DeadlySIn777/Controller/hardware/octopus_external_adapter/purchase_review/amazon-connectors-live-terminals-added-20261006.png

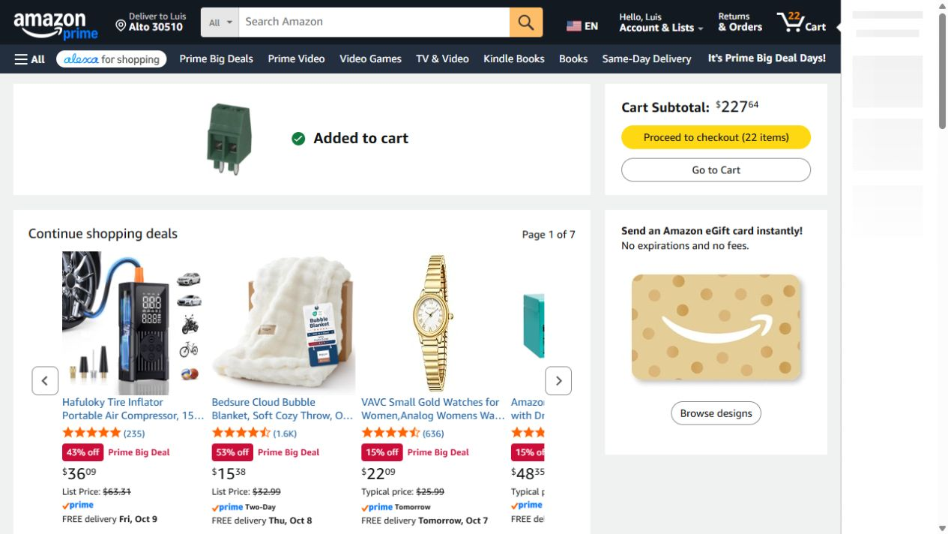
hardware/octopus_external_adapter/purchase_review/amazon-connectors-live-terminals-added-20261006.png
