DeadlySIn777/Controller/current-global-R3/README.md

# Current joint candidate and global routing input

This is the exact input of the global experiment launched on 18 October 2026, not a completed route or an adopted board. [Download the complete editable project](../archives/joint-global-R3-exact-native-project.zip), extract into a separate directory and open board.kicad_pro. The ZIP contains all 211 project files including the exact PCB, rules, schematic and local libraries. The adjacent board.dsn is the exact constrained router input.

Native PCB SHA-256: `a693477c5a71e26db86345ea2a356ad20519d301989d2f0e3506a8142f23c595`.
DSN SHA-256: `62ec8575ada2eea4df0adadbcb8852b647e395f8b239dd86e6c62eb48275c683`.

The native input contains 94,300 copper objects, including 8,015 vias. It composes coordinated power/reference and seven capacitor placement changes with 266 compatible new signal copper items. The cached native count is **1,693 required joins / 1,719 API items**. This is a different candidate from the earlier 1,181-join cached board: eight cut original zones and all new source zones lack current filled caches. The missing plane caches explain 497 extra pad groups on five affected nets. Do not compare these counts as routing gains/losses or graft older fill caches onto the changed source. A genuine full refill and its native measurements are pending.

The original router loaded the DSN and applied the public fixed-state setter after parsing: 52,130 ordinary route objects are movable across 2,155 ordinary nets, while 233 power/critical nets remain protected. New routing uses F.Cu, In3.Cu and B.Cu, strict DRC, no automatic neckdown, one routing thread and a maximum of 999 passes. The 238 power-source planning envelopes retain 19 owned windows; these are geometric routing reservations, not qualified current-carrying planes. The 611 ground-source regions are not blanket routing obstacles. Sixty-one very short exported segments have exact source-bound endpoint literals to avoid six-significant-digit export collapse; no native copper was deleted for that repair.

Original-parser source-forward/native preservation checks run concurrently with the reversible routing experiment. All acceptance checks, current filled copper, remaining critical/power routing, native DRC, electrical/thermal/signal integrity, FPGA fit/timing, assembly and physical qualification remain required. No new routing AFTER count is claimed. Retained twelve fitted motor interfaces, four ABZ encoders, 24 DI, 16 smart DO, electrical limits and isolation/fault contracts remain requirements. The board is not ready for manufacture.

[Subsequent native preservation PASS and two diagnosed runtime corrections](../review/router-runtime-corrections-20261018.md). The current routing AFTER result remains pending.

[Current native board layer views](../review/current-native-layer-views/README.md) show the saved copper with explicit source power-planning/keepout overlays; these are visualization, not a new filled AFTER.

[Derived Rust input with source-bound native drill models](rust-native-hole-model/README.md) corrects fictitious SMD holes and PTH drill fallback without changing the native board, copper, placement or electrical rules. The original adjacent DSN remains preserved.
