DeadlySIn777/Controller/hardware/motherboard_probe_limit_upgrade/README.md

# Bounded probe current-limit correction, r0.1

Derived198-footprint operator source (194 originals plus four resistors),587native pads. Original hardware/motherboard_operator and its194-part source remain read-only. This derivative preserves all pendant, frequency, encoder,24-bit FAST_SR, dedicated-probe and default/identity paths.

Only twelve original components change: U14026/U14027, eight limit/UV/enable resistors and two old DVDT capacitors. Four resistors R19401–19404 provide actual10k UV divider bottoms and exact manufacturer150k latch selections. The obsolete DVDT capacitors become actual1uF input bulk. No parts are removed. Exact properties/pins and additions are in reports/motherboard-probe-limit-20260930/bounded-delta.json.

The two MAX17612AATB+T limiters use2.49k ±0.1%25ppm resistors. The published20–250mA ±5% current accuracy plus fitted resistance/full150K temperature corners gives113.916–127.109mA programmed static bounds. This supplies100mA external plus the actualbleed and remains below the150mA maximum. The old49.9k TPS26624 interpolation gap is closed. Static current accuracy does not establish transient short peak/energy or surge qualification.

The existing field3.3 enable nodes are retained, with pullup3.32k and pulldown10k to prevent an absent open field3.3 source from allowing the MAX internal8uA ENpullup to raise the node above0.4V. The no-source screen is≤80.8mV. At actual3.3V regulator2% tolerance, the powered HIGH retains margin above1.4V under a conservative92uA inputcurrent screen. The92uA table condition is VEN5.5V, so this screen is labelled conditional; arbitrary partial-power/full dynamic sequences remain unqualified. Output current/reverse FLAG and UVOV share the existing isolated fault path, without a constanthealthy signal. The exact150k selection latches faults until input/EN power is cycled; there is no software motion rearm.

Native ERC: zero errors and two unsuppressed floating probeSUB warnings. Native all198-footprint geometry: zero regularDRC/noignoredchecks at0.15mm. Its452 displayed unconnected items describe only the intentionally unrouted geometry fixture. Native exact pin/MPN/footprint reconciliation and original-operator plus delta negative controls:61tests pass. These checks are not FPGA target execution, routed board qualification or a fabrication package.

Root integration must replace its operator source with this derived source, preserving exact fitted refs and applying the enumerated copper/footprint review. Source files retain the motherboard_operator stem and CNC_MB_Operator footprint library. No parent files were changed. Manufacturing_ready, physical_qualification and firmware_implemented are false. Actual cold startup, voltage drop/temperature, effectivecapacitance, transient short energy and full20ms behavior remain physical/engineering gates.
