DeadlySIn777/Controller/reports/board-finish-20261011/README.md

# PCB finishing attempt — 11 October 2026

Continuation 2026-10-13T01:44:25.420579+00:00

Saved Claude work continues; the live board remains unchanged and unfinished. The combined R753 full KiCad refill and original R157 DRC are still running. The AO1 joint repair is frozen: 21 new tracks/two vias replace four exact old segments, with host source/contact/reference/geometry checks passing and all other native items preserved. Two short ground/watchdog connections have a separate three-track add-only manifest. Current/thermal/ESD/timing and native AFTER validation remain open. All 850 native zone definitions plus two embedded no-fill rules have been read without refilling or saving, and the minimal CDONE/compute-ground repair uses exact current copper rather than the 49 unqualified prospective additions. R36 alarms are active and R37 renewal scheduled. No adoption or fabrication release. See continuation-r2/checkpoint-r42.json.

Continuation 2026-10-13T00:51:41.662222+00:00

Saved Claude work continues. Live r07 remains unchanged and unfinished. The exact combined R753 candidate retains the original CORE5 trunk; its one full native KiCad refill and the original R157 full DRC remain active. R763/R773 bind all-net native baseline source contacts, and R771 will audit the genuine full AFTER state automatically. AO1 now has a constructive three-segment monitor reroute and new VREF connection under audit; AO1 COM joins and a minimal CDONE relocation for compute ground are being constructed. Six short surface connections are physical nominees only; source, current, width, reference and native checks remain open. R35 resource alarms are active and R36 is scheduled with overlap. No adoption or fabrication release. See continuation-r2/checkpoint-r41.json.

Continuation 2026-10-13T00:02:59.432647+00:00

Saved Claude work continues; liveR07 unchanged. ExactR753 combinedFIELD/ROOT/Q0/DIC/DI6 diagnostic7bddce00 is staged and its one all-net native CPP fill is RUNNING onexistingmain1/PID70888. Native before-fill all94448Cu integer/lock checks0errors; all8006baseline viaUIDs retained/13newordinary masks required. Source/contact/reference/current/DRC/thermal/SI remainOPEN; explicitownednegative/rawinherited failures held. OriginalfullCORE5trunk remains; fullnativeIO3 census provesboth savedbypass endpointsalreadySOURCE, soSBCbypass/resistor relocation remainconditional andexcluded. COREreplacement searchescontinue; DI6scopedrepair/nativeBEFOREtarget bindingspass, DI15referenceextensionunderconstruction. OriginalR157fullCLI PID54240 untouched. R34alarmsactive, R35scheduled00:34:20UTC. Noadoption/fabricationrelease. Seecontinuation-r2/checkpoint-r40.json.

Continuation 2026-10-12T23:29:27.228073+00:00

Saved Claude revisions continue; live R07 unchanged. R275 and R667 selected native fills are complete. Fresh ROOT source/group/new-body/ordinary-return gates pass; actual HOST finite original-aperture return and all14 exact-circle body caps pass. Literal oldreference/sourcegain and full-versus-selected foreign-fill conflicts remainFAIL pending combined all-net refill. Field one-via/one-stub reinforcement reduces conditional overloaded-barrel current3.357→1.288A; current/thermal/complete loop qualification remainsopen. DIC83oldrelationship scopes pass and exact scope/sparse supplement is frozen; DI6 new10track/2via source audit closes next. Actual R7035 movedpose/pad/via API checks pass, R7036 unchanged, saved encoder/source gates pass so far. CORE5 actual In1 positive-shadow blockers are being checked against saved16track/14gap handoff. Native R157 remains1188unconnected/1177pad-island joins and11originalr07losses remain. Original fullnativeCLI is uninterrupted. CPU70%/GPU80C350W alarms retained withR34scheduled. No adoption/fabrication release. See continuation-r2/checkpoint-r39.json.

Continuation 2026-10-12T22:50:57.964975+00:00

Saved Claude work continues; live R07 is unchanged. The separate ground-landing native fill has completed with0 discrete-copper errors and0 prior actual ground-mask losses; its actual finite source/contact/reference audit is running. Full native R157 remains1188 unconnected/1177 pad-island joins across745 splitnets. Six of the original17 r07 lost relationships are recovered in that native candidate;11 remain and are listed exactly. The conditional full signed FB return solve identifies a3.3571A ordinary barrel obligation; its .194055V return number is not a physical bound or a complete .48V rail-policy pass. A source-preserving parallel reinforcement is next. ROOT selected native fill and original full CLI DRC continue; reviewed actual postfill audits are pinned to run after the original ROOT fill exits. The encoder pull-up now has an actual lower-layer source for one paired dive after F-only attempts failed. DIC all82 oldgroup/165geometry scopes pass so far; remaining raw scope/reference/body gates retained. R33 CPU70%/GPU80C350W alarm active, R34 scheduled with10second overlap. No board adoption or fabrication release. See continuation-r2/checkpoint-r38.json.

Continuation 2026-10-12T22:27:58.610265+00:00

Continuing saved Claude work. Live R07 is unchanged. The B3 intended corner has a scoped source-preserving correction, exact old physical copper and source arrays unchanged. The DIC route repair now restores only the abandoned trial cutter within its original source and is being checked with a locked original-signal detour. The encoder pull-up move remains a search: two real poses clear pads and courtyard, but reconnect routes still fail; no pose accepted. ROOT native selected fill is bound to the exact R157 parent plus only its sparse patch, and actual before/after connectivity, reference, source-gain foreign clearance and finite HOST return checks are prepared. The full R157 CLI and separate field and ROOT selected fills continue on their existing slots. All native/current/CORE source failures remain visible; no board adoption or manufacture release. CPU70%/GPU80C350W alarms remain armed and scheduled. See continuation-r2/checkpoint-r37.json.

Continuation 2026-10-12T21:58:25.132078+00:00

Claude saved work continues. The live R07 board remains unchanged. The joint U10003/HOST repair has scoped independent source/contact/reference checks and native API PASS for all 94396 retained copper items, 13 new tracks, four vias, locking, the resistor masks and two exact new ground planes. Selected actual LG/FG/IO3 refill runs on main1. The 22 old via mask differences in the full native board cover 23 layer flags; the exact cached parent had no stored filled polygons, so those flags do not prove prior finite physical contacts. All 22 barrels are actually source-rooted on other native layers. A separate 23-landing selected native test runs on test1. Q0 now has full actual ground support under both moved resistor pads; the final DIC ordinary return remains under route repair. The IO3 no-hole bypass and new ground support pass source, primitive preservation and native API checks, but its detached-port return transfer remains open. Original full CLI DRC continues, with all earlier failures visible. CPU 70% / GPU 80 C and 350 W alarms: R32 active, R33 scheduled. Four allocated KiCad slots and the 12-CPU cap are unchanged. No adoption or fabrication release. See continuation-r2/checkpoint-r36.json.

Continuation 2026-10-12T21:12:11.941758+00:00

Claude saved work continues; the live R07 board remains unchanged. The original IO3 outline repair passed selected native fill, source and both 605-contact checks. The four plane unions retain source contacts but still lose three strict old trace references; explicitly bounded corner additions are under review. Q0 source/contact checks pass on its exact current model, but both moved resistor pads still need the nominated no-hole FG shield and legal protected-power retreat. CORE5/CM79 is rejected because it splits the old IO3 group; an existing-port bypass is being searched. The fresh joint U10003/HOST audit is running. One new HOST bend misses the planner drill margin; a 5 um local bend passes its discrete screen and needs a fresh fill/reference check. The pinned full native refill finished with 1188 unconnected items / 1177 joins; all 22 postfill contract errors are lost original In1/In4 via flashes, requiring real plane repairs. Full CLI DRC is still measuring. CPU 70% and GPU 80 C/350 W alarms remain armed, with four KiCad slots and the 12-CPU cap unchanged. No adoption or fabrication release. See continuation-r2/checkpoint-r35.json.

Continuation 2026-10-12T20:26:21.955915+00:00

Claude saved work continued; liveR07 unchanged. Isolator HOST/resistor repair now has exact6track/1via packet, nativeBFPposePASS, independent4814oldfill-metalcontacts/sourcegroups0loss, bothnewresistorpinsrooted, ordinaryreturnbothplanes/.925PASS; originalterminalowncapauthority andjointfield/native/currentgatesopen. SharedFGreturn fieldgeometry passes andoriginalCLOCKtrackcanrestore, but directFGsourceplane seed fails; realplane bridge being diagnosed. Q0correctedFPpose restoresall21FGkeys withall81relationships0loss; finiteSENSEsame-planeconductorproposalpasses. CM79actualsource-embeddedfullwidthpathnominated; q053literalownednegativeconstructionpending. NativeIO3outlineAPI28zones92holespasses/selectedFAIO3fillruns; originalclosed-boundaryFAIL remainsdistinctfromnativeproviderwhichdoesnotflagit. Eightactualnativezoneerrors belongto13same-net/profilechunks mappedto11ownedroles/fourclusters; minimalcompositionplanonly. FIELD5fineconditionalmesh changes~5%, fullreturn/currentqualificationopen. R157fullnativecontinuesunchanged. CPU70%/GPU80C350W R30alarmactive/R31scheduled;4KiCadslots/12CPUcap. No adoption/fabricationrelease. See continuation-r2/checkpoint-r34.json.

Continuation 2026-10-12T19:43:04.941759+00:00

Claude saved work continued; live R07 unchanged. R218 selectedFA/IO3 native refill completed; R563 source594IO3/47FA and605 genuine older fill-metal contacts pass, but ORIGINAL IO3 zone touches closed TMR boundary as15.677mm LineString: strict nozoneFAIL retained. FIELD5R543 all9targets/older contacts pass; return/fullbody/native/current remain open. Q0R450 reuses savedGATEdetour and existingSENSEbarrels, preserves allPOWER/FLTCu; independent gates open. CM49 sparse replay ontoR543 preserves exactTMRrepair; ownedq4f corridor next. R10007 twelve supported poses have ground reconnects; complete HOST B-source finite route fails, ordinary B/F port search runs. R217 exact allsource rational arrangement independently closes only six oldref witness false losses; rawFAILs preserved. Correction: fieldR517cachednet dictionary has78entries, not81as stated in prior notes. FullR157 native continues unchanged. CPU70%/GPU80C350W R30alarm active/R31scheduled, four allocatedKiCadslots/12CPU cap unchanged. No adoption/fabrication release. See continuation-r2/checkpoint-r33.json.

Continuation 2026-10-12T18:44:31.779790+00:00

Claude saved work continued; live R07 unchanged. TMR two-plane repair passes81 host contacts/nine sources/48direct contacts; native27zone/38hole API passes and selectedFA/IO3 fill runs in existing test slot. Full R157 native fill continues separately. FIELD5 new139.29mm/.50 source route keeps original IO3 hard but local edge construction FAIL is retained. Q0/SENSE/FLT constructive20-track7-via packet frozen; full independent gates open. CM79 external fullwidth source spurs and isolator shared return/R10007 pose work remain under source/ref checks. Raw old/new reference/current/native/CORE/manufacturing failures preserved. R29CPU70%/GPU80C350W alarm active; R30scheduled; four allocated KiCad slots/12CPU cap unchanged. No adoption/fabrication release. See continuation-r2/checkpoint-r32.json.

Continuation 2026-10-12T18:14:28.309315+00:00

Claude saved revisions continued; live R07 unchanged. Scoped TMR FA/IO3 repair removes native converter keepout overlaps and restores all eight R14045 IO3 keys with594 retained source pads, no new holes/discrete Cu. Full delta certificate still open. CM79 reaches50/51 grounds and passes all2388 host contact graphs, but three old B references and both retained F anchors lose supported copper; rejected pending exact repair. U10003 all98 geometry/three-net contact/source checks pass, but clock/new-body references and one literal old-antipad reference failure remain. Q0 bounded component diagnosis continues ordinary dive search. R157 native fill still runs on frozen existing sharedslot. R28 CPU70%/GPU80C350W watch active, R29 scheduled; four allocated KiCad slots and12CPU cap unchanged. Full board/source/reference/current/native/physical/manufacturing gates remain incomplete. No adoption or fabrication release. See continuation-r2/checkpoint-r31.json.

Continuation 2026-10-12T17:13:29.651266+00:00

Claude saved work continued; liveR07 unchanged. FailedR9 nativeCLI completed499unconnected/0schematicparity/1ordinaryerror298warnings; in-memoryCLIrefill Cu notsaved, original187missingIn3 flash and3oldsourcegroup losses stillFAIL. CurrentR157 actualfullnativefill continues existing sharedslot. FIELD5 exact A-preserving restore diagnostic retains383IO3source-key loss/13directLGreference gaps; no area/precision waiver. Isolator coupled ground+clock+fault construction preserves all3net contacts and rootsactualU10003.9/bothgroundbarrels, but3geometry/ref failures requirepitch/newplane-antipad repair underR195/R196. Q0 coupledwalls/DIC3returnwindow repairs andCM79 permittedIn2powerbridge remainunderqualification. Fourbarepower/CORE93mm2reference/fullcurrent/native/source/physicalmanufacture gates incomplete. R27CPU70%/GPU80C350Wwatch active/R28scheduled; fourallocatedKiCadslots/12CPUcap unchanged. No adoption or fabrication release. See continuation-r2/checkpoint-r30.json.

Continuation 2026-10-12T16:35:13.398196+00:00

Claude saved work continued; liveR07 unchanged. Current R157 exact-source/allCu diagnostic full nativefill and originalR113 fullCLI still running on existing slots without stop/restart. FIELD5 In2 repaired nominal margin but IO3 loses383sourcekeys; structural original-record replay underway for13actualLGreference remnants. U10009 target-rooted diagnostic loses24LGsourcekeys/203oldreference rows and finite alternatives remain no-path. CM49/51actualgrounds rooted;2hardpads/fullbodyreference/current remain. Saved operator.90-1.0mm return window adds explicit3DIC and U10003diagnostic failures, no exemptions or rewritten historical receipts. Q0 earlier ports violate frozenBno-via rule; legal coupled ports underway. Four regulated pads bare, CORE93mm2reference/current/ROOT42/native qualification incomplete. CPU70%/GPU80C350W alarms R26active/R27scheduled, fourKiCadslots/12CPUcap unchanged. No adoption or fabrication release. See continuation-r2/checkpoint-r29.json.

Continuation 2026-10-12T15:08:24.758488+00:00

Claude saved work continued; source/live r07 unchanged. Current R155 native diagnostic3e6b matches schematic and allCu. Supplemental exact expected-zero-length-vertex correction passes all200native zones/1015holes without PCB/host edits; original failedAPIreceipt preserved. Fresh R161/R162 fullnative refill/uncappedconnectivity/alloldviamasks/newflashes/fullCLI DRC running onexisting sharedslot, original R113main1 DRC still running. All78hostsource/contactrelations preserved and native-rulehostgeometry0errors; 28oldreference failures remain, FIELD5In2 sparse repair underway. U10003 scoped source/contactPASS, ownsignalport reference stillFAIL/OPEN. CM49/51 actualsource-rooted, twohardpads and fullbodyreference/current qualification remain. Four otherregulatedsupplypads bare. CORE93mm2referencegap/current/ROOT42/nativefullqualification unfinished. R25CPU/GPU alarms active andR26scheduled, existingfourKiCadslots/12CPUcap unchanged. No adoption orfabrication release. See continuation-r2/checkpoint-r28.json.

Continuation 2026-10-12T14:25:35.696468+00:00

Continuing Claude saved work; original source/live r07 unchanged. Corrected DIC/C1022 R262/R264 passes all incremental contacts/source/strictreferences/geometry. Current R364 combines REG/U11025 and corrected T4/R7 sparse repairs; new REG margin gaps fixed. R368 final fullhostaudit runs with zero current native-rule geometry violations and explicit separate planning failures. R155 currentmodel addsONLY frozen187own-drill nativeintention; allphysicalcurrentgeometry/actualfills exact. Newcurrentemitter/stager are prepared, finalnativeAPI/measurement awaitfreshboundproof. U10003 nowhasconcreteordinarysourcevia/groundstub/faultreturnbands; isolatedR153constructed and R154 drilledoldFG/faultcontacts0loss, fullsource/ownsignalport/reference/clearance/nativequalification pending. CM51 groundsource work found17ordinaryfanout nominees;34remain. FOUR otherregulatedsupplypads remainbare. FullCORE DCbodyreference/current/sharedLG/source/ROOT42/native gates FAILED or OPEN. OriginalR9 native1212API/1200joins747nets remainsrejected with187missingIn3/3lostoldgroups; fullmain1DRC continueswithoutrestart. R24watchactive/R25scheduled, fourKiCadslots/12eligibleCPUcap unchanged. See continuation-r2/checkpoint-r27.json. Board unfinished; no adoption or fabrication release.

Continuation 2026-10-12T13:21:40.976346+00:00

Continuing Claude saved work; original source/live r07 unchanged. Current CORE R250/R252 now passes every tested retained contact, strict old-reference and incremental geometry check; new CORE full-body reference gap93.041959mm2/current/native gates remain FAILED or OPEN. DIC+C1022 exact sparse current-head construction is in independent audit. T4 ground/fullwidth trunk repair passes scoped host checks; R7 strict fill-conservation failure is preserved and a local remove-only successor is running. U11025 ground plus retained health reroute passes full host source/reference/clearance proof and has an exact minimal native delta; REG minimal packet is being combined on the current head. U10003 ground remains blocked by two actual logic walls and has no accepted repair. Original R9 native remains1212API/1200joins across747nets with missing required187In3flash and3lostoldgroups; main1 fullCLI DRC continues without restart. R23 resourcewatch active, R24 scheduled; fourKiCadslots/12eligibleCPUcap unchanged. See continuation-r2/checkpoint-r26.json. Board unfinished; no adoption or fabrication release.

Continuation 2026-10-12T12:39:45.540900+00:00

Continuing Claude saved work; source/live r07 remain unchanged. OriginalR9 native refill remains1212API/1200joins across747 nets, required187In3flash and3oldgroupsFAILED; fullnativeDRCcontinues onexistingmain1. Exactown-drill-only outlinecorrection now restores187In3 in a single-zone nativeprobe; fulloldlayermasks/refill/DRC remainopen. Broadcensus finds no otherown-hole defect and all89 checkednewvia layerplaneoverlaps arepositive. CORE R246 immutableownedfillconstructor now preserves allpreviousCu boundaries outsideactualcuts with0gainedCu; freshindependentall77/source/direct/strictreferenceproofruns. FullCOREreturn/current/decapqualification and93mm2newpowerbodyreferencegap remainopen. REG minimalcurrentdeltapacket, barefieldgrounds andtwoFPGAgrounds continue; unqualifiedorfailedcounterfactuals stayrejected. DIC-C1022 exact sparsepacket remainsreadyforpropercurrent-headintegration. ResourceR23 active/R24 scheduled, fourKiCadslots/12eligibleCPUcapunchanged. See continuation-r2/checkpoint-r25.json. Board unfinished; no adoption or fabrication release.

Continuation 2026-10-12T11:50:01.235987+00:00

Claude source/live r07 remain unchanged. R9 full native refill completed:1212 API unconnected/1200 uncapped joins, but the required additional In3 contact on LOGIC via18701851 failed. Three old native groups also split (LOGIC/R5051, IO3, CAN ground), so this candidate is rejected; the exact matching-stem CLI DRC diagnostic now runs on the existing main slot without repeating Python refill. Wider CORE R112 connects all25 previous core pads and preserves77 host contact nets/seven source banks; independent strict reference review continues. Its conditional .8A supply drop is19.7mV, with15.3mV remaining for actual return, spreading and ripple/transients, not complete power qualification. Exact DIC-C1022 currentR214 composite passes the full independent host contact/reference/geometry audit and has a frozen sparse native integration packet. REG ground-mask repairs and the two bare field-ground fanouts continue. Resource R22 is active and R23 scheduled; four KiCad slots/12 eligible CPU cap unchanged. See continuation-r2/checkpoint-r24.json for exact failures and receipts. Board unfinished; no adoption or fabrication release.

Continuation 2026-10-12T10:52:34.508479+00:00

Claude files/live r07 remain unchanged. CORE R100 now restores all25 prior core-supply pads using one1mm minimumcore In2route and two ordinaryvias, while all77 prior contactnet relationships/seven sourcebanks remain intact and1048 newprimitive checks against nativeplaneCu pass. Only the newlyowned fieldground In2bridge is notched; field-return current and independent strictreference/directlayer/native checks remain open. DIC independent proof passes54,924 zero-loss retained-reference bodies; its exact20track/5via/4delete packet and C1022 solecapacitor feed are being verified on one merged currenthead. REG alternative guard/reference repairs and other isolated supplies continue. Full native R9 still computes; latest completed full dc936 remains11ordinary errors. Resource R20 completed without breaches, R21 is active until11:36:40UTC and R22 scheduled11:36:30UTC; fourKiCadslots/12eligibleCPU cap unchanged. Exact104 power-shadow classification remains a proposal with full electrical qualification and raw failed references retained. See continuation-r2/checkpoint-r23.json. Board remains unfinished; no adoption or fabrication release.

Continuation 2026-10-12T10:00:12.845058+00:00

Claude files/live r07 remain unchanged. Latest positive host joint R214 includes the widened IO3 feed, protected-power bypass, restored LG and two actual-native resistor/monitor repairs; all77 incremental old-contact nets, source priors and strict ground references pass. The exact three-pad UV node and all retained UV copper also pass independently. New C1022 single-cap feed independently passes the same scoped checks; five more isolated IO3 source nominations still need return repair. DIC F/In2/F now has a positive20-track/5-via/4-delete constructor, undergoing stronger independent supported-aperture/source/reference/current-peer checks; no lost signal credited recovered until native. Core reference repair still disconnects21 supply pads and is withheld; several existing-port/fill/layer/ordinary-site searches have completed without accepted geometry, and blocker diagnosis continues. REG/B3/FIELD5 reference-margin and unchanged-primitive guard repairs remain under validation. Native R9 full refill/connectivity/DRC is still computing; latest completed full dc936 remains11ordinary errors. Native two-resistor metadata/export guard checks pass with nine negative cases. Resource R18/R19 completed without breaches, R20 runs until10:36:50UTC and R21 is scheduled10:36:40UTC; fourKiCadslots/12eligibleCPU cap unchanged. See continuation-r2/checkpoint-r22.json. Board remains unfinished; no adoption or fabrication release.

Continuation 2026-10-12T08:34:48.183518+00:00

Claude files and live r07 remain unchanged. The frozen R160 diagnostic still runs actual full native refill/connectivity; its failed host gates prevent adoption. Latest IO3 wider feed has passed incremental all76 geometry/contact/source/reference gates; 593 source pads retain the original group. The complete R9026 monitor rotation reconnects its ground, and a real source-connected In1 patch covers its UV route; independent gates are running. U10017 and the R11054/R11055 source repair pass host gates. Actual native R11054 rotation independently confirms the fixed alarm pad and fresh physical polygons; full new copper/native gates remain. DIC independent audit found three actual neighboring reference gaps and is being corrected, with no lost signal credited recovered yet. Exact104 DC-power versus130 signal-shadow classification is source backed and remains a separate PDN proposal; original failures and full current/return/stability obligations are preserved. R18 alarms active until08:37:10UTC/R19 scheduled08:37:00UTC, four KiCad slots unchanged. See continuation-r2/checkpoint-r21.json. No adoption or fabrication release.

Continuation 2026-10-12T08:03:14.816929+00:00

Claude source and live r07 remain unchanged. The frozen R160 trial is still running native refill/connectivity/DRC; its failed host gates remain recorded and adoption is rejected. Corrected IO3 R183/R190 has passed true geometry, all 76 incremental old-contact nets, ground source and reference checks; it recovers the previously connected group with 593 source pads. Current/native qualification, 23 older isolated IO3 pads, 3 core-supply pads and a pad-free branch remain open. U10017 widened bypass passes the same newer host checks; its full-load sheet calculation is conditional. Native R9026 rotation passed exact pad/source identity, and its complete monitor operation is now being projected. Core reference masks that disconnect 21 supply pads were withheld; power-versus-signal classification remains an explicit PDN proposal, never a silent checker change. DIC has a positive 15-track/4-via constructor undergoing independent checks; no original lost signal is credited recovered until native proof. Resource R17 completed without breaches; R18 runs until08:37:10UTC, R19 is scheduled08:37:00UTC. Four KiCad slots remain unchanged. See continuation-r2/checkpoint-r20.json. No adoption or fabrication release.

Continuation 2026-10-12T06:49:00.483383+00:00

Preserved Claude source/live r07 unchanged. New frozenR160 exploratorynative3b579aa7 passes source/ALLCu/155zone API; fullrefill/DRC/uncappedconnectivity/no-loss running from06:45:54UTC onexistingqueue. Knownhostretention failures remainpinned/adoptionrejected. ROOTR55 restores4lostLGpads/source1354 with one1mmIn4 bridge/noholes; strictgeometry0errors/fulloldcontacts-source-reference auditR57running. OriginalIO3 oldgroup split/sourceislands stillbeingbridged. FieldR169 originalIO3-preserving REGalternate andR171pairedfull audit running; U10017 actualninepad57term branch upper2.268616A/currentqualificationOPEN. ThreebareFG/11originalsignal obligations remain,DI15 coupledDI13 reroute inprogress. LatestcompletedFULLnative dc936 FAIL11ordinary/1357missing/1382API unchanged. Noadoption/manufacture release. ResourceR16complete/R17activeuntil07:37:20UTC/R18scheduled07:37:10UTC,4KiCadslots unchanged. Seecontinuation-r2/checkpoint-r19.json.

Continuation 2026-10-12T06:13:12.382553+00:00

Continuing preserved Claude boards. R42 two logic-ground In2 returns add9 source pads; R43 strict host geometry/full76 old-zone nets/3source/3outer-reference gates PASS, LG1354. Wholeboard KiCad/current stillOPEN. SAFE audit found actual IO3/protected-FB plane overlap17.4765mm2 and planning margin failures; IO3 owned replacement constructing. Field U10017 In1 bypass withdrawn45 real FBG-reference losses, alternate In2 full audit running. REG paired audit preserved real IO3 split; rerouting. Three bareFG and11 original signal obligations remain, constructive coupled returns/reroutes ongoing. Latest completed FULLnative dc936 unchanged FAIL11ordinary/1357missing/1382API. No adoption/fabrication release. ResourceR15 completed0breaches; R16 active until06:37:30UTC, R17 scheduler06:37:20UTC; unchanged4 KiCad slots. See continuation-r2/checkpoint-r18.json.

Continuation 2026-10-12T05:34:12.543670+00:00

Continues the preserved Claude revisions. Selected KiCad FPGA1V2 source PASS_R139: original f6 actual F/In3/In4 flash,25 expected source/FPGA/J7 pads retained. Wholeboard/current remains OPEN. SafeR22 LG1345/FAG229/FBG257/full76-net priorcontacts/source/references PASS_HOST, strict242checks0errors. SixREG source/contact/analytic PASS but13 tiny remote FA-reference differences remain FAIL; paired exact regional audit running, no waiver. Three bareFG pads have exact local walls; .5mm health same-F reroute nomination passes spacing/reference, coupled FG via test running. Eleven original signal relationships still split, saved XF incomplete, DI6 remote references/DI15 coupled supply reference repairs remain. NextSAFE combined native recipe freezing; forwarded unchanged-source extra-layer obligations pass positive/six negative collector checks. Latest completed FULLnative dc936 unchanged FAIL11ordinary/1357missing/1382API. No adoption/fabrication release. ResourceR15 active through05:37:40UTC, R16 scheduled05:37:30UTC. See continuation-r2/checkpoint-r17.json.

Continuation 2026-10-12T05:03:37.667959+00:00

Saved Claude work continues. SafeR22 corrects one new FAG planning margin and withdraws only two unaccepted LG reference-cutting additions. All76 zone-bearing net oldcontacts, all3ground prioractualsourcekeys and oldouterreferences PASS_HOST; LG1345/FAG229/FBG257 named source-rooted. IndependentR25 strict242geometrychecks0errors. Three ordinary FGfanouts running; twoLG spines/sevenREGbarepads remain. TwoREGreplacementfeeds source-scopePASS, fullauditnext. FPGA1V2 island25pads/8303priorCOREkeys source-scopePASS, fullprojection/nativeextraIn4 probe running; divider/C1024/IO3 remain. DI6 three remote strictreferencesOPEN; DI15 coupled reference/supplyrepairOPEN. Latest completed FULLnative dc936 stillFAIL11ordinary/1357missing/1382API. Finaljointnative/current/thermal/mechanics/qualificationOPEN; no adoption/fabrication release. R15 resourcealarmrunning through05:37:40UTC; R16scheduled05:37:30UTC. OriginalClaude/live/source bytes preserved. See continuation-r2/checkpoint-r16.json.

Continuation 2026-10-12T04:43:08.171048+00:00

Continuing saved Claude r07 plus frozen owned repairs. Corrected host CORE91 all named pads source-rooted; FAG229/FBG257 and LG1354 source-rooted, seven latest LG bridges fullprojected-equalityPASS. Independent LG7 geometry/contact/reference audit running. U19008 corrected power tree scoped independentPASS. REG116 FAILED12 oldFBG sourcekeys and retained outer reference losses; rebuilding only two new In1 feeds, retaining four others. DI6 fresh matchednative oldcontact/sourcePASS but three remote strictreference sliversOPEN. DI15 F/In2/F reference bridge and CORE1V2/IO3 source closures remain open. One FAG5.26nm planner deficit and three ordinary bare-ground escapes remain. Latest completed FULLnative dc936 FAILED11ordinary/1357missing/1382API; finaljointnative not run. Current/thermal/mechanics/qualification remain open; no adoption or fabrication release. R14 complete; R15 CPU/GPU alarm running through05:37:40UTC. OriginalClaude/source/live bytes preserved. See continuation-r2/checkpoint-r15.json.

Continuation 2026-10-12T03:22:45.278058+00:00

Every named CORE pad now reaches actualR11022.2 in hostR78, with OBS15_A contacts retained and changed-pad analytic/nativeformat checks passed. WholebankFAG restoration reaches229named pads; three no-barrel pads need dogbones, FBG still searching, one5.26nm newplane planning deficit queued for explicit trim. DI6 exact9segments/2vias preserve physical/source/oldcontact/neighbourreference gates, with two tiny ownprojection reference strips OPEN for native. Regulated13sourcegroups remain; protected-power detour fails actual reserve/reference and is being replaced. Latest completed FULL native dc936 stillFAILED11ordinary errors/1357joins/1382API. Allnewjoint/current/thermal/native gates OPEN; no adoption/fabrication release. R13 alarmactive, R14 scheduled03:37:50UTC. AlloriginalClaude/source/live bytes preserved. See continuation-r2/checkpoint-r14.json.

Continuation checkpoint 2026-10-12T02:52:21.620272+00:00

Latest completed full-board native dc936 FAILED11ordinaryerrors,1357missingjoins/1382API. Current hostR59 retains15COREbranches/final10protected bridges. Two ordinaryCOREescapes source-rootU9001.10/U11007.6; ONLYR17031.1 pending, but newIn1planemarginR68 fails10pairs and exactR69correction running. RootglobalgroundR3 intentionally stopped before accepted geometry; exactregionalR4 prepared. RegulatedR70 retains17/17nominees,14sourcegroups stillopen; adaptive successor closes paths onlatestCORE/protected/Cmask. C native localcomponent/source-unrooted result explicit:5source-reference gaps and65oldtiny contour losses open; Cpriority124/.25 unchanged because actualR70zone testfound no conflict. DI6 local14additions ordinarychecks pass, wholecontact/reference running. Exactowneddeletion/perzone native staging ready. R13 CPU/GPUalarm active through03:38UTC; R12 historicalsamples preserved, no newKiCadslots. OriginalClaude/live/source preserved. No adoption/fabrication release. See continuation-r2/checkpoint-r13.json.

Continuation checkpoint 2026-10-12T02:24:36.759639+00:00

Latest completed full-board trial dc936 remains FAILED:11ordinary errors,1357missing joins,1382uncappedAPI,258warnings,0parity. Protected R9 roots all47FA/44FB pads, but independent audit finds ground splits/four plane gaps. Ten CORE branches now source-rooted; only U9001.10/R17031.1/U11007.6 remain. Historical CORE38 census corrected to13groups21pads. LOGIC R57 host guards/contacts pass. IO3 selected native and independent actual-source annulus pass. C10036 exact coupled R24/R30 host pass; native clone9910b29 source/allCu/settings/selected FBG refill pass, independent actual reference review pending. Regulated proposal final10 screen identified3proposed via conflicts for relocation. Latest CORE/protected/field composition and all full-board current/reference/no-loss/DRC gates open. CPU/GPU alarms unchanged: R12 through02:38UTC,R13 automatic rearm scheduled. Claude/live/source originals preserved; no adoption or fabrication release. See continuation-r2/checkpoint-r12.json.

Continuation checkpoint 2026-10-12T01:39:08.857803+00:00

Latest completed full-board native trial dc936:1357missing joins/1382API,11ordinary errors,258warnings,0source parity;5unchanged r07/C9/1beb losses,17r06 losses. Previous zero-error full trial1beb is historical. AO19 native eight-COM-zone refill and independentR4 pass new reference/paired return checks;85inherited boundary slivers remain open. CORE38 now roots all five target groups/33pads,13groups20pads remain. U11015 exact replacement and two LOGIC contact-restoring planes constructed; regulated41 adds20vias20stubs18planes with10groups unjoined. Protected R9 replaces four owned bridge conflicts on exact CORE38; return repair and all-zone audit follow its completed geometry. C10036 nearby return needs exact scoped DOB supply-track reroute. R12 CPU/GPU alarm active through02:38UTC; unchanged four KiCad slots and12-thread cap. Original live/source preserved. No adoption or fabrication release. See continuation-r2/checkpoint-r11.json.

Native completion update 2026-10-12T01:10:11.236417+00:00

Full partial-field trial dc936 finished:1357 missing pad joins/1382 uncapped API connections,11 ordinary DRC errors,258warnings,zero source-parity defects. It fails the gate. Nine errors are overlapping owned same-net zones at equalpriority124; two are owned IO3 F copper crossing the retained CMclock. Final owned zones will be merged before audit, and IO3 repair preserves the clock. Unchanged old native guards lose5 r07/1beb/C9 groups and17 r06 groups; final CORE/IO3/SBC power and analog/local scopes are still absent.1beb is the previous zero-ordinary-error trial, not the latest completed trial. ProtectedR7 completed12vias12stubs10bridges; independent audit/latestCORE+B5 joint replay continue. No adoption or fabrication release. See continuation-r2/checkpoint-r10.json.

Continuation checkpoint 2026-10-12T01:07:45.290168+00:00

R25 corrected local+B5 host gate passes (25vias/108tracks); all four B5 named groups rooted, four FA and two FB ground groups remain. Protected24 R7 finished12vias/12stubs/10In1 bridges, no target negatives; independent host audit and latest CORE/B5 joint replay running. Five CORE physical feeds frozen; fresh full graph corrects earlier planner count to15 unrooted named groups/30pads, two attachments under diagnosis. AO R18 source/API and scoped eight-COM-zone refill complete, paired returns/source topology preserved; two tiny SDI gaps need the R19 node correction. Regulated field supplies and local walls still being routed. Latest completed full native board remains1beb:1354missing/1365API/0ordinary errors/186warnings,12r06 losses. dc936 full DRC pending. Resource watch R11 active through01:38UTC; original live source unchanged. No adoption/fabrication release. See continuation-r2/checkpoint-r9.json.

Continuation checkpoint 2026-10-12T00:35:52.985232+00:00

Corrected local19-via/98-track/52-zone native API geometry passes, including every86259 segment/7926 via,87 affected via profiles and source parity. Native effective electrical domains pass all2388 exact raw nets. Complete final refill/DRC/current/continuity acceptance remains open. Field trial dc936 refill partitions improve FAG by11 and FBG by1 groups, while pending final CORE/IO3/SBC scopes lose connections; CLI DRC is pending. R19 corrected return contact/aperture host gate passes, R23 adds2 ground feeds with6 local-wall groups remaining. Protected24 planning57 terms balance at exact eFuse outputs;2 FB feed proposals constructed so far. CORE has2 further feeds,16 islands remain; B5 and AO repairs continue. Latest completed full native trial still1beb:1354 missing joins/1365 API/0 ordinary errors/186 warnings,12 r06 losses. Live source board remains unchanged; no fabrication release. See continuation-r2/checkpoint-r8.json.

Continuation checkpoint 2026-10-12T00:03:33.505030+00:00

Native source/pose/all-discrete geometry gate passes on the exact field-only exploratory trial; refill/DRC NATIVE_FULL_REFILL_DRC_RUNNING. Signed field planning allocation now binds146 terms and299 physical pad/net pairs. Later ground/CORE/protected/analog construction remains gated; weak proposed apertures and one LOGIC contact split are rejected and being corrected. Latest full native trial still has1354 missing joins and12 r06 losses. Source board unchanged; no fabrication release. See [checkpoint-r7](continuation-r2/checkpoint-r7.json).

Continuation checkpoint 2026-10-11T23:27:31.178283+00:00

Native field-zone/source/API contract cd24bd09 passes all 41 outer rings and 315 holes. Exploratory native refill/DRC dc93656a is running; final SBC planes and later local field returns remain open. Latest completed full trial still has 1354 missing joins and 12 unresolved r06 pad groups. Analog geometry is rejected by its return/reference gates. Live board unchanged; no fabrication release. See [checkpoint-r6](continuation-r2/checkpoint-r6.json).

Continuation checkpoint 2026-10-11T22:57:16.499108+00:00

Full native trial1beb9a22 completed:1354 missing joins1365 uncapped API,0 ordinary DRC errors186 warnings. Unchanged original pad groups retainr07/C9 connectivity;12r06 groups remain lost and14 intentional source pad-net reassignments retain new power obligations. SBC discrete native contracteedf63f2 passed26 poses68 vias23 SMD masks/shapes/angles and all fields. Final power-zone/contact/current gates remain open; live board unchanged. See [checkpoint-r5](continuation-r2/checkpoint-r5.json).

Continuation checkpoint 2026-10-11T22:27:03.351659+00:00

Candidate 1beb9a22 passed source/native API parity, all 19 affected footprint poses and all 19 checked via assignments and annuli. It includes the exact C92/reset corrections and coupled compute-clock repair, with only derived zone caches invalidated; full refill and DRC are running. Complete source ERC now reports 0 errors and 92 unreviewed warnings. Full-load field/compute returns are restoring old IO3 and LOGIC_GND contacts before acceptance. The last completed full trial still has 1346 missing joins and 13 r06 losses; live r07/r08 remains unchanged. See [checkpoint-r4](continuation-r2/checkpoint-r4.json).

Continuation checkpoint 2026-10-11T21:24:51.688011+00:00

The completed c9a461fb native trial reports1346 missing pad joins,0 ordinary DRC errors and181 warnings, r07+9/-0 and r06+34/-13. Clean fresh source/native API parity does not override those13 r06 losses: adoption remains rejected. Combined power-source export now passes2723components/9609nodes/2388nets; source-rooted supply/return copper and coupled signal repair continue at full fitted loads. See [checkpoint-r3](continuation-r2/checkpoint-r3.json).

Continuation checkpoint 2026-10-11T21:04:03.643512+00:00

The new exact AUX-cap/ordinary-signal candidatec9a461fb has clean fresh hierarchy/native parity and all9 new-from-r07 vias flash on all6Cu layers. Full native refill/DRC and dual r07/r06 no-loss checks are running. No source/live adoption or manufacturing qualification. The prior AUX trial0fb4ae is rejected for a native raw-net alias even though ordinary DRC reports0 errors. Field and compute source/rooted supply/return work continues with all fitted loads retained. See [checkpoint-r2](continuation-r2/checkpoint-r2.json).

**Board continuation checkpoint - 11 October 2026, 20:42 UTC:** [resumable evidence](continuation-r2/checkpoint-r1.json) records continued work on measured `198bba53...`; live r07/r08 and adopted hardware remain untouched. The board still has 1,348 required pad joins and 14 original r06 losses. Fresh exact native fills/annuli passed with all inputs unchanged. A full signed field planning model retains all simultaneous loads (A input about4.584A, B about4.769A), and an isolated field source export passes its14intentional pin moves plus4new parts. Coupled AUX and compute plane changes are staged with retained-contact obligations. KiCad confirms C11068's exact underside pad pose. The first AUX candidate fails native net parity because a normalized slash spelling creates a second physical net; corrected exact-name constructors and separate receipts are retained. A new ordinary two-via signal path is under independent audit; none is adopted. The resource watch completed358samples without breach and a successor is active. Routing, electrical, physical and manufacturing completion remain open.

This work resumes the external ROOT106 routing experiment. It does not replace the adopted Source26/ROOT104/CAD30 record. The experimental board has 2,717 footprints, measures 450 × 235 mm and has six copper layers. Manufacturing readiness remains false.

**Current continuation checkpoint:** the live r07/r08 board remains unchanged (`0c807b78…`). The latest measured additive candidate (`198bba53…`) gains seven joins without losing any against that live board, but still loses fourteen relationships versus repaired r06; adoption is rejected. It has 1,348 remaining pad joins, zero ordinary DRC errors and 180 warnings. The last targeted screen emitted no further board. Continue from these exact inputs and receipts rather than restarting placement or treating c05 as an adopted replacement. The [preservation recheck](continuation-preservation-r1.json) matches all 350 frozen inputs, installed fixes, original backups and live board/ledger: 362 distinct files, zero mismatches.

## Repairs and verified intermediate results

The rip-up restore tool now refuses to save when any ripped net cannot be restored. The integration gate now rejects lost pad connections even if the total unconnected count improves. The three installed tools have recoverable backups and an [installation receipt](gate-install-receipt.json). Installation did not alter the live board or its revision ledger.

The last loss-free comparison baseline is repaired r06, SHA-256 `0e90568af6efa53e8bb15b3de60dbc5d167c1ed84b013b07fa902762582cfe53`. It has 1,367 remaining pad joins, 1,376 API unconnected items, zero ordinary DRC errors and 169 unsuppressed warnings. These two connectivity counts are different measures and are not interchangeable.

| Isolated candidate | Completed / lost joins versus r06 | Ordinary DRC errors | Status |
|---|---:|---:|---|
| Recovery of r07 | 16 / 0 | 0 | All 17 previously lost r07 connections recovered |
| In3 bridges on r06 | 4 / 0 | 0 | Native intermediate proof |
| Placement and silk corrections on r06 | 0 / 0 | 0 | 171 warnings, including two library mismatches |
| Selected 96 mA FIELD_A return on r06 | 3 / 0 | 0 | Partial return only; full power qualification open |
| Combined recovery, bridges, return and DFM (c03) | 23 / 0 | 14 | Rejected: return copper crosses recovered fault signal |
| Four indicator groups added to c03 (c04) | 27 / 0 | 471 | Rejected: all four indicator groups collide with retained copper |
| Recovery, In3 and DFM after whole-group withdrawal (c05) | 20 / 0 | 0 | Native PASS versus r06; 1,347 joins remain, 183 warnings |
| Exact live r07 plus two zero-via signal repairs | 29 / 15 | 0 | Direct live comparison passes 2 / 0; original r06 continuity fails |
| Exact live r07 plus four signals and repaired partial FIELD_A return | 33 / 14 | 0 | Direct live comparison passes 7 / 0; original r06 continuity fails; 1,348 joins remain |

The rejected combined candidates and original failed receipts are preserved. A donor that passes on r06 is not automatically safe with other routing additions. The four E1 indicator groups account for 457 errors (OBS27_K 138, OBS34_K 74, OUT5_R_MID 124 and RGB_DRIVER_19 121); the other 14 are the field-return interaction already present in c03. Those routes were planned against removed copper. The repair removes the entire 261-item return group and all 201 E1 additions, preserving every other native item. The fresh c05 measurement completed at 13:48 UTC with 20 completed/zero lost joins versus r06, zero ordinary DRC errors, 183 unsuppressed warnings, 1,347 remaining pad joins and 1,356 API unconnected items. [Native proof](measure/c05-shared/proof.json), [current machine-readable state](CURRENT_STATUS.json) and [readable state](CURRENT_STATUS.txt) retain the distinct evidence scopes.

Direct replacement of the live r07/r08 board is withheld. Although c05 restores all 17 joins lost in r07 and retains 1,935 genuine r07 copper additions, its necessary whole-net rollbacks also remove 13 joins newly completed by r07. The [direct transition comparison](measure/c05-shared/live-transition-diagnostic.json) reports 21 completed and 13 lost joins against the live revision. Passing against r06 does not bypass this separate continuity failure. Source-only additive recovery of those 13 joins is being screened; the live board and ledger have not been replaced.

A separate [pure-add two-signal candidate](recovery-composite/c06/two-zero-via/ready.json) starts from the exact live r07 board and retains every existing item byte-for-byte. It adds seven 0.2 mm B.Cu segments on DIC_NRST_N and AI_POWER_GOOD_HOST, with no new vias. Independent endpoint, copper/hole clearance, reservation, barrier and conservative source-connected reference checks passed, together with 14 host rejection/geometry controls. Its [native measurement](measure/r07-two-zero-via/proof.json) completed at 14:52 UTC using one existing shared KiCad slot: direct live comparison PASS, two completed/zero lost joins, 1,353 joins remain, 1,362 API unconnected items, zero ordinary DRC errors and 179 warnings. Separate same-hash native source/API parity passed. The combined verdict is FAIL because the original r06 comparison still reports 29 completed/15 lost joins. This is an intentional continuity rejection, not a stopped or crashed job. No live adoption occurred.

The separate [four-path candidate](recovery-composite/c06/four-path/ready.json) adds BANK_B_BUFFER_ENABLE_QUALIFIED and DI_SAFETY_SUPPLY_FAULT to those two signals: sixteen segments and two ordinary 0.5/0.2 mm vias, with every r07 item preserved exactly. The combined host geometry/reference audit and twelve controls pass. Its candidate SHA-256 is `b4f56daf9d5d7579b155e1a76a0566f7d28c4892c78bdecf7edd3dd18f56ae60`. This standalone hash has no native measurement; its additions were measured together with the repaired partial return in the distinct combined candidate below. Synthetic partition guard fixtures are not board evidence.

The original [partial FIELD_A donor screen on actual r07](power-audit/fag-r07-screen/screen.json) is blocked: 11 of its 261 prospective items conflict with retained copper or the ordinary 0.8 mm via spacing requirement. It intersects the fault route; several additional segments approach new LOGIC_GND vias too closely. That original donor is not reused unchanged. The separate [whole-group repair](power-audit/fag-r07-repair/REPORT.txt) retains the other 250 chunks exactly, replaces only the 11 donor-owned blockers, and passes source geometry/contact checks with 13 controls. It binds the retained vias' actual flashed layers; earlier projected-layer receipts remain withheld. The [combined staged board](power-audit/fag-r07-repair/staged/r07-four-path-fag-repaired.kicad_pcb), SHA-256 `198bba53ad2cf983940c68f5e732b575d28d5fb962bc1fa4d3fd959c23a427ab`, preserves every r07 item and all eighteen four-path additions, plus 269 repaired return items. [Native measurement](measure/r07-four-fag-shared/status.json) started at 15:28 UTC on one existing shared slot. Concurrent [source checks](measure/r07-four-fag-shared/source-proof.json) passed using the original 27-sheet hierarchy: all 2,717 components and 9,590 node assignments match, and the native API confirms all seven new ordinary vias actually flash all six layers. Ten runner controls pass. The completed native proof below passes the direct live-r07 gate and ordinary DRC, but fails repaired-r06 continuity. The API log contains seven explicit-layer width warnings; observed uniform via diameters match the pinned proposal, and the actual flashed-layer check is separate. Eight unique inherited same-net hole/contact pairs remain separately disclosed and bound to exact old geometry/native evidence; none qualifies new copper or a general spacing waiver. The scope remains the selected 96 mA return; full field load/current and source anchoring remain unqualified.

The [editable c05 checkpoint](final-bundle/ROOT106-c05-experimental-v2/native/motherboard.kicad_pro) includes the exact board/project, 27-sheet source and immutable evidence. Its [qualification](final-bundle/ROOT106-c05-experimental-v2/qualification.json) carries the failed direct-live transition and unfinished electrical/manufacturing scope. A subsequent [native load check](final-bundle/native-open/c05-v2/receipt.json) passed in 71.444 seconds: KiCad 10.0.4 opened the matching `motherboard` sibling project, observed settings matched the measured context, and both input directories remained unchanged. This was an API load/settings check, with no GUI, schematic-library reload, refill or save. Initial saved zone caches remain stale; a refill/save changes the hash and requires fresh checks.

The combined candidate's [full native proof](measure/r07-four-fag-shared/proof.json) completed at 15:50:57 UTC: seven completed/zero lost joins versus exact live r07, 1,348 remaining pad joins, 1,357 API unconnected items, zero ordinary DRC errors and 180 warnings. Against repaired r06 it completes 33 joins but still loses 14, so the combined verdict is **FAIL** and live adoption remains withheld. Exit code 1 is the intentional gate verdict. [The fourteen remaining split components](recovery-composite/c06/four-fag/next-closure/remaining-r06-losses.json) are pinned for targeted recovery. Comparing raw warning identities with r07 finds one added FIELD_GND dangling segment, UUID `2b903a9f-df92-4263-bf2c-3a15ea640cab`, in the new donor group; it is being diagnosed for a later candidate, with this measured source kept unchanged. A separate [strict reference replay](recovery-composite/c06/four-fag/runtime-audit/strict-reference-r1.json) passes eight segment/return checks using actual flashed annuli on unchanged baseline ground vias, all prospective antipads and physical source J11001.2. This remains host reference geometry, distinct from electrical or physical qualification. Native CLI schematic parity did not execute; the same-hash original hierarchy/API checks above retain their separate scope.

The distinct [DIC CS recovery with a new ground stitch](recovery-composite/c06/four-fag/next-closure/dic-stitch-r2/stitch-screen.json) finds no complete path in its bounded model. It retains the exact current copper, native partitions and actual flashed layers. At U13003.3, both off-grid signal landing sites have zero continuous intersection with the required 0.9–1.0 mm new-return window after full copper/hole, spacing and physical-source reference checks. The other end has a small qualified return/stub option, but no complete paired route; its 100-second window budget examined only two of seven other-end sites. Seven host controls pass. The distinct [final checkpoint](recovery-composite/c06/four-fag/next-closure/dic-stitch-r2/final-checkpoint.json) and [readable report](recovery-composite/c06/four-fag/next-closure/dic-stitch-r2/REPORT.txt) preserve prior r1 evidence and explicitly supersede its earlier scope. This is not a global no-path proof. No board, native job or tail trim was produced. For the donor warning, a copper-subset trim would keep x=353.3 and shorten to y=202.4; recentering to x=353.45 adds a small copper wedge and requires replacement-clearance checks. Both remain unapplied and need contact and native verification on a future candidate.

## Claude continuation coverage

The [coverage audit](claude-coverage-audit-r1.json) inventories 14,478 external filenames and records the active revision history, handoffs, routing tools, source/native checks, power work and rejected experiments used for continuation. This is not a claim that every archived file's contents were read. The [handoff lookup](handoff-gap/handoff-gap-receipt.json) recovered and reviewed the actual operator document at `Z:/pcb-runs/OPERATOR-DECISIONS-2026-10-03.md`, SHA-256 `392e2155400e156d180ac5a786b2d7e4a41c2dcc945bfc7a8de9b9e21b02dde5`. Its 14 completion requirements, targeted-change authority and five final audits remain requirements; its earlier ROOT104/105 sizes and counts remain historical. Eight Claude project memories and structured scans of six Controller main sessions were also reviewed. The latest relevant session summary reports the same unfinished r07 state; the live r08 is byte-identical to r07. No later finished board was found in that bounded coverage. Three malformed session lines and unread archive/tool/subagent payloads remain explicit coverage limits. Recovered documents are preserved under [handoff-gap/recovered](handoff-gap/recovered).

Native CLI schematic-parity checking was skipped because the measurement copy lacked the fully annotated schematic. Empty parity arrays are not evidence of execution. Separate same-board-hash native API/netlist checks passed for recovery, c03, c04 and c05. A fresh native schematic export from the frozen 27-sheet ROOT106 source matched all 2,717 components, 2,384 nets and 9,590 node assignments. These checks do not replace circuit ERC or electrical qualification.

## Remaining design work

- Complete supply and return distribution together. The historical full field-power donor clips its model totals to smaller rail design currents; two FIELD_B arrays have five vias where the retained 3.05 A model requires seven. The installed planner now rejects these cases. The old electrical model also needs source-backed reconciliation of fitted current settings, converter port currents and physical power-input versus shutdown terminal roles; its sums are not verified hardware load requirements.
- Re-layout the compute supply source landing and reserve an adequate power corridor. The dedicated 3.6 A compute case requires eight ordinary vias at the provisional 0.5 A/via assumption; simultaneous retained USB/HDMI loads raise the common source to 4.15 A, requiring at least nine or explicitly separate branches. Current sharing and the complete source/return voltage drop are still unproved. The sampled original layout has no continuous 3 mm source-to-load corridor for the 3.6 A case. A bounded local stage/decoupler move identifies eleven affected load-fanout items; this remains a planning proposal, not a completed layout.
- Finish the remaining required connections and review controlled pairs, isolation, return paths, analog routing and unsuppressed DRC warnings on the exact final revision.
- Complete native editable-library reload verification, refresh and verify saved zone fills, confirm the fabricator stackup/process, and complete DFM, electrical, thermal, timing and physical qualification.

The [source-backed field-load reconciliation](power-audit/field-load-trace/REPORT.txt) preserves the four historical planner sums and all simultaneous fitted loads. It finds stale branch-current assumptions and incorrect signed converter/return accounting, so those sums alone do not prove a hardware overload. The [receipt](power-audit/field-load-trace/receipt.json) passes twelve source/arithmetic checks and preserves 67 inputs; no applicable replacement current table or circuit change is emitted. It provides an explicitly symbolic full-normal ledger, with conversion loss, bleeds, quiescent currents and real external power boundaries still to resolve. Shutdown-contact grounds cannot count as parallel power inputs. Their plug MPN versus PCB-header footprint mismatch needs a source/BOM/mate correction. These are concrete model/source tasks before full-current routing can be accepted.

The [compute-stage replay on exact 198b](power-audit/sbc-198b-source-proposal/contacts-and-corridors.json) preserves all r07 items and the 287 combined additions. Local packing/site screens do not qualify the whole supply network: the sampled uniform 4.6 mm upstream corridors have no nine-site component at both ends. Tapered or split networks remain separate unresolved cases. The proposed C15001 move is rejected by the [ordinary SMD-hole assembly screen](power-audit/sbc-198b-source-proposal/C15001-assembly-blocker.json): it increases the source-derived nominal drill overlap with the copper, mask and paste apertures from about 0.02788 to 0.07069 mm². The retained ordinary via has no fill/cap qualification. Prior zero ordinary DRC does not authorize that new overlap, a mask exception or VIPPO. No stage placement, corridor or decoupler move was written to a board.

The distinct [bounded power blocker v2](power-audit/sbc-198b-source-proposal/final-bounded-blocker-v2.json) passes path geometry for two raw tapered SBC output leads: two trunks plus 36 branches, with explicit path verdict, finite/exact terminals, segment containment, recomputed length, per-array and new/existing via spacing. Ten host gate controls pass. The [final dimensions and pooled-spacing receipt v4](power-audit/sbc-198b-source-proposal/final-bounded-blocker-v4.json) binds ordinary 0.6/0.3 mm dimensions and checks all 153 center pairs in each 18-via source/load pool against pitch, copper gap, hole-to-hole and both hole-to-other-copper requirements. It rejects lead 1: its cross-array pair is only 0.4 mm apart, with copper overlap and insufficient hole gap. Lead 0 passes those pooled checks with minimum 0.8 mm pitch, 0.2 mm copper gap, 0.5 mm hole gap and 0.35 mm hole-to-other-copper gap. Only that lead remains a provisional geometry option. V4 records 23 controls: ten path, seven whole-array and six dimension controls. The overall power proposal remains withheld for the ordinary SMD-hole assembly blocker, absent paired upstream feed, unproved front-pad fanout/current sharing, complete 4.15 A return and fresh native qualification. No board was produced. The [first gate](power-audit/sbc-198b-source-proposal/final-bounded-blocker.json) is preserved: its strict connector flag incorrectly withheld legitimate direct-line helper results, and v2 supersedes that raw-path classification only. The earlier raw driver also treated a result dictionary as truthy instead of checking its verdict; v2 checks that explicitly, including direct shortcuts and a zero-length exact common hub. No raw path result, separate legal array or provisional output geometry qualifies the complete supply network.

No fabrication outputs, supplier submission, physical measurements or manufacture-ready claim are produced by this attempt. All twelve motor interfaces and the retained electrical/fault requirements remain in scope.

The [controlled geometry proposal](controlled-geometry/future-copy-proposal/proposal.json) uses the actual 35 µm outer copper and separates 204 exact historical-policy net correspondences from current routing proof. Outer widths/gaps have two provisional closed-form cross-checks. In3 routing remains held: the actual In2 zone outlines are IO_3V3, so a two-ground-plane model is not established for the isolated domains. The isolated future project preserves all 28 original classes and domain rules, adds four routing geometry classes with the verified original 0.15 mm ordinary clearance, and retains the original rule bytes as a prefix. Its [native effective-class check](controlled-geometry/native-check-r3/receipt.json) passed; this check does not execute full custom-rule parsing, DRC, routing or SI qualification. It has not been installed in the live board or c05 checkpoint. The nominal 1.60 mm board thickness versus the 1.55 mm mask-inclusive material sum, fabricator tolerances and actual return/edge/timing budgets remain unresolved.

The [isolated C11061 source correction](electrical-correction/c11061-v2/receipt.json) changes the SBC switch CT capacitor from 4.7 µF 16 V `C2012X7R1C475K125AB` to same-footprint 4.7 µF 25 V `C2012X7R1E475K125AB`. [TI TPS22990 section 9.3.2](https://www.ti.com/lit/ds/symlink/tps22990.pdf) requires at least 25 V at CT; the replacement's nominal properties are documented in the [TDK characterization sheet](https://product.tdk.com/system/files/dam/doc/product/capacitor/ceramic/mlcc/charasheet/c2012x7r1e475k125ab.pdf). All copper, pads, poses, UUIDs, rules and other components remain exact. A native schematic export passed with only the intended value/MPN change and unchanged connectivity. Its corrected board SHA-256 is `513becb4b4ccab5626db70b64012812a58f207bfccc168fcc779c3b1a4bb1b2e`; it is separate from all measured routing candidates. Separate [native API parity](electrical-correction/c11061-v2/api-parity-v2/receipt.json) and [scope checks](electrical-correction/c11061-v2/api-parity-v2/qualification-scope.json) passed; the original wrapper and pointer-assertion failures remain retained. DRC has not been rerun on this corrected hash. The historical standalone circuit uses 1 µF 50 V CTSW1 on SBC_SLEW_CT, so its effective 0.47–1.32 µF CT envelope does not qualify ROOT106 C11061 on SBC_RAMP_CT. Effective capacitance, ramp/inrush and inhibited restart behavior remain open. Motor-feed CT pins on U11010/U11011 remain intentionally unconnected.

The [editable-library repair v2](source-library-repair/v2/receipt.json) creates the four missing effective libraries from the exact embedded schematic bodies. It preserves every original native source/design file and the corrected board hash. All 380 embedded/external symbol definitions now match, with zero missing libraries or definition mismatches. A fresh native schematic export preserves all 2,717 components and 9,590 node assignments. The [independent mapping review](source-library-repair/independent-audit/receipt.json) passes with eight controls. V2 additionally binds all loaded project/helper files before and after execution; four dependency rejection controls pass. It closes v1's omitted imported-helper provenance without making a retroactive claim for v1. Both isolated copies and the earlier c05 bundle/evidence remain unchanged. Native GUI library reload is not run, and the historical `sch.net` remains labelled separately from each current corrected `fresh.net` export.

The [original r06 stitch-plan replay](stitch-margin-audit/receipt.json) reuses Claude's independent vector auditor on its pinned historical r05 planning copy, classes, mask and 188-proposal plan. It reproduces all four native-reported via-clearance failures, measuring 0.145, 0.110, 0.145 and 0.145 mm against the 0.15 mm same-domain requirement. The [installed mandatory vector guard v2](stitch-margin-audit/guard-v2/installation-receipt.json) rejects those four complete via/stub proposals before planner output is saved. All 436 targets are accounted for: 184 accepted plus 252 failed, including the four explicit vector rejections. Independent accepted-plan replay finds zero vector violations; sixteen host controls pass. The original planner has an exact backup, v1 remains unchanged, and all 350 frozen combined/native inputs and live board/ledger hashes were preserved during installation. This qualifies the future ROOT106 planner's geometric output guard; it does not establish source connectivity, power capacity, native DRC or physical behavior. No new GPU/raster run, stitch application or board modification occurred.

The [installed field-current repair](power-audit/field-current-repair/installation-receipt.json) removes eight current caps, preserves raw downstream currents and voltage drops, checks every requested source/positive-load pad selector, and withholds undersized or incomplete model routes from applicable filenames. It refuses any nonempty work directory to preserve historical files and avoid stale route reuse. Twenty-one host controls pass, including the real 3.05 A five-via versus seven-required arrays, rounding-boundary drop and partial-selector failures. The original planner is backed up; all 350 frozen/native/live inputs and historical current/specification tables remain unchanged. Existing documented sums FA 5.036 A, FAG 5.268 A, FB 6.55 A and FBG 6.61 A exceed their retained design values; full FB/FBG also exceed the model's 5.32 A source limit. The new planner rejects that inconsistency before routing. This does not reduce loads, raise source ratings, infer concurrency or qualify current sharing, electrical capacity, native DRC, thermal, fault or physical behavior.
