DeadlySIn777/Controller/reports/motherboard-comms-20260930/README.md

# Actual motherboard communications source

Frozen candidate: **95 fitted parts / 304 electrical pads**, native ERC **0 errors, 2 warnings, no ignored checks**. Independent exact full-pin/MPN/footprint/default validation and native loading of all 95 footprints pass; 43 independently specified TI copper-pad geometry checks pass. The 44 communication mutation tests and the complete 343-case focused source cohort pass with the receipt's input hashes unchanged. This is circuit/native source evidence, not a routed board or target-image result.

The circuit uses separate ISOW1432 RS-485 and ISOW1044 CAN isolated power/return domains, actual field UV/OV and converter-fault observations, optional external-link 120-ohm termination, and a real MCP2518FD controller/40 MHz oscillator. A load switch withdraws the controller supply when the actual compute rail fails; a separate module-health AND delayed rail-good gate immediately disables buffers and forces standby. MCP2518FD has no hardware reset pin. SPI reset does not erase message RAM; accepted target startup must initialize fresh FIFOs/generations explicitly. Hardware communication defaults are distinct from the independent motion watchdog and do not qualify its 20 ms path.

The boundary names are in `hardware/motherboard_comms/boundary-map.json`. The parent owns actual bus terminals, chassis bond and functional HF capacitors. No custom daughterboard, fictitious socket or DC ground bond is introduced. Root's compute carrier supplies the reviewed UART/SPI1 endpoints; GPIO14/contact55 remains ESP service UART. ACC reads actual RS485_POWER_GOOD_HOST and CAN_POWER_GOOD_HOST.

The two ERC warnings are manufacturer GND2 pins on the explicitly named isolated raw returns. Their actual field COMs connect through the manufacturer-prescribed ferrites; the returns remain electrically separate from LOGIC_GND. Derived power flags document real VISOOUT/ferrite power paths, not a constant healthy status. No warning is ignored or suppressed.

Remaining gates: qualified Linux image/device tree and driver compilation, CM4/CM5 RTS-only pinmux, separately reviewed BTT mapping, CAN XSTBY enable, startup/POR/power-cycle and stale-frame behavior, effective capacitance/converter-current/thermal envelope, routed timing and loaded CAN/RS-485 latency, cable/common-mode/EMC/ESD and bus-fault tests. The manufacturer CAN TVS type and package are verified; exact packing suffix and purchasable stock require supplier confirmation. RS485 intrinsic device contact-ESD evidence is not a board surge rating. SM712 was rejected because its +19 V clamp exceeds the transceiver's +15 V bus absolute maximum. No arbitrary 24 V bus miswire rating is claimed.

`receipt.json` records exact frozen source hashes, native/test evidence and boundaries. `primary-device-review.json` separates retained primary PDF hashes from browser-only primary reviews and rejected/failed downloads. No fabrication files or manufacturing-ready claim are created by this source block.

The r0.2 correction reuses the fourth Nexperia Ioff buffer section for the reverse interrupt path. U14805.11 faces the always-on carrier pull-up; MCP2518FD INT and its pull-up stay on CAN_CTRL_INT_RAW/CAN_CTRL_3V3. The original direct host-to-controller injection path is closed without adding parts; the first freeze is archived and revoked. irq-fix-ledger.json records exact changes.
