DeadlySIn777/Controller/reports/motherboard-is2-contract-20260930/README.md

# IS-2 motherboard topology contract record

30 September 2026. Source/document consistency evidence only. The latest user resolves the previous one-board versus thirteen-card conflict in favor of one active custom motherboard, all twelve motor paths and purchased replaceable compute/service/storage/accessory modules. [Local IS-2 contract](../../docs/MOTHERBOARD_IS2.md) and [requirements data](../../hardware/motherboard/requirements.json) preserve logical requirements and explicitly name implementation changes.

`inputs/` contains exact copies of the six frozen external IS-1 JSON files, the master document and five section documents. `receipt.json` records their SHA-256 values before copying and after generation; all originals must remain unchanged. The archived contract remains authoritative as the inherited reference except for the explicitly superseded physical rack/removable-card boundaries. No edits were made in the external worktree.

`terminal-function-map.csv` maps all 451 original field positions exactly once: 371 motherboard logical positions on 37 connectors and 80 optional encoder-accessory reference positions on eight connectors. Logical positions include supplies, returns, shields and spacing. All twelve motor terminal groups move onto the motherboard. The optional encoder references preserve functions and capacity without selecting a custom EX8/XTB card family or a new accessory socket. Production connector and FPGA-ball selections are deliberately unassigned in the requirement record; the original candidate names/parts/balls remain traceable references.

`build_contract.py` created this record once and refuses to overwrite its source archive or requirement output. Its checks cover source immutability, unique/exact terminal-function coverage, base/optional counts and 77 base plus 24 optional direct-field FPGA signal names. A future revision must use a new archived record, not replace these inputs. `receipt.json` gives the actual outcome.

This work changed no CAD, gateware, driver, firmware, public schema or machine configuration. It ran no native ERC/DRC, host test suite, target build, HDL simulation, FPGA vendor fit or physical test. Current MC r0.4/revision 14 source and copper are reusable partial engineering evidence; this document is not the complete motherboard or a manufacturing release.

`current-mc-reuse-reference.json` separately freezes six current MC/allocation/permission/buffer source files. It records all 52 shared MC net names with their exact KiCad root namespace and maps the 77 required base direct field signals against native XML at U1001: 60 matching logical net names are present and 17 are absent. A source connection does not prove that its receiver/interface exists, that the PCB is routed or that its FPGA ball is qualified. Historical probe/status aliases still require explicit semantic reconciliation. The first incorrect inspection omitted KiCad's `/`/sheet namespaces; that superseded zero-present record is preserved under `current-mc-reuse-before-root-prefix-correction.json` and must not be used. `record_current_reuse.py` checks exact archived hashes and never guesses a connection from a suffix in an unrelated sheet.
