DeadlySIn777/Controller/review/routing-progress-20261018-r5/README.md

# Routed KiCad progress — 18 October 2026

[Download the complete editable KiCad project](../../archives/kicad-routing-progress-20261018-r5.zip), extract it into a separate folder, and open `native/board.kicad_pro`. All 214 PCB/project/rules/schematic/library files are included. The PCB exceeds GitHub's individual file limit and is supplied inside the ZIP. [Exact file inventory](FILES.json).

**KiCad 10.0.7 measured 1,665 → 1,649 required joins; API items 1,695 → 1,679. Zero previous pad relationships were lost.** This is 16 additional joins and 45 total closed from the same a210 cached baseline of 1,694. These counters are not directly comparable to the historical 1,172 full-fill result.

Every copper record of the 1,665-join composition base is retained. Native connectivity, pad poses, retained via flags, actual annuli and new via-drill/SMD intersections were checked; the composition clearance check covers the new copper against the previous route delta. [Measured progress and scope](evidence/progress.json). This batch uses an exact geometry delta from the real source-fixed routing session, qualified against two actual full native imports. Original source copper remains literal. New vias use KiCad explicit net assignment to preserve their route-specified nets through loading; a real native control confirms that this option does not waive clearance errors. Whole incoming nets colliding with prior routes were omitted and their conflicts remain in the composition receipt. The full router session is a proposal, not a session for this combined PCB. See [subset provenance](evidence/subset-provenance.json).

The board is **unfinished, unadopted, and not manufacturing-ready**. This measurement uses saved copper caches. Full refill/DRC and power/current/return/thermal/assembly/physical qualification remain open. Checks running on older sources do not qualify this newer PCB. All twelve motor interfaces remain fitted; IS-3 remains a proposal. Bulk routing continues beyond this frozen checkpoint.
