DeadlySIn777/Controller/review/three-clamp-source-20261018/README.md

# Three-clamp source candidate — 18 October 2026

**Source correction:** this historical d798 board contains 17 blank LED trace net fields. Use the [separate a210 corrected project and exact evidence](../literal-net-source-correction-20261018/README.md); physical geometry is unchanged.

[Complete editable native project ZIP](../../archives/three-clamp-native-source-d798d41a.zip), PCB SHA-256 `d798d41abc239d478853eecf55447ac288098e5b5fb4aa5404d8d4936c47af1c`. Extract into a separate directory and open `native/board.kicad_pro`. The archive includes the schematics, local libraries, project/rules, exact saved board and source-extracted 2,726-row BOM. The eight empty source MPN fields are seven mounting features (H19501 and H22001–H22006) and one bare test pad (TP19001), rather than unidentified fitted devices. Chassis fasteners/bond hardware have their own mechanical qualification. This is not a purchase release. Ephemeral project UI state/lock files are excluded, with originals retained locally.

This isolated candidate combines the CORE capacitor/feed revision and all six explicit pad connections for D11007–D11009, each to its actual eFuse output and own return. It retains both CORE bias resistors, the nearby 22-ohm series resistors and every original via. The sparse changes from a693 are 11 retired/43 added tracks, two added return vias, one capacitor move, three new clamps and five declared zone operations. [Independent exact-byte review](root-independent-source-review.json) finds zero undeclared changes to the remaining 124,661,936 source bytes.

[KiCad 10.0.7 read-only cached checks](native-cached-clamp-roots.json) verify all six output/return root relationships, 94,334 copper objects, 8,017 vias and 2,726 footprints. All 8,015 original actual via masks remain exact. [Old-pad comparison](old-pad-comparison-to-CORE-parent.json), excluding the three added clamps symmetrically, has zero lost/split/merged old relationships **against the separate 7f362 CORE parent**. That parent already clears an edited plane cache; this is not full-board loss acceptance against a693.

There was no native Fill or Save in that observer and no full-board DRC. Saved plane copper remains inherited evidence. The [return-floor diagnostic](return-floor-diagnostic.json) holds new FIELD_B and smaller CORE LED projected deficits for physical review/correction; necessary endpoint apertures and actual unreferenced corridors must be distinguished. Current/ripple, pulse/I²t, thermal, assembly and the eFuse negative-output-voltage limit remain open. The candidate is not adopted or ready for manufacture.

This physical candidate is separate from the a693 global-router input. The earlier rejected router result has not been merged into it. A future routing input must bind its actual source, holes, contact model and power reservations afresh while preserving any independently verified gains.
