DeadlySIn777/Controller/reports/board-completion-20260930/one-pcb-feasibility/README.md

# One custom motherboard: consolidation feasibility

30 September 2026. **Read-only source inspection and arithmetic.** This report does not modify frozen IS-1, the circuit sources, machine profiles, public configuration schema or PCB revisions. It does not establish a finished motherboard, target FPGA fit, production cost or manufacture readiness. The accompanying `inventory.json` identifies the inspected inputs by SHA-256.

The current motion and fault architecture can be implemented as functional regions on one custom motherboard with purchased compute and ESP modules. SPI, hardware watchdogs, permission latches, isolated field interfaces and freshness-checked I/O do not intrinsically require separate custom PCBs. The current source does **not** prove the complete design fits, routes, powers or runs on one motherboard. A new physical contract must replace the frozen removable-card contract if the latest one-PCB instruction takes precedence.

## What is actually present

The current `hardware/motion_card/design.json` contains **327 physical component candidates**: 70 FPGA-core parts, 48 local-power parts, 29 watchdog-conditioning parts, 56 permission parts and 124 motor/TX-buffer parts. It is an eight-standard/twelve-total motor **logic-side** candidate. The 38 buffered outgoing paths are 12 STEP, 12 DIR, 12 individual EN_N and two TX permits. They are not 12 complete drive interfaces. Its source explicitly says `interface_agreed: false`, `manufacturing_ready: false` and `eight_twelve_runtime_qualified: false`.

The separate `hardware/controller_assembly/` contains **13 connected schematic blocks and 570 exported components**, rather than 13 fully finished IS-1 service cards. Its recorded validation reports 240 unselected/boundary parts and 126 unassigned footprints; those two numbers are recorded validator results, not a fresh production-BOM audit here. Its native export is a partial controller: old two-entry power, 12 differential STEP/DIR transmitter paths, two encoder channels, 22 historical direct isolated inputs, the old single-watchdog permission block and an ESP service circuit. It omits several frozen interfaces and contains superseded topology. The MC and this assembly must be reconciled by function; their component counts must not be added together.

## Functional map and real remaining circuit work

| Function / frozen logical owner | Existing source-backed candidates | Required work on a consolidated motherboard |
| --- | --- | --- |
| Linux compute / CMC | A 3 A host supply switch using TPS22990DMLR and TPS389001DSET exists in `sbc_power`; compute carrier is a documented study | Actual dual-100-pin carrier with exact CM4/CM5/BTT supported revisions, mating connectors, 5 V feed, reset/boot/recovery, storage, cooling, Ethernet, HDMI and USB/touch; host pinmux and target transport. The host power block is not a carrier. |
| FPGA motion / MC | T20F256I4, W25Q32JVSSIQ flash, 50 MHz ASE clock, reset logic; current MC has 96 legacy allocated user-I/O entries in the pin-allocation source | Complete frozen 175-signal allocation, dual host chip selects, independent output progress, all IOL1 ports, status registers, expansion/permission observations and remaining fast I/O. Vendor package/bank fit and actual eight/twelve-channel gateware remain open. |
| Local MC rails | Two TPS62901RPJR bucks, three LTC2962HUD#TRPBF supervisors, destination-rail reset buffer; 48-part IS-2 proposal | Integrate protected 5 V feed, start-up/inrush, whole-board power budget and regulator thermal paths. Keep raw 5 V rail-good separate from the qualified 3.3 V reset copy. |
| Watchdogs and permission / MC | Dual TPS3851G18SDRBT, physical arm/OPI/trip/final permission circuitry and independently checked supervision copper | Complete real FPGA and field-side consumers, load/partial-power review, proof-test timing and ≤20 ms fault-to-inhibit measurements. Replace the old assembly `machine_permission` block; never parallel two incompatible permission architectures. |
| Motors M0–M7 / MIA | Current MC has STEP/DIR/EN_N Ioff buffers. Historical transmitter source supplies AM26C31IPWR STEP/DIR candidates | Eight complete individual NO+NC enable paths using the frozen TLP3640A/TLP4176A pair, SN74LVC07A drivers, local LED switch, OPI_A, eight alarms, receiving-rail EN_N bias, protected AUX5/AUX24 and real terminal wiring. Current AM26C31 transmitter-only circuits are not complete MIA. |
| Motors M8–M11 / MX4 | Current MC reserves and buffers all four additional motor STEP/DIR/EN_N paths with qualified bank-B OE | Same field-side enable/alarm/protection circuits for four more motors; expansion presence/class/power-good and OPI_B. Preserve the required four-motor upgrade, but resolve its **physical** implementation under one-PCB scope before freezing the motherboard. |
| Base encoders / EIA | Two AM26LV32EIPWR receivers provide the old two ABZ channels; two TPS2553DBVR-1 supplies | Four encoder ABZ ports plus FREQ0/1 and MPG A/B consume four quad receivers (16 channels, no spare). Add every port supply limiter, two fast probe interfaces, pendant/status shift register and qualified 1-Wire identity route. |
| Encoder expansion / EX8 | Specification and resource reservations only | Eight additional ABZ ports need six quad receivers, eight port limiters, local 24→5 V power and status/class readback. Must coexist with all 12 motors; a twelve-motor board with four encoders does not satisfy the complete reserved expansion scope. |
| DI24 and safety / DIC | Historical direct-input block uses 11 ISO1212DBQR devices for 22 mixed home/alarm/auxiliary inputs | Actual DI0–23 bank with 12 ISO1212, sensor supply groups, STM32G031C8T6 IOL1 L0 controller, hardwired safety permit/feedback/reset, ARM lamp and PERMIT_OUT photorelay. Old mixed inputs do not prove DI24 plus all motor alarms. |
| DO0–15 / DOA and DOB | Frozen selected parts and protocol only; no complete output-bank circuit in these assemblies | Four TPS274C65ASRHAR total, two STM32G031K8T6 controllers, separate ISO7762F isolation and OUT_EN latches, full SPI/CRC/current/open-load/temperature/VS path and two field entries. Retain 0.5 A/channel and 2 A/four-output group; no generic relay substitutes for diagnostics. |
| Analog/process / ACC | Frozen functional and selected component descriptions only | Two independently isolated DAC80501/OPA197 AO chains and zero clamps; four AI inputs with actual ADC, protection and calibrated 0–10 V/4–20 mA ranges; isolated supplies, STM32 controller, two PWM and two hardware-gated PEN contacts. Several exact support/interface parts are still unselected. |
| Field communications / ACC + CMC | Frozen MCP2518FDT-E/SL CAN-controller choice and UART/SPI requirements | Real isolated CAN and RS-485 circuits, termination, connector/ESD design and host ownership. Retain ordinary qualified third-party USB/Modbus accessory use; display touch must not exhaust USB capacity or share the precision link. |
| Entry and distribution / PSM | Existing two TPS26630RGER entry branches, LM70660RRXR CORE5 converter, local bucks and baseline sequencing | Three nominal-24 V entries (CORE, FIELD_A, FIELD_B), coordinated real fuses/eFuses/reverse/transient protection, ≥3 A MOTION5 branch, expansion gating, AUX branches, entry-current monitors and power-fail warning. Old core 3 A / two-entry schematic does not meet the full frozen 4 A-class core plus two field-entry allocation. |
| ESP support / ESC | ESP32-S3-WROOM-1-N8 solder-down module with service USB/mux/boot-control source; diagnostic firmware exists | Review latest required WROOM-1U antenna choice or qualify a specific purchased plug-in module; UART, supervisor, electrical loading and RF keep-outs. Existing WROOM footprint is **not** a socketed user-replaceable ESP board. No autonomous motion/permission or unqualified hot failover. |
| Settings/history / SCART | Recovery software demonstration and frozen cartridge contract; no complete cartridge circuit selected | Protected removable machine configuration, two committed generations, default hardware write protection, interruption/recovery proof, separate history FRAM, isolation/bus-fault containment and offline entitlement restoration. A custom SCART PCB violates a strict one-custom-PCB rule; no qualifying off-the-shelf cartridge has been selected. |
| Field wiring / BASE, XTB | Frozen terminal inventory: 315 standard and 136 expansion positions, 451 total | Exact fitted pluggable terminals/harness, keying, labels, voltage domains, PE/shield, mechanics and service procedure. The 220×100 mm MC envelope is not a proven complete motherboard outline. Optional expansion terminal space and all high-current/isolation keep-outs need a new mechanical placement proof. |

## Functional contracts that can survive consolidation

- Keep the local real-time Linux → FPGA division. The workstation, Wi-Fi/Bluetooth, optional AI and service UI remain outside hard motion timing. The internal CNC3 ABI/dual-CS sequence can be retained; Ethernet remains a user/accessory/AI interface as assigned, not a replacement for a proven local transport merely because Ethernet is exposed.
- Keep two independently supervised progress streams, fail-closed rail/reset/permission logic, individual motor enables/alarms, explicit arm/self-test/recovery and hardware output inhibits. Preserve the ≤20 ms fault-to-inhibit requirement and absence of automatic resume.
- Keep IOL1 as four local FPGA-to-MCU links. Its class/slot/epoch/CRC/freshness checks, 1 ms accepted-frame timer, independent MCU watchdogs and output readback do not depend on card connectors. Retain electrical isolation across the actual field barriers. Any revised identity object must honestly distinguish soldered functional regions from removable modules.
- Keep loaded 1 kHz read/compute/write acceptance, the 700 µs engineering target, diagnostics validity/age, offline configuration/recovery/licensing, ordinary third-party peripherals and optional AI. Screen tiers are independent of motor/I/O count.

## Physical requirements that cannot remain literally unchanged

| Frozen requirement | Conflict with one custom motherboard + purchased modules | Decision or revised contract required |
| --- | --- | --- |
| Passive fixed wiring base with 13 custom card positions and MC/PSM/field-card replacement | A single active PCB is not a passive base; its soldered regions are not removable FRUs | State that whole-motherboard service replaces failed onboard regions, or identify a verified purchased service module for each retained removable boundary. Rework the affected service acceptance and spare economics; do not describe whole-board exchange as individual-card repair. |
| FPGA + clock + flash + supervisor are a replaceable motion card | Existing T20 and support circuits are soldered custom components | Either revise this requirement to motherboard service or qualify an actual purchased FPGA module that supplies the complete pin/power/reset/programming interface. None is selected here. |
| Eight standard motors plus MX4 plug-in expansion, factory-fitted twelve, and EX8 alongside MX4 | The specific custom MX4/EX8/XTB construction is prohibited under a strict one-PCB scope | Preserve the eight-to-twelve and simultaneous encoder-expansion capabilities while approving an actual physical route. All twelve fitted on one PCB, a purchased expansion product or a custom card are different product contracts; none is silently chosen here. |
| Wires/terminals remain physically fixed during every designated module exchange, ≤5-minute card exchange | Compute-only exchange can retain the motherboard and all wiring. A failed soldered FPGA/field section requires motherboard service | Whole-board pluggable harness exchange can avoid moving individual conductors, but it moves plugs and is not the original fixed-base service proof. Establish harness retention, unplug count, earth/shield procedure and measured service time. |
| Dual opposite-end presence contacts, card class/MIR-1, per-card PG, removal tamper and slot code | Deleted connectors cannot have honest connector-presence evidence or removable-card identity | Define real purchased-module presence separately from onboard region health. Keep hardware rail/fault detection; do not tie all old PRESENT signals true or fabricate virtual MIR-1 serials as proof of physical cards. |
| Protected keyed machine cartridge with custom memory/history electronics | Another custom SCART PCB would be a second custom design | Qualify a purchased removable media/assembly meeting the contract, or explicitly revise the physical cartridge contract while preserving interrupted-save/offline recovery requirements. A generic USB drive is not automatically hardware-write-protected or qualified. |
| CMC factory-mated CM module, carrier FRU swapped in the field | Latest instruction keeps motherboard and permits upgrading the purchased compute SoM | Expose a supported SoM replacement procedure with correct connector/mechanical/cooling/power envelope. No claim of hot plug, arbitrary “CM-compatible” insertion or unchanged timing qualification. |

The principal genuine user decision is therefore **service and expansion topology**, not whether an internal SPI trace is possible. The root task has asked which conflicting physical requirement takes precedence. This report does not decide it. Component selection, rail sizing, isolation, pin allocation, terminal placement and routing are necessary engineering work under either answer.

## Resource, voltage and geometry blockers to prove

1. **FPGA pins and implementation:** frozen IS-1 allocates 175 signals against 189 usable advertised GPIO, leaving 14 arithmetical spare. Only 137 are full-feature GPIO, so at least 38 signals must use the relevant LVDS-as-GPIO capability under verified bank/voltage/direction rules. The current source has 96 allocated user-I/O entries and no assigned LVDS entries; the rest is not a fitted 175-pin design. Of the 101 frozen direct-field signal names, 41 lack exact current FPGA pin-net names; acknowledging the two historical PROBE/TOOLSETTER aliases leaves **39** still missing, including all 24 expansion encoder inputs, FREQ/MPG, PWM/PEN and safety feedback. Those aliases are an inspection aid, not new interface agreement. The full host dual-CS, output progress, IOL1/status/fast-I/O/permission allocation must also be completed and vendor-fitted before a finished layout. This is an unproven resource gate, not evidence that one PCB is impossible. Connector removal does not automatically reduce a frozen functional budget.
2. **Compute pin compatibility:** connector shape cannot make CM4, CM5, CB1 and CB2 electrically interchangeable. The existing carrier strategy records changed CM4/CM5 USB/MIPI and reset semantics, including pin 92, and separate BTT pin/software profiles. An unsupported module must not damage hardware before software can reject it. A same-motherboard upgrade promise requires one explicit compatibility matrix, safe reset/power wiring, pinmux ownership and enough power/cooling for every advertised upgrade. Separate incompatible carrier revisions do not meet the latest “mainboard stays” promise.
3. **Power:** frozen allocation separates CORE5 (6 A) from MOTION5 (≥3 A), and EX8 has its own converter. It reserves 4.5 A CORE5, 2.346 A MOTION5 with twelve motors, and 3.011 A minimum-input CORE24 loading with twelve encoders; its 4 A-class entry replaces the old 3 A core-entry study. FIELD_A and FIELD_B continuous allocations are 4.578 A and 4.82 A. These are requirements/arithmetic, not measured ratings. Consolidation must keep their fault containment and cannot reuse the historical single-rail 6 A study as a complete expanded budget. Current local MC 0.50 A steady/0.80 A startup proposal also differs from frozen 0.45 A and needs integrated reconciliation.
4. **Actual voltage domains:** FPGA/control I/O is 3.3 V, core 1.2 V; field sources are bounded nominal-24 V domains with defined protected outputs and limited isolated contact loops. Combining boards does not combine grounds across galvanic barriers or make ports “any voltage.” Fuse/eFuse, transient, reverse-current, creepage/clearance and partial-power/default-state work must use actual selected components and cable/load limits.
5. **Geometry and manufacturability:** neither 327 placed MC parts nor 570 connected schematic symbols establishes placement of all 451 terminal positions, compute socket/cooling, isolated power/analog regions, PHY/HDMI/USB, high-current entries, BGA escapes and RF/PE keep-outs. The 220×100 mm motion-card candidate must not become an assumed whole-board limit. Select a complete motherboard envelope and prove it with exact footprints, a layer/stack-up/process proposal, full physical connectivity, uncapped unconnected count, DRC, power/return paths and thermal/EMC review. No special via/process substitution is implied.
6. **Firmware and timing:** keeping the CNC3/IOL1 contract internally is feasible; current earlier six/two simulation, host tests, ideal logic checks and source ERC do not prove the complete eight/twelve motion+I/O endpoint or simultaneous graphics/target timing. Complete controller MCU firmware, flash restore, immutable approved local images and deliberate recovery before claiming plug-and-play replacement.

## Concrete next integration proof

After the physical contract is reconciled, produce one top-level motherboard design with a typed net map from every field terminal and purchased-module pin to its actual circuit consumer, rail, protection, owner and diagnostic source. Reuse verified MC circuits and valid portions of existing peripheral circuits, replacing superseded topology rather than merging both wholesale. Close the complete signal and worst-case power/startup budgets; then place and route the complete circuit, including return paths and all machine interfaces. Save native schematic/PCB/ERC/DRC and exact round-trip pad/net/copper evidence for the same immutable revision. Only then can a complete prototype manufacturing package be reviewed. Physical timing, protection, thermals, EMC and service acceptance remain subsequent measurements.

No supplier submission, fabrication export or source-architecture change was performed by this investigation.
