DeadlySIn777/Controller/reports/board-completion-20260930/supervision-routing-independent/README.md

# Independent selected-supervision copper review

30 September 2026, `supervision-routing-independent-r01`. [review.json](review.json) independently checks the final `manual-v5` supervision-routing copy against immutable published revision 06. This receipt applies to the **203-part /867-pad board**, before the later 327-part motor-block integration.

Native KiCad 10.0.4 copper connectivity now places **all source pads on all 41 selected supervision nets into one physical cluster per net**. The check uses `GetConnectedItems(source_pad)` after native connectivity construction, so common net labels alone cannot make disconnected geometry pass. All 867 original pad geometries, layers, drill attributes and net assignments remain identical. The earlier 508 uncapped unconnected edges become **497**, closing the 11 actual joins. A fresh native DRC on the retained board copy, with its local library context present, reports **zero regular violations, 497 unconnected items and zero schematic-parity items**. Those 497 unfinished connections prevent a full-board or manufacturing-ready claim.

The final board contains **371 track/via items**. Exactly 294 existing items retain their UUIDs and complete geometry. Exactly two earlier local `WD_M_WDI_BUF` segments were removed; their geometries match the supplied authorized bundle. Four specified replacement segments are present exactly, with 73 other added items for the remaining joins, totalling 77 additions. Added traces are 0.20 mm; added vias are 0.60/0.30 mm. These dimensions and this DRC result do not establish electrical current ratings, signal integrity or physical fault timing.

An independent unsaved negative control moves the actual ARM_O_Q cut-edge copper 20 mm while preserving its net, widths and layers. Its formerly complete pad cluster splits and the uncapped unconnected count rises from 497 to **499**; the extra floating copper accounts for a different count from the routing author's copper-removal control. No negative-control board is saved. This confirms the pad-cluster checks respond to geometry rather than mere net membership.

Every source input and copied footprint remains byte-identical, with hashes retained in the receipt. No source/published PCB, schematic or prior receipt was changed. Reproduce with `C:/Program Files/KiCad/10.0/bin/python.exe reports/board-completion-20260930/supervision-routing-independent/analyze.py`. The native uncapped API and KiCad's independent 499-item DRC category reporting cap were source-reviewed in [the earlier connectivity investigation](../selected-routing-connectivity-review/README.md); the current count is below that cap. This is native geometric/DRC evidence, without physical measurement or whole-card completion.
