DeadlySIn777/Controller/reports/board-finish-20261017/project-docs-before-r5/README.md

# Motherboard finishing continuation — 17 October 2026

The goal remains active. The board is unfinished and no manufacturing release is claimed. All twelve fitted motor interfaces and the retained electrical, fault, settings and service contracts remain required.

The completed R299 check was recovered instead of repeated. Its genuine full native fill has 1,172 remaining pad-island joins / 1,183 API unconnected items, zero ordinary DRC errors, 333 warnings and zero schematic parity issues. The native pad partition comparison with R157 gains five joins and loses no old pad relationships. This does not close source-reference, power, assembly or physical qualification.

## Actual design changes

`corrected-baseline-r1/native/board.kicad_pcb`, SHA-256 `8c9fb98f44aa0d31b9d71e32f041c47139cb745c355e2364a45de40a93614eff`, is an isolated editable copy. J11002/J11004/J11006 now correctly list PCB header 1803277; removable mate 1803578 remains separately identified. One exactly duplicated via record is retired with an identical all-six-layer survivor. Its physical copper/drill union and all 850 filled zone chunks are unchanged. Native verification passes every retained copper integer/lock, all 9,971 pad poses/layers/raw nets, actual via masks and all native pad partitions. It still has 1,172 joins. Portable project-relative libraries cover all used footprints and symbols. Its fresh circuit ERC executes all 27 sheets with zero errors and 92 warnings; these remain separately reviewed. Cached native DRC/parity is running.

`combined-route-stage-r1/native/board.kicad_pcb`, SHA-256 `758f3968589948ce6550d30586818a5ffaa673d8dad7fe8c9a7e402598cff1ad`, adds the separately requalified AO1 repair and two short ESD-ground/watchdog connections. It also replaces a distinct overlapping-drill pair with its proven surviving barrel/contact arrangement, and canonicalizes six redundant 180-degree pad-angle fields on three stock resistors. Native polygon vertex comparisons prove the angle changes preserve copper, mask and paste exactly. This stage adds 25 tracks and two ordinary vias, removes four replaced tracks and one overlapping via, and preserves all other items. Its two new vias pass conservative SMD copper/mask/paste clearance checks. Its fills are stale until the running all-zone native refill finishes. No new join count or native DRC result is claimed for this revision.

`combined-route-stage-r2/native/board.kicad_pcb`, SHA-256 `9f075604a881b1e0d8cafe869e7389e246025ffbd37ec4dabb7cc5c1a7db225a`, is a separate successor with nine more tracks across MOTOR_TX_GATE_B and USB_RECOVERY_MODE, zero new vias or old copper/pad/zone edits. The packet passes the corrected actual-109-rule source/geometry check and suppresses an already-staged watchdog alternate. Its circuit source incorporates the separately verified coordinate-only power-sheet cleanup. Native input inspection passes all 94,478 discrete copper integers/net/lock fields and all 9,971 pad / 2,723 footprint poses and values, with zero fill/save calls. Its 850 cached fills remain stale; whole native refill, resulting joins, masks, source/reference, parity and current/SI qualification are unexecuted. It does not replace the running frozen stage1 input.

`combined-route-stage-r3/native/board.kicad_pcb`, SHA-256 `653077ad9ca97e6d69f5ad1c2d90bf7bf1f73cf890b6f05ada882ec83552fbca`, further retires two ordinary CM_COMMS_OE_N vias that drill into pasted SMD lands, together with their six-segment redundant B-layer loop. The jointly tested packet retains every one of the 157 remaining object keys / 177 actual layer pieces and all ten source pads in one finite-overlap component. Removing a third barrel would split required pads and is rejected. No copper, holes, footprint, pad, zone or source definitions are added or changed. This removes two unregistered in-pad drill conflicts without extending the historical VIPPO list. This is a physical copper/drill change, not a union-equivalence claim. Native input inspection passes all 94,470 discrete items and every 9,971 pad / 2,723 footprint pose/value, with zero fill/save calls. Actual refill, native connectivity/masks/reference and current/SI/assembly checks remain open.

`combined-route-stage-r4/native/board.kicad_pcb`, SHA-256 `ce8aa2cd5bb9c2128733618d5241a10acebdd637e4a0b5f726fea40801444c55`, composes seven zone replacements and seven additions on stage3, with 857 top-level zones/rule areas. Two guarded negative CORE1V2 windows target the causal DIR7/RGB return shadows; both real CORE60 fragments are retained under separate UUIDs. Five FIELD5 finite-support additions widen the existing In2 path; five FIELD_GND replacements and one separate fragment preserve its split intent. The matched branch sheet screen improves from 307.5330 to 292.0476 squares (about 5.0%), still far above old In4's 87.8889; this does not close voltage/current qualification. All other copper/pads/footprints/source/outline/rule chunks are exact. Native input inspection passes all 94,470 discrete items, all pad/footprint poses, all fourteen changed/new integer contours and hole roles, and their native net/layer/name/clearance/minimum-width/priority readback. Independent review rebinds all packets and passes nine mutation controls. Six new display names are explicit exceptions to template-name identity; unchanged custom rules do not select those names. Their electrical profiles remain exact. Full refill, native connectivity/masks/reference, both rails' signed current/IR/thermal and SI remain open; the old cached fill in CORE69 is stale and cleared/new zone caches are not physical AFTER evidence. The frozen stage1 job is untouched and no additional full fill is launched.

## Verification and repairs still underway

- `combined-native-resource-guard-r1/` supervises one genuine all-zone KiCad fill for the composed diagnostic. `combined-route-stage-r1/native-full/` contains its native output/status. Its native BEFORE check finds zero discrete-copper errors. All original actual masks are held except two specifically proven physical via retirements; both survivors must retain all six layers. No forced flashes or substituted fills are used.
- `actual-full-audit-repaired-r1/` preserves and repairs a reproduced nested-group traversal bug in the unfinished historical R763 checker. The original failed run remains in `resumed-full-native-host-audits/`. The repaired audit caches the completed actual R299 graph before later checks, preserving 2,389 physical nets and 9,971 pads. Actual graph construction alone does not pass downstream gates. Two old FIELD5/In4 direct fill contacts and genuine positive-area old-reference deficits remain under investigation; no artificial via-contained zones are added merely to satisfy a counter.
- The repaired R763 audit has now completed. It finds zero old physical-group relationship losses, zero lost source keys across its nine named roots and zero old/new mask losses, alongside two direct-fill contact losses, 472 old trace-reference witnesses, 45 positive-pour reference witnesses and 28 raw new/changed-body gaps. These are diagnostic failures with retained engineering scopes, not a release pass. The separate R767 source-gain computation completed 4,064 checks and 1,953 saved gains, then failed only while hashing an outdated prepare-receipt path. `r767-finalization-r1/` independently revalidates its counts, original source/cache hashes and every saved gain-WKB hash without rerunning or editing the failed run: zero native-versus-drilled source partition mismatches, two raw native-clearance errors, 2,981 extra-0.025-mm planning deficits and 73 nominal curved-pad uncertainty rows. The two raw native errors concern pads independently confirmed as NPTH with no copper/flash on all six layers; their actual hole/washer and manufacturing roles remain separate.
- `audit_composed_actual_after.py` is independently reviewed and queued by `run_composed_audit_guarded.py` behind the confirmed live native fill. Fourteen executed host controls detect old-pad splits, missing/extra pads, raw-net renames, missing survivor layers and unlisted copper loss. The future audit binds exact R299 caches, full native output, all 9,971 pad polygons, every old physical/source/direct contact, reference witnesses and all R299 masks. Only the four individually listed replaced tracks are exempted; each of the two retired via UUIDs is mapped to its individually attested survivor. This queued audit has not yet executed native AFTER qualification and preserves the inherited parent failures.
- `no-fill-intersection-review-r1/` classifies the parent audit's 496 raw closed-set intersections: 268 concern intended zone envelopes, while actual filled-copper intersections comprise 172 boundary-only rows and 56 positive-area rows. All raw witnesses remain. Exact native-IU point tests certify 202 component points inside both actual fill and a no-fill rule, with five selected-point cases open; the 56 rows total about 0.00003524 mm² of raw overlap. Native rounding, rule semantics and fabrication implications remain separately unresolved. An intended zone envelope is not itself etched copper; the report does not turn envelope intersections into physical violations or erase actual-fill diagnostics.
- Independent project-bound KiCad API work now confirms all 109 actual rule areas exactly; the cached model inherited 108 rules with 40 differently rounded outlines. Future route packets use the actual geometry instead. The tagged KiCad 10.0.4 disallow provider intentionally deflates keepout outlines by its project epsilon, observed as 500 native IU (0.0005 mm). All 228 raw actual-fill pairs have zero native collision against the provider-identical cloned/deflated rules. This explains the distinction from the literal closed-set diagnostic, while retaining every original witness and separate physical requirements. Both R767 NPTH objects have unchanged true-circle source-fill gaps before/after (about 0.205499 and 0.205500 mm), meeting the 0.205 mm native inner-hole requirement without using epsilon. The inherited extra planning margin is still separately reported.
- `native-zone-contour-format-review-r1.md` binds the tagged native formatter/parser semantics to independently reproduced failures: one zone's later polygon expressions are holes, not disconnected outer regions. Multiple physical fragments now use separate same-profile zones, with exact native contour/hole ownership after load/save/reload. Failed multi-outer constructions remain preserved. This is a real input-format correction, not a waiver of negative-area or physical AFTER checks.
- `routing/` records two R310 connection groups passing actual full-R299 geometry, drill, rule and literal source-reference checks. R315 pair0 remains rejected for the left endpoint's missing return/strict-reference gap. `release-review/gpu-existing-In3-ports-r1/` extends candidate searches with local CUDA, retaining endpoint/return/native qualification separately.
- `power-review/` retains exact connector corrections, the independently reviewed overlapping-drill repair, original-scope AO1 source/contact/reference checks, new-via assembly clearance and an assembly census. The census finds many current ordinary drilled vias intersecting SMD lands outside the historical intentional VIPPO list. This remains a design/process blocker; the list is not silently extended.
- `power-review/field5-current-continuation/` binds the real withdrawn In4 sheet and its In2 replacement to the same finite barrel electrodes. Fine sheet sensitivities are 87.8889 versus 307.5330 squares, a 3.4991 ratio. At the explicitly conditional 0.36 A / 25 µm copper / 125 °C stress boundary, their sheet drops are 30.823 and 107.851 mV, before fanout, barrels, return and switching terms. The actual seven-pad branch planning subtotal is about 172.945 mA before unresolved leakage/inrush/reservations. The upstream F sheet and an additional actual B tap make a complete source/terminal budget necessary; the stress currents are not asserted to be real parallel-path sharing. Restoration of a full useful In4 path is being investigated. Connectivity alone has not accepted this redesign.
- `power-review/late-power-schematic-grid-r3/` supplies a separately verified source-only cleanup of six late-added component/stub/label groups. All 22 off-grid ERC warnings are removed: fresh native ERC is zero errors / 70 retained warnings, without suppressions, and fresh before/after exports preserve all 2,723 components and 9,609 numbered pad-net nodes. This source overlay has not been substituted into either in-flight frozen native project.
- `release-review/vendor-constraints-r1/` supplies source-bound physical Efinity pin/voltage assignments for the 135 assigned user pins and seven actual bank groups. The user downloaded and installed Efinity 2026.1.132 at `C:/Efinity/2026.1`; registry and executing CLI help confirm installation. The 1,093,103,616-byte MSI has a valid Efinix, Inc. signature and SHA-256 `ca4cad5558bd072954c4a69ec71bf63b9b5481f1167bb3a8851041fed48b7891`.
- `efinity-native-pincheck-r1/` now executes the real installed Interface Designer API. All 135 literal package-pin assignments and standards match, all seven source-defined banks read back at 3.3 V, import has no issues and vendor design check passes. Constraints/reports are generated with bitstream generation disabled. This is a T20F256 physical-interface check; its first run warned about the absence of a full project XML and used default programming settings. It does not qualify the complete runtime, industrial-speed timing, drive/slew/reset defaults or a bitstream.
- `efinity-native-pincheck-review-r2/` independently cross-checks all 256 package rows, the 135 assigned balls/directions/standards, seven bank definitions and H3 GCLK against the source and native XML. The initial reviewer incorrectly expected unsuffixed CSV names and voltage values on bottom special GPIOs; its script is retained. The corrected reviewer explicitly accounts for 32 native RXP/RXN/TXP/TXN report suffixes and blank bottom-bank voltage cells, whose voltage authority remains native XML/API readback. No underlying constraints or native check are changed.
- `efinity-functional-SIM2-map-r1/` completed actual vendor mapping of the frozen full functional SIM2 top against T20F256/I4: 50,336 LUT4, 48,144 FF, 2,156 ADD, one multiplier and zero block RAM. All eight event banks were mapped into logic with native EFX-0657 asynchronous-read warnings. Vendor mapping reports PASS, which is not device fit. The supervisor's final byte-hash assertion failed because Efinity rewrote project XML serialization; `efinity-functional-SIM2-map-review-r1/` reconstructs the exact original CRLF XML hash and proves unchanged XML semantics, source and runner. Raw outputs are preserved. This known large parallel simulation boundary is distinct from the missing physical motherboard wrapper; full fit/timing remains open.
- `efinity-memory-inference-r1/` isolates one behavior-preserving registered read/bypass correction. Native mapping of one bank drops from 4,052 LUT4 / 5,922 FF / zero RAM to 164 LUT4 / 161 FF / eight RAM5K. `efinity-bram-behavior-r1/` passes 35,847 old/new differential bank checks, including all ordered address pairs, collisions and X/Z controls, plus the unchanged full SIM2 regression: 1,190 actual-SPI checks, nine queue checks, eleven storage checks, seven provider checks and 10,000 default-deny cycles. Canonical gateware is unchanged. `efinity-functional-SIM2-bram-map-r2/` completes native mapping at 25,642 LUT4, 11,048 FF, 2,155 ADD, 64 RAM5K and one multiplier; its sampled CPU peak is 66.2%. This still exceeds the T20 coarse resource screen. Event dispatch alone estimates 13,029 LUTs before its memory children, and an isolated behavior-preserving dispatch correction is being tested. No complete-board fit or timing is claimed.
- `efinity-bram-postmap-behavior-r2/` additionally executes the actual mapped bank against the installed Efinix FF/LUT/GBUF/RAM simulation models: 35,872 binary-control checks pass after explicit stimulus settling and complete entry initialization. These are functional primitive-model checks, not postroute timing or hardware measurements. The initial r1 run failed at its first clock with time-zero initialized inputs; its logs and script remain unchanged. The r2 test explicitly drives unknown inputs to known values at 1 ns before the first clock, allowing model event logic to settle; no mapped design or model is edited and no failing clock is skipped.
- `release-review/event-capture-select-r2/reviewable-two-file-overlay-packet.json` is the best current isolated gateware correction: registered RAM read/bypass plus literal sixteen-way probe capture selection. It passes 55,296 strict old/new boundary cases, 196,608 distinct-channel four-state selector checks and the unchanged full SIM2 suite. Native full-core speed mapping now uses 20,134 LUT4 + 2,107 ADD, 11,044 FF, 64 RAM5K and one multiplier. The 22,241 LUT+ADD coarse screen remains 2,513 above T20's 19,728. Dispatcher, held-disabled-bus and prefix rewrites measured worse than this minimal correction and remain unadopted. Events-only area/area2 settings do not establish global fit; a single full-core area2 measurement and an isolated transport-alignment correction are the next checks. Canonical gateware and all fitted functions/limits remain unchanged.

## Resource and preservation contract

Local tools were checked first: KiCad 10.0.4, Python 3.14 with Shapely/SciPy/PyTorch CUDA, RTX 4090, and Freerouting are available. Four agents work in parallel. Heavy jobs share logical CPUs 16–27 at below-normal priority with two numeric-library threads. Task-owned supervisors sample total CPU every second and suspend their own job trees at 70%, resuming below 62%, against the user's 80% maximum. Samples and any breaches are retained in each resource guard directory; reported peaks are observations, not guarantees about unrelated future computer activity.

One DRC supervisor sample reached 84%; its pause is retained. In response, `shared_cpu_cap.py` now applies queried Windows kernel hard caps to the task's heavy worker leaves, sharing a 25% system-CPU budget with extra weight for the native refill. Supervisors and unrelated user processes are excluded; no process is killed or given memory/time limits. `shared-cpu-cap-r1/` records actual assignments, quotas and subsequent total-CPU samples. The earlier breach is not erased or restated as a wholly compliant run.

Existing live/adopted boards, source inputs, machine configurations and the external IS-1 archive are preserved. New design work is in isolated copies and hash-bound sparse packets. Source inspection, host geometry, circuit ERC, native pad connectivity/DRC, target compilation, HDL simulation, FPGA implementation and physical measurement remain distinct evidence classes. No fabrication files, order, flashing, physical measurement or readiness promotion is produced.
