DeadlySIn777/Controller/reports/cnc3-iol1-integrated-records-20261002/timer-share-record-candidate-r01/README.md

# Report-local four-region record/config acquisition

This candidate sends real mode-0 40-byte IOL1 SYNC, DIC CONFIG, IDENT and POLL transactions into the exact staged r03 target C. All four regions retain SYNCED state and zero output authority. The explicitly selected expected hardware-major1 profile never auto-trusts a response nibble; blank/missing major0 peers remain unavailable. The original major0 diagnostic bundle, existing wire frame lengths and shared firmware stay unchanged.

DIC configuration uses a bounded disconnected fixture (three debounce values100/200/300us), then checks the actual CRC echo of the applied24-byte blob. Each lane requests64 eight-byte IDENT chunks, and metadata remains bound to the previous physical command whose cached response is clocked out. One shared bit-serial CRC engine keeps four tiny pending chunks and contexts; it does not replicate four512-byte record buffers. The engine checks integrity, record shape, selected Source26 hash and static serial/UID/generation diagnostics. Host reconstruction observes every actual received byte.

`record_integrity_observed` is a cached integrity observation, not authentication, calibrated accuracy, current factory permission or compatibility authority. FPGA signatures and UID authentication are unimplemented. `signature_authenticated`, `factory_identity_verified`, `commercial_active`, output authority and held-reset analog validity remain false. Complete producer health, production trust provisioning, actual flash/MMIO/DMA/IRQ execution and ACTIVE transition are not demonstrated. No full HAL or machine integration claim.

The r03 successor fixes an independently reproduced same-cycle collision on a pending final chunk63: current queue failure takes precedence over success, so no integrity pulse can accompany a new failure. Actual failed predecessor and restoring mutation are preserved.

The family runner maps a genuinely composed top retaining the exact twelve-axis motion/session core alongside this acquisition. The first wide-write version consumed24,473LUT4 and was retained with its lint failure. Fixed-lane writes reduce the prior r02 mapping to17,209LUT4,7,123ADD,13,265FF and oneGBUFCE: +1,055LUT4 vs the prior composed diagnostic16,154LUT4 baseline. The coarse T20 cell screen FAILS: LUT4+ADD24,332 exceeds19,728LEs. The older composed diagnostic baseline16,154+6,806=22,960 also exceeds that screen. A vendor cell uses a LUT OR full-adder; this is not an FF-packing-only uncertainty. This mapping needs further arithmetic sharing/vendor resynthesis before fit. The dormant IS2 CAP3 mux is not included in either resource top. No die/board substitution, Efinity fit, routed timing, bitstream or physical rating is claimed.

Fresh replay: `python replay_record_acquisition.py --out <new-directory> [--wsl-distro GarciaMechBuilder]`; `--inventory` runs no validation. Four stages rerun actual SPI/C, shared-engine independent cases/compiled mutations, actual wire tuple mutations and family mapping. All functional evidence is scoped separately from the failed coarse capacity screen. Historical failed fixtures/runs are preserved in sibling report directories.
