DeadlySIn777/Controller/reports/cnc3-stateful-implementation-20261001/serial-admission-handoff-r01/README.md

# Bounded CNC3 motion implementation

All eleven fresh disconnected stages pass on the exact frozen seven-module
resource-shared successor. The original CNC1, shared structural CNC3 and external
specification bytes remain unchanged. Command/feedback sizes remain96/176bytes;
the frozen cap remains195,312.5steps/s/channel assuming50MHz. Independent exact
parallel comparison, overflow/rate/timing boundaries, actualSPI/CRC/rejection,
fault priority, clean drain and compiled mutations are included. An independent
nine-scenario actualSPI→emittedSTEP12→mechanics→ABZ4 run uses the identical RTL.

The shared incoming-rate checker performs11 sequential additions per word.
It rejects invalid rates before sequence,progress or any of12rates commit. A
currentCS/CRC-valid completed frame owns its admission result; reset/abort/newCS
cannot reuse an earlier accepted result. GPIO/wire/clock/provider behavior is
simulated. The mapped family result is not vendor device fit or physical timing.

This scope does not implement full IOL1/config/output authority,factory identity,
CAP3/pages,events/MPG,physical safety qualification or the realHAL machine chain.
The four real base encoder algorithms do not imply twelve physical receivers.
The standalone exploratory2MHz sweep does not raise the frozenCNC3rate.

Use the receipt's replay_command with a fresh output directory. The replay runs
actual compilers/simulations/family mapping, not cachedPASS aggregation. Failed
earlier fixture receipts remain immutable. See receipt.json for exact input,
proof,peer,plant and resource hashes and remaining implementation boundaries.
