DeadlySIn777/Controller/reports/motherboard-bypass-owners-20260930/r03-wide-input-frozen/README.md

# Exact AI / communications capacitor ownership

96 source capacitors: 57 in AI165 and 39 in COMMS95. Each has the actual generated IC owner, physical supply/signal pin, matching local return pins and exact series path when applicable. No nearest-same-rail inference or circuit mutation.

1mm ISOW HF and 2–4mm bulk-to-HF limits are manufacturer requirements. The other 3mm distances are conservative placement targets; actual route loops, converter output exclusions, creepage, effective capacitance and clearances remain native PCB/physical gates.

| Capacitor | Owner pin | Return pins | Role |
|---|---|---|---|
| C14701 | U14701.2 | 1 | converter_input_bulk |
| C14702 | U14701.6 | 7 | converter_secondary_bulk |
| C14703 | U14701.6 | 7 | converter_secondary_HF |
| C14704 | U14702.2 | 1 | converter_input_bulk |
| C14705 | U14702.6 | 7 | converter_secondary_bulk |
| C14706 | U14702.6 | 7 | converter_secondary_HF |
| C14707 | U14703.2 | 1 | converter_input_bulk |
| C14708 | U14703.6 | 7 | converter_secondary_bulk |
| C14709 | U14703.6 | 7 | converter_secondary_HF |
| C14710 | U14704.5 | 2 | HF_supply_bypass |
| C14711 | U14705.5 | 2 | HF_supply_bypass |
| C14712 | U14706.5 | 2 | HF_supply_bypass |
| C14713 | U14707.1 | 6,8 | HF_supply_bypass |
| C14714 | U14707.16 | 9 | HF_supply_bypass |
| C14715 | U14708.5 | 3 | HF_supply_bypass |
| C14716 | U14709.5 | 3 | HF_supply_bypass |
| C14717 | U14710.1 | 4 | HF_supply_bypass |
| C14718 | U14710.8 | 5 | HF_supply_bypass |
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
| C14824 | U14816.5 | 2 | HF_supply_bypass |
| C14835 | U14819.5 | 2 | HF_supply_bypass |
| C14836 | U14820.3 | 1,7 | HF_supply_bypass |
| C14837 | U14820.14 | 9,16 | HF_supply_bypass |
| C14838 | U14821.5 | 3 | HF_supply_bypass |
| C14839 | U14822.5 | 3 | HF_supply_bypass |
