DeadlySIn777/Controller/reports/motherboard-chassis-20261001/isow-full-cells-r03/README.md

# Reviewed native ISOW converter cells

This immutable donor applies only 26 parts: U14812 ISOW1432DFMR, U14813 ISOW1044DFMR, their 20 existing capacitors and four existing BLM15EX331SN1D ferrites. Electrical source and original footprint libraries remain unchanged. It starts from the root native passing `local-placement723-r04` board and is a delta donor, not a replacement for a newer root board.

Native DRC has zero regular violations and zero ignored checks. The candidate retains 2,688 footprints and has 8,123 track/via items, with 4,728 independently uncapped missing joins. Routing is incomplete. Exactly 85 invalidated private old copper pieces are recorded and 125 actual local pieces added; all other copper and nonowned footprint poses are preserved. All 52 recorded local endpoint pairs are physically connected. Board SHA-256: `396e14373a1ef1cf3c58b28812cd7dc3e458b329fe709ecc7f39bd4aae88de72`.

The two cell origins are RS-485 (374,92) and CAN (326,60) mm. The full guarded reservations are x362.475–390.500/y85.010–102.175 and x314.475–342.500/y53.010–70.175 mm. They were screened against actual root capacitor placements, 40 complete mate envelopes, the latest 110-part power-group recipe and reserved DI cells. Parent integration must rerun native checks against any subsequent changes.

The four 10 nF 0402 parts lie at local x ±6.10/y5.080 mm on the IC side of the board. Their matching lands overlap the corresponding extended IC land toes by 0.11 mm, as in TI’s official EVM. Native pad-centre distance is 1.259573 mm; a false <1 mm centre requirement is not used. Actual shortest same-net land-edge gap is zero. The symmetric power/return positions preserve matching HF connections. Package lead-tip and selected Murata body dimensions independently bound nominal pin-tip/body clearance at 0.510–0.890 mm. An aggregate IC-to-cap relative X assembly allowance of ±0.10 mm would bound it at 0.410–0.990 mm; that process allowance is not yet proven and is not ±0.10 mm per part. The assembly process and loaded EMC behavior require qualification.

Only the project-copied courtyard has controlled local indentations at the HF sites. Every actual IC copper, paste, mask, physical pin assignment and MPN remains unchanged, all family instances match the copied library, and actual maximum body/lead envelopes fit within the controlled profile. This is a declared combined assembly cell, not a disabled courtyard check. Keep unrelated packages outside the full reservation.

All local capacitors remain on F.Cu. The eight 22 uF bulk terminal-to-HF terminal edge gaps range from 2.860245 to 3.854828 mm, inside the manufacturer’s 2–4 mm layout interval. Two 22 uF parts per rail provide 44 uF nominal; minimum effective >=10 uF at actual bias, tolerance, temperature and aging is unqualified. Bulk branches may use dedicated own-domain vias; the matching HF lands are directly joined on F.Cu.

Two actual rule areas exclude every global pour layer from the right-hand converter-output corridors, and two actual rule areas protect the functional isolation centre lines. The raw corridor polygon follows the TI layout drawing/EVM interpretation and includes only permitted raw-loop copper; it is explicitly not a circular4 mm ban that would contradict intrinsic adjacent package pads and the required local bypass routing. Filtered ferrite exits go around the corridors. An independent native polygon review finds no foreign/filtered pad, track or via and no actual filled global zone inside either output corridor. Six adversarial controls reject moved/backside/swapped HF components, altered IC land geometry, disabled pour exclusion and inserted foreign copper.

Primary sources: [TI ISOW1432 current datasheet](https://www.ti.com/lit/ds/symlink/isow1432.pdf), [TI ISOW1044 current datasheet](https://www.ti.com/lit/ds/symlink/isow1044.pdf), the retained official TI EVM drawings, and the exact selected Murata dimension document. The independent dimensional source receipt is `reports/motherboard-return-zoning-20260930/isow-bypass-review-r01/review.json`; native verification is `reports/motherboard-chassis-20261001/isow-full-cells-independent-r02/review.json`.

No manufacturer release, physical isolation/surge rating, completed motherboard routing, finished stackup, assembly-process acceptance or measured EMI guarantee follows from this donor. Parent routing/return integration, actual module/cable/enclosure EMC and powered-state/thermal tests remain required.
