DeadlySIn777/Controller/reports/rev-a-integration-20261004/rtl/README.md

# Rev A disconnected RTL and current-C qualification — 4 October 2026

The executed component and transport checks pass within the scopes below. The full Rev A integration milestone remains **blocked**. No candidate was adopted, no device was connected or flashed, and there were **zero physical measurements**. No production, routing, CAD, firmware or RTL source was changed during this qualification work.

The canonical machine-readable record is [receipt.json](receipt.json). It binds each fresh receipt, execution log, decoded response and ARM artifact by SHA-256, and rechecks source provenance. Counts below describe different suites and overlap; they must not be added into a unique proof total.

| Fresh run | Result and count | What it establishes |
| --- | --- | --- |
| [Current IOL1 C/RTL](current-iol1-r01/receipt.json) | 5,441 host-C checks, repeated under sanitizers; four ARM compile/link profiles; 78 actual-C/HDL replay checks | Current protocol C runs as VPI peers against four actual IOL1 RTL masters. The enclosing bringup retains the historical six-motion/two-encoder scope and inhibits output authority. |
| [Checked-in structural CNC3](cnc3-structural-r01/receipt.json) | 743 C-oracle vectors; 41 serial-SPI checks; two C response roundtrip classes | Current structural RTL validates frozen commands, moves real 96/176-byte serial frames and packs responses. This top has no stateful motion generators. |
| [Twelve-motion/four-encoder plant](spi-twelve-four-plant-r01/receipt.json) | 18 scenarios | Actual compiled report-local RTL receives SPI commands, generates all twelve STEP/DIR channels concurrently, drives disconnected ideal mechanics and receives four actual encoder waveforms. Actual serial feedback is independently decoded. |
| [ABZ and alarm filters](four-abz-filter-r01/receipt.json) | 80,137 checks | Four actual ABZ components, local Z capture, illegal-transition handling, filtering and twelve-lane alarm filtering. This is not a completed CNC3 index/event pipeline. |
| [Twelve generator timing](twelve-generator-timing-r01/receipt.json) | 2,400,000 comparisons over 200,000 cycles; separate 60,848 dynamic timing checks | Twelve simultaneous algorithm instances and dynamic pulse/clean-drain behavior. This is component evidence, not a physical motor performance claim. |
| [Explicit boundaries and individual faults](explicit-boundaries-r02/receipt.json) | 22 cases; 684 fixture assertions | Six unsupported I/O/PWM/probe/index requests refuse after real twelve-lane motion; each of twelve alarms and four encoder-valid losses inhibits motion. The returned 176-byte frames report the relevant faults. |

The clean plant run observed rising edges on M0–M11 of 190, 227, 267, 305, 344, 383, 421, 460, 499, 537, 575 and 613. All four encoder queues drained. These are simulator observations of emitted RTL pins, not counts from a connected machine. The 18 scenarios include watchdog, permission and power loss, provider and sensor loss, alarm, encoder disconnect, missed steps, corrupted/replayed/wrong-session/truncated or stuck SPI, and FPGA-reset simulation. Correct UPDATE commands cannot silently restart a faulted run.

The seven stateful RTL files originate in `reports/cnc3-stateful-implementation-20261001/stage-r02`; the eighth dependency is the current `gateware/v3/rtl/cnc3_command_validate.v`. Their exact unchanged bytes and original paths are in [motion-inputs/provenance.json](motion-inputs/provenance.json). They remain a report-local candidate. The newer capability-page candidate at `reports/cnc3-is2-profile-20261002/profile-candidate-r02/rtl/cnc3_motion_spi.v:37` explicitly sets `IS2_PROFILE_COMPLETE=0`. The replayed bounded motion top does not implement CAP3 READ_PAGE. Neither path establishes complete host discovery or a qualified CNC3 HAL endpoint.

The inherited plant fixture sets `qualification_complete=1`, `installed_input=0xfff` and `installed_module_class=1` at `reports/controller-plant-20261001/stage-r04/spi_edge_plant.cpp:43`. These are explicit **historical logical qualification fixtures**, not physical discovery of motherboard regions or removable IS-2 cards. The active IS-2 architecture has a soldered FPGA and integrated I/O regions. No test here supplies evidence that these ideal permission, watchdog, power or installed inputs are satisfied by a real board. The historical runner's `actual_FPGA_integration` flag means actual compiled RTL in simulation; it does not mean an FPGA device was executed.

The first boundary harness is retained unchanged in [explicit-boundaries-r01](explicit-boundaries-r01/receipt.json). It failed before completing any case because it incorrectly required `permit_out_req` LOW during armed motion. The actual state machine defines that signal as `armed_mask != 0` at `reports/cnc3-stateful-implementation-20261001/stage-r02/cnc3_motion_state.v:118`; it represents motion permission. The corrected fixture checks general `output_request` and `progress_o` instead, and uses the actual decoder names `alarm_levels` and `encoder_fault_mask`. All eight RTL hashes are identical between failed r01 and passing r02. This is a documented test correction, not a source defect fixed or a failed observation erased.

Current IOL1 target images were compiled and linked for four Cortex-M0+ profiles; target code was **not executed**. Text sizes are 4,736 / 5,724 / 5,724 / 4,468 bytes, with BSS 176 / 156 / 156 / 136 and no initialized data. Host tests and C-to-RTL replay use explicit disconnected fixtures; they do not execute target MMIO. Generic Yosys Efinix-family mapping of the historical bringup produced 7,936 LUT4, 2,840 ADD, 5,512 FF and one GBUFCE. That is distinct from selected-device Efinity place-and-route, constraints, timing closure and bitstream validation.

The remaining integration blockers are concrete:

- A single adopted IS-2 top joining motion, CAP3 identity, real qualification, current IOL1 acquisition, diagnostics and output application is absent.
- The twelve-motion replay does not implement the required 24 general DI / 16 smart DO path. DI/AI feedback stays unavailable; DO, I/O-enable/write and PWM requests refuse. A refusal pass does not qualify functional I/O.
- Actual home/limit/probe acquisition, index one-shot events and complete event transport remain absent. Local ABZ Z capture does not close these gates.
- General output authority and a complete independent physical watchdog/permission chain remain unqualified. The separate current IOL1 replay is read-only diagnostic evidence.
- Actual LinuxCNC/HAL operation, complete machine kinematics, selected-device vendor fit/timing, real target execution and physical electrical/mechanical measurement remain separate open gates.

Existing historical reports, the external IS-1 archive and Claude-owned routing were preserved. The canonical receipt lists the exact scope and missing gates so these passes cannot be promoted to manufacturing or full-machine readiness.
