DeadlySIn777/Controller/research/user-notes/2026-10-18-is3-proposal/README.md

# IS-3 supplied proposal sources

Local intake, 18 October 2026, from user-supplied pasted pages of the private [revision workspace](https://huggingface.co/datasets/Deadlysin777/controller-is3-revision). These source documents do not adopt IS-3 or authorize implementation. Read the [proposal review and boundaries](../../../docs/proposals/IS3.md) first.

Eight original attachments are preserved byte-for-byte under `raw/`. Five unique document bodies are extracted under `sources/`; browser page furniture is removed and line endings normalized. Two raw attachments are exact duplicates, and the three delta JSON bodies are semantically identical. The receipt records every original attachment path and SHA-256.

- [Motor architecture draft](sources/is3-motor-architecture-draft.md)
- [EMCO console fix spec](sources/emco-console-fix-spec.md)
- [Supplied delta summary](sources/is3-delta-summary.json)
- [Supplied hash summary](sources/hash_summary.txt)
- [Supplied final classification](sources/final_classification.json)
- [Byte-exact IS-2 requirements baseline](is2-requirements-baseline.json)
- [Provenance and checks](../../../reports/documentation-refresh-20261018/is3-proposal-intake/intake.json)

Rendered-page Markdown bodies may contain tables as tab-separated text; these are preserved source transcriptions, not verified raw remote files. The delta summary's references to a full embedded baseline do not mean that the full regenerated document was supplied. The separately preserved baseline above is the current local source. No builder, audit script, full terminal map or ephemeral per-entry audit result is included. Supplied audit results are historical third-party observations, not a fresh verification run.

An additional user-supplied conversation is preserved byte-for-byte as [follow-up routing conversation](raw/followup-routing-conversation-20261018.txt), SHA-256 `bbbbe35f567d506188e3130fb81984f9ba7218ede1b3a5f1a0466080fc10b76b`. It is a ninth raw attachment, separate from the original eight-file intake receipt. Its assertions are reviewed in the proposal's follow-up section; preserving the transcript does not validate them or authorize its publication.
