DeadlySIn777/Controller/documentation/reports/appliance-os-20261004/review/README.md

# Independent appliance review

`final-r01/receipt.json` records a scoped pass. All 71 retained runtime sources and all 24 original configuration sources/assets match the baseline captured before appliance work. The selected runtime inventory still contains exactly those 71 files. All 48 current staged application sources match both the workspace and copied image; the OS test closure and 147 bound OS artifacts also match.

The review identified and followed corrections to cached startup validation, unknown output-state wording, new preference numeric normalization, absent-workspace behavior, the kiosk starting-page route and stale preference editing. The service owner separately corrected first-use workspace binding. No unresolved source defect was found in the reviewed final scope.

`settings-stale-r01` preserves the reproduced JavaScript stale-revision loop. `settings-stale-r02` executes the corrected actual JavaScript with inert DOM/fetch responses: refresh advances the base revision while keeping only the local text-size change, retaining the other writer's starting-page change. Cancel performs no write; pending confirmation prevents cancellation and duplicate requests. This is not a browser rendering or real HTTP test.

`lifecycle-r01/receipt.json` records 27 passing assertions on actual Linux subprocesses and loopback HTTP against the exact staged image. A separate counter process retains its PID/start identity and progresses through client and shell SIGKILL/restart. Fresh preflight rejects changed source and corrupt settings; recovery remains read-only; restarted API tokens differ; original image and cloned settings bytes remain unchanged. The client is a GET-only Python process, and the sentinel is an ordinary counter. Neither is Chromium, LinuxCNC, HAL or a real-time task. No systemd units were installed or activated. The overlay has no runtime supervisor/unit, so this result does not qualify actual motion continuity after a desktop failure.

The existing 12/8 integration remains disconnected FREE-joint evidence. Coordinated Cartesian/G-code machining, sensor homing, loaded real-time deadlines, target boot/touch/graphics, signed images/updates, physical acquisition/commissioning and Efinity fit/timing remain open. Generic FPGA resource closure remains blocked; the serialized event-RAM candidate remains unadopted. No production source was edited by this reviewer; no hardware, paid provider or physical authority was used.
