DeadlySIn777/Controller/reports/board-finish-20261011/continuation-r2/coupled-recovery/README.md

# Coupled recovery continuation

This work starts from the unchanged measured `198bba53ad2cf983940c68f5e732b575d28d5fb962bc1fa4d3fd959c23a427ab` candidate. The live board and every previous candidate, native receipt, project and source file are preserved.

`conflict-graph.json` identifies the 336 withdrawn r06 items responsible for the fourteen remaining native relationships. There are 481 serialized-coordinate copper/hole conflict edges against sixteen current blocker nets, arranged into ten coupled clusters. Rounded recreated-clone provenance is recorded separately and supplies no native connectivity or final geometry credit.

`coupled-screen-r1.json` independently reproduces all thirty affected nets' exact measured198b pad partitions before attempting geometry changes. Every changed cluster must preserve all current pad relationships and recover the appropriate original r06 relationships together. The zero-new-via screen restores original missing geometry and removes only direct blocker items, then searches 5/12/25 mm local windows. No cluster completes all its obligations. This bounded result is neither a global impossibility claim nor an emitted board. Old r06 fill coverage and unexported current via masks remain explicitly provisional.

The AUX24_A cluster requires a separate local regulator-support approach. U11015 is TPS26624; R11056 and C11068 return to **AUX24_A_RTN**, not FIELD_GND. The original TI datasheet requires RTN to remain separate from GND, a local RTN island, and short support-component routes. `aux_local_move.py` therefore restores the original DVDT copper, relocates only R11056 with unchanged local pad definitions/orientation/value, replaces its own ILIM route, and reconnects its moved return pad to the actual existing native RTN component. It does not claim a FIELD_GND reference, change a plane or add a via. Every native/electrical/DFM and dual-baseline no-loss gate remains mandatory before integration or adoption.

Only root launches native jobs after reviewing the frozen candidate and plan. No work here modifies shared/live source, launches native KiCad or GPU work, or creates another heavy slot.

Historical r2 evidence below is superseded: native loading found an unintended second POWER net because its serialized name used a normalized alias. The r2 board and r3 host audit are preserved as failed native-parity evidence, with no adoption. The independently staged `aux-power-escape-r2-host-only.kicad_pcb` has SHA256 `0fb4ae9b7db986e2d11c87e947fe7e777f48f88847f22a4d05376ffb84b6e3d9`. It restores seven original DVDT items, owns eleven current ILIM items and six 1.2 mm power-chain items, and adds thirteen segments. `aux-exact-audit-r3.json` reproduces all three affected current native pad partitions using the fresh integer198b geometry and all7850 actual via flash masks, then preserves every current/r06 pad relationship and every surviving physical copper entity. It finds no ordinary geometry issue, but explicitly records the restored DVDT via's two prospective plane antipads and leaves candidate refill, electrical local-RTN/return/current/drop and full dual native gates open. Root has separately queued its native measurements; no adoption is recorded here.

`aux-audit-negative-controls-r1.json` passes six adversarial synthetic controls: foreign copper, same-net SMD registration, unrelated drill, ordinary via pitch, suppressed actual annulus, and loss of a pad-free branch while pads remain connected. These controls test host gates and are not native board or electrical evidence.

The concrete alternative `aux-cap-bside-r3.json` removes the DVDT transition by moving C11068 from F to B. Its physical centre is(318.8,51.7) mm, with expected DVDT pad1 at(318.8,50.75) and RTN pad2 at(318.8,52.65). It retains value/pad UUIDs/net assignments/local dimensions, uses18 new B segments, deletes17 owned current copper items and changes no plane or via. DVDT/RTN/ILIM lengths are2.402/2.691/3.957 mm; the replacement1.2 mm power path is13.820 mm,9.768 mm longer than the withdrawn chain. `aux-cap-recipe-audit-r1.json` independently verifies full source geometry, all four affected current/r06 pad groups, every surviving physical entity/contact, every added serialized chunk, final copper/pad/hole/hard/edge clearances and moved-pad/courtyard clearances. Its host operation audit passes with zero losses/errors. Root must perform the actual native footprint flip/pose and attest transformed pad geometry against the frozen physical targets before ordinary DRC, complete dual native no-loss and electrical review can qualify a board. No board was emitted for this recipe by this agent.

The first cap helper was deliberately stopped for copying the whole board on every finite pose, and its source/stop receipt is preserved. The separate r2 helper was stopped after identifying a status-parsing bug: a successful search's `reason="exact path"` was incorrectly treated as failure. Its source is preserved; r3 uses explicit `path_found`/`already_connected` booleans and successfully constructs the concrete recipe. Neither stopped host run supplies negative native evidence.

`xf-fresh-reference-r1.json` reconstructs XF_REQUEST/XF_POWER_EN using the new source-connected In1 fill and actual annuli. The F-only request exhausts its declared local open set; the coupled F-stub case lacks a legal enable reference landing. The actual old-request/new-enable vias are only0.412 mm apart. `xf-coupled-transition-r1.json` preserves exact ownership while testing a concrete relocation with correct LOGIC_GND returns; it detects additional FAST_PORTS, AO_I2C_SCL, IO_3V3 via and cross-domain motor-health blockers and emits no board. `xf_continuous_landings.py` therefore builds all-layer legal signal/return regions, then screens a finite set of coupled sites with full copper-body reference coverage, prospective antipads and complete current/r06 contact obligations. It does not weaken ordinary via or source-reference requirements.

The exact native net identity repair is now explicit. `net_identity_exact.py` obtains each unique raw net token from immutable 198b, rejects any raw names that normalize to one key before constructing a typed graph, and serializes new copper with the original token. `repair_aux_native_net_tokens.py` reproduces the corrected frozen geometry and verifies existing outputs without overwriting them. The r2 alias collision is retained as a passing negative control. Corrected POWER uses `/motherboard_motors{slash}AUX_24V_A`; both source and corrected candidate have 2,384 native names and zero collisions. `aux-power-escape-r4-exact-native-nets-host-only.kicad_pcb` has SHA256 `f6f305afe4d1aeafebefed42ed196d4df57063e8c1a447f5b64092eac96ff735`; `aux-exact-audit-r4.json` passes with zero current/r06 pad losses, zero surviving contact losses and zero changed-item clearance errors. Native and electrical qualification remain open.

`aux-rtn-vippo-registry-r1.json` binds both unchanged inherited RTN holes to the original exact 291-location process registry. UUID `17d0fc7a-7d94-4acd-90d8-dfdc4568d76c` is U11015.11; `e59f9271-9daa-489d-be80-097d4ddb7318` is R11056.2. Both registry copies specify .5/.2 mm geometry and IPC-4761 Type VII resin fill, planarization and copper caps for these precise UUIDs. Fresh current integer geometry confirms the same via UUIDs at their current B-pad centres. This source process coverage creates no new waiver; final fabrication outputs must reconcile the retained relayout poses and process specification.

The complete cap layout uses the native C11068 flip/pose attestation from `../cap-native-r3/native-attestation.json` and its exact native footprint chunk. `compose_cap_native_r1.py` emits `aux-cap-native-r1-host-only.kicad_pcb`, SHA256 `8ba44dbd21ea261c092182f5407b6dd9468ba579004a5a464a33a71d74c6ddba`. It replaces only that footprint, deletes the 17 owned copper items and adds the 18 exact raw-name chunks in `aux-cap-bside-r4-exact-native-nets.json`. All 97,242 untouched top-level entities and the board header/trailer remain byte-identical to 198b. No via or plane changes are introduced; no additional native or GPU job was launched here.

`aux-cap-native-independent-audit-r1.json` passes the full candidate host audit using actual native B-pad polygons. Their differences from the frozen expected shapes are 0 and 7.1e-15 mm, below the .005 mm native polygon export error. All four affected current/r06 pad groups and every surviving physical copper/contact obligation remain connected. Track, actual moved-pad, hole, hard reservation, edge and courtyard checks find zero errors. Root still owns fresh full native refill/ordinary DRC, complete dual native r06/live no-loss and the complete AUX electrical/RTN/support/thermal/current/drop review; this candidate is not adopted or manufacturing-ready.

The continuous XF r1 search places three ordinary signal vias with correct source-connected returns and routes the upper F request escape and In3 connection with full copper-body reference. Four closest joint geometries all fail the same local F escape from U14019.2; no board is emitted and this is not a global impossibility result. `xf_continuous_landings_r2.py` tests different continuous paired regions with .85/.9/.975 mm stitch distances at sixteen angles and screens both local U14019 F escapes first. It retains exact raw-name identity, ordinary clearance/hole/pitch and full copper-body reference/contact obligations, and rebuilds a full final model before any candidate can be emitted.

`native_flash_model.py` verifies every unchanged current via's exact serialized position, diameter, drill and net against the fresh integer native export before pruning only copper disks on actually suppressed layers. It preserves all drill obstacles. New or restored unattested ordinary vias retain conservative copper on all six layers until root obtains actual native flash masks. A partial planned mask supplies no all-layer qualification.

`cm-controlled-initial-r2.json` owns the thirteen current clock segments and two direct MOSI blocker segments. It widens the complete local SCLK path on F/B to the independently modelled provisional .385 mm bulk width, moves the owned branch bend by .05 mm, and uses one .2 mm J15001.25 terminal neck. It restores two exact original locked .6/.3 mm clock via chunks without unused-layer suppression flags; their original native masks have all six layers. Its changed-item clearance screen finds zero errors and retains every current/r06 clock pad relationship. MOSI reconnection and all source-rooted return obligations must complete before a board can be qualified or adopted.

`cm-terminal-profile-r1/proposal.json` stages the requested separate exact terminal-profile delta. Its pad identity is `3c3ed0a7-1f49-42ff-9227-42088ba879b6`, raw native net `/motherboard_compute/CM_CAN_SPI_SCLK`, selected track UUID, F-only named region and .2 mm width with a 1.225 mm segment limit. Only that predicate is excluded from the provisional IMP_50 bulk condition; the existing U1001 literal exemption, every other future rule and future project byte are preserved. No original project/rule or board area is modified. `neck-clearance-comparison-r1.json` shows that the shorter 1.200 mm neck leaves .16579464 mm to retained MOSI copper, below the explicit .175 mm planning clearance; 1.225 mm leaves .18330416 mm. This is the smallest checked .025 mm endpoint increment in this chosen topology. The nominal mathematical neck/bulk model gives 69.0808/50.1233 ohms and single-interface reflection magnitude .1590; actual pad/load/bus SI and native rule parsing/effective enforcement remain open.

`cm_coupled_returns_r1.py` and the tighter terminal-component constructor `cm_coupled_returns_r2.py` plan ordinary MOSI F/B transitions and precise LOGIC_GND returns after rebuilding source-connected reference components with prospective signal antipads. `incremental_exact_model.py` accelerates only the temporary append of exact serialized new copper to unchanged exact source geometry; every positive complete board is rebuilt from its full serialized inventory and independently audited. `audit_cm_complete_r1.py` checks full current/r06 pad and surviving physical contact obligations, full changed copper/hole/hard/edge clearances, all clock/MOSI copper bodies against source-connected reference after physical drill holes, and the exact isolated neck scope. No controlled In3 path or blanket connector/via exception is permitted.

The CM r3 finite constructor changes only ordinary MOSI to F/In3 and keeps SCLK on .385 mm F/B with the isolated exact J15001.25 neck. Its positive candidate must rebuild the complete serialized geometry and pass the separate independent audit. The prepared r4 targets the actual surviving native MOSI R15071/U15036 group, then intersects that group's In3 reachable region with the exact F terminal reachable region before nominating a new ordinary via/return pair. Both r4 and the prepared XF r5 reference construction subtract every actual existing/new via drill and pad drill before finding source-rooted plane components. Existing native annuli remain layer-specific; every unattested new/restored via is conservatively copper on all six layers.

The prepared XF r5 owns the four original gate blockers plus six exact pad-free In3 entry trunk chunks. It reconnects the gate through B to unchanged native EN via (326.15,100.15), supported by unchanged exact LOGIC_GND return UUID e8cbf01f-5c17-449e-b9fd-0bb890ec4833. The obsolete entry removal is conditional on complete surviving physical contact and both current/r06 native pad obligations; it is not a blanket permission to drop copper. No concrete r5 board or positive evidence is claimed before the constructor and independent full audit complete.

Every new numerical host run enters run_host_confined.py, which binds CPU affinity 16–27, below-normal process priority and OMP/MKL/OpenBLAS/NumExpr thread limits of two before numerical imports/runpy. Launcher receipts attest these process settings. Only one coupled-recovery host run is active at a time; root owns all native/GPU jobs and the four KiCad slots.

The actual-native-group CM r4 constructor emits cm-coupled-returns-r4-host-only.kicad_pcb, SHA256 0bf996aeb28b21c0f2a84fa589c25bea6151d1114223fc98df21b47b28364426. It deletes only the 15 owned CM/MOSI segments, restores both exact original locked .6/.3 clock vias, adds .385 mm F/B clock bulk with the exact .2×1.225 mm J15001.25 neck, and reconnects ordinary MOSI through one new .5/.2 via to existing native-group In3 copper at (129.75,164.45). MOSI's added F/In3 paths are .157901/3.282338 mm. Three new LOGIC_GND .5/.2 returns complete the local transition plan. The initial independent auditor stopped on a receipt wrapper parsing bug before producing an audit result; its failed launcher/source evidence is preserved. The separate corrected audit_cm_complete_r2.py rebuilt both full serialized models and produced cm-complete-independent-audit-r4-r2.json: zero pad/current/r06 losses, surviving contact losses, copper/hole/hard/edge errors, drilled source-rooted full copper reference errors, return errors or scoped terminal/bulk errors. All unowned entities and original rules are byte-identical. This is an independently audited host candidate; actual new/restored native annuli, complete native refill/DRC and both all-net guards, effective profile parsing, extracted SI and manufacturing qualification remain open under root. It is not adopted.

The separate prospective_B_ground.py constructor helper permits only ordinary B tracks to displace same-domain LOGIC_GND fill, together with necessary all-layer ordinary via GND antipads/physical return drill voids. Each affected source zone uses its exact serialized connect_pads clearance, at least the frozen .15 mm same-domain minimum, plus .025 mm planning margin. Every touched exact original fill component and actual original pad/track/layer-specific annulus contact is recorded; any removed/split component or lost contact is rejected conservatively. Cross-domain boundaries, other power fill, real no_zones/no_tracks areas, reservations and all source zone/rule chunks remain unchanged. The independent audit reconstructs the clipping and complete contact ledger separately. Root explicitly authorized this prospective model and still requires fresh native refill, ordinary DRC, both complete continuity guards and source-rooted reference acceptance before adoption. CM r5 is retained as an unused separate alternative; XF r6 uses the prospective model to seek the B gate connection after removing only the specifically owned obsolete pad-free entry trunk.

Root's stronger ordinary-hole SMD aperture requirement is separately checked in cm-smd-aperture-r3.json (SHA256 f54a8760f6e4985bd941726de0bbbd9177d13cda554619a7b72b508e270846b3). It validates the unchanged 0bf996ae board and all six exact serialized changed vias: four new .5/.2 and two restored .6/.3. Against every fresh native F/B SMD copper polygon, including same-net pads and no process exemptions, the minimum analytic drill-edge gap is .404143245 mm at the MOSI via versus J15001.27. Subtracting the complete .005 mm native polygon inside error still leaves .399143245 mm, above .25+.025 mm. The narrow audit temporarily suspends only its verified own XF host process before geometry and resumes it in finally, preserving one active coupled host slot. Two preceding diagnostic scripts are preserved: r1 rejected native SMD pads with no physical copper; r2's bounded nearest-window missed a remote nearest pad. The r3 global native polygon tree excludes only physical non-copper pads and introduces no pad/net waiver.

Root reported that the merged native CM candidate failed its exact newly present via-net gate: two expected LOGIC_GND return UUIDs appeared as IO_3V3 in memory despite correct exact serialized chunks, dimensions and annuli. The standalone CM candidate and all its receipts remain frozen; no copper or raw net spelling workaround is applied here. Root investigates pre/post native parity loading and owns correction. No refill, adoption or manufacturing acceptance is credited for that failed merged native run. XF's independent auditor additionally applies the strengthened ordinary SMD drill-aperture predicate to every new hole on every physical SMD copper layer.

Root's subsequent immediate LoadBoard investigation identified free-via net assignment from stale touching zone-fill caches before the parity helper or SetProject. The separate cache-only refreshed parent 1beb9a2296ae451daed4b905383ccc5bd3ee083b3400cf5ef2e3ab2e7b7dae6b removes only existing filled_polygon/fill_segments derived children; every actual zone definition, discrete copper item, footprint and net token remains exact. Its nineteen new/restored native vias have correct nets, dimensions, positions and all six actual annuli, and the matching-stem canonical schematic export passes. Root's full fresh refill reports1354 missing pad joins/1365 API; ordinary DRC and complete dual guards remain under root. No adoption follows from this progress evidence.

xf-parent-ownership-r1.json independently compares that exact parent against198b using pure serialized source inspection. All ten XF-owned current gate chunks remain byte-exact, all twelve proposed restored request UUIDs remain absent, and the parent's28 CM additions/15 removals match the frozen0bf996ae candidate. No changed parent copper body bounds nominate an interaction within the XF construction ROI plus1mm. Sixteen source non-copper definitions differ and are recorded explicitly; source bounding boxes provide no merged clearance/contact/reference qualification. The full merged current footprint/pad identities, prospective ground-cut ledger and source-rooted reference require matching-stem native provenance and complete candidate checks before root may adopt anything.

The next prepared isolated DI6/fault recipe is di6_fault_coupled_r1.py, with a separate audit_di6_fault_complete_r1.py. Both are syntax checked, but have not run while XF owns the confined host slot. DI6 has one direct blocker, fault F segmentdb89a07d-09fb-4801-ad1a-7d84f421f166. Restoring the original DI6 via583bf99d-e1f6-45d5-a5cc-692686cd56e9 at114.65/119.45 would put it only.7071mm from the actual unchanged DI6 via0ff4e506-7bc1-48ad-91fd-aeb598e74c7a at113.95/119.35, below.8mm ordinary pitch. The smaller constructor withholds precisely that old via, restores the other nineteen exact original chunks, splices their In3 end to the actual current via, and replaces precisely the blocker with a B path between exact existing fault vias114.25/99.55 and120.05/99.95. Four new ordinary.5/.2 LOGIC_GND returns serve three restored DI6 transitions and the fault120.05 landing; two exact source returns already exist at the other actual landing vias. All new/restored vias use conservative six-layer copper and the stronger.275mm drill-to-SMD predicate plus the complete.005mm native polygon inside-error allowance. Both full current/r06 pad groups, every surviving physical copper contact, every affected original ground fill component/contact and drilled source-rooted full copper-body reference remain mandatory. Root has authorized this constructor to take the same confined host slot after XF releases it; no positive geometry or board is claimed before it runs and passes the separate audit.

XF r6 completed in2403.225seconds and preserves xf-continuous-landings-r6.json. Eight of its ten finite coupled geometries find all four request/local F paths with zero initial changed-item clearance errors. Each then exhausts a small738–741node B open set while trying to join the actual enable via326.15/100.15. The other two cases fail the local enable F escape. No case reaches full final contact/fill auditing and no board is emitted; this is not a native failure, a timeout, a rejected ground contact ledger or a global impossibility claim. xf_component_diagnostic_r1.py is prepared to reconstruct precisely the first successful four-path geometry and identify its exact B/reference component, source blocker identities and possible ordinary F/B/F return to nearer actual downstream F copper. Exploratory same-domain power-fill omission is diagnostic nomination only and carries no power/current/width/drop/continuity/reference waiver or positive acceptance. It is not launched while DI6 owns the confined host slot. DI6 began under confined PID65212/session8996 after XF released that slot, with no extra heavy/native/GPU slot.

Root's complete1beb native receipt now passes:1354 missing joins/1365 API, zero ordinary DRC errors,186 warnings and zero schematic-parity items. The unchanged original pad groups lose none versus r07 orC9; fourteen deliberate source retags have explicitly preserved separate obligations. Twelve original r06 groups remain lost; CM clock is recovered. Selected CM/MOSI/reset guards each report completed2/lost0 on all three baselines. Separately, the exact isolated CM terminal-rule native coupon and five negative controls pass in cm-terminal-native-rule-coupons-r4/receipt.json. Its proposed profile remains uninstalled and actual extracted SI/electrical/manufacturing qualification remains open. Neither this receipt nor the scoped rule coupon makes the incomplete whole board adopted or fabrication-ready.

xf-component-diagnostic-r1.json completed without a candidate. The exact B enable-source component is 7.550411 mm2, bounded by physical FAST_PORTS_EN_BUFFER via/track, C14015/C14018 pads and MOTOR_FIELD_HEALTH_A_RAW tracks. Omitting every same-domain B fill for nomination does not enlarge that source component or produce a path; no all-layer legal second-via site overlaps the actual downstream F component. This identifies a possible later third-net coupled wall reroute, not an IO3 power-fill waiver or global impossibility. No further XF landing sweep is launched.

The smaller DI6/fault r1 completed and preserves di6-fault-coupled-r1.json: both finite return arrangements passed initial restored-via, strong SMD aperture and rooted-return checks, then exhausted the same 43-node B fault escape component. No path, board or final contact/refill qualification is credited.

Root reprioritized the positive AO1 VREF/SDI operation: exact seven restored VREF items, four removed SDI blockers and the finite .025mm-grid SDI replacement. Independent AO1 projection uses each exact source-zone local clearance (including .25mm), domain minimum plus .025mm margin, every affected fill net, physical source annulus/pad/track contact ledgers, distinct disconnected fill-piece graph keys and actual U14619.7 AO1_COM root after every drill. First audit r1 stopped on an exact-raw versus normalized-pad token assertion; separate r2 completed calculations but its report writer rejected derived Shapely polygons. Both failures are preserved without proof credit. Separate corrected r3 was deliberately stopped after root requested binding the final return manifest first. Prepared r4 requires exact root UUID/chunk serialization, exact latest eedf parent ownership and frozen ordinary SDI policy; it uses a separately implemented sequential-cut contact audit in ao1_independent_fill_r1.py. Numerical launch waits for root's return nomination manifest. No analog board, native job, source/live write or adoption occurs here.

The completed independent analog r4 reports zero ordinary clearance/SMD/hole, current/r06 pad, surviving-copper and affected-fill contact/no-split errors, but nine full-body reference gaps and no VREF return. No board is composed from that recipe. The exact lost native VREF relationship is C14643.1#0 to U14626.9#0, both at375.498/129.0 on opposite faces. U14636.7#0 remains a separate source group and is not substituted for this decoupling relationship. The first target diagnostics are preserved and corrected in fresh scripts.

AO1 reference constructors r4 through r8 preserve finite negative evidence without global impossibility claims. The unchanged-SDI minimal branch has no ordinary VREF escape. R6 enumerates424 sites on each signal but its nearest prefixes all violate the required .81mm paired pitch, so it makes zero attempts. R7 instead checks continuous source-to-via and actual retained target components before pairing: nine VREF sites and no coarse SDI site qualify. R8 adds a .025mm boundary probe and finds147 VREF and eight SDI individually referenced sites, with no mutually .81mm pair. Its four physical diagnostic nominations stop at missing source-rooted return nomination, so no candidate chunks or board are emitted.

Fresh r9 corrects the conservative ordinary-via mask that had wrongly treated same-domain AO1_5V fill as an immutable obstacle. A legal prospective antipad/track retreat must still pass exact native local zone clearance, all old fill/pad/copper contacts, no-split, rooted reference and full native gates; cross-domain fills and actual no_zones/hard boundaries remain intact. It also reuses an exact existing COM via when its actual source masks, finite annular contacts and .81–1mm distance qualify, rather than demanding another return barrel. New and restored unattested vias keep all six copper annuli. The actual return root remains U14619.7, never generic layer credit.

audit_ao1_reference_coupled_r1.py is a separate full serialized rebuild and sequential-fill/contact audit, including unchanged neighbouring AO1 track reference preservation. ao1_reference_gap_diagnostic_r1.py emits exact gap WKB hashes/bounds and separates overlap with withdrawn barrel clearance, real new neighbouring transitions/return drills and retained foreign copper/hole clearance. It assigns zero speculative stale-fill healing credit. Root has authorized a frozen exploratory recipe only if physical/contact/unchanged-neighbour obligations pass and solely the withdrawn SDI cache-reference gate remains OPEN; fresh scoped native refill/export must resolve that gate before host reference PASS or adoption. All earlier attempts and receipts remain untouched; this namespace launches no native/GPU job or live/shared-board write.

AO1 R10 identified exact monitor F segments as the physical blockers for a nearby return position. R11 stopped on the native outline-ring adapter before path construction; its failure and helper are preserved. Fresh R12 fixes the adapter and owns three exact current AO1_MON_12V F segments in addition to the four SDI items, while replacing the seven absent VREF withdrawables. Its promising geometry uses VREF 374.0/129.0 and SDI 373.4/128.3, both ordinary .5/.2 mm, and finds all four VREF/SDI paths. Its MON endpoint at 369.35/125.15 was outside the bounded window. R13 corrects that window in a fresh script and confirms a separate strict-reference component barrier. The promising geometry nominates two returns; 373.5/129.15 cannot serve VREF at 374.0/129.0 because their pitch is only .522 mm. None of these finite attempts emits candidate chunks or a board.

Prepared R14 widens the local MON window and uses only the explicitly scoped withdrawn-SDI clearance region for exploratory path nomination. That scope is clipped to exact native COM zone outlines and excludes every retained actual foreign annulus, copper, hole and real hard area. It receives no acceptance credit. A complete operation must still pass a full serialized rebuild, exact local-clearance fill/contact ledger, all current/r06 pad and surviving-copper relationships, all-layer physical clearance, source-rooted paired returns, and the separate audit in audit_ao1_reference_coupled_mon_r2.py. This audit also checks that no previously referenced neighbouring AO1 track loses reference; only an independently classified withdrawn-SDI cache gap may remain held for root's fresh native diagnostic.

The completed exact R16 diagnostic found no prospective fill/contact or ordinary clearance error, but VREF at 374.0/129.0 removed 0.019397 mm² of previously rooted reference from unchanged SCLK In3 segment ac41743c. It also showed that the existing long MON diagonal already had 0.631098 mm² of uncovered body before any proposed edit. R15's optional physical-hole-key reporting failure is preserved; R16 fixes only that report field. No positive recipe comes from either diagnostic.

Concrete R18 moves VREF to 373.9/129.0, retains SDI at 373.4/128.3, adds COM returns at 373.1/129.45 and 373.05/127.5, and replaces only the locally obstructing lower MON span. Its retained upstream MON subsegment ends at 372.85/128.649999205. The source-line rational parameter and at-most-1-nm native coordinate quantization are recorded; this subsegment retains existing copper and its original uncovered reference rather than qualifying that baseline gap. All newly routed MON body requires full rooted reference. R17's duplicate incremental-append failure is preserved; R18 fixes only that initial-item handling.

ao1-reference-coupled-r18.json (SHA256 dec4321581a1d9e3cdab41f556804e45469ff3a82850f772a5e22a98362e206f) contains seven exact current deletions and twenty exact additions: four ordinary .5/.2 vias and sixteen segments, including the source-derived MON subsegment. It replaces the seven absent original VREF withdrawables. The source/native identities remain exact and no board is emitted. The separate complete audit ao1-reference-coupled-r18-independent-mon-r4.json (SHA256 e06e6692d3c03be118a741205fe691fe929ae91c5ee4c8e467fba48660d120f9) finds zero current/r06 pad losses, surviving-copper losses, ordinary clearance errors, local-clearance fill contact/split errors, unchanged-neighbour reference losses or paired-return errors. Its separately implemented sequential fill ledger matches the constructor. Minimum guarded SMD drill aperture is .743 mm; nearest ordinary via pitch is .860233 mm. SCLK stays byte-exact and loses no previously rooted reference. The retained MON body's uncovered area does not grow.

The full audit holds six new-body reference polygons. The independent analytic classifier ao1-reference-coupled-r18-independent-analytic-transition-r5.json (SHA256 95a564b7b8b7b5541bcda3a9df746fc4859c71ee986a1530d394b1f9bf434663) binds every exact gap WKB and frozen input. One tiny polygon is wholly within the actual unchanged .525-mm own-SDI transition disk: its maximum vertex radius is .524997535 mm. The convex disk proof removes an inscribed polygon chord artifact with zero radius expansion or tolerance waiver. The five remaining polygons are wholly within the withdrawn native .6-mm SDI barrel's .575-mm exact local-clearance scope. No stale-fill healing, host reference PASS or adoption is claimed. Root has received the frozen recipe and owns source/API/all-copper/new all-six-annulus checks followed by a disposable test-only fresh native refill/export diagnostic. Whole-board continuity/DRC, actual SDI timing/edge/return and VREF analog/PDN/manufacturing qualification remain open.

Root's first exact AO scoped native refill resolves the withdrawn SDI cache void, but the independently bound actual COM reference reveals two small new SDI F-body gaps. Native audit `ao1-native-com-reference-independent-r2.json` is retained (SHA256 faf362b74dd62ad4301ab6040fff4e2585c6093cf348246d92207eba07595bb1). The separate R3 diagnostic binds all actual COM source components and proves the 85 old native contour differences are within a 2-nm boundary band; it grants no contour expansion or loss waiver. Its exact references and every old loss WKB remain under `ao1-native-rooted-reference-r3/`.

Concrete `ao1-reference-coupled-r19.json` (SHA256 203f9f36ec4979ba2715139a16058a38f40f4d9fdcb4ec9f95fad07c4c6526b7) replaces only the three new SDI F segments, moving two intermediate vertices up by .025 mm. It preserves the original seven exact deletions, twenty additions, four via positions, MON source-derived subsegment, source/raw net identities and unchanged SCLK. Its fresh full independent audit `ao1-reference-coupled-r19-independent-native-bound-r19.json` (SHA256 f664d851a31e2ce65a2f0bd979a8d851bd67c3efd3d20099c4cb3f210a7bb3bd) finds zero ordinary clearance/aperture/pitch, current/r06 pad, surviving Cu, sequential old-fill contact, unchanged-neighbour reference, paired-return or new full-body reference errors. The 85 old native boundary slivers stay explicit OPEN.

Root's second native diagnostic clone is 8ec9f37a2402ca7b9f3860904534369a2def03e8ad6a2bd290c1cd828a463368. Only its eight AO1_COM zones are freshly filled; every other stored fill remains unvalidated. Fresh geometry SHA256 9c193d4e0e3b8d552a03eca2f91fcbcf6bc1a44c9b4a7bc4ee18b240292df18c and actual via masks fab7420ade17a7c742efbba1bc5acfd3b91e6607fc222fb7aec5ddd805aac1dd bind `ao1-native-com-reference-independent-r4.json` (SHA256 13f7425f4b5e717ad46cac7096817886aac694e024a7fb35fd8b5c84429c7595). All twenty new native raw-net/nm-coordinate items match, all actual COM discrete geometry binds, corrected SDI full-body reference gaps are zero, actual COM source-contact losses are zero and both paired returns pass. Local SCLK remains exact with no reference loss. The 85 strict old contour-edge differences, whole-board DRC/no-loss, SI, analog/PDN/thermal and final mutual composition remain OPEN. No adoption follows from this scoped evidence.

The queued C10036.2 FIELD_B_0V escape uses the frozen R25 local/B5 model and actual source J11005.2. Its five exact DO12_RCB_GATE F wall segments are withdrawn and replaced by a .2-mm F detour; one .5/.2-mm ordinary source-ground via at (73.835141,98.290361) and a .2-mm F stub connect C10036.2. `c10036-coupled-wall-exact-recipe-r2.json` (SHA256 1c10f6d5e79727bfc49d19d77ee1a73fd0532c7aace5f05d271c567e3873810f) is pinned to exact eedf source copper and fresh070444 source identity. Its separate `c10036-exact-operation-independent-r3.json` (SHA256 4f71a988497afbc6c49d14855b1d7ba8645e404045917159210a13e5977567ff) finds zero current/r06/r07 gate pad, surviving physical Cu, ordinary aperture/pitch and unchanged-neighbour reference errors. It holds the first gate segment's own inherited signal-transition void, so this initial recipe is incomplete and must not be emitted alone.

The inherited signal barrel is exact actual UUID40bdf2f9-776c-4aa5-bca6-7921f7c90b54, (66.55,95.35), .6/.3 mm, with all six native annuli. Its full new-body gap of .091411 mm2 lies wholly in its unchanged .575-mm native local-clearance disk, maximum vertex radius .555250 mm, with zero radius expansion. An ordinary source-rooted paired return is required. R6's 257 sampled locations qualify none; R7 subsequently proves the conservative continuous legal-centre region empty and finds no existing grounded via within 1 mm. Neither is an impossibility claim. Withdrawing the single exact .3-mm B DOB_FIELD_3V3 track75409711-7adb-4e55-b9ea-c36978361c51 frees a continuous .101317-mm2 ordinary return region. Return (66.55,94.45) has .100135-mm2 finite rooted annular interior on In1 and In4 and .9-mm distance from the actual signal barrel.

A first physical B power detour crosses .619175 mm2 of absent In4 reference and is not a qualified operation. The exact diagnosis binds the native FIELD_B_0V zone outline and own power barrel; .436432 mm2 lies beyond the old zone outline. Actual no_zones and domain barriers are retained. The prospective R41 DOB_DO_FIELD_3V3 In4 mesh630264b1 independently removes prior rooted reference from six old B supply tracks, so it cannot be silently integrated or used as ground credit. `c10036-r41-reference-interaction-r23.json` records those exact native identities. Field-power owns a separate correction of this prospective mesh; all old R41 evidence, twenty new barrels and twenty stubs are preserved.

Concrete `c10036-r25-reference-bridge-recipe-r24.json` (SHA256 016762020a735b19c932b4f0dc7a1d36b07854844c207f65aba6965caf438f6e) contains six exact source deletions, eight discrete additions and one unfilled FIELD_B_0V In4 zone. There are no FP/source/project/live edits. The original-width .3-mm B power replacement is (64.65,95.85) to (64.113163,93.394132) to (67.35,93.15), length5.759888 mm. The concrete new ground-reference bridge has .5-mm bulk, a proved .31-mm continuous core, .25-mm local clearance, priority124 and1.058899-mm2 actual source-rooted native overlap. Its exact outline WKB is ac0c4fe08eb087e21da02ac85fc71b1212fc1ee3cad4c3864976a179c3ace65e. The R25 constructor has zero new power-body reference gap, but full independent audit/native/PDN and R41 mutual correction remain OPEN. `c10036-peer-reference-mask-r26.wkb` (SHA256 c15b7bc932faf123137a73c2a7ea3020e78da2e6aca94fba8cd72f5ef51e5b55) combines the new bridge and every affected retained old native reference body for the peer's exact .275-mm prospective mesh carve.

Failed helper/report/compile attempts and the deliberately stopped own R5 return and R22 repeated-global diagnostic processes are preserved. R6 uses an exact local window containing every tested body; R23 rejects only straight segment bodies whose exact bounds lie outside the saved reference window. Neither changes source geometry or a gate. All numerical jobs keep the same confined host budget, no additional KiCad/GPU slot, and no native load/save is performed in this namespace.

The complete independent C10036 R30 audit is `c10036-r24-independent-complete-r30.json` (SHA256 b4cd12824af78c21a2d52f2c785ca1f7b3cfef3790158e18ee49832f01456038). Its exact R25 operation has zero ordinary Cu/zone/aperture/hole/pitch/hard-area errors, zero surviving physical contact or current198b/r06/r07 selected-net losses, zero new full-body reference gaps after the exact inherited gate disk and qualified paired return, and zero unchanged-neighbour previously rooted reference losses. C10036.2 and both new return barrels root at J11005.2. Every physical drill is subtracted before graph construction, with distinct keys for every disconnected physical fill or track piece. R29's inherited F.Cu model assembly for two serialized B power segments was rejected and preserved; R30 derives each actual layer from the serialized exact chunk and checks every resulting model item. No source or net obligation is waived.

The exact native-owned operation package is `c10036-native-owned-ledger-r32/receipt.json` (SHA256 017fb0ae11976a79059349bcc0364b8ce6cb0547b01ba542fb6a2a681bd76efb). Fifteen separately hashed files hold the six exact eedf source segment deletions, six new segments, two ordinary .5/.2-mm ground vias requiring actual six-layer annuli, and one unfilled In4 FIELD_B_0V zone with explicit .25-mm local clearance and priority124. The ledger binds the exact eedf parent, fresh070444 source, R24 recipe and independent R30. It has no footprint replacement, retag, project or rule change. The operation must compose with the peer's separately corrected R62/R64 source mesh and the latest CORE/protected additions; native all-copper/source/refill/DRC/continuity, actual field power/current/return, gate waveform and SI gates remain open. This recipe is not emitted or adopted as a standalone C2 repair.

Root's selected C native clone is 9910b29e8a4c596e26e10bd88397ac39e3e1c3416398e34591ae03b6271585bf. Fresh selected FBG geometry SHA256 64028d4193fa88c3535226230726bad019b136c64fde60a35f0eaf959e8e4a2c and actual flash SHA256 3e056b707977322b5090c799e76a9c587ea971bc2d2e881bc9c282c83ac42629 bind `c10036-actual-native-reference-independent-r34.json` (SHA256 2e78a31b1a488b1b15116cf8c1d34a117481ac60b511a692839fb88af61ea3a8). All eight exact new native raw-net/IU items, both all-six annulus masks, exact source/FP entities and new native zone definitions bind. The partial eedf clone excludes R25/remaining PDN proposals: it has twenty FBG pad groups, with only twenty-seven pads rooted at J11005.2. C10036.2 and both new vias remain outside that actual functional root. Five new-body source-reference gaps therefore stay OPEN; no source/reference PASS is claimed. Prior FBG discrete contact losses are zero. Sixty-five strict old reference differences are all at most 1e-6 mm2 and remain unwaived.

`c10036-actual-local-native-diagnostic-r35.json` (SHA256 9f12ac2db21d2cb89cd6fadc706dfdb6ab83b58bca9c4b400601cc703ff8a1bd) confirms that C10036.2, both new vias and their local reference planes form one actual FBG physical component. Both new B power bodies and the gate middle/end have zero gap against this local component. The first gate's .0914110445-mm2 gap is wholly inside its exact unchanged .575-mm own disk, maximum vertex radius .5552497810 mm, with zero expansion. The paired return has .100134865-mm2 finite interior on both actual local reference planes. This is local geometry/contact evidence only: that component is unrooted, source qualification remains OPEN, and full native PDN composition and whole-board continuity/DRC are required.

DI6 now reuses the preserved R1 source and exact native partitions while avoiding its disconnected fault reroute. Exact component diagnosis R3 binds eedf plus latest COREstage10; its F/B/In3 fault escape is bounded by specific existing safety/DI/DIC copper. The direct replacement R5 keeps every current fault entity unchanged, replaces only the twenty absent DI6 withdrawables, and preserves the mandatory withheld original barrel at114.65/119.45. Physical nomination `di6-direct-source-escape-r5.json` (SHA256 cd81ebadb6b7d5a343401734a1142646f3efe50cd9d10d8ae96943f596172e65) uses a .5/.2-mm DI6 via118.738752/101.143714 and paired GND via118.409121/101.912585, twelve .2-mm F/In3 segments, and actual existing DI6 target via113.95/119.35. The constructor includes all exact root R9 positives/discrete as hard obstacles on COREstage10. Full serialized/rooted-reference/contact/native gates are pending; no candidate board or acceptance follows from physical nomination.

DI6 R6's repeated global projection was deliberately stopped when the stronger fully projected SBC R59 authority became available. R7 completed physical/source-root/contact work but its exhaustive full-plane neighbour loop consumed about22 CPUminutes without a final receipt; only that verified own process was deliberately stopped and its script/failure evidence preserved. R8 freezes the exact R59 model SHA256 a77ba8a283d9b1e856ec6e4627363f9ba413e9db5c5af4c5fa1b8e3c41c32682 and writes an immutable physical checkpoint before later gates. Its receipt `di6-direct-latest-power-full-audit-r8.json` (SHA25642e250565080e9f495b0400645eda2a849618f6e1b33d2aa7ba85091d0c2cade) has zero ordinary copper/aperture/pitch errors, zero surviving contact/current198b/r06/r07 DI6 pad losses and zero unchanged-neighbour reference losses. `physical_reference_losses_r1.py` checks every eligible retained track against the exact old-minus-new rooted reference delta; all three full-body candidates among54,898 tracks also pass direct comparison with the original full-plane formula. Five new-route reference gaps remain, and R8 is explicitly INCOMPLETE. The existing target return's zero In1 contact is retained evidence, not granted generic reference credit.

The focused R9 planner keeps the analytic own-transition disks exact and reports disconnected projected boundary strips. R10 uses only the old actually source-rooted part of the new signal's exact outward projection cut for nomination; it heals no old neighbouring void and grants no reference PASS. `di6-reference-path-correction-r10.json` (SHA2568fc83a7142bc3b1498031e7ae0b4e5254c9f1447d504bc7f3287749f90c2aca3) shortens F to5.857725mm with a finite exact native pad attachment and corrects In3 to31.409204mm. All three real terminal/neighbour openings are avoided; two approximately3.3e-6-mm2 own projection strips stay OPEN. Its diagnostic numerical circumradius field was inherited incorrectly; the actual constructor uses the frozen `Z.bounded_disk`, and the separate R11 auditor binds that exact WKB/helper/constants and records the mismatch explicitly. R11 independently checks nine exact segments and two ordinary .5/.2-mm vias, all full physical/contact/native pad/source reference obligations and the unchanged original drill exclusion. The retained In3 target segment3a0b46f2 makes this a same-layer attachment; only the one new F/In3 transition receives new qualified paired-return credit. No current copper is deleted, no board is emitted and no native acceptance follows from either nomination.

`di6-reference-corrected-full-audit-r11.json` (SHA256 d6468fbf689a15f94e157318067358eec8c323eda202355194f9cde41879a8cb) completes the corrected recipe's independent R59 host audit: zero ordinary Cu/aperture/pitch/hard errors, current198b/r06/r07 DI6 pad losses, surviving contact losses or unchanged-neighbour reference loss. Its exact native pad overlap is .053730869mm2 and same-layer retained target overlap .033050104mm2. The new .836552mm paired return roots at J11001.2 with .098897157mm2 finite contact on both required planes. Only two tiny own-cut strips remain4.317e-6/4.329e-6mm2; both were fully source-rooted before and lie wholly in the actual new signal's exact bounded projection cut. They are explicitly unwaived and host reference acceptance is INCOMPLETE. The eleven separately hashed chunks in `di6-native-owned-ledger-r14/receipt.json` (SHA2566d7dcdc50a10393138761a0067fb73325eace8307800358d72723adcbb1afd79) permit root's exact native-only diagnostic. No standalone board or source/live/project change is emitted. Final newer PDN mutual/current/refill/all-six annulus/DRC/r06/r07/SI gates remain OPEN.

The DI15 constructor R15 binds the newer SBC R78 model SHA256128a21a83ccc8e1029f4b97e27930f82de743e00ef45fb1fc2041f0967b8a821, appends only DI6's exact owned eleven items, and rebuilds actual drilled J11001.2 source-rooted reference. Root's four prospective ground spines SHA256213182e7ec8439cccb0087bf99b362e6e149a3f21843d103b7b50ddceb428239 are hard obstacles only and receive no reference credit. Source-native pad identities U13001.25/U17005.9, exact ordinary all-six copper/holes/.275 SMD margins/.81 pitch, current DI6/fault copper and every previously rooted signal body constrain continuous site nomination. Any positive route still requires a separate exact constructor/full independent/native audit.

DI6's selected native trial contains exactly the eleven R14 additions on eedf. The independent actual binder R19 (`di6-actual-native-reference-independent-r19.json`, SHA256 db2452f3192ad4d7d0054144e44e03ce44ddf04279022ddb177b0e2480f3985d) binds every native raw-net/IU new item, actual six-layer annuli, unchanged source footprint chunks and pad poses. Actual fresh LOGIC_GND fill heals both new-signal projection strips; the new source return roots at J11001.2 with finite .100134865-mm2 interior contact on both required planes. Source and retained target are physically joined and old GND contact losses are zero. Its comparison to the older pinned 198b fill cache reports 2,748 reference differences; these are explicitly preserved, unwaived diagnostic differences, not attributed to the DI6 repair.

R22 (`di6-native-existing-target-return-r22.json`, SHA256 6bb5403004b11d997e867092c4362c78e7033230485d4e9d48409a770fc38ad1) qualifies the final new In3 body's actual gap against the exact unchanged target via's 575,000-IU own disk. The maximum actual gap radius is .555249781 mm; expansion is zero. Existing return cb1390c8 remains actually source-rooted with .123695775-mm2 finite In4 interior, .970824392-mm centre distance and native all-six annuli. This is a same-layer attachment to retained In3 copper, with no new target transition and no In1 target credit. All nine new bodies and used source/target returns pass this selected actual geometry check. Matched freshly filled baseline regression, whole-board/latest-PDN composition, current, all-net r06/r07 continuity, DRC and extracted SI remain separate gates.

The deliberately stopped R16 repeated full-plane numerical oracle and its source/launcher/stopped receipt remain preserved. R19's independent `physical_reference_losses_r2.py` computes the complete exact old-minus-new rooted-plane delta, then intersects every eligible full track body with every locally meeting delta piece. Omitted pieces are provably disjoint from conservative body bounds. The 1-nm broad-phase bound margin changes no reference shape or loss threshold; no plane buffering or precision expansion is introduced. R1's direct original-formula comparisons remain historical evidence.

DI15 R18 proves physical ordinary target escapes to actual pad U17005.9 at132.115/114.375, with full current source-rooted F-body reference and three legal sites near131.25/112.35. R23 (`di15-target-reference-cut-obligations-r23.json`, SHA256 dfe210ee30cc166f7da325cdeab69a83500f26f27e4c9a4f517c3b89fabd1f2b) finds zero retained signal-body cuts at those sites; whole-signal-disk containment was an overstrong nomination predicate because nearby DI17 existing antipads overlap disk corners. R25 permits partial annular placement but retains full new-route body reference and every old signal-body obligation, without granting DI17 void credit. Its bounded B transport/paired-return nomination remains incomplete; no DI15 board or source/reference qualification is emitted. The exact R78+owned-DI6 checkpoint is 2b272430cc2d0e2368a23c3d7aad25c3142010fdbec4ef6f2f78ff3239cd82c2. Newer root/CORE/field reservations must screen subsequent candidates before composition.

The matching fresh native eedf-before versus eedf-plus-eleven-items comparison is `di6-matched-actual-native-independent-r27.json`, SHA256 c56ae1566e40cd7d385ba790873d24645bd4b36719900dc5ca3ddec320acd8b8. All old tracks, vias, actual flash masks, pad poses/nets/layers/polygons and source footprint chunks are identical; project/rules and every non-LOGIC_GND exported fill are identical. Every old physical GND/DI6 contact and every old source-rooted discrete key is retained. The complete 54,858 eligible full-body reference comparison finds three strict losses, all the same 2.4990497808e-8-mm2 remote native contour sliver beneath MOTION_5V_RAW tracks 031c81e8, 6e63226e and 2ab6aefe. Strict reference status remains OPEN; the saved actual matched model and pre-reference checkpoint retain the complete obligations.

R29 (`di6-matched-native-sliver-diagnostic-r29.json`, SHA256 f4fb436e53261f74c1056b25a0b6cd601c0203ed767958a93741b721376ce7e3) pins the remote loss WKB and proves it is present in the raw freshly exported native In1/In4 fill polygons, not just the host union. It is more than 218 mm from new DI6 track bodies. R33 (`di6-remote-native-contour-return-diagnostic-r33.json`, SHA256 b7b1cc6e21655e1dad1de82e75559119d6587e2c3ff1e64757eff3c7de851435) reads native rings directly as integer coordinates: one existing boundary vertex changes from342081896/100677525 to342081950/100677322 IU on both reference planes. R31's failed MultiPolygon accessor and launcher are preserved. The old MOTION via237f91e0 at342.56/100.827 is unchanged; no actual LOGIC_GND via lies within1.5 mm. Its possible own disk alone supplies no paired return or reference waiver, and the exact 210.0595-nm contour displacement is not blamed on old fill-cache evidence. Actual plated-pad returns or a separate lawful new ordinary return remain constructive options for root review.

DI15's next independent nomination binds root's actual corrected combined R11 model SHA25624de27f569c8f4ae56b4172e6fc1af374c4f86c12d56215a2989eb793d2a55a8, including exact CORE91/C/U19008 corrected geometry, all latest field/protected shapes and exact source-qualified FBG In2 spine d480dd23. Only the eleven owned DI6 items are appended; every fill is incrementally projected using its exact native/proposed local clearance and actual new drill/body cuts, then drilled J11001.2 source reference is rebuilt. Earlier R78 and snapshot4 models remain frozen historical search evidence rather than replacing this current head. A nomination does not qualify root's whole power/current/native design.

DI15's current R62 binder supersedes R11/R18 search authority with root's corrected safe R22 model014b37594d378cd3e1a606cb1c06a0ad0b1b3ffea5cb836132bfaeec80d3a52a. It withdraws only the two unaccepted new LG spines that cut old field references, keeps the other five, and preserves the explicit20-nm correction of one new field spine. Exact original Cu, holes, source poses and outlines stay fixed. The R62 receipt a8234fa46de66b43eeefcf2bfbdb3d8563bf862a2ce60c46212b17e77ea314be and model98471471f69adba2f9ff908c37cf6789bfc1749ae1a4c240aa835e3738451527 append only DI6's native-bound eleven additions, cut each native/proposed zone by its actual local clearance and split the physical pieces. Actual J11001.2 roots1345 pads before and after; no prior LG source key is lost. This does not resolve DI6's three matched remote reference losses or grant all-bank current/native qualification.

The exact fourteen original r06 loss relationships are accounted for in original14-current-safe-r22-DI6-census-r68.json, SHA2565f7d39f804c133a1830dfa6acce28bc423ce45e3c48118853c8436f3afb45b0a. The actual current physical model joins CM clock, AUX DVDT and DI6. Eleven groups remain split: AO1 CS, AO1 enable, AO1 VREF, DI15, DOA ready, DOA SDO, DOB host fault, DIC CS, XF request, PEN enable and OBS34. AO19's separately positive scoped-native VREF recipe is deliberately absent from this model; it has not been lost or relabelled. Every census endpoint is bound to its actual current physical pad UUID/layer and the original uncapped native r06 relationship. Historical blocker nets are diagnosis only. XF still has no accepted positive recipe.

R72 constructs an actual J1-connected In1 reference strip for DI15's ordinary In2 path, with zero full-body source-reference gap and zero prior LG source key losses. Its receipt is5cb3eb252a6059e7e45eeef6f19e0b585837a9175533f2e4a7234f12e89dcebb. It changes no original native outline or Cu. One necessary new LG piece500a842a has area3.83908539mm2 and finite old-source overlap.137858654mm2; five other wholly redundant pieces should be pruned by an exact missing-body test in any future recipe. The potential CORE84b085e3 correction removes zero copper and must not be emitted as a byte-different geometric no-op. The prospective protected FB882c6aaa mask would remove12.225763589mm2 and split it into three pieces. That carve is unaccepted: signed loads, every supply source/contact, current capacity, power references, rebuild and native gates remain open, and root requires the solved protected route to stay hard first.

R76/R78 preserve all original and proposed power planes and test both the saved two DI15 sites and their continuous saved eligible regions. Source6.971064599mm2 and target.174562600mm2 lie in different components; R78 receipt250b305551504fdf514f7225ec9decc534e53a618e8c8df2b6d4546598df6f3f is bounded negative evidence, not a global no-route claim. R80/R82 separately test the other adjacent In3 reference for ordinary In2 transport with every power plane still hard and no reference handoff. The saved continuous regions are likewise split; R82 receiptdd7bf425e57a46c8a88415513cd712b47940a26d26fd896dadcad4c6a8b039a2. Physical nomination masks are explicitly historical conservative local masks; they cannot qualify a future actual serialized/native model. The saved strict router limit remains at most three layer segments with one dive-and-return. R44's four-segment F/B/In3/F diagnostic is not an accepted bypass.

R70's F-only compact ordinary probe preserves its failed launcher/source: PEN's required target group had no F copper, which raised the empty-geometry accessor before a final receipt. The fresh R74 explicitly handles empty layers and tries F and B independently, with actual own-domain rooted In1/In4, every current Cu/power shape hard, no removals or new holes. Its receipt57331e8060a9a1205d92e34cb9d3607cd20c12d5f1eaaeb3776435a1ac558604 records zero positive nominees. DOA ready has only F endpoint Cu and zero target In1-reference attachment. PEN has only B Cu at its target; its two B-reference attachments are finite but disconnected in the bounded qualified region. These are constructor limitations, not waived reference gaps or route impossibility. R84 next tests actual existing In3 group copper before nominating at most two B/In3 signal transitions with finite actual J1-connected In1/In4 paired returns. Full physical/source/contact/current/native/SI gates remain separate.

R86 and R92 preserve PEN's actual existing In3 copper and strict three-layer-segment dive limit. Continuous source components3/4 and ordinary target B transition regions do not overlap in the saved bounded transport. Receipts ea26ecb5e73f793503f64448640cb894eeab8096ef7a56dd1a94499495f30f9a and 7aaa8df76815edfa9ab597729c9a12de22a15e83a78ecb00175e67d458dd69fa are negative nomination evidence only. R88's compact OBS34/DOB fault/DIC CS/XF/DOA SDO outer probes similarly emit no accepted operation. No blanket rip-up or global impossibility follows from these searches.

R90 finds a physical ordinary In2 DI15 path36.807274mm with every original and positive power plane held hard. Its adjacent In1/In3 union is nomination only, requiring real source-rooted finite handoff returns. R94 builds exact new-only reference pieces; just central In3 piece dfa413d0 area4.199117511mm2 supplies the missing In1 body, but is unrooted. R104's fixed return sites fail; R108 reconstructs all-six-layer ordinary return geometry with every SMD/drill .275mm margin, .815mm guarded pitch, native rules, actual plane/local clearances and finite partial annular source contact. No full-centre plane containment is imposed. R112's continuous physical shared locus finds a real exit return128.695/109.614094, but no entry. R106's bad frozen-receipt filename and R110's deliberately stopped expensive diagnostic are preserved separately, with no passing reuse. R114 uses exact local broad-phase exclusion only and produces170 DIC return sites blocked exclusively by existing tracks, receipt54a73dea921dc05c85b76425877139019157c1b53835a3ed02a313fb1988b0f1. The smallest actual DIC nomination owns F eeb56c13 plus two duplicate B response tracks e876114c/c70911dd; its return130.919793/91.036421 has finite J1-rooted In1/In4 annuli. This is an ownership nomination, not a completed reroute.

R118 supersedes R62's search head with exact checked ROOT R42, model a4baedbfbccc92930a22c946b1e4e5262287d59b60b2a1e529bfddfa75c398ba and independent ROOT R43 receipt c0688d943d936947bb21ce60b7afc57574e5c4220db00ff7349b6b4821a0f0b3. Only the eleven native-bound DI6 additions are appended and every fill receives its exact local clearance/body/drill cuts. Receipt bb171905c94a5795d7ae3e3ded2a367c4d02a4b463bf9c82b4c6c962126c69c6 binds model689ad5fe8c9a654bdb1805b1b0fce26afe6215f5ee1418a3ba6e1fb80ee968b0:1354 actual J11001.2-rooted pads, zero prior source keys lost. All-bank native/current and DI6's strict three remote native contour reference losses stay OPEN.

R120 and R122 prove exact R42-vs-R62 local original Cu/pads/drills/rules and all-six fill equality before reusing the R80/R108 physical masks. Only new reference copper may extend; no power carve occurs. R122 finds an earlier physical return129.544432/96.798839 but no .30mm new-ground bridge to the central piece in the bounded7mm window. Its incomplete receipt is a20c71e40be5416780594ae407b33a8c654d0b95ded270561c62aaf42e7baef9. The focused R124 then identifies23 ordinary near-entry return positions blocked exclusively by two exact DI13 In3 tracks3bb187ed/c9ee35c6, with actual J1-rooted annuli and every pad/hole/power/rule hard. Receipt3367d6d3c79f50b164d57ff533033fbdefa2943f386cb422ffb2d2d929dcb57e nominates return123.794965/102.674128 at.549999475mm from actual In1/In3 handoff123.675923416/103.211090311. R126 constructs that exact coupled two-track DI13 rework and new-only ground branch; complete DI15 serialization, independent original contacts/native/current/SI/reference gates remain explicit until measured.

R126/R128 stop at strict new-only island coverage; their source and launch failures remain preserved. R130 explicitly trims only the new R94 island inward10nm and rounds it to native1nm grid, removing.000252265620mm2 without touching old native or positive power copper. The new island WKB is2ee9b79c41d101513960a4981100c98d0f6dc7514e2c59f2ef56a14223d1cd18 and both.30mm ground branches fit the strict legal region. DI13's ordinary In3 track junction123.95/102.15 has no actual old barrel and no rooted In4 beneath it; R134 preserves this diagnosis and grants no invented own-transition disk. R138 instead attaches to actual surviving physical groups after exactly two deletions. Its source and target referenced In3 metal are finite but disconnected, receipt159a30ff7a4c3c90b3f1c09624f43fb3174587e42e2c357c03bb6e88ac6f6778. R140's F-only replacement similarly finds separate referenced components, receipt9b51ab9d9be75b28514988513cb24f0d1b2534125be16a0d9141a867264befb3. Neither emits a board or proves no route exists.

R132's verified own slow endpoint diagnostic was deliberately stopped and preserved, receipt8c12d40818e6cae879a7e24682cae435cac62f9d0ec2271b00c800fd7f354906. R136 uses exact disjoint broad-phase exclusions and completes both fixed DI15.5/.2 signal sites' all-six physical/SMD/every-hole/pitch gates. The source site119.835668/89.798413 has no current ordinary In1/In4 paired return within1mm. Three target return nominations near130.75/113.02 have finite actual J1-rooted annuli, but final holes/reference/native remain OPEN. Receipt094a9fb2e89cc67c45e215e823c202839f960201355be793f71ff2343b64cd3e is an incomplete paired-transition nomination, not a physical signal-site failure.

R144 separately characterizes DI15's source F/In2 SAME_PLANE case, receipt274e72a14d0768b0afa7dfe9ac1c72089f9c6e86b6c0918e53f67e559e9e2aa2. One actual J11001.2-rooted In1 physical piece covers the entire.525–.725mm annulus around119.835668/89.798413 and both tested adjoining bodies outside the exact.525mm own aperture, with zero ring/body gaps. Exact native eedf stackup and complete saved policy hashes bind. R142 stopped before geometry at a formatting-only comparison to the saved stackup; R144 preserves that failure, extracts the native balanced raw chunk, and requires all lexical tokens equal. The inherited hardware_check_return_corridors checker still unconditionally requires a return within1mm for every signal via and therefore remains FAIL for this source. TI Precision Labs “PCB Trace as a Wave Guide” slide10/page9 supplies the specific same-reference-plane engineering basis; the separately proposed predicate requires both adjacent signal layers to share the actual continuous source-rooted conductor. It does not waive reference changes, neighboring voids, edge/SI qualification, full route/contact/current/native gates or the strict saved at-most-three-leg route limit. No original checker, project, rule or board is changed.

R146's mirrored DI13 In3/B nominee finds three real ordinary source-metal sites near121.27–121.31/99.43–99.50 with.066–.068mm2 real surviving annular contact, but their complete.525–.725mm In4 rings fail. Receipt4e1ccfa2a8bd7f824a65c061a621603ddb22e6cd151ef7b6c7861011bf7ceb75 is incomplete. R148 permits finite annular landing beside the narrow old track while requiring a full existing.726mm source-plane disk; the resulting nomination region is empty, receipt2767ee078a1fc0c96a0db4ddd5cfeca41aa5c98255f98ecf8966a195d65b89c2. Those complete360-degree/full-disk predicates are conservative constructor screens, not an established universal electrical requirement. A future finite continuous SAME_PLANE conductor proof must bind actual width, used-side path, all real foreign holes, full bodies and source; native/SI remain open. The full inherited DI13 F/In3/B/F path could exceed the saved three-leg limit, so no acceptance follows by counting only newly added legs.

R150 keeps both original DI13 tracks and every power shape fixed, and roots the new central In3 strip from two near-exit ground sites. Receipt19502144d94acbfd7086732c343178e0bebb326497274feabea0eba433e6f1d4 is ONLY source/union nomination. Its sites128.74072/109.303878 and128.695/109.614094 are only.31357mm apart, and both handoffs lie at the exit: mutual ordinary pitch and the actual entry reference-change obligation fail. The constructor did not yet include these two necessary qualification checks; the omission was caught before independent acceptance/native use, and its model must not be installed. R152 separately enforces.815mm mutual pitch and explicit In1/In3/In1 assignments, and jointly moves the new entry/path/strip while retaining original DI13. It finds3.31584mm2 source-side In2/In1 overlap with the legal new-ground branch component but zero continuous ordinary return locus within1mm of that free entry overlap; receipt363e08de4f61fd0865d4481e6f2995d5a380f6d3f4e91d671cd266cd7929c141 remains incomplete.

R154's actual-barrel witness loop still used a window excluding the real native endpoints and therefore found no witnesses, receipt22b124f67b8089a9b757699b3dbbe9ba163a16f2b3d647c7c73c51fc3932e00e. Exact native source chunk inspection locates source3915d83c at121.85/90.75 and retained targets161402e1 at131.25/117.15 and5e80f2ce at129.75/118.85. R156 binds those exact poses and expands only the attachment nomination to actual surviving In3 component copper in their region. It preserves the two-owned-deletion scope, all native flash/flags/source, exact own-radius and genuine paired-return/full-contact predicates, and adds no DI13 signal barrel or four-leg policy exception. Complete current/native qualification remains separate until a positive constructor and independent gates finish.

R156 finds the genuine unchanged source return fcee7e06 at121.934319/91.587975, .842206503mm from the actual .6/.3 source signal barrel3915d83c. Both source-rooted reference annuli have .164929475mm2 finite contact, allowing only the actual unchanged .575mm source aperture. Receipt257c893551e7bd07291e077e5da1f27a46c1f3661c42d070db869160d8cf2097 still has disconnected source/target referenced In3 attachment components. R158's actual target131.25/117.15 has no legal ordinary paired return in its bounded .820–.995mm annulus, receiptb39e451772bfed0f8aadbd310776f6e9b028a3adb21f9b172fc8aba2b962ea8f. R160 separately shows disconnected physical-only and reference-only attachments after exactly the same two authorized deletions, receiptf81c19a3b4cec4cb09a959359d85ff7ef3a16c763ad3bc5f29c2580b8b0d7ec3. These are concrete bounded failures, not global impossibility or grounds for blind further rip-up.

DIC R162 binds the actual native R13013.1/U13003.3 source relationship and three exact original blockers, receipt97d8792f596a22ab3a65527b3ab19a50cc4d9496034a0a41e17c077b29baeda1. R164 positively constructs a F/B/F recovery with fifteen .2mm segments and four ordinary .5/.2 vias, replacing only F CS trackeeb56c13 and the exact duplicate B RSP tracksc70911dd/e876114c. Exact raw net tokens and the saved three-layer-leg limit are retained. Receiptcdb152ede9fbb637191668297405e07af5be24f7e984dc23687dd37d5209ca4b is nomination, not acceptance. R166's independent script stopped on missing prospective profile metadata and is preserved; R168 reads that clearance only from the exact matching frozen after-zone header, without fallback defaults.

Independent R168 receipt921ff351ae34e49195892d3e20981b39799710a204a889a76df50a9d4dd28761 reconstructs all nineteen exact added chunks and three eedf deletions. All-six Cu, every SMD/hole/pitch/native-mask check, every affected surviving layer/contact/source key, direct old fill contacts, current/r06/r07 actual pad groups, all five new full-body references and the accepted R190 IO3 physical/intended mutual screen have zero losses/errors. Both new paired returns are actual J11001.2-rooted on In1/In4, with .824996490/.829999574mm signal distance and finite interior annular contact. The strict unchanged-neighbor gate FAILS locally: original F DI_SENSOR_G0_FAULT tracks2baae30c/3eb0b0e1 lose .000788272/.000787152mm2 reference, and B DIC_IOL1_CMD_BUFFER811a28fc loses .032598407mm2. These actual local new-hole deficits are not inherited DI6 cache contours and are not waived. R170 therefore varies only the unaccepted new signal/return sites against exact old full-body reference masks and binds the successor R201 IO3 group. No candidate board/native/live adoption has occurred.

R170 freezes the exact old required source-reference mask for234 nearby eligible track bodies and retains ordinary all-six masks. Receipt94bd456d0c2849dfd3a7bf0df56f9949826c1a8b651da1d3095cc6a51301d769 finds a corrected target signal130.782294/90.235607 with finite real returns130.951774/91.046517 or131.014157/91.039422; each has .164929475mm2 interior source annulus on both required planes. All four original R164 vias are disjoint from the R201 successor IO3 In3 physical/intended roles, including actual drills and .425mm outward antipads. The nearest source1.2mm region is empty. R172 expands source sites to3mm and checks actual retained GND barrels; the source ordinary region is finite .11mm2 but has no paired return, receiptf0d7d51bce0d1ab06e99f84fc6c338222dfbee07db7994cfa058d7d5992c3b92. R176 removes that arbitrary radius and intersects the entire exact source-pad reachable F component with the ordinary signal/real-return locus: intersection0, receiptb612ab99c8dbe5bb58b4a5c33a9b2f5b88ef88382aaad1eaf768a96c5073658c. All three bounded incomplete witnesses remain preserved.

R178 consequently adds exactly one original locked B CMD track811a28fc to the prior three-owned-deletion scope, retaining its .2mm width, raw net, exact123.05/95.05 and128.549999/100.55 endpoints, and locked intent for new CMD segments. It tries the actual same-B replacement before the DIC F/B/F constructor. Receipt27c8caf71f6d6778a30a39e5119e0a547aff0b1a39bc14886b45eb8a4cab9739 is incomplete: neither target-return option has a common strict CMD component. Exact source inspection identifies the second CMD endpoint as real retained .6/.3 signal via1f815e33, not a bare track junction. R178 deliberately grants no unqualified endpoint disk. R182 separately binds the exact original .575mm aperture and checks actual source-rooted plated GND pads/vias or a legal new ordinary return within1mm on the required In1/In4 layers. No additional signal layer leg or generic reference void allowance follows from this diagnosis.

R182 receipt e4515c7eb4a22e7173502dc2e29134c9bcc19b5b381a9fdebbd09fe744922a27 finds no existing source-rooted plated GND return within1mm of actual CMD barrel1f815e33 and no new site in the conservative earlier mask. R184 recomputes the exact local ordinary return locus with only the four owned tracks withdrawn, all four DIC holes present and every other native/power/neighbor body held. Receipt14632c0e8a423fa209e47ca0eb4006d97e4f4ff49a2a38ba8e13be321876ffde freezes three legal nominees:128.003069/99.939064,127.954916/99.932246,127.906762/99.925429. Their actual distances from unchanged CMD signal barrel are .819984891/.857755082/.896572792mm, and both actual J1-rooted inner annuli have .154176987–.164929475mm2 interior. This is nomination; new barrel native annuli/contact/current/reference gates remain OPEN.

R186 adds that real ordinary return, preserving the exact old CMD barrel and granting only its .575mm own aperture after finite actual used-layer annular qualification. The first two CMD-first trials each produce a valid strict same-B CMD component and source-F DIC component, but no common DIC B component. Only that verified own host process was deliberately stopped to change the coupled route order. The explicit preserved stop receipt is DIC-R186-own-host-stopped-preserved-r1.json, SHA2564b3a53ac366f5c2b1bbb7a6286feeb1c345f6ef72a55f942c1ae2009a5d5cd5a. No positive R186 receipt, board or native job was emitted. R192 keeps the exact saved positive R164 DIC B backbone first, changing only its corrected target terminal, then constructs CMD around it. R190 separately prepares F/In3/F transport with the same five ordinary vias/actual returns, four deletions, old CMD pose and strict three-leg DIC limit. Neither prepared alternative grants a same-plane exception or reference waiver. The separate independent R188/R194 templates reconstruct serialized chunks and include all affected layer/source/direct-fill contacts, exact current/r06/r07 native pad identities and latest R73/U10017R195/R201 hard mutual checks before native review.

R192's saved B-backbone-first trial produces the DIC F/B/F route but leaves CMD B disconnected. R190's F/In3/F trials retain valid CMD B/source F components but have no common In3 component. Only their verified own confined host processes were deliberately stopped; immutable stop receipts are DIC-R192-own-host-stopped-preserved-r1.json (SHA2560a3c02b1d776e2638a247c40e68f38056b4b6df9c2b5e04a6fb4faa7d6a4e6ca) and DIC-R190-own-host-stopped-preserved-r1.json (SHA2569a5980187ded5e64659a0f2b537c618194dd6fa528f4dda1f9c1b709cb81019b). No board/native/source/project change or positive qualification is emitted by either stopped trial.

R198 changes only the DIC transport to F/In2/F with actual In1 reference on both signal layers, retaining the three-leg limit and requiring three real J11001.2-rooted ordinary paired returns. Its concrete receipt DIC-In2-actual-paired-CMD-construction-r198.json (SHA256d26522a045ba719d951966d69a41860a68ca3cd064a35b4d767aa109956bed9d) freezes twenty .2mm segments, five ordinary .5/.2 vias and exactly four eedf source track deletions; the old .6/.3 CMD barrel and all original FPs/rules/vias stay exact. Its first coupled attempt is positive with current/r06/r07 signal pad groups retained and restored DIC endpoints joined, but is a constructor nomination rather than independent/native acceptance. No SAME_PLANE policy exception is used.

R202 is preserved prepared/unrun. Its independent successor R204 (audit_DIC_In2_supported_independent_r204.py SHA256eea18628ce200e428fc5246e8c586c3efca3512272ea8962765d6b1aa6372bfd) independently parses every new/deleted raw chunk, binds the exact native source stackup and F/In2/F leg order, rebuilds all-layer clearance/aperture/contact/source/native pad/reference obligations, and screens ONE exact latest R214 joint head plus the R201 IO3 canonical group and C1022 R222 additive segment. New own-aperture credit is clipped to actual before-rooted reference; unchanged CMD own-hole credit is clipped to exact rooted native design outlines and every other real Cu/hole/keepout/foreign-fill cut. R204 is running under the existing one confined host budget, with no native job or live/shared writes. Its physical checkpoint has zero copper and accepted IO3 mutual errors; full contact/reference/latest mutual results remain pending.

R204 completed independent HOST PASS, receipt DIC-In2-supported-independent-r204.json SHA25638d2950ac741ff6937942c8b71b94ab512dd35221e389bcb0019ed09025ba93d. Geometry, every affected surviving layer-contact group, direct original fill contact, all prior J1 source layer keys, all current198b/r06/r07 rerouted native pad groups, every new full-body source-supported own scope and exact latest R214/R201/C1022 mutual checks have zero errors/losses. All three real paired returns have .089375–.097634mm2 finite annular interior on both In1/In4 after all five holes. The original CMD signal via stays exactly .6/.3 at128.549999/100.55 with all original six annuli and an unchanged .575mm own radius. Neither new own disk can claim previously absent reference copper.

The inherited physical_reference_losses_r2 reports only areas above1e-9mm2; its source/result remain preserved separately. R208 derives an otherwise identical complete-delta checker that reports EVERY nonempty intersection, without an area threshold or changed reference geometry. R210 receipt DIC-zero-unwaived-reference-r210.json SHA2563b86a7f1e276004be1a00e66449f6844533e7c635bd9c9ad1278a47c13068778 binds all four exact reference delta WKB hashes to R204's independently rebuilt actual source references. All54,924 retained eligible F/B/In2/In3 full bodies have zero nonempty loss. No tiny loss or boundary-touch waiver is used.

The exact sparse packet DIC-native-owned-ledger-r212/receipt.json SHA2569e63e595cbea54c90b4e340fbb68cfd5e920a25dee0ae4c40a94b6e555bfb543 freezes four exact original eedf remove chunks, twenty .2mm segment add chunks and five .5/.2 ordinary via add chunks. It includes R198/R204/R210 source/model/helper/reference/real-return/latest mutual bindings, the full actual before-supported/native own-hole ledgers, and explicit zero FP/zone/project/rule/retag changes. Prepared R206 remains unrun. This packet is handed to root for exact minimal composition and native source/raw/IU/all-six flash/refill/continuity/DRC/current/SI gates; those gates and adoption remain OPEN. No board/live/source/project is written by this agent.

R216 minimally composes ONE actual R214 plus exact C1022 R222 and DIC R212. Receipt ad67b39a25d83cf9b0c348e859f2990ce34d2239e41755a841fc3a4bdb0bb11c binds model de159ff0d9abb17eeb787dc7a078e74ea4a2482d6d9cece29a303d8e9f04cf8a. It adds21 tracks/five vias and removes exactly four original segments. Every prior discrete/FP/pad/design-zone/rule/property and every generated physical/intended role/settings remains exact. Only four existing filled-layer records retreat: LOGIC_GND B/In1/In4 and IO3 In2. Full-file R87 c79354f60f6fba0e38cd5f3df774876c4fc541ede3a2f27109d1a236f9c448d3 and legacy R17031 ownership rows remain frozen; no unchecked rotation rows are regenerated.

R218 reconstructed sparse bytes/fills and passed237 true circle/cap/hole geometry checks, then stopped at an auditor scope assertion: four ordinary signal nets do not belong to the77 plane-bearing set. Its script, outputs and failure.json remain preserved. R220 extends only that net list to77 plane nets plus four signals. Receipt DIC-C1022-actual-R214-independent-full77-r220/receipt.json SHA256e298a6fbf0b7f7672a106240aef7fbb388bac8cc39a428cfeaa04a262e42fb81 is HOST incremental PASS: actual drill-subtracted/split-piece layer contacts across all81 nets, all changed direct old layer-fill contacts, seven prior source-bank layer keys, three source-ground ZERO retained full-body references including In2/all PDN tracks, every new body/strong own scope, three actual paired returns, recovered DIC/C1022 targets and selected current/r06/r07 native pad groups all have zero new losses/errors. Unchanged-net reuse requires exact records and every new drill disjointness; it does not presume source connectivity.

The explicit BEFORE fill-guard ledger contains10,340 inherited extra-.025mm planner-margin deficits, but zero gaps below their exact declared native local/domain requirement. They are separate historical guard facts, not new errors or waived native qualification. Full original ROOT42 retention/raw reference/power/current/native failures stay OPEN/FAIL. Packet DIC-C1022-one-R214-joint-native-integration-delta-r222/receipt.json SHA256bbf14c6887829a93d50fbf285aad61353dbc60eb30eaad1485036d410c89be0f freezes the single exact integration interface and all copied delta chunks/strong witness ledgers. Both production host-retention/source-completion flags remain false, and adoption is unauthorized; root owns the actual native diagnostic stage.

Parent next supplied CORE R100 source-positive model db01ba8f89c614c72b19688ec6479c96e8524259f1968eaa2dd3f2caeef49635, based on exact R83 remove-only masks onto R214. R224 now independently checks it against original R214, including all104 PDN power candidates/all130 mandatory signal obligations, true all-six cap/pad/ordinary-hole/current-peer geometry, actual drilled split contact/direct-fill/source layer keys, strict ZERO three-ground-bank reference and full new CORE body coverage. R100 is not silently overlaid onto the DIC/C1022 head; a sparse rebase follows only after independent evidence. Original ROOT42/all-current/all-native qualifications remain OPEN/FAIL. R224's initial true geometry has109 checks/zero errors and CORE contact groups zero losses; final source/reference/contact gates remain running.

R224 completed STRICT FAIL, receipt636f33444f4f9595cb00a7685740f4700015993d616e36d112eb0ce8825c2798. All109 true geometry checks,77 actual drilled/split contact nets, changed direct original layer-fill contacts and nine prior source-bank layer keys pass with zero losses/errors. The strict three-bank full-body reference comparison reports31 nonempty retained-body losses. The new CORE In2 body's actual J1/In1 gap is56.518908227831mm2. Those failures remain unwaived; no DIC rebase, native job or adoption follows.

R226's initial diagnostic failed an exact loss-area equality because its local query did not reproduce R224's selected delta-piece kernel; script/failure remain preserved. R228 reproduces all three complete source-delta WKB hashes and every exact original local loss kernel. Receipt501c29a15bb2ef51228878ab51a602ddcdb8abb0fc8d00ba01c348bf1e63f5a6 classifies one literal R205104 PDN candidate, eight literal130 mandatory bodies and22 outside both frozen sets, which remain mandatory. The gaps are at least4.80796mm from new CORE copper and6.99117mm from the new ports; no actual retained own-aperture nomination passes the exact barrel/source-return nomination criteria. The new CORE gap has nine parts, and55.118248924974mm2 lies outside both exact new .525mm own disks. No transition-only disk can qualify that body. Actual source-node/sense evidence and exact gap parts are saved, with no net-wide PDN exclusion or installed waiver.

Parent R109 conservatively retains exact already projected native filled copper from R214 and subtracts only the new CORE pair/feed, without reclaimed native copper. R230's independent comparison stopped before geometry on a metadata assertion that also compared the named CORE_R100/CORE_R109 provenance key. Its script/launcher/failure.json remain unchanged. Separate R232 binds the two provenance rows' exact values and every other metadata/native/discrete/generated role byte, then independently reruns true all-six geometry,77 drilled/split contact nets, direct layer-fill contacts, nine source banks and strict ZERO references. R109's new CORE body/current/native/DC loop and original ROOT42 qualification stay explicit OPEN/FAIL; this audit does not invent a general DC reference exemption.

R232 receipt313ff6a4fad8cc0fe4c0ebfd214638a57ec97f9a776a62adfcb85b975659edb9 completes STRICT FAIL with109 true geometry checks/zero errors,77 actual drilled/split layer-contact nets/zero losses, zero direct original layer-fill losses and zero prior source keys across nine banks. The31 retained-body reference losses reduce to one exact FA_SHDN_CONTACT F body b1ba0f9c, area2.099591471688232e-8mm2. The new CORE body retains the56.518908227831mm2 raw J1/In1 gap. Wider R112's independent R234 receiptbf1431fb2cf38d66e76727b2c9093b335ab49b22f9012065d9bffe9e6703b254 similarly has137 true geometry checks/zero errors and all contact/source/direct-layer losses zero, but the identical one-body strict loss remains and its full new CORE raw gap is93.041959291718mm2. Both full-body/DC/native qualifications remain OPEN/FAIL; DIC is not rebased onto either.

R236 exact local causal receipt0cfd59436eb39c4611cfe436ce2ea1506642a6c7e7ba41a6022abbf87b677124 independently reproduces both local gap kernels and saves immutable before/current boundary WKBs. The sole source contributor is the owned FAG In1 role bde7a0cf. Both its physical and intended role differences are empty at the exact loss window, while reconstructed filled records retreat. Original native filled copper/definitions in that window remain unchanged; the gap is96–97mm from CORE and98.0179mm from its ports. This identifies generated filled-record reconstruction at an unchanged local role as the remaining provenance defect. It does not waive the strict failure. Root was asked to derive a separate successor preserving exact R214 already-projected owned fill records minus only actual withdrawals/new cuts, analogously to the native immutable treatment, while retaining actual source/contact/current/reference/native obligations.

Root R121/R124 reconstruction failures remain preserved. This agent owns the fresh exact R112 immutable owned-fill continuation. R242 caught a serialized geometry equality assertion before emitting a model; R244 exposes polygonal geometry separately from zero-width numeric residue, never crediting lines/points as Cu or contacts. R244 receipt efd811ac3fffa140a3ecc4a68000fcbe27432c71b35152fae8fc487c34c90371 rejects twelve extra-negative scope rows, with no model emission. Every existing owned filled union already has literal zero gained Cu, and the exact local b1ba boundary is retained. The rejected raw rows remain explicit.

Root explicitly authorized local remove-only reserves on actual filled Cu around literal gains, with no physical/intended q or native-coordinate changes and complete requalification. R246 receipt fd437ea4e5a9139eb4698598ba20f715bf357e841ba257f4f33dd7c1e76b7e82 freezes constructor model32b60c225aa42347e3739c41d297c0f6047ee87978b42270958678fc6b51e685. Every old owned filled union is literally a subset of its exact R214 union;151 unaffected record arrays stay exact. Seven explicit100-nm local reserve steps in six zones remove .001516584397mm2, with every raw gain, cutter and actual additional negative delta WKB bound. All g/h/b/q physical/intended/settings and actual native/new CORE fill records remain exact R112. b1ba's original local boundary is preserved.

R248 independently finishes all calculations, then its final receipt dictionary hits a variable-shadow TypeError. All outputs remain preserved, and R249 closes their frozen hashes without repeating the job in receipt-r2.json SHA4aa3bc293e58e83759838c12d9e3866950e6d5a074e44ef0b61b24ad44d32309. All77 actual drilled/split contacts, direct original layer-fill contacts, nine source-bank keys and all three STRICT ZERO retained signal/PDN references pass with zero losses. Two real actual-fill clearance errors remain: new CORE In2 b045 to old FAG In2 e2fe gaps .547257258/.563181034mm versus .625mm. The raw new CORE full-body J1 gap93.041959292mm2 stays OPEN/FAIL. No native, DIC rebase or adoption follows.

R250 therefore adds every exact new CORE body/ordinary barrel/drill cut to each affected immutable original owned FILLED polygon, in addition to actual role withdrawals and bound local negative reserves. It preserves exact R112 g/h/b/q and every actual native/new CORE filled record. The prepared/running constructor emits complete primitive/cutter authority and strict no-gain evidence; all source/direct/reference/current/native gates must independently bind its resulting model. Root's separate R122 intended-own-hole-only native correction is deliberately absent.

Queued supervisor PG scope binds peer R245/R246 poses, never rejected older pose overlays. Local R240 receipt a80abb205c8dad0e0b106a465e5538df4298c34774db126f2d9c1ba8d47cfa8c verifies the desired .5/.2 return332.507772/145.5375 with .16491903mm2 actual before J1-rooted annular interior on each In1/In4 and zero discrete all-six/SMD/drill/pitch errors. One actual IO3 In2 plane cut remains an explicit obligation. Sixteen rectangular In3 replacements of original locked PG342f have zero new J1/In4 body gaps but hit retained GND via f6408df8 at333.221866/146.580047. A diagonal corridor is nominated for the next exact screen; no route, pose, source or native acceptance has occurred.

R250 constructor receipt9de23083359b26f15e8d7b9f8e3692e940fec1ed1e8feb54015318eb45013a96 freezes model96d3f55a95b770a2a7f46e3b25274723946fe1572c6c82d81b7355b660360868. Independent R252 receipt db5c57276f9dfc385b8a195daa178d36af296a3be24b226370c936d2442df560 passes137 true geometry checks, all77 actual drilled/split old contacts, all changed direct fill contacts, nine prior source-bank keys and all three STRICT ZERO retained signal/PDN references. The new CORE whole-body J1/In1 gap93.04195929171794mm2 remains the sole overall reference failure; DC mesh, current, fault, native and ROOT42 gates remain FAIL/OPEN. No inherited production/adoption flags changed.

Parent authorizes exploratory diagnostic signal/ground improvements on that exact current head with its failures explicitly retained. R254 filled-only host packet receipt411c40f1b14a908500e06c1bb968d6e29f2a0b648fa555586b945439e47a351a binds nine actual filled-record replacements versus R112; all g/h/q physical/intended/native settings and actual native/new CORE records stay exact. R256 constructor receipt b404b213fac8c1242773c7e4ff61923bbd08d8d3ba51a608ba1d8fde50d4f8ea freezes exact R250 plus only21tracks/five ordinary vias/four original DIC track removals as model7b4c123a051f7b177c928b7a02c479776237c198989f3c1a24d722c29dd25573. Four local native fill cuts use per-original-record subtraction with literal no-gain assertions; every generated physical/intended role stays exact. No R216 whole model or R122 intended-hole correction is overlaid. R258 fresh independent all81 contact/source/strict old-reference/new-body/current-peer proof is running; first237 true geometry checks have zero errors. Exact sparse bodies/holes were shared with SBC's independent T4/R7 diagnostic owner for mutual hard screening.

The R258 final strict new-body failure remains preserved. R262 corrects only the accidental extra100-nm DIC cutter guard, restoring the original frozen cutter WKB/radii; independent R264 passes all81 drilled/split contacts, direct contacts, nine source banks, all three ZERO old-reference banks, every new body and paired return, and237 true geometry checks. Its exact sparse R260 packet preserves21 tracks/five vias/four original deletes and the inherited93.041959mm2 CORE body failure. Final field R364 minimally adds REG/U25 and corrected SBC273 operations, then two new-only REG planner-margin withdrawals. Exact mixed R366 restoration preserves ED/D8 literal physical grid0 and every other/intended role1nm. Root R155 adds only the original187 own-drill intended void; every physical q, h and actual filled record remains exactly R364.

R368 final field audit reports zero prior contact/direct/nine-source losses and zero native-effective Cu violations in1271 checks, but28 STRICT ZERO old-reference losses and one new R7 ground-body gap .03141874628400019mm2. Those failures, extra planner failures, CORE93.041959mm2 and ROOT42/current/native qualifications remain explicit FAIL/OPEN. R290 binds every original discrete inventory difference with zero unbound originals; R296 completes twelve missing native profiles through exact owner metadata only. Separate known-failure emitter R298 and manifest R304 are distinct from the untouched ordinary PASS emitter R286. Detached R306 emits only the actual R15548q as200 native chunks,276 new tracks,99 vias and41 authorized original track deletions. Independent lexical/IU/current-role serialization R310 passes, including all three required frozen DIC locked attributes. R312 integration receipt SHA32d4c1109e92e605bf84b8e1c278a1908d198afdcf3468a1c76ce9c91e684c45 and R157-compatible gate SHAe78857cfed0c6c05b4e802f519fff6f2697d9854b273ce74d0daa20a0219ff12 bind815 files and every raw old/new reference failure. This is a native diagnostic packet only; no board/source/project write, native job, adoption or production qualification was performed by this agent. Root owns native staging/measurement. U10003 R153 is deliberately absent from this first head.

The saved operator decision was directly re-read at `Z:/pcb-runs/OPERATOR-DECISIONS-2026-10-03.md:226`: outside the exact U1001/J15001/J15002 D4 courtyards, signal-return spacing is 0.90–1.0 mm. Its whole-file SHA256 is 392e2155400e156d180ac5a786b2d7e4a41c2dcc945bfc7a8de9b9e21b02dde5. The frozen DIC constructor's three designated .82 mm pairs fail this policy; older constructor/audit/native packets remain immutable diagnostic evidence. R354 tests every existing same-source LOGIC_GND via on exact R155 and finds no existing compliant .90–1.0 mm return for those three signal ports. R366 nominates two small moves to .925 mm with unchanged signal copper; R396's guarded continuous local mask for the third return is empty before reference screening. Neither result authorizes altered copper or relaxes the policy, and the exact full-window boundary still needs a bounded coupled constructor.

Q0 recovery reuses the current R155 geometry and the exact original R10016.1/U10004.1 pad identities. R10016 is a grounded 10k pulldown. The proposed -.5/-.5 mm translation removes its old pad geometry before source connectivity is tested, avoiding phantom old-pad credit. R388 nominates all three Q0 signal legs F/In3/F and a real F ground connection for the translated pulldown, while its original FLT and SENSE wall detours remain incomplete. Every original GATE chunk remains exact. R382 independently passes the four Q0/FLT ordinary via sites using every SMD/drilled aperture, full six-layer copper, .8 mm ordinary pitch and native reserve predicates.

R394 proves the two old wall detours are physically disconnected before reference constraints, so a ground-plane-only patch cannot solve them. Its receipt SHA256 is 61e8e565415317e957aa110262bdb6361ff1a3a0d652c2ebcb2067787cc2be6a. R400 nominates a real new FIELD_GND return at 228.754382/159.484519, .9499998775 mm from retained SENSE barrel 5a4b7757 at 228.96/160.412. Before-rooted In1/In4 cap gaps are zero; its receipt SHA256 is e865b8331b7b07e5b2c61d814667e54576c4722fb08d4008cc145a450945ba76. The final global source/clearance/native obligations remain OPEN.

R402 freezes exact original power-track and retained SENSE-via source chunks and every direct/interior contact. The .20 mm F power wall 7bb3c794 has exactly two original endpoint contacts and no interior branch. Its native source token is `/motherboard_do{slash}DOA_FIELD_3V3`. Retained SENSE barrel 5a4b7757 has actual original F/B annuli only; adding a natural In3 or In2 annulus has zero local foreign-copper conflicts, and no unused-layer flags or existing required masks are changed. R402 receipt SHA256 is 21c9b49899c994c085cbbc02766b4fc955fbeff0be8fde015b75c47de813cce7, supplemental receipt SHA256 is 2d2482fa255f36abea338bd92386d70ddae6917adc15cf9d1e38fa04ef233495. R404 now constructs a bounded three-original-track recipe: the two signal walls plus this one power wall, preserving all other original copper and every frozen current power proposal. It is a constructor nomination, not acceptance or board/native output.

R372 independently classifies the field record136 zero-area line witness with exact Fraction.from_float orientations, winding, boundary intersections and every open segment interval. Several after-boundary intervals are literally outside both A and R while inside the immutable parent P. The strict failure is real under that primitive membership test and remains retained; no precision change, area waiver or model mutation is used. Certificate receipt SHA256 is 631eb64ffb70a5744252236a4ee5c69056b6d51e6777bf3998a84c01465206f0. Root owns the separate record162 witness classification.

Q0's larger R426 power/FLT/SENSE recovery was rejected by the independent R442 comparison: the power bypass reached the already rooted endpoint while three native power source keys remained detached, and two genuine old FLT reference losses remained. The corrected right-endpoint R440/R444/R446/R448 bounded constructors emitted no complete legal power route. These receipts and deliberately stopped own-host evidence remain preserved. R450/R460 therefore retained all original power and FLT copper and replaced only two GATE F chunks and two SENSE B chunks. The earlier resistor pose detached twenty-one actual FG via/track layer keys. R474 moved R10016 by exactly -.4/-.5 mm, restoring its actual native ground contact without a new ground hole or assumed old-pad credit. The frozen R476 packet is twenty-two .20 mm tracks, three ordinary .5/.2 vias, four exact eedf track removals and one exact footprint translation. The Q0 F/In3/F and SENSE F/In2/F transports retain the saved three-layer-leg limit. Two Q0 returns satisfy the saved .90–1.0 mm window. The old SENSE barrels retain original F/B annuli and unused-layer flags; natural new In2 annuli require actual native attestation.

R488 replays only four owned FG In1/In2 physical/intended negative roles, with every literal gain preserved and explicit local 100-nm negative reserves. Its role boundaries remain canonical integer nm; all unrelated mixed-precision roles and every original native outline remain exact. R492's wrapper accidentally measured R478; its output and R494 finite-path result are explicitly earlier-array evidence, not final R488 qualification. The directly bound standalone R496 auditor fixes that provenance error without editing old receipts. R498/R500 then expose actual-filled strips outside the newly withdrawn roles. R502 retains two remaining literal zero-area exterior failures and emits no model. R504 removes only those exact local actual-filled exterior families, preserving all R488 g/h/b/q and requiring literal zero gained or reclaimed Cu. No original native fill is globally snapped or reconstructed.

Final R504 model SHA256 f738f9a4891664324f3e09511276036e77d94e12471713762d7998121d10593a has separate independent scopes: R506 receipt 8eeddecee7280d2e881282eca828c3e2a209a82c89601e38bfc61fd82c88f38a passes all81 original relationships, ten prior source banks, all twenty-one FG keys, the r06 Q0 pad join,148 true geometry checks and strict ZERO retained FG reference losses. R508 receipt88f7635a0b88320f73f10c8555fc41650fa266471817b650f20a55534e70d291 passes six owned-role native/planner clearances,320 literal direct old layer-fill contacts and literal current-fill exterior alignment. R510 receipt b59d89c6495620a4276ec85945c5cf20aa8b1e20bf85e0750d54d0bf8c0f7976 binds two finite .20 mm actual J3-rooted In1 paths around exact .375 mm old unflashed-reference apertures. That is a scoped SAME_PLANE geometric proposal; the inherited blanket checker FAIL and native/SI qualification remain separate. No universal .20 mm electrical limit or enlarged own disk is introduced.

R512 receipt65ee5c0b18159006984e86f61fa7edea7c3c9a47aef770a82d5c694eee969e94 freezes the exact sparse review recipe e807261a930a03002a681fcc4d3c3f522841796f8f091eb3cb9f646c53ba9ba8 and168 bound files. It explicitly restores locked=yes on only the two GATE replacement native chunks, retaining identical geometry/raw nets/UUIDs and all R476 bytes. Two exact original B-terminal body gaps remain unchanged BEFORE gaps. The moved R10016 whole-pad In1-reference gaps, .2449811552 and .4119246408 mm2, remain OPEN. Q0 is not complete, no native run is authorized by this packet, no source/live board is written and no production/adoption flag changes.

R514's no-hole reference extension identifies only new protected FA In1 role7ef3cb5e as the physical barrier beneath both moved pads. R516 freezes a concrete J3-connected FG In1 extension1.666336mm2 together with the exact required owned FA recess; its source-only trial is explicitly not a legal joint power composition. R518 minimally composes that one positive FG zone637c65c4 with only7ef physical/intended negative roles and local current-filled negative alignment. Model6a042063ca93b82533b30dcefed2366b5f80efaab6e5e06e1c862314d3193d50 and sparse packetcbe45e63e980bf95da3b3310019c79cbeb2d931262315a440c9f2a7c3dd70069 preserve all original Cu/holes/FPs/native outlines and every unrelated q/fill. The new owner profile is explicit .25 clearance/.15 minimum/FULL_SOLID/priority125/island1/thermal.15/.3. Both exact full pad bodies are covered in nomination, with no new holes. Full independent source/contact/reference/direct clearance, protected-FA signed-current/core-path, native and SI gates remain OPEN until their separate receipts complete; no current allocation is reduced.

R520 independently preserves all81 old relationships and ten source banks, with strict ZERO old-reference losses and both moved-SMD full-body gaps empty in the exact J3-connected host model. R522 keeps two additional planner-margin failures: the new FG plane to7ef physical/actual fill gap .274998176612mm versus .275mm, while the native .25mm requirement passes. R526 explicitly adds100nm outward to only the NEW FA negative cutter and repeats canonical/literal-negative role and current-filled alignment. R528 receipt0fe1fbdb213915cadf704785bccd755c13d8048745b07bc5f8e60ff4d0b69721 passes all81 contacts/ten prior source banks/148 discrete checks/Q0 join/two returns/ZERO old refs and both full SMD bodies. R530 receipte4043387357e36edaf144c7f19059e84a35cea8cfed2fecae1e18b8be7199672 passes all331 literal direct layer-fill contacts, eight owned/new-plane native and extra-margin checks and literal actual-fill alignment. R532 receipt127b6a8fe161e8c2fd8c0de8e594a3755a95f8f02d684b3adbaf58677775a081 rebinds both finite SAME_PLANE witnesses to the final actual host source-bank arrays.

Final shielding model97e6f5193c9102102ec86a50c7d142def2d9c498495c8acdbd7202f466f84e14 and sparse positive-FG/negative-FA packet1072a12227657bac90d100c243e3ae57085abed0a2123e32332ff40763a9f3f9 are bound by R536 supplement85d262e256dcd04e637b73492e5fe7ec063b6590757962f1a2d0395546857f63, receiptfe9ab203a4f6e683b0ece796a5b813d91dad5f111e4c1340f4697991d8a3ade6 and255 frozen files. This extends exact R512 without rewriting its bytes or original failures. Both new SMD reference gaps are closed only in the precise projected host scope. Protected FA full signed current/core/drop/fault/thermal, current native original masks/source/pose/all-baseline refill/DRC and SI remain OPEN. Root's independent R157 actual22 original-via mask failures are not qualified by this host result. No native job, production flag or live/adopted board change occurs; Q0 completion remains false pending those gates. Late field/monitor constituents must receive sparse exact mask/positive-object replay with fresh full joint checks, never old whole-role or filled-array overlays.

R546 proves the original native DIC_IOL1_CS_BUFFER net has no barrel and two isolated F-pad components; all current thirteen trial entities are unaccepted new items. R548 preserves a bounded wider NEW-only target search with six reachable signal sites and no compliant return. R550 then nominates a minimal two-track G0FAULT reroute while preserving three actual outside contacts; its initial target reference fails in the retired NEW55ab cache void. R552 restores only fragments of three exact pre-DIC original source records inside the frozen recipe-owned retired55ab cutter, retaining every current record array as an exact prefix and every later Q0/FA/CORE/field cutter. It does not borrow copper from neighboring ground or overlay an older model. The immutable source replay receipt is0fb06aad596ba3efad377852b8ee38ddd26f95530a629434ceb443254e440e4e.

R554/R556 construct the concrete policy-compliant sparse successor: two original locked .20F G0FAULT tracks become two locked .20F tracks, eight unaccepted DIC target/transport tracks are replaced by eight .20F/In2 tracks, and only three unaccepted ordinary .5/.2 via poses change. All three signal/return distances are .925mm within the saved .90–1.0mm window; the signal retains three layer legs. The original native CMD via, all original footprints/rules/headers, all49 generated zone objects and98 physical/intended role bytes/settings stay unchanged. Native filled copper is subtracted per original record only. Current model95d1636e90b8d11530cbc6ba461c60f7e68272e08d1e7cd4b5863bf0a43b46d5 is constructor evidence, never a whole-model integration overlay.

R562 independent receipt ae47a082e0813041706a153fcfc6fc1f2c4e2de101f55e8580be3c1a104cb776 passes all83 original relationship net scopes, direct contacts, ten prior source banks,165 true new copper/pad/hole/all-layer checks, strict complete-dimensional old-reference regressions, all ten new-track reference bodies and the original DIC pad join. It preserves six raw negative-scope Boolean failures. Separate R564 exact rational arrangement certificate561a7ecc4be07e2c45ad4461d1ba587e02ad4ea2ee434d0d859390b0ccdbc6a7 classifies every preserved witness edge endpoint/open interval and polygon adjacent face against exact individual before/after/cutter/reserve primitives; zero literal points are outside the declared scope. This changes no geometry, precision, source, area threshold or old receipt, and does not clear unrelated native/current failures.

R566 freezes exact current R157 retirement chunks for the two original locked G0FAULT tracks, eight owned NEW DIC tracks and three owned NEW via definitions, plus thirteen new chunks. Supplement1422c2032032dbd19427486795963924c7a1bdfe72d7a9c998ea3322986de04e and receipt5ba66ee3336209daf7cf430d7eda0a2db3b14be28b8b9221fd99b434b14d4464 bind154 files, the prior Q0R536 dependency and the exact R552 replay. All inherited CORE93/R36828/R7/ROOT42/planner failures and native/SI/current/minimum-feature obligations remain explicit; no source board/project/native job or adoption is made. Root must replay only sparse exact operations into the later current head and repeat all native/source/contact/reference gates.

DI6 R568 confirms all nine saved track segments are hard-clear, but the old NEW signal port conflicts with the newer owned DOB In4 mesh f4863c44. Its old .836552mm return also fails the saved .90–1.0mm window. The incomplete hard-fill-only return sweep was deliberately stopped, with its process identity and partial evidence preserved. R570's continuous NEW-port search cannot reach the first saved In3 bend with full current reference; this is a bounded route diagnosis, not global impossibility. R574 therefore replans only NEW F/In3 transport to actual unchanged native DI6 barrel0ff4 at113.95/119.35. It saves a positive route before encountering a serializer API reader error. R576 closes that saved checkpoint without rerunning search: ten NEW .20mm segments and two ordinary .5/.2mm vias, zero original Cu changes, with source port117.966083/102.840819 and real return117.065348/102.819051 at .900998mm. The original583bf drill conflict remains withheld.

R578 exact current composition has modelcfe6fcbc3e13360edb56916f18a9a88038e84a8841e2e0f8e5faf93ea3399793 and receipta4e9c25f6f63bf24077a6deb13f3021f17137da2ae733fe560174ba08f083dfd. Only three current native filled families receive per-record normal NEW antipads; every owned physical/intended role and original design definition remains unchanged. R580 independently passes89 true geometry checks, all84 old net relationships/direct contacts/ten prior source banks and complete-dimensional old-reference regression with zero losses. Its final physical-plane alias lookup stops after all those frozen outputs are saved. R582 corrects only that reader and completes the new-body/pair/pad-join checks from the frozen caches, with no graph/native rerun. Receipt1c58cecfcd0b31a0ea7c536121005197c8f012c02479ea4d6f79d27c63305a58 passes the incremental HOST scopes and original four-pad r06 DI6 join, retaining the old matched-native210nm MOTION failure and final native/SI/current limits.

R586 binds DI6's unchanged existing target/return chunks and observed masks to the full all-net R157 export421ce21e and actual all-drill R663 J1 source arrays. Native target0ff4 actually flashes In3; actual returncb139 flashes and has finite source-connected In4 annular interior. Exact integer600000-diameter/250000-local-clearance/25000-guard units preserve the575000-IU aperture. Actual BEFORE target-body gaps have no other native-copper or no_zones clearance-mask contributions. Receipt4800d7dfb440aac7f2f23f38636b284127c1aa88a09cfaee1c81a167fa5e040b closes this BEFORE identity/scope only. No selected-fill cache or generic plane-name credit is used, and the later combined native AFTER remains mandatory.

R588 freezes a single minimal Q0R536+DICR566+DI6R578 replay manifest against exact native R157. Manifest1c7fba1adc371ab8b3a4ffc78249cc63c0a2aec113ade7d4e683d21bd2b2b815 and receipt17fc47a1dbc394729375025e6a2ea65096e3aecf583e28815d9f2556ae709371 bind62 exact operations (45 adds,12 removes,5 same-UUID replacements), one exact R10016 footprint translation and all sparse zone/source/current dependencies. The complete current-host versus native R157 copper diff has zero unbound differences. Root directed one future combined all-net refill after CORE repair; selected native trials are disallowed because they can blank foreign caches. The existing full native CLI is untouched, every inherited failed/open gate remains bound, and no native launch/adoption/manufacturing claim is made.

DI15 R590 rebinds the next original residual to actual R157/R287: isolated native F pads U13001.25 at119.136/89.0495 and U17005.9 at132.115/114.375, with zero native DI15 track/barrel ports. The saved161/3915/5e80 barrels belong to DI13 wall work and are never credited as DI15. Receipt1d428a86bb9114d7515edc0c3c054346e21aa5f61b9f927c0eac7b07e0501e55 freezes actual endpoint UUIDs/current components/native references. R592 is a fresh continuous NEW-only F/In2/F two-pair constructor on actual/current J1 In1 support, with original DI13/FAULT and current positive power held hard, .90–1.0mm pairs and maximum three layer legs. Its independent/native/source/current gates remain open until a concrete recipe and full proof exist.

R592 completed bounded incomplete (receipt ae9dcbb2bc934921cf28f38729c1a4979928d957c69946489e0adf74ab357292): five source-pair options and one target-pair option have legal F entries but no common referenced In2 transport. R594 reuses these exact cached regions without another site sweep; receipt e8051acba8a27d04db59bdf1bd29263e90c4474f7f5c761ccaca82b52b97dc15 proves every source option has a physical In2 path to the target while the actual native/current J1 In1 source components remain separated. The first eight-point path has2.12838604861436mm2 missing full-body reference. R596 therefore nominates only a new source-connected In1 extension against actual discrete copper, holes, no_zones, native local clearances and all current owned positive power held hard. Any original same-domain native-fill retreat is separately enumerated, with source/contact/reference/current/native gates still open.

The read-only R753 combined native diagnostic static review found exact sparse before-chunk/source-order/raw-net/profile binding and no copied fill caches. Its final manifest pins R588 to the exact frozen1c7fba1a hash. The shared negative-role helper proves literal no-gain and declared-local entire-removal scope, but its remote-vertex check alone does not establish edge-by-edge identity (computed remotee is unused). Raw private-halo/chained-scope failures are preserved and actual source/reference/current/native qualification remains open. No native launch or adoption authority was added.
