DeadlySIn777/Controller/reports/cnc3-rtl-implementation-20261001/shared-package-native-r04/inputs/README.md

# CNC3 structural RTL

This directory implements the first real CNC3 hardware layer, preserving the frozen IS-1 wire format: 96-byte CS_CMD and 176-byte CS_FB frames, big-endian fields and CRC-16/CCITT-FALSE. The original six-axis/two-encoder CNC1 RTL remains unchanged in `gateware/rtl`.

Implemented here:

- `cnc3_spi_transport.v`: dual active-low selects, mode-0/MSB-first SPI sampled in the core-clock domain, assertion-time feedback snapshot, streamed RX/TX CRC, exact-length rejection, eight-tick chip-select guards, four-tick high/low clock guards and overlap/handoff rejection. It also calculates the embedded MAINT frame's actual CRC-32C.
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
