DeadlySIn777/Controller/hardware/core_converter/preview.png

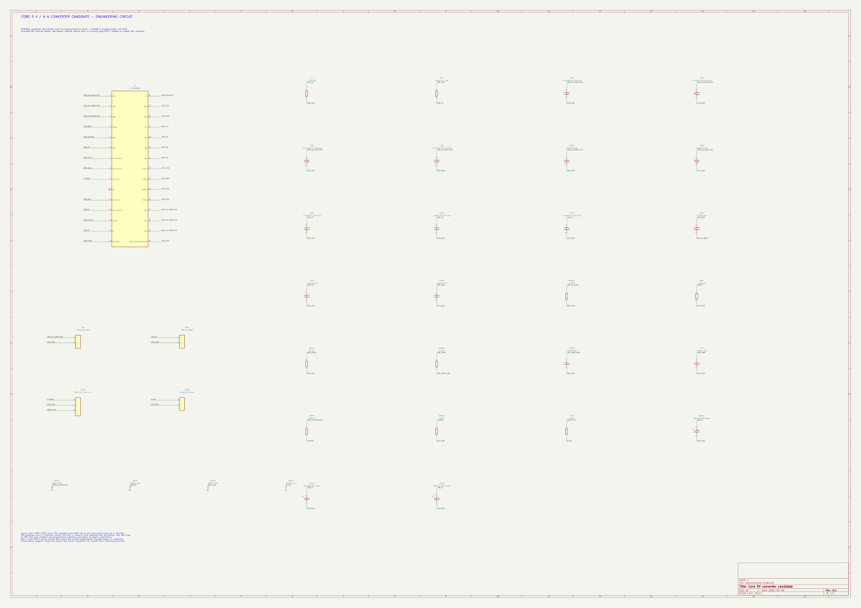
hardware/core_converter/preview.png
