DeadlySIn777/Controller/hardware/digital_inputs/pair-detail.png

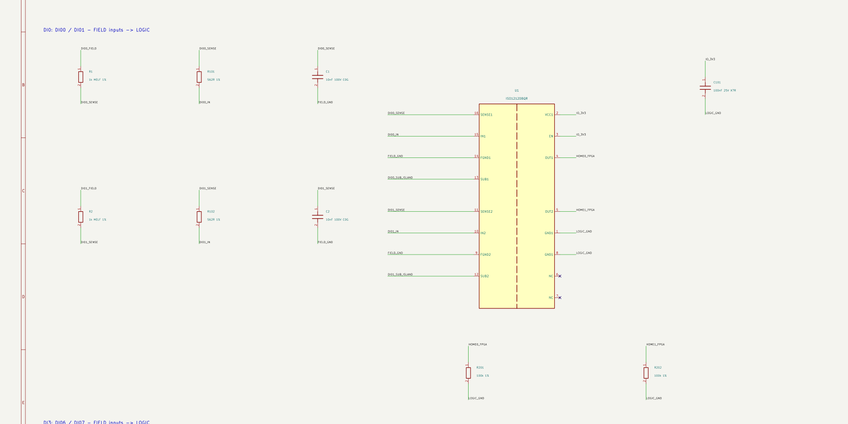
hardware/digital_inputs/pair-detail.png
