DeadlySIn777/Controller/hardware/encoder_power/preview.png

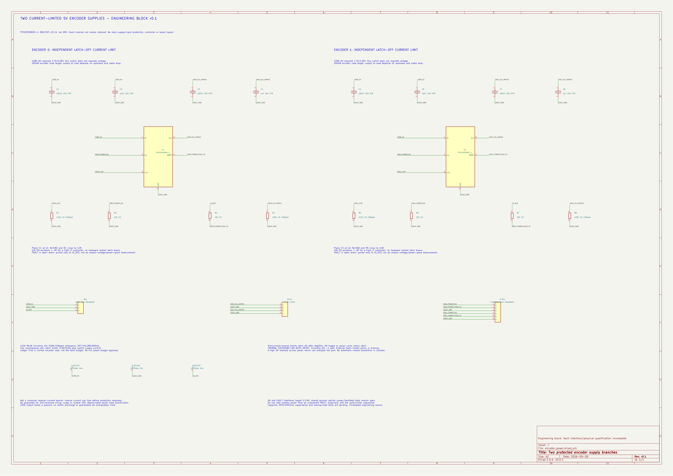
hardware/encoder_power/preview.png
