DeadlySIn777/Controller/hardware/field_power/field_power.png

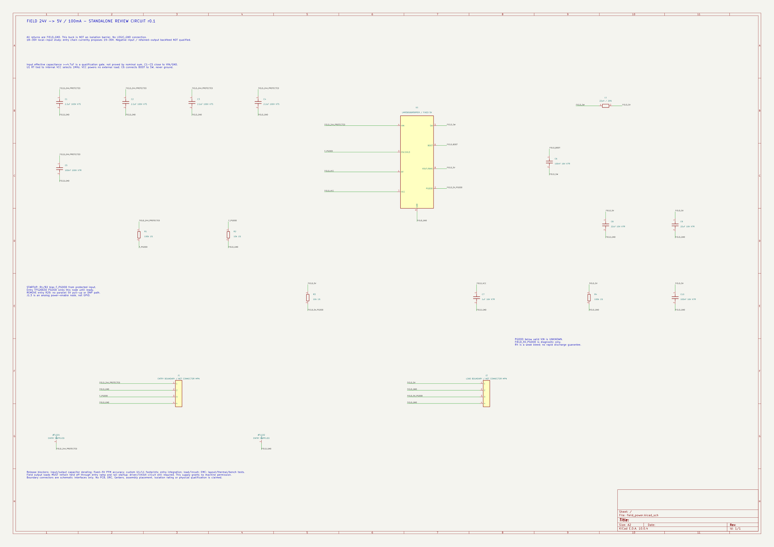
hardware/field_power/field_power.png
