DeadlySIn777/Controller/hardware/fpga_core/configuration-detail.png

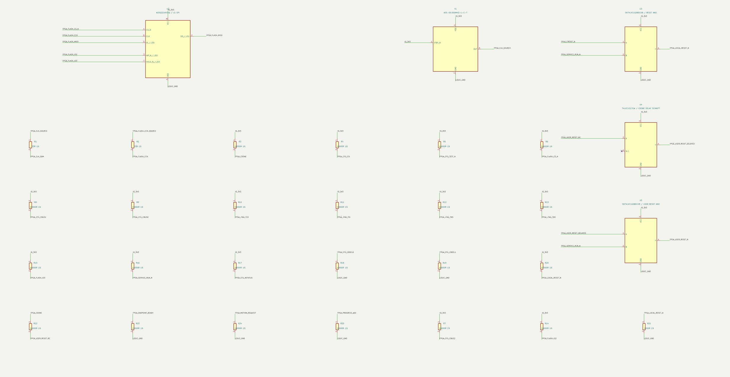
hardware/fpga_core/configuration-detail.png
