DeadlySIn777/Controller/hardware/fpga_core/supply-detail.png

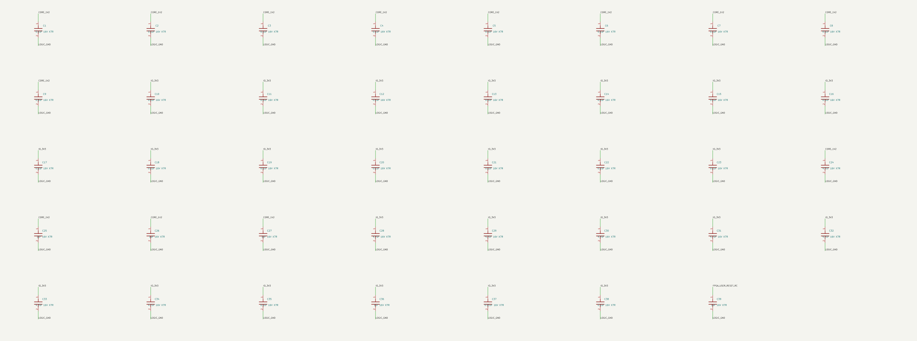
hardware/fpga_core/supply-detail.png
