DeadlySIn777/Controller/hardware/logic_power/detail.png

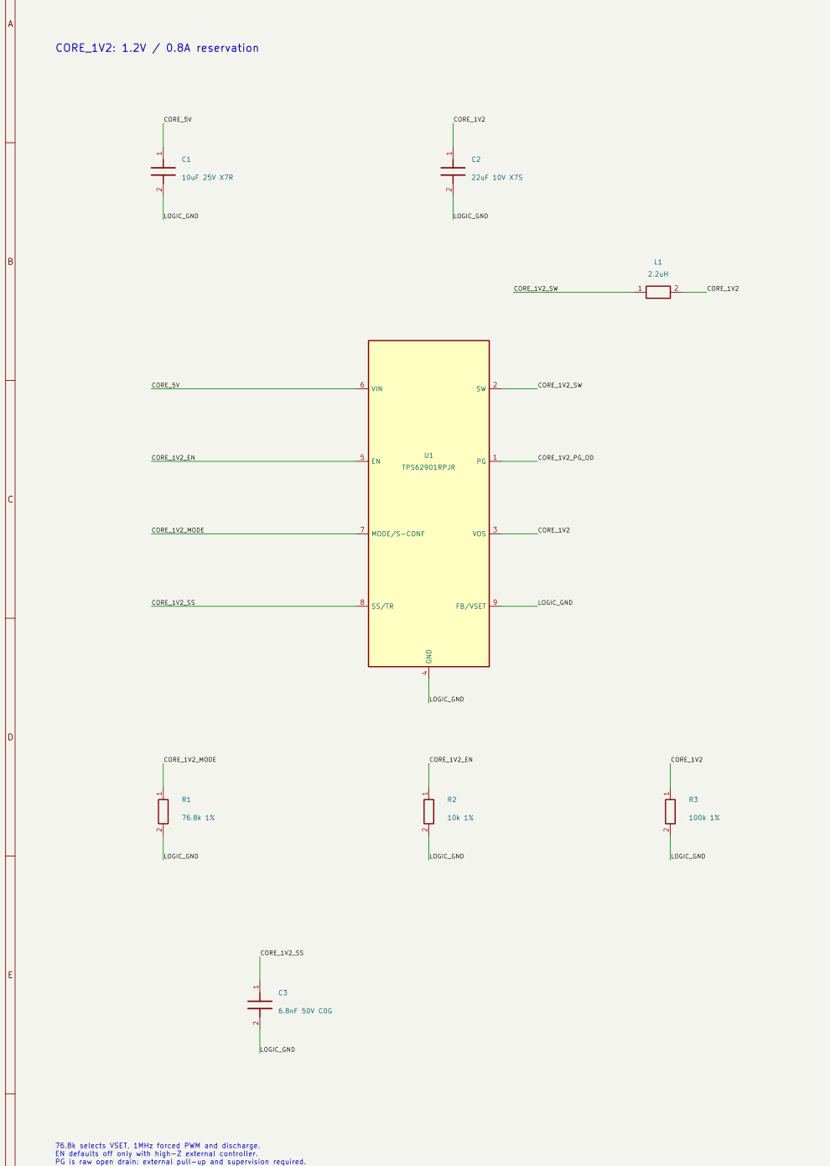
hardware/logic_power/detail.png
