DeadlySIn777/Controller/hardware/machine_permission/watchdog-detail.png

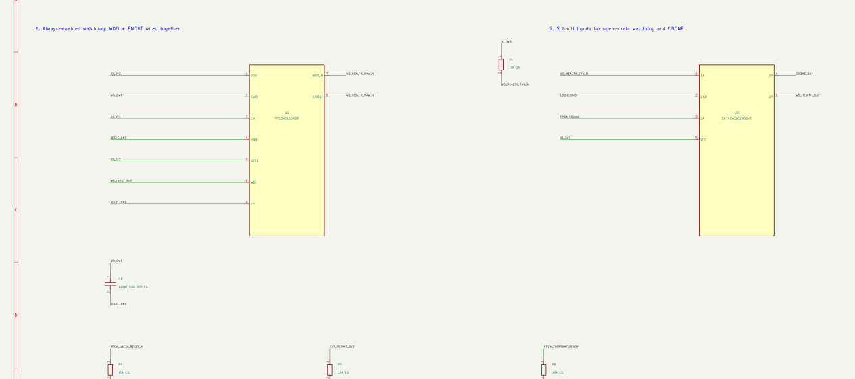
hardware/machine_permission/watchdog-detail.png
