DeadlySIn777/Controller/hardware/octopus_external_adapter/r0_1/header-drawing-preview.png

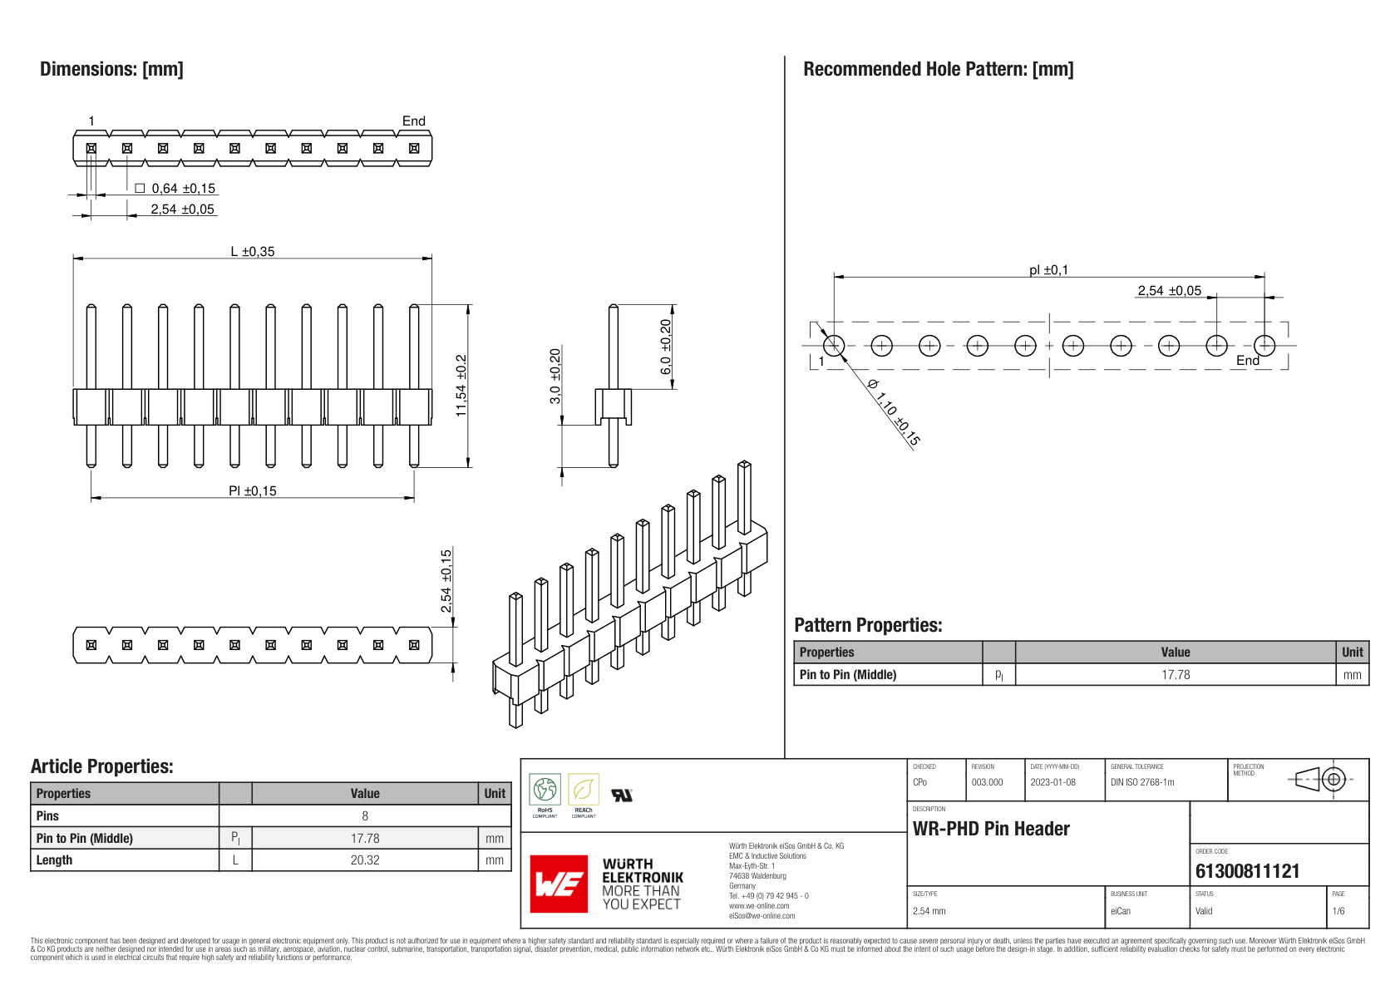
hardware/octopus_external_adapter/r0_1/header-drawing-preview.png
