DeadlySIn777/Controller/hardware/octopus_external_adapter/r0_1/schematic-preview.png

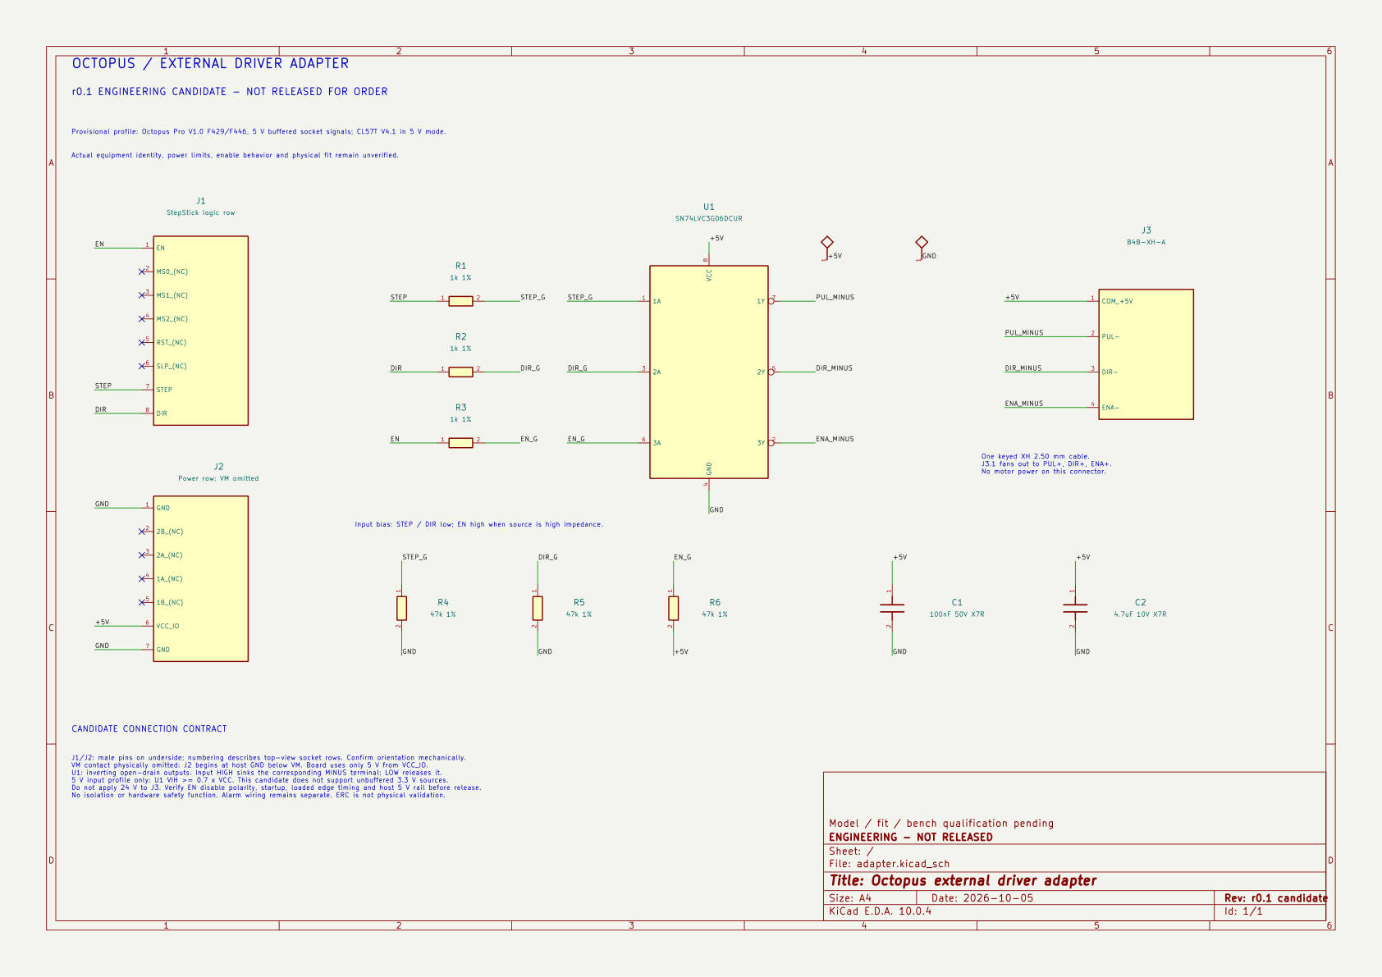
hardware/octopus_external_adapter/r0_1/schematic-preview.png
