DeadlySIn777/Controller/hardware/octopus_external_adapter/r0_2/references/EG1218-P040040.png

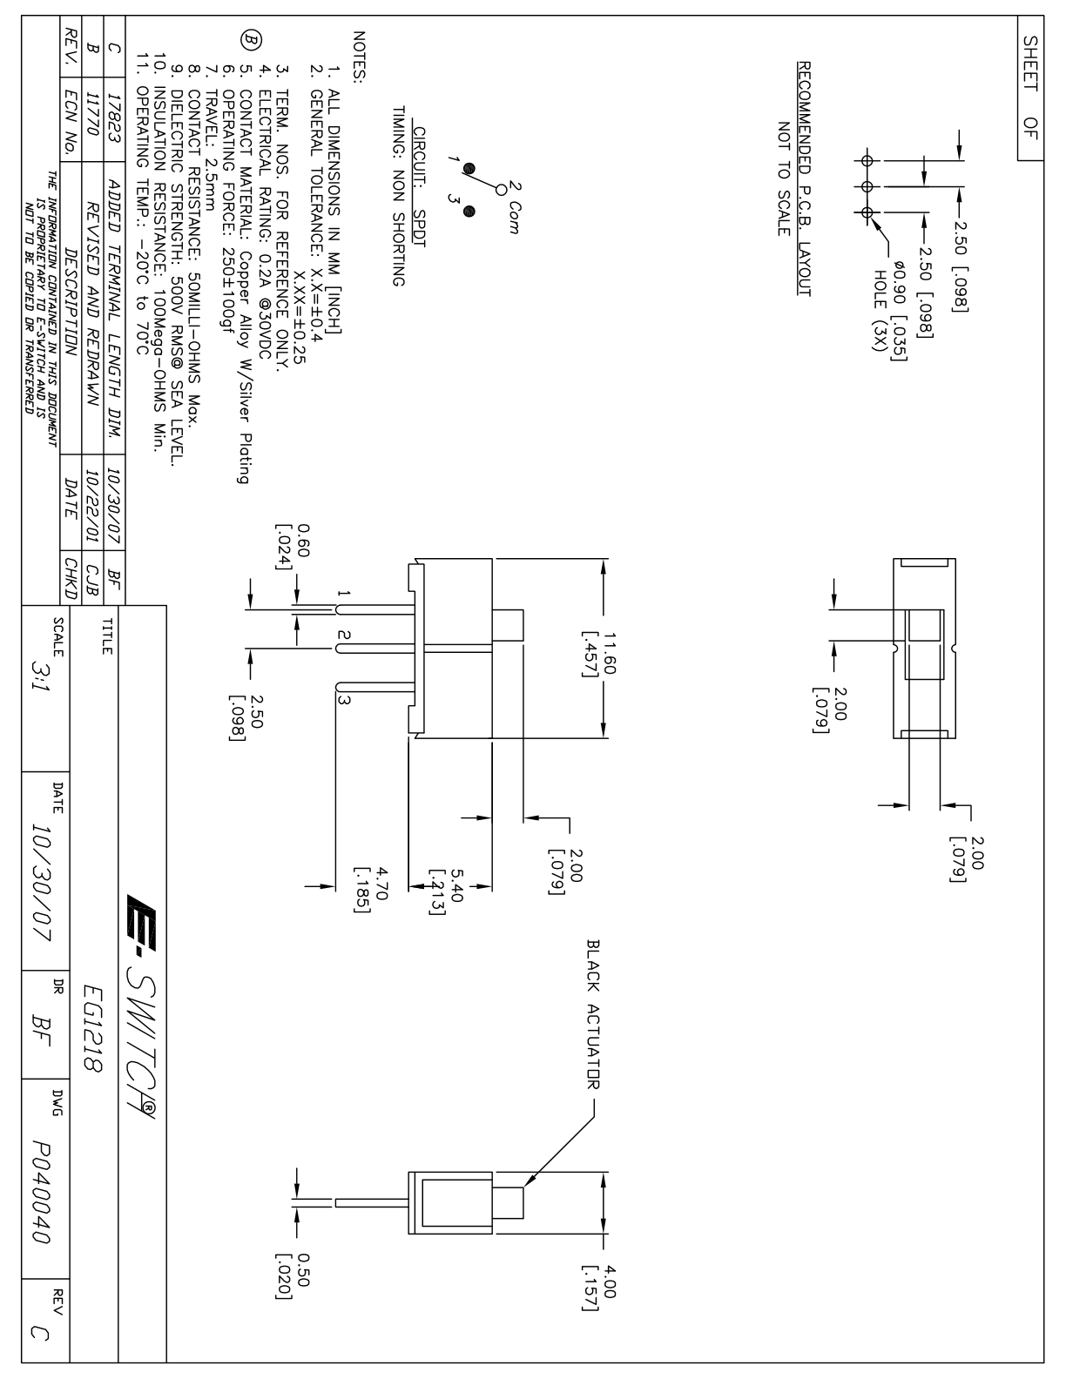
hardware/octopus_external_adapter/r0_2/references/EG1218-P040040.png
