DeadlySIn777/Controller/hardware/octopus_external_adapter/r0_3/evidence/schematic-overview.png

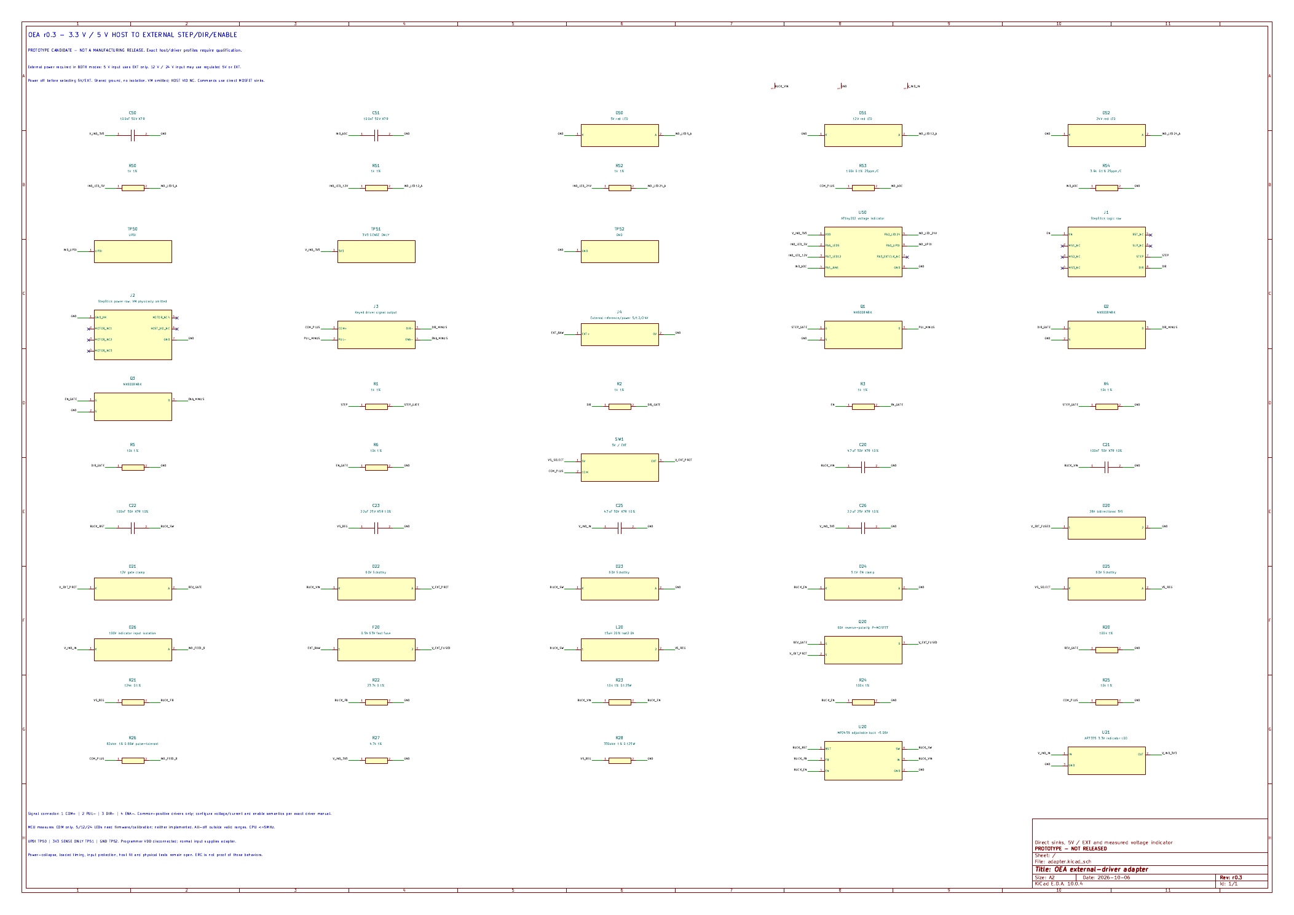
hardware/octopus_external_adapter/r0_3/evidence/schematic-overview.png
