DeadlySIn777/Controller/hardware/octopus_external_adapter/r0_3/evidence/schematic-power-detail.png

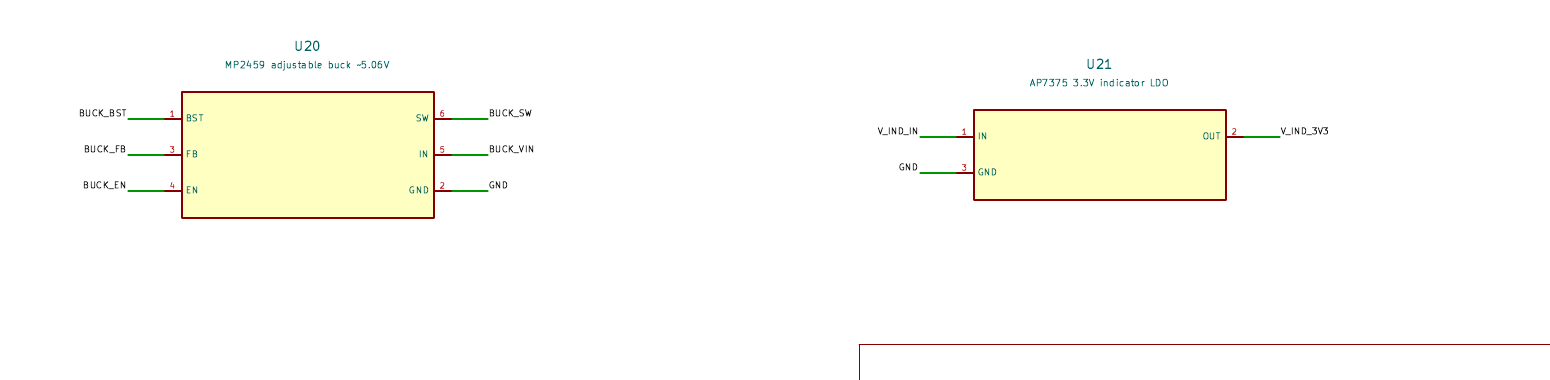
hardware/octopus_external_adapter/r0_3/evidence/schematic-power-detail.png
