DeadlySIn777/Controller/hardware/octopus_external_adapter/r0_3_planning/sources/mp2459-download-blocked.png

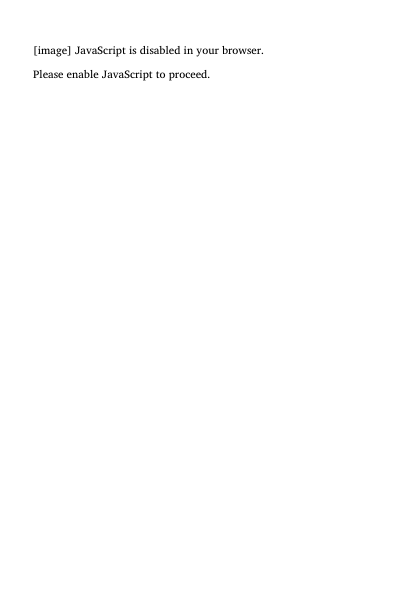
hardware/octopus_external_adapter/r0_3_planning/sources/mp2459-download-blocked.png
