DeadlySIn777/Controller/hardware/octopus_external_adapter/r0_3_planning/sources/srn5040.png

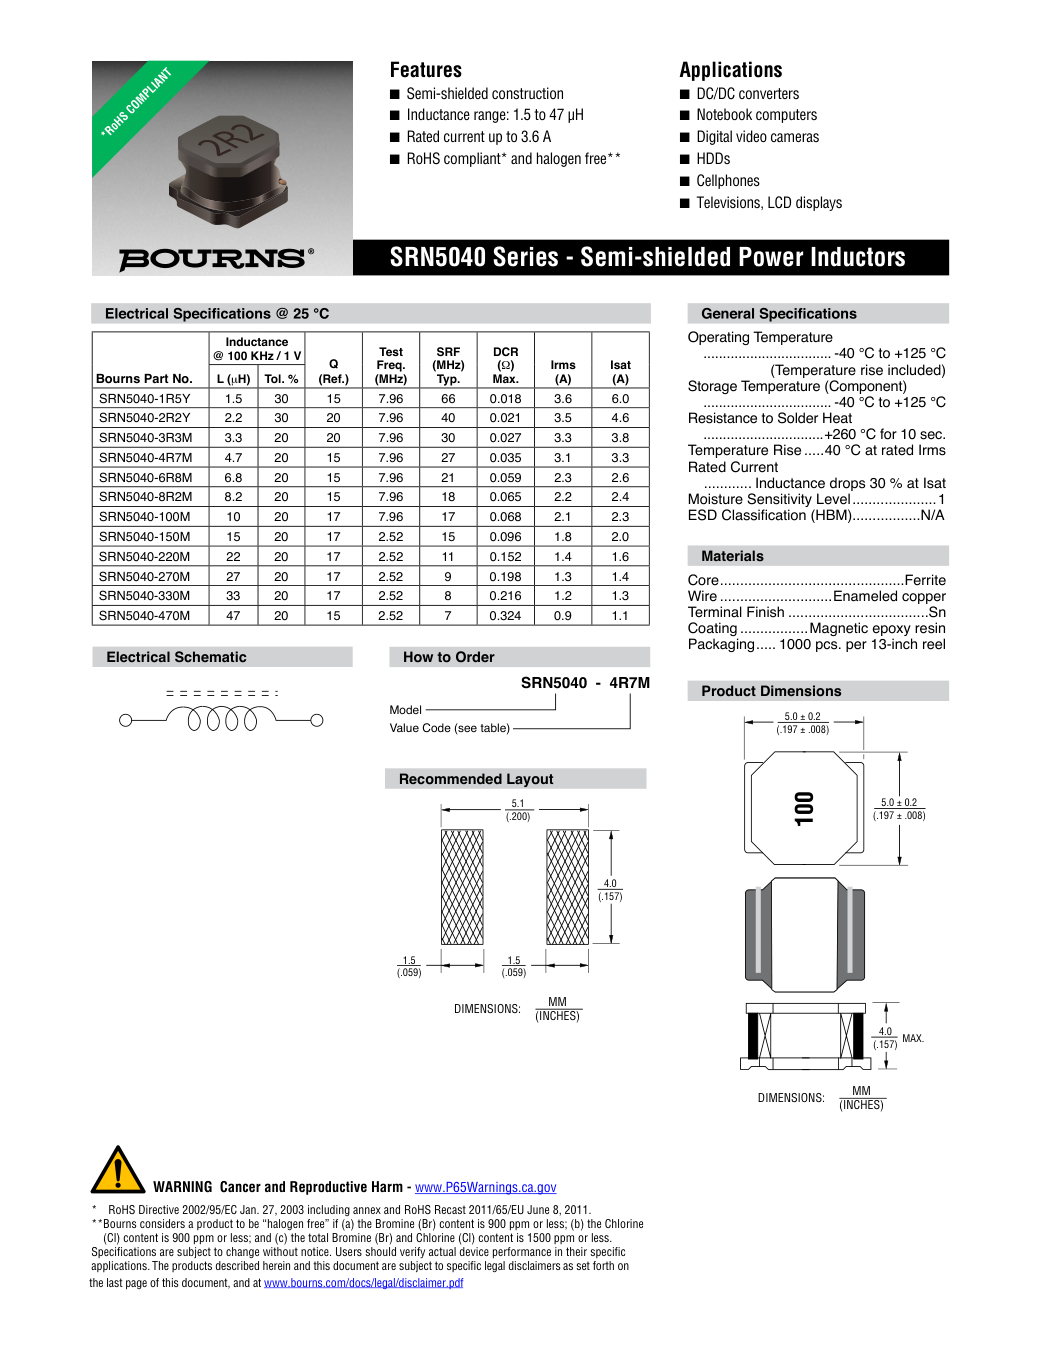
hardware/octopus_external_adapter/r0_3_planning/sources/srn5040.png
