DeadlySIn777/Controller/hardware/octopus_external_adapter/sales/20261006/pcbway-draft-confirmation-detail.jpg

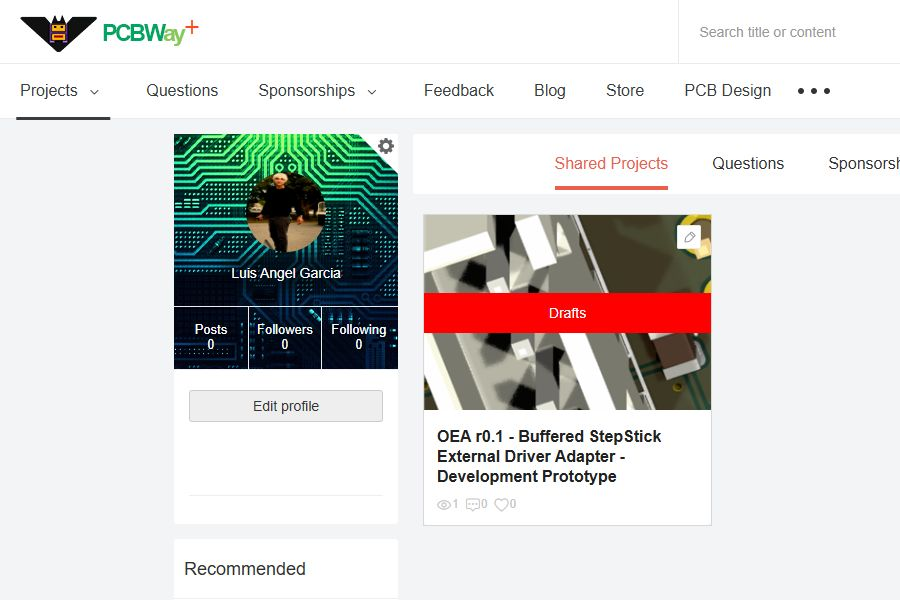
hardware/octopus_external_adapter/sales/20261006/pcbway-draft-confirmation-detail.jpg
