DeadlySIn777/Controller/hardware/power_entry/detail.png

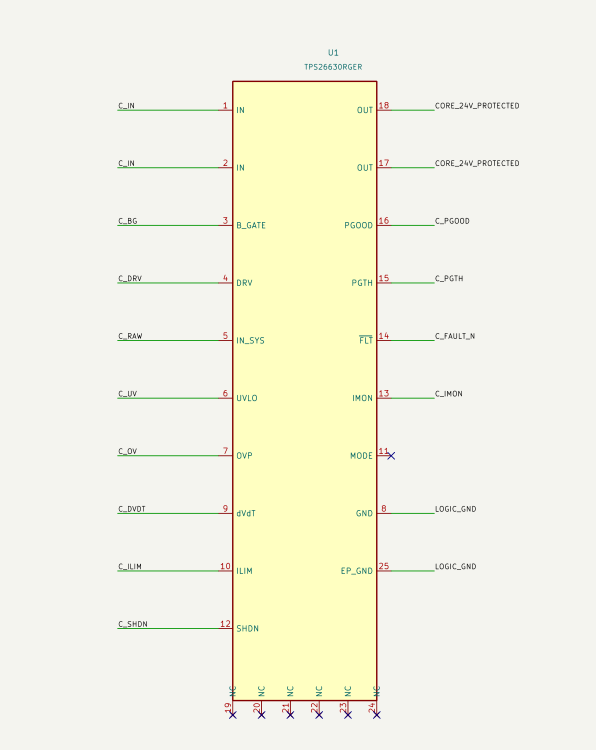
hardware/power_entry/detail.png
