DeadlySIn777/Controller/hardware/power_entry/preview.png

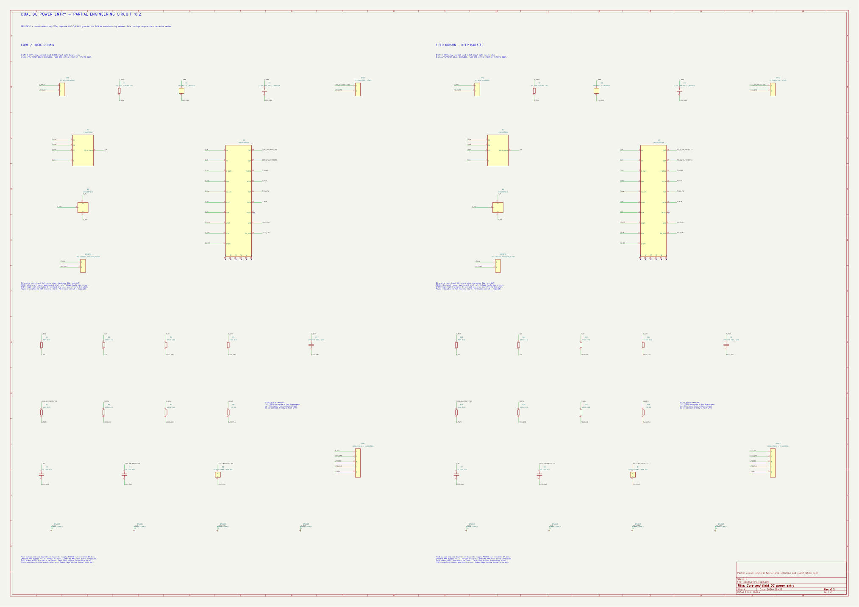
hardware/power_entry/preview.png
