DeadlySIn777/Controller/hardware/power_sequence/detail.png

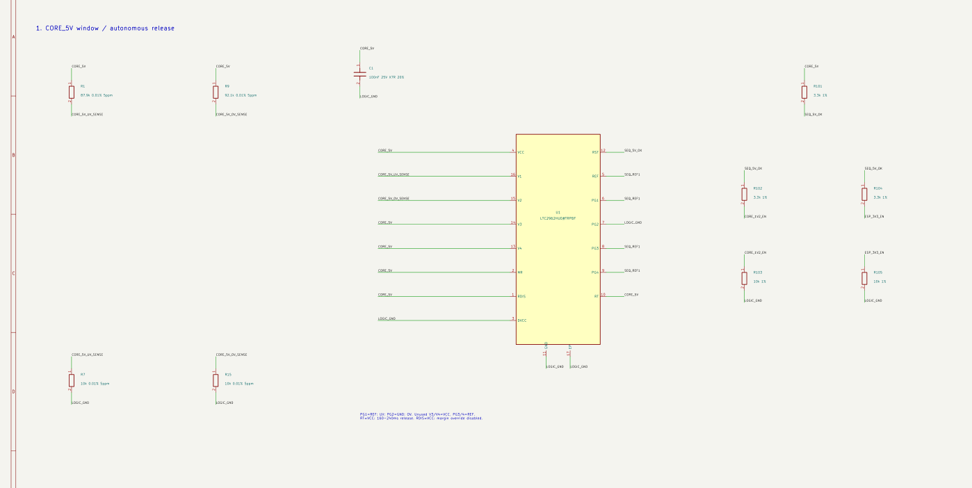
hardware/power_sequence/detail.png
