DeadlySIn777/Controller/hardware/power_sequence/overview.png

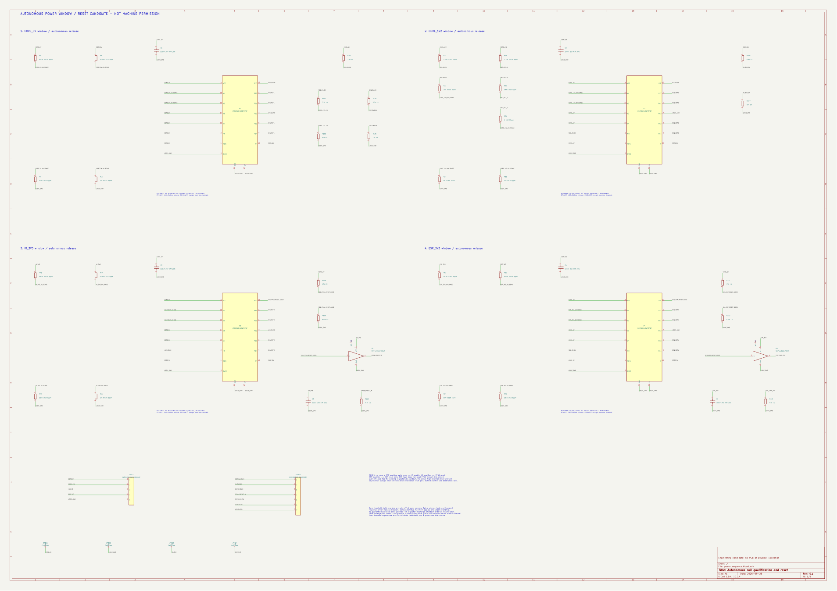
hardware/power_sequence/overview.png
