DeadlySIn777/Controller/hardware/power_sequence/reset-detail.png

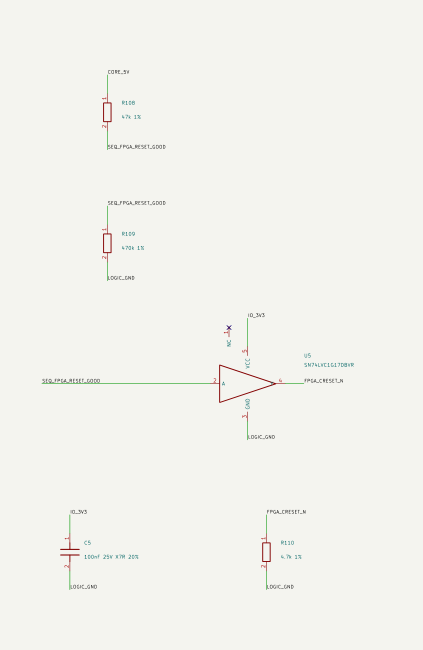
hardware/power_sequence/reset-detail.png
