DeadlySIn777/Controller/hardware/rx_abz/preview.png

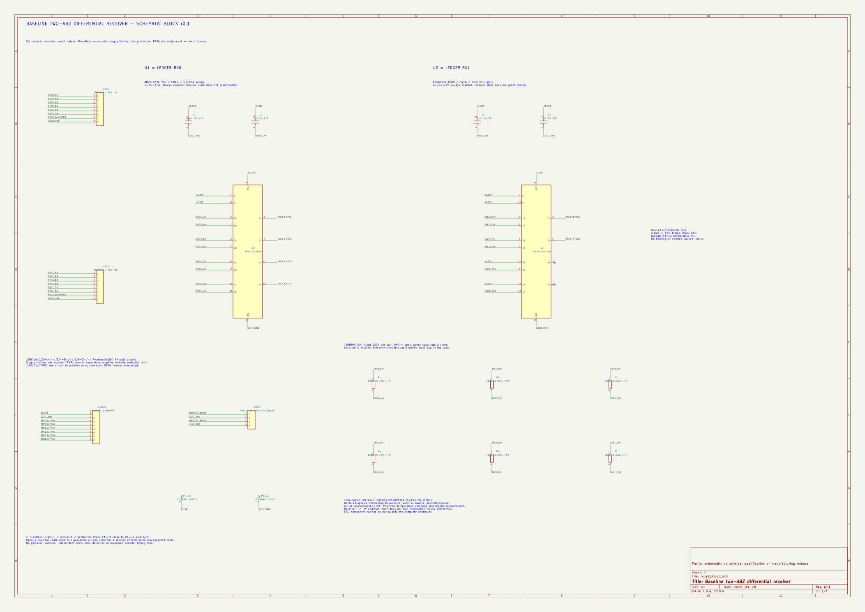
hardware/rx_abz/preview.png
