DeadlySIn777/Controller/hardware/sbc_power/detail.png

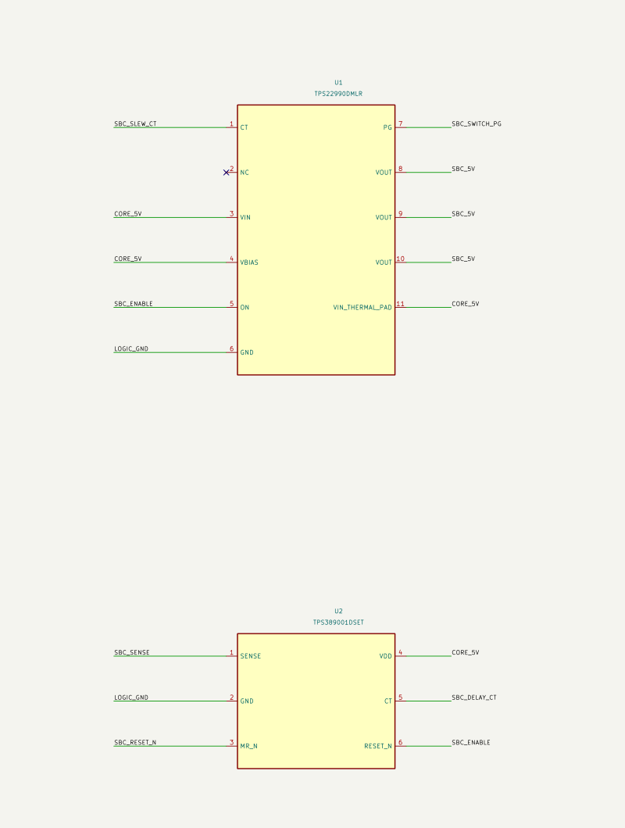
hardware/sbc_power/detail.png
