DeadlySIn777/Controller/hardware/tx_bank/tx_bank.png

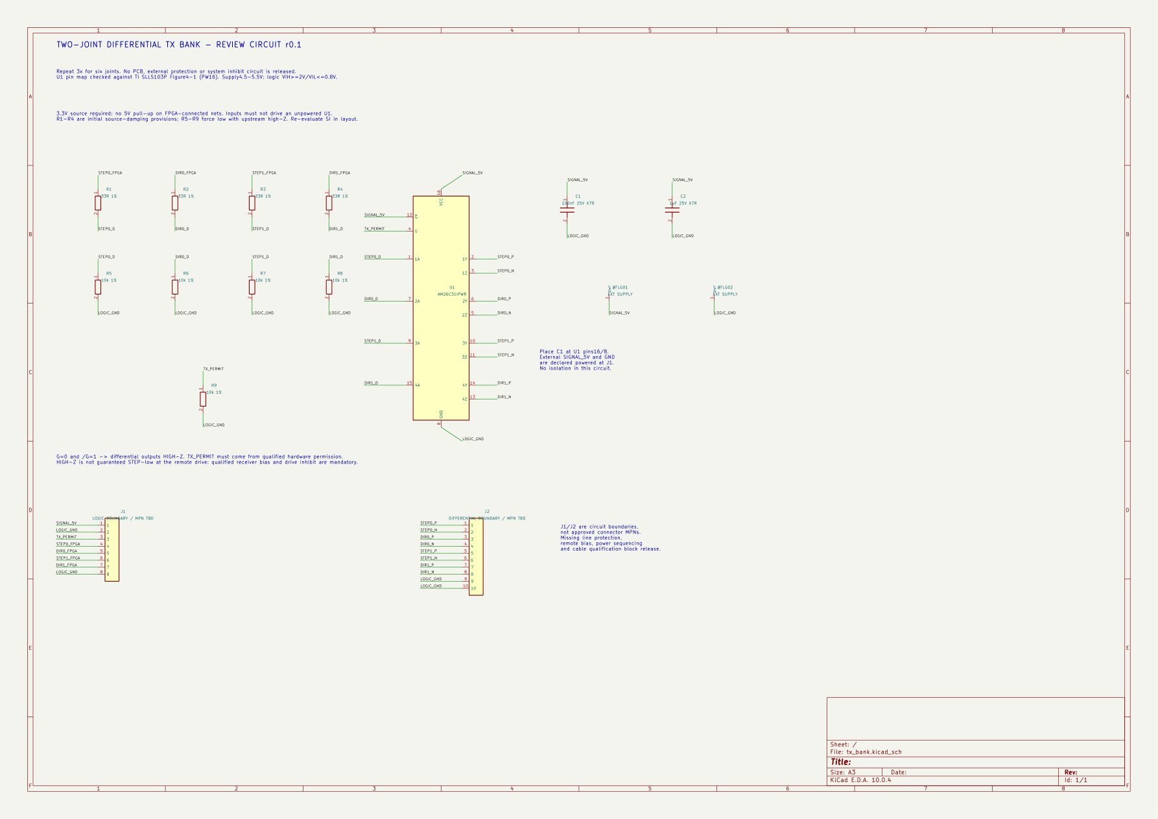
hardware/tx_bank/tx_bank.png
