DeadlySIn777/Controller/hardware/tx_twelve/preview.png

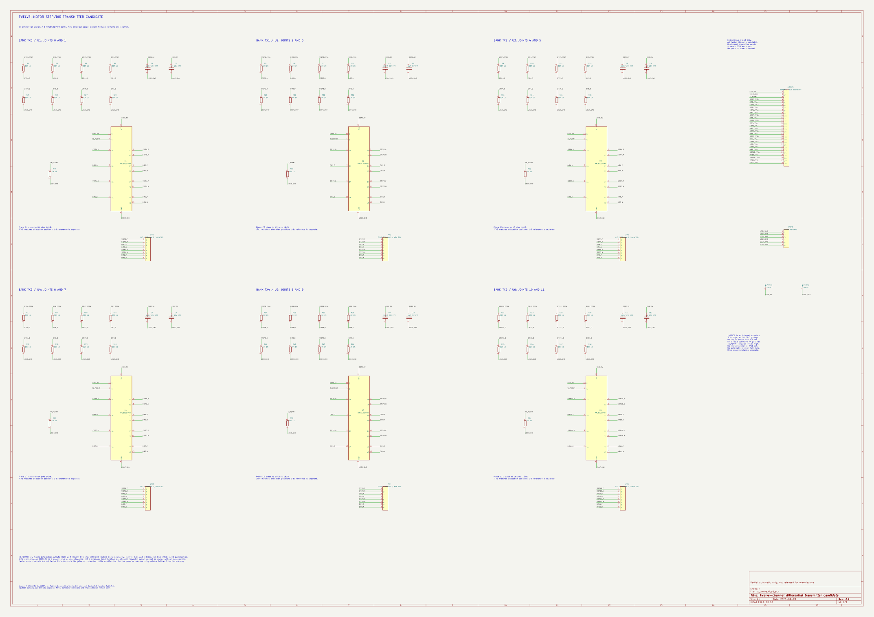
hardware/tx_twelve/preview.png
