DeadlySIn777/Controller/research/core-converter/before-sbc-sequencing/research/core-converter/package-page-54.png

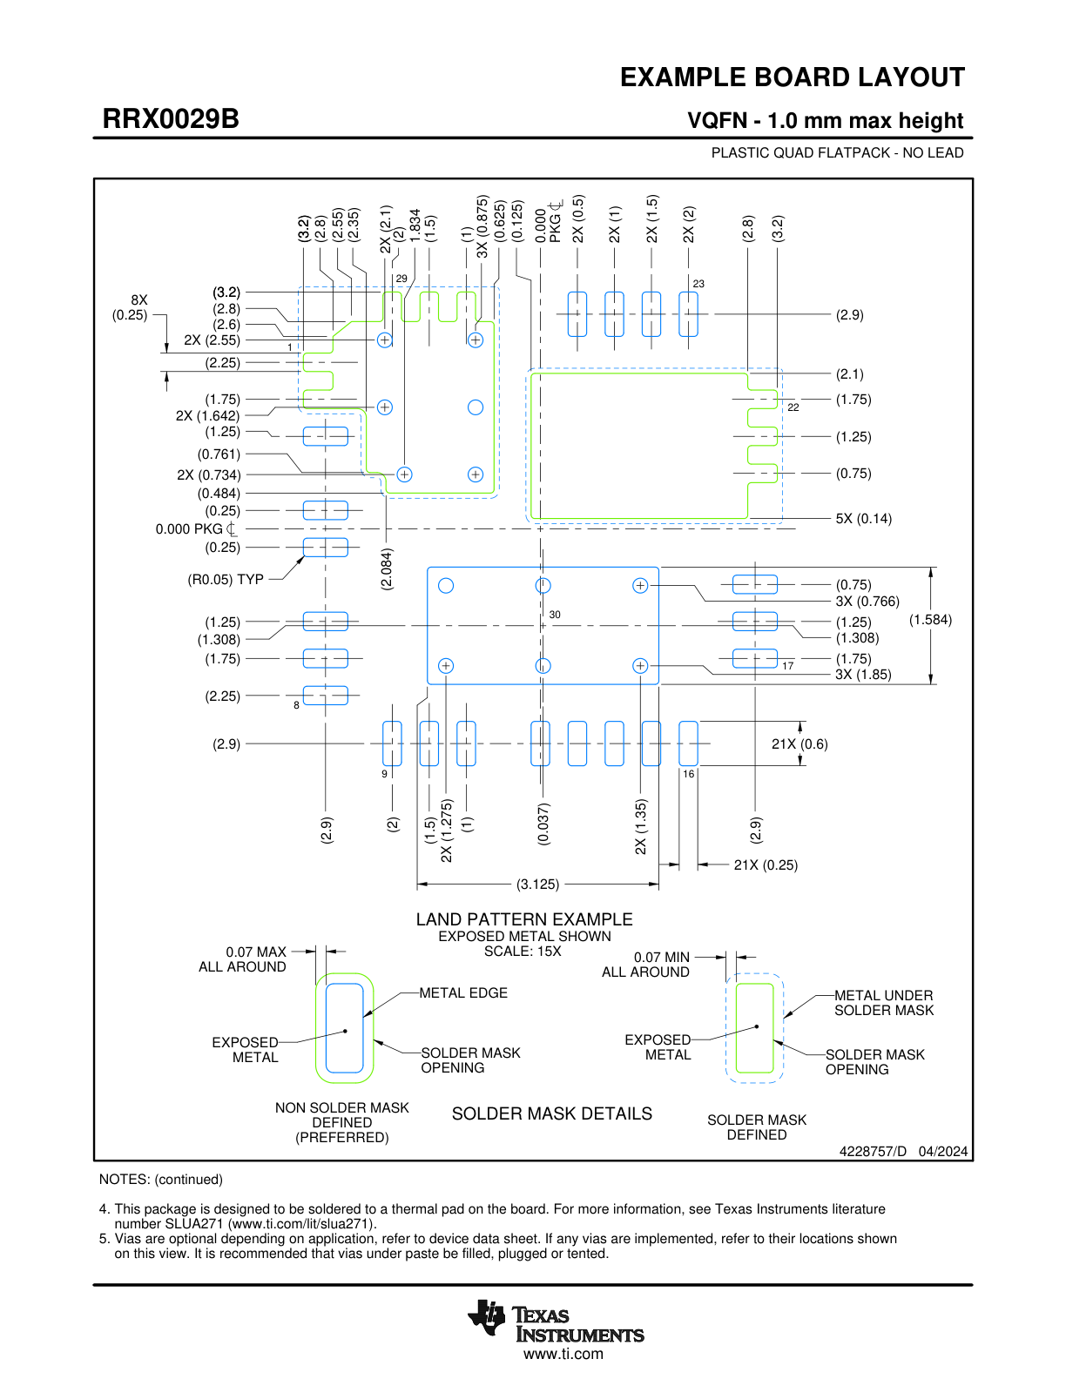
research/core-converter/before-sbc-sequencing/research/core-converter/package-page-54.png
