DeadlySIn777/Controller/research/digital-inputs/application.png

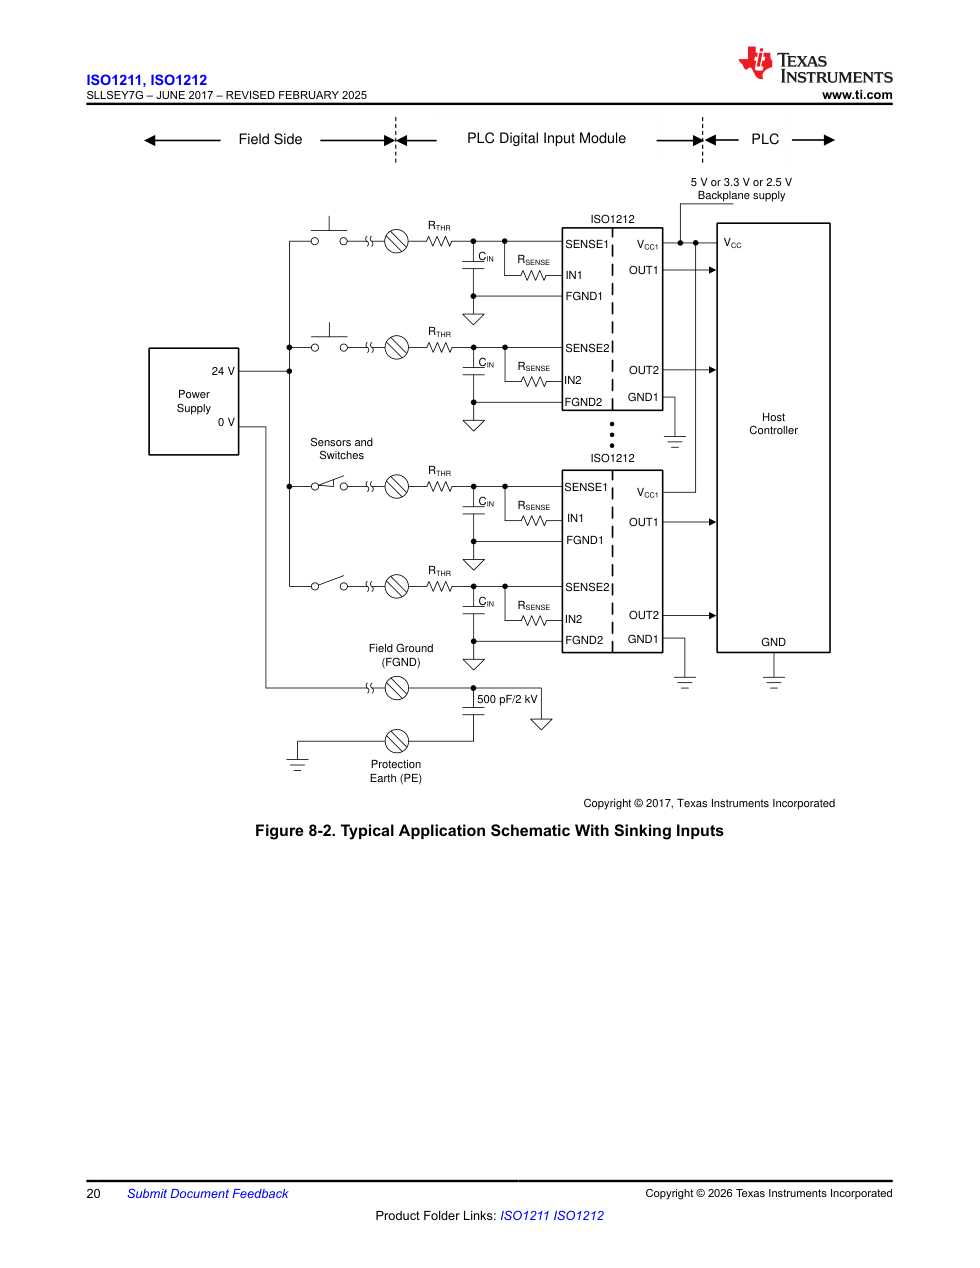
research/digital-inputs/application.png
