DeadlySIn777/Controller/research/digital-inputs/pins.png

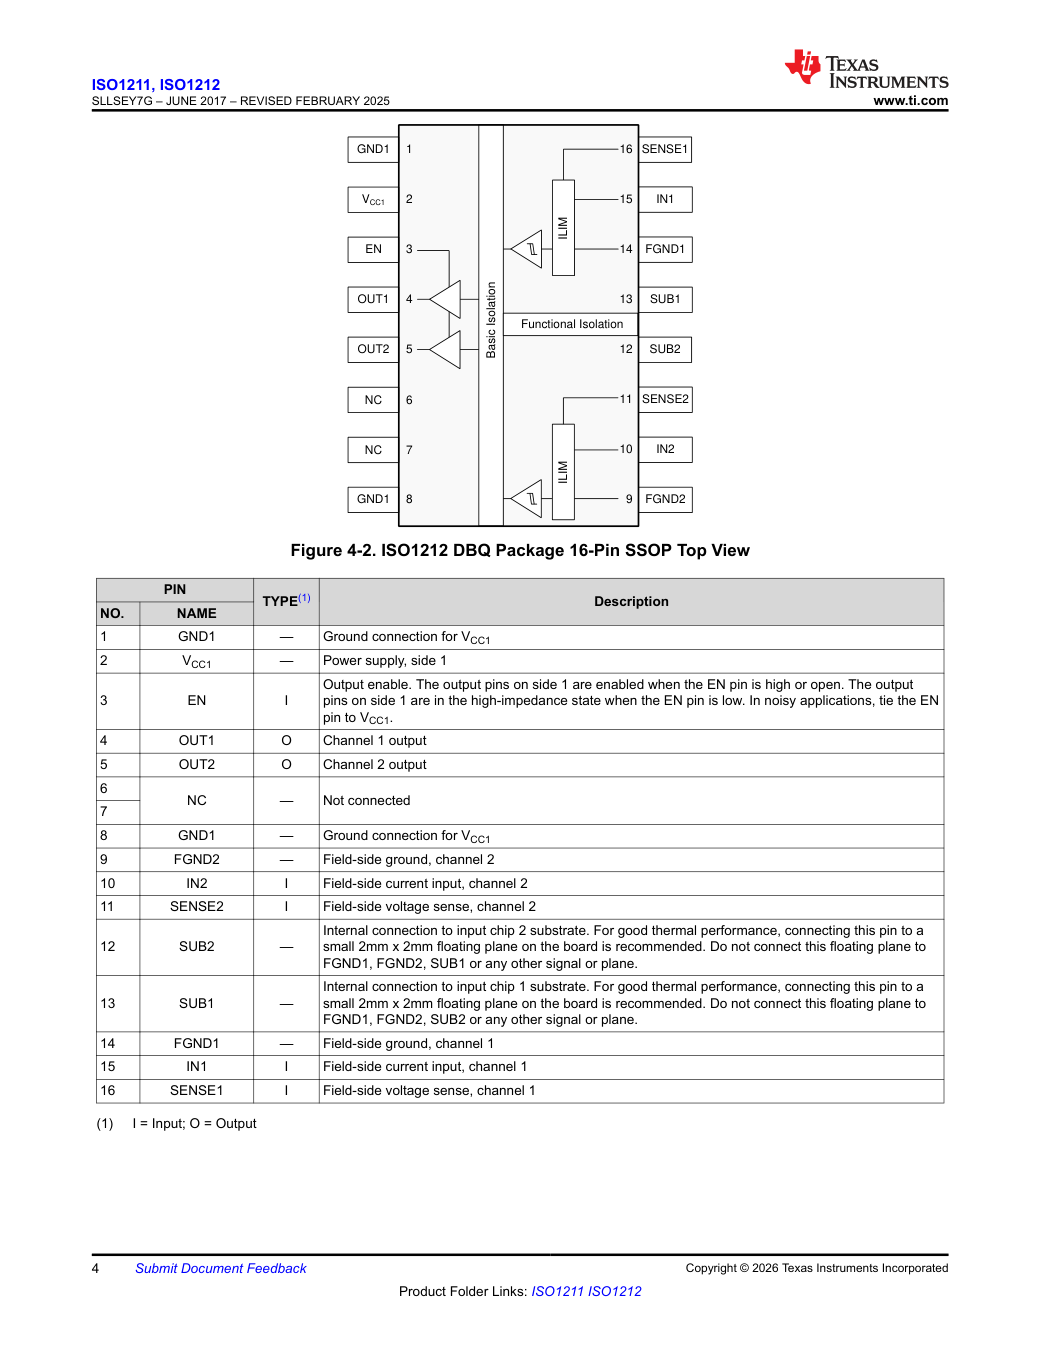
research/digital-inputs/pins.png
