DeadlySIn777/Controller/research/esp-service/esp32-s3-wroom-1-page-41.png

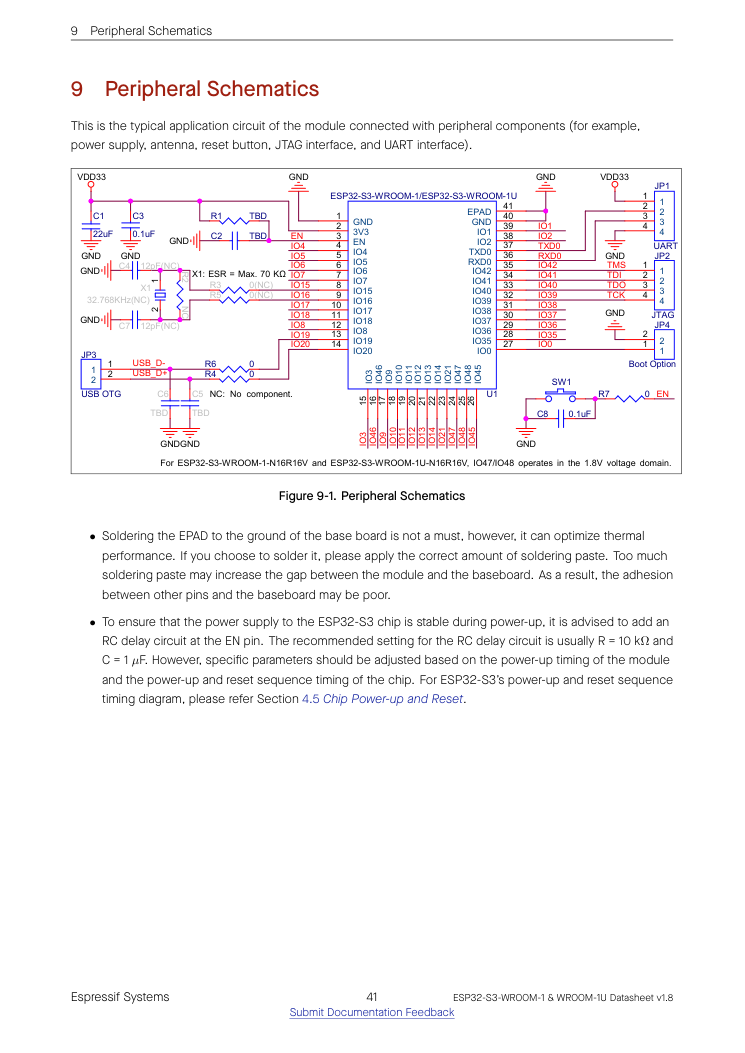
research/esp-service/esp32-s3-wroom-1-page-41.png
