DeadlySIn777/Controller/research/esp-service/ts3usb31e-page-3.png

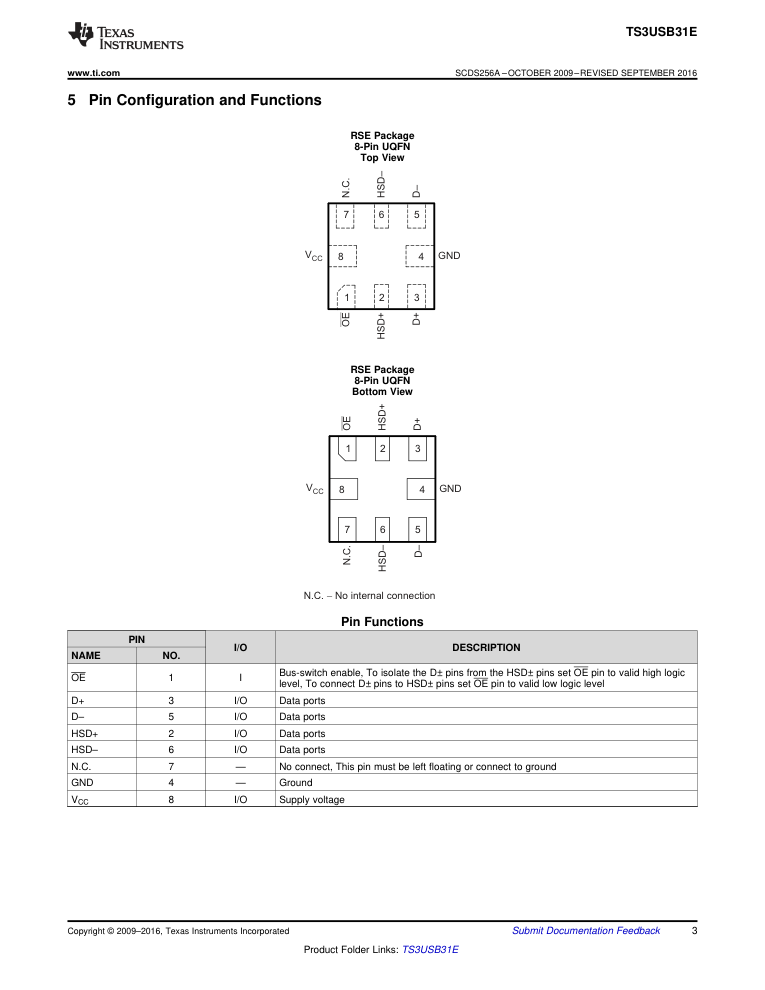
research/esp-service/ts3usb31e-page-3.png
