DeadlySIn777/Controller/research/field-power/pins.png

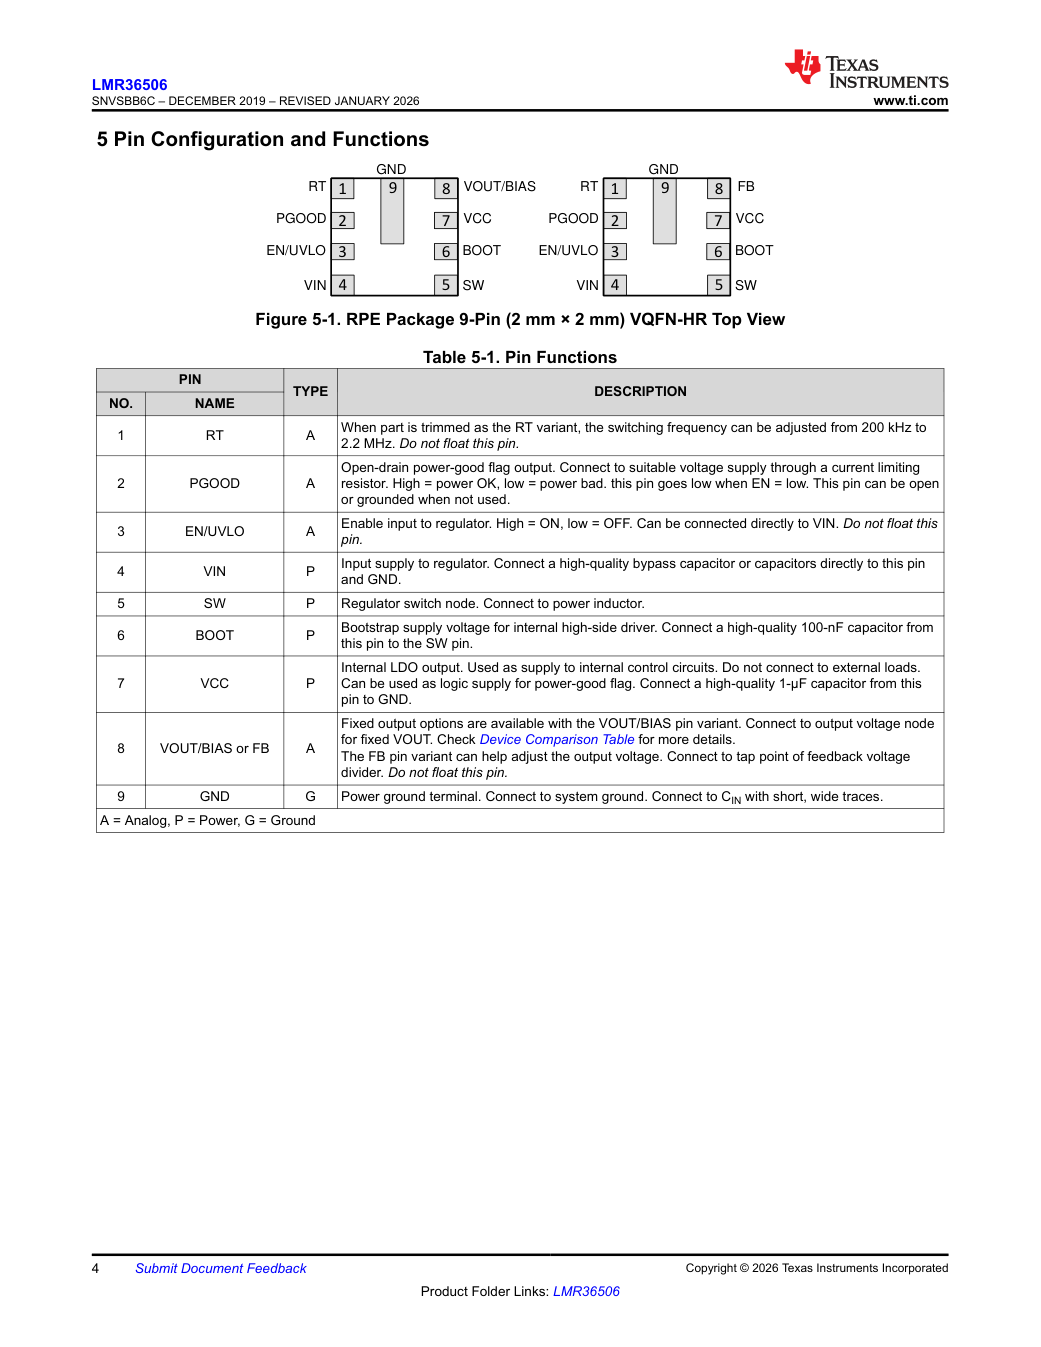
research/field-power/pins.png
