DeadlySIn777/Controller/research/fpga-core/ase-pins.png

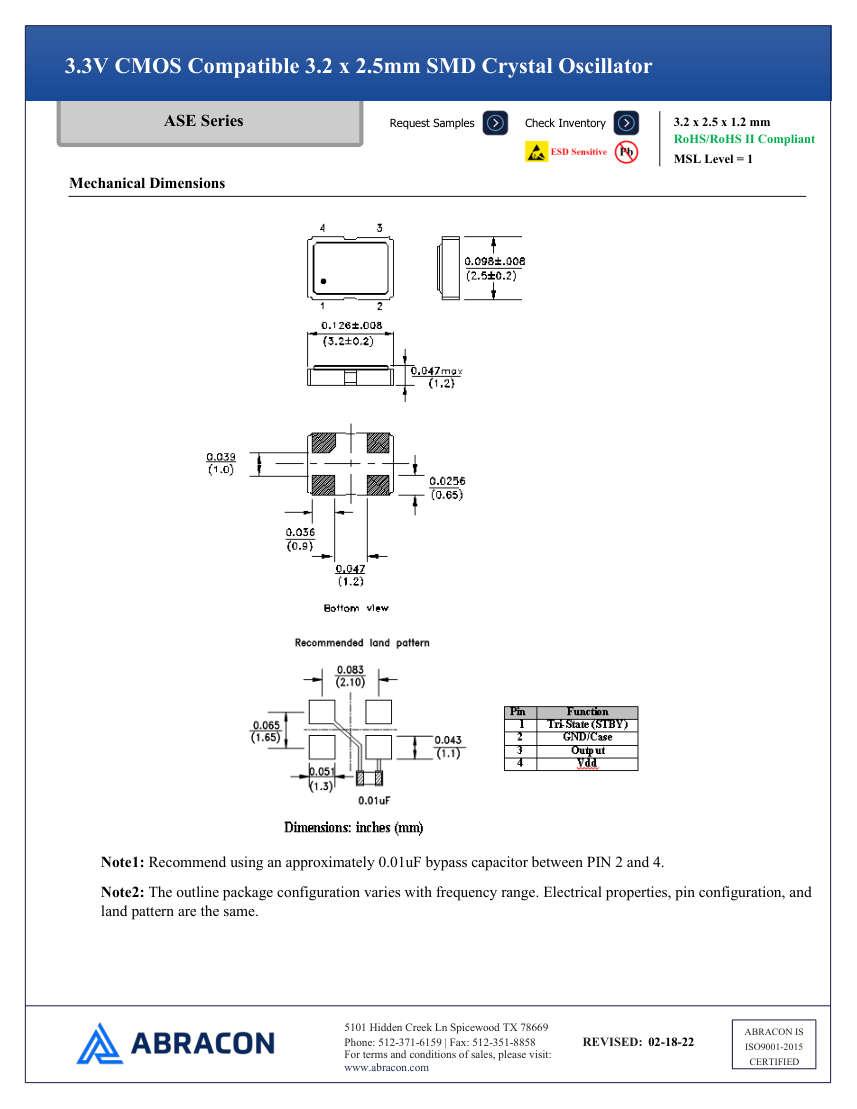
research/fpga-core/ase-pins.png
