DeadlySIn777/Controller/research/fpga-core/board-page-5.png

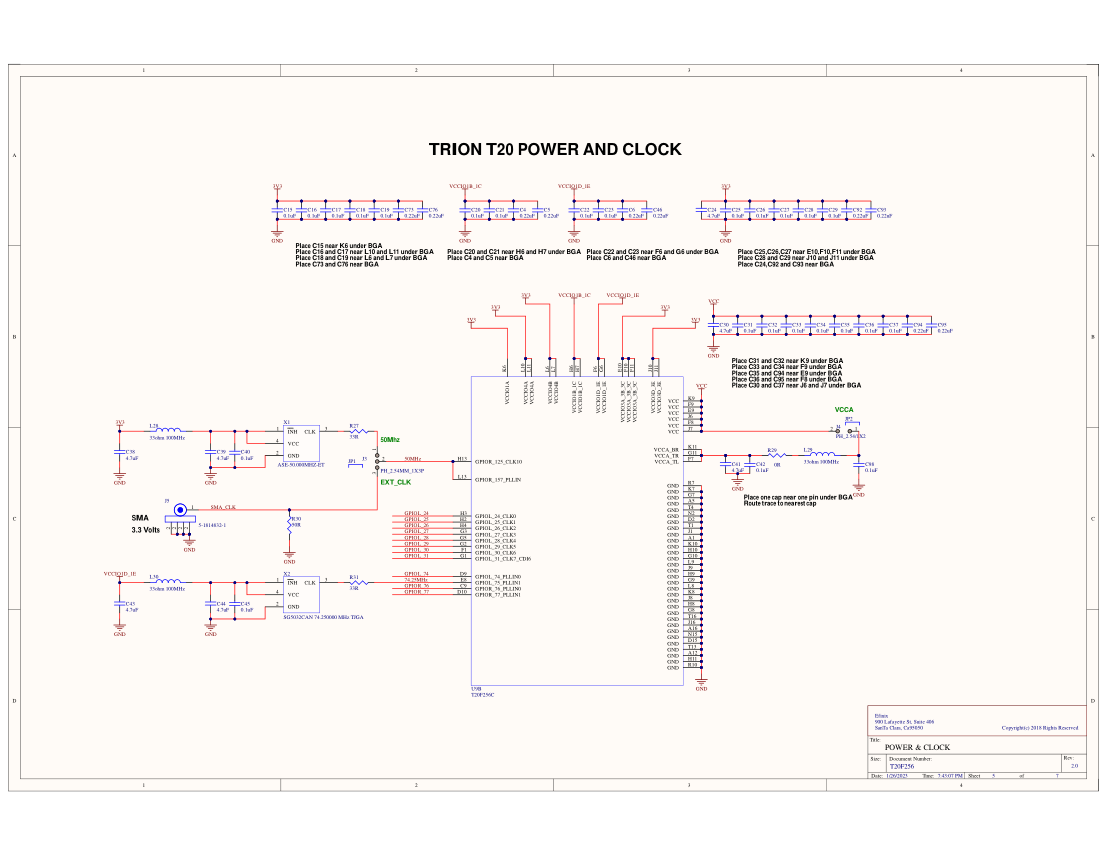
research/fpga-core/board-page-5.png
