DeadlySIn777/Controller/research/logic-power/inductor-land-pattern.png

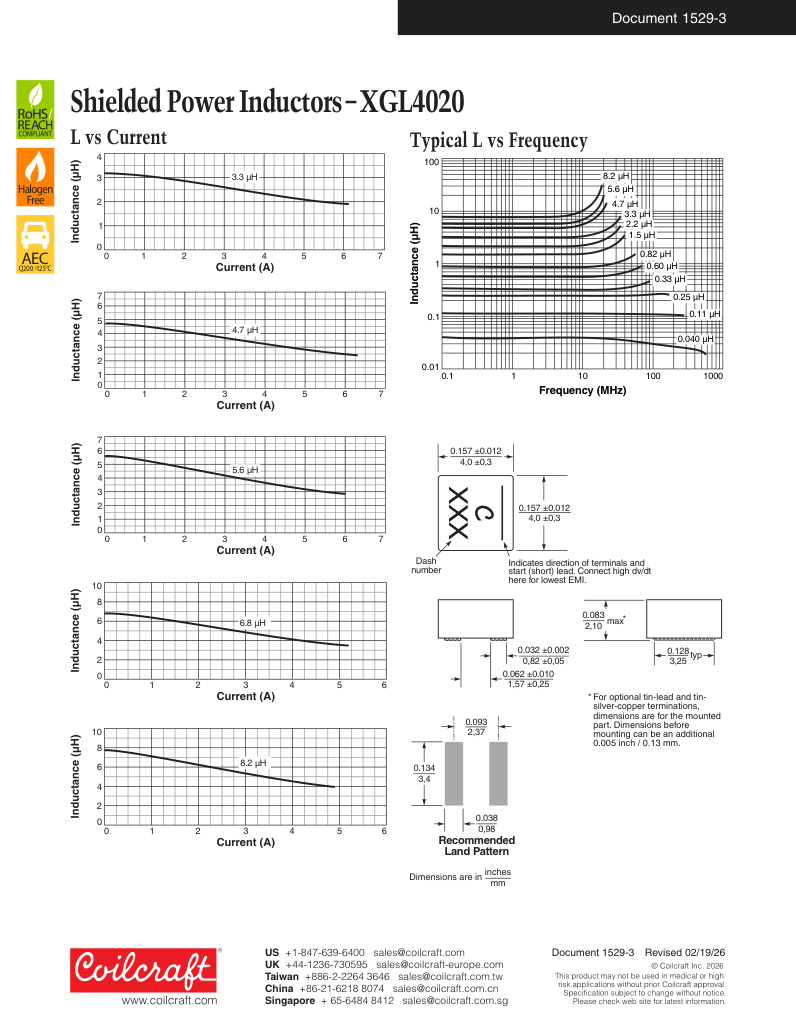
research/logic-power/inductor-land-pattern.png
