DeadlySIn777/Controller/research/logic-power/inductor-pad-detail.png

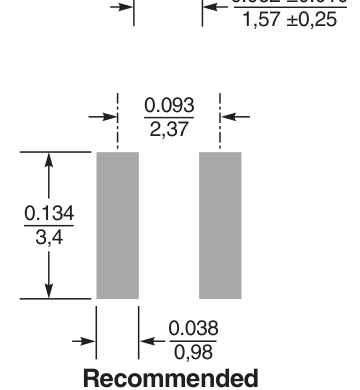
research/logic-power/inductor-pad-detail.png
