DeadlySIn777/Controller/research/logic-power/rpj9-land-pattern.png

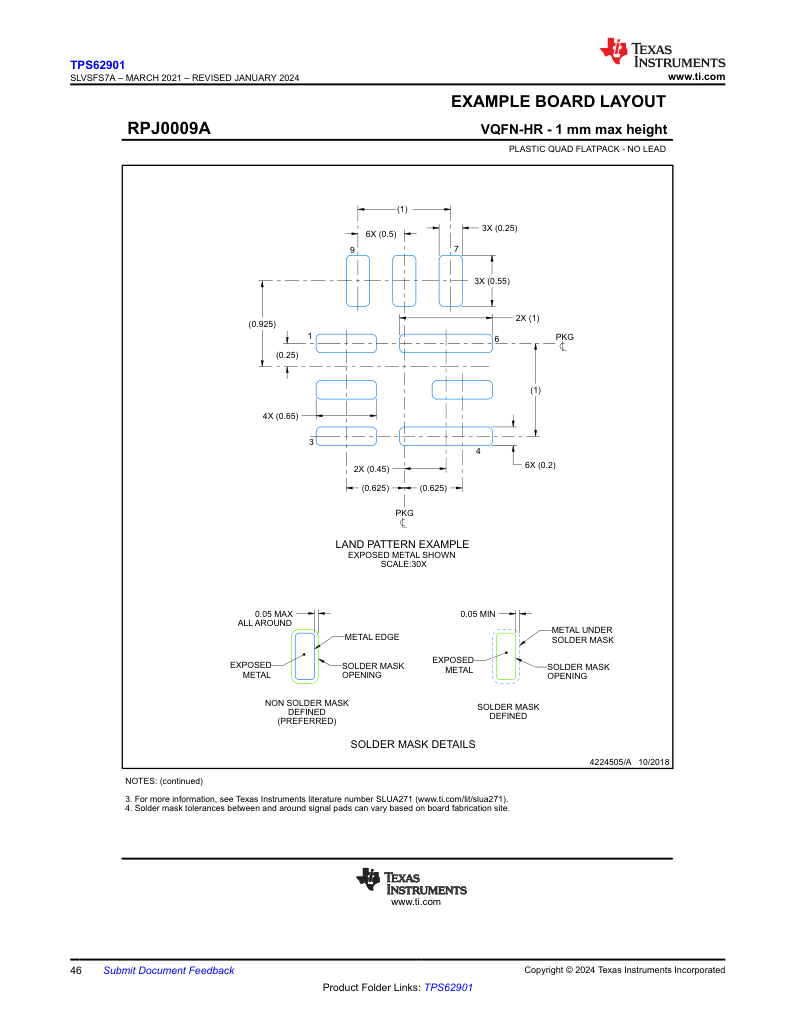
research/logic-power/rpj9-land-pattern.png
