DeadlySIn777/Controller/research/logic-power/softstart-bounds.png

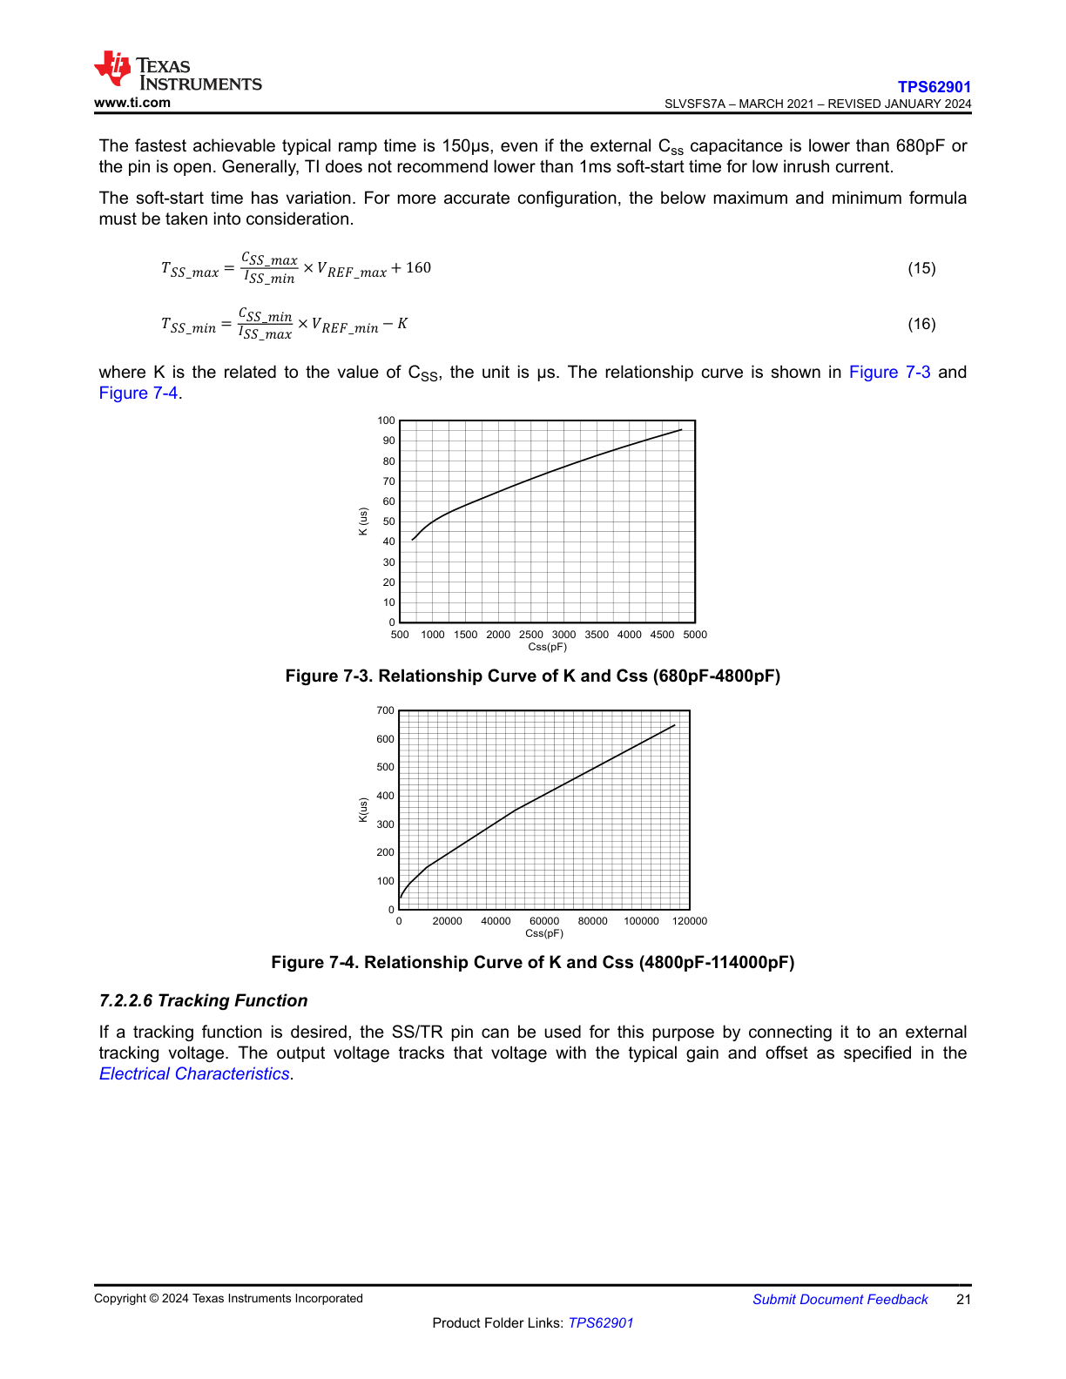
research/logic-power/softstart-bounds.png
