DeadlySIn777/Controller/research/machine-permission/watchdog-land-pattern.png

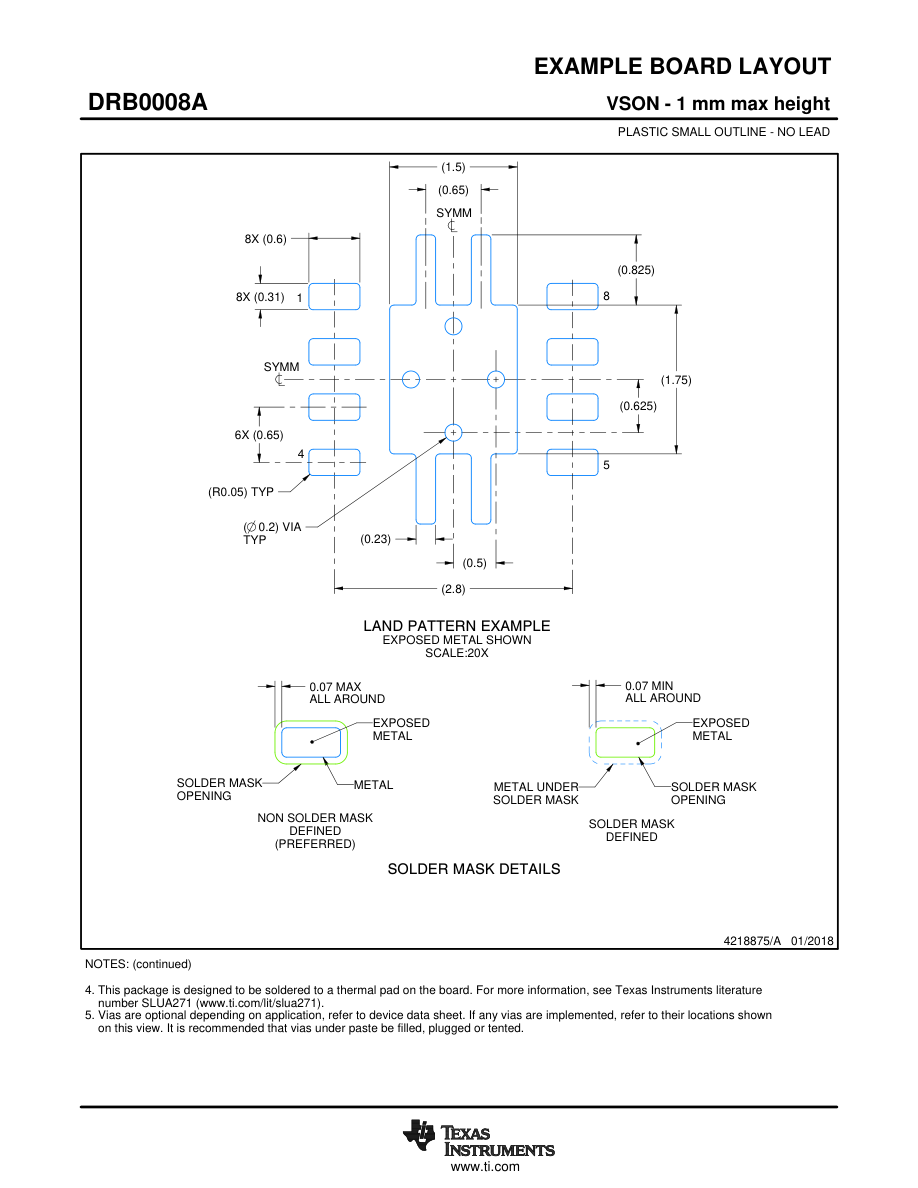
research/machine-permission/watchdog-land-pattern.png
