DeadlySIn777/Controller/research/power-entry/csd19537q3-p1.png

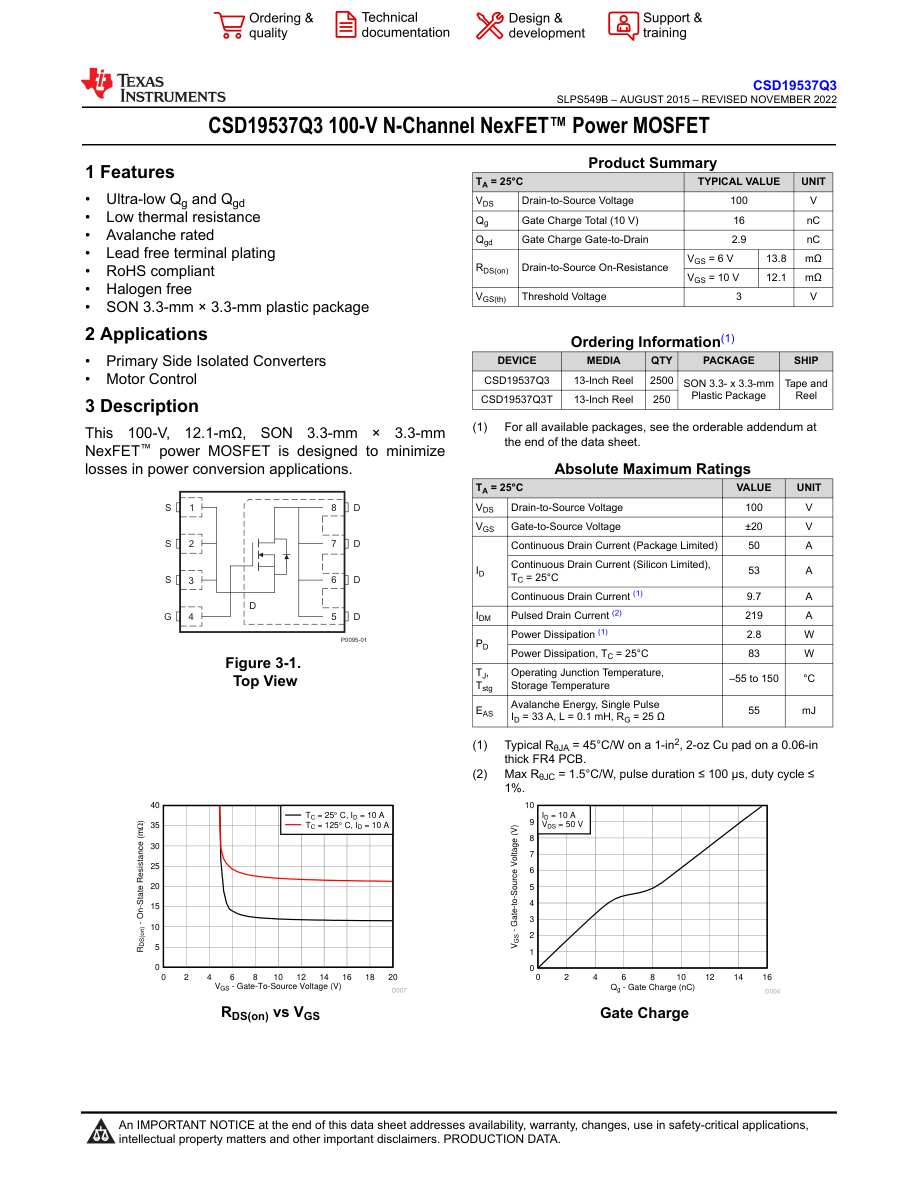
research/power-entry/csd19537q3-p1.png
