DeadlySIn777/Controller/research/power-entry/root-visual-review/tps2663-20.png

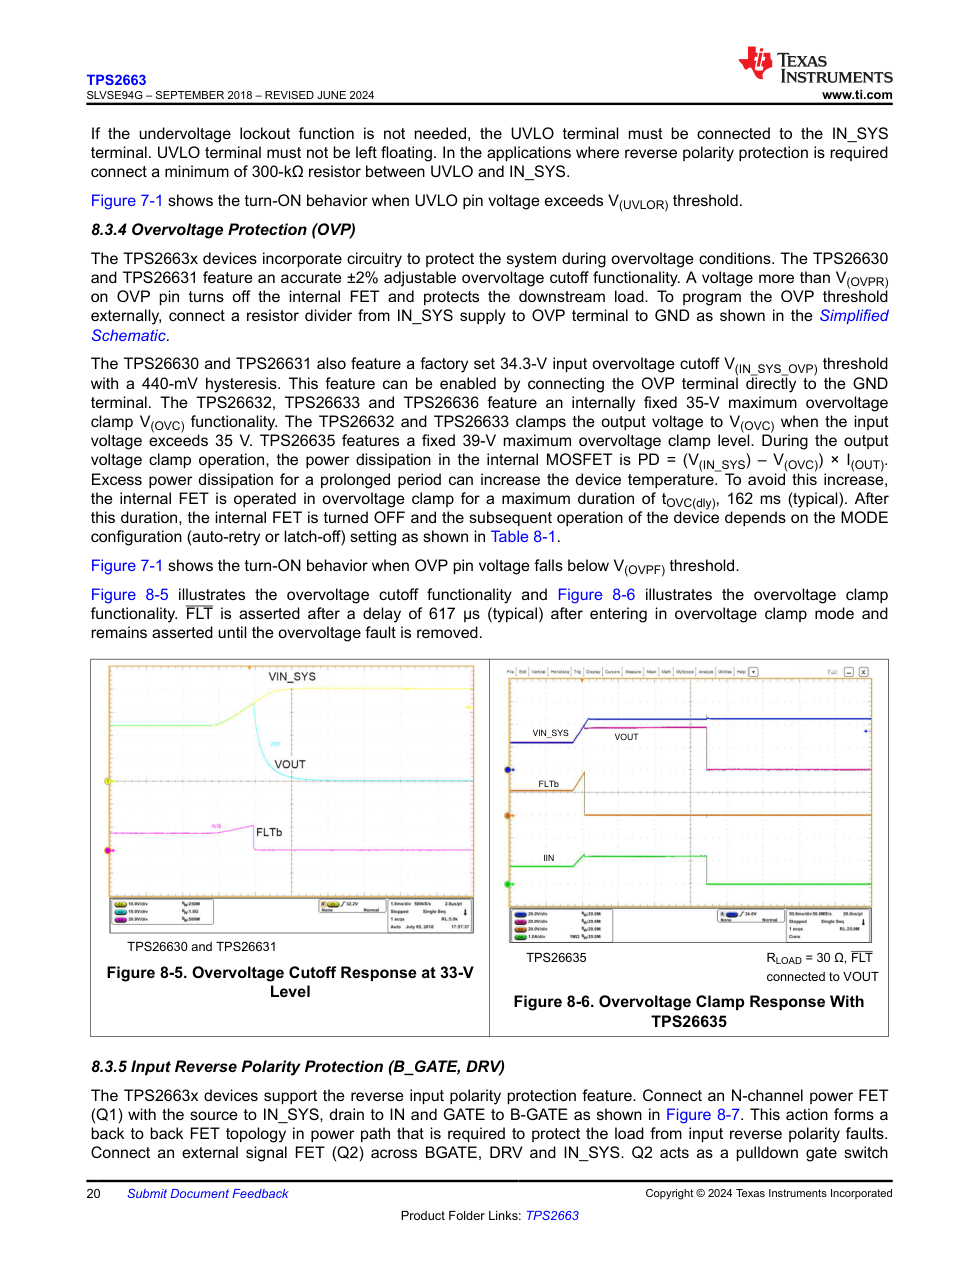
research/power-entry/root-visual-review/tps2663-20.png
