DeadlySIn777/Controller/review/current-native-layer-views/planning-B_Cu.png

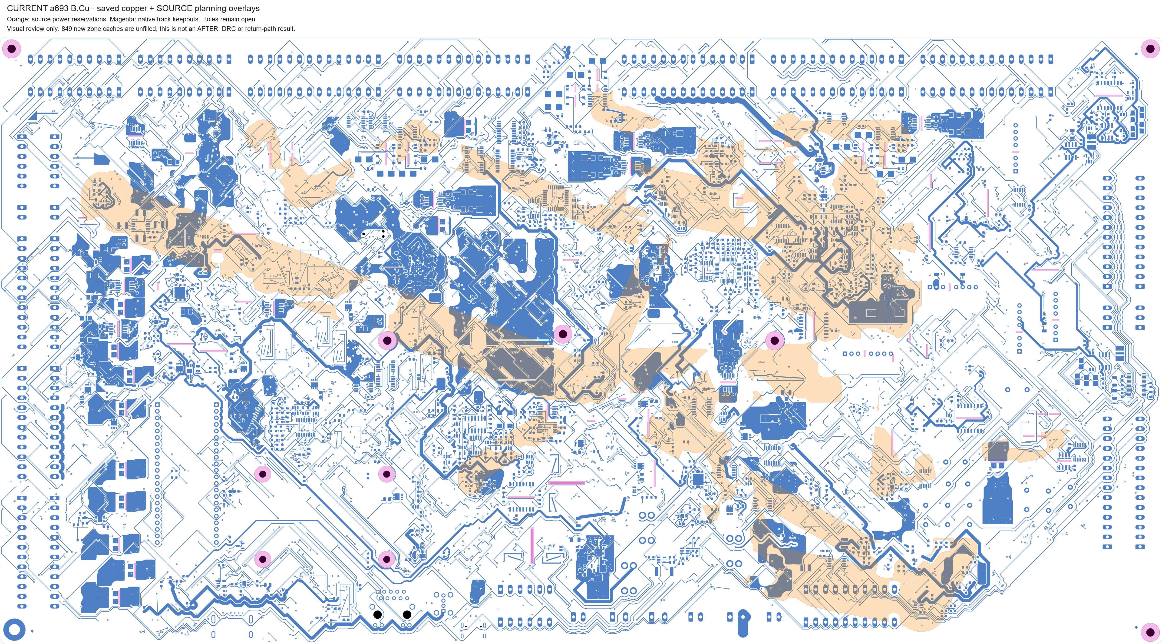
review/current-native-layer-views/planning-B_Cu.png
