DeadlySIn777/Controller/review/current-native-layer-views/planning-F_Cu.png

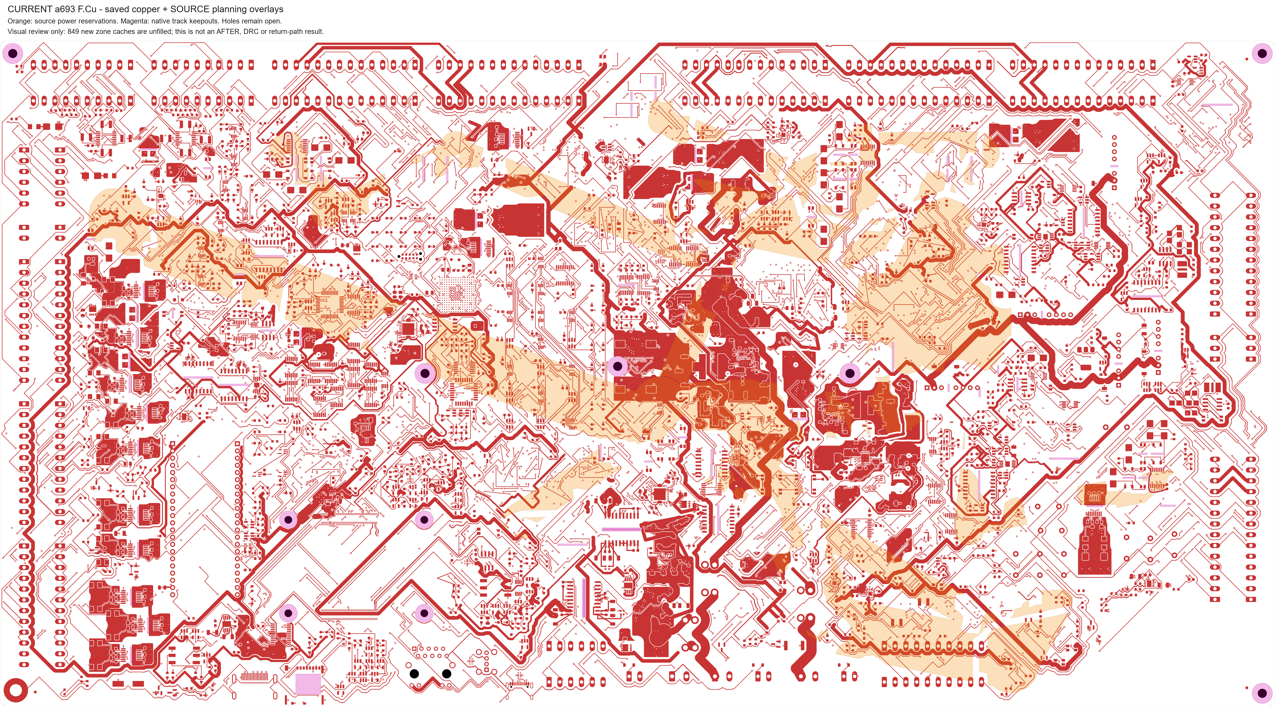
review/current-native-layer-views/planning-F_Cu.png
