DeadlySIn777/Controller/review/current-native-layer-views/planning-In3_Cu.png

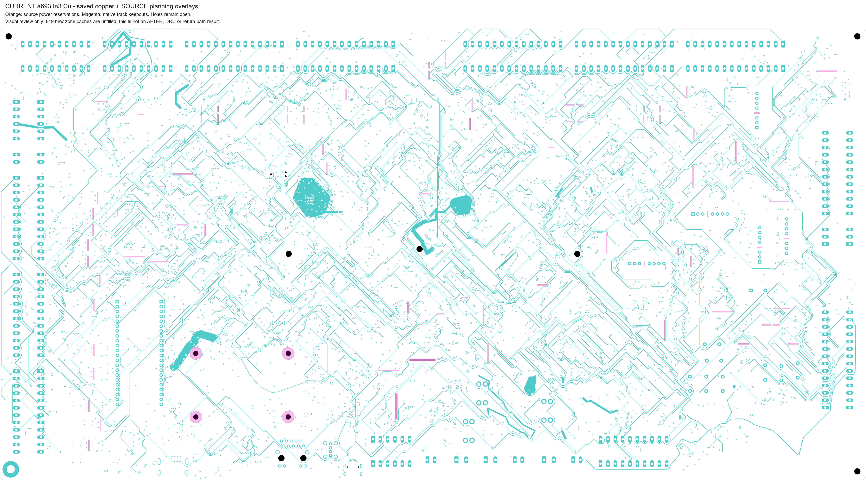
review/current-native-layer-views/planning-In3_Cu.png
