DeadlySIn777/Controller/review/global-routability.png

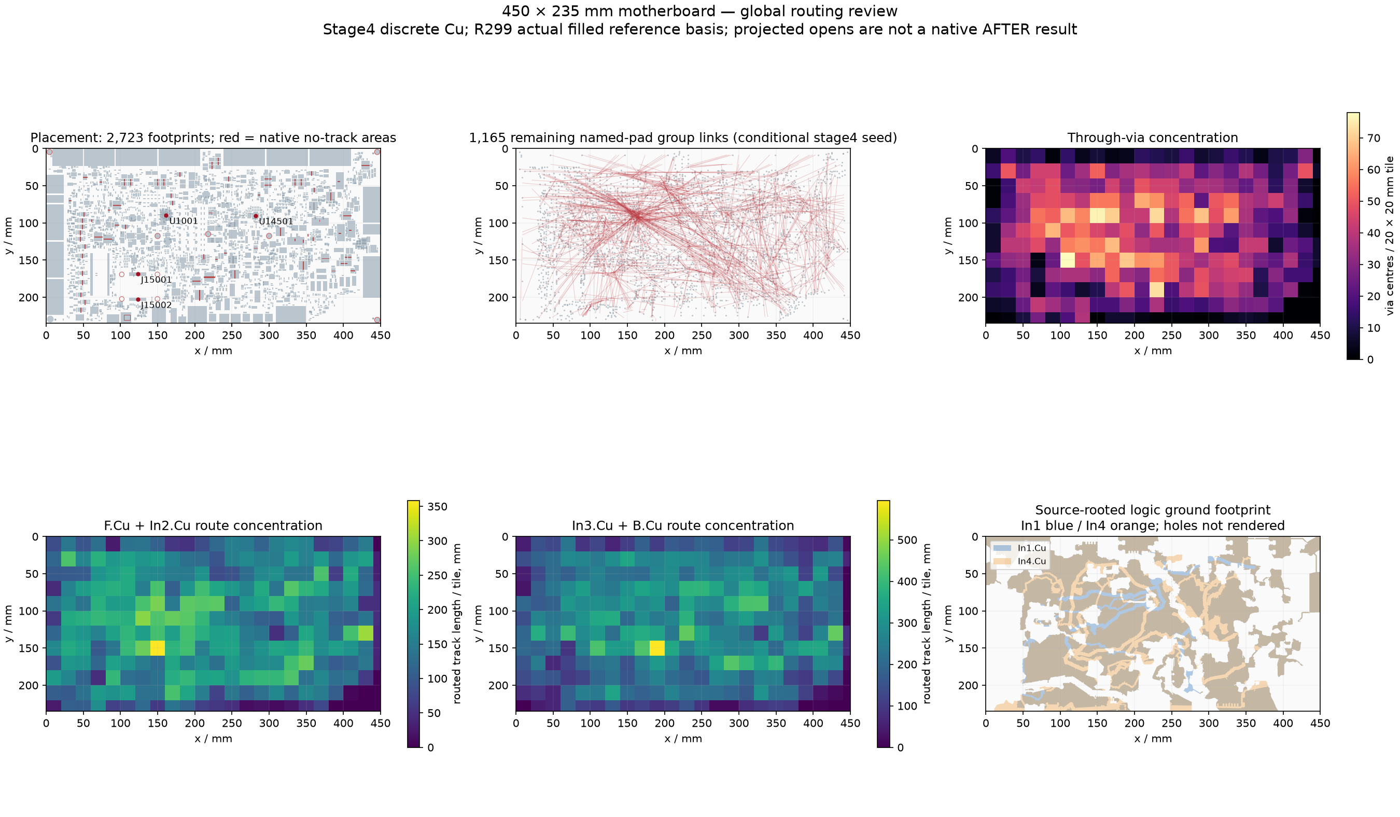
review/global-routability.png
