DeadlySIn777/Controller/hardware/octopus_external_adapter/r0_3_planning/full-bom-cost.txt

OEA r0.3 complete fitted BOM costing - 6 October 2026 - USD
Catalogue observations only. Not an order, quote acceptance or manufacturing release.

Native BOM: 52 purchased parts, 33 MPNs; 47 SMT + 5 through-hole. Three bare test pads are excluded.
Consumed components per adapter, conservative 100-board scale: $7.2310
Components for 100 adapters, without spares: $723.10
One adapter's component consumption at displayed qty-1 unit prices: $14.70
Every offer has a displayed minimum order of one piece. Prices do not prove current stock.
The qty-1 column is not an optimized pack-buying plan or the cash total of a populated cart.

Subsystem amounts per adapter at the conservative bulk tiers:
  power: $3.8067
  logic and connectors: $2.5087
  indicator: $0.9156

PCB estimate and $15 resale target:
Earlier PCBWay calculator scenario: 100 boards, 15.24 x 50 mm, 2 layers, purple mask, HASL.
It was $0.9876 per board including the quoted DHL allocation, before tax. A final routed outline
has not been released; refresh this scenario before treating it as a manufacturing quote.
Components plus that provisional PCB amount: $8.2186.
That leaves $6.7814 of a $15 selling price for ALL remaining costs and profit.
The $15 assembled-adapter-plus-finished-cable target is NOT ESTABLISHED.

Unpriced / excluded:
  - One finished, tested 500 mm mating four-wire harness per adapter
  - Component freight, tax, tariffs, spares and manufacturing losses
  - Solder paste, stencil, reflow equipment, hand soldering and inspection
  - UPDI programmer, programming/calibration fixture, firmware loading and per-unit testing
  - Physical prototype qualification, rework and rejected boards
  - Packaging, marketplace/payment fees, outbound delivery, warranty/returns and profit

Per-MPN prices (all values USD):
MPN                         Qty/board    Unit qty-1    Unit used @100 boards    Tier used    Board cost
1725656                             1        1.4400                   1.1830           10        1.1830
61300711121                         1        0.3800                   0.2016          100        0.2016
61300811121                         1        0.3800                   0.2016          100        0.2016
AP7375-33SA-7                       1        0.3700                   0.1935          100        0.1935
ATTINY202-SSNR                      1        0.5200                   0.5200            1        0.5200
B4B-XH-A(LF)(SN)                    1        0.1700                   0.1226          100        0.1226
BAT46W-7-F                          1        0.3400                   0.1310          100        0.1310
BZT52C12-7-F                        1        0.2100                   0.0790          100        0.0790
BZT52C5V1-7-F                       1        0.2100                   0.0790          100        0.0790
CL10B104KB8NNNC                     4        0.1000                   0.0185          100        0.0740
CL21B225KAFNNNE                     1        0.1500                   0.0527          100        0.0527
CL31A226KAHNNNE                     1        0.4500                   0.1820          100        0.1820
CL31B475KBHNNNE                     2        0.3700                   0.1417          100        0.2834
EG1218                              1        0.7200                   0.5128          100        0.5128
ERJ-P08F82R0V                       1        0.2300                   0.0689          100        0.0689
LTST-C190KRKT                       3        0.1400                   0.0675          100        0.2025
MP2459GJ-Z                          1        1.2300                   0.7112          100        0.7112
NX6008NBKR                          3        0.1900                   0.0713          100        0.2139
PMEG6010CEH,115                     3        0.4600                   0.1790          100        0.5370
PMV100EPAR                          1        0.6000                   0.2357          100        0.2357
RC0603FR-07100KL                    2        0.1000                   0.0122          100        0.0244
RC0603FR-0710KL                     4        0.1000                   0.0122          100        0.0488
RC0603FR-071KL                      6        0.1000                   0.0122          100        0.0732
RC0603FR-074K7L                     1        0.1000                   0.0122          100        0.0122
RC0805FR-0710KL                     1        0.1000                   0.0171          100        0.0171
RC0805FR-07330RL                    1        0.1000                   0.0171          100        0.0171
RT0603BRD07100KL                    1        0.1100                   0.0615          100        0.0615
RT0603BRD07124KL                    1        0.1100                   0.0615          100        0.0615
RT0603BRD0723K7L                    1        0.1000                   0.0580          100        0.0580
RT0603BRD073K9L                     1        0.1000                   0.0580          100        0.0580
SF-1206F050-2                       1        0.8900                   0.5204          100        0.5204
SMAJ28CA-13-F                       1        0.5900                   0.2300          100        0.2300
SRN5040-150M                        1        0.3900                   0.2634          100        0.2634

Tier interpretation:
J4 uses the observed 10-piece price because no 100-piece discount was displayed.
U50 uses the observed qty-1 cut-tape price; the 4,000-piece reel price is not applicable.
Repeated MPNs share one row. The other rows conservatively retain their observed 100-piece tier
even where a 100-board build would consume 200, 300, 400 or 600 pieces. No unobserved discount is assumed.

Known procurement limitations:
  - Several exact offers showed no stock: BZT52C12-7-F, PMEG6010CEH,115, CL10B104KB8NNNC, CL31A226KAHNNNE, BZT52C5V1-7-F, BAT46W-7-F and AP7375-33SA-7.
  - PMV100EPAR displayed only 3 pieces, insufficient for 100 adapters.
  - NX6008NBKR direct and cached results conflicted; refresh availability at checkout.
  - CL21B225KAFNNNE was flagged NRND in the catalogue; review lifecycle or qualify a replacement before production.
  - No generic diode, MOSFET, capacitor or connector substitute has been approved by this cost calculation.

Source and packaging details (observed 6 October 2026; refresh before buying):

1725656 | Phoenix Contact | J4
  Prototype offer: Bulk; observed ordering starts at1piece; required pieces for one board: 1.
  https://www.digikey.com/en/products/detail/phoenix-contact/1725656/267462
  Availability: Observed page displayed17727 in stock; stock not reserved
  Tier: Only1-piece and10-piece prices displayed. Use10-piece price for conservative100-board arithmetic; no100-piece discount is asserted.

61300711121 | Wurth Elektronik | J2
  Prototype offer: Bag; observed ordering starts at1piece; required pieces for one board: 1.
  https://www.digikey.com/en/products/detail/w%C3%BCrth-elektronik/61300711121/4846837
  Availability: Observed page displayed17445 in stock; stock not reserved

61300811121 | Wurth Elektronik | J1
  Prototype offer: Bag; observed ordering starts at1piece; required pieces for one board: 1.
  https://www.digikey.com/en/products/detail/w%C3%BCrth-elektronik/61300811121/4846839
  Availability: Observed page displayed30498 in stock; stock not reserved

AP7375-33SA-7 | Diodes Incorporated | U21
  Prototype offer: Cut tape (not Digi-Reel); no reeling fee assumed; required pieces for one board: 1.
  https://www.digikey.com/en/products/detail/diodes-incorporated/AP7375-33SA-7/16400213
  Availability: DirectUS page displayed zero stock/future delivery

ATTINY202-SSNR | Microchip Technology | U50
  Prototype offer: Cut tape; minimum displayed order 1 piece; no Digi-Reel service assumed; required pieces for one board: 1.
  https://www.digikey.com/en/products/detail/microchip-technology/ATTINY202-SSNR/9554944
  Availability: Page displayed 19,237 in stock. The 4,000-piece reel price is not used.
  Tier: Only qty-1 cut-tape pricing was displayed; no 100-piece discount is asserted.

B4B-XH-A(LF)(SN) | JST | J3
  Prototype offer: Bulk; observed ordering starts at1piece; required pieces for one board: 1.
  https://www.digikey.com/en/products/detail/jst-sales-america-inc/B4B-XH-A/1651047
  Availability: Observed page displayed97273 in stock; stock not reserved
  Name mapping: JST's own XH model search lists B4B-XH-A and states this product displays(LF)(SN)on the label. This is the RoHS label notation for the selected connector, not a different connector adopted from a photograph.
  https://www.jst-mfg.com/product/index.php?lang=2&search_product=B4B-XH-A&type=1

BAT46W-7-F | Diodes Incorporated | D26
  Prototype offer: Cut tape (not Digi-Reel); no reeling fee assumed; required pieces for one board: 1.
  https://www.digikey.com/en/products/detail/diodes-incorporated/BAT46W-7-F/1934440
  Availability: DirectUS page displayed zero stock/date unavailable

BZT52C12-7-F | Diodes Incorporated | D21
  Prototype offer: Cut tape (not Digi-Reel); no reeling fee assumed; required pieces for one board: 1.
  https://www.digikey.com/en/products/detail/diodes-incorporated/BZT52C12-7-F/717847
  Availability: Page displayed out of stock; future delivery. Exact -7-F active, distinct from EOL -7-F-79

BZT52C5V1-7-F | Diodes Incorporated | D24
  Prototype offer: Cut tape (not Digi-Reel); no reeling fee assumed; required pieces for one board: 1.
  https://www.digikey.com/en/products/detail/diodes-incorporated/BZT52C5V1-7-F/717736
  Availability: DirectUS page displayed zero stock/past-due delivery

CL10B104KB8NNNC | Samsung Electro-Mechanics | C21, C22, C50, C51
  Prototype offer: Cut tape (not Digi-Reel); no reeling fee assumed; required pieces for one board: 4.
  https://www.digikey.com/en/products/detail/samsung-electro-mechanics/CL10B104KB8NNNC/3886658
  Availability: Page displayed zero stock/future delivery
  Availability: The refreshed power-cost observation for the same MPN shows zero stock / future delivery.

CL21B225KAFNNNE | Samsung Electro-Mechanics | C26
  Prototype offer: Cut tape (not Digi-Reel); no reeling fee assumed; required pieces for one board: 1.
  https://www.digikey.com/en/products/detail/samsung-electro-mechanics/CL21B225KAFNNNE/3891040
  Availability: Page displayed stock but NRND. Keep prototype candidate; refresh manufacturer lifecycle/qualified replacement before production

CL31A226KAHNNNE | Samsung Electro-Mechanics | C23
  Prototype offer: Cut tape (not Digi-Reel); no reeling fee assumed; required pieces for one board: 1.
  https://www.digikey.com/en/products/detail/samsung-electro-mechanics/CL31A226KAHNNNE/3891133
  Availability: DirectUS page displayed zero stock/future delivery

CL31B475KBHNNNE | Samsung Electro-Mechanics | C20, C25
  Prototype offer: Cut tape (not Digi-Reel); no reeling fee assumed; required pieces for one board: 2.
  https://www.digikey.com/en/products/detail/samsung-electro-mechanics/CL31B475KBHNNNE/3888447
  Availability: DirectUS page displayed29723stock; not reserved

EG1218 | E-Switch | SW1
  Prototype offer: Bulk; observed ordering starts at1piece; required pieces for one board: 1.
  https://www.digikey.com/en/products/detail/e-switch/EG1218/101726
  Availability: Observed page displayed16348 distributor stock and90000 factory stock; neither reserved

ERJ-P08F82R0V | Panasonic | R26
  Prototype offer: Cut tape (not Digi-Reel); no reeling fee assumed; required pieces for one board: 1.
  https://www.digikey.com/en/products/detail/panasonic-industry/ERJ-P08F82R0V/21282245
  Availability: DirectUS page displayed3748stock; not reserved

LTST-C190KRKT | LITE-ON Technology | D50, D51, D52
  Prototype offer: Cut tape; minimum displayed order 1 piece; no Digi-Reel service assumed; required pieces for one board: 3.
  https://www.digikey.com/en/products/detail/liteon/LTST-C190KRKT/386817
  Availability: Page displayed 949,554 in stock; stock is not reserved.

MP2459GJ-Z | Monolithic Power Systems | U20
  Prototype offer: Cut tape (not Digi-Reel); no reeling fee assumed; required pieces for one board: 1.
  https://www.digikey.com/en/products/detail/monolithic-power-systems-inc/MP2459GJ-Z/5292061
  Availability: DirectUS page displayed23190stock

NX6008NBKR | Nexperia | Q1, Q2, Q3
  Prototype offer: Cut tape; observed ordering starts at1piece; noDigi-Reel fee assumed; required pieces for one board: 3.
  https://www.digikey.com/en/products/detail/nexperia-usa-inc/NX6008NBKR/15777929
  Availability: Direct product page returned50010 in stock, while an older cached search result showed0. Treat availability as requiring checkout refresh; do not substitute genericMOSFETs.

PMEG6010CEH,115 | Nexperia | D22, D23, D25
  Prototype offer: Cut tape (not Digi-Reel); no reeling fee assumed; required pieces for one board: 3.
  https://www.digikey.com/en/products/detail/nexperia-usa-inc/PMEG6010CEH-115/1589917
  Availability: DirectUS page displayed zero stock/future delivery

PMV100EPAR | Nexperia | Q20
  Prototype offer: Cut tape (not Digi-Reel); no reeling fee assumed; required pieces for one board: 1.
  https://www.digikey.com/en/products/detail/nexperia-usa-inc/PMV100EPAR/12325038
  Availability: DirectUS page displayed only3stock;100-piece tier is not immediately available

RC0603FR-07100KL | Yageo | R20, R24
  Prototype offer: Cut tape (not Digi-Reel); no reeling fee assumed; required pieces for one board: 2.
  https://www.digikey.com/en/products/detail/yageo/RC0603FR-07100KL/729836
  Availability: Page displayed stock

RC0603FR-0710KL | Yageo | R4, R5, R6, R25
  Prototype offer: Cut tape (not Digi-Reel); no reeling fee assumed; required pieces for one board: 4.
  https://www.digikey.com/en/products/detail/yageo/RC0603FR-0710KL/726880
  Availability: Page displayed stock
  Availability: Observed page displayed3745 in stock; stock not reserved

RC0603FR-071KL | YAGEO | R1, R2, R3, R50, R51, R52
  Prototype offer: Cut tape; observed ordering starts at1piece; noDigi-Reel fee assumed; required pieces for one board: 6.
  https://www.digikey.com/en/products/detail/yageo/RC0603FR-071KL/726843
  Availability: Observed page displayed3179272 in stock; stock not reserved
  Availability: Page displayed 3,179,272 in stock; stock is not reserved.

RC0603FR-074K7L | Yageo | R27
  Prototype offer: Cut tape (not Digi-Reel); no reeling fee assumed; required pieces for one board: 1.
  https://www.digikey.com/en/products/detail/yageo/RC0603FR-074K7L/730159
  Availability: Page displayed stock

RC0805FR-0710KL | Yageo | R23
  Prototype offer: Cut tape (not Digi-Reel); no reeling fee assumed; required pieces for one board: 1.
  https://www.digikey.com/en/products/detail/yageo/RC0805FR-0710KL/730482
  Availability: Page displayed stock

RC0805FR-07330RL | Yageo | R28
  Prototype offer: Cut tape (not Digi-Reel); no reeling fee assumed; required pieces for one board: 1.
  https://www.digikey.com/en/products/detail/yageo/RC0805FR-07330RL/727866
  Availability: Page displayed stock

RT0603BRD07100KL | YAGEO | R53
  Prototype offer: Cut tape; minimum displayed order 1 piece; no Digi-Reel service assumed; required pieces for one board: 1.
  https://www.digikey.com/en/products/detail/yageo/RT0603BRD07100KL/1072187
  Availability: Page displayed 113,496 in stock; stock is not reserved.

RT0603BRD07124KL | Yageo | R21
  Prototype offer: Cut tape (not Digi-Reel); no reeling fee assumed; required pieces for one board: 1.
  https://www.digikey.com/en/products/detail/yageo/RT0603BRD07124KL/5138963
  Availability: Page displayed stock

RT0603BRD0723K7L | Yageo | R22
  Prototype offer: Cut tape (not Digi-Reel); no reeling fee assumed; required pieces for one board: 1.
  https://www.digikey.com/en/products/detail/yageo/RT0603BRD0723K7L/6616664
  Availability: Page displayed stock

RT0603BRD073K9L | YAGEO | R54
  Prototype offer: Cut tape; minimum displayed order 1 piece; no Digi-Reel service assumed; required pieces for one board: 1.
  https://www.digikey.com/en/products/detail/yageo/RT0603BRD073K9L/5139104
  Availability: Page displayed 22,751 in stock; stock is not reserved.

SF-1206F050-2 | Bourns | F20
  Prototype offer: Cut tape (not Digi-Reel); no reeling fee assumed; required pieces for one board: 1.
  https://www.digikey.com/en/products/detail/bourns-inc/SF-1206F050-2/1948200
  Availability: Stock not reserved

SMAJ28CA-13-F | Diodes Incorporated | D20
  Prototype offer: Cut tape (not Digi-Reel); no reeling fee assumed; required pieces for one board: 1.
  https://www.digikey.com/en/products/detail/diodes-incorporated/SMAJ28CA-13-F/765424
  Availability: Page displayed stock

SRN5040-150M | Bourns | L20
  Prototype offer: Cut tape (not Digi-Reel); no reeling fee assumed; required pieces for one board: 1.
  https://www.digikey.com/en/products/detail/bourns-inc/SRN5040-150M/4867716
  Availability: DirectUS page displayed6560stock

The JSON companion records exact references, tier quantities, input hashes and source URLs.
No purchase, Amazon cart, PCBWay submission or CAD change was made by this costing calculation.
