DeadlySIn777/Controller/review/three-clamp-source-20261018/source-BOM-2726.csv

Reference | Value | MPN | Footprint | Datasheet | SheetPath
C10001 | 100nF 100V | GRM188R72A104KA35D | Capacitor_SMD:C_0603_1608Metric |  | /motherboard_do/
C10002 | 100nF 100V | GRM188R72A104KA35D | Capacitor_SMD:C_0603_1608Metric |  | /motherboard_do/
C10003 | 100nF 100V | GRM188R72A104KA35D | Capacitor_SMD:C_0603_1608Metric |  | /motherboard_do/
C10004 | 100nF 100V | GRM188R72A104KA35D | Capacitor_SMD:C_0603_1608Metric |  | /motherboard_do/
C10005 | 0.1nF 50V | GRM1885C1H101JA01D | Capacitor_SMD:C_0603_1608Metric |  | /motherboard_do/
C10006 | 2200nF 16V | GRM21BR71C225KA12L | Capacitor_SMD:C_0805_2012Metric |  | /motherboard_do/
C10007 | 100nF 100V | GRM188R72A104KA35D | Capacitor_SMD:C_0603_1608Metric |  | /motherboard_do/
C10008 | 100nF 100V | GRM188R72A104KA35D | Capacitor_SMD:C_0603_1608Metric |  | /motherboard_do/
C10009 | 1000nF 50V | GRM188R71H105KA12D | Capacitor_SMD:C_0603_1608Metric |  | /motherboard_do/
C1001 | 0.1uF 16V X7R | 885012206046 | Capacitor_SMD:C_0603_1608Metric |  | /fpga_core/
C10010 | 22nF 100V | C0805C223K1RACTU | Capacitor_SMD:C_0805_2012Metric |  | /motherboard_do/
C10011 | 22nF 100V | C0805C223K1RACTU | Capacitor_SMD:C_0805_2012Metric |  | /motherboard_do/
C10012 | 22nF 100V | C0805C223K1RACTU | Capacitor_SMD:C_0805_2012Metric |  | /motherboard_do/
C10013 | 22nF 100V | C0805C223K1RACTU | Capacitor_SMD:C_0805_2012Metric |  | /motherboard_do/
C10014 | 0.1nF 50V | GRM1885C1H101JA01D | Capacitor_SMD:C_0603_1608Metric |  | /motherboard_do/
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
C11009 | 2.2uF 100V X7S | CGA5L3X7S2A225K160AB | Capacitor_SMD:C_1206_3216Metric |  | /motherboard_power_entry/
C11010 | 100nF 5% C0G | C3216C0G2A104J160AC | Capacitor_SMD:C_1206_3216Metric |  | /motherboard_power_entry/
C11011 | 1uF 100V X7R | GRM31CR72A105KA01L | Capacitor_SMD:C_1206_3216Metric |  | /motherboard_power_entry/
C11012 | 1uF 100V X7R | GRM31CR72A105KA01L | Capacitor_SMD:C_1206_3216Metric |  | /motherboard_power_entry/
C11013 | 4.7uF100V X7S 10% 1210 | CGA6M3X7S2A475K200AE | Capacitor_SMD:C_1210_3225Metric |  | /motherboard_power_entry/
C11014 | 4.7uF100V X7S 10% 1210 | CGA6M3X7S2A475K200AE | Capacitor_SMD:C_1210_3225Metric |  | /motherboard_power_entry/
C11015 | 4.7uF100V X7S 10% 1210 | CGA6M3X7S2A475K200AE | Capacitor_SMD:C_1210_3225Metric |  | /motherboard_power_entry/
C11016 | 4.7uF100V X7S 10% 1210 | CGA6M3X7S2A475K200AE | Capacitor_SMD:C_1210_3225Metric |  | /motherboard_power_entry/
C11017 | 10nF100V X7R | GRM188R72A103KA01D | Capacitor_SMD:C_0603_1608Metric |  | /motherboard_power_entry/
C11018 | 10nF100V X7R | GRM188R72A103KA01D | Capacitor_SMD:C_0603_1608Metric |  | /motherboard_power_entry/
C11019 | 47uF10V X7S 20% 1210 | CGA6P1X7S1A476M250AC | Capacitor_SMD:C_1210_3225Metric |  | /motherboard_power_entry/
C11020 | 47uF10V X7S 20% 1210 | CGA6P1X7S1A476M250AC | Capacitor_SMD:C_1210_3225Metric |  | /motherboard_power_entry/
C11021 | 47uF10V X7S 20% 1210 | CGA6P1X7S1A476M250AC | Capacitor_SMD:C_1210_3225Metric |  | /motherboard_power_entry/
C11022 | 47nF50V X7R | C1608X7R1H473K080AA | Capacitor_SMD:C_0603_1608Metric |  | /motherboard_power_entry/
C11023 | 4.7uF16V X7R | C2012X7R1C475K125AB | Capacitor_SMD:C_0805_2012Metric |  | /motherboard_power_entry/
C11024 | 100nF100V X7R | GRM188R72A104KA35D | Capacitor_SMD:C_0603_1608Metric |  | /motherboard_power_entry/
C11025 | 22nF5% C0G | C2012C0G1H223J125AA | Capacitor_SMD:C_0805_2012Metric |  | /motherboard_power_entry/
C11026 | 330pF5% C0G | GRM1885C1H331JA01D | Capacitor_SMD:C_0603_1608Metric |  | /motherboard_power_entry/
C11027 | 330uF16V 20% polymer | 16SVPG330M | CNC_MB_Entry:OSCON_C10L_Panasonic |  | /motherboard_power_entry/
C11028 | 330uF16V 20% polymer | 16SVPG330M | CNC_MB_Entry:OSCON_C10L_Panasonic |  | /motherboard_power_entry/
C11029 | 330uF16V 20% polymer | 16SVPG330M | CNC_MB_Entry:OSCON_C10L_Panasonic |  | /motherboard_power_entry/
C11030 | 4.7uF100V X7S 10% 1210 | CGA6M3X7S2A475K200AE | Capacitor_SMD:C_1210_3225Metric |  | /motherboard_power_entry/
C11031 | 4.7uF100V X7S 10% 1210 | CGA6M3X7S2A475K200AE | Capacitor_SMD:C_1210_3225Metric |  | /motherboard_power_entry/
C11032 | 4.7uF100V X7S 10% 1210 | CGA6M3X7S2A475K200AE | Capacitor_SMD:C_1210_3225Metric |  | /motherboard_power_entry/
C11033 | 4.7uF100V X7S 10% 1210 | CGA6M3X7S2A475K200AE | Capacitor_SMD:C_1210_3225Metric |  | /motherboard_power_entry/
C11034 | 10nF100V X7R | GRM188R72A103KA01D | Capacitor_SMD:C_0603_1608Metric |  | /motherboard_power_entry/
C11035 | 10nF100V X7R | GRM188R72A103KA01D | Capacitor_SMD:C_0603_1608Metric |  | /motherboard_power_entry/
C11036 | 47uF10V X7S 20% 1210 | CGA6P1X7S1A476M250AC | Capacitor_SMD:C_1210_3225Metric |  | /motherboard_power_entry/
C11037 | 47uF10V X7S 20% 1210 | CGA6P1X7S1A476M250AC | Capacitor_SMD:C_1210_3225Metric |  | /motherboard_power_entry/
C11038 | 47uF10V X7S 20% 1210 | CGA6P1X7S1A476M250AC | Capacitor_SMD:C_1210_3225Metric |  | /motherboard_power_entry/
C11039 | 47nF50V X7R | C1608X7R1H473K080AA | Capacitor_SMD:C_0603_1608Metric |  | /motherboard_power_entry/
C11040 | 4.7uF16V X7R | C2012X7R1C475K125AB | Capacitor_SMD:C_0805_2012Metric |  | /motherboard_power_entry/
C11041 | 100nF100V X7R | GRM188R72A104KA35D | Capacitor_SMD:C_0603_1608Metric |  | /motherboard_power_entry/
C11042 | 22nF5% C0G | C2012C0G1H223J125AA | Capacitor_SMD:C_0805_2012Metric |  | /motherboard_power_entry/
C11043 | 330pF5% C0G | GRM1885C1H331JA01D | Capacitor_SMD:C_0603_1608Metric |  | /motherboard_power_entry/
C11044 | 330uF16V 20% polymer | 16SVPG330M | CNC_MB_Entry:OSCON_C10L_Panasonic |  | /motherboard_power_entry/
C11045 | 330uF16V 20% polymer | 16SVPG330M | CNC_MB_Entry:OSCON_C10L_Panasonic |  | /motherboard_power_entry/
C11046 | 330uF16V 20% polymer | 16SVPG330M | CNC_MB_Entry:OSCON_C10L_Panasonic |  | /motherboard_power_entry/
C11047 | 2.2uF 100V X7S | CGA5L3X7S2A225K160AB | Capacitor_SMD:C_1206_3216Metric |  | /motherboard_power_entry/
C11048 | 2.2uF 100V X7S | CGA5L3X7S2A225K160AB | Capacitor_SMD:C_1206_3216Metric |  | /motherboard_power_entry/
C11049 | 2.2uF 100V X7S | CGA5L3X7S2A225K160AB | Capacitor_SMD:C_1206_3216Metric |  | /motherboard_power_entry/
C11050 | 2.2uF 100V X7S | CGA5L3X7S2A225K160AB | Capacitor_SMD:C_1206_3216Metric |  | /motherboard_power_entry/
C11051 | 100nF 100V X7R | GRM188R72A104KA35D | Capacitor_SMD:C_0603_1608Metric |  | /motherboard_power_entry/
C11052 | 100nF 16V X7R | GCM155R71C104KA55D | Capacitor_SMD:C_0402_1005Metric |  | /motherboard_power_entry/
C11053 | 1uF 16V X7R | 885012206052 | Capacitor_SMD:C_0603_1608Metric |  | /motherboard_power_entry/
C11054 | 22uF 10V X7R | GCM31CR71A226KE02L | Capacitor_SMD:C_1206_3216Metric |  | /motherboard_power_entry/
C11055 | 22uF 10V X7R | GCM31CR71A226KE02L | Capacitor_SMD:C_1206_3216Metric |  | /motherboard_power_entry/
C11056 | 100nF 16V X7R | GCM155R71C104KA55D | Capacitor_SMD:C_0402_1005Metric |  | /motherboard_power_entry/
C11057 | 1uF 16V X7R | 885012206052 | Capacitor_SMD:C_0603_1608Metric |  | /motherboard_power_entry/
C11058 | 100nF 100V X7R | GRM188R72A104KA35D | Capacitor_SMD:C_0603_1608Metric |  | /motherboard_power_entry/
C11059 | 1uF 16V X7R | 885012206052 | Capacitor_SMD:C_0603_1608Metric |  | /motherboard_power_entry/
C11060 | 100nF 100V X7R | GRM188R72A104KA35D | Capacitor_SMD:C_0603_1608Metric |  | /motherboard_power_entry/
C11061 | 4.7uF 25V X7R | C2012X7R1E475K125AB | Capacitor_SMD:C_0805_2012Metric |  | /motherboard_power_entry/
C11062 | 1uF 16V X7R | 885012206052 | Capacitor_SMD:C_0603_1608Metric |  | /motherboard_power_entry/
C11063 | 100nF 100V X7R | GRM188R72A104KA35D | Capacitor_SMD:C_0603_1608Metric |  | /motherboard_power_entry/
C11064 | 100nF 100V X7R | GRM188R72A104KA35D | Capacitor_SMD:C_0603_1608Metric |  | /motherboard_power_entry/
C11065 | 1uF 16V X7R | 885012206052 | Capacitor_SMD:C_0603_1608Metric |  | /motherboard_power_entry/
C11066 | 100nF 100V X7R | GRM188R72A104KA35D | Capacitor_SMD:C_0603_1608Metric |  | /motherboard_power_entry/
C11067 | 1uF 16V X7R | 885012206052 | Capacitor_SMD:C_0603_1608Metric |  | /motherboard_power_entry/
C11068 | 10nF 100V C0G | C2012C0G2A103J125AA | Capacitor_SMD:C_0805_2012Metric |  | /motherboard_power_entry/
C11069 | 1uF 100V X7R | GRM31CR72A105KA01L | Capacitor_SMD:C_1206_3216Metric |  | /motherboard_power_entry/
C11070 | 1uF 100V X7R | GRM31CR72A105KA01L | Capacitor_SMD:C_1206_3216Metric |  | /motherboard_power_entry/
C11071 | 10nF 100V C0G | C2012C0G2A103J125AA | Capacitor_SMD:C_0805_2012Metric |  | /motherboard_power_entry/
C11072 | 1uF 100V X7R | GRM31CR72A105KA01L | Capacitor_SMD:C_1206_3216Metric |  | /motherboard_power_entry/
C11073 | 1uF 100V X7R | GRM31CR72A105KA01L | Capacitor_SMD:C_1206_3216Metric |  | /motherboard_power_entry/
C11074 | 2.2uF 100V X7S | CGA5L3X7S2A225K160AB | Capacitor_SMD:C_1206_3216Metric |  | /motherboard_power_entry/
C11075 | 22uF 10V X7R | GCM31CR71A226KE02L | Capacitor_SMD:C_1206_3216Metric |  | /motherboard_power_entry/
C11076 | 2.2uF 100V X7S | CGA5L3X7S2A225K160AB | Capacitor_SMD:C_1206_3216Metric |  | /motherboard_power_entry/
C11077 | 22uF 10V X7R | GCM31CR71A226KE02L | Capacitor_SMD:C_1206_3216Metric |  | /motherboard_power_entry/
C11078 | 100nF 100V X7R | GRM188R72A104KA35D | Capacitor_SMD:C_0603_1608Metric |  | /motherboard_power_entry/
C11079 | 100nF 100V X7R | GRM188R72A104KA35D | Capacitor_SMD:C_0603_1608Metric |  | /motherboard_power_entry/
C11080 | 100nF 100V X7R | GRM188R72A104KA35D | Capacitor_SMD:C_0603_1608Metric |  | /motherboard_power_entry/
C11081 | 100nF 100V X7R | GRM188R72A104KA35D | Capacitor_SMD:C_0603_1608Metric |  | /motherboard_power_entry/
C11082 | 1nF 5% C0G | C0603C102J5GACTU | Capacitor_SMD:C_0603_1608Metric |  | /motherboard_power_entry/
C11083 | 100nF 100V X7R | GRM188R72A104KA35D | Capacitor_SMD:C_0603_1608Metric |  | /motherboard_power_entry/
C11084 | 100nF 100V X7R | GRM188R72A104KA35D | Capacitor_SMD:C_0603_1608Metric |  | /motherboard_power_entry/
C11085 | 1nF 5% C0G | C0603C102J5GACTU | Capacitor_SMD:C_0603_1608Metric |  | /motherboard_power_entry/
C11086 | 100nF 100V X7R | GRM188R72A104KA35D | Capacitor_SMD:C_0603_1608Metric |  | /motherboard_power_entry/
C11087 | 100nF 100V X7R | GRM188R72A104KA35D | Capacitor_SMD:C_0603_1608Metric |  | /motherboard_power_entry/
C11088 | 330uF16V 20% polymer | 16SVPG330M | CNC_MB_Entry:OSCON_C10L_Panasonic |  | /motherboard_power_entry/
C11089 | 10nF100V X7R | GRM188R72A103KA01D | Capacitor_SMD:C_0603_1608Metric |  | /motherboard_power_entry/
C11090 | 10nF100V X7R | GRM188R72A103KA01D | Capacitor_SMD:C_0603_1608Metric |  | /motherboard_power_entry/
C11091 | 10nF100V X7R | GRM188R72A103KA01D | Capacitor_SMD:C_0603_1608Metric |  | /motherboard_power_entry/
C11092 | 2.2uF 100V X7S | CGA5L3X7S2A225K160AB | Capacitor_SMD:C_1206_3216Metric |  | /motherboard_power_entry/
C11093 | 22uF 10V X7R | GCM31CR71A226KE02L | Capacitor_SMD:C_1206_3216Metric |  | /motherboard_power_entry/
C11094 | 330uF16V 20% polymer | 16SVPG330M | CNC_MB_Entry:OSCON_C10L_Panasonic |  | /motherboard_power_entry/
C11095 | 1uF 50V X7R | C1608X7R1H105K080AB | Capacitor_SMD:C_0603_1608Metric |  | /motherboard_power_entry/
C13001 | 100nF100V | GRM188R72A104KA35D | Capacitor_SMD:C_0603_1608Metric |  | /motherboard_io_control/
C13002 | 100nF100V | GRM188R72A104KA35D | Capacitor_SMD:C_0603_1608Metric |  | /motherboard_io_control/
C13003 | 4700nF10V | GRM21BR71A475KE51K | Capacitor_SMD:C_0805_2012Metric |  | /motherboard_io_control/
C13004 | 100nF100V | GRM188R72A104KA35D | Capacitor_SMD:C_0603_1608Metric |  | /motherboard_io_control/
C13005 | 1000nF50V | GRM188R71H105KA12D | Capacitor_SMD:C_0603_1608Metric |  | /motherboard_io_control/
C13006 | 100nF100V | GRM188R72A104KA35D | Capacitor_SMD:C_0603_1608Metric |  | /motherboard_io_control/
C13007 | 100nF100V | GRM188R72A104KA35D | Capacitor_SMD:C_0603_1608Metric |  | /motherboard_io_control/
C13008 | 100nF100V | GRM188R72A104KA35D | Capacitor_SMD:C_0603_1608Metric |  | /motherboard_io_control/
C13009 | 100nF100V | GRM188R72A104KA35D | Capacitor_SMD:C_0603_1608Metric |  | /motherboard_io_control/
C13010 | 4700nF10V | GRM21BR71A475KE51K | Capacitor_SMD:C_0805_2012Metric |  | /motherboard_io_control/
C13011 | 100nF100V | GRM188R72A104KA35D | Capacitor_SMD:C_0603_1608Metric |  | /motherboard_io_control/
C13012 | 100nF100V | GRM188R72A104KA35D | Capacitor_SMD:C_0603_1608Metric |  | /motherboard_io_control/
C13013 | 100nF100V | GRM188R72A104KA35D | Capacitor_SMD:C_0603_1608Metric |  | /motherboard_io_control/
C13014 | 100nF100V | GRM188R72A104KA35D | Capacitor_SMD:C_0603_1608Metric |  | /motherboard_io_control/
C13015 | 100nF100V | GRM188R72A104KA35D | Capacitor_SMD:C_0603_1608Metric |  | /motherboard_io_control/
C13016 | 4700nF10V | GRM21BR71A475KE51K | Capacitor_SMD:C_0805_2012Metric |  | /motherboard_io_control/
C13017 | 100nF100V | GRM188R72A104KA35D | Capacitor_SMD:C_0603_1608Metric |  | /motherboard_io_control/
C13018 | 100nF100V | GRM188R72A104KA35D | Capacitor_SMD:C_0603_1608Metric |  | /motherboard_io_control/
C13019 | 100nF100V | GRM188R72A104KA35D | Capacitor_SMD:C_0603_1608Metric |  | /motherboard_io_control/
C14001 | 10nF100V | GRM1885C2A103JA01D | Capacitor_SMD:C_0603_1608Metric |  | /motherboard_operator/
C14002 | 10nF100V | GRM1885C2A103JA01D | Capacitor_SMD:C_0603_1608Metric |  | /motherboard_operator/
C14003 | 10nF100V | GRM1885C2A103JA01D | Capacitor_SMD:C_0603_1608Metric |  | /motherboard_operator/
C14004 | 10nF100V | GRM1885C2A103JA01D | Capacitor_SMD:C_0603_1608Metric |  | /motherboard_operator/
C14005 | 10nF100V | GRM1885C2A103JA01D | Capacitor_SMD:C_0603_1608Metric |  | /motherboard_operator/
C14006 | 10nF100V | GRM1885C2A103JA01D | Capacitor_SMD:C_0603_1608Metric |  | /motherboard_operator/
C14007 | 100nF100V | GRM188R72A104KA35D | Capacitor_SMD:C_0603_1608Metric |  | /motherboard_operator/
C14008 | 10nF100V | GRM1885C2A103JA01D | Capacitor_SMD:C_0603_1608Metric |  | /motherboard_operator/
C14009 | 10nF100V | GRM1885C2A103JA01D | Capacitor_SMD:C_0603_1608Metric |  | /motherboard_operator/
C14010 | 10nF100V | GRM1885C2A103JA01D | Capacitor_SMD:C_0603_1608Metric |  | /motherboard_operator/
C14011 | 10nF100V | GRM1885C2A103JA01D | Capacitor_SMD:C_0603_1608Metric |  | /motherboard_operator/
C14012 | 10nF100V | GRM1885C2A103JA01D | Capacitor_SMD:C_0603_1608Metric |  | /motherboard_operator/
C14013 | 10nF100V | GRM1885C2A103JA01D | Capacitor_SMD:C_0603_1608Metric |  | /motherboard_operator/
C14014 | 100nF100V | GRM188R72A104KA35D | Capacitor_SMD:C_0603_1608Metric |  | /motherboard_operator/
C14015 | 100nF100V | GRM188R72A104KA35D | Capacitor_SMD:C_0603_1608Metric |  | /motherboard_operator/
C14016 | 100nF100V | GRM188R72A104KA35D | Capacitor_SMD:C_0603_1608Metric |  | /motherboard_operator/
C14017 | 100nF100V | GRM188R72A104KA35D | Capacitor_SMD:C_0603_1608Metric |  | /motherboard_operator/
C14018 | 100nF100V | GRM188R72A104KA35D | Capacitor_SMD:C_0603_1608Metric |  | /motherboard_operator/
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
C19028 | 100nF100V | GRM188R72A104KA35D | Capacitor_SMD:C_0603_1608Metric |  | /motherboard_safety_sensor/
C19029 | 100nF100V | GRM188R72A104KA35D | Capacitor_SMD:C_0603_1608Metric |  | /motherboard_safety_sensor/
C19030 | 100nF100V | GRM188R72A104KA35D | Capacitor_SMD:C_0603_1608Metric |  | /motherboard_safety_sensor/
C19031 | 100nF100V | GRM188R72A104KA35D | Capacitor_SMD:C_0603_1608Metric |  | /motherboard_safety_sensor/
C19032 | 100nF100V | GRM188R72A104KA35D | Capacitor_SMD:C_0603_1608Metric |  | /motherboard_safety_sensor/
C19033 | 100nF100V | GRM188R72A104KA35D | Capacitor_SMD:C_0603_1608Metric |  | /motherboard_safety_sensor/
C19034 | 100nF100V | GRM188R72A104KA35D | Capacitor_SMD:C_0603_1608Metric |  | /motherboard_safety_sensor/
C19035 | 100nF100V | GRM188R72A104KA35D | Capacitor_SMD:C_0603_1608Metric |  | /motherboard_safety_sensor/
C19036 | 100nF100V | GRM188R72A104KA35D | Capacitor_SMD:C_0603_1608Metric |  | /motherboard_safety_sensor/
C19037 | 100nF100V | GRM188R72A104KA35D | Capacitor_SMD:C_0603_1608Metric |  | /motherboard_safety_sensor/
C19038 | 100nF100V | GRM188R72A104KA35D | Capacitor_SMD:C_0603_1608Metric |  | /motherboard_safety_sensor/
C19039 | 100nF100V | GRM188R72A104KA35D | Capacitor_SMD:C_0603_1608Metric |  | /motherboard_safety_sensor/
C19040 | 100nF100V | GRM188R72A104KA35D | Capacitor_SMD:C_0603_1608Metric |  | /motherboard_safety_sensor/
C19041 | 100nF100V | GRM188R72A104KA35D | Capacitor_SMD:C_0603_1608Metric |  | /motherboard_safety_sensor/
C19042 | 100nF100V | GRM188R72A104KA35D | Capacitor_SMD:C_0603_1608Metric |  | /motherboard_safety_sensor/
C19043 | 100nF100V | GRM188R72A104KA35D | Capacitor_SMD:C_0603_1608Metric |  | /motherboard_safety_sensor/
C19044 | 2.2uF 100V X7S | CGA5L3X7S2A225K160AB | Capacitor_SMD:C_1206_3216Metric |  | /motherboard_safety_sensor/
C19045 | 2.2uF 100V X7S | CGA5L3X7S2A225K160AB | Capacitor_SMD:C_1206_3216Metric |  | /motherboard_safety_sensor/
C19046 | 2.2uF 100V X7S | CGA5L3X7S2A225K160AB | Capacitor_SMD:C_1206_3216Metric |  | /motherboard_safety_sensor/
C19047 | 2.2uF 100V X7S | CGA5L3X7S2A225K160AB | Capacitor_SMD:C_1206_3216Metric |  | /motherboard_safety_sensor/
C19048 | 100nF 100V X7R | GRM188R72A104KA35D | Capacitor_SMD:C_0603_1608Metric |  | /motherboard_safety_sensor/
C19049 | 100nF 16V X7R | GCM155R71C104KA55D | Capacitor_SMD:C_0402_1005Metric |  | /motherboard_safety_sensor/
C19050 | 1uF 16V X7R | 885012206052 | Capacitor_SMD:C_0603_1608Metric |  | /motherboard_safety_sensor/
C19051 | 22uF 10V X7R | GCM31CR71A226KE02L | Capacitor_SMD:C_1206_3216Metric |  | /motherboard_safety_sensor/
C19052 | 22uF 10V X7R | GCM31CR71A226KE02L | Capacitor_SMD:C_1206_3216Metric |  | /motherboard_safety_sensor/
C19053 | 100nF 16V X7R | GCM155R71C104KA55D | Capacitor_SMD:C_0402_1005Metric |  | /motherboard_safety_sensor/
C19501 | 4.7nF 20% X1/Y2 HF coupling | VY2472M49Y5US63V7 | Capacitor_THT:C_Disc_D12.5mm_W5.0mm_P7.50mm |  | /motherboard_terminals/
C19502 | 4.7nF 20% X1/Y2 HF coupling | VY2472M49Y5US63V7 | Capacitor_THT:C_Disc_D12.5mm_W5.0mm_P7.50mm |  | /motherboard_terminals/
C19503 | 4.7nF 20% X1/Y2 HF coupling | VY2472M49Y5US63V7 | Capacitor_THT:C_Disc_D12.5mm_W5.0mm_P7.50mm |  | /motherboard_terminals/
C19504 | 4.7nF 20% X1/Y2 HF coupling | VY2472M49Y5US63V7 | Capacitor_THT:C_Disc_D12.5mm_W5.0mm_P7.50mm |  | /motherboard_terminals/
C19505 | 4.7nF 20% X1/Y2 HF coupling | VY2472M49Y5US63V7 | Capacitor_THT:C_Disc_D12.5mm_W5.0mm_P7.50mm |  | /motherboard_terminals/
C19506 | 4.7nF 20% X1/Y2 HF coupling | VY2472M49Y5US63V7 | Capacitor_THT:C_Disc_D12.5mm_W5.0mm_P7.50mm |  | /motherboard_terminals/
C19507 | 4.7nF 20% X1/Y2 HF coupling | VY2472M49Y5US63V7 | Capacitor_THT:C_Disc_D12.5mm_W5.0mm_P7.50mm |  | /motherboard_terminals/
C19508 | 4.7nF 20% X1/Y2 HF coupling | VY2472M49Y5US63V7 | Capacitor_THT:C_Disc_D12.5mm_W5.0mm_P7.50mm |  | /motherboard_terminals/
C19509 | 4.7nF 20% X1/Y2 HF coupling | VY2472M49Y5US63V7 | Capacitor_THT:C_Disc_D12.5mm_W5.0mm_P7.50mm |  | /motherboard_terminals/
C2001 | 10uF 25V X7R 10% | C3216X7R1E106K160AB | Capacitor_SMD:C_1206_3216Metric |  | /mc_local_power/
C2002 | 22uF 10V X7S 20% | C2012X7S1A226M125AC | Capacitor_SMD:C_0805_2012Metric |  | /mc_local_power/
C2003 | 6.8nF 50V C0G 5% | GRM1885C1H682JA01D | Capacitor_SMD:C_0603_1608Metric |  | /mc_local_power/
C2004 | 10uF 25V X7R 10% | C3216X7R1E106K160AB | Capacitor_SMD:C_1206_3216Metric |  | /mc_local_power/
C2005 | 22uF 10V X7S 20% | C2012X7S1A226M125AC | Capacitor_SMD:C_0805_2012Metric |  | /mc_local_power/
C2006 | 6.8nF 50V C0G 5% | GRM1885C1H682JA01D | Capacitor_SMD:C_0603_1608Metric |  | /mc_local_power/
C2007 | 100nF X7R 100V 10% | GRM188R72A104KA35D | Capacitor_SMD:C_0603_1608Metric |  | /mc_local_power/
C2008 | 100nF X7R 100V 10% | GRM188R72A104KA35D | Capacitor_SMD:C_0603_1608Metric |  | /mc_local_power/
C2009 | 100nF X7R 100V 10% | GRM188R72A104KA35D | Capacitor_SMD:C_0603_1608Metric |  | /mc_local_power/
C2010 | 100nF X7R 100V 10% | GRM188R72A104KA35D | Capacitor_SMD:C_0603_1608Metric |  | /mc_local_power/
C21001 | 100nF100V | GRM188R72A104KA35D | Capacitor_SMD:C_0603_1608Metric |  | /motherboard_identity_io/
C21002 | 100nF100V | GRM188R72A104KA35D | Capacitor_SMD:C_0603_1608Metric |  | /motherboard_identity_io/
C21003 | 100nF100V | GRM188R72A104KA35D | Capacitor_SMD:C_0603_1608Metric |  | /motherboard_identity_io/
C22001 | GRM188R72A104KA35D | GRM188R72A104KA35D | Capacitor_SMD:C_0603_1608Metric |  | /motherboard_diagnostics/
C22002 | GRM188R72A104KA35D | GRM188R72A104KA35D | Capacitor_SMD:C_0603_1608Metric |  | /motherboard_diagnostics/
C22003 | GRM188R72A104KA35D | GRM188R72A104KA35D | Capacitor_SMD:C_0603_1608Metric |  | /motherboard_diagnostics/
C22004 | GRM188R72A104KA35D | GRM188R72A104KA35D | Capacitor_SMD:C_0603_1608Metric |  | /motherboard_diagnostics/
C22005 | GRM188R72A104KA35D | GRM188R72A104KA35D | Capacitor_SMD:C_0603_1608Metric |  | /motherboard_diagnostics/
C3001 | 3.3nF C0G 50V 5% | CL10C332JB8NNNC | Capacitor_SMD:C_0603_1608Metric |  | /watchdog_conditioning/
C3002 | 3.3nF C0G 50V 5% | CL10C332JB8NNNC | Capacitor_SMD:C_0603_1608Metric |  | /watchdog_conditioning/
C3003 | 100nF X7R 100V 10% | GRM188R72A104KA35D | Capacitor_SMD:C_0603_1608Metric |  | /watchdog_conditioning/
C3004 | 100nF X7R 100V 10% | GRM188R72A104KA35D | Capacitor_SMD:C_0603_1608Metric |  | /watchdog_conditioning/
C3005 | 100nF X7R 100V 10% | GRM188R72A104KA35D | Capacitor_SMD:C_0603_1608Metric |  | /watchdog_conditioning/
C3006 | 100nF X7R 100V 10% | GRM188R72A104KA35D | Capacitor_SMD:C_0603_1608Metric |  | /watchdog_conditioning/
C3007 | 100nF X7R 100V 10% | GRM188R72A104KA35D | Capacitor_SMD:C_0603_1608Metric |  | /watchdog_conditioning/
C3008 | 100nF X7R 100V 10% | GRM188R72A104KA35D | Capacitor_SMD:C_0603_1608Metric |  | /watchdog_conditioning/
C3009 | 100nF X7R 100V 10% | GRM188R72A104KA35D | Capacitor_SMD:C_0603_1608Metric |  | /watchdog_conditioning/
C4001 | 100nF X7R 100V 10% | GRM188R72A104KA35D | Capacitor_SMD:C_0603_1608Metric |  | /mc_permission/
C4002 | 100nF X7R 100V 10% | GRM188R72A104KA35D | Capacitor_SMD:C_0603_1608Metric |  | /mc_permission/
C4003 | 100nF X7R 100V 10% | GRM188R72A104KA35D | Capacitor_SMD:C_0603_1608Metric |  | /mc_permission/
C4004 | 100nF X7R 100V 10% | GRM188R72A104KA35D | Capacitor_SMD:C_0603_1608Metric |  | /mc_permission/
C4005 | 100nF X7R 100V 10% | GRM188R72A104KA35D | Capacitor_SMD:C_0603_1608Metric |  | /mc_permission/
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
C8104 | 100nF 25V X7R | 06033C104JAT2A | Capacitor_SMD:C_0603_1608Metric |  | /motherboard_di/
C8105 | 100nF 25V X7R | 06033C104JAT2A | Capacitor_SMD:C_0603_1608Metric |  | /motherboard_di/
C8106 | 100nF 25V X7R | 06033C104JAT2A | Capacitor_SMD:C_0603_1608Metric |  | /motherboard_di/
C8107 | 100nF 25V X7R | 06033C104JAT2A | Capacitor_SMD:C_0603_1608Metric |  | /motherboard_di/
C8108 | 100nF 25V X7R | 06033C104JAT2A | Capacitor_SMD:C_0603_1608Metric |  | /motherboard_di/
C8109 | 100nF 25V X7R | 06033C104JAT2A | Capacitor_SMD:C_0603_1608Metric |  | /motherboard_di/
C8110 | 100nF 25V X7R | 06033C104JAT2A | Capacitor_SMD:C_0603_1608Metric |  | /motherboard_di/
C8111 | 100nF 25V X7R | 06033C104JAT2A | Capacitor_SMD:C_0603_1608Metric |  | /motherboard_di/
C8112 | 100nF 25V X7R | 06033C104JAT2A | Capacitor_SMD:C_0603_1608Metric |  | /motherboard_di/
C9001 | 100nF 100V X7R 10% | GRM188R72A104KA35D | Capacitor_SMD:C_0603_1608Metric |  | /motherboard_motor_power/
C9002 | 100nF 100V X7R 10% | GRM188R72A104KA35D | Capacitor_SMD:C_0603_1608Metric |  | /motherboard_motor_power/
C9003 | 100nF 100V X7R 10% | GRM188R72A104KA35D | Capacitor_SMD:C_0603_1608Metric |  | /motherboard_motor_power/
C9004 | 100nF 100V X7R 10% | GRM188R72A104KA35D | Capacitor_SMD:C_0603_1608Metric |  | /motherboard_motor_power/
C9005 | 100nF 100V X7R 10% | GRM188R72A104KA35D | Capacitor_SMD:C_0603_1608Metric |  | /motherboard_motor_power/
C9006 | 100nF 100V X7R 10% | GRM188R72A104KA35D | Capacitor_SMD:C_0603_1608Metric |  | /motherboard_motor_power/
C9007 | 100nF 100V X7R 10% | GRM188R72A104KA35D | Capacitor_SMD:C_0603_1608Metric |  | /motherboard_motor_power/
C9008 | 100nF 100V X7R 10% | GRM188R72A104KA35D | Capacitor_SMD:C_0603_1608Metric |  | /motherboard_motor_power/
C9009 | 100nF 100V X7R 10% | GRM188R72A104KA35D | Capacitor_SMD:C_0603_1608Metric |  | /motherboard_motor_power/
D11001 | SMCJ30CA | SMCJ30CA | Diode_SMD:D_SMC |  | /motherboard_power_entry/
D11002 | SMCJ30CA | SMCJ30CA | Diode_SMD:D_SMC |  | /motherboard_power_entry/
D11003 | SMCJ30CA | SMCJ30CA | Diode_SMD:D_SMC |  | /motherboard_power_entry/
D11004 | 1N4148W-7-F | 1N4148W-7-F | Diode_SMD:D_SOD-123 |  | /motherboard_power_entry/
D11005 | 1N4148W-7-F | 1N4148W-7-F | Diode_SMD:D_SOD-123 |  | /motherboard_power_entry/
D11006 | 1N4148W-7-F | 1N4148W-7-F | Diode_SMD:D_SOD-123 |  | /motherboard_power_entry/
D11007 | STPS3H100U | STPS3H100U | CNC_MB_Entry_Clamp:D_STPS3H100U_SMB_ST_DS6597 | https://www.st.com/resource/en/datasheet/stps3h100.pdf | /motherboard_power_entry/
D11008 | STPS3H100U | STPS3H100U | CNC_MB_Entry_Clamp:D_STPS3H100U_SMB_ST_DS6597 | https://www.st.com/resource/en/datasheet/stps3h100.pdf | /motherboard_power_entry/
D11009 | STPS3H100U | STPS3H100U | CNC_MB_Entry_Clamp:D_STPS3H100U_SMB_ST_DS6597 | https://www.st.com/resource/en/datasheet/stps3h100.pdf | /motherboard_power_entry/
D14001 | TPD1E10B06DPYR | TPD1E10B06DPYR | CNC_MB_Operator:TPD1E10B06_DPY2_TI |  | /motherboard_operator/
D14002 | TPD1E10B06DPYR | TPD1E10B06DPYR | CNC_MB_Operator:TPD1E10B06_DPY2_TI |  | /motherboard_operator/
D14003 | TPD1E10B06DPYR | TPD1E10B06DPYR | CNC_MB_Operator:TPD1E10B06_DPY2_TI |  | /motherboard_operator/
D14004 | TPD1E10B06DPYR | TPD1E10B06DPYR | CNC_MB_Operator:TPD1E10B06_DPY2_TI |  | /motherboard_operator/
D14005 | TPD1E10B06DPYR | TPD1E10B06DPYR | CNC_MB_Operator:TPD1E10B06_DPY2_TI |  | /motherboard_operator/
D14006 | TPD1E10B06DPYR | TPD1E10B06DPYR | CNC_MB_Operator:TPD1E10B06_DPY2_TI |  | /motherboard_operator/
D14007 | TPD1E10B06DPYR | TPD1E10B06DPYR | CNC_MB_Operator:TPD1E10B06_DPY2_TI |  | /motherboard_operator/
D14008 | TPD1E10B06DPYR | TPD1E10B06DPYR | CNC_MB_Operator:TPD1E10B06_DPY2_TI |  | /motherboard_operator/
D14009 | TPD1E10B06DPYR | TPD1E10B06DPYR | CNC_MB_Operator:TPD1E10B06_DPY2_TI |  | /motherboard_operator/
D14010 | TPD1E10B06DPYR | TPD1E10B06DPYR | CNC_MB_Operator:TPD1E10B06_DPY2_TI |  | /motherboard_operator/
D14011 | TPD1E10B06DPYR | TPD1E10B06DPYR | CNC_MB_Operator:TPD1E10B06_DPY2_TI |  | /motherboard_operator/
D14012 | TPD1E10B06DPYR | TPD1E10B06DPYR | CNC_MB_Operator:TPD1E10B06_DPY2_TI |  | /motherboard_operator/
D14013 | SMBJ33CA-E3/52 | SMBJ33CA-E3/52 | Diode_SMD:D_SMB |  | /motherboard_operator/
D14014 | SMBJ33CA-E3/52 | SMBJ33CA-E3/52 | Diode_SMD:D_SMB |  | /motherboard_operator/
D14401 | TPD1E10B06DPYR | TPD1E10B06DPYR | CNC_MB_Process:TPD1E10B06_DPY2_TI |  | /motherboard_process/
D14402 | TPD1E10B06DPYR | TPD1E10B06DPYR | CNC_MB_Process:TPD1E10B06_DPY2_TI |  | /motherboard_process/
D14403 | SMBJ33CA-E3/52 | SMBJ33CA-E3/52 | Diode_SMD:D_SMB |  | /motherboard_process/
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
FIDF1 | Fiducial | PCB_FIDUCIAL_1MM | Fiducial:Fiducial_1mm_Mask2mm |  | /motherboard_terminals/
FIDF2 | Fiducial | PCB_FIDUCIAL_1MM | Fiducial:Fiducial_1mm_Mask2mm |  | /motherboard_terminals/
FIDF3 | Fiducial | PCB_FIDUCIAL_1MM | Fiducial:Fiducial_1mm_Mask2mm |  | /motherboard_terminals/
H19501 | XPE1 / M4 chassis bond |  | MountingHole:MountingHole_4.3mm_M4_Pad |  | /motherboard_terminals/
H22001 | bare3.2mm NPTH M3 mechanical mount; no electrical pin/net |  | MountingHole:MountingHole_3.2mm_M3 |  | /motherboard_diagnostics/
H22002 | bare3.2mm NPTH M3 mechanical mount; no electrical pin/net |  | MountingHole:MountingHole_3.2mm_M3 |  | /motherboard_diagnostics/
H22003 | bare3.2mm NPTH M3 mechanical mount; no electrical pin/net |  | MountingHole:MountingHole_3.2mm_M3 |  | /motherboard_diagnostics/
H22004 | bare3.2mm NPTH M3 mechanical mount; no electrical pin/net |  | MountingHole:MountingHole_3.2mm_M3 |  | /motherboard_diagnostics/
H22005 | bare3.2mm NPTH M3 mechanical mount; no electrical pin/net |  | MountingHole:MountingHole_3.2mm_M3 |  | /motherboard_diagnostics/
H22006 | bare3.2mm NPTH M3 mechanical mount; no electrical pin/net |  | MountingHole:MountingHole_3.2mm_M3 |  | /motherboard_diagnostics/
J1002 | JTAG SERVICE / NO POWER INJECTION | TC2050-IDC-NL cable land (no fitted part) | CNC_MB_Service:JTAG_TC2050-IDC-NL_J1002 |  | /fpga_core/
J11001 | 1757242 | 1757242 | Connector_Phoenix_MSTB:PhoenixContact_MSTBA_2,5_2-G-5,08_1x02_P5.08mm_Horizontal |  | /motherboard_power_entry/
J11002 | 1803277 | 1803277 | Connector_Phoenix_MC:PhoenixContact_MC_1,5_2-G-3.81_1x02_P3.81mm_Horizontal |  | /motherboard_power_entry/
J11003 | 1757242 | 1757242 | Connector_Phoenix_MSTB:PhoenixContact_MSTBA_2,5_2-G-5,08_1x02_P5.08mm_Horizontal |  | /motherboard_power_entry/
J11004 | 1803277 | 1803277 | Connector_Phoenix_MC:PhoenixContact_MC_1,5_2-G-3.81_1x02_P3.81mm_Horizontal |  | /motherboard_power_entry/
J11005 | 1757242 | 1757242 | Connector_Phoenix_MSTB:PhoenixContact_MSTBA_2,5_2-G-5,08_1x02_P5.08mm_Horizontal |  | /motherboard_power_entry/
J11006 | 1803277 | 1803277 | Connector_Phoenix_MC:PhoenixContact_MC_1,5_2-G-3.81_1x02_P3.81mm_Horizontal |  | /motherboard_power_entry/
J15001 | 10164227-1001A1RLF | 10164227-1001A1RLF | CNC_COMPUTE:Amphenol_10164227_1001_CM_A |  | /motherboard_compute/
J15002 | 10164227-1001A1RLF | 10164227-1001A1RLF | CNC_COMPUTE:Amphenol_10164227_1001_CM_B |  | /motherboard_compute/
J15003 | 503398-1892 | 503398-1892 | CNC_COMPUTE:Molex_503398-1892_SD |  | /motherboard_compute/
J15004 | 690-019-298-412 | 690-019-298-412 | CNC_COMPUTE:EDAC_690-019-298-412_HDMI |  | /motherboard_compute/
J15005 | 614004134726 | 614004134726 | CNC_COMPUTE:Wurth_614004134726_USB_A |  | /motherboard_compute/
J15006 | USB4105-GF-A | USB4105-GF-A | CNC_COMPUTE:GCT_USB4105_GF_A_USB_C |  | /motherboard_compute/
J15007 | 7499111446 | 7499111446 | CNC_COMPUTE:Wurth_7499111446_Gigabit |  | /motherboard_compute/
J16001 | 61302211821 | 61302211821 | CNC_MB_ESP:Wurth_61302211821_1x22_P2.54 |  | /motherboard_esp_socket/
J16002 | 61302211821 | 61302211821 | CNC_MB_ESP:Wurth_61302211821_1x22_P2.54 |  | /motherboard_esp_socket/
JD01 | MCD 1,5/14-G1-3,81 (1843198) | 1843198 | CNC_DenseTerminals:PhoenixContact_MCD_1,5_14-G1-3.81_2x14_P3.81mm_Horizontal |  | /motherboard_terminals/
JD02 | MCD 1,5/14-G1-3,81 (1843198) | 1843198 | CNC_DenseTerminals:PhoenixContact_MCD_1,5_14-G1-3.81_2x14_P3.81mm_Horizontal |  | /motherboard_terminals/
JD03 | MCD 1,5/14-G1-3,81 (1843198) | 1843198 | CNC_DenseTerminals:PhoenixContact_MCD_1,5_14-G1-3.81_2x14_P3.81mm_Horizontal |  | /motherboard_terminals/
JD04 | MCD 1,5/14-G1-3,81 (1843198) | 1843198 | CNC_DenseTerminals:PhoenixContact_MCD_1,5_14-G1-3.81_2x14_P3.81mm_Horizontal |  | /motherboard_terminals/
JD05 | MCD 1,5/14-G1-3,81 (1843198) | 1843198 | CNC_DenseTerminals:PhoenixContact_MCD_1,5_14-G1-3.81_2x14_P3.81mm_Horizontal |  | /motherboard_terminals/
JD06 | MCD 1,5/14-G1-3,81 (1843198) | 1843198 | CNC_DenseTerminals:PhoenixContact_MCD_1,5_14-G1-3.81_2x14_P3.81mm_Horizontal |  | /motherboard_terminals/
JD07 | MCD 1,5/12-G1-3,81 (1843172) | 1843172 | CNC_DenseTerminals:PhoenixContact_MCD_1,5_12-G1-3.81_2x12_P3.81mm_Horizontal |  | /motherboard_terminals/
JD08 | MCD 1,5/12-G1-3,81 (1843172) | 1843172 | CNC_DenseTerminals:PhoenixContact_MCD_1,5_12-G1-3.81_2x12_P3.81mm_Horizontal |  | /motherboard_terminals/
JD09 | MCD 1,5/12-G1-3,81 (1843172) | 1843172 | CNC_DenseTerminals:PhoenixContact_MCD_1,5_12-G1-3.81_2x12_P3.81mm_Horizontal |  | /motherboard_terminals/
JD10 | MCD 1,5/12-G1-3,81 (1843172) | 1843172 | CNC_DenseTerminals:PhoenixContact_MCD_1,5_12-G1-3.81_2x12_P3.81mm_Horizontal |  | /motherboard_terminals/
JD11 | MCD 1,5/10-G1-3,81 (1843156) | 1843156 | CNC_DenseTerminals:PhoenixContact_MCD_1,5_10-G1-3.81_2x10_P3.81mm_Horizontal |  | /motherboard_terminals/
JD12 | MCD 1,5/10-G1-3,81 (1843156) | 1843156 | CNC_DenseTerminals:PhoenixContact_MCD_1,5_10-G1-3.81_2x10_P3.81mm_Horizontal |  | /motherboard_terminals/
JD13 | MCD 1,5/10-G1-3,81 (1843156) | 1843156 | CNC_DenseTerminals:PhoenixContact_MCD_1,5_10-G1-3.81_2x10_P3.81mm_Horizontal |  | /motherboard_terminals/
JD14 | MCD 1,5/6-G1-3,81 (1843114) | 1843114 | CNC_DenseTerminals:PhoenixContact_MCD_1,5_6-G1-3.81_2x06_P3.81mm_Horizontal |  | /motherboard_terminals/
JD15 | MCD 1,5/6-G1-3,81 (1843114) | 1843114 | CNC_DenseTerminals:PhoenixContact_MCD_1,5_6-G1-3.81_2x06_P3.81mm_Horizontal |  | /motherboard_terminals/
JD16 | MCD 1,5/3-G1-3,81 (1843088) | 1843088 | CNC_DenseTerminals:PhoenixContact_MCD_1,5_3-G1-3.81_2x03_P3.81mm_Horizontal |  | /motherboard_terminals/
JD17 | MCD 1,5/2-G1-3,81 (1843075) | 1843075 | CNC_DenseTerminals:PhoenixContact_MCD_1,5_2-G1-3.81_2x02_P3.81mm_Horizontal |  | /motherboard_terminals/
L11001 | 6.8uH 20% | XAL1010-682MED | CNC_MB_Entry:XAL1010_Coilcraft |  | /motherboard_power_entry/
L11002 | 4.7uH 20% | XAL7070-472MEC | Inductor_SMD:L_Coilcraft_XAL7070-XXX |  | /motherboard_power_entry/
L11003 | 22uH / 20% | LPS6235-223MRC | CNC_MB_Entry:LPS6235_Coilcraft |  | /motherboard_power_entry/
L19001 | 22uH / 20% | LPS6235-223MRC | CNC_MB_Safety:LPS6235_Coilcraft |  | /motherboard_safety_sensor/
L2001 | 2.2uH | XGL4020-222MEC | CNC_MC_Power:XGL4020 |  | /mc_local_power/
L2002 | 1uH | XGL4020-102MEC | CNC_MC_Power:XGL4020 |  | /mc_local_power/
Q11001 | BSS138P,215 | BSS138P,215 | Package_TO_SOT_SMD:SOT-23 |  | /motherboard_power_entry/
Q11002 | BSS138P,215 | BSS138P,215 | Package_TO_SOT_SMD:SOT-23 |  | /motherboard_power_entry/
Q11003 | BSS138P,215 | BSS138P,215 | Package_TO_SOT_SMD:SOT-23 |  | /motherboard_power_entry/
R10001 | 10000R 1% | CRCW060310K0FKEA | Resistor_SMD:R_0603_1608Metric |  | /motherboard_do/
R10002 | 10000R 1% | CRCW060310K0FKEA | Resistor_SMD:R_0603_1608Metric |  | /motherboard_do/
R10003 | 10000R 1% | CRCW060310K0FKEA | Resistor_SMD:R_0603_1608Metric |  | /motherboard_do/
R10004 | 10000R 1% | CRCW060310K0FKEA | Resistor_SMD:R_0603_1608Metric |  | /motherboard_do/
R10005 | 10000R 1% | CRCW060310K0FKEA | Resistor_SMD:R_0603_1608Metric |  | /motherboard_do/
R10006 | 10000R 1% | CRCW060310K0FKEA | Resistor_SMD:R_0603_1608Metric |  | /motherboard_do/
R10007 | 10000R 1% | CRCW060310K0FKEA | Resistor_SMD:R_0603_1608Metric |  | /motherboard_do/
R10008 | 10000R 1% | CRCW060310K0FKEA | Resistor_SMD:R_0603_1608Metric |  | /motherboard_do/
R10009 | 10000R 1% | CRCW060310K0FKEA | Resistor_SMD:R_0603_1608Metric |  | /motherboard_do/
R1001 | 33R 1% | CRCW060333R0FKEA | Resistor_SMD:R_0603_1608Metric |  | /fpga_core/
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
R1017 | 10000R 1% | CRCW060310K0FKEA | Resistor_SMD:R_0603_1608Metric |  | /fpga_core/
R1018 | 10000R 1% | CRCW060310K0FKEA | Resistor_SMD:R_0603_1608Metric |  | /fpga_core/
R1019 | 10000R 1% | CRCW060310K0FKEA | Resistor_SMD:R_0603_1608Metric |  | /fpga_core/
R1020 | 47000R 1% | CRCW060347K0FKEA | Resistor_SMD:R_0603_1608Metric |  | /fpga_core/
R1021 | 1000R 1% | CRCW06031K00FKEA | Resistor_SMD:R_0603_1608Metric |  | /fpga_core/
R1022 | 10000R 1% | CRCW060310K0FKEA | Resistor_SMD:R_0603_1608Metric |  | /fpga_core/
R1023 | 10000R 1% | CRCW060310K0FKEA | Resistor_SMD:R_0603_1608Metric |  | /fpga_core/
R1024 | 10000R 1% | CRCW060310K0FKEA | Resistor_SMD:R_0603_1608Metric |  | /fpga_core/
R1025 | 10000R 1% | CRCW060310K0FKEA | Resistor_SMD:R_0603_1608Metric |  | /fpga_core/
R11001 | 887000R 0.1% | TNPW0805887KBEEA | Resistor_SMD:R_0805_2012Metric |  | /motherboard_power_entry/
R11002 | 29400R 0.1% | TNPW060329K4BEEA | Resistor_SMD:R_0603_1608Metric |  | /motherboard_power_entry/
R11003 | 34000R 0.1% | TNPW060334K0BEEA | Resistor_SMD:R_0603_1608Metric |  | /motherboard_power_entry/
R11004 | 4020R 0.1% | TNPW06034K02BEEA | Resistor_SMD:R_0603_1608Metric |  | /motherboard_power_entry/
R11005 | 140000R 0.1% | TNPW0603140KBEEA | Resistor_SMD:R_0603_1608Metric |  | /motherboard_power_entry/
R11006 | 10000R 0.1% | TNPW060310K0BEEA | Resistor_SMD:R_0603_1608Metric |  | /motherboard_power_entry/
R11007 | 10000R 0.1% | TNPW060310K0BEEA | Resistor_SMD:R_0603_1608Metric |  | /motherboard_power_entry/
R11008 | 887000R 0.1% | TNPW0805887KBEEA | Resistor_SMD:R_0805_2012Metric |  | /motherboard_power_entry/
R11009 | 29400R 0.1% | TNPW060329K4BEEA | Resistor_SMD:R_0603_1608Metric |  | /motherboard_power_entry/
R11010 | 34000R 0.1% | TNPW060334K0BEEA | Resistor_SMD:R_0603_1608Metric |  | /motherboard_power_entry/
R11011 | 3000R 0.1% | TNPW06033K00BEEA | Resistor_SMD:R_0603_1608Metric |  | /motherboard_power_entry/
R11012 | 140000R 0.1% | TNPW0603140KBEEA | Resistor_SMD:R_0603_1608Metric |  | /motherboard_power_entry/
R11013 | 10000R 0.1% | TNPW060310K0BEEA | Resistor_SMD:R_0603_1608Metric |  | /motherboard_power_entry/
R11014 | 10000R 0.1% | TNPW060310K0BEEA | Resistor_SMD:R_0603_1608Metric |  | /motherboard_power_entry/
R11015 | 887000R 0.1% | TNPW0805887KBEEA | Resistor_SMD:R_0805_2012Metric |  | /motherboard_power_entry/
R11016 | 29400R 0.1% | TNPW060329K4BEEA | Resistor_SMD:R_0603_1608Metric |  | /motherboard_power_entry/
R11017 | 34000R 0.1% | TNPW060334K0BEEA | Resistor_SMD:R_0603_1608Metric |  | /motherboard_power_entry/
R11018 | 3000R 0.1% | TNPW06033K00BEEA | Resistor_SMD:R_0603_1608Metric |  | /motherboard_power_entry/
R11019 | 140000R 0.1% | TNPW0603140KBEEA | Resistor_SMD:R_0603_1608Metric |  | /motherboard_power_entry/
R11020 | 10000R 0.1% | TNPW060310K0BEEA | Resistor_SMD:R_0603_1608Metric |  | /motherboard_power_entry/
R11021 | 10000R 0.1% | TNPW060310K0BEEA | Resistor_SMD:R_0603_1608Metric |  | /motherboard_power_entry/
R11022 | 5mOhm 1% 1.5W | KRL3216D-C-R005-F-T1 | CNC_MB_Entry:KRL3216_LongSide_Susumu |  | /motherboard_power_entry/
R11023 | 24.9k1% | CRCW060324K9FKEA | Resistor_SMD:R_0603_1608Metric |  | /motherboard_power_entry/
R11024 | 49.9k0.1% | TNPW060349K9BEEA | Resistor_SMD:R_0603_1608Metric |  | /motherboard_power_entry/
R11025 | 29.4k1% | CRCW060329K4FKEA | Resistor_SMD:R_0603_1608Metric |  | /motherboard_power_entry/
R11026 | 9.53k1% | CRCW06039K53FKEA | Resistor_SMD:R_0603_1608Metric |  | /motherboard_power_entry/
R11027 | 100k0.1% | TNPW0603100KBEEA | Resistor_SMD:R_0603_1608Metric |  | /motherboard_power_entry/
R11028 | 10k0.1% | TNPW060310K0BEEA | Resistor_SMD:R_0603_1608Metric |  | /motherboard_power_entry/
R11029 | 100k1% | CRCW0603100KFKEA | Resistor_SMD:R_0603_1608Metric |  | /motherboard_power_entry/
R11030 | 6mOhm 1% 1.5W | KRL3216D-C-R006-F-T1 | CNC_MB_Entry:KRL3216_LongSide_Susumu |  | /motherboard_power_entry/
R11031 | 24.9k1% | CRCW060324K9FKEA | Resistor_SMD:R_0603_1608Metric |  | /motherboard_power_entry/
R11032 | 49.9k0.1% | TNPW060349K9BEEA | Resistor_SMD:R_0603_1608Metric |  | /motherboard_power_entry/
R11033 | 29.4k1% | CRCW060329K4FKEA | Resistor_SMD:R_0603_1608Metric |  | /motherboard_power_entry/
R11034 | 9.53k1% | CRCW06039K53FKEA | Resistor_SMD:R_0603_1608Metric |  | /motherboard_power_entry/
R11035 | 100k0.1% | TNPW0603100KBEEA | Resistor_SMD:R_0603_1608Metric |  | /motherboard_power_entry/
R11036 | 10k0.1% | TNPW060310K0BEEA | Resistor_SMD:R_0603_1608Metric |  | /motherboard_power_entry/
R11037 | 100k1% | CRCW0603100KFKEA | Resistor_SMD:R_0603_1608Metric |  | /motherboard_power_entry/
R11038 | 100k 1% | CRCW0603100KFKEA | Resistor_SMD:R_0603_1608Metric |  | /motherboard_power_entry/
R11039 | 10k 1% | CRCW060310K0FKEA | Resistor_SMD:R_0603_1608Metric |  | /motherboard_power_entry/
R11040 | 10k 1% | CRCW060310K0FKEA | Resistor_SMD:R_0603_1608Metric |  | /motherboard_power_entry/
R11041 | 100k 1% | CRCW0603100KFKEA | Resistor_SMD:R_0603_1608Metric |  | /motherboard_power_entry/
R11042 | 10000R 1% | CRCW060310K0FKEA | Resistor_SMD:R_0603_1608Metric |  | /motherboard_power_entry/
R11043 | 10000R 1% | CRCW060310K0FKEA | Resistor_SMD:R_0603_1608Metric |  | /motherboard_power_entry/
R11044 | 330R 1% | CRCW0603330RFKEA | Resistor_SMD:R_0603_1608Metric |  | /motherboard_power_entry/
R11045 | 10000R 1% | CRCW060310K0FKEA | Resistor_SMD:R_0603_1608Metric |  | /motherboard_power_entry/
R11046 | 10000R 1% | CRCW060310K0FKEA | Resistor_SMD:R_0603_1608Metric |  | /motherboard_power_entry/
R11047 | 330R 1% | CRCW0603330RFKEA | Resistor_SMD:R_0603_1608Metric |  | /motherboard_power_entry/
R11049 | 10000R 1% | CRCW060310K0FKEA | Resistor_SMD:R_0603_1608Metric |  | /motherboard_power_entry/
R11050 | 110000R 1% | CRCW0603110KFKEA | Resistor_SMD:R_0603_1608Metric |  | /motherboard_power_entry/
R11051 | 10000R 1% | CRCW060310K0FKEA | Resistor_SMD:R_0603_1608Metric |  | /motherboard_power_entry/
R11052 | 100000R 1% | CRCW0603100KFKEA | Resistor_SMD:R_0603_1608Metric |  | /motherboard_power_entry/
R11053 | 110000R 1% | CRCW0603110KFKEA | Resistor_SMD:R_0603_1608Metric |  | /motherboard_power_entry/
R11054 | 10000R 1% | CRCW060310K0FKEA | Resistor_SMD:R_0603_1608Metric |  | /motherboard_power_entry/
R11055 | 100000R 1% | CRCW0603100KFKEA | Resistor_SMD:R_0603_1608Metric |  | /motherboard_power_entry/
R11056 | 26700R 0.1% | TNPW060326K7BEEA | Resistor_SMD:R_0603_1608Metric |  | /motherboard_power_entry/
R11057 | 1e+06R 1% | CRCW06031M00FKEA | Resistor_SMD:R_0603_1608Metric |  | /motherboard_power_entry/
R11058 | 10000R 1% | CRCW060310K0FKEA | Resistor_SMD:R_0603_1608Metric |  | /motherboard_power_entry/
R11059 | 100000R 1% | CRCW0603100KFKEA | Resistor_SMD:R_0603_1608Metric |  | /motherboard_power_entry/
R11060 | 44200R 0.1% | TNPW060344K2BEEA | Resistor_SMD:R_0603_1608Metric |  | /motherboard_power_entry/
R11061 | 1e+06R 1% | CRCW06031M00FKEA | Resistor_SMD:R_0603_1608Metric |  | /motherboard_power_entry/
R11062 | 10000R 1% | CRCW060310K0FKEA | Resistor_SMD:R_0603_1608Metric |  | /motherboard_power_entry/
R11063 | 100000R 1% | CRCW0603100KFKEA | Resistor_SMD:R_0603_1608Metric |  | /motherboard_power_entry/
R11064 | 10000R 1% | CRCW060310K0FKEA | Resistor_SMD:R_0603_1608Metric |  | /motherboard_power_entry/
R11065 | 10000R 1% | CRCW060310K0FKEA | Resistor_SMD:R_0603_1608Metric |  | /motherboard_power_entry/
R11067 | 120R 1% | CRCW0603120RFKEA | Resistor_SMD:R_0603_1608Metric |  | /motherboard_power_entry/
R11069 | 120R 1% | CRCW0603120RFKEA | Resistor_SMD:R_0603_1608Metric |  | /motherboard_power_entry/
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
R14014 | 10000R1% | CRCW060310K0FKEA | Resistor_SMD:R_0603_1608Metric |  | /motherboard_operator/
R14015 | 1000R1% | CRCW06031K00FKEA | Resistor_SMD:R_0603_1608Metric |  | /motherboard_operator/
R14016 | 10000R1% | CRCW060310K0FKEA | Resistor_SMD:R_0603_1608Metric |  | /motherboard_operator/
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
