DeadlySIn777/Controller/hardware/esp_service/bom.csv

reference | value | mpn | footprint | status
U1 | ESP32-S3-WROOM-1-N8 | ESP32-S3-WROOM-1-N8 |  | candidate; exact land and assembly qualification open
U2 | SN74LVC1G97DBVR | SN74LVC1G97DBVR |  | candidate; exact land and assembly qualification open
U3 | SN74LVC2G17DBVR | SN74LVC2G17DBVR |  | candidate; exact land and assembly qualification open
U4 | SN74LVC1G17DBVR | SN74LVC1G17DBVR |  | candidate; exact land and assembly qualification open
U5 | TS3USB221ARSER | TS3USB221ARSER |  | candidate; exact land and assembly qualification open
U6 | SN74LVC1G97DBVR | SN74LVC1G97DBVR |  | candidate; exact land and assembly qualification open
D1 | TPD2EUSB30DRTR | TPD2EUSB30DRTR |  | candidate; exact land and assembly qualification open
D2 | TPD1E10B06DPYR | TPD1E10B06DPYR |  | candidate; exact land and assembly qualification open
D3 | TPD1E10B06DPYR | TPD1E10B06DPYR |  | candidate; exact land and assembly qualification open
D4 | TPD1E10B06DPYR | TPD1E10B06DPYR |  | candidate; exact land and assembly qualification open
R1 | 10k1% |  |  | candidate; exact land and assembly qualification open
R2 | 10k1% |  |  | candidate; exact land and assembly qualification open
R3 | 10k1% |  |  | candidate; exact land and assembly qualification open
R4 | 10k1% |  |  | candidate; exact land and assembly qualification open
R5 | 10k1% |  |  | candidate; exact land and assembly qualification open
R6 | 47k1% |  |  | candidate; exact land and assembly qualification open
R7 | 1k1% |  |  | candidate; exact land and assembly qualification open
R8 | 100k1% |  |  | candidate; exact land and assembly qualification open
R9 | 1k1% |  |  | candidate; exact land and assembly qualification open
R10 | 100k1% |  |  | candidate; exact land and assembly qualification open
R11 | 100R1% |  |  | candidate; exact land and assembly qualification open
R12 | 22R1% |  |  | candidate; exact land and assembly qualification open
R13 | 22R1% |  |  | candidate; exact land and assembly qualification open
R14 | 10k1% |  |  | candidate; exact land and assembly qualification open
R15 | 10k1% |  |  | candidate; exact land and assembly qualification open
R16 | 100k1% |  |  | candidate; exact land and assembly qualification open
R17 | 5.1k1% |  |  | candidate; exact land and assembly qualification open
R18 | 5.1k1% |  |  | candidate; exact land and assembly qualification open
R19 | 0R |  |  | candidate; exact land and assembly qualification open
C1 | 22uF16V X7R10% |  |  | candidate; exact land and assembly qualification open
C2 | 100nF16V X7R20% |  |  | candidate; exact land and assembly qualification open
C3 | 100nF16V X7R20% |  |  | candidate; exact land and assembly qualification open
C4 | 100nF16V X7R20% |  |  | candidate; exact land and assembly qualification open
C5 | 100nF16V X7R20% |  |  | candidate; exact land and assembly qualification open
C6 | 100nF16V X7R20% |  |  | candidate; exact land and assembly qualification open
C7 | 100nF16V X7R20% |  |  | candidate; exact land and assembly qualification open
C8 | 100nF16V X7R20% |  |  | candidate; exact land and assembly qualification open
JUSB1 | USB-C ELECTRICAL BOUNDARY |  |  | candidate; exact land and assembly qualification open
JRAIL1 | RAIL BOUNDARY |  |  | candidate; exact land and assembly qualification open
JHOST1 | HOST BOUNDARY |  |  | candidate; exact land and assembly qualification open
JSERIAL1 | SERIAL BOUNDARY |  |  | candidate; exact land and assembly qualification open
JRESET1 | RESET BOUNDARY |  |  | candidate; exact land and assembly qualification open
JBOOT1 | BOOT BOUNDARY |  |  | candidate; exact land and assembly qualification open
JRES1 | RES BOUNDARY |  |  | candidate; exact land and assembly qualification open
