DeadlySIn777/Controller/hardware/field_power/bom.csv

reference | quantity | value | mpn | footprint | status
C1 | 1 | 2.2uF 100V X7S | CGA5L3X7S2A225K160AB | Capacitor_SMD:C_1206_3216Metric | proposed; not qualified
C2 | 1 | 2.2uF 100V X7S | CGA5L3X7S2A225K160AB | Capacitor_SMD:C_1206_3216Metric | proposed; not qualified
C3 | 1 | 2.2uF 100V X7S | CGA5L3X7S2A225K160AB | Capacitor_SMD:C_1206_3216Metric | proposed; not qualified
C4 | 1 | 2.2uF 100V X7S | CGA5L3X7S2A225K160AB | Capacitor_SMD:C_1206_3216Metric | proposed; not qualified
C5 | 1 | 100nF 100V X7R | GRM188R72A104KA35D | Capacitor_SMD:C_0603_1608Metric | proposed; not qualified
C6 | 1 | 100nF 16V X7R | GCM155R71C104KA55D | Capacitor_SMD:C_0402_1005Metric | proposed; not qualified
C7 | 1 | 1uF 16V X7R | 885012206052 | Capacitor_SMD:C_0603_1608Metric | proposed; not qualified
C8 | 1 | 22uF 10V X7R | GCM31CR71A226KE02L | Capacitor_SMD:C_1206_3216Metric | proposed; not qualified
C9 | 1 | 22uF 10V X7R | GCM31CR71A226KE02L | Capacitor_SMD:C_1206_3216Metric | proposed; not qualified
C10 | 1 | 100nF 16V X7R | GCM155R71C104KA55D | Capacitor_SMD:C_0402_1005Metric | proposed; not qualified
J1 | 1 | ENTRY BOUNDARY / NOT CONNECTOR MPN |  |  | boundary only
J2 | 1 | LOAD BOUNDARY / NOT CONNECTOR MPN |  |  | boundary only
L1 | 1 | 22uH / 20% | LPS6235-223MRC |  | proposed; not qualified
R1 | 1 | 100k 1% | CRCW0603100KFKEA | Resistor_SMD:R_0603_1608Metric | proposed; not qualified
R2 | 1 | 10k 1% | CRCW060310K0FKEA | Resistor_SMD:R_0603_1608Metric | proposed; not qualified
R3 | 1 | 10k 1% | CRCW060310K0FKEA | Resistor_SMD:R_0603_1608Metric | proposed; not qualified
R4 | 1 | 100k 1% | CRCW0603100KFKEA | Resistor_SMD:R_0603_1608Metric | proposed; not qualified
U1 | 1 | LMR36506R5RPER / FIXED 5V | LMR36506R5RPER |  | proposed; not qualified
