DeadlySIn777/Controller/hardware/motherboard_acc_control/bom.csv

Reference | Value | MPN | Footprint | Status
R14501 | 10000R1% | CRCW060310K0FKEA | Resistor_SMD:R_0603_1608Metric | source_candidate_not_qualified
R14502 | 10000R1% | CRCW060310K0FKEA | Resistor_SMD:R_0603_1608Metric | source_candidate_not_qualified
R14503 | 10000R1% | CRCW060310K0FKEA | Resistor_SMD:R_0603_1608Metric | source_candidate_not_qualified
R14504 | 10000R1% | CRCW060310K0FKEA | Resistor_SMD:R_0603_1608Metric | source_candidate_not_qualified
R14505 | 10000R1% | CRCW060310K0FKEA | Resistor_SMD:R_0603_1608Metric | source_candidate_not_qualified
R14506 | 10000R1% | CRCW060310K0FKEA | Resistor_SMD:R_0603_1608Metric | source_candidate_not_qualified
R14507 | 10000R1% | CRCW060310K0FKEA | Resistor_SMD:R_0603_1608Metric | source_candidate_not_qualified
R14508 | 10000R1% | CRCW060310K0FKEA | Resistor_SMD:R_0603_1608Metric | source_candidate_not_qualified
R14509 | 10000R1% | CRCW060310K0FKEA | Resistor_SMD:R_0603_1608Metric | source_candidate_not_qualified
R14510 | 10000R1% | CRCW060310K0FKEA | Resistor_SMD:R_0603_1608Metric | source_candidate_not_qualified
R14511 | 10000R1% | CRCW060310K0FKEA | Resistor_SMD:R_0603_1608Metric | source_candidate_not_qualified
R14512 | 10000R1% | CRCW060310K0FKEA | Resistor_SMD:R_0603_1608Metric | source_candidate_not_qualified
R14513 | 10000R1% | CRCW060310K0FKEA | Resistor_SMD:R_0603_1608Metric | source_candidate_not_qualified
R14514 | 10000R1% | CRCW060310K0FKEA | Resistor_SMD:R_0603_1608Metric | source_candidate_not_qualified
R14515 | 10000R1% | CRCW060310K0FKEA | Resistor_SMD:R_0603_1608Metric | source_candidate_not_qualified
R14516 | 10000R1% | CRCW060310K0FKEA | Resistor_SMD:R_0603_1608Metric | source_candidate_not_qualified
R14517 | 10000R1% | CRCW060310K0FKEA | Resistor_SMD:R_0603_1608Metric | source_candidate_not_qualified
R14518 | 10000R1% | CRCW060310K0FKEA | Resistor_SMD:R_0603_1608Metric | source_candidate_not_qualified
R14519 | 10000R1% | CRCW060310K0FKEA | Resistor_SMD:R_0603_1608Metric | source_candidate_not_qualified
R14520 | 3300R1% | CRCW06033K30FKEA | Resistor_SMD:R_0603_1608Metric | source_candidate_not_qualified
R14521 | 3300R1% | CRCW06033K30FKEA | Resistor_SMD:R_0603_1608Metric | source_candidate_not_qualified
U14501 | STM32G031C8T6 | STM32G031C8T6 | Package_QFP:LQFP-48_7x7mm_P0.5mm | source_candidate_not_qualified
U14502 | TPS3808G33DBVR | TPS3808G33DBVR | Package_TO_SOT_SMD:SOT-23-6 | source_candidate_not_qualified
R14522 | 10000R1% | CRCW060310K0FKEA | Resistor_SMD:R_0603_1608Metric | source_candidate_not_qualified
R14523 | 10000R1% | CRCW060310K0FKEA | Resistor_SMD:R_0603_1608Metric | source_candidate_not_qualified
R14524 | 10000R1% | CRCW060310K0FKEA | Resistor_SMD:R_0603_1608Metric | source_candidate_not_qualified
C14501 | 100nF100V | GRM188R72A104KA35D | Capacitor_SMD:C_0603_1608Metric | source_candidate_not_qualified
C14502 | 100nF100V | GRM188R72A104KA35D | Capacitor_SMD:C_0603_1608Metric | source_candidate_not_qualified
C14503 | 4700nF10V | GRM21BR71A475KE51K | Capacitor_SMD:C_0805_2012Metric | source_candidate_not_qualified
C14504 | 100nF100V | GRM188R72A104KA35D | Capacitor_SMD:C_0603_1608Metric | source_candidate_not_qualified
C14505 | 1000nF50V | GRM188R71H105KA12D | Capacitor_SMD:C_0603_1608Metric | source_candidate_not_qualified
C14506 | 100nF100V | GRM188R72A104KA35D | Capacitor_SMD:C_0603_1608Metric | source_candidate_not_qualified
U14503 | 74LVC125APW,118 | 74LVC125APW,118 | Package_SO:TSSOP-14_4.4x5mm_P0.65mm | source_candidate_not_qualified
C14507 | 100nF100V | GRM188R72A104KA35D | Capacitor_SMD:C_0603_1608Metric | source_candidate_not_qualified
R14525 | 22R1% | CRCW060322R0FKEA | Resistor_SMD:R_0603_1608Metric | source_candidate_not_qualified
R14526 | 22R1% | CRCW060322R0FKEA | Resistor_SMD:R_0603_1608Metric | source_candidate_not_qualified
R14527 | 22R1% | CRCW060322R0FKEA | Resistor_SMD:R_0603_1608Metric | source_candidate_not_qualified
R14528 | 22R1% | CRCW060322R0FKEA | Resistor_SMD:R_0603_1608Metric | source_candidate_not_qualified
R14529 | 10000R1% | CRCW060310K0FKEA | Resistor_SMD:R_0603_1608Metric | source_candidate_not_qualified
R14530 | 10000R1% | CRCW060310K0FKEA | Resistor_SMD:R_0603_1608Metric | source_candidate_not_qualified
R14531 | 10000R1% | CRCW060310K0FKEA | Resistor_SMD:R_0603_1608Metric | source_candidate_not_qualified
R14532 | 10000R1% | CRCW060310K0FKEA | Resistor_SMD:R_0603_1608Metric | source_candidate_not_qualified
U14504 | SN74LVC1G17DBVR | SN74LVC1G17DBVR | Package_TO_SOT_SMD:SOT-23-5 | source_candidate_not_qualified
C14508 | 100nF100V | GRM188R72A104KA35D | Capacitor_SMD:C_0603_1608Metric | source_candidate_not_qualified
TP14501 | IO_3V3 | PCB_COPPER_TEST_PAD_D1.0 | TestPoint:TestPoint_Pad_D1.0mm | PCB_copper_test_pad
TP14502 | LOGIC_GND | PCB_COPPER_TEST_PAD_D1.0 | TestPoint:TestPoint_Pad_D1.0mm | PCB_copper_test_pad
TP14503 | ACC_SWDIO | PCB_COPPER_TEST_PAD_D1.0 | TestPoint:TestPoint_Pad_D1.0mm | PCB_copper_test_pad
TP14504 | ACC_SWCLK_BOOT0 | PCB_COPPER_TEST_PAD_D1.0 | TestPoint:TestPoint_Pad_D1.0mm | PCB_copper_test_pad
TP14505 | ACC_NRST_N | PCB_COPPER_TEST_PAD_D1.0 | TestPoint:TestPoint_Pad_D1.0mm | PCB_copper_test_pad
TP14506 | ACC_MR_N | PCB_COPPER_TEST_PAD_D1.0 | TestPoint:TestPoint_Pad_D1.0mm | PCB_copper_test_pad
R14533 | 0R | CRCW06030000Z0EA | Resistor_SMD:R_0603_1608Metric | source_candidate_not_qualified
