DeadlySIn777/Controller/hardware/motherboard_analog_output/bom.csv

Reference | Value | MPN | Footprint | Status
U14601 | TMR 4-2412WI | TMR 4-2412WI | CNC_MB_AO:TMR4WI_SIP8_Traco | source_candidate_not_qualified
C14601 | 2200nF100V | CGA5L3X7S2A225K160AB | Capacitor_SMD:C_1206_3216Metric | source_candidate_not_qualified
C14602 | 2200nF100V | CGA5L3X7S2A225K160AB | Capacitor_SMD:C_1206_3216Metric | source_candidate_not_qualified
C14603 | 100nF100V | GRM188R72A104KA35D | Capacitor_SMD:C_0603_1608Metric | source_candidate_not_qualified
U14602 | TPS7A1650DGNR | TPS7A1650DGNR | CNC_MB_AO:TPS7A16_DGN8_TI | source_candidate_not_qualified
C14604 | 100nF100V | GRM188R72A104KA35D | Capacitor_SMD:C_0603_1608Metric | source_candidate_not_qualified
C14605 | 22000nF10V | GCM31CR71A226KE02L | Capacitor_SMD:C_1206_3216Metric | source_candidate_not_qualified
C14606 | 100nF100V | GRM188R72A104KA35D | Capacitor_SMD:C_0603_1608Metric | source_candidate_not_qualified
C14607 | 10nF100V | GRM1885C2A103JA01D | Capacitor_SMD:C_0603_1608Metric | source_candidate_not_qualified
R14601 | 100000R1% | CRCW0603100KFKEA | Resistor_SMD:R_0603_1608Metric | source_candidate_not_qualified
U14603 | TPS3700DDCR | TPS3700DDCR | Package_TO_SOT_SMD:SOT-23-6 | source_candidate_not_qualified
R14602 | 267000R0.1% | TNPW0603267KBEEA | Resistor_SMD:R_0603_1608Metric | source_candidate_not_qualified
R14603 | 10000R0.1% | TNPW060310K0BEEA | Resistor_SMD:R_0603_1608Metric | source_candidate_not_qualified
R14604 | 316000R0.1% | TNPW0603316KBEEA | Resistor_SMD:R_0603_1608Metric | source_candidate_not_qualified
R14605 | 10000R0.1% | TNPW060310K0BEEA | Resistor_SMD:R_0603_1608Metric | source_candidate_not_qualified
R14606 | 10000R1% | CRCW060310K0FKEA | Resistor_SMD:R_0603_1608Metric | source_candidate_not_qualified
C14608 | 100nF100V | GRM188R72A104KA35D | Capacitor_SMD:C_0603_1608Metric | source_candidate_not_qualified
U14604 | SN74LVC1G08DBVR | SN74LVC1G08DBVR | Package_TO_SOT_SMD:SOT-23-5 | source_candidate_not_qualified
C14609 | 100nF100V | GRM188R72A104KA35D | Capacitor_SMD:C_0603_1608Metric | source_candidate_not_qualified
U14605 | ISO7761FDWR | ISO7761FDWR | CNC_MB_AO:ISO7761_DW16_TI_HV | source_candidate_not_qualified
C14610 | 100nF100V | GRM188R72A104KA35D | Capacitor_SMD:C_0603_1608Metric | source_candidate_not_qualified
C14611 | 100nF100V | GRM188R72A104KA35D | Capacitor_SMD:C_0603_1608Metric | source_candidate_not_qualified
U14606 | SN74LVC1G08DBVR | SN74LVC1G08DBVR | Package_TO_SOT_SMD:SOT-23-5 | source_candidate_not_qualified
U14607 | SN74LVC1G08DBVR | SN74LVC1G08DBVR | Package_TO_SOT_SMD:SOT-23-5 | source_candidate_not_qualified
C14612 | 100nF100V | GRM188R72A104KA35D | Capacitor_SMD:C_0603_1608Metric | source_candidate_not_qualified
C14613 | 100nF100V | GRM188R72A104KA35D | Capacitor_SMD:C_0603_1608Metric | source_candidate_not_qualified
R14607 | 10000R1% | CRCW060310K0FKEA | Resistor_SMD:R_0603_1608Metric | source_candidate_not_qualified
R14608 | 10000R1% | CRCW060310K0FKEA | Resistor_SMD:R_0603_1608Metric | source_candidate_not_qualified
R14609 | 10000R1% | CRCW060310K0FKEA | Resistor_SMD:R_0603_1608Metric | source_candidate_not_qualified
U14608 | AD5683RBRMZ-3 | AD5683RBRMZ-3 | Package_SO:MSOP-10_3x3mm_P0.5mm | source_candidate_not_qualified
C14614 | 100nF100V | GRM188R72A104KA35D | Capacitor_SMD:C_0603_1608Metric | source_candidate_not_qualified
C14615 | 10nF100V | GRM1885C2A103JA01D | Capacitor_SMD:C_0603_1608Metric | source_candidate_not_qualified
U14609 | SN74LVC1G125DBVR | SN74LVC1G125DBVR | Package_TO_SOT_SMD:SOT-23-5 | source_candidate_not_qualified
C14616 | 100nF100V | GRM188R72A104KA35D | Capacitor_SMD:C_0603_1608Metric | source_candidate_not_qualified
U14610 | SN74LVC1G06DBVR | SN74LVC1G06DBVR | Package_TO_SOT_SMD:SOT-23-5 | source_candidate_not_qualified
C14617 | 100nF100V | GRM188R72A104KA35D | Capacitor_SMD:C_0603_1608Metric | source_candidate_not_qualified
U14611 | TLP4176A(TP,F | TLP4176A(TP,F | CNC_MB_AO:TLP4176A_2.54SOP4_11-5H1S | source_candidate_not_qualified
U14612 | TLP3640A(TPL,E | TLP3640A(TPL,E | CNC_MB_AO:TLP3640A_SO4_11-3C1 | source_candidate_not_qualified
R14610 | 390R1% | CRCW0603390RFKEA | Resistor_SMD:R_0603_1608Metric | source_candidate_not_qualified
R14611 | 390R1% | CRCW0603390RFKEA | Resistor_SMD:R_0603_1608Metric | source_candidate_not_qualified
U14613 | OPA197IDBVR | OPA197IDBVR | Package_TO_SOT_SMD:SOT-23-5 | source_candidate_not_qualified
C14618 | 100nF100V | GRM188R72A104KA35D | Capacitor_SMD:C_0603_1608Metric | source_candidate_not_qualified
R14612 | 1000R1% | CRCW06031K00FKEA | Resistor_SMD:R_0603_1608Metric | source_candidate_not_qualified
R14613 | 30000R0.1% | TNPW060330K0BEEA | Resistor_SMD:R_0603_1608Metric | source_candidate_not_qualified
R14614 | 10000R0.1% | TNPW060310K0BEEA | Resistor_SMD:R_0603_1608Metric | source_candidate_not_qualified
R14615 | 4.7R1% | CRCW06034R70FKEA | Resistor_SMD:R_0603_1608Metric | source_candidate_not_qualified
R14616 | 10000R1% | CRCW060310K0FKEA | Resistor_SMD:R_0603_1608Metric | source_candidate_not_qualified
D14601 | SMBJ12CA-E3/52 | SMBJ12CA-E3/52 | Diode_SMD:D_SMB | source_candidate_not_qualified
U14614 | SN74LVC1G14DBVR | SN74LVC1G14DBVR | Package_TO_SOT_SMD:SOT-23-5 | source_candidate_not_qualified
C14619 | 100nF100V | GRM188R72A104KA35D | Capacitor_SMD:C_0603_1608Metric | source_candidate_not_qualified
U14615 | ISO7720FDWR | ISO7720FDWR | CNC_MB_AO:ISO7720_DW16_TI_HV | source_candidate_not_qualified
C14620 | 100nF100V | GRM188R72A104KA35D | Capacitor_SMD:C_0603_1608Metric | source_candidate_not_qualified
C14621 | 100nF100V | GRM188R72A104KA35D | Capacitor_SMD:C_0603_1608Metric | source_candidate_not_qualified
U14616 | SN74LVC1G14DBVR | SN74LVC1G14DBVR | Package_TO_SOT_SMD:SOT-23-5 | source_candidate_not_qualified
C14622 | 100nF100V | GRM188R72A104KA35D | Capacitor_SMD:C_0603_1608Metric | source_candidate_not_qualified
U14617 | ISO1540DR | ISO1540DR | Package_SO:SOIC-8_3.9x4.9mm_P1.27mm | source_candidate_not_qualified
C14623 | 100nF100V | GRM188R72A104KA35D | Capacitor_SMD:C_0603_1608Metric | source_candidate_not_qualified
C14624 | 100nF100V | GRM188R72A104KA35D | Capacitor_SMD:C_0603_1608Metric | source_candidate_not_qualified
R14617 | 3300R1% | CRCW06033K30FKEA | Resistor_SMD:R_0603_1608Metric | source_candidate_not_qualified
R14618 | 3300R1% | CRCW06033K30FKEA | Resistor_SMD:R_0603_1608Metric | source_candidate_not_qualified
R14619 | 100000R0.1% | TNPW0603100KBEEA | Resistor_SMD:R_0603_1608Metric | source_candidate_not_qualified
R14620 | 33200R0.1% | TNPW060333K2BEEA | Resistor_SMD:R_0603_1608Metric | source_candidate_not_qualified
C14625 | 10nF100V | GRM1885C2A103JA01D | Capacitor_SMD:C_0603_1608Metric | source_candidate_not_qualified
R14621 | 100000R0.1% | TNPW0603100KBEEA | Resistor_SMD:R_0603_1608Metric | source_candidate_not_qualified
R14622 | 33200R0.1% | TNPW060333K2BEEA | Resistor_SMD:R_0603_1608Metric | source_candidate_not_qualified
C14626 | 10nF100V | GRM1885C2A103JA01D | Capacitor_SMD:C_0603_1608Metric | source_candidate_not_qualified
R14623 | 100000R0.1% | TNPW0603100KBEEA | Resistor_SMD:R_0603_1608Metric | source_candidate_not_qualified
R14624 | 33200R0.1% | TNPW060333K2BEEA | Resistor_SMD:R_0603_1608Metric | source_candidate_not_qualified
C14627 | 10nF100V | GRM1885C2A103JA01D | Capacitor_SMD:C_0603_1608Metric | source_candidate_not_qualified
U14618 | ADS1115IDGSR | ADS1115IDGSR | CNC_MB_AO:ADS1115_DGS10_TI | source_candidate_not_qualified
C14628 | 100nF100V | GRM188R72A104KA35D | Capacitor_SMD:C_0603_1608Metric | source_candidate_not_qualified
U14619 | TMR 4-2412WI | TMR 4-2412WI | CNC_MB_AO:TMR4WI_SIP8_Traco | source_candidate_not_qualified
C14629 | 2200nF100V | CGA5L3X7S2A225K160AB | Capacitor_SMD:C_1206_3216Metric | source_candidate_not_qualified
C14630 | 2200nF100V | CGA5L3X7S2A225K160AB | Capacitor_SMD:C_1206_3216Metric | source_candidate_not_qualified
C14631 | 100nF100V | GRM188R72A104KA35D | Capacitor_SMD:C_0603_1608Metric | source_candidate_not_qualified
U14620 | TPS7A1650DGNR | TPS7A1650DGNR | CNC_MB_AO:TPS7A16_DGN8_TI | source_candidate_not_qualified
C14632 | 100nF100V | GRM188R72A104KA35D | Capacitor_SMD:C_0603_1608Metric | source_candidate_not_qualified
C14633 | 22000nF10V | GCM31CR71A226KE02L | Capacitor_SMD:C_1206_3216Metric | source_candidate_not_qualified
C14634 | 100nF100V | GRM188R72A104KA35D | Capacitor_SMD:C_0603_1608Metric | source_candidate_not_qualified
C14635 | 10nF100V | GRM1885C2A103JA01D | Capacitor_SMD:C_0603_1608Metric | source_candidate_not_qualified
R14625 | 100000R1% | CRCW0603100KFKEA | Resistor_SMD:R_0603_1608Metric | source_candidate_not_qualified
U14621 | TPS3700DDCR | TPS3700DDCR | Package_TO_SOT_SMD:SOT-23-6 | source_candidate_not_qualified
R14626 | 267000R0.1% | TNPW0603267KBEEA | Resistor_SMD:R_0603_1608Metric | source_candidate_not_qualified
R14627 | 10000R0.1% | TNPW060310K0BEEA | Resistor_SMD:R_0603_1608Metric | source_candidate_not_qualified
R14628 | 316000R0.1% | TNPW0603316KBEEA | Resistor_SMD:R_0603_1608Metric | source_candidate_not_qualified
R14629 | 10000R0.1% | TNPW060310K0BEEA | Resistor_SMD:R_0603_1608Metric | source_candidate_not_qualified
R14630 | 10000R1% | CRCW060310K0FKEA | Resistor_SMD:R_0603_1608Metric | source_candidate_not_qualified
C14636 | 100nF100V | GRM188R72A104KA35D | Capacitor_SMD:C_0603_1608Metric | source_candidate_not_qualified
U14622 | SN74LVC1G08DBVR | SN74LVC1G08DBVR | Package_TO_SOT_SMD:SOT-23-5 | source_candidate_not_qualified
C14637 | 100nF100V | GRM188R72A104KA35D | Capacitor_SMD:C_0603_1608Metric | source_candidate_not_qualified
U14623 | ISO7761FDWR | ISO7761FDWR | CNC_MB_AO:ISO7761_DW16_TI_HV | source_candidate_not_qualified
C14638 | 100nF100V | GRM188R72A104KA35D | Capacitor_SMD:C_0603_1608Metric | source_candidate_not_qualified
C14639 | 100nF100V | GRM188R72A104KA35D | Capacitor_SMD:C_0603_1608Metric | source_candidate_not_qualified
U14624 | SN74LVC1G08DBVR | SN74LVC1G08DBVR | Package_TO_SOT_SMD:SOT-23-5 | source_candidate_not_qualified
U14625 | SN74LVC1G08DBVR | SN74LVC1G08DBVR | Package_TO_SOT_SMD:SOT-23-5 | source_candidate_not_qualified
C14640 | 100nF100V | GRM188R72A104KA35D | Capacitor_SMD:C_0603_1608Metric | source_candidate_not_qualified
C14641 | 100nF100V | GRM188R72A104KA35D | Capacitor_SMD:C_0603_1608Metric | source_candidate_not_qualified
R14631 | 10000R1% | CRCW060310K0FKEA | Resistor_SMD:R_0603_1608Metric | source_candidate_not_qualified
R14632 | 10000R1% | CRCW060310K0FKEA | Resistor_SMD:R_0603_1608Metric | source_candidate_not_qualified
R14633 | 10000R1% | CRCW060310K0FKEA | Resistor_SMD:R_0603_1608Metric | source_candidate_not_qualified
U14626 | AD5683RBRMZ-3 | AD5683RBRMZ-3 | Package_SO:MSOP-10_3x3mm_P0.5mm | source_candidate_not_qualified
C14642 | 100nF100V | GRM188R72A104KA35D | Capacitor_SMD:C_0603_1608Metric | source_candidate_not_qualified
C14643 | 10nF100V | GRM1885C2A103JA01D | Capacitor_SMD:C_0603_1608Metric | source_candidate_not_qualified
U14627 | SN74LVC1G125DBVR | SN74LVC1G125DBVR | Package_TO_SOT_SMD:SOT-23-5 | source_candidate_not_qualified
C14644 | 100nF100V | GRM188R72A104KA35D | Capacitor_SMD:C_0603_1608Metric | source_candidate_not_qualified
U14628 | SN74LVC1G06DBVR | SN74LVC1G06DBVR | Package_TO_SOT_SMD:SOT-23-5 | source_candidate_not_qualified
C14645 | 100nF100V | GRM188R72A104KA35D | Capacitor_SMD:C_0603_1608Metric | source_candidate_not_qualified
U14629 | TLP4176A(TP,F | TLP4176A(TP,F | CNC_MB_AO:TLP4176A_2.54SOP4_11-5H1S | source_candidate_not_qualified
U14630 | TLP3640A(TPL,E | TLP3640A(TPL,E | CNC_MB_AO:TLP3640A_SO4_11-3C1 | source_candidate_not_qualified
R14634 | 390R1% | CRCW0603390RFKEA | Resistor_SMD:R_0603_1608Metric | source_candidate_not_qualified
R14635 | 390R1% | CRCW0603390RFKEA | Resistor_SMD:R_0603_1608Metric | source_candidate_not_qualified
U14631 | OPA197IDBVR | OPA197IDBVR | Package_TO_SOT_SMD:SOT-23-5 | source_candidate_not_qualified
C14646 | 100nF100V | GRM188R72A104KA35D | Capacitor_SMD:C_0603_1608Metric | source_candidate_not_qualified
R14636 | 1000R1% | CRCW06031K00FKEA | Resistor_SMD:R_0603_1608Metric | source_candidate_not_qualified
R14637 | 30000R0.1% | TNPW060330K0BEEA | Resistor_SMD:R_0603_1608Metric | source_candidate_not_qualified
R14638 | 10000R0.1% | TNPW060310K0BEEA | Resistor_SMD:R_0603_1608Metric | source_candidate_not_qualified
R14639 | 4.7R1% | CRCW06034R70FKEA | Resistor_SMD:R_0603_1608Metric | source_candidate_not_qualified
R14640 | 10000R1% | CRCW060310K0FKEA | Resistor_SMD:R_0603_1608Metric | source_candidate_not_qualified
D14602 | SMBJ12CA-E3/52 | SMBJ12CA-E3/52 | Diode_SMD:D_SMB | source_candidate_not_qualified
U14632 | SN74LVC1G14DBVR | SN74LVC1G14DBVR | Package_TO_SOT_SMD:SOT-23-5 | source_candidate_not_qualified
C14647 | 100nF100V | GRM188R72A104KA35D | Capacitor_SMD:C_0603_1608Metric | source_candidate_not_qualified
U14633 | ISO7720FDWR | ISO7720FDWR | CNC_MB_AO:ISO7720_DW16_TI_HV | source_candidate_not_qualified
C14648 | 100nF100V | GRM188R72A104KA35D | Capacitor_SMD:C_0603_1608Metric | source_candidate_not_qualified
C14649 | 100nF100V | GRM188R72A104KA35D | Capacitor_SMD:C_0603_1608Metric | source_candidate_not_qualified
U14634 | SN74LVC1G14DBVR | SN74LVC1G14DBVR | Package_TO_SOT_SMD:SOT-23-5 | source_candidate_not_qualified
C14650 | 100nF100V | GRM188R72A104KA35D | Capacitor_SMD:C_0603_1608Metric | source_candidate_not_qualified
U14635 | ISO1540DR | ISO1540DR | Package_SO:SOIC-8_3.9x4.9mm_P1.27mm | source_candidate_not_qualified
C14651 | 100nF100V | GRM188R72A104KA35D | Capacitor_SMD:C_0603_1608Metric | source_candidate_not_qualified
C14652 | 100nF100V | GRM188R72A104KA35D | Capacitor_SMD:C_0603_1608Metric | source_candidate_not_qualified
R14641 | 3300R1% | CRCW06033K30FKEA | Resistor_SMD:R_0603_1608Metric | source_candidate_not_qualified
R14642 | 3300R1% | CRCW06033K30FKEA | Resistor_SMD:R_0603_1608Metric | source_candidate_not_qualified
R14643 | 100000R0.1% | TNPW0603100KBEEA | Resistor_SMD:R_0603_1608Metric | source_candidate_not_qualified
R14644 | 33200R0.1% | TNPW060333K2BEEA | Resistor_SMD:R_0603_1608Metric | source_candidate_not_qualified
C14653 | 10nF100V | GRM1885C2A103JA01D | Capacitor_SMD:C_0603_1608Metric | source_candidate_not_qualified
R14645 | 100000R0.1% | TNPW0603100KBEEA | Resistor_SMD:R_0603_1608Metric | source_candidate_not_qualified
R14646 | 33200R0.1% | TNPW060333K2BEEA | Resistor_SMD:R_0603_1608Metric | source_candidate_not_qualified
C14654 | 10nF100V | GRM1885C2A103JA01D | Capacitor_SMD:C_0603_1608Metric | source_candidate_not_qualified
R14647 | 100000R0.1% | TNPW0603100KBEEA | Resistor_SMD:R_0603_1608Metric | source_candidate_not_qualified
R14648 | 33200R0.1% | TNPW060333K2BEEA | Resistor_SMD:R_0603_1608Metric | source_candidate_not_qualified
C14655 | 10nF100V | GRM1885C2A103JA01D | Capacitor_SMD:C_0603_1608Metric | source_candidate_not_qualified
U14636 | ADS1115IDGSR | ADS1115IDGSR | CNC_MB_AO:ADS1115_DGS10_TI | source_candidate_not_qualified
C14656 | 100nF100V | GRM188R72A104KA35D | Capacitor_SMD:C_0603_1608Metric | source_candidate_not_qualified
R14649 | 100000R1% | CRCW0603100KFKEA | Resistor_SMD:R_0603_1608Metric | source_candidate_not_qualified
