DeadlySIn777/Controller/hardware/motherboard_control_bridges/bom.csv

Reference | Value | MPN | Footprint | Status
R12001 | 33R 1% | CRCW060333R0FKEA | Resistor_SMD:R_0603_1608Metric | source candidate / not qualified
R12002 | 33R 1% | CRCW060333R0FKEA | Resistor_SMD:R_0603_1608Metric | source candidate / not qualified
R12003 | 33R 1% | CRCW060333R0FKEA | Resistor_SMD:R_0603_1608Metric | source candidate / not qualified
R12004 | 33R 1% | CRCW060333R0FKEA | Resistor_SMD:R_0603_1608Metric | source candidate / not qualified
R12005 | 100000R 1% | CRCW0603100KFKEA | Resistor_SMD:R_0603_1608Metric | source candidate / not qualified
R12006 | 100000R 1% | CRCW0603100KFKEA | Resistor_SMD:R_0603_1608Metric | source candidate / not qualified
