DeadlySIn777/Controller/hardware/motherboard_esp_socket/bom.csv

Reference | Value | MPN | Footprint | Status
J16001 | 61302211821 | 61302211821 | CNC_MB_ESP:Wurth_61302211821_1x22_P2.54 | candidate_not_qualified
J16002 | 61302211821 | 61302211821 | CNC_MB_ESP:Wurth_61302211821_1x22_P2.54 | candidate_not_qualified
U16001 | TPS2553DBVR-1 | TPS2553DBVR-1 | Package_TO_SOT_SMD:SOT-23-6 | candidate_not_qualified
R16001 | 10000R | CRCW060310K0FKEA | Resistor_SMD:R_0603_1608Metric | candidate_not_qualified
R16002 | 100000R | CRCW0603100KFKEA | Resistor_SMD:R_0603_1608Metric | candidate_not_qualified
R16003 | 20000R | TNPW060320K0BEEA | Resistor_SMD:R_0603_1608Metric | candidate_not_qualified
C16001 | 100nF | GRM188R72A104KA35D | Capacitor_SMD:C_0603_1608Metric | candidate_not_qualified
C16002 | 1000nF | GRM188R71H105KA12D | Capacitor_SMD:C_0603_1608Metric | candidate_not_qualified
C16003 | 100nF | GRM188R72A104KA35D | Capacitor_SMD:C_0603_1608Metric | candidate_not_qualified
C16004 | 1000nF | GRM188R71H105KA12D | Capacitor_SMD:C_0603_1608Metric | candidate_not_qualified
R16004 | 10000R | CRCW060310K0FKEA | Resistor_SMD:R_0603_1608Metric | candidate_not_qualified
U16002 | LM66100DCKR | LM66100DCKR | Package_TO_SOT_SMD:SOT-363_SC-70-6 | candidate_not_qualified
C16005 | 100nF | GRM188R72A104KA35D | Capacitor_SMD:C_0603_1608Metric | candidate_not_qualified
C16006 | 10000nF | GRM21BR71A106MA73L | Capacitor_SMD:C_0805_2012Metric | candidate_not_qualified
R16005 | 10000R | CRCW060310K0FKEA | Resistor_SMD:R_0603_1608Metric | candidate_not_qualified
R16006 | 10000R | CRCW060310K0FKEA | Resistor_SMD:R_0603_1608Metric | candidate_not_qualified
R16007 | 10000R | CRCW060310K0FKEA | Resistor_SMD:R_0603_1608Metric | candidate_not_qualified
R16008 | 10000R | CRCW060310K0FKEA | Resistor_SMD:R_0603_1608Metric | candidate_not_qualified
U16003 | SN74LVC1G17DBVR | SN74LVC1G17DBVR | Package_TO_SOT_SMD:SOT-23-5 | candidate_not_qualified
R16009 | 33R | CRCW060333R0FKEA | Resistor_SMD:R_0603_1608Metric | candidate_not_qualified
R16010 | 100000R | CRCW0603100KFKEA | Resistor_SMD:R_0603_1608Metric | candidate_not_qualified
R16011 | 33R | CRCW060333R0FKEA | Resistor_SMD:R_0603_1608Metric | candidate_not_qualified
C16007 | 100nF | GRM188R72A104KA35D | Capacitor_SMD:C_0603_1608Metric | candidate_not_qualified
