DeadlySIn777/Controller/hardware/motherboard_fast_inputs/bom.csv

Reference | Value | MPN | Footprint | Status | Scope
U1 | AM26LV32EIPWR | AM26LV32EIPWR | Package_SO:TSSOP-16_4.4x5mm_P0.65mm | candidate_not_qualified | physical_component_candidate
C1 | 100nF 100V X7R | GRM188R72A104KA35D | Capacitor_SMD:C_0603_1608Metric | candidate_not_qualified | physical_component_candidate
C2 | 1uF 16V X7R | 885012206052 | Capacitor_SMD:C_0603_1608Metric | candidate_not_qualified | physical_component_candidate
U2 | AM26LV32EIPWR | AM26LV32EIPWR | Package_SO:TSSOP-16_4.4x5mm_P0.65mm | candidate_not_qualified | physical_component_candidate
C3 | 100nF 100V X7R | GRM188R72A104KA35D | Capacitor_SMD:C_0603_1608Metric | candidate_not_qualified | physical_component_candidate
C4 | 1uF 16V X7R | 885012206052 | Capacitor_SMD:C_0603_1608Metric | candidate_not_qualified | physical_component_candidate
U3 | AM26LV32EIPWR | AM26LV32EIPWR | Package_SO:TSSOP-16_4.4x5mm_P0.65mm | candidate_not_qualified | physical_component_candidate
C5 | 100nF 100V X7R | GRM188R72A104KA35D | Capacitor_SMD:C_0603_1608Metric | candidate_not_qualified | physical_component_candidate
C6 | 1uF 16V X7R | 885012206052 | Capacitor_SMD:C_0603_1608Metric | candidate_not_qualified | physical_component_candidate
U4 | AM26LV32EIPWR | AM26LV32EIPWR | Package_SO:TSSOP-16_4.4x5mm_P0.65mm | candidate_not_qualified | physical_component_candidate
C7 | 100nF 100V X7R | GRM188R72A104KA35D | Capacitor_SMD:C_0603_1608Metric | candidate_not_qualified | physical_component_candidate
C8 | 1uF 16V X7R | 885012206052 | Capacitor_SMD:C_0603_1608Metric | candidate_not_qualified | physical_component_candidate
R1 | 120R 1% 0.5W / FIT | CRCW1210120RFKEA | Resistor_SMD:R_1210_3225Metric | candidate_not_qualified | physical_component_candidate
R2 | 120R 1% 0.5W / FIT | CRCW1210120RFKEA | Resistor_SMD:R_1210_3225Metric | candidate_not_qualified | physical_component_candidate
R3 | 120R 1% 0.5W / FIT | CRCW1210120RFKEA | Resistor_SMD:R_1210_3225Metric | candidate_not_qualified | physical_component_candidate
R4 | 120R 1% 0.5W / FIT | CRCW1210120RFKEA | Resistor_SMD:R_1210_3225Metric | candidate_not_qualified | physical_component_candidate
R5 | 120R 1% 0.5W / FIT | CRCW1210120RFKEA | Resistor_SMD:R_1210_3225Metric | candidate_not_qualified | physical_component_candidate
R6 | 120R 1% 0.5W / FIT | CRCW1210120RFKEA | Resistor_SMD:R_1210_3225Metric | candidate_not_qualified | physical_component_candidate
R7 | 120R 1% 0.5W / FIT | CRCW1210120RFKEA | Resistor_SMD:R_1210_3225Metric | candidate_not_qualified | physical_component_candidate
R8 | 120R 1% 0.5W / FIT | CRCW1210120RFKEA | Resistor_SMD:R_1210_3225Metric | candidate_not_qualified | physical_component_candidate
R9 | 120R 1% 0.5W / FIT | CRCW1210120RFKEA | Resistor_SMD:R_1210_3225Metric | candidate_not_qualified | physical_component_candidate
R10 | 120R 1% 0.5W / FIT | CRCW1210120RFKEA | Resistor_SMD:R_1210_3225Metric | candidate_not_qualified | physical_component_candidate
R11 | 120R 1% 0.5W / FIT | CRCW1210120RFKEA | Resistor_SMD:R_1210_3225Metric | candidate_not_qualified | physical_component_candidate
R12 | 120R 1% 0.5W / FIT | CRCW1210120RFKEA | Resistor_SMD:R_1210_3225Metric | candidate_not_qualified | physical_component_candidate
R13 | 120R 1% 0.5W / FIT | CRCW1210120RFKEA | Resistor_SMD:R_1210_3225Metric | candidate_not_qualified | physical_component_candidate
R14 | 120R 1% 0.5W / FIT | CRCW1210120RFKEA | Resistor_SMD:R_1210_3225Metric | candidate_not_qualified | physical_component_candidate
R15 | 120R 1% 0.5W / DNP | CRCW1210120RFKEA | Resistor_SMD:R_1210_3225Metric | DNP_optional_qualification_required | physical_component_candidate
R16 | 120R 1% 0.5W / DNP | CRCW1210120RFKEA | Resistor_SMD:R_1210_3225Metric | DNP_optional_qualification_required | physical_component_candidate
