DeadlySIn777/Controller/hardware/motherboard_terminals/bom.csv

Reference | Value | MPN | Footprint | Status
J19501 | XM0 / 1844333 | 1844333 | Connector_Phoenix_MC:PhoenixContact_MC_1,5_14-G-3.5_1x14_P3.50mm_Horizontal | source_candidate_not_qualified
J19502 | XM1 / 1844333 | 1844333 | Connector_Phoenix_MC:PhoenixContact_MC_1,5_14-G-3.5_1x14_P3.50mm_Horizontal | source_candidate_not_qualified
J19503 | XM2 / 1844333 | 1844333 | Connector_Phoenix_MC:PhoenixContact_MC_1,5_14-G-3.5_1x14_P3.50mm_Horizontal | source_candidate_not_qualified
J19504 | XM3 / 1844333 | 1844333 | Connector_Phoenix_MC:PhoenixContact_MC_1,5_14-G-3.5_1x14_P3.50mm_Horizontal | source_candidate_not_qualified
J19505 | XM4 / 1844333 | 1844333 | Connector_Phoenix_MC:PhoenixContact_MC_1,5_14-G-3.5_1x14_P3.50mm_Horizontal | source_candidate_not_qualified
J19506 | XM5 / 1844333 | 1844333 | Connector_Phoenix_MC:PhoenixContact_MC_1,5_14-G-3.5_1x14_P3.50mm_Horizontal | source_candidate_not_qualified
J19507 | XM6 / 1844333 | 1844333 | Connector_Phoenix_MC:PhoenixContact_MC_1,5_14-G-3.5_1x14_P3.50mm_Horizontal | source_candidate_not_qualified
J19508 | XM7 / 1844333 | 1844333 | Connector_Phoenix_MC:PhoenixContact_MC_1,5_14-G-3.5_1x14_P3.50mm_Horizontal | source_candidate_not_qualified
J19509 | XM8 / 1844333 | 1844333 | Connector_Phoenix_MC:PhoenixContact_MC_1,5_14-G-3.5_1x14_P3.50mm_Horizontal | source_candidate_not_qualified
J19510 | XM9 / 1844333 | 1844333 | Connector_Phoenix_MC:PhoenixContact_MC_1,5_14-G-3.5_1x14_P3.50mm_Horizontal | source_candidate_not_qualified
J19511 | XM10 / 1844333 | 1844333 | Connector_Phoenix_MC:PhoenixContact_MC_1,5_14-G-3.5_1x14_P3.50mm_Horizontal | source_candidate_not_qualified
J19512 | XM11 / 1844333 | 1844333 | Connector_Phoenix_MC:PhoenixContact_MC_1,5_14-G-3.5_1x14_P3.50mm_Horizontal | source_candidate_not_qualified
J19513 | XE0 / 1844294 | 1844294 | Connector_Phoenix_MC:PhoenixContact_MC_1,5_10-G-3.5_1x10_P3.50mm_Horizontal | source_candidate_not_qualified
J19514 | XE1 / 1844294 | 1844294 | Connector_Phoenix_MC:PhoenixContact_MC_1,5_10-G-3.5_1x10_P3.50mm_Horizontal | source_candidate_not_qualified
J19515 | XE2 / 1844294 | 1844294 | Connector_Phoenix_MC:PhoenixContact_MC_1,5_10-G-3.5_1x10_P3.50mm_Horizontal | source_candidate_not_qualified
J19516 | XE3 / 1844294 | 1844294 | Connector_Phoenix_MC:PhoenixContact_MC_1,5_10-G-3.5_1x10_P3.50mm_Horizontal | source_candidate_not_qualified
J19517 | XH1 / 1844294 | 1844294 | Connector_Phoenix_MC:PhoenixContact_MC_1,5_10-G-3.5_1x10_P3.50mm_Horizontal | source_candidate_not_qualified
J19518 | XH2 / 1844317 | 1844317 | Connector_Phoenix_MC:PhoenixContact_MC_1,5_12-G-3.5_1x12_P3.50mm_Horizontal | source_candidate_not_qualified
J19519 | XDI0 / 1844317 | 1844317 | Connector_Phoenix_MC:PhoenixContact_MC_1,5_12-G-3.5_1x12_P3.50mm_Horizontal | source_candidate_not_qualified
J19520 | XDI1 / 1844317 | 1844317 | Connector_Phoenix_MC:PhoenixContact_MC_1,5_12-G-3.5_1x12_P3.50mm_Horizontal | source_candidate_not_qualified
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
