DeadlySIn777/Controller/hardware/octopus_external_adapter/purchase_review/amazon-cart-20261006.png

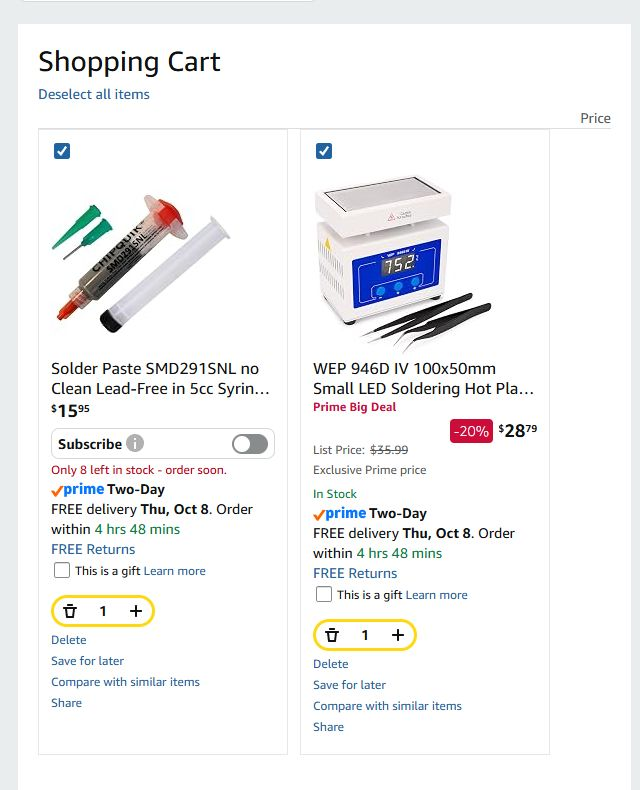
hardware/octopus_external_adapter/purchase_review/amazon-cart-20261006.png
