DeadlySIn777/Controller/hardware/octopus_external_adapter/purchase_review/amazon-cart-final-20261006.png

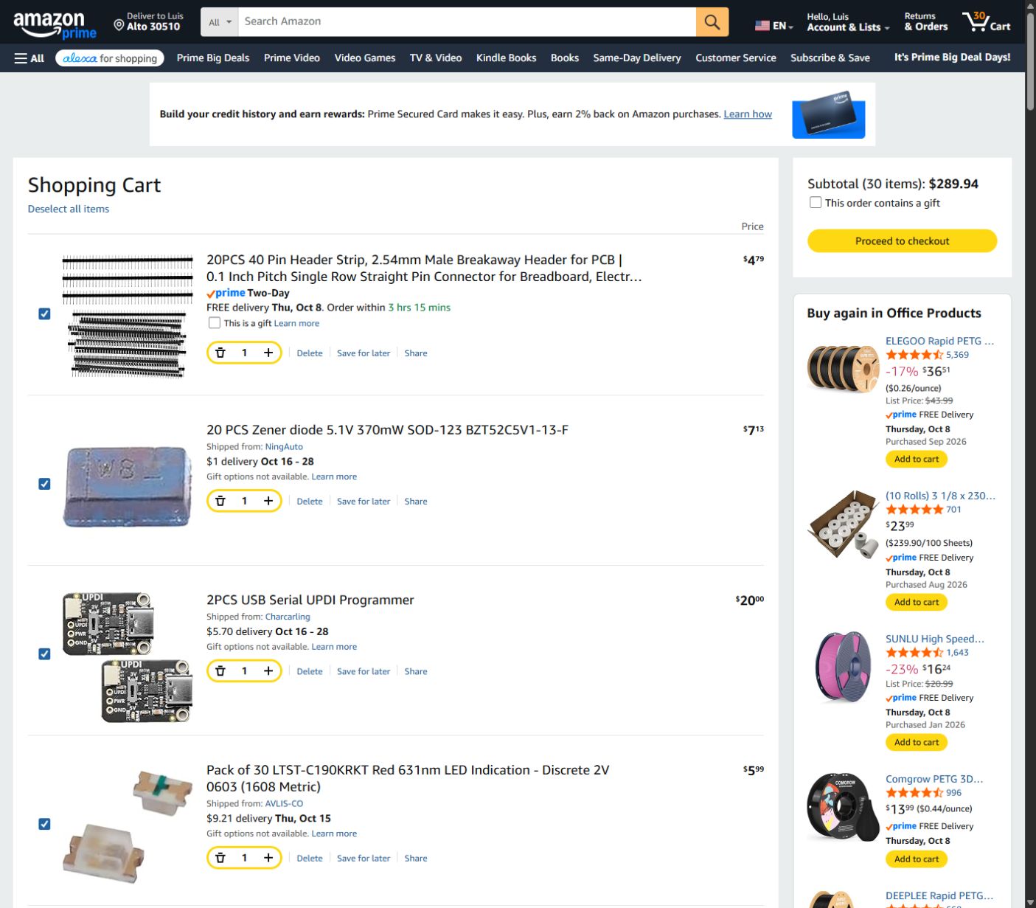
hardware/octopus_external_adapter/purchase_review/amazon-cart-final-20261006.png
