DeadlySIn777/Controller/hardware/octopus_external_adapter/purchase_review/amazon-connectors-live-programmer-added-20261006.png

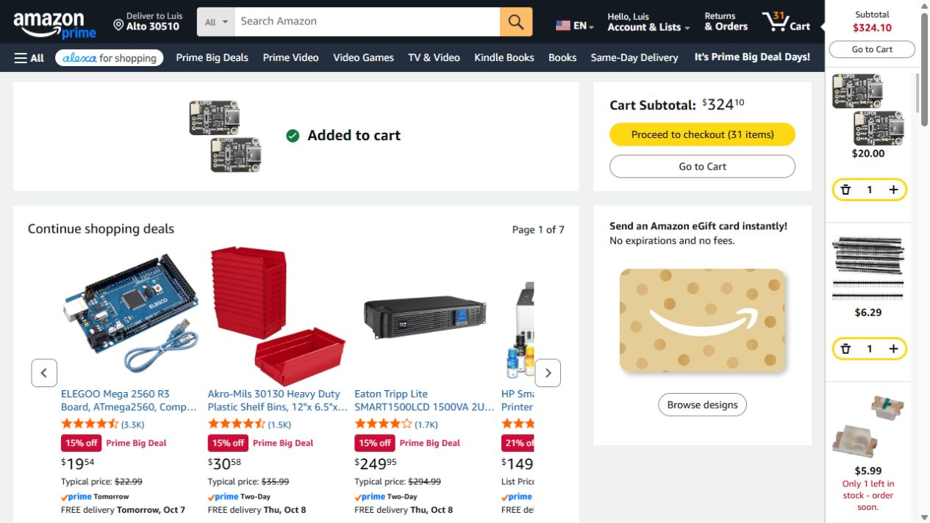
hardware/octopus_external_adapter/purchase_review/amazon-connectors-live-programmer-added-20261006.png
