DeadlySIn777/Controller/hardware/octopus_external_adapter/purchase_review/pcbway-budget-5-purple-enig.png

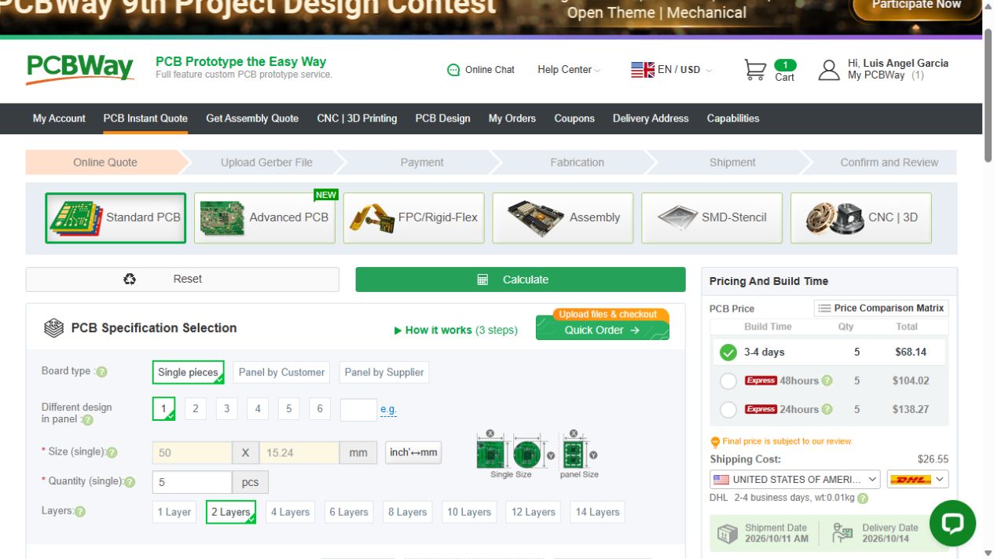
hardware/octopus_external_adapter/purchase_review/pcbway-budget-5-purple-enig.png
