DeadlySIn777/Controller/hardware/octopus_external_adapter/purchase_review/pcbway-budget-5-purple-hasl.png

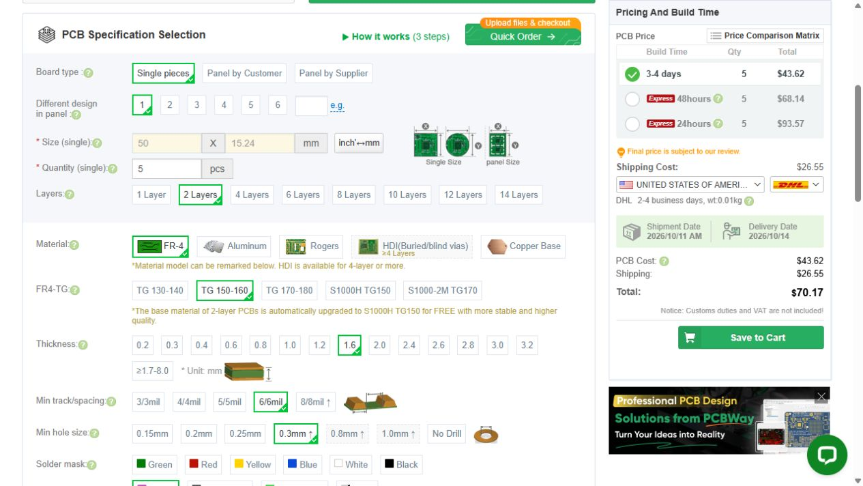
hardware/octopus_external_adapter/purchase_review/pcbway-budget-5-purple-hasl.png
