DeadlySIn777/Controller/hardware/octopus_external_adapter/r0_1/adapter-assembly-review.step

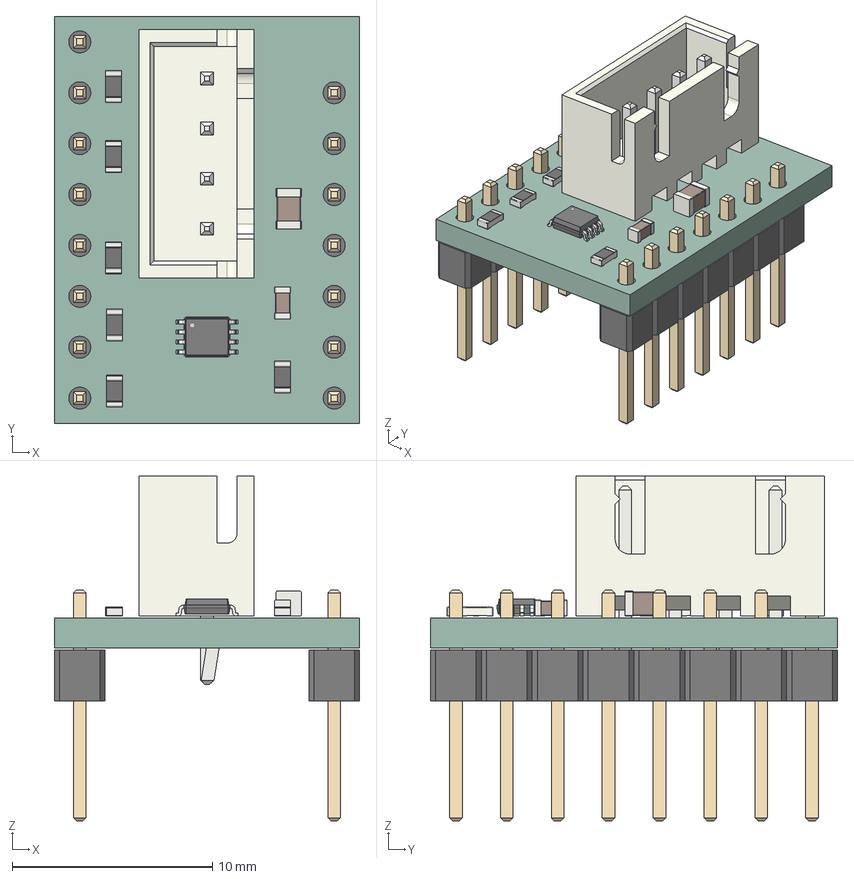
[picture p54: CAD file, 2026-10-18]
hardware/octopus_external_adapter/r0_1/adapter-assembly-review.step
15.2 x 20.3 x 17.2 mm
R_0603_1608Metric x 6
C_0805_2012Metric
JST_B4B_XH_A
VSSOP-8_2.3x2mm_P0.5mm
C_0603_1608Metric
PinHeader_1x08_P254mm_Vertical
PinHeader_1x07_P254mm_Vertical
adapter_PCB
