DeadlySIn777/Controller/docs/BUILD_PLAN.md

# Build plan: working quality, then cost

**Current execution checkpoint — 18 October review of 17 October evidence:** finish the one active motherboard with all twelve motor interfaces, individual enable/alarm, four ABZ encoders, 24 general DI and 16 smart DO plus the retained process, analog, communications and protective interfaces. The isolated R299 finishing branch still has **1,172 required pad-island joins / 1,183 API unconnected items**. Its corrected baseline has **zero ordinary cached native DRC errors, 332 retained warnings and zero schematic parity issues**; this is distinct from adopted Source26/ROOT104/CAD30 below. Stage1's composed full native refill/AFTER audit is open in the cited report. Stages2–4 have exact native input checks; their full fills, resulting joins, return/current/SI and assembly qualification remain open. Ordinary drilled vias intersecting SMD lands, complete power paths and physical/manufacturing release remain blockers. No incomplete package is ready for PCBWay.

**Current disconnected runtime and FPGA evidence:** real LinuxCNC FREE-joint planners/HAL → C driver → serial SPI → selected current SIM2 RTL → independent virtual feedback passes twelve-active and eight-active profiles, with all twelve interfaces fitted. The tested event-memory/capture/transport implementation is applied to canonical disconnected SIM2 with byte backups and guarded rollback; production adoption remains false. Actual Efinity 2026.1 mapping reports **15,805 LUT4 + 2,107 ADD = 17,912**, 10,441 FF, 63 RAM5K and one multiplier, 1,816 below the coarse 19,728 T20 screen. Real vendor pin/voltage checks cover 135 assigned pins and seven source-defined 3.3 V banks. A complete physical motherboard wrapper, I/O insertion, place/route and timing remain open. Source inspection, host tests, target builds, HDL/primitive simulation, native mapping, ERC/DRC and physical measurement retain separate evidence scopes.

The dated entries below retain earlier source, adoption, software and cost baselines; their figures do not replace the current finishing or SIM2 evidence above.

**Documentation review: 18 October 2026.** Reconciled with [engineering status](../reports/ENGINEERING_STATUS.md) and the [17 October finishing evidence](../reports/board-finish-20261017/README.md). Use the [documentation index](README.md) for current contracts and historical records.

**4 October implementation — Motion X12 appliance pass:** [current results](../reports/appliance-os-20261004/README.md) implement persistent Machine, Setup, Diagnostics, Files and Settings destinations, reviewed shared-service interface preferences and reversible interface reset/undo. Deliberate service details are presentation only; full machine reset is blocked. Files is limited to read-only validation/download of approved-folder configuration/support packages, with no extraction or apply. Current-source browser QA covers the interface; physical display performance remains a qualification task.

The deterministic disconnected OS overlay has 48 application files/62 payload files and passes 25 tests, 17 actual nonroot Linux checks, five system-unit and two user-recovery-unit syntax checks. Fresh read-only preflight runs on every application launch. Application and optional kiosk have bounded three-start budgets and separate recovery. Next qualify the exact base/compute/kernel, actual kiosk and boot, independent runtime supervisor, graphics/frame pacing, loaded RT behavior, signed updates and protected recovery storage. No runtime unit or bootable image is supplied; compressed packages are unavailable in the tested Linux Python 3.13 base. $0 API expenditure, unchanged routing, 71 frozen runtime inputs and 24 original configuration sources preserve the previous baseline.

**4 October scope — OS appliance and deeper integration:** the user explicitly requests a polished dark/red operating-system experience with software prepared beforehand, simple setup and smooth operation. Implemented [OS shell/image contract](CONTROLLER_OS.md) reuses the existing service/CLI and keeps target boot/performance qualification open. [Current SIM2 integration](../reports/deeper-runtime-20261004/README.md) now passes actual LinuxCNC FREE-joint task/planner execution for twelve and eight active joints, all twelve fitted, through C/SPI/current RTL/independent virtual feedback. Physical I/O acquisition, coordinated machining/homing, loaded RT behavior, signed target image and actual-device Efinity resource/timing closure remain separate gates. This is the user-authorized OS extension to the preceding feature freeze; Claude retains routing.

**Earlier 4 October direction — Rev A qualification:** freeze the current user-facing feature baseline and follow [REV_A_QUALIFICATION](REV_A_QUALIFICATION.md). Prioritize one continuous twelve-channel LinuxCNC/HAL/CNC3/serial-RTL/virtual-machine execution with four encoders and real protocol I/O/fault feedback, current-source diagnostic C/HDL replay, then actual-device Efinity fit/static timing. Record incomplete provider/authority boundaries rather than bypassing host refusal. Keep physical validation and manufacture open. Claude's ROOT105/routing remains untouched. [Single gap report](../reports/rev-a-integration-20261004/README.md).

**4 October deep upgrade:** continue from the [applied common-service upgrade](../reports/deep-upgrade-20261004/README.md): source-grounded local intake, readiness, bound saves, configuration/backup self-check and browser recovery are implemented and tested. Read-only diagnostic firmware freshness/watchdog fixes have fresh host C and four ARM compile records; historical HDL results do not cover the modified source automatically. Physical commissioning, loaded timing, current-source integration replay and product gates remain open. Claude retains routing.

**4 October machine-intelligence follow-up:** build from the common setup definition and [implemented state/diagnostic/package foundation](DIAGNOSTICS_AND_PACKAGES.md). Close [one supported flagship workflow](FLAGSHIP_WORKFLOW.md) through measured commissioning, verified fixture/job preview, injected fault evidence and qualified replacement recovery before increasing the feature list. Simulation observations and archive checks do not close physical capability, discovery, safety or update gates. Claude's routing remains untouched.

**4 October implementation update:** [the setup workbench](SETUP_WORKBENCH.md) implements the local simulation UI/service/CLI, retained drafts, validated transactions, offline guidance and reserved optional AI requests. [Verification and remaining work](../reports/readiness-fixes-20261004/README.md) keep physical equipment profiles, runtime integration, paid-model evaluation and commissioning open. Continue from this code rather than rebuilding these foundations. Claude retains routing ownership.

**3 October readiness priority:** while Claude owns routing, advance the common service, exact equipment profiles and [AI-assisted setup acceptance contract](AI_SETUP_CONTRACT.md). Prove one complete supported setup with saved facts, deterministic validation, bounded API spending and guided verification before broadening advertised capability. The [fresh readiness audit](../reports/readiness-reaudit-20261003/README.md) distinguishes current implementation from plans; no routing or target firmware is changed by this update.

**Current adopted board — Source26/ROOT104, published CAD30:** [Exact adoption](../reports/motherboard-return-zoning-20261002/ROOT103-bypass-PROC-composed-r01/adoption.json) and the published board share SHA-256 `70b71c36778e49600b77f382cf84df81ef3ac6dce442cc0e576b494d307979cc`. There are **2,688 footprints, 11,807 track/via items, 1,544 zones/rule areas and 3,508 required joins remaining**. Native and independent uncapped connectivity agree: 633 fully joined and 1,101 incomplete multi-pad nets, zero orphan copper. Native regular DRC is **0 errors/0 warnings/no ignored checks**; Source26 ERC is **0 errors/70 unsuppressed warnings**, with [exact warning dispositions](../reports/motherboard-erc-20261002/source26-exact-warning-disposition-r01/receipt.json). The 48 controlled additions preserve all prior copper, lands, poses and zone definitions. Actual saved/refilled removal of all 48 restores the baseline 3521 joins. Scoped proofs cover 120 bypass loops, 245 receiving returns and 188 Source-anchored filled resources. Source27 corrections remain staged; no Freerouting copper has been adopted.

[Fresh full r08](../reports/pre-hardware-validation-20261002/full-bypass-PROC-seeded-IS2-r08/report.json) has **25 PASS, 9 BLOCKED, 1 physical NOT_RUN and 0 FAIL**, with **1,895 host and 238 native KiCad cases passing**, five Windows symlink skips and all 4,041 scoped source hashes unchanged. Fresh evidence includes 2,048 actual SPI seeded trials in eight fault classes, 18 reset/fault mechanical-model scenarios, the four-stage diagnostic IOL1 replay, the five-stage read-only IS2 CAP3 profile and eleven-stage stateful replay. These are compiled C/RTL and ideal-mechanics proofs, not complete HAL, target timing, electrical safety or measured hardware ratings.

[Characterization r06](../reports/pre-hardware-characterization-20261002/characterization-register-r06/requirements-and-coverage.json) preserves all 15 subsystem, 22 fault and nine complete-machine requirements. No complete machine profile is yet validated. The original transport CAP3 gap and the bounded IS2 read-only implementation are distinct; the new profile deliberately remains unqualified and cannot authorize motion. Frozen CNC3 rate limits remain unchanged; the requested 2 MHz/channel target is not implemented/qualified. Complete IOL1 authority, record trust/provisioning, analog-chain convergence, vendor FPGA fit/timing and full-load operation remain open. The r08 record-acquisition mapping exceeded the coarse T20 resource screen. The historical report-local arithmetic-sharing candidate screened at 19,477 LUT4+ADD against 19,728, leaving only 251; the [3 October reaudit](../reports/readiness-reaudit-20261003/software-audit.md) retains that unadopted source scope. Current canonical disconnected SIM2 has the later native 17,912 LUT4+ADD result above. Neither result establishes complete physical-wrapper capacity, place/route or timing.

[Adopted Source26/ROOT104 drill/land audit](../reports/motherboard-pcb-integration-20261002/ROOT103-bypass-PROC-full-drill-SMD-r01/receipt.json) finds **274 drilled vias intersecting 277 same-net paste SMD lands**, zero foreign-net intersections and no added overlap in ROOT104. This lower bound excludes tangency and registration margins. Layout correction or exact qualified filled/capped fabrication and assembly is still required; tenting and clean ordinary DRC do not close it. The **460×340 mm, six-layer, 1.6 mm** stackup remains provisional. Final routing, power distribution, complete 20 ms inhibit, mechanics, manufacturing outputs and physical validation are unfinished. **Manufacturing readiness remains false.**

[Unchanged Source26 partial BOM v11](../reports/motherboard-cost-20260930/source-r26-2688-complete-cost-v11/README.md) has known-priced consumed parts at 1/10/100 units of **US$1,091.51/$877.37/$796.51**; 105 exact MPNs are priced and 185 MPNs/720 fitted pieces remain unpriced. Plug-in modules, screens, fabrication, assembly, programming/test, enclosure and packaging remain separate unknowns. This is not a complete product cost or PCBWay quote.

**Added pre-fabrication acceptance work, 1 October 2026:** integrate the [characterization register](../reports/pre-hardware-characterization-20261001/characterization-register-r02/requirements-and-coverage.json) alongside routing, source correction and manufacturing checks. Preserve actual source/RTL and test their limits with named corners, every emitted pulse counted, retained failing seeds/traces and explicit missing-model failures. Complete real CNC3/HAL-to-Verilated RTL, mechanical plant and fault/UX profiles before claiming a complete virtual machine. Run source-bound circuit simulations and Efinity device fit/static timing; qualify final routed trace/return/cable/power geometry. Generate conservative provisional ratings only where all relevant limits are supported, then confirm/derate with Rev A. The first component sweep and mutation controls are implemented; the full virtual controller and electrical qualification are not.

**Additional motion qualification target, 1 October 2026:** qualify all twelve fitted STEP/DIR channels simultaneously at up to 2 MHz/channel with enforced per-drive timing/polarity/rate profiles and atomic commands in a deterministic 1 kHz servo cycle. Qualify four base ABZ inputs and expansion toward twelve alongside all twelve motors. First reconcile actual spare FPGA resources, expansion-connector contacts and current 96-byte command/176-byte feedback capability for eight more ABZ channels without consuming mandatory motor/I/O resources. Any necessary future protocol version is unimplemented; do not silently rewrite the frozen frames. Higher pulse rate, CPU affinity and prior LinuxCNC joint-module loading do not establish loaded real-time/electrical qualification. [Detailed target](MOTION_EXPANSION_8_TO_12.md); [G23/G24](CURRENT_ACCEPTANCE_GATES.md).

**Execution priority, 30 September 2026:** the user now prioritises a working, excellent controller, followed by cost reductions against its verified capabilities. Proceed from the existing audit and reusable IS-1 logical/electrical contracts, close confirmed electrical defects, and complete all twelve motion interfaces and the required I/O on the one active motherboard under the versioned IS-2 physical transition. Compare whole fitted implementations and service costs; retain the required diagnostics, protection, offline operation and repairability. The sequence and concrete handoffs are recorded in [the implementation work package](../reports/next-implementation-20260930/README.md). Cost remains a design constraint, but an unverified cheaper component is not an accepted implementation.

**Physical source and adoption boundaries:** adopted Source26/ROOT104 and published CAD30 retain their exact 2,688-footprint, 9,498-pad, 11,807-track/via, 1,544-zone/rule-area, 3,508-join snapshot above. The later isolated ROOT106/R299 finishing branch has 2,723 footprints, 9,971 pads and 1,172 required joins; it is not a replacement for the adopted board. Source representation covers twelve motor interfaces, four ABZ, 24 general DI, 16 smart DO and the retained protected interfaces. Current native input, connectivity, cached DRC and vendor pin/resource evidence is linked at the top. Complete routing, power/returns, SMD-via assembly, physical-wrapper fit/timing, physical measurements and manufacturing acceptance remain open. The current board/source and earlier MC r0.4 subsets are engineering evidence, not a completed controller.

**Historical post-r0.4 host evidence:** [post-r0.4 disconnected validation](../reports/board-completion-20260930/post-r04-host-validation/README.md) records eight envelope and 16 integration passes, with **869 full-suite cases: 864 passed, five Windows symlink skips**. All 1,272 scoped source/research hashes remained unchanged. Both focused sets are included in the full suite. The older [858-case r0.3 snapshot](../reports/board-completion-20260930/final-host-validation/README.md) is historical. Host checks do not qualify physical hardware or establish target firmware/HDL/vendor-fit results; the fresh native ERC/DRC evidence is separately recorded above.

**Dated procurement evidence — adopted Source26 cost scope:** The immutable **source26 2,688-footprint cost audit v11** separates 2,642 purchased fitted board parts from 44 bare PCB features, two DNPs and purchased modules/accessories. It prices **105 exact MPNs and leaves 185 unpriced: 720 purchased fitted pieces per board remain unpriced**. Known-priced consumed inventory per board at **1/10/100 controllers is US$1,091.51/$877.37/$796.51**. Catalogue purchase cash for those whole build quantities is **US$61,020.80/$67,419.50/$131,032.35**, including unused MOQ inventory; price, cash and stock coverage remain distinct. These are partial dated exact-MPN catalogue baskets, not complete manufactured-board/controller/kit prices or PCBWay quotations. Complete totals remain null. Compute/storage/AI/screen SKUs, other accessories, fabrication, assembly, programming/test and packaging remain separate unknowns. Independent verification checks 169 frozen files, 876 quantity rows and 13 adversarial controls. Earlier cost snapshots remain immutable history. [Frozen current cost receipt](../reports/motherboard-cost-20260930/source-r26-2688-complete-cost-v11/README.md).

**Architecture decision resolved, 30 September 2026:** the user chooses one active custom motherboard with soldered FPGA and all twelve motor interfaces, plus purchased compute, ESP and storage/settings modules. The passive base, thirteen custom cards, removable FPGA/field cards and custom MX4/XTB motors-9–12 path are superseded. Preserve the proven circuit work and all required logical/electrical/fault/software functions while collapsing their physical boundaries; this is not permission to relabel the partial MC as the finished controller. The versioned transition is in [MOTHERBOARD_IS2.md](MOTHERBOARD_IS2.md); the external IS-1 archive remains untouched. A real integrated-board identity and region capability map must replace fictitious card presence/serials.

28 September 2026 UTC, requirements reconciled 30 September 2026. The current offer is a controller assembly plus separately costed screen, power-supply, enclosure, harness and setup packages. **US$400 is a preliminary controller-assembly reference price**, superseding the earlier Mesa-priced included-screen objective and the later US$400 all-inclusive proposal. Final selling prices and margins need complete costs. Product options cover the **7-, 10-, 12-, 14-, 18- and 21-inch classes and further qualified sizes**; the $190 / 21.5-inch reference is one historical large-screen scenario. The [display-tier plan](DISPLAY_TIERS.md) defines shared UI, integration and costing of every complete offered package. Historical USD comparisons below remain dated studies, not current price commitments.

**Confirmed requirements, not open capacity choices:** all twelve differential STEP/DIR motor interfaces fitted on one custom motherboard, with at least eight usable motors and individual enable and alarm on every motor, four standard ABZ encoders, 24 general DI, 16 smart general DO with qualified current/fault diagnostics, probes/frequency/PWM/process control, analog I/O, RS-485/CAN, power protection and watchdog/permission hardware; **20 ms fault-to-inhibit** retained. No custom motor expansion card or paid unlock of fitted motors 9–12 is part of the adopted base target. Serial I/O communication still requires identity, sequence/freshness and CRC validated before outputs change. Purchased compute/service/storage exchanges and grouped pluggable-terminal whole-board service must preserve settings, offline entitlement and deliberate restart, with their own physical verification. Current six/two results remain historical evidence; twelve Ioff paths do not implement complete twelve-motor runtime or field interfaces. See [project memory](../PROJECT_MEMORY.md), [the transition](MOTHERBOARD_IS2.md) and [the historical 8-to-12 record](MOTION_EXPANSION_8_TO_12.md).

## Working production direction

**Immediate integration priority:** continue from the passed current eight-/twelve-active FREE-joint CNC3/HAL/C-driver/serial-SPI/SIM2/virtual-plant integrations, with all twelve interfaces fitted. Preserve self-test, permission, enable-settle, freshness, fault and deliberate recovery behavior. Close coordinated Cartesian/G-code/homing, actual physical I/O acquisition/authority and loaded target behavior in explicit disconnected and then qualified hardware profiles. Finish the active motherboard routing/source/power/assembly gates, complete the physical FPGA wrapper and vendor place/route/timing, and reconcile exact compute/carrier/display package costs through the common service/CLI. The [six/two milestone](INTEGRATION_MILESTONE.md) remains historical evidence.

**Persistent product requirements:** [project memory](../PROJECT_MEMORY.md) and [CLI/customization plan](CONFIGURATION_AND_CLI.md). The user explicitly wants modifiable hardware/firmware, complete machine-readable CLI coverage for chat-assisted configuration, and simple guided wiring/commissioning. These are product acceptance requirements across the following stages, not a claim that the current engineering scripts already deliver them.

**Shared interface integration:** the separate `C:/Users/Gluis/claude-worktrees/controller-interface-spec` checkout retains frozen IS-1 (`docs/CONTROLLER_INTERFACE_SPEC.md`, `spec/*.json`) and CNC3 host codec/core work. Preserve that archive. Review and integrate its logical channel ownership, enable/alarm polarity, framing/integrity/freshness, watchdog/defaults, telemetry, recovery and transport work against [IS-2](MOTHERBOARD_IS2.md). Its passive-base/card-allocation, MX4/XTB service and fictitious removable-card identities no longer govern the motherboard. Physical identity/presence/calibration changes need an explicit versioned hardware/protocol/software transition; no ABI compatibility is established by this planning update. Host models do not replace RTL/LinuxCNC or physical evidence.

**Commercial release requirements:** the controller, paid offline software licence, expansion modules and complete tested kits are separate costed offers. Kits provide integration and support; ordinary supported peripherals remain customer-sourceable under the [commercial model and licensing policy](COMMERCIAL_MODEL_AND_LICENSING.md) and published compatibility records. A legitimate supported module replacement preserves the existing software entitlement without repurchase, while a new capability expansion may have its own stated entitlement. Third-party licence notices and source/offer obligations must be reviewed for the actual distribution before release.

**Latest scope revision:** the [platform roadmap](PLATFORM_ROADMAP.md) preserves all 200 feature proposals. The one motherboard target now carries all twelve motor interfaces, four ABZ encoders, 24 general DI, 16 smart general DO and the remaining process/analog/comms/protection/status functions. Optional accessories add capability where modularity is useful; they do not supply missing mandatory base channels. Preserve the older [expanded target](EXPANDED_HARDWARE_TARGET.md) and [8-to-12 study](MOTION_EXPANSION_8_TO_12.md) as history where their physical scope differs. Pin/bank/circuit/runtime/power/thermal/cost qualification remains engineering work.

**Compute bay adopted by the user, 30 September 2026:** The user-adopted CM4/CM5 dual-100-pin bay and actual three-bit DIP readout are now present in the native compute source. The selector does not route power or bypass permission. CM4/CM5 contact mappings have primary source checks; exact Linux images/pinmux, compatibility and thermal/loading still need target qualification. Automatic pre-power hardware ID and software profiles are not implemented. AUTO remains service-only until exact identity is verified; CB1/CB2 variants remain separately unqualified and machine use disabled. Connector shape alone does not establish electrical compatibility; no routine FPGA/ESP reflash is intended for a previously qualified exchange. See [carrier contract](COMPUTE_CARRIER_STRATEGY.md).

**Local Linux compute + our own FPGA motion/I/O circuit + ESP32-S3 helper on a custom carrier.** LinuxCNC remains the proposed CNC engine under PREEMPT_RT. CM5 is a measured-cost feasibility candidate; compute selection remains open against current workload and complete controller/package costs. The older CM5 subtotal did not support its assumed profitable Mesa-priced screen bundle; that result does not establish the current assembly price or every implementation's feasibility. The controller owns machining, and a screen package requires a local interface-rendering computer unless a separately costed display computer is supplied. An external customer browser remains an additional interface.

Start the memory study at **2 GB RAM with eMMC**, then justify any increase with measurements. Include the local kiosk browser, GPU driver, representative 3D scenes and CAD conversion in memory, thermal and loaded real-time latency measurements. Qualify each offered display/host combination at native resolution and intended scaling; screen diagonal alone does not determine graphics load or compute tier. Browser workers still consume local CPU and memory; moving a task into a worker does not establish isolation from motion. Bound supported model complexity and schedule conversion work explicitly. Offline use means no cloud dependency. Essential machine execution remains local even when the browser closes.

Purchased x86/Mesa hardware remains an engineering reference, preferably using equipment already available. It is not assumed to be inside each sale unit. The custom FPGA endpoint is now a central product workstream with gateware, driver, feedback and manufacturing work of its own.

**Internal-link study:** investigate dedicated SPI before internal Ethernet, keeping the customer network on the Linux host. The pinned LinuxCNC source explicitly recognizes CM5, but its SPI board lookup needs proper support for our custom board identity and matching gateware. This is a specific development task, not plug-and-play compatibility with a T20. [SPI source audit and proof gates](../research/SPI_FEASIBILITY.md)

The Linux/FPGA/ESP architecture replaces the earlier H7/grblHAL main-controller proposal. It does not add an H7 to this processor stack. ESP-IDF firmware and FPGA gateware remain separate from LinuxCNC. The latest [ESP accessory-automation requirements](ESP_ACCESSORY_AUTOMATION.md) add qualified support-equipment sequences and direct condition monitoring; the current firmware remains read-only diagnostics. Each output has one owner. If machining relies on ESP-confirmed service readiness, lost ESP/link/sensor freshness must trigger the machine's defined response. The ESP has no seamless motion takeover role; independent protection and reviewed defaults must still work when it freezes.

## Current sourcing and historical price evidence

The [historical 980-part source cost](../reports/motherboard-cost-20260930/source-980-reviewed/README.md) is a preserved subset, superseded for current costing by the Source26 v11 audit above. The frozen **980-part source cost snapshot** prices 60 MPNs and leaves 34 unpriced (185 fitted pieces per board). Known-priced consumed component value per board at **1/10/100 units is US$379.67/$314.26/$280.60**, excluding unpriced parts, missing circuits, PCB/assembly/test and purchased compute/ESP/storage/screens. Catalogue cash includes MOQ excess and is not a stock-covered purchasing basket. Every complete manufacture/controller/package total remains null. Bare copper test pads have no purchased part or assembly placement. Earlier 327-part MC r0.4 and r0.3 cost files remain historical subsets.

The older compute, display and silicon prices below remain historical studies with their original scope. They are not the active motherboard fitted BOM, current supplier availability or a PCBWay quotation.

**Repair and recovery requirement:** [the revised service/memory contract](MODULAR_REPAIR_AND_MEMORY.md) covers qualified purchased-module exchange and whole-motherboard replacement through keyed pluggable terminal/harness groups, with protected commodity settings media, committed mirror and offline export. No separate custom motion/I/O/power board or fixed passive base is required. Whole-board replacement moves retained terminal groups and can change every circuit/calibration identity, so test its broader verification and actual service time separately from compute/ESP/media replacement. Preserve configuration and legitimate offline licences without restoring motion permissions or live position. Count terminal hardware, storage/protection, programming/test and real spare-board/module costs explicitly; existing software recovery models do not qualify the physical procedure.

**Dated multi-size sourcing study:** [CM4/CM5/CB2, reference carrier and screen matrix](../research/COMPUTE_DISPLAY_MATRIX.md), covering six exact display candidates, both I/O scopes and quantities 1/10/100/1,000. It preserves unavailable or unqualified offers explicitly, uses published display volume tiers only where observed, and leaves every complete manufacturing total incomplete. This extends sourcing to all requested screen classes without claiming a finished fitted BOM or PCBWay quote.

**Existing comparison:** [three procurement approaches and complete cost-category coverage](../research/HARDWARE_COST_COMPARISON.md). It compares lower-cost CM3 SODIMM and ROCK 3C routes in the historical 21.5-inch/six-joint scenario. Its quantity-one priced baskets are $335.27 / $339.20 / $350.26, with substantial unpriced requirements. It does not price the new screen tiers or expanded I/O. Full manufactured costs remain incomplete. The older CM5 arithmetic below is retained as historical context, not the current selected BOM.

Public quantity-one distributor snapshots, excluding tax, freight and duties. These are component references, not a board quote or guaranteed future availability.

| Candidate/reference | Function | Observed USD | Status |
|---|---|---:|---|
| CM5102016 / SC1588 | CM5, 2 GB RAM, 16 GB eMMC, wireless | $97.50 | At the dated sourcing check the distributor listed zero stock and estimated replenishment 29 March 2027; current availability is unverified |
| Efinix T20F256C4 | FPGA family/package cost reference | $12.75 | Historical C4 price reference. Current vendor checks target T20F256/I4; native pin checks and functional SIM2 mapping now exist, while complete physical-wrapper fit and timing remain open |
| ESP32-S3-WROOM-1-N8 | Service processor module | $5.66 | Reference module; external-antenna/PSRAM variant may change cost |
| **Three-part subtotal** | **Only the items above** | **$115.91** | **Not the complete electronics cost** |

Sources: [CM5 distributor listing](https://www.digikey.com/en/products/detail/raspberry-pi/SC1588/25805592), [T20 distributor listing](https://www.digikey.com/en/products/detail/efinix-inc/T20F256C4/10654496), [ESP32-S3 distributor listing](https://www.digikey.com/en/products/detail/espressif-systems/ESP32-S3-WROOM-1-N8/15200089).

At the original sourcing check, the indexed Raspberry Pi CM5 brief listed $92.50 for CM5102016 and the distributor snapshot listed $97.50; this historical study uses $97.50. The official brief then redirected to revision DS-11 and was inaccessible. These observations have not been refreshed and do not establish current procurement prices. [Indexed official pricing](https://pip-assets.raspberrypi.com/categories/944-raspberry-pi-compute-module-5/documents/RP-008181-DS/cm5-product-brief)

Still uncosted: compute-module connectors, FPGA configuration flash/clocks/rails, motion-link PHY/interface, service Ethernet/USB implementation, differential drivers/receivers, protected industrial inputs/outputs, analog spindle interface, expansion connectors, watchdog/reset/inhibit circuits, field connectors, PCB fabrication, assembly, programming, test time, scrap/rework, thermal hardware, enclosure and packaging. Antenna and final radio placement also need costing.

An FPGA's chip price does not include a working CNC endpoint. The active Efinity checks target T20F256/I4. Its pin/bank checks and disconnected functional-core mapping are measured vendor-tool evidence; the full physical wrapper, device fit, routed timing and target host-driver behavior still require qualification. Efinix offers T20 in both BGA and LQFP packages; compare total board/assembly cost and usable pins rather than choosing by silicon price alone. [Efinix Trion family](https://www.efinixinc.com/products-trion.html)

## Cost gate

The historical Mesa manufacturer snapshot records **$149 for 7I96S, $219 for 7I76EU and $249 for 7I95T**, excluding the Linux computer and touchscreen. See the [price snapshot](../research/MESA_PRICE_SNAPSHOT.json). These benchmarks explain the earlier affordability study; they are not current verified offers or the adopted selling-price ceiling. Current costing uses the preliminary US$400 controller-assembly reference and separately itemized complete packages without removing required I/O, diagnostics, protection or repairability.

In the historical CM5 comparison, the three-part subtotal plus the user's $190 screen reference is **$305.91**, before all remaining electronics, PCB assembly, power supply, enclosure, test or margin. A supplier-advertised $100 21.5-inch sample would reduce that incomplete subtotal to **$215.91**; a $129 15.6-inch retail touchscreen gives **$244.91**. Neither establishes a viable $249 complete product. These are quantity-one scenarios, not production quotes or costs for the full new display range. [Display sourcing study](../research/DISPLAY_COST_STUDY.md)

Historical illustration only: $249 net selling revenue with a 40% manufacturing gross-margin target permits **$149.40** of manufacturing cost. A $100 display would leave **$49.40 for the entire rest of the unit**, before separately accounted business costs. The margin is not a user-selected requirement. This replaced an even earlier $499 board-only illustration at the time; both bundle assumptions are superseded by current assembly-plus-package pricing.

Use `allowed manufacturing cost = net selling revenue Ã— (1 âˆ’ chosen gross margin)` with clearly defined costs. Retail sales tax is not revenue. Distributor discounts, payment fees, shipping subsidies, warranty/support, development recovery and certification/tooling allocations must be accounted for separately and consistently. Gross margin is not net profit.

Cost each complete screen tier at the actual pilot and production quantities separately: one-off prototypes, 10 units, 100 units and 1,000 units. Keep screen size separate from compute and I/O capacity; hold the exact screen package constant within a compute/I/O comparison. Include panel/touch, interfaces, cables, power, mounting/enclosure and final assembly/test. Obtain prices for actual parts and manufacturer assembly/test quotations before claiming a production cost. Do not extrapolate a volume discount that has not been quoted or assume one retail price for all sizes.

Keep all twelve required motor interfaces on the one motherboard, adding separately rated optional accessories for unusual/high-cost functions. The [terminal and cost worksheet](CORE_INTERFACE_COSTING.md) retains the historical six-joint scope: six differential STEP/DIR channels, six enables and six alarms, two A/B/index inputs, sixteen additional protected inputs, eight additional protected outputs, one 0–10 V spindle interface and defined expansion. Spindle run/direction occupy two of the eight outputs. This is 54 directly mapped digital signals before analog control, host communication and housekeeping; it neither prices the adopted product nor provides six-axis external encoder feedback. Counts, ratings and rates must be frozen against machine profiles. A cheap base that needs expensive mandatory modules for normal supported operation is not a successful cost reduction.

## Execution plan and gates

**Manufacturing decision:** send the designed boards to PCBWay for turnkey manufacture. Release fabrication files, exact BOM/alternates, placement data, assembly instructions and an agreed programming/test package together. Use PCBWay's actual quotation for parts, fabrication and assembly; other vendors' setup/stencil tariffs are not the estimate. Final display/enclosure integration and functional-test scope require explicit quotation. The PCBWay submission is a user-performed step after the release package exists. The quote must cover fabrication, parts, assembly and programming/test at the study quantities 1/10/100/1,000; the release manifest's `final_cost` stays `incomplete-quotes` until PCBWay's actual figures are recorded. The [PCBWay submission checklist](../manufacturing/PCBWAY_SUBMISSION_CHECKLIST.md) lists the required files and decisions; the design is not ready for PCBWay manufacture. Nothing is authorized for ordering at this stage.

**Optional expansion:** [AI compute plan](../research/AI_ADDON_PLAN.md). Start with an Ethernet-connected companion using its own compute/memory/power; keep ordinary machining independent of AI availability. An internal accelerator socket is conditional on the selected host, electrical/thermal budget and supported software. AI hardware is excluded from the base price comparison.

**Power protection:** [physical fuse plus electronic branch protection](POWER_PROTECTION.md). Coordinate power-entry backup protection, branch limiting and existing protected outputs with the actual supply and load ratings. Fault telemetry belongs in the common CLI/UI; clearing a trip must not automatically resume machining.

**Reliability target:** use the [industrial qualification plan](INDUSTRIAL_QUALIFICATION.md) for whole-unit power, I/O, EMC, environment, software, factory test and service requirements. Cost protected ESP power, required sensors/output drivers, independent watchdogs and qualification explicitly. The proposed HDPE enclosure needs a designed shielding/bonding, mechanical and thermal arrangement. Define per-machine stop/cooling/workholding behavior; component ratings do not become finished-product or safety claims.

**Modular equipment:** implement the [plasma module/harness/profile contract](PLASMA_MODULE_SYSTEM.md) so a qualified cutter upgrade preserves the controller and unaffected table configuration. First prove discovery, selective invalidation and fault behavior with disconnected virtual devices, then qualify a divided-voltage interface and two named harness/source combinations. Keep specialized source-voltage hardware out of the base controller's general inputs.

**Third-party accessories:** support [ordinary USB/RS-485 adapters and Modbus RTU/TCP devices](THIRD_PARTY_MODBUS.md) through tested profiles and the same UI/CLI service. A supported serial VFD does not require our own proprietary adapter. Keep motion pulses, angle/index capture and fast process feedback on their dedicated timing paths.

| Stage | What we build | What must be demonstrated before advancing |
|---|---|---|
| 1 — Product cost envelope | One active motherboard with all twelve motor interfaces, four ABZ encoders and full required I/O; commodity compute/ESP/settings modules and optional capability accessories separately costed; screen packages in 7/10/12/14/18/21-inch classes and further qualified sizes; CM-family/BTT alternatives; complete cost matrix at pilot/production quantities | Controller and every proposed complete launch package have complete estimated costs and stated uncertainty, compared with the preliminary US$400 assembly reference; no required compute, protection, diagnostics, repairability, display, power or mounting hidden in an unpriced block |
| 2 — Pre-order hardware feasibility | Qualified CM4/CM5/BTT variants; terminal/pin/rail/clock map; SPI-first transport audit; host board support and the integrated FPGA circuit; ESP power/reset/service roles | Supported software route; gateware simulation and FPGA synthesis/resource/timing evidence; full cost blocks; defined later link measurements |
| 3 — Actual LinuxCNC software prototype | Pinned simulation environment, local backend adapter, command/status/error service, preserved UI in disconnected mode | Real LinuxCNC simulated machine completes the UI workflow; no mock planner substituted; disconnect/reconnect cannot replay motion |
| 4 — Visual setup system | Shared responsive UI across screen tiers; machine profiles, STEP/STL/GLB import candidates, units/roles/placement, registration, setup persistence and dependency invalidation | Compact, medium and large layouts complete the same touch-only setup and operation workflows; representative setups import/reopen without code editing; moving fixtures invalidates affected checks; physical panel qualification follows |
| 5 — Bounded motion-link prototype | After the relevant pre-order work, use a minimal development setup with actual LinuxCNC, encoder counting, step generation and deliberate link failures | Full read/compute/write cycle and external fault behavior measured under representative load before committing final production layout (release item `link_prototype_measurement`). Acquiring the engineering host and FPGA evaluation board for this measurement is a user purchase decision |
| 6 — Complete custom design | Schematics and PCB, power/reset/output states, rated interfaces, FPGA gateware, ESP-IDF helper, build/program/test procedures | Link evidence incorporated; reviewed package/pin/bank map and updated complete BOM; reproducible builds and exact I/O ratings |
| 7 — Custom engineering prototypes | Staged bring-up of custom hardware | Loaded timing, signal integrity, actual I/O, power/reset/watchdog behavior and thermal performance meet requirements |
| 8 — Product qualification | Named machine profiles, advanced operations, recovery/update image, factory test and first-use documentation | Physical machine tests plus novice usability, offline, recovery, bad-input and production-yield evidence; finished economics still fit |

Stages 2–4 feed each other: model workloads determine memory, and advanced machining cases determine encoder/timing resources. Complete substantial source, simulation, synthesis, costing and schematic preparation before parts are ordered. The link prototype then precedes final production layout; completion of the CAD importer is not a dependency for that bounded test. Complete real-time/electrical qualification still requires later hardware.

## First integrated software demonstration

Continue from the implemented [setup workbench](SETUP_WORKBENCH.md), [appliance shell](CONTROLLER_OS.md) and current disconnected twelve-/eight-active CNC3/SIM2 integration. The common UI/CLI already supports simulation profile selection, validation, preview/diff, bound saves, wiring guidance and reviewed backup recovery. Extend one supported workflow with qualified geometry/import, registration, coordinated Cartesian job execution and fault/recovery evidence; do not present FREE-joint simulation as a completed machining workflow. Preserve the existing machine configurations and use explicit disconnected profiles. Complete costs and hardware feasibility remain gates for procurement and final manufacture.

LinuxCNC exposes local command, status and error interfaces that a service can adapt for our UI. That is an integration task; retaining the same interface does not mean its existing Grbl transport works unchanged. [LinuxCNC Python interface](https://linuxcnc.org/docs/html/config/python-interface.html), [build documentation](https://linuxcnc.org/docs/html/code/building-linuxcnc.html)

The current frontend is the dark/red Motion X12/GarciaMech appliance and setup workbench. Retain its common service contract, five destinations and deliberate service details while correcting demonstrated usability defects. The earlier FluidCNC automatic-connection study is historical; development must continue to use explicit simulation/disconnected profiles without changing or flashing the existing machine.

## Recorded baseline evidence — 28 September 2026

The following counts are retained from the earlier baseline report. They are not a fresh full-suite or expanded-controller result on 30 September. Use [engineering status](../reports/ENGINEERING_STATUS.md) and the dated audit for current checks, source defects and evidence limits; source/hash consistency or zero ERC errors do not establish correct physical pin semantics, 20 ms fault timing or manufacturing readiness.

The [CNC1 end-to-end simulation](../reports/CNC1_INTEGRATION.md) now connects actual LinuxCNC through compiled HAL read/write and the common protocol driver to actual simulated RTL. Twenty-seven volatile runtime checks include returned-count motion/reversal, ABZ/index, link-loss recovery, guarded runtime scale changes with deliberate rehome and pulse verification, and refusal of a scale above the margin-adjusted pulse-rate ceiling. The laboratory Linux SPI backend now compiles with mocked syscall tests, but the HAL runtime still uses actual RTL simulation. Target transport deadlines, Pi/Rockchip integration and physical machine behavior remain unqualified.

The then-latest baseline Python run reported **579 tests (5 Windows symlink skips)**, including persistent runtime policy, configuration/recovery CLI, research-data and circuit checks ([raw output](../reports/audit-2026-09-28/python-tests.txt); a working-tree observation, earlier 283- and 290-test runs are historical). Actual LinuxCNC passes **27 volatile regression checks plus 68 persistent checks across nine separate launches**, and the current compiled driver passes **220 assertions** ([CNC1 manifest](../cnc1/evidence/manifest.json), 2026-09-28T20:56:18Z; 26/59 and 192 are historical). [Durable runtime recovery](../reports/PERSISTENT_RUNTIME.md) now restores saved XYZ scales without restoring homing or enabling motion. [Actual FPGA synthesis](../reports/FPGA_SYNTHESIS.md) maps the existing ABI2 logic to 9,426 Efinix primitive cells, and 179 frozen-driver harness assertions pass with the mapped circuit (`inhibit_n` held deasserted; fault/ready/progress pins not observed). The RTL regression passes 252 counted v1 checks plus 27 ABI v2 checks (the 180-check figure is historical). The [six-joint transmitter](../reports/SIX_JOINT_TRANSMITTER.md) and [two-ABZ receiver](../reports/ENCODER_RECEIVERS.md) blocks pass KiCad ERC. ESP builds retain their own evidence in `firmware/esp32_service/evidence/`. Remaining work includes physical target transport/timing, complete field I/O and power/protection, vendor device implementation, full schematics/layout, CAD/UI integration, physical qualification and complete production costing. [Engineering status](../reports/ENGINEERING_STATUS.md), [validation record](../reports/VALIDATION.md).
