DeadlySIn777/Controller/manufacturing/PCBWAY_SUBMISSION_CHECKLIST.md

# PCBWay turnkey submission checklist

**Documentation review: 18 October 2026.** Reconciled with [engineering status](../reports/ENGINEERING_STATUS.md) and the [17 October finishing evidence](../reports/board-finish-20261017/README.md). Use the [documentation index](../docs/README.md) for current contracts and historical records.

**Not ready for manufacture or supplier submission.** No purchase or supplier submission has occurred.

**Current finishing and adoption boundary — 18 October review:** [17 October evidence](../reports/board-finish-20261017/README.md) recovers R299 with **1,172 required pad-island joins / 1,183 API unconnected items**. The isolated corrected baseline preserves those counts and completes cached native DRC at **zero ordinary errors, 332 warnings and zero schematic parity issues**, with all 220 launch inputs unchanged. It has 2,723 footprints and 9,971 pads; its fresh ERC is zero errors/92 warnings. A distinct coordinate-only source overlay has zero ERC errors/70 retained warnings and unchanged net semantics. Do not combine those source scopes. Stage1 composed full native refill/AFTER qualification remains open in the report; stages2–4 are native input-only evidence, with full fills, new joins and electrical/assembly qualification unexecuted. None replaces adopted Source26/ROOT104/CAD30, whose exact older baseline follows.

The adopted Source26 source and CAD30 published board contain **2,688 footprints**: 2,642 purchased fitted parts, 44 bare PCB features and two DNPs. Required motor/I/O and remaining interfaces are represented in source. Recorded native Source26 ERC is **0 errors/70 unsuppressed warnings**, with [exact warning dispositions](../reports/motherboard-erc-20261002/source26-exact-warning-disposition-r01/receipt.json). Source representation does not establish target execution or physical qualification.

The adopted and published native boards share SHA-256 `70b71c36778e49600b77f382cf84df81ef3ac6dce442cc0e576b494d307979cc`: **11,807 track/via items, 1,544 zones/rule areas, 633 fully joined and 1,101 incomplete multi-pad nets, 3,508 required joins**. Recorded regular DRC is **0 errors/0 warnings/no ignored checks**, with zero orphan copper; connectivity completion fails. The **460 × 340 mm, six-layer, 1.6 mm** stackup remains provisional. These native results were not rerun in this readiness audit.

**Source27 reset/health corrections remain staged and unadopted.** Reconcile them with the routing owner's returned successor before electrical/physical release; do not overwrite ongoing routing or silently merge old candidates. The [drill/land audit](../reports/motherboard-pcb-integration-20261002/ROOT103-bypass-PROC-full-drill-SMD-r01/receipt.json) retains **274 vias intersecting 277 same-net paste SMD lands**, a lower bound excluding tangency/registration margins. Correct geometry or qualify the exact filled/capped fabrication and assembly process; tenting and ordinary DRC do not close this issue.

Full power/return, source/reference retention, SMD-via assembly, complete 20 ms inhibit/defaults, physical CNC3/HAL/local-I/O authority, record trust/provisioning, analog chain, mechanics, target load and physical/EMC/thermal qualification remain unfinished. Current actual eight-/twelve-active FREE-joint LinuxCNC/C-driver/SPI/SIM2/virtual-plant results are disconnected software/HDL evidence. Real Efinity checks pass 135 assigned pins and seven source-defined 3.3 V banks; the corrected canonical disconnected functional core maps at 15,805 LUT4 + 2,107 ADD = 17,912 with 63 RAM5K. This is below a coarse T20 screen, with no complete physical motherboard wrapper, I/O insertion, place/route, timing or bitstream qualification. Gerbers, drills, production CPL/drawings, programming/test bundle and final stackup have not been released. **Manufacturing readiness remains false.** Historical six-joint/two-encoder runtime remains separate from current eight-/twelve-active simulation and physical coordinated motion.

The dated immutable [Source26 partial cost audit v11](../reports/motherboard-cost-20260930/source-r26-2688-complete-cost-v11/README.md) prices 105 exact MPNs; **185 MPNs/720 purchased fitted pieces remain unpriced**. Known-priced consumed parts per board at **1/10/100 are US$1,091.51/$877.37/$796.51**. Purchased modules, displays, fabrication, assembly, programming/test, enclosure and packaging remain separate unknowns. This basket does not price the later ROOT106/R299 branch. Complete manufactured controller/package totals remain unknown; this is not a PCBWay quotation. Earlier 980-part and CAD21 figures are preserved in [the pre-audit checklist](../reports/readiness-reaudit-20261003/before-docs/manufacturing/PCBWAY_SUBMISSION_CHECKLIST.md).

## Files and evidence required before turnkey submission

- Reconciled complete-controller schematic, exact pin/bank/terminal maps, power/fault/default-state review and actual electrical limits.
- Fully routed native PCB, zero required unconnected joins, native ERC/DRC with justified documented exceptions only, independent connectivity and mechanical/mating review.
- Final approved stackup, copper weights, material/thickness/finish, impedance/clearance/via/process rules and board outline.
- Real Gerbers, drill data and fabrication ZIP from that exact released board.
- Exact fitted-parts PCBWay BOM, origin/orientation-verified CPL and assembly drawings; distinguish purchased compute/ESP/storage/display modules and incomplete costs.
- Exact programmed BOM lines, versioned images, complete physical FPGA wrapper/package fit/routed timing, compatible compute images and verified safe startup/defaults.
- Approved commodity compute/ESP/storage replacements and distinct whole-motherboard service through retained keyed terminal/harness groups; protected settings/mirror/export, offline entitlement, replacement calibration, every moved group, affected verification and deliberate inhibited restart. Measure actual service time and spare cost; no inherited five-minute card-swap promise.
- All twelve fitted motor interfaces/individual enables and alarms, four ABZ, 24 general DI/16 smart DO and retained interfaces on one motherboard; no fictitious card-presence/serial records or screen/licence reduction of fitted channels.
- Complete cost and exact display/compute/power/enclosure/harness/test scope for each offered 7/10/12/14/18/21-inch-class or other qualified package; US$400 remains only a preliminary assembly reference.
- Bounded motion-link measurements before final layout, bring-up/proof-test limits, fixture/programming/functional-test scope, and subsequent physical qualification.
- PCBWay quote tied to those exact files and quantities 1/10/100/1,000; purchasing terms and any order remain separate actions.

Current design has none of the released Gerber/drill/CPL/assembly/stackup package. Review PDFs and 3D renders are engineering evidence; they must not be renamed as factory-ready files. The [original 28 September checklist](../reports/board-completion-20260930/release-state-r04/historical-inputs/PCBWAY_SUBMISSION_CHECKLIST.md) retains the earlier repository inventory, supplier requirements and open tasks as historical evidence. Its claims that no PCB or hierarchical assembly existed are superseded, and its older user-choice list does not reopen decisions already recorded in project memory.

Supplier reference requirements remain linked in that retained checklist. Current manufacturer capability, source availability and final pricing must be verified for the actual completed package before submission. No supplier communication, upload, purchase or fabrication output is performed by this reconciliation.
