DeadlySIn777/Controller/review/TMR-setup-correction.md

The global routing setup now corrects five malformed converter keepout areas. The original generator specified rectangles covering each TMR4WI courtyard plus 0.6 mm. A later `build_a.py` regular expression consumed the closing parenthesis of the final coordinate, leaving three vertices. Review of all 109 current rule areas isolated this lost-corner defect to those five TMR areas. The recorded engineering envelope is now restored; Traco's instruction to avoid PCB traces under the converter supports the underbody restriction, but does not prescribe the project's 0.6 mm margin.

The coupled native candidate also subtracts the full rectangles from eight foreign source-zone outlines, applying each converter's exact existing own-net exemptions. Native integer geometry and save/reload checks preserve single-outer ownership, holes, zone profiles, priorities and minimum widths. The cuts remove 83.2022803 mm² of source intent. The affected cached fills are cleared; new physical fill and connectivity remain unverified.

Native analytic shape checks found 345 retained tracks and 14 vias on 20 foreign nets inside the restored halves; 266 of those items also intersect the actual fabrication-body footprint. The global reroute starting board removes exactly these 359 records, preserves 5,634 other route records on those nets, and keeps every other parent record unchanged. The original board and removed records remain preserved. Complete affected nets must be rerouted coherently and their original source-pad relationships restored.

The matching R6 router input is `TMR-clean-plane-free-F-In3-B-domain600-r6.dsn`, SHA256 `78f2e471219a1ddacd169d6bc307fd5cd5273bdab5d3c90f9efa8ebec6c3cf33`. Its native import base has SHA256 `f86fc7b89afee417b1f98dfeb67d8773f0f65612bed31bc64dfc12c079cfa2eb`. This bounded diagnostic input retains the 0.6 mm cross-domain matrix and full TMR constraints, and permits new signal routing on F.Cu, In3.Cu and B.Cu. Native source planes remain in the import base; omitting plane polygons from this router case does not remove their electrical obligations. Plain DSN TMR keepouts conservatively restrict own-net routing as well as foreign nets.

The earlier 1,172 open-join figure belongs to the actual R299 baseline. It is not a new count for this deliberately ripped-up input. Global routing, native refill/DRC, actual reference and return paths, current/thermal limits, assembly and manufacturing acceptance remain open. These files are setup corrections and routing evidence, with no adoption or fabrication-ready claim.
