DeadlySIn777/Controller/documentation/reports/ESP_SERVICE_BUILD.md

# ESP service implementation evidence

28 September 2026 (audit-fix rebuild). Both actual ESP32-S3 configurations compiled and linked successfully with the existing ESP-IDF 5.5.4 installation, pinned at `735507283d5b2f9fb363a1901172dbd9e847945d`, Xtensa GCC 14.2.0, run through `build-local.ps1` by `firmware/esp32_service/record_evidence.py --build --clean --host-tests` as clean builds (both variant build directories and the generated UART-variant `sdkconfig` deleted first; 1,026 "Building C object" steps per variant; manifest recorded 2026-09-28T19:17:08Z). No device was connected or flashed. Exact image sizes, hashes and source hashes are recorded in [ESP_SERVICE_BUILD.json](../WORKSPACE_REFERENCES.md#artifact-31e08398b8aabfa4) and in [`firmware/esp32_service/evidence/manifest.json`](../WORKSPACE_REFERENCES.md#artifact-97f9c1a38d18fcb2).

**Evidence retention and reproducibility.** `.build/` and `*.log` are git-ignored, so the hashed images, both build logs, the host-test log and the generated UART-variant configuration (`uart-compile-check.sdkconfig`) are retained in `firmware/esp32_service/evidence/` with `manifest.json` and `SHA256SUMS`; the default variant's effective configuration is the tracked `firmware/esp32_service/sdkconfig`, hashed in `source_sha256`. Without `--build` the recorder refuses to record if any firmware source, CMake/Kconfig file, defaults file or effective `sdkconfig` is newer than the image in `.build/`; without `--host-tests` it removes any earlier host-test log rather than carrying it forward, and `evidence_record` in the JSON states which steps ran. The build is **not reproducible**: `CONFIG_APP_COMPILE_TIME_DATE=y` embeds the time the ESP-IDF app descriptor was compiled, `CONFIG_BOOTLOADER_COMPILE_TIME_DATE=y`, and `CONFIG_APP_REPRODUCIBLE_BUILD` is unset. A clean rebuild of identical source is therefore expected to produce different image hashes; the retained images' embedded compile times (15:15:59 default, 15:16:45 UART check) are recorded as `app_description` in `manifest.json`. (Unretained workstation observation, not evidence: earlier builds in this fix pass of the same firmware source produced different hashes; none of those images or logs were kept, so their hashes are not cited.) The recorded hashes identify the retained copies and must be compared against them, not regenerated. The retained images are build evidence, not release or flash images.

| Variant | Host RX GPIO | Size | SHA-256 (retained copy) |
|---|---|---|---|
| Default `esp32s3` | −1 (UART link disabled) | 177,376 bytes | `f88c7d4ecbc1e5d5be7bf7985c1de9d3b9bfaf5892f416f9874e96a1a1971113` |
| `uart-compile-check` | 4 (test-only, not an approved pin) | 202,352 bytes | `f7b0a69dde6bff4354abaf33de8ca7399de83b0d132367adcdf8384ccc85e04f` |

Historical: the previous retained images (`a43b3f4e…` default, `42b53c37…` UART check, same sizes) and their logs came from a build whose recorded `service_main.c` and `Kconfig.projbuild` hashes no longer matched the source; those two images, their `SHA256SUMS` (there was no manifest), both logs and the prior report are archived in `firmware/esp32_service/evidence/before-audit-fixes-2026-09-28/`, where `sha256sum -c SHA256SUMS` verifies all four listed files.

| Check | Evidence class | Result | Limit |
|---|---|---|---|
| Default ESP32-S3 application | Target compilation | Compiled and linked; host RX disabled | No approved board pin map or physical run |
| UART-enabled compile-check variant | Target compilation | Compiled and linked with test-only GPIO4 | Exercises conditional compilation; GPIO4 is not assigned for the product |
| RX GPIO compile-time guard | Source inspection plus host preprocessor check | 19, 20 and 22–32 raise `#error`; −1, 4, 18, 21, 33 and 48 pass | Negative values were not target-compiled; 33–37 remain a module-datasheet check for octal-PSRAM modules |
| Portable C core, GCC strict warnings (`-Wall -Wextra -Werror -pedantic`) | Host test (WSL Alpine Linux v3.24, GCC 15.2.0) | Passed | Host execution, not ESP timing |
| Address and undefined-behavior sanitizers | Host test | Passed | Covers the executed cases, not every possible program behavior |
| CRC/replay/clocks/freshness/reboot/parser checks | Host test | Passed | Health observations remain advisory and unauthenticated |
| Documented deadlines and host cadence | Host test | 1000/500 ms constants asserted; exact 1 Hz sender stale at 1000 ms; 4 Hz sender with a counter advance per frame fresh at every millisecond; advance every other frame expires progress at 500 ms while the link stays fresh; replay after expiry does not renew | Local processing time only; not measured on hardware |
| Corruption/noise input | Host test | All 40 single-byte positions rejected with every accepted-health field and counter compared before and after; 100,000 pseudo-random bytes processed with bounded buffer assertions | Not exhaustive fuzzing or an electrical UART test |
| Python frame encoder tests | Host test | 5 passed | Same wire format; opens no hardware port |

**Freshness deadlines.** `link_fresh` requires an accepted frame parsed less than `SH_LINK_TIMEOUT_MS` = 1000 ms ago; `backend_progress_fresh` additionally requires an accepted same-boot frame with a forward counter change less than `SH_PROGRESS_TIMEOUT_MS` = 500 ms ago. Both are strict comparisons in local processing time. A host must send accepted frames well under 1000 ms apart (4–10 Hz recommended; exact 1 Hz flaps) and must show a counter advance in accepted frames less than 500 ms apart. Status is sampled once per second from a 10 ms loop. These are advisory deadlines chosen for this diagnostic helper, not measured or approved machine limits and not motion-watchdog timing. The firmware [README](../firmware/esp32_service/README.md) has the full contract.

The implemented helper reports host-link freshness separately from backend progress. A fresh heartbeat cannot hide an unchanged progress counter. Independent review caught and corrected a first-sample overclaim: every new boot now needs a subsequent counter advance before progress becomes fresh. UART-buffer age and cross-boot authentication remain limitations, so observations are advisory. It exposes no motion, reset, spindle, relay or enable command. Default firmware emits read-only USB diagnostic status; wireless provisioning, PGOOD/DISARMED inputs and recovery sequencing remain unfinished.

Reproduce with [firmware instructions](../firmware/esp32_service/README.md). SDK-generated build output includes example flashing commands; none were executed. Image existence is build evidence, not authorization to flash an unknown board.
