DeadlySIn777/Controller/reports/motherboard-process-20260930/generic-build-tail.txt

def build(out=OUT):
 out=Path(out);out.mkdir(parents=True,exist_ok=True);d=description();parts={**d['components'],**d['boundaries']};functions=dict(KINDS);uid=lambda n:str(uuid.uuid5(NS,n));root=uid('root');libs=[];layouts={}
 for p in d['boundaries'].values():functions[p['kind']]={int(k):(k,'passive') for k in p['pins']}
 for kind,table in functions.items():
  if kind in ['R','C','TVS']:layout=[(1,'',0,5.08,270,'passive'),(2,'',0,-5.08,90,'passive')];body='(rectangle(start -1.016 2.54)(end 1.016 -2.54)(stroke(width .254)(type default))(fill(type none)))'
  elif kind=='PWR_FLAG':layout=[(1,'pwr',0,0,90,'power_out')];body=''
  else:
   keys=sorted(table);half=(len(keys)+1)//2;layout=[(n,table[n][0],sign*12.7,20.32-i*5.08,0 if sign<0 else 180,table[n][1]) for sign,nums in [(-1,keys[:half]),(1,keys[half:])] for i,n in enumerate(nums)];low=min(p[3] for p in layout)-5.08;body=f'(rectangle(start -10.16 25.4)(end 10.16 {low})(stroke(width .254)(type default))(fill(type background)))'
  layouts[kind]=layout;libs.append(symbol(kind,layout,body,'R' if kind=='R' else 'C' if kind=='C' else 'D' if kind=='TVS' else 'J' if kind.startswith('Boundary') else '#FLG' if kind=='PWR_FLAG' else 'U'))
 items=[];netmap={};ic=pas=bnd=0
 for ref,p in parts.items():
  if ref.startswith('U'):x=63.5+(ic%7)*165.1;y=83.82+(ic//7)*139.7;ic+=1
  elif p['physical']:x=40.64+(pas%17)*68.58;y=800.1+(pas//17)*30.48;pas+=1
  else:x=63.5+(bnd%7)*165.1;y=1371.6+(bnd//7)*190.5;bnd+=1
  layout=layouts[p['kind']];small=p['kind'] in ['R','C','TVS'];rx=x+3.81 if small else x;ry=y-2.54 if small else y-max(z[3] for z in layout)-10.16
  props=''.join(f'(property {quote(k)} {quote(v)}(at {rx} {ry+dy} 0){effects(.8,"hide") if hide else effects(.8,"(justify left)" if small else "")})' for k,v,dy,hide in [('Reference',ref,0,False),('Value',p['value'],2.54,False),('MPN',p['mpn'],0,True),('Footprint',p['footprint'],0,True)])
  yes='yes' if p['physical'] else 'no';items.append(f'(symbol(lib_id "CNC:{p["kind"]}")(at {x} {y} 0)(unit 1)(in_bom {yes})(on_board {yes})(dnp no)(uuid "{uid(ref)}"){props}(instances(project "motherboard_process"(path "/{root}"(reference {quote(ref)})(unit 1)))))')
  for n,_,px,py,_,_ in layout:
   sx,sy=round(x+px,4),round(y-py,4);net=p['pins'][str(n)]
   if net is None:items.append(f'(no_connect(at {sx} {sy})(uuid "{uid(ref+str(n)+"nc")}"))');continue
   dx=-5.08 if px<0 else 5.08 if px>0 else 0;dy=0 if px else 5.08;ex,ey=round(sx+dx,4),round(sy+dy,4)
   items.append(f'(wire(pts(xy {sx} {sy})(xy {ex} {ey}))(stroke(width 0)(type default))(uuid "{uid(ref+str(n)+"wire")}"))');items.append(f'(label {quote(net)}(at {ex} {ey} 0){effects(.65,"(justify right bottom)" if px<0 else "(justify left bottom)")}(uuid "{uid(ref+str(n)+"label")}"))');netmap.setdefault(net,[]).append([ref,str(n)])
 for i,net in enumerate(['IO_3V3','LOGIC_GND','MOTION_5V_RAW']):
  ref=f'#FLG144{i}';x=30.48+i*139.7;y=1600.2;items.append(f'(symbol(lib_id "CNC:PWR_FLAG")(at {x} {y} 0)(unit 1)(in_bom no)(on_board no)(dnp no)(uuid "{uid(ref)}")(property "Reference" "{ref}"(at {x} {y} 0){effects(1,"hide")})(property "Value" "PARENT SUPPLY"(at {x} {y} 0){effects(1,"hide")})(instances(project "motherboard_process"(path "/{root}"(reference "{ref}")(unit 1)))))(label "{net}"(at {x} {y} 0){effects(.8)}(uuid "{uid(ref+"label")}"))')
 note='ACTUAL PWM/PROCESS FRONTEND / hardware rearm latch, permission gates, dual5Vpushpull PWM, independent fail-low clamps,2floatingprocess contacts.\nSource candidate only:4thACCnode,parentpermission,loadedtiming/ESD andphysicalconnectorsremain. No customcards,noautomatic rearm.'
 items.append(f'(text {quote(note)}(at 20.32 17.78 0){effects(1.4,"(justify left top)")}(uuid "{uid(note)}"))')
 raw=f'(kicad_sch(version 20250114)(generator "controller_hardware")(uuid "{root}")(paper "User" 1270 1650)(title_block(title "Motherboard PWM and floating process control")(date "2026-09-30")(rev "r0.1"))(lib_symbols'+''.join(libs)+')'+''.join(items)+')'
 (out/'motherboard_process.kicad_sch').write_text(dump(parse(raw))+'\n',encoding='utf-8');(out/'CNC.kicad_sym').write_text(dump(parse('(kicad_symbol_lib(version 20241209)(generator "controller_hardware")'+''.join(s.replace('(symbol "CNC:','(symbol "',1) for s in libs)+')'))+'\n',encoding='utf-8');(out/'sym-lib-table').write_text(dump(parse('(sym_lib_table(version 7)(lib(name "CNC")(type "KiCad")(uri "${KIPRJMOD}/CNC.kicad_sym")(options "")(descr "Process source")))'))+'\n',encoding='utf-8');(out/'motherboard_process.kicad_pro').write_text(json.dumps({'meta':{'filename':'motherboard_process.kicad_pro','version':1},'erc':{'rule_severities':{k:'warning' for k in ['single_global_label','four_way_junction','simulation_model_issue','footprint_filter']}}},indent=2)+'\n');footprints(out)
 for name,obj in [('design',d),('pin-map',netmap),('boundary-map',d['boundaries'])]:(out/(name+'.json')).write_text(json.dumps(obj,indent=2)+'\n')
 with (out/'bom.csv').open('w',encoding='utf-8',newline='') as f:
  w=csv.DictWriter(f,fieldnames=['Reference','Value','MPN','Footprint','Status']);w.writeheader();w.writerows({'Reference':ref,'Value':p['value'],'MPN':p['mpn'],'Footprint':p['footprint'],'Status':'source_candidate_not_qualified'} for ref,p in d['components'].items())
 print(json.dumps({'components':len(d['components']),'pads':d['fitted_pad_count'],'manufacturing_ready':False}));return d

if __name__=='__main__':build()
