DeadlySIn777/Controller/reports/reset-pin-fix-20260930/builder.stdout.txt

C:\Users\Gluis\OneDrive\Documents\ChatGPT\Controller\hardware\fpga_core\fpga_core.kicad_sch
