DeadlySIn777/Controller/reports/motherboard-cad-publication-20261002/ROOT103-current-paragraph-reconciliation-r01/BUILD_PLAN.md

# Build plan: working quality, then cost

**Current adopted board — Source26/ROOT103, published CAD29:** [Exact adoption](../reports/motherboard-return-zoning-20261001/ROOT102-health-current110-composed-r31/adoption.json) and the published native board share SHA-256 `639e1b7803bfaa24480d824d97d0d487e545b658a0e3e343435e8297083ef053`. There are **2,688 footprints, 11,759 track/via items, 1,544 zones/rule areas and 3,521 required joins remaining**. Native and independent uncapped connectivity agree: 633 fully joined and 1,101 incomplete multi-pad nets, zero orphan copper. Native regular DRC is **0 errors/0 warnings/no ignored checks**; Source26 ERC is **0 errors/70 unsuppressed warnings**. Six health-region component poses and exact reviewed copper/zone changes preserve all 5,899 prior Source-pad clusters and both ROOT102 capacitor corrections. The scoped proofs now cover 110 owned bypass loops, 225 receiving returns and 188 Source-anchored filled resources. The remote health producer and staged Source27 circuit corrections remain unfinished.

[Fresh full r07](../reports/pre-hardware-validation-20261001/full-health-stateful-plant-r07/report.json) has **22 PASS, 9 BLOCKED, 1 physical NOT_RUN and 0 FAIL**, with **1,887 host and 235 native KiCad cases passing**, five Windows symlink skips and all 3,765 scoped source hashes unchanged. It includes the eleven-stage stateful replay and nine original serial/mechanics scenarios. A later separately hashed [18-scenario fault/reset replay](../reports/controller-plant-20261001/actual-spi-reset-fault-plant-r06/receipt.json) passes, preserving physical-model position across FPGA counter reset and refusing restart after a fresh valid UPDATE. The [four-stage diagnostic IOL1 replay](../reports/cnc3-iol1-acquisition-20261001/diagnostic-replay-full-r01/report.json) also passes. These are disconnected compiled C/RTL/ideal-mechanics proofs, not complete HAL, target timing, actual electrical safety or hardware ratings.

[Characterization r04](../reports/pre-hardware-characterization-20261001/characterization-register-r04/requirements-and-coverage.json) preserves all 15 subsystem, 22 fault and nine full-machine requirements. The [actual original C-driver probe](../reports/controller-plant-20261001/actual-C-driver-SPI-probe-r02/receipt.json) exposes missing CAP3 READ_PAGE support in the actual RTL and correctly remains inhibited. All nine complete machine profiles remain unrun. Frozen CNC3 MAX_RATE still permits 195,312.5 steps/s at assumed 50 MHz; the requested 2 MHz target remains unimplemented/unqualified. Full analog convergence and the encrypted ADC model remain open, with all failed analyses retained. Ordinary I/O, factory identity and full output authority are separate from read-only diagnostic acquisition.

[Exact native drill/land audit](../reports/motherboard-pcb-integration-20261001/health-r31-full-drill-SMD-audit-r01/receipt.json) finds **274 drilled vias intersecting 277 same-net paste SMD lands**, with zero foreign-net intersections. This is a lower bound excluding tangency and registration margins. Layout correction or a qualified filled/capped assembly process is required; tenting and clean ordinary DRC do not close it. The **460 × 340 mm, six-layer, 1.6 mm** stackup remains provisional. Final routing, power distribution, complete 20 ms inhibit, vendor fit/timing, mechanics, manufacturing outputs and physical validation are unfinished. **Manufacturing readiness remains false.**

[Unchanged Source26 partial BOM v11](../reports/motherboard-cost-20260930/source-r26-2688-complete-cost-v11/README.md) has known-priced consumed parts at 1/10/100 units of **US$1,091.51 / $877.37 / $796.51**; 105 exact MPNs are priced and 185 MPNs / 720 fitted pieces remain unpriced. Plug-in modules, screens, fabrication, assembly, programming/test, enclosure and packaging are separate unknowns. This is not a complete product cost or PCBWay quote.

**Added pre-fabrication acceptance work, 1 October 2026:** integrate the [characterization register](../reports/pre-hardware-characterization-20261001/characterization-register-r02/requirements-and-coverage.json) alongside routing, source correction and manufacturing checks. Preserve actual source/RTL and test their limits with named corners, every emitted pulse counted, retained failing seeds/traces and explicit missing-model failures. Complete real CNC3/HAL-to-Verilated RTL, mechanical plant and fault/UX profiles before claiming a complete virtual machine. Run source-bound circuit simulations and Efinity device fit/static timing; qualify final routed trace/return/cable/power geometry. Generate conservative provisional ratings only where all relevant limits are supported, then confirm/derate with Rev A. The first component sweep and mutation controls are implemented; the full virtual controller and electrical qualification are not.

**Additional motion qualification target, 1 October 2026:** qualify all twelve fitted STEP/DIR channels simultaneously at up to 2 MHz/channel with enforced per-drive timing/polarity/rate profiles and atomic commands in a deterministic 1 kHz servo cycle. Qualify four base ABZ inputs and expansion toward twelve alongside all twelve motors. First reconcile actual spare FPGA resources, expansion-connector contacts and current 96-byte command/176-byte feedback capability for eight more ABZ channels without consuming mandatory motor/I/O resources. Any necessary future protocol version is unimplemented; do not silently rewrite the frozen frames. Higher pulse rate, CPU affinity and prior LinuxCNC joint-module loading do not establish loaded real-time/electrical qualification. [Detailed target](MOTION_EXPANSION_8_TO_12.md); [G23/G24](CURRENT_ACCEPTANCE_GATES.md).

**Execution priority, 30 September 2026:** the user now prioritises a working, excellent controller, followed by cost reductions against its verified capabilities. Proceed from the existing audit and reusable IS-1 logical/electrical contracts, close confirmed electrical defects, and complete all twelve motion interfaces and the required I/O on the one active motherboard under the versioned IS-2 physical transition. Compare whole fitted implementations and service costs; retain the required diagnostics, protection, offline operation and repairability. The sequence and concrete handoffs are recorded in [the implementation work package](../reports/next-implementation-20260930/README.md). Cost remains a design constraint, but an unverified cheaper component is not an accepted implementation.

**Current physical implementation:** The adopted **source26 electrical design retains 2,688 physical footprints: 2,642 purchased fitted parts, 37 bare PCB test pads, one bare chassis bond pad, six bare M3 mounting holes and two DNP footprints**. All twelve motor interfaces, four ABZ receiving paths, 24 general DI, 16 smart DO at 0.5 A/channel and 2 A/four-channel-group, acquisition/control MCUs, power supervision, protected probe/pendant supplies, process and isolated analog I/O, RS-485/CAN, compute/ESP/storage sockets, display/USB/Ethernet interfaces, indicators and field terminals are represented in the actual source. Native ERC has **zero errors, 70 unsuppressed warnings and no ignored checks**; **301 focused source/native checks pass**. Source26 makes exactly two manufacturer-confirmed reference-capacitor identity corrections and three manufacturer-land fuse-footprint corrections without changing any electrical pin nets or population. The retained original 327-part/1,229-pin-net baseline remains checked. The actual FPGA package has **256 checked native pads, 135 assigned user functions, 48 free user resources and 14 correctly mapped IO3 bank-power pins**; vendor package fit/timing remains unproved. All 723 capacitor owners have exact source-pin/function provenance. Twelve fitted interfaces remain distinct from the historical six-active-axis/two-encoder runtime. The current **adopted working PCB r102**, separate from the published viewer, has **2,688 footprints, 9,498 fitted pads, 11,641 track/via items and 1,521 native zones/rule areas**. Its exact source and independent physical connectivity checks pass, with **632 fully joined and 1,102 incomplete multi-pad nets out of 1,734**, **3,524 uncapped missing joins**, agreement between native and independent SOURCE-connected cluster counts, and zero orphan copper. Native DRC reports **zero errors, zero warnings and no ignored checks**. Combined proof preserves **108 actual owned-bypass loops, 221 receiving-return endpoint checks and 54 physically SOURCE-anchored reference-bridge groups**. Nine literal ordinary SOURCE-pair routes are now complete and independently rechecked on the combined board. The bounded FPGA neck rule applies only to 38 reviewed signal nets inside the F-side BGA area: 0.15 mm short necks with a separate aggregate 1 mm/net limit; all other tracks retain the 0.20 mm minimum and power rules remain unchanged. Native healthy/negative rule controls pass. Contradictory PCBWay process tables leave exact 2 oz fine-line process confirmation outstanding; this rule is not production process qualification. Two additional literal local critical SOURCE-pair paths are independently complete on the combined board; this does not establish complete multi-endpoint clocks or loaded timing. The fresh regression passed 1,847 host cases and all 235 actual KiCad-native cases; only five Windows symlink cases remain skipped. All 2,813 scoped source hashes stayed unchanged. [Fresh regression](../reports/board-completion-20261001/source26-root101-combined-validation.json). Fresh native ERC retains the same 70 unsuppressed warning semantics and zero errors; transient KiCad pin-object UUIDs were reconciled by exact source-pin identity. The complete AO1 DAC SDO path is now physically routed and independently checked with its exact four segments and 0.40 mm own-reference corridor. The reviewed retirement of one redundant AO1 same-domain zone retains its entire native outline in the keeper; exact disjoint LOGIC polygon composition preserves the prior ADC/reference cuts. All 188 actual filled reference resources are now physically SOURCE-anchored, with no synthetic exemptions. This resource-anchoring result does not establish every SMD local return loop, signal waveform or rail capacity. Separate C14804 adjacent-reference and C19042 circuit proofs also pass. The complete FPGA FLASH_MISO path now connects the actual U1001.N1 and U1002.2 endpoints through twelve F-side conductors, with no signal vias, a measured native path of 66.954 mm, the unchanged 0.40 mm own-reference corridor and twelve actual conductor-cut negatives. Loaded flash/configuration timing and the final manufacturing stackup remain unqualified. Seven additional literal ordinary SOURCE-pair routes now pass actual endpoint and individual conductor-cut checks through 65 added conductors. Their common In1 reference, source-owned transition stitches and unchanged IO3 preservation guard pass on the actual combined board after a separately reviewed local unused-tip cleanup. The composed power chain retains the original MISO power proof and all actual receiver contacts; it does not establish loaded rail capacity or whole-board timing. Four further ordinary Source-pair routes (DI6, DI7, DI9 and DI_SENSOR_G2_FAULT), 82 motor control segments, 20 health-supply continuity endpoints and the actual RAW supply transfers are checked on the combined board. The U11019 and U11025 receiving loops now pass; U11020/U11026 and the staged Source27 reset/slow-input circuit corrections remain unfinished. All 5,969 prior connected Source-pad groups are retained. These are scoped local proofs; global power and reference qualification remain incomplete. The 44 distinct floating substrate/thermal islands pass their independent physical checks. Routing is incomplete; these results do not establish complete power distribution, signal integrity or manufacturing readiness. Published native CAD **20261001-28** now matches the adopted Source26/r102 board: **2,688 footprints, 11,641 track/via items, 1,521 native zones/rule areas and 3,524 independently counted missing joins**. Its board SHA-256 is `769541d11876ea0050240ec065f6b0b85bff19c7c8324f1c26b9b637212a8af5`; fresh publication DRC has zero regular errors/warnings and no ignored checks. The actual footprint libraries are packaged locally with 92 used-library land patterns checked; the true outline, rounded ESP antenna notch and actual compute-socket model are retained. The side-panel opening was queued by the app; visible navigation is not independently confirmed. The **460 × 340 mm, six-layer, 1.6 mm** outline/stackup remains provisional. Continue concrete routing and exact power/return-path reconciliation. The 20 ms physical fault-to-inhibit requirement, partial-power/reset/missing-module states, loaded target software, complete twelve-channel operation, FPGA fit/timing, thermal/EMC behavior and production assembly still need qualification. Native ERC, native DRC, host tests, target compilation, HDL simulation, synthesis and physical measurements remain separate evidence. Gerbers, drill files, final assembly CPL/drawings and the final manufacturer stackup are not released; `manufacturing_ready` remains false. [source](../reports/motherboard-integration-20261001/source26-reference-fuse-adopted-r04/adoption.json); [board](../reports/motherboard-return-zoning-20261001/ROOT101-two-same-side-bypass-restored-r06/adoption.json); [connectivity](../reports/motherboard-return-zoning-20261001/ROOT101-two-same-side-bypass-restored-r06/independent-connectivity/review.json); [cost](../reports/motherboard-cost-20260930/source-r26-2688-complete-cost-v11/README.md); [owners](../reports/motherboard-bypass-owners-20261001/complete723-source26-r11/capacitor-owners.json); [routing](../reports/motherboard-ordinary-routing-20261001/tooling-r03-annulus-freeze-r02/review.json).

**Historical post-r0.4 host evidence:** [post-r0.4 disconnected validation](../reports/board-completion-20260930/post-r04-host-validation/README.md) records eight envelope and 16 integration passes, with **869 full-suite cases: 864 passed, five Windows symlink skips**. All 1,272 scoped source/research hashes remained unchanged. Both focused sets are included in the full suite. The older [858-case r0.3 snapshot](../reports/board-completion-20260930/final-host-validation/README.md) is historical. Host checks do not qualify physical hardware or establish target firmware/HDL/vendor-fit results; the fresh native ERC/DRC evidence is separately recorded above.

**Current procurement evidence:** The immutable **source26 2,688-footprint cost audit v11** separates 2,642 purchased fitted board parts from 44 bare PCB features, two DNPs and purchased modules/accessories. It prices **105 exact MPNs and leaves 185 unpriced: 720 purchased fitted pieces per board remain unpriced**. Known-priced consumed inventory per board at **1/10/100 controllers is US$1,091.51/$877.37/$796.51**. Catalogue purchase cash for those whole build quantities is **US$61,020.80/$67,419.50/$131,032.35**, including unused MOQ inventory; price, cash and stock coverage remain distinct. These are partial dated exact-MPN catalogue baskets, not complete manufactured-board/controller/kit prices or PCBWay quotations. Complete totals remain null. Compute/storage/AI/screen SKUs, other accessories, fabrication, assembly, programming/test and packaging remain separate unknowns. Independent verification checks 169 frozen files, 876 quantity rows and 13 adversarial controls. Earlier cost snapshots remain immutable history. [Frozen current cost receipt](../reports/motherboard-cost-20260930/source-r26-2688-complete-cost-v11/README.md).

**Architecture decision resolved, 30 September 2026:** the user chooses one active custom motherboard with soldered FPGA and all twelve motor interfaces, plus purchased compute, ESP and storage/settings modules. The passive base, thirteen custom cards, removable FPGA/field cards and custom MX4/XTB motors-9â€“12 path are superseded. Preserve the proven circuit work and all required logical/electrical/fault/software functions while collapsing their physical boundaries; this is not permission to relabel the partial MC as the finished controller. The versioned transition is in [MOTHERBOARD_IS2.md](MOTHERBOARD_IS2.md); the external IS-1 archive remains untouched. A real integrated-board identity and region capability map must replace fictitious card presence/serials.

28 September 2026 UTC, requirements reconciled 30 September 2026. The current offer is a controller assembly plus separately costed screen, power-supply, enclosure, harness and setup packages. **US$400 is a preliminary controller-assembly reference price**, superseding the earlier Mesa-priced included-screen objective and the later US$400 all-inclusive proposal. Final selling prices and margins need complete costs. Product options cover the **7-, 10-, 12-, 14-, 18- and 21-inch classes and further qualified sizes**; the $190 / 21.5-inch reference is one historical large-screen scenario. The [display-tier plan](DISPLAY_TIERS.md) defines shared UI, integration and costing of every complete offered package. Historical USD comparisons below remain dated studies, not current price commitments.

**Confirmed requirements, not open capacity choices:** all twelve differential STEP/DIR motor interfaces fitted on one custom motherboard, with at least eight usable motors and individual enable and alarm on every motor, four standard ABZ encoders, 24 general DI, 16 smart general DO with qualified current/fault diagnostics, probes/frequency/PWM/process control, analog I/O, RS-485/CAN, power protection and watchdog/permission hardware; **20 ms fault-to-inhibit** retained. No custom motor expansion card or paid unlock of fitted motors 9â€“12 is part of the adopted base target. Serial I/O communication still requires identity, sequence/freshness and CRC validated before outputs change. Purchased compute/service/storage exchanges and grouped pluggable-terminal whole-board service must preserve settings, offline entitlement and deliberate restart, with their own physical verification. Current six/two results remain historical evidence; twelve Ioff paths do not implement complete twelve-motor runtime or field interfaces. See [project memory](../PROJECT_MEMORY.md), [the transition](MOTHERBOARD_IS2.md) and [the historical 8-to-12 record](MOTION_EXPANSION_8_TO_12.md).

## Working production direction

**Immediate integration priority:** carry the [historical six/two connection](INTEGRATION_MILESTONE.md) into the agreed CNC3 twelve-channel driver reconciled to IS-2, RTL/dual-CS transport and disconnected actual-LinuxCNC integration. Complete self-test, enable-settle, feedback, fault and deliberate recovery evidence before physical link qualification. In parallel, finish the remaining MC source/interface/routing work and exact compute/carrier/display cost comparisons through the common configuration-service/CLI contract. These workstreams do not wait for all 200 features or a finished dashboard.

**Persistent product requirements:** [project memory](../PROJECT_MEMORY.md) and [CLI/customization plan](CONFIGURATION_AND_CLI.md). The user explicitly wants modifiable hardware/firmware, complete machine-readable CLI coverage for chat-assisted configuration, and simple guided wiring/commissioning. These are product acceptance requirements across the following stages, not a claim that the current engineering scripts already deliver them.

**Shared interface integration:** the separate `C:/Users/Gluis/claude-worktrees/controller-interface-spec` checkout retains frozen IS-1 (`docs/CONTROLLER_INTERFACE_SPEC.md`, `spec/*.json`) and CNC3 host codec/core work. Preserve that archive. Review and integrate its logical channel ownership, enable/alarm polarity, framing/integrity/freshness, watchdog/defaults, telemetry, recovery and transport work against [IS-2](MOTHERBOARD_IS2.md). Its passive-base/card-allocation, MX4/XTB service and fictitious removable-card identities no longer govern the motherboard. Physical identity/presence/calibration changes need an explicit versioned hardware/protocol/software transition; no ABI compatibility is established by this planning update. Host models do not replace RTL/LinuxCNC or physical evidence.

**Commercial release requirements:** the controller, paid offline software licence, expansion modules and complete tested kits are separate costed offers. Kits provide integration and support; ordinary supported peripherals remain customer-sourceable under the [commercial model and licensing policy](COMMERCIAL_MODEL_AND_LICENSING.md) and published compatibility records. A legitimate supported module replacement preserves the existing software entitlement without repurchase, while a new capability expansion may have its own stated entitlement. Third-party licence notices and source/offer obligations must be reviewed for the actual distribution before release.

**Latest scope revision:** the [platform roadmap](PLATFORM_ROADMAP.md) preserves all 200 feature proposals. The one motherboard target now carries all twelve motor interfaces, four ABZ encoders, 24 general DI, 16 smart general DO and the remaining process/analog/comms/protection/status functions. Optional accessories add capability where modularity is useful; they do not supply missing mandatory base channels. Preserve the older [expanded target](EXPANDED_HARDWARE_TARGET.md) and [8-to-12 study](MOTION_EXPANSION_8_TO_12.md) as history where their physical scope differs. Pin/bank/circuit/runtime/power/thermal/cost qualification remains engineering work.

**Compute bay adopted by the user, 30 September 2026:** The user-adopted CM4/CM5 dual-100-pin bay and actual three-bit DIP readout are now present in the native compute source. The selector does not route power or bypass permission. CM4/CM5 contact mappings have primary source checks; exact Linux images/pinmux, compatibility and thermal/loading still need target qualification. Automatic pre-power hardware ID and software profiles are not implemented. AUTO remains service-only until exact identity is verified; CB1/CB2 variants remain separately unqualified and machine use disabled. Connector shape alone does not establish electrical compatibility; no routine FPGA/ESP reflash is intended for a previously qualified exchange. See [carrier contract](COMPUTE_CARRIER_STRATEGY.md).

**Local Linux compute + our own FPGA motion/I/O circuit + ESP32-S3 helper on a custom carrier.** LinuxCNC remains the proposed CNC engine under PREEMPT_RT. CM5 is a measured-cost feasibility candidate; compute selection remains open against current workload and complete controller/package costs. The older CM5 subtotal did not support its assumed profitable Mesa-priced screen bundle; that result does not establish the current assembly price or every implementation's feasibility. The controller owns machining, and a screen package requires a local interface-rendering computer unless a separately costed display computer is supplied. An external customer browser remains an additional interface.

Start the memory study at **2 GB RAM with eMMC**, then justify any increase with measurements. Include the local kiosk browser, GPU driver, representative 3D scenes and CAD conversion in memory, thermal and loaded real-time latency measurements. Qualify each offered display/host combination at native resolution and intended scaling; screen diagonal alone does not determine graphics load or compute tier. Browser workers still consume local CPU and memory; moving a task into a worker does not establish isolation from motion. Bound supported model complexity and schedule conversion work explicitly. Offline use means no cloud dependency. Essential machine execution remains local even when the browser closes.

Purchased x86/Mesa hardware remains an engineering reference, preferably using equipment already available. It is not assumed to be inside each sale unit. The custom FPGA endpoint is now a central product workstream with gateware, driver, feedback and manufacturing work of its own.

**Internal-link study:** investigate dedicated SPI before internal Ethernet, keeping the customer network on the Linux host. The pinned LinuxCNC source explicitly recognizes CM5, but its SPI board lookup needs proper support for our custom board identity and matching gateware. This is a specific development task, not plug-and-play compatibility with a T20. [SPI source audit and proof gates](../research/SPI_FEASIBILITY.md)

The Linux/FPGA/ESP architecture replaces the earlier H7/grblHAL main-controller proposal. It does not add an H7 to this processor stack. ESP-IDF firmware and FPGA gateware remain separate from LinuxCNC. The latest [ESP accessory-automation requirements](ESP_ACCESSORY_AUTOMATION.md) add qualified support-equipment sequences and direct condition monitoring; the current firmware remains read-only diagnostics. Each output has one owner. If machining relies on ESP-confirmed service readiness, lost ESP/link/sensor freshness must trigger the machine's defined response. The ESP has no seamless motion takeover role; independent protection and reviewed defaults must still work when it freezes.

## Current sourcing and historical price evidence

The [current motherboard source cost](../reports/motherboard-cost-20260930/source-980-reviewed/README.md) is partial. The frozen **980-part source cost snapshot** prices 60 MPNs and leaves 34 unpriced (185 fitted pieces per board). Known-priced consumed component value per board at **1/10/100 units is US$379.67/$314.26/$280.60**, excluding unpriced parts, missing circuits, PCB/assembly/test and purchased compute/ESP/storage/screens. Catalogue cash includes MOQ excess and is not a stock-covered purchasing basket. Every complete manufacture/controller/package total remains null. Bare copper test pads have no purchased part or assembly placement. Earlier 327-part MC r0.4 and r0.3 cost files remain historical subsets.

The older compute, display and silicon prices below remain historical studies with their original scope. They are not the current MC r0.4 fitted BOM or a PCBWay quotation.

**Repair and recovery requirement:** [the revised service/memory contract](MODULAR_REPAIR_AND_MEMORY.md) covers qualified purchased-module exchange and whole-motherboard replacement through keyed pluggable terminal/harness groups, with protected commodity settings media, committed mirror and offline export. No separate custom motion/I/O/power board or fixed passive base is required. Whole-board replacement moves retained terminal groups and can change every circuit/calibration identity, so test its broader verification and actual service time separately from compute/ESP/media replacement. Preserve configuration and legitimate offline licences without restoring motion permissions or live position. Count terminal hardware, storage/protection, programming/test and real spare-board/module costs explicitly; existing software recovery models do not qualify the physical procedure.

**Current multi-size study:** [CM4/CM5/CB2, reference carrier and screen matrix](../research/COMPUTE_DISPLAY_MATRIX.md), covering six exact display candidates, both I/O scopes and quantities 1/10/100/1,000. It preserves unavailable or unqualified offers explicitly, uses published display volume tiers only where observed, and leaves every complete manufacturing total incomplete. This extends sourcing to all requested screen classes without claiming a finished fitted BOM or PCBWay quote.

**Existing comparison:** [three procurement approaches and complete cost-category coverage](../research/HARDWARE_COST_COMPARISON.md). It compares lower-cost CM3 SODIMM and ROCK 3C routes in the historical 21.5-inch/six-joint scenario. Its quantity-one priced baskets are $335.27 / $339.20 / $350.26, with substantial unpriced requirements. It does not price the new screen tiers or expanded I/O. Full manufactured costs remain incomplete. The older CM5 arithmetic below is retained as historical context, not the current selected BOM.

Public quantity-one distributor snapshots, excluding tax, freight and duties. These are component references, not a board quote or guaranteed future availability.

| Candidate/reference | Function | Observed USD | Status |
|---|---|---:|---|
| CM5102016 / SC1588 | CM5, 2 GB RAM, 16 GB eMMC, wireless | $97.50 | Distributor lists zero stock and estimated replenishment 29 March 2027; do not freeze this supply route |
| Efinix T20F256C4 | FPGA family/package cost reference | $12.75 | Not selected; [Yosys Efinix-family mapping only](../reports/FPGA_SYNTHESIS.md), no T20 vendor synthesis, fit or timing; exact speed/temperature grade and package require review |
| ESP32-S3-WROOM-1-N8 | Service processor module | $5.66 | Reference module; external-antenna/PSRAM variant may change cost |
| **Three-part subtotal** | **Only the items above** | **$115.91** | **Not the complete electronics cost** |

Sources: [CM5 distributor listing](https://www.digikey.com/en/products/detail/raspberry-pi/SC1588/25805592), [T20 distributor listing](https://www.digikey.com/en/products/detail/efinix-inc/T20F256C4/10654496), [ESP32-S3 distributor listing](https://www.digikey.com/en/products/detail/espressif-systems/ESP32-S3-WROOM-1-N8/15200089).

The indexed Raspberry Pi CM5 brief lists $92.50 for CM5102016, but the directly checked distributor page now lists $97.50. Use the latter in this study. The newest official brief redirects to revision DS-11 and was inaccessible during this check; do not mix old launch prices with current procurement claims. [Indexed official pricing](https://pip-assets.raspberrypi.com/categories/944-raspberry-pi-compute-module-5/documents/RP-008181-DS/cm5-product-brief)

Still uncosted: compute-module connectors, FPGA configuration flash/clocks/rails, motion-link PHY/interface, service Ethernet/USB implementation, differential drivers/receivers, protected industrial inputs/outputs, analog spindle interface, expansion connectors, watchdog/reset/inhibit circuits, field connectors, PCB fabrication, assembly, programming, test time, scrap/rework, thermal hardware, enclosure and packaging. Antenna and final radio placement also need costing.

An FPGA's chip price does not include a working CNC endpoint. T20 is a cost-study candidate; its I/O, gateware fit, timing closure, toolchain and host-driver behavior must be demonstrated. Efinix offers T20 in both BGA and LQFP packages; compare total board/assembly cost and usable pins rather than choosing by silicon price alone. [Efinix Trion family](https://www.efinixinc.com/products-trion.html)

## Cost gate

The historical Mesa manufacturer snapshot records **$149 for 7I96S, $219 for 7I76EU and $249 for 7I95T**, excluding the Linux computer and touchscreen. See the [price snapshot](../research/MESA_PRICE_SNAPSHOT.json). These benchmarks explain the earlier affordability study; they are not current verified offers or the adopted selling-price ceiling. Current costing uses the preliminary US$400 controller-assembly reference and separately itemized complete packages without removing required I/O, diagnostics, protection or repairability.

In the historical CM5 comparison, the three-part subtotal plus the user's $190 screen reference is **$305.91**, before all remaining electronics, PCB assembly, power supply, enclosure, test or margin. A supplier-advertised $100 21.5-inch sample would reduce that incomplete subtotal to **$215.91**; a $129 15.6-inch retail touchscreen gives **$244.91**. Neither establishes a viable $249 complete product. These are quantity-one scenarios, not production quotes or costs for the full new display range. [Display sourcing study](../research/DISPLAY_COST_STUDY.md)

Historical illustration only: $249 net selling revenue with a 40% manufacturing gross-margin target permits **$149.40** of manufacturing cost. A $100 display would leave **$49.40 for the entire rest of the unit**, before separately accounted business costs. The margin is not a user-selected requirement. This replaced an even earlier $499 board-only illustration at the time; both bundle assumptions are superseded by current assembly-plus-package pricing.

Use `allowed manufacturing cost = net selling revenue Ã— (1 âˆ’ chosen gross margin)` with clearly defined costs. Retail sales tax is not revenue. Distributor discounts, payment fees, shipping subsidies, warranty/support, development recovery and certification/tooling allocations must be accounted for separately and consistently. Gross margin is not net profit.

Cost each complete screen tier at the actual pilot and production quantities separately: one-off prototypes, 10 units, 100 units and 1,000 units. Keep screen size separate from compute and I/O capacity; hold the exact screen package constant within a compute/I/O comparison. Include panel/touch, interfaces, cables, power, mounting/enclosure and final assembly/test. Obtain prices for actual parts and manufacturer assembly/test quotations before claiming a production cost. Do not extrapolate a volume discount that has not been quoted or assume one retail price for all sizes.

Keep all twelve required motor interfaces on the one motherboard, adding separately rated optional accessories for unusual/high-cost functions. The [terminal and cost worksheet](CORE_INTERFACE_COSTING.md) retains the historical six-joint scope: six differential STEP/DIR channels, six enables and six alarms, two A/B/index inputs, sixteen additional protected inputs, eight additional protected outputs, one 0â€“10 V spindle interface and defined expansion. Spindle run/direction occupy two of the eight outputs. This is 54 directly mapped digital signals before analog control, host communication and housekeeping; it neither prices the adopted product nor provides six-axis external encoder feedback. Counts, ratings and rates must be frozen against machine profiles. A cheap base that needs expensive mandatory modules for normal supported operation is not a successful cost reduction.

## Execution plan and gates

**Manufacturing decision:** send the designed boards to PCBWay for turnkey manufacture. Release fabrication files, exact BOM/alternates, placement data, assembly instructions and an agreed programming/test package together. Use PCBWay's actual quotation for parts, fabrication and assembly; other vendors' setup/stencil tariffs are not the estimate. Final display/enclosure integration and functional-test scope require explicit quotation. The PCBWay submission is a user-performed step after the release package exists. The quote must cover fabrication, parts, assembly and programming/test at the study quantities 1/10/100/1,000; the release manifest's `final_cost` stays `incomplete-quotes` until PCBWay's actual figures are recorded. The [PCBWay submission checklist](../manufacturing/PCBWAY_SUBMISSION_CHECKLIST.md) lists the required files and decisions; the design is not ready for PCBWay manufacture. Nothing is authorized for ordering at this stage.

**Optional expansion:** [AI compute plan](../research/AI_ADDON_PLAN.md). Start with an Ethernet-connected companion using its own compute/memory/power; keep ordinary machining independent of AI availability. An internal accelerator socket is conditional on the selected host, electrical/thermal budget and supported software. AI hardware is excluded from the base price comparison.

**Power protection:** [physical fuse plus electronic branch protection](POWER_PROTECTION.md). Coordinate power-entry backup protection, branch limiting and existing protected outputs with the actual supply and load ratings. Fault telemetry belongs in the common CLI/UI; clearing a trip must not automatically resume machining.

**Reliability target:** use the [industrial qualification plan](INDUSTRIAL_QUALIFICATION.md) for whole-unit power, I/O, EMC, environment, software, factory test and service requirements. Cost protected ESP power, required sensors/output drivers, independent watchdogs and qualification explicitly. The proposed HDPE enclosure needs a designed shielding/bonding, mechanical and thermal arrangement. Define per-machine stop/cooling/workholding behavior; component ratings do not become finished-product or safety claims.

**Modular equipment:** implement the [plasma module/harness/profile contract](PLASMA_MODULE_SYSTEM.md) so a qualified cutter upgrade preserves the controller and unaffected table configuration. First prove discovery, selective invalidation and fault behavior with disconnected virtual devices, then qualify a divided-voltage interface and two named harness/source combinations. Keep specialized source-voltage hardware out of the base controller's general inputs.

**Third-party accessories:** support [ordinary USB/RS-485 adapters and Modbus RTU/TCP devices](THIRD_PARTY_MODBUS.md) through tested profiles and the same UI/CLI service. A supported serial VFD does not require our own proprietary adapter. Keep motion pulses, angle/index capture and fast process feedback on their dedicated timing paths.

| Stage | What we build | What must be demonstrated before advancing |
|---|---|---|
| 1 â€” Product cost envelope | One active motherboard with all twelve motor interfaces, four ABZ encoders and full required I/O; commodity compute/ESP/settings modules and optional capability accessories separately costed; screen packages in 7/10/12/14/18/21-inch classes and further qualified sizes; CM-family/BTT alternatives; complete cost matrix at pilot/production quantities | Controller and every proposed complete launch package have complete estimated costs and stated uncertainty, compared with the preliminary US$400 assembly reference; no required compute, protection, diagnostics, repairability, display, power or mounting hidden in an unpriced block |
| 2 â€” Pre-order hardware feasibility | Qualified CM4/CM5/BTT variants; terminal/pin/rail/clock map; SPI-first transport audit; host board support and the integrated FPGA circuit; ESP power/reset/service roles | Supported software route; gateware simulation and FPGA synthesis/resource/timing evidence; full cost blocks; defined later link measurements |
| 3 â€” Actual LinuxCNC software prototype | Pinned simulation environment, local backend adapter, command/status/error service, preserved UI in disconnected mode | Real LinuxCNC simulated machine completes the UI workflow; no mock planner substituted; disconnect/reconnect cannot replay motion |
| 4 â€” Visual setup system | Shared responsive UI across screen tiers; machine profiles, STEP/STL/GLB import candidates, units/roles/placement, registration, setup persistence and dependency invalidation | Compact, medium and large layouts complete the same touch-only setup and operation workflows; representative setups import/reopen without code editing; moving fixtures invalidates affected checks; physical panel qualification follows |
| 5 â€” Bounded motion-link prototype | After the relevant pre-order work, use a minimal development setup with actual LinuxCNC, encoder counting, step generation and deliberate link failures | Full read/compute/write cycle and external fault behavior measured under representative load before committing final production layout (release item `link_prototype_measurement`). Acquiring the engineering host and FPGA evaluation board for this measurement is a user purchase decision |
| 6 â€” Complete custom design | Schematics and PCB, power/reset/output states, rated interfaces, FPGA gateware, ESP-IDF helper, build/program/test procedures | Link evidence incorporated; reviewed package/pin/bank map and updated complete BOM; reproducible builds and exact I/O ratings |
| 7 â€” Custom engineering prototypes | Staged bring-up of custom hardware | Loaded timing, signal integrity, actual I/O, power/reset/watchdog behavior and thermal performance meet requirements |
| 8 â€” Product qualification | Named machine profiles, advanced operations, recovery/update image, factory test and first-use documentation | Physical machine tests plus novice usability, offline, recovery, bad-input and production-yield evidence; finished economics still fit |

Stages 2â€“4 feed each other: model workloads determine memory, and advanced machining cases determine encoder/timing resources. Complete substantial source, simulation, synthesis, costing and schematic preparation before parts are ordered. The link prototype then precedes final production layout; completion of the CAD importer is not a dependency for that bounded test. Complete real-time/electrical qualification still requires later hardware.

## First integrated software demonstration

First connect actual LinuxCNC motion and the existing FPGA RTL through CNC1 and exercise feedback/fault behavior. In parallel, demonstrate disconnected profile selection, conflicts, generated wiring, configuration validation, stopped/disarmed apply and backup/restore. Neither requires waiting for a complete cost quote or CAD dashboard. Once the exact UI source is confirmed, extend the shared service into the visual workflow: select one known machine profile; import a representative plate/vise/stock setup; confirm ambiguous units and placement; establish explicitly simulated registration; save/reopen; preview and execute a small job in actual LinuxCNC simulation; disconnect/reconnect and observe actual simulated state without automatic restart. Hardware procurement and final design still require the cost and feasibility gates.

LinuxCNC exposes local command, status and error interfaces that a service can adapt for our UI. That is an integration task; retaining the same interface does not mean its existing Grbl transport works unchanged. [LinuxCNC Python interface](https://linuxcnc.org/docs/html/config/python-interface.html), [build documentation](https://linuxcnc.org/docs/html/code/building-linuxcnc.html)

The exact user-preferred UI reference still needs confirmation. The current FluidCNC candidate has an automatic connection path, so isolate transport before launching a development copy. Do not change or flash the existing machine as part of this prototype.

## Recorded baseline evidence â€” 28 September 2026

The following counts are retained from the earlier baseline report. They are not a fresh full-suite or expanded-controller result on 30 September. Use [engineering status](../reports/ENGINEERING_STATUS.md) and the dated audit for current checks, source defects and evidence limits; source/hash consistency or zero ERC errors do not establish correct physical pin semantics, 20 ms fault timing or manufacturing readiness.

The [CNC1 end-to-end simulation](../reports/CNC1_INTEGRATION.md) now connects actual LinuxCNC through compiled HAL read/write and the common protocol driver to actual simulated RTL. Twenty-seven volatile runtime checks include returned-count motion/reversal, ABZ/index, link-loss recovery, guarded runtime scale changes with deliberate rehome and pulse verification, and refusal of a scale above the margin-adjusted pulse-rate ceiling. The laboratory Linux SPI backend now compiles with mocked syscall tests, but the HAL runtime still uses actual RTL simulation. Target transport deadlines, Pi/Rockchip integration and physical machine behavior remain unqualified.

The then-latest baseline Python run reported **579 tests (5 Windows symlink skips)**, including persistent runtime policy, configuration/recovery CLI, research-data and circuit checks ([raw output](../reports/audit-2026-09-28/python-tests.txt); a working-tree observation, earlier 283- and 290-test runs are historical). Actual LinuxCNC passes **27 volatile regression checks plus 68 persistent checks across nine separate launches**, and the current compiled driver passes **220 assertions** ([CNC1 manifest](../cnc1/evidence/manifest.json), 2026-09-28T20:56:18Z; 26/59 and 192 are historical). [Durable runtime recovery](../reports/PERSISTENT_RUNTIME.md) now restores saved XYZ scales without restoring homing or enabling motion. [Actual FPGA synthesis](../reports/FPGA_SYNTHESIS.md) maps the existing ABI2 logic to 9,426 Efinix primitive cells, and 179 frozen-driver harness assertions pass with the mapped circuit (`inhibit_n` held deasserted; fault/ready/progress pins not observed). The RTL regression passes 252 counted v1 checks plus 27 ABI v2 checks (the 180-check figure is historical). The [six-joint transmitter](../reports/SIX_JOINT_TRANSMITTER.md) and [two-ABZ receiver](../reports/ENCODER_RECEIVERS.md) blocks pass KiCad ERC. ESP builds retain their own evidence in `firmware/esp32_service/evidence/`. Remaining work includes physical target transport/timing, complete field I/O and power/protection, vendor device implementation, full schematics/layout, CAD/UI integration, physical qualification and complete production costing. [Engineering status](../reports/ENGINEERING_STATUS.md), [validation record](../reports/VALIDATION.md).
