DeadlySIn777/Controller/reports/motherboard-docs-20261001/source26-r50-zonecount-r02/BUILD_PLAN.md

# Build plan: working quality, then cost

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

**Current physical implementation:** The adopted **source26 electrical design retains 2,688 physical footprints: 2,642 purchased fitted parts, 37 bare PCB test pads, one bare chassis bond pad, six bare M3 mounting holes and two DNP footprints**. All twelve motor interfaces, four ABZ receiving paths, 24 general DI, 16 smart DO at 0.5 A/channel and 2 A/four-channel-group, acquisition/control MCUs, power supervision, protected probe/pendant supplies, process and isolated analog I/O, RS-485/CAN, compute/ESP/storage sockets, display/USB/Ethernet interfaces, indicators and field terminals are represented in the actual source. Native ERC has **zero errors, 70 unsuppressed warnings and no ignored checks**; **301 focused source/native checks pass**. Source26 makes exactly two manufacturer-confirmed reference-capacitor identity corrections and three manufacturer-land fuse-footprint corrections without changing any electrical pin nets or population. The retained original 327-part/1,229-pin-net baseline remains checked. The actual FPGA package has **256 checked native pads, 135 assigned user functions, 48 free user resources and 14 correctly mapped IO3 bank-power pins**; vendor package fit/timing remains unproved. All 723 capacitor owners have exact source-pin/function provenance. Twelve fitted interfaces remain distinct from the historical six-active-axis/two-encoder runtime. The current **working native PCB candidate r50**, separate from the published viewer, has **2,688 footprints, 9,498 fitted pads, 8,927 track/via items and 191 zones**. Its exact source and independent physical connectivity checks pass, with **609 fully joined and 1,125 incomplete multi-pad nets out of 1,734**, **4,435 uncapped missing joins** and zero orphan copper. Native DRC reports **zero errors, 22 IO3 feed-via warnings and two FIELD_B return-track warnings, all unsuppressed with no ignored checks**. The 44 distinct floating substrate/thermal islands pass their independent physical checks. Routing is incomplete; these results do not establish complete power distribution, signal integrity or manufacturing readiness. Published native CAD **20260930-24** remains the earlier complete 2,688-footprint population snapshot with **8,051 track/via items, five filled zones and 4,753 independently counted missing joins**. Its board SHA-256 is `c5f109b95261d5e57a3e3eae76eb7fa368e08afee8d0a91dacc906c23640e306`; it has zero regular geometry violations and no ignored checks. The viewer uses the true outline and rounded ESP antenna notch. This published snapshot is not the current source26/r50 candidate. The **460 × 340 mm, six-layer, 1.6 mm** outline/stackup remains provisional. Continue concrete routing and exact power/return-path reconciliation. The 20 ms physical fault-to-inhibit requirement, partial-power/reset/missing-module states, loaded target software, complete twelve-channel operation, FPGA fit/timing, thermal/EMC behavior and production assembly still need qualification. Native ERC, native DRC, host tests, target compilation, HDL simulation, synthesis and physical measurements remain separate evidence. Gerbers, drill files, final assembly CPL/drawings and the final manufacturer stackup are not released; `manufacturing_ready` remains false. [source](../reports/motherboard-integration-20261001/source26-reference-fuse-adopted-r04/adoption.json); [board](../reports/motherboard-pcb-integration-20261001/source26-ao-display-r50/receipt.json); [connectivity](../reports/motherboard-pcb-integration-20261001/source26-ao-display-r50/independent-connectivity/review.json); [cost](../reports/motherboard-cost-20260930/source-r26-2688-complete-cost-v11/README.md); [owners](../reports/motherboard-bypass-owners-20261001/complete723-source26-r11/capacitor-owners.json); [routing](../reports/motherboard-ordinary-routing-20261001/tooling-r03-annulus-freeze-r02/review.json).

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

## Working production direction

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

## Current sourcing and historical price evidence

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

## Cost gate

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

## Execution plan and gates

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

## First integrated software demonstration

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

## Recorded baseline evidence â€” 28 September 2026

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
