DeadlySIn777/Controller/reports/readiness-fixes-20261004/before-software-status-update/docs__BUILD_PLAN.md

# Build plan: working quality, then cost

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

[Characterization r06](../reports/pre-hardware-characterization-20261002/characterization-register-r06/requirements-and-coverage.json) preserves all 15 subsystem, 22 fault and nine complete-machine requirements. No complete machine profile is yet validated. The original transport CAP3 gap and the bounded IS2 read-only implementation are distinct; the new profile deliberately remains unqualified and cannot authorize motion. Frozen CNC3 rate limits remain unchanged; the requested 2 MHz/channel target is not implemented/qualified. Complete IOL1 authority, record trust/provisioning, analog-chain convergence, vendor FPGA fit/timing and full-load operation remain open. The r08 record-acquisition mapping exceeded the coarse T20 resource screen. A later report-local arithmetic-sharing candidate screens at 19,477 LUT4+ADD against 19,728, leaving only 251; the [reaudit](../reports/readiness-reaudit-20261003/software-audit.md) records its exact scope and remaining integration omissions. It is unadopted and does not establish complete design capacity, vendor fit or timing.

[Current native drill/land audit](../reports/motherboard-pcb-integration-20261002/ROOT103-bypass-PROC-full-drill-SMD-r01/receipt.json) finds **274 drilled vias intersecting 277 same-net paste SMD lands**, zero foreign-net intersections and no added overlap in ROOT104. This lower bound excludes tangency and registration margins. Layout correction or exact qualified filled/capped fabrication and assembly is still required; tenting and clean ordinary DRC do not close it. The **460×340 mm, six-layer, 1.6 mm** stackup remains provisional. Final routing, power distribution, complete 20 ms inhibit, mechanics, manufacturing outputs and physical validation are unfinished. **Manufacturing readiness remains false.**

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

**Current physical implementation:** Source26/ROOT104 and published CAD30 are the exact current source/board shown above. The integrated source has all twelve motor interfaces, four ABZ receiving paths, 24 general DI, 16 general DO and the protected analog, communications, compute, ESP, storage and diagnostic circuitry. All 723 capacitor owners have source-pin provenance; FPGA allocation is 135 assigned plus 48 free of 183 user resources on the actual 256-land package. The current board has 2,688 footprints, 9,498 fitted pads, 11,807 track/via items, 1,544 zones/rule areas, 3,508 required joins, 633 fully joined and 1,101 incomplete multi-pad nets. Native and independent connectivity agree, with no orphan copper. The scoped current proofs cover 120 owned bypass loops, 245 receiving returns and 188 Source-anchored filled reference resources. The Source27 reset/slow-input corrections are staged and unadopted. Current evidence, drill/land assembly limitations, tests and partial cost are linked above; historical r102/CAD28 data remains in the immutable earlier adoption/publication records. Manufacturing readiness is false. Source representation, local routing proofs, host tests, target compilation, HDL simulation and physical qualification remain distinct.

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

## Working production direction

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

## Current sourcing and historical price evidence

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

## Cost gate

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

## Execution plan and gates

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

## First integrated software demonstration

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

## Recorded baseline evidence â€” 28 September 2026

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
