DeadlySIn777/Controller/reports/motherboard-cad-publication-20261001/ROOT103-current-docs-r01/docs/BUILD_PLAN.md

# Build plan: working quality, then cost

**Latest verified increment — Source26/ROOT102:** two existing capacitor poses and six conductors complete two additional owned bypass loops; no electrical source, parts, pin nets or rating changed. Actual native and independent connectivity agree on **3,524 required joins remaining**, with zero orphan copper. Native regular DRC is **0 errors/0 warnings/no ignored checks**; ERC remains **0 errors/70 unsuppressed warnings**. [Full disconnected r05](../reports/pre-hardware-validation-20261001/full-two-cap-r05/report.json) passed **17 stages**, left **9 blocked** and **1 physical stage unrun**, with **0 failed stages**; **1,876 host cases and 235 native KiCad cases pass**, five Windows symlink cases remain skipped, and all **3,327 scoped source hashes** stayed unchanged. This supersedes the earlier r101 regression as the current exact-board run. [Current adoption](../reports/motherboard-return-zoning-20261001/ROOT101-two-same-side-bypass-restored-r06/adoption.json).

[Updated characterization](../reports/pre-hardware-characterization-20261001/characterization-register-r02/requirements-and-coverage.json) retains all 15 subsystem, 22 fault and nine machine requirements. Twelve changing-speed/reversal pulse generators pass 43,200,324 edge/count checks; four ideal-input encoder components and actual CNC3 structural SPI/codec RTL pass their scoped sweeps. The real manufacturer OPA buffer model passes 12 simultaneous four-channel cases, alongside 96 passive filter cases and two numerical-sensitivity studies. **Complete stateful CNC3/HAL/machine integration and whole-circuit analog qualification remain open.** Failed full-chain amplifier convergence and the encrypted ADC model are recorded; ideal boundaries are not physical substitutes.

[Native drill/land screening](../reports/motherboard-pcb-integration-20261001/two-cap-full-drill-SMD-audit-r01/receipt.json) identifies **275 existing drilled vias overlapping 279 same-net paste SMD lands**. This is a lower bound: exact tangency and assembly registration margins need further checking. Each location needs layout correction or an explicitly qualified filled/capped fabrication/assembly disposition; ordinary DRC and tenting do not close this work. No fabrication package or manufacturing readiness is claimed.

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

## Working production direction

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

## Current sourcing and historical price evidence

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

## Cost gate

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

## Execution plan and gates

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

## First integrated software demonstration

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

## Recorded baseline evidence â€” 28 September 2026

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
