DeadlySIn777/Controller/reports/motherboard-return-zoning-20261001/source26-r74-C19042-coupled-source-cell-r05/physical-controls-r02/ground-make-command.txt

swig/python detected a memory leak of type 'PCB_TRACK *', no destructor found.
swig/python detected a memory leak of type 'PCB_TRACK *', no destructor found.
swig/python detected a memory leak of type 'PCB_VIA *', no destructor found.
swig/python detected a memory leak of type 'PCB_TRACK *', no destructor found.
