DeadlySIn777/Controller/reports/audit-2026-09-30/build_feature_catalog.txt

read-only check passed: 200 feature IDs, 6 archived-note hashes, note references verified
