DeadlySIn777/Controller/reports/motherboard-return-zoning-20261001/source26-r74-C19042-coupled-source-cell-r05/physical-controls-r02/reference-make-command.txt

swig/python detected a memory leak of type 'ZONE_FILLER *', no destructor found.
