DeadlySIn777/Controller/hardware/board_review/revisions/20260930-06-build-incomplete/motion-card-3d.png

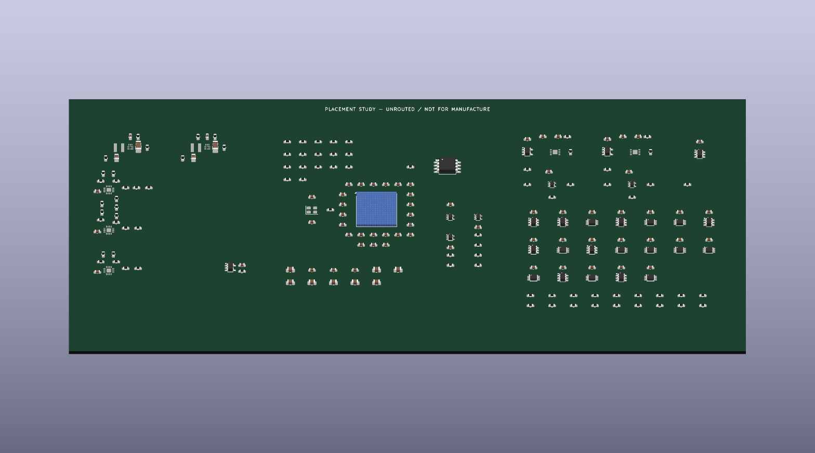
hardware/board_review/revisions/20260930-06-build-incomplete/motion-card-3d.png
