DeadlySIn777/Controller/hardware/controller_assembly/page-01.png

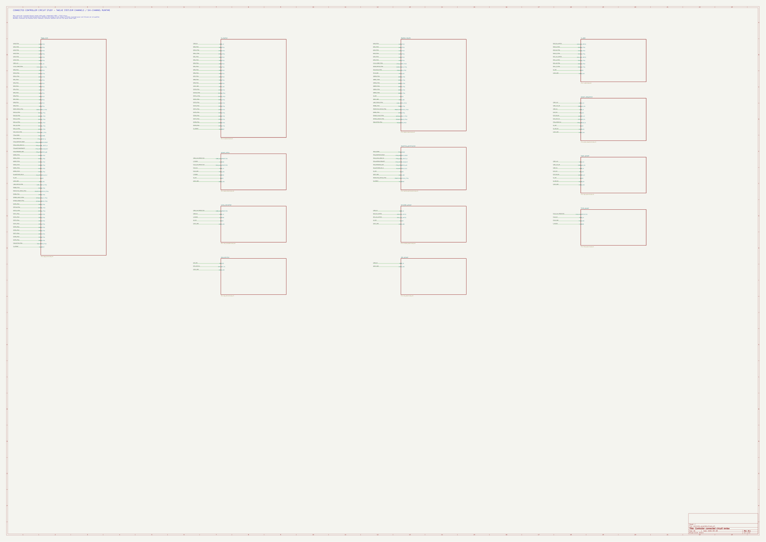
hardware/controller_assembly/page-01.png
