DeadlySIn777/Controller/hardware/controller_assembly/page-12.png

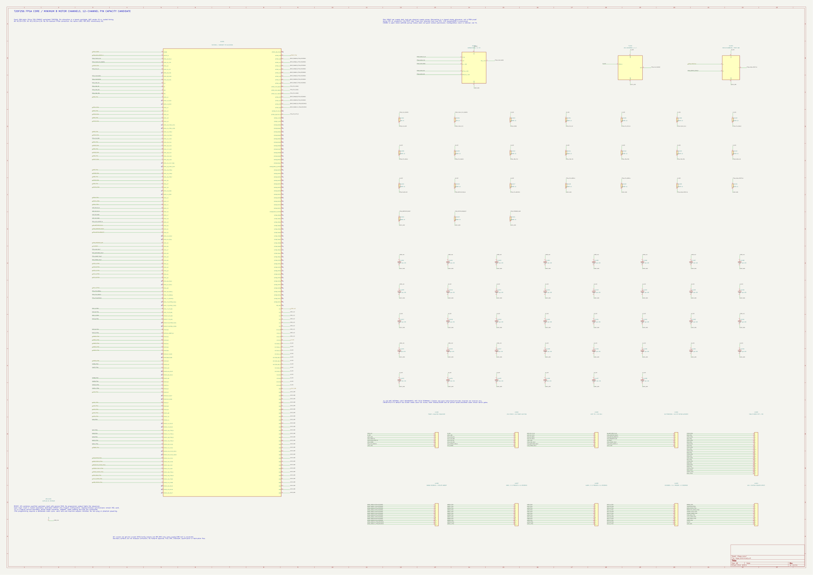
hardware/controller_assembly/page-12.png
