DeadlySIn777/Controller/hardware/controller_assembly/page-14.png

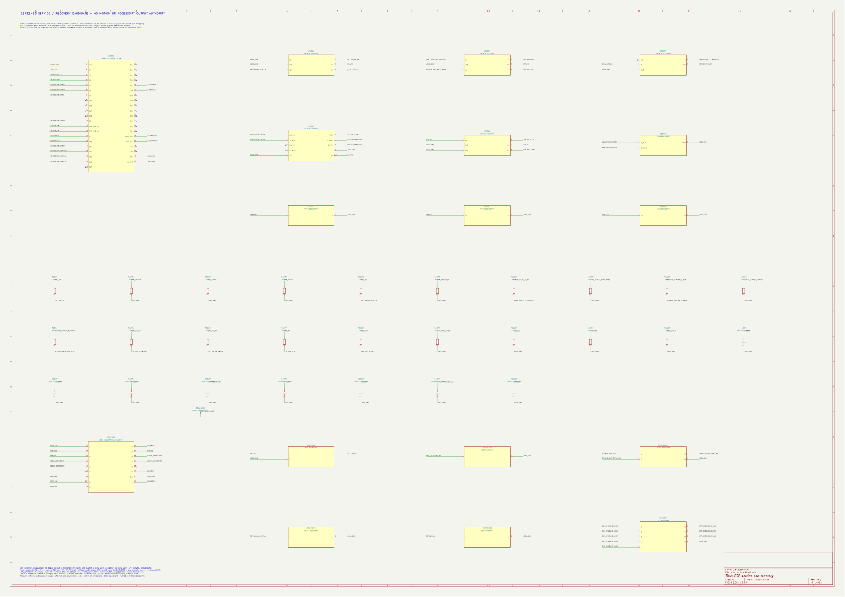
hardware/controller_assembly/page-14.png
