DeadlySIn777/Controller/hardware/octopus_external_adapter/r0_2/assembly-review.png

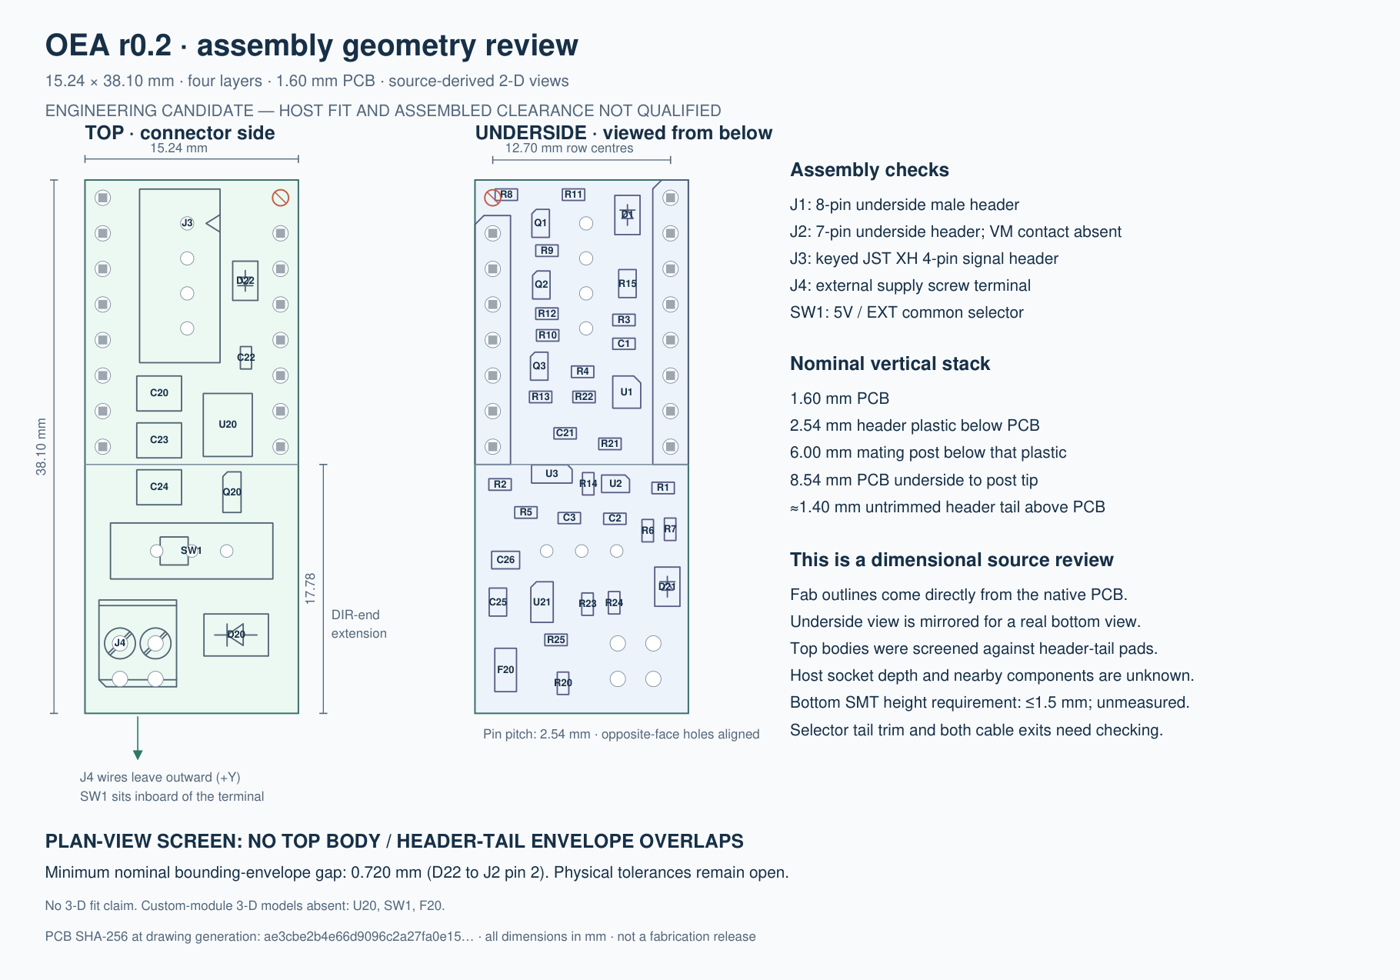
hardware/octopus_external_adapter/r0_2/assembly-review.png
