DeadlySIn777/Controller/reports/argus-routing-handoff-20261002/ROOT104-CAD30/evidence/reports/freerouting-evaluation-20261002/ROOT103-local-topology-handoff-r01/README.md

# Bounded routing topology handoff

This is a read-only diagnostic of the exact ROOT103 copy used for the completed local Freerouting evaluation. No copper was accepted or adopted. The current adopted board remains Source26 ROOT104 / CAD30.

For both OBS8_INVERTED and OBS9_INVERTED, the actual Source and receiving F-pad centers are clear. Exported polygon/reference masks alone leave both endpoints in one connected configuration-space component. Retained foreign native pads, traces and vias separate them when the 0.20 mm trace and 0.15 mm clearance are represented conservatively.

This supports a native-copper obstruction explanation. It is not a physical impossibility proof: transformed native shapes use 1 um outward approximation, and through-via layer spans can conservatively overblock unflashed annuli. No complete route or precise router failure cause is established. The actual Freerouting machine result reports two incomplete connections and no new networks; strict native import rejects the empty session improvement. Those results are retained separately.

The frozen receipt records exact board/DSN hashes, literal diagnostic operands, component membership, closest component boundaries, and the failed first diagnostic's SWIG parent-proxy lookup. The successor resolves Source pad ownership through the actual footprint inventory. No board, schematic, Source, frozen tool or accepted route was changed.

Further router trials and copper integration are held while the user uses Argus on the current native handoff. A returned candidate must be reconciled against that exact handoff and recheck protected Cu, Source clusters, uncapped connectivity, native DRC, literal references/annuli, registration, power geometry and retained circuits before any adoption.
