DeadlySIn777/Controller/documentation/reports/VALIDATION.md

# Validation record

**Current audit, 30 September 2026:** the main checkout ran **670 host tests in 23.276 seconds, zero failures/errors, five Windows symlink skips**. [Raw log](../WORKSPACE_REFERENCES.md#artifact-9682d81bb1133751), [result](../WORKSPACE_REFERENCES.md#artifact-a0db4dee62f851d2) and [source/change receipt](../WORKSPACE_REFERENCES.md#artifact-0ba31fa38aa113aa) record 9,181 inventoried inputs with no changes during checks. Three catalogue/cost freshness checks and 28 fresh native KiCad exports passed. The initial native-export command was rejected for an in-source output destination; its retained log and successful external-output retry are both recorded. The following 28 September observations are historical. These passing checks do not resolve the reset-buffer pin defect, 20 ms watchdog mismatch or expanded power/complete-product gaps; see [current audit](audit-2026-09-30/AUDIT_REPORT.md).

Latest full Python run, 28 September 2026 20:58Z (Windows Python 3.14.6): `python -m unittest discover -s tests -v` ran **579 tests in 20.792 seconds, OK, 5 skipped**. The five skips are LinuxCNC-backend symlink cases that cannot create symlinks on this Windows host. Per module: 34 configuration recovery, 40 configuration service, 16 core converter, 15 core-converter analysis, 26 digital inputs, 12 encoder power, 20 field power, 15 hardware assembly, 27 hardware ledger, 49 LinuxCNC backend, 16 logic power, 33 persistent runtime, 19 power entry, 16 power-entry analysis, 20 power sequence, 10 recovery CLI, 36 release, 23 requirements analysis, 24 research generators, 41 runtime configuration (adapter double, not actual runtime), 10 ABZ receiver, 15 SBC power, 20 scene manifest, 5 service health, 29 supervisor and 8 six-joint transmitter. [Raw output](../WORKSPACE_REFERENCES.md#artifact-500f4c1b6a27715c). No workspace file changed during the run by modification time, but no source inventory was hashed, so this is a working-tree observation, not a frozen snapshot. These are host tests only.

Current component evidence at the final audit sync (see [current and superseded review records](ENGINEERING_STATUS.md#current-and-superseded-review-records)):

- **CNC1** ([manifest](../WORKSPACE_REFERENCES.md#artifact-8474095096839423), recorded 2026-09-28T20:56:18Z; `record_evidence.py --check` reports 0 problems): 220 compiled C/RTL assertions; actual LinuxCNC 2.9.4 uspace volatile regression of 27 checks (run `551cc0bd-9363-42b6-8a66-fa6adc27d7ab`, 1,124 trace rows, 14.8190 s wall / 3.1621 s simulated); 68 persistent checks across nine launches (run `5cd2bcb5-d4e4-4592-9f53-6c6ab62b9f85`); 41 runtime and 33 persistent host tests. The gateware default-v1 regression (252 counted checks) and ABI v2 testbench (27 checks) logs were carried forward because the C, RTL and module bytes did not change. This is WSL simulation with Verilator RTL, not target timing, synthesis or physical evidence.
- **Linux SPI backend** ([manifest](../WORKSPACE_REFERENCES.md#artifact-f44e95666eaa3676), recorded 2026-09-28T20:30:34Z; `--check` 0 problems): 892 assertions in each normal and ASan/UBSan run plus C++ linkage against header 0e244ab0..., which matches the current cnc1.h. Device calls are mocked.
- **RTL regression** ([manifest](../WORKSPACE_REFERENCES.md#artifact-29439d17e3a4d980)): 252 counted v1 checks plus 27 ABI v2 checks with strict lint, rerun and recorded at 2026-09-28T21:47:55Z; `python gateware/tools/record_evidence.py --check` verifies it without writing. HDL simulation only.
- **FPGA synthesis** (19:22:22Z): 9,426 mapped Efinix-family cells (4,072 LUT4, 2,132 ADD, 3,221 FF, 1 GBUFCE), zero latches and a passing structural inhibit CDC check. **Post-map** (19:24:08Z): 179 frozen-driver assertions. Both `--check` commands pass. No device fit, routed timing or bitstream.
- **ESP32-S3** ([evidence folder](../WORKSPACE_REFERENCES.md#artifact-e4626a297acb4f93), re-recorded 21:48:07Z): two ESP-IDF 5.5.4 images (unchanged from the 19:17:08Z clean builds) compile and link and the host core test passes; builds are not reproducible and no device was flashed. All 14 source hashes match.
- **LinuxCNC adapter runtime** ([evidence](../WORKSPACE_REFERENCES.md#artifact-37d689dbf5bc97c0)): 12 checks and 3,118 status samples, run `bac564b6-1f50-4593-86bc-b3d496f33e75` at 2026-09-28T19:03:22Z, in WSL POSIX simulation.
- **Release gate**: `tests/test_release.py` has 36 tests, covering distinct evidence per id, the structured PCBWay quote record and live-manifest/report consistency. The manufacturing owner's regenerated [prototype](../WORKSPACE_REFERENCES.md#artifact-fb45cd246190c1cd) and [production](../WORKSPACE_REFERENCES.md#artifact-8532eff18ac91417) reports record 17 and 23 blockers; earlier outputs are archived in `manufacturing/before-audit-fixes-2026-09-28/`. The design is not ready for PCBWay manufacture.
- **Research data**: `python tools/build_compute_display_matrix.py --check` (144 cases, no complete manufactured cost), `python tools/build_feature_catalog.py --check` (200 feature IDs) and `python tools/build_hardware_cost_data.py --check` are read-only source-inspection/arithmetic checks, reported passing by the audit's hygiene owner; they are not hardware evidence.

Latest connected-circuit evidence, 28 September 2026: **208 tests pass, no failures/skips; 342 source/evidence files preserved without drift; 22/22 fresh native exports match.** [review and exact counts](../WORKSPACE_REFERENCES.md#artifact-269420286c390913), [scoped test output](../WORKSPACE_REFERENCES.md#artifact-31c6a80e4a3452db), [source identities](../WORKSPACE_REFERENCES.md#artifact-06af112b9adca4de) and [fresh native KiCad export receipt](../WORKSPACE_REFERENCES.md#artifact-f38f4c608be4c0e7). Ten circuit blocks are connected in one hierarchy. The export has 0 ERC errors and 22 specific, retained ISO1212 substrate warnings. Native exports are independently reproduced from captured drawing inputs, and Python tests execute in the copied source snapshot. This establishes circuit/export consistency and bounded arithmetic, not board fabrication, regulator stability or physical qualification. See [connected controller scope](CONNECTED_CONTROLLER.md).

Previous power/protection milestone, 28 September 2026: **46 scoped Python tests pass** in 0.377 seconds, with no skipped cases and no source/input changes during the run. The suite contains 12 encoder-power, 18 power-entry connectivity and 16 entry-calculator cases. Both actual KiCad 10.0.4 circuit exports have zero ERC violations and inspected renders. [Raw scoped output](../WORKSPACE_REFERENCES.md#artifact-a3254b78b9e3eca0), [before/after input identities](../WORKSPACE_REFERENCES.md#artifact-95b7fa946e73cc6a), [root evidence review](../WORKSPACE_REFERENCES.md#artifact-ed8f09d5350da5cb). This establishes connectivity and bounded numerical checks, not physical protection or manufacturing readiness.

The broader current-workspace command ran **386 tests in 24.683 seconds, with three skips and no failures**. However, `tests/test_configuration_service.py` changed during that run. The retained [raw output](../WORKSPACE_REFERENCES.md#artifact-acbdeedd333745c7) and [before/after inventory](../WORKSPACE_REFERENCES.md#artifact-25669bc799442a43) document the conflict; do not present the run as a verified stable snapshot. The prior [frozen implementation review](../WORKSPACE_REFERENCES.md#artifact-17de6ecb81ab7d6d) preserves an exact 290-test run and separate runtime/SPI/synthesis evidence. Those older sources were not replaced by the new power blocks.

Historical combined implementation run, 28 September 2026: **283 Python tests pass** in 15.618 seconds. The suite covers 32 recovery, 32 configuration service, 16 hardware ledger, 30 LinuxCNC backend, 27 persistent runtime, 10 recovery CLI, 15 release, 23 requirements analysis, 26 runtime configuration, 10 ABZ receiver, 20 scene manifest, 5 service health, 29 supervisor and 8 six-joint transmitter tests. Root review added nonfinite receiver thermal-arithmetic cases and later persistent-runtime, runtime-configuration and release cases before this run. [Raw Python output](../WORKSPACE_REFERENCES.md#artifact-a444077b2f77939b); no combined source/evidence review JSON was produced for that run.

The [persistent runtime suite](PERSISTENT_RUNTIME.md) at the time of that run passed **59 checks across nine independent LinuxCNC launches** (historical; the current record above is 68 checks, run `5cd2bcb5`). Saved 250 steps/mm is explicitly reconciled after restart; deliberate homing and a 1 mm move produce 250 returned pulses. Killing the saving client after activating 300 leaves the inhibit held; a fresh launch explicitly recovers generation 2 and proves a deliberate 300-pulse move. Missing/corrupt/foreign/older authority and an expired queued HAL request are refused. At that time the 26-case volatile regression passed again and the compiled C/RTL harness passed 192 assertions; both figures are historical (current: 27 checks and 220 assertions).

[Actual Efinix-family synthesis](FPGA_SYNTHESIS.md) passes hierarchy, latch and mapped-cell checks. A separate run passes **179 frozen-driver assertions against the synthesized netlist**, using the exact primitive simulation models. This is functional mapping evidence, not device fit, routed timing or a bitstream. [Six-joint transmitters](SIX_JOINT_TRANSMITTER.md) and [two-ABZ receivers](ENCODER_RECEIVERS.md) both have actual KiCad netlist/ERC exports with zero violations, visual review and 18 host tests.

The durable scale schema remains separate from the complete machine-profile cartridge. The SPI backend remains a synchronous laboratory implementation with mocked device operations, unqualified for servo deadlines. No physical machine, memory cartridge or SPI device was connected. Both prototype and production release checks still report missing manufacturing evidence.

## Previous milestones

The preceding [234-test implementation review](../WORKSPACE_REFERENCES.md#artifact-9640e84665f333ea) records the public recovery CLI walkthrough, 26 actual-runtime calibration checks and 179 compiled C/RTL assertions. Its runtime sources, evidence and compiled module are preserved under `cnc1/evidence/before-persistent-runtime`. The earlier [Linux SPI laboratory backend](SPI_TRANSPORT_IMPLEMENTATION.md) passed 892 assertions in each normal and ASan/UBSan run plus C++ linkage against its archived header; current-header regression is recorded separately in that component report.

Previous Python engineering run, 28 September 2026: **200 tests passed**, including the existing 32 [configuration service/CLI tests](CONFIGURATION_DEMO.md) and 32 new [cartridge/replacement recovery tests](MODULE_REPLACEMENT_DEMO.md). The replacement demo also passed: retained assignments, replacement-specific factory metadata, affected verification, incompatible-module refusal, torn/corrupt record fallback and explicit new-compute import. It issued no physical commands. The [root review](../WORKSPACE_REFERENCES.md#artifact-45b3991c789f3224) records this run and source identities. The earlier configuration API demo passed profile selection, validation/wiring, apply/edit/restore and conflict/stale/armed refusals. Earlier separate evidence records 12 actual LinuxCNC simulation checks; 180 FPGA checks and strict Verilator lint; two ESP32-S3 compiled variants and portable C sanitizer tests; partial transmitter ERC with zero violations; and hardware ledger consistency with 54 unresolved release items. These earlier hardware/firmware checks were not rerun by the latest Python command. See [engineering status](ENGINEERING_STATUS.md) for the remaining physical and production limits.

The earlier [CNC1 integration milestone](../cnc1/evidence/before-runtime-configuration/reports/CNC1_INTEGRATION.md) passed **11 runtime checks in actual LinuxCNC** through compiled HAL and actual simulated FPGA RTL, plus **157 compiled driver/RTL assertions**. The default-v1 180-check regression was also rerun after the opt-in v2 extension. Returned pulse counts close the simulated joint-feedback path; varying ABZ/index, injected link-loss amplifier faults and deliberate recovery are exercised. The runtime uses WSL POSIX non-real-time operation and a Verilator transport; wall-clock performance does not qualify a physical servo deadline. Its source manifest, compiled driver tests and protocol-version evidence are recorded separately from the older ideal-feedback simulation.

## Earlier study history

Run date: 27 September 2026 Halifax / 28 September UTC. No machine connected.

Intermediate offline snapshot, 28 September 2026 01:05 local: `python -m unittest discover -s tests -v` completed with **136 passing tests** (16 hardware ledger, 30 LinuxCNC backend, 13 release, 23 requirements analysis, 20 scene manifest, 5 service health, 29 supervisor); raw output in [offline-tests-2026-09-28-0105.log](../WORKSPACE_REFERENCES.md#artifact-7a8388052904286b). It predates the 234- and 283-test runs above and is kept only as a dated snapshot.

Review recheck, 28 September 2026 UTC: `python -m unittest discover -s tests -v` again completed with **72 passing tests**. This confirms the local offline test result mentioned in the pasted architecture review. Other rows below retain their earlier run evidence; no hardware or actual LinuxCNC integration was tested in this recheck.

| Check | Result | Scope |
|---|---|---|
| `python -m unittest discover -s tests -v` | 72 passed | 29 supervisory contract tests, 23 analytical calculator tests, 20 scene metadata tests |
| `python -m controller_lab.run_scenarios` | 7 scenarios passed | Injected abstract backend events; generated `supervisor-scenarios.json` |
| Draft scene CLI | Structurally valid; all three assets visual-only; motion unauthorized | Synthetic metadata; missing profile/geometry/commissioning correctly reported |
| Timing report | Generated; illustrative mill exceeds configured assumed limits | Expected engineering finding, not a passing hardware budget |
| Upstream grblHAL full simulator | 9 checks passed | Includes one actual coordinated line/arc simulation; exact source and options in firmware report |
| Upstream standalone validator | 8 cases timed out | Unresolved; aggregate upstream audit retains failure |

The supervisor review found boot/reboot incorrectly treating initialization as a fresh backend cycle. This was corrected: arming now requires a real injected `motion_progress()` event, with separate boot/reboot regression cases. A network heartbeat cannot substitute for that event.

The scene tests include wrong/ambiguous units, nonfinite transforms, malformed quaternions, unknown/cyclic frames, duplicate identities, changed asset bytes, changed parent placement and stale profile/commissioning records. A manifest's own `registered` declaration cannot establish registration without the external matching evidence supplied by a trusted caller. Authentication of that caller and production storage are outside this study.

These results do not establish CAD import, collision checking, production authentication, hardware real-time behavior, motor control accuracy, electrical ratings or a shippable product. The source-pinned build details, host warning, larger initial simulation timeout and validator limitations are retained in [firmware feasibility](../research/FIRMWARE_FEASIBILITY.md).
