DeadlySIn777/Controller/reports/motherboard-critical-routing-20261001/reference-cap-primary-r08/GRM188R71E105KA12-characteristics.txt

Chip Multilayer Ceramic Capacitor
Electrical Characteristics Data
Murata Global Part No.
Chip Size Code
(mm/inch)
Temp.
Chara.
Cap.Value
Cap.Tol
Rated Volt.
Durability 
(%Rated Volt.)
GRM188R71E105KA12
1608M/0603
X7R
1μF
±10%
25Vdc
150%
This PDF has only typical specifications.
Therefore, please approve our product specification 
before ordering. Product specifications in this PDF are as of Oct. 2026.
They are subject to change or our products in it may be discontinued without advance notice.
Click here to visit
Murata WEB site.
1. Dimension
L
W
T
1.6±0.1
0.8±0.1
0.8±0.1
2. Capacitance, D.F. and I.R.
Specifications
Measuring condition
Capacitance
0.9μF to 1.1μF
1kHz / 1Vrms
D.F.
0.1(max.)
1kHz / 1Vrms
I.R.
50 Mohm(min.)
25.0V, 60s
3. Impedance/ESR­Frequency
Equipment:Impedance/Network Analyzer
Impedance/ESR[ohm]
Frequency[Hz]
|Z|
ESR
4. Capacitance­DC Bias Characteristics
1kHz / 1Vrms    Equipment:LCR Meter
Cap Change[%]
DC Bias[V]
5. Capacitance­AC Voltage Characteristics
1kHz     Equipment:LCR Meter
Cap Change[%]
AC Voltage[Vrms]
6. Capacitance­Temp. Characteristics
1kHz / 1Vrms    Equipment:LCR Meter
Cap Change[%]
Temperature[degC]
7. Temperature Rise­Ripple Current
Equipment:Temperature Rise ­ Ripple Current Measurement system
Temperature[degC]
Current[Arms]
500kHz 0.5 Rated Voltage
1MHz 0.5 Rated Voltage
