DeadlySIn777/Controller/reports/motherboard-return-zoning-20261001/motor-exact-antipad-union-native-controls-r04/wrong_actual_endpoint_position-evaluation-command.txt

{"rejected": true, "reason": "Actual signal corridor crosses a foreign hole or unqualified own-reference boundary"}
