DeadlySIn777/Controller/reports/power-protection-evidence-20260928/reports/power-protection-scoped-tests.txt

test_actual_export_matches_frozen_ledger_and_two_independent_branches (test_encoder_power.EncoderPowerTests.test_actual_export_matches_frozen_ledger_and_two_independent_branches) ... ok
test_dbv_input_output_swap_is_rejected (test_encoder_power.EncoderPowerTests.test_dbv_input_output_swap_is_rejected) ... ok
test_enable_cannot_float_or_default_on (test_encoder_power.EncoderPowerTests.test_enable_cannot_float_or_default_on) ... ok
test_fault_cannot_be_pulled_to_five_volts_or_swapped_between_ports (test_encoder_power.EncoderPowerTests.test_fault_cannot_be_pulled_to_five_volts_or_swapped_between_ports) ... ok
test_finite_current_and_unqualified_partial_power_thermal_envelopes (test_encoder_power.EncoderPowerTests.test_finite_current_and_unqualified_partial_power_thermal_envelopes) ... ok
test_limiter_bypass_or_port_merge_is_rejected (test_encoder_power.EncoderPowerTests.test_limiter_bypass_or_port_merge_is_rejected) ... ok
test_missing_bypass_ground_or_dnp_is_rejected (test_encoder_power.EncoderPowerTests.test_missing_bypass_ground_or_dnp_is_rejected) ... ok
test_missing_or_wrong_ilim_resistor_is_rejected (test_encoder_power.EncoderPowerTests.test_missing_or_wrong_ilim_resistor_is_rejected) ... ok
test_normal_budget_cannot_disguise_simultaneous_fault_current (test_encoder_power.EncoderPowerTests.test_normal_budget_cannot_disguise_simultaneous_fault_current) ... ok
test_open_drain_fault_pin_definition_is_required (test_encoder_power.EncoderPowerTests.test_open_drain_fault_pin_definition_is_required) ... ok
test_plain_auto_recover_or_different_package_is_rejected (test_encoder_power.EncoderPowerTests.test_plain_auto_recover_or_different_package_is_rejected) ... ok
test_thermal_retry_reverse_flow_and_missing_inhibit_cannot_be_hidden (test_encoder_power.EncoderPowerTests.test_thermal_retry_reverse_flow_and_missing_inhibit_cannot_be_hidden) ... ok
test_actual_export_matches_independent_contract (test_power_entry.PowerEntryTests.test_actual_export_matches_independent_contract) ... ok
test_current_limit_value_change_requires_review (test_power_entry.PowerEntryTests.test_current_limit_value_change_requires_review) ... ok
test_duplicate_component_identity_is_rejected (test_power_entry.PowerEntryTests.test_duplicate_component_identity_is_rejected) ... ok
test_duplicate_pin_cannot_be_hidden_by_set_comparison (test_power_entry.PowerEntryTests.test_duplicate_pin_cannot_be_hidden_by_set_comparison) ... ok
test_exposed_ground_pad_cannot_float (test_power_entry.PowerEntryTests.test_exposed_ground_pad_cannot_float) ... ok
test_fast_gate_pulldown_source_is_raw_not_ground (test_power_entry.PowerEntryTests.test_fast_gate_pulldown_source_is_raw_not_ground) ... ok
test_fault_pin_cannot_lose_open_drain_erc_type (test_power_entry.PowerEntryTests.test_fault_pin_cannot_lose_open_drain_erc_type) ... ok
test_field_and_logic_returns_cannot_join (test_power_entry.PowerEntryTests.test_field_and_logic_returns_cannot_join) ... ok
test_field_fault_pullup_cannot_reach_logic_rail (test_power_entry.PowerEntryTests.test_field_fault_pullup_cannot_reach_logic_rail) ... ok
test_fuse_cannot_be_bypassed_by_input_terminal (test_power_entry.PowerEntryTests.test_fuse_cannot_be_bypassed_by_input_terminal) ... ok
test_fuse_cannot_be_omitted_from_assembly (test_power_entry.PowerEntryTests.test_fuse_cannot_be_omitted_from_assembly) ... ok
test_mode_cannot_silently_enable_auto_retry (test_power_entry.PowerEntryTests.test_mode_cannot_silently_enable_auto_retry) ... ok
test_output_negative_clamp_cannot_be_reversed (test_power_entry.PowerEntryTests.test_output_negative_clamp_cannot_be_reversed) ... ok
test_pulse_current_variant_cannot_replace_26630 (test_power_entry.PowerEntryTests.test_pulse_current_variant_cannot_replace_26630) ... ok
test_reset_contact_cannot_short_raw_supply (test_power_entry.PowerEntryTests.test_reset_contact_cannot_short_raw_supply) ... ok
test_reverse_blocking_fet_source_cannot_face_output (test_power_entry.PowerEntryTests.test_reverse_blocking_fet_source_cannot_face_output) ... ok
test_unexpected_imon_capacitor_node_is_rejected (test_power_entry.PowerEntryTests.test_unexpected_imon_capacitor_node_is_rejected) ... ok
test_uvlo_ladder_cannot_be_rewired_as_ovp (test_power_entry.PowerEntryTests.test_uvlo_ladder_cannot_be_rewired_as_ovp) ... ok
test_all_nonfinite_and_boolean_current_inputs_rejected (test_power_entry_analysis.PowerEntryAnalysisTests.test_all_nonfinite_and_boolean_current_inputs_rejected) ... ok
test_cli_overflow_literal_and_wrong_root_fail_structurally (test_power_entry_analysis.PowerEntryAnalysisTests.test_cli_overflow_literal_and_wrong_root_fail_structurally) ... ok
test_current_design_is_calculable_but_not_qualified (test_power_entry_analysis.PowerEntryAnalysisTests.test_current_design_is_calculable_but_not_qualified) ... ok
test_double_capacitance_doubles_charge_but_not_ramp (test_power_entry_analysis.PowerEntryAnalysisTests.test_double_capacitance_doubles_charge_but_not_ramp) ... ok
test_embedded_previous_results_are_not_an_authority (test_power_entry_analysis.PowerEntryAnalysisTests.test_embedded_previous_results_are_not_an_authority) ... ok
test_ground_join_or_branch_duplication_rejected (test_power_entry_analysis.PowerEntryAnalysisTests.test_ground_join_or_branch_duplication_rejected) ... ok
test_ideal_network_reduces_to_analytic_divider (test_power_entry_analysis.PowerEntryAnalysisTests.test_ideal_network_reduces_to_analytic_divider) ... ok
test_ledger_load_change_invalidates_frozen_budget (test_power_entry_analysis.PowerEntryAnalysisTests.test_ledger_load_change_invalidates_frozen_budget) ... ok
test_nan_hidden_in_unrelated_json_is_rejected (test_power_entry_analysis.PowerEntryAnalysisTests.test_nan_hidden_in_unrelated_json_is_rejected) ... ok
test_old2a_source_cannot_pass_upper_current_screen (test_power_entry_analysis.PowerEntryAnalysisTests.test_old2a_source_cannot_pass_upper_current_screen) ... ok
test_restoring_old18v_envelope_reports_converter_undervoltage (test_power_entry_analysis.PowerEntryAnalysisTests.test_restoring_old18v_envelope_reports_converter_undervoltage) ... ok
test_singular_or_negative_resistors_are_rejected (test_power_entry_analysis.PowerEntryAnalysisTests.test_singular_or_negative_resistors_are_rejected) ... ok
test_two_times_pulse_variant_cannot_reuse_analysis (test_power_entry_analysis.PowerEntryAnalysisTests.test_two_times_pulse_variant_cannot_reuse_analysis) ... ok
test_unwarranted_accuracy_or_certainty_rejected (test_power_entry_analysis.PowerEntryAnalysisTests.test_unwarranted_accuracy_or_certainty_rejected) ... ok
test_wider_tolerance_never_shrinks_corners (test_power_entry_analysis.PowerEntryAnalysisTests.test_wider_tolerance_never_shrinks_corners) ... ok
test_wrong_fet_polarity_and_gate_map_are_rejected (test_power_entry_analysis.PowerEntryAnalysisTests.test_wrong_fet_polarity_and_gate_map_are_rejected) ... ok

----------------------------------------------------------------------
Ran 46 tests in 0.377s

OK
