DeadlySIn777/Controller/reports/pre-hardware-characterization-20261001/status-line-ending-correction-r01/ENGINEERING_STATUS.md

# Controller engineering status — 1 October 2026

**Current CNC3 rate boundary:** the frozen twelve-channel protocol requires **195,312.5 steps/s per channel** at assumed 50 MHz (`MAX_RATE=0x01000000`, timing range 100–1023 ticks), independently of the historical CNC1 evidence. The report-local stateful candidate now passes all eleven replay stages, including incoming global/timing admission, 365 endpoint cases, 570 equivalence frames and actual SPI fault/mutation checks. Nine actual SPI/STEP/DIR/ABZ/ideal-mechanics scenarios also pass; real CNC3 HAL and complete I/O providers remain unfinished. The requested 2 MHz target needs subsequent protocol/runtime and electrical qualification; isolated component sweeps do not close it. [Exact inspection and arithmetic](pre-hardware-characterization-20261001/CNC3-frozen-rate-contract-r01/receipt.json).

**Bounded simulation evidence:** [reproducible stateful FPGA bundle](../reports/cnc3-stateful-implementation-20261001/serial-admission-handoff-r01/receipt.json) and [nine actual serial-to-mechanics cases](../reports/controller-plant-20261001/actual-spi-edge-plant-r03/receipt.json) use the same frozen RTL bytes. Twelve emitted STEP/DIR outputs and four actual quadrature algorithms are exercised with explicit ideal external power/permission fixtures. The 1,114-check isolated mechanics fixture also has twelve compiled negative controls. The one-command bench now includes separate fresh stateful and serial/mechanics stages; this is not a physical controller or a complete LinuxCNC/CNC3 machine.

**Latest verified increment — Source26/ROOT102:** two existing capacitor poses and six conductors complete two additional owned bypass loops; no electrical source, parts, pin nets or rating changed. Actual native and independent connectivity agree on **3,524 required joins remaining**, with zero orphan copper. Native regular DRC is **0 errors/0 warnings/no ignored checks**; ERC remains **0 errors/70 unsuppressed warnings**. [Full disconnected r06](../reports/pre-hardware-validation-20261001/full-analog-plant-r06/report.json) passed **20 stages**, left **9 blocked** and **1 physical stage unrun**, with **0 failed stages**; **1,880 host cases and 235 native KiCad cases pass**, five Windows symlink cases remain skipped, and all **3,765 scoped source hashes** stayed unchanged. This supersedes r05 as the current exact-board run and freshly includes 96 passive filter cases, 12 manufacturer-buffer cases, and the isolated mechanics fixture with 1,114 checks and 12 compiled negative controls. The ROOT102 PCB and Source26 electrical design are unchanged. [Current adoption](../reports/motherboard-return-zoning-20261001/ROOT101-two-same-side-bypass-restored-r06/adoption.json).

[Updated characterization](../reports/pre-hardware-characterization-20261001/characterization-register-r03/requirements-and-coverage.json) retains all 15 subsystem, 22 fault and nine machine requirements. Twelve changing-speed/reversal pulse generators pass 43,200,324 edge/count checks; four ideal-input encoder components and actual CNC3 structural SPI/codec RTL pass their scoped sweeps. The real manufacturer OPA buffer model passes 12 simultaneous four-channel cases, alongside 96 passive filter cases and two numerical-sensitivity studies. **Complete stateful CNC3/HAL/machine integration and whole-circuit analog qualification remain open.** Failed full-chain amplifier convergence and the encrypted ADC model are recorded; ideal boundaries are not physical substitutes.

[Native drill/land screening](../reports/motherboard-pcb-integration-20261001/two-cap-full-drill-SMD-audit-r01/receipt.json) identifies **275 existing drilled vias overlapping 279 same-net paste SMD lands**. This is a lower bound: exact tangency and assembly registration margins need further checking. Each location needs layout correction or an explicitly qualified filled/capped fabrication/assembly disposition; ordinary DRC and tenting do not close this work. No fabrication package or manufacturing readiness is claimed.

**Pre-hardware bench work, 1 October 2026:** [actual twelve-generator HDL sweep](pre-hardware-characterization-20261001/stepgen12-sweep-r02/receipt.json) passes 144 scenarios and 7,077,888 edge/count comparisons. Three explicit timing profiles sweep from 100 kHz through 4 MHz and test the integer DDS safe/failure boundary in both directions and reset-reachable worst phases. At assumed 50 MHz, default 100/100 ticks permits 248,756.213 pulses/s at the isolated generator; experimental 12/12 permits 1,999,999.990 and 9/9 permits 2,631,578.944. These are component simulation limits, not product ratings. The historical CNC1 endpoint remains capped at 195,312.5 pulses/s. [Four actual compiled-copy fault controls](pre-hardware-characterization-20261001/stepgen12-mutation-controls-r02/receipt.json) pass; original production RTL is unchanged. [Coverage and missing work](pre-hardware-characterization-20261001/characterization-register-r03/requirements-and-coverage.json) accounts for 15 subsystems, 22 injected-fault cases, plant faults and nine machine profiles. Full CNC3/HAL-to-RTL, SPICE and vendor fit/timing are unfinished. [Provisional datasheet](pre-hardware-characterization-20261001/characterization-register-r03/provisional-datasheet.json) has no hardware-qualified rating.

The adopted **source26 electrical design retains 2,688 physical footprints: 2,642 purchased fitted parts, 37 bare PCB test pads, one bare chassis bond pad, six bare M3 mounting holes and two DNP footprints**. All twelve motor interfaces, four ABZ receiving paths, 24 general DI, 16 smart DO at 0.5 A/channel and 2 A/four-channel-group, acquisition/control MCUs, power supervision, protected probe/pendant supplies, process and isolated analog I/O, RS-485/CAN, compute/ESP/storage sockets, display/USB/Ethernet interfaces, indicators and field terminals are represented in the actual source. Native ERC has **zero errors, 70 unsuppressed warnings and no ignored checks**; **301 focused source/native checks pass**. Source26 makes exactly two manufacturer-confirmed reference-capacitor identity corrections and three manufacturer-land fuse-footprint corrections without changing any electrical pin nets or population. The retained original 327-part/1,229-pin-net baseline remains checked. The actual FPGA package has **256 checked native pads, 135 assigned user functions, 48 free user resources and 14 correctly mapped IO3 bank-power pins**; vendor package fit/timing remains unproved. All 723 capacitor owners have exact source-pin/function provenance. Twelve fitted interfaces remain distinct from the historical six-active-axis/two-encoder runtime.

The current **adopted working PCB r102**, separate from the published viewer, has **2,688 footprints, 9,498 fitted pads, 11,641 track/via items and 1,521 native zones/rule areas**. Its exact source and independent physical connectivity checks pass, with **632 fully joined and 1,102 incomplete multi-pad nets out of 1,734**, **3,524 uncapped missing joins**, agreement between native and independent SOURCE-connected cluster counts, and zero orphan copper. Native DRC reports **zero errors, zero warnings and no ignored checks**. Combined proof preserves **108 actual owned-bypass loops, 221 receiving-return endpoint checks and 54 physically SOURCE-anchored reference-bridge groups**. Nine literal ordinary SOURCE-pair routes are now complete and independently rechecked on the combined board. The bounded FPGA neck rule applies only to 38 reviewed signal nets inside the F-side BGA area: 0.15 mm short necks with a separate aggregate 1 mm/net limit; all other tracks retain the 0.20 mm minimum and power rules remain unchanged. Native healthy/negative rule controls pass. Contradictory PCBWay process tables leave exact 2 oz fine-line process confirmation outstanding; this rule is not production process qualification. Two additional literal local critical SOURCE-pair paths are independently complete on the combined board; this does not establish complete multi-endpoint clocks or loaded timing. The fresh regression passed 1,847 host cases and all 235 actual KiCad-native cases; only five Windows symlink cases remain skipped. All 2,813 scoped source hashes stayed unchanged. [Fresh regression](board-completion-20261001/source26-root101-combined-validation.json). Fresh native ERC retains the same 70 unsuppressed warning semantics and zero errors; transient KiCad pin-object UUIDs were reconciled by exact source-pin identity. The complete AO1 DAC SDO path is now physically routed and independently checked with its exact four segments and 0.40 mm own-reference corridor. The reviewed retirement of one redundant AO1 same-domain zone retains its entire native outline in the keeper; exact disjoint LOGIC polygon composition preserves the prior ADC/reference cuts. All 188 actual filled reference resources are now physically SOURCE-anchored, with no synthetic exemptions. This resource-anchoring result does not establish every SMD local return loop, signal waveform or rail capacity. Separate C14804 adjacent-reference and C19042 circuit proofs also pass. The complete FPGA FLASH_MISO path now connects the actual U1001.N1 and U1002.2 endpoints through twelve F-side conductors, with no signal vias, a measured native path of 66.954 mm, the unchanged 0.40 mm own-reference corridor and twelve actual conductor-cut negatives. Loaded flash/configuration timing and the final manufacturing stackup remain unqualified. Seven additional literal ordinary SOURCE-pair routes now pass actual endpoint and individual conductor-cut checks through 65 added conductors. Their common In1 reference, source-owned transition stitches and unchanged IO3 preservation guard pass on the actual combined board after a separately reviewed local unused-tip cleanup. The composed power chain retains the original MISO power proof and all actual receiver contacts; it does not establish loaded rail capacity or whole-board timing. Four further ordinary Source-pair routes (DI6, DI7, DI9 and DI_SENSOR_G2_FAULT), 82 motor control segments, 20 health-supply continuity endpoints and the actual RAW supply transfers are checked on the combined board. The U11019 and U11025 receiving loops now pass; U11020/U11026 and the staged Source27 reset/slow-input circuit corrections remain unfinished. All 5,969 prior connected Source-pad groups are retained. These are scoped local proofs; global power and reference qualification remain incomplete. The 44 distinct floating substrate/thermal islands pass their independent physical checks. Routing is incomplete; these results do not establish complete power distribution, signal integrity or manufacturing readiness.

Published native CAD **20261001-28** now matches the adopted Source26/r102 board: **2,688 footprints, 11,641 track/via items, 1,521 native zones/rule areas and 3,524 independently counted missing joins**. Its board SHA-256 is `769541d11876ea0050240ec065f6b0b85bff19c7c8324f1c26b9b637212a8af5`; fresh publication DRC has zero regular errors/warnings and no ignored checks. The actual footprint libraries are packaged locally with 92 used-library land patterns checked; the true outline, rounded ESP antenna notch and actual compute-socket model are retained. The side-panel opening was queued by the app; visible navigation is not independently confirmed. The **460 × 340 mm, six-layer, 1.6 mm** outline/stackup remains provisional.

Continue concrete routing and exact power/return-path reconciliation. The 20 ms physical fault-to-inhibit requirement, partial-power/reset/missing-module states, loaded target software, complete twelve-channel operation, FPGA fit/timing, thermal/EMC behavior and production assembly still need qualification. Native ERC, native DRC, host tests, target compilation, HDL simulation, synthesis and physical measurements remain separate evidence. Gerbers, drill files, final assembly CPL/drawings and the final manufacturer stackup are not released; `manufacturing_ready` remains false.

The immutable **source26 2,688-footprint cost audit v11** separates 2,642 purchased fitted board parts from 44 bare PCB features, two DNPs and purchased modules/accessories. It prices **105 exact MPNs and leaves 185 unpriced: 720 purchased fitted pieces per board remain unpriced**. Known-priced consumed inventory per board at **1/10/100 controllers is US$1,091.51/$877.37/$796.51**. Catalogue purchase cash for those whole build quantities is **US$61,020.80/$67,419.50/$131,032.35**, including unused MOQ inventory; price, cash and stock coverage remain distinct. These are partial dated exact-MPN catalogue baskets, not complete manufactured-board/controller/kit prices or PCBWay quotations. Complete totals remain null. Compute/storage/AI/screen SKUs, other accessories, fabrication, assembly, programming/test and packaging remain separate unknowns. Independent verification checks 169 frozen files, 876 quantity rows and 13 adversarial controls. Earlier cost snapshots remain immutable history.

[source](motherboard-integration-20261001/source26-reference-fuse-adopted-r04/adoption.json); [board](motherboard-pcb-integration-20261001/source26-seven-path-larger-IO3-cleanup-trial-r87/adoption.json); [connectivity](motherboard-pcb-integration-20261001/source26-seven-path-larger-IO3-cleanup-trial-r87/independent-connectivity/review.json); [cost](motherboard-cost-20260930/source-r26-2688-complete-cost-v11/README.md); [owners](motherboard-bypass-owners-20261001/complete723-source26-r11/capacitor-owners.json); [routing](motherboard-ordinary-routing-20261001/tooling-r03-annulus-freeze-r02/review.json).

**Routing-tool evidence:** The reviewed ordinary r03 and owned-bypass r02 wrappers require actual flashed, native-connected reference annuli. Fifteen native regression tests and 15 persisted healthy/adversarial cases pass; the actual toy DSN/Freerouting/SES additive fixture has zero DRC violations and zero missing joins with old copper/source/lands preserved. The 112-net source26 ordinary allowlist and complete 723-owner manifest are frozen. Those fixture results do not establish actual motherboard routing. Actual ordinary routing is limited to literal physically SOURCE-anchored filled reference pieces, preserving the full failed-piece ledger; the entire board and whole LOGIC return net are not qualified. Native routing candidates remain unadopted until their complete endpoint, source, old-copper, warning and return-corridor checks pass.

**Fresh disconnected regression:** 1,847 host cases pass; all 210 cases requiring actual KiCad are separately executed and pass in KiCad Python. Five Windows symlink cases remain explicitly skipped. All 2,798 scoped source hashes remain unchanged. The native cases correspond exactly to the host KiCad skips and are counted once. This closes the earlier stale cost-fixture/published-BOM binding and CPython native-import failures; those failed receipts and the older 980-source run remain immutable history. [Combined validation](board-completion-20261001/source26-ground-routing-combined-validation.json). These checks do not prove target real-time timing, FPGA vendor fit or physical hardware.

## Historical runtime and circuit records

The retained table below preserves prior software/runtime and MC evidence with its original dates/scopes. Its old card/connector allocation and unfinished-module descriptions are superseded where the current integrated source above actually implements them. Six-joint/two-encoder runtime remains historical baseline evidence; twelve physical motor interfaces are not twelve proven coordinated machine axes.

## Implemented and checked

| Workstream | Concrete result | Evidence boundary |

|---|---|---|

| LinuxCNC service adapter | Explicit-connect command/status/error integration; expiring one-use requests; program identity and reconnect rules | 49 contract tests (44 pass and 5 symlink cases skip on Windows in the latest full run); physical profiles rejected |

| Actual LinuxCNC runtime | Homing, MDI, line/arc, hold/resume, abort and reconnect cases | 12 real checks; 3,118 status samples (run `bac564b6`, 2026-09-28T19:03:22Z; the earlier 3,166-sample run is historical); WSL POSIX simulation, not a real-time board test |

| CNC1 end-to-end runtime | Compiled common codec/session/scaling and HAL read/write; actual RTL feedback/fault handling and guarded scale changes | 27 volatile regression checks (run `551cc0bd`, 1,124 trace rows, 14.8190 s wall / 3.1621 s simulated) plus 68 persistence checks across nine separate LinuxCNC launches (run `5cd2bcb5`), [CNC1 manifest](../cnc1/evidence/manifest.json) recorded 2026-09-28T20:56:18Z; earlier 26/59-check runs are historical and archived under `cnc1/evidence/before-*`. No physical encoder plant or real-time qualification |

| Compiled CNC1/RTL checks | Six-channel commands, corruption/loss, wrap, atomic stopped scale commit and persistent configuration inhibit | 220 assertions including repeated setup and labeled synthetic fixtures (192 and 219 are historical); gateware default-v1 regression 252 counted checks plus 27 ABI v2 checks (the 180-check v1 figure is historical). Compiled-log and RTL-regression evidence were carried forward into the final record because the C, RTL and module bytes did not change |

| Runtime configuration service/CLI | Actual LinuxCNC status and discovered RTL capabilities; stopped preview/apply, unhome and compiled guards | 41 host policy tests against an adapter double, plus the actual-runtime checks above; the service refuses a servo period above half the discovered RTL watchdog and keeps a 2-count pulse-rate margin, both checked against the live snapshot. Only XYZ step scales are configurable |

| Durable runtime configuration | Checksummed machine/profile/capability-bound authority and generation witness; explicit startup reconciliation and interrupted-save recovery | 33 host tests and 68 actual-runtime checks; compiled deadline guard and startup inhibit; a persistent acknowledgement requires a stopped scale commit after staging. Separate bounded scale schema, not the complete machine-profile cartridge |

| Linux SPI backend | Fixed 64-byte Linux spidev transport; checked setup, cleanup, readback, failure latch and no automatic replay | 892 assertions in each normal and ASan/UBSan run, plus C++ linkage; device calls mocked. Rerun against the current common header: the [spidev manifest](../cnc1/evidence/spidev/manifest.json) (recorded 2026-09-28T20:30:34Z) records compiled build-cnc1.h SHA-256 0e244ab0..., which matches the current cnc1/src/cnc1.h. Earlier runs against headers 601b8a46... and e88c22... are historical and archived under `cnc1/evidence/spidev/before-*`. Blocking laboratory backend, not activated in HAL or deadline-qualified |

| FPGA reference and synthesis | Six STEP/DIR generators, two ABZ counters, CRC-protected SPI, watchdog and inhibit; actual ABI2 Efinix-family mapping | [RTL regression](GATEWARE_VALIDATION.md): 252 counted default-v1 checks plus 27 ABI v2 checks with strict lint (180 v1 and 26 v2 are historical). [Synthesis](FPGA_SYNTHESIS.md) recorded 2026-09-28T19:22:22Z: 9,426 mapped cells (4,072 LUT4, 2,132 ADD, 3,221 FF, 1 GBUFCE; 9,420 cells / 3,215 FF are historical), zero latches, and a structural inhibit CDC check passes. The RTL now has a `progress_wdi` useful-progress output; the core/8 SPI bound includes a nominal MISO turnaround that is unmeasured. Package fit, routed timing, CDC metastability and bitstream remain unproved |

| ESP32-S3 helper | Read-only health framing, replay/freshness checks and diagnostic reporting | Default and UART compile-check images build under ESP-IDF 5.5.4; host core passes strict warnings and sanitizers. Images, logs and manifest are retained in `firmware/esp32_service/evidence/` (recorded 2026-09-28T19:17:08Z; the build is not reproducible, so the hashes identify retained copies). One of its 14 source hashes, the host-side `controller_lab/service_health.py`, has changed since; that record is pending re-recording. Freshness deadlines of 1000/500 ms are advisory and documented with the required 4-10 Hz host cadence. No device flashed |

| Electrical design | Channel/device/net/power/terminal ledger and source generators | Historical ledger retained; current candidate has 12 STEP/DIR pairs and 96 sourced FPGA user/reserve allocations, but enable/alarm/full-I/O and power fit remain open |

| KiCad transmitter source | Twelve differential STEP/DIR signals across six AM26C31 banks | ERC zero violations and focused source/netlist checks pass; all twelve pairs are connected in the assembly, but driver loading, partial power, enable/alarm stages and physical timing remain open |

| KiCad encoder receivers | Two ABZ ports with six used differential receivers, explicit unused-channel defaults, termination and supply/reference boundaries | ERC zero violations and ten host checks pass; encoder supply limiters, line protection, package pin assignment and physical qualification remain open |

| Release checks | Required evidence, revision/hash/path validation, one distinct evidence file per id (by path and SHA-256), and a structured PCBWay quote record that cannot be complete before its prerequisites. The quote record needs non-blank identity text fields, an ISO 8601 `quoted_at` and per-quantity figures (currency, unit price, setup cost, lead time) covering exactly the quoted quantities | 36 release tests. The [release manifest](../manufacturing/release-manifest.json) has 23 artifact ids, none complete, including the new `link_prototype_measurement`; the manufacturing owner's regenerated reports record 17 prototype and 23 production blockers (exit 2, blocked). Missing or changed evidence keeps release blocked; this does not certify hardware |

| Configuration service/CLI | Shared typed virtual profiles, illustrative wiring, validation/diff, revision-bound disarmed apply and backup/restore | 40 tests and executable service demo pass; disconnected file-only prototype, not bound to CNC1 or real machine state |

| Module replacement and cartridge recovery | Two bounded file-backed settings records, compatible virtual input-bank replacement, explicit new-compute bootstrap through the shared service | 34 scoped tests and executable demo pass; module replacement records a same-revision `replace_module` audit entry through an internal recovery-only helper; no physical memory driver, automatic discovery, output control or production mirror authority |

| Recovery public CLI | Cartridge inspect/save, authored fixture inventory, bootstrap/replacement previews and revalidated apply through existing services | 10 subprocess tests and a 14-command walkthrough pass; disconnected file operations with no physical discovery |

| Connected power and interface circuits | Thirteen electrically connected sheets with independent netlist contracts, power calculations and preserved source inputs | Current details in CONNECTED_CONTROLLER.md; 0 ERC errors/22 expected substrate warnings; power, full controller and physical qualification absent |

| Combined Python regression | Current [post-r0.4 run](board-completion-20260930/post-r04-host-validation/README.md): 869 reported, 864 passed/five Windows symlink skips, with 1,272 unchanged source/research hashes | Disconnected host evidence only. Earlier [579-case observation](audit-2026-09-28/python-tests.txt) lacked a source inventory; the frozen 290-case implementation and thirteen-block records remain historical. Focused current cases are included in the full count. |

Detailed reports: [CNC1 end-to-end connection](CNC1_INTEGRATION.md), [earlier LinuxCNC adapter/runtime](LINUXCNC_INTEGRATION.md), [FPGA baseline](GATEWARE_VALIDATION.md), [ESP firmware](ESP_SERVICE_BUILD.md), [electrical design](../docs/ELECTRICAL_DESIGN.md), [hardware ledger result](../hardware/validation-report.json), [configuration demo](CONFIGURATION_DEMO.md).

New hardware evidence: [actual FPGA synthesis and mapped-circuit verification](FPGA_SYNTHESIS.md), [six-joint transmitters](SIX_JOINT_TRANSMITTER.md) and [two-ABZ receivers](ENCODER_RECEIVERS.md). 179 frozen-driver harness assertions (about 30 of them host-only) pass with the mapped circuit, using frozen pre-persistence driver sources ([post-map manifest](../gateware/synthesis/postmap/manifest.json), recorded 2026-09-28T19:24:08Z); `inhibit_n` is held deasserted and the fault/ready/progress pins are not observed. Both new KiCad blocks have actual netlist/ERC exports and were visually inspected. Those earlier exports were isolated blocks. They are now included in the connected partial-controller project; a full-board schematic and layout remain unfinished.

The [persistent runtime report](PERSISTENT_RUNTIME.md) records separate-launch calibration recovery, process-death injection, corrupt/foreign/older-authority refusals and compiled deadline checks. Production memory, target Linux real-time operation and full-profile recovery remain outside that proof.

## Corrections found during engineering

- LinuxCNC run completion cannot be treated as a quick synchronous command acknowledgment. The adapter dispatches appropriate motion commands asynchronously and observes their actual completion.

- Request deadlines are checked again after status reads and before each individual command write; a slow mode change cannot make a stale motion request execute later.

- A first ESP counter sample does not prove progress. The helper now requires a later forward change within the same observed boot. Diagnostics remain advisory because UART queue age and sender authentication are not established.

- The previous field-side small-LDO allowance could dissipate 1.25 W at the proposed maximum input. That branch needs a switching regulator. The ESP also gets a separate regulated branch. The older cost comparison is explicitly annotated with these corrections and remaining unknowns.

- The electrical study's 250 ksteps/s goal is not achieved by the current reference RTL. Its tested configured cap is 195,312.5 steps/s at an assumed 50 MHz clock. Raising that cap alone cannot reach the goal: with the 100/100-tick STEP high/low defaults the minimum fault-free STEP period is 201 core ticks, a ceiling of 248,756 steps/s, and the RTL testbench shows that a 250 ksteps/s rate increment latches a timing fault ([gateware validation](GATEWARE_VALIDATION.md)). Physical rate capability remains unqualified.

- Power budgets currently warn about less than 20% headroom on two proposed rails. Numerical reservations and regulator capacity still need optimization and measurements.

- Integration review added host-age and implausible-counter checks, coherent encoder/index wrap handling and configuration freezing. The new controlled exception permits step-scale changes through a stopped acquire/commit/release transaction, with active HAL scale pins read-only and actual joints unhomed. Encoder scale and channel mask retain mutation-fault behavior. The compiled reference still uses a simple digital pulse-count correction loop, not a qualified physical servo design.

## Recorded product decisions

The [persistent project memory](../PROJECT_MEMORY.md) records the user's included-screen price objective, PCBWay turnkey route, optional AI companion, highly modifiable hardware/firmware, CLI-first configuration and simple guided wiring/setup. The first [configuration service/CLI demo](CONFIGURATION_DEMO.md) now runs as `python -m controller_config`; `cncctl` remains the proposed product command name. The broader [CLI requirements](../docs/CONFIGURATION_AND_CLI.md) include operations this disconnected prototype does not implement.

The latest [display requirements](../docs/DISPLAY_TIERS.md) cover 7-, 10-, 12-, 14-, 18- and 21-inch classes and further qualified sizes. The plan now calls for a shared responsive UI, screen size independent of compute/I/O capacity, and complete per-package costing and acceptance. This is a requirements update: the UI has not been adapted or tested across those panels, and the older cost workbook still describes its 21.5-inch/six-joint scenario.

The [power-protection proposal](../docs/POWER_PROTECTION.md) uses coordinated physical entry fuses and electronic branch protection. Existing protected outputs may supply channel-level protection without duplicate eFuses. Exact ratings, external reverse-polarity parts, fault recovery and BOM costs are unresolved. AI does not receive a path to bypass machine or electrical limits.

The latest [ESP accessory plan](../docs/ESP_ACCESSORY_AUTOMATION.md) adds supporting-equipment requests, direct sensor confirmation and one output owner. Essential-service loss changes the required machine response; current ESP firmware remains diagnostic-only. The [industrial qualification plan](../docs/INDUSTRIAL_QUALIFICATION.md) covers the complete assembly, HDPE enclosure candidate, fault-specific cooling/workholding behavior, manufacturing records and a later proposed pilot. No new accessory firmware, industrial rating or safety certification is claimed.

## What prevents board release

The [repair and memory specification](../docs/MODULAR_REPAIR_AND_MEMORY.md) requires retained wiring, grouped replaceable sections and a complete machine-configuration cartridge, separate from firmware and module factory calibration. The earlier terminal-first comparison is historical: a fixed wiring base and removable FPGA card were subsequently confirmed, while the newer one-PCB direction remains a pending architecture clarification rather than a silent waiver. The [disconnected recovery demo](MODULE_REPLACEMENT_DEMO.md) preserves settings across a virtual input-bank exchange, uses its own fixture calibration metadata, recovers valid records after simulated torn/corrupt writes and imports into a new store without weakening ordinary backup identity checks. All paths remain inhibited/unhomed with no run permission. Its two example records occupy 13,812 bytes. Physical memory, connectors, bus/power protection, preprogrammed replacement logistics and their added manufactured costs remain unresolved. The [original note](../research/user-notes/2026-09-28-repairability-memory.txt) is preserved unchanged. Existing backup files alone do not satisfy physical interrupted-write qualification.

The original ledger validator records **54 open design/release items** and zero consistency errors; that historical count is not a fresh count of all findings in the connected circuit review. The remaining categories are:

1. Complete power/protection, permission and I/O schematics; exact fitted support parts; package/bank/pin assignments and machine-interface compatibility.

2. Vendor device implementation, package/resource fit, timing closure, board wrapper and the board coupling of the useful-progress watchdog signal. The RTL now has a `progress_wdi` output that toggles once per accepted sequence-valid UPDATE; its connection to an external watchdog on a board remains open. Actual Yosys Efinix-family synthesis now passes; it does not prove T20 placement, timing or a working bitstream. The current endpoint omits the full field-I/O/analog/probe feature set.

3. A qualified physical Pi/Rockchip CNC1 SPI backend and target Linux/graphics configuration. The ROCK 3C host named in the six-joint ledger is an earlier engineering baseline; the compute choice remains open within the [CM4/CM5-style carrier study](../docs/COMPUTE_CARRIER_STRATEGY.md). The new Linux spidev implementation is a compiled laboratory backend with mocked syscall checks; its synchronous ioctl has no enforced deadline. The actual-runtime HAL still uses RTL simulation. Neither result establishes physical timing or machine-ready motion behavior. Python stays outside the cyclic path; unmodified Mesa drivers do not implement CNC1. The release manifest's `link_prototype_measurement` item requires the bounded pre-layout physical link measurement on an engineering host and FPGA evaluation board; acquiring them is a user purchase decision.

4. PCB layout, fabrication outputs, placement file, full ERC/DRC, mechanical/display integration and reviewed assembly/test instructions. The [PCBWay submission checklist](../manufacturing/PCBWAY_SUBMISSION_CHECKLIST.md) lists every file and decision a turnkey order needs and their current state; the design is **not ready for PCBWay manufacture**.

5. A complete fitted-BOM/PCBWay quotation and viable total bundle economics. Public reference prices cannot stand in for turnkey procurement and finished-product cost.

6. Physical power/reset/fault/timing/thermal/EMC and machine tests after appropriate engineering prototypes exist. The current software results cannot replace these measurements.

The UI/CAD import experience, production network authentication, wireless recovery, ESP accessory automation and AI application remain unfinished. Durable XYZ-scale activation and restart reconciliation now work in actual LinuxCNC/RTL simulation. The complete machine-profile store/cartridge, production runtime authority and physical commissioning remain unfinished.

## Latest requirements integration

The [platform roadmap](../docs/PLATFORM_ROADMAP.md) records all 200 supplied features with stable IDs, original-note provenance and staged acceptance work. Eight standard motors plus a four-motor plug-in/factory-fitted path, individual enable/alarm and 24 general DI/16 general DO are confirmed requirements; the [expanded target](../docs/EXPANDED_HARDWARE_TARGET.md) preserves the wider design study. MC source motor/TX buffers are now integrated, but the complete interfaces, expanded runtime and qualified modular product remain unfinished. The existing six/two ledger/runtime totals remain historical baseline evidence. No gateware performance or runtime channel count was increased by editing the plan.

New contracts cover [power-off plasma module upgrades](../docs/PLASMA_MODULE_SYSTEM.md), [third-party Modbus adapters and devices](../docs/THIRD_PARTY_MODBUS.md), and the proposed [CM4/CM5-style compute carrier](../docs/COMPUTE_CARRIER_STRATEGY.md). [BTT compute research](../research/BTT_COMPUTE_REVIEW.md) identifies remaining real-time/carrier work. The new [compute/carrier/display matrix](../research/COMPUTE_DISPLAY_MATRIX.md) has 144 source/arithmetic cases across three modules, six screens, two I/O scopes and four quantities; every complete manufactured total remains incomplete. The older workbook is preserved. Source inspection and the disconnected configuration demo do not establish live module detection, accessory control or physical qualification.

[Planning-package checks](platform-plan-review.json) confirm all 200 feature IDs, three archives identical to the supplied originals, valid JSON and 116 existing local links across 16 documents. Independent review corrected Modbus in-flight-command uncertainty, ESP authority, the pre-layout physical-link prerequisite and initial plasma qualification permissions. These are document/data consistency checks, not additional machine tests.

The earlier [root integration review](integration-review.json) records the 168-test run, configuration API demo, 144-case matrix check and source identities. Its initial 11-case CNC1 run is preserved in the [archived manifest](../cnc1/evidence/before-runtime-configuration/manifest.json). The preceding 26-case sources/evidence are preserved under `cnc1/evidence/before-persistent-runtime`. The current volatile-mode regression (run `551cc0bd-9363-42b6-8a66-fa6adc27d7ab`) records 27 checks and 1,124 trace rows, with 14.8190 seconds wall time versus 3.1621 seconds simulated RTL time; the new check refuses a scale above the margin-adjusted pulse-rate ceiling taken from the live RTL snapshot. The separate [persistent restart summary](../cnc1/evidence/persistent/summary.json) (run `5cd2bcb5-d4e4-4592-9f53-6c6ab62b9f85`) records nine launches and 68 checks. The earlier 26-check/1,233-sample and 59-check figures are historical; the previous final-sync inputs are archived in `cnc1/evidence/before-final-sync-2026-09-28`. Neither result qualifies physical deadlines.

The final review reran affected runtime and SPI checks after detecting later CLI/launcher edits, preserving both snapshots. The older [hardware review manifest](../hardware/review-manifest.json) (recorded 2026-09-28T08:46:22Z) now has 8 of 55 stale artifact hashes by a fresh recomputation: the ledger, its validation report, both block validation records, docs/ELECTRICAL_DESIGN.md, the ledger generator, the validator and its tests. It is retained as recorded, not re-recorded here. A fresh independent ledger check passes with zero consistency errors and 54 open design items. The new transmitter/receiver manifests and their exact-source checks pass.

## Current and superseded review records

Historical review JSON files are not edited. The current partial-MC and host rows below are updated to 30 September; other recorded runtime/RTL/target evidence retains its exact earlier date and scope. A newer host run does not imply those target or physical checks were rerun.

| Area | Current record | Superseded or historical records |

|---|---|---|

| Connected hardware circuits | Current partial [MC r0.4 native/source review](board-completion-20260930/mc-integrated-r04/review.json): 327 parts, 105 unchanged inputs, fresh ERC zero/regular DRC zero with ignored checks enabled; 499 capped unconnected reports/711 physical joins remain | Historical thirteen-block [processor-hardware-20260929/review.json](processor-hardware-20260929/review.json): 291 scoped tests, 521 inputs, 28 exports, 49 ideal-digital checks, later reset-pin defect; [connected-hardware-20260928/review.json](connected-hardware-20260928/review.json), 208 scoped tests; [power-protection-review.json](power-protection-review.json), 46-test r0.1; [hardware/review-manifest.json](../hardware/review-manifest.json), older ledger |

| Hardware ledger | Historical [hardware/validation-report.json](../hardware/validation-report.json) consistency snapshot (zero consistency errors, 54 release blockers, `manufacturing_ready: false`); not newly rerun for MC r0.4 | Earlier ledger counts quoted in older reports; current partial-MC native review and manufacturing metadata have their own scope |

| CNC1 runtime and compiled driver | [cnc1/evidence/manifest.json](../cnc1/evidence/manifest.json), recorded 2026-09-28T20:56:18Z: 220 compiled assertions, 27 volatile checks (run `551cc0bd`), 68 persistent checks in nine launches (run `5cd2bcb5`), 41 runtime and 33 persistent host tests | Runs `c4357707`/`f25540e6` (26/68, archived in `cnc1/evidence/before-final-sync-2026-09-28`), `3ed8e8db`/`bc27e94a` (219 compiled), `89f626bb`/`04c7b257` and the frozen `48ea1de2`/`f2795893` (192/26/59) in [durable-hardware-review.json](durable-hardware-review.json) |

| Linux SPI backend | [cnc1/evidence/spidev/manifest.json](../cnc1/evidence/spidev/manifest.json), recorded 2026-09-28T20:30:34Z: 892 + 892 assertions and C++ link against current header 0e244ab0... | Runs against headers 601b8a46... and e88c22..., archived under `cnc1/evidence/spidev/before-*` and `root-verification-20260928/proven-spi` |

| RTL regression | [gateware/validation/manifest.json](../gateware/validation/manifest.json): 252 v1 + 27 v2 checks, regression rerun and recorded at 2026-09-28T21:47:55Z after the recorder gained a read-only `--check` mode (`python gateware/tools/record_evidence.py --check`); status-encoder output is byte-identical to the 19:42:45Z run | 180-check v1 record (06:30:23Z), archived in `gateware/validation/before-audit-fixes-2026-09-28`; the intermediate 26-check v2 count; the 19:42:45Z record as re-stamped at 20:59:48Z, archived in `gateware/validation/before-final-sync-2026-09-28` |

| FPGA synthesis and post-map | [synthesis manifest](../gateware/synthesis/manifest.json) (19:22:22Z, 9,426 mapped cells) and [post-map manifest](../gateware/synthesis/postmap/manifest.json) (19:24:08Z, 179 frozen-driver assertions) | 9,420-cell mapping; synthesis hashes pinned in the frozen durable review |

| ESP32-S3 helper | [firmware/esp32_service/evidence/manifest.json](../firmware/esp32_service/evidence/manifest.json) (re-recorded 21:48:07Z with the host core test rerun; images unchanged from the 19:17:08Z clean builds) | Archives in `firmware/esp32_service/evidence/before-audit-fixes-2026-09-28` and `before-final-sync-2026-09-28` |

| LinuxCNC adapter runtime | [controller_backend/evidence/linuxcnc-simulation.json](../controller_backend/evidence/linuxcnc-simulation.json): run `bac564b6-1f50-4593-86bc-b3d496f33e75`, 2026-09-28T19:03:22Z, 12 checks, 3,118 samples | Run `0544b28f` (3,167 samples), archived in `controller_backend/evidence/before-audit-fixes-2026-09-28`; run `da9f1f4c` (3,166 samples), whose files were overwritten earlier |

| Release gate | [manufacturing/release-manifest.json](../manufacturing/release-manifest.json), [prototype](prototype-release-check.json) and [production](production-release-check.json) reports, [PCBWay submission checklist](../manufacturing/PCBWAY_SUBMISSION_CHECKLIST.md) | Pre-fix reports archived in `manufacturing/before-audit-fixes-2026-09-28` |

| Full Python suite | [Post-r0.4 host receipt](board-completion-20260930/post-r04-host-validation/receipt.json): 869 reported/864 passed/five skipped, 1,272 unchanged hashes | [r0.3 858-case snapshot](board-completion-20260930/final-host-validation/receipt.json); [579-case working-tree observation](audit-2026-09-28/python-tests.txt); 290-test frozen snapshot ([durable-hardware-review.json](durable-hardware-review.json)); 386-test observation with mid-run change ([power-protection-python-tests.txt](power-protection-python-tests.txt)); 283-test run ([durable-hardware-python-tests.txt](durable-hardware-python-tests.txt)); 234-, 200- and 168-test reviews ([implementation-review.json](implementation-review.json), [replacement-review.json](replacement-review.json), [integration-review.json](integration-review.json)) |

## Reproduce local checks

Earlier implementation evidence includes actual-runtime calibration and persistent restart recovery, mapped-FPGA functional checks and the then-new KiCad blocks. Current partial-MC/native and host results are recorded above. The [raw Python output](durable-hardware-python-tests.txt) records the historical 283-test run. The newer hashed [frozen implementation review](durable-hardware-review.json) and its [root-verification package](root-verification-20260928/README.md) record the 290-test snapshot, and the historical 579-case run is saved in [audit-2026-09-28/python-tests.txt](audit-2026-09-28/python-tests.txt). Earlier [public recovery CLI](RECOVERY_CLI.md), [Linux SPI backend](SPI_TRANSPORT_IMPLEMENTATION.md) and [234-test review](implementation-review.json) remain separate historical evidence. The corrected persistent run restores 250 steps/mm after a separate launch and produces 250 pulses on a deliberate 1 mm command; after killing a saving process at the runtime-activation boundary, another launch explicitly recovers generation 2 at 300 steps/mm. No saved record restores homing or automatically enables motion.

The preceding [replacement review](replacement-review.json) retains its 200-test regression, successful recovery demo, source hashes and preserved user note. Ordinary configuration edits still operate on host files; full-profile production cartridge/mirror authority remains unimplemented; the separate XYZ-scale authority now has explicit reconciliation. Earlier evidence is not relabeled as a new run.

```powershell

python -m unittest discover -s tests -v

python tools/hardware_validate.py

python tools/check_release.py --output reports/prototype-release-check.json

python tools/check_release.py --stage production --output reports/production-release-check.json

python cnc1/tools/record_evidence.py --check

python cnc1/tools/record_spidev_evidence.py --check

python gateware/synthesis/record_results.py --check

python gateware/synthesis/postmap/record_results.py --check

```

The release commands are expected to return a nonzero status while required evidence is missing. The `--check` commands are read-only manifest comparisons. `gateware/tools/record_evidence.py` has no read-only mode: running it rewrites `gateware/validation/manifest.json`, so run it only after a fresh `gateware/tools/run_tests.sh`. The CNC1 recorder likewise hashes the current sources without rerunning tests: whoever changes a hashed CNC1 source must first rerun `cnc1/tools/build.sh` (when C or RTL changed), `run_host_tests.py`, `run_linuxcnc.sh` and `run_persistent.sh` as listed in [cnc1/README.md](../cnc1/README.md), archive the previous manifest and logs in a dated `before-*` folder, and only then run `record_evidence.py`. Use the component reports for the actual LinuxCNC, FPGA and ESP build commands. No ordinary check opens a physical machine connection.
