DeadlySIn777/Controller/reports/pre-hardware-characterization-20261001/status-line-ending-correction-r01/PROJECT_MEMORY.md

# Persistent project memory

**Current CNC3 rate contract, 1 October 2026:** frozen IS-1 still specifies `MAX_RATE=0x01000000` at an assumed 50 MHz, or **195,312.5 steps/s per channel**, with configured timing 100–1023 ticks. This applies to the new twelve-channel path as well as the separately historical CNC1 value. The user's 2 MHz target remains accepted but unimplemented/unqualified; experimental 9/12-tick component simulations cannot authorize that runtime rate. The report-local stateful candidate now enforces incoming MAX_RATE and per-channel timing, with 365 endpoint boundary cases, 570 serial/parallel equivalence frames and actual SPI rejection/reset/mutation tests. Its complete eleven-stage replay passes; real CNC3 HAL and all I/O providers remain unfinished. No cap/specification change has been made. [Source-bound inspection](reports/pre-hardware-characterization-20261001/CNC3-frozen-rate-contract-r01/receipt.json).

**Bounded simulation evidence:** [reproducible stateful FPGA bundle](reports/cnc3-stateful-implementation-20261001/serial-admission-handoff-r01/receipt.json) and [nine actual serial-to-mechanics cases](reports/controller-plant-20261001/actual-spi-edge-plant-r03/receipt.json) use the same frozen RTL bytes. Twelve emitted STEP/DIR outputs and four actual quadrature algorithms are exercised with explicit ideal external power/permission fixtures. The 1,114-check isolated mechanics fixture also has twelve compiled negative controls. The one-command bench now includes separate fresh stateful and serial/mechanics stages; this is not a physical controller or a complete LinuxCNC/CNC3 machine.

**Latest verified increment — Source26/ROOT102:** two existing capacitor poses and six conductors complete two additional owned bypass loops; no electrical source, parts, pin nets or rating changed. Actual native and independent connectivity agree on **3,524 required joins remaining**, with zero orphan copper. Native regular DRC is **0 errors/0 warnings/no ignored checks**; ERC remains **0 errors/70 unsuppressed warnings**. [Full disconnected r06](reports/pre-hardware-validation-20261001/full-analog-plant-r06/report.json) passed **20 stages**, left **9 blocked** and **1 physical stage unrun**, with **0 failed stages**; **1,880 host cases and 235 native KiCad cases pass**, five Windows symlink cases remain skipped, and all **3,765 scoped source hashes** stayed unchanged. This supersedes r05 as the current exact-board run and freshly includes 96 passive filter cases, 12 manufacturer-buffer cases, and the isolated mechanics fixture with 1,114 checks and 12 compiled negative controls. The ROOT102 PCB and Source26 electrical design are unchanged. [Current adoption](reports/motherboard-return-zoning-20261001/ROOT101-two-same-side-bypass-restored-r06/adoption.json).

[Updated characterization](reports/pre-hardware-characterization-20261001/characterization-register-r03/requirements-and-coverage.json) retains all 15 subsystem, 22 fault and nine machine requirements. Twelve changing-speed/reversal pulse generators pass 43,200,324 edge/count checks; four ideal-input encoder components and actual CNC3 structural SPI/codec RTL pass their scoped sweeps. The real manufacturer OPA buffer model passes 12 simultaneous four-channel cases, alongside 96 passive filter cases and two numerical-sensitivity studies. **Complete stateful CNC3/HAL/machine integration and whole-circuit analog qualification remain open.** Failed full-chain amplifier convergence and the encrypted ADC model are recorded; ideal boundaries are not physical substitutes.

[Native drill/land screening](reports/motherboard-pcb-integration-20261001/two-cap-full-drill-SMD-audit-r01/receipt.json) identifies **275 existing drilled vias overlapping 279 same-net paste SMD lands**. This is a lower bound: exact tangency and assembly registration margins need further checking. Each location needs layout correction or an explicitly qualified filled/capped fabrication/assembly disposition; ordinary DRC and tenting do not close this work. No fabrication package or manufacturing readiness is claimed.

**Pre-hardware characterization and virtual bench (user, 1 October 2026):** before fabrication, characterize failure boundaries and component hard limits for STEP/encoder/SPI/servo/input/output/power/analog/watchdog/startup/thermal behavior, with voltage/temperature/tolerance corners and simultaneous full load. Build one disconnected command around actual CNC3/HAL and actual Verilated RTL, mechanical/ABZ/home/probe/fault models, nine machine profiles, electrical simulation and vendor fit/timing. Record DESIGN LIMIT, SIMULATED LIMIT, DATASHEET LIMIT and PHYSICAL VALIDATION REQUIRED separately; no simulation-only hardware ratings. This adds verification to the existing single-board work. [Exact 15-subsystem/22-fault coverage](reports/pre-hardware-characterization-20261001/characterization-register-r03/requirements-and-coverage.json); [provisional engineering datasheet](reports/pre-hardware-characterization-20261001/characterization-register-r03/provisional-datasheet.json). First actual twelve-generator sweep passes 144 cases and 7,077,888 edge/count comparisons, including exact DDS boundary checks; four copied-RTL mutation controls detect real faults. This is isolated pulse-generator evidence; complete CNC3/HAL/twelve-joint runtime, SPICE and Efinity remain unfinished. Exploratory 12/12-tick timing has effectively no margin at 2 MHz; production defaults/rate limits are unchanged.

**User motion target, 1 October 2026:** twelve simultaneously active STEP/DIR channels at up to 2 MHz/channel, per-channel STEP-high/low and DIR-setup/hold timing, polarity and drive-limited maximum rate, atomic twelve-channel updates in a deterministic 1 kHz LinuxCNC servo cycle, four ABZ inputs standard and qualified expansion toward twelve ABZ inputs while retaining all twelve motors. This is an unqualified target, not an implemented twelve-channel runtime or higher electrical rating. Existing CNC3 command/feedback lengths remain 96/176 bytes. Future eight additional ABZ channels require an explicit joint audit of actual spare FPGA resources, expansion-connector contacts, acquisition bandwidth/counters and feedback/validity capacity; any necessary future protocol revision remains unimplemented. Preserve current fixed frames and all existing motor/I/O allocations until that review. Details and acceptance gates: [motion target](docs/MOTION_EXPANSION_8_TO_12.md), [G23/G24](docs/CURRENT_ACCEPTANCE_GATES.md).

User decisions and preferences, reconciled 30 September 2026. Read with the build plan; a newer explicit user instruction takes precedence. This is workspace memory, not an account-wide memory service. The dated audit and current acceptance gates distinguish recorded decisions from implementation evidence.

- **Latest execution priority (user, 30 September 2026):** get the controller working and make it excellent, then reduce its complete cost against a validated implementation. Continue concrete engineering from the existing architecture and audit; do not restart the design or substitute more conversation for implementation. Keep mandatory motion/I/O, diagnostics, protection, offline setup and replaceable-module service intact. "Perfect" is a quality objective to verify with declared acceptance tests, not permission to claim unmeasured reliability or manufacturing readiness.

- **Live physical CAD view (published snapshot, 30 September 2026):** Published native CAD **20261001-28** now matches the adopted Source26/r102 board: **2,688 footprints, 11,641 track/via items, 1,521 native zones/rule areas and 3,524 independently counted missing joins**. Its board SHA-256 is `769541d11876ea0050240ec065f6b0b85bff19c7c8324f1c26b9b637212a8af5`; fresh publication DRC has zero regular errors/warnings and no ignored checks. The actual footprint libraries are packaged locally with 92 used-library land patterns checked; the true outline, rounded ESP antenna notch and actual compute-socket model are retained. The side-panel opening was queued by the app; visible navigation is not independently confirmed. The **460 × 340 mm, six-layer, 1.6 mm** outline/stackup remains provisional. [Current board review](hardware/board_review/README.md).

- **Current engineering execution following that priority (1 October 2026):** The adopted **source26 electrical design retains 2,688 physical footprints: 2,642 purchased fitted parts, 37 bare PCB test pads, one bare chassis bond pad, six bare M3 mounting holes and two DNP footprints**. All twelve motor interfaces, four ABZ receiving paths, 24 general DI, 16 smart DO at 0.5 A/channel and 2 A/four-channel-group, acquisition/control MCUs, power supervision, protected probe/pendant supplies, process and isolated analog I/O, RS-485/CAN, compute/ESP/storage sockets, display/USB/Ethernet interfaces, indicators and field terminals are represented in the actual source. Native ERC has **zero errors, 70 unsuppressed warnings and no ignored checks**; **301 focused source/native checks pass**. Source26 makes exactly two manufacturer-confirmed reference-capacitor identity corrections and three manufacturer-land fuse-footprint corrections without changing any electrical pin nets or population. The retained original 327-part/1,229-pin-net baseline remains checked. The actual FPGA package has **256 checked native pads, 135 assigned user functions, 48 free user resources and 14 correctly mapped IO3 bank-power pins**; vendor package fit/timing remains unproved. All 723 capacitor owners have exact source-pin/function provenance. Twelve fitted interfaces remain distinct from the historical six-active-axis/two-encoder runtime. The current **adopted working PCB r102**, separate from the published viewer, has **2,688 footprints, 9,498 fitted pads, 11,641 track/via items and 1,521 native zones/rule areas**. Its exact source and independent physical connectivity checks pass, with **632 fully joined and 1,102 incomplete multi-pad nets out of 1,734**, **3,524 uncapped missing joins**, agreement between native and independent SOURCE-connected cluster counts, and zero orphan copper. Native DRC reports **zero errors, zero warnings and no ignored checks**. Combined proof preserves **108 actual owned-bypass loops, 221 receiving-return endpoint checks and 54 physically SOURCE-anchored reference-bridge groups**. Nine literal ordinary SOURCE-pair routes are now complete and independently rechecked on the combined board. The bounded FPGA neck rule applies only to 38 reviewed signal nets inside the F-side BGA area: 0.15 mm short necks with a separate aggregate 1 mm/net limit; all other tracks retain the 0.20 mm minimum and power rules remain unchanged. Native healthy/negative rule controls pass. Contradictory PCBWay process tables leave exact 2 oz fine-line process confirmation outstanding; this rule is not production process qualification. Two additional literal local critical SOURCE-pair paths are independently complete on the combined board; this does not establish complete multi-endpoint clocks or loaded timing. The fresh regression passed 1,847 host cases and all 235 actual KiCad-native cases; only five Windows symlink cases remain skipped. All 2,813 scoped source hashes stayed unchanged. [Fresh regression](reports/board-completion-20261001/source26-root101-combined-validation.json). Fresh native ERC retains the same 70 unsuppressed warning semantics and zero errors; transient KiCad pin-object UUIDs were reconciled by exact source-pin identity. The complete AO1 DAC SDO path is now physically routed and independently checked with its exact four segments and 0.40 mm own-reference corridor. The reviewed retirement of one redundant AO1 same-domain zone retains its entire native outline in the keeper; exact disjoint LOGIC polygon composition preserves the prior ADC/reference cuts. All 188 actual filled reference resources are now physically SOURCE-anchored, with no synthetic exemptions. This resource-anchoring result does not establish every SMD local return loop, signal waveform or rail capacity. Separate C14804 adjacent-reference and C19042 circuit proofs also pass. The complete FPGA FLASH_MISO path now connects the actual U1001.N1 and U1002.2 endpoints through twelve F-side conductors, with no signal vias, a measured native path of 66.954 mm, the unchanged 0.40 mm own-reference corridor and twelve actual conductor-cut negatives. Loaded flash/configuration timing and the final manufacturing stackup remain unqualified. Seven additional literal ordinary SOURCE-pair routes now pass actual endpoint and individual conductor-cut checks through 65 added conductors. Their common In1 reference, source-owned transition stitches and unchanged IO3 preservation guard pass on the actual combined board after a separately reviewed local unused-tip cleanup. The composed power chain retains the original MISO power proof and all actual receiver contacts; it does not establish loaded rail capacity or whole-board timing. Four further ordinary Source-pair routes (DI6, DI7, DI9 and DI_SENSOR_G2_FAULT), 82 motor control segments, 20 health-supply continuity endpoints and the actual RAW supply transfers are checked on the combined board. The U11019 and U11025 receiving loops now pass; U11020/U11026 and the staged Source27 reset/slow-input circuit corrections remain unfinished. All 5,969 prior connected Source-pad groups are retained. These are scoped local proofs; global power and reference qualification remain incomplete. The 44 distinct floating substrate/thermal islands pass their independent physical checks. Routing is incomplete; these results do not establish complete power distribution, signal integrity or manufacturing readiness. Continue concrete routing and exact power/return-path reconciliation. The 20 ms physical fault-to-inhibit requirement, partial-power/reset/missing-module states, loaded target software, complete twelve-channel operation, FPGA fit/timing, thermal/EMC behavior and production assembly still need qualification. Native ERC, native DRC, host tests, target compilation, HDL simulation, synthesis and physical measurements remain separate evidence. Gerbers, drill files, final assembly CPL/drawings and the final manufacturer stackup are not released; `manufacturing_ready` remains false. [source](reports/motherboard-integration-20261001/source26-reference-fuse-adopted-r04/adoption.json); [board](reports/motherboard-return-zoning-20261001/ROOT101-two-same-side-bypass-restored-r06/adoption.json); [connectivity](reports/motherboard-return-zoning-20261001/ROOT101-two-same-side-bypass-restored-r06/independent-connectivity/review.json); [cost](reports/motherboard-cost-20260930/source-r26-2688-complete-cost-v11/README.md); [owners](reports/motherboard-bypass-owners-20261001/complete723-source26-r11/capacitor-owners.json); [routing](reports/motherboard-ordinary-routing-20261001/tooling-r03-annulus-freeze-r02/review.json).

- **Latest compute-bay decision (user, 30 September 2026):** The user-adopted CM4/CM5 dual-100-pin bay and actual three-bit DIP readout are now present in the native compute source. The selector does not route power or bypass permission. CM4/CM5 contact mappings have primary source checks; exact Linux images/pinmux, compatibility and thermal/loading still need target qualification. Automatic pre-power hardware ID and software profiles are not implemented. AUTO remains service-only until exact identity is verified; CB1/CB2 variants remain separately unqualified and machine use disabled. Connector shape alone does not establish electrical compatibility; no routine FPGA/ESP reflash is intended for a previously qualified exchange. See `docs/COMPUTE_CARRIER_STRATEGY.md` and actual `hardware/motherboard_compute/design.json`.

- **Latest compute selection and storage detail (user, 30 September 2026):** require automatic compute identification with a manual override among qualified compatible profiles; the cold-start selector proposal is in `docs/COMPUTE_MODULE_SELECTOR.md`. No universal safe pre-power ID path is established, so unsupported/ambiguous automatic selection must remain inhibited/service-only rather than guess. Prepare the matching Linux image/device tree/transport for each exact compute module; a selector must not require reflashing FPGA/ESP for an already supported exchange. Offer removable SD boot/recovery on qualified Lite variants, onboard eMMC on equipped modules and optional ordinary NVMe where the exact module exposes and boots its PCIe interface; keep the base usable without an SSD. RAM capacity is upgraded by selecting/replacing the compute SoM, not a DIMM or an Optane/NVMe drive. The protected microSD socket and power/signal-isolation circuitry are implemented in the current source; exact cards, boot images, provisioning and optional NVMe remain unqualified in `docs/BOOT_STORAGE_AND_PROVISIONING.md`; the supplied Optane listing and approximate drive-price leads are not selected exact procurement parts.

- **Latest status-indicator requirement (user, 30 September 2026):** ordinary RGB indicators labeled SYSTEM, COMPUTE, FPGA, ESP, MOTION, EXPANSION and NETWORK; single-color IN1â€“IN24, OUT1â€“OUT16 and M1â€“M12 ALM indicators; plus independent WDT fault indication. Hardware rail/reset/watchdog/permission faults should drive the relevant powered critical indicators red and suppress misleading healthy patterns independently of Linux/ESP application activity. Field indications report actual qualified input/alarm/output observations, with missing or stale paths identified as unavailable. `docs/STATUS_INDICATORS.md` defines the behavior; actual ordinary RGB/single-color indicators, drivers, isolated observations and independent hardware fault overrides are now in the electrical source. Firmware freshness/visual behavior, panel mechanics, full supply loading and physical qualification remain unproved. The shared CLI/UI diagnostics keep stable fault codes, validity and age.

- **Configurable field-I/O proposal (user, 30 September 2026):** investigate 12 V/24 V profiles, high-side/low-side output choices and 0.5/1/2 A channel options with exact power/protection/diagnostic qualification. This is a versioned extension proposal being developed, not permission to raise a circuit rating in software. Frozen IS-1 retains 0.5 A per channel and 2 A per group until a coordinated qualified revision replaces that contract. Preserve all 24 general DI, 16 general DO and individual motor enables/alarms while comparing complete implementations.

- **Latest physical architecture decision (user, 30 September 2026; resolves the pending conflict):** one active custom motherboard. Fit the FPGA, clock/configuration/supervision and all twelve motor-interface channels directly on that PCB, with individual enable and alarm on every motor, four standard ABZ encoders, 24 general DI, 16 smart general DO with qualified current/fault diagnostics, probes/frequency/PWM/process control, analog I/O, RS-485/CAN, power protection and watchdog/permission hardware. Use actual sockets for qualified CM4/CM5 compute modules and separately verified BTT CB2/CB1 alternatives, a replaceable purchased ESP32 board/module and qualified storage/settings media; optional standardized communication/accessory connections and future verified adapters do not justify recreating the thirteen-card custom rack. The passive fixed wiring base, separate removable FPGA/custom field cards, motor-9â€“12 MX4/XTB system and their rack/cage/interconnect costs are explicitly superseded physical requirements. This is an authorised physical consolidation of the current implementation, not a restart of LinuxCNC/FPGA/ESP engineering or a claim that the 327-part MC is complete. See `docs/MOTHERBOARD_IS2.md` and ADR-024. All twelve interfaces are part of the base motherboard target; there is no adopted eight-channel depopulation or paid unlock of fitted motors 9â€“12.

- **Current exact-MPN sourcing boundary:** The immutable **source26 2,688-footprint cost audit v11** separates 2,642 purchased fitted board parts from 44 bare PCB features, two DNPs and purchased modules/accessories. It prices **105 exact MPNs and leaves 185 unpriced: 720 purchased fitted pieces per board remain unpriced**. Known-priced consumed inventory per board at **1/10/100 controllers is US$1,091.51/$877.37/$796.51**. Catalogue purchase cash for those whole build quantities is **US$61,020.80/$67,419.50/$131,032.35**, including unused MOQ inventory; price, cash and stock coverage remain distinct. These are partial dated exact-MPN catalogue baskets, not complete manufactured-board/controller/kit prices or PCBWay quotations. Complete totals remain null. Compute/storage/AI/screen SKUs, other accessories, fabrication, assembly, programming/test and packaging remain separate unknowns. Independent verification checks 169 frozen files, 876 quantity rows and 13 adversarial controls. Earlier cost snapshots remain immutable history. [Current exact source cost](reports/motherboard-cost-20260930/source-r26-2688-complete-cost-v11/README.md).

- **Historical post-r0.4 host evidence (30 September 2026, 15:13:05â€“15:13:41 UTC):** `reports/board-completion-20260930/post-r04-host-validation/` records eight footprint-envelope tests and 16 MC integration tests passed, plus 869 full-suite cases (864 passed, five Windows symlink cases skipped). Both focused sets are included in that full suite, not additional cases. All 1,272 scoped source/research hashes remained unchanged during the disconnected run. This is host/source evidence only; it did not rerun native ERC/DRC, target firmware compilation, HDL simulation, vendor FPGA fit or physical measurements. The immutable r0.3 `final-host-validation/` snapshot remains 858 reported/853 passed/five skipped with 1,000 unchanged hashes; earlier 714-test and six/two results also remain historical snapshots.

- Historical affordability goal: a complete CNC controller with an included touchscreen at roughly a Mesa-board price. The later commercial clarification below supersedes a fixed bundled-price ceiling: US$400 is a preliminary controller-assembly reference, with complete packages separately priced. **Latest explicit screen requirement:** offer 7-, 10-, 12-, 14-, 18- and 21-inch classes, with room for more sizes. The 21.5-inch reference is one large-screen option, not the platform's fixed baseline. Smaller sizes are intentional product tiers. US$249 is an illustrative comparison, not an agreed final retail price/currency or one price for every tier.

- Use a shared responsive UI and controller platform across screen sizes, adapting layouts and physical touch usability. Keep screen size separate from compute/I/O capacity; cost and qualify each complete screen package, power/mounting and host combination. Preserve older 21.5-inch cost records as historical scenarios. See docs/DISPLAY_TIERS.md.

- Working architecture: local real-time Linux/LinuxCNC, FPGA motion timing/I/O and ESP32 supporting-equipment automation, monitoring, diagnostics and service/recovery. Keep the ordinary workstation outside the hard real-time loop. ESP is not an automatic hot motion replacement. CM5 is not mandatory. Current ESP firmware remains diagnostic-only; the broader role needs new circuits, protocol, firmware and qualification.

- Preserve the interface experience from the user's Octopus/MR-1 work. The exact source reference still needs confirmation before adapting that UI. Supported machine/plate/vise/stock imports should be guided and require little coding or CAD knowledge.

- Do extensive design, source, simulation, build, costing and review work before ordering. PCBWay turnkey is the intended board manufacturer once the design is ready. No purchase or supplier submission has been made.

- AI is an optional upgrade. An Ethernet-connected companion with separate compute/RAM/power is the first expansion proposal; keep its cost outside the base controller. Ordinary operation must remain usable without AI.

- **Explicit new user requirement:** hardware and firmware must be highly modifiable and optimizable, with documented editable design files and complete CLI support. Chat/AI should be able to discover capabilities and set up a supported machine through the same configuration interfaces as the UI. Do not rely on undocumented GUI clicks or hand-editing internal code.

- **Explicit new user experience requirement:** make wiring and first-use setup extremely simple: clear terminal labels, machine/drive profiles, generated wiring guidance, guided checks, actionable diagnostics and reversible configuration. Advanced controls remain available without overwhelming beginners.

- CLI/AI customization operates within actual electrical ratings, firmware capabilities and commissioning rules; a configuration change cannot increase a component's physical rating or authorize an unvalidated machine state.

- Current engineering recommendation in response to the fuse question: physical input fuse(s) plus coordinated electronic branch protection and fault telemetry. Exact components/ratings remain a design task, not a claimed completed protection circuit. Avoid charging each channel for redundant eFuses when its protected output driver already supplies the required protection.

- The user supplied a 200-feature platform roadmap, an expanded eight-motor/four-encoder proposal and a plasma-upgrade concept. Preserve all F001â€“F200 ideas in docs/FEATURE_CATALOG.md and research/feature-roadmap.json; these are proposals, not shipping capabilities. Delivery order and evidence gates are in docs/PLATFORM_ROADMAP.md.

- Historical expanded eight-motor/four-encoder and eight-plus-four-card studies: retain their resource, electrical and cost results as dated studies. The latest one-motherboard/all-twelve decision supersedes their physical topology. Keep six-joint/two-encoder baseline results separately identified; neither older study qualifies current twelve-motor power/pin/BOM/timing or complete runtime.

- **Historical 28 September motor requirement, physically superseded 30 September:** eight motors standard and a four-motor plug-in/factory-fitted path was the earlier target. The latest user decision fits all twelve interfaces on the one motherboard, retaining eight as a minimum usable capacity. Each motor still has differential STEP/DIR plus its own enable and alarm. Motor channels are not axes (a dual-motor gantry uses two). The historical 64-byte CNC1 frame and six/two endpoint cannot inherit expanded capacity; coordinated CNC3 gateware, driver, FPGA allocation, power and physical qualification remain unfinished.

- **Historical user decisions confirmed 28 September 2026 (physical rack/card boundaries superseded by the 30 September one-motherboard decision; retained electrical, fault, software, ownership and recovery requirements still apply)** (an advisor's recommendation that the user re-sent as their answer and then explicitly authorised): eight motors standard; motors 9-12 on a plug-in expansion module, with a twelve-motor version sold with that module factory-fitted; the FPGA on a replaceable motion card with its clock, configuration flash and supervisory circuitry, behind a fixed wiring base whose field terminals never move (pluggable terminal blocks may also be used where they help replace the base itself); individual enable and alarm preserved on every motor channel, with any unsupported drive behaviour listed as an explicit exception, and a global power interlock never counted as per-channel enable; all 24 general inputs and 16 general outputs preserved (serial transport to I/O cards allowed only with identity, sequence/freshness and CRC validation before outputs change); the 20 ms fault-to-inhibit watchdog requirement retained, not relaxed to about 72 ms to keep a drawn part; a US$400 cost target for the defined eight-motor package including the selected touchscreen and a $15 AI setup allowance, with the expansion costed separately and overruns reported rather than interfaces removed; Codex owns schematics, power/protection, connectors, PCB and hardware BOM, and Claude owns FPGA logic, the CNC1 protocol/driver and configuration-service integration, both working from one agreed interface specification; commit a baseline and then work on separate branches/worktrees with controlled merges. Acceptance test: replace every designated service module with power off, without soldering, disturbing individual machine wires, manually flashing firmware or losing machine configuration; recovery works offline, rejects incompatible hardware and never resumes motion automatically.

- **Product direction adopted 28 September 2026:** make this the controller that removes the three biggest headaches: setting up the machine, figuring out what failed, and getting it running again. Priority: (1) hardware-backed diagnostics (per-output overcurrent/short/thermal and, where the output stage supports it, load current and open-load; field-supply, module power-good and temperature monitoring; a local power-loss-tolerant fault-history ring; measured facts kept separate from AI diagnoses); (2) the complete validated motion/I/O path (reliable 1 kHz with the full exchange, completion target 700 us under defined worst-case load, all subsystems loaded together, no silent step-output interruption, 72-hour combined-load test plus fault injection, capacity reserved for the motor expansion and an encoder expansion at the same time); (3) setup and repair (a CAD-import route and a no-CAD parametric route, verified drive/sensor/spindle profiles generating wiring and configuration, AI proposes and a deterministic validator decides, AI never mandatory; target 8 of 10 first-time users to a verified low-speed jog within 15 minutes on a reference machine; the historical card-replacement target under 5 minutes (superseded for the motherboard; current commodity-module and grouped-harness board service need separately measured procedures and spare prices); 3D preview marks commanded versus measured position and warns only for modeled, registered components; full operation, diagnostics, recovery and module replacement without internet or AI credit). These are targets to design and test against, not claims about the current prototype.

- **Commercial model clarified 28 September 2026 (supersedes the US$400 all-inclusive target above):** US$400 is a preliminary reference price for the controller assembly itself, not a fixed ceiling for a complete touchscreen package. The controller is sold on its own, and packages are built around it with screens, power supplies, enclosures, harnesses and setup assistance. Keep the full I/O, hardware diagnostics, protection, offline operation and solder-free module replacement; compare complete implemented costs and recommend selling prices instead of removing required hardware to fit an assumed bundle. Show for each engineering choice the cost difference, the capability gained and the replacement-card cost, so the user can decide whether an improvement belongs in the standard controller or an optional module. Pricing flexibility buys better engineering where it matters, not unlimited spending. Diagnostics rule: every displayed measurement (for example an output's current) carries its validity and data age; a disconnected path or stale reading shows unavailable or stale, never a plausible zero; accuracy is tested across the declared load range. Output-driver selection compares the complete measurement path (acquisition, channel selection, isolation, firmware, testing), not the driver IC price, and ends in one exact orderable part number with reasons.

- **Commercial direction (user, 29 September 2026):** sell the controller, paid software licences, expansion modules and complete tested kits. Use proven off-the-shelf peripheral components that customers can also source elsewhere; publish tested compatibility information and never require customers to buy ordinary components from us. Kits sell convenience, integration and support; expansion modules sell additional capability. Do not describe our original software as freeware and do not promise an open-source release; documented, editable configuration and published interface specifications remain required. Preserve all applicable third-party licence obligations (for example LinuxCNC under GPL-2.0) and review the boundary between GPL components and our commercial application. Software licensing must work offline and must survive legitimate module replacement without repurchase; licensing must never block safety functions, stopping, diagnostics or configuration recovery.

- Modular plasma upgrades should keep the controller, screen, motor wiring and unaffected axis calibration. Bind separate module, harness and cutter/torch/process identities. First develop a divided-voltage interface with two future qualified source/harness configurations. Power-off replacement, setup/calibration invalidation and deliberate restart are required; saved calibration does not preserve verified position after power loss. See docs/PLASMA_MODULE_SYSTEM.md.

- Support third-party, replaceable USB/RS-485 adapters, Modbus RTU accessories and Modbus TCP equipment from the customer's chosen retailer. Do not require a proprietary VFD adapter for a supported native serial-control drive. Exact device profiles and qualification make setup simple; Modbus stays outside precision motion/feedback timing. See docs/THIRD_PARTY_MODBUS.md.

- The user highlighted inexpensive BTT modules and supplied estimated prices. CB2 is now an active compute candidate; CB1 remains a lower-memory comparison. User estimates and observed official retail listings differ and must stay distinct. Do not treat the broad supplied module table as a verified price or pin-compatibility list.

- Historical compute-carrier recommendation: prefer the dual-100-pin family for evaluation. The latest explicit physical-bay decision above now supersedes its provisional status; exact CM4/CM5/CB2/CB1 compatibility, selected SKUs and complete cost remain to verify. See docs/COMPUTE_CARRIER_STRATEGY.md and research/BTT_COMPUTE_REVIEW.md.

- Historical six/two integration priority: connect actual LinuxCNC through a compiled common CNC1 driver and replaceable transport to the existing six-step/two-encoder FPGA implementation; verify returned feedback, capabilities and fault/reconnect behavior before expansion. This baseline has separate evidence and does not supersede the current all-twelve motherboard/CNC3 milestone and versioned IS-2 integration above. Preserve the common disconnected configuration service/CLI for profiles, conflicts, wiring, validation, disarmed apply and backup/restore, and avoid making all 200 features prerequisites. See docs/INTEGRATION_MILESTONE.md and the archived integration-priority note (SHA-256 recorded in reports/platform-plan-review.json).

- Latest ESP direction: give it a real accessory role for qualified fans, coolant/air, lubrication, lights/extraction and direct condition monitoring. One owner per output; main controller requests, ESP executes a bounded approved sequence and reports measured readiness. Essential-service dependencies make ESP/sensor/link failure relevant to machining; define hold/inhibit/after-run and deliberate recovery per machine. No autonomous motion, torch, drawbar or toolchanger authority. See docs/ESP_ACCESSORY_AUTOMATION.md.

- Target industrial reliability through specified and tested whole-unit power, I/O, EMC, environment, software, manufacturing and service behavior; no current industrial/safety certification claim. Carry machined HDPE enclosure as a candidate with engineered shielding/bonding and material/mechanical review. Preserve independent machine safety functions and explicit gravity/workholding/cooling fault responses. A later five-to-ten-unit pilot is a proposal after qualification, not a purchase instruction. See docs/INDUSTRIAL_QUALIFICATION.md.

- **Current repairability scope:** power-off replacement of approved purchased compute, ESP and storage/settings modules; a failure of soldered motion/I/O/power circuitry is a whole-motherboard service exchange through keyed pluggable terminal/harness groups. Preserve individual conductor terminations, labels, saved machine configuration and offline entitlement, while explicitly accounting for the work to move terminal groups and verify a replacement board. This is different from fixed-base/custom-card service; no five-minute whole-board guarantee or unchanged machine-verification claim is adopted. The PCB's board identity, revision and region capabilities/factory calibration must replace fictitious removable-card presence/serial identities through a versioned contract. Actual module and accessory identities, data sequence/freshness/CRC, safe defaults and 20 ms watchdog/inhibit remain required. See docs/MODULAR_REPAIR_AND_MEMORY.md.

- Retain protected removable commodity storage/settings media carrying the machine-memory recovery payload containing the actual versioned configuration, mirrored to main storage and exportable offline. Keep machine settings separate from each module's own identity/factory calibration and from firmware/Linux images. Measure capacity before selecting EEPROM/flash; FRAM is a workload-dependent option. Two validated committed records must survive an interrupted save; conflicting identities or equally current different records must not be silently selected.

- Supported replacement modules should arrive programmed (or need no firmware), restore compatible assignments and guide only affected verification. First release replacement is power-off service; outputs remain inhibited, live position/homing and job authority are not restored, and stale requests cannot restart machining. Replacement measurement electronics bring their own factory calibration. Existing same-store backups remain distinct from a deliberate new-compute import bound to the correct machine. Offline recovery and affordable available spares are product requirements, not present procurement guarantees.

Implementation/evidence status belongs in reports/ENGINEERING_STATUS.md and reports/VALIDATION.md. Current quantitative acceptance is registered in docs/CURRENT_ACCEPTANCE_GATES.md. The 30 September audit is reports/audit-2026-09-30/AUDIT_REPORT.md; it found a physical reset-buffer pin-map error despite passing mirrored checks, a retained 20 ms watchdog violation and expanded power/integration gaps. This is audit evidence, not a new user design decision. Do not describe a proposed feature, passed model test, partial schematic or software simulation as a production-qualified controller.
