DeadlySIn777/Controller/reports/durable-hardware-python-tests.txt

test_all_corrupt_records_are_never_overwritten (test_configuration_recovery.ConfigurationRecoveryTests.test_all_corrupt_records_are_never_overwritten) ... ok
test_bool_generation_and_overflow_refused (test_configuration_recovery.ConfigurationRecoveryTests.test_bool_generation_and_overflow_refused) ... ok
test_bootstrap_uses_shared_apply_binds_machine_and_keeps_checks_pending (test_configuration_recovery.ConfigurationRecoveryTests.test_bootstrap_uses_shared_apply_binds_machine_and_keeps_checks_pending) ... ok
test_cartridge_or_inventory_change_invalidates_preview (test_configuration_recovery.ConfigurationRecoveryTests.test_cartridge_or_inventory_change_invalidates_preview) ... ok
test_corrupt_newest_falls_back (test_configuration_recovery.ConfigurationRecoveryTests.test_corrupt_newest_falls_back) ... ok
test_corrupt_or_foreign_binding_refused (test_configuration_recovery.ConfigurationRecoveryTests.test_corrupt_or_foreign_binding_refused) ... ok
test_duplicate_keys_and_oversize_records_are_not_accepted (test_configuration_recovery.ConfigurationRecoveryTests.test_duplicate_keys_and_oversize_records_are_not_accepted) ... ok
test_existing_config_without_reservation_is_never_overwritten (test_configuration_recovery.ConfigurationRecoveryTests.test_existing_config_without_reservation_is_never_overwritten) ... ok
test_failed_receipt_after_config_commit_can_finish_without_duplicate_revision (test_configuration_recovery.ConfigurationRecoveryTests.test_failed_receipt_after_config_commit_can_finish_without_duplicate_revision) ... ok
test_final_newline_is_required_so_final_byte_interruption_is_incomplete (test_configuration_recovery.ConfigurationRecoveryTests.test_final_newline_is_required_so_final_byte_interruption_is_incomplete) ... ok
test_fixture_metadata_cannot_mutate_authoritative_registry (test_configuration_recovery.ConfigurationRecoveryTests.test_fixture_metadata_cannot_mutate_authoritative_registry) ... ok
test_future_embedded_schema_is_not_downgraded (test_configuration_recovery.ConfigurationRecoveryTests.test_future_embedded_schema_is_not_downgraded) ... ok
test_imported_capabilities_and_permission_claims_rejected_even_when_sealed (test_configuration_recovery.ConfigurationRecoveryTests.test_imported_capabilities_and_permission_claims_rejected_even_when_sealed) ... ok
test_incompatible_voltage_abi_capacity_and_unknown_module_refused (test_configuration_recovery.ConfigurationRecoveryTests.test_incompatible_voltage_abi_capacity_and_unknown_module_refused) ... ok
test_interrupted_newest_save_keeps_previous_valid_configuration (test_configuration_recovery.ConfigurationRecoveryTests.test_interrupted_newest_save_keeps_previous_valid_configuration) ... ok
test_intervening_shared_service_edit_prevents_binding_finalization (test_configuration_recovery.ConfigurationRecoveryTests.test_intervening_shared_service_edit_prevents_binding_finalization) ... ok
test_inventory_rechecked_immediately_before_apply (test_configuration_recovery.ConfigurationRecoveryTests.test_inventory_rechecked_immediately_before_apply) ... ok
test_mixed_machine_records_and_wrong_expected_identity_refused (test_configuration_recovery.ConfigurationRecoveryTests.test_mixed_machine_records_and_wrong_expected_identity_refused) ... ok
test_module_replacement_cannot_silently_restore_older_machine_configuration (test_configuration_recovery.ConfigurationRecoveryTests.test_module_replacement_cannot_silently_restore_older_machine_configuration) ... ok
test_new_compute_has_new_store_identity_and_ordinary_foreign_backup_is_refused (test_configuration_recovery.ConfigurationRecoveryTests.test_new_compute_has_new_store_identity_and_ordinary_foreign_backup_is_refused) ... ok
test_outside_fixture_topology_refused (test_configuration_recovery.ConfigurationRecoveryTests.test_outside_fixture_topology_refused) ... ok
test_plan_mutation_and_invalid_api_inputs_are_refused (test_configuration_recovery.ConfigurationRecoveryTests.test_plan_mutation_and_invalid_api_inputs_are_refused) ... ok
test_preview_does_not_bind_or_write_store (test_configuration_recovery.ConfigurationRecoveryTests.test_preview_does_not_bind_or_write_store) ... ok
test_replacement_preserves_assignments_and_machine_scale_uses_new_module_calibration (test_configuration_recovery.ConfigurationRecoveryTests.test_replacement_preserves_assignments_and_machine_scale_uses_new_module_calibration) ... ok
test_replacement_refuses_older_newer_or_equal_generation_changed_cartridge (test_configuration_recovery.ConfigurationRecoveryTests.test_replacement_refuses_older_newer_or_equal_generation_changed_cartridge) ... ok
test_reservation_before_failed_config_write_can_retry (test_configuration_recovery.ConfigurationRecoveryTests.test_reservation_before_failed_config_write_can_retry) ... ok
test_reserved_retry_refuses_different_record_inventory_or_later_store_revision (test_configuration_recovery.ConfigurationRecoveryTests.test_reserved_retry_refuses_different_record_inventory_or_later_store_revision) ... ok
test_runtime_epoch_and_unsafe_state_refuse_recovery (test_configuration_recovery.ConfigurationRecoveryTests.test_runtime_epoch_and_unsafe_state_refuse_recovery) ... ok
test_size_cap_checked_before_write_and_stale_save_refused (test_configuration_recovery.ConfigurationRecoveryTests.test_size_cap_checked_before_write_and_stale_save_refused) ... ok
test_two_equal_generation_different_valid_records_refused (test_configuration_recovery.ConfigurationRecoveryTests.test_two_equal_generation_different_valid_records_refused) ... ok
test_two_records_are_self_contained_bounded_and_have_no_module_calibration (test_configuration_recovery.ConfigurationRecoveryTests.test_two_records_are_self_contained_bounded_and_have_no_module_calibration) ... ok
test_valid_future_schema_is_not_treated_as_torn_record (test_configuration_recovery.ConfigurationRecoveryTests.test_valid_future_schema_is_not_treated_as_torn_record) ... ok
test_armed_running_connected_and_physical_mutation_refused (test_configuration_service.ConfigurationServiceTests.test_armed_running_connected_and_physical_mutation_refused) ... ok
test_backups_restore_as_new_revision_and_keep_audit (test_configuration_service.ConfigurationServiceTests.test_backups_restore_as_new_revision_and_keep_audit) ... ok
test_bool_and_nonfinite_quantities_rejected (test_configuration_service.ConfigurationServiceTests.test_bool_and_nonfinite_quantities_rejected) ... ok
test_catalog_copies_do_not_change_authority (test_configuration_service.ConfigurationServiceTests.test_catalog_copies_do_not_change_authority) ... ok
test_changed_candidate_or_diff_refused (test_configuration_service.ConfigurationServiceTests.test_changed_candidate_or_diff_refused) ... ok
test_cli_full_flow_and_structured_error (test_configuration_service.ConfigurationServiceTests.test_cli_full_flow_and_structured_error) ... ok
test_commands_and_commissioning_cannot_be_imported (test_configuration_service.ConfigurationServiceTests.test_commands_and_commissioning_cannot_be_imported) ... ok
test_corrupt_backup_and_foreign_backup_rejected (test_configuration_service.ConfigurationServiceTests.test_corrupt_backup_and_foreign_backup_rejected) ... ok
test_duplicate_device_and_connection_rejected (test_configuration_service.ConfigurationServiceTests.test_duplicate_device_and_connection_rejected) ... ok
test_duplicate_json_keys_and_nonfinite_json_rejected (test_configuration_service.ConfigurationServiceTests.test_duplicate_json_keys_and_nonfinite_json_rejected) ... ok
test_failed_atomic_replace_leaves_old_state_and_no_temp (test_configuration_service.ConfigurationServiceTests.test_failed_atomic_replace_leaves_old_state_and_no_temp) ... ok
test_import_cannot_raise_capabilities (test_configuration_service.ConfigurationServiceTests.test_import_cannot_raise_capabilities) ... ok
test_init_and_export_preserve_existing_files (test_configuration_service.ConfigurationServiceTests.test_init_and_export_preserve_existing_files) ... ok
test_latched_pending_checks_and_readiness (test_configuration_service.ConfigurationServiceTests.test_latched_pending_checks_and_readiness) ... ok
test_malformed_direct_api_inputs_have_structured_errors (test_configuration_service.ConfigurationServiceTests.test_malformed_direct_api_inputs_have_structured_errors) ... ok
test_malformed_runtime_boolean_refused (test_configuration_service.ConfigurationServiceTests.test_malformed_runtime_boolean_refused) ... ok
test_negative_and_wrong_unit_rejected (test_configuration_service.ConfigurationServiceTests.test_negative_and_wrong_unit_rejected) ... ok
test_noop_preview_does_not_create_revision (test_configuration_service.ConfigurationServiceTests.test_noop_preview_does_not_create_revision) ... ok
test_physical_identity_and_firmware_mismatch_rejected (test_configuration_service.ConfigurationServiceTests.test_physical_identity_and_firmware_mismatch_rejected) ... ok
test_profile_device_consistency (test_configuration_service.ConfigurationServiceTests.test_profile_device_consistency) ... ok
test_rating_voltage_rate_and_current_rejected (test_configuration_service.ConfigurationServiceTests.test_rating_voltage_rate_and_current_rejected) ... ok
test_rechecks_schema_even_with_recomputed_backup_hash (test_configuration_service.ConfigurationServiceTests.test_rechecks_schema_even_with_recomputed_backup_hash) ... ok
test_resource_collision_rejected (test_configuration_service.ConfigurationServiceTests.test_resource_collision_rejected) ... ok
test_restore_while_armed_and_stale_restore_refused (test_configuration_service.ConfigurationServiceTests.test_restore_while_armed_and_stale_restore_refused) ... ok
test_shared_api_select_validate_wire_preview_apply_reopen (test_configuration_service.ConfigurationServiceTests.test_shared_api_select_validate_wire_preview_apply_reopen) ... ok
test_signal_type_rejected (test_configuration_service.ConfigurationServiceTests.test_signal_type_rejected) ... ok
test_stale_apply_and_replay_refused (test_configuration_service.ConfigurationServiceTests.test_stale_apply_and_replay_refused) ... ok
test_state_epoch_invalidates_plan (test_configuration_service.ConfigurationServiceTests.test_state_epoch_invalidates_plan) ... ok
test_state_rechecked_immediately_before_persist (test_configuration_service.ConfigurationServiceTests.test_state_rechecked_immediately_before_persist) ... ok
test_store_corruption_and_busy_fail_closed (test_configuration_service.ConfigurationServiceTests.test_store_corruption_and_busy_fail_closed) ... ok
test_unknown_key_and_version_rejected (test_configuration_service.ConfigurationServiceTests.test_unknown_key_and_version_rejected) ... ok
test_unknown_resource_rejected (test_configuration_service.ConfigurationServiceTests.test_unknown_resource_rejected) ... ok
test_accidental24v_on_logic_supply_rejected (test_hardware_validation.ElectricalLedgerTests.test_accidental24v_on_logic_supply_rejected) ... ok
test_actual_kicad_export_matches_pin_contract (test_hardware_validation.ElectricalLedgerTests.test_actual_kicad_export_matches_pin_contract) ... ok
test_consistent_proposal_is_never_release_ready (test_hardware_validation.ElectricalLedgerTests.test_consistent_proposal_is_never_release_ready) ... ok
test_direct_wire_across_isolation_domain_rejected (test_hardware_validation.ElectricalLedgerTests.test_direct_wire_across_isolation_domain_rejected) ... ok
test_duplicate_bga_ball_is_rejected_even_when_rest_unassigned (test_hardware_validation.ElectricalLedgerTests.test_duplicate_bga_ball_is_rejected_even_when_rest_unassigned) ... ok
test_enable_cannot_default_on (test_hardware_validation.ElectricalLedgerTests.test_enable_cannot_default_on) ... ok
test_esp_cannot_be_added_to_permission_path (test_hardware_validation.ElectricalLedgerTests.test_esp_cannot_be_added_to_permission_path) ... ok
test_excess_load_detected_by_channel_bank_and_rail (test_hardware_validation.ElectricalLedgerTests.test_excess_load_detected_by_channel_bank_and_rail) ... ok
test_input_conversion_power_reservation_checked (test_hardware_validation.ElectricalLedgerTests.test_input_conversion_power_reservation_checked) ... ok
test_isolation_ground_alias_rejected (test_hardware_validation.ElectricalLedgerTests.test_isolation_ground_alias_rejected) ... ok
test_logic_high_voltage_and_noise_margin_checked (test_hardware_validation.ElectricalLedgerTests.test_logic_high_voltage_and_noise_margin_checked) ... ok
test_missing_decoupling_cannot_pass_as_complete_parts_ledger (test_hardware_validation.ElectricalLedgerTests.test_missing_decoupling_cannot_pass_as_complete_parts_ledger) ... ok
test_missing_driver_detected_without_crashing_validator (test_hardware_validation.ElectricalLedgerTests.test_missing_driver_detected_without_crashing_validator) ... ok
test_physical_connector_contact_collision_rejected (test_hardware_validation.ElectricalLedgerTests.test_physical_connector_contact_collision_rejected) ... ok
test_secondary_isolator_power_must_also_be_checked (test_hardware_validation.ElectricalLedgerTests.test_secondary_isolator_power_must_also_be_checked) ... ok
test_two_logical_signals_cannot_share_one_driver (test_hardware_validation.ElectricalLedgerTests.test_two_logical_signals_cannot_share_one_driver) ... ok
test_abort_can_be_requested_when_status_age_is_stale (test_linuxcnc_backend.LinuxCNCBackendTests.test_abort_can_be_requested_when_status_age_is_stale) ... ok
test_configuration_rejects_invalid_freshness (test_linuxcnc_backend.LinuxCNCBackendTests.test_configuration_rejects_invalid_freshness) ... ok
test_connect_is_read_only (test_linuxcnc_backend.LinuxCNCBackendTests.test_connect_is_read_only) ... ok
test_constructor_does_not_connect_or_import (test_linuxcnc_backend.LinuxCNCBackendTests.test_constructor_does_not_connect_or_import) ... ok
test_error_arriving_at_command_precheck_blocks_motion (test_linuxcnc_backend.LinuxCNCBackendTests.test_error_arriving_at_command_precheck_blocks_motion) ... ok
test_error_channel_is_read_and_exposed (test_linuxcnc_backend.LinuxCNCBackendTests.test_error_channel_is_read_and_exposed) ... ok
test_expired_request_is_consumed_without_api_command (test_linuxcnc_backend.LinuxCNCBackendTests.test_expired_request_is_consumed_without_api_command) ... ok
test_expiry_during_mode_change_cannot_send_mdi (test_linuxcnc_backend.LinuxCNCBackendTests.test_expiry_during_mode_change_cannot_send_mdi) ... ok
test_expiry_during_status_refresh_sends_nothing (test_linuxcnc_backend.LinuxCNCBackendTests.test_expiry_during_status_refresh_sends_nothing) ... ok
test_foreign_profile_rejected_before_command_channel (test_linuxcnc_backend.LinuxCNCBackendTests.test_foreign_profile_rejected_before_command_channel) ... ok
test_live_hardware_mode_is_not_implemented (test_linuxcnc_backend.LinuxCNCBackendTests.test_live_hardware_mode_is_not_implemented) ... ok
test_mdi_calls_real_api_shape (test_linuxcnc_backend.LinuxCNCBackendTests.test_mdi_calls_real_api_shape) ... ok
test_mdi_rejects_multiline (test_linuxcnc_backend.LinuxCNCBackendTests.test_mdi_rejects_multiline) ... ok
test_mdi_requires_homing (test_linuxcnc_backend.LinuxCNCBackendTests.test_mdi_requires_homing) ... ok
test_modified_request_cannot_execute (test_linuxcnc_backend.LinuxCNCBackendTests.test_modified_request_cannot_execute) ... ok
test_nonfinite_velocity_discards_authority (test_linuxcnc_backend.LinuxCNCBackendTests.test_nonfinite_velocity_discards_authority) ... ok
test_preexisting_error_blocks_motion_even_after_error_channel_consumed (test_linuxcnc_backend.LinuxCNCBackendTests.test_preexisting_error_blocks_motion_even_after_error_channel_consumed) ... ok
test_program_cannot_escape_profile (test_linuxcnc_backend.LinuxCNCBackendTests.test_program_cannot_escape_profile) ... ok
test_program_digest_must_match (test_linuxcnc_backend.LinuxCNCBackendTests.test_program_digest_must_match) ... ok
test_reconnect_does_not_resume_program (test_linuxcnc_backend.LinuxCNCBackendTests.test_reconnect_does_not_resume_program) ... ok
test_reconnect_invalidates_requests (test_linuxcnc_backend.LinuxCNCBackendTests.test_reconnect_invalidates_requests) ... ok
test_reordered_request_cannot_execute (test_linuxcnc_backend.LinuxCNCBackendTests.test_reordered_request_cannot_execute) ... ok
test_resume_requires_reported_pause (test_linuxcnc_backend.LinuxCNCBackendTests.test_resume_requires_reported_pause) ... ok
test_run_is_asynchronous_to_keep_hold_and_abort_available (test_linuxcnc_backend.LinuxCNCBackendTests.test_run_is_asynchronous_to_keep_hold_and_abort_available) ... ok
test_run_pause_resume_are_explicit (test_linuxcnc_backend.LinuxCNCBackendTests.test_run_pause_resume_are_explicit) ... ok
test_stale_status_rejects_fresh_request (test_linuxcnc_backend.LinuxCNCBackendTests.test_stale_status_rejects_fresh_request) ... ok
test_state_rejection_cannot_be_replayed_when_ready (test_linuxcnc_backend.LinuxCNCBackendTests.test_state_rejection_cannot_be_replayed_when_ready) ... ok
test_status_failure_drops_authority (test_linuxcnc_backend.LinuxCNCBackendTests.test_status_failure_drops_authority) ... ok
test_timeout_drops_authority_and_never_retries (test_linuxcnc_backend.LinuxCNCBackendTests.test_timeout_drops_authority_and_never_retries) ... ok
test_uninitialized_status_rejected (test_linuxcnc_backend.LinuxCNCBackendTests.test_uninitialized_status_rejected) ... ok
test_activation_and_release_receive_original_deadline (test_persistent_runtime.PersistentRuntimeTests.test_activation_and_release_receive_original_deadline) ... ok
test_apply_interruption_each_phase_reconciles (test_persistent_runtime.PersistentRuntimeTests.test_apply_interruption_each_phase_reconciles) ... ok
test_changed_durable_readback_cannot_release (test_persistent_runtime.PersistentRuntimeTests.test_changed_durable_readback_cannot_release) ... ok
test_cli_versioned_success_and_structured_failures (test_persistent_runtime.PersistentRuntimeTests.test_cli_versioned_success_and_structured_failures) ... ok
test_corrupt_journal_remains_inhibited (test_persistent_runtime.PersistentRuntimeTests.test_corrupt_journal_remains_inhibited) ... ok
test_directory_fsync_failure_keeps_pending_inhibit (test_persistent_runtime.PersistentRuntimeTests.test_directory_fsync_failure_keeps_pending_inhibit) ... ok
test_durable_change_and_reversal_advance_generation (test_persistent_runtime.PersistentRuntimeTests.test_durable_change_and_reversal_advance_generation) ... ok
test_epoch_change_during_final_disk_read_keeps_inhibit (test_persistent_runtime.PersistentRuntimeTests.test_epoch_change_during_final_disk_read_keeps_inhibit) ... ok
test_epoch_change_during_fsync_refused (test_persistent_runtime.PersistentRuntimeTests.test_epoch_change_during_fsync_refused) ... ok
test_expiry_during_final_disk_read_keeps_inhibit (test_persistent_runtime.PersistentRuntimeTests.test_expiry_during_final_disk_read_keeps_inhibit) ... ok
test_expiry_during_journal_write_retains_pending_inhibit (test_persistent_runtime.PersistentRuntimeTests.test_expiry_during_journal_write_retains_pending_inhibit) ... ok
test_exponent_overflow_corrupt_record_returns_structured_error (test_persistent_runtime.PersistentRuntimeTests.test_exponent_overflow_corrupt_record_returns_structured_error) ... ok
test_foreign_machine_profile_caps_refused (test_persistent_runtime.PersistentRuntimeTests.test_foreign_machine_profile_caps_refused) ... ok
test_init_cannot_overwrite (test_persistent_runtime.PersistentRuntimeTests.test_init_cannot_overwrite) ... ok
test_init_interruption_each_phase_reconciles (test_persistent_runtime.PersistentRuntimeTests.test_init_interruption_each_phase_reconciles) ... ok
test_interrupted_same_instance_recovers_after_gate_ack (test_persistent_runtime.PersistentRuntimeTests.test_interrupted_same_instance_recovers_after_gate_ack) ... ok
test_live_generation_prevents_rollback_even_both_files_old (test_persistent_runtime.PersistentRuntimeTests.test_live_generation_prevents_rollback_even_both_files_old) ... ok
test_machine_enable_during_fsync_refused (test_persistent_runtime.PersistentRuntimeTests.test_machine_enable_during_fsync_refused) ... ok
test_missing_witness_for_committed_authority_refused (test_persistent_runtime.PersistentRuntimeTests.test_missing_witness_for_committed_authority_refused) ... ok
test_modified_caller_plan_cannot_change_commit (test_persistent_runtime.PersistentRuntimeTests.test_modified_caller_plan_cannot_change_commit) ... ok
test_new_directory_chain_syncs_parent_names_before_file_commit (test_persistent_runtime.PersistentRuntimeTests.test_new_directory_chain_syncs_parent_names_before_file_commit) ... ok
test_new_machine_init_is_explicit_and_unhomed (test_persistent_runtime.PersistentRuntimeTests.test_new_machine_init_is_explicit_and_unhomed) ... ok
test_public_volatile_apply_and_recovery_cannot_bypass (test_persistent_runtime.PersistentRuntimeTests.test_public_volatile_apply_and_recovery_cannot_bypass) ... ok
test_same_generation_different_record_hash_conflicts (test_persistent_runtime.PersistentRuntimeTests.test_same_generation_different_record_hash_conflicts) ... ok
test_separate_instance_reconciles_saved_scale (test_persistent_runtime.PersistentRuntimeTests.test_separate_instance_reconciles_saved_scale) ... ok
test_stale_preview_cannot_replace_new_generation (test_persistent_runtime.PersistentRuntimeTests.test_stale_preview_cannot_replace_new_generation) ... ok
test_valid_older_authority_conflicts_with_witness (test_persistent_runtime.PersistentRuntimeTests.test_valid_older_authority_conflicts_with_witness) ... ok
test_bootstrap_and_replace_preserve_assignments_and_own_module_metadata (test_recovery_cli.RecoveryCliTests.test_bootstrap_and_replace_preserve_assignments_and_own_module_metadata) ... ok
test_changed_cartridge_or_store_invalidates_preview (test_recovery_cli.RecoveryCliTests.test_changed_cartridge_or_store_invalidates_preview) ... ok
test_changed_inventory_and_mutated_plan_are_rejected_at_apply (test_recovery_cli.RecoveryCliTests.test_changed_inventory_and_mutated_plan_are_rejected_at_apply) ... ok
test_existing_export_files_are_preserved (test_recovery_cli.RecoveryCliTests.test_existing_export_files_are_preserved) ... ok
test_inspect_has_no_import_or_creation_side_effects (test_recovery_cli.RecoveryCliTests.test_inspect_has_no_import_or_creation_side_effects) ... ok
test_invalid_arguments_and_documents_produce_structured_errors (test_recovery_cli.RecoveryCliTests.test_invalid_arguments_and_documents_produce_structured_errors) ... ok
test_inventory_is_authored_not_imported_electrical_authority (test_recovery_cli.RecoveryCliTests.test_inventory_is_authored_not_imported_electrical_authority) ... ok
test_ordinary_backups_remain_store_bound (test_recovery_cli.RecoveryCliTests.test_ordinary_backups_remain_store_bound) ... ok
test_save_uses_generation_and_machine_identity_without_overwriting_sources (test_recovery_cli.RecoveryCliTests.test_save_uses_generation_and_machine_identity_without_overwriting_sources) ... ok
test_wrong_machine_and_other_compute_store_cannot_apply_plan (test_recovery_cli.RecoveryCliTests.test_wrong_machine_and_other_compute_store_cannot_apply_plan) ... ok
test_bad_hash_rejected (test_release.ReleaseTests.test_bad_hash_rejected) ... ok
test_complete_manifest_is_consistent (test_release.ReleaseTests.test_complete_manifest_is_consistent) ... ok
test_deleted_required_entry_cannot_bypass (test_release.ReleaseTests.test_deleted_required_entry_cannot_bypass) ... ok
test_duplicate_rejected (test_release.ReleaseTests.test_duplicate_rejected) ... ok
test_empty_file_even_with_matching_hash_rejected (test_release.ReleaseTests.test_empty_file_even_with_matching_hash_rejected) ... ok
test_malformed_manifest (test_release.ReleaseTests.test_malformed_manifest) ... ok
test_missing_or_escaping_path_rejected (test_release.ReleaseTests.test_missing_or_escaping_path_rejected) ... ok
test_modified_evidence_rejected (test_release.ReleaseTests.test_modified_evidence_rejected) ... ok
test_production_requires_additional_evidence (test_release.ReleaseTests.test_production_requires_additional_evidence) ... ok
test_prototype_does_not_require_prior_production_test (test_release.ReleaseTests.test_prototype_does_not_require_prior_production_test) ... ok
test_prototype_requires_programming_and_fabrication_package (test_release.ReleaseTests.test_prototype_requires_programming_and_fabrication_package) ... ok
test_shared_evidence_file_rejected (test_release.ReleaseTests.test_shared_evidence_file_rejected) ... ok
test_status_draft_rejected (test_release.ReleaseTests.test_status_draft_rejected) ... ok
test_unreviewed_rejected (test_release.ReleaseTests.test_unreviewed_rejected) ... ok
test_wrong_revision_rejected (test_release.ReleaseTests.test_wrong_revision_rejected) ... ok
test_already_decoded_counts_are_not_quadrupled (test_requirements_analysis.EncoderTests.test_already_decoded_counts_are_not_quadrupled) ... ok
test_quadrature_lines_counts_and_index_are_distinct (test_requirements_analysis.EncoderTests.test_quadrature_lines_counts_and_index_are_distinct) ... ok
test_single_channel_pulses_are_not_quadrupled (test_requirements_analysis.EncoderTests.test_single_channel_pulses_are_not_quadrupled) ... ok
test_encoder_shaft_changes_rate_with_gearing (test_requirements_analysis.JointDemandTests.test_encoder_shaft_changes_rate_with_gearing) ... ok
test_linear_gearing_known_example (test_requirements_analysis.JointDemandTests.test_linear_gearing_known_example) ... ok
test_rotary_ratio_is_motor_revolutions_per_output_revolution (test_requirements_analysis.JointDemandTests.test_rotary_ratio_is_motor_revolutions_per_output_revolution) ... ok
test_width_boundary_is_inclusive_and_excess_is_detected (test_requirements_analysis.JointDemandTests.test_width_boundary_is_inclusive_and_excess_is_detected) ... ok
test_zero_speed_has_no_finite_pulse_period (test_requirements_analysis.JointDemandTests.test_zero_speed_has_no_finite_pulse_period) ... ok
test_full_duplex_is_not_erroneously_added_for_utilization (test_requirements_analysis.NetworkTests.test_full_duplex_is_not_erroneously_added_for_utilization) ... ok
test_known_packet_slot_and_bandwidth (test_requirements_analysis.NetworkTests.test_known_packet_slot_and_bandwidth) ... ok
test_minimum_frame_padding (test_requirements_analysis.NetworkTests.test_minimum_frame_padding) ... ok
test_packet_mtu_exact_boundary_and_one_byte_over (test_requirements_analysis.NetworkTests.test_packet_mtu_exact_boundary_and_one_byte_over) ... ok
test_idealized_known_example (test_requirements_analysis.StoppingTests.test_idealized_known_example) ... ok
test_zero_speed_and_zero_reaction_are_valid (test_requirements_analysis.StoppingTests.test_zero_speed_and_zero_reaction_are_valid) ... ok
test_aggregate_rate_differs_from_single_joint_rate (test_requirements_analysis.StudyAndValidationTests.test_aggregate_rate_differs_from_single_joint_rate) ... ok
test_cli_invalid_json_and_duplicate_keys_return_input_error (test_requirements_analysis.StudyAndValidationTests.test_cli_invalid_json_and_duplicate_keys_return_input_error) ... ok
test_cli_report_and_nonzero_limit_mode (test_requirements_analysis.StudyAndValidationTests.test_cli_report_and_nonzero_limit_mode) ... ok
test_duplicate_joint_names_are_errors (test_requirements_analysis.StudyAndValidationTests.test_duplicate_joint_names_are_errors) ... ok
test_encoder_ambiguity_and_fractional_resolution_are_rejected (test_requirements_analysis.StudyAndValidationTests.test_encoder_ambiguity_and_fractional_resolution_are_rejected) ... ok
test_positive_inputs_reject_zero_negative_nonfinite_boolean_and_string (test_requirements_analysis.StudyAndValidationTests.test_positive_inputs_reject_zero_negative_nonfinite_boolean_and_string) ... ok
test_units_cannot_silently_change (test_requirements_analysis.StudyAndValidationTests.test_units_cannot_silently_change) ... ok
test_unknown_fields_are_errors (test_requirements_analysis.StudyAndValidationTests.test_unknown_fields_are_errors) ... ok
test_zero_network_period_and_stopping_deceleration_are_rejected (test_requirements_analysis.StudyAndValidationTests.test_zero_network_period_and_stopping_deceleration_are_rejected) ... ok
test_actual_dds_rate_checked (test_runtime_configuration.RuntimeConfigurationTests.test_actual_dds_rate_checked) ... ok
test_adapter_slow_staging_does_not_publish_expired_request (test_runtime_configuration.RuntimeConfigurationTests.test_adapter_slow_staging_does_not_publish_expired_request) ... ok
test_apply_acquires_unhomes_commits_releases (test_runtime_configuration.RuntimeConfigurationTests.test_apply_acquires_unhomes_commits_releases) ... ok
test_callers_plan_mutation_cannot_change_inflight_commit_or_diff (test_runtime_configuration.RuntimeConfigurationTests.test_callers_plan_mutation_cannot_change_inflight_commit_or_diff) ... ok
test_changed_capability_invalidates_preview (test_runtime_configuration.RuntimeConfigurationTests.test_changed_capability_invalidates_preview) ... ok
test_cli_versioned_success_and_structured_failures (test_runtime_configuration.RuntimeConfigurationTests.test_cli_versioned_success_and_structured_failures) ... ok
test_compiled_guard_rejection_propagates (test_runtime_configuration.RuntimeConfigurationTests.test_compiled_guard_rejection_propagates) ... ok
test_enable_after_preview_rejected_without_write (test_runtime_configuration.RuntimeConfigurationTests.test_enable_after_preview_rejected_without_write) ... ok
test_enabled_running_or_untrusted_snapshot_rejected (test_runtime_configuration.RuntimeConfigurationTests.test_enabled_running_or_untrusted_snapshot_rejected) ... ok
test_expired_plan_rejected (test_runtime_configuration.RuntimeConfigurationTests.test_expired_plan_rejected) ... ok
test_explicit_inhibit_recovery_never_enables (test_runtime_configuration.RuntimeConfigurationTests.test_explicit_inhibit_recovery_never_enables) ... ok
test_future_deadline_rejected (test_runtime_configuration.RuntimeConfigurationTests.test_future_deadline_rejected) ... ok
test_modified_diff_rejected (test_runtime_configuration.RuntimeConfigurationTests.test_modified_diff_rejected) ... ok
test_new_driver_instance_invalidates_preview (test_runtime_configuration.RuntimeConfigurationTests.test_new_driver_instance_invalidates_preview) ... ok
test_noop_rejected (test_runtime_configuration.RuntimeConfigurationTests.test_noop_rejected) ... ok
test_numerical_limits_rejected (test_runtime_configuration.RuntimeConfigurationTests.test_numerical_limits_rejected) ... ok
test_preview_is_diff_without_mutation (test_runtime_configuration.RuntimeConfigurationTests.test_preview_is_diff_without_mutation) ... ok
test_recovery_requires_acquired_stopped_runtime (test_runtime_configuration.RuntimeConfigurationTests.test_recovery_requires_acquired_stopped_runtime) ... ok
test_replay_rejected (test_runtime_configuration.RuntimeConfigurationTests.test_replay_rejected) ... ok
test_reverse_change_uses_new_preview (test_runtime_configuration.RuntimeConfigurationTests.test_reverse_change_uses_new_preview) ... ok
test_runtime_transition_between_acquire_commit_leaves_inhibit (test_runtime_configuration.RuntimeConfigurationTests.test_runtime_transition_between_acquire_commit_leaves_inhibit) ... ok
test_stale_binding_rejected (test_runtime_configuration.RuntimeConfigurationTests.test_stale_binding_rejected) ... ok
test_unhome_failure_leaves_compiled_inhibit (test_runtime_configuration.RuntimeConfigurationTests.test_unhome_failure_leaves_compiled_inhibit) ... ok
test_unmapped_hardware_channel_not_fake_joint (test_runtime_configuration.RuntimeConfigurationTests.test_unmapped_hardware_channel_not_fake_joint) ... ok
test_unsupported_plan_key_rejected (test_runtime_configuration.RuntimeConfigurationTests.test_unsupported_plan_key_rejected) ... ok
test_wrong_channel_count_rejected (test_runtime_configuration.RuntimeConfigurationTests.test_wrong_channel_count_rejected) ... ok
test_actual_export_matches_both_encoder_ports_and_ledger (test_rx_abz.EncoderReceiverTests.test_actual_export_matches_both_encoder_ports_and_ledger) ... ok
test_common_mode_cannot_become_a_fourteen_volt_differential_rating (test_rx_abz.EncoderReceiverTests.test_common_mode_cannot_become_a_fourteen_volt_differential_rating) ... ok
test_cross_chip_encoder_output_swap_is_rejected (test_rx_abz.EncoderReceiverTests.test_cross_chip_encoder_output_swap_is_rejected) ... ok
test_differential_polarity_swap_is_rejected (test_rx_abz.EncoderReceiverTests.test_differential_polarity_swap_is_rejected) ... ok
test_enable_and_unused_inputs_cannot_float (test_rx_abz.EncoderReceiverTests.test_enable_and_unused_inputs_cannot_float) ... ok
test_missing_supply_bypass_is_rejected (test_rx_abz.EncoderReceiverTests.test_missing_supply_bypass_is_rejected) ... ok
test_protected_encoder_supplies_and_references_stay_separate (test_rx_abz.EncoderReceiverTests.test_protected_encoder_supplies_and_references_stay_separate) ... ok
test_termination_cannot_be_shorted_underpowered_or_silently_dnp (test_rx_abz.EncoderReceiverTests.test_termination_cannot_be_shorted_underpowered_or_silently_dnp) ... ok
test_thermal_claim_or_arithmetic_change_is_rejected (test_rx_abz.EncoderReceiverTests.test_thermal_claim_or_arithmetic_change_is_rejected) ... ok
test_unused_outputs_require_explicit_no_connect (test_rx_abz.EncoderReceiverTests.test_unused_outputs_require_explicit_no_connect) ... ok
test_changed_geometry_bytes_invalidate_registration (test_scene_manifest.RegistrationTests.test_changed_geometry_bytes_invalidate_registration) ... ok
test_digest_declaration_alone_is_not_geometry_verification (test_scene_manifest.RegistrationTests.test_digest_declaration_alone_is_not_geometry_verification) ... ok
test_explicit_visual_only_is_never_implicitly_promoted (test_scene_manifest.RegistrationTests.test_explicit_visual_only_is_never_implicitly_promoted) ... ok
test_matching_external_record_registers_metadata_without_authorizing_motion (test_scene_manifest.RegistrationTests.test_matching_external_record_registers_metadata_without_authorizing_motion) ... ok
test_parent_placement_role_and_units_changes_invalidate_binding (test_scene_manifest.RegistrationTests.test_parent_placement_role_and_units_changes_invalidate_binding) ... ok
test_profile_id_version_and_digest_must_match_external_active_profile (test_scene_manifest.RegistrationTests.test_profile_id_version_and_digest_must_match_external_active_profile) ... ok
test_raw_cad_with_digest_and_profile_stays_visual_without_commissioning (test_scene_manifest.RegistrationTests.test_raw_cad_with_digest_and_profile_stays_visual_without_commissioning) ... ok
test_cli_reports_valid_uncommissioned_draft (test_scene_manifest.SceneCliTests.test_cli_reports_valid_uncommissioned_draft) ... ok
test_loader_rejects_duplicate_json_fields_and_nonfinite_constants (test_scene_manifest.SceneCliTests.test_loader_rejects_duplicate_json_fields_and_nonfinite_constants) ... ok
test_schema_is_parseable_and_documents_runtime_checks (test_scene_manifest.SceneCliTests.test_schema_is_parseable_and_documents_runtime_checks) ... ok
test_ambiguous_and_malformed_units_are_rejected (test_scene_manifest.SceneStructureTests.test_ambiguous_and_malformed_units_are_rejected) ... ok
test_duplicate_asset_ids_and_cross_namespace_ids_are_rejected (test_scene_manifest.SceneStructureTests.test_duplicate_asset_ids_and_cross_namespace_ids_are_rejected) ... ok
test_missing_parent_and_multiple_roots_are_rejected (test_scene_manifest.SceneStructureTests.test_missing_parent_and_multiple_roots_are_rejected) ... ok
test_missing_role_units_and_profile_are_named_blockers (test_scene_manifest.SceneStructureTests.test_missing_role_units_and_profile_are_named_blockers) ... ok
test_nonfinite_boolean_and_wrong_size_transforms_are_rejected (test_scene_manifest.SceneStructureTests.test_nonfinite_boolean_and_wrong_size_transforms_are_rejected) ... ok
test_parent_cycle_is_rejected_even_with_a_separate_valid_root (test_scene_manifest.SceneStructureTests.test_parent_cycle_is_rejected_even_with_a_separate_valid_root) ... ok
test_quaternion_requires_unit_length_and_accepts_negative_identity (test_scene_manifest.SceneStructureTests.test_quaternion_requires_unit_length_and_accepts_negative_identity) ... ok
test_source_inches_do_not_change_translation_mm_or_mutate_input (test_scene_manifest.SceneStructureTests.test_source_inches_do_not_change_translation_mm_or_mutate_input) ... ok
test_synthetic_example_is_a_valid_draft_with_no_motion_authority (test_scene_manifest.SceneStructureTests.test_synthetic_example_is_a_valid_draft_with_no_motion_authority) ... ok
test_unsupported_motion_authority_field_is_rejected (test_scene_manifest.SceneStructureTests.test_unsupported_motion_authority_field_is_rejected) ... ok
test_all_advisory_flag_combinations (test_service_health.ServiceFrameTests.test_all_advisory_flag_combinations) ... ok
test_flags_require_boolean (test_service_health.ServiceFrameTests.test_flags_require_boolean) ... ok
test_integer_ranges_and_boolean_confusion (test_service_health.ServiceFrameTests.test_integer_ranges_and_boolean_confusion) ... ok
test_wire_format_and_independent_crc (test_service_health.ServiceFrameTests.test_wire_format_and_independent_crc) ... ok
test_zero_progress_is_permitted_without_claiming_progress (test_service_health.ServiceFrameTests.test_zero_progress_is_permitted_without_claiming_progress) ... ok
test_backend_watchdog_expires_at_exact_deadline (test_supervisor.SupervisorTests.test_backend_watchdog_expires_at_exact_deadline) ... ok
test_boot_never_requests_enable_or_motion (test_supervisor.SupervisorTests.test_boot_never_requests_enable_or_motion) ... ok
test_boot_requires_a_real_backend_cycle_before_arm (test_supervisor.SupervisorTests.test_boot_requires_a_real_backend_cycle_before_arm) ... ok
test_commands_from_previous_session_rejected (test_supervisor.SupervisorTests.test_commands_from_previous_session_rejected) ... ok
test_continue_local_policy_never_bypasses_motion_watchdog (test_supervisor.SupervisorTests.test_continue_local_policy_never_bypasses_motion_watchdog) ... ok
test_corrupt_upload_preserves_existing_job (test_supervisor.SupervisorTests.test_corrupt_upload_preserves_existing_job) ... ok
test_deterministic_fault_injection_traces (test_supervisor.SupervisorTests.test_deterministic_fault_injection_traces) ... ok
test_disarm_during_run_waits_for_stopped_ack (test_supervisor.SupervisorTests.test_disarm_during_run_waits_for_stopped_ack) ... ok
test_expired_or_ungranted_deadline_rejected (test_supervisor.SupervisorTests.test_expired_or_ungranted_deadline_rejected) ... ok
test_fault_cannot_clear_by_network_command_or_heartbeat (test_supervisor.SupervisorTests.test_fault_cannot_clear_by_network_command_or_heartbeat) ... ok
test_hmi_lease_expiry_requests_hold_with_healthy_backend (test_supervisor.SupervisorTests.test_hmi_lease_expiry_requests_hold_with_healthy_backend) ... ok
test_invalid_configuration (test_supervisor.SupervisorTests.test_invalid_configuration) ... ok
test_job_cannot_change_during_run_or_hold (test_supervisor.SupervisorTests.test_job_cannot_change_during_run_or_hold) ... ok
test_job_digest_is_not_backend_validation (test_supervisor.SupervisorTests.test_job_digest_is_not_backend_validation) ... ok
test_large_time_jump_processes_first_deadline_not_only_end (test_supervisor.SupervisorTests.test_large_time_jump_processes_first_deadline_not_only_end) ... ok
test_malformed_fields_rejected_without_changing_state (test_supervisor.SupervisorTests.test_malformed_fields_rejected_without_changing_state) ... ok
test_network_activity_does_not_feed_motion_watchdog (test_supervisor.SupervisorTests.test_network_activity_does_not_feed_motion_watchdog) ... ok
test_physical_faults_in_every_operational_state (test_supervisor.SupervisorTests.test_physical_faults_in_every_operational_state) ... ok
test_reboot_discards_previous_backend_cycle (test_supervisor.SupervisorTests.test_reboot_discards_previous_backend_cycle) ... ok
test_reboot_invalidates_queued_commands_and_position (test_supervisor.SupervisorTests.test_reboot_invalidates_queued_commands_and_position) ... ok
test_reboot_keeps_active_physical_fault_inhibiting (test_supervisor.SupervisorTests.test_reboot_keeps_active_physical_fault_inhibiting) ... ok
test_reconnect_does_not_resume (test_supervisor.SupervisorTests.test_reconnect_does_not_resume) ... ok
test_rejected_start_cannot_be_replayed_after_arm (test_supervisor.SupervisorTests.test_rejected_start_cannot_be_replayed_after_arm) ... ok
test_remote_start_does_not_arm (test_supervisor.SupervisorTests.test_remote_start_does_not_arm) ... ok
test_reordered_and_duplicate_commands_have_no_motion_effect (test_supervisor.SupervisorTests.test_reordered_and_duplicate_commands_have_no_motion_effect) ... ok
test_second_session_cannot_steal_active_authority (test_supervisor.SupervisorTests.test_second_session_cannot_steal_active_authority) ... ok
test_sequence_wrap_requires_a_new_session (test_supervisor.SupervisorTests.test_sequence_wrap_requires_a_new_session) ... ok
test_session_identity_cannot_be_reused (test_supervisor.SupervisorTests.test_session_identity_cannot_be_reused) ... ok
test_stopped_ack_is_required_and_timeout_latches_fault (test_supervisor.SupervisorTests.test_stopped_ack_is_required_and_timeout_latches_fault) ... ok
test_driver_package_or_default_value_change_is_detected (test_tx_six.SixJointTransmitterTests.test_driver_package_or_default_value_change_is_detected) ... ok
test_duplicated_pin_or_added_short_is_detected (test_tx_six.SixJointTransmitterTests.test_duplicated_pin_or_added_short_is_detected) ... ok
test_each_bank_data_default_and_bypass_cannot_disappear (test_tx_six.SixJointTransmitterTests.test_each_bank_data_default_and_bypass_cannot_disappear) ... ok
test_expanded_or_changed_ledger_does_not_inherit_baseline_evidence (test_tx_six.SixJointTransmitterTests.test_expanded_or_changed_ledger_does_not_inherit_baseline_evidence) ... ok
test_exported_six_joint_block_matches_actual_ledger (test_tx_six.SixJointTransmitterTests.test_exported_six_joint_block_matches_actual_ledger) ... ok
test_final_bank_enable_bypass_is_detected (test_tx_six.SixJointTransmitterTests.test_final_bank_enable_bypass_is_detected) ... ok
test_output_polarity_swap_is_detected (test_tx_six.SixJointTransmitterTests.test_output_polarity_swap_is_detected) ... ok
test_reference_return_cannot_be_omitted (test_tx_six.SixJointTransmitterTests.test_reference_return_cannot_be_omitted) ... ok

----------------------------------------------------------------------
Ran 283 tests in 15.618s

OK
