DeadlySIn777/Controller/controller_backend/evidence/backend-contract-tests.txt

# Windows host: python -m unittest discover -s tests -p test_linuxcnc_backend.py -v (Python 3.14.6, 2026-09-28; symlink cases skip on this host)
test_abort_can_be_requested_when_status_age_is_stale (test_linuxcnc_backend.LinuxCNCBackendTests.test_abort_can_be_requested_when_status_age_is_stale) ... ok
test_configuration_rejects_invalid_freshness (test_linuxcnc_backend.LinuxCNCBackendTests.test_configuration_rejects_invalid_freshness) ... ok
test_connect_is_read_only (test_linuxcnc_backend.LinuxCNCBackendTests.test_connect_is_read_only) ... ok
test_constructor_does_not_connect_or_import (test_linuxcnc_backend.LinuxCNCBackendTests.test_constructor_does_not_connect_or_import) ... ok
test_error_arriving_at_command_precheck_blocks_motion (test_linuxcnc_backend.LinuxCNCBackendTests.test_error_arriving_at_command_precheck_blocks_motion) ... ok
test_error_channel_is_read_and_exposed (test_linuxcnc_backend.LinuxCNCBackendTests.test_error_channel_is_read_and_exposed) ... ok
test_expired_request_is_consumed_without_api_command (test_linuxcnc_backend.LinuxCNCBackendTests.test_expired_request_is_consumed_without_api_command) ... ok
test_expiry_during_mode_change_cannot_send_mdi (test_linuxcnc_backend.LinuxCNCBackendTests.test_expiry_during_mode_change_cannot_send_mdi) ... ok
test_expiry_during_status_refresh_sends_nothing (test_linuxcnc_backend.LinuxCNCBackendTests.test_expiry_during_status_refresh_sends_nothing) ... ok
test_foreign_profile_rejected_before_command_channel (test_linuxcnc_backend.LinuxCNCBackendTests.test_foreign_profile_rejected_before_command_channel) ... ok
test_launchers_start_from_clean_work_copy_and_shared_rootfs_variable (test_linuxcnc_backend.LinuxCNCBackendTests.test_launchers_start_from_clean_work_copy_and_shared_rootfs_variable)
Source inspection of the WSL launchers (not an execution test). ... ok
test_live_hardware_mode_is_not_implemented (test_linuxcnc_backend.LinuxCNCBackendTests.test_live_hardware_mode_is_not_implemented) ... ok
test_mdi_calls_real_api_shape (test_linuxcnc_backend.LinuxCNCBackendTests.test_mdi_calls_real_api_shape) ... ok
test_mdi_rejects_multiline (test_linuxcnc_backend.LinuxCNCBackendTests.test_mdi_rejects_multiline) ... ok
test_mdi_requires_homing (test_linuxcnc_backend.LinuxCNCBackendTests.test_mdi_requires_homing) ... ok
test_modified_request_cannot_execute (test_linuxcnc_backend.LinuxCNCBackendTests.test_modified_request_cannot_execute) ... ok
test_nonfinite_velocity_discards_authority (test_linuxcnc_backend.LinuxCNCBackendTests.test_nonfinite_velocity_discards_authority) ... ok
test_preexisting_error_blocks_motion_even_after_error_channel_consumed (test_linuxcnc_backend.LinuxCNCBackendTests.test_preexisting_error_blocks_motion_even_after_error_channel_consumed) ... ok
test_profile_copy_positive_control_connects (test_linuxcnc_backend.LinuxCNCBackendTests.test_profile_copy_positive_control_connects) ... ok
test_profile_file_problems_raise_backend_error_before_any_channel (test_linuxcnc_backend.LinuxCNCBackendTests.test_profile_file_problems_raise_backend_error_before_any_channel) ... ok
test_program_cannot_escape_profile (test_linuxcnc_backend.LinuxCNCBackendTests.test_program_cannot_escape_profile) ... ok
test_program_digest_must_match (test_linuxcnc_backend.LinuxCNCBackendTests.test_program_digest_must_match) ... ok
test_reconnect_does_not_resume_program (test_linuxcnc_backend.LinuxCNCBackendTests.test_reconnect_does_not_resume_program) ... ok
test_reconnect_invalidates_requests (test_linuxcnc_backend.LinuxCNCBackendTests.test_reconnect_invalidates_requests) ... ok
test_reordered_request_cannot_execute (test_linuxcnc_backend.LinuxCNCBackendTests.test_reordered_request_cannot_execute) ... ok
test_resume_requires_reported_pause (test_linuxcnc_backend.LinuxCNCBackendTests.test_resume_requires_reported_pause) ... ok
test_run_is_asynchronous_to_keep_hold_and_abort_available (test_linuxcnc_backend.LinuxCNCBackendTests.test_run_is_asynchronous_to_keep_hold_and_abort_available) ... ok
test_run_pause_resume_are_explicit (test_linuxcnc_backend.LinuxCNCBackendTests.test_run_pause_resume_are_explicit) ... ok
test_sample_records_controller_reported_ini_filename (test_linuxcnc_backend.LinuxCNCBackendTests.test_sample_records_controller_reported_ini_filename) ... ok
test_stale_status_rejects_fresh_request (test_linuxcnc_backend.LinuxCNCBackendTests.test_stale_status_rejects_fresh_request) ... ok
test_state_rejection_cannot_be_replayed_when_ready (test_linuxcnc_backend.LinuxCNCBackendTests.test_state_rejection_cannot_be_replayed_when_ready) ... ok
test_status_failure_drops_authority (test_linuxcnc_backend.LinuxCNCBackendTests.test_status_failure_drops_authority) ... ok
test_timeout_drops_authority_and_never_retries (test_linuxcnc_backend.LinuxCNCBackendTests.test_timeout_drops_authority_and_never_retries) ... ok
test_uninitialized_status_rejected (test_linuxcnc_backend.LinuxCNCBackendTests.test_uninitialized_status_rejected) ... ok
test_report_cites_current_simulation_evidence (test_linuxcnc_backend.RecordedEvidenceConsistencyTests.test_report_cites_current_simulation_evidence) ... ok
test_absolute_and_contained_relative_symlinks_are_kept (test_linuxcnc_backend.RootfsLayerFilterTests.test_absolute_and_contained_relative_symlinks_are_kept) ... skipped 'symlink creation unavailable on this host'
test_contained_hardlink_is_extracted (test_linuxcnc_backend.RootfsLayerFilterTests.test_contained_hardlink_is_extracted) ... ok
test_device_nodes_and_fifos_are_refused (test_linuxcnc_backend.RootfsLayerFilterTests.test_device_nodes_and_fifos_are_refused) ... ok
test_dotdot_symlink_through_self_link_cannot_touch_directory_above_root (test_linuxcnc_backend.RootfsLayerFilterTests.test_dotdot_symlink_through_self_link_cannot_touch_directory_above_root) ... skipped 'symlink creation unavailable on this host'
test_escaping_hardlinks_are_refused (test_linuxcnc_backend.RootfsLayerFilterTests.test_escaping_hardlinks_are_refused) ... ok
test_escaping_or_absolute_member_names_are_refused (test_linuxcnc_backend.RootfsLayerFilterTests.test_escaping_or_absolute_member_names_are_refused) ... ok
test_existing_contained_symlink_can_still_be_replaced (test_linuxcnc_backend.RootfsLayerFilterTests.test_existing_contained_symlink_can_still_be_replaced) ... skipped 'symlink creation unavailable on this host'
test_extraction_refused_without_link_fallback_refilter (test_linuxcnc_backend.RootfsLayerFilterTests.test_extraction_refused_without_link_fallback_refilter) ... ok
test_filter_callable_matches_tarfile_signature (test_linuxcnc_backend.RootfsLayerFilterTests.test_filter_callable_matches_tarfile_signature) ... ok
test_lexically_escaping_relative_symlink_is_refused (test_linuxcnc_backend.RootfsLayerFilterTests.test_lexically_escaping_relative_symlink_is_refused) ... ok
test_members_under_existing_escaping_symlink_are_refused (test_linuxcnc_backend.RootfsLayerFilterTests.test_members_under_existing_escaping_symlink_are_refused) ... skipped 'symlink creation unavailable on this host'
test_regular_file_mode_and_ownership_are_preserved (test_linuxcnc_backend.RootfsLayerFilterTests.test_regular_file_mode_and_ownership_are_preserved) ... ok
test_symlink_member_whose_last_component_is_dot_or_dotdot_is_refused_by_filter (test_linuxcnc_backend.RootfsLayerFilterTests.test_symlink_member_whose_last_component_is_dot_or_dotdot_is_refused_by_filter) ... ok
test_write_through_symlink_extracted_earlier_in_layer_is_refused (test_linuxcnc_backend.RootfsLayerFilterTests.test_write_through_symlink_extracted_earlier_in_layer_is_refused) ... skipped 'symlink creation unavailable on this host'

----------------------------------------------------------------------
Ran 49 tests in 0.202s

OK (skipped=5)
