DeadlySIn777/Controller/reports/board-completion-20261001/root94-validation-reconcile-command.txt

{'passed': True, 'host': 2087, 'host_passed': 1847, 'actual_native_passed': 235, 'remaining_environment_skips': 5, 'source_files': 2813, 'ERC_errors': 0, 'ERC_warnings': 70}
