DeadlySIn777/Controller/reports/freerouting-evaluation-20261002/convex-conversion-r01-command.txt

{"processed": 1000, "emitted": 90718, "seconds": 40.28099999995902}
{"processed": 2000, "emitted": 113686, "seconds": 49.81299999996554}
{"processed": 3000, "emitted": 138712, "seconds": 58.625}
{"processed": 4000, "emitted": 150075, "seconds": 62.65599999995902}
{"processed": 5000, "emitted": 177152, "seconds": 71.70299999997951}
{"processed": 6000, "emitted": 189075, "seconds": 76.21900000004098}
{"processed": 7000, "emitted": 209828, "seconds": 83.39099999994505}
{"passed": true, "polygons": 7053, "emitted": 210696, "sha256": "dd6fce893b7bd94207872bd97f4a904f5744f0c944cced16df3d35542d194e49", "seconds": 92.60999999998603}
