DeadlySIn777/Controller/reports/is1-watchdog-independent-review-final-20260930/validator.stdout.txt

{
  "ok": true,
  "errors": [],
  "manufacturing_ready": false,
  "erc_violations": 0
}
