DeadlySIn777/Controller/reports/motherboard-acc-control-20260930/tests-acc_control.txt

test_DAC_buffer_readback_not_measured_analogvoltage (test_motherboard_acc_control.ACCControlTests.test_DAC_buffer_readback_not_measured_analogvoltage) ... ok
test_I2C_pin_AF6_not_SPI_AF (test_motherboard_acc_control.ACCControlTests.test_I2C_pin_AF6_not_SPI_AF) ... ok
test_K32_lacks_actual_selected_AI_SPI_GPIO (test_motherboard_acc_control.ACCControlTests.test_K32_lacks_actual_selected_AI_SPI_GPIO) ... ok
test_NRST_input_only_hides_internal_watchdog (test_motherboard_acc_control.ACCControlTests.test_NRST_input_only_hides_internal_watchdog) ... ok
test_QFN_EP_map_cannot_replace_LQFP (test_motherboard_acc_control.ACCControlTests.test_QFN_EP_map_cannot_replace_LQFP) ... ok
test_SPI2_actual_output_pin (test_motherboard_acc_control.ACCControlTests.test_SPI2_actual_output_pin) ... ok
test_TI125_noIoff_not_returned (test_motherboard_acc_control.ACCControlTests.test_TI125_noIoff_not_returned) ... ok
test_current_PWM_fault_is_observed (test_motherboard_acc_control.ACCControlTests.test_current_PWM_fault_is_observed) ... ok
test_existing_offbias_not_removed (test_motherboard_acc_control.ACCControlTests.test_existing_offbias_not_removed) ... ok
test_factory_pad_not_charged_as_part (test_motherboard_acc_control.ACCControlTests.test_factory_pad_not_charged_as_part) ... ok
test_fault_monitor_not_claimed_implemented (test_motherboard_acc_control.ACCControlTests.test_fault_monitor_not_claimed_implemented) ... ok
test_fixedCT_not_grounded (test_motherboard_acc_control.ACCControlTests.test_fixedCT_not_grounded) ... ok
test_frontend_OFFbias_not_fitted_twice (test_motherboard_acc_control.ACCControlTests.test_frontend_OFFbias_not_fitted_twice) ... ok
test_host_response_cannot_swap_AI_MISO (test_motherboard_acc_control.ACCControlTests.test_host_response_cannot_swap_AI_MISO) ... ok
test_ignoredERC_rejected (test_motherboard_acc_control.ACCControlTests.test_ignoredERC_rejected) ... ok
test_invalid_frame_cannot_refresh_watchdog (test_motherboard_acc_control.ACCControlTests.test_invalid_frame_cannot_refresh_watchdog) ... ok
test_logical_region_not_removable_customcard (test_motherboard_acc_control.ACCControlTests.test_logical_region_not_removable_customcard) ... ok
test_missing_iso_monitor_not_healthy (test_motherboard_acc_control.ACCControlTests.test_missing_iso_monitor_not_healthy) ... ok
test_nativeERC_not_target_firmware (test_motherboard_acc_control.ACCControlTests.test_nativeERC_not_target_firmware) ... ok
test_nativeXML_drift_caught (test_motherboard_acc_control.ACCControlTests.test_nativeXML_drift_caught) ... ok
test_native_exact_source_and_process (test_motherboard_acc_control.ACCControlTests.test_native_exact_source_and_process) ... ok
test_no_automatic_rearm_after_returned_permission (test_motherboard_acc_control.ACCControlTests.test_no_automatic_rearm_after_returned_permission) ... ok
test_no_fitted_boundary_connector (test_motherboard_acc_control.ACCControlTests.test_no_fitted_boundary_connector) ... ok
test_no_invented_DAC_SPI_readback (test_motherboard_acc_control.ACCControlTests.test_no_invented_DAC_SPI_readback) ... ok
test_output_class_not_DI (test_motherboard_acc_control.ACCControlTests.test_output_class_not_DI) ... ok
test_process_latch_observation_not_constant (test_motherboard_acc_control.ACCControlTests.test_process_latch_observation_not_constant) ... ok
test_real_analog_enable_request_defaults_OFF (test_motherboard_acc_control.ACCControlTests.test_real_analog_enable_request_defaults_OFF) ... ok
test_real_slot3_not_slot1 (test_motherboard_acc_control.ACCControlTests.test_real_slot3_not_slot1) ... ok
test_reset_buffer_drives_separate_frontend (test_motherboard_acc_control.ACCControlTests.test_reset_buffer_drives_separate_frontend) ... ok
test_software_start_not_hardware_watchdog (test_motherboard_acc_control.ACCControlTests.test_software_start_not_hardware_watchdog) ... ok
test_synchronous_DAC_buffer_not_applied_readback (test_motherboard_acc_control.ACCControlTests.test_synchronous_DAC_buffer_not_applied_readback) ... ok
test_watchdog_512ms_reset_reload_not_finalsetting (test_motherboard_acc_control.ACCControlTests.test_watchdog_512ms_reset_reload_not_finalsetting) ... ok
test_watchdog_uses_min_LSI_not_nominal (test_motherboard_acc_control.ACCControlTests.test_watchdog_uses_min_LSI_not_nominal) ... ok

----------------------------------------------------------------------
Ran 33 tests in 0.041s

OK
