DeadlySIn777/Controller/reports/motherboard-acc-control-20260930/tests-do.txt

test_actual2a_output_tier_not_qualified (test_motherboard_do.MotherboardOutputTests.test_actual2a_output_tier_not_qualified) ... ok
test_adc_only_valid_while_on_and_unimplemented_readout (test_motherboard_do.MotherboardOutputTests.test_adc_only_valid_while_on_and_unimplemented_readout) ... ok
test_address_resistors_need_strictly_less_than_one_percent (test_motherboard_do.MotherboardOutputTests.test_address_resistors_need_strictly_less_than_one_percent) ... ok
test_bs_without_adc_cannot_replace_as (test_motherboard_do.MotherboardOutputTests.test_bs_without_adc_cannot_replace_as) ... ok
test_channels_do_not_alias (test_motherboard_do.MotherboardOutputTests.test_channels_do_not_alias) ... ok
test_chip_addresses_are_unique_within_bank (test_motherboard_do.MotherboardOutputTests.test_chip_addresses_are_unique_within_bank) ... ok
test_controller_and_field_rail_are_explicit_gaps (test_motherboard_do.MotherboardOutputTests.test_controller_and_field_rail_are_explicit_gaps) ... ok
test_current_limit_nominal1a_exceeds_guaranteed1a_max (test_motherboard_do.MotherboardOutputTests.test_current_limit_nominal1a_exceeds_guaranteed1a_max) ... ok
test_default_high_isolator_rejected (test_motherboard_do.MotherboardOutputTests.test_default_high_isolator_rejected) ... ok
test_dnc_is_not_ground_or_led (test_motherboard_do.MotherboardOutputTests.test_dnc_is_not_ground_or_led) ... ok
test_dnh_offset_ep_and_source_pin_geometry_not_generic8pin (test_motherboard_do.MotherboardOutputTests.test_dnh_offset_ep_and_source_pin_geometry_not_generic8pin) ... ok
test_driver_thermal_pad_is_field_ground (test_motherboard_do.MotherboardOutputTests.test_driver_thermal_pad_is_field_ground) ... ok
test_driver_vs_pin_cannot_float (test_motherboard_do.MotherboardOutputTests.test_driver_vs_pin_cannot_float) ... ok
test_erc_suppression_or_different_ground_warning_rejected (test_motherboard_do.MotherboardOutputTests.test_erc_suppression_or_different_ground_warning_rejected) ... ok
test_field_do_enable_has_real_pulldown (test_motherboard_do.MotherboardOutputTests.test_field_do_enable_has_real_pulldown) ... ok
test_field_ground_does_not_cross_isolation (test_motherboard_do.MotherboardOutputTests.test_field_ground_does_not_cross_isolation) ... ok
test_ilim_zero_readback_and_crc_not_optional (test_motherboard_do.MotherboardOutputTests.test_ilim_zero_readback_and_crc_not_optional) ... ok
test_independent_pair_limits_not_fake_per_channel_setting (test_motherboard_do.MotherboardOutputTests.test_independent_pair_limits_not_fake_per_channel_setting) ... ok
test_invented_fitted_connector_rejected (test_motherboard_do.MotherboardOutputTests.test_invented_fitted_connector_rejected) ... ok
test_isolator_control_output_cannot_be_fault_pin (test_motherboard_do.MotherboardOutputTests.test_isolator_control_output_cannot_be_fault_pin) ... ok
test_latch_cannot_auto_set_after_reset (test_motherboard_do.MotherboardOutputTests.test_latch_cannot_auto_set_after_reset) ... ok
test_latch_cannot_skip_permission_drop_clear (test_motherboard_do.MotherboardOutputTests.test_latch_cannot_skip_permission_drop_clear) ... ok
test_local_enable_cannot_bypass_hardwired_permission (test_motherboard_do.MotherboardOutputTests.test_local_enable_cannot_bypass_hardwired_permission) ... ok
test_missing_controller_stays_off (test_motherboard_do.MotherboardOutputTests.test_missing_controller_stays_off) ... ok
test_native_model_erc_and_exact_footprints_match (test_motherboard_do.MotherboardOutputTests.test_native_model_erc_and_exact_footprints_match) ... ok
test_native_pin_drift_is_caught_independently (test_motherboard_do.MotherboardOutputTests.test_native_pin_drift_is_caught_independently) ... ok
test_por_125a_is_not_advertised_as_072a (test_motherboard_do.MotherboardOutputTests.test_por_125a_is_not_advertised_as_072a) ... ok
test_rcb_drain_ep_cannot_be_source (test_motherboard_do.MotherboardOutputTests.test_rcb_drain_ep_cannot_be_source) ... ok
test_rcb_mosfet_gate_is_pin4_after_rendered_topview_review (test_motherboard_do.MotherboardOutputTests.test_rcb_mosfet_gate_is_pin4_after_rendered_topview_review) ... ok
test_rcb_mosfet_source_drain_cannot_reverse (test_motherboard_do.MotherboardOutputTests.test_rcb_mosfet_source_drain_cannot_reverse) ... ok
test_required_software_register_settings_cannot_be_marked_done (test_motherboard_do.MotherboardOutputTests.test_required_software_register_settings_cannot_be_marked_done) ... ok
test_rha_pin1_orientation_not_generic_numbering (test_motherboard_do.MotherboardOutputTests.test_rha_pin1_orientation_not_generic_numbering) ... ok
test_sense_filter_does_not_end_at_testpoint_only (test_motherboard_do.MotherboardOutputTests.test_sense_filter_does_not_end_at_testpoint_only) ... ok
test_sixteenth_channel_is_real (test_motherboard_do.MotherboardOutputTests.test_sixteenth_channel_is_real) ... ok
test_tps_internal_regulators_cannot_parallel (test_motherboard_do.MotherboardOutputTests.test_tps_internal_regulators_cannot_parallel) ... ok
test_unqualified_inrush_and_parallel_tiers_rejected (test_motherboard_do.MotherboardOutputTests.test_unqualified_inrush_and_parallel_tiers_rejected) ... ok

----------------------------------------------------------------------
Ran 36 tests in 0.083s

OK
