DeadlySIn777/Controller/reports/motherboard-acc-control-20260930/tests-io_control.txt

test_512ms_reset_reload_not_active_configuration (test_motherboard_io_control.IOL1SourceTests.test_512ms_reset_reload_not_active_configuration) ... ok
test_DI_cannot_be_aliased_to_motor_alarm (test_motherboard_io_control.IOL1SourceTests.test_DI_cannot_be_aliased_to_motor_alarm) ... ok
test_ERC_ignored_checks_rejected (test_motherboard_io_control.IOL1SourceTests.test_ERC_ignored_checks_rejected) ... ok
test_GPIO_name_doesnot_replace_exact_package_pin (test_motherboard_io_control.IOL1SourceTests.test_GPIO_name_doesnot_replace_exact_package_pin) ... ok
test_IOFF_not_typical_leakage (test_motherboard_io_control.IOL1SourceTests.test_IOFF_not_typical_leakage) ... ok
test_NRST_input_only_hides_internal_watchdog_reset (test_motherboard_io_control.IOL1SourceTests.test_NRST_input_only_hides_internal_watchdog_reset) ... ok
test_TI_buffer_without_IOFF_cannot_return (test_motherboard_io_control.IOL1SourceTests.test_TI_buffer_without_IOFF_cannot_return) ... ok
test_debug_freeze_not_shipping_watchdog (test_motherboard_io_control.IOL1SourceTests.test_debug_freeze_not_shipping_watchdog) ... ok
test_different_package_pin_pitch_rejected (test_motherboard_io_control.IOL1SourceTests.test_different_package_pin_pitch_rejected) ... ok
test_driverSPI_return_direction_is_real (test_motherboard_io_control.IOL1SourceTests.test_driverSPI_return_direction_is_real) ... ok
test_exact_native_source_and_frontends (test_motherboard_io_control.IOL1SourceTests.test_exact_native_source_and_frontends) ... ok
test_external_VREF_cannot_enable_internal_buffer (test_motherboard_io_control.IOL1SourceTests.test_external_VREF_cannot_enable_internal_buffer) ... ok
test_factory_pad_not_purchased_connector (test_motherboard_io_control.IOL1SourceTests.test_factory_pad_not_purchased_connector) ... ok
test_frontend_owned_pulldown_cannot_disappear (test_motherboard_io_control.IOL1SourceTests.test_frontend_owned_pulldown_cannot_disappear) ... ok
test_hostSPI_cannot_use_wrong_AF_gpio (test_motherboard_io_control.IOL1SourceTests.test_hostSPI_cannot_use_wrong_AF_gpio) ... ok
test_independent_watchdog_not_application_timer (test_motherboard_io_control.IOL1SourceTests.test_independent_watchdog_not_application_timer) ... ok
test_iwdg_software_start_not_guaranteed_hardware_start (test_motherboard_io_control.IOL1SourceTests.test_iwdg_software_start_not_guaranteed_hardware_start) ... ok
test_missing_field_good_bias_cannot_be_pulledUP (test_motherboard_io_control.IOL1SourceTests.test_missing_field_good_bias_cannot_be_pulledUP) ... ok
test_missing_field_monitor_cannot_be_marked_implemented (test_motherboard_io_control.IOL1SourceTests.test_missing_field_monitor_cannot_be_marked_implemented) ... ok
test_missing_sensor_monitor_is_not_healthy (test_motherboard_io_control.IOL1SourceTests.test_missing_sensor_monitor_is_not_healthy) ... ok
test_nativeERC_not_target_firmware (test_motherboard_io_control.IOL1SourceTests.test_nativeERC_not_target_firmware) ... ok
test_nativeXML_pin_drift_independently_detected (test_motherboard_io_control.IOL1SourceTests.test_nativeXML_pin_drift_independently_detected) ... ok
test_obsolete_bulk_MPN_not_reintroduced (test_motherboard_io_control.IOL1SourceTests.test_obsolete_bulk_MPN_not_reintroduced) ... ok
test_partial_power_spec_not_brownout_measurement (test_motherboard_io_control.IOL1SourceTests.test_partial_power_spec_not_brownout_measurement) ... ok
test_per_node_reset_cannot_be_shortened_into_one (test_motherboard_io_control.IOL1SourceTests.test_per_node_reset_cannot_be_shortened_into_one) ... ok
test_port0_class_doesnot_become_output_class (test_motherboard_io_control.IOL1SourceTests.test_port0_class_doesnot_become_output_class) ... ok
test_real_latch_observation_not_constanthealthy (test_motherboard_io_control.IOL1SourceTests.test_real_latch_observation_not_constanthealthy) ... ok
test_reset_buffer_can_never_swap_input_output (test_motherboard_io_control.IOL1SourceTests.test_reset_buffer_can_never_swap_input_output) ... ok
test_reset_pushpull_not_direct_NRST_divider (test_motherboard_io_control.IOL1SourceTests.test_reset_pushpull_not_direct_NRST_divider) ... ok
test_resolved_duplicate_biases_not_reintroduced (test_motherboard_io_control.IOL1SourceTests.test_resolved_duplicate_biases_not_reintroduced) ... ok
test_slot_strap_wrong_bank_cannot_be_accepted (test_motherboard_io_control.IOL1SourceTests.test_slot_strap_wrong_bank_cannot_be_accepted) ... ok
test_supervisor_CT_ground_not_open20ms (test_motherboard_io_control.IOL1SourceTests.test_supervisor_CT_ground_not_open20ms) ... ok
test_supervisor_RESET_and_SENSE_cannot_swap (test_motherboard_io_control.IOL1SourceTests.test_supervisor_RESET_and_SENSE_cannot_swap) ... ok
test_twenty_fourth_DI_is_acquired (test_motherboard_io_control.IOL1SourceTests.test_twenty_fourth_DI_is_acquired) ... ok
test_unprovisioned_option_bytes_not_claimed_verified (test_motherboard_io_control.IOL1SourceTests.test_unprovisioned_option_bytes_not_claimed_verified) ... ok
test_unselected_boundary_cannot_be_physical_card (test_motherboard_io_control.IOL1SourceTests.test_unselected_boundary_cannot_be_physical_card) ... ok
test_unsupported_nominal_LSI_watchdog_screen_rejected (test_motherboard_io_control.IOL1SourceTests.test_unsupported_nominal_LSI_watchdog_screen_rejected) ... ok
test_wrong_bulk_voltage_not_accepted (test_motherboard_io_control.IOL1SourceTests.test_wrong_bulk_voltage_not_accepted) ... ok

----------------------------------------------------------------------
Ran 38 tests in 0.079s

OK
