DeadlySIn777/Controller/reports/motherboard-analog-20260930/tests-analog_output.txt

test_DCDC_inputreturn_not_field (test_motherboard_analog_output.AnalogOutputSourceTests.test_DCDC_inputreturn_not_field) ... ok
test_DCDC_pin5_not_fakecommon (test_motherboard_analog_output.AnalogOutputSourceTests.test_DCDC_pin5_not_fakecommon) ... ok
test_F_defaultLOW_required (test_motherboard_analog_output.AnalogOutputSourceTests.test_F_defaultLOW_required) ... ok
test_I2C_isolation_keeps_correct_returns (test_motherboard_analog_output.AnalogOutputSourceTests.test_I2C_isolation_keeps_correct_returns) ... ok
test_IO3_enable_cannot_bypass_rearm (test_motherboard_analog_output.AnalogOutputSourceTests.test_IO3_enable_cannot_bypass_rearm) ... ok
test_LDO_DNC2_must_not_ground (test_motherboard_analog_output.AnalogOutputSourceTests.test_LDO_DNC2_must_not_ground) ... ok
test_LDO_EP_is_local_return (test_motherboard_analog_output.AnalogOutputSourceTests.test_LDO_EP_is_local_return) ... ok
test_LDO_other_DGN_EP_not_same (test_motherboard_analog_output.AnalogOutputSourceTests.test_LDO_other_DGN_EP_not_same) ... ok
test_NC_clamp_not_NO_part (test_motherboard_analog_output.AnalogOutputSourceTests.test_NC_clamp_not_NO_part) ... ok
test_NC_package_different_from_NO (test_motherboard_analog_output.AnalogOutputSourceTests.test_NC_package_different_from_NO) ... ok
test_NO_disconnect_not_NC_part (test_motherboard_analog_output.AnalogOutputSourceTests.test_NO_disconnect_not_NC_part) ... ok
test_SDO_and_RESET_not_interchanged (test_motherboard_analog_output.AnalogOutputSourceTests.test_SDO_and_RESET_not_interchanged) ... ok
test_SPI_isolator_fifth_forward_reset_pin (test_motherboard_analog_output.AnalogOutputSourceTests.test_SPI_isolator_fifth_forward_reset_pin) ... ok
test_actual_DAC_LDAC_cannot_float (test_motherboard_analog_output.AnalogOutputSourceTests.test_actual_DAC_LDAC_cannot_float) ... ok
test_adc_addresses_not_both48 (test_motherboard_analog_output.AnalogOutputSourceTests.test_adc_addresses_not_both48) ... ok
test_analog12V_not5V_headroom (test_motherboard_analog_output.AnalogOutputSourceTests.test_analog12V_not5V_headroom) ... ok
test_clampobserved_voltage_not_commandbit (test_motherboard_analog_output.AnalogOutputSourceTests.test_clampobserved_voltage_not_commandbit) ... ok
test_gain4_actual_amp_pinmap (test_motherboard_analog_output.AnalogOutputSourceTests.test_gain4_actual_amp_pinmap) ... ok
test_host_permissionloss_resets_DAC (test_motherboard_analog_output.AnalogOutputSourceTests.test_host_permissionloss_resets_DAC) ... ok
test_ignoredERC_not_accepted (test_motherboard_analog_output.AnalogOutputSourceTests.test_ignoredERC_not_accepted) ... ok
test_input_register_not_independent_DAC_latch (test_motherboard_analog_output.AnalogOutputSourceTests.test_input_register_not_independent_DAC_latch) ... ok
test_islands_not_return_joined (test_motherboard_analog_output.AnalogOutputSourceTests.test_islands_not_return_joined) ... ok
test_local_enable_requires_real_powergood (test_motherboard_analog_output.AnalogOutputSourceTests.test_local_enable_requires_real_powergood) ... ok
test_missing_domain_not_healthy (test_motherboard_analog_output.AnalogOutputSourceTests.test_missing_domain_not_healthy) ... ok
test_nativeXML_drift_rejected (test_motherboard_analog_output.AnalogOutputSourceTests.test_nativeXML_drift_rejected) ... ok
test_native_exact_source (test_motherboard_analog_output.AnalogOutputSourceTests.test_native_exact_source) ... ok
test_no_false_8MHz_readback_latencyproof (test_motherboard_analog_output.AnalogOutputSourceTests.test_no_false_8MHz_readback_latencyproof) ... ok
test_no_native_source_manufacturingclaim (test_motherboard_analog_output.AnalogOutputSourceTests.test_no_native_source_manufacturingclaim) ... ok
test_old_DAC80501_no_SPI_SDO (test_motherboard_analog_output.AnalogOutputSourceTests.test_old_DAC80501_no_SPI_SDO) ... ok
test_other_ERC_error_not_accepted (test_motherboard_analog_output.AnalogOutputSourceTests.test_other_ERC_error_not_accepted) ... ok
test_plain_AD5683R_part_lacks_SDO (test_motherboard_analog_output.AnalogOutputSourceTests.test_plain_AD5683R_part_lacks_SDO) ... ok
test_pushpull_returns_not_permanently_merged (test_motherboard_analog_output.AnalogOutputSourceTests.test_pushpull_returns_not_permanently_merged) ... ok
test_readback_contact_voltage_not_contactproof (test_motherboard_analog_output.AnalogOutputSourceTests.test_readback_contact_voltage_not_contactproof) ... ok
test_readback_observes_terminal_not_commandDAC (test_motherboard_analog_output.AnalogOutputSourceTests.test_readback_observes_terminal_not_commandDAC) ... ok
test_ref_cannot_be_supply_strap (test_motherboard_analog_output.AnalogOutputSourceTests.test_ref_cannot_be_supply_strap) ... ok
test_reference_actual_adcchannel (test_motherboard_analog_output.AnalogOutputSourceTests.test_reference_actual_adcchannel) ... ok
test_two_kohm_receiver_not_silent10k_reduction (test_motherboard_analog_output.AnalogOutputSourceTests.test_two_kohm_receiver_not_silent10k_reduction) ... ok
test_zero_uses_inputclamp_not_short_DAC (test_motherboard_analog_output.AnalogOutputSourceTests.test_zero_uses_inputclamp_not_short_DAC) ... ok

----------------------------------------------------------------------
Ran 38 tests in 0.103s

OK
