DeadlySIn777/Controller/reports/motherboard-analog-20260930/tests-operator.txt

test_24V_field_fault_cannot_cross_directly (test_motherboard_operator.OperatorSourceTests.test_24V_field_fault_cannot_cross_directly) ... ok
test_24V_limit_guarantee_not_fabricated (test_motherboard_operator.OperatorSourceTests.test_24V_limit_guarantee_not_fabricated) ... ok
test_ENCODER_enable_NOT_currentlimit_pin (test_motherboard_operator.OperatorSourceTests.test_ENCODER_enable_NOT_currentlimit_pin) ... ok
test_ERC_cannot_suppress (test_motherboard_operator.OperatorSourceTests.test_ERC_cannot_suppress) ... ok
test_FAR_SER_not_left_floating (test_motherboard_operator.OperatorSourceTests.test_FAR_SER_not_left_floating) ... ok
test_FAULT_is_not_a_voltage_measurement (test_motherboard_operator.OperatorSourceTests.test_FAULT_is_not_a_voltage_measurement) ... ok
test_ISO7720_DWR_not_eightpin_D (test_motherboard_operator.OperatorSourceTests.test_ISO7720_DWR_not_eightpin_D) ... ok
test_ISO7720_F_defaultLOW_required (test_motherboard_operator.OperatorSourceTests.test_ISO7720_F_defaultLOW_required) ... ok
test_LM4040_DBZ_not_DCK (test_motherboard_operator.OperatorSourceTests.test_LM4040_DBZ_not_DCK) ... ok
test_MPG_ilim_cannot_be_lower_to_200mA (test_motherboard_operator.OperatorSourceTests.test_MPG_ilim_cannot_be_lower_to_200mA) ... ok
test_SW24_same_MPN_wrong_footprint (test_motherboard_operator.OperatorSourceTests.test_SW24_same_MPN_wrong_footprint) ... ok
test_Schmitt_default_has_worst_unused_pull_margin (test_motherboard_operator.OperatorSourceTests.test_Schmitt_default_has_worst_unused_pull_margin) ... ok
test_XF_absent_must_remove_power (test_motherboard_operator.OperatorSourceTests.test_XF_absent_must_remove_power) ... ok
test_XF_must_not_share_unqualified_encoder_enable (test_motherboard_operator.OperatorSourceTests.test_XF_must_not_share_unqualified_encoder_enable) ... ok
test_boundary_is_not_a_selected_connector (test_motherboard_operator.OperatorSourceTests.test_boundary_is_not_a_selected_connector) ... ok
test_clamp_commonpin_cannot_be_rail (test_motherboard_operator.OperatorSourceTests.test_clamp_commonpin_cannot_be_rail) ... ok
test_config_done_cannot_be_constant_healthy (test_motherboard_operator.OperatorSourceTests.test_config_done_cannot_be_constant_healthy) ... ok
test_configuration_and_presence_truth_table (test_motherboard_operator.OperatorSourceTests.test_configuration_and_presence_truth_table) ... ok
test_contact_not_24V_input (test_motherboard_operator.OperatorSourceTests.test_contact_not_24V_input) ... ok
test_currentlimiter_same_package_wrongvariant (test_motherboard_operator.OperatorSourceTests.test_currentlimiter_same_package_wrongvariant) ... ok
test_field_domain_cannot_join_logic (test_motherboard_operator.OperatorSourceTests.test_field_domain_cannot_join_logic) ... ok
test_global_10k_default_not_adequate_for_allocation (test_motherboard_operator.OperatorSourceTests.test_global_10k_default_not_adequate_for_allocation) ... ok
test_hardshort_bound_not_fabricated (test_motherboard_operator.OperatorSourceTests.test_hardshort_bound_not_fabricated) ... ok
test_marker_failures_do_latch (test_motherboard_operator.OperatorSourceTests.test_marker_failures_do_latch) ... ok
test_marker_must_be_far_end (test_motherboard_operator.OperatorSourceTests.test_marker_must_be_far_end) ... ok
test_marker_numeric_0xA_not_reversed (test_motherboard_operator.OperatorSourceTests.test_marker_numeric_0xA_not_reversed) ... ok
test_nativeXML_unintended_join_detected (test_motherboard_operator.OperatorSourceTests.test_nativeXML_unintended_join_detected) ... ok
test_native_schematic_matches_complete_independent_contract (test_motherboard_operator.OperatorSourceTests.test_native_schematic_matches_complete_independent_contract) ... ok
test_no_nominal_only_currentlimit (test_motherboard_operator.OperatorSourceTests.test_no_nominal_only_currentlimit) ... ok
test_no_two_read_agreement_disabled (test_motherboard_operator.OperatorSourceTests.test_no_two_read_agreement_disabled) ... ok
test_not_claimed_manufacturable (test_motherboard_operator.OperatorSourceTests.test_not_claimed_manufacturable) ... ok
test_probe_NC6_cannot_be_ground (test_motherboard_operator.OperatorSourceTests.test_probe_NC6_cannot_be_ground) ... ok
test_probe_SUB_not_field_ground (test_motherboard_operator.OperatorSourceTests.test_probe_SUB_not_field_ground) ... ok
test_probe_cannot_be_motor_alarm (test_motherboard_operator.OperatorSourceTests.test_probe_cannot_be_motor_alarm) ... ok
test_probe_cannot_inherit_ordinaryDI_RC (test_motherboard_operator.OperatorSourceTests.test_probe_cannot_inherit_ordinaryDI_RC) ... ok
test_probe_current_sensor_pin_swap (test_motherboard_operator.OperatorSourceTests.test_probe_current_sensor_pin_swap) ... ok
test_probe_not_general_DI (test_motherboard_operator.OperatorSourceTests.test_probe_not_general_DI) ... ok
test_reference_pinmap_not_reversed (test_motherboard_operator.OperatorSourceTests.test_reference_pinmap_not_reversed) ... ok
test_selector_active_polarity_not_inverted_silently (test_motherboard_operator.OperatorSourceTests.test_selector_active_polarity_not_inverted_silently) ... ok
test_selector_no_contactfilter (test_motherboard_operator.OperatorSourceTests.test_selector_no_contactfilter) ... ok
test_serial_return_not_invertedQH (test_motherboard_operator.OperatorSourceTests.test_serial_return_not_invertedQH) ... ok
test_slow_XF_request_cannot_bypass_Schmitt (test_motherboard_operator.OperatorSourceTests.test_slow_XF_request_cannot_bypass_Schmitt) ... ok
test_unpowered_faultflag_must_be_invalid (test_motherboard_operator.OperatorSourceTests.test_unpowered_faultflag_must_be_invalid) ... ok

----------------------------------------------------------------------
Ran 43 tests in 0.229s

OK
