DeadlySIn777/Controller/reports/motherboard-analog-20260930/tests-process.txt

test_500mA_USB_switch_not_50mA_aux (test_motherboard_process.ProcessSourceTests.test_500mA_USB_switch_not_50mA_aux) ... ok
test_LED_IFT_screen_not_typical (test_motherboard_process.ProcessSourceTests.test_LED_IFT_screen_not_typical) ... ok
test_LVC2T45_B1_B2_not_mirrored (test_motherboard_process.ProcessSourceTests.test_LVC2T45_B1_B2_not_mirrored) ... ok
test_LVC2T45_direction_cannot_swap (test_motherboard_process.ProcessSourceTests.test_LVC2T45_direction_cannot_swap) ... ok
test_NO_process_not_250VAC_rating (test_motherboard_process.ProcessSourceTests.test_NO_process_not_250VAC_rating) ... ok
test_PROCESS_permission_loss_clears_latch (test_motherboard_process.ProcessSourceTests.test_PROCESS_permission_loss_clears_latch) ... ok
test_bidirectionalcontact_TVS_preserved (test_motherboard_process.ProcessSourceTests.test_bidirectionalcontact_TVS_preserved) ... ok
test_clamp_MOS_actual_G_S_D (test_motherboard_process.ProcessSourceTests.test_clamp_MOS_actual_G_S_D) ... ok
test_conditional50mA_limit_not_exact_max (test_motherboard_process.ProcessSourceTests.test_conditional50mA_limit_not_exact_max) ... ok
test_currentlimit_short_cannot_groundCL (test_motherboard_process.ProcessSourceTests.test_currentlimit_short_cannot_groundCL) ... ok
test_exact_native_source (test_motherboard_process.ProcessSourceTests.test_exact_native_source) ... ok
test_external_driver_output_not_FPGA3V3 (test_motherboard_process.ProcessSourceTests.test_external_driver_output_not_FPGA3V3) ... ok
test_gate_bias_cannot_pull_off_in_missingIO3 (test_motherboard_process.ProcessSourceTests.test_gate_bias_cannot_pull_off_in_missingIO3) ... ok
test_gate_sink_pushpull_not_open_drain (test_motherboard_process.ProcessSourceTests.test_gate_sink_pushpull_not_open_drain) ... ok
test_high_threshold100VMOS_not_low_voltage_clamp (test_motherboard_process.ProcessSourceTests.test_high_threshold100VMOS_not_low_voltage_clamp) ... ok
test_ideal5V_at20mA_claim_rejected (test_motherboard_process.ProcessSourceTests.test_ideal5V_at20mA_claim_rejected) ... ok
test_idealdiode_CE_cannot_ground_disable_RCB (test_motherboard_process.ProcessSourceTests.test_idealdiode_CE_cannot_ground_disable_RCB) ... ok
test_idealdiode_input_output_not_reversed (test_motherboard_process.ProcessSourceTests.test_idealdiode_input_output_not_reversed) ... ok
test_ignoredERC_not_accepted (test_motherboard_process.ProcessSourceTests.test_ignoredERC_not_accepted) ... ok
test_latchoff_aux_cannot_autoretry (test_motherboard_process.ProcessSourceTests.test_latchoff_aux_cannot_autoretry) ... ok
test_live_receiver_backfeed_not_motion_rail (test_motherboard_process.ProcessSourceTests.test_live_receiver_backfeed_not_motion_rail) ... ok
test_missing_controller_reset_inhibits_even_strobe (test_motherboard_process.ProcessSourceTests.test_missing_controller_reset_inhibits_even_strobe) ... ok
test_nativeXML_pin_drift_rejected (test_motherboard_process.ProcessSourceTests.test_nativeXML_pin_drift_rejected) ... ok
test_no_fitted_boundary_connector (test_motherboard_process.ProcessSourceTests.test_no_fitted_boundary_connector) ... ok
test_no_physical_measurement_from_ERC (test_motherboard_process.ProcessSourceTests.test_no_physical_measurement_from_ERC) ... ok
test_output_permission_return_needs_new_edge (test_motherboard_process.ProcessSourceTests.test_output_permission_return_needs_new_edge) ... ok
test_permissions_alone_do_not_arm (test_motherboard_process.ProcessSourceTests.test_permissions_alone_do_not_arm) ... ok
test_poweroff_clamp_not_only_software (test_motherboard_process.ProcessSourceTests.test_poweroff_clamp_not_only_software) ... ok
test_process_permission_return_needs_new_edge (test_motherboard_process.ProcessSourceTests.test_process_permission_return_needs_new_edge) ... ok
test_relay_LED_gate_independent_OFF (test_motherboard_process.ProcessSourceTests.test_relay_LED_gate_independent_OFF) ... ok
test_relay_contacts_never_grounded (test_motherboard_process.ProcessSourceTests.test_relay_contacts_never_grounded) ... ok
test_relay_supply_ON_not_tiedHIGH (test_motherboard_process.ProcessSourceTests.test_relay_supply_ON_not_tiedHIGH) ... ok
test_separate_process_latch_observation_real (test_motherboard_process.ProcessSourceTests.test_separate_process_latch_observation_real) ... ok
test_sourcing20mA_not_claimed80 (test_motherboard_process.ProcessSourceTests.test_sourcing20mA_not_claimed80) ... ok
test_unbounded1pct_aux_resistor_rejected (test_motherboard_process.ProcessSourceTests.test_unbounded1pct_aux_resistor_rejected) ... ok

----------------------------------------------------------------------
Ran 35 tests in 0.058s

OK
