DeadlySIn777/Controller/reports/motherboard-analog-input-20260930/tests-test_motherboard_di.py.txt

test_both_logic_ground_pins_required (test_motherboard_di.MotherboardInputTests.test_both_logic_ground_pins_required) ... ok
test_boundary_does_not_claim_fitted_sensor_limiter (test_motherboard_di.MotherboardInputTests.test_boundary_does_not_claim_fitted_sensor_limiter) ... ok
test_duplicate_general_channel_id_is_rejected (test_motherboard_di.MotherboardInputTests.test_duplicate_general_channel_id_is_rejected) ... ok
test_enable_must_be_tied_to_logic_supply (test_motherboard_di.MotherboardInputTests.test_enable_must_be_tied_to_logic_supply) ... ok
test_erc_only_retains_exact_twenty_four_substrate_warnings (test_motherboard_di.MotherboardInputTests.test_erc_only_retains_exact_twenty_four_substrate_warnings) ... ok
test_field_return_never_joins_logic_ground (test_motherboard_di.MotherboardInputTests.test_field_return_never_joins_logic_ground) ... ok
test_filter_cannot_move_before_threshold_resistor (test_motherboard_di.MotherboardInputTests.test_filter_cannot_move_before_threshold_resistor) ... ok
test_fixed_sinking_frontend_does_not_claim_auto_npn (test_motherboard_di.MotherboardInputTests.test_fixed_sinking_frontend_does_not_claim_auto_npn) ... ok
test_general_inputs_cannot_be_replaced_by_alarm_or_probe_channels (test_motherboard_di.MotherboardInputTests.test_general_inputs_cannot_be_replaced_by_alarm_or_probe_channels) ... ok
test_larger_filter_needs_new_timing_review (test_motherboard_di.MotherboardInputTests.test_larger_filter_needs_new_timing_review) ... ok
test_last_device_sense_current_pins_cannot_swap (test_motherboard_di.MotherboardInputTests.test_last_device_sense_current_pins_cannot_swap) ... ok
test_last_pair_and_channel_count_are_real (test_motherboard_di.MotherboardInputTests.test_last_pair_and_channel_count_are_real) ... ok
test_logic_outputs_cannot_consume_motor_alarm_name (test_motherboard_di.MotherboardInputTests.test_logic_outputs_cannot_consume_motor_alarm_name) ... ok
test_marketing_typical_current_does_not_replace_maximum (test_motherboard_di.MotherboardInputTests.test_marketing_typical_current_does_not_replace_maximum) ... ok
test_native_netlist_pin_mutation_not_hidden_by_unchanged_model (test_motherboard_di.MotherboardInputTests.test_native_netlist_pin_mutation_not_hidden_by_unchanged_model) ... ok
test_native_source_model_and_exact_footprint_match (test_motherboard_di.MotherboardInputTests.test_native_source_model_and_exact_footprint_match) ... ok
test_nc_pins_cannot_be_grounded (test_motherboard_di.MotherboardInputTests.test_nc_pins_cannot_be_grounded) ... ok
test_output_feed_is_not_a_direct_fpga_pin_allocation (test_motherboard_di.MotherboardInputTests.test_output_feed_is_not_a_direct_fpga_pin_allocation) ... ok
test_return_contacts_do_not_become_positive_supply (test_motherboard_di.MotherboardInputTests.test_return_contacts_do_not_become_positive_supply) ... ok
test_screens_are_not_certification_or_complete_latency (test_motherboard_di.MotherboardInputTests.test_screens_are_not_certification_or_complete_latency) ... ok
test_sensor_supply_limit_is_point_two_shared_group_not_point_five (test_motherboard_di.MotherboardInputTests.test_sensor_supply_limit_is_point_two_shared_group_not_point_five) ... ok
test_source_footprint_rejects_generic_nxp_land_geometry (test_motherboard_di.MotherboardInputTests.test_source_footprint_rejects_generic_nxp_land_geometry) ... ok
test_substrate_islands_cannot_be_grounded_or_joined (test_motherboard_di.MotherboardInputTests.test_substrate_islands_cannot_be_grounded_or_joined) ... ok
test_supply_contacts_nine_ten_share_one_group (test_motherboard_di.MotherboardInputTests.test_supply_contacts_nine_ten_share_one_group) ... ok
test_terminal_channel_mapping_cannot_shift (test_motherboard_di.MotherboardInputTests.test_terminal_channel_mapping_cannot_shift) ... ok
test_threshold_melf_cannot_be_replaced_by_plain_0603 (test_motherboard_di.MotherboardInputTests.test_threshold_melf_cannot_be_replaced_by_plain_0603) ... ok
test_unselected_boundary_cannot_enter_pcb_or_bom (test_motherboard_di.MotherboardInputTests.test_unselected_boundary_cannot_enter_pcb_or_bom) ... ok
test_weak_bias_does_not_guarantee_unpowered_low (test_motherboard_di.MotherboardInputTests.test_weak_bias_does_not_guarantee_unpowered_low) ... ok

----------------------------------------------------------------------
Ran 28 tests in 0.129s

OK
