DeadlySIn777/Controller/reports/motherboard-analog-wide-input-20260930/r02-tests-comms.txt

test_CAN_IRQ_always_on_host_injection (test_motherboard_comms.CommsTests.test_CAN_IRQ_always_on_host_injection) ... ok
test_CAN_IRQ_buffer_not_qualified (test_motherboard_comms.CommsTests.test_CAN_IRQ_buffer_not_qualified) ... ok
test_CAN_IRQ_buffer_wrong_direction (test_motherboard_comms.CommsTests.test_CAN_IRQ_buffer_wrong_direction) ... ok
test_CAN_STB_floating_start (test_motherboard_comms.CommsTests.test_CAN_STB_floating_start) ... ok
test_CAN_VSIN_wrong_filtered_node (test_motherboard_comms.CommsTests.test_CAN_VSIN_wrong_filtered_node) ... ok
test_CAN_bus_wrong_polarity (test_motherboard_comms.CommsTests.test_CAN_bus_wrong_polarity) ... ok
test_CAN_clock_missing (test_motherboard_comms.CommsTests.test_CAN_clock_missing) ... ok
test_CAN_clock_not_gated (test_motherboard_comms.CommsTests.test_CAN_clock_not_gated) ... ok
test_CAN_clock_wrong_rail (test_motherboard_comms.CommsTests.test_CAN_clock_wrong_rail) ... ok
test_CAN_controller_no_module_powercycle (test_motherboard_comms.CommsTests.test_CAN_controller_no_module_powercycle) ... ok
test_CAN_controller_reset_cannot_be_invented (test_motherboard_comms.CommsTests.test_CAN_controller_reset_cannot_be_invented) ... ok
test_CAN_controller_supervisor_wrong_pin (test_motherboard_comms.CommsTests.test_CAN_controller_supervisor_wrong_pin) ... ok
test_CAN_controller_voltage_abs_not_reset (test_motherboard_comms.CommsTests.test_CAN_controller_voltage_abs_not_reset) ... ok
test_CAN_controller_wrong_SPI_input (test_motherboard_comms.CommsTests.test_CAN_controller_wrong_SPI_input) ... ok
test_CAN_dominant_missing_module (test_motherboard_comms.CommsTests.test_CAN_dominant_missing_module) ... ok
test_CAN_fake_field_health (test_motherboard_comms.CommsTests.test_CAN_fake_field_health) ... ok
test_CAN_fault_pin_used_as_driven_enable (test_motherboard_comms.CommsTests.test_CAN_fault_pin_used_as_driven_enable) ... ok
test_CAN_module_good_inhibit_faked (test_motherboard_comms.CommsTests.test_CAN_module_good_inhibit_faked) ... ok
test_CAN_one_ground_not_joined (test_motherboard_comms.CommsTests.test_CAN_one_ground_not_joined) ... ok
test_CAN_rx_backpowers_controller (test_motherboard_comms.CommsTests.test_CAN_rx_backpowers_controller) ... ok
test_CAN_spi_health_strapped (test_motherboard_comms.CommsTests.test_CAN_spi_health_strapped) ... ok
test_CAN_spi_supply_unpowered_backfeed (test_motherboard_comms.CommsTests.test_CAN_spi_supply_unpowered_backfeed) ... ok
test_CAN_standby_unqualified (test_motherboard_comms.CommsTests.test_CAN_standby_unqualified) ... ok
test_CAN_switch_QOD_short_wrong (test_motherboard_comms.CommsTests.test_CAN_switch_QOD_short_wrong) ... ok
test_RS_fake_field_health (test_motherboard_comms.CommsTests.test_RS_fake_field_health) ... ok
test_RS_mismatched_TVS_claim (test_motherboard_comms.CommsTests.test_RS_mismatched_TVS_claim) ... ok
test_RS_unqualified_any_voltage (test_motherboard_comms.CommsTests.test_RS_unqualified_any_voltage) ... ok
test_TVS_wrong_common_ground (test_motherboard_comms.CommsTests.test_TVS_wrong_common_ground) ... ok
test_actual_cap_budget_stale (test_motherboard_comms.CommsTests.test_actual_cap_budget_stale) ... ok
test_boolean_default_gates (test_motherboard_comms.CommsTests.test_boolean_default_gates) ... ok
test_external_pins_gpio14_not_stolen (test_motherboard_comms.CommsTests.test_external_pins_gpio14_not_stolen) ... ok
test_ferrite_erases_field_isolation (test_motherboard_comms.CommsTests.test_ferrite_erases_field_isolation) ... ok
test_halfmegabit_part_cannot_claim_1M (test_motherboard_comms.CommsTests.test_halfmegabit_part_cannot_claim_1M) ... ok
test_health_default_high_variant (test_motherboard_comms.CommsTests.test_health_default_high_variant) ... ok
test_native_not_target (test_motherboard_comms.CommsTests.test_native_not_target) ... ok
test_native_source (test_motherboard_comms.CommsTests.test_native_source) ... ok
test_quad_TI125_unverified_IOFF (test_motherboard_comms.CommsTests.test_quad_TI125_unverified_IOFF) ... ok
test_rs_A_B_polarity (test_motherboard_comms.CommsTests.test_rs_A_B_polarity) ... ok
test_rs_compute_good_faked (test_motherboard_comms.CommsTests.test_rs_compute_good_faked) ... ok
test_rs_de_default_missing (test_motherboard_comms.CommsTests.test_rs_de_default_missing) ... ok
test_rs_de_unqualified (test_motherboard_comms.CommsTests.test_rs_de_unqualified) ... ok
test_rs_mode_5V_changed (test_motherboard_comms.CommsTests.test_rs_mode_5V_changed) ... ok
test_rs_receiver_disabled (test_motherboard_comms.CommsTests.test_rs_receiver_disabled) ... ok
test_term_always_enabled (test_motherboard_comms.CommsTests.test_term_always_enabled) ... ok

----------------------------------------------------------------------
Ran 44 tests in 0.033s

OK
