DeadlySIn777/Controller/reports/motherboard-compute-20260930/tests-r02.txt

test_CTS_primary_switch_land_dimensions_are_not_generic_guess (test_motherboard_compute.ComputeCarrierTests.test_CTS_primary_switch_land_dimensions_are_not_generic_guess) ... ok
test_SD_actual_bleed_and_unused_port_termination_mandatory (test_motherboard_compute.ComputeCarrierTests.test_SD_actual_bleed_and_unused_port_termination_mandatory) ... ok
test_SD_card_boot_hotswap_and_diagnostic_allocation_unproved (test_motherboard_compute.ComputeCarrierTests.test_SD_card_boot_hotswap_and_diagnostic_allocation_unproved) ... ok
test_SD_card_supply_or_pullups_cannot_use_alwaysonIO (test_motherboard_compute.ComputeCarrierTests.test_SD_card_supply_or_pullups_cannot_use_alwaysonIO) ... ok
test_SD_exact_currentcap_tolerance_cannot_raise_or_hide (test_motherboard_compute.ComputeCarrierTests.test_SD_exact_currentcap_tolerance_cannot_raise_or_hide) ... ok
test_SD_ground_pads_and_unused_ESD_channels_checked (test_motherboard_compute.ComputeCarrierTests.test_SD_ground_pads_and_unused_ESD_channels_checked) ... ok
test_SD_independent_manufacturer_package_pins_reject_input_output_swap (test_motherboard_compute.ComputeCarrierTests.test_SD_independent_manufacturer_package_pins_reject_input_output_swap) ... ok
test_SD_original52_complete_fitted_pins_unchanged (test_motherboard_compute.ComputeCarrierTests.test_SD_original52_complete_fitted_pins_unchanged) ... ok
test_SD_raw_host_cannot_bypass_disabled_mux (test_motherboard_compute.ComputeCarrierTests.test_SD_raw_host_cannot_bypass_disabled_mux) ... ok
test_SD_signal_enable_cannot_tie_actual_power_good_high (test_motherboard_compute.ComputeCarrierTests.test_SD_signal_enable_cannot_tie_actual_power_good_high) ... ok
test_actual_qualification_gate_cannot_tie_good_high (test_motherboard_compute.ComputeCarrierTests.test_actual_qualification_gate_cannot_tie_good_high) ... ok
test_blanket_socket_rating_does_not_become_2p5A_without_evidence (test_motherboard_compute.ComputeCarrierTests.test_blanket_socket_rating_does_not_become_2p5A_without_evidence) ... ok
test_buffer_output_cannot_drive_native_reset_or_readonly_service (test_motherboard_compute.ComputeCarrierTests.test_buffer_output_cannot_drive_native_reset_or_readonly_service) ... ok
test_complete_ground_set_cannot_lose_a_contact (test_motherboard_compute.ComputeCarrierTests.test_complete_ground_set_cannot_lose_a_contact) ... ok
test_exact_main_power_and_module_gpio_reference_reject_external_rail_substitution (test_motherboard_compute.ComputeCarrierTests.test_exact_main_power_and_module_gpio_reference_reject_external_rail_substitution) ... ok
test_low_default_or_auxiliary_bleed_cannot_disappear (test_motherboard_compute.ComputeCarrierTests.test_low_default_or_auxiliary_bleed_cannot_disappear) ... ok
test_mirrored_100pin_or_renumbered_socket_land_is_rejected (test_motherboard_compute.ComputeCarrierTests.test_mirrored_100pin_or_renumbered_socket_land_is_rejected) ... ok
test_module_reset_pin92_conflict_cannot_be_quietly_connected (test_motherboard_compute.ComputeCarrierTests.test_module_reset_pin92_conflict_cannot_be_quietly_connected) ... ok
test_native_source_and_exact_lands_pass (test_motherboard_compute.ComputeCarrierTests.test_native_source_and_exact_lands_pass) ... ok
test_one_custom_carrier_has_two_purchased_sockets_not_a_duplicate_soc (test_motherboard_compute.ComputeCarrierTests.test_one_custom_carrier_has_two_purchased_sockets_not_a_duplicate_soc) ... ok
test_qualified_BTT_or_manufacturing_claim_is_rejected (test_motherboard_compute.ComputeCarrierTests.test_qualified_BTT_or_manufacturing_claim_is_rejected) ... ok
test_selector_cannot_grant_power_motion_or_unimplemented_identity (test_motherboard_compute.ComputeCarrierTests.test_selector_cannot_grant_power_motion_or_unimplemented_identity) ... ok
test_spi_dual_cs_and_return_supply_are_checked_independently (test_motherboard_compute.ComputeCarrierTests.test_spi_dual_cs_and_return_supply_are_checked_independently) ... ok

----------------------------------------------------------------------
Ran 23 tests in 2.920s

OK
