DeadlySIn777/Controller/reports/motherboard-compute-20260930/tests-r04-live.txt

test_CTS_primary_switch_land_dimensions_are_not_generic_guess (test_motherboard_compute.ComputeCarrierTests.test_CTS_primary_switch_land_dimensions_are_not_generic_guess) ... ok
test_HDMI_55mA_normal_cannot_hide_200mA_short_or_claimmode (test_motherboard_compute.ComputeCarrierTests.test_HDMI_55mA_normal_cannot_hide_200mA_short_or_claimmode) ... ok
test_HDMI_PW_graphic_polarity_cannot_follow_grouped_table_guess (test_motherboard_compute.ComputeCarrierTests.test_HDMI_PW_graphic_polarity_cannot_follow_grouped_table_guess) ... ok
test_HDMI_control_cannot_tiehigh_or_use_externalIO_rail (test_motherboard_compute.ComputeCarrierTests.test_HDMI_control_cannot_tiehigh_or_use_externalIO_rail) ... ok
test_HDMI_exact89_previous_fitted_pins_and_footprints_preserved (test_motherboard_compute.ComputeCarrierTests.test_HDMI_exact89_previous_fitted_pins_and_footprints_preserved) ... ok
test_HDMI_issue5_shell_holes_reject_old_officialCAD_rear_1p7mm (test_motherboard_compute.ComputeCarrierTests.test_HDMI_issue5_shell_holes_reject_old_officialCAD_rear_1p7mm) ... ok
test_HDMI_pin1_signal_width_y_and_orientation_are_source_backed (test_motherboard_compute.ComputeCarrierTests.test_HDMI_pin1_signal_width_y_and_orientation_are_source_backed) ... ok
test_HDMI_shells_and_compound_reference_are_actual_separate_nets (test_motherboard_compute.ComputeCarrierTests.test_HDMI_shells_and_compound_reference_are_actual_separate_nets) ... ok
test_SD_actual_bleed_and_unused_port_termination_mandatory (test_motherboard_compute.ComputeCarrierTests.test_SD_actual_bleed_and_unused_port_termination_mandatory) ... ok
test_SD_card_boot_hotswap_and_diagnostic_allocation_unproved (test_motherboard_compute.ComputeCarrierTests.test_SD_card_boot_hotswap_and_diagnostic_allocation_unproved) ... ok
test_SD_card_supply_or_pullups_cannot_use_alwaysonIO (test_motherboard_compute.ComputeCarrierTests.test_SD_card_supply_or_pullups_cannot_use_alwaysonIO) ... ok
test_SD_exact_currentcap_tolerance_cannot_raise_or_hide (test_motherboard_compute.ComputeCarrierTests.test_SD_exact_currentcap_tolerance_cannot_raise_or_hide) ... ok
test_SD_ground_pads_and_unused_ESD_channels_checked (test_motherboard_compute.ComputeCarrierTests.test_SD_ground_pads_and_unused_ESD_channels_checked) ... ok
test_SD_independent_manufacturer_package_pins_reject_input_output_swap (test_motherboard_compute.ComputeCarrierTests.test_SD_independent_manufacturer_package_pins_reject_input_output_swap) ... ok
test_SD_original52_complete_fitted_pins_unchanged (test_motherboard_compute.ComputeCarrierTests.test_SD_original52_complete_fitted_pins_unchanged) ... ok
test_SD_raw_host_cannot_bypass_disabled_mux (test_motherboard_compute.ComputeCarrierTests.test_SD_raw_host_cannot_bypass_disabled_mux) ... ok
test_SD_signal_enable_cannot_tie_actual_power_good_high (test_motherboard_compute.ComputeCarrierTests.test_SD_signal_enable_cannot_tie_actual_power_good_high) ... ok
test_USB_MSOP_mux_cannot_use_UQFN_map_or_exchange_data_polarity (test_motherboard_compute.ComputeCarrierTests.test_USB_MSOP_mux_cannot_use_UQFN_map_or_exchange_data_polarity) ... ok
test_USB_OTG_role_buffer_has_module_own_supply (test_motherboard_compute.ComputeCarrierTests.test_USB_OTG_role_buffer_has_module_own_supply) ... ok
test_USB_S0IC_monitor_cannot_use_SOT23_pin_order_or_reverse_shunt (test_motherboard_compute.ComputeCarrierTests.test_USB_S0IC_monitor_cannot_use_SOT23_pin_order_or_reverse_shunt) ... ok
test_USB_actual_one_host_recovery_and_independent_pins_pass (test_motherboard_compute.ComputeCarrierTests.test_USB_actual_one_host_recovery_and_independent_pins_pass) ... ok
test_USB_driver_monitor_live_role_or_power_capacity_not_unproved (test_motherboard_compute.ComputeCarrierTests.test_USB_driver_monitor_live_role_or_power_capacity_not_unproved) ... ok
test_USB_manufacturer_shell_pitch_and_typeC_orientation_reject_guess (test_motherboard_compute.ComputeCarrierTests.test_USB_manufacturer_shell_pitch_and_typeC_orientation_reject_guess) ... ok
test_USB_only_three_reviewed_genuine_socketNC_promotions (test_motherboard_compute.ComputeCarrierTests.test_USB_only_three_reviewed_genuine_socketNC_promotions) ... ok
test_USB_polarized_cap_exact_F_case_cannot_use_E_case_land (test_motherboard_compute.ComputeCarrierTests.test_USB_polarized_cap_exact_F_case_cannot_use_E_case_land) ... ok
test_USB_previous97_fitted_pin_and_land_contract_preserved_except34_56_58 (test_motherboard_compute.ComputeCarrierTests.test_USB_previous97_fitted_pin_and_land_contract_preserved_except34_56_58) ... ok
test_USB_real_CC_Rd_default_off_and_ILIM_cannot_be_removed (test_motherboard_compute.ComputeCarrierTests.test_USB_real_CC_Rd_default_off_and_ILIM_cannot_be_removed) ... ok
test_USB_recovery_VBUS_never_joins_an_internal_supply (test_motherboard_compute.ComputeCarrierTests.test_USB_recovery_VBUS_never_joins_an_internal_supply) ... ok
test_USB_role_permission_cannot_bypass_real_good_or_connect (test_motherboard_compute.ComputeCarrierTests.test_USB_role_permission_cannot_bypass_real_good_or_connect) ... ok
test_USB_shunt_and_current_limit_are_hardware_not_a_metadata_claim (test_motherboard_compute.ComputeCarrierTests.test_USB_shunt_and_current_limit_are_hardware_not_a_metadata_claim) ... ok
test_actual_qualification_gate_cannot_tie_good_high (test_motherboard_compute.ComputeCarrierTests.test_actual_qualification_gate_cannot_tie_good_high) ... ok
test_blanket_socket_rating_does_not_become_2p5A_without_evidence (test_motherboard_compute.ComputeCarrierTests.test_blanket_socket_rating_does_not_become_2p5A_without_evidence) ... ok
test_buffer_output_cannot_drive_native_reset_or_readonly_service (test_motherboard_compute.ComputeCarrierTests.test_buffer_output_cannot_drive_native_reset_or_readonly_service) ... ok
test_complete_ground_set_cannot_lose_a_contact (test_motherboard_compute.ComputeCarrierTests.test_complete_ground_set_cannot_lose_a_contact) ... ok
test_exact_main_power_and_module_gpio_reference_reject_external_rail_substitution (test_motherboard_compute.ComputeCarrierTests.test_exact_main_power_and_module_gpio_reference_reject_external_rail_substitution) ... ok
test_low_default_or_auxiliary_bleed_cannot_disappear (test_motherboard_compute.ComputeCarrierTests.test_low_default_or_auxiliary_bleed_cannot_disappear) ... ok
test_mirrored_100pin_or_renumbered_socket_land_is_rejected (test_motherboard_compute.ComputeCarrierTests.test_mirrored_100pin_or_renumbered_socket_land_is_rejected) ... ok
test_module_reset_pin92_conflict_cannot_be_quietly_connected (test_motherboard_compute.ComputeCarrierTests.test_module_reset_pin92_conflict_cannot_be_quietly_connected) ... ok
test_native_board_silkscreen_rule_rejects_prior_compute_annotation_defect (test_motherboard_compute.ComputeCarrierTests.test_native_board_silkscreen_rule_rejects_prior_compute_annotation_defect) ... ok
test_native_source_and_exact_lands_pass (test_motherboard_compute.ComputeCarrierTests.test_native_source_and_exact_lands_pass) ... ok
test_one_custom_carrier_has_two_purchased_sockets_not_a_duplicate_soc (test_motherboard_compute.ComputeCarrierTests.test_one_custom_carrier_has_two_purchased_sockets_not_a_duplicate_soc) ... ok
test_qualified_BTT_or_manufacturing_claim_is_rejected (test_motherboard_compute.ComputeCarrierTests.test_qualified_BTT_or_manufacturing_claim_is_rejected) ... ok
test_selector_cannot_grant_power_motion_or_unimplemented_identity (test_motherboard_compute.ComputeCarrierTests.test_selector_cannot_grant_power_motion_or_unimplemented_identity) ... ok
test_spi_dual_cs_and_return_supply_are_checked_independently (test_motherboard_compute.ComputeCarrierTests.test_spi_dual_cs_and_return_supply_are_checked_independently) ... ok

----------------------------------------------------------------------
Ran 44 tests in 9.100s

OK
