DeadlySIn777/Controller/reports/motherboard-compute-20260930/tests-r05-live.txt

......................................................
----------------------------------------------------------------------
Ran 54 tests in 21.564s

OK
