DeadlySIn777/Controller/reports/motherboard-di-20260930/historical-baseline-tests.txt

test_actual_netlist_mutation_not_hidden_by_model (test_digital_inputs.DigitalInputTests.test_actual_netlist_mutation_not_hidden_by_model) ... ok
test_bias_does_not_establish_unpowered_default (test_digital_inputs.DigitalInputTests.test_bias_does_not_establish_unpowered_default) ... ok
test_both_logic_ground_pins_required (test_digital_inputs.DigitalInputTests.test_both_logic_ground_pins_required) ... ok
test_bounded_screens_are_not_timing_or_certification (test_digital_inputs.DigitalInputTests.test_bounded_screens_are_not_timing_or_certification) ... ok
test_common_return_does_not_provide_channel_isolation (test_digital_inputs.DigitalInputTests.test_common_return_does_not_provide_channel_isolation) ... ok
test_cross_domain_return_is_rejected (test_digital_inputs.DigitalInputTests.test_cross_domain_return_is_rejected) ... ok
test_current_bound_cannot_use_marketing_typical_value (test_digital_inputs.DigitalInputTests.test_current_bound_cannot_use_marketing_typical_value) ... ok
test_duplicate_input_id (test_digital_inputs.DigitalInputTests.test_duplicate_input_id) ... ok
test_enable_cannot_float_or_take_field_voltage (test_digital_inputs.DigitalInputTests.test_enable_cannot_float_or_take_field_voltage) ... ok
test_erc_only_allows_exact_22_floating_island_warnings (test_digital_inputs.DigitalInputTests.test_erc_only_allows_exact_22_floating_island_warnings) ... ok
test_filter_before_resistor_is_detected (test_digital_inputs.DigitalInputTests.test_filter_before_resistor_is_detected) ... ok
test_filter_latency_change_requires_review (test_digital_inputs.DigitalInputTests.test_filter_latency_change_requires_review) ... ok
test_frozen_circuit_and_real_exports_match (test_digital_inputs.DigitalInputTests.test_frozen_circuit_and_real_exports_match) ... ok
test_frozen_ledger_tamper_is_rejected (test_digital_inputs.DigitalInputTests.test_frozen_ledger_tamper_is_rejected) ... ok
test_home_and_probe_assignments_cannot_swap (test_digital_inputs.DigitalInputTests.test_home_and_probe_assignments_cannot_swap) ... ok
test_ledger_common_terminal_must_remain_ground (test_digital_inputs.DigitalInputTests.test_ledger_common_terminal_must_remain_ground) ... ok
test_malformed_resistor_values_rejected (test_digital_inputs.DigitalInputTests.test_malformed_resistor_values_rejected) ... ok
test_nc_pin_cannot_be_connected (test_digital_inputs.DigitalInputTests.test_nc_pin_cannot_be_connected) ... ok
test_no_invented_connector_number (test_digital_inputs.DigitalInputTests.test_no_invented_connector_number) ... ok
test_no_silent_expansion (test_digital_inputs.DigitalInputTests.test_no_silent_expansion) ... ok
test_port_voltage_cannot_be_silently_expanded (test_digital_inputs.DigitalInputTests.test_port_voltage_cannot_be_silently_expanded) ... ok
test_sense_and_current_input_pins_cannot_swap (test_digital_inputs.DigitalInputTests.test_sense_and_current_input_pins_cannot_swap) ... ok
test_substrate_islands_cannot_be_grounded_or_joined (test_digital_inputs.DigitalInputTests.test_substrate_islands_cannot_be_grounded_or_joined) ... ok
test_support_ratings_and_values_checked (test_digital_inputs.DigitalInputTests.test_support_ratings_and_values_checked) ... ok
test_threshold_pulse_resistor_cannot_be_plain_0603 (test_digital_inputs.DigitalInputTests.test_threshold_pulse_resistor_cannot_be_plain_0603) ... ok
test_threshold_resistor_bypass_is_detected (test_digital_inputs.DigitalInputTests.test_threshold_resistor_bypass_is_detected) ... ok

----------------------------------------------------------------------
Ran 26 tests in 0.105s

OK
