DeadlySIn777/Controller/reports/motherboard-fpga-allocation-20260930/historical-fpga-core-tests.txt

test_actual_netlist_and_erc_match_reviewed_candidate (test_fpga_core.FpgaCoreTests.test_actual_netlist_and_erc_match_reviewed_candidate) ... ok
test_bad_capacitor_voltage (test_fpga_core.FpgaCoreTests.test_bad_capacitor_voltage) ... ok
test_bank_supply_cannot_be_left_unconnected (test_fpga_core.FpgaCoreTests.test_bank_supply_cannot_be_left_unconnected) ... ok
test_bypass_must_be_at_its_named_supply_ball (test_fpga_core.FpgaCoreTests.test_bypass_must_be_at_its_named_supply_ball) ... ok
test_cdones_pullup_may_not_be_5v (test_fpga_core.FpgaCoreTests.test_cdones_pullup_may_not_be_5v) ... ok
test_clock_ordinary_pin_swap_is_detected (test_fpga_core.FpgaCoreTests.test_clock_ordinary_pin_swap_is_detected) ... ok
test_configuration_pin_reuse_is_detected (test_fpga_core.FpgaCoreTests.test_configuration_pin_reuse_is_detected) ... ok
test_core_pin_cannot_receive_3v3 (test_fpga_core.FpgaCoreTests.test_core_pin_cannot_receive_3v3) ... ok
test_dual_assignment_collision_is_detected (test_fpga_core.FpgaCoreTests.test_dual_assignment_collision_is_detected) ... ok
test_erasing_pin_source_hash_is_detected (test_fpga_core.FpgaCoreTests.test_erasing_pin_source_hash_is_detected) ... ok
test_exported_package_pin_name_mutation_detected (test_fpga_core.FpgaCoreTests.test_exported_package_pin_name_mutation_detected) ... ok
test_flash_mosi_miso_swap (test_fpga_core.FpgaCoreTests.test_flash_mosi_miso_swap) ... ok
test_independent_xlsx_extract_has_all_balls (test_fpga_core.FpgaCoreTests.test_independent_xlsx_extract_has_all_balls) ... ok
test_insufficient_support_budget (test_fpga_core.FpgaCoreTests.test_insufficient_support_budget) ... ok
test_logic_net_collision_is_detected (test_fpga_core.FpgaCoreTests.test_logic_net_collision_is_detected) ... ok
test_manufacturing_claim_refused (test_fpga_core.FpgaCoreTests.test_manufacturing_claim_refused) ... ok
test_missing_configuration_strap (test_fpga_core.FpgaCoreTests.test_missing_configuration_strap) ... ok
test_missing_ground_ball (test_fpga_core.FpgaCoreTests.test_missing_ground_ball) ... ok
test_native_lvds_reference_not_arbitrarily_grounded (test_fpga_core.FpgaCoreTests.test_native_lvds_reference_not_arbitrarily_grounded) ... ok
test_native_reset_buffer_symbol_pin_swap_rejected (test_fpga_core.FpgaCoreTests.test_native_reset_buffer_symbol_pin_swap_rejected) ... ok
test_nexperia_gw_physical_pin_fixture_matches_primary_datasheet (test_fpga_core.FpgaCoreTests.test_nexperia_gw_physical_pin_fixture_matches_primary_datasheet) ... ok
test_nonfinite_capacitance (test_fpga_core.FpgaCoreTests.test_nonfinite_capacitance) ... ok
test_previous_bad_pin_map_rejected_even_with_mirrored_support_expectation (test_fpga_core.FpgaCoreTests.test_previous_bad_pin_map_rejected_even_with_mirrored_support_expectation) ... ok
test_pushpull_service_reset_cannot_short_sequencer (test_fpga_core.FpgaCoreTests.test_pushpull_service_reset_cannot_short_sequencer) ... ok
test_reset_buffer_native_conductors_follow_physical_package (test_fpga_core.FpgaCoreTests.test_reset_buffer_native_conductors_follow_physical_package) ... ok
test_stale_or_modified_native_netlist_is_detected (test_fpga_core.FpgaCoreTests.test_stale_or_modified_native_netlist_is_detected) ... ok
test_support_current_and_capacitance_screen (test_fpga_core.FpgaCoreTests.test_support_current_and_capacitance_screen) ... ok
test_suppressed_erc_check_is_detected (test_fpga_core.FpgaCoreTests.test_suppressed_erc_check_is_detected) ... ok
test_twelve_motor_and_four_encoder_unique_pin_capacity (test_fpga_core.FpgaCoreTests.test_twelve_motor_and_four_encoder_unique_pin_capacity) ... ok
test_user_reset_must_follow_local_service_reset (test_fpga_core.FpgaCoreTests.test_user_reset_must_follow_local_service_reset) ... ok

----------------------------------------------------------------------
Ran 30 tests in 0.495s

OK
