DeadlySIn777/Controller/reports/motherboard-fpga-source-20260930/tests-test_motherboard_fast_inputs.py.txt

test_5V_port_rails_cannot_be_unprotected_or_cross_connected (test_motherboard_fast_inputs.MotherboardFastInputTests.test_5V_port_rails_cannot_be_unprotected_or_cross_connected) ... ok
test_TTL_MPG_cannot_silently_gain_120ohm_reference_loading (test_motherboard_fast_inputs.MotherboardFastInputTests.test_TTL_MPG_cannot_silently_gain_120ohm_reference_loading) ... ok
test_all_four_ABZ_and_frequency_MPG_paths_match_native_mapping (test_motherboard_fast_inputs.MotherboardFastInputTests.test_all_four_ABZ_and_frequency_MPG_paths_match_native_mapping) ... ok
test_chassis_cannot_be_shortened_to_logic_ground_by_annotation (test_motherboard_fast_inputs.MotherboardFastInputTests.test_chassis_cannot_be_shortened_to_logic_ground_by_annotation) ... ok
test_differential_pair_polarity_swap_is_rejected (test_motherboard_fast_inputs.MotherboardFastInputTests.test_differential_pair_polarity_swap_is_rejected) ... ok
test_enables_must_be_always_on_without_floating_logic (test_motherboard_fast_inputs.MotherboardFastInputTests.test_enables_must_be_always_on_without_floating_logic) ... ok
test_frequency_and_MPG_feedback_swap_is_rejected (test_motherboard_fast_inputs.MotherboardFastInputTests.test_frequency_and_MPG_feedback_swap_is_rejected) ... ok
test_missing_local_bypass_is_rejected (test_motherboard_fast_inputs.MotherboardFastInputTests.test_missing_local_bypass_is_rejected) ... ok
test_package_and_pin_count_cannot_be_silently_substituted (test_motherboard_fast_inputs.MotherboardFastInputTests.test_package_and_pin_count_cannot_be_silently_substituted) ... ok
test_physical_qualification_and_arithmetic_must_not_be_invented (test_motherboard_fast_inputs.MotherboardFastInputTests.test_physical_qualification_and_arithmetic_must_not_be_invented) ... ok
test_source_model_pin_and_physical_flag_must_match_native_XML (test_motherboard_fast_inputs.MotherboardFastInputTests.test_source_model_pin_and_physical_flag_must_match_native_XML) ... ok
test_termination_cannot_be_shortened_or_underpowered (test_motherboard_fast_inputs.MotherboardFastInputTests.test_termination_cannot_be_shortened_or_underpowered) ... ok
test_unknown_connector_cannot_become_fitted_by_clearing_boundary_flags (test_motherboard_fast_inputs.MotherboardFastInputTests.test_unknown_connector_cannot_become_fitted_by_clearing_boundary_flags) ... ok

----------------------------------------------------------------------
Ran 13 tests in 0.035s

OK
