DeadlySIn777/Controller/reports/motherboard-integration-20260930/r17c-focused-tests-r02.txt

.......................................
----------------------------------------------------------------------
Ran 39 tests in 12.036s

OK
