DeadlySIn777/Controller/reports/motherboard-integration-20260930/r17c-focused-tests.txt

.........................F.............
======================================================================
FAIL: test_overvoltage_series_resistor_is_an_electrical_endpoint (test_motherboard_integration.MotherboardIntegrationTests.test_overvoltage_series_resistor_is_an_electrical_endpoint)
----------------------------------------------------------------------
Traceback (most recent call last):
  File "C:\Users\Gluis\OneDrive\Documents\ChatGPT\Controller\tests\test_motherboard_integration.py", line 173, in test_overvoltage_series_resistor_is_an_electrical_endpoint
    self.assertTrue(any('New source pin/net mismatch R9007.1' in e for e in self.run_check()))
    ~~~~~~~~~~~~~~~^^^^^^^^^^^^^^^^^^^^^^^^^^^^^^^^^^^^^^^^^^^^^^^^^^^^^^^^^^^^^^^^^^^^^^^^^^^
AssertionError: False is not true

----------------------------------------------------------------------
Ran 39 tests in 12.929s

FAILED (failures=1)
