DeadlySIn777/Controller/reports/motherboard-integration-20260930/r18-focused-tests.txt

..........................................
----------------------------------------------------------------------
Ran 42 tests in 16.253s

OK
