DeadlySIn777/Controller/reports/motherboard-integration-20260930/r19-focused-tests-r02.txt

test_a_removed_retained_fitted_pin_is_rejected (test_motherboard_integration.MotherboardIntegrationTests.test_a_removed_retained_fitted_pin_is_rejected) ... ok
test_actual_motor_receiving_pin_change_is_rejected (test_motherboard_integration.MotherboardIntegrationTests.test_actual_motor_receiving_pin_change_is_rejected) ... ok
test_actual_output_latch_is_observed (test_motherboard_integration.MotherboardIntegrationTests.test_actual_output_latch_is_observed) ... ok
test_actual_reset_buffer_reaches_output_permission (test_motherboard_integration.MotherboardIntegrationTests.test_actual_reset_buffer_reaches_output_permission) ... ok
test_ai_alias_cannot_hide_missing_actual_acquisition (test_motherboard_integration.MotherboardIntegrationTests.test_ai_alias_cannot_hide_missing_actual_acquisition) ... ok
test_analog_cs_alias_cannot_hide_disconnected_dac_control (test_motherboard_integration.MotherboardIntegrationTests.test_analog_cs_alias_cannot_hide_disconnected_dac_control) ... ok
test_analog_readback_cannot_be_connected_to_output_command (test_motherboard_integration.MotherboardIntegrationTests.test_analog_readback_cannot_be_connected_to_output_command) ... ok
test_can_clock_alias_cannot_hide_a_disconnected_controller (test_motherboard_integration.MotherboardIntegrationTests.test_can_clock_alias_cannot_hide_a_disconnected_controller) ... ok
test_clear_fanout_cannot_drive_retained_push_pull_output (test_motherboard_integration.MotherboardIntegrationTests.test_clear_fanout_cannot_drive_retained_push_pull_output) ... ok
test_clear_request_default_high_is_rejected (test_motherboard_integration.MotherboardIntegrationTests.test_clear_request_default_high_is_rejected) ... ok
test_communications_good_cannot_be_replaced_by_constant_healthy (test_motherboard_integration.MotherboardIntegrationTests.test_communications_good_cannot_be_replaced_by_constant_healthy) ... ok
test_custom_unquoted_precision_value_cannot_replace_stock_window_part (test_motherboard_integration.MotherboardIntegrationTests.test_custom_unquoted_precision_value_cannot_replace_stock_window_part) ... ok
test_digital_input_alias_cannot_hide_isolated_acquisition_stub (test_motherboard_integration.MotherboardIntegrationTests.test_digital_input_alias_cannot_hide_isolated_acquisition_stub) ... ok
test_distributed_logic_plane_cannot_bypass_real_damping (test_motherboard_integration.MotherboardIntegrationTests.test_distributed_logic_plane_cannot_bypass_real_damping) ... ok
test_exact64_former_fpga_nc_promotions_are_bounded (test_motherboard_integration.MotherboardIntegrationTests.test_exact64_former_fpga_nc_promotions_are_bounded) ... ok
test_exact_manufacturer_pin_footprint_binding_is_required (test_motherboard_integration.MotherboardIntegrationTests.test_exact_manufacturer_pin_footprint_binding_is_required) ... ok
test_final_motor_contact_cannot_be_bypassed (test_motherboard_integration.MotherboardIntegrationTests.test_final_motor_contact_cannot_be_bypassed) ... ok
test_former_nc_cannot_be_promoted_to_a_wrong_field (test_motherboard_integration.MotherboardIntegrationTests.test_former_nc_cannot_be_promoted_to_a_wrong_field) ... ok
test_home_cannot_be_reconnected_as_unrouted_required_signal (test_motherboard_integration.MotherboardIntegrationTests.test_home_cannot_be_reconnected_as_unrouted_required_signal) ... ok
test_identity_mux_cannot_hide_missing_acc_gpio (test_motherboard_integration.MotherboardIntegrationTests.test_identity_mux_cannot_hide_missing_acc_gpio) ... ok
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
