DeadlySIn777/Controller/hardware/octopus_external_adapter/r0_2/silk-validation/candidate.png

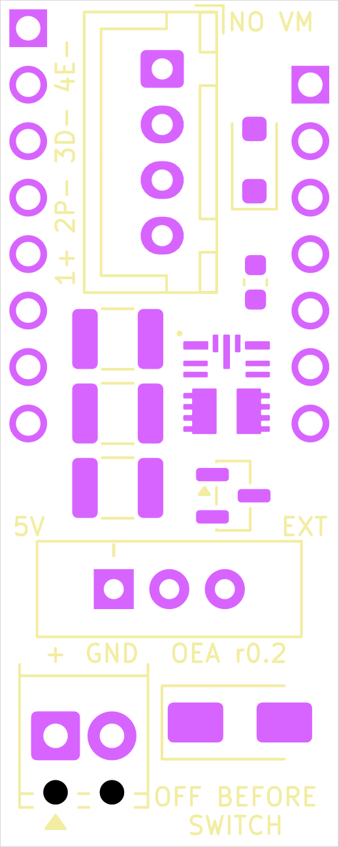
hardware/octopus_external_adapter/r0_2/silk-validation/candidate.png
