DeadlySIn777/Controller/hardware/board_review/revisions/20260930-21/publication-connectivity.txt

{"board_sha256": "5186e1b6578869505f19b17fee5e531ac132d14dec05eef8df1e09d5b785f5bb", "source_net_checks_pass": true, "errors": [], "footprints": 880, "fitted_pads": 3317, "track_via_items": 2088, "declared_native_NC_pads": 120, "stencil_only_non_electrical_pads": 228, "nets_requiring_multiple_fitted_pads": 637, "fully_joined_multiple_pad_nets": 90, "incomplete_multiple_pad_nets": 547, "uncapped_unconnected_ratsnest_edges": 1600, "independent_physical_cluster_missing_joins": 1600, "orphan_copper_items": [], "manufacturing_ready": false, "complete_source_population_checked": true, "source_physical_footprints": 880, "source_footprints_missing_on_board_count": 0, "complete_source_population_pass": true, "scope": "Fitted source pins only; missing circuits/connectors cannot be treated as NC or as completed interfaces."}
