DeadlySIn777/Controller/hardware/board_review/revisions/20260930-24/connectivity-command.txt

{"board_sha256": "c5f109b95261d5e57a3e3eae76eb7fa368e08afee8d0a91dacc906c23640e306", "source_net_checks_pass": true, "errors": [], "footprints": 2688, "fitted_pads": 9498, "track_via_items": 8051, "declared_native_NC_pads": 597, "stencil_only_non_electrical_pads": 332, "nets_requiring_multiple_fitted_pads": 1734, "fully_joined_multiple_pad_nets": 556, "incomplete_multiple_pad_nets": 1178, "uncapped_unconnected_ratsnest_edges": 4753, "independent_physical_cluster_missing_joins": 4753, "orphan_copper_items": [], "manufacturing_ready": false, "complete_source_population_checked": true, "source_physical_footprints": 2688, "source_footprints_missing_on_board_count": 0, "complete_source_population_pass": true, "scope": "Fitted source pins only; missing circuits/connectors cannot be treated as NC or as completed interfaces."}
