DeadlySIn777/Controller/hardware/board_review/revisions/20261001-28/connectivity-command.txt

{"board_sha256": "769541d11876ea0050240ec065f6b0b85bff19c7c8324f1c26b9b637212a8af5", "source_net_checks_pass": true, "errors": [], "footprints": 2688, "fitted_pads": 9498, "track_via_items": 11641, "declared_native_NC_pads": 597, "stencil_only_non_electrical_pads": 332, "nets_requiring_multiple_fitted_pads": 1734, "fully_joined_multiple_pad_nets": 632, "incomplete_multiple_pad_nets": 1102, "uncapped_unconnected_ratsnest_edges": 3524, "independent_physical_cluster_missing_joins": 3524, "orphan_copper_items": [], "manufacturing_ready": false, "complete_source_population_checked": true, "source_physical_footprints": 2688, "source_footprints_missing_on_board_count": 0, "complete_source_population_pass": true, "scope": "Fitted source pins only; missing circuits/connectors cannot be treated as NC or as completed interfaces."}
