DeadlySIn777/Controller/reports/motherboard-architecture-transition-20260930/planning-docs-before/docs/MODULAR_REPAIR_AND_MEMORY.md

# Replaceable electronics and machine memory

28 September 2026, requirements reconciled 30 September 2026. **Product requirement:** a supported failed section should be replaceable without disconnecting individual field wires, losing the machine setup, or manually programming its replacement. The adopted architecture is a fixed wiring base with field terminals that remain in place and a replaceable FPGA motion card containing its clock, configuration flash and supervisory circuitry. Keyed pluggable terminal groups may also help replace the base itself; they no longer substitute for the adopted removable-card architecture. A legitimate replacement of a compute, motion, I/O or service module must preserve the customer's existing paid software entitlement; the same software is not purchased again solely because the designated module was exchanged. A new capability expansion can have its own clearly stated entitlement. This document specifies the architecture and acceptance work; it does not establish a completed cartridge, backplane, update system, licence system or qualified replaceable board. The unchanged [user source](../research/user-notes/2026-09-28-repairability-memory.txt) is preserved separately. See [project memory](../PROJECT_MEMORY.md) for later superseding decisions and the [commercial model and licensing policy](COMMERCIAL_MODEL_AND_LICENSING.md).

Keep the historical six-step/two-encoder implementation and electrical study distinct from the required eight-standard/four-plug-in motor scope and retained four-encoder design study. Individual enable/alarm on all motors, 24 general DI/16 general DO and the 20 ms fault-to-inhibit bound are preserved. Modularity does not expand current runtime channels or make the design ready for manufacture. All [screen sizes](DISPLAY_TIERS.md) use the same service principles; a small display does not remove repairability. US$400 is a preliminary controller-assembly reference, with complete screen and other kits separately costed.

## 1. Wiring remains with the machine

Use **the adopted fixed wiring base with keyed, retained service cards**. Individual field terminals and wires remain with the machine while the approved card is exchanged. The earlier budget-first whole-board/pluggable-terminal comparison is superseded as a product choice; retain its economics as historical reference only. Select connector families, grouped module boundaries and support circuits from complete connector, PCB, assembly, enclosure and test costs within the adopted architecture.

| Boundary | Initial design direction | Feasibility and cost gate |
|---|---|---|
| Linux compute | Qualified replaceable compute module with supplied boot image | Exact CM4, CM5 or alternative variant, carrier pin mapping, cooling, boot media, OS/driver and workload qualification; connector shape is insufficient |
| Motion core | Adopted replaceable FPGA motion card, including clock, configuration flash and supervisory circuitry, behind the fixed wiring base | Dedicated timing link, reset/inhibit paths, connector integrity, timing and boot-default proof; exact card/connector/circuit implementation remains unfinished |
| Field I/O | Grouped protected input/output banks, where failures and cost justify separate boards | Common connector contract, electrical domains, output ownership, branch containment and detection; one tiny board per signal is not the target |
| Process interfaces | Separate qualified plasma/THC, VFD or other specialty interfaces where their electrical requirements justify it | Existing [plasma](PLASMA_MODULE_SYSTEM.md) and [third-party Modbus](THIRD_PARTY_MODBUS.md) contracts; ordinary compatible serial equipment remains usable |
| Power and service | Serviceable power/protection and ESP section; compare combined versus separate assembly | Protective boundaries and watchdog independence are electrical requirements even if components share one PCB; added interconnects must not defeat those boundaries |
| Machine memory | Protected removable cartridge that stays with the machine | Capacity, endurance, fault isolation, keyed connector, record protocol and recovery qualification below |

Key the groups by electrical function and voltage domain, not merely color. Prevent a power plug fitting a signal group or an electrically incompatible module accepting a seemingly identical plug. Include legible slot/terminal identifiers, orientation, retention, wire-gauge/torque and service-access requirements. Require a defined interconnect for differential motion/encoder signals; a generic I/O backplane is not automatically suitable for them.

The adopted fixed base adds a backplane/terminal PCB or equivalent assembly, board-to-board connectors, mechanical retention, identification, grounding and its own failure modes. It also must be replaceable without trapping the customer's installation behind an unavailable part. Do not hide those costs inside a connector allowance. Review failure rates, replacement labor and spare-part price alongside initial manufacture.

For serialized general I/O cards, preserve all 24 general inputs and 16 general outputs. A receiver validates card identity, expected sequence/freshness and CRC before applying a changed output state. Missing, stale, corrupt or wrong-card traffic cannot replay an old state; direct protective permission still acts independently. Marker-only shift-register framing and a watchdog do not satisfy that integrity contract. Exact implementation and physical timing remain qualification work.

## 2. Separate settings, calibration and executable software

| Information | Primary home | Replacement rule |
|---|---|---|
| Complete supported machine configuration | Machine cartridge, committed local mirror and exportable backup | Preserve machine identity, axis/channel assignments, scales, travel/velocity/acceleration limits, homing, polarity/timing, resource ownership, device/process profiles, approved sequences, automation dependencies and schema/software requirements |
| Module identity and factory calibration | Replacement module's own factory record | Read its class, serial/revision, rated capabilities and its own calibration/provenance; never copy the failed module's calibration onto different electronics |
| Complete-chain verification | Machine configuration/evidence, bound to all relevant module/harness/source identities | A changed module can invalidate the measurement chain even when its factory calibration is valid |
| Firmware, gateware and Linux image | Relevant module's programmed storage plus compatible local recovery packages | Replacement ships programmed; version negotiation and a verified offline package address a needed update |
| CAD models, toolpaths, large job files and optional recovery-image archives | Main storage and external backup; larger cartridge storage only if explicitly included | State what the package protects. A settings-only cartridge must not be sold as recovering an entire failed computer's files |
| Live permissions and position confidence | Runtime only | Never restore arm/run commands, active jog, torque permission, homed state or live workpiece registration merely because saved data is valid |

The cartridge must carry the data needed to reconstruct its advertised machine setup, not just a pathname, cloud link, checksum or ID pointing to a failed computer. A dependency manifest names required compatible software and profiles; the supported replacement image supplies those packages offline. For user-authored recipes/macros or custom profiles required by the setup, include their actual bounded contents or declare a larger storage variant. A pointer to missing user content does not meet the recovery promise.

The machine-bound licence record is separate from module identity and factory calibration. Store enough signed/offline-verifiable entitlement information in the protected machine recovery package or an equivalent local authority that a supported replacement can restore the already purchased software after compatibility checks. Do not bind the entitlement only to the failed compute or motion-card serial. A new expansion capability may require an additional licence, but a same-capability approved spare does not.

Imported macros are data awaiting validation and deliberate execution. Configuration restore does not run them. Electrical maxima come from qualified installed hardware and supported profiles; imported limits can reduce these maxima but cannot increase them. The common [configuration service](CONFIGURATION_AND_CLI.md) supplies validation, structured preview/diff, apply and export to both CLI and future UI.

Factory records need provenance, calibration method/range/units and dependency identity. CRC or a content hash detects accidental corruption; it does not authenticate a supplier, establish measurement accuracy, or prove correct wiring. Define a signed manufacturer descriptor/calibration policy, key provisioning and separately labeled developer/third-party qualification route before production. Openness of the design does not make an arbitrary self-declared capability a measured electrical rating.

## 3. Select storage from the actual recovery payload

No storage IC or capacity is selected. Current compact canonical UTF-8 serialization using `controller_config.service.canonical(controller_config.model.profile(...))` measures **6,680 bytes for `sim-mill-3axis` and 4,562 bytes for `sim-lathe-2axis`**. These are existing virtual profiles, not full future machine recovery packages. Two copies of the larger profile alone occupy 13,360 bytes before any transaction/header/descriptor overhead.

The Microchip **24LC256 is 32,768 bytes**, not 256 kilobytes. It has 64-byte write pages, whole-array hardware write protection and a maximum 5 ms byte/page write cycle. Writes crossing a page boundary wrap within that page, so the driver must split them. Endurance is per page; its table specifies 1,000,000 cycles at +25°C, 5.5 V in page mode. WP is sampled at the write Stop condition, and a protected write can still acknowledge. Readback is therefore essential. These device facts do not prove our power-loss behavior. [Microchip DS20001203Y, pages 1, 5 and 11](https://ww1.microchip.com/downloads/aemDocuments/documents/MPD/ProductDocuments/DataSheets/24AA256-24LC256-24FC256-256K-I2C-Serial-EEPROM-DS20001203.pdf)

For scale, the Infineon FM24V02A is also 32 KiB. Its specified endurance is 10^14 read/write cycles with writes performed at bus speed. Retention is temperature-dependent: 10 years at 85°C, 38 at 75°C, or 151 at 65°C. FRAM can suit frequent counters, but it does not make a multi-byte application record atomic or eliminate a second valid copy. [FM24V02A datasheet, pages 1 and 12](https://www.infineon.com/assets/row/public/documents/10/49/infineon-fm24v02a-256-kbit-32k-8-serial-i2c-f-ram-datasheet-en.pdf)

Use the following capacity gate before selecting EEPROM, FRAM or flash:

```text
usable bytes >= 2 × aligned(maximum supported recovery payload + record envelope)
                + independently reserved identity/format metadata
                + required migration/recovery workspace
```

The envelope includes machine/cartridge lineage, format/schema, generation, previous-record hash, exact lengths, compatibility manifest, content integrity and commit metadata. Account for alignment, erase/program units, signatures if required and bounded retained evidence. Measure the **complete** serialized envelope from the implementation, with the largest supported profiles, recipes and custom definitions, then reserve explicit growth space. Test a document just below and just above the bound. Reject an oversized update before invalidating a slot; never silently drop limits, macros or other fields to fit.

The current service accepts documents up to 2,000,000 bytes and keeps bounded history/audit records on host storage. That host-file limit is not a cartridge capacity promise. A 32 KiB device cannot inherit it. Either define a complete, smaller supported recovery schema or provide larger protected flash storage. Compression, if used, needs bounded decompression and a worst-case capacity check; it is not a guaranteed saving. Large history/job/image archives require separately sized storage and backup policy.

The [file-backed replacement demo](../reports/MODULE_REPLACEMENT_DEMO.md) now measures 6,906 bytes per default mill record, or 13,812 bytes for two copies in its modeled 32 KiB budget. That smaller envelope does not yet implement the complete production metadata, predecessor-chain/commit-page protocol or future macro/profile package above. It demonstrates one bounded virtual payload fitting; it does not select a memory part.

Save settings on deliberate successful transactions; do not rewrite an EEPROM page for every motion cycle, telemetry update or boot. Calculate worst-case writes to the hottest metadata/commit page, including retries, migrations and service use, across temperature and product life. Put high-rate counters/logging in RAM, bounded main-storage logging or a justified FRAM area. Larger serial flash needs an explicit erase/wear/brownout design. None of these parts substitutes for an external backup.

## 4. Two committed generations and one authority

This is the required transaction behavior; the disconnected demo is evidence only for the portion its report exercises. Hardware byte/page behavior remains unimplemented and unmeasured.

1. There is one configuration writer through the common service. Acquire its lock, validate the complete candidate against observed capabilities, and bind the preview to the current configuration generation/hash and stopped/disarmed runtime epoch. Recheck these just before commitment.
2. Keep two independently checkable cartridge record slots. Select the inactive/older slot without touching the newest valid committed record. Invalidate and verify that target slot's old commit metadata before replacing its contents. Respect actual write/erase units; the two slots must not share an erase unit or a page affected by either record's commit update.
3. Write the complete payload and envelope, with bounded lengths and checksums. Poll completion as required, then read and validate the whole prepared record. Only after this succeeds, write its separate commit metadata and read it back. A commit marker alone is insufficient: it must bind the exact record length, generation and content hash. Detect torn commit writes; do not assume a byte or page write is atomic under brownout.
4. The newly verified cartridge commit is the persistent authority. Update and verify the main-storage mirror with that same machine/cartridge lineage, generation and hash. Report distinct states such as committed-with-mirror-pending if the mirror fails; do not acknowledge that all copies are synchronized. On uncertainty after a write, reread before retrying and never manufacture a second branch of history.
5. On restart, inspect both slots without writing either. Reject malformed lengths, bad integrity, uncommitted records, unsupported schemas and foreign machine lineage. Select the newest coherent valid committed generation; never use filesystem modification time as authority. Keep the older valid generation as fallback and display when corruption caused recovery from it.
6. If the main mirror trails a coherent cartridge, repair the mirror only from that validated authority under the recovery workflow. If the cartridge is absent/corrupt, or the mirror is ahead, has a different lineage, or conflicts at the same generation, stay disarmed and present an explicit recovery diff. Do not silently choose the highest number or overwrite either copy. Equal generation with unequal hashes and divergent predecessor chains are conflicts, not normal replication delay.

Normal edits require the cartridge, preventing independent host-only histories. Replacing a cartridge from a mirror/export is an explicit recovery transaction with source identity, preview, affected-check invalidation and audit; it is not an automatic new-machine clone. A blank replacement compute image has no configuration authority over the machine cartridge. A cartridge copied from another machine must not silently become the active setup. Define generation exhaustion/migration rather than permitting wrap to zero.

Two records in one chip provide interrupted-update recovery, not protection from chip destruction, electrical overstress or a common bus fault. Preserve a host mirror and user-exportable backup. File replacement/fsync tests cannot establish EEPROM behavior; later fault injection must interrupt every relevant write/commit/mirror stage and prove at least one previously committed valid generation survives under the defined storage fault model.

## 5. Protected power, buses and outputs

Place the cartridge on the protected logic side, away from field voltages and exposed external cable domains. Use a keyed, retained cartridge enclosure/connector with identification and clear power-off service instructions. Do not socket a bare memory IC as the ordinary customer procedure. Select ESD protection, current limiting, reverse/misconnection protection, decoupling, reset/brownout behavior and power-off leakage/back-power prevention for the actual connection.

Keep its memory bus outside the cyclic motion path. A shorted cartridge or I/O module must not indefinitely hold the compute module's only essential bus or collapse every logic rail. Specify a dedicated bus or isolatable branch, bounded host timeouts, branch power control and fault reporting; test stuck SDA/SCL, rail shorts and partially powered modules. Electrical isolation here means defined fault containment; galvanic isolation is selected only where the electrical-domain analysis requires it.

WP must default to the protected state in hardware during reset, boot, update and fault, with a deliberately bounded write window. Prove partial-power behavior and WP voltage/timing against the selected memory. Default pulls alone do not protect against a faulty writer; the transaction and permission design remain necessary. Do not promise recovery from every conceivable overvoltage.

Outputs remain governed by the reviewed hardware inhibit, reset/default circuit and independent machine protection while compute, memory or service software is absent. A memory fault detected during operation follows the machine's defined stop/hold/after-run policy; it must not indiscriminately remove gravity support, clamping or necessary cooling. It blocks new configuration and subsequent normal-run permission until resolved. The [ESP accessory contract](ESP_ACCESSORY_AUTOMATION.md) retains one owner per output, measured readiness and essential-service dependencies. Repairability does not grant the ESP torch, toolchanger or motion takeover authority.

## 6. Supported replacement workflow

**Stop → save if the controller remains operable → power down the relevant equipment → replace the approved module behind the fixed wired base → power up disarmed → identify and compare → restore compatible assignments → verify the affected functions → deliberately authorize normal operation.** When the failed section prevents saving, recover and display the last valid committed revision; unsaved changes may be lost. Power-off service is the first supported mode. Presence detection does not qualify hot swap.

Compatibility must be predefined using class, exact hardware revision, connector/key and electrical domain, channel capabilities, firmware/gateware protocol versions, host driver and profile requirements, factory calibration provenance and power budget. An unknown or weaker module stays in a diagnostic workflow. Firmware migration must not reinterpret physical units or increase a limit silently.

| Changed section | Preserve when dependencies match | Verify or invalidate |
|---|---|---|
| Grouped I/O bank | Logical assignments, labels and unaffected machine calibration | New serial/capabilities, changed bank polarity, wiring continuity, input/output behavior and dependent service checks |
| Motion core | Stored scales, travel bounds and machine geometry | Step/dir timing, encoder direction/capture, enable/watchdog/inhibit, capability/transport version and affected motion commissioning; power loss still invalidates live position |
| Measurement/process module | Unchanged mechanics and compatible source recipe library | Replacement's own factory calibration, full measurement chain, range/polarity/freshness and affected process qualification |
| Compute or main storage | Cartridge's compatible complete machine setup | Supported boot image, software/schema and all required packages, runtime transport, touchscreen/control behavior; no saved run state |
| Power/service section | Compatible saved automation requests and thresholds | Rails/fault containment, reset/default outputs, independent watchdogs, sensor readiness, dependent stop/after-run behavior |

Each result must distinguish observed identity, selected profile, preserved settings and verified behavior. An I/O-bank replacement should not force unrelated scale recalibration, but a full power cycle still requires the machine's position/homing recovery. Restored assignments remain inhibited until their affected checks pass. Guided tests that intentionally energize an output or move an axis require a separate scoped commissioning action; restore, discovery and clicking a test list do not issue such commands.

The [disconnected replacement demonstration](../reports/MODULE_REPLACEMENT_DEMO.md) uses virtual identities and the common service. Its grouped home-input-bank example must not be described as an implemented physical output module or measured factory calibration. Hardware discovery, automatic import into a replacement computer, factory programming and live affected-function tests remain separate work.

In the current file-only prototype (`controller_config/recovery.py`), an accepted input-bank replacement leaves the configuration unchanged. It is recorded as one same-revision `replace_module` entry in the shared configuration store's audit. The entry's actor names the machine, the cartridge generation, the slot and the old->new module serial; before and after configuration hashes are equal. The entry is written under the store lock after the store, runtime epoch and inventory are rechecked, and before the binding sidecar is rewritten as `applied`. These are two separate atomic file replacements, not one atomic two-file transaction: an interruption between them can leave the audit entry without the updated binding. This is source-inspected and host-tested file behaviour, not cartridge or EEPROM evidence.

## 7. Preprogrammed spares and offline recovery

Ship programmable replacement modules with their supported firmware/gateware and serial/calibration descriptor already programmed and tested. Some passive/protected I/O boards need only an identity record and no application firmware. Supply a compatible boot image on a replacement compute module's specified storage. The ordinary replacement experience should need no IDE, external programmer, account, subscription or firmware search.

Provide a versioned local package when an update is necessary, including image integrity/authenticity, hardware compatibility, migration rules and a known recovery route. Updates happen stopped/disarmed with output permissions withheld and sufficient validated power/storage. Preserve the previous supported image and configuration until the new combination passes its defined checks. Schema rollback and firmware rollback must be compatible; a successfully booted old image cannot safely consume an irreversible new-format configuration by assumption.

For the project's pinned ESP-IDF 5.5.4, application OTA requires at least two OTA slots and `otadata`. Enable `CONFIG_BOOTLOADER_APP_ROLLBACK_ENABLE` in the deployed build and confirm a new application only after its first-boot checks, using `esp_ota_mark_app_valid_cancel_rollback()`. Preserve a bootable permitted previous image; security-version restrictions can prevent rollback. Application rollback does not automatically protect configuration migrations, bootloader or partition-table updates. These mechanisms require configuration and fault testing; current diagnostic firmware is not evidence of the complete workflow. [Espressif v5.5.4 OTA documentation](https://docs.espressif.com/projects/esp-idf/en/v5.5.4/esp32s3/api-reference/system/ota.html)

## 8. Economics, manufacture and proof before offering it

Add explicit cost rows at quantities 1, 10, 100 and 1,000 for terminal plugs/headers/keys, extra PCB and board connectors, identification/calibration storage, cartridge memory/PCB/housing, protected bus/power/WP circuitry, mechanical retention, factory programming/serialization/calibration, fixtures and test time, packaging, spare inventory, warranty repair and long-term software support. Cost the adopted fixed-base/card architecture at the same required I/O and exact screen package; the superseded whole-board/pluggable-terminal variant may remain a labelled historical cost reference. Show each improvement's cost difference, capability gained and spare-card price. The existing [144-case compute/display comparison](../research/COMPUTE_DISPLAY_MATRIX.md) does not price this new modular/cartridge design; unknown blocks remain unknown.

Before the PCBWay package, define exact compatible substitutes, device lifecycle/availability checks, programming files and tool versions, unique-identity allocation, empty-machine/default cartridge state, image hashes, factory calibration method and acceptance limits, whole-unit test sequence, traceability and locked-versus-serviceable storage regions. Require proof of WP and recovery behavior on the programmed assembly. Factory programming and PCBWay test labor are quotation items, not included by inference. Do not order or submit an incomplete fabrication package.

Publish service drawings, compatibility/version tables, offline recovery tools, revisioned replacements and spare-part pricing. Set a support and stocking policy backed by actual supplier information and economics; no lifetime supply guarantee is made here. The proposed product advantage depends on affordable obtainable spares, not merely sockets.

Acceptance proceeds from the disconnected service demonstration to serialized capacity/endurance analysis; schematic/connector review; storage driver and interrupted-transaction models; then actual bus/power interruption, wrong-module, calibration, output-default and guided-service measurements on bounded engineering prototypes. Finally demonstrate the complete supported repair offline with no individual field-wire retermination or customer programming. Record source inspection, host tests, target compilation, HDL simulation, FPGA synthesis, ERC/DRC and physical measurements separately in [engineering status](../reports/ENGINEERING_STATUS.md).
