DeadlySIn777/Controller/reports/motherboard-audit-20260930/880-after-clear-fix/footprints-by-function.csv

Function | Footprints | Fitted | Resistors | Capacitors | TVS | U_ref_active | Inductors | Clock
12 motor interfaces and source buffers | 350 | 350 | 198 | 53 | 36 | 63 | 0 | 0
24 digital inputs | 120 | 120 | 72 | 36 | 0 | 12 | 0 | 0
16 smart outputs | 110 | 110 | 40 | 44 | 0 | 26 | 0 | 0
Four encoders / frequency / MPG receivers | 28 | 26 | 16 | 8 | 0 | 4 | 0 | 0
FPGA rails and motor receiving-rail monitors | 111 | 111 | 76 | 19 | 0 | 14 | 2 | 0
FPGA / configuration flash / clock / support | 70 | 70 | 25 | 39 | 0 | 5 | 0 | 1
Watchdogs / permission / deliberate-control bridges | 91 | 91 | 37 | 28 | 0 | 26 | 0 | 0
Analog / communications | 0 | 0 | 0 | 0 | 0 | 0 | 0 | 0
LED indicators | 0 | 0 | 0 | 0 | 0 | 0 | 0 | 0
Compute / ESP / storage sockets | 0 | 0 | 0 | 0 | 0 | 0 | 0 | 0
