DeadlySIn777/Controller/reports/readiness-fixes-20261004/hardware-release-fixes.md

# Assistant authority and production acceptance fixes

4 October 2026. Source and host-test changes only. No hardware, CAD, routing, firmware, FPGA RTL/testbench, external IS-1 archive or existing evidence file was modified. The gateware evidence verifier was corrected separately below. Claude retains routing ownership. The external FluidCNC project remains an unadopted candidate for this controller.

## External assistant: free text no longer actuates

Updated `Z:/Programming Projects/Genmitsu1030Cnc/fluidcnc/ai-assistant.js` after checking its ancestor directories for AGENTS instructions (none found), preserving its exact original bytes and checking its SHA immediately before replacement. Before: `90a6624e36cba2bd0ab28e77eda844e605edfd17b20a25323f186eb03f32e948`; after: `8132250e38a61bb88c430fbfd8ec8bcfd9fea3a19453ee70db8bb642217e5da8`.

`executeAction` is now advisory even when called directly. Parsed machine actions produce a non-executable proposal with `executed:false`, `gcode:null` and `proposal.executable:false`. The assistant contains no transport-send or command-callback invocation. Motion, homing, zeroing, spindle/coolant, probing, tool change, job start/resume/stop, and analysis-workflow callbacks all use the same non-actuating boundary. Status, explanations, local calculations and direct inert G-code analysis remain available. Help and voice text explain the dedicated-control boundary.

This removes the authority error rather than trying to infer whether arbitrary language is negated, quoted, pasted, hypothetical or imperative. Those inputs may still identify a topic or return a suggestion; none can send a command. The normal UI controls are unchanged: `app.js` retained SHA `42046d390d6610b691dffea9bac669d6599f8e4a176441f94d5e2e5943253bdb`. Its response callback only renders sanitized chat text; its command callback is no longer called by the assistant. `grblhal.js:getState()` returns a copy of cached state.

The isolated Node VM verified the actual edited external file with **139 text cases, 25 direct-action cases, four voice cases, one disabled-limits case and one direct-analysis case**. It recorded **zero transport calls and zero command callbacks**. The preserved original is a negative control and reproduced eight unsafe actuation calls. Neither the app nor any browser, serial port or network transport was launched. No running browser instance was reloaded; this is verification of the changed source, not a claim about already-loaded application instances or physical operation.

Evidence: [exact original](before/external-ai-assistant.js), [adoption receipt](assistant-fix-adoption.json), [actual-file regression](assistant-nonactuation-adopted.json), [inert regression source](test_assistant_nonactuation.cjs). Both the staging and adoption helpers refuse an unexpected original hash, preserving concurrent edits rather than overwriting them.

## Production release consumes G01–G26

Added `manufacturing/product-acceptance.json`, hash-bound from the release manifest to the declared `is2-base-controller-candidate` / `unqualified-r0` package. All **26 gates are open** with no invented accepted evidence. The record distinguishes an engineering package from a qualified offered product; each eventual screen/module/accessory package needs its own exact acceptance scope.

`tools/check_release.py` now requires this record for **production only**. It verifies:

- The record's relative project-local path, bytes and SHA; schema; exact product, board and package revisions; and declared package scope/configuration.
- Exactly G01–G26, with no duplicate, missing, unknown or N/A gate bypass. Production requires every gate to be accepted for the declared package.
- Every accepted gate's scope and nonempty evidence list. Each evidence item needs project-local bytes, a matching SHA, exact product/board/package bindings, input revision, method, scope, evidence class, reviewer, ISO review date and a passing result.
- Required evidence classes appropriate to the gate. Host/source/simulation or compilation cannot substitute for physical measurements, and family mapping cannot substitute for vendor fit/timing. G26 requires host, UI integration and cost-review evidence. These are necessary consistency checks, not automatic certification of a report's truth or adequacy.

Prototype manufacturing checks are unchanged. Existing artifact statuses, quotation semantics and `manufacturing_ready:false` are preserved. The release manifest's only semantic change is the added `product_acceptance` binding. Its exact diff and before/after hashes are recorded in [release-fix-diff-receipt.json](release-fix-diff-receipt.json) and [manifest diff](manufacturing__release-manifest.json.diff).

**50 focused release tests pass.** They include accepted temporary fixtures, missing G26, malformed/unknown/duplicate statuses, stale or missing evidence, wrong package/revision, missing reviewer/class/result, and attempted simulation substitution. Eight monitored source/evidence/CAD inputs remained unchanged during the verification. The original prototype and production reports were preserved rather than rewritten.

Fresh checks remain blocked: **17 prototype blockers and 49 production blockers** (the existing 23 plus 26 explicit open product gates). [Verification receipt](product-acceptance-verification.json), [test log](product-acceptance-tests.log), [fresh prototype report](prototype-release-check.json), [fresh production report](production-release-check.json). All fixture evidence is clearly test-only and confined to temporary directories; no fabrication files or real accepted product evidence were fabricated.

## Historical RTL recorder scope correction

The initial read-only legacy recorder failed because its broad current inventory included `tests/tb_stepgen12_characterization.sv`, which was not in the old manifest. All 12 historically recorded source hashes and both retained simulation/status-output hashes matched at inspection. The historical six-channel ABI1/ABI2 runner explicitly names its two old benches and does not run the new twelve-generator characterization bench. [Original inspection](historical-rtl-recorder-review.json), [original failure](historical-rtl-recorder-check.log).

The corrected verifier explicitly pins the exact supported runner and its complete 12-file execution/metadata scope. It excludes only that independently recorded bench with its exact hash and independently retained successful receipt; arbitrary new RTL/test/tool inventory is rejected. Because the historical manifest also pins the recorder's own old bytes, an explicit [verifier transition](rtl-verifier-transition.json) verifies those old bytes from the archive while separately binding the new verifier hash. It does not pretend the changed verifier is the old recorded source.

**12 temporary-copy tests pass**, covering unknown new inventory/dependencies, changed/missing pinned files, missing or changed independent receipts, changes to either verifier/archive, and removed source/evidence manifest entries. The live read-only `--check` now passes with an explicit report of the separately scoped bench and verifier transition. No manifest/log was re-stamped; no HDL simulation or compilation was rerun. [Check output](rtl-scope-check.log), [tests](rtl-scope-tests.log), [input/hash verification](rtl-web-verification.json).

## Loopback setup HTTP review and fixes

`controller_config/setup_web.py` now returns JSON 404 for every unknown API GET instead of closing without a response. It rejects duplicate Host/Origin/token and ambiguous body-framing headers, compares non-ASCII tokens without an exception, requires exactly one bounded decimal Content-Length, rejects incomplete bodies and sets a five-second socket timeout. Context/export reads use the same local lock as mutations. Only exact static resources are served; arbitrary filesystem paths remain inaccessible. Original source is retained in `before/controller_config/setup_web.py`.

The server accepts an optional trusted `provider_config` argument; it exposes no API for changing provider configuration. Default paid AI remains disabled. Configured `/api/paid_advice` accepts exactly `facts`, `expected_revision` and `allow_paid`, requires literal `true`, retains same-origin/token checks, and delegates to the bounded advisory adapter without saving or committing its result. Context exposes the enabled flag and capability description. Root owns the UI and trusted CLI configuration loading; this adapter does not select a model, price or key.

An allowance read failure is isolated from offline setup. Context returns `budget:null`, a structured `budget_error` and `paid_ai_enabled:false` while retaining the existing valid draft. Existing setup initialization, local save/preview/commit and export remain available without rewriting the broken ledger. The paid action checks ledger integrity before reaching even an injected advisor; held allowances also disable paid requests. This fixes the observed old-schema allowance preventing the browser from loading a valid local setup. No ledger migration, reset or replenishment is performed.

**15 loopback HTTP tests passed at the allowance-isolation revision**, using temporary simulation stores and a mocked paid advisor. They cover security headers, Host/Origin/token rejection, non-ASCII and duplicate headers, request limits, malformed/duplicate/nonfinite JSON, unknown routes, unmodified corrupt source, twelve-motor draft/preview/commit/replay/restore/export, non-actuating guidance and explicit paid opt-in. Tests reproduce the previous allowance schema and an I/O failure, prove the offline workflow remains available, and prove paid advice never reaches its adapter. Fake paid proposals leave the setup file byte-identical. No hardware transport or paid request was opened. Nine monitored source/evidence inputs remained unchanged during that run. [Allowance-isolation test log](setup-web-tests-r02.log), [verification](setup-web-verification-r02.json), [HTTP diff](controller_config__setup_web.py.diff), [verifier diff](gateware__tools__record_evidence.py.diff). The earlier 13-test and 15-test receipts remain prior snapshots.

## Exact preview transport through browser JSON

Live browser testing exposed `SETUP_PLAN_CHANGED` on an unchanged review: JavaScript parses Python's `640.0` as a Number and serializes it as `640`, changing the existing canonical plan digest. The HTTP preview/restore response now includes a top-level `commit_payload` string containing the exact canonical plan representation, alongside the unchanged `result` plan object. Browser code can return that string unchanged. HTTP commit parses it with strict duplicate-key and nonfinite-number rejection, then uses the existing service validation. Legacy object plans remain accepted. No service or historical digest algorithm changed, and the string grants no authority to bypass hash, revision, recomputation or idempotency checks.

**17 HTTP tests now pass**, including an actual inert Node `JSON.parse`/`JSON.stringify` round trip that reproduces the old object failure and then passes opaque-string apply, replay and restore. The fixture includes `640.0` and exponent notation. Separate checks reject malformed, duplicate-key, nonfinite/overflow, tampered and stale plan strings without changing stored bytes. Ten monitored source/evidence inputs remained unchanged during the run. [Final test log](setup-web-tests-r03.log), [final verification](setup-web-verification-r03.json), [transport diff](controller_config__setup_web.py.opaque-plan.diff), [regression diff](tests__test_setup_web.py.opaque-plan.diff). These are HTTP/JavaScript host results in temporary disconnected stores, not physical commissioning evidence.
