DeadlySIn777/Controller/reports/board-finish-20261011/continuation-r2/sbc-power/core-source-walls-and-protected-second-r53/failure.txt

Read-only diagnostic failed after source graph and scoped pair checks: h pad does not expose at; group row carries at. No geometry was written or accepted. Historical failed script retained.
