DeadlySIn777/Controller/hardware/board_review/revisions/20260930-20/motherboard-3d.png

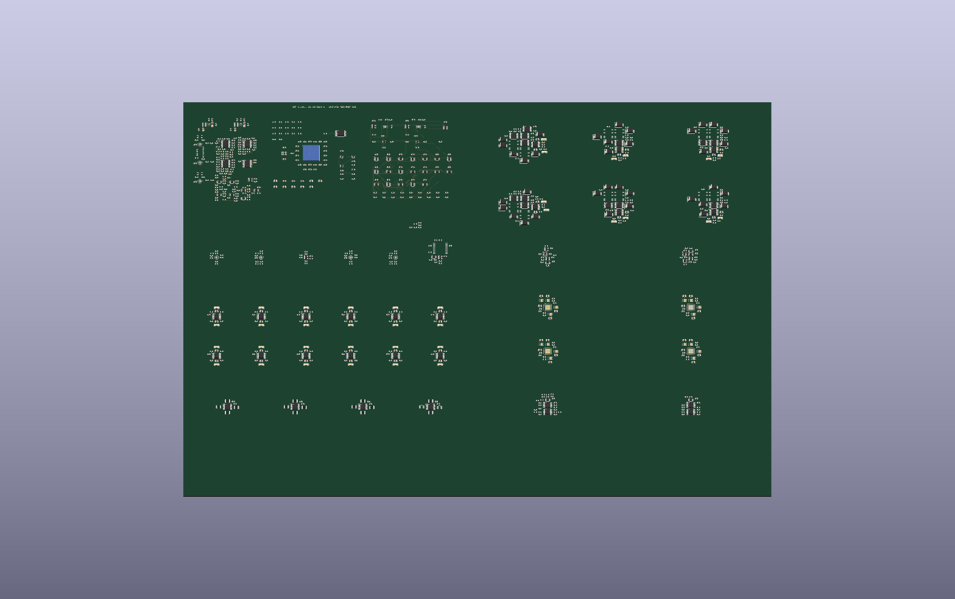
hardware/board_review/revisions/20260930-20/motherboard-3d.png
