DeadlySIn777/Controller/hardware/board_review/revisions/20260930-21/board-review.png

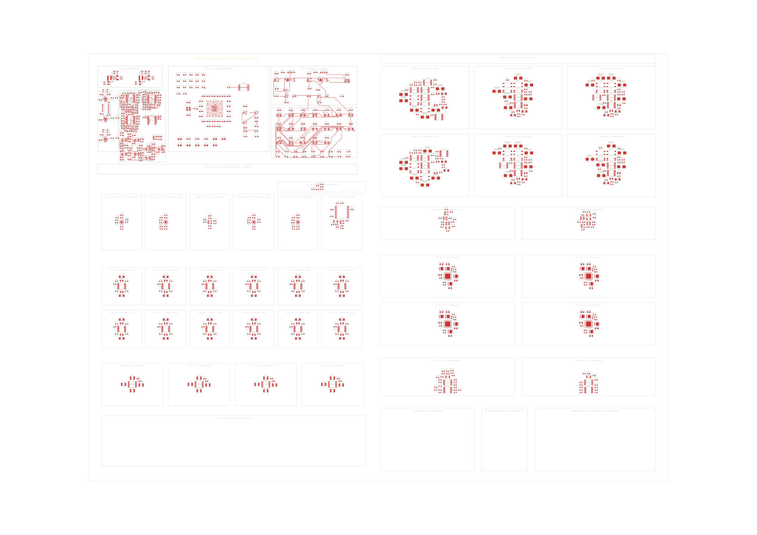
hardware/board_review/revisions/20260930-21/board-review.png
