DeadlySIn777/Controller/hardware/board_review/revisions/20261001-26/motherboard-3d.png

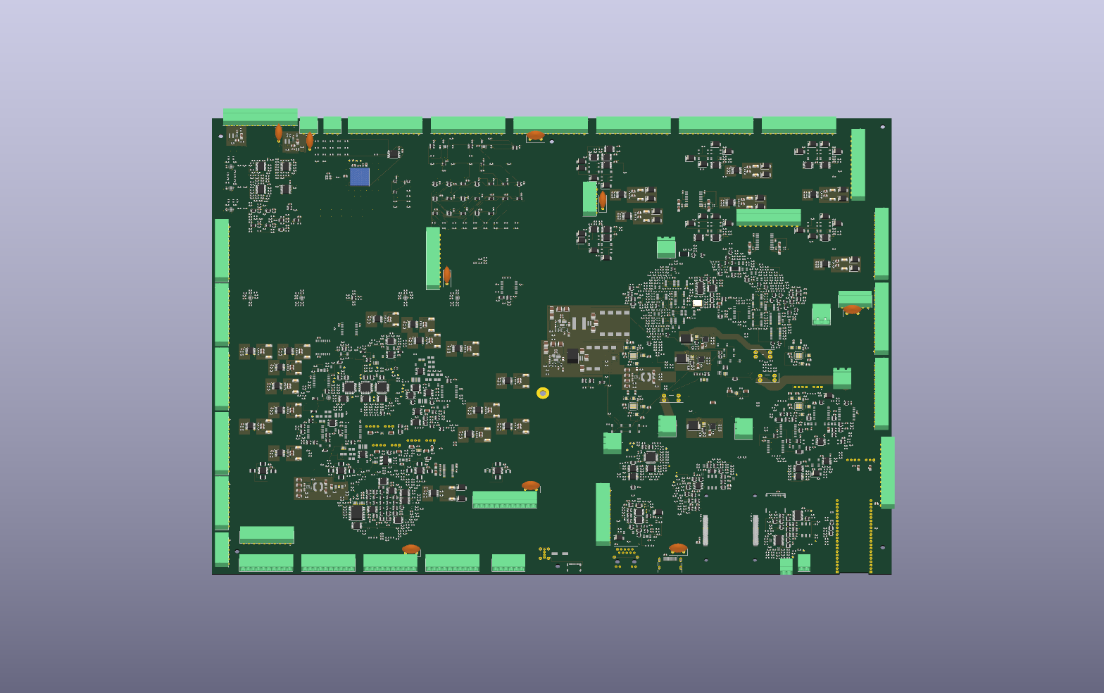
hardware/board_review/revisions/20261001-26/motherboard-3d.png
