DeadlySIn777/Controller/hardware/fpga_core/fpga_core.pdf

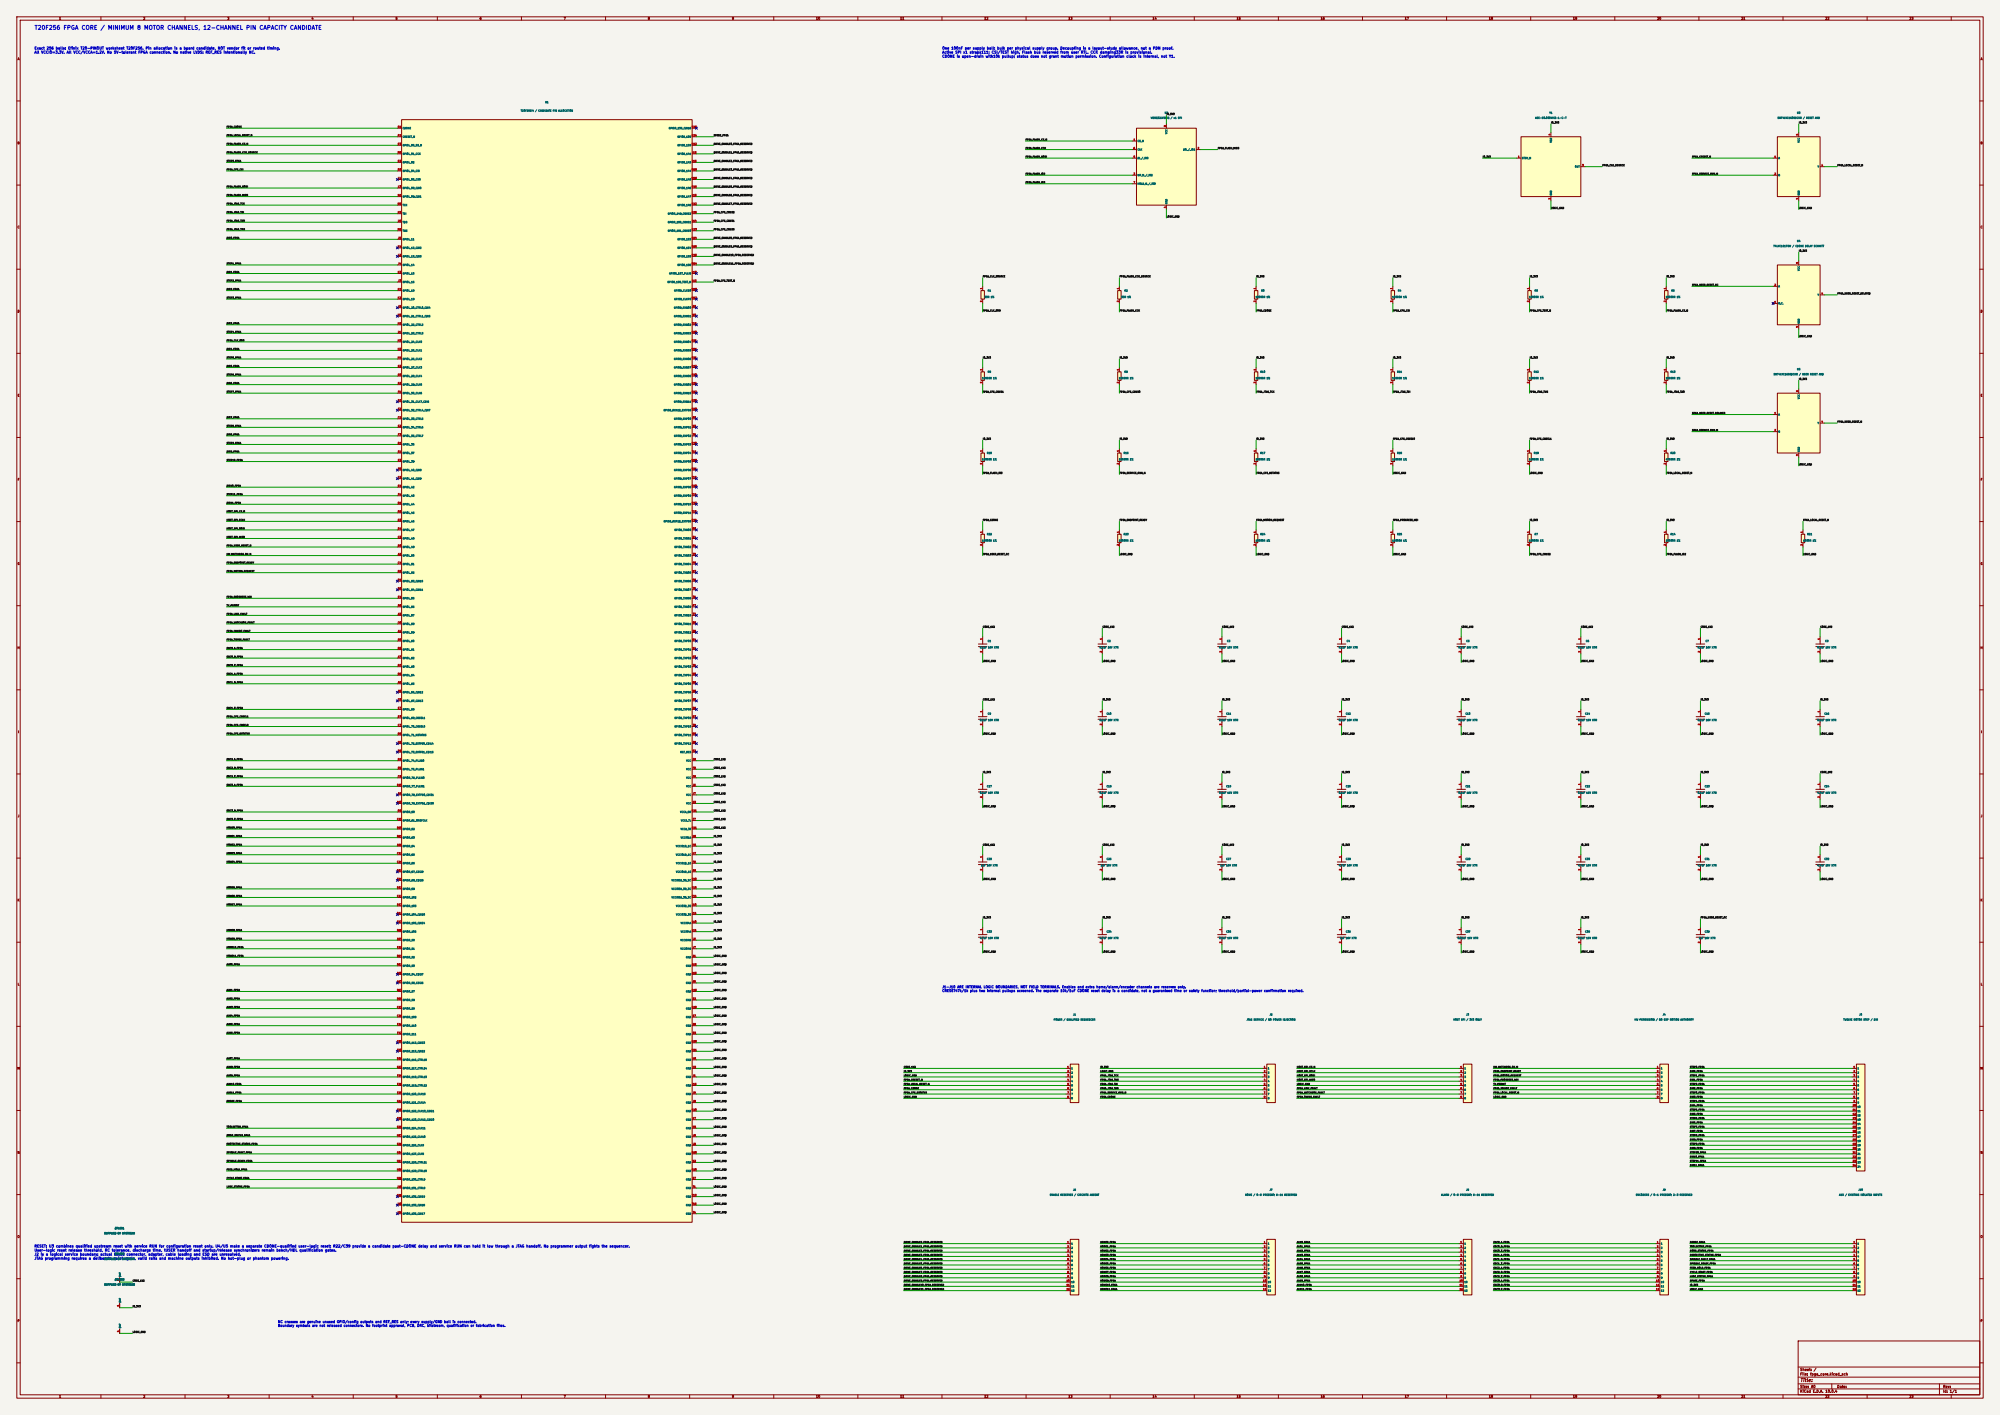
[picture p67: page 1]

All VCCIO=3.3V. All VCC/VCCA=1.2V. No 5V-tolerant FPGA connection. No native LVDS: REF_RES intentionally NC.

Active SPI x1 straps111; CSI/TEST high. Flash bus reserved from user RTL. CCK damping33R is provisional.

J4 HW PERMISSION / NO ESP MOTION AUTHORITY

JTAG SERVICE / NO POWER INJECTION

TWELVE MOTOR STEP / DIR

ENABLE RESERVES / CIRCUITS ABSENT pwr 1 #FLG01

AUX / EXISTING ISOLATED INPUTS

SUPPLIED BY UPSTREAM pwr 1 #FLG02

RESET: U3 combines qualified upstream reset with service RUN for configuration reset only. U4/U5 make a separate CDONE-qualified user-logic reset; R22/C39 provide a candidate post-CDONE delay and service RUN can hold it low through a JTAG handoff. No programmer output fights the sequencer.

SUPPLIED BY UPSTREAM pwr 1 #FLG03

SUPPLIED BY UPSTREAM pwr 1

Size: A0 | Rev:
KiCad E.D.A. 10.0.4 | Id: 1/1
