DeadlySIn777/Controller/hardware/mc_motor_buffers/mc_motor_buffers.pdf

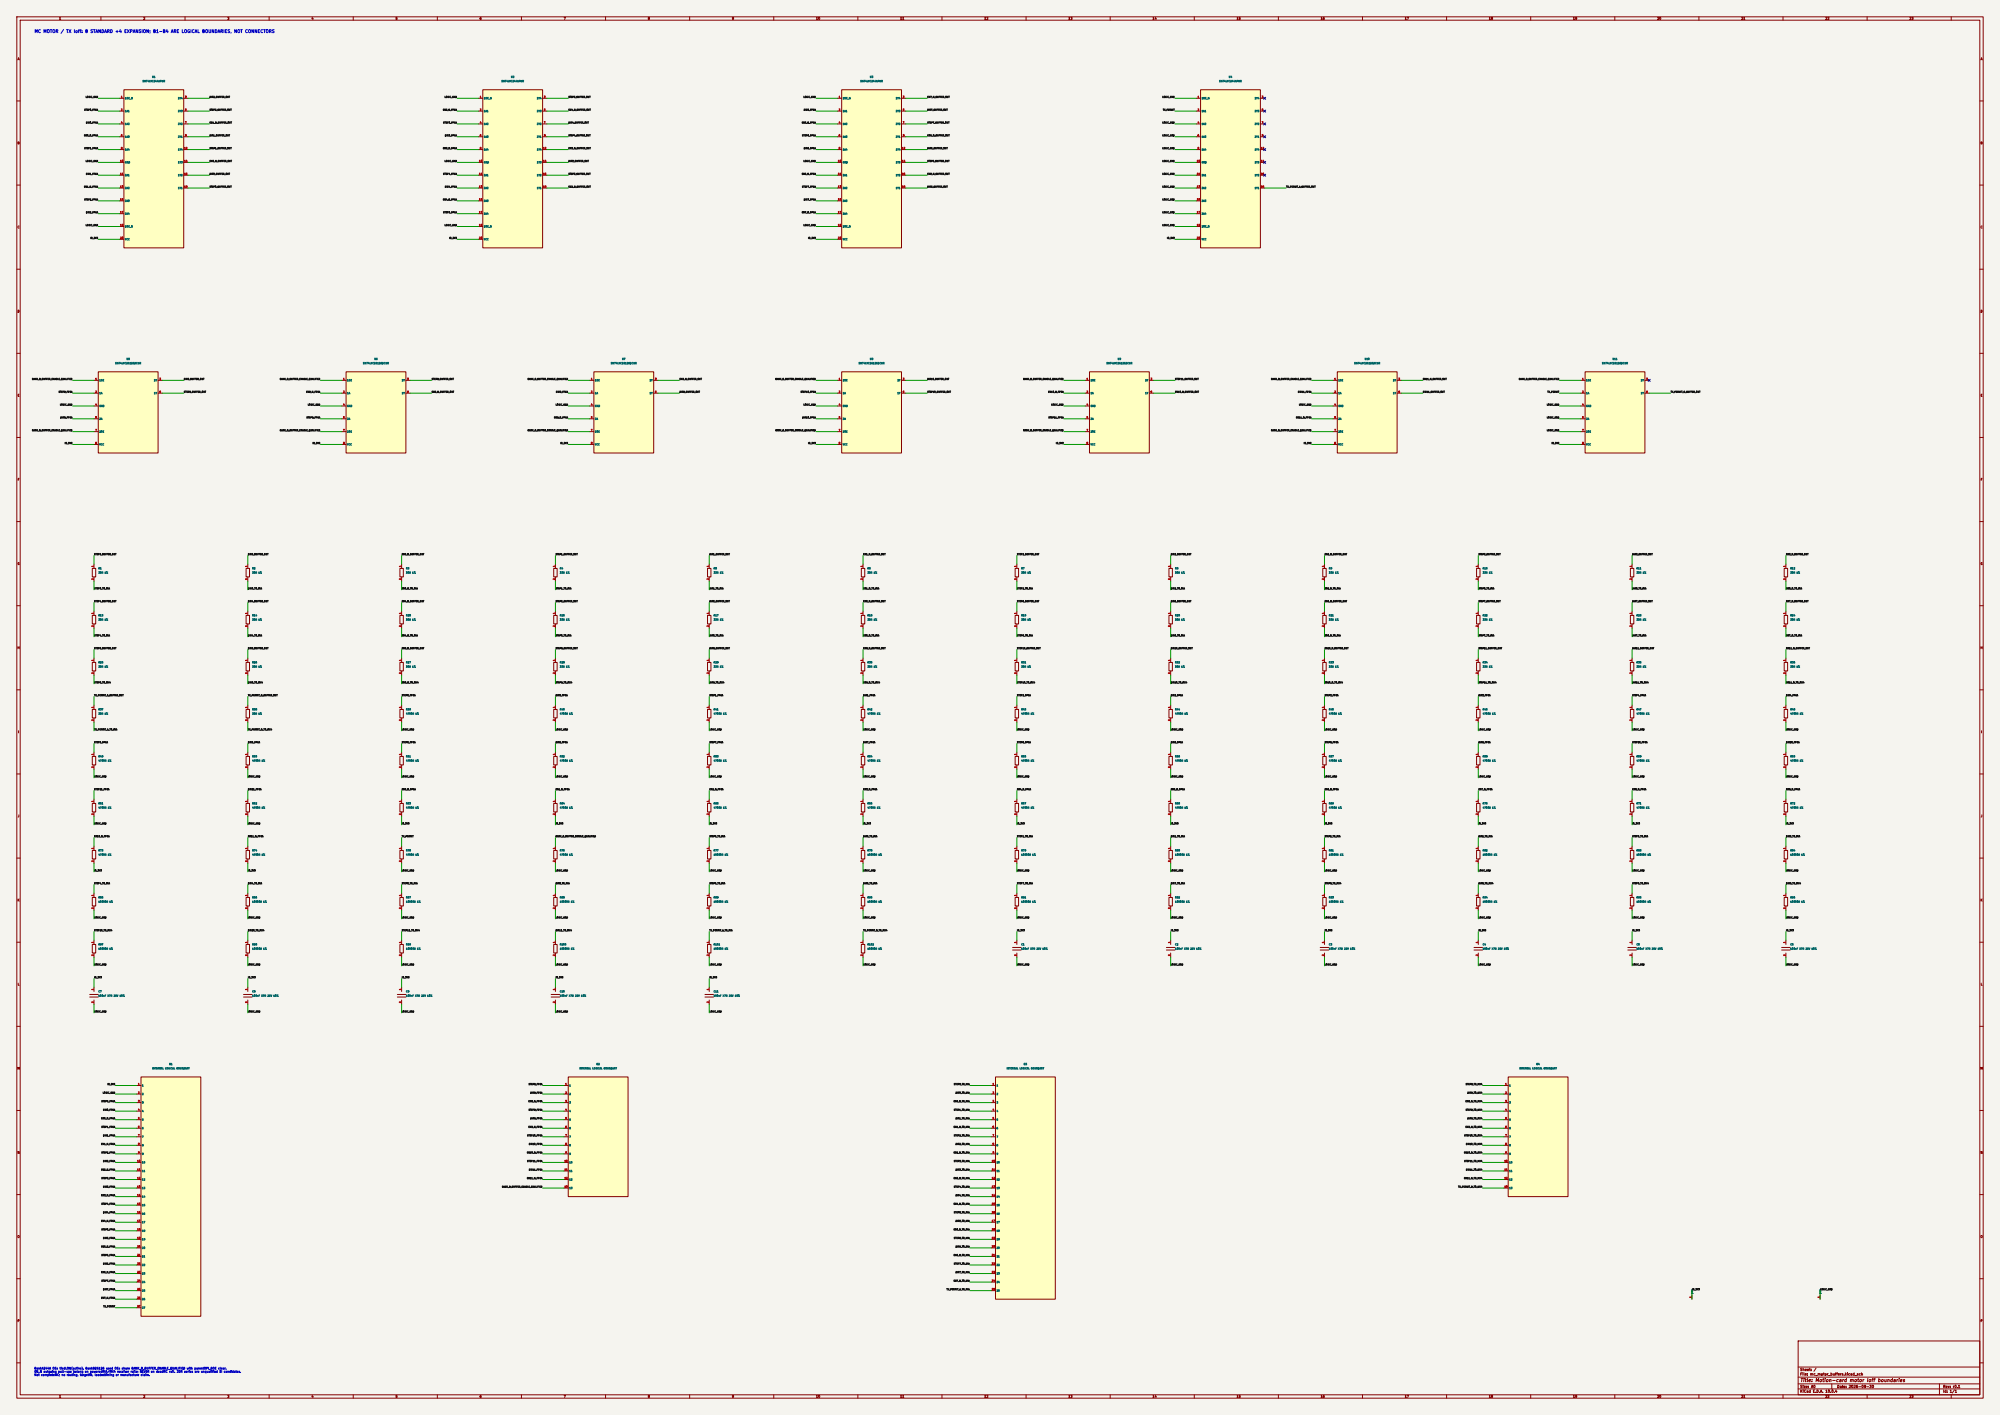
[picture p68: page 1]

MC MOTOR / TX Ioff: 8 STANDARD +4 EXPANSION; B1-B4 ARE LOGICAL BOUNDARIES, NOT CONNECTORS

BankA244A OEs tiedLOW(active). BankB2G126 used OEs share BANK_B_BUFFER_ENABLE_QUALIFIED with parentOPI_BOE clear. EN_N outgoing pull-ups belong on poweredMIA/MX4 receiver rails; NEVER on deadMC rail. 33R series are unqualified SI candidates. Not completeMC; no routing, targetfit, loadedtiming or manufacture claim.

Sheet: /
File: mc_motor_buffers.kicad_sch
Title: Motion-card motor Ioff boundaries

Size: A0 | Rev: r0.1
KiCad E.D.A. 10.0.4 | Id: 1/1
