DeadlySIn777/Controller/hardware/motherboard_power_entry/motherboard_power_entry.pdf

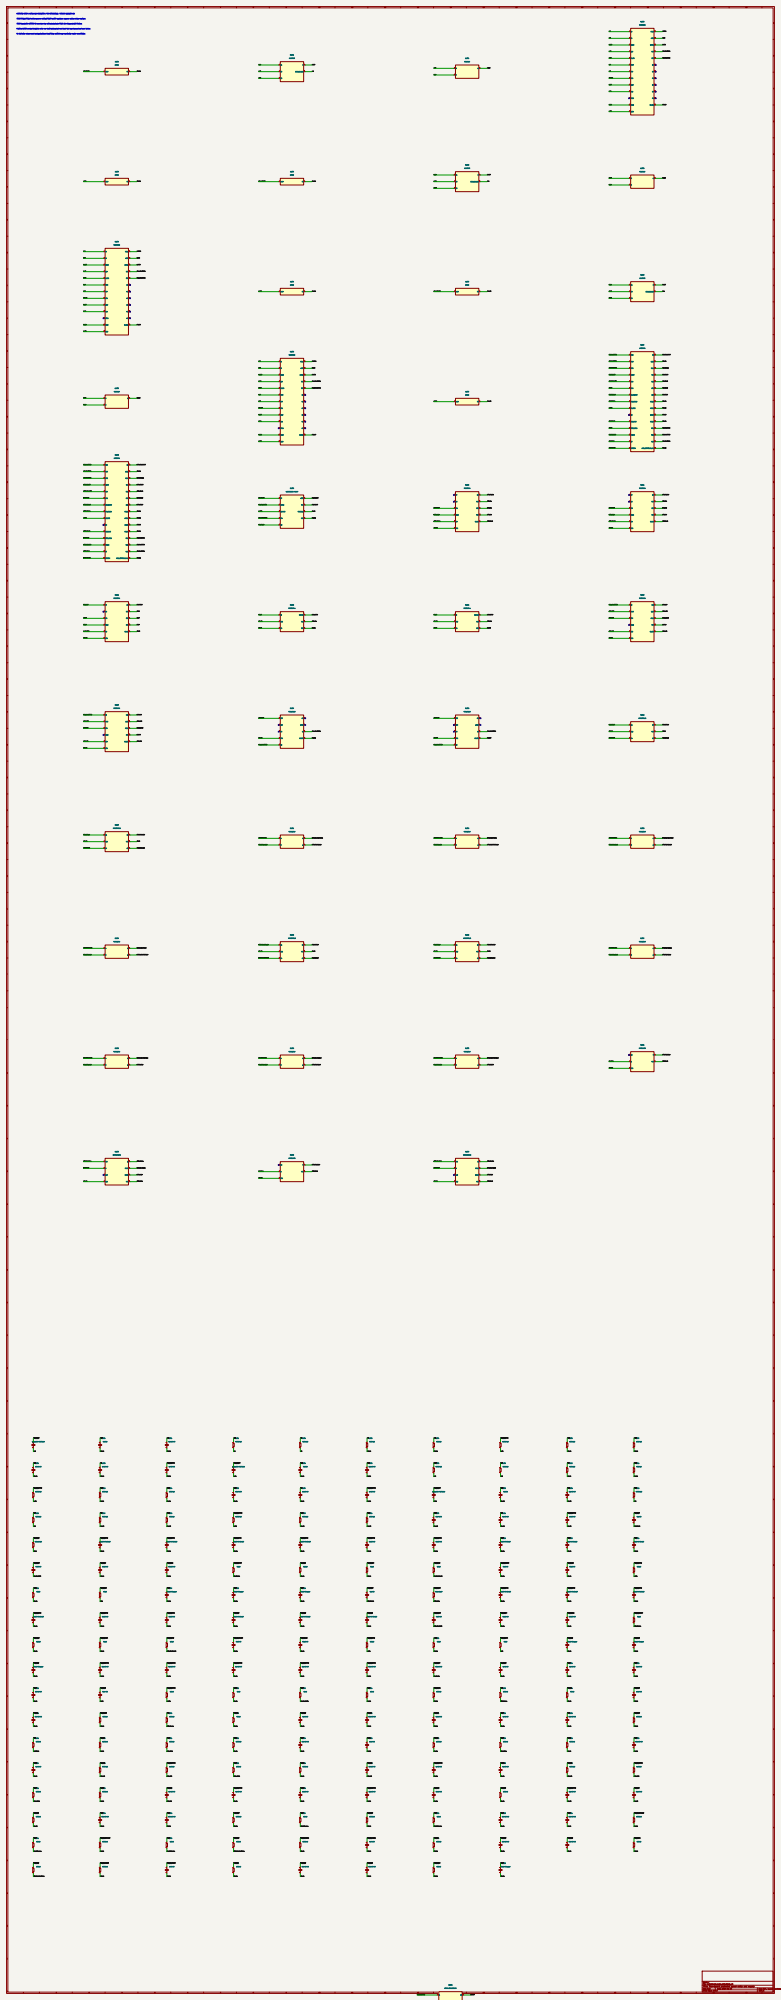
[picture p69: page 1]

CORE5 bounded7A +MOTION5 6A converters; two switchedmotorfeeds; FIELD5 .6A +independentAUX limiters. Published AUX24 overload testpoints; series raw-health photocontacts and bank-feed asynchronousclear/rearm latches. CORE/FIELD_A/FIELD_B entries; preserve existingFPGA1V2 andIO3 regulators, sequence and9xxx window monitors. No fabrication release; exact package/peripheral load/IRdrop andfield surge coordination require reconciliation. PROTECTED ENTRY / ACTUAL RAIL GENERATION / ONE MOTHERBOARD / SOURCE CANDIDATE r0.4

Sheet: /
File: motherboard_power_entry.kicad_sch
Title: One-board protected power entry and supply

Date: 2026-09-30

KiCad E.D.A. 10.0.4 | | Id: 1/1
