DeadlySIn777/Controller/(list of files, drawings)

Other design files:
current-global-R3/board.dsn
current-global-R3/rust-native-hole-model/board.dsn
hardware/octopus_external_adapter/r0_1/evidence/pcb-check2.json
hardware/octopus_external_adapter/r0_1/evidence/pcb-final-drc.json
hardware/octopus_external_adapter/r0_1/evidence/schematic-final-erc.json
hardware/octopus_external_adapter/r0_1/schematic-connectivity.json
hardware/octopus_external_adapter/r0_2/schematic-connectivity.json
hardware/octopus_external_adapter/r0_2/schematic-visual-review.json
hardware/octopus_external_adapter/r0_3/evidence/schematic-erc.json
hardware/octopus_external_adapter/r0_3/evidence/schematic-review.json
reports/motherboard-power-entry-20261001/feed-latch-reset-source-r01/candidate-r02/motherboard/pcb-open-items.json
review/current-routing-setup-20261018/physical-source.dsn
review/current-routing-setup-20261018/signal-route-first.dsn
routing/corrected-R299-baseline-native-raw.dsn
routing/stage4-native-raw.dsn
routing/TMR-clean-plane-free-F-In3-B-domain600-r6.dsn
routing/TMR-clean-retrace-safe-r8.dsn
