DeadlySIn777/Controller/hardware/board_review/revisions/20260930-02/watchdogs-placement.kicad_pcb

## KiCad design hardware/board_review/revisions/20260930-02/watchdogs-placement.kicad_pcb (2026-10-18)

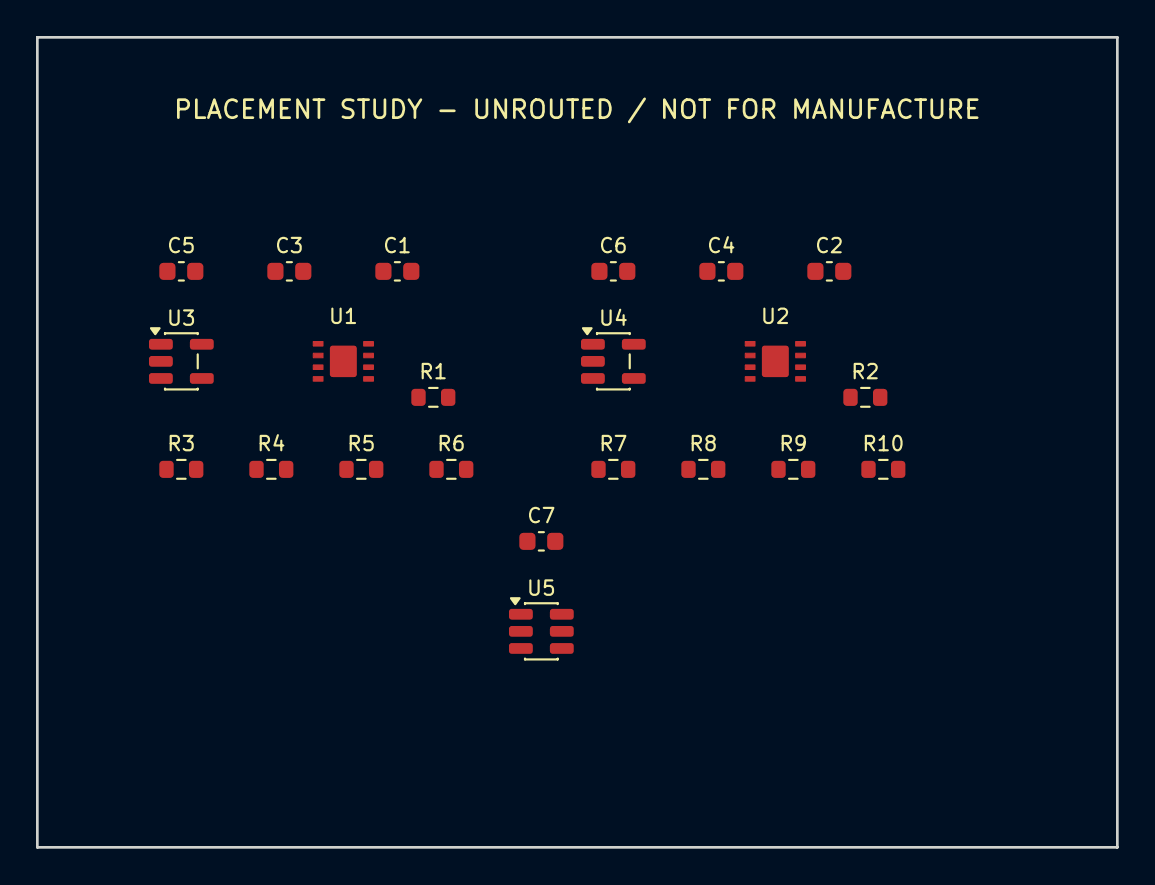
[picture p70: board watchdogs-placement.kicad_pcb from above]

Board: 2 copper layers, 60.0 x 45.0 mm, 22 parts (0 on the bottom side), 14 nets, no tracks yet.

Parts:
C1, C2: CL10C332JB8NNNC; C_0603_1608Metric
C3, C4, C5, C6, C7: GRM188R71E104KA01D; C_0603_1608Metric
R1, R2: CRCW060310K0FKEA; R_0603_1608Metric
R3, R4, R5, R6, R7, R8, R9, R10: CRCW0603100KFKEA; R_0603_1608Metric
U1, U2: TPS3851G18SDRBT; TPS3851_DRB8
U3, U4: SN74LVC1G34DBVR; SOT-23-5
U5: SN74LVC2G17DBVR; SOT-23-6

Connections:
/FPGA_MOTION_REQUEST: R3.1, U1.5
/FPGA_OUTPUT_REQUEST: R4.1, U2.5
/FPGA_PROGRESS_M: R5.1, U3.2
/FPGA_PROGRESS_O: R7.1, U4.2
/IO_3V3: C3.1, C4.1, C5.1, C6.1, C7.1, R1.1, R2.1, U1.1, U2.1, U3.5, U4.5, U5.5
/LOGIC_GND: C1.2, C2.2, C3.2, C4.2, C5.2, C6.2, C7.2, R3.2, R4.2, R5.2, R6.2, R7.2, R8.2, R9.2, R10.2, U1.4, U1.9, U2.4, U2.9, U3.3, U4.3, U5.2
/WD_M_CWD: C1.1, U1.2
/WD_M_HEALTH_RAW: R1.2, U1.7, U1.8, U5.1
/WD_M_OK: R9.1, U5.6
/WD_M_WDI_BUF: R6.1, U1.6, U3.4
/WD_O_CWD: C2.1, U2.2
/WD_O_HEALTH_RAW: R2.2, U2.7, U2.8, U5.3
/WD_O_OK: R10.1, U5.4
/WD_O_WDI_BUF: R8.1, U2.6, U4.4
