DeadlySIn777/Controller/hardware/board_review/revisions/20260930-01/motion-card-placement.kicad_pcb

## KiCad design hardware/board_review/revisions/20260930-01/motion-card-placement.kicad_pcb (2026-10-18)

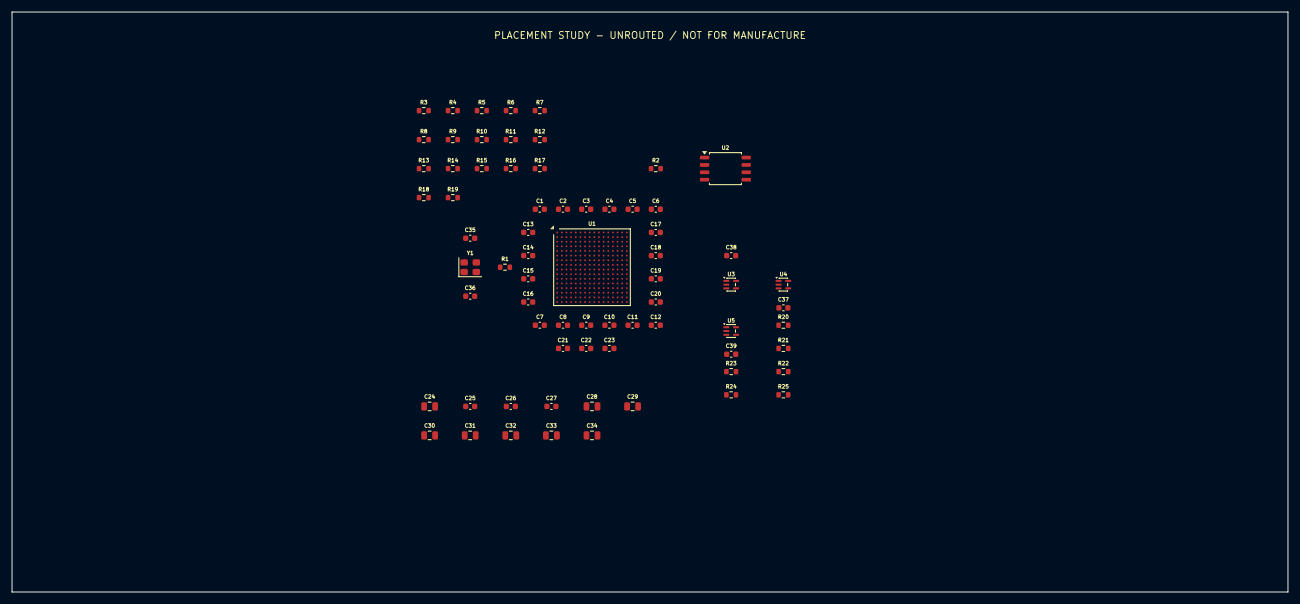
[picture p71: board hardware/board_review/revisions/20260930-01/motion-card-placement.kic… from above]

Board: 2 copper layers, 220.0 x 100.0 mm, 70 parts (0 on the bottom side), 33 nets, no tracks yet.

Parts:
C1, C2, C3, C4, C5, C6, C7, C8, C9, C10, C11, C12, C13, C14, C15, C16, C17, C18, C19, C20, C21, C22, C23, C35, C38: 885012206046; C_0603_1608Metric
C24, C28, C29, C30, C31, C32, C33, C34: 885012207053; C_0805_2012Metric
C25, C26, C27, C36, C39: 885012206052; C_0603_1608Metric
C37: 885012206040; C_0603_1608Metric
R1, R2: CRCW060333R0FKEA; R_0603_1608Metric
R3, R4, R5, R6, R7, R8, R9, R10, R11, R12, R13, R14, R15, R16, R17, R18, R19, R22, R23, R24, R25: CRCW060310K0FKEA; R_0603_1608Metric
R20: CRCW060347K0FKEA; R_0603_1608Metric
R21: CRCW06031K00FKEA; R_0603_1608Metric
U1: T20F256I4; TFBGA-256_13x13mm_Layout16x16_P0.8mm
U2: W25Q32JVSSIQ; SOIC-8_5.3x5.3mm_P1.27mm
U3, U5: SN74LVC1G08DCKR; SOT-353_SC-70-5
U4: 74LVC1G17GW; SOT-353_SC-70-5
Y1: ASE-50.000MHZ-L-C-T; Oscillator_SMD_Abracon_ASE-4Pin_3.2x2.5mm

Connections:
/CORE_1V2: C1.1, C2.1, C3.1, C4.1, C5.1, C6.1, C7.1, C8.1, C9.1, C24.1, C25.1, C26.1, C27.1, U1.E9, U1.F7, U1.F8, U1.F9, U1.G11, U1.J6, U1.J7, U1.K9, U1.K11
/FPGA_CDONE: R3.2, R22.1, U1.R1
/FPGA_CFG_CBSEL0: R18.1, U1.C7
/FPGA_CFG_CBSEL1: R19.1, U1.D7
/FPGA_CFG_CBUS0: R9.2, U1.K13
/FPGA_CFG_CBUS1: R8.2, U1.L14
/FPGA_CFG_CBUS2: R7.2, U1.R16
/FPGA_CFG_CSI: R4.2, U1.N3
/FPGA_CFG_NSTATUS: R17.2, U1.B8
/FPGA_CFG_TEST_N: R5.2, U1.L12
/FPGA_CLK_50M: R1.2, U1.H3
/FPGA_CLK_SOURCE: R1.1, Y1.3
/FPGA_ENDPOINT_READY: R23.1, U1.C4
/FPGA_FLASH_CCK: R2.2, U2.6
/FPGA_FLASH_CCK_SOURCE: R2.1, U1.M3
/FPGA_FLASH_CS_N: R6.2, U1.P3, U2.1
/FPGA_FLASH_IO2: R14.2, U2.3
/FPGA_FLASH_IO3: R15.2, U2.7
/FPGA_FLASH_MISO: U1.N1, U2.2
/FPGA_FLASH_MOSI: U1.L3, U2.5
/FPGA_JTAG_TCK: R10.2, U1.M2
/FPGA_JTAG_TDI: R11.2, U1.K5
/FPGA_JTAG_TDO: R13.2, U1.L5
/FPGA_JTAG_TMS: R12.2, U1.M1
/FPGA_LOCAL_RESET_N: R20.2, R21.1, U1.P1, U3.4
/FPGA_MOTION_REQUEST: R24.1, U1.B3
/FPGA_PROGRESS_WDI: R25.1, U1.E4
/FPGA_SERVICE_RUN_N: R16.2, U3.2, U5.2
/FPGA_USER_RESET_DELAYED: U4.4, U5.1
/FPGA_USER_RESET_N: U1.D5, U5.4
/FPGA_USER_RESET_RC: C39.1, R22.2, U4.2
/IO_3V3: C10.1, C11.1, C12.1, C13.1, C14.1, C15.1, C16.1, C17.1, C18.1, C19.1, C20.1, C21.1, C22.1, C23.1, C28.1, C29.1, C30.1, C31.1, C32.1, C33.1, C34.1, C35.1, C36.1, C37.1, C38.1, R3.1, R4.1, R5.1, R6.1, R7.1, R8.1, R9.1, R10.1, R11.1, R12.1, R13.1, R14.1, R15.1, R16.1, R17.1, R20.1, U1.E10, U1.F6, U1.F10, U1.F11, U1.G6, U1.H6, U1.H7, U1.J10, U1.J11, U1.K6, U1.L6, U1.L7, U1.L10, U1.L11, U2.8, U3.5, U4.5, U5.5, Y1.1, Y1.4
/LOGIC_GND: C1.2, C2.2, C3.2, C4.2, C5.2, C6.2, C7.2, C8.2, C9.2, C10.2, C11.2, C12.2, C13.2, C14.2, C15.2, C16.2, C17.2, C18.2, C19.2, C20.2, C21.2, C22.2, C23.2, C24.2, C25.2, C26.2, C27.2, C28.2, C29.2, C30.2, C31.2, C32.2, C33.2, C34.2, C35.2, C36.2, C37.2, C38.2, C39.2, R18.2, R19.2, R21.2, R23.2, R24.2, R25.2, U1.A1, U1.A5, U1.A12, U1.A16, U1.D2, U1.D15, U1.G7, U1.G8, U1.G9, U1.G10, U1.H8, U1.H9, U1.H10, U1.H11, U1.J1, U1.J8, U1.J9, U1.J16, U1.K7, U1.K8, U1.K10, U1.L8, U1.L9, U1.N2, U1.N15, U1.R7, U1.R10, U1.T1, U1.T4, U1.T13, U1.T16, U2.4, U3.3, U4.3, U5.3, Y1.2
