DeadlySIn777/Controller/hardware/board_review/revisions/20260930-06-build-incomplete/motion-card-placement.kicad_pcb

## KiCad design hardware/board_review/revisions/20260930-06-build-incomplete/motion-card-placement.kicad_pcb (2026-10-18)

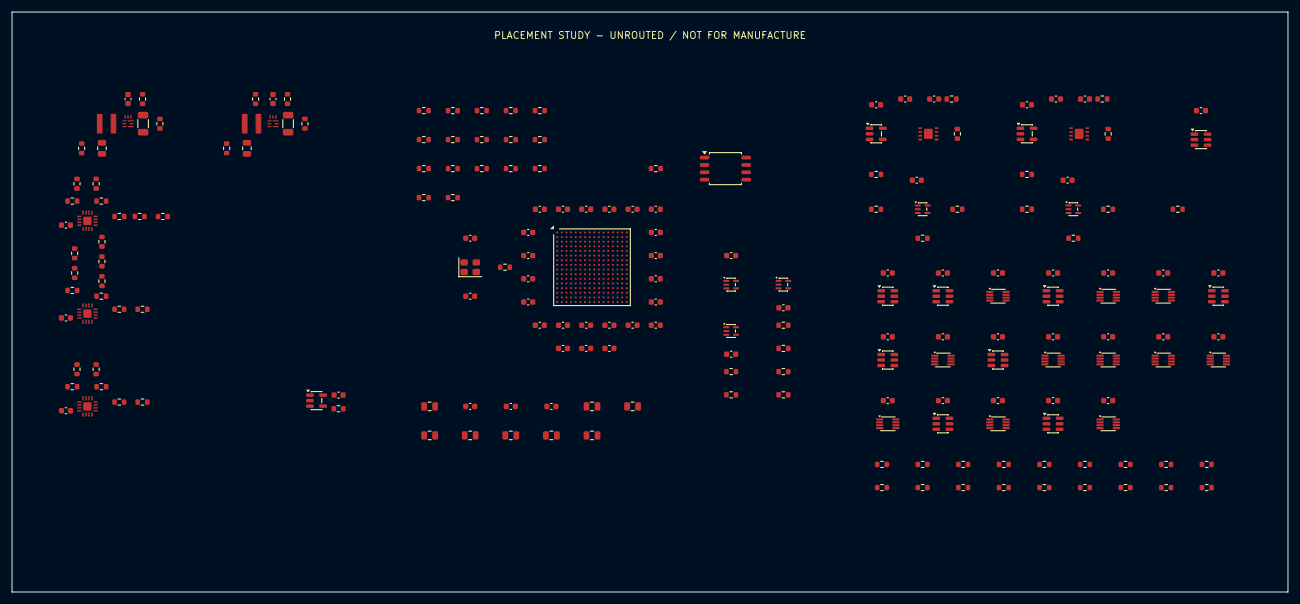
[picture p72: board hardware/board_review/revisions/20260930-06-build-incomplete/motion-c… from above]

Board: 6 copper layers, 220.0 x 100.0 mm, 203 parts (0 on the bottom side), 103 nets, no tracks yet.

Parts:
C1001, C1002, C1003, C1004, C1005, C1006, C1007, C1008, C1009, C1010, C1011, C1012, C1013, C1014, C1015, C1016, C1017, C1018, C1019, C1020, C1021, C1022, C1023, C1035, C1038: 885012206046; C_0603_1608Metric
C1024, C1028, C1029, C1030, C1031, C1032, C1033, C1034: 885012207053; C_0805_2012Metric
C1025, C1026, C1027, C1036, C1039: 885012206052; C_0603_1608Metric
C1037: 885012206040; C_0603_1608Metric
C2001, C2004: C3216X7R1E106K160AB; C_1206_3216Metric
C2002, C2005: C2012X7S1A226M125AC; C_0805_2012Metric
C2003, C2006: GRM1885C1H682JA01D; C_0603_1608Metric
C2007, C2008, C2009, C2010, C3003, C3004, C3005, C3006, C3007, C3008, C3009, C4001, C4002, C4003, C4004, C4005, C4006, C4007, C4008, C4009, C4010, C4011, C4012, C4013, C4014, C4015, C4016, C4017, C4018, C4019: GRM188R71E104KA01D; C_0603_1608Metric
C3001, C3002: CL10C332JB8NNNC; C_0603_1608Metric
L2001: XGL4020-222MEC; XGL4020
L2002: XGL4020-102MEC; XGL4020
R1001, R1002: CRCW060333R0FKEA; R_0603_1608Metric
R1003, R1004, R1005, R1006, R1007, R1008, R1009, R1010, R1011, R1012, R1013, R1014, R1015, R1016, R1017, R1018, R1019, R1022, R1023, R1024, R1025, R2002, R2006, R2103, R2105, R3001, R3002, R4008, R4009, R4010, R4011, R4012, R4013, R4014, R4015, R4016, R4017, R4018: CRCW060310K0FKEA; R_0603_1608Metric
R1020, R2106: CRCW060347K0FKEA; R_0603_1608Metric
R1021: CRCW06031K00FKEA; R_0603_1608Metric
R2001: CRCW060376K8FKEA; R_0603_1608Metric
R2003, R2007, R3006, R3008, R3009, R3010, R3011, R3012: CRCW0603100KFKEA; R_0603_1608Metric
R2005: CRCW060332K4FKEA; R_0603_1608Metric
R2008: CRCW0603301KFKEA; R_0603_1608Metric
R2021: PLT0603Z8792LST1; R_0603_1608Metric
R2027, R2035, R2067, R2075: PLT0603Z1002LST1; R_0603_1608Metric
R2029: PLT0603Z9212LST1; R_0603_1608Metric
R2041: PLT0603Z1071LST1; R_0603_1608Metric
R2042: PLT0603Z2610LST1; R_0603_1608Metric
R2047, R2055: PLT0603Z1001LST1; R_0603_1608Metric
R2049: PLT0603Z1151LST1; R_0603_1608Metric
R2050: PLT0603Z3160LST1; R_0603_1608Metric
R2051: CRCW06034R02FKEA; R_0603_1608Metric
R2061: PLT0603Z5452LST1; R_0603_1608Metric
R2069: PLT0603Z5752LST1; R_0603_1608Metric
R2101, R2102: CRCW06033K30FKEA; R_0603_1608Metric
R2104: CRCW06036K80FKEA; R_0603_1608Metric
R2107: CRCW0603470KFKEA; R_0603_1608Metric
R2108, R3003, R3004, R3005, R3007, R3013, R4001, R4002, R4003, R4004, R4005, R4006, R4007: CRCW06034K70FKEA; R_0603_1608Metric
U1001: T20F256I4; T20F256_Efinix_NSMD
U1002: W25Q32JVSSIQ; SOIC-8_5.3x5.3mm_P1.27mm
U1003, U1005, U3006, U3007: SN74LVC1G08DCKR; SOT-353_SC-70-5
U1004: 74LVC1G17GW; SOT-353_SC-70-5
U2001, U2002: TPS62901RPJR; TPS62901_RPJ9
U2003, U2004, U2005: LTC2962HUD#TRPBF; LTC2962_UD16
U2006: SN74LVC1G17DBVR; SOT-23-5
U3001, U3002: TPS3851G18SDRBT; TPS3851_DRB8
U3003, U3004: SN74LVC1G34DBVR; SOT-23-5
U3005: SN74LVC2G17DBVR; SOT-23-6
U4001, U4002, U4004, U4007, U4008, U4010: SN74LVC1G11DBVR; SOT-23-6
U4003, U4009, U4019: SN74LVC2G08DCUR; VSSOP-8_2.3x2mm_P0.5mm
U4005, U4006, U4011, U4012, U4013, U4014, U4015: SN74LVC2G74DCUR; VSSOP-8_2.3x2mm_P0.5mm
U4016, U4018: SN74LVC2G04DBVR; SOT-23-6
U4017: SN74LVC2G32DCUR; VSSOP-8_2.3x2mm_P0.5mm
Y1001: ASE-50.000MHZ-L-C-T; Oscillator_SMD_Abracon_ASE-4Pin_3.2x2.5mm

Connections:
/CORE_1V2: C1001.1, C1002.1, C1003.1, C1004.1, C1005.1, C1006.1, C1007.1, C1008.1, C1009.1, C1024.1, C1025.1, C1026.1, C1027.1, C2002.1, L2001.2, R2003.1, R2041.1, R2049.1, U1001.E9, U1001.F7, U1001.F8, U1001.F9, U1001.G11, U1001.J6, U1001.J7, U1001.K9, U1001.K11, U2001.3
/FPGA_CRESET_N: R2108.1, R4008.1, U1003.1, U2006.4, U4001.1, U4019.1, U4019.5
/FPGA_ENDPOINT_READY: R1023.1, R4001.1, U1001.C4, U4003.6, U4004.6
/FPGA_MOTION_REQUEST: R1024.1, R3003.1, U1001.B3, U3006.1, U4005.1, U4007.3
/FPGA_OUTPUT_REQUEST: R3004.1, U3007.1, U4006.1, U4008.3
/FPGA_PROGRESS_M: R1025.1, R3005.1, U1001.E4, U3003.2
/FPGA_USER_RESET_N: R3013.1, R4009.1, U1001.D5, U1005.4, U3006.2, U3007.2, U4001.3
/IO_3V3: C1010.1, C1011.1, C1012.1, C1013.1, C1014.1, C1015.1, C1016.1, C1017.1, C1018.1, C1019.1, C1020.1, C1021.1, C1022.1, C1023.1, C1028.1, C1029.1, C1030.1, C1031.1, C1032.1, C1033.1, C1034.1, C1035.1, C1036.1, C1037.1, C1038.1, C2005.1, C2010.1, C3003.1, C3004.1, C3005.1, C3006.1, C3007.1, C3008.1, C3009.1, C4001.1, C4002.1, C4003.1, C4004.1, C4005.1, C4006.1, C4007.1, C4008.1, C4009.1, C4010.1, C4011.1, C4012.1, C4013.1, C4014.1, C4015.1, C4016.1, C4017.1, C4018.1, C4019.1, L2002.2, R1003.1, R1004.1, R1005.1, R1006.1, R1007.1, R1008.1, R1009.1, R1010.1, R1011.1, R1012.1, R1013.1, R1014.1, R1015.1, R1016.1, R1017.1, R1020.1, R2007.1, R2061.1, R2069.1, R3001.1, R3002.1, U1001.E10, U1001.F6, U1001.F10, U1001.F11, U1001.G6, U1001.H6, U1001.H7, U1001.J10, U1001.J11, U1001.K6, U1001.L6, U1001.L7, U1001.L10, U1001.L11, U1002.8, U1003.5, U1004.5, U1005.5, U2002.3, U2006.5, U3001.1, U3002.1, U3003.5, U3004.5, U3005.5, U3006.5, U3007.5, U4001.5, U4002.5, U4003.8, U4004.5, U4005.2, U4005.7, U4005.8, U4006.2, U4006.7, U4006.8, U4007.5, U4008.5, U4009.8, U4010.5, U4011.2, U4011.7, U4011.8, U4012.2, U4012.7, U4012.8, U4013.2, U4013.7, U4013.8, U4014.7, U4014.8, U4015.7, U4015.8, U4016.5, U4017.8, U4018.5, U4019.8, Y1001.1, Y1001.4
/LOGIC_GND: C1001.2, C1002.2, C1003.2, C1004.2, C1005.2, C1006.2, C1007.2, C1008.2, C1009.2, C1010.2, C1011.2, C1012.2, C1013.2, C1014.2, C1015.2, C1016.2, C1017.2, C1018.2, C1019.2, C1020.2, C1021.2, C1022.2, C1023.2, C1024.2, C1025.2, C1026.2, C1027.2, C1028.2, C1029.2, C1030.2, C1031.2, C1032.2, C1033.2, C1034.2, C1035.2, C1036.2, C1037.2, C1038.2, C1039.2, C2001.2, C2002.2, C2003.2, C2004.2, C2005.2, C2006.2, C2007.2, C2008.2, C2009.2, C2010.2, C3001.2, C3002.2, C3003.2, C3004.2, C3005.2, C3006.2, C3007.2, C3008.2, C3009.2, C4001.2, C4002.2, C4003.2, C4004.2, C4005.2, C4006.2, C4007.2, C4008.2, C4009.2, C4010.2, C4011.2, C4012.2, C4013.2, C4014.2, C4015.2, C4016.2, C4017.2, C4018.2, C4019.2, R1018.2, R1019.2, R1021.2, R1023.2, R1024.2, R1025.2, R2001.2, R2002.2, R2003.2, R2005.2, R2006.2, R2007.2, R2008.2, R2027.2, R2035.2, R2047.2, R2055.2, R2067.2, R2075.2, R2103.2, R2105.2, R2107.2, R2108.2, R3003.2, R3004.2, R3005.2, R3006.2, R3007.2, R3008.2, R3009.2, R3010.2, R3011.2, R3012.2, R3013.2, R4001.2, R4002.2, R4003.2, R4004.2, R4005.2, R4006.2, R4007.2, R4008.2, R4009.2, R4010.2, R4011.2, R4012.2, R4013.2, R4014.2, R4015.2, R4016.2, R4017.2, R4018.2, U1001.A1, U1001.A5, U1001.A12, U1001.A16, U1001.D2, U1001.D15, U1001.G7, U1001.G8, U1001.G9, U1001.G10, U1001.H8, U1001.H9, U1001.H10, U1001.H11, U1001.J1, U1001.J8, U1001.J9, U1001.J16, U1001.K7, U1001.K8, U1001.K10, U1001.L8, U1001.L9, U1001.N2, U1001.N15, U1001.R7, U1001.R10, U1001.T1, U1001.T4, U1001.T13, U1001.T16, U1002.4, U1003.3, U1004.3, U1005.3, U2001.4, U2001.9, U2002.4, U2003.3, U2003.7, U2003.11, U2003.17, U2004.3, U2004.7, U2004.11, U2004.17, U2005.3, U2005.7, U2005.11, U2005.17, U2006.3, U3001.4, U3001.9, U3002.4, U3002.9, U3003.3, U3004.3, U3005.2, U3006.3, U3007.3, U4001.2, U4002.2, U4003.4, U4004.2, U4005.4, U4006.4, U4007.2, U4008.2, U4009.4, U4010.2, U4011.4, U4012.4, U4013.4, U4014.4, U4015.4, U4016.2, U4017.4, U4018.2, U4019.4, Y1001.2
/RAW_INHIBIT_N: U1001.A2, U4003.5, U4003.7, U4007.6
/TX_PERMIT: R4015.1, U1001.E6, U4007.4, U4009.5, U4010.1, U4011.6
/WD_M_OK: R3009.1, U3005.6, U4003.2, U4016.1
/WD_M_SET1_BUF: R3011.1, U3001.5, U3006.4, U4017.2
/WD_O_OK: R3010.1, U3005.4, U4004.3, U4009.2, U4016.3
/WD_O_SET1_BUF: R3012.1, U3002.5, U3007.4, U4017.6
/fpga_core/FPGA_CDONE: R1003.2, R1022.1, U1001.R1
/fpga_core/FPGA_CFG_CBSEL0: R1018.1, U1001.C7
/fpga_core/FPGA_CFG_CBSEL1: R1019.1, U1001.D7
/fpga_core/FPGA_CFG_CBUS0: R1009.2, U1001.K13
/fpga_core/FPGA_CFG_CBUS1: R1008.2, U1001.L14
/fpga_core/FPGA_CFG_CBUS2: R1007.2, U1001.R16
/fpga_core/FPGA_CFG_CSI: R1004.2, U1001.N3
/fpga_core/FPGA_CFG_NSTATUS: R1017.2, U1001.B8
/fpga_core/FPGA_CFG_TEST_N: R1005.2, U1001.L12
/fpga_core/FPGA_CLK_50M: R1001.2, U1001.H3
/fpga_core/FPGA_CLK_SOURCE: R1001.1, Y1001.3
/fpga_core/FPGA_FLASH_CCK: R1002.2, U1002.6
/fpga_core/FPGA_FLASH_CCK_SOURCE: R1002.1, U1001.M3
/fpga_core/FPGA_FLASH_CS_N: R1006.2, U1001.P3, U1002.1
/fpga_core/FPGA_FLASH_IO2: R1014.2, U1002.3
/fpga_core/FPGA_FLASH_IO3: R1015.2, U1002.7
/fpga_core/FPGA_FLASH_MISO: U1001.N1, U1002.2
/fpga_core/FPGA_FLASH_MOSI: U1001.L3, U1002.5
/fpga_core/FPGA_JTAG_TCK: R1010.2, U1001.M2
/fpga_core/FPGA_JTAG_TDI: R1011.2, U1001.K5
/fpga_core/FPGA_JTAG_TDO: R1013.2, U1001.L5
/fpga_core/FPGA_JTAG_TMS: R1012.2, U1001.M1
/fpga_core/FPGA_LOCAL_RESET_N: R1020.2, R1021.1, U1001.P1, U1003.4
/fpga_core/FPGA_SERVICE_RUN_N: R1016.2, U1003.2, U1005.2
/fpga_core/FPGA_USER_RESET_DELAYED: U1004.4, U1005.1
/fpga_core/FPGA_USER_RESET_RC: C1039.1, R1022.2, U1004.2
/mc_local_power/CORE_1V2_EN: R2002.1, R2102.2, R2103.1, U2001.5
/mc_local_power/CORE_1V2_MODE: R2001.1, U2001.7
/mc_local_power/CORE_1V2_OV_SENSE: R2051.2, R2055.1, U2004.15
/mc_local_power/CORE_1V2_SS: C2003.1, U2001.8
/mc_local_power/CORE_1V2_SW: L2001.1, U2001.2
/mc_local_power/CORE_1V2_UV_SENSE: R2042.2, R2047.1, U2004.16
/mc_local_power/CORE_5V: C2001.1, C2004.1, C2007.1, C2008.1, C2009.1, R2021.1, R2029.1, R2101.1, R2104.1, R2106.1, U2001.6, U2002.6, U2003.1, U2003.2, U2003.4, U2003.10, U2003.13, U2003.14, U2004.1, U2004.4, U2004.10, U2004.13, U2004.14, U2005.1, U2005.4, U2005.10, U2005.13, U2005.14
/mc_local_power/CORE_5V_OV_SENSE: R2029.2, R2035.1, U2003.15
/mc_local_power/CORE_5V_UV_SENSE: R2021.2, R2027.1, U2003.16
/mc_local_power/IO_3V3_EN: R2006.1, R2104.2, R2105.1, U2002.5, U2004.12, U2005.2
/mc_local_power/IO_3V3_MODE: R2005.1, U2002.7
/mc_local_power/IO_3V3_OV_SENSE: R2069.2, R2075.1, U2005.15
/mc_local_power/IO_3V3_SS: C2006.1, U2002.8
/mc_local_power/IO_3V3_SW: L2002.1, U2002.2
/mc_local_power/IO_3V3_UV_SENSE: R2061.2, R2067.1, U2005.16
/mc_local_power/IO_3V3_VSET: R2008.1, U2002.9
/mc_local_power/MC_RAILS_OK_5V: R2106.2, R2107.1, U2005.12, U2006.2
/mc_local_power/MC_SEQ_5V_OK: R2101.2, R2102.1, U2003.12, U2004.2
/mc_local_power/MC_SEQ_OV2_1: R2049.2, R2050.1
/mc_local_power/MC_SEQ_OV2_2: R2050.2, R2051.1
/mc_local_power/MC_SEQ_REF1: U2003.5, U2003.6, U2003.8, U2003.9
/mc_local_power/MC_SEQ_REF2: U2004.5, U2004.6, U2004.8, U2004.9
/mc_local_power/MC_SEQ_REF3: U2005.5, U2005.6, U2005.8, U2005.9
/mc_local_power/MC_SEQ_UV2_1: R2041.2, R2042.1
/mc_permission/ARM_M_Q: U4005.5, U4007.1
/mc_permission/ARM_O_Q: U4006.5, U4008.1
/mc_permission/BANK_B_BUFFER_ENABLE_QUALIFIED: R4014.1, U4013.6
/mc_permission/BASE_FIRST: U4001.4, U4002.1
/mc_permission/BASE_OK: U4002.4, U4003.1, U4004.1, U4009.1
/mc_permission/DIC_OK_QUALIFIED: R4010.1, U4001.6
/mc_permission/EXT_PERMIT_3V3: R4011.1, U4002.3
/mc_permission/LATCH_CLEAR_M_N: U4003.3, U4005.6
/mc_permission/LATCH_CLEAR_O_N: U4004.4, U4006.6
/mc_permission/OPI_REARM_BOE: R4004.1, U4013.1
/mc_permission/OPI_REARM_OUT: R4003.1, U4012.1
/mc_permission/OPI_REARM_TX: R4002.1, U4011.1
/mc_permission/OUTPUT_RAW_OK: U4008.6, U4009.7
/mc_permission/OUT_PERMIT: R4016.1, U4008.4, U4010.3, U4012.6
/mc_permission/PERMIT_OUT_DRIVE: R4018.1, U4009.3
/mc_permission/PERMIT_OUT_REQ: R4007.1, U4009.6
/mc_permission/PROCESS_PERMIT_EXT_3V3: R4013.1, U4010.6
/mc_permission/PROC_PERMIT: R4017.1, U4010.4
/mc_permission/TAMPER_CLEAR_N: R4012.1, U4002.6
/mc_permission/WD_M_FALL_CLK: U4014.1, U4016.6
/mc_permission/WD_M_RECORD_CLEAR_N: U4018.6, U4019.2
/mc_permission/WD_M_TRIP_CLEAR_N: U4014.6, U4019.7
/mc_permission/WD_M_TRIP_D: U4014.2, U4017.7
/mc_permission/WD_M_TRIP_Q: U4014.5, U4017.1
/mc_permission/WD_O_FALL_CLK: U4015.1, U4016.4
/mc_permission/WD_O_RECORD_CLEAR_N: U4018.4, U4019.6
/mc_permission/WD_O_TRIP_CLEAR_N: U4015.6, U4019.3
/mc_permission/WD_O_TRIP_D: U4015.2, U4017.3
/mc_permission/WD_O_TRIP_Q: U4015.5, U4017.5
/mc_permission/WD_REARM_M: R4005.1, U4018.1
/mc_permission/WD_REARM_O: R4006.1, U4018.3
/watchdog_conditioning/FPGA_PROGRESS_O: R3007.1, U3004.2
/watchdog_conditioning/WD_M_CWD: C3001.1, U3001.2
/watchdog_conditioning/WD_M_HEALTH_RAW: R3001.2, U3001.7, U3001.8, U3005.1
/watchdog_conditioning/WD_M_WDI_BUF: R3006.1, U3001.6, U3003.4
/watchdog_conditioning/WD_O_CWD: C3002.1, U3002.2
/watchdog_conditioning/WD_O_HEALTH_RAW: R3002.2, U3002.7, U3002.8, U3005.3
/watchdog_conditioning/WD_O_WDI_BUF: R3008.1, U3002.6, U3004.4
