DeadlySIn777/Controller/hardware/board_review/revisions/20260930-21/motherboard-populated-candidate.kicad_pcb

## KiCad design hardware/board_review/revisions/20260930-21/motherboard-populated-candidate.kicad_pcb (2026-10-18)

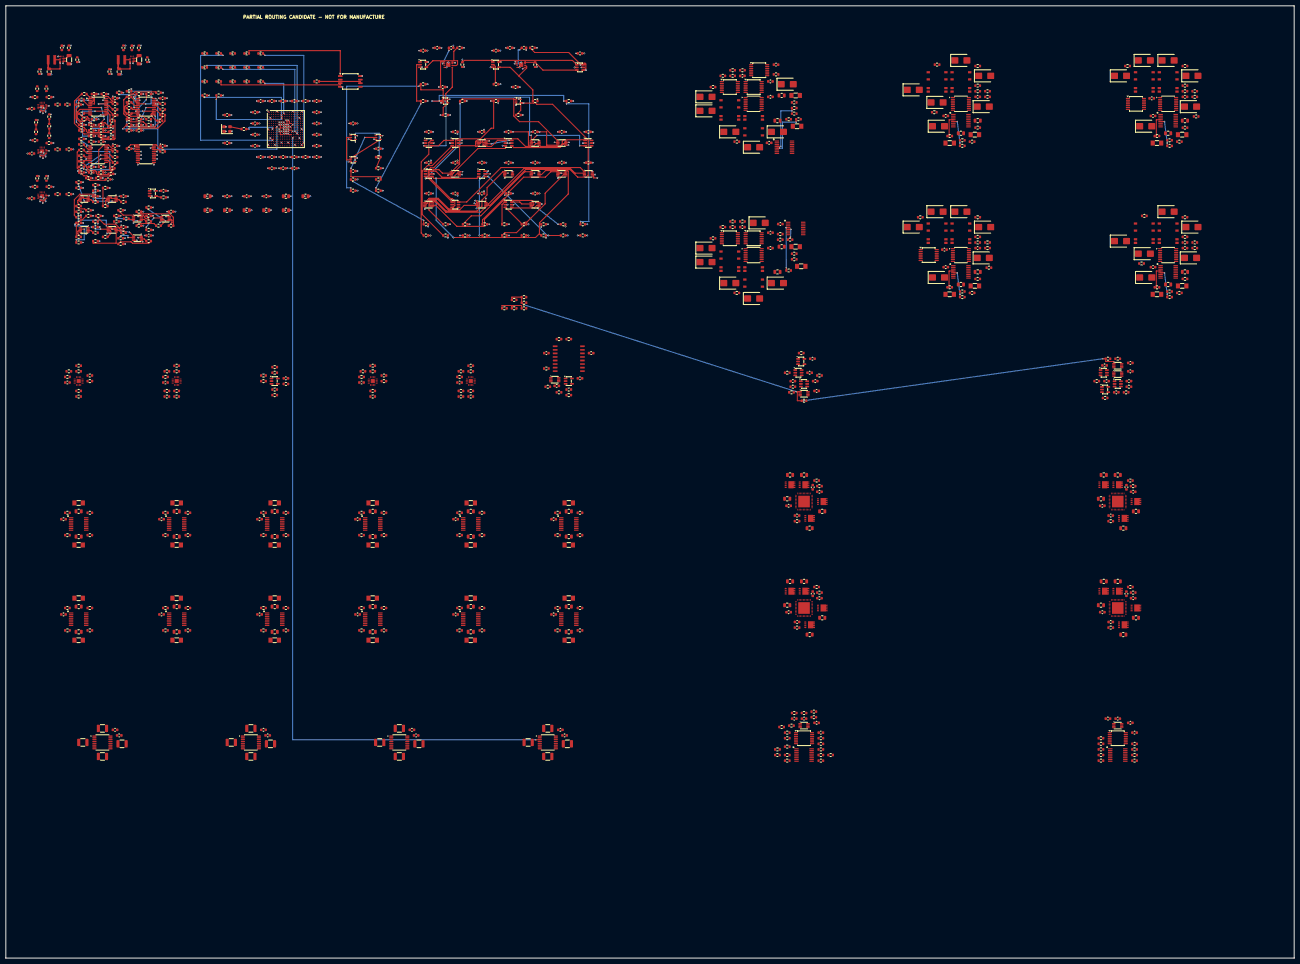
[picture p73: board motherboard-populated-candidate.kicad_pcb from above]

Board: 6 copper layers, 460.0 x 340.0 mm, 880 parts (0 on the bottom side), 637 nets.

Parts:
C1001, C1002, C1003, C1004, C1005, C1006, C1007, C1008, C1009, C1010, C1011, C1012, C1013, C1014, C1015, C1016, C1017, C1018, C1019, C1020, C1021, C1022, C1023, C1035, C1038: 885012206046; C_0603_1608Metric
C1024, C1028, C1029, C1030, C1031, C1032, C1033, C1034: 885012207053; C_0805_2012Metric
C1025, C1026, C1027, C1036, C1039: 885012206052; C_0603_1608Metric
C1037: 885012206040; C_0603_1608Metric
C2001, C2004: C3216X7R1E106K160AB; C_1206_3216Metric
C2002, C2005: C2012X7S1A226M125AC; C_0805_2012Metric
C2003, C2006: GRM1885C1H682JA01D; C_0603_1608Metric
C2007, C2008, C2009, C2010, C3003, C3004, C3005, C3006, C3007, C3008, C3009, C4001, C4002, C4003, C4004, C4005, C4006, C4007, C4008, C4009, C4010, C4011, C4012, C4013, C4014, C4015, C4016, C4017, C4018, C4019, C5001, C5002, C5003, C5004, C5005, C5006, C5007, C5008, C5009, C5010, C5011: GRM188R72A104KA35D; C_0603_1608Metric
C3001, C3002: CL10C332JB8NNNC; C_0603_1608Metric
C6001, C6002, C6003, C6004, C6005, C6006, C6007, C6008, C6010, C6012, C6015, C6018, C6021, C6024, C6027, C6030, C6031, C6032, C6033, C6034, C6035, C6036, C6037, C6038, C6039, C6040, C6041, C6042: 100nF; C_0603_1608Metric
C6009, C6011: 1000nF; C_0603_1608Metric
C6013, C6014, C6016, C6017, C6019, C6020, C6022, C6023, C6025, C6026, C6028, C6029: 10nF; C_0805_2012Metric
C7001, C7003, C7005, C7007: 100nF 100V X7R; C_0603_1608Metric
C7002, C7004, C7006, C7008: 1uF 16V X7R; C_0603_1608Metric
C8001, C8002, C8003, C8004, C8005, C8006, C8007, C8008, C8009, C8010, C8011, C8012, C8013, C8014, C8015, C8016, C8017, C8018, C8019, C8020, C8021, C8022, C8023, C8024: 10nF 100V C0G; C_0805_2012Metric
C8101, C8102, C8103, C8104, C8105, C8106, C8107, C8108, C8109, C8110, C8111, C8112: 100nF 25V X7R; C_0603_1608Metric
C9001, C9002, C9003, C9004, C9005, C9006, C9007, C9008, C9009: 100nF 100V X7R 10%; C_0603_1608Metric
C10001, C10002, C10003, C10004, C10007, C10008, C10016, C10017, C10023, C10024, C10025, C10026, C10029, C10030, C10038, C10039: 100nF 100V; C_0603_1608Metric
C10005, C10014, C10027, C10036: 0.1nF 50V; C_0603_1608Metric
C10006, C10015, C10028, C10037: 2200nF 16V; C_0805_2012Metric
C10009, C10018, C10031, C10040: 1000nF 50V; C_0603_1608Metric
C10010, C10011, C10012, C10013, C10019, C10020, C10021, C10022, C10032, C10033, C10034, C10035, C10041, C10042, C10043, C10044: 22nF 100V; C_0805_2012Metric
D6001, D6002, D6003, D6004, D6005, D6006, D6007, D6008, D6009, D6010, D6011, D6012, D6013, D6014, D6015, D6016, D6017, D6018, D6019, D6020, D6021, D6022, D6023, D6024, D6025, D6026, D6027, D6028, D6029, D6030, D6031, D6032, D6033, D6034, D6035, D6036: SMBJ33CA 33V bidirectional; D_SMB
L2001: XGL4020-222MEC; XGL4020
L2002: XGL4020-102MEC; XGL4020
R1001, R1002, R5001, R5002, R5003, R5004, R5005, R5006, R5007, R5008, R5009, R5010, R5011, R5012, R5013, R5014, R5015, R5016, R5017, R5018, R5019, R5020, R5021, R5022, R5023, R5024, R5025, R5026, R5027, R5028, R5029, R5030, R5031, R5032, R5033, R5034, R5035, R5036, R5037, R5038: CRCW060333R0FKEA; R_0603_1608Metric
R1003, R1004, R1005, R1006, R1007, R1008, R1009, R1010, R1011, R1012, R1013, R1014, R1015, R1016, R1017, R1018, R1019, R1022, R1023, R1024, R1025, R2002, R2006, R2103, R2105, R3001, R3002, R4008, R4009, R4010, R4011, R4012, R4013, R4014, R4015, R4016, R4017, R4018, R5077, R5078, R5079, R5080, R5081, R5082, R5083, R5084, R5085, R5086, R5087, R5088, R5089, R5090, R5091, R5092, R5093, R5094, R5095, R5096, R5097, R5098, R5099, R5100, R5101, R5102: CRCW060310K0FKEA; R_0603_1608Metric
R1020, R2106: CRCW060347K0FKEA; R_0603_1608Metric
R1021: CRCW06031K00FKEA; R_0603_1608Metric
R2001: CRCW060376K8FKEA; R_0603_1608Metric
R2003, R2007, R3006, R3008, R3009, R3010, R3011, R3012: CRCW0603100KFKEA; R_0603_1608Metric
R2005: CRCW060332K4FKEA; R_0603_1608Metric
R2008: CRCW0603301KFKEA; R_0603_1608Metric
R2021: PLT0603Z8792LST1; R_0603_1608Metric
R2027, R2035, R2067, R2075: PLT0603Z1002LST1; R_0603_1608Metric
R2029: PLT0603Z9212LST1; R_0603_1608Metric
R2041: PLT0603Z1071LST1; R_0603_1608Metric
R2042: PLT0603Z2610LST1; R_0603_1608Metric
R2047, R2055: PLT0603Z1001LST1; R_0603_1608Metric
R2049: PLT0603Z1151LST1; R_0603_1608Metric
R2050: PLT0603Z3160LST1; R_0603_1608Metric
R2051: CRCW06034R02FKEA; R_0603_1608Metric
R2061: PLT0603Z5452LST1; R_0603_1608Metric
R2069: PLT0603Z5752LST1; R_0603_1608Metric
R2101, R2102: CRCW06033K30FKEA; R_0603_1608Metric
R2104: CRCW06036K80FKEA; R_0603_1608Metric
R2107: CRCW0603470KFKEA; R_0603_1608Metric
R2108, R3003, R3004, R3005, R3007, R3013, R4001, R4002, R4003, R4004, R4005, R4006, R4007, R5039, R5040, R5041, R5042, R5043, R5044, R5045, R5046, R5047, R5048, R5049, R5050, R5051, R5052, R5053, R5054, R5055, R5056, R5057, R5058, R5059, R5060, R5061, R5062, R5063, R5064, R5065, R5066, R5067, R5068, R5069, R5070, R5071, R5072, R5073, R5074, R5075, R5076: CRCW06034K70FKEA; R_0603_1608Metric
R6001, R6002, R6003, R6004, R6005, R6006, R6007, R6008, R6009, R6010, R6011, R6012, R6013, R6014, R6015, R6016, R6017, R6018, R6019, R6020, R6021, R6022, R6023, R6024, R6026, R6028, R6030, R6032, R6034, R6036, R6038, R6040, R6042, R6044, R6046, R6048, R6087, R6089, R6091, R6093, R10001, R10002, R10003, R10004, R10005, R10006, R10007, R10008, R10009, R10010, R10011, R10012, R10013, R10014, R10016, R10019, R10021, R10022, R10023, R10024, R10025, R10026, R10027, R10028, R10029, R10030, R10031, R10032, R10033, R10034, R10036, R10039: 10000R 1%; R_0603_1608Metric
R6025, R6027, R6029, R6031, R6033, R6035, R6037, R6039, R6041, R6043, R6045, R6047: 220R 1%; R_0603_1608Metric
R6049, R6050: 330R 1%; R_0603_1608Metric
R6051, R6054, R6057, R6060, R6063, R6066, R6069, R6072, R6075, R6078, R6081, R6084: 1000R 1%; R_MiniMELF_MMA-0204
R6052, R6055, R6058, R6061, R6064, R6067, R6070, R6073, R6076, R6079, R6082, R6085, R8101, R8102, R8103, R8104, R8105, R8106, R8107, R8108, R8109, R8110, R8111, R8112, R8113, R8114, R8115, R8116, R8117, R8118, R8119, R8120, R8121, R8122, R8123, R8124: 562R 1%; R_0603_1608Metric
R6053, R6056, R6059, R6062, R6065, R6068, R6071, R6074, R6077, R6080, R6083, R6086, R12005, R12006: 100000R 1%; R_0603_1608Metric
R6088, R6092: 60400R 1%; R_0603_1608Metric
R6090, R6094: 4700R 1%; R_0603_1608Metric
R6095, R6096, R10017, R10020, R10037, R10040: 1000R 1%; R_0603_1608Metric
R7001, R7002, R7003, R7004, R7005, R7006, R7007, R7008, R7009, R7010, R7011, R7012, R7013, R7014: 120R 1% 0.5W / FIT; R_1210_3225Metric
R7015, R7016: 120R 1% 0.5W / DNP; R_1210_3225Metric
R8001, R8002, R8003, R8004, R8005, R8006, R8007, R8008, R8009, R8010, R8011, R8012, R8013, R8014, R8015, R8016, R8017, R8018, R8019, R8020, R8021, R8022, R8023, R8024: 1k MELF 1%; R_MiniMELF_MMA-0204
R8201, R8202, R8203, R8204, R8205, R8206, R8207, R8208, R8209, R8210, R8211, R8212, R8213, R8214, R8215, R8216, R8217, R8218, R8219, R8220, R8221, R8222, R8223, R8224: 100k 1%; R_0603_1608Metric
R9001, R9011: 87900R 0.01% 5ppm; R_0603_1608Metric
R9002, R9004, R9006, R9008, R9012, R9014, R9016, R9018, R9022, R9024, R9026, R9028, R9032, R9034, R9036, R9038: 10000R 0.01% 5ppm; R_0603_1608Metric
R9003, R9013: 92100R 0.01% 5ppm; R_0603_1608Metric
R9005, R9015: 54500R 0.01% 5ppm; R_0603_1608Metric
R9007, R9017: 57500R 0.01% 5ppm; R_0603_1608Metric
R9009, R9019, R9029, R9039, R9041, R9042, R9043, R9044: 10000R 1% 100ppm; R_0603_1608Metric
R9010, R9020, R9030, R9040: 100000R 1% 100ppm; R_0603_1608Metric
R9021, R9031: 86700R 0.01% 5ppm; R_0603_1608Metric
R9023, R9033: 93100R 0.01% 5ppm; R_0603_1608Metric
R9025, R9035: 355000R 0.01% 5ppm; R_0603_1608Metric
R9027, R9037: 580000R 0.01% 5ppm; R_0603_1608Metric
R9045, R9046: 1000R 1% 100ppm; R_0603_1608Metric
R10015, R10035: 13300R 0.1%; R_0603_1608Metric
R10018, R10038: 17800R 0.1%; R_0603_1608Metric
R12001, R12002, R12003, R12004: 33R 1%; R_0603_1608Metric
U1001: T20F256I4; T20F256_Efinix_NSMD
U1002: W25Q32JVSSIQ; SOIC-8_5.3x5.3mm_P1.27mm
U1003, U1005, U3006, U3007: SN74LVC1G08DCKR; SOT-353_SC-70-5
U1004: 74LVC1G17GW; SOT-353_SC-70-5
U2001, U2002: TPS62901RPJR; TPS62901_RPJ9
U2003, U2004, U2005, U9001, U9002, U9003, U9004: LTC2962HUD#PBF; LTC2962_UD16
U2006, U9005, U9006: SN74LVC1G17DBVR; SOT-23-5
U3001, U3002: TPS3851G18SDRBT; TPS3851_DRB8
U3003, U3004: SN74LVC1G34DBVR; SOT-23-5
U3005: SN74LVC2G17DBVR; SOT-23-6
U4001, U4002, U4004, U4007, U4008, U4010: SN74LVC1G11DBVR; SOT-23-6
U4003, U4009, U4019, U6042, U9008: SN74LVC2G08DCUR; VSSOP-8_2.3x2mm_P0.5mm
U4005, U4006, U4011, U4012, U4013, U4014, U4015: SN74LVC2G74DCUR; VSSOP-8_2.3x2mm_P0.5mm
U4016, U4018: SN74LVC2G04DBVR; SOT-23-6
U4017: SN74LVC2G32DCUR; VSSOP-8_2.3x2mm_P0.5mm
U5001, U5002, U5003, U5004: SN74LVC244APWR; TSSOP-20_4.4x6.5mm_P0.65mm
U5005, U5006, U5007, U5008, U5009, U5010, U5011: SN74LVC2G126DCUR; VSSOP-8_2.3x2mm_P0.5mm
U6001, U6002, U6003, U6004, U6005, U6006: AM26C31IPWR; TSSOP-16_4.4x5mm_P0.65mm
U6007, U6008: 74LVC07APW,118; TSSOP-14_4.4x5mm_P0.65mm
U6009, U6011, U6013, U6015, U6017, U6019, U6021, U6023, U6025, U6027, U6029, U6031: TLP3640A(TPL,E; TLP3640A_SO4_11-3C1
U6010, U6012, U6014, U6016, U6018, U6020, U6022, U6024, U6026, U6028, U6030, U6032: TLP4176A(TP,F; TLP4176A_2.54SOP4_11-5H1S
U6033, U6034: TPS22918DBVR; SOT-23-6
U6035, U6036, U6037, U6038, U6039, U6040, U8001, U8002, U8003, U8004, U8005, U8006, U8007, U8008, U8009, U8010, U8011, U8012: ISO1212DBQR; ISO1212_DBQ16_TI
U6041, U6045: LTC6994IS6-2#TRPBF; TSOT-23-6
U6043, U6044, U10001, U10014: SN74LVC1G74DCUR; VSSOP-8_2.3x2mm_P0.5mm
U6046, U6047: 74LVC14APW,118; TSSOP-14_4.4x5mm_P0.65mm
U6048, U6049, U6050: SN74LVC00APWR; TSSOP-14_4.4x5mm_P0.65mm
U6051, U6052: 74AHCT1G17GVH; SOT-23-5
U7001, U7002, U7003, U7004: AM26LV32EIPWR; TSSOP-16_4.4x5mm_P0.65mm
U9007: ISO7720FDWR; ISO7720_DW16_TI_HV
U10002, U10015: SN74LVC08APWR; TSSOP-14_4.4x5mm_P0.65mm
U10003, U10016: ISO7762FDBQR; ISO7762_DBQ16_TI
U10004, U10009, U10017, U10022: TPS274C65ASRHAR; TPS274C65_RHA40_TI
U10005, U10006, U10007, U10008, U10010, U10011, U10012, U10013, U10018, U10019, U10020, U10021, U10023, U10024, U10025, U10026: CSD19538Q3AT; CSD19538_DNH8_TI
Y1001: ASE-50.000MHZ-L-C-T; Oscillator_SMD_Abracon_ASE-4Pin_3.2x2.5mm

Connections:
/BANK_B_BUFFER_ENABLE_QUALIFIED: R4014.1, R5076.1, U4013.6, U5005.1, U5005.7, U5006.1, U5006.7, U5007.1, U5007.7, U5008.1, U5008.7, U5009.1, U5009.7, U5010.1, U5010.7, U5011.1
/CORE_1V2: C1001.1, C1002.1, C1003.1, C1004.1, C1005.1, C1006.1, C1007.1, C1008.1, C1009.1, C1024.1, C1025.1, C1026.1, C1027.1, C2002.1, L2001.2, R2003.1, R2041.1, R2049.1, U1001.E9, U1001.F7, U1001.F8, U1001.F9, U1001.G11, U1001.J6, U1001.J7, U1001.K9, U1001.K11, U2001.3
/DIR0_FPGA: R5040.1, U1001.J5, U5001.4
/DIR1_FPGA: R5042.1, U1001.K3, U5001.11
/DIR2_FPGA: R5044.1, U1001.K1, U5001.17
/DIR3_FPGA: R5046.1, U1001.H1, U5002.6
/DIR4_FPGA: R5048.1, U1001.H2, U5002.13
/DIR5_FPGA: R5050.1, U1001.G3, U5003.2
/DIR6_FPGA: R5052.1, U1001.G2, U5003.8
/DIR7_FPGA: R5054.1, U1001.C1, U5003.15
/DIR8_FPGA: R5056.1, U1001.F3, U5005.5
/DIR9_FPGA: R5058.1, U1001.E1, U5007.2
/DIR10_FPGA: R5060.1, U1001.G4, U5008.5
/DIR11_FPGA: R5062.1, U1001.B1, U5010.2
/EN0_N_FPGA: R5063.1, U1001.H12, U5001.6
/EN1_N_FPGA: R5064.1, U1001.J12, U5001.13
/EN2_N_FPGA: R5065.1, U1001.L16, U5002.2
/EN3_N_FPGA: R5066.1, U1001.M15, U5002.8
/EN4_N_FPGA: R5067.1, U1001.M16, U5002.15
/EN5_N_FPGA: R5068.1, U1001.P16, U5003.4
/EN6_N_FPGA: R5069.1, U1001.L15, U5003.11
/EN7_N_FPGA: R5070.1, U1001.K12, U5003.17
/EN8_N_FPGA: R5071.1, U1001.N14, U5006.2
/EN9_N_FPGA: R5072.1, U1001.N16, U5007.5
/EN10_N_FPGA: R5073.1, U1001.P15, U5009.2
/EN11_N_FPGA: R5074.1, U1001.M14, U5010.5
/FPGA_CRESET_N: R2108.1, R4008.1, U1003.1, U2006.4, U4001.1, U4019.1, U4019.5
/FPGA_ENDPOINT_READY: R1023.1, R4001.1, U1001.C4, U4003.6, U4004.6
/FPGA_MOTION_REQUEST: R1024.1, R3003.1, U1001.B3, U3006.1, U4005.1, U4007.3
/FPGA_OUTPUT_REQUEST: R3004.1, U1001.K4, U3007.1, U4006.1, U4008.3
/FPGA_PROGRESS_M: R1025.1, R3005.1, U1001.E4, U3003.2
/FPGA_USER_RESET_N: R3013.1, R4009.1, U1001.D5, U1005.4, U3006.2, U3007.2, U4001.3
/IO_3V3: C1010.1, C1011.1, C1012.1, C1013.1, C1014.1, C1015.1, C1016.1, C1017.1, C1018.1, C1019.1, C1020.1, C1021.1, C1022.1, C1023.1, C1028.1, C1029.1, C1030.1, C1031.1, C1032.1, C1033.1, C1034.1, C1035.1, C1036.1, C1037.1, C1038.1, C2005.1, C2010.1, C3003.1, C3004.1, C3005.1, C3006.1, C3007.1, C3008.1, C3009.1, C4001.1, C4002.1, C4003.1, C4004.1, C4005.1, C4006.1, C4007.1, C4008.1, C4009.1, C4010.1, C4011.1, C4012.1, C4013.1, C4014.1, C4015.1, C4016.1, C4017.1, C4018.1, C4019.1, C5001.1, C5002.1, C5003.1, C5004.1, C5005.1, C5006.1, C5007.1, C5008.1, C5009.1, C5010.1, C5011.1, C6007.1, C6008.1, C6015.1, C6018.1, C6021.1, C6024.1, C6027.1, C6030.1, C6034.1, C6035.1, C6036.1, C6038.1, C6039.1, C6040.1, C6041.1, C6042.1, C7001.1, C7002.1, C7003.1, C7004.1, C7005.1, C7006.1, C7007.1, C7008.1, C8101.1, C8102.1, C8103.1, C8104.1, C8105.1, C8106.1, C8107.1, C8108.1, C8109.1, C8110.1, C8111.1, C8112.1, C9005.1, C9006.1, C9008.1, C9009.1, C10001.1, C10002.1, C10003.1, C10023.1, C10024.1, C10025.1, L2002.2, R1003.1, R1004.1, R1005.1, R1006.1, R1007.1, R1008.1, R1009.1, R1010.1, R1011.1, R1012.1, R1013.1, R1014.1, R1015.1, R1016.1, R1017.1, R1020.1, R2007.1, R2061.1, R2069.1, R3001.1, R3002.1, R5063.2, R5064.2, R5065.2, R5066.2, R5067.2, R5068.2, R5069.2, R5070.2, R5071.2, R5072.2, R5073.2, R5074.2, R6026.2, R6028.2, R6030.2, R6032.2, R6034.2, R6036.2, R6038.2, R6040.2, R6042.2, R6044.2, R6046.2, R6048.2, R9005.1, R9007.1, R9015.1, R9017.1, R10008.2, R10028.2, U1001.E10, U1001.F6, U1001.F10, U1001.F11, U1001.G6, U1001.H6, U1001.H7, U1001.J10, U1001.J11, U1001.K6, U1001.L6, U1001.L7, U1001.L10, U1001.L11, U1002.8, U1003.5, U1004.5, U1005.5, U2002.3, U2006.5, U3001.1, U3002.1, U3003.5, U3004.5, U3005.5, U3006.5, U3007.5, U4001.5, U4002.5, U4003.8, U4004.5, U4005.2, U4005.7, U4005.8, U4006.2, U4006.7, U4006.8, U4007.5, U4008.5, U4009.8, U4010.5, U4011.2, U4011.7, U4011.8, U4012.2, U4012.7, U4012.8, U4013.2, U4013.7, U4013.8, U4014.7, U4014.8, U4015.7, U4015.8, U4016.5, U4017.8, U4018.5, U4019.8, U5001.20, U5002.20, U5003.20, U5004.20, U5005.8, U5006.8, U5007.8, U5008.8, U5009.8, U5010.8, U5011.8, U6007.14, U6008.14, U6035.2, U6035.3, U6036.2, U6036.3, U6037.2, U6037.3, U6038.2, U6038.3, U6039.2, U6039.3, U6040.2, U6040.3, U6042.8, U6043.2, U6043.7, U6043.8, U6044.2, U6044.7, U6044.8, U6046.14, U6047.14, U6048.14, U6049.14, U6050.14, U7001.4, U7001.12, U7001.16, U7002.4, U7002.12, U7002.16, U7003.4, U7003.12, U7003.16, U7004.4, U7004.12, U7004.16, U8001.2, U8001.3, U8002.2, U8002.3, U8003.2, U8003.3, U8004.2, U8004.3, U8005.2, U8005.3, U8006.2, U8006.3, U8007.2, U8007.3, U8008.2, U8008.3, U8009.2, U8009.3, U8010.2, U8010.3, U8011.2, U8011.3, U8012.2, U8012.3, U9005.5, U9006.5, U9007.14, U9008.8, U10001.2, U10001.7, U10001.8, U10002.14, U10003.1, U10014.2, U10014.7, U10014.8, U10015.14, U10016.1, Y1001.1, Y1001.4
/LOGIC_GND: C1001.2, C1002.2, C1003.2, C1004.2, C1005.2, C1006.2, C1007.2, C1008.2, C1009.2, C1010.2, C1011.2, C1012.2, C1013.2, C1014.2, C1015.2, C1016.2, C1017.2, C1018.2, C1019.2, C1020.2, C1021.2, C1022.2, C1023.2, C1024.2, C1025.2, C1026.2, C1027.2, C1028.2, C1029.2, C1030.2, C1031.2, C1032.2, C1033.2, C1034.2, C1035.2, C1036.2, C1037.2, C1038.2, C1039.2, C2001.2, C2002.2, C2003.2, C2004.2, C2005.2, C2006.2, C2007.2, C2008.2, C2009.2, C2010.2, C3001.2, C3002.2, C3003.2, C3004.2, C3005.2, C3006.2, C3007.2, C3008.2, C3009.2, C4001.2, C4002.2, C4003.2, C4004.2, C4005.2, C4006.2, C4007.2, C4008.2, C4009.2, C4010.2, C4011.2, C4012.2, C4013.2, C4014.2, C4015.2, C4016.2, C4017.2, C4018.2, C4019.2, C5001.2, C5002.2, C5003.2, C5004.2, C5005.2, C5006.2, C5007.2, C5008.2, C5009.2, C5010.2, C5011.2, C6001.2, C6002.2, C6003.2, C6004.2, C6005.2, C6006.2, C6007.2, C6008.2, C6009.2, C6010.2, C6011.2, C6012.2, C6015.2, C6018.2, C6021.2, C6024.2, C6027.2, C6030.2, C6031.2, C6032.2, C6033.2, C6034.2, C6035.2, C6036.2, C6037.2, C6038.2, C6039.2, C6040.2, C6041.2, C6042.2, C7001.2, C7002.2, C7003.2, C7004.2, C7005.2, C7006.2, C7007.2, C7008.2, C8101.2, C8102.2, C8103.2, C8104.2, C8105.2, C8106.2, C8107.2, C8108.2, C8109.2, C8110.2, C8111.2, C8112.2, C9001.2, C9002.2, C9005.2, C9006.2, C9008.2, C9009.2, C10001.2, C10002.2, C10003.2, C10023.2, C10024.2, C10025.2, R1018.2, R1019.2, R1021.2, R1023.2, R1024.2, R1025.2, R2001.2, R2002.2, R2003.2, R2005.2, R2006.2, R2007.2, R2008.2, R2027.2, R2035.2, R2047.2, R2055.2, R2067.2, R2075.2, R2103.2, R2105.2, R2107.2, R2108.2, R3003.2, R3004.2, R3005.2, R3006.2, R3007.2, R3008.2, R3009.2, R3010.2, R3011.2, R3012.2, R3013.2, R4001.2, R4002.2, R4003.2, R4004.2, R4005.2, R4006.2, R4007.2, R4008.2, R4009.2, R4010.2, R4011.2, R4012.2, R4013.2, R4014.2, R4015.2, R4016.2, R4017.2, R4018.2, R5039.2, R5040.2, R5041.2, R5042.2, R5043.2, R5044.2, R5045.2, R5046.2, R5047.2, R5048.2, R5049.2, R5050.2, R5051.2, R5052.2, R5053.2, R5054.2, R5055.2, R5056.2, R5057.2, R5058.2, R5059.2, R5060.2, R5061.2, R5062.2, R5075.2, R5076.2, R5077.2, R5078.2, R5079.2, R5080.2, R5081.2, R5082.2, R5083.2, R5084.2, R5085.2, R5086.2, R5087.2, R5088.2, R5089.2, R5090.2, R5091.2, R5092.2, R5093.2, R5094.2, R5095.2, R5096.2, R5097.2, R5098.2, R5099.2, R5100.2, R5101.2, R5102.2, R6001.2, R6002.2, R6003.2, R6004.2, R6005.2, R6006.2, R6007.2, R6008.2, R6009.2, R6010.2, R6011.2, R6012.2, R6013.2, R6014.2, R6015.2, R6016.2, R6017.2, R6018.2, R6019.2, R6020.2, R6021.2, R6022.2, R6023.2, R6024.2, R6049.2, R6050.2, R6053.2, R6056.2, R6059.2, R6062.2, R6065.2, R6068.2, R6071.2, R6074.2, R6077.2, R6080.2, R6083.2, R6086.2, R6087.2, R6088.2, R6089.2, R6090.2, R6091.2, R6092.2, R6093.2, R6094.2, R6095.2, R6096.2, R8201.2, R8202.2, R8203.2, R8204.2, R8205.2, R8206.2, R8207.2, R8208.2, R8209.2, R8210.2, R8211.2, R8212.2, R8213.2, R8214.2, R8215.2, R8216.2, R8217.2, R8218.2, R8219.2, R8220.2, R8221.2, R8222.2, R8223.2, R8224.2, R9002.2, R9004.2, R9006.2, R9008.2, R9010.2, R9012.2, R9014.2, R9016.2, R9018.2, R9020.2, R9041.2, R9042.2, R9043.2, R9044.2, R9045.2, R9046.2, R10001.2, R10002.2, R10003.2, R10004.2, R10005.2, R10006.2, R10007.2, R10021.2, R10022.2, R10023.2, R10024.2, R10025.2, R10026.2, R10027.2, R12005.2, R12006.2, U1001.A1, U1001.A5, U1001.A12, U1001.A16, U1001.D2, U1001.D15, U1001.G7, U1001.G8, U1001.G9, U1001.G10, U1001.H8, U1001.H9, U1001.H10, U1001.H11, U1001.J1, U1001.J8, U1001.J9, U1001.J16, U1001.K7, U1001.K8, U1001.K10, U1001.L8, U1001.L9, U1001.N2, U1001.N15, U1001.R7, U1001.R10, U1001.T1, U1001.T4, U1001.T13, U1001.T16, U1002.4, U1003.3, U1004.3, U1005.3, U2001.4, U2001.9, U2002.4, U2003.3, U2003.7, U2003.11, U2003.17, U2004.3, U2004.7, U2004.11, U2004.17, U2005.3, U2005.7, U2005.11, U2005.17, U2006.3, U3001.4, U3001.9, U3002.4, U3002.9, U3003.3, U3004.3, U3005.2, U3006.3, U3007.3, U4001.2, U4002.2, U4003.4, U4004.2, U4005.4, U4006.4, U4007.2, U4008.2, U4009.4, U4010.2, U4011.4, U4012.4, U4013.4, U4014.4, U4015.4, U4016.2, U4017.4, U4018.2, U4019.4, U5001.1, U5001.10, U5001.19, U5002.1, U5002.10, U5002.19, U5003.1, U5003.10, U5003.19, U5004.1, U5004.4, U5004.6, U5004.8, U5004.10, U5004.11, U5004.13, U5004.15, U5004.17, U5004.19, U5005.4, U5006.4, U5007.4, U5008.4, U5009.4, U5010.4, U5011.4, U5011.5, U5011.7, U6001.8, U6002.8, U6003.8, U6004.8, U6005.8, U6006.8, U6007.7, U6008.7, U6033.2, U6034.2, U6035.1, U6035.8, U6036.1, U6036.8, U6037.1, U6037.8, U6038.1, U6038.8, U6039.1, U6039.8, U6040.1, U6040.8, U6041.2, U6041.4, U6042.4, U6043.4, U6044.4, U6045.2, U6045.4, U6046.7, U6047.7, U6048.7, U6049.7, U6050.7, U6051.3, U6052.3, U7001.8, U7002.8, U7003.8, U7004.8, U8001.1, U8001.8, U8002.1, U8002.8, U8003.1, U8003.8, U8004.1, U8004.8, U8005.1, U8005.8, U8006.1, U8006.8, U8007.1, U8007.8, U8008.1, U8008.8, U8009.1, U8009.8, U8010.1, U8010.8, U8011.1, U8011.8, U8012.1, U8012.8, U9001.3, U9001.7, U9001.9, U9001.11, U9001.17, U9002.3, U9002.7, U9002.9, U9002.11, U9002.17, U9005.3, U9006.3, U9007.9, U9007.16, U9008.4, U10001.4, U10002.7, U10002.12, U10002.13, U10003.8, U10014.4, U10015.7, U10015.12, U10015.13, U10016.8, Y1001.2
/RAW_INHIBIT_N: U1001.A2, U4003.5, U4003.7, U4007.6
/STEP0_FPGA: R5039.1, U1001.P2, U5001.2
/STEP1_FPGA: R5041.1, U1001.J4, U5001.8
/STEP2_FPGA: R5043.1, U1001.J3, U5001.15
/STEP3_FPGA: R5045.1, U1001.K2, U5002.4
/STEP4_FPGA: R5047.1, U1001.L1, U5002.11
/STEP5_FPGA: R5049.1, U1001.H4, U5002.17
/STEP6_FPGA: R5051.1, U1001.G5, U5003.6
/STEP7_FPGA: R5053.1, U1001.F1, U5003.13
/STEP8_FPGA: R5055.1, U1001.E2, U5005.2
/STEP9_FPGA: R5057.1, U1001.D1, U5006.5
/STEP10_FPGA: R5059.1, U1001.E3, U5008.2
/STEP11_FPGA: R5061.1, U1001.F4, U5009.5
/TX_PERMIT: R4015.1, R5075.1, U1001.E6, U4007.4, U4009.5, U4010.1, U4011.6, U5004.2, U5011.2
/WD_M_OK: R3009.1, U1001.T11, U3005.6, U4003.2, U4016.1
/WD_M_SET1_BUF: R3011.1, U3001.5, U3006.4, U4017.2
/WD_O_OK: R3010.1, U1001.M10, U3005.4, U4004.3, U4009.2, U4016.3
/WD_O_SET1_BUF: R3012.1, U3002.5, U3007.4, U4017.6
/fpga_core/ALM0_FPGA: R6053.1, U1001.B12, U6035.4
/fpga_core/ALM1_FPGA: R6056.1, U1001.B13, U6035.5
/fpga_core/ALM2_FPGA: R6059.1, U1001.B15, U6036.4
/fpga_core/ALM3_FPGA: R6062.1, U1001.C13, U6036.5
/fpga_core/ALM4_FPGA: R6065.1, U1001.C16, U6037.4
/fpga_core/ALM5_FPGA: R6068.1, U1001.E14, U6037.5
/fpga_core/ALM6_FPGA: R6071.1, U1001.F12, U6038.4
/fpga_core/ALM7_FPGA: R6074.1, U1001.D16, U6038.5
/fpga_core/ALM8_FPGA: R6077.1, U1001.G13, U6039.4
/fpga_core/ALM9_FPGA: R6080.1, U1001.F14, U6039.5
/fpga_core/ALM10_FPGA: R6083.1, U1001.E16, U6040.4
/fpga_core/ALM11_FPGA: R6086.1, U1001.E15, U6040.5
/fpga_core/ENC0_A_FPGA: U1001.B5, U7001.3
/fpga_core/ENC0_B_FPGA: U1001.A7, U7001.5
/fpga_core/ENC0_Z_FPGA: U1001.B7, U7001.11
/fpga_core/ENC1_A_FPGA: U1001.B6, U7001.13
/fpga_core/ENC1_B_FPGA: U1001.A6, U7002.3
/fpga_core/ENC1_Z_FPGA: U1001.E7, U7002.5
/fpga_core/ENC2_A_FPGA: U1001.D9, U7002.11
/fpga_core/ENC2_B_FPGA: U1001.E8, U7002.13
/fpga_core/ENC2_Z_FPGA: U1001.C9, U7003.3
/fpga_core/ENC3_A_FPGA: U1001.D10, U7003.5
/fpga_core/ENC3_B_FPGA: U1001.B9, U7003.11
/fpga_core/ENC3_Z_FPGA: U1001.C10, U7003.13
/fpga_core/FPGA_CDONE: R1003.2, R1022.1, U1001.R1
/fpga_core/FPGA_CFG_CBSEL0: R1018.1, U1001.C7
/fpga_core/FPGA_CFG_CBSEL1: R1019.1, U1001.D7
/fpga_core/FPGA_CFG_CBUS0: R1009.2, U1001.K13
/fpga_core/FPGA_CFG_CBUS1: R1008.2, U1001.L14
/fpga_core/FPGA_CFG_CBUS2: R1007.2, U1001.R16
/fpga_core/FPGA_CFG_CSI: R1004.2, U1001.N3
/fpga_core/FPGA_CFG_NSTATUS: R1017.2, U1001.B8
/fpga_core/FPGA_CFG_TEST_N: R1005.2, U1001.L12
/fpga_core/FPGA_CLK_50M: R1001.2, U1001.H3
/fpga_core/FPGA_CLK_SOURCE: R1001.1, Y1001.3
/fpga_core/FPGA_FLASH_CCK: R1002.2, U1002.6
/fpga_core/FPGA_FLASH_CCK_SOURCE: R1002.1, U1001.M3
/fpga_core/FPGA_FLASH_CS_N: R1006.2, U1001.P3, U1002.1
/fpga_core/FPGA_FLASH_IO2: R1014.2, U1002.3
/fpga_core/FPGA_FLASH_IO3: R1015.2, U1002.7
/fpga_core/FPGA_FLASH_MISO: U1001.N1, U1002.2
/fpga_core/FPGA_FLASH_MOSI: U1001.L3, U1002.5
/fpga_core/FPGA_JTAG_TCK: R1010.2, U1001.M2
/fpga_core/FPGA_JTAG_TDI: R1011.2, U1001.K5
/fpga_core/FPGA_JTAG_TDO: R1013.2, U1001.L5
/fpga_core/FPGA_JTAG_TMS: R1012.2, U1001.M1
/fpga_core/FPGA_LOCAL_RESET_N: R1020.2, R1021.1, U1001.P1, U1003.4
/fpga_core/FPGA_SERVICE_RUN_N: R1016.2, U1003.2, U1005.2
/fpga_core/FPGA_USER_RESET_DELAYED: U1004.4, U1005.1
/fpga_core/FPGA_USER_RESET_RC: C1039.1, R1022.2, U1004.2
/fpga_core/FREQ0_FPGA: U1001.M12, U7004.3
/fpga_core/FREQ1_FPGA: U1001.R9, U7004.5
/fpga_core/MPG_A_FPGA: U1001.T10, U7004.11
/fpga_core/MPG_B_FPGA: U1001.N10, U7004.13
/fpga_core/OPI_REARM_M: R6090.1, R6094.1, R12001.1, R12002.1, R12005.1, U1001.J2, U6043.1, U6044.1
/fpga_core/WATCHDOG_TRIP_CLEAR: R12003.1, R12004.1, R12006.1, U1001.D6
/mc_local_power/CORE_1V2_EN: R2002.1, R2102.2, R2103.1, U2001.5
/mc_local_power/CORE_1V2_MODE: R2001.1, U2001.7
/mc_local_power/CORE_1V2_OV_SENSE: R2051.2, R2055.1, U2004.15
/mc_local_power/CORE_1V2_SS: C2003.1, U2001.8
/mc_local_power/CORE_1V2_SW: L2001.1, U2001.2
/mc_local_power/CORE_1V2_UV_SENSE: R2042.2, R2047.1, U2004.16
/mc_local_power/CORE_5V: C2001.1, C2004.1, C2007.1, C2008.1, C2009.1, R2021.1, R2029.1, R2101.1, R2104.1, R2106.1, U2001.6, U2002.6, U2003.1, U2003.2, U2003.4, U2003.10, U2003.13, U2003.14, U2004.1, U2004.4, U2004.10, U2004.13, U2004.14, U2005.1, U2005.4, U2005.10, U2005.13, U2005.14
/mc_local_power/CORE_5V_OV_SENSE: R2029.2, R2035.1, U2003.15
/mc_local_power/CORE_5V_UV_SENSE: R2021.2, R2027.1, U2003.16
/mc_local_power/IO_3V3_EN: R2006.1, R2104.2, R2105.1, U2002.5, U2004.12, U2005.2
/mc_local_power/IO_3V3_MODE: R2005.1, U2002.7
/mc_local_power/IO_3V3_OV_SENSE: R2069.2, R2075.1, U2005.15
/mc_local_power/IO_3V3_SS: C2006.1, U2002.8
/mc_local_power/IO_3V3_SW: L2002.1, U2002.2
/mc_local_power/IO_3V3_UV_SENSE: R2061.2, R2067.1, U2005.16
/mc_local_power/IO_3V3_VSET: R2008.1, U2002.9
/mc_local_power/MC_RAILS_OK_5V: R2106.2, R2107.1, U2005.12, U2006.2
/mc_local_power/MC_SEQ_5V_OK: R2101.2, R2102.1, U2003.12, U2004.2
/mc_local_power/MC_SEQ_OV2_1: R2049.2, R2050.1
/mc_local_power/MC_SEQ_OV2_2: R2050.2, R2051.1
/mc_local_power/MC_SEQ_REF1: U2003.5, U2003.6, U2003.8, U2003.9
/mc_local_power/MC_SEQ_REF2: U2004.5, U2004.6, U2004.8, U2004.9
/mc_local_power/MC_SEQ_REF3: U2005.5, U2005.6, U2005.8, U2005.9
/mc_local_power/MC_SEQ_UV2_1: R2041.2, R2042.1
/mc_motor_buffers/DIR0_BUFFER_OUT: R5002.1, U5001.16
/mc_motor_buffers/DIR0_TO_MIA: R5002.2, R5078.1, R6002.1, U6001.7
/mc_motor_buffers/DIR1_BUFFER_OUT: R5005.1, U5001.9
/mc_motor_buffers/DIR1_TO_MIA: R5005.2, R5080.1, R6004.1, U6001.15
/mc_motor_buffers/DIR2_BUFFER_OUT: R5008.1, U5001.3
/mc_motor_buffers/DIR2_TO_MIA: R5008.2, R5082.1, R6006.1, U6002.7
/mc_motor_buffers/DIR3_BUFFER_OUT: R5011.1, U5002.14
/mc_motor_buffers/DIR3_TO_MIA: R5011.2, R5084.1, R6008.1, U6002.15
/mc_motor_buffers/DIR4_BUFFER_OUT: R5014.1, U5002.7
/mc_motor_buffers/DIR4_TO_MIA: R5014.2, R5086.1, R6010.1, U6003.7
/mc_motor_buffers/DIR5_BUFFER_OUT: R5017.1, U5003.18
/mc_motor_buffers/DIR5_TO_MIA: R5017.2, R5088.1, R6012.1, U6003.15
/mc_motor_buffers/DIR6_BUFFER_OUT: R5020.1, U5003.12
/mc_motor_buffers/DIR6_TO_MIA: R5020.2, R5090.1, R6014.1, U6004.7
/mc_motor_buffers/DIR7_BUFFER_OUT: R5023.1, U5003.5
/mc_motor_buffers/DIR7_TO_MIA: R5023.2, R5092.1, R6016.1, U6004.15
/mc_motor_buffers/DIR8_BUFFER_OUT: R5026.1, U5005.3
/mc_motor_buffers/DIR8_TO_MX4: R5026.2, R5094.1, R6018.1, U6005.7
/mc_motor_buffers/DIR9_BUFFER_OUT: R5029.1, U5007.6
/mc_motor_buffers/DIR9_TO_MX4: R5029.2, R5096.1, R6020.1, U6005.15
/mc_motor_buffers/DIR10_BUFFER_OUT: R5032.1, U5008.3
/mc_motor_buffers/DIR10_TO_MX4: R5032.2, R5098.1, R6022.1, U6006.7
/mc_motor_buffers/DIR11_BUFFER_OUT: R5035.1, U5010.6
/mc_motor_buffers/DIR11_TO_MX4: R5035.2, R5100.1, R6024.1, U6006.15
/mc_motor_buffers/EN0_N_BUFFER_OUT: R5003.1, U5001.14
/mc_motor_buffers/EN0_N_TO_MIA: R5003.2, R6026.1, U6046.1
/mc_motor_buffers/EN1_N_BUFFER_OUT: R5006.1, U5001.7
/mc_motor_buffers/EN1_N_TO_MIA: R5006.2, R6028.1, U6046.3
/mc_motor_buffers/EN2_N_BUFFER_OUT: R5009.1, U5002.18
/mc_motor_buffers/EN2_N_TO_MIA: R5009.2, R6030.1, U6046.5
/mc_motor_buffers/EN3_N_BUFFER_OUT: R5012.1, U5002.12
/mc_motor_buffers/EN3_N_TO_MIA: R5012.2, R6032.1, U6046.9
/mc_motor_buffers/EN4_N_BUFFER_OUT: R5015.1, U5002.5
/mc_motor_buffers/EN4_N_TO_MIA: R5015.2, R6034.1, U6046.11
/mc_motor_buffers/EN5_N_BUFFER_OUT: R5018.1, U5003.16
/mc_motor_buffers/EN5_N_TO_MIA: R5018.2, R6036.1, U6046.13
/mc_motor_buffers/EN6_N_BUFFER_OUT: R5021.1, U5003.9
/mc_motor_buffers/EN6_N_TO_MIA: R5021.2, R6038.1, U6047.1
/mc_motor_buffers/EN7_N_BUFFER_OUT: R5024.1, U5003.3
/mc_motor_buffers/EN7_N_TO_MIA: R5024.2, R6040.1, U6047.3
/mc_motor_buffers/EN8_N_BUFFER_OUT: R5027.1, U5006.6
/mc_motor_buffers/EN8_N_TO_MX4: R5027.2, R6042.1, U6047.5
/mc_motor_buffers/EN9_N_BUFFER_OUT: R5030.1, U5007.3
/mc_motor_buffers/EN9_N_TO_MX4: R5030.2, R6044.1, U6047.9
/mc_motor_buffers/EN10_N_BUFFER_OUT: R5033.1, U5009.6
/mc_motor_buffers/EN10_N_TO_MX4: R5033.2, R6046.1, U6047.11
/mc_motor_buffers/EN11_N_BUFFER_OUT: R5036.1, U5010.3
/mc_motor_buffers/EN11_N_TO_MX4: R5036.2, R6048.1, U6047.13
/mc_motor_buffers/STEP0_BUFFER_OUT: R5001.1, U5001.18
/mc_motor_buffers/STEP0_TO_MIA: R5001.2, R5077.1, R6001.1, U6001.1
/mc_motor_buffers/STEP1_BUFFER_OUT: R5004.1, U5001.12
/mc_motor_buffers/STEP1_TO_MIA: R5004.2, R5079.1, R6003.1, U6001.9
/mc_motor_buffers/STEP2_BUFFER_OUT: R5007.1, U5001.5
/mc_motor_buffers/STEP2_TO_MIA: R5007.2, R5081.1, R6005.1, U6002.1
/mc_motor_buffers/STEP3_BUFFER_OUT: R5010.1, U5002.16
/mc_motor_buffers/STEP3_TO_MIA: R5010.2, R5083.1, R6007.1, U6002.9
/mc_motor_buffers/STEP4_BUFFER_OUT: R5013.1, U5002.9
/mc_motor_buffers/STEP4_TO_MIA: R5013.2, R5085.1, R6009.1, U6003.1
/mc_motor_buffers/STEP5_BUFFER_OUT: R5016.1, U5002.3
/mc_motor_buffers/STEP5_TO_MIA: R5016.2, R5087.1, R6011.1, U6003.9
/mc_motor_buffers/STEP6_BUFFER_OUT: R5019.1, U5003.14
/mc_motor_buffers/STEP6_TO_MIA: R5019.2, R5089.1, R6013.1, U6004.1
/mc_motor_buffers/STEP7_BUFFER_OUT: R5022.1, U5003.7
/mc_motor_buffers/STEP7_TO_MIA: R5022.2, R5091.1, R6015.1, U6004.9
/mc_motor_buffers/STEP8_BUFFER_OUT: R5025.1, U5005.6
/mc_motor_buffers/STEP8_TO_MX4: R5025.2, R5093.1, R6017.1, U6005.1
/mc_motor_buffers/STEP9_BUFFER_OUT: R5028.1, U5006.3
/mc_motor_buffers/STEP9_TO_MX4: R5028.2, R5095.1, R6019.1, U6005.9
/mc_motor_buffers/STEP10_BUFFER_OUT: R5031.1, U5008.6
/mc_motor_buffers/STEP10_TO_MX4: R5031.2, R5097.1, R6021.1, U6006.1
/mc_motor_buffers/STEP11_BUFFER_OUT: R5034.1, U5009.3
/mc_motor_buffers/STEP11_TO_MX4: R5034.2, R5099.1, R6023.1, U6006.9
/mc_motor_buffers/TX_PERMIT_A_BUFFER_OUT: R5037.1, U5004.18
/mc_motor_buffers/TX_PERMIT_A_TO_MIA: R5037.2, R5101.1, R6087.1, U6051.2
/mc_motor_buffers/TX_PERMIT_B_BUFFER_OUT: R5038.1, U5011.6
/mc_motor_buffers/TX_PERMIT_B_TO_MX4: R5038.2, R5102.1, R6091.1, U6052.2
/mc_permission/ARM_M_Q: U4005.5, U4007.1
/mc_permission/ARM_O_Q: U4006.5, U4008.1
/mc_permission/BASE_FIRST: U4001.4, U4002.1
/mc_permission/BASE_OK: U4002.4, U4003.1, U4004.1, U4009.1
/mc_permission/DIC_OK_QUALIFIED: R4010.1, U4001.6
/mc_permission/EXT_PERMIT_3V3: R4011.1, U4002.3
/mc_permission/LATCH_CLEAR_M_N: U4003.3, U4005.6
/mc_permission/LATCH_CLEAR_O_N: U4004.4, U4006.6
/mc_permission/OPI_OK_BOE: U1001.P11, U4013.5
/mc_permission/OPI_OK_OUT: U1001.R12, U4012.5
/mc_permission/OPI_OK_TX: U1001.P13, U4011.5
/mc_permission/OPI_REARM_BOE: R4004.1, R12002.2, U4013.1
/mc_permission/OPI_REARM_OUT: R4003.1, U1001.H5, U4012.1
/mc_permission/OPI_REARM_TX: R4002.1, R12001.2, U4011.1
/mc_permission/OUTPUT_RAW_OK: U4008.6, U4009.7
/mc_permission/OUT_PERMIT: R4016.1, R10001.1, R10021.1, U1001.R14, U4008.4, U4010.3, U4012.6, U10002.1, U10002.4, U10015.1, U10015.4
/mc_permission/PERMIT_OUT_DRIVE: R4018.1, U4009.3
/mc_permission/PERMIT_OUT_REQ: R4007.1, U1001.F5, U4009.6
/mc_permission/PROCESS_PERMIT_EXT_3V3: R4013.1, U4010.6
/mc_permission/PROC_PERMIT: R4017.1, U1001.R15, U4010.4
/mc_permission/TAMPER_CLEAR_N: R4012.1, U1001.R4, U4002.6
/mc_permission/WD_M_FALL_CLK: U4014.1, U4016.6
/mc_permission/WD_M_RECORD_CLEAR_N: U4018.6, U4019.2
/mc_permission/WD_M_TRIP_CLEAR_N: U4014.6, U4019.7
/mc_permission/WD_M_TRIP_D: U4014.2, U4017.7
/mc_permission/WD_M_TRIP_N: U1001.T9, U4014.3
/mc_permission/WD_M_TRIP_Q: U4014.5, U4017.1
/mc_permission/WD_O_FALL_CLK: U4015.1, U4016.4
/mc_permission/WD_O_RECORD_CLEAR_N: U4018.4, U4019.6
/mc_permission/WD_O_TRIP_CLEAR_N: U4015.6, U4019.3
/mc_permission/WD_O_TRIP_D: U4015.2, U4017.3
/mc_permission/WD_O_TRIP_N: U1001.P10, U4015.3
/mc_permission/WD_O_TRIP_Q: U4015.5, U4017.5
/mc_permission/WD_REARM_M: R4005.1, R12003.2, U4018.1
/mc_permission/WD_REARM_O: R4006.1, R12004.2, U4018.3
/motherboard_di/DI0_IN: R8101.2, U8001.15
/motherboard_di/DI0_LOGIC: R8201.1, U8001.4
/motherboard_di/DI0_SENSE: C8001.1, R8001.2, R8101.1, U8001.16
/motherboard_di/DI1_IN: R8102.2, U8001.10
/motherboard_di/DI1_LOGIC: R8202.1, U8001.5
/motherboard_di/DI1_SENSE: C8002.1, R8002.2, R8102.1, U8001.11
/motherboard_di/DI2_IN: R8103.2, U8002.15
/motherboard_di/DI2_LOGIC: R8203.1, U8002.4
/motherboard_di/DI2_SENSE: C8003.1, R8003.2, R8103.1, U8002.16
/motherboard_di/DI3_IN: R8104.2, U8002.10
/motherboard_di/DI3_LOGIC: R8204.1, U8002.5
/motherboard_di/DI3_SENSE: C8004.1, R8004.2, R8104.1, U8002.11
/motherboard_di/DI4_IN: R8105.2, U8003.15
/motherboard_di/DI4_LOGIC: R8205.1, U8003.4
/motherboard_di/DI4_SENSE: C8005.1, R8005.2, R8105.1, U8003.16
/motherboard_di/DI5_IN: R8106.2, U8003.10
/motherboard_di/DI5_LOGIC: R8206.1, U8003.5
/motherboard_di/DI5_SENSE: C8006.1, R8006.2, R8106.1, U8003.11
/motherboard_di/DI6_IN: R8107.2, U8004.15
/motherboard_di/DI6_LOGIC: R8207.1, U8004.4
/motherboard_di/DI6_SENSE: C8007.1, R8007.2, R8107.1, U8004.16
/motherboard_di/DI7_IN: R8108.2, U8004.10
/motherboard_di/DI7_LOGIC: R8208.1, U8004.5
/motherboard_di/DI7_SENSE: C8008.1, R8008.2, R8108.1, U8004.11
/motherboard_di/DI8_IN: R8109.2, U8005.15
/motherboard_di/DI8_LOGIC: R8209.1, U8005.4
/motherboard_di/DI8_SENSE: C8009.1, R8009.2, R8109.1, U8005.16
/motherboard_di/DI9_IN: R8110.2, U8005.10
/motherboard_di/DI9_LOGIC: R8210.1, U8005.5
/motherboard_di/DI9_SENSE: C8010.1, R8010.2, R8110.1, U8005.11
/motherboard_di/DI10_IN: R8111.2, U8006.15
/motherboard_di/DI10_LOGIC: R8211.1, U8006.4
/motherboard_di/DI10_SENSE: C8011.1, R8011.2, R8111.1, U8006.16
/motherboard_di/DI11_IN: R8112.2, U8006.10
/motherboard_di/DI11_LOGIC: R8212.1, U8006.5
/motherboard_di/DI11_SENSE: C8012.1, R8012.2, R8112.1, U8006.11
/motherboard_di/DI12_IN: R8113.2, U8007.15
/motherboard_di/DI12_LOGIC: R8213.1, U8007.4
/motherboard_di/DI12_SENSE: C8013.1, R8013.2, R8113.1, U8007.16
/motherboard_di/DI13_IN: R8114.2, U8007.10
/motherboard_di/DI13_LOGIC: R8214.1, U8007.5
/motherboard_di/DI13_SENSE: C8014.1, R8014.2, R8114.1, U8007.11
/motherboard_di/DI14_IN: R8115.2, U8008.15
/motherboard_di/DI14_LOGIC: R8215.1, U8008.4
/motherboard_di/DI14_SENSE: C8015.1, R8015.2, R8115.1, U8008.16
/motherboard_di/DI15_IN: R8116.2, U8008.10
/motherboard_di/DI15_LOGIC: R8216.1, U8008.5
/motherboard_di/DI15_SENSE: C8016.1, R8016.2, R8116.1, U8008.11
/motherboard_di/DI16_IN: R8117.2, U8009.15
/motherboard_di/DI16_LOGIC: R8217.1, U8009.4
/motherboard_di/DI16_SENSE: C8017.1, R8017.2, R8117.1, U8009.16
/motherboard_di/DI17_IN: R8118.2, U8009.10
/motherboard_di/DI17_LOGIC: R8218.1, U8009.5
/motherboard_di/DI17_SENSE: C8018.1, R8018.2, R8118.1, U8009.11
/motherboard_di/DI18_IN: R8119.2, U8010.15
/motherboard_di/DI18_LOGIC: R8219.1, U8010.4
/motherboard_di/DI18_SENSE: C8019.1, R8019.2, R8119.1, U8010.16
/motherboard_di/DI19_IN: R8120.2, U8010.10
/motherboard_di/DI19_LOGIC: R8220.1, U8010.5
/motherboard_di/DI19_SENSE: C8020.1, R8020.2, R8120.1, U8010.11
/motherboard_di/DI20_IN: R8121.2, U8011.15
/motherboard_di/DI20_LOGIC: R8221.1, U8011.4
/motherboard_di/DI20_SENSE: C8021.1, R8021.2, R8121.1, U8011.16
/motherboard_di/DI21_IN: R8122.2, U8011.10
/motherboard_di/DI21_LOGIC: R8222.1, U8011.5
/motherboard_di/DI21_SENSE: C8022.1, R8022.2, R8122.1, U8011.11
/motherboard_di/DI22_IN: R8123.2, U8012.15
/motherboard_di/DI22_LOGIC: R8223.1, U8012.4
/motherboard_di/DI22_SENSE: C8023.1, R8023.2, R8123.1, U8012.16
/motherboard_di/DI23_IN: R8124.2, U8012.10
/motherboard_di/DI23_LOGIC: R8224.1, U8012.5
/motherboard_di/DI23_SENSE: C8024.1, R8024.2, R8124.1, U8012.11
/motherboard_di/FIELD_B_0V: C8001.2, C8002.2, C8003.2, C8004.2, C8005.2, C8006.2, C8007.2, C8008.2, C8009.2, C8010.2, C8011.2, C8012.2, C8013.2, C8014.2, C8015.2, C8016.2, C8017.2, C8018.2, C8019.2, C8020.2, C8021.2, C8022.2, C8023.2, C8024.2, U8001.9, U8001.14, U8002.9, U8002.14, U8003.9, U8003.14, U8004.9, U8004.14, U8005.9, U8005.14, U8006.9, U8006.14, U8007.9, U8007.14, U8008.9, U8008.14, U8009.9, U8009.14, U8010.9, U8010.14, U8011.9, U8011.14, U8012.9, U8012.14
/motherboard_do/DO00: C10010.1, U10005.5, U10005.6, U10005.7, U10005.8, U10005.9
/motherboard_do/DO00_RCB_GATE: U10004.40, U10005.4
/motherboard_do/DO00_SW: U10004.38, U10004.39, U10005.1, U10005.2, U10005.3
/motherboard_do/DO01: C10011.1, U10006.5, U10006.6, U10006.7, U10006.8, U10006.9
/motherboard_do/DO01_RCB_GATE: U10004.31, U10006.4
/motherboard_do/DO01_SW: U10004.32, U10004.33, U10006.1, U10006.2, U10006.3
/motherboard_do/DO02: C10012.1, U10007.5, U10007.6, U10007.7, U10007.8, U10007.9
/motherboard_do/DO02_RCB_GATE: U10004.11, U10007.4
/motherboard_do/DO02_SW: U10004.12, U10004.13, U10007.1, U10007.2, U10007.3
/motherboard_do/DO03: C10013.1, U10008.5, U10008.6, U10008.7, U10008.8, U10008.9
/motherboard_do/DO03_RCB_GATE: U10004.20, U10008.4
/motherboard_do/DO03_SW: U10004.18, U10004.19, U10008.1, U10008.2, U10008.3
/motherboard_do/DO04: C10019.1, U10010.5, U10010.6, U10010.7, U10010.8, U10010.9
/motherboard_do/DO04_RCB_GATE: U10009.40, U10010.4
/motherboard_do/DO04_SW: U10009.38, U10009.39, U10010.1, U10010.2, U10010.3
/motherboard_do/DO05: C10020.1, U10011.5, U10011.6, U10011.7, U10011.8, U10011.9
/motherboard_do/DO05_RCB_GATE: U10009.31, U10011.4
/motherboard_do/DO05_SW: U10009.32, U10009.33, U10011.1, U10011.2, U10011.3
/motherboard_do/DO06: C10021.1, U10012.5, U10012.6, U10012.7, U10012.8, U10012.9
/motherboard_do/DO06_RCB_GATE: U10009.11, U10012.4
/motherboard_do/DO06_SW: U10009.12, U10009.13, U10012.1, U10012.2, U10012.3
/motherboard_do/DO07: C10022.1, U10013.5, U10013.6, U10013.7, U10013.8, U10013.9
/motherboard_do/DO07_RCB_GATE: U10009.20, U10013.4
/motherboard_do/DO07_SW: U10009.18, U10009.19, U10013.1, U10013.2, U10013.3
/motherboard_do/DO08: C10032.1, U10018.5, U10018.6, U10018.7, U10018.8, U10018.9
/motherboard_do/DO08_RCB_GATE: U10017.40, U10018.4
/motherboard_do/DO08_SW: U10017.38, U10017.39, U10018.1, U10018.2, U10018.3
/motherboard_do/DO09: C10033.1, U10019.5, U10019.6, U10019.7, U10019.8, U10019.9
/motherboard_do/DO09_RCB_GATE: U10017.31, U10019.4
/motherboard_do/DO09_SW: U10017.32, U10017.33, U10019.1, U10019.2, U10019.3
/motherboard_do/DO10: C10034.1, U10020.5, U10020.6, U10020.7, U10020.8, U10020.9
/motherboard_do/DO10_RCB_GATE: U10017.11, U10020.4
/motherboard_do/DO10_SW: U10017.12, U10017.13, U10020.1, U10020.2, U10020.3
/motherboard_do/DO11: C10035.1, U10021.5, U10021.6, U10021.7, U10021.8, U10021.9
/motherboard_do/DO11_RCB_GATE: U10017.20, U10021.4
/motherboard_do/DO11_SW: U10017.18, U10017.19, U10021.1, U10021.2, U10021.3
/motherboard_do/DO12: C10041.1, U10023.5, U10023.6, U10023.7, U10023.8, U10023.9
/motherboard_do/DO12_RCB_GATE: U10022.40, U10023.4
/motherboard_do/DO12_SW: U10022.38, U10022.39, U10023.1, U10023.2, U10023.3
/motherboard_do/DO13: C10042.1, U10024.5, U10024.6, U10024.7, U10024.8, U10024.9
/motherboard_do/DO13_RCB_GATE: U10022.31, U10024.4
/motherboard_do/DO13_SW: U10022.32, U10022.33, U10024.1, U10024.2, U10024.3
/motherboard_do/DO14: C10043.1, U10025.5, U10025.6, U10025.7, U10025.8, U10025.9
/motherboard_do/DO14_RCB_GATE: U10022.11, U10025.4
/motherboard_do/DO14_SW: U10022.12, U10022.13, U10025.1, U10025.2, U10025.3
/motherboard_do/DO15: C10044.1, U10026.5, U10026.6, U10026.7, U10026.8, U10026.9
/motherboard_do/DO15_RCB_GATE: U10022.20, U10026.4
/motherboard_do/DO15_SW: U10022.18, U10022.19, U10026.1, U10026.2, U10026.3
/motherboard_do/DOA_CARD_EN: R10004.1, U10002.10
/motherboard_do/DOA_CLR_N: U10001.6, U10002.3
/motherboard_do/DOA_CONTROLLER_RESET_N: R10002.1, U10002.2
/motherboard_do/DOA_CS_N_FIELD: R10012.1, U10003.13, U10004.10, U10009.10
/motherboard_do/DOA_CS_N_HOST: R10008.1, U10003.4
/motherboard_do/DOA_DO_EN_FIELD: R10009.1, U10003.12, U10004.3, U10009.3
/motherboard_do/DOA_DO_EN_LOGIC: R10005.1, U10002.8, U10003.5
/motherboard_do/DOA_FIELD_3V3: C10004.1, C10006.1, C10007.1, C10015.1, C10016.1, R10012.2, R10014.2, U10003.16, U10004.4, U10009.4
/motherboard_do/DOA_FLT_N_FIELD: R10014.1, U10003.10, U10004.2, U10009.2
/motherboard_do/DOA_IO_ENABLE_STROBE: R10003.1, U10001.1
/motherboard_do/DOA_OUT_EN_LATCH: U10001.5, U10002.5
/motherboard_do/DOA_PERMIT_LATCHED: U10002.6, U10002.9
/motherboard_do/DOA_Q0_ADDRESS: R10015.1, U10004.30
/motherboard_do/DOA_Q0_ISNS: C10005.1, R10017.1, U10004.6
/motherboard_do/DOA_Q0_READY_N: R10016.1, U10004.1
/motherboard_do/DOA_Q1_ADDRESS: R10018.1, U10009.30
/motherboard_do/DOA_Q1_ISNS: C10014.1, R10020.1, U10009.6
/motherboard_do/DOA_Q1_READY_N: R10019.1, U10009.1
/motherboard_do/DOA_SCLK_FIELD: R10010.1, U10003.15, U10004.9, U10009.9
/motherboard_do/DOA_SCLK_HOST: R10006.1, U10003.2
/motherboard_do/DOA_SDI_FIELD: R10011.1, U10003.14, U10004.8, U10009.8
/motherboard_do/DOA_SDI_HOST: R10007.1, U10003.3
/motherboard_do/DOA_SDO_FIELD: R10013.1, U10003.11, U10004.7, U10009.7
/motherboard_do/DOB_CARD_EN: R10024.1, U10015.10
/motherboard_do/DOB_CLR_N: U10014.6, U10015.3
/motherboard_do/DOB_CONTROLLER_RESET_N: R10022.1, U10015.2
/motherboard_do/DOB_CS_N_FIELD: R10032.1, U10016.13, U10017.10, U10022.10
/motherboard_do/DOB_CS_N_HOST: R10028.1, U10016.4
/motherboard_do/DOB_DO_EN_FIELD: R10029.1, U10016.12, U10017.3, U10022.3
/motherboard_do/DOB_DO_EN_LOGIC: R10025.1, U10015.8, U10016.5
/motherboard_do/DOB_FIELD_3V3: C10026.1, C10028.1, C10029.1, C10037.1, C10038.1, R10032.2, R10034.2, U10016.16, U10017.4, U10022.4
/motherboard_do/DOB_FLT_N_FIELD: R10034.1, U10016.10, U10017.2, U10022.2
/motherboard_do/DOB_IO_ENABLE_STROBE: R10023.1, U10014.1
/motherboard_do/DOB_OUT_EN_LATCH: U10014.5, U10015.5
/motherboard_do/DOB_PERMIT_LATCHED: U10015.6, U10015.9
/motherboard_do/DOB_Q0_ADDRESS: R10035.1, U10017.30
/motherboard_do/DOB_Q0_ISNS: C10027.1, R10037.1, U10017.6
/motherboard_do/DOB_Q0_READY_N: R10036.1, U10017.1
/motherboard_do/DOB_Q1_ADDRESS: R10038.1, U10022.30
/motherboard_do/DOB_Q1_ISNS: C10036.1, R10040.1, U10022.6
/motherboard_do/DOB_Q1_READY_N: R10039.1, U10022.1
/motherboard_do/DOB_SCLK_FIELD: R10030.1, U10016.15, U10017.9, U10022.9
/motherboard_do/DOB_SCLK_HOST: R10026.1, U10016.2
/motherboard_do/DOB_SDI_FIELD: R10031.1, U10016.14, U10017.8, U10022.8
/motherboard_do/DOB_SDI_HOST: R10027.1, U10016.3
/motherboard_do/DOB_SDO_FIELD: R10033.1, U10016.11, U10017.7, U10022.7
/motherboard_do/FIELD_A_0V: C10004.2, C10005.2, C10006.2, C10007.2, C10008.2, C10009.2, C10010.2, C10011.2, C10012.2, C10013.2, C10014.2, C10015.2, C10016.2, C10017.2, C10018.2, C10019.2, C10020.2, C10021.2, C10022.2, R10009.2, R10010.2, R10011.2, R10013.2, R10015.2, R10016.2, R10017.2, R10018.2, R10019.2, R10020.2, U10003.9, U10004.5, U10004.21, U10004.28, U10004.29, U10004.41, U10009.5, U10009.21, U10009.28, U10009.29, U10009.41
/motherboard_do/FIELD_A_24V: C10008.1, C10009.1, C10017.1, C10018.1, U10004.14, U10004.15, U10004.16, U10004.17, U10004.34, U10004.35, U10004.36, U10004.37, U10009.14, U10009.15, U10009.16, U10009.17, U10009.34, U10009.35, U10009.36, U10009.37
/motherboard_do/FIELD_B_0V: C10026.2, C10027.2, C10028.2, C10029.2, C10030.2, C10031.2, C10032.2, C10033.2, C10034.2, C10035.2, C10036.2, C10037.2, C10038.2, C10039.2, C10040.2, C10041.2, C10042.2, C10043.2, C10044.2, R10029.2, R10030.2, R10031.2, R10033.2, R10035.2, R10036.2, R10037.2, R10038.2, R10039.2, R10040.2, U10016.9, U10017.5, U10017.21, U10017.28, U10017.29, U10017.41, U10022.5, U10022.21, U10022.28, U10022.29, U10022.41
/motherboard_do/FIELD_B_24V: C10030.1, C10031.1, C10039.1, C10040.1, U10017.14, U10017.15, U10017.16, U10017.17, U10017.34, U10017.35, U10017.36, U10017.37, U10022.14, U10022.15, U10022.16, U10022.17, U10022.34, U10022.35, U10022.36, U10022.37
/motherboard_fast_inputs/ENC0_A_N: R7001.2, U7001.1
/motherboard_fast_inputs/ENC0_A_P: R7001.1, U7001.2
/motherboard_fast_inputs/ENC0_B_N: R7002.2, U7001.7
/motherboard_fast_inputs/ENC0_B_P: R7002.1, U7001.6
/motherboard_fast_inputs/ENC0_Z_N: R7003.2, U7001.9
/motherboard_fast_inputs/ENC0_Z_P: R7003.1, U7001.10
/motherboard_fast_inputs/ENC1_A_N: R7004.2, U7001.15
/motherboard_fast_inputs/ENC1_A_P: R7004.1, U7001.14
/motherboard_fast_inputs/ENC1_B_N: R7005.2, U7002.1
/motherboard_fast_inputs/ENC1_B_P: R7005.1, U7002.2
/motherboard_fast_inputs/ENC1_Z_N: R7006.2, U7002.7
/motherboard_fast_inputs/ENC1_Z_P: R7006.1, U7002.6
/motherboard_fast_inputs/ENC2_A_N: R7007.2, U7002.9
/motherboard_fast_inputs/ENC2_A_P: R7007.1, U7002.10
/motherboard_fast_inputs/ENC2_B_N: R7008.2, U7002.15
/motherboard_fast_inputs/ENC2_B_P: R7008.1, U7002.14
/motherboard_fast_inputs/ENC2_Z_N: R7009.2, U7003.1
/motherboard_fast_inputs/ENC2_Z_P: R7009.1, U7003.2
/motherboard_fast_inputs/ENC3_A_N: R7010.2, U7003.7
/motherboard_fast_inputs/ENC3_A_P: R7010.1, U7003.6
/motherboard_fast_inputs/ENC3_B_N: R7011.2, U7003.9
/motherboard_fast_inputs/ENC3_B_P: R7011.1, U7003.10
/motherboard_fast_inputs/ENC3_Z_N: R7012.2, U7003.15
/motherboard_fast_inputs/ENC3_Z_P: R7012.1, U7003.14
/motherboard_fast_inputs/FREQ0_N: R7013.2, U7004.1
/motherboard_fast_inputs/FREQ0_P: R7013.1, U7004.2
/motherboard_fast_inputs/FREQ1_N: R7014.2, U7004.7
/motherboard_fast_inputs/FREQ1_P: R7014.1, U7004.6
/motherboard_fast_inputs/MPG_A_N: R7015.2, U7004.9
/motherboard_fast_inputs/MPG_A_P: R7015.1, U7004.10
/motherboard_fast_inputs/MPG_B_N: R7016.2, U7004.15
/motherboard_fast_inputs/MPG_B_P: R7016.1, U7004.14
/motherboard_motor_power/CORE_5V: C9001.1, C9002.1, R9009.1, R9019.1, U9001.1, U9001.2, U9001.4, U9001.10, U9002.1, U9002.2, U9002.4, U9002.10
/motherboard_motor_power/FIELD_5V: C9003.1, C9004.1, C9007.1, R9029.1, R9039.1, U9003.1, U9003.2, U9003.4, U9003.10, U9004.1, U9004.2, U9004.4, U9004.10, U9007.3
/motherboard_motor_power/FIELD_GND: C9003.2, C9004.2, C9007.2, R9022.2, R9024.2, R9026.2, R9028.2, R9030.2, R9032.2, R9034.2, R9036.2, R9038.2, R9040.2, U9003.3, U9003.7, U9003.9, U9003.11, U9003.17, U9004.3, U9004.7, U9004.9, U9004.11, U9004.17, U9007.1, U9007.7
/motherboard_motor_power/MOTOR_FIELD_HEALTH_A_ISOLATED: R9043.1, U9007.13, U9008.2
/motherboard_motor_power/MOTOR_FIELD_HEALTH_A_RAW: R9029.2, R9030.1, U9003.12, U9007.4
/motherboard_motor_power/MOTOR_FIELD_HEALTH_B_ISOLATED: R9044.1, U9007.12, U9008.6
/motherboard_motor_power/MOTOR_FIELD_HEALTH_B_RAW: R9039.2, R9040.1, U9004.12, U9007.5
/motherboard_motor_power/MOTOR_LOGIC_HEALTH_A: R9041.1, U9005.4, U9008.1
/motherboard_motor_power/MOTOR_LOGIC_HEALTH_A_RAW: R9009.2, R9010.1, U9001.12, U9005.2
/motherboard_motor_power/MOTOR_LOGIC_HEALTH_B: R9042.1, U9006.4, U9008.5
/motherboard_motor_power/MOTOR_LOGIC_HEALTH_B_RAW: R9019.2, R9020.1, U9002.12, U9006.2
/motherboard_motor_power/MOTOR_PWR_FIELD_A_0_OV: R9023.2, R9024.1, U9003.15
/motherboard_motor_power/MOTOR_PWR_FIELD_A_0_UV: R9021.2, R9022.1, U9003.16
/motherboard_motor_power/MOTOR_PWR_FIELD_A_1_OV: R9027.2, R9028.1, U9003.13
/motherboard_motor_power/MOTOR_PWR_FIELD_A_1_UV: R9025.2, R9026.1, U9003.14
/motherboard_motor_power/MOTOR_PWR_FIELD_B_0_OV: R9033.2, R9034.1, U9004.15
/motherboard_motor_power/MOTOR_PWR_FIELD_B_0_UV: R9031.2, R9032.1, U9004.16
/motherboard_motor_power/MOTOR_PWR_FIELD_B_1_OV: R9037.2, R9038.1, U9004.13
/motherboard_motor_power/MOTOR_PWR_FIELD_B_1_UV: R9035.2, R9036.1, U9004.14
/motherboard_motor_power/MOTOR_PWR_LOGIC_A_0_OV: R9003.2, R9004.1, U9001.15
/motherboard_motor_power/MOTOR_PWR_LOGIC_A_0_UV: R9001.2, R9002.1, U9001.16
/motherboard_motor_power/MOTOR_PWR_LOGIC_A_1_OV: R9007.2, R9008.1, U9001.13
/motherboard_motor_power/MOTOR_PWR_LOGIC_A_1_UV: R9005.2, R9006.1, U9001.14
/motherboard_motor_power/MOTOR_PWR_LOGIC_B_0_OV: R9013.2, R9014.1, U9002.15
/motherboard_motor_power/MOTOR_PWR_LOGIC_B_0_UV: R9011.2, R9012.1, U9002.16
/motherboard_motor_power/MOTOR_PWR_LOGIC_B_1_OV: R9017.2, R9018.1, U9002.13
/motherboard_motor_power/MOTOR_PWR_LOGIC_B_1_UV: R9015.2, R9016.1, U9002.14
/motherboard_motor_power/MOTOR_PWR_REF_FIELD_A: U9003.5, U9003.6, U9003.8
/motherboard_motor_power/MOTOR_PWR_REF_FIELD_B: U9004.5, U9004.6, U9004.8
/motherboard_motor_power/MOTOR_PWR_REF_LOGIC_A: U9001.5, U9001.6, U9001.8
/motherboard_motor_power/MOTOR_PWR_REF_LOGIC_B: U9002.5, U9002.6, U9002.8
/motherboard_motors/ALM0_FIELD: D6025.1, R6051.1
/motherboard_motors/ALM0_IN: R6052.2, U6035.15
/motherboard_motors/ALM0_SENSE: C6013.1, R6051.2, R6052.1, U6035.16
/motherboard_motors/ALM1_FIELD: D6026.1, R6054.1
/motherboard_motors/ALM1_IN: R6055.2, U6035.10
/motherboard_motors/ALM1_SENSE: C6014.1, R6054.2, R6055.1, U6035.11
/motherboard_motors/ALM2_FIELD: D6027.1, R6057.1
/motherboard_motors/ALM2_IN: R6058.2, U6036.15
/motherboard_motors/ALM2_SENSE: C6016.1, R6057.2, R6058.1, U6036.16
/motherboard_motors/ALM3_FIELD: D6028.1, R6060.1
/motherboard_motors/ALM3_IN: R6061.2, U6036.10
/motherboard_motors/ALM3_SENSE: C6017.1, R6060.2, R6061.1, U6036.11
/motherboard_motors/ALM4_FIELD: D6029.1, R6063.1
/motherboard_motors/ALM4_IN: R6064.2, U6037.15
/motherboard_motors/ALM4_SENSE: C6019.1, R6063.2, R6064.1, U6037.16
/motherboard_motors/ALM5_FIELD: D6030.1, R6066.1
/motherboard_motors/ALM5_IN: R6067.2, U6037.10
/motherboard_motors/ALM5_SENSE: C6020.1, R6066.2, R6067.1, U6037.11
/motherboard_motors/ALM6_FIELD: D6031.1, R6069.1
/motherboard_motors/ALM6_IN: R6070.2, U6038.15
/motherboard_motors/ALM6_SENSE: C6022.1, R6069.2, R6070.1, U6038.16
/motherboard_motors/ALM7_FIELD: D6032.1, R6072.1
/motherboard_motors/ALM7_IN: R6073.2, U6038.10
/motherboard_motors/ALM7_SENSE: C6023.1, R6072.2, R6073.1, U6038.11
/motherboard_motors/ALM8_FIELD: D6033.1, R6075.1
/motherboard_motors/ALM8_IN: R6076.2, U6039.15
/motherboard_motors/ALM8_SENSE: C6025.1, R6075.2, R6076.1, U6039.16
/motherboard_motors/ALM9_FIELD: D6034.1, R6078.1
/motherboard_motors/ALM9_IN: R6079.2, U6039.10
/motherboard_motors/ALM9_SENSE: C6026.1, R6078.2, R6079.1, U6039.11
/motherboard_motors/ALM10_FIELD: D6035.1, R6081.1
/motherboard_motors/ALM10_IN: R6082.2, U6040.15
/motherboard_motors/ALM10_SENSE: C6028.1, R6081.2, R6082.1, U6040.16
/motherboard_motors/ALM11_FIELD: D6036.1, R6084.1
/motherboard_motors/ALM11_IN: R6085.2, U6040.10
/motherboard_motors/ALM11_SENSE: C6029.1, R6084.2, R6085.1, U6040.11
/motherboard_motors/AUX_5V_A: R9021.1, R9023.1
/motherboard_motors/AUX_5V_B: R9031.1, R9033.1
/motherboard_motors/AUX_24V_A: R9025.1, R9027.1
/motherboard_motors/AUX_24V_B: R9035.1, R9037.1
/motherboard_motors/EN0_COM: D6001.2, D6002.2, U6009.4, U6010.4
/motherboard_motors/EN0_NC: D6002.1, U6010.3
/motherboard_motors/EN0_NO: D6001.1, U6009.3
/motherboard_motors/EN1_COM: D6003.2, D6004.2, U6011.4, U6012.4
/motherboard_motors/EN1_NC: D6004.1, U6012.3
/motherboard_motors/EN1_NO: D6003.1, U6011.3
/motherboard_motors/EN2_COM: D6005.2, D6006.2, U6013.4, U6014.4
/motherboard_motors/EN2_NC: D6006.1, U6014.3
/motherboard_motors/EN2_NO: D6005.1, U6013.3
/motherboard_motors/EN3_COM: D6007.2, D6008.2, U6015.4, U6016.4
/motherboard_motors/EN3_NC: D6008.1, U6016.3
/motherboard_motors/EN3_NO: D6007.1, U6015.3
/motherboard_motors/EN4_COM: D6009.2, D6010.2, U6017.4, U6018.4
/motherboard_motors/EN4_NC: D6010.1, U6018.3
/motherboard_motors/EN4_NO: D6009.1, U6017.3
/motherboard_motors/EN5_COM: D6011.2, D6012.2, U6019.4, U6020.4
/motherboard_motors/EN5_NC: D6012.1, U6020.3
/motherboard_motors/EN5_NO: D6011.1, U6019.3
/motherboard_motors/EN6_COM: D6013.2, D6014.2, U6021.4, U6022.4
/motherboard_motors/EN6_NC: D6014.1, U6022.3
/motherboard_motors/EN6_NO: D6013.1, U6021.3
/motherboard_motors/EN7_COM: D6015.2, D6016.2, U6023.4, U6024.4
/motherboard_motors/EN7_NC: D6016.1, U6024.3
/motherboard_motors/EN7_NO: D6015.1, U6023.3
/motherboard_motors/EN8_COM: D6017.2, D6018.2, U6025.4, U6026.4
/motherboard_motors/EN8_NC: D6018.1, U6026.3
/motherboard_motors/EN8_NO: D6017.1, U6025.3
/motherboard_motors/EN9_COM: D6019.2, D6020.2, U6027.4, U6028.4
/motherboard_motors/EN9_NC: D6020.1, U6028.3
/motherboard_motors/EN9_NO: D6019.1, U6027.3
/motherboard_motors/EN10_COM: D6021.2, D6022.2, U6029.4, U6030.4
/motherboard_motors/EN10_NC: D6022.1, U6030.3
/motherboard_motors/EN10_NO: D6021.1, U6029.3
/motherboard_motors/EN11_COM: D6023.2, D6024.2, U6031.4, U6032.4
/motherboard_motors/EN11_NC: D6024.1, U6032.3
/motherboard_motors/EN11_NO: D6023.1, U6031.3
/motherboard_motors/FIELD_GND: C6013.2, C6014.2, C6016.2, C6017.2, C6019.2, C6020.2, C6022.2, C6023.2, C6025.2, C6026.2, C6028.2, C6029.2, D6025.2, D6026.2, D6027.2, D6028.2, D6029.2, D6030.2, D6031.2, D6032.2, D6033.2, D6034.2, D6035.2, D6036.2, U6035.9, U6035.14, U6036.9, U6036.14, U6037.9, U6037.14, U6038.9, U6038.14, U6039.9, U6039.14, U6040.9, U6040.14
/motherboard_motors/MOTOR0_EN_ACTIVE: U6046.2, U6048.1
/motherboard_motors/MOTOR0_LED_K: R6025.1, U6010.2
/motherboard_motors/MOTOR0_LED_MID: U6009.2, U6010.1
/motherboard_motors/MOTOR0_LED_SINK: R6025.2, U6007.2
/motherboard_motors/MOTOR0_SINK_OFF: U6007.1, U6048.3
/motherboard_motors/MOTOR1_EN_ACTIVE: U6046.4, U6048.4
/motherboard_motors/MOTOR1_LED_K: R6027.1, U6012.2
/motherboard_motors/MOTOR1_LED_MID: U6011.2, U6012.1
/motherboard_motors/MOTOR1_LED_SINK: R6027.2, U6007.4
/motherboard_motors/MOTOR1_SINK_OFF: U6007.3, U6048.6
/motherboard_motors/MOTOR2_EN_ACTIVE: U6046.6, U6048.9
/motherboard_motors/MOTOR2_LED_K: R6029.1, U6014.2
/motherboard_motors/MOTOR2_LED_MID: U6013.2, U6014.1
/motherboard_motors/MOTOR2_LED_SINK: R6029.2, U6007.6
/motherboard_motors/MOTOR2_SINK_OFF: U6007.5, U6048.8
/motherboard_motors/MOTOR3_EN_ACTIVE: U6046.8, U6048.12
/motherboard_motors/MOTOR3_LED_K: R6031.1, U6016.2
/motherboard_motors/MOTOR3_LED_MID: U6015.2, U6016.1
/motherboard_motors/MOTOR3_LED_SINK: R6031.2, U6007.8
/motherboard_motors/MOTOR3_SINK_OFF: U6007.9, U6048.11
/motherboard_motors/MOTOR4_EN_ACTIVE: U6046.10, U6049.1
/motherboard_motors/MOTOR4_LED_K: R6033.1, U6018.2
/motherboard_motors/MOTOR4_LED_MID: U6017.2, U6018.1
/motherboard_motors/MOTOR4_LED_SINK: R6033.2, U6007.10
/motherboard_motors/MOTOR4_SINK_OFF: U6007.11, U6049.3
/motherboard_motors/MOTOR5_EN_ACTIVE: U6046.12, U6049.4
/motherboard_motors/MOTOR5_LED_K: R6035.1, U6020.2
/motherboard_motors/MOTOR5_LED_MID: U6019.2, U6020.1
/motherboard_motors/MOTOR5_LED_SINK: R6035.2, U6007.12
/motherboard_motors/MOTOR5_SINK_OFF: U6007.13, U6049.6
/motherboard_motors/MOTOR6_EN_ACTIVE: U6047.2, U6049.9
/motherboard_motors/MOTOR6_LED_K: R6037.1, U6022.2
/motherboard_motors/MOTOR6_LED_MID: U6021.2, U6022.1
/motherboard_motors/MOTOR6_LED_SINK: R6037.2, U6008.2
/motherboard_motors/MOTOR6_SINK_OFF: U6008.1, U6049.8
/motherboard_motors/MOTOR7_EN_ACTIVE: U6047.4, U6049.12
/motherboard_motors/MOTOR7_LED_K: R6039.1, U6024.2
/motherboard_motors/MOTOR7_LED_MID: U6023.2, U6024.1
/motherboard_motors/MOTOR7_LED_SINK: R6039.2, U6008.4
/motherboard_motors/MOTOR7_SINK_OFF: U6008.3, U6049.11
/motherboard_motors/MOTOR8_EN_ACTIVE: U6047.6, U6050.1
/motherboard_motors/MOTOR8_LED_K: R6041.1, U6026.2
/motherboard_motors/MOTOR8_LED_MID: U6025.2, U6026.1
/motherboard_motors/MOTOR8_LED_SINK: R6041.2, U6008.6
/motherboard_motors/MOTOR8_SINK_OFF: U6008.5, U6050.3
/motherboard_motors/MOTOR9_EN_ACTIVE: U6047.8, U6050.4
/motherboard_motors/MOTOR9_LED_K: R6043.1, U6028.2
/motherboard_motors/MOTOR9_LED_MID: U6027.2, U6028.1
/motherboard_motors/MOTOR9_LED_SINK: R6043.2, U6008.8
/motherboard_motors/MOTOR9_SINK_OFF: U6008.9, U6050.6
/motherboard_motors/MOTOR10_EN_ACTIVE: U6047.10, U6050.9
/motherboard_motors/MOTOR10_LED_K: R6045.1, U6030.2
/motherboard_motors/MOTOR10_LED_MID: U6029.2, U6030.1
/motherboard_motors/MOTOR10_LED_SINK: R6045.2, U6008.10
/motherboard_motors/MOTOR10_SINK_OFF: U6008.11, U6050.8
/motherboard_motors/MOTOR11_EN_ACTIVE: U6047.12, U6050.12
/motherboard_motors/MOTOR11_LED_K: R6047.1, U6032.2
/motherboard_motors/MOTOR11_LED_MID: U6031.2, U6032.1
/motherboard_motors/MOTOR11_LED_SINK: R6047.2, U6008.12
/motherboard_motors/MOTOR11_SINK_OFF: U6008.13, U6050.11
/motherboard_motors/MOTOR_5V_A: C6001.1, C6002.1, C6003.1, C6004.1, C6009.1, C6031.1, C6033.1, R9001.1, R9003.1, U6001.12, U6001.16, U6002.12, U6002.16, U6003.12, U6003.16, U6004.12, U6004.16, U6033.1, U6041.5, U6051.5
/motherboard_motors/MOTOR_5V_B: C6005.1, C6006.1, C6011.1, C6032.1, C6037.1, R9011.1, R9013.1, U6005.12, U6005.16, U6006.12, U6006.16, U6034.1, U6045.5, U6052.5
/motherboard_motors/MOTOR_LED_5V_A: C6010.1, R6049.1, U6009.1, U6011.1, U6013.1, U6015.1, U6017.1, U6019.1, U6021.1, U6023.1, U6033.5, U6033.6
/motherboard_motors/MOTOR_LED_5V_B: C6012.1, R6050.1, U6025.1, U6027.1, U6029.1, U6031.1, U6034.5, U6034.6
/motherboard_motors/MOTOR_PERMIT_A_FILTERED: U6041.6, U6042.1
/motherboard_motors/MOTOR_PERMIT_A_SET: R6088.1, U6041.3
/motherboard_motors/MOTOR_PERMIT_A_TTL_RESTORED: U6041.1, U6051.4
/motherboard_motors/MOTOR_PERMIT_B_FILTERED: U6042.5, U6045.6
/motherboard_motors/MOTOR_PERMIT_B_SET: R6092.1, U6045.3
/motherboard_motors/MOTOR_PERMIT_B_TTL_RESTORED: U6045.1, U6052.4
/motherboard_motors/MOTOR_POWER_OK_A_QUALIFIED: R6089.1, R9045.1, U1001.P14, U6042.2, U9008.7
/motherboard_motors/MOTOR_POWER_OK_B_QUALIFIED: R6093.1, R9046.1, U1001.M5, U6042.6, U9008.3
/motherboard_motors/MOTOR_TX_GATE_A: R6095.1, U6001.4, U6002.4, U6003.4, U6004.4, U6033.3, U6042.7, U6043.6, U6048.2, U6048.5, U6048.10, U6048.13, U6049.2, U6049.5, U6049.10, U6049.13
/motherboard_motors/MOTOR_TX_GATE_B: R6096.1, U6005.4, U6006.4, U6034.3, U6042.3, U6044.6, U6050.2, U6050.5, U6050.10, U6050.13
/motherboard_motors/OPI_OK_A: U1001.R11, U6043.5
/motherboard_motors/OPI_OK_B: U1001.M11, U6044.5
/watchdog_conditioning/FPGA_PROGRESS_O: R3007.1, U1001.L2, U3004.2
/watchdog_conditioning/WD_M_CWD: C3001.1, U3001.2
/watchdog_conditioning/WD_M_HEALTH_RAW: R3001.2, U3001.7, U3001.8, U3005.1
/watchdog_conditioning/WD_M_WDI_BUF: R3006.1, U3001.6, U3003.4
/watchdog_conditioning/WD_O_CWD: C3002.1, U3002.2
/watchdog_conditioning/WD_O_HEALTH_RAW: R3002.2, U3002.7, U3002.8, U3005.3
/watchdog_conditioning/WD_O_WDI_BUF: R3008.1, U3002.6, U3004.4
