DeadlySIn777/Controller/hardware/octopus_external_adapter/r0_3_planning/packing60-validation/adapter.kicad_pcb

## KiCad design hardware/octopus_external_adapter/r0_3_planning/packing60-validation/adapter.kicad_pcb (2026-10-18)

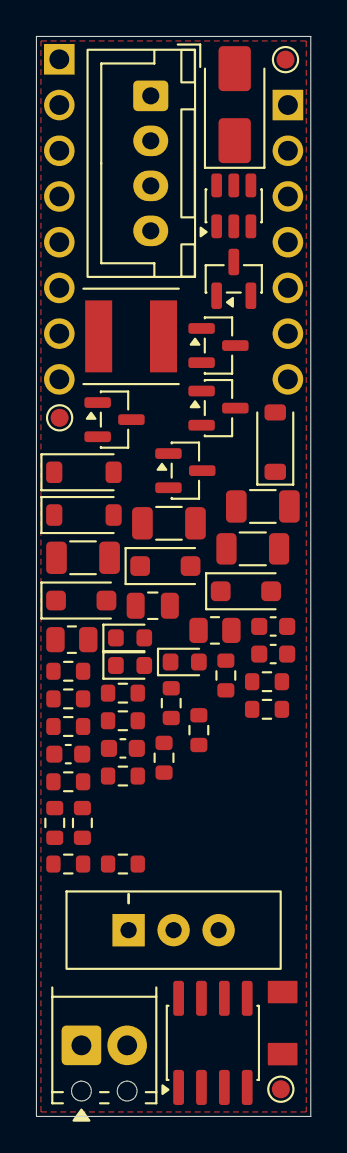
[picture p74: board adapter.kicad_pcb from above]

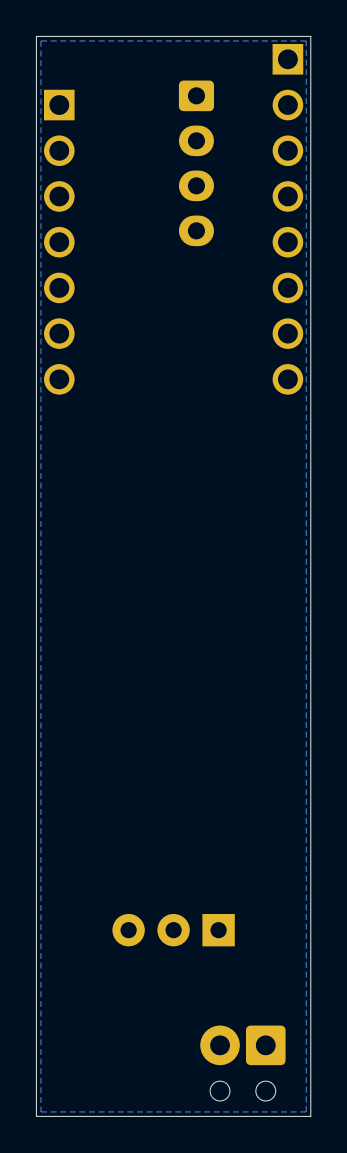
[picture p75: board adapter.kicad_pcb from below]

Board: 2 copper layers, 15.2 x 60.0 mm, 55 parts (2 on the bottom side), 33 nets, no tracks yet.

Parts:
C20, C25: 4.7uF 50V X7R 10%; C_1206_3216Metric
C21, C22: 100nF 50V X7R 10%; C_0603_1608Metric
C23: 22uF 25V X5R 10%; C_1206_3216Metric
C26: 2.2uF 25V X7R 10%; C_0805_2012Metric
C50, C51: 100nF 50V X7R; C_0603_1608Metric
D20: 28V bidirectional TVS; D_SMA
D21: 12V gate clamp; D_SOD-123
D22, D23, D25: 60V Schottky; D_SOD-123F
D24: 5.1V EN clamp; D_SOD-123
D26: 100V indicator input isolation; D_SOD-123
D50: 5V red LED; LED_0603_1608Metric
D51: 12V red LED; LED_0603_1608Metric
D52: 24V red LED; LED_0603_1608Metric
F20: 0.5A 63V fast fuse; Bourns_SF-1206F_3.1x1.55mm
J1: StepStick logic row; Wurth_61300811121_1x08_P2.54mm
J2: StepStick power row; VM physically omitted; Wurth_61300711121_1x07_P2.54mm
J3: Keyed driver signal output; JST_XH_B4B-XH-A_1x04_P2.50mm_Vertical
J4: External reference/power 5/12/24V; Phoenix_1725656_MPT_0p5_2_2p54_SilkClearance
L20: 15uH 20% Isat2.0A; L_Bourns_SRN5040
Q1, Q2, Q3: NX6008NBK; SOT-23
Q20: 60V reverse-polarity P-MOSFET; SOT-23
R1, R2, R3, R50, R51, R52: 1k 1%; R_0603_1608Metric
R4, R5, R6, R25: 10k 1%; R_0603_1608Metric
R20, R24: 100k 1%; R_0603_1608Metric
R21: 124k 0.1%; R_0603_1608Metric
R22: 23.7k 0.1%; R_0603_1608Metric
R23: 10k 1% 0.125W; R_0805_2012Metric
R26: 82ohm 1% 0.66W pulse-tolerant; R_1206_3216Metric
R27: 4.7k 1%; R_0603_1608Metric
R28: 330ohm 1% 0.125W; R_0805_2012Metric
R53: 100k 0.1% 25ppm/C; R_0603_1608Metric
R54: 3.9k 0.1% 25ppm/C; R_0603_1608Metric
SW1: 5V / EXT; E-Switch_EG1218_P040040
TP50: UPDI; TestPoint_Pad_D1.0mm
TP51: 3V3 SENSE ONLY; TestPoint_Pad_D1.0mm
TP52: GND; TestPoint_Pad_D1.0mm
U20: MP2459 adjustable buck ~5.06V; TSOT-23-6
U21: AP7375 3.3V indicator LDO; SOT-23
U50: ATtiny202 voltage indicator; SOIC-8_3.9x4.9mm_P1.27mm

Connections:
/BUCK_BST: C22.1, U20.1
/BUCK_EN: D24.1, R23.2, R24.1, U20.4
/BUCK_FB: R21.2, R22.1, U20.3
/BUCK_SW: C22.2, D23.1, L20.1, U20.6
/BUCK_VIN: C20.1, C21.1, D22.1, R23.1, U20.5
/COM_PLUS: J3.1, R25.1, R26.1, R53.1, SW1.2
/DIR: J1.8, R2.1
/DIR_GATE: Q2.1, R2.2, R5.1
/DIR_MINUS: J3.3, Q2.3
/EN: J1.1, R3.1
/ENA_MINUS: J3.4, Q3.3
/EN_GATE: Q3.1, R3.2, R6.1
/EXT_RAW: F20.1, J4.1
/GND: C20.2, C21.2, C23.2, C25.2, C26.2, C50.2, C51.2, D20.2, D23.2, D24.2, D50.1, D51.1, D52.1, J2.1, J2.7, J4.2, Q1.2, Q2.2, Q3.2, R4.2, R5.2, R6.2, R20.2, R22.2, R24.2, R25.2, R27.2, R28.2, R54.2, TP52.1, U20.2, U21.3, U50.8
/IND_ADC: C51.1, R53.2, R54.1, U50.4
/IND_FEED_R: D26.2, R26.2
/IND_LED5_A: D50.2, R50.2
/IND_LED12_A: D51.2, R51.2
/IND_LED24_A: D52.2, R52.2
/IND_LED_5V: R50.1, U50.2
/IND_LED_12V: R51.1, U50.3
/IND_LED_24V: R52.1, U50.5
/IND_UPDI: TP50.1, U50.6
/PUL_MINUS: J3.2, Q1.3
/REV_GATE: D21.2, Q20.1, R20.1
/STEP: J1.7, R1.1
/STEP_GATE: Q1.1, R1.2, R4.1
/V5_REG: C23.1, D25.2, L20.2, R21.1, R28.1
/V5_SELECT: D25.1, SW1.1
/V_EXT_FUSED: D20.1, F20.2, Q20.3
/V_EXT_PROT: D21.1, D22.2, Q20.2, SW1.3
/V_IND_3V3: C26.1, C50.1, R27.1, TP51.1, U21.2, U50.1
/V_IND_IN: C25.1, D26.1, U21.1
