DeadlySIn777/Controller/hardware/octopus_external_adapter/r0_2/buck-en-join/source-moved-r21.kicad_pcb

## KiCad design hardware/octopus_external_adapter/r0_2/buck-en-join/source-moved-r21.kicad_pcb (2026-10-18)

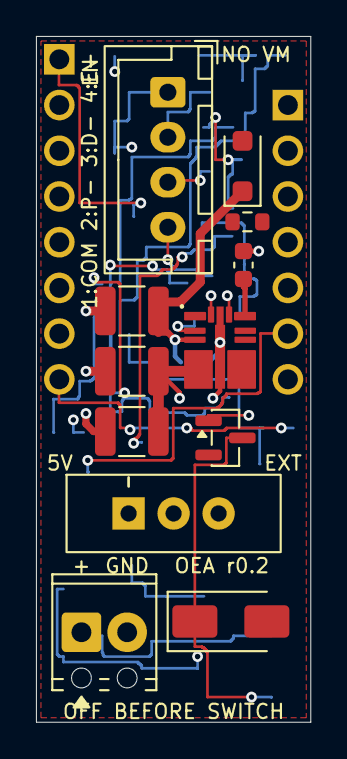
[picture p76: board source-moved-r21.kicad_pcb from above]

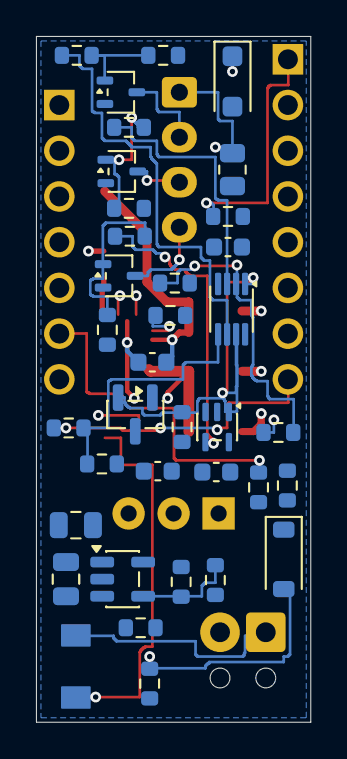
[picture p77: board source-moved-r21.kicad_pcb from below]

Board: 4 copper layers, 15.2 x 38.1 mm, 50 parts (38 on the bottom side), 30 nets.

Parts:
C1, C2, C3: 100nF 50V X7R; C_0603_1608Metric
C20: 2.2uF 100V X7R 10%; C_1210_3225Metric
C21: 100nF 100V X7R 10%; C_0603_1608Metric
C22: 1uF 16V X7R 10%; C_0603_1608Metric
C23, C24: 22uF 25V X7R 20%; C_1210_3225Metric
C25: 220nF 100V X7S 10%; C_0805_2012Metric
C26: 4.7uF 25V X7R 10%; C_0805_2012Metric
D1: PMEG6010CEH; D_SOD-123F
D20: 28V bidirectional TVS; D_SMA
D21: 12V gate clamp; D_SOD-123
D22: 60V buck input reverse-current block; D_SOD-123F
F20: 0.5A 63V fast fuse; Bourns_SF-1206F_3.1x1.55mm
J1: StepStick logic row; Wurth_61300811121_1x08_P2.54mm
J2: StepStick power row; VM physically omitted; Wurth_61300711121_1x07_P2.54mm
J3: Keyed driver signal output; JST_XH_B4B-XH-A_1x04_P2.50mm_Vertical
J4: External reference/power 5/12/24V; TerminalBlock_Phoenix_MPT-0,5-2-2.54_1x02_P2.54mm_Horizontal
Q1, Q2, Q3: NX6008NBKW; SOT-323_SC-70
Q20: 60V reverse-polarity P-MOSFET; SOT-23
R1, R2, R3, R8, R9, R10: 220R 1%; R_0603_1608Metric
R4, R5, R7, R14, R20: 100k 1%; R_0603_1608Metric
R6, R11, R12, R13: 10k 1%; R_0603_1608Metric
R15: 10k 1% 0.125W; R_0805_2012Metric
R21: 127k 1%; R_0603_1608Metric
R22: 20k 1%; R_0603_1608Metric
R23: 174k 0.1%; R_0603_1608Metric
R24: 100k 0.1%; R_0603_1608Metric
R25: 22k 1%; R_0603_1608Metric
SW1: 5V / EXT; E-Switch_EG1218_P040040
U1: SN74LVC2G126DCUR; VSSOP-8_2.3x2mm_P0.5mm
U2: SN74LVC1G126DCKR; SOT-353_SC-70-5
U3: TPS3839G33DBZR; SOT-23
U20: TPSM365R6V5RDNR fixed 5V buck; TI_RDN0011A_TPSM365R6
U21: LT3014BES5#TRMPBF ~3.34V LDO; TSOT-23-5

Connections:
/BUCK_EN: R21.2, R22.1, U20.2
/BUCK_VCC: C22.1, U20.8
/BUCK_VIN: C20.1, C21.1, D22.1, R21.1, U20.3
/COM_PLUS: J3.1, R15.1, SW1.2
/DIR: J1.8, R2.1
/DIR_BUF: R9.1, U1.3
/DIR_GATE: Q2.1, R9.2, R12.1
/DIR_IN: R2.2, R5.1, U1.5
/DIR_MINUS: J3.3, Q2.3
/EN: J1.1, R3.1
/ENA_MINUS: J3.4, Q3.3
/EN_BUF: R10.1, U2.4
/EN_GATE: Q3.1, R10.2, R13.1
/EN_IN: R3.2, R6.2, R7.1, U2.2
/EXT_RAW: F20.1, J4.1
/GND: C1.2, C2.2, C3.2, C20.2, C21.2, C22.2, C23.2, C24.2, C25.2, C26.2, D20.2, J2.1, J2.7, J4.2, Q1.2, Q2.2, Q3.2, R4.2, R5.2, R7.2, R11.2, R12.2, R13.2, R14.2, R15.2, R20.2, R22.2, R24.2, R25.2, U1.4, U2.3, U3.1, U20.10, U20.11, U21.2
/HOST_VIO: J2.6, R6.1
/LDO_ADJ: R23.2, R24.1, U21.4
/LOGIC_READY: R14.1, U1.1, U1.7, U2.1, U3.2
/PUL_MINUS: J3.2, Q1.3
/REV_GATE: D21.2, Q20.1, R20.1
/STEP: J1.7, R1.1
/STEP_BUF: R8.1, U1.6
/STEP_GATE: Q1.1, R8.2, R11.1
/STEP_IN: R1.2, R4.1, U1.2
/V5_REG: C23.1, C24.1, D1.2, U20.4, U20.9
/V5_SELECT: D1.1, SW1.1
/V_EXT_FUSED: D20.1, F20.2, Q20.3
/V_EXT_PROT: C25.1, D21.1, D22.2, Q20.2, SW1.3, U21.1
/V_LOGIC: C1.1, C2.1, C3.1, C26.1, R23.1, R25.1, U1.8, U2.5, U3.3, U21.5
