DeadlySIn777/Controller/hardware/controller_assembly/fpga_core.kicad_sch

## KiCad design hardware/controller_assembly/fpga_core.kicad_sch (2026-10-18)

Schematic: fpga_core.kicad_sch

Parts:
C11001, C11002, C11003, C11004, C11005, C11006, C11007, C11008, C11009, C11010, C11011, C11012, C11013, C11014, C11015, C11016, C11017, C11018, C11019, C11020, C11021, C11022, C11023, C11035, C11038: 0.1uF 16V X7R; C_0603_1608Metric; MPN 885012206046
C11024, C11028, C11029, C11030, C11031, C11032, C11033, C11034: 4.7uF 16V X7R; C_0805_2012Metric; MPN 885012207053
C11025, C11026, C11027, C11036, C11039: 1uF 16V X7R; C_0603_1608Metric; MPN 885012206052
C11037: 0.01uF 16V X7R; C_0603_1608Metric; MPN 885012206040
J11001: POWER / QUALIFIED SEQUENCER
J11002: JTAG SERVICE / NO POWER INJECTION
J11003: HOST SPI / 3V3 ONLY
J11004: HW PERMISSION / NO ESP MOTION AUTHORITY
J11005: TWELVE MOTOR STEP / DIR
J11006: ENABLE RESERVES / CIRCUITS ABSENT
J11007: HOME / 0-5 PRESENT; 6-11 RESERVED
J11008: ALARM / 0-5 PRESENT; 6-11 RESERVED
J11009: ENCODERS / 0-1 PRESENT; 2-3 RESERVED
J11010: AUX / EXISTING ISOLATED INPUTS
R11001, R11002: 33R 1%; R_0603_1608Metric; MPN CRCW060333R0FKEA
R11003, R11004, R11005, R11006, R11007, R11008, R11009, R11010, R11011, R11012, R11013, R11014, R11015, R11016, R11017, R11018, R11019, R11022, R11023, R11024, R11025: 10000R 1%; R_0603_1608Metric; MPN CRCW060310K0FKEA
R11020: 47000R 1%; R_0603_1608Metric; MPN CRCW060347K0FKEA
R11021: 1000R 1%; R_0603_1608Metric; MPN CRCW06031K00FKEA
U11001: T20F256I4 / CANDIDATE PIN ALLOCATION; MPN T20F256I4
U11002: W25Q32JVSSIQ / x1 SPI; SOIC-8_5.3x5.3mm_P1.27mm; MPN W25Q32JVSSIQ
U11003: SN74LVC1G08DCKR / RESET AND; SOT-353_SC-70-5; MPN SN74LVC1G08DCKR
U11004: 74LVC1G17GW / CDONE DELAY SCHMITT; SOT-353_SC-70-5; MPN 74LVC1G17GW
U11005: SN74LVC1G08DCKR / USER RESET AND; SOT-353_SC-70-5; MPN SN74LVC1G08DCKR
Y11001: ASE-50.000MHZ-L-C-T; MPN ASE-50.000MHZ-L-C-T

Connections:
ALM0_FPGA: J11008.1, U11001.B12 (GPIOR_93)
ALM1_FPGA: J11008.2, U11001.B13 (GPIOR_97)
ALM2_FPGA: J11008.3, U11001.B15 (GPIOR_98)
ALM3_FPGA: J11008.4, U11001.C13 (GPIOR_99)
ALM4_FPGA: J11008.5, U11001.C16 (GPIOR_108)
ALM5_FPGA: J11008.6, U11001.E14 (GPIOR_110)
ALM6_FPGA: J11008.7, U11001.F12 (GPIOR_111)
ALM7_FPGA: J11008.8, U11001.D16 (GPIOR_116_CTRL15)
ALM8_FPGA: J11008.9, U11001.G13 (GPIOR_117_CTRL14)
ALM9_FPGA: J11008.10, U11001.F14 (GPIOR_118_CTRL13)
ALM10_FPGA: J11008.11, U11001.E16 (GPIOR_119_CTRL12)
ALM11_FPGA: J11008.12, U11001.E15 (GPIOR_120_CLK15)
CORE_1V2: C11001.1, C11002.1, C11003.1, C11004.1, C11005.1, C11006.1, C11007.1, C11008.1, C11009.1, C11024.1, C11025.1, C11026.1, C11027.1, J11001.1, U11001.E9 (VCC), U11001.F7 (VCCA_TL), U11001.F8 (VCC), U11001.F9 (VCC), U11001.G11 (VCCA_TR), U11001.J6 (VCC), U11001.J7 (VCC), U11001.K9 (VCC), U11001.K11 (VCCA_BR)
CYCLE_START_FPGA: J11010.8, U11001.H16 (GPIOR_130_CTRL9)
DIR0_FPGA: J11005.2, U11001.J5 (GPIOL_11)
DIR1_FPGA: J11005.4, U11001.K3 (GPIOL_15)
DIR2_FPGA: J11005.6, U11001.K1 (GPIOL_18)
DIR3_FPGA: J11005.8, U11001.H1 (GPIOL_22_CTRL2)
DIR4_FPGA: J11005.10, U11001.H2 (GPIOL_25_CLK1)
DIR5_FPGA: J11005.12, U11001.G3 (GPIOL_27_CLK3)
DIR6_FPGA: J11005.14, U11001.G2 (GPIOL_29_CLK5)
DIR7_FPGA: J11005.16, U11001.C1 (GPIOL_33_CTRL5)
DIR8_FPGA: J11005.18, U11001.F3 (GPIOL_35_CTRL7)
DIR9_FPGA: J11005.20, U11001.E1 (GPIOL_37)
DIR10_FPGA: J11005.22, U11001.G4 (GPIOL_42)
DIR11_FPGA: J11005.24, U11001.B1 (GPIOL_44)
DOOR_STATUS_FPGA: J11010.3, U11001.H13 (GPIOR_125_CLK10)
DRIVE_ENABLE0_FPGA_RESERVED: J11006.1, U11001.H12 (GPIOR_139)
DRIVE_ENABLE1_FPGA_RESERVED: J11006.2, U11001.J12 (GPIOR_141)
DRIVE_ENABLE2_FPGA_RESERVED: J11006.3, U11001.L16 (GPIOR_143)
DRIVE_ENABLE3_FPGA_RESERVED: J11006.4, U11001.M15 (GPIOR_144)
DRIVE_ENABLE4_FPGA_RESERVED: J11006.5, U11001.M16 (GPIOR_145)
DRIVE_ENABLE5_FPGA_RESERVED: J11006.6, U11001.P16 (GPIOR_146)
DRIVE_ENABLE6_FPGA_RESERVED: J11006.7, U11001.L15 (GPIOR_147)
DRIVE_ENABLE7_FPGA_RESERVED: J11006.8, U11001.K12 (GPIOR_148)
DRIVE_ENABLE8_FPGA_RESERVED: J11006.9, U11001.N14 (GPIOR_153)
DRIVE_ENABLE9_FPGA_RESERVED: J11006.10, U11001.N16 (GPIOR_154)
DRIVE_ENABLE10_FPGA_RESERVED: J11006.11, U11001.P15 (GPIOR_155)
DRIVE_ENABLE11_FPGA_RESERVED: J11006.12, U11001.M14 (GPIOR_156)
ENC0_A_FPGA: J11009.1, U11001.B5 (GPIOL_61)
ENC0_B_FPGA: J11009.2, U11001.A7 (GPIOL_62)
ENC0_Z_FPGA: J11009.3, U11001.B7 (GPIOL_63)
ENC1_A_FPGA: J11009.4, U11001.B6 (GPIOL_64)
ENC1_B_FPGA: J11009.5, U11001.A6 (GPIOL_65)
ENC1_Z_FPGA: J11009.6, U11001.E7 (GPIOL_68)
ENC2_A_FPGA: J11009.7, U11001.D9 (GPIOL_74_PLLIN0)
ENC2_B_FPGA: J11009.8, U11001.E8 (GPIOL_75_PLLIN1)
ENC2_Z_FPGA: J11009.9, U11001.C9 (GPIOR_76_PLLIN0)
ENC3_A_FPGA: J11009.10, U11001.D10 (GPIOR_77_PLLIN1)
ENC3_B_FPGA: J11009.11, U11001.B9 (GPIOR_80)
ENC3_Z_FPGA: J11009.12, U11001.C10 (GPIOR_81_MREFCLK)
FEED_HOLD_FPGA: J11010.7, U11001.H15 (GPIOR_129_CTRL10)
FPGA_CDONE: J11001.6, J11002.8, R11003.2, R11022.1, U11001.R1 (CDONE)
FPGA_CFG_CBSEL0: R11018.1, U11001.C7 (GPIOL_70_CBSEL0)
FPGA_CFG_CBSEL1: R11019.1, U11001.D7 (GPIOL_69_CBSEL1)
FPGA_CFG_CBUS0: R11009.2, U11001.K13 (GPIOR_151_CBUS0)
FPGA_CFG_CBUS1: R11008.2, U11001.L14 (GPIOR_150_CBUS1)
FPGA_CFG_CBUS2: R11007.2, U11001.R16 (GPIOR_149_CBUS2)
FPGA_CFG_CSI: R11004.2, U11001.N3 (GPIOL_04_CSI)
FPGA_CFG_NSTATUS: J11001.7, R11017.2, U11001.B8 (GPIOL_71_NSTATUS)
FPGA_CFG_TEST_N: R11005.2, U11001.L12 (GPIOR_158_TEST_N)
FPGA_CLK_50M: R11001.2, U11001.H3 (GPIOL_24_CLK0)
FPGA_CLK_SOURCE: R11001.1, Y11001.3 (OUT)
FPGA_CRESET_N: J11001.4, U11003.1 (A)
FPGA_ENDPOINT_READY: J11004.2, R11023.1, U11001.C4 (GPIOL_51)
FPGA_FLASH_CCK: R11002.2, U11002.6 (CLK)
FPGA_FLASH_CCK_SOURCE: R11002.1, U11001.M3 (GPIOL_01_CCK)
FPGA_FLASH_CS_N: R11006.2, U11001.P3 (GPIOL_00_SS_N), U11002.1 (CS_N)
FPGA_FLASH_IO2: R11014.2, U11002.3 (WP_N / IO2)
FPGA_FLASH_IO3: R11015.2, U11002.7 (HOLD_N / IO3)
FPGA_FLASH_MISO: U11001.N1 (GPIOL_09_CDI1), U11002.2 (DO / IO1)
FPGA_FLASH_MOSI: U11001.L3 (GPIOL_08_CDI0), U11002.5 (DI / IO0)
FPGA_INHIBIT_FAULT: J11004.6, U11001.A4 (GPIOL_59)
FPGA_JTAG_TCK: J11002.3, R11010.2, U11001.M2 (TCK)
FPGA_JTAG_TDI: J11002.5, R11011.2, U11001.K5 (TDI)
FPGA_JTAG_TDO: J11002.6, R11013.2, U11001.L5 (TDO)
FPGA_JTAG_TMS: J11002.4, R11012.2, U11001.M1 (TMS)
FPGA_LINK_FAULT: J11003.6, U11001.A3 (GPIOL_57)
FPGA_LOCAL_RESET_N: J11001.5, J11004.7, R11020.2, R11021.1, U11001.P1 (CRESET_N), U11003.4 (Y)
FPGA_MOTION_REQUEST: J11004.3, R11024.1, U11001.B3 (GPIOL_52)
FPGA_PROGRESS_WDI: J11004.4, R11025.1, U11001.E4 (GPIOL_55)
FPGA_SERVICE_RUN_N: J11002.7, R11016.2, U11003.2 (B), U11005.2 (B)
FPGA_TIMING_FAULT: J11003.8, U11001.E5 (GPIOL_60)
FPGA_USER_RESET_DELAYED: U11004.4 (Y), U11005.1 (A)
FPGA_USER_RESET_N: U11001.D5 (GPIOL_49), U11005.4 (Y)
FPGA_USER_RESET_RC: C11039.1, R11022.2, U11004.2 (A)
FPGA_WATCHDOG_FAULT: J11003.7, U11001.C6 (GPIOL_58)
HOME0_FPGA: J11007.1, U11001.B10 (GPIOR_82)
HOME1_FPGA: J11007.2, U11001.B11 (GPIOR_83)
HOME2_FPGA: J11007.3, U11001.A11 (GPIOR_84)
HOME3_FPGA: J11007.4, U11001.C12 (GPIOR_85)
HOME4_FPGA: J11007.5, U11001.C11 (GPIOR_86)
HOME5_FPGA: J11007.6, U11001.D12 (GPIOR_89)
HOME6_FPGA: J11007.7, U11001.C14 (GPIOR_102)
HOME7_FPGA: J11007.8, U11001.D13 (GPIOR_103)
HOME8_FPGA: J11007.9, U11001.B16 (GPIOR_106)
HOME9_FPGA: J11007.10, U11001.A14 (GPIOR_90)
HOME10_FPGA: J11007.11, U11001.E12 (GPIOR_91)
HOME11_FPGA: J11007.12, U11001.B14 (GPIOR_92)
HOST_SPI_CS_N: J11003.1, U11001.B2 (GPIOL_45)
HOST_SPI_MISO: J11003.4, U11001.C3 (GPIOL_48)
HOST_SPI_MOSI: J11003.3, U11001.D4 (GPIOL_47)
HOST_SPI_SCLK: J11003.2, U11001.D3 (GPIOL_46)
HW_WATCHDOG_OK_N: J11004.1, U11001.A2 (GPIOL_50)
IO_3V3: C11010.1, C11011.1, C11012.1, C11013.1, C11014.1, C11015.1, C11016.1, C11017.1, C11018.1, C11019.1, C11020.1, C11021.1, C11022.1, C11023.1, C11028.1, C11029.1, C11030.1, C11031.1, C11032.1, C11033.1, C11034.1, C11035.1, C11036.1, C11037.1, C11038.1, J11001.2, J11002.1, J11010.11, R11003.1, R11004.1, R11005.1, R11006.1, R11007.1, R11008.1, R11009.1, R11010.1, R11011.1, R11012.1, R11013.1, R11014.1, R11015.1, R11016.1, R11017.1, R11020.1, U11001.E10 (VCCIO3A_3B_3C), U11001.F6 (VCCIO1D_1E), U11001.F10 (VCCIO3A_3B_3C), U11001.F11 (VCCIO3A_3B_3C), U11001.G6 (VCCIO1D_1E), U11001.H6 (VCCIO1B_1C), U11001.H7 (VCCIO1B_1C), U11001.J10 (VCCIO3D_3E), U11001.J11 (VCCIO3D_3E), U11001.K6 (VCCIO1A), U11001.L6 (VCCIO4B), U11001.L7 (VCCIO4B), U11001.L10 (VCCIO4A), U11001.L11 (VCCIO4A), U11002.8 (VCC), U11003.5 (VCC), U11004.5 (VCC), U11005.5 (VCC), Y11001.1 (STBY_N), Y11001.4 (VDD)
LOGIC_GND: C11001.2, C11002.2, C11003.2, C11004.2, C11005.2, C11006.2, C11007.2, C11008.2, C11009.2, C11010.2, C11011.2, C11012.2, C11013.2, C11014.2, C11015.2, C11016.2, C11017.2, C11018.2, C11019.2, C11020.2, C11021.2, C11022.2, C11023.2, C11024.2, C11025.2, C11026.2, C11027.2, C11028.2, C11029.2, C11030.2, C11031.2, C11032.2, C11033.2, C11034.2, C11035.2, C11036.2, C11037.2, C11038.2, C11039.2, J11001.3, J11001.8, J11002.2, J11003.5, J11004.8, J11010.12, R11018.2, R11019.2, R11021.2, R11023.2, R11024.2, R11025.2, U11001.A1 (GND), U11001.A5 (GND), U11001.A12 (GND), U11001.A16 (GND), U11001.D2 (GND), U11001.D15 (GND), U11001.G7 (GND), U11001.G8 (GND), U11001.G9 (GND), U11001.G10 (GND), U11001.H8 (GND), U11001.H9 (GND), U11001.H10 (GND), U11001.H11 (GND), U11001.J1 (GND), U11001.J8 (GND), U11001.J9 (GND), U11001.J16 (GND), U11001.K7 (GND), U11001.K8 (GND), U11001.K10 (GND), U11001.L8 (GND), U11001.L9 (GND), U11001.N2 (GND), U11001.N15 (GND), U11001.R7 (GND), U11001.R10 (GND), U11001.T1 (GND), U11001.T4 (GND), U11001.T13 (GND), U11001.T16 (GND), U11002.4 (GND), U11003.3 (GND), U11004.3 (GND), U11005.3 (GND), Y11001.2 (GND)
LUBE_STATUS_FPGA: J11010.9, U11001.J15 (GPIOR_131_CTRL8)
PROBE_FPGA: J11010.1, U11001.G12 (GPIOR_121_CLK14)
PROTECTIVE_STATUS_FPGA: J11010.4, U11001.G16 (GPIOR_126_CLK9)
SPARE_FPGA: J11010.10, U11001.K14 (GPIOR_138)
SPINDLE_FAULT_FPGA: J11010.5, U11001.G14 (GPIOR_127_CLK8)
SPINDLE_READY_FPGA: J11010.6, U11001.H14 (GPIOR_128_CTRL11)
STEP0_FPGA: J11005.1, U11001.P2 (GPIOL_02)
STEP1_FPGA: J11005.3, U11001.J4 (GPIOL_14)
STEP2_FPGA: J11005.5, U11001.J3 (GPIOL_16)
STEP3_FPGA: J11005.7, U11001.K2 (GPIOL_19)
STEP4_FPGA: J11005.9, U11001.L1 (GPIOL_23_CTRL3)
STEP5_FPGA: J11005.11, U11001.H4 (GPIOL_26_CLK2)
STEP6_FPGA: J11005.13, U11001.G5 (GPIOL_28_CLK4)
STEP7_FPGA: J11005.15, U11001.F1 (GPIOL_30_CLK6)
STEP8_FPGA: J11005.17, U11001.E2 (GPIOL_34_CTRL6)
STEP9_FPGA: J11005.19, U11001.D1 (GPIOL_36)
STEP10_FPGA: J11005.21, U11001.E3 (GPIOL_39)
STEP11_FPGA: J11005.23, U11001.F4 (GPIOL_43)
TOOLSETTER_FPGA: J11010.2, U11001.G15 (GPIOR_124_CLK11)
TX_PERMIT: J11004.5, U11001.E6 (GPIOL_56)

Notes on the sheet:
T20F256 FPGA CORE / MINIMUM 8 MOTOR CHANNELS, 12-CHANNEL PIN CAPACITY CANDIDATE
Exact 256 balls: Efinix T20-PINOUT worksheet T20F256. Pin allocation is a board candidate, NOT vendor fit or routed timing. All VCCIO=3.3V. All VCC/VCCA=1.2V. No 5V-tolerant FPGA connection. No native LVDS: REF_RES intentionally NC.
One 100nF per supply ball; bulk per physical supply group. Decoupling is a layout-study allowance, not a PDN proof. Active SPI x1 straps111; CSI/TEST high. Flash bus reserved from user RTL. CCK damping33R is provisional. CDONE is open-drain with10k pullup; status does not grant motion permission. C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
RESET: U3 combines qualified upstream reset with service RUN for configuration reset only. U4/U5 make a separate CDONE-qualified user-logic reset; R22/C39 provide a candidate post-CDONE delay and service RUN can hold it low through a JTAG handoff. No programmer output fights the sequencer. User-log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
NC crosses are genuine unused GPIO/config outputs and REF_RES only; every supply/GND ball is connected. Boundary symbols are not released connectors. No footprint approval, PCB, DRC, bitstream, qualification or fabrication files.
J1-J10 ARE INTERNAL LOGIC BOUNDARIES, NOT FIELD TERMINALS. Enables and extra home/alarm/encoder channels are reserves only. CRESET47k/1k plus two internal pullups screened. The separate 10k/1uF CDONE reset delay is a candidate, not a guaranteed time or safety function; threshold/partial-power confi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
