DeadlySIn777/Controller/hardware/controller_assembly/logic_power.kicad_sch

## KiCad design hardware/controller_assembly/logic_power.kicad_sch (2026-10-18)

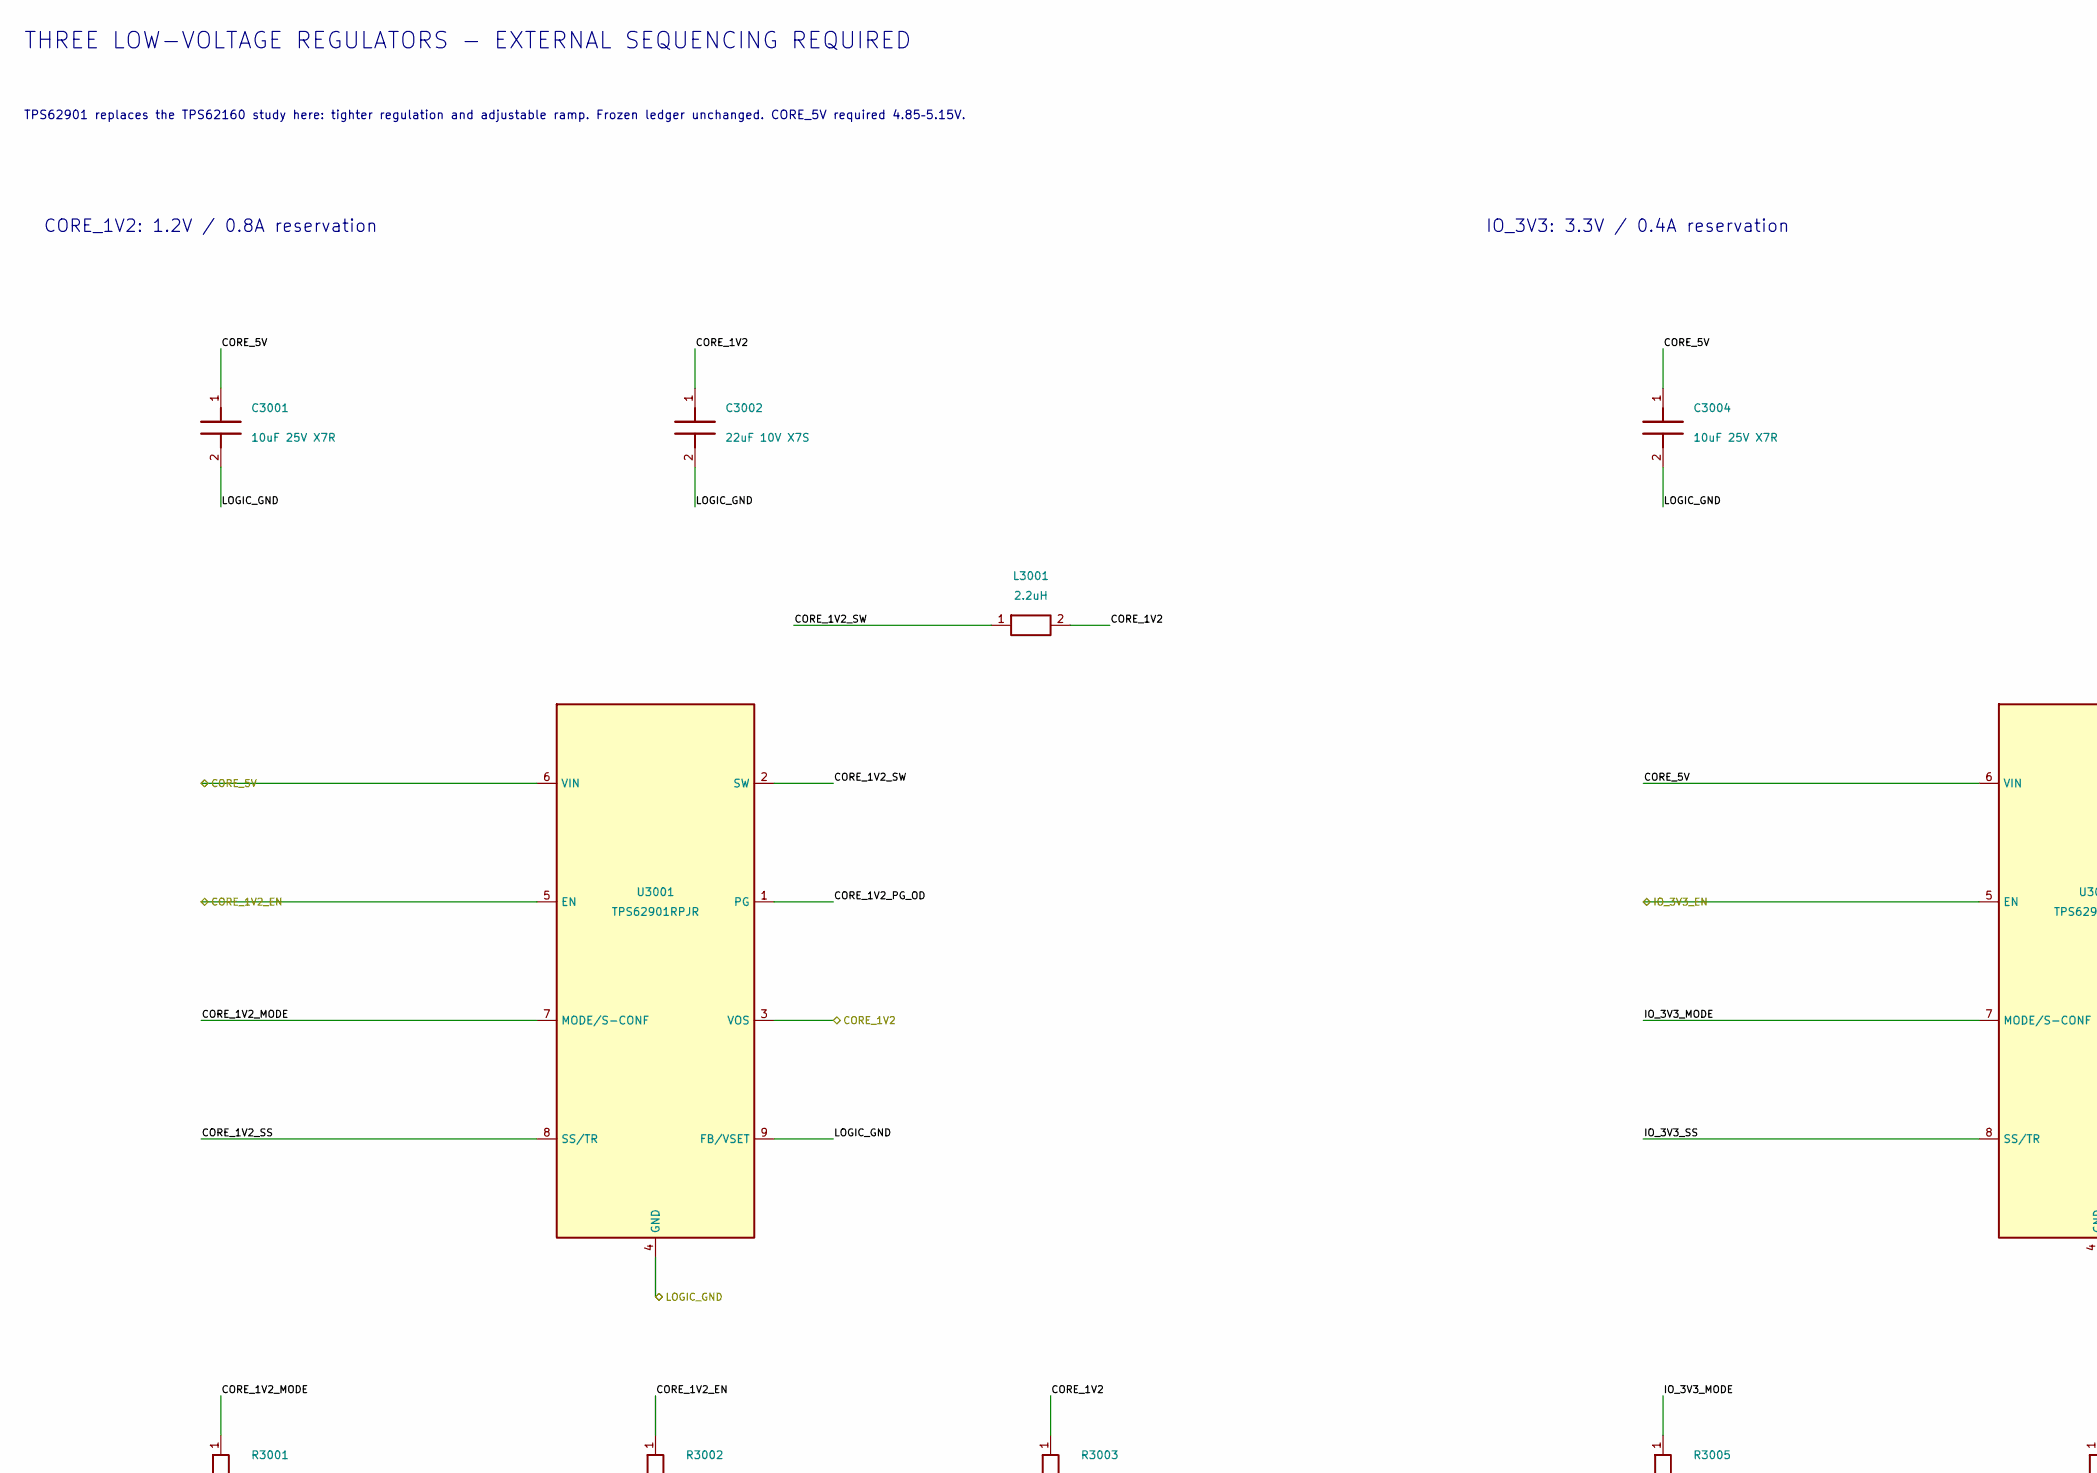
[picture p78: schematic logic_power.kicad_sch, part in row 1, column 1]

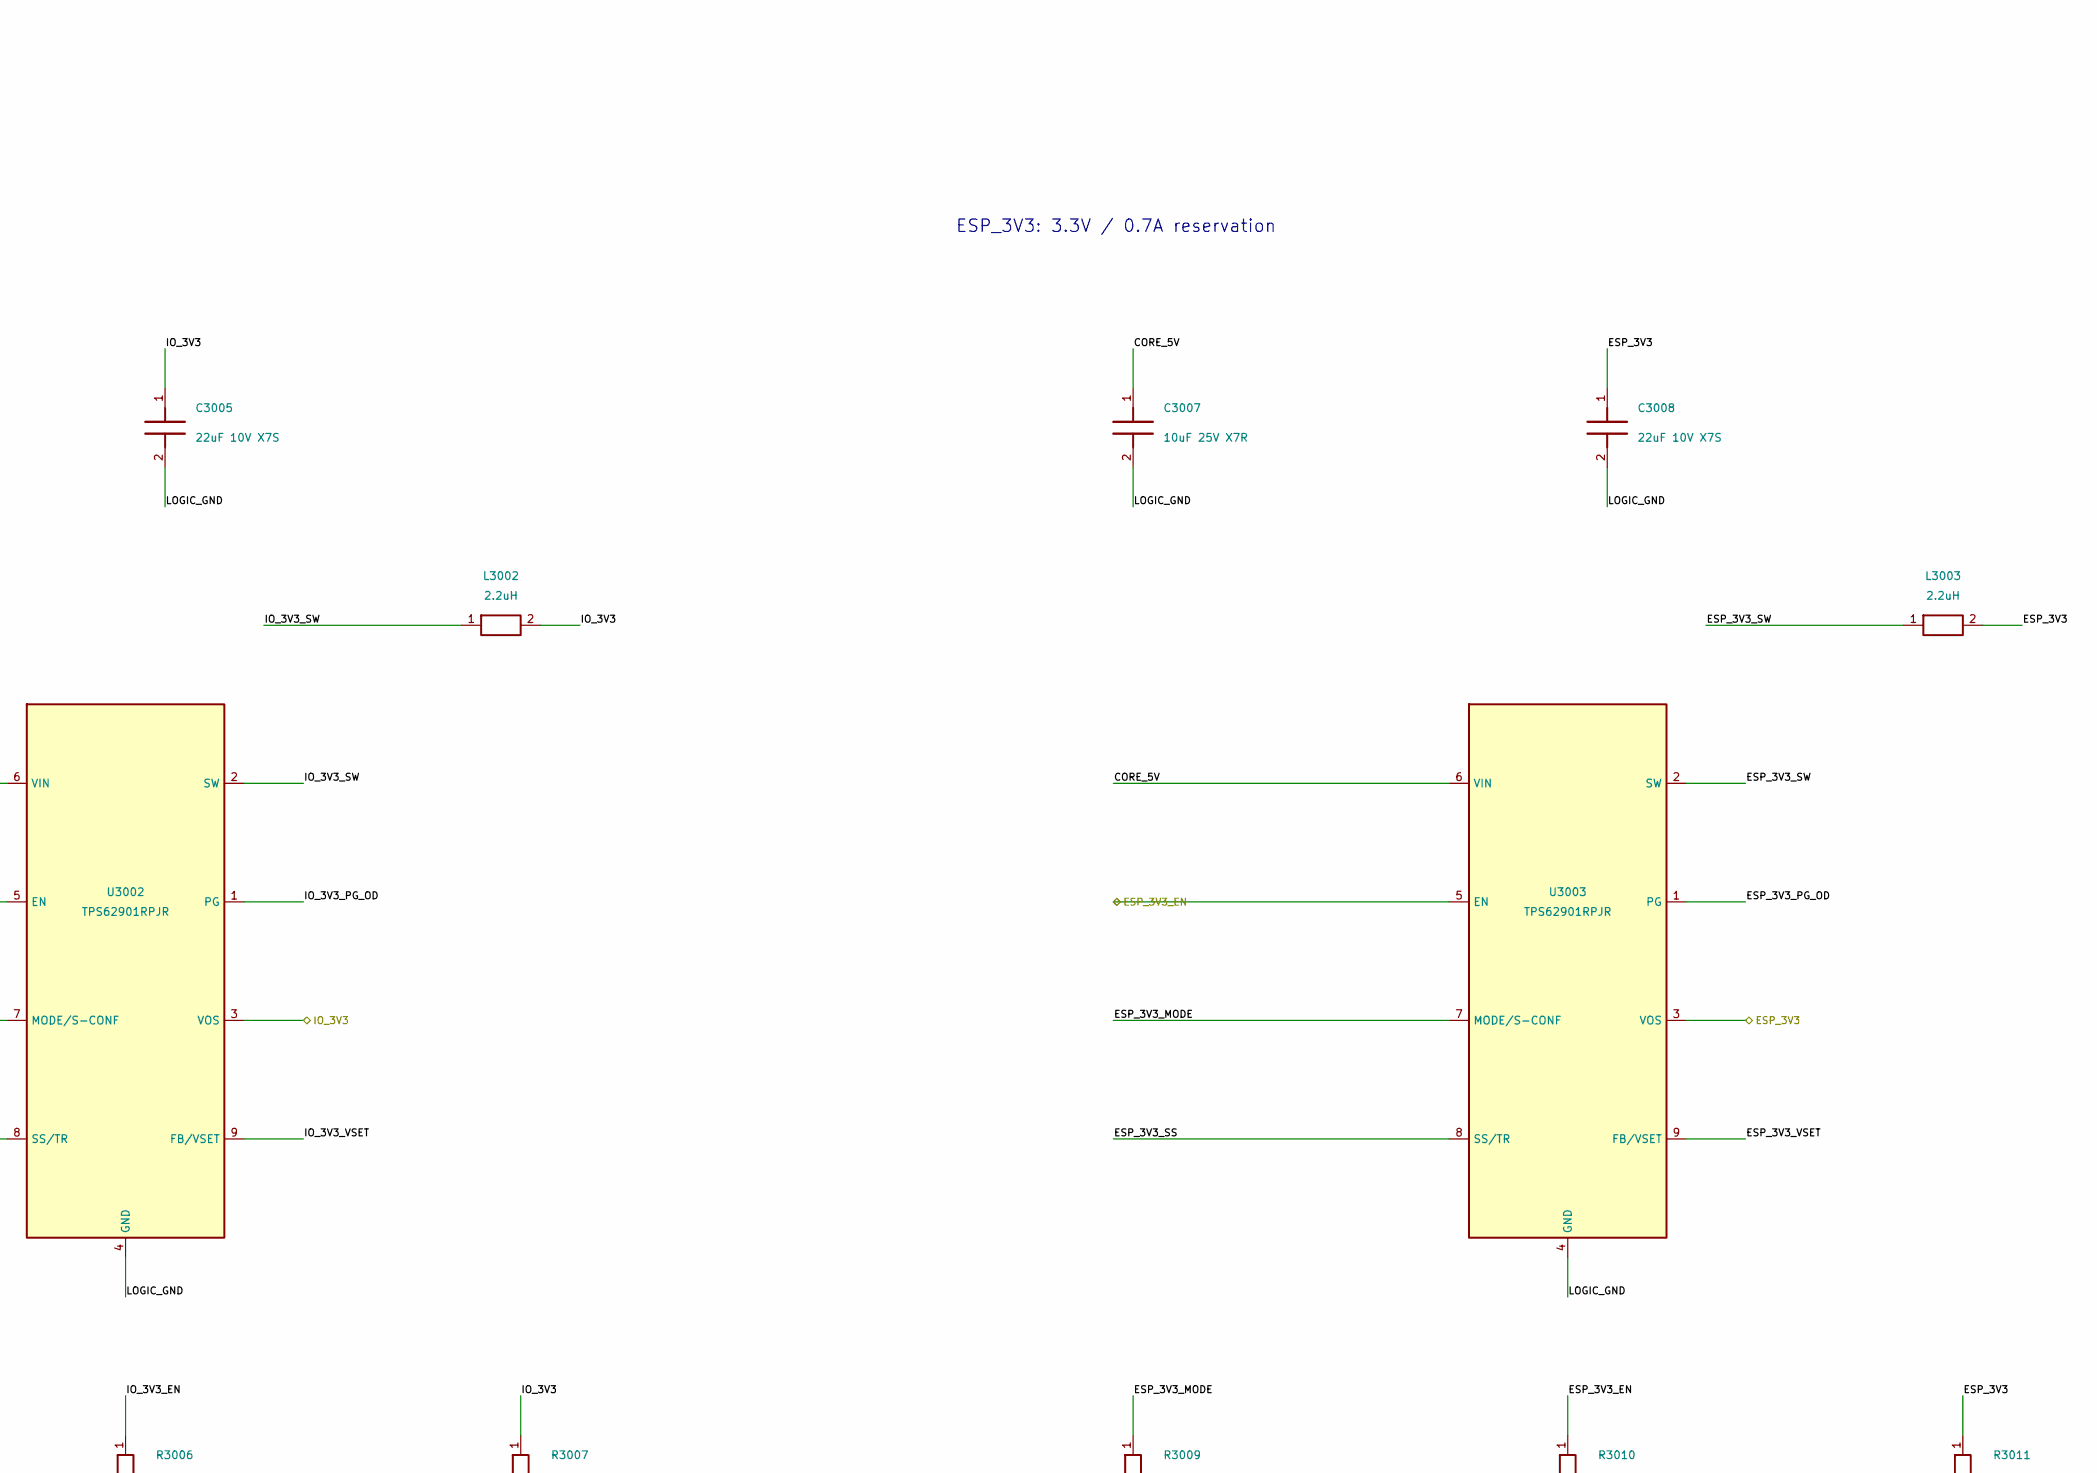
[picture p79: schematic logic_power.kicad_sch, part in row 1, column 2]

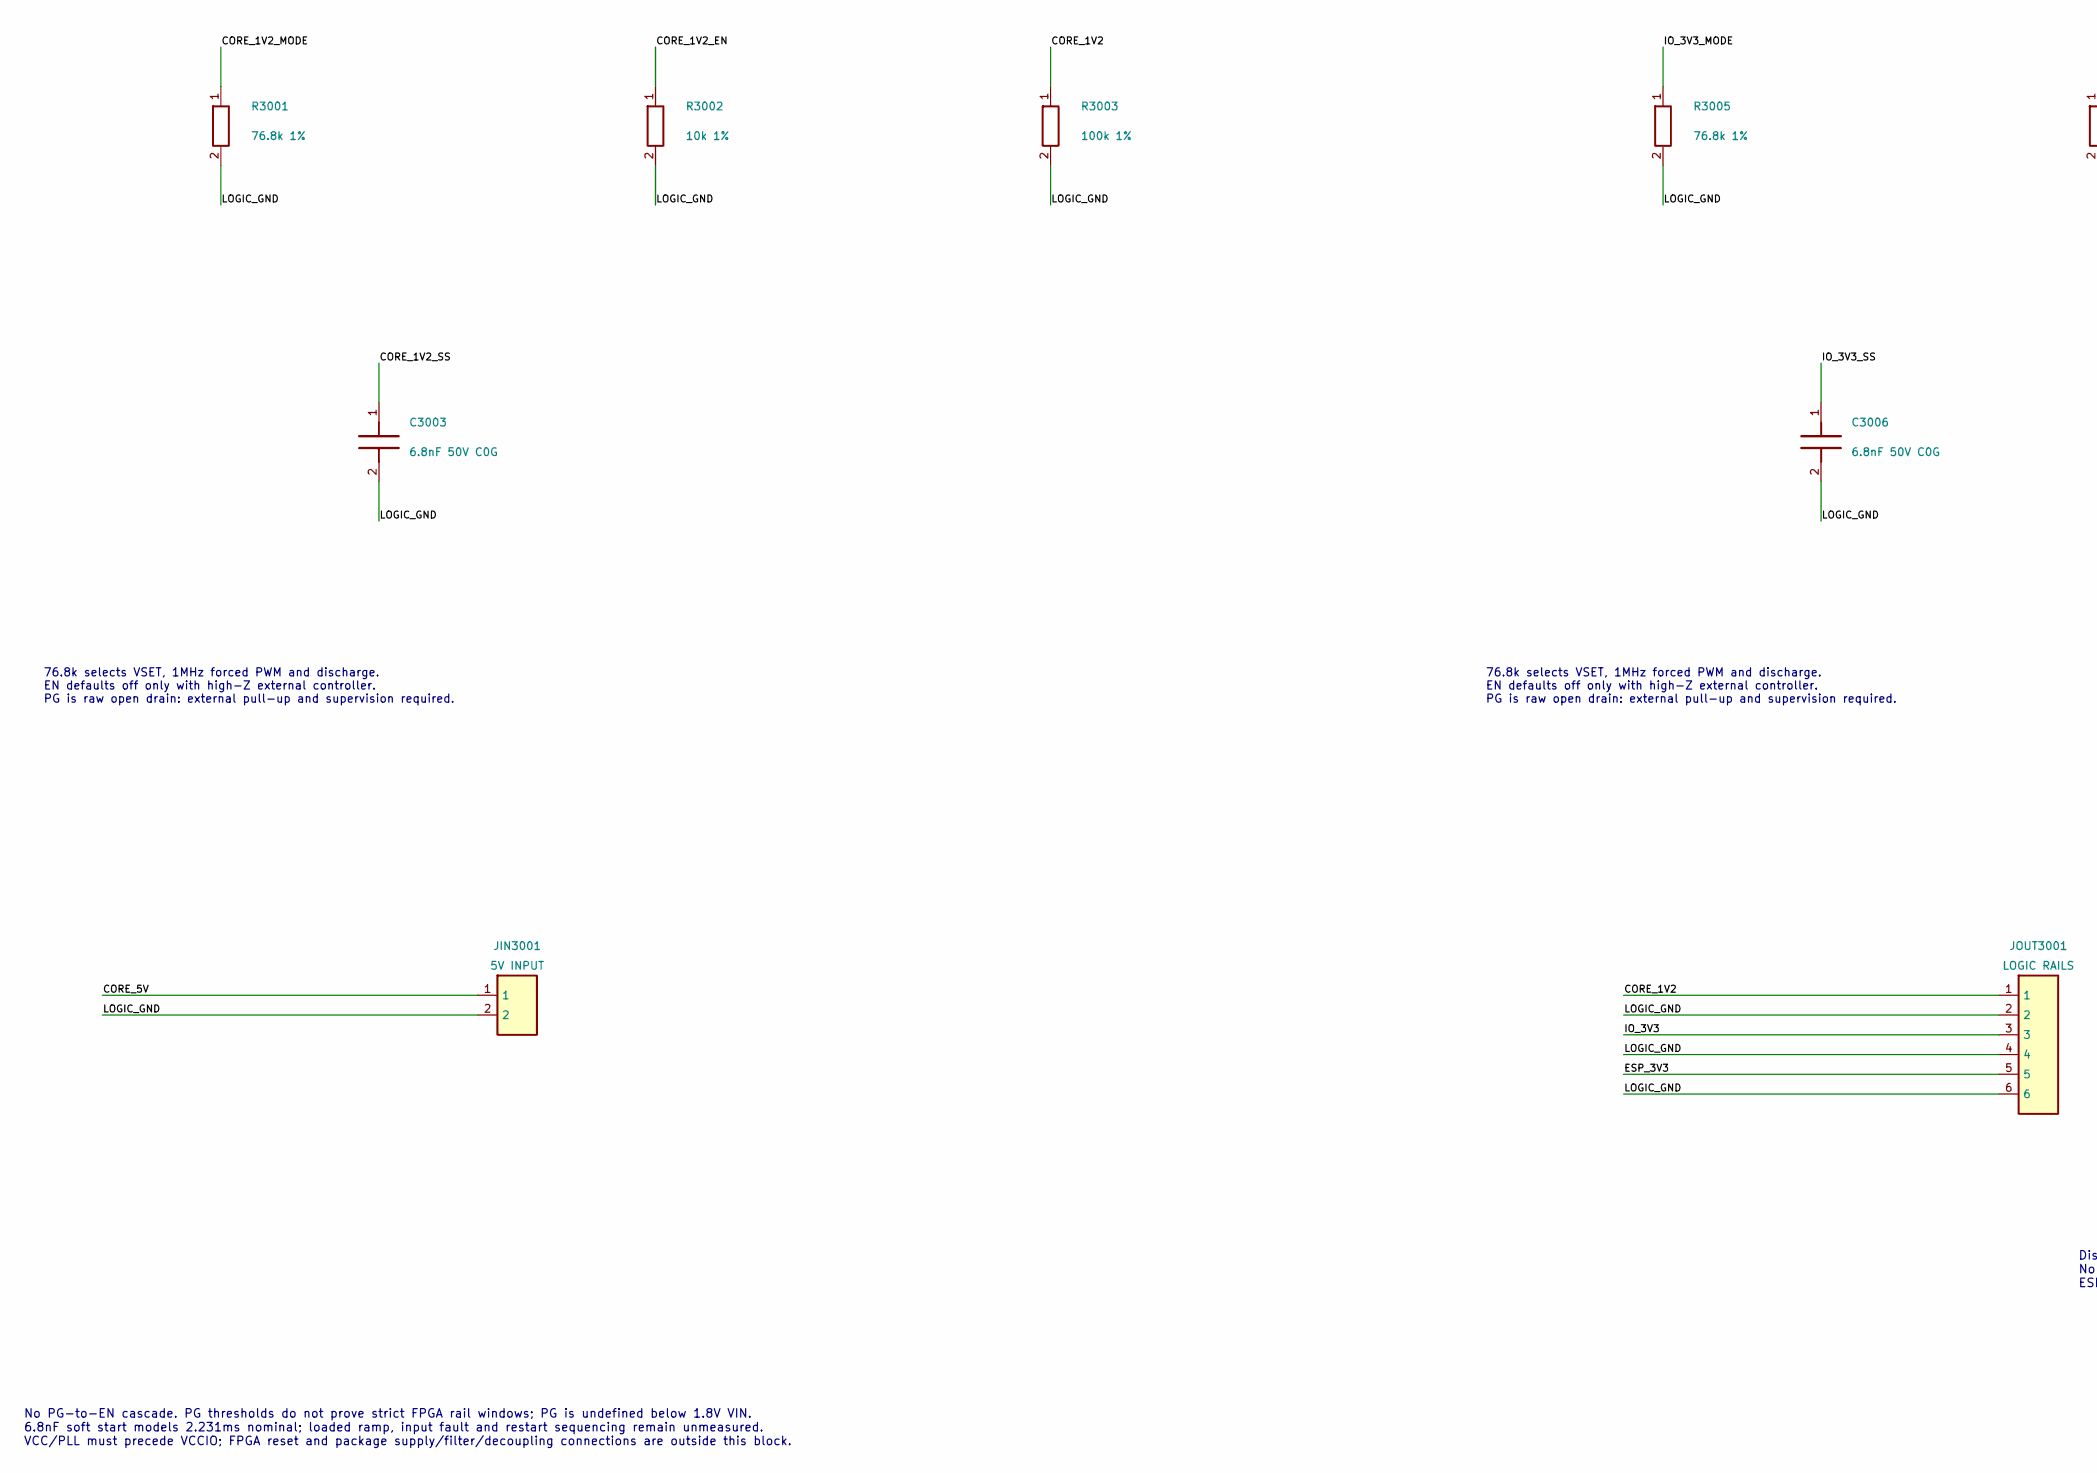
[picture p80: schematic logic_power.kicad_sch, part in row 2, column 1]

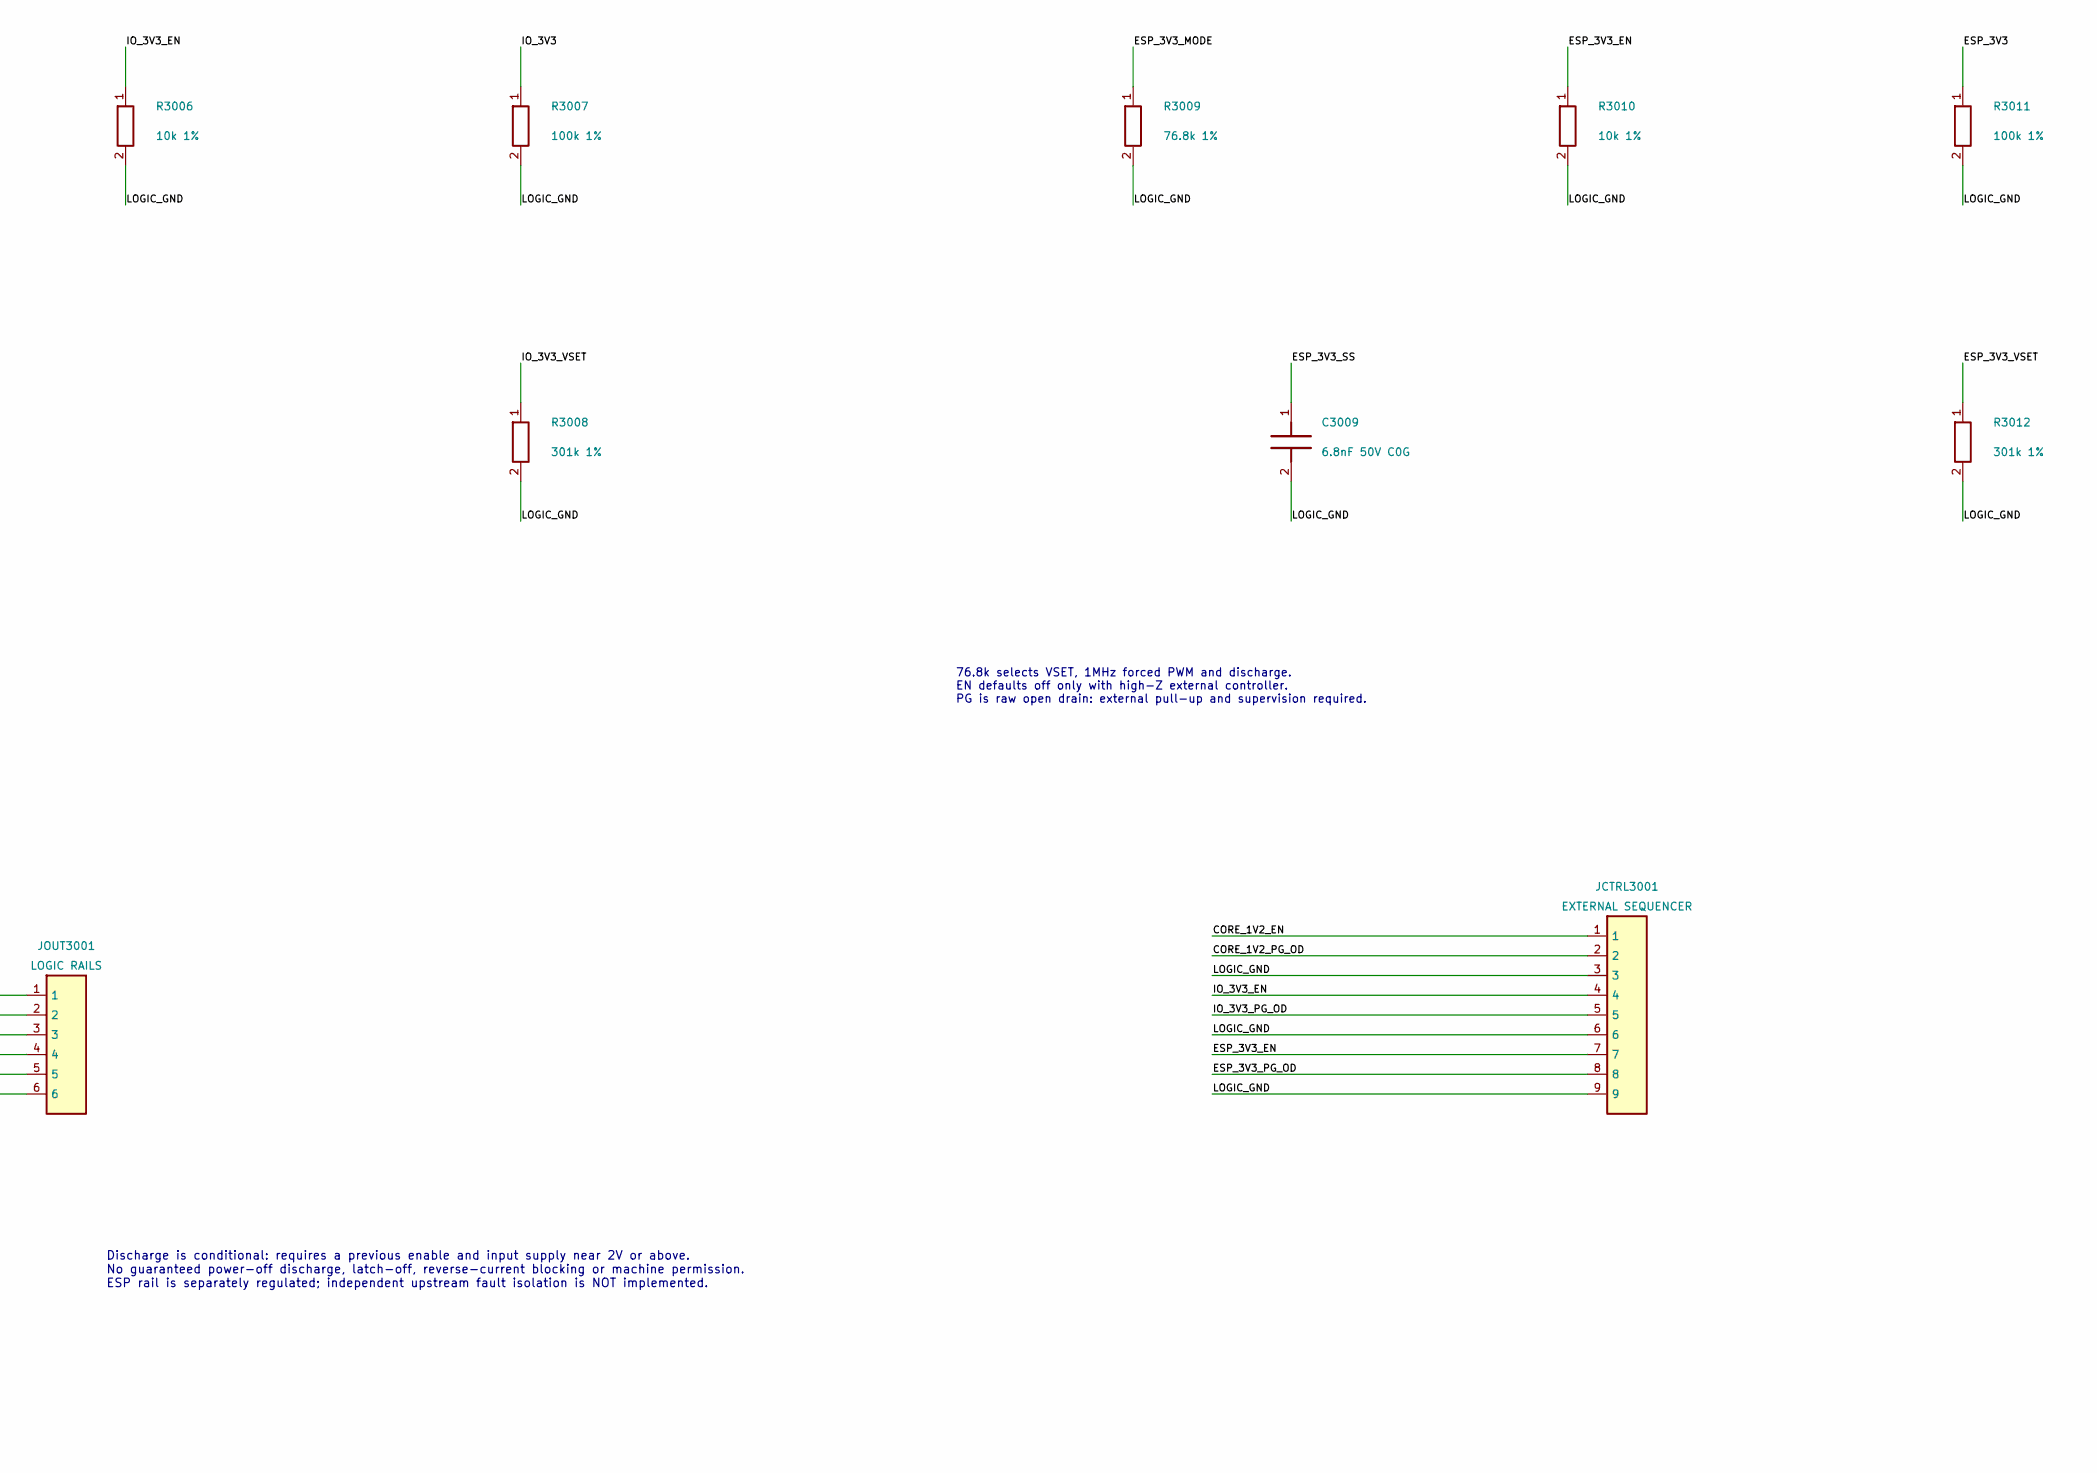
[picture p81: schematic logic_power.kicad_sch, part in row 2, column 2]

Parts:
C3001, C3004, C3007: 10uF 25V X7R; C_1206_3216Metric; MPN C3216X7R1E106K160AB
C3002, C3005, C3008: 22uF 10V X7S; C_0805_2012Metric; MPN C2012X7S1A226M125AC
C3003, C3006, C3009: 6.8nF 50V C0G; C_0603_1608Metric; MPN GRM1885C1H682JA01D
JCTRL3001: EXTERNAL SEQUENCER
JIN3001: 5V INPUT
JOUT3001: LOGIC RAILS
L3001, L3002, L3003: 2.2uH; XGL4020; MPN XGL4020-222MEC
R3001, R3005, R3009: 76.8k 1%; R_0603_1608Metric; MPN CRCW060376K8FKEA
R3002, R3006, R3010: 10k 1%; R_0603_1608Metric; MPN CRCW060310K0FKEA
R3003, R3007, R3011: 100k 1%; R_0603_1608Metric; MPN CRCW0603100KFKEA
R3008, R3012: 301k 1%; R_0603_1608Metric; MPN CRCW0603301KFKEA
U3001, U3002, U3003: TPS62901RPJR; TPS62901_RPJ9; MPN TPS62901RPJR

Connections:
CORE_1V2: C3002.1, JOUT3001.1, L3001.2, R3003.1, U3001.3 (VOS)
CORE_1V2_EN: JCTRL3001.1, R3002.1, U3001.5 (EN)
CORE_1V2_MODE: R3001.1, U3001.7 (MODE/S-CONF)
CORE_1V2_PG_OD: JCTRL3001.2, U3001.1 (PG)
CORE_1V2_SS: C3003.1, U3001.8 (SS/TR)
CORE_1V2_SW: L3001.1, U3001.2 (SW)
CORE_5V: C3001.1, C3004.1, C3007.1, JIN3001.1, U3001.6 (VIN), U3002.6 (VIN), U3003.6 (VIN)
ESP_3V3: C3008.1, JOUT3001.5, L3003.2, R3011.1, U3003.3 (VOS)
ESP_3V3_EN: JCTRL3001.7, R3010.1, U3003.5 (EN)
ESP_3V3_MODE: R3009.1, U3003.7 (MODE/S-CONF)
ESP_3V3_PG_OD: JCTRL3001.8, U3003.1 (PG)
ESP_3V3_SS: C3009.1, U3003.8 (SS/TR)
ESP_3V3_SW: L3003.1, U3003.2 (SW)
ESP_3V3_VSET: R3012.1, U3003.9 (FB/VSET)
IO_3V3: C3005.1, JOUT3001.3, L3002.2, R3007.1, U3002.3 (VOS)
IO_3V3_EN: JCTRL3001.4, R3006.1, U3002.5 (EN)
IO_3V3_MODE: R3005.1, U3002.7 (MODE/S-CONF)
IO_3V3_PG_OD: JCTRL3001.5, U3002.1 (PG)
IO_3V3_SS: C3006.1, U3002.8 (SS/TR)
IO_3V3_SW: L3002.1, U3002.2 (SW)
IO_3V3_VSET: R3008.1, U3002.9 (FB/VSET)
LOGIC_GND: C3001.2, C3002.2, C3003.2, C3004.2, C3005.2, C3006.2, C3007.2, C3008.2, C3009.2, JCTRL3001.3, JCTRL3001.6, JCTRL3001.9, JIN3001.2, JOUT3001.2, JOUT3001.4, JOUT3001.6, R3001.2, R3002.2, R3003.2, R3005.2, R3006.2, R3007.2, R3008.2, R3009.2, R3010.2, R3011.2, R3012.2, U3001.4 (GND), U3001.9 (FB/VSET), U3002.4 (GND), U3003.4 (GND)

Notes on the sheet:
CORE_1V2: 1.2V / 0.8A reservation
76.8k selects VSET, 1MHz forced PWM and discharge. EN defaults off only with high-Z external controller. PG is raw open drain: external pull-up and supervision required.
IO_3V3: 3.3V / 0.4A reservation
ESP_3V3: 3.3V / 0.7A reservation
THREE LOW-VOLTAGE REGULATORS - EXTERNAL SEQUENCING REQUIRED
TPS62901 replaces the TPS62160 study here: tighter regulation and adjustable ramp. Frozen ledger unchanged. CORE_5V required 4.85–5.15V.
No PG-to-EN cascade. PG thresholds do not prove strict FPGA rail windows; PG is undefined below 1.8V VIN. 6.8nF soft start models 2.231ms nominal; loaded ramp, input fault and restart sequencing remain unmeasured. VCC/PLL must precede VCCIO; FPGA reset and package supply/filter/decoupling connectio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
Discharge is conditional: requires a previous enable and input supply near 2V or above. No guaranteed power-off discharge, latch-off, reverse-current blocking or machine permission. ESP rail is separately regulated; independent upstream fault isolation is NOT implemented.
