DeadlySIn777/Controller/hardware/controller_assembly/sbc_power.kicad_sch

## KiCad design hardware/controller_assembly/sbc_power.kicad_sch (2026-10-18)

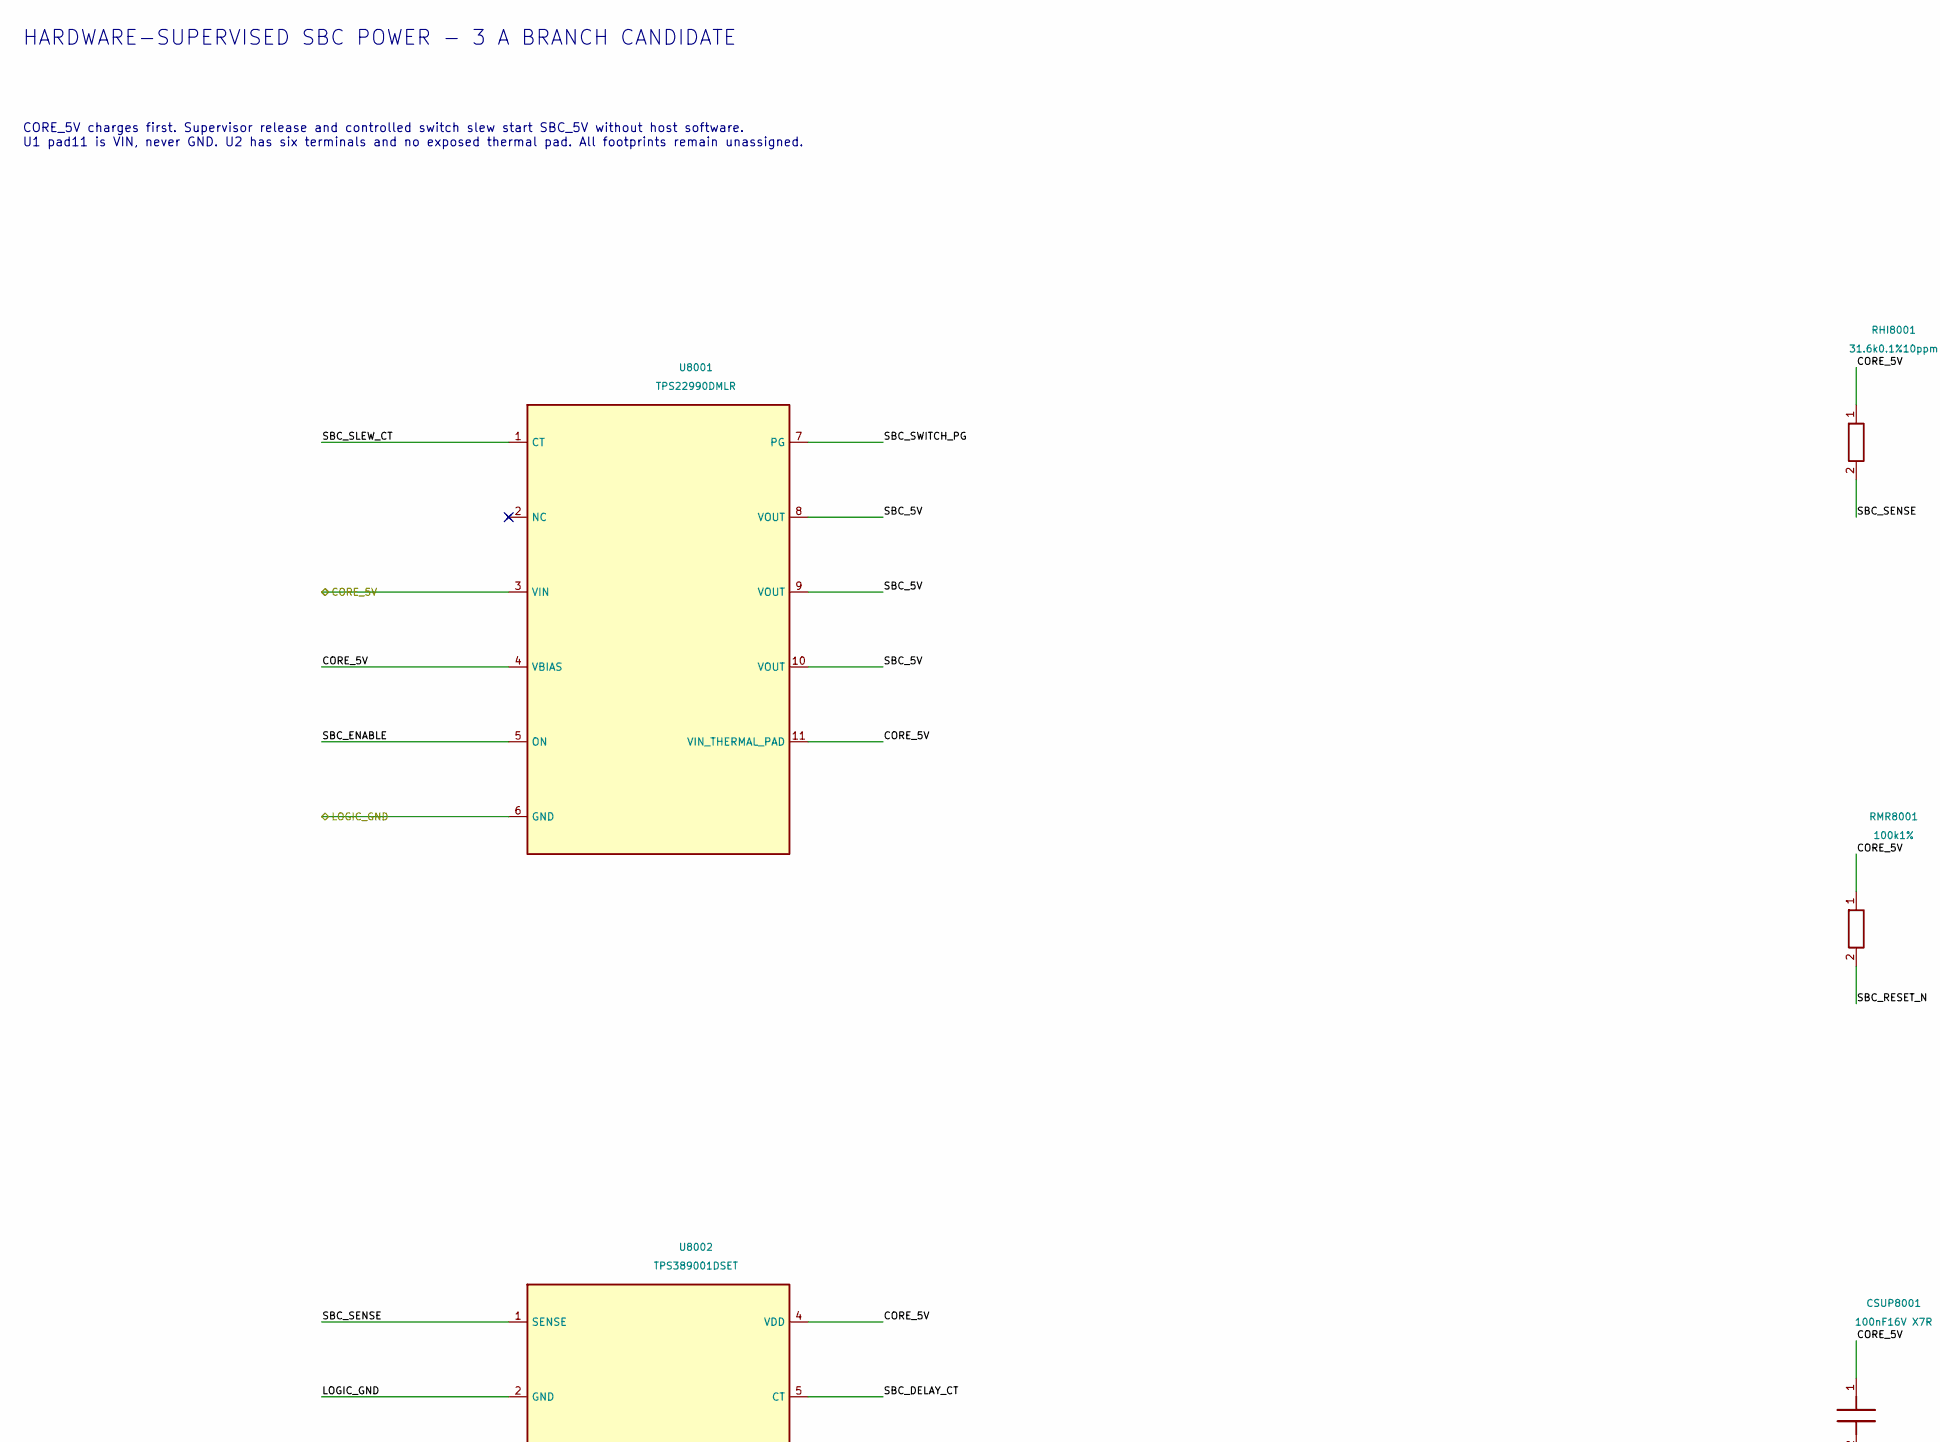
[picture p82: schematic sbc_power.kicad_sch, part in row 1, column 1]

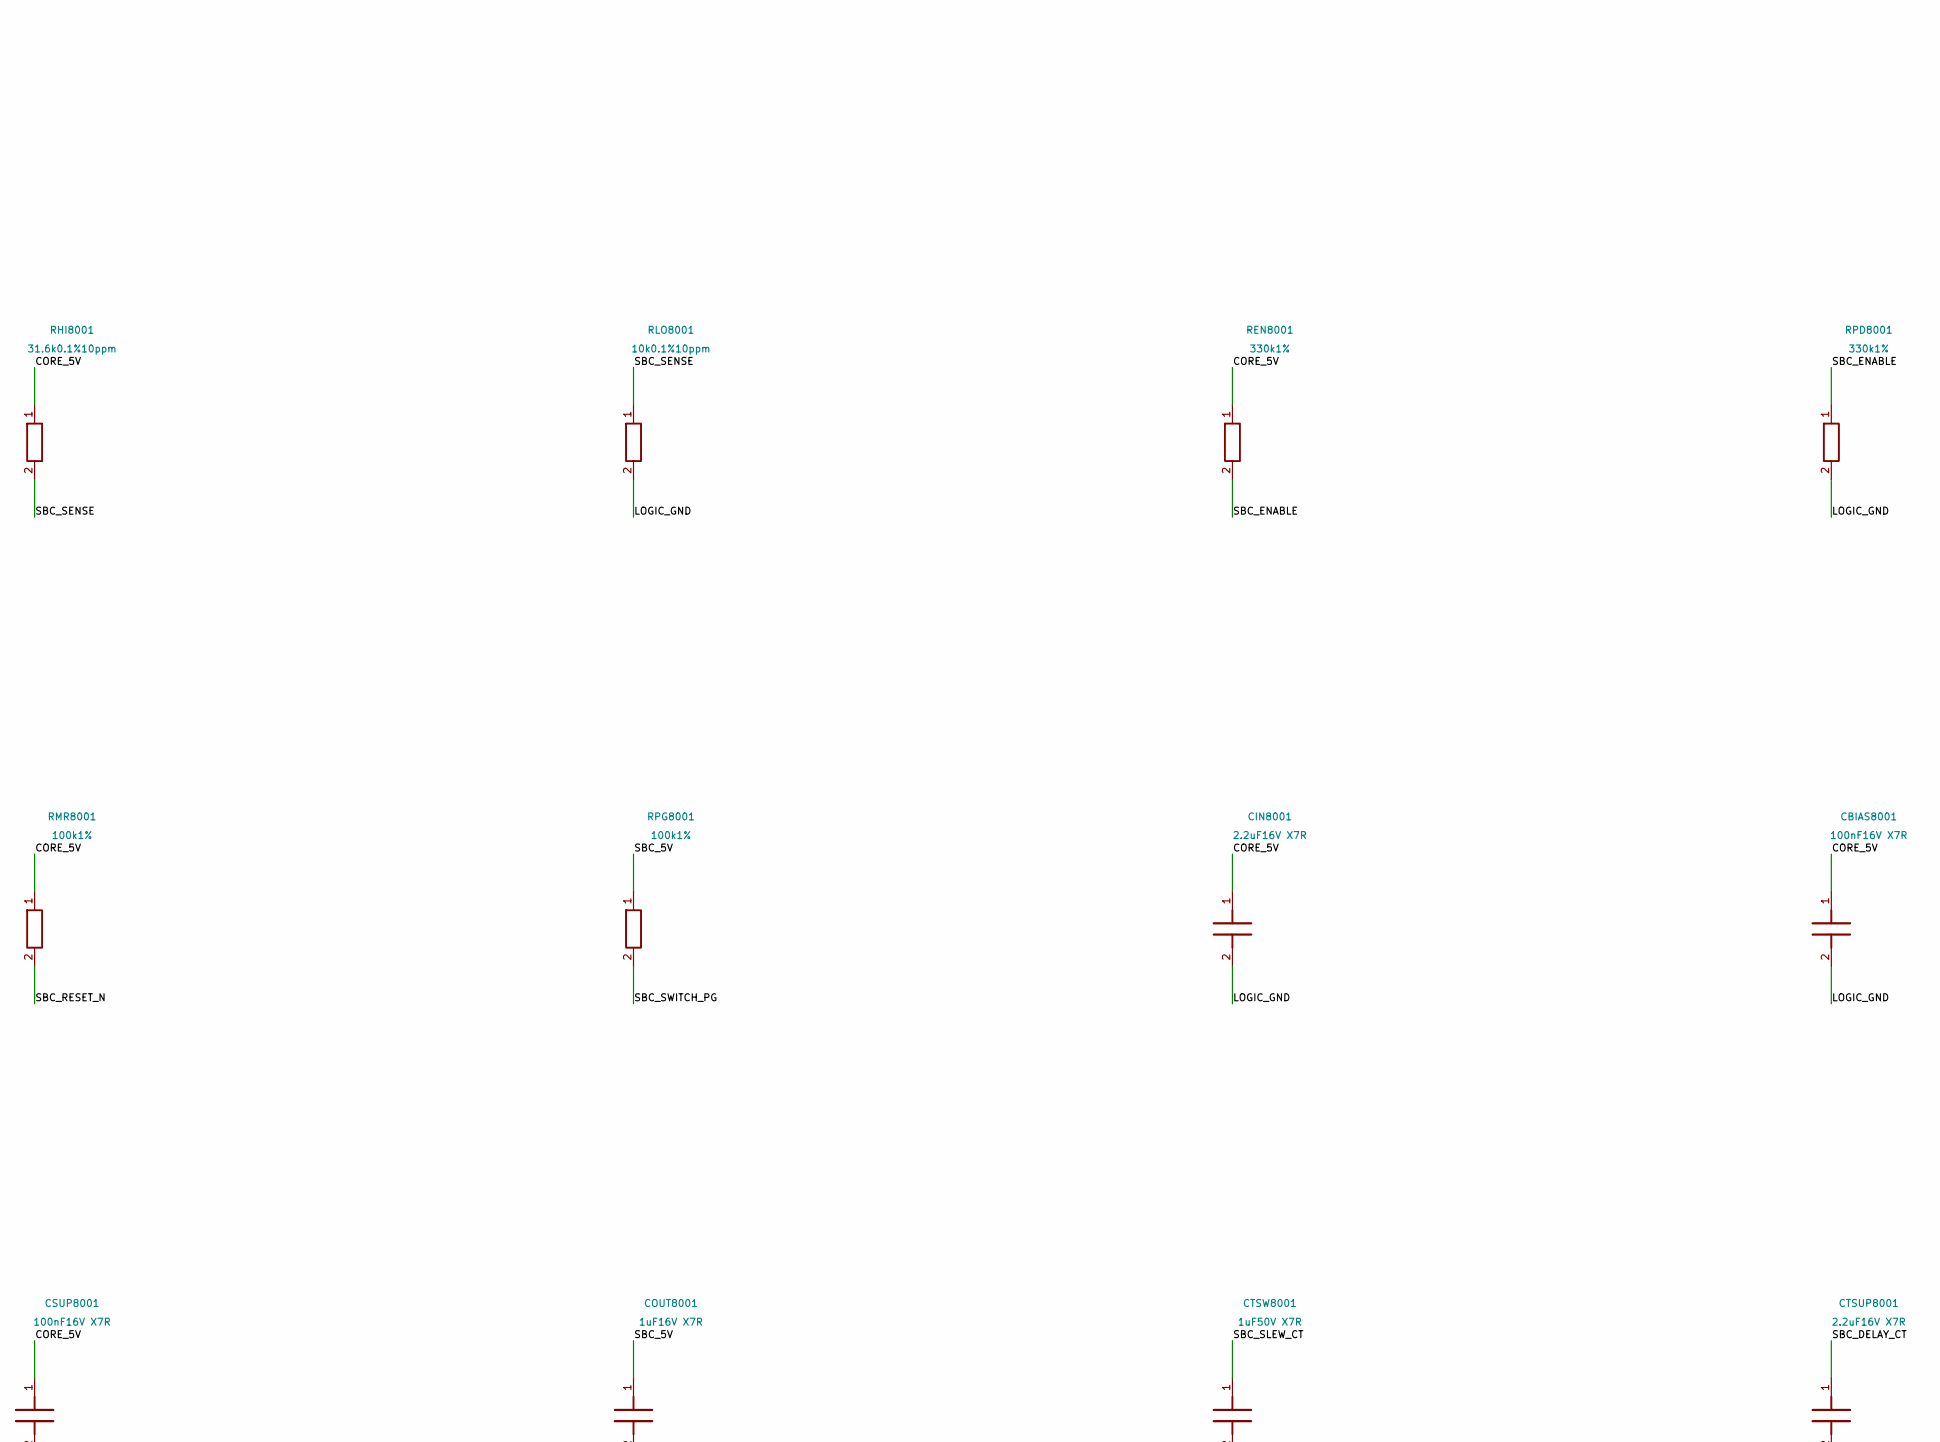
[picture p83: schematic sbc_power.kicad_sch, part in row 1, column 2]

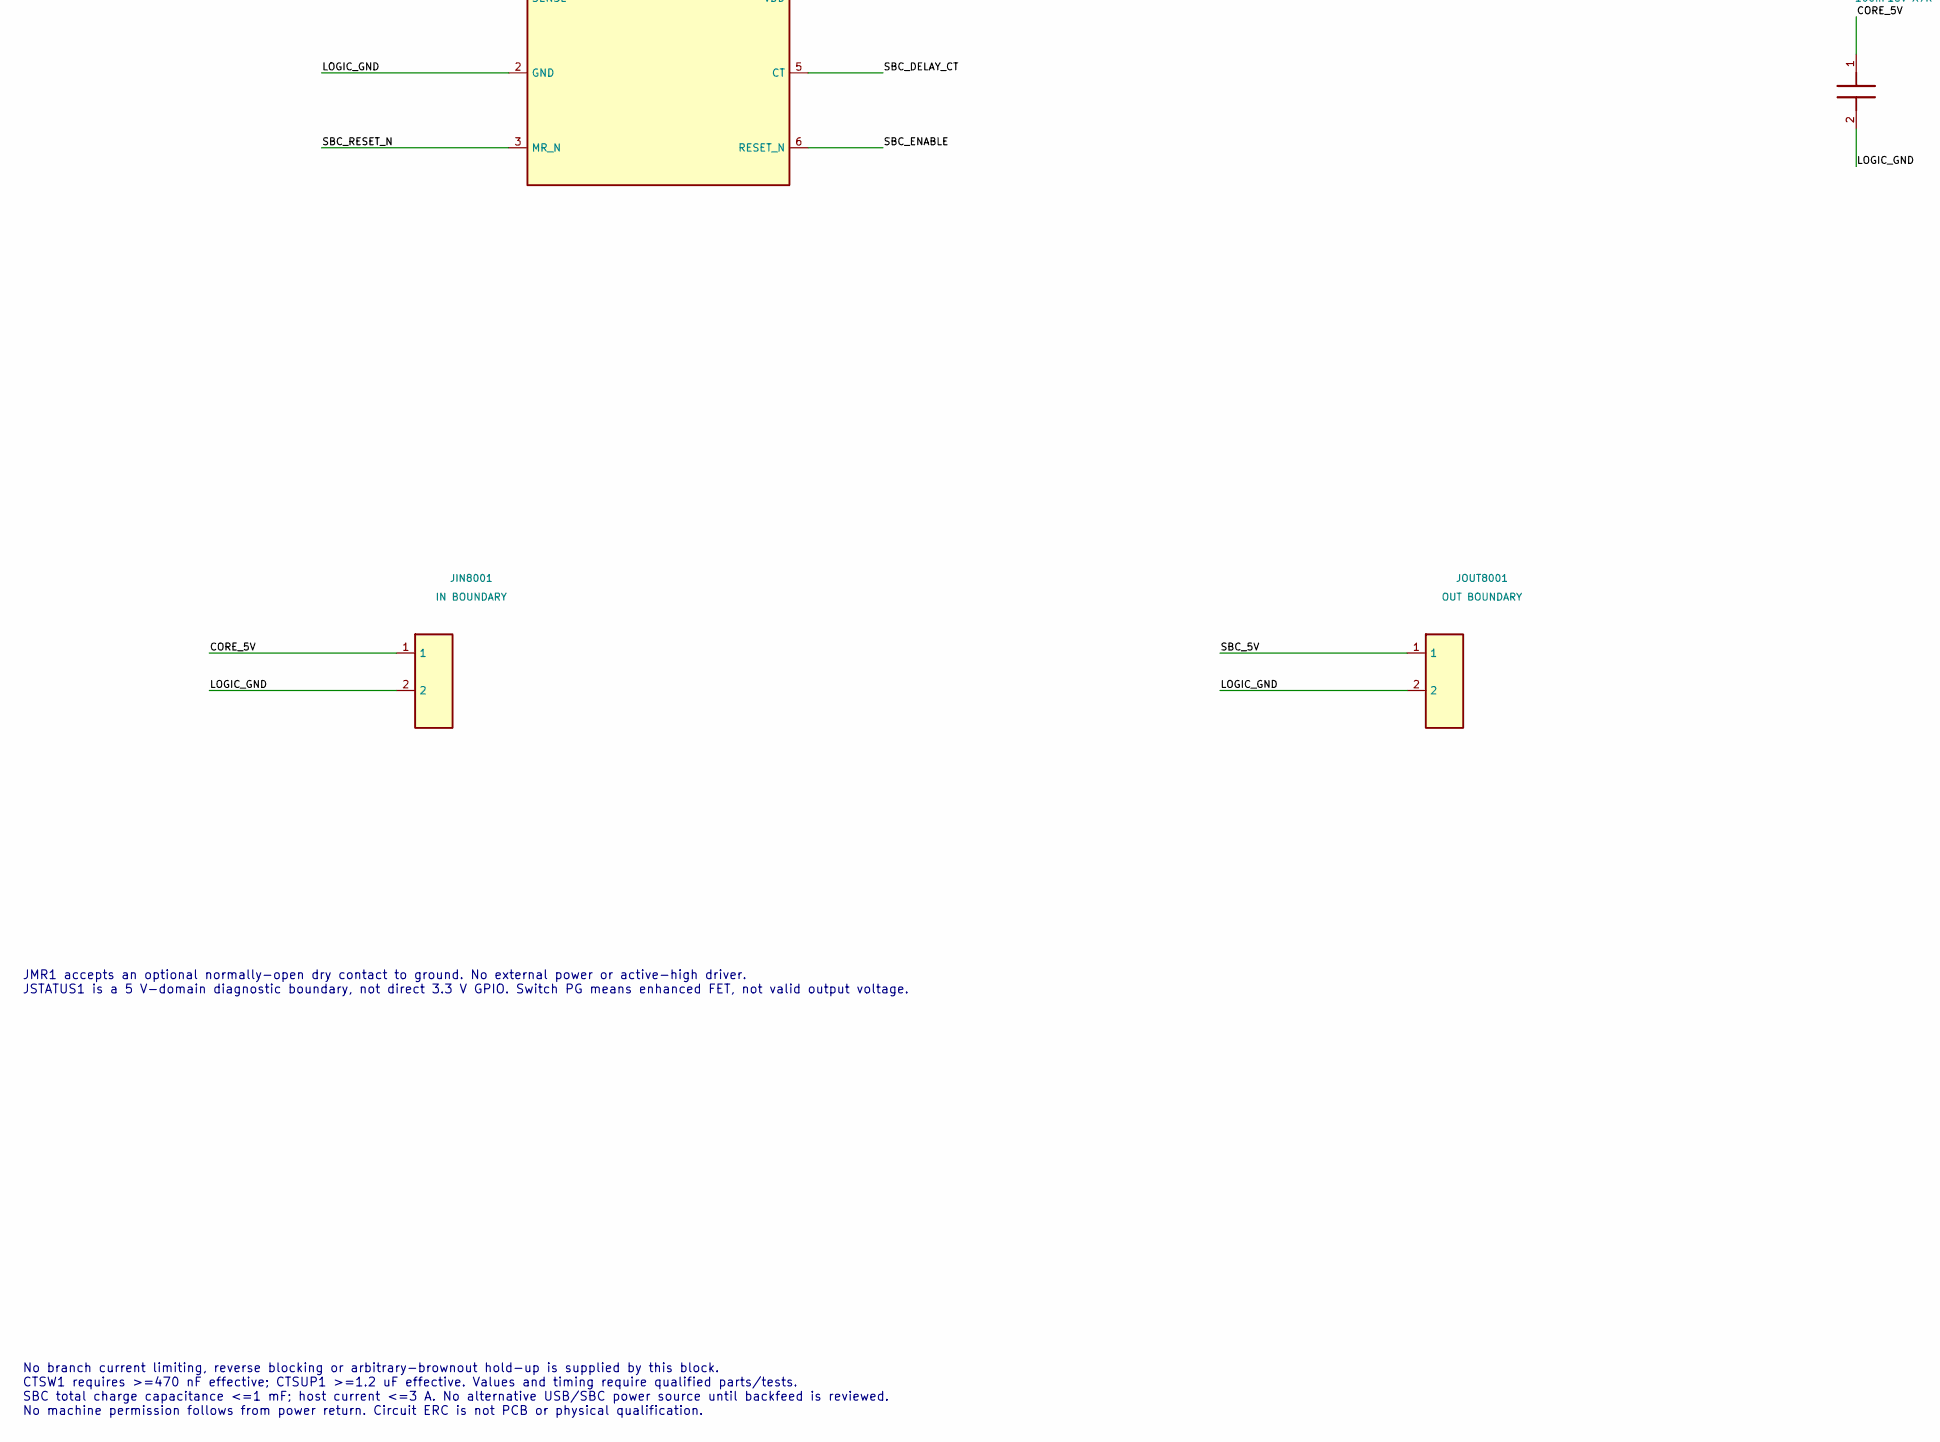
[picture p84: schematic sbc_power.kicad_sch, part in row 2, column 1]

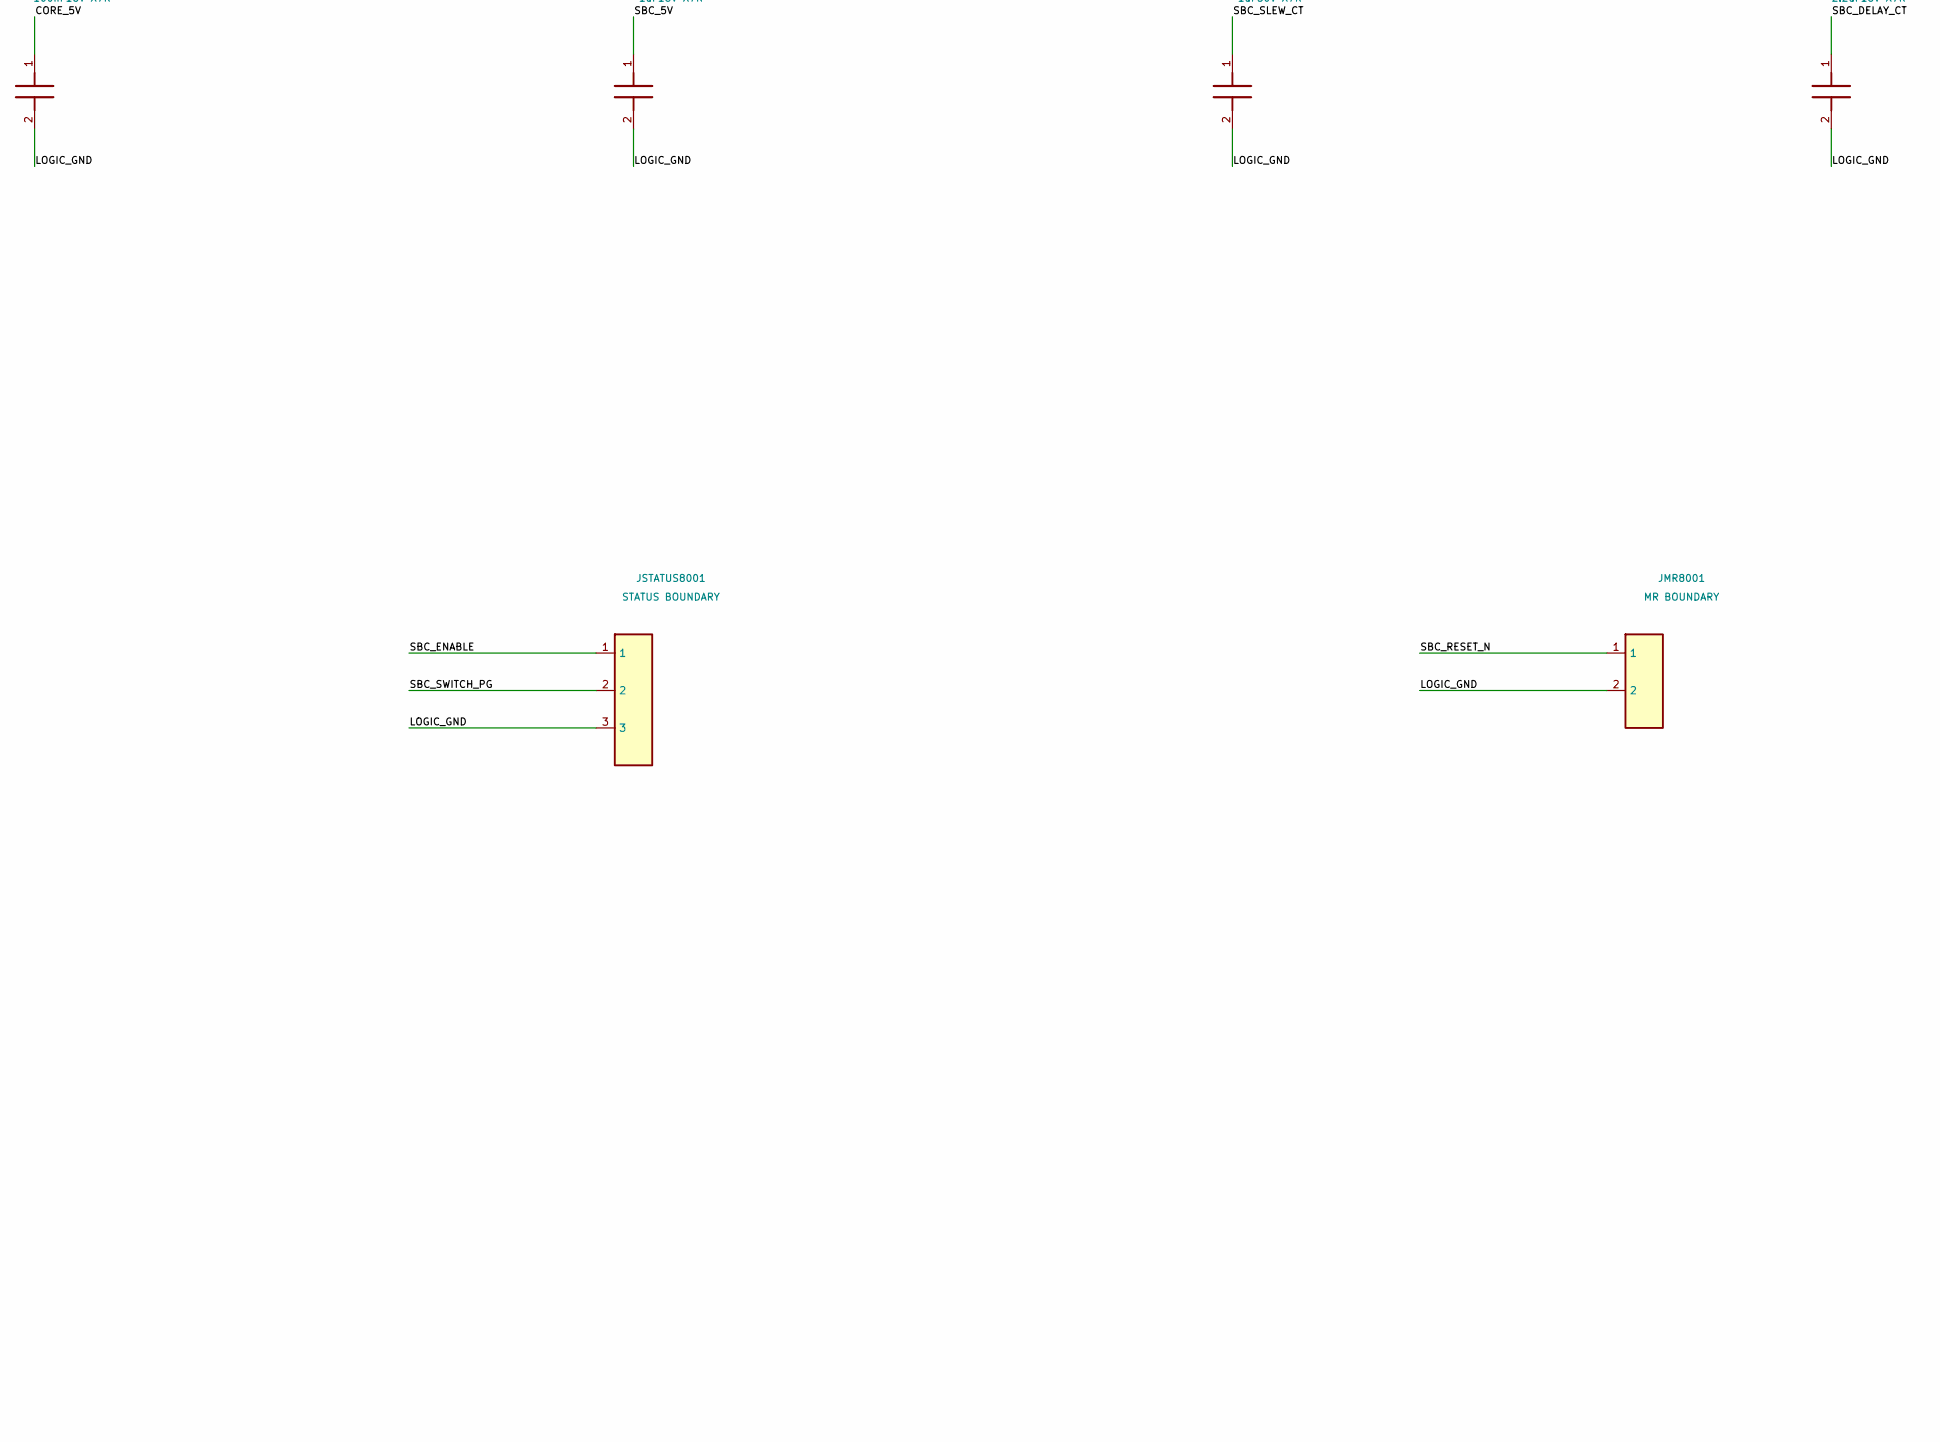
[picture p85: schematic sbc_power.kicad_sch, part in row 2, column 2]

Parts:
CBIAS8001: 100nF16V X7R
CIN8001: 2.2uF16V X7R
COUT8001: 1uF16V X7R
CSUP8001: 100nF16V X7R
CTSUP8001: 2.2uF16V X7R
CTSW8001: 1uF50V X7R
JIN8001: IN BOUNDARY
JMR8001: MR BOUNDARY
JOUT8001: OUT BOUNDARY
JSTATUS8001: STATUS BOUNDARY
REN8001: 330k1%
RHI8001: 31.6k0.1%10ppm
RLO8001: 10k0.1%10ppm
RMR8001: 100k1%
RPD8001: 330k1%
RPG8001: 100k1%
U8001: TPS22990DMLR; MPN TPS22990DMLR
U8002: TPS389001DSET; MPN TPS389001DSET

Connections:
CORE_5V: CBIAS8001.1, CIN8001.1, CSUP8001.1, JIN8001.1, REN8001.1, RHI8001.1, RMR8001.1, U8001.3 (VIN), U8001.4 (VBIAS), U8001.11 (VIN_THERMAL_PAD), U8002.4 (VDD)
LOGIC_GND: CBIAS8001.2, CIN8001.2, COUT8001.2, CSUP8001.2, CTSUP8001.2, CTSW8001.2, JIN8001.2, JMR8001.2, JOUT8001.2, JSTATUS8001.3, RLO8001.2, RPD8001.2, U8001.6 (GND), U8002.2 (GND)
SBC_5V: COUT8001.1, JOUT8001.1, RPG8001.1, U8001.8 (VOUT), U8001.9 (VOUT), U8001.10 (VOUT)
SBC_DELAY_CT: CTSUP8001.1, U8002.5 (CT)
SBC_ENABLE: JSTATUS8001.1, REN8001.2, RPD8001.1, U8001.5 (ON), U8002.6 (RESET_N)
SBC_RESET_N: JMR8001.1, RMR8001.2, U8002.3 (MR_N)
SBC_SENSE: RHI8001.2, RLO8001.1, U8002.1 (SENSE)
SBC_SLEW_CT: CTSW8001.1, U8001.1 (CT)
SBC_SWITCH_PG: JSTATUS8001.2, RPG8001.2, U8001.7 (PG)

Notes on the sheet:
HARDWARE-SUPERVISED SBC POWER - 3 A BRANCH CANDIDATE
CORE_5V charges first. Supervisor release and controlled switch slew start SBC_5V without host software. U1 pad11 is VIN, never GND. U2 has six terminals and no exposed thermal pad. All footprints remain unassigned.
JMR1 accepts an optional normally-open dry contact to ground. No external power or active-high driver. JSTATUS1 is a 5 V-domain diagnostic boundary, not direct 3.3 V GPIO. Switch PG means enhanced FET, not valid output voltage.
No branch current limiting, reverse blocking or arbitrary-brownout hold-up is supplied by this block. CTSW1 requires >=470 nF effective; CTSUP1 >=1.2 uF effective. Values and timing require qualified parts/tests. SBC total charge capacitance <=1 mF; host current <=3 A. No alternative USB/SBC power 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
