DeadlySIn777/Controller/hardware/controller_assembly/tx_twelve.kicad_sch

## KiCad design hardware/controller_assembly/tx_twelve.kicad_sch (2026-10-18)

Schematic: tx_twelve.kicad_sch

Parts:
C6001, C6003, C6005, C6007, C6009, C6011: 100nF 25V X7R; C_0603_1608Metric
C6002, C6004, C6006, C6008, C6010, C6012: 1uF 25V X7R; C_0603_1608Metric
JLOGIC6001: INTERNAL LOGIC BOUNDARY
JREF6001: SIGNAL RETURNS
JTX6000, JTX6001, JTX6002, JTX6003, JTX6004, JTX6005: FIELD TERMINALS / MPN TBD
R6001, R6002, R6003, R6004, R6005, R6006, R6007, R6008, R6009, R6010, R6011, R6012, R6013, R6014, R6015, R6016, R6017, R6018, R6019, R6020, R6021, R6022, R6023, R6024: 33R 1%; R_0603_1608Metric
R6025, R6026, R6027, R6028, R6029, R6030, R6031, R6032, R6033, R6034, R6035, R6036, R6037, R6038, R6039, R6040, R6041, R6042, R6043, R6044, R6045, R6046, R6047, R6048, R6049, R6050, R6051, R6052, R6053, R6054: 10k 1%; R_0603_1608Metric
U6001, U6002, U6003, U6004, U6005, U6006: AM26C31IPWR; TSSOP-16_4.4x5mm_P0.65mm; MPN AM26C31IPWR

Connections:
CORE_5V: C6001.1, C6002.1, C6003.1, C6004.1, C6005.1, C6006.1, C6007.1, C6008.1, C6009.1, C6010.1, C6011.1, C6012.1, JLOGIC6001.1, U6001.12 (~G), U6001.16 (VCC), U6002.12 (~G), U6002.16 (VCC), U6003.12 (~G), U6003.16 (VCC), U6004.12 (~G), U6004.16 (VCC), U6005.12 (~G), U6005.16 (VCC), U6006.12 (~G), U6006.16 (VCC)
DIR0_D: R6002.2, R6026.1, U6001.7 (2A)
DIR0_FPGA: JLOGIC6001.5, R6002.1
DIR0_N: JTX6000.4, U6001.5 (2Z)
DIR0_P: JTX6000.3, U6001.6 (2Y)
DIR1_D: R6004.2, R6028.1, U6001.15 (4A)
DIR1_FPGA: JLOGIC6001.7, R6004.1
DIR1_N: JTX6000.8, U6001.13 (4Z)
DIR1_P: JTX6000.7, U6001.14 (4Y)
DIR2_D: R6006.2, R6030.1, U6002.7 (2A)
DIR2_FPGA: JLOGIC6001.9, R6006.1
DIR2_N: JTX6001.4, U6002.5 (2Z)
DIR2_P: JTX6001.3, U6002.6 (2Y)
DIR3_D: R6008.2, R6032.1, U6002.15 (4A)
DIR3_FPGA: JLOGIC6001.11, R6008.1
DIR3_N: JTX6001.8, U6002.13 (4Z)
DIR3_P: JTX6001.7, U6002.14 (4Y)
DIR4_D: R6010.2, R6034.1, U6003.7 (2A)
DIR4_FPGA: JLOGIC6001.13, R6010.1
DIR4_N: JTX6002.4, U6003.5 (2Z)
DIR4_P: JTX6002.3, U6003.6 (2Y)
DIR5_D: R6012.2, R6036.1, U6003.15 (4A)
DIR5_FPGA: JLOGIC6001.15, R6012.1
DIR5_N: JTX6002.8, U6003.13 (4Z)
DIR5_P: JTX6002.7, U6003.14 (4Y)
DIR6_D: R6014.2, R6038.1, U6004.7 (2A)
DIR6_FPGA: JLOGIC6001.17, R6014.1
DIR6_N: JTX6003.4, U6004.5 (2Z)
DIR6_P: JTX6003.3, U6004.6 (2Y)
DIR7_D: R6016.2, R6040.1, U6004.15 (4A)
DIR7_FPGA: JLOGIC6001.19, R6016.1
DIR7_N: JTX6003.8, U6004.13 (4Z)
DIR7_P: JTX6003.7, U6004.14 (4Y)
DIR8_D: R6018.2, R6042.1, U6005.7 (2A)
DIR8_FPGA: JLOGIC6001.21, R6018.1
DIR8_N: JTX6004.4, U6005.5 (2Z)
DIR8_P: JTX6004.3, U6005.6 (2Y)
DIR9_D: R6020.2, R6044.1, U6005.15 (4A)
DIR9_FPGA: JLOGIC6001.23, R6020.1
DIR9_N: JTX6004.8, U6005.13 (4Z)
DIR9_P: JTX6004.7, U6005.14 (4Y)
DIR10_D: R6022.2, R6046.1, U6006.7 (2A)
DIR10_FPGA: JLOGIC6001.25, R6022.1
DIR10_N: JTX6005.4, U6006.5 (2Z)
DIR10_P: JTX6005.3, U6006.6 (2Y)
DIR11_D: R6024.2, R6048.1, U6006.15 (4A)
DIR11_FPGA: JLOGIC6001.27, R6024.1
DIR11_N: JTX6005.8, U6006.13 (4Z)
DIR11_P: JTX6005.7, U6006.14 (4Y)
LOGIC_GND: C6001.2, C6002.2, C6003.2, C6004.2, C6005.2, C6006.2, C6007.2, C6008.2, C6009.2, C6010.2, C6011.2, C6012.2, JLOGIC6001.2, JLOGIC6001.28, JREF6001.1, JREF6001.2, JREF6001.3, JREF6001.4, JREF6001.5, JREF6001.6, R6025.2, R6026.2, R6027.2, R6028.2, R6029.2, R6030.2, R6031.2, R6032.2, R6033.2, R6034.2, R6035.2, R6036.2, R6037.2, R6038.2, R6039.2, R6040.2, R6041.2, R6042.2, R6043.2, R6044.2, R6045.2, R6046.2, R6047.2, R6048.2, R6049.2, R6050.2, R6051.2, R6052.2, R6053.2, R6054.2, U6001.8 (GND), U6002.8 (GND), U6003.8 (GND), U6004.8 (GND), U6005.8 (GND), U6006.8 (GND)
STEP0_D: R6001.2, R6025.1, U6001.1 (1A)
STEP0_FPGA: JLOGIC6001.4, R6001.1
STEP0_N: JTX6000.2, U6001.3 (1Z)
STEP0_P: JTX6000.1, U6001.2 (1Y)
STEP1_D: R6003.2, R6027.1, U6001.9 (3A)
STEP1_FPGA: JLOGIC6001.6, R6003.1
STEP1_N: JTX6000.6, U6001.11 (3Z)
STEP1_P: JTX6000.5, U6001.10 (3Y)
STEP2_D: R6005.2, R6029.1, U6002.1 (1A)
STEP2_FPGA: JLOGIC6001.8, R6005.1
STEP2_N: JTX6001.2, U6002.3 (1Z)
STEP2_P: JTX6001.1, U6002.2 (1Y)
STEP3_D: R6007.2, R6031.1, U6002.9 (3A)
STEP3_FPGA: JLOGIC6001.10, R6007.1
STEP3_N: JTX6001.6, U6002.11 (3Z)
STEP3_P: JTX6001.5, U6002.10 (3Y)
STEP4_D: R6009.2, R6033.1, U6003.1 (1A)
STEP4_FPGA: JLOGIC6001.12, R6009.1
STEP4_N: JTX6002.2, U6003.3 (1Z)
STEP4_P: JTX6002.1, U6003.2 (1Y)
STEP5_D: R6011.2, R6035.1, U6003.9 (3A)
STEP5_FPGA: JLOGIC6001.14, R6011.1
STEP5_N: JTX6002.6, U6003.11 (3Z)
STEP5_P: JTX6002.5, U6003.10 (3Y)
STEP6_D: R6013.2, R6037.1, U6004.1 (1A)
STEP6_FPGA: JLOGIC6001.16, R6013.1
STEP6_N: JTX6003.2, U6004.3 (1Z)
STEP6_P: JTX6003.1, U6004.2 (1Y)
STEP7_D: R6015.2, R6039.1, U6004.9 (3A)
STEP7_FPGA: JLOGIC6001.18, R6015.1
STEP7_N: JTX6003.6, U6004.11 (3Z)
STEP7_P: JTX6003.5, U6004.10 (3Y)
STEP8_D: R6017.2, R6041.1, U6005.1 (1A)
STEP8_FPGA: JLOGIC6001.20, R6017.1
STEP8_N: JTX6004.2, U6005.3 (1Z)
STEP8_P: JTX6004.1, U6005.2 (1Y)
STEP9_D: R6019.2, R6043.1, U6005.9 (3A)
STEP9_FPGA: JLOGIC6001.22, R6019.1
STEP9_N: JTX6004.6, U6005.11 (3Z)
STEP9_P: JTX6004.5, U6005.10 (3Y)
STEP10_D: R6021.2, R6045.1, U6006.1 (1A)
STEP10_FPGA: JLOGIC6001.24, R6021.1
STEP10_N: JTX6005.2, U6006.3 (1Z)
STEP10_P: JTX6005.1, U6006.2 (1Y)
STEP11_D: R6023.2, R6047.1, U6006.9 (3A)
STEP11_FPGA: JLOGIC6001.26, R6023.1
STEP11_N: JTX6005.6, U6006.11 (3Z)
STEP11_P: JTX6005.5, U6006.10 (3Y)
TX_PERMIT: JLOGIC6001.3, R6049.1, R6050.1, R6051.1, R6052.1, R6053.1, R6054.1, U6001.4 (G), U6002.4 (G), U6003.4 (G), U6004.4 (G), U6005.4 (G), U6006.4 (G)

Notes on the sheet:
BANK TX0 / U1: JOINTS 0 AND 1
Place C1 close to U1 pins 16/8. JTX0 matches allocation positions 1–8; reference is separate.
BANK TX1 / U2: JOINTS 2 AND 3
Place C3 close to U2 pins 16/8. JTX1 matches allocation positions 1–8; reference is separate.
BANK TX2 / U3: JOINTS 4 AND 5
Place C5 close to U3 pins 16/8. JTX2 matches allocation positions 1–8; reference is separate.
BANK TX3 / U4: JOINTS 6 AND 7
Place C7 close to U4 pins 16/8. JTX3 matches allocation positions 1–8; reference is separate.
BANK TX4 / U5: JOINTS 8 AND 9
Place C9 close to U5 pins 16/8. JTX4 matches allocation positions 1–8; reference is separate.
BANK TX5 / U6: JOINTS 10 AND 11
Place C11 close to U6 pins 16/8. JTX5 matches allocation positions 1–8; reference is separate.
TWELVE-MOTOR STEP/DIR TRANSMITTER CANDIDATE
24 differential signals / 6 AM26C31IPWR banks. New electrical scope; current firmware remains six-channel.
Engineering circuit only. All twelve channels populated. 8-channel population needs separate BOM and export. No price or speed approval.
JLOGIC1 is an internal boundary. 3.3V logic; no 5V GPIO pullups. No inputs driven with VCC off. Six enable pulldowns in parallel. TX_PERMIT requires >=2V high. No line protection or PCB yet. No automatic receiver fail state. Drive enables/alarms separate.
TX_PERMIT low makes differential outputs HIGH-Z. A remote drive may interpret floating lines incorrectly; receiver bias and independent drive inhibit need qualification. 1.2A reservation on CORE_5V is a conservative design allowance, not a measured load. Existing six-channel converter budget cannot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
Source: TI AM26C31 SLLS103P, pin Table4-1, operating Section5.3, electrical Section5.5, function Table7-1. Input33R damping,10k defaults, capacitor MPNs, connector selections and final protection remain open.
