DeadlySIn777/Controller/hardware/core_converter/core_converter.kicad_sch

## KiCad design hardware/core_converter/core_converter.kicad_sch (2026-10-18)

Schematic: core_converter.kicad_sch

Parts:
CBST1: 47nF25V X7R; C_0603_1608Metric
CBULK1, CBULK2, CBULK3: 330uF16V 20% polymer; MPN 16SVPG330M
CCOMP1: 22nF5% C0G; C_0603_1608Metric
CHF1: 330pF5% C0G; C_0603_1608Metric
CIN1, CIN2, CIN3, CIN4: 4.7uF100V X7S 10% 1210; C_1210_3225Metric; MPN CGA6M3X7S2A475K200AE
CINHF1, CINHF2: 10nF100V X7R; C_0603_1608Metric
COUT1, COUT2, COUT3: 47uF10V X7S 20% 1210; C_1210_3225Metric; MPN CGA6P1X7S1A476M250AC
CVCC1: 4.7uF16V X7R; C_0805_2012Metric
CVDDA1: 100nF16V X7R; C_0603_1608Metric
JCTRL1: ENTRY EN / GND / PG
JDIAG1: DIAGNOSTIC PULLUP
JIN1: PROTECTED INPUT
JOUT1: CORE 5V OUTPUT
L1: 4.7uH 20%; L_Coilcraft_XAL7070-XXX; MPN XAL7070-472MEC
RCFG1: 29.4k1%; R_0603_1608Metric
RCOMP1: 9.53k1%; R_0603_1608Metric
RENHI1: 100k0.1%; R_0603_1608Metric
RENLO1: 10k0.1%; R_0603_1608Metric
RFBSEL1: 24.9k1%; R_0603_1608Metric
RPG1: 100k1%; R_0603_1608Metric
RRT1: 49.9k0.1%; R_0603_1608Metric
RS1: 6mOhm 1% 1.5W; MPN KRL3216D-C-R006-F-T1
U1: LM70660RRXR; MPN LM70660RRXR

Connections:
CORE_5V: CBULK1.1, CBULK2.1, CBULK3.1, COUT1.1, COUT2.1, COUT3.1, JOUT1.1, RS1.2, U1.6 (BIAS), U1.12 (VOUT_SENSE)
CORE_5V_PG: JCTRL1.3, RPG1.1, U1.7 (PG_SYNCOUT)
CORE_24V_PROTECTED: CIN1.1, CIN2.1, CIN3.1, CIN4.1, CINHF1.1, CINHF2.1, JIN1.1, RENHI1.1, U1.1 (VIN4), U1.2 (VIN5), U1.3 (VIN6), U1.27 (VIN1), U1.28 (VIN2), U1.29 (VIN3)
CORE_BOOT: CBST1.1, U1.4 (CBOOT)
CORE_COMP: CHF1.1, RCOMP1.1, U1.15 (EXTCOMP)
CORE_COMP_ZERO: CCOMP1.1, RCOMP1.2
CORE_CONFIG: RCFG1.1, U1.13 (CONFIG)
CORE_FB_SELECT: RFBSEL1.1, U1.16 (FB)
CORE_ISNS: L1.2, RS1.1, U1.11 (ISNS_PLUS)
CORE_RT: RRT1.1, U1.14 (RT)
CORE_SW: L1.1, U1.20 (SW1), U1.21 (SW2), U1.22 (SW3)
CORE_SW_BOOT: CBST1.2, U1.5 (SW4)
CORE_VCC: CVCC1.1, U1.19 (VCC)
CORE_VDDA: CVDDA1.1, RFBSEL1.2, U1.8 (PFM_SYNCIN), U1.18 (VDDA)
C_PGOOD: JCTRL1.1, RENHI1.2, RENLO1.1, U1.9 (EN_UVLO)
IO_3V3: JDIAG1.1, RPG1.2
LOGIC_GND: CBULK1.2, CBULK2.2, CBULK3.2, CCOMP1.2, CHF1.2, CIN1.2, CIN2.2, CIN3.2, CIN4.2, CINHF1.2, CINHF2.2, COUT1.2, COUT2.2, COUT3.2, CVCC1.2, CVDDA1.2, JCTRL1.2, JDIAG1.2, JIN1.2, JOUT1.2, RCFG1.2, RENLO1.2, RRT1.2, U1.17 (AGND), U1.23 (PGND1), U1.24 (PGND2), U1.25 (PGND3), U1.26 (PGND4), U1.30 (PGND_CONTROLLER_PAD)

Notes on the sheet:
CORE 5 V / 6 A CONVERTER CANDIDATE - ENGINEERING CIRCUIT
LM70660: protected nominal24V input; no display/AI/drive power. C_PGOOD is analog enable, not GPIO. Upstream R9 must be absent. VIN powers internal startup bias; no running host/ESP is needed to enable this converter.
Layout: Kelvin ISNS+/VOUT across RS1; separate quiet AGND returns join local power ground as TI specifies. SW4 bootstrap return is internally common with SW1-3; preserve local bootstrap loop. No external long SW4 strap. U1 RRX, RS1 long-side0612 and polarized bulk footprints unassigned; no generic 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
