DeadlySIn777/Controller/hardware/mc_motor_buffers/mc_motor_buffers.kicad_sch

## KiCad design hardware/mc_motor_buffers/mc_motor_buffers.kicad_sch (2026-10-18)

Schematic: mc_motor_buffers.kicad_sch

Parts:
B1, B2, B3, B4: INTERNAL LOGICAL BOUNDARY
C1, C2, C3, C4, C5, C6, C7, C8, C9, C10, C11: 100nF X7R 25V 10%; C_0603_1608Metric; MPN GRM188R71E104KA01D
R1, R2, R3, R4, R5, R6, R7, R8, R9, R10, R11, R12, R13, R14, R15, R16, R17, R18, R19, R20, R21, R22, R23, R24, R25, R26, R27, R28, R29, R30, R31, R32, R33, R34, R35, R36, R37, R38: 33R 1%; R_0603_1608Metric; MPN CRCW060333R0FKEA
R39, R40, R41, R42, R43, R44, R45, R46, R47, R48, R49, R50, R51, R52, R53, R54, R55, R56, R57, R58, R59, R60, R61, R62, R63, R64, R65, R66, R67, R68, R69, R70, R71, R72, R73, R74, R75, R76: 4700R 1%; R_0603_1608Metric; MPN CRCW06034K70FKEA
R77, R78, R79, R80, R81, R82, R83, R84, R85, R86, R87, R88, R89, R90, R91, R92, R93, R94, R95, R96, R97, R98, R99, R100, R101, R102: 10000R 1%; R_0603_1608Metric; MPN CRCW060310K0FKEA
U1, U2, U3, U4: SN74LVC244APWR; TSSOP-20_4.4x6.5mm_P0.65mm; MPN SN74LVC244APWR
U5, U6, U7, U8, U9, U10, U11: SN74LVC2G126DCUR; VSSOP-8_2.3x2mm_P0.5mm; MPN SN74LVC2G126DCUR

Connections:
BANK_B_BUFFER_ENABLE_QUALIFIED: B2.13, R76.1, U5.1 (1OE), U5.7 (2OE), U6.1 (1OE), U6.7 (2OE), U7.1 (1OE), U7.7 (2OE), U8.1 (1OE), U8.7 (2OE), U9.1 (1OE), U9.7 (2OE), U10.1 (1OE), U10.7 (2OE), U11.1 (1OE)
DIR0_BUFFER_OUT: R2.1, U1.16 (1Y2)
DIR0_FPGA: B1.4, R40.1, U1.4 (1A2)
DIR0_TO_MIA: B3.2, R2.2, R78.1
DIR1_BUFFER_OUT: R5.1, U1.9 (2Y1)
DIR1_FPGA: B1.7, R42.1, U1.11 (2A1)
DIR1_TO_MIA: B3.5, R5.2, R80.1
DIR2_BUFFER_OUT: R8.1, U1.3 (2Y4)
DIR2_FPGA: B1.10, R44.1, U1.17 (2A4)
DIR2_TO_MIA: B3.8, R8.2, R82.1
DIR3_BUFFER_OUT: R11.1, U2.14 (1Y3)
DIR3_FPGA: B1.13, R46.1, U2.6 (1A3)
DIR3_TO_MIA: B3.11, R11.2, R84.1
DIR4_BUFFER_OUT: R14.1, U2.7 (2Y2)
DIR4_FPGA: B1.16, R48.1, U2.13 (2A2)
DIR4_TO_MIA: B3.14, R14.2, R86.1
DIR5_BUFFER_OUT: R17.1, U3.18 (1Y1)
DIR5_FPGA: B1.19, R50.1, U3.2 (1A1)
DIR5_TO_MIA: B3.17, R17.2, R88.1
DIR6_BUFFER_OUT: R20.1, U3.12 (1Y4)
DIR6_FPGA: B1.22, R52.1, U3.8 (1A4)
DIR6_TO_MIA: B3.20, R20.2, R90.1
DIR7_BUFFER_OUT: R23.1, U3.5 (2Y3)
DIR7_FPGA: B1.25, R54.1, U3.15 (2A3)
DIR7_TO_MIA: B3.23, R23.2, R92.1
DIR8_BUFFER_OUT: R26.1, U5.3 (2Y)
DIR8_FPGA: B2.2, R56.1, U5.5 (2A)
DIR8_TO_MX4: B4.2, R26.2, R94.1
DIR9_BUFFER_OUT: R29.1, U7.6 (1Y)
DIR9_FPGA: B2.5, R58.1, U7.2 (1A)
DIR9_TO_MX4: B4.5, R29.2, R96.1
DIR10_BUFFER_OUT: R32.1, U8.3 (2Y)
DIR10_FPGA: B2.8, R60.1, U8.5 (2A)
DIR10_TO_MX4: B4.8, R32.2, R98.1
DIR11_BUFFER_OUT: R35.1, U10.6 (1Y)
DIR11_FPGA: B2.11, R62.1, U10.2 (1A)
DIR11_TO_MX4: B4.11, R35.2, R100.1
EN0_N_BUFFER_OUT: R3.1, U1.14 (1Y3)
EN0_N_FPGA: B1.5, R63.1, U1.6 (1A3)
EN0_N_TO_MIA: B3.3, R3.2
EN1_N_BUFFER_OUT: R6.1, U1.7 (2Y2)
EN1_N_FPGA: B1.8, R64.1, U1.13 (2A2)
EN1_N_TO_MIA: B3.6, R6.2
EN2_N_BUFFER_OUT: R9.1, U2.18 (1Y1)
EN2_N_FPGA: B1.11, R65.1, U2.2 (1A1)
EN2_N_TO_MIA: B3.9, R9.2
EN3_N_BUFFER_OUT: R12.1, U2.12 (1Y4)
EN3_N_FPGA: B1.14, R66.1, U2.8 (1A4)
EN3_N_TO_MIA: B3.12, R12.2
EN4_N_BUFFER_OUT: R15.1, U2.5 (2Y3)
EN4_N_FPGA: B1.17, R67.1, U2.15 (2A3)
EN4_N_TO_MIA: B3.15, R15.2
EN5_N_BUFFER_OUT: R18.1, U3.16 (1Y2)
EN5_N_FPGA: B1.20, R68.1, U3.4 (1A2)
EN5_N_TO_MIA: B3.18, R18.2
EN6_N_BUFFER_OUT: R21.1, U3.9 (2Y1)
EN6_N_FPGA: B1.23, R69.1, U3.11 (2A1)
EN6_N_TO_MIA: B3.21, R21.2
EN7_N_BUFFER_OUT: R24.1, U3.3 (2Y4)
EN7_N_FPGA: B1.26, R70.1, U3.17 (2A4)
EN7_N_TO_MIA: B3.24, R24.2
EN8_N_BUFFER_OUT: R27.1, U6.6 (1Y)
EN8_N_FPGA: B2.3, R71.1, U6.2 (1A)
EN8_N_TO_MX4: B4.3, R27.2
EN9_N_BUFFER_OUT: R30.1, U7.3 (2Y)
EN9_N_FPGA: B2.6, R72.1, U7.5 (2A)
EN9_N_TO_MX4: B4.6, R30.2
EN10_N_BUFFER_OUT: R33.1, U9.6 (1Y)
EN10_N_FPGA: B2.9, R73.1, U9.2 (1A)
EN10_N_TO_MX4: B4.9, R33.2
EN11_N_BUFFER_OUT: R36.1, U10.3 (2Y)
EN11_N_FPGA: B2.12, R74.1, U10.5 (2A)
EN11_N_TO_MX4: B4.12, R36.2
IO_3V3: B1.1, C1.1, C2.1, C3.1, C4.1, C5.1, C6.1, C7.1, C8.1, C9.1, C10.1, C11.1, R63.2, R64.2, R65.2, R66.2, R67.2, R68.2, R69.2, R70.2, R71.2, R72.2, R73.2, R74.2, U1.20 (VCC), U2.20 (VCC), U3.20 (VCC), U4.20 (VCC), U5.8 (VCC), U6.8 (VCC), U7.8 (VCC), U8.8 (VCC), U9.8 (VCC), U10.8 (VCC), U11.8 (VCC)
LOGIC_GND: B1.2, C1.2, C2.2, C3.2, C4.2, C5.2, C6.2, C7.2, C8.2, C9.2, C10.2, C11.2, R39.2, R40.2, R41.2, R42.2, R43.2, R44.2, R45.2, R46.2, R47.2, R48.2, R49.2, R50.2, R51.2, R52.2, R53.2, R54.2, R55.2, R56.2, R57.2, R58.2, R59.2, R60.2, R61.2, R62.2, R75.2, R76.2, R77.2, R78.2, R79.2, R80.2, R81.2, R82.2, R83.2, R84.2, R85.2, R86.2, R87.2, R88.2, R89.2, R90.2, R91.2, R92.2, R93.2, R94.2, R95.2, R96.2, R97.2, R98.2, R99.2, R100.2, R101.2, R102.2, U1.1 (1OE_N), U1.10 (GND), U1.19 (2OE_N), U2.1 (1OE_N), U2.10 (GND), U2.19 (2OE_N), U3.1 (1OE_N), U3.10 (GND), U3.19 (2OE_N), U4.1 (1OE_N), U4.4 (1A2), U4.6 (1A3), U4.8 (1A4), U4.10 (GND), U4.11 (2A1), U4.13 (2A2), U4.15 (2A3), U4.17 (2A4), U4.19 (2OE_N), U5.4 (GND), U6.4 (GND), U7.4 (GND), U8.4 (GND), U9.4 (GND), U10.4 (GND), U11.4 (GND), U11.5 (2A), U11.7 (2OE)
STEP0_BUFFER_OUT: R1.1, U1.18 (1Y1)
STEP0_FPGA: B1.3, R39.1, U1.2 (1A1)
STEP0_TO_MIA: B3.1, R1.2, R77.1
STEP1_BUFFER_OUT: R4.1, U1.12 (1Y4)
STEP1_FPGA: B1.6, R41.1, U1.8 (1A4)
STEP1_TO_MIA: B3.4, R4.2, R79.1
STEP2_BUFFER_OUT: R7.1, U1.5 (2Y3)
STEP2_FPGA: B1.9, R43.1, U1.15 (2A3)
STEP2_TO_MIA: B3.7, R7.2, R81.1
STEP3_BUFFER_OUT: R10.1, U2.16 (1Y2)
STEP3_FPGA: B1.12, R45.1, U2.4 (1A2)
STEP3_TO_MIA: B3.10, R10.2, R83.1
STEP4_BUFFER_OUT: R13.1, U2.9 (2Y1)
STEP4_FPGA: B1.15, R47.1, U2.11 (2A1)
STEP4_TO_MIA: B3.13, R13.2, R85.1
STEP5_BUFFER_OUT: R16.1, U2.3 (2Y4)
STEP5_FPGA: B1.18, R49.1, U2.17 (2A4)
STEP5_TO_MIA: B3.16, R16.2, R87.1
STEP6_BUFFER_OUT: R19.1, U3.14 (1Y3)
STEP6_FPGA: B1.21, R51.1, U3.6 (1A3)
STEP6_TO_MIA: B3.19, R19.2, R89.1
STEP7_BUFFER_OUT: R22.1, U3.7 (2Y2)
STEP7_FPGA: B1.24, R53.1, U3.13 (2A2)
STEP7_TO_MIA: B3.22, R22.2, R91.1
STEP8_BUFFER_OUT: R25.1, U5.6 (1Y)
STEP8_FPGA: B2.1, R55.1, U5.2 (1A)
STEP8_TO_MX4: B4.1, R25.2, R93.1
STEP9_BUFFER_OUT: R28.1, U6.3 (2Y)
STEP9_FPGA: B2.4, R57.1, U6.5 (2A)
STEP9_TO_MX4: B4.4, R28.2, R95.1
STEP10_BUFFER_OUT: R31.1, U8.6 (1Y)
STEP10_FPGA: B2.7, R59.1, U8.2 (1A)
STEP10_TO_MX4: B4.7, R31.2, R97.1
STEP11_BUFFER_OUT: R34.1, U9.3 (2Y)
STEP11_FPGA: B2.10, R61.1, U9.5 (2A)
STEP11_TO_MX4: B4.10, R34.2, R99.1
TX_PERMIT: B1.27, R75.1, U4.2 (1A1), U11.2 (1A)
TX_PERMIT_A_BUFFER_OUT: R37.1, U4.18 (1Y1)
TX_PERMIT_A_TO_MIA: B3.25, R37.2, R101.1
TX_PERMIT_B_BUFFER_OUT: R38.1, U11.6 (1Y)
TX_PERMIT_B_TO_MX4: B4.13, R38.2, R102.1

Notes on the sheet:
MC MOTOR / TX Ioff: 8 STANDARD +4 EXPANSION; B1-B4 ARE LOGICAL BOUNDARIES, NOT CONNECTORS
BankA244A OEs tiedLOW(active). BankB2G126 used OEs share BANK_B_BUFFER_ENABLE_QUALIFIED with parentOPI_BOE clear. EN_N outgoing pull-ups belong on poweredMIA/MX4 receiver rails; NEVER on deadMC rail. 33R series are unqualified SI candidates. Not completeMC; no routing, targetfit, loadedtiming or ma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
