DeadlySIn777/Controller/hardware/motherboard/motherboard_motors.kicad_sch

## KiCad design hardware/motherboard/motherboard_motors.kicad_sch (2026-10-18)

Schematic: motherboard_motors.kicad_sch

Parts:
B6001, B6002, B6003, B6004: INTERNAL LOGICAL BOUNDARY
BM6000: M0 FIELD SIGNAL SET / CONNECTOR NOT SELECTED
BM6001: M1 FIELD SIGNAL SET / CONNECTOR NOT SELECTED
BM6002: M2 FIELD SIGNAL SET / CONNECTOR NOT SELECTED
BM6003: M3 FIELD SIGNAL SET / CONNECTOR NOT SELECTED
BM6004: M4 FIELD SIGNAL SET / CONNECTOR NOT SELECTED
BM6005: M5 FIELD SIGNAL SET / CONNECTOR NOT SELECTED
BM6006: M6 FIELD SIGNAL SET / CONNECTOR NOT SELECTED
BM6007: M7 FIELD SIGNAL SET / CONNECTOR NOT SELECTED
BM6008: M8 FIELD SIGNAL SET / CONNECTOR NOT SELECTED
BM6009: M9 FIELD SIGNAL SET / CONNECTOR NOT SELECTED
BM6010: M10 FIELD SIGNAL SET / CONNECTOR NOT SELECTED
BM6011: M11 FIELD SIGNAL SET / CONNECTOR NOT SELECTED
C6001, C6002, C6003, C6004, C6005, C6006, C6007, C6008, C6010, C6012, C6015, C6018, C6021, C6024, C6027, C6030, C6031, C6032, C6033, C6034, C6035, C6036, C6037, C6038, C6039, C6040, C6041, C6042: 100nF; C_0603_1608Metric; MPN GRM188R72A104KA35D
C6009, C6011: 1000nF; C_0603_1608Metric; MPN GRM188R71H105KA12D
C6013, C6014, C6016, C6017, C6019, C6020, C6022, C6023, C6025, C6026, C6028, C6029: 10nF; C_0805_2012Metric; MPN C2012C0G2A103J125AA
D6001, D6002, D6003, D6004, D6005, D6006, D6007, D6008, D6009, D6010, D6011, D6012, D6013, D6014, D6015, D6016, D6017, D6018, D6019, D6020, D6021, D6022, D6023, D6024, D6025, D6026, D6027, D6028, D6029, D6030, D6031, D6032, D6033, D6034, D6035, D6036: SMBJ33CA 33V bidirectional; D_SMB; MPN SMBJ33CA-E3/52
R6001, R6002, R6003, R6004, R6005, R6006, R6007, R6008, R6009, R6010, R6011, R6012, R6013, R6014, R6015, R6016, R6017, R6018, R6019, R6020, R6021, R6022, R6023, R6024, R6026, R6028, R6030, R6032, R6034, R6036, R6038, R6040, R6042, R6044, R6046, R6048, R6087, R6089, R6091, R6093: 10000R 1%; R_0603_1608Metric; MPN CRCW060310K0FKEA
R6025, R6027, R6029, R6031, R6033, R6035, R6037, R6039, R6041, R6043, R6045, R6047: 220R 1%; R_0603_1608Metric; MPN CRCW0603220RFKEA
R6049, R6050: 330R 1%; R_0603_1608Metric; MPN CRCW0603330RFKEA
R6051, R6054, R6057, R6060, R6063, R6066, R6069, R6072, R6075, R6078, R6081, R6084: 1000R 1%; R_MiniMELF_MMA-0204; MPN SMM02040C1001FB300
R6052, R6055, R6058, R6061, R6064, R6067, R6070, R6073, R6076, R6079, R6082, R6085: 562R 1%; R_0603_1608Metric; MPN CRCW0603562RFKEA
R6053, R6056, R6059, R6062, R6065, R6068, R6071, R6074, R6077, R6080, R6083, R6086: 100000R 1%; R_0603_1608Metric; MPN CRCW0603100KFKEA
R6088, R6092: 60400R 1%; R_0603_1608Metric; MPN CRCW060360K4FKEA
R6090, R6094: 4700R 1%; R_0603_1608Metric; MPN CRCW06034K70FKEA
R6095, R6096: 1000R 1%; R_0603_1608Metric; MPN CRCW06031K00FKEA
U6001, U6002, U6003, U6004, U6005, U6006: AM26C31IPWR; TSSOP-16_4.4x5mm_P0.65mm; MPN AM26C31IPWR
U6007, U6008: 74LVC07APW,118; TSSOP-14_4.4x5mm_P0.65mm; MPN 74LVC07APW,118
U6009, U6011, U6013, U6015, U6017, U6019, U6021, U6023, U6025, U6027, U6029, U6031: TLP3640A(TPL,E; TLP3640A_SO4_11-3C1; MPN TLP3640A(TPL,E
U6010, U6012, U6014, U6016, U6018, U6020, U6022, U6024, U6026, U6028, U6030, U6032: TLP4176A(TP,F; TLP4176A_2.54SOP4_11-5H1S; MPN TLP4176A(TP,F
U6033, U6034: TPS22918DBVR; SOT-23-6; MPN TPS22918DBVR
U6035, U6036, U6037, U6038, U6039, U6040: ISO1212DBQR; ISO1212_DBQ16_TI; MPN ISO1212DBQR
U6041, U6045: LTC6994IS6-2#TRPBF; TSOT-23-6; MPN LTC6994IS6-2#TRPBF
U6042: SN74LVC2G08DCUR; VSSOP-8_2.3x2mm_P0.5mm; MPN SN74LVC2G08DCUR
U6043, U6044: SN74LVC1G74DCUR; VSSOP-8_2.3x2mm_P0.5mm; MPN SN74LVC1G74DCUR
U6046, U6047: 74LVC14APW,118; TSSOP-14_4.4x5mm_P0.65mm; MPN 74LVC14APW,118
U6048, U6049, U6050: SN74LVC00APWR; TSSOP-14_4.4x5mm_P0.65mm; MPN SN74LVC00APWR
U6051, U6052: 74AHCT1G17GVH; SOT-23-5; MPN 74AHCT1G17GVH

Connections:
ALM0_FIELD: BM6000.14, D6025.1, R6051.1
ALM0_FPGA: B6004.1, R6053.1, U6035.4 (OUT1)
ALM0_IN: R6052.2, U6035.15 (IN1)
ALM0_SENSE: C6013.1, R6051.2, R6052.1, U6035.16 (SENSE1)
ALM0_SUB_FLOAT: U6035.13 (SUB1)
ALM1_FIELD: BM6001.14, D6026.1, R6054.1
ALM1_FPGA: B6004.2, R6056.1, U6035.5 (OUT2)
ALM1_IN: R6055.2, U6035.10 (IN2)
ALM1_SENSE: C6014.1, R6054.2, R6055.1, U6035.11 (SENSE2)
ALM1_SUB_FLOAT: U6035.12 (SUB2)
ALM2_FIELD: BM6002.14, D6027.1, R6057.1
ALM2_FPGA: B6004.3, R6059.1, U6036.4 (OUT1)
ALM2_IN: R6058.2, U6036.15 (IN1)
ALM2_SENSE: C6016.1, R6057.2, R6058.1, U6036.16 (SENSE1)
ALM2_SUB_FLOAT: U6036.13 (SUB1)
ALM3_FIELD: BM6003.14, D6028.1, R6060.1
ALM3_FPGA: B6004.4, R6062.1, U6036.5 (OUT2)
ALM3_IN: R6061.2, U6036.10 (IN2)
ALM3_SENSE: C6017.1, R6060.2, R6061.1, U6036.11 (SENSE2)
ALM3_SUB_FLOAT: U6036.12 (SUB2)
ALM4_FIELD: BM6004.14, D6029.1, R6063.1
ALM4_FPGA: B6004.5, R6065.1, U6037.4 (OUT1)
ALM4_IN: R6064.2, U6037.15 (IN1)
ALM4_SENSE: C6019.1, R6063.2, R6064.1, U6037.16 (SENSE1)
ALM4_SUB_FLOAT: U6037.13 (SUB1)
ALM5_FIELD: BM6005.14, D6030.1, R6066.1
ALM5_FPGA: B6004.6, R6068.1, U6037.5 (OUT2)
ALM5_IN: R6067.2, U6037.10 (IN2)
ALM5_SENSE: C6020.1, R6066.2, R6067.1, U6037.11 (SENSE2)
ALM5_SUB_FLOAT: U6037.12 (SUB2)
ALM6_FIELD: BM6006.14, D6031.1, R6069.1
ALM6_FPGA: B6004.7, R6071.1, U6038.4 (OUT1)
ALM6_IN: R6070.2, U6038.15 (IN1)
ALM6_SENSE: C6022.1, R6069.2, R6070.1, U6038.16 (SENSE1)
ALM6_SUB_FLOAT: U6038.13 (SUB1)
ALM7_FIELD: BM6007.14, D6032.1, R6072.1
ALM7_FPGA: B6004.8, R6074.1, U6038.5 (OUT2)
ALM7_IN: R6073.2, U6038.10 (IN2)
ALM7_SENSE: C6023.1, R6072.2, R6073.1, U6038.11 (SENSE2)
ALM7_SUB_FLOAT: U6038.12 (SUB2)
ALM8_FIELD: BM6008.14, D6033.1, R6075.1
ALM8_FPGA: B6004.9, R6077.1, U6039.4 (OUT1)
ALM8_IN: R6076.2, U6039.15 (IN1)
ALM8_SENSE: C6025.1, R6075.2, R6076.1, U6039.16 (SENSE1)
ALM8_SUB_FLOAT: U6039.13 (SUB1)
ALM9_FIELD: BM6009.14, D6034.1, R6078.1
ALM9_FPGA: B6004.10, R6080.1, U6039.5 (OUT2)
ALM9_IN: R6079.2, U6039.10 (IN2)
ALM9_SENSE: C6026.1, R6078.2, R6079.1, U6039.11 (SENSE2)
ALM9_SUB_FLOAT: U6039.12 (SUB2)
ALM10_FIELD: BM6010.14, D6035.1, R6081.1
ALM10_FPGA: B6004.11, R6083.1, U6040.4 (OUT1)
ALM10_IN: R6082.2, U6040.15 (IN1)
ALM10_SENSE: C6028.1, R6081.2, R6082.1, U6040.16 (SENSE1)
ALM10_SUB_FLOAT: U6040.13 (SUB1)
ALM11_FIELD: BM6011.14, D6036.1, R6084.1
ALM11_FPGA: B6004.12, R6086.1, U6040.5 (OUT2)
ALM11_IN: R6085.2, U6040.10 (IN2)
ALM11_SENSE: C6029.1, R6084.2, R6085.1, U6040.11 (SENSE2)
ALM11_SUB_FLOAT: U6040.12 (SUB2)
AUX_5V_A: B6001.7, BM6000.11, BM6001.11, BM6002.11, BM6003.11, BM6004.11, BM6005.11, BM6006.11, BM6007.11
AUX_5V_B: B6001.8, BM6008.11, BM6009.11, BM6010.11, BM6011.11
AUX_24V_A: B6001.9, BM6000.12, BM6001.12, BM6002.12, BM6003.12, BM6004.12, BM6005.12, BM6006.12, BM6007.12
AUX_24V_B: B6001.10, BM6008.12, BM6009.12, BM6010.12, BM6011.12
CHASSIS: B6001.4, BM6000.6, BM6001.6, BM6002.6, BM6003.6, BM6004.6, BM6005.6, BM6006.6, BM6007.6, BM6008.6, BM6009.6, BM6010.6, BM6011.6
DIR0_N: BM6000.4, U6001.5 (2Z)
DIR0_P: BM6000.3, U6001.6 (2Y)
DIR0_TO_MIA: B6002.2, R6002.1, U6001.7 (2A)
DIR1_N: BM6001.4, U6001.13 (4Z)
DIR1_P: BM6001.3, U6001.14 (4Y)
DIR1_TO_MIA: B6002.5, R6004.1, U6001.15 (4A)
DIR2_N: BM6002.4, U6002.5 (2Z)
DIR2_P: BM6002.3, U6002.6 (2Y)
DIR2_TO_MIA: B6002.8, R6006.1, U6002.7 (2A)
DIR3_N: BM6003.4, U6002.13 (4Z)
DIR3_P: BM6003.3, U6002.14 (4Y)
DIR3_TO_MIA: B6002.11, R6008.1, U6002.15 (4A)
DIR4_N: BM6004.4, U6003.5 (2Z)
DIR4_P: BM6004.3, U6003.6 (2Y)
DIR4_TO_MIA: B6002.14, R6010.1, U6003.7 (2A)
DIR5_N: BM6005.4, U6003.13 (4Z)
DIR5_P: BM6005.3, U6003.14 (4Y)
DIR5_TO_MIA: B6002.17, R6012.1, U6003.15 (4A)
DIR6_N: BM6006.4, U6004.5 (2Z)
DIR6_P: BM6006.3, U6004.6 (2Y)
DIR6_TO_MIA: B6002.20, R6014.1, U6004.7 (2A)
DIR7_N: BM6007.4, U6004.13 (4Z)
DIR7_P: BM6007.3, U6004.14 (4Y)
DIR7_TO_MIA: B6003.2, R6016.1, U6004.15 (4A)
DIR8_N: BM6008.4, U6005.5 (2Z)
DIR8_P: BM6008.3, U6005.6 (2Y)
DIR8_TO_MX4: B6003.5, R6018.1, U6005.7 (2A)
DIR9_N: BM6009.4, U6005.13 (4Z)
DIR9_P: BM6009.3, U6005.14 (4Y)
DIR9_TO_MX4: B6003.8, R6020.1, U6005.15 (4A)
DIR10_N: BM6010.4, U6006.5 (2Z)
DIR10_P: BM6010.3, U6006.6 (2Y)
DIR10_TO_MX4: B6003.11, R6022.1, U6006.7 (2A)
DIR11_N: BM6011.4, U6006.13 (4Z)
DIR11_P: BM6011.3, U6006.14 (4Y)
DIR11_TO_MX4: B6003.14, R6024.1, U6006.15 (4A)
EN0_COM: BM6000.9, D6001.2, D6002.2, U6009.4 (D), U6010.4 (D)
EN0_NC: BM6000.10, D6002.1, U6010.3 (D)
EN0_NO: BM6000.8, D6001.1, U6009.3 (D)
EN0_N_TO_MIA: B6002.3, R6026.1, U6046.1 (1A)
EN1_COM: BM6001.9, D6003.2, D6004.2, U6011.4 (D), U6012.4 (D)
EN1_NC: BM6001.10, D6004.1, U6012.3 (D)
EN1_NO: BM6001.8, D6003.1, U6011.3 (D)
EN1_N_TO_MIA: B6002.6, R6028.1, U6046.3 (2A)
EN2_COM: BM6002.9, D6005.2, D6006.2, U6013.4 (D), U6014.4 (D)
EN2_NC: BM6002.10, D6006.1, U6014.3 (D)
EN2_NO: BM6002.8, D6005.1, U6013.3 (D)
EN2_N_TO_MIA: B6002.9, R6030.1, U6046.5 (3A)
EN3_COM: BM6003.9, D6007.2, D6008.2, U6015.4 (D), U6016.4 (D)
EN3_NC: BM6003.10, D6008.1, U6016.3 (D)
EN3_NO: BM6003.8, D6007.1, U6015.3 (D)
EN3_N_TO_MIA: B6002.12, R6032.1, U6046.9 (4A)
EN4_COM: BM6004.9, D6009.2, D6010.2, U6017.4 (D), U6018.4 (D)
EN4_NC: BM6004.10, D6010.1, U6018.3 (D)
EN4_NO: BM6004.8, D6009.1, U6017.3 (D)
EN4_N_TO_MIA: B6002.15, R6034.1, U6046.11 (5A)
EN5_COM: BM6005.9, D6011.2, D6012.2, U6019.4 (D), U6020.4 (D)
EN5_NC: BM6005.10, D6012.1, U6020.3 (D)
EN5_NO: BM6005.8, D6011.1, U6019.3 (D)
EN5_N_TO_MIA: B6002.18, R6036.1, U6046.13 (6A)
EN6_COM: BM6006.9, D6013.2, D6014.2, U6021.4 (D), U6022.4 (D)
EN6_NC: BM6006.10, D6014.1, U6022.3 (D)
EN6_NO: BM6006.8, D6013.1, U6021.3 (D)
EN6_N_TO_MIA: B6002.21, R6038.1, U6047.1 (1A)
EN7_COM: BM6007.9, D6015.2, D6016.2, U6023.4 (D), U6024.4 (D)
EN7_NC: BM6007.10, D6016.1, U6024.3 (D)
EN7_NO: BM6007.8, D6015.1, U6023.3 (D)
EN7_N_TO_MIA: B6003.3, R6040.1, U6047.3 (2A)
EN8_COM: BM6008.9, D6017.2, D6018.2, U6025.4 (D), U6026.4 (D)
EN8_NC: BM6008.10, D6018.1, U6026.3 (D)
EN8_NO: BM6008.8, D6017.1, U6025.3 (D)
EN8_N_TO_MX4: B6003.6, R6042.1, U6047.5 (3A)
EN9_COM: BM6009.9, D6019.2, D6020.2, U6027.4 (D), U6028.4 (D)
EN9_NC: BM6009.10, D6020.1, U6028.3 (D)
EN9_NO: BM6009.8, D6019.1, U6027.3 (D)
EN9_N_TO_MX4: B6003.9, R6044.1, U6047.9 (4A)
EN10_COM: BM6010.9, D6021.2, D6022.2, U6029.4 (D), U6030.4 (D)
EN10_NC: BM6010.10, D6022.1, U6030.3 (D)
EN10_NO: BM6010.8, D6021.1, U6029.3 (D)
EN10_N_TO_MX4: B6003.12, R6046.1, U6047.11 (5A)
EN11_COM: BM6011.9, D6023.2, D6024.2, U6031.4 (D), U6032.4 (D)
EN11_NC: BM6011.10, D6024.1, U6032.3 (D)
EN11_NO: BM6011.8, D6023.1, U6031.3 (D)
EN11_N_TO_MX4: B6003.15, R6048.1, U6047.13 (6A)
FIELD_GND: B6001.3, BM6000.13, BM6001.13, BM6002.13, BM6003.13, BM6004.13, BM6005.13, BM6006.13, BM6007.13, BM6008.13, BM6009.13, BM6010.13, BM6011.13, C6013.2, C6014.2, C6016.2, C6017.2, C6019.2, C6020.2, C6022.2, C6023.2, C6025.2, C6026.2, C6028.2, C6029.2, D6025.2, D6026.2, D6027.2, D6028.2, D6029.2, D6030.2, D6031.2, D6032.2, D6033.2, D6034.2, D6035.2, D6036.2, U6035.9 (FGND2), U6035.14 (FGND1), U6036.9 (FGND2), U6036.14 (FGND1), U6037.9 (FGND2), U6037.14 (FGND1), U6038.9 (FGND2), U6038.14 (FGND1), U6039.9 (FGND2), U6039.14 (FGND1), U6040.9 (FGND2), U6040.14 (FGND1)
LOGIC_GND: B6001.2, BM6000.5, BM6001.5, BM6002.5, BM6003.5, BM6004.5, BM6005.5, BM6006.5, BM6007.5, BM6008.5, BM6009.5, BM6010.5, BM6011.5, C6001.2, C6002.2, C6003.2, C6004.2, C6005.2, C6006.2, C6007.2, C6008.2, C6009.2, C6010.2, C6011.2, C6012.2, C6015.2, C6018.2, C6021.2, C6024.2, C6027.2, C6030.2, C6031.2, C6032.2, C6033.2, C6034.2, C6035.2, C6036.2, C6037.2, C6038.2, C6039.2, C6040.2, C6041.2, C6042.2, R6001.2, R6002.2, R6003.2, R6004.2, R6005.2, R6006.2, R6007.2, R6008.2, R6009.2, R6010.2, R6011.2, R6012.2, R6013.2, R6014.2, R6015.2, R6016.2, R6017.2, R6018.2, R6019.2, R6020.2, R6021.2, R6022.2, R6023.2, R6024.2, R6049.2, R6050.2, R6053.2, R6056.2, R6059.2, R6062.2, R6065.2, R6068.2, R6071.2, R6074.2, R6077.2, R6080.2, R6083.2, R6086.2, R6087.2, R6088.2, R6089.2, R6090.2, R6091.2, R6092.2, R6093.2, R6094.2, R6095.2, R6096.2, U6001.8 (GND), U6002.8 (GND), U6003.8 (GND), U6004.8 (GND), U6005.8 (GND), U6006.8 (GND), U6007.7 (GND), U6008.7 (GND), U6033.2 (GND), U6034.2 (GND), U6035.1 (GND1), U6035.8 (GND1), U6036.1 (GND1), U6036.8 (GND1), U6037.1 (GND1), U6037.8 (GND1), U6038.1 (GND1), U6038.8 (GND1), U6039.1 (GND1), U6039.8 (GND1), U6040.1 (GND1), U6040.8 (GND1), U6041.2 (GND), U6041.4 (DIV), U6042.4 (GND), U6043.4 (GND), U6044.4 (GND), U6045.2 (GND), U6045.4 (DIV), U6046.7 (GND), U6047.7 (GND), U6048.7 (GND), U6049.7 (GND), U6050.7 (GND), U6051.3 (GND), U6052.3 (GND)
MOTOR0_EN_ACTIVE: U6046.2 (1Y), U6048.1 (1A)
MOTOR0_LED_K: R6025.1, U6010.2 (K)
MOTOR0_LED_MID: U6009.2 (K), U6010.1 (A)
MOTOR0_LED_SINK: R6025.2, U6007.2 (1Y)
MOTOR0_SINK_OFF: U6007.1 (1A), U6048.3 (1Y)
MOTOR1_EN_ACTIVE: U6046.4 (2Y), U6048.4 (2A)
MOTOR1_LED_K: R6027.1, U6012.2 (K)
MOTOR1_LED_MID: U6011.2 (K), U6012.1 (A)
MOTOR1_LED_SINK: R6027.2, U6007.4 (2Y)
MOTOR1_SINK_OFF: U6007.3 (2A), U6048.6 (2Y)
MOTOR2_EN_ACTIVE: U6046.6 (3Y), U6048.9 (3A)
MOTOR2_LED_K: R6029.1, U6014.2 (K)
MOTOR2_LED_MID: U6013.2 (K), U6014.1 (A)
MOTOR2_LED_SINK: R6029.2, U6007.6 (3Y)
MOTOR2_SINK_OFF: U6007.5 (3A), U6048.8 (3Y)
MOTOR3_EN_ACTIVE: U6046.8 (4Y), U6048.12 (4A)
MOTOR3_LED_K: R6031.1, U6016.2 (K)
MOTOR3_LED_MID: U6015.2 (K), U6016.1 (A)
MOTOR3_LED_SINK: R6031.2, U6007.8 (4Y)
MOTOR3_SINK_OFF: U6007.9 (4A), U6048.11 (4Y)
MOTOR4_EN_ACTIVE: U6046.10 (5Y), U6049.1 (1A)
MOTOR4_LED_K: R6033.1, U6018.2 (K)
MOTOR4_LED_MID: U6017.2 (K), U6018.1 (A)
MOTOR4_LED_SINK: R6033.2, U6007.10 (5Y)
MOTOR4_SINK_OFF: U6007.11 (5A), U6049.3 (1Y)
MOTOR5_EN_ACTIVE: U6046.12 (6Y), U6049.4 (2A)
MOTOR5_LED_K: R6035.1, U6020.2 (K)
MOTOR5_LED_MID: U6019.2 (K), U6020.1 (A)
MOTOR5_LED_SINK: R6035.2, U6007.12 (6Y)
MOTOR5_SINK_OFF: U6007.13 (6A), U6049.6 (2Y)
MOTOR6_EN_ACTIVE: U6047.2 (1Y), U6049.9 (3A)
MOTOR6_LED_K: R6037.1, U6022.2 (K)
MOTOR6_LED_MID: U6021.2 (K), U6022.1 (A)
MOTOR6_LED_SINK: R6037.2, U6008.2 (1Y)
MOTOR6_SINK_OFF: U6008.1 (1A), U6049.8 (3Y)
MOTOR7_EN_ACTIVE: U6047.4 (2Y), U6049.12 (4A)
MOTOR7_LED_K: R6039.1, U6024.2 (K)
MOTOR7_LED_MID: U6023.2 (K), U6024.1 (A)
MOTOR7_LED_SINK: R6039.2, U6008.4 (2Y)
MOTOR7_SINK_OFF: U6008.3 (2A), U6049.11 (4Y)
MOTOR8_EN_ACTIVE: U6047.6 (3Y), U6050.1 (1A)
MOTOR8_LED_K: R6041.1, U6026.2 (K)
MOTOR8_LED_MID: U6025.2 (K), U6026.1 (A)
MOTOR8_LED_SINK: R6041.2, U6008.6 (3Y)
MOTOR8_SINK_OFF: U6008.5 (3A), U6050.3 (1Y)
MOTOR9_EN_ACTIVE: U6047.8 (4Y), U6050.4 (2A)
MOTOR9_LED_K: R6043.1, U6028.2 (K)
MOTOR9_LED_MID: U6027.2 (K), U6028.1 (A)
MOTOR9_LED_SINK: R6043.2, U6008.8 (4Y)
MOTOR9_SINK_OFF: U6008.9 (4A), U6050.6 (2Y)
MOTOR10_EN_ACTIVE: U6047.10 (5Y), U6050.9 (3A)
MOTOR10_LED_K: R6045.1, U6030.2 (K)
MOTOR10_LED_MID: U6029.2 (K), U6030.1 (A)
MOTOR10_LED_SINK: R6045.2, U6008.10 (5Y)
MOTOR10_SINK_OFF: U6008.11 (5A), U6050.8 (3Y)
MOTOR11_EN_ACTIVE: U6047.12 (6Y), U6050.12 (4A)
MOTOR11_LED_K: R6047.1, U6032.2 (K)
MOTOR11_LED_MID: U6031.2 (K), U6032.1 (A)
MOTOR11_LED_SINK: R6047.2, U6008.12 (6Y)
MOTOR11_SINK_OFF: U6008.13 (6A), U6050.11 (4Y)
MOTOR_5V_A: B6001.5, C6001.1, C6002.1, C6003.1, C6004.1, C6009.1, C6031.1, C6033.1, U6001.12 (G_N), U6001.16 (VCC), U6002.12 (G_N), U6002.16 (VCC), U6003.12 (G_N), U6003.16 (VCC), U6004.12 (G_N), U6004.16 (VCC), U6033.1 (VIN), U6041.5 (V+), U6051.5 (VCC)
MOTOR_5V_B: B6001.6, C6005.1, C6006.1, C6011.1, C6032.1, C6037.1, U6005.12 (G_N), U6005.16 (VCC), U6006.12 (G_N), U6006.16 (VCC), U6034.1 (VIN), U6045.5 (V+), U6052.5 (VCC)
MOTOR_IO_3V3: B6001.1, C6007.1, C6008.1, C6015.1, C6018.1, C6021.1, C6024.1, C6027.1, C6030.1, C6034.1, C6035.1, C6036.1, C6038.1, C6039.1, C6040.1, C6041.1, C6042.1, R6026.2, R6028.2, R6030.2, R6032.2, R6034.2, R6036.2, R6038.2, R6040.2, R6042.2, R6044.2, R6046.2, R6048.2, U6007.14 (VCC), U6008.14 (VCC), U6035.2 (VCC1), U6035.3 (EN), U6036.2 (VCC1), U6036.3 (EN), U6037.2 (VCC1), U6037.3 (EN), U6038.2 (VCC1), U6038.3 (EN), U6039.2 (VCC1), U6039.3 (EN), U6040.2 (VCC1), U6040.3 (EN), U6042.8 (VCC), U6043.2 (D), U6043.7 (PRE_N), U6043.8 (VCC), U6044.2 (D), U6044.7 (PRE_N), U6044.8 (VCC), U6046.14 (VCC), U6047.14 (VCC), U6048.14 (VCC), U6049.14 (VCC), U6050.14 (VCC)
MOTOR_LED_5V_A: C6010.1, R6049.1, U6009.1 (A), U6011.1 (A), U6013.1 (A), U6015.1 (A), U6017.1 (A), U6019.1 (A), U6021.1 (A), U6023.1 (A), U6033.5 (QOD), U6033.6 (VOUT)
MOTOR_LED_5V_B: C6012.1, R6050.1, U6025.1 (A), U6027.1 (A), U6029.1 (A), U6031.1 (A), U6034.5 (QOD), U6034.6 (VOUT)
MOTOR_PERMIT_A_FILTERED: U6041.6 (OUT), U6042.1 (1A)
MOTOR_PERMIT_A_SET: R6088.1, U6041.3 (SET)
MOTOR_PERMIT_A_TTL_RESTORED: U6041.1 (IN), U6051.4 (Y)
MOTOR_PERMIT_B_FILTERED: U6042.5 (2A), U6045.6 (OUT)
MOTOR_PERMIT_B_SET: R6092.1, U6045.3 (SET)
MOTOR_PERMIT_B_TTL_RESTORED: U6045.1 (IN), U6052.4 (Y)
MOTOR_POWER_OK_A_QUALIFIED: B6003.18, R6089.1, U6042.2 (1B)
MOTOR_POWER_OK_B_QUALIFIED: B6003.19, R6093.1, U6042.6 (2B)
MOTOR_TX_GATE_A: B6004.15, R6095.1, U6001.4 (G), U6002.4 (G), U6003.4 (G), U6004.4 (G), U6033.3 (ON), U6043.6 (CLR_N), U6048.2 (1B), U6048.5 (2B), U6048.10 (3B), U6048.13 (4B), U6049.2 (1B), U6049.5 (2B), U6049.10 (3B), U6049.13 (4B)
MOTOR_TX_GATE_B: B6004.16, R6096.1, U6005.4 (G), U6006.4 (G), U6034.3 (ON), U6044.6 (CLR_N), U6050.2 (1B), U6050.5 (2B), U6050.10 (3B), U6050.13 (4B)
MOTOR_TX_GATE_SOURCE_A: U6042.7 (1Y)
MOTOR_TX_GATE_SOURCE_B: U6042.3 (2Y)
OPI_OK_A: B6004.13, U6043.5 (Q)
OPI_OK_B: B6004.14, U6044.5 (Q)
OPI_REARM_A: B6003.20, R6090.1, U6043.1 (CLK)
OPI_REARM_B: B6003.21, R6094.1, U6044.1 (CLK)
STEP0_N: BM6000.2, U6001.3 (1Z)
STEP0_P: BM6000.1, U6001.2 (1Y)
STEP0_TO_MIA: B6002.1, R6001.1, U6001.1 (1A)
STEP1_N: BM6001.2, U6001.11 (3Z)
STEP1_P: BM6001.1, U6001.10 (3Y)
STEP1_TO_MIA: B6002.4, R6003.1, U6001.9 (3A)
STEP2_N: BM6002.2, U6002.3 (1Z)
STEP2_P: BM6002.1, U6002.2 (1Y)
STEP2_TO_MIA: B6002.7, R6005.1, U6002.1 (1A)
STEP3_N: BM6003.2, U6002.11 (3Z)
STEP3_P: BM6003.1, U6002.10 (3Y)
STEP3_TO_MIA: B6002.10, R6007.1, U6002.9 (3A)
STEP4_N: BM6004.2, U6003.3 (1Z)
STEP4_P: BM6004.1, U6003.2 (1Y)
STEP4_TO_MIA: B6002.13, R6009.1, U6003.1 (1A)
STEP5_N: BM6005.2, U6003.11 (3Z)
STEP5_P: BM6005.1, U6003.10 (3Y)
STEP5_TO_MIA: B6002.16, R6011.1, U6003.9 (3A)
STEP6_N: BM6006.2, U6004.3 (1Z)
STEP6_P: BM6006.1, U6004.2 (1Y)
STEP6_TO_MIA: B6002.19, R6013.1, U6004.1 (1A)
STEP7_N: BM6007.2, U6004.11 (3Z)
STEP7_P: BM6007.1, U6004.10 (3Y)
STEP7_TO_MIA: B6003.1, R6015.1, U6004.9 (3A)
STEP8_N: BM6008.2, U6005.3 (1Z)
STEP8_P: BM6008.1, U6005.2 (1Y)
STEP8_TO_MX4: B6003.4, R6017.1, U6005.1 (1A)
STEP9_N: BM6009.2, U6005.11 (3Z)
STEP9_P: BM6009.1, U6005.10 (3Y)
STEP9_TO_MX4: B6003.7, R6019.1, U6005.9 (3A)
STEP10_N: BM6010.2, U6006.3 (1Z)
STEP10_P: BM6010.1, U6006.2 (1Y)
STEP10_TO_MX4: B6003.10, R6021.1, U6006.1 (1A)
STEP11_N: BM6011.2, U6006.11 (3Z)
STEP11_P: BM6011.1, U6006.10 (3Y)
STEP11_TO_MX4: B6003.13, R6023.1, U6006.9 (3A)
TX_PERMIT_A_TO_MIA: B6003.16, R6087.1, U6051.2 (A)
TX_PERMIT_B_TO_MX4: B6003.17, R6091.1, U6052.2 (A)

Notes on the sheet:
TWELVE FITTED ON-MOTHERBOARD MOTOR INTERFACES: 24 DIFFERENTIAL SIGNALS / 12 NO+NC ENABLES / 12 SEPARATE ALARMS Source circuit candidate. Power/interface boundaries and qualified timing remain explicit parent obligations. Not fabrication data.
