DeadlySIn777/Controller/hardware/motherboard_do/motherboard_do.kicad_sch

## KiCad design hardware/motherboard_do/motherboard_do.kicad_sch (2026-10-18)

Schematic: motherboard_do.kicad_sch

Parts:
C10001, C10002, C10003, C10004, C10007, C10008, C10016, C10017, C10023, C10024, C10025, C10026, C10029, C10030, C10038, C10039: 100nF 100V; C_0603_1608Metric; MPN GRM188R72A104KA35D
C10005, C10014, C10027, C10036: 0.1nF 50V; C_0603_1608Metric; MPN GRM1885C1H101JA01D
C10006, C10015, C10028, C10037: 2200nF 16V; C_0805_2012Metric; MPN GRM21BR71C225KA12L
C10009, C10018, C10031, C10040: 1000nF 50V; C_0603_1608Metric; MPN GRM188R71H105KA12D
C10010, C10011, C10012, C10013, C10019, C10020, C10021, C10022, C10032, C10033, C10034, C10035, C10041, C10042, C10043, C10044: 22nF 100V; C_0805_2012Metric; MPN C0805C223K1RACTU
J10001: UNIMPLEMENTED PARENT: XDO0 field connector not se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
J10002: UNIMPLEMENTED PARENT: XDO1 field connector not se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
J10003, J10004: UNIMPLEMENTED PARENT: protected field entry and s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
J10005, J10006: UNIMPLEMENTED PARENT: local IOL1 controller/watch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
R10001, R10002, R10003, R10004, R10005, R10006, R10007, R10008, R10009, R10010, R10011, R10012, R10013, R10014, R10016, R10019, R10021, R10022, R10023, R10024, R10025, R10026, R10027, R10028, R10029, R10030, R10031, R10032, R10033, R10034, R10036, R10039: 10000R 1%; R_0603_1608Metric; MPN CRCW060310K0FKEA
R10015, R10035: 13300R 0.1%; R_0603_1608Metric; MPN TNPW060313K3BEEA
R10017, R10020, R10037, R10040: 1000R 1%; R_0603_1608Metric; MPN CRCW06031K00FKEA
R10018, R10038: 17800R 0.1%; R_0603_1608Metric; MPN TNPW060317K8BEEA
U10001, U10014: SN74LVC1G74DCUR; VSSOP-8_2.3x2mm_P0.5mm; MPN SN74LVC1G74DCUR
U10002, U10015: SN74LVC08APWR; TSSOP-14_4.4x5mm_P0.65mm; MPN SN74LVC08APWR
U10003, U10016: ISO7762FDBQR; ISO7762_DBQ16_TI; MPN ISO7762FDBQR
U10004, U10009, U10017, U10022: TPS274C65ASRHAR; TPS274C65_RHA40_TI; MPN TPS274C65ASRHAR
U10005, U10006, U10007, U10008, U10010, U10011, U10012, U10013, U10018, U10019, U10020, U10021, U10023, U10024, U10025, U10026: CSD19538Q3AT; CSD19538_DNH8_TI; MPN CSD19538Q3AT

Connections:
DO00: C10010.1, J10001.1, U10005.5 (D), U10005.6 (D), U10005.7 (D), U10005.8 (D), U10005.9 (EP_D)
DO00_RCB_GATE: U10004.40 (RCB1), U10005.4 (G)
DO00_SW: U10004.38 (OUT1), U10004.39 (OUT1), U10005.1 (S), U10005.2 (S), U10005.3 (S)
DO01: C10011.1, J10001.2, U10006.5 (D), U10006.6 (D), U10006.7 (D), U10006.8 (D), U10006.9 (EP_D)
DO01_RCB_GATE: U10004.31 (RCB2), U10006.4 (G)
DO01_SW: U10004.32 (OUT2), U10004.33 (OUT2), U10006.1 (S), U10006.2 (S), U10006.3 (S)
DO02: C10012.1, J10001.3, U10007.5 (D), U10007.6 (D), U10007.7 (D), U10007.8 (D), U10007.9 (EP_D)
DO02_RCB_GATE: U10004.11 (RCB3), U10007.4 (G)
DO02_SW: U10004.12 (OUT3), U10004.13 (OUT3), U10007.1 (S), U10007.2 (S), U10007.3 (S)
DO03: C10013.1, J10001.4, U10008.5 (D), U10008.6 (D), U10008.7 (D), U10008.8 (D), U10008.9 (EP_D)
DO03_RCB_GATE: U10004.20 (RCB4), U10008.4 (G)
DO03_SW: U10004.18 (OUT4), U10004.19 (OUT4), U10008.1 (S), U10008.2 (S), U10008.3 (S)
DO04: C10019.1, J10001.5, U10010.5 (D), U10010.6 (D), U10010.7 (D), U10010.8 (D), U10010.9 (EP_D)
DO04_RCB_GATE: U10009.40 (RCB1), U10010.4 (G)
DO04_SW: U10009.38 (OUT1), U10009.39 (OUT1), U10010.1 (S), U10010.2 (S), U10010.3 (S)
DO05: C10020.1, J10001.6, U10011.5 (D), U10011.6 (D), U10011.7 (D), U10011.8 (D), U10011.9 (EP_D)
DO05_RCB_GATE: U10009.31 (RCB2), U10011.4 (G)
DO05_SW: U10009.32 (OUT2), U10009.33 (OUT2), U10011.1 (S), U10011.2 (S), U10011.3 (S)
DO06: C10021.1, J10001.7, U10012.5 (D), U10012.6 (D), U10012.7 (D), U10012.8 (D), U10012.9 (EP_D)
DO06_RCB_GATE: U10009.11 (RCB3), U10012.4 (G)
DO06_SW: U10009.12 (OUT3), U10009.13 (OUT3), U10012.1 (S), U10012.2 (S), U10012.3 (S)
DO07: C10022.1, J10001.8, U10013.5 (D), U10013.6 (D), U10013.7 (D), U10013.8 (D), U10013.9 (EP_D)
DO07_RCB_GATE: U10009.20 (RCB4), U10013.4 (G)
DO07_SW: U10009.18 (OUT4), U10009.19 (OUT4), U10013.1 (S), U10013.2 (S), U10013.3 (S)
DO08: C10032.1, J10002.1, U10018.5 (D), U10018.6 (D), U10018.7 (D), U10018.8 (D), U10018.9 (EP_D)
DO08_RCB_GATE: U10017.40 (RCB1), U10018.4 (G)
DO08_SW: U10017.38 (OUT1), U10017.39 (OUT1), U10018.1 (S), U10018.2 (S), U10018.3 (S)
DO09: C10033.1, J10002.2, U10019.5 (D), U10019.6 (D), U10019.7 (D), U10019.8 (D), U10019.9 (EP_D)
DO09_RCB_GATE: U10017.31 (RCB2), U10019.4 (G)
DO09_SW: U10017.32 (OUT2), U10017.33 (OUT2), U10019.1 (S), U10019.2 (S), U10019.3 (S)
DO10: C10034.1, J10002.3, U10020.5 (D), U10020.6 (D), U10020.7 (D), U10020.8 (D), U10020.9 (EP_D)
DO10_RCB_GATE: U10017.11 (RCB3), U10020.4 (G)
DO10_SW: U10017.12 (OUT3), U10017.13 (OUT3), U10020.1 (S), U10020.2 (S), U10020.3 (S)
DO11: C10035.1, J10002.4, U10021.5 (D), U10021.6 (D), U10021.7 (D), U10021.8 (D), U10021.9 (EP_D)
DO11_RCB_GATE: U10017.20 (RCB4), U10021.4 (G)
DO11_SW: U10017.18 (OUT4), U10017.19 (OUT4), U10021.1 (S), U10021.2 (S), U10021.3 (S)
DO12: C10041.1, J10002.5, U10023.5 (D), U10023.6 (D), U10023.7 (D), U10023.8 (D), U10023.9 (EP_D)
DO12_RCB_GATE: U10022.40 (RCB1), U10023.4 (G)
DO12_SW: U10022.38 (OUT1), U10022.39 (OUT1), U10023.1 (S), U10023.2 (S), U10023.3 (S)
DO13: C10042.1, J10002.6, U10024.5 (D), U10024.6 (D), U10024.7 (D), U10024.8 (D), U10024.9 (EP_D)
DO13_RCB_GATE: U10022.31 (RCB2), U10024.4 (G)
DO13_SW: U10022.32 (OUT2), U10022.33 (OUT2), U10024.1 (S), U10024.2 (S), U10024.3 (S)
DO14: C10043.1, J10002.7, U10025.5 (D), U10025.6 (D), U10025.7 (D), U10025.8 (D), U10025.9 (EP_D)
DO14_RCB_GATE: U10022.11 (RCB3), U10025.4 (G)
DO14_SW: U10022.12 (OUT3), U10022.13 (OUT3), U10025.1 (S), U10025.2 (S), U10025.3 (S)
DO15: C10044.1, J10002.8, U10026.5 (D), U10026.6 (D), U10026.7 (D), U10026.8 (D), U10026.9 (EP_D)
DO15_RCB_GATE: U10022.20 (RCB4), U10026.4 (G)
DO15_SW: U10022.18 (OUT4), U10022.19 (OUT4), U10026.1 (S), U10026.2 (S), U10026.3 (S)
DOA_CARD_EN: J10005.6, R10004.1, U10002.10 (3B)
DOA_CLR_N: U10001.6 (CLR_N), U10002.3 (1Y)
DOA_CONTROLLER_RESET_N: J10005.4, R10002.1, U10002.2 (1B)
DOA_CS_N_FIELD: R10012.1, U10003.13 (OUTC), U10004.10 (CS_N), U10009.10 (CS_N)
DOA_CS_N_HOST: J10005.9, R10008.1, U10003.4 (INC)
DOA_DO_EN_FIELD: R10009.1, U10003.12 (OUTD), U10004.3 (DO_EN), U10009.3 (DO_EN)
DOA_DO_EN_LOGIC: R10005.1, U10002.8 (3Y), U10003.5 (IND)
DOA_FIELD_3V3: C10004.1, C10006.1, C10007.1, C10015.1, C10016.1, J10003.3, R10012.2, R10014.2, U10003.16 (VCC2), U10004.4 (VDD), U10009.4 (VDD)
DOA_FLT_N_FIELD: R10014.1, U10003.10 (INF), U10004.2 (FLT_N), U10009.2 (FLT_N)
DOA_FLT_N_HOST: J10005.11, U10003.7 (OUTF)
DOA_IO_ENABLE_STROBE: J10005.5, R10003.1, U10001.1 (CLK)
DOA_OUT_EN_LATCH: U10001.5 (Q), U10002.5 (2B)
DOA_PERMIT_LATCHED: U10002.6 (2Y), U10002.9 (3A)
DOA_Q0_ADDRESS: R10015.1, U10004.30 (ADDCFG)
DOA_Q0_ISNS: C10005.1, R10017.1, U10004.6 (ISNS)
DOA_Q0_READY_N: R10016.1, U10004.1 (READY)
DOA_Q1_ADDRESS: R10018.1, U10009.30 (ADDCFG)
DOA_Q1_ISNS: C10014.1, R10020.1, U10009.6 (ISNS)
DOA_Q1_READY_N: R10019.1, U10009.1 (READY)
DOA_SCLK_FIELD: R10010.1, U10003.15 (OUTA), U10004.9 (SCLK), U10009.9 (SCLK)
DOA_SCLK_HOST: J10005.7, R10006.1, U10003.2 (INA)
DOA_SDI_FIELD: R10011.1, U10003.14 (OUTB), U10004.8 (SDI), U10009.8 (SDI)
DOA_SDI_HOST: J10005.8, R10007.1, U10003.3 (INB)
DOA_SDO_FIELD: R10013.1, U10003.11 (INE), U10004.7 (SDO), U10009.7 (SDO)
DOA_SDO_HOST: J10005.10, U10003.6 (OUTE)
DOB_CARD_EN: J10006.6, R10024.1, U10015.10 (3B)
DOB_CLR_N: U10014.6 (CLR_N), U10015.3 (1Y)
DOB_CONTROLLER_RESET_N: J10006.4, R10022.1, U10015.2 (1B)
DOB_CS_N_FIELD: R10032.1, U10016.13 (OUTC), U10017.10 (CS_N), U10022.10 (CS_N)
DOB_CS_N_HOST: J10006.9, R10028.1, U10016.4 (INC)
DOB_DO_EN_FIELD: R10029.1, U10016.12 (OUTD), U10017.3 (DO_EN), U10022.3 (DO_EN)
DOB_DO_EN_LOGIC: R10025.1, U10015.8 (3Y), U10016.5 (IND)
DOB_FIELD_3V3: C10026.1, C10028.1, C10029.1, C10037.1, C10038.1, J10004.3, R10032.2, R10034.2, U10016.16 (VCC2), U10017.4 (VDD), U10022.4 (VDD)
DOB_FLT_N_FIELD: R10034.1, U10016.10 (INF), U10017.2 (FLT_N), U10022.2 (FLT_N)
DOB_FLT_N_HOST: J10006.11, U10016.7 (OUTF)
DOB_IO_ENABLE_STROBE: J10006.5, R10023.1, U10014.1 (CLK)
DOB_OUT_EN_LATCH: U10014.5 (Q), U10015.5 (2B)
DOB_PERMIT_LATCHED: U10015.6 (2Y), U10015.9 (3A)
DOB_Q0_ADDRESS: R10035.1, U10017.30 (ADDCFG)
DOB_Q0_ISNS: C10027.1, R10037.1, U10017.6 (ISNS)
DOB_Q0_READY_N: R10036.1, U10017.1 (READY)
DOB_Q1_ADDRESS: R10038.1, U10022.30 (ADDCFG)
DOB_Q1_ISNS: C10036.1, R10040.1, U10022.6 (ISNS)
DOB_Q1_READY_N: R10039.1, U10022.1 (READY)
DOB_SCLK_FIELD: R10030.1, U10016.15 (OUTA), U10017.9 (SCLK), U10022.9 (SCLK)
DOB_SCLK_HOST: J10006.7, R10026.1, U10016.2 (INA)
DOB_SDI_FIELD: R10031.1, U10016.14 (OUTB), U10017.8 (SDI), U10022.8 (SDI)
DOB_SDI_HOST: J10006.8, R10027.1, U10016.3 (INB)
DOB_SDO_FIELD: R10033.1, U10016.11 (INE), U10017.7 (SDO), U10022.7 (SDO)
DOB_SDO_HOST: J10006.10, U10016.6 (OUTE)
FIELD_A_0V: C10004.2, C10005.2, C10006.2, C10007.2, C10008.2, C10009.2, C10010.2, C10011.2, C10012.2, C10013.2, C10014.2, C10015.2, C10016.2, C10017.2, C10018.2, C10019.2, C10020.2, C10021.2, C10022.2, J10001.9, J10001.10, J10001.11, J10001.12, J10003.2, R10009.2, R10010.2, R10011.2, R10013.2, R10015.2, R10016.2, R10017.2, R10018.2, R10019.2, R10020.2, U10003.9 (GND2), U10004.5 (GND), U10004.21 (GND), U10004.28 (DSPI), U10004.29 (REG_EN), U10004.41 (EP_GND), U10009.5 (GND), U10009.21 (GND), U10009.28 (DSPI), U10009.29 (REG_EN), U10009.41 (EP_GND)
FIELD_A_24V: C10008.1, C10009.1, C10017.1, C10018.1, J10003.1, U10004.14 (VS), U10004.15 (VS), U10004.16 (VS), U10004.17 (VS), U10004.34 (VS), U10004.35 (VS), U10004.36 (VS), U10004.37 (VS), U10009.14 (VS), U10009.15 (VS), U10009.16 (VS), U10009.17 (VS), U10009.34 (VS), U10009.35 (VS), U10009.36 (VS), U10009.37 (VS)
FIELD_B_0V: C10026.2, C10027.2, C10028.2, C10029.2, C10030.2, C10031.2, C10032.2, C10033.2, C10034.2, C10035.2, C10036.2, C10037.2, C10038.2, C10039.2, C10040.2, C10041.2, C10042.2, C10043.2, C10044.2, J10002.9, J10002.10, J10002.11, J10002.12, J10004.2, R10029.2, R10030.2, R10031.2, R10033.2, R10035.2, R10036.2, R10037.2, R10038.2, R10039.2, R10040.2, U10016.9 (GND2), U10017.5 (GND), U10017.21 (GND), U10017.28 (DSPI), U10017.29 (REG_EN), U10017.41 (EP_GND), U10022.5 (GND), U10022.21 (GND), U10022.28 (DSPI), U10022.29 (REG_EN), U10022.41 (EP_GND)
FIELD_B_24V: C10030.1, C10031.1, C10039.1, C10040.1, J10004.1, U10017.14 (VS), U10017.15 (VS), U10017.16 (VS), U10017.17 (VS), U10017.34 (VS), U10017.35 (VS), U10017.36 (VS), U10017.37 (VS), U10022.14 (VS), U10022.15 (VS), U10022.16 (VS), U10022.17 (VS), U10022.34 (VS), U10022.35 (VS), U10022.36 (VS), U10022.37 (VS)
IO_3V3: C10001.1, C10002.1, C10003.1, C10023.1, C10024.1, C10025.1, J10005.1, J10006.1, R10008.2, R10028.2, U10001.2 (D), U10001.7 (PRE_N), U10001.8 (VCC), U10002.14 (VCC), U10003.1 (VCC1), U10014.2 (D), U10014.7 (PRE_N), U10014.8 (VCC), U10015.14 (VCC), U10016.1 (VCC1)
LOGIC_GND: C10001.2, C10002.2, C10003.2, C10023.2, C10024.2, C10025.2, J10005.2, J10006.2, R10001.2, R10002.2, R10003.2, R10004.2, R10005.2, R10006.2, R10007.2, R10021.2, R10022.2, R10023.2, R10024.2, R10025.2, R10026.2, R10027.2, U10001.4 (GND), U10002.7 (GND), U10002.12 (4A), U10002.13 (4B), U10003.8 (GND1), U10014.4 (GND), U10015.7 (GND), U10015.12 (4A), U10015.13 (4B), U10016.8 (GND1)
OUT_PERMIT_A: J10005.3, R10001.1, U10002.1 (1A), U10002.4 (2A)
OUT_PERMIT_B: J10006.3, R10021.1, U10015.1 (1A), U10015.4 (2A)

Notes on the sheet:
16 SOURCING DO / FOUR TPS274C65AS / TWO ISOLATED SPI DOMAINS / HARDWIRED DROP + REARM LATCH 0.5A/channel,2A/quad. POR ILIM=1.25A is NOT the 0.72A commissioning setting: verified configuration is required before CARD_EN. Field VDD must derive from same VS; parent supplies/controllers/terminals and s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
