DeadlySIn777/Controller/hardware/motherboard_esp_socket/motherboard_esp_socket.kicad_sch

## KiCad design hardware/motherboard_esp_socket/motherboard_esp_socket.kicad_sch (2026-10-18)

Schematic: motherboard_esp_socket.kicad_sch

Parts:
B16001: PARENT CORE5/GND/READONLY TX
C16001, C16003, C16005, C16007: 100nF; C_0603_1608Metric; MPN GRM188R72A104KA35D
C16002, C16004: 1000nF; C_0603_1608Metric; MPN GRM188R71H105KA12D
C16006: 10000nF; C_0805_2012Metric; MPN GRM21BR71A106MA73L
J16001, J16002: 61302211821; Wurth_61302211821_1x22_P2.54; MPN 61302211821
R16001, R16004, R16005, R16006, R16007, R16008: 10000R; R_0603_1608Metric; MPN CRCW060310K0FKEA
R16002, R16010: 100000R; R_0603_1608Metric; MPN CRCW0603100KFKEA
R16003: 20000R; R_0603_1608Metric; MPN TNPW060320K0BEEA
R16009, R16011: 33R; R_0603_1608Metric; MPN CRCW060333R0FKEA
U16001: TPS2553DBVR-1; SOT-23-6; MPN TPS2553DBVR-1
U16002: LM66100DCKR; SOT-363_SC-70-6; MPN LM66100DCKR
U16003: SN74LVC1G17DBVR; SOT-23-5; MPN SN74LVC1G17DBVR

Connections:
COMPUTE_SERVICE_TX: B16001.3, R16009.1
CORE_5V: B16001.1, C16001.1, C16002.1, R16001.1, U16001.1 (IN)
ESP_HEADER_5V: C16005.1, C16006.1, J16001.21, R16005.1, U16002.3 (CE), U16002.6 (VOUT)
ESP_ILIM: R16003.1, U16001.5 (ILIM)
ESP_LIMITED_5V: C16003.1, C16004.1, R16004.1, U16001.6 (OUT), U16002.1 (VIN)
ESP_LIMIT_FAULT_N: J16001.4, R16006.1, U16001.4 (FAULT_N)
ESP_MODULE_3V3: C16007.1, J16001.1, J16001.2, R16006.2, R16007.2, R16008.1, U16003.5 (VCC)
ESP_REVERSE_GATE_STATUS: J16001.5, R16007.1, U16002.5 (ST)
ESP_SERVICE_RX: J16001.11, R16011.2
ESP_SERVICE_RX_SOURCE: R16011.1, U16003.4 (Y)
ESP_SERVICE_TX_BUFFER: R16009.2, R16010.1, U16003.2 (A)
ESP_SUPPLY_EN: R16001.2, R16002.1, U16001.3 (EN)
LOGIC_GND: B16001.2, C16001.2, C16002.2, C16003.2, C16004.2, C16005.2, C16006.2, C16007.2, J16001.22, J16002.1, J16002.21, J16002.22, R16002.2, R16003.2, R16004.2, R16005.2, R16008.2, R16010.2, U16001.2 (GND), U16002.2 (GND), U16003.3 (GND)

Notes on the sheet:
PURCHASED ESP32-S3 DEVKITC-1 N8R8 V1.1; TWO ACTUAL SOCKETS; READONLY UART1 GPIO18. No machine-output, reset or motion authority. CE=VOUT reverse blocking; ESP3V3 comes only from purchased board. Manufacturer USB/header/3V3 power modes mutually exclusive. Power/RF/mechanical/target validation remain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
