DeadlySIn777/Controller/hardware/motherboard_io3_upgrade/motherboard_io3_upgrade.kicad_sch

## KiCad design hardware/motherboard_io3_upgrade/motherboard_io3_upgrade.kicad_sch (2026-10-18)

Schematic: motherboard_io3_upgrade.kicad_sch

Parts:
B2001: MC POWER REVIEW BOUNDARY
C2001, C2004: 10uF 25V X7R 10%; C_1206_3216Metric; MPN C3216X7R1E106K160AB
C2002, C2005: 22uF 10V X7S 20%; C_0805_2012Metric; MPN C2012X7S1A226M125AC
C2003, C2006: 6.8nF 50V C0G 5%; C_0603_1608Metric; MPN GRM1885C1H682JA01D
C2007, C2008, C2009, C2010: 100nF X7R 100V 10%; C_0603_1608Metric; MPN GRM188R72A104KA35D
L2001: 2.2uH; XGL4020; MPN XGL4020-222MEC
L2002: 1uH; XGL4020; MPN XGL4020-102MEC
R2001: 76.8k 1%; R_0603_1608Metric; MPN CRCW060376K8FKEA
R2002, R2006, R2103, R2105: 10k 1%; R_0603_1608Metric; MPN CRCW060310K0FKEA
R2003, R2007: 100k 1%; R_0603_1608Metric; MPN CRCW0603100KFKEA
R2005: 0ohm MODE tied VIN; R_0603_1608Metric; MPN CRCW06030000Z0EA
R2008: 2.55k 0.1% 10ppm; R_0603_1608Metric; MPN TNPW06032K55BYEA
R2021: 87.9k 0.01% 5ppm; R_0603_1608Metric; MPN PLT0603Z8792LST1
R2027, R2035, R2067, R2075: 10k 0.01% 5ppm; R_0603_1608Metric; MPN PLT0603Z1002LST1
R2029: 92.1k 0.01% 5ppm; R_0603_1608Metric; MPN PLT0603Z9212LST1
R2041: 1.07k 0.01% 5ppm; R_0603_1608Metric; MPN PLT0603Z1071LST1
R2042: 261 0.01% 5ppm; R_0603_1608Metric; MPN PLT0603Z2610LST1
R2047, R2055: 1k 0.01% 5ppm; R_0603_1608Metric; MPN PLT0603Z1001LST1
R2049: 1.15k 0.01% 5ppm; R_0603_1608Metric; MPN PLT0603Z1151LST1
R2050: 316 0.01% 5ppm; R_0603_1608Metric; MPN PLT0603Z3160LST1
R2051: 4.02 1% 100ppm; R_0603_1608Metric; MPN CRCW06034R02FKEA
R2061: 54.5k 0.01% 5ppm; R_0603_1608Metric; MPN PLT0603Z5452LST1
R2069: 57.5k 0.01% 5ppm; R_0603_1608Metric; MPN PLT0603Z5752LST1
R2101, R2102: 3.3k 1%; R_0603_1608Metric; MPN CRCW06033K30FKEA
R2104: 6.8k 1%; R_0603_1608Metric; MPN CRCW06036K80FKEA
R2106: 47k 1%; R_0603_1608Metric; MPN CRCW060347K0FKEA
R2107: 470k 1%; R_0603_1608Metric; MPN CRCW0603470KFKEA
R2108: 4.7k 1%; R_0603_1608Metric; MPN CRCW06034K70FKEA
R18001: 15mohm 1% 50ppm 1W; KRL2012_Susumu; MPN KRL2012E-C-R015-F-T5
R18002: 11.5k 0.1% 10ppm; R_0603_1608Metric; MPN TNPW060311K5BYEA
U2001: TPS62901RPJR; TPS62901_RPJ9; MPN TPS62901RPJR
U2002: TPS62902RPJR; TPS62901_RPJ9; MPN TPS62902RPJR
U2003, U2004, U2005: LTC2962HUD#TRPBF; LTC2962_UD16; MPN LTC2962HUD#PBF
U2006: SN74LVC1G17DBVR; SOT-23-5; MPN SN74LVC1G17DBVR

Connections:
CORE_1V2: B2001.3, C2002.1, L2001.2, R2003.1, R2041.1, R2049.1, U2001.3 (VOS)
CORE_1V2_EN: R2002.1, R2102.2, R2103.1, U2001.5 (EN)
CORE_1V2_MODE: R2001.1, U2001.7 (MODE/S-CONF)
CORE_1V2_OV_SENSE: R2051.2, R2055.1, U2004.15 (V2)
CORE_1V2_PG_OD: B2001.7, U2001.1 (PG)
CORE_1V2_SS: C2003.1, U2001.8 (SS/TR)
CORE_1V2_SW: L2001.1, U2001.2 (SW)
CORE_1V2_UV_SENSE: R2042.2, R2047.1, U2004.16 (V1)
CORE_5V: B2001.1, C2001.1, C2004.1, C2007.1, C2008.1, C2009.1, R2005.2, R2021.1, R2029.1, R2101.1, R2104.1, R2106.1, U2001.6 (VIN), U2002.6 (VIN), U2003.1 (RDIS), U2003.2 (MR), U2003.4 (VCC), U2003.10 (RT), U2003.13 (V4), U2003.14 (V3), U2004.1 (RDIS), U2004.4 (VCC), U2004.10 (RT), U2004.13 (V4), U2004.14 (V3), U2005.1 (RDIS), U2005.4 (VCC), U2005.10 (RT), U2005.13 (V4), U2005.14 (V3)
CORE_5V_OV_SENSE: R2029.2, R2035.1, U2003.15 (V2)
CORE_5V_UV_SENSE: R2021.2, R2027.1, U2003.16 (V1)
FPGA_CRESET_N: B2001.5, R2108.1, U2006.4 (Y)
IO_3V3: B2001.4, R2007.1, R2061.1, R2069.1, R18001.2, U2006.5 (VCC)
IO_3V3_EN: R2006.1, R2104.2, R2105.1, U2002.5 (EN), U2004.12 (RST), U2005.2 (MR)
IO_3V3_MODE: R2005.1, U2002.7 (MODE/S-CONF)
IO_3V3_OV_SENSE: R2069.2, R2075.1, U2005.15 (V2)
IO_3V3_PG_OD: B2001.8, U2002.1 (PG)
IO_3V3_REG_LOCAL: C2005.1, C2010.1, L2002.2, R18001.1, R18002.1, U2002.3 (VOS)
IO_3V3_SS: C2006.1, U2002.8 (SS/TR)
IO_3V3_SW: L2002.1, U2002.2 (SW)
IO_3V3_UV_SENSE: R2061.2, R2067.1, U2005.16 (V1)
IO_3V3_VSET: R2008.1, R18002.2, U2002.9 (FB/VSET)
LOGIC_GND: B2001.2, B2001.9, C2001.2, C2002.2, C2003.2, C2004.2, C2005.2, C2006.2, C2007.2, C2008.2, C2009.2, C2010.2, R2001.2, R2002.2, R2003.2, R2006.2, R2007.2, R2008.2, R2027.2, R2035.2, R2047.2, R2055.2, R2067.2, R2075.2, R2103.2, R2105.2, R2107.2, R2108.2, U2001.4 (GND), U2001.9 (FB/VSET), U2002.4 (GND), U2003.3 (DVCC), U2003.7 (PG2), U2003.11 (GND), U2003.17 (EP), U2004.3 (DVCC), U2004.7 (PG2), U2004.11 (GND), U2004.17 (EP), U2005.3 (DVCC), U2005.7 (PG2), U2005.11 (GND), U2005.17 (EP), U2006.3 (GND)
MC_RAILS_OK_5V: B2001.6, R2106.2, R2107.1, U2005.12 (RST), U2006.2 (A)
MC_SEQ_5V_OK: R2101.2, R2102.1, U2003.12 (RST), U2004.2 (MR)
MC_SEQ_OV2_1: R2049.2, R2050.1
MC_SEQ_OV2_2: R2050.2, R2051.1
MC_SEQ_REF1: U2003.5 (REF), U2003.6 (PG1), U2003.8 (PG3), U2003.9 (PG4)
MC_SEQ_REF2: U2004.5 (REF), U2004.6 (PG1), U2004.8 (PG3), U2004.9 (PG4)
MC_SEQ_REF3: U2005.5 (REF), U2005.6 (PG1), U2005.8 (PG3), U2005.9 (PG4)
MC_SEQ_UV2_1: R2041.2, R2042.1

Notes on the sheet:
CORE_1V2: 1.2 V / 0.8 A reservation; 1 MHz forced PWM
IO_3V3: 3.3 V / 0.15 A reservation; 2.5 MHz forced PWM
MC LOCAL POWER - IS-2 HARDWARE PROPOSAL / NOT MANUFACTURING READY
5 V window releases core; core window releases IO; IO window releases FPGA reset. Each supervisor release: 160-240 ms. Raw MC_RAILS_OK_5V is not a 3.3 V signal. FPGA_CRESET_N is the buffered rails-good term; combine other reset requests upstream. Regulator PG pins are diagnostic only; no PG-to-EN c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
Actual rail limits retained: 5 V 4.85-5.15; T20 core 1.15-1.25; IO 3.20-3.40 V. Core thresholds include initial/temp plus 400ppm drift; historical tight ledger is distinct. IO uses 2.5 MHz because existing FPGA decoupling exceeds the 1 MHz capacitance limit. Proposed MC slot: 0.50 A steady / 0.80 A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
