DeadlySIn777/Controller/hardware/motherboard_motor_power/motherboard_motor_power.kicad_sch

## KiCad design hardware/motherboard_motor_power/motherboard_motor_power.kicad_sch (2026-10-18)

Schematic: motherboard_motor_power.kicad_sch

Parts:
B9001, B9002: INTERNAL REVIEW BOUNDARY
C9001, C9002, C9003, C9004, C9005, C9006, C9007, C9008, C9009: 100nF 100V X7R 10%; C_0603_1608Metric; MPN GRM188R72A104KA35D
R9001, R9011: 87900R 0.01% 5ppm; R_0603_1608Metric; MPN PLT0603Z8792LST1
R9002, R9004, R9006, R9008, R9012, R9014, R9016, R9018, R9022, R9024, R9026, R9028, R9032, R9034, R9036, R9038: 10000R 0.01% 5ppm; R_0603_1608Metric; MPN PLT0603Z1002LST1
R9003, R9013: 92100R 0.01% 5ppm; R_0603_1608Metric; MPN PLT0603Z9212LST1
R9005, R9015: 54500R 0.01% 5ppm; R_0603_1608Metric; MPN PLT0603Z5452LST1
R9007, R9017: 57500R 0.01% 5ppm; R_0603_1608Metric; MPN PLT0603Z5752LST1
R9009, R9019, R9029, R9039, R9041, R9042, R9043, R9044: 10000R 1% 100ppm; R_0603_1608Metric; MPN CRCW060310K0FKEA
R9010, R9020, R9030, R9040: 100000R 1% 100ppm; R_0603_1608Metric; MPN CRCW0603100KFKEA
R9021, R9031: 86700R 0.01% 5ppm; R_0603_1608Metric; MPN PLT0603Z8672LST1
R9023, R9033: 93100R 0.01% 5ppm; R_0603_1608Metric; MPN PLT0603Z9312LST1
R9025, R9035: 355000R 0.01% 5ppm; R_0603_1608Metric; MPN PLT0603Z3553LST1
R9027, R9037: 580000R 0.01% 5ppm; R_0603_1608Metric; MPN PLT0603Z5803LST1
R9045, R9046: 1000R 1% 100ppm; R_0603_1608Metric; MPN CRCW06031K00FKEA
U9001, U9002, U9003, U9004: LTC2962HUD#PBF; LTC2962_UD16; MPN LTC2962HUD#PBF
U9005, U9006: SN74LVC1G17DBVR; SOT-23-5; MPN SN74LVC1G17DBVR
U9007: ISO7720FDWR; ISO7720_DW16_TI_HV; MPN ISO7720FDWR
U9008: SN74LVC2G08DCUR; VSSOP-8_2.3x2mm_P0.5mm; MPN SN74LVC2G08DCUR

Connections:
AUX_5V_A: B9001.8, R9021.1, R9023.1
AUX_5V_B: B9001.9, R9031.1, R9033.1
AUX_24V_A: B9001.10, R9025.1, R9027.1
AUX_24V_B: B9001.11, R9035.1, R9037.1
CORE_5V: B9001.1, C9001.1, C9002.1, R9009.1, R9019.1, U9001.1 (RDIS), U9001.2 (MR), U9001.4 (VCC), U9001.10 (RT), U9002.1 (RDIS), U9002.2 (MR), U9002.4 (VCC), U9002.10 (RT)
FIELD_5V: B9001.6, C9003.1, C9004.1, C9007.1, R9029.1, R9039.1, U9003.1 (RDIS), U9003.2 (MR), U9003.4 (VCC), U9003.10 (RT), U9004.1 (RDIS), U9004.2 (MR), U9004.4 (VCC), U9004.10 (RT), U9007.3 (VCC1)
FIELD_GND: B9001.7, C9003.2, C9004.2, C9007.2, R9022.2, R9024.2, R9026.2, R9028.2, R9030.2, R9032.2, R9034.2, R9036.2, R9038.2, R9040.2, U9003.3 (DVCC), U9003.7 (PG2), U9003.9 (PG4), U9003.11 (GND), U9003.17 (EP), U9004.3 (DVCC), U9004.7 (PG2), U9004.9 (PG4), U9004.11 (GND), U9004.17 (EP), U9007.1 (GND1), U9007.7 (GND1)
IO_3V3: B9001.2, C9005.1, C9006.1, C9008.1, C9009.1, R9005.1, R9007.1, R9015.1, R9017.1, U9005.5 (VCC), U9006.5 (VCC), U9007.14 (VCC2), U9008.8 (VCC)
LOGIC_GND: B9001.3, C9001.2, C9002.2, C9005.2, C9006.2, C9008.2, C9009.2, R9002.2, R9004.2, R9006.2, R9008.2, R9010.2, R9012.2, R9014.2, R9016.2, R9018.2, R9020.2, R9041.2, R9042.2, R9043.2, R9044.2, R9045.2, R9046.2, U9001.3 (DVCC), U9001.7 (PG2), U9001.9 (PG4), U9001.11 (GND), U9001.17 (EP), U9002.3 (DVCC), U9002.7 (PG2), U9002.9 (PG4), U9002.11 (GND), U9002.17 (EP), U9005.3 (GND), U9006.3 (GND), U9007.9 (GND2), U9007.16 (GND2), U9008.4 (GND)
MOTOR_5V_A: B9001.4, R9001.1, R9003.1
MOTOR_5V_B: B9001.5, R9011.1, R9013.1
MOTOR_FIELD_HEALTH_A_ISOLATED: B9002.5, R9043.1, U9007.13 (OUTA), U9008.2 (1B)
MOTOR_FIELD_HEALTH_A_RAW: R9029.2, R9030.1, U9003.12 (RST), U9007.4 (INA)
MOTOR_FIELD_HEALTH_B_ISOLATED: B9002.6, R9044.1, U9007.12 (OUTB), U9008.6 (2B)
MOTOR_FIELD_HEALTH_B_RAW: R9039.2, R9040.1, U9004.12 (RST), U9007.5 (INB)
MOTOR_LOGIC_HEALTH_A: B9002.3, R9041.1, U9005.4 (Y), U9008.1 (1A)
MOTOR_LOGIC_HEALTH_A_RAW: R9009.2, R9010.1, U9001.12 (RST), U9005.2 (A)
MOTOR_LOGIC_HEALTH_B: B9002.4, R9042.1, U9006.4 (Y), U9008.5 (2A)
MOTOR_LOGIC_HEALTH_B_RAW: R9019.2, R9020.1, U9002.12 (RST), U9006.2 (A)
MOTOR_POWER_OK_A_QUALIFIED: B9002.1, R9045.1, U9008.7 (1Y)
MOTOR_POWER_OK_B_QUALIFIED: B9002.2, R9046.1, U9008.3 (2Y)
MOTOR_PWR_FIELD_A_0_OV: R9023.2, R9024.1, U9003.15 (V2)
MOTOR_PWR_FIELD_A_0_UV: R9021.2, R9022.1, U9003.16 (V1)
MOTOR_PWR_FIELD_A_1_OV: R9027.2, R9028.1, U9003.13 (V4)
MOTOR_PWR_FIELD_A_1_UV: R9025.2, R9026.1, U9003.14 (V3)
MOTOR_PWR_FIELD_B_0_OV: R9033.2, R9034.1, U9004.15 (V2)
MOTOR_PWR_FIELD_B_0_UV: R9031.2, R9032.1, U9004.16 (V1)
MOTOR_PWR_FIELD_B_1_OV: R9037.2, R9038.1, U9004.13 (V4)
MOTOR_PWR_FIELD_B_1_UV: R9035.2, R9036.1, U9004.14 (V3)
MOTOR_PWR_LOGIC_A_0_OV: R9003.2, R9004.1, U9001.15 (V2)
MOTOR_PWR_LOGIC_A_0_UV: R9001.2, R9002.1, U9001.16 (V1)
MOTOR_PWR_LOGIC_A_1_OV: R9007.2, R9008.1, U9001.13 (V4)
MOTOR_PWR_LOGIC_A_1_UV: R9005.2, R9006.1, U9001.14 (V3)
MOTOR_PWR_LOGIC_B_0_OV: R9013.2, R9014.1, U9002.15 (V2)
MOTOR_PWR_LOGIC_B_0_UV: R9011.2, R9012.1, U9002.16 (V1)
MOTOR_PWR_LOGIC_B_1_OV: R9017.2, R9018.1, U9002.13 (V4)
MOTOR_PWR_LOGIC_B_1_UV: R9015.2, R9016.1, U9002.14 (V3)
MOTOR_PWR_REF_FIELD_A: U9003.5 (REF), U9003.6 (PG1), U9003.8 (PG3)
MOTOR_PWR_REF_FIELD_B: U9004.5 (REF), U9004.6 (PG1), U9004.8 (PG3)
MOTOR_PWR_REF_LOGIC_A: U9001.5 (REF), U9001.6 (PG1), U9001.8 (PG3)
MOTOR_PWR_REF_LOGIC_B: U9002.5 (REF), U9002.6 (PG1), U9002.8 (PG3)

Notes on the sheet:
MOTOR POWER HEALTH / ONE MOTHERBOARD / SOURCE CANDIDATE r0.1
Four actual voltage-window monitors; FIELD/LOGIC remain isolated; no supply or limiter created here.
Health = receiving 5V and 3.3V valid AND isolated AUX5/AUX24 valid; no FPGA/software bypass.
LTC fault40us bound requires10% overdrive. ISO power1.7–2.25V undetermined. Physical brownout qualification remains open.
AUX24 inherited18–30V requirement retained; current guaranteed static arming screen only19–29V.
