DeadlySIn777/Controller/hardware/motherboard_power_entry/motherboard_power_entry.kicad_sch

## KiCad design hardware/motherboard_power_entry/motherboard_power_entry.kicad_sch (2026-10-18)

Schematic: motherboard_power_entry.kicad_sch

Parts:
B11001, B11002: INTERNAL SOURCE BOUNDARY
C11001, C11005, C11009, C11047, C11048, C11049, C11050, C11074, C11076: 2.2uF 100V X7S; C_1206_3216Metric; MPN CGA5L3X7S2A225K160AB
C11002, C11006, C11010: 100nF 5% C0G; C_1206_3216Metric; MPN C3216C0G2A104J160AC
C11003, C11004, C11007, C11008, C11011, C11012, C11069, C11070, C11072, C11073: 1uF 100V X7R; C_1206_3216Metric; MPN GRM31CR72A105KA01L
C11013, C11014, C11015, C11016, C11030, C11031, C11032, C11033: 4.7uF100V X7S 10% 1210; C_1210_3225Metric; MPN CGA6M3X7S2A475K200AE
C11017, C11018, C11034, C11035: 10nF100V X7R; C_0603_1608Metric; MPN GRM188R72A103KA01D
C11019, C11020, C11021, C11036, C11037, C11038: 47uF10V X7S 20% 1210; C_1210_3225Metric; MPN CGA6P1X7S1A476M250AC
C11022, C11039: 47nF50V X7R; C_0603_1608Metric; MPN C1608X7R1H473K080AA
C11023, C11040: 4.7uF16V X7R; C_0805_2012Metric; MPN C2012X7R1C475K125AB
C11024, C11041: 100nF100V X7R; C_0603_1608Metric; MPN GRM188R72A104KA35D
C11025, C11042: 22nF5% C0G; C_0805_2012Metric; MPN C2012C0G1H223J125AA
C11026, C11043: 330pF5% C0G; C_0603_1608Metric; MPN GRM1885C1H331JA01D
C11027, C11028, C11029, C11044, C11045, C11046, C11088: 330uF16V 20% polymer; OSCON_C10L_Panasonic; MPN 16SVPG330M
C11051, C11058, C11060, C11063, C11064, C11066, C11078, C11079, C11080, C11081, C11083, C11084, C11086, C11087: 100nF 100V X7R; C_0603_1608Metric; MPN GRM188R72A104KA35D
C11052, C11056: 100nF 16V X7R; C_0402_1005Metric; MPN GCM155R71C104KA55D
C11053, C11057, C11059, C11062, C11065, C11067: 1uF 16V X7R; C_0603_1608Metric; MPN 885012206052
C11054, C11055, C11075, C11077: 22uF 10V X7R; C_1206_3216Metric; MPN GCM31CR71A226KE02L
C11061: 4.7uF 16V X7R; C_0805_2012Metric; MPN C2012X7R1C475K125AB
C11068, C11071: 10nF 100V C0G; C_0805_2012Metric; MPN C2012C0G2A103J125AA
C11082, C11085: 1nF 5% C0G; C_0603_1608Metric; MPN C0603C102J5GACTU
D11001, D11002, D11003: SMCJ30CA; D_SMC; MPN SMCJ30CA
F11001: Keystone3568 / 0997005.WXN; Keystone_3568_M55; MPN 3568
F11002, F11003: Keystone3568 / 099707.5WXN; Keystone_3568_M55; MPN 3568
J11001, J11002, J11003, J11004, J11005, J11006: 1757242; PhoenixContact_MSTBA_2,5_2-G-5,08_1x02_P5.08mm_Horizontal; MPN 1757242
L11001: 4.7uH 20%; XAL1010_Coilcraft; MPN XAL1010-472MED
L11002: 4.7uH 20%; L_Coilcraft_XAL7070-XXX; MPN XAL7070-472MEC
L11003: 22uH / 20%; LPS6235_Coilcraft; MPN LPS6235-223MRC
Q11001, Q11002, Q11003: BSS138P,215; SOT-23; MPN BSS138P,215
R11001, R11008, R11015: 887000R 0.1%; R_0805_2012Metric; MPN TNPW0805887KBEEA
R11002, R11009, R11016: 29400R 0.1%; R_0603_1608Metric; MPN TNPW060329K4BEEA
R11003, R11010, R11017: 34000R 0.1%; R_0603_1608Metric; MPN TNPW060334K0BEEA
R11004: 4020R 0.1%; R_0603_1608Metric; MPN TNPW06034K02BEEA
R11005, R11012, R11019: 140000R 0.1%; R_0603_1608Metric; MPN TNPW0603140KBEEA
R11006, R11007, R11013, R11014, R11020, R11021: 10000R 0.1%; R_0603_1608Metric; MPN TNPW060310K0BEEA
R11011, R11018: 3000R 0.1%; R_0603_1608Metric; MPN TNPW06033K00BEEA
R11022: 5mOhm 1% 1.5W; KRL3216_LongSide_Susumu; MPN KRL3216D-C-R005-F-T1
R11023, R11031: 24.9k1%; R_0603_1608Metric; MPN CRCW060324K9FKEA
R11024, R11032: 49.9k0.1%; R_0603_1608Metric; MPN TNPW060349K9BEEA
R11025, R11033: 29.4k1%; R_0603_1608Metric; MPN CRCW060329K4FKEA
R11026, R11034: 9.53k1%; R_0603_1608Metric; MPN CRCW06039K53FKEA
R11027, R11035: 100k0.1%; R_0603_1608Metric; MPN TNPW0603100KBEEA
R11028, R11036: 10k0.1%; R_0603_1608Metric; MPN TNPW060310K0BEEA
R11029, R11037: 100k1%; R_0603_1608Metric; MPN CRCW0603100KFKEA
R11030: 6mOhm 1% 1.5W; KRL3216_LongSide_Susumu; MPN KRL3216D-C-R006-F-T1
R11038, R11041: 100k 1%; R_0603_1608Metric; MPN CRCW0603100KFKEA
R11039, R11040: 10k 1%; R_0603_1608Metric; MPN CRCW060310K0FKEA
R11042, R11043, R11045, R11046, R11049, R11051, R11054, R11058, R11062, R11064, R11065, R11076, R11080: 10000R 1%; R_0603_1608Metric; MPN CRCW060310K0FKEA
R11044, R11047: 330R 1%; R_0603_1608Metric; MPN CRCW0603330RFKEA
R11048, R11052, R11055, R11059, R11063, R11066, R11068, R11070, R11072, R11075, R11079: 100000R 1%; R_0603_1608Metric; MPN CRCW0603100KFKEA
R11050, R11053: 110000R 1%; R_0603_1608Metric; MPN CRCW0603110KFKEA
R11056: 26700R 0.1%; R_0603_1608Metric; MPN TNPW060326K7BEEA
R11057, R11061: 1e+06R 1%; R_0603_1608Metric; MPN CRCW06031M00FKEA
R11060: 44200R 0.1%; R_0603_1608Metric; MPN TNPW060344K2BEEA
R11067, R11069, R11071, R11073: 120R 1%; R_0603_1608Metric; MPN CRCW0603120RFKEA
R11074, R11077, R11078, R11081: 1000R 1%; R_0603_1608Metric; MPN CRCW06031K00FKEA
U11001, U11003, U11005: CSD19537Q3T; CSD19537Q3_TI; MPN CSD19537Q3T
U11002, U11004, U11006: TPS26630RGER; Texas_RGE0024H_VQFN-24-1EP_4x4mm_P0.5mm_EP2.7x2.7mm; MPN TPS26630RGER
U11007: LM706A0RRXR; LM70660_RRX29_TI; MPN LM706A0RRXR
U11008: LM70660RRXR; LM70660_RRX29_TI; MPN LM70660RRXR
U11009: LMR36506R5RPER / FIXED 5V; LMR36506_RPE9_TI; MPN LMR36506R5RPER
U11010, U11011, U11012: TPS22990DMLR; TPS22990_DML10_TI; MPN TPS22990DMLR
U11013, U11014: TPS2553DBVR-1; SOT-23-6; MPN TPS2553DBVR-1
U11015, U11016: TPS26624DRCR; TPS2662_DRC10_TI; MPN TPS26624DRCR
U11017, U11018: TPS7A1633DGNR; TPS7A16_DGN8_TI; MPN TPS7A1633DGNR
U11019, U11025: 74LVC2G04GW,125; SOT-363_SC-70-6; MPN 74LVC2G04GW,125
U11020, U11026: 74LVC2G07GW,125; SOT-363_SC-70-6; MPN 74LVC2G07GW,125
U11021, U11022, U11023, U11024, U11027, U11028, U11029, U11030: TLP3640A(TPL,E; TLP3640A_SO4_11-3C1; MPN TLP3640A(TPL,E
U11031, U11033: 74AHCT1G17GVH; SOT-23-5; MPN 74AHCT1G17GVH
U11032, U11034: SN74LVC1G74DCUR; VSSOP-8_2.3x2mm_P0.5mm; MPN SN74LVC1G74DCUR

Connections:
AUX5_A_FAULT_N: R11051.2, U11013.4 (FAULT_N)
AUX5_A_ILIM: R11050.1, U11013.5 (ILIM)
AUX5_B_FAULT_N: R11054.2, U11014.4 (FAULT_N)
AUX5_B_ILIM: R11053.1, U11014.5 (ILIM)
AUX24_A_DVDT: C11068.1, U11015.8 (DVDT)
AUX24_A_FAULT_N: R11058.2, U11015.9 (FLT_N)
AUX24_A_ILIM: R11056.1, U11015.7 (ILIM)
AUX24_A_RTN: C11068.2, R11056.2, U11015.3 (OVP), U11015.5 (RTN), U11015.11 (EP_RTN)
AUX24_A_UVLO: R11057.2, U11015.2 (UVLO)
AUX24_B_DVDT: C11071.1, U11016.8 (DVDT)
AUX24_B_FAULT_N: R11062.2, U11016.9 (FLT_N)
AUX24_B_ILIM: R11060.1, U11016.7 (ILIM)
AUX24_B_RTN: C11071.2, R11060.2, U11016.3 (OVP), U11016.5 (RTN), U11016.11 (EP_RTN)
AUX24_B_UVLO: R11061.2, U11016.2 (UVLO)
AUX_5V_A: B11002.10, C11065.1, R11052.1, U11013.6 (OUT)
AUX_5V_B: B11002.11, C11067.1, R11055.1, U11014.6 (OUT)
AUX_24V_A: B11002.12, C11070.1, R11059.1, U11015.10 (OUT)
AUX_24V_B: B11002.13, C11073.1, R11063.1, U11016.10 (OUT)
CORE_5V: B11002.4, C11019.1, C11020.1, C11021.1, C11027.1, C11028.1, C11029.1, C11062.1, C11078.1, C11079.1, C11088.1, R11022.2, R11067.1, R11069.1, U11007.6 (BIAS), U11007.12 (VOUT_SENSE), U11012.3 (VIN), U11012.4 (VBIAS), U11012.11 (EP_VIN), U11019.5 (VCC), U11020.5 (VCC)
CORE_24V_INPUT: B11001.1, F11001.1, J11001.1 (+24V)
CORE_24V_PROTECTED: B11002.1, C11004.1, C11013.1, C11014.1, C11015.1, C11016.1, C11017.1, C11018.1, C11030.1, C11031.1, C11032.1, C11033.1, C11034.1, C11035.1, R11005.1, R11027.1, R11035.1, U11002.17 (OUT), U11002.18 (OUT), U11007.1 (VIN4), U11007.2 (VIN5), U11007.3 (VIN6), U11007.27 (VIN1), U11007.28 (VIN2), U11007.29 (VIN3), U11008.1 (VIN4), U11008.2 (VIN5), U11008.3 (VIN6), U11008.27 (VIN1), U11008.28 (VIN2), U11008.29 (VIN3)
CORE_CORE_5V_PG: R11029.1, U11007.7 (PG_SYNCOUT)
CORE_CORE_BOOT: C11022.1, U11007.4 (CBOOT)
CORE_CORE_COMP: C11026.1, R11026.1, U11007.15 (EXTCOMP)
CORE_CORE_COMP_ZERO: C11025.1, R11026.2
CORE_CORE_CONFIG: R11025.1, U11007.13 (CONFIG)
CORE_CORE_FB_SELECT: R11023.1, U11007.16 (FB)
CORE_CORE_ISNS: L11001.2, R11022.1, U11007.11 (ISNS_PLUS)
CORE_CORE_RT: R11024.1, U11007.14 (RT)
CORE_CORE_SW: L11001.1, U11007.20 (SW1), U11007.21 (SW2), U11007.22 (SW3)
CORE_CORE_SW_BOOT: C11022.2, U11007.5 (SW4)
CORE_CORE_VCC: C11023.1, U11007.19 (VCC)
CORE_CORE_VDDA: C11024.1, R11023.2, U11007.8 (PFM_SYNCIN), U11007.18 (VDDA)
CORE_HEALTH_A_LED_A: R11067.2, U11021.1 (A)
CORE_HEALTH_A_LED_K: U11020.6 (1Y), U11022.2 (K)
CORE_HEALTH_A_LED_MID: U11021.2 (K), U11022.1 (A)
CORE_HEALTH_A_N: U11019.6 (1Y), U11020.1 (1A)
CORE_HEALTH_B_LED_A: R11069.2, U11023.1 (A)
CORE_HEALTH_B_LED_K: U11020.4 (2Y), U11024.2 (K)
CORE_HEALTH_B_LED_MID: U11023.2 (K), U11024.1 (A)
CORE_HEALTH_B_N: U11019.4 (2Y), U11020.3 (2A)
C_BGATE: Q11001.3 (D), U11001.4 (G), U11002.3 (BGATE)
C_DRV: Q11001.1 (G), U11002.4 (DRV)
C_DVDT: C11002.1, U11002.9 (DVDT)
C_FAULT_N: B11002.18, U11002.14 (FLT_N)
C_ILIM: R11004.1, U11002.10 (ILIM)
C_IMON: R11007.1, U11002.13 (IMON)
C_IN: C11003.1, U11001.5 (D5_8_AND_LAND), U11002.1 (IN), U11002.2 (IN)
C_OV: R11002.2, R11003.1, U11002.7 (OVP)
C_PGOOD: R11027.2, R11028.1, R11035.2, R11036.1, U11002.16 (PGOOD), U11007.9 (EN_UVLO), U11008.9 (EN_UVLO)
C_PGTH: R11005.2, R11006.1, U11002.15 (PGTH)
C_RAW: C11001.1, D11001.1, F11001.2, Q11001.2 (S), R11001.1, U11001.1 (S1), U11001.2 (S2), U11001.3 (S3), U11002.5 (IN_SYS)
C_SHDN: J11002.1 (+24V), U11002.12 (SHDN)
C_UV: R11001.2, R11002.1, U11002.6 (UVLO)
DOA_FIELD_3V3: B11002.14, C11075.1, R11064.1, U11017.1 (OUT)
DOB_FIELD_3V3: B11002.15, C11077.1, R11065.1, U11018.1 (OUT)
FA_BGATE: Q11002.3 (D), U11003.4 (G), U11004.3 (BGATE)
FA_DRV: Q11002.1 (G), U11004.4 (DRV)
FA_DVDT: C11006.1, U11004.9 (DVDT)
FA_FAULT_N: B11002.19, U11004.14 (FLT_N)
FA_ILIM: R11011.1, U11004.10 (ILIM)
FA_IMON: R11014.1, U11004.13 (IMON)
FA_IN: C11007.1, U11003.5 (D5_8_AND_LAND), U11004.1 (IN), U11004.2 (IN)
FA_OV: R11009.2, R11010.1, U11004.7 (OVP)
FA_PGOOD: R11038.2, R11039.1, U11004.16 (PGOOD), U11009.3 (EN/UVLO)
FA_PGTH: R11012.2, R11013.1, U11004.15 (PGTH)
FA_RAW: C11005.1, D11002.1, F11002.2, Q11002.2 (S), R11008.1, U11003.1 (S1), U11003.2 (S2), U11003.3 (S3), U11004.5 (IN_SYS)
FA_SHDN: J11004.1 (+24V), U11004.12 (SHDN)
FA_UV: R11008.2, R11009.1, U11004.6 (UVLO)
FB_BGATE: Q11003.3 (D), U11005.4 (G), U11006.3 (BGATE)
FB_DRV: Q11003.1 (G), U11006.4 (DRV)
FB_DVDT: C11010.1, U11006.9 (DVDT)
FB_FAULT_N: B11002.20, U11006.14 (FLT_N)
FB_ILIM: R11018.1, U11006.10 (ILIM)
FB_IMON: R11021.1, U11006.13 (IMON)
FB_IN: C11011.1, U11005.5 (D5_8_AND_LAND), U11006.1 (IN), U11006.2 (IN)
FB_OV: R11016.2, R11017.1, U11006.7 (OVP)
FB_PGOOD: B11002.21, U11006.16 (PGOOD)
FB_PGTH: R11019.2, R11020.1, U11006.15 (PGTH)
FB_RAW: C11009.1, D11003.1, F11003.2, Q11003.2 (S), R11015.1, U11005.1 (S1), U11005.2 (S2), U11005.3 (S3), U11006.5 (IN_SYS)
FB_SHDN: J11006.1 (+24V), U11006.12 (SHDN)
FB_UV: R11015.2, R11016.1, U11006.6 (UVLO)
FIELD_5V: B11002.9, C11054.1, C11055.1, C11056.1, C11064.1, C11066.1, C11080.1, C11081.1, L11003.2, R11040.1, R11041.1, R11051.1, R11054.1, R11058.1, R11062.1, R11071.1, R11073.1, U11009.8 (VOUT/BIAS), U11013.1 (IN), U11013.3 (EN), U11014.1 (IN), U11014.3 (EN), U11025.5 (VCC), U11026.5 (VCC)
FIELD_A_24V_INPUT: B11001.2, F11002.1, J11003.1 (+24V)
FIELD_A_24V_PROTECTED: B11002.2, C11008.1, C11047.1, C11048.1, C11049.1, C11050.1, C11051.1, C11069.1, C11072.1, C11074.1, R11012.1, R11038.1, R11057.1, R11061.1, U11004.17 (OUT), U11004.18 (OUT), U11009.4 (VIN), U11015.1 (IN), U11016.1 (IN), U11017.5 (EN), U11017.8 (IN)
FIELD_B_0V: B11001.6, C11009.2, C11010.2, C11011.2, C11012.2, C11076.2, C11077.2, D11003.2, J11005.2 (0V), J11006.2 (0V), R11017.2, R11018.2, R11020.2, R11021.2, R11065.2, U11006.8 (GND), U11006.25 (EP_GND), U11018.4 (GND), U11018.9 (EP_GND)
FIELD_B_24V_INPUT: B11001.3, F11003.1, J11005.1 (+24V)
FIELD_B_24V_PROTECTED: B11002.3, C11012.1, C11076.1, R11019.1, U11006.17 (OUT), U11006.18 (OUT), U11018.5 (EN), U11018.8 (IN)
FIELD_FIELD_5V_PGOOD: R11040.2, U11009.2 (PGOOD)
FIELD_FIELD_BOOT: C11052.1, U11009.6 (BOOT)
FIELD_FIELD_SW: C11052.2, L11003.1, U11009.5 (SW)
FIELD_FIELD_VCC: C11053.1, U11009.1 (RT), U11009.7 (VCC)
FIELD_GND: B11001.5, C11005.2, C11006.2, C11007.2, C11008.2, C11047.2, C11048.2, C11049.2, C11050.2, C11051.2, C11053.2, C11054.2, C11055.2, C11056.2, C11064.2, C11065.2, C11066.2, C11067.2, C11069.2, C11070.2, C11072.2, C11073.2, C11074.2, C11075.2, C11080.2, C11081.2, D11002.2, J11003.2 (0V), J11004.2 (0V), R11010.2, R11011.2, R11013.2, R11014.2, R11039.2, R11041.2, R11050.2, R11052.2, R11053.2, R11055.2, R11059.2, R11063.2, R11064.2, R11070.2, R11072.2, U11004.8 (GND), U11004.25 (EP_GND), U11009.9 (GND), U11013.2 (GND), U11014.2 (GND), U11015.6 (GND), U11016.6 (GND), U11017.4 (GND), U11017.9 (EP_GND), U11025.2 (GND), U11026.2 (GND)
FIELD_HEALTH_A_LED_A: R11071.2, U11027.1 (A)
FIELD_HEALTH_A_LED_K: U11026.6 (1Y), U11028.2 (K)
FIELD_HEALTH_A_LED_MID: U11027.2 (K), U11028.1 (A)
FIELD_HEALTH_A_N: U11025.6 (1Y), U11026.1 (1A)
FIELD_HEALTH_B_LED_A: R11073.2, U11029.1 (A)
FIELD_HEALTH_B_LED_K: U11026.4 (2Y), U11030.2 (K)
FIELD_HEALTH_B_LED_MID: U11029.2 (K), U11030.1 (A)
FIELD_HEALTH_B_N: U11025.4 (2Y), U11026.3 (2A)
IO_3V3: B11001.7, R11029.2, R11037.2, R11043.1, R11046.1, R11049.1
LOGIC_GND: B11001.4, C11001.2, C11002.2, C11003.2, C11004.2, C11013.2, C11014.2, C11015.2, C11016.2, C11017.2, C11018.2, C11019.2, C11020.2, C11021.2, C11023.2, C11024.2, C11025.2, C11026.2, C11027.2, C11028.2, C11029.2, C11030.2, C11031.2, C11032.2, C11033.2, C11034.2, C11035.2, C11036.2, C11037.2, C11038.2, C11040.2, C11041.2, C11042.2, C11043.2, C11044.2, C11045.2, C11046.2, C11057.2, C11058.2, C11059.2, C11060.2, C11061.2, C11062.2, C11063.2, C11078.2, C11079.2, C11082.2, C11083.2, C11084.2, C11085.2, C11086.2, C11087.2, C11088.2, D11001.2, J11001.2 (0V), J11002.2 (0V), R11003.2, R11004.2, R11006.2, R11007.2, R11024.2, R11025.2, R11028.2, R11032.2, R11033.2, R11036.2, R11042.2, R11044.2, R11045.2, R11047.2, R11048.2, R11066.2, R11068.2, R11075.2, R11076.2, R11077.2, R11079.2, R11080.2, R11081.2, U11002.8 (GND), U11002.25 (EP_GND), U11007.17 (AGND), U11007.23 (PGND1), U11007.24 (PGND2), U11007.25 (PGND3), U11007.26 (PGND4), U11007.30 (PGND_CONTROLLER_PAD), U11008.17 (AGND), U11008.23 (PGND1), U11008.24 (PGND2), U11008.25 (PGND3), U11008.26 (PGND4), U11008.30 (PGND_CONTROLLER_PAD), U11010.6 (GND), U11011.6 (GND), U11012.6 (GND), U11019.2 (GND), U11020.2 (GND), U11031.3 (GND), U11032.4 (GND), U11033.3 (GND), U11034.4 (GND)
MC_RAILS_OK_5V: B11001.8, R11048.1, R11066.1, R11068.1, U11012.5 (ON), U11019.1 (1A), U11019.3 (2A)
MOTION_5V_RAW: B11002.5, C11036.1, C11037.1, C11038.1, C11044.1, C11045.1, C11046.1, C11057.1, C11059.1, C11083.1, C11084.1, C11086.1, C11087.1, R11030.2, R11074.1, R11078.1, U11008.6 (BIAS), U11008.12 (VOUT_SENSE), U11010.3 (VIN), U11010.4 (VBIAS), U11010.11 (EP_VIN), U11011.3 (VIN), U11011.4 (VBIAS), U11011.11 (EP_VIN), U11031.5 (VCC), U11032.2 (D), U11032.7 (PRE_N), U11032.8 (VCC), U11033.5 (VCC), U11034.2 (D), U11034.7 (PRE_N), U11034.8 (VCC)
MOTION_CORE_5V_PG: R11037.1, U11008.7 (PG_SYNCOUT)
MOTION_CORE_BOOT: C11039.1, U11008.4 (CBOOT)
MOTION_CORE_COMP: C11043.1, R11034.1, U11008.15 (EXTCOMP)
MOTION_CORE_COMP_ZERO: C11042.1, R11034.2
MOTION_CORE_CONFIG: R11033.1, U11008.13 (CONFIG)
MOTION_CORE_FB_SELECT: R11031.1, U11008.16 (FB)
MOTION_CORE_ISNS: L11002.2, R11030.1, U11008.11 (ISNS_PLUS)
MOTION_CORE_RT: R11032.1, U11008.14 (RT)
MOTION_CORE_SW: L11002.1, U11008.20 (SW1), U11008.21 (SW2), U11008.22 (SW3)
MOTION_CORE_SW_BOOT: C11039.2, U11008.5 (SW4)
MOTION_CORE_VCC: C11040.1, U11008.19 (VCC)
MOTION_CORE_VDDA: C11041.1, R11031.2, U11008.8 (PFM_SYNCIN), U11008.18 (VDDA)
MOTOR_5V_A: B11002.6, C11058.1, R11044.1, U11010.8 (OUT), U11010.9 (OUT), U11010.10 (OUT)
MOTOR_5V_B: B11002.7, C11060.1, R11047.1, U11011.8 (OUT), U11011.9 (OUT), U11011.10 (OUT)
MOTOR_FEED_CLEAR_MID_A: U11021.4 (D), U11027.3 (D)
MOTOR_FEED_CLEAR_MID_B: U11023.4 (D), U11029.3 (D)
MOTOR_FEED_CLEAR_N_A: C11082.1, R11075.1, U11027.4 (D), U11032.6 (CLR_N)
MOTOR_FEED_CLEAR_N_B: C11085.1, R11079.1, U11029.4 (D), U11034.6 (CLR_N)
MOTOR_FEED_CLEAR_SOURCE_A: R11074.2, U11021.3 (D)
MOTOR_FEED_CLEAR_SOURCE_B: R11078.2, U11023.3 (D)
MOTOR_FEED_ON_A: R11042.1, U11010.5 (ON), U11032.5 (Q)
MOTOR_FEED_ON_B: R11045.1, U11011.5 (ON), U11034.5 (Q)
MOTOR_FEED_PG_A: B11002.16, R11043.2, U11010.7 (PG)
MOTOR_FEED_PG_B: B11002.17, R11046.2, U11011.7 (PG)
MOTOR_FEED_REARM_A: U11031.4 (Y), U11032.1 (CLK)
MOTOR_FEED_REARM_B: U11033.4 (Y), U11034.1 (CLK)
MOTOR_FIELD_HEALTH_A_RAW: B11001.9, R11070.1, U11025.1 (1A)
MOTOR_FIELD_HEALTH_B_RAW: B11001.10, R11072.1, U11025.3 (2A)
MOTOR_TX_GATE_A: B11002.22, R11077.1, U11028.4 (D)
MOTOR_TX_GATE_B: B11002.23, R11081.1, U11030.4 (D)
MOTOR_TX_GATE_CONTACT_MID_A: U11022.4 (D), U11028.3 (D)
MOTOR_TX_GATE_CONTACT_MID_B: U11024.4 (D), U11030.3 (D)
MOTOR_TX_GATE_SOURCE_A: B11001.13, U11022.3 (D)
MOTOR_TX_GATE_SOURCE_B: B11001.14, U11024.3 (D)
OPI_REARM_A: B11001.11, R11076.1, U11031.2 (A)
OPI_REARM_B: B11001.12, R11080.1, U11033.2 (A)
SBC_5V: B11002.8, C11063.1, U11012.8 (OUT), U11012.9 (OUT), U11012.10 (OUT)
SBC_RAMP_CT: C11061.1, U11012.1 (CT)
SBC_SWITCH_PG: R11049.2, U11012.7 (PG)

Notes on the sheet:
PROTECTED ENTRY / ACTUAL RAIL GENERATION / ONE MOTHERBOARD / SOURCE CANDIDATE r0.4
CORE/FIELD_A/FIELD_B entries; preserve existingFPGA1V2 andIO3 regulators, sequence and9xxx window monitors.
CORE5 bounded7A +MOTION5 6A converters; two switchedmotorfeeds; FIELD5 .6A +independentAUX limiters.
Published AUX24 overload testpoints; series raw-health photocontacts and bank-feed asynchronousclear/rearm latches.
No fabrication release; exact package/peripheral load/IRdrop andfield surge coordination require reconciliation.
