DeadlySIn777/Controller/hardware/motherboard_probe_limit_upgrade/motherboard_operator.kicad_sch

## KiCad design hardware/motherboard_probe_limit_upgrade/motherboard_operator.kicad_sch (2026-10-18)

Schematic: motherboard_operator.kicad_sch

Parts:
C14001, C14002, C14003, C14004, C14005, C14006, C14008, C14009, C14010, C14011, C14012, C14013: 10nF100V; C_0603_1608Metric; MPN GRM1885C2A103JA01D
C14007, C14014, C14015, C14016, C14017, C14018, C14019, C14020, C14022, C14024, C14026, C14028, C14030, C14032, C14034, C14036, C14038, C14040, C14042, C14045, C14047, C14050, C14052, C14054, C14055, C14056, C14057, C14058, C14060, C14061, C14062, C14063: 100nF100V; C_0603_1608Metric; MPN GRM188R72A104KA35D
C14021, C14023, C14025, C14027, C14029, C14031, C14033, C14035, C14037, C14039, C14041, C14043, C14044, C14046, C14048, C14049, C14051, C14053, C14059: 1000nF50V; C_0603_1608Metric; MPN GRM188R71H105KA12D
D14001, D14002, D14003, D14004, D14005, D14006, D14007, D14008, D14009, D14010, D14011, D14012: TPD1E10B06DPYR; TPD1E10B06_DPY2_TI; MPN TPD1E10B06DPYR
D14013, D14014: SMBJ33CA-E3/52; D_SMB; MPN SMBJ33CA-E3/52
J14001: PARENT: realparent powerdomains
J14002: PARENT: FPGA status/probe,actualconfigurationdone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
J14003: PARENT: operator terminals;exactphysicalplugs own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
J14004: PARENT: two fastprobeports
J14005: PARENT: sixlogicportpowerfeeds
R14001, R14003, R14005, R14007, R14009, R14011, R14013, R14015, R14017, R14019, R14021, R14023: 1000R1%; R_0603_1608Metric; MPN CRCW06031K00FKEA
R14002, R14004, R14006, R14008, R14010, R14012, R14014, R14016, R14018, R14020, R14022, R14024, R14028, R14030, R14033, R14035, R14038, R14040, R14043, R14045, R14048, R14050, R14053, R14055, R14060, R14061, R14066, R14067, R14077, R14078, R19401, R19402: 10000R1%; R_0603_1608Metric; MPN CRCW060310K0FKEA
R14025, R14026: 4700R1%; R_0603_1608Metric; MPN CRCW06034K70FKEA
R14027, R14032, R14037, R14042: 110000R1%; R_0603_1608Metric; MPN CRCW0603110KFKEA
R14029, R14034, R14039, R14044, R14049, R14054, R14075, R14076, R14079: 33R1%; R_0603_1608Metric; MPN CRCW060333R0FKEA
R14031, R14036, R14041, R14046, R14051, R14056, R14058, R14062, R14064, R14068, R14071, R14074, R14080: 100000R1%; R_0603_1608Metric; MPN CRCW0603100KFKEA
R14047: 221000R1%; R_0603_1608Metric; MPN CRCW0603221KFKEA
R14052, R19403, R19404: 150000R1%; R_0603_1608Metric; MPN CRCW0603150KFKEA
R14057, R14063: 2490R0.1%; R_0603_1608Metric; MPN TNPW06032K49BEEA
R14059, R14065: 3320R1%; R_0603_1608Metric; MPN CRCW06033K32FKEA
R14069, R14072: 1000R1%; R_MiniMELF_MMA-0204; MPN SMM02040C1001FB300
R14070, R14073: 562R1%; R_0603_1608Metric; MPN CRCW0603562RFKEA
R14081: 1800R1%; R_0603_1608Metric; MPN CRCW06031K80FKEA
R14082: 22R1%; R_0603_1608Metric; MPN CRCW060322R0FKEA
U14001, U14002, U14003, U14004, U14005, U14006, U14008, U14009, U14010, U14011, U14012, U14013: BAT54S,215; SOT-23; MPN BAT54S,215
U14007, U14014, U14029, U14030: SN74LVC14APWR; TSSOP-14_4.4x5mm_P0.65mm; MPN SN74LVC14APWR
U14015, U14016, U14017: SN74LVC1G17DBVR; SOT-23-5; MPN SN74LVC1G17DBVR
U14018: SN74LVC1G08DBVR; SOT-23-5; MPN SN74LVC1G08DBVR
U14019: SN74LVC2G08DCUR; VSSOP-8_2.3x2mm_P0.5mm; MPN SN74LVC2G08DCUR
U14020, U14021, U14022, U14023, U14024, U14025: TPS2553DBVR-1; SOT-23-6; MPN TPS2553DBVR-1
U14026, U14027: MAX17612AATB+T; MAX17612_T1033_ADI; MPN MAX17612AATB+T
U14028: ISO7720FDWR; SOIC-16W_7.5x10.3mm_P1.27mm; MPN ISO7720FDWR
U14031: ISO1212DBQR; ISO1212_DBQ16_TI; MPN ISO1212DBQR
U14032, U14033, U14034: SN74LV165APWR; TSSOP-16_4.4x5mm_P0.65mm; MPN SN74LV165APWR
U14035: LM4040A25IDBZR; SOT-23; MPN LM4040A25IDBZR

Connections:
DOA_FIELD_3V3: C14054.1, J14001.4, R14059.1, R14061.2, R14065.1, R14067.2, U14028.3 (VCC1)
ENC0_5V: C14022.1, C14023.1, J14005.1, R14031.1, U14020.6 (OUT)
ENC0_ILIM: R14027.1, U14020.5 (ILIM)
ENC0_POWER_EN: R14028.1, R14029.2, U14020.3 (EN)
ENC0_POWER_FAULT_N: R14030.1, U14020.4 (FAULT_N), U14029.1 (1A)
ENC0_SUPPLY_FAULT: U14029.2 (1Y), U14034.6 (H)
ENC1_5V: C14026.1, C14027.1, J14005.2, R14036.1, U14021.6 (OUT)
ENC1_ILIM: R14032.1, U14021.5 (ILIM)
ENC1_POWER_EN: R14033.1, R14034.2, U14021.3 (EN)
ENC1_POWER_FAULT_N: R14035.1, U14021.4 (FAULT_N), U14029.3 (2A)
ENC1_SUPPLY_FAULT: U14029.4 (2Y), U14034.5 (G)
ENC2_5V: C14030.1, C14031.1, J14005.3, R14041.1, U14022.6 (OUT)
ENC2_ILIM: R14037.1, U14022.5 (ILIM)
ENC2_POWER_EN: R14038.1, R14039.2, U14022.3 (EN)
ENC2_POWER_FAULT_N: R14040.1, U14022.4 (FAULT_N), U14029.5 (3A)
ENC2_SUPPLY_FAULT: U14029.6 (3Y), U14034.4 (F)
ENC3_5V: C14034.1, C14035.1, J14005.4, R14046.1, U14023.6 (OUT)
ENC3_ILIM: R14042.1, U14023.5 (ILIM)
ENC3_POWER_EN: R14043.1, R14044.2, U14023.3 (EN)
ENC3_POWER_FAULT_N: R14045.1, U14023.4 (FAULT_N), U14029.9 (4A)
ENC3_SUPPLY_FAULT: U14029.8 (4Y), U14034.3 (E)
FAST_PORTS_ENABLE: J14002.6, R14025.1, U14015.2 (A)
FAST_PORTS_EN_BUFFER: U14015.4 (Y), U14018.1 (A)
FAST_PORTS_EN_CONFIGURED: R14029.1, R14034.1, R14039.1, R14044.1, R14049.1, U14018.4 (Y), U14019.1 (1A)
FAST_SR_CHAIN1: U14032.10 (SER), U14033.9 (QH)
FAST_SR_CHAIN2: U14033.10 (SER), U14034.9 (QH)
FAST_SR_CLK: J14002.1, R14075.1, R14077.1
FAST_SR_CLK_BUFFER: R14075.2, U14032.2 (CLK), U14033.2 (CLK), U14034.2 (CLK)
FAST_SR_DATA: J14002.3, R14079.2, R14080.1
FAST_SR_DATA_SOURCE: R14079.1, U14032.9 (QH)
FAST_SR_LOAD_BUFFER: R14076.2, U14032.1 (SH_LD_N), U14033.1 (SH_LD_N), U14034.1 (SH_LD_N)
FAST_SR_LOAD_N: J14002.2, R14076.1, R14078.1
FIELD_A_24V_PROTECTED: C14044.1, C14045.1, C14046.1, C14049.1, C14050.1, C14051.1, J14001.5, R14058.1, R14064.1, U14026.1 (IN), U14027.1 (IN)
FIELD_GND: C14044.2, C14045.2, C14046.2, C14047.2, C14048.2, C14049.2, C14050.2, C14051.2, C14052.2, C14053.2, C14054.2, D14013.2, D14014.2, J14001.6, J14004.3, J14004.6, R14057.2, R14060.2, R14062.2, R14063.2, R14066.2, R14068.2, R19401.2, R19402.2, R19403.2, R19404.2, U14026.3 (OVLO), U14026.9 (GND), U14026.11 (EP_GND), U14027.3 (OVLO), U14027.9 (GND), U14027.11 (EP_GND), U14028.1 (GND1), U14028.8 (GND1), U14031.9 (FGND2), U14031.14 (FGND1)
FPGA_CDONE: J14002.8, U14017.2 (A)
FPGA_CDONE_BUFFER: U14017.4 (Y), U14018.2 (B)
FREQ_5V: C14042.1, C14043.1, J14005.6, R14056.1, U14025.6 (OUT)
FREQ_ILIM: R14052.1, U14025.5 (ILIM)
FREQ_POWER_EN: R14053.1, R14054.2, U14025.3 (EN)
FREQ_POWER_FAULT_N: R14055.1, U14025.4 (FAULT_N), U14029.13 (6A)
IO_3V3: C14007.1, C14014.1, C14015.1, C14016.1, C14017.1, C14018.1, C14019.1, C14055.1, C14056.1, C14057.1, C14058.1, C14059.1, C14060.1, C14061.1, C14062.1, J14001.1, R14030.2, R14035.2, R14040.2, R14045.2, R14050.2, R14055.2, R14078.2, U14007.14 (VCC), U14014.14 (VCC), U14015.5 (VCC), U14016.5 (VCC), U14017.5 (VCC), U14018.5 (VCC), U14019.8 (VCC), U14028.14 (VCC2), U14029.14 (VCC), U14030.14 (VCC), U14031.2 (VCC1), U14031.3 (EN), U14032.16 (VCC), U14033.16 (VCC), U14034.11 (A), U14034.13 (C), U14034.16 (VCC)
LOGIC_GND: C14001.2, C14002.2, C14003.2, C14004.2, C14005.2, C14006.2, C14007.2, C14008.2, C14009.2, C14010.2, C14011.2, C14012.2, C14013.2, C14014.2, C14015.2, C14016.2, C14017.2, C14018.2, C14019.2, C14020.2, C14021.2, C14022.2, C14023.2, C14024.2, C14025.2, C14026.2, C14027.2, C14028.2, C14029.2, C14030.2, C14031.2, C14032.2, C14033.2, C14034.2, C14035.2, C14036.2, C14037.2, C14038.2, C14039.2, C14040.2, C14041.2, C14042.2, C14043.2, C14055.2, C14056.2, C14057.2, C14058.2, C14059.2, C14060.2, C14061.2, C14062.2, C14063.2, D14001.2, D14002.2, D14003.2, D14004.2, D14005.2, D14006.2, D14007.2, D14008.2, D14009.2, D14010.2, D14011.2, D14012.2, J14001.2, J14005.7, R14025.2, R14026.2, R14027.2, R14028.2, R14031.2, R14032.2, R14033.2, R14036.2, R14037.2, R14038.2, R14041.2, R14042.2, R14043.2, R14046.2, R14047.2, R14048.2, R14051.2, R14052.2, R14053.2, R14056.2, R14071.2, R14074.2, R14077.2, R14080.2, U14001.1 (A1), U14002.1 (A1), U14003.1 (A1), U14004.1 (A1), U14005.1 (A1), U14006.1 (A1), U14007.7 (GND), U14008.1 (A1), U14009.1 (A1), U14010.1 (A1), U14011.1 (A1), U14012.1 (A1), U14013.1 (A1), U14014.7 (GND), U14015.3 (GND), U14016.3 (GND), U14017.3 (GND), U14018.3 (GND), U14019.4 (GND), U14020.2 (GND), U14021.2 (GND), U14022.2 (GND), U14023.2 (GND), U14024.2 (GND), U14025.2 (GND), U14028.9 (GND2), U14028.16 (GND2), U14029.7 (GND), U14030.5 (3A), U14030.7 (GND), U14030.9 (4A), U14030.11 (5A), U14030.13 (6A), U14031.1 (GND1), U14031.8 (GND1), U14032.8 (GND), U14032.15 (CLK_INH), U14033.8 (GND), U14033.15 (CLK_INH), U14034.8 (GND), U14034.10 (SER), U14034.12 (B), U14034.14 (D), U14034.15 (CLK_INH), U14035.2 (ANODE), U14035.3 (NC_ANODE)
MOD_PRESENT: D14012.1, J14003.12, R14023.1, R14024.1
MOD_PRESENT_ACTIVE: U14014.12 (6Y), U14019.6 (2B), U14033.3 (E)
MOD_PRESENT_CONDITIONED: C14013.1, R14023.2, U14013.3 (K1_A2), U14014.13 (6A)
MOTION_5V_RAW: C14020.1, C14021.1, C14024.1, C14025.1, C14028.1, C14029.1, C14032.1, C14033.1, C14036.1, C14037.1, C14040.1, C14041.1, J14001.3, R14002.2, R14004.2, R14006.2, R14008.2, R14010.2, R14012.2, R14014.2, R14016.2, R14018.2, R14020.2, R14022.2, R14024.2, R14081.1, U14001.2 (K2), U14002.2 (K2), U14003.2 (K2), U14004.2 (K2), U14005.2 (K2), U14006.2 (K2), U14008.2 (K2), U14009.2 (K2), U14010.2 (K2), U14011.2 (K2), U14012.2 (K2), U14013.2 (K2), U14020.1 (IN), U14021.1 (IN), U14022.1 (IN), U14023.1 (IN), U14024.1 (IN), U14025.1 (IN)
MPG_5V: C14038.1, C14039.1, J14005.5, R14051.1, U14024.6 (OUT)
MPG_ENABLE: D14011.1, J14003.11, R14021.1, R14022.1
MPG_ENABLE_ACTIVE: U14014.10 (5Y), U14033.4 (F)
MPG_ENABLE_CONDITIONED: C14012.1, R14021.2, U14012.3 (K1_A2), U14014.11 (5A)
MPG_ILIM: R14047.1, U14024.5 (ILIM)
MPG_MUL_X1: D14007.1, J14003.7, R14013.1, R14014.1
MPG_MUL_X1_ACTIVE: U14014.2 (1Y), U14032.12 (B)
MPG_MUL_X1_CONDITIONED: C14008.1, R14013.2, U14008.3 (K1_A2), U14014.1 (1A)
MPG_MUL_X10: D14008.1, J14003.8, R14015.1, R14016.1
MPG_MUL_X10_ACTIVE: U14014.4 (2Y), U14032.11 (A)
MPG_MUL_X10_CONDITIONED: C14009.1, R14015.2, U14009.3 (K1_A2), U14014.3 (2A)
MPG_MUL_X100: D14009.1, J14003.9, R14017.1, R14018.1
MPG_MUL_X100_ACTIVE: U14014.6 (3Y), U14033.6 (H)
MPG_MUL_X100_CONDITIONED: C14010.1, R14017.2, U14010.3 (K1_A2), U14014.5 (3A)
MPG_PEND_AUX: D14010.1, J14003.10, R14019.1, R14020.1
MPG_PEND_AUX_ACTIVE: U14014.8 (4Y), U14033.5 (G)
MPG_PEND_AUX_CONDITIONED: C14011.1, R14019.2, U14011.3 (K1_A2), U14014.9 (4A)
MPG_POWER_EN: R14048.1, R14049.2, U14024.3 (EN)
MPG_POWER_FAULT_N: R14050.1, U14024.4 (FAULT_N), U14029.11 (5A)
MPG_SEL_A: D14004.1, J14003.4, R14007.1, R14008.1
MPG_SEL_A_ACTIVE: U14007.8 (4Y), U14032.3 (E)
MPG_SEL_A_CONDITIONED: C14004.1, R14007.2, U14004.3 (K1_A2), U14007.9 (4A)
MPG_SEL_B: D14005.1, J14003.5, R14009.1, R14010.1
MPG_SEL_B_ACTIVE: U14007.10 (5Y), U14032.14 (D)
MPG_SEL_B_CONDITIONED: C14005.1, R14009.2, U14005.3 (K1_A2), U14007.11 (5A)
MPG_SEL_C: D14006.1, J14003.6, R14011.1, R14012.1
MPG_SEL_C_ACTIVE: U14007.12 (6Y), U14032.13 (C)
MPG_SEL_C_CONDITIONED: C14006.1, R14011.2, U14006.3 (K1_A2), U14007.13 (6A)
MPG_SEL_X: D14001.1, J14003.1, R14001.1, R14002.1
MPG_SEL_X_ACTIVE: U14007.2 (1Y), U14032.6 (H)
MPG_SEL_X_CONDITIONED: C14001.1, R14001.2, U14001.3 (K1_A2), U14007.1 (1A)
MPG_SEL_Y: D14002.1, J14003.2, R14003.1, R14004.1
MPG_SEL_Y_ACTIVE: U14007.4 (2Y), U14032.5 (G)
MPG_SEL_Y_CONDITIONED: C14002.1, R14003.2, U14002.3 (K1_A2), U14007.3 (2A)
MPG_SEL_Z: D14003.1, J14003.3, R14005.1, R14006.1
MPG_SEL_Z_ACTIVE: U14007.6 (3Y), U14032.4 (F)
MPG_SEL_Z_CONDITIONED: C14003.1, R14005.2, U14003.3 (K1_A2), U14007.5 (3A)
MPG_SUPPLY_FAULT: U14029.10 (5Y), U14033.13 (C)
MPG_VREF: J14003.13, R14082.2
MPG_VREF_CORE: C14063.1, R14081.2, R14082.1, U14035.1 (CATHODE)
PRB0_24V: C14047.1, C14048.1, J14004.2, R14062.1, U14026.10 (OUT)
PRB0_CLMODE: R19403.1, U14026.4 (CLMODE)
PRB0_FAULT_GOOD_ISO: U14028.13 (OUTA), U14030.1 (1A)
PRB0_FIELD_FAULT_N: R14061.1, U14026.6 (FLAG), U14026.7 (UVOV), U14028.4 (INA)
PRB0_ILIM: R14057.1, U14026.8 (SETI)
PRB0_IN: D14013.1, J14004.1, R14069.1
PRB0_IN_SENSE: R14070.1, U14031.15 (IN1)
PRB0_SENSE: R14069.2, R14070.2, U14031.16 (SENSE1)
PRB0_SHDN_N: R14059.2, R14060.1, U14026.5 (EN)
PRB0_SUB_ISLAND: U14031.13 (SUB1)
PRB0_SUPPLY_FAULT: U14030.2 (1Y), U14033.12 (B)
PRB0_UVLO: R14058.2, R19401.1, U14026.2 (UVLO)
PRB1_24V: C14052.1, C14053.1, J14004.5, R14068.1, U14027.10 (OUT)
PRB1_CLMODE: R19404.1, U14027.4 (CLMODE)
PRB1_FAULT_GOOD_ISO: U14028.12 (OUTB), U14030.3 (2A)
PRB1_FIELD_FAULT_N: R14067.1, U14027.6 (FLAG), U14027.7 (UVOV), U14028.5 (INB)
PRB1_ILIM: R14063.1, U14027.8 (SETI)
PRB1_IN: D14014.1, J14004.4, R14072.1
PRB1_IN_SENSE: R14073.1, U14031.10 (IN2)
PRB1_SENSE: R14072.2, R14073.2, U14031.11 (SENSE2)
PRB1_SHDN_N: R14065.2, R14066.1, U14027.5 (EN)
PRB1_SUB_ISLAND: U14031.12 (SUB2)
PRB1_SUPPLY_FAULT: U14030.4 (2Y), U14033.11 (A)
PRB1_UVLO: R14064.2, R19402.1, U14027.2 (UVLO)
PROBE_FPGA: J14002.4, R14071.1, U14031.4 (OUT1)
TOOLSETTER_FPGA: J14002.5, R14074.1, U14031.5 (OUT2)
XF_POWER_ENABLE: J14002.7, R14026.1, U14016.2 (A)
XF_POWER_EN_GATED: R14054.1, U14019.3 (2Y)
XF_POWER_QUALIFIED: U14019.5 (2A), U14019.7 (1Y)
XF_REQUEST_BUFFER: U14016.4 (Y), U14019.2 (1B)
XF_SUPPLY_FAULT: U14029.12 (6Y), U14033.14 (D)

Notes on the sheet:
ACTUAL OPERATOR/FAST-PROBE/PORT SOURCE / 12contactinputs,2dedicatedprobes,8independentportlimiters,24bitreadonlystatus. Sourcecandidate only: 49.9k probe guaranteedcurrent/shortbound notestablished;loadedRTL,EMC,thermal,capbias andphysicalconnectorsremain. No generalDI consumed,nofakehealthy,noextr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
