DeadlySIn777/Controller/hardware/motherboard_status/motherboard_status.kicad_sch

## KiCad design hardware/motherboard_status/motherboard_status.kicad_sch (2026-10-18)

Schematic: motherboard_status.kicad_sch

Parts:
C17001, C17002, C17003, C17004, C17005, C17006, C17007, C17008, C17009, C17010, C17011, C17012, C17013, C17014, C17015, C17016, C17017, C17018, C17019, C17020: 100nF100V; C_0603_1608Metric; MPN GRM188R72A104KA35D
D17001, D17002, D17003, D17004, D17005, D17006, D17007, D17008, D17009, D17010, D17011, D17012, D17013, D17014, D17015, D17016, D17017, D17018, D17019, D17020, D17021, D17022, D17023, D17024, D17037, D17039, D17041, D17043, D17045, D17047, D17049, D17051, D17053, D17055, D17057, D17059, D17061, D17063, D17065, D17067: APT1608SGC; APT1608_Kingbright; MPN APT1608SGC
D17025, D17026, D17027, D17028, D17029, D17030, D17031, D17032, D17033, D17034, D17035, D17036, D17069: APT1608SURCK; APT1608_Kingbright; MPN APT1608SURCK
D17038, D17040, D17042, D17044, D17046, D17048, D17050, D17052, D17054, D17056, D17058, D17060, D17062, D17064, D17066, D17068, D17071, D17073, D17075, D17077, D17079, D17081, D17083: BAS16,215; SOT-23; MPN BAS16,215
D17070, D17072, D17074, D17076, D17078, D17080, D17082: AAA3528RGBS/K11/C8CC; AAA3528RGBS_Kingbright; MPN AAA3528RGBS/K11/C8CC
J17001: PARENT INTERFACE existing protected rails/return;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
J17002, J17003, J17004: PARENT INTERFACE actual receive observation
J17005: PARENT INTERFACE bankA actual terminals; isolatio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
J17006: PARENT INTERFACE bankB actual terminals; isolatio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
J17007: PARENT INTERFACE actual hardware qualification no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
J17008: PARENT INTERFACE ACC existing shared I2C; no new 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
R17001, R17003, R17005, R17007, R17009, R17011, R17013, R17015, R17017, R17019, R17021, R17023, R17025, R17027, R17029, R17031, R17033, R17035, R17037, R17039, R17041, R17043, R17045, R17047, R17049, R17051, R17053, R17055, R17057, R17059, R17061, R17063, R17065, R17067, R17069, R17071, R17114: 1000R1%; R_0603_1608Metric; MPN CRCW06031K00FKEA
R17002, R17004, R17006, R17008, R17010, R17012, R17014, R17016, R17018, R17020, R17022, R17024, R17026, R17028, R17030, R17032, R17034, R17036, R17038, R17040, R17042, R17044, R17046, R17048, R17050, R17052, R17054, R17056, R17058, R17060, R17062, R17064, R17066, R17068, R17070, R17072, R17112, R17113, R17115, R17116, R17117, R17118, R17119, R17121, R17123, R17125, R17128, R17130, R17132, R17135, R17137, R17139, R17142, R17144, R17146, R17149, R17151, R17153, R17156, R17158, R17160, R17163, R17165, R17167: 10000R1%; R_0603_1608Metric; MPN CRCW060310K0FKEA
R17073, R17074, R17075, R17076, R17077, R17078, R17079, R17080, R17081, R17082, R17083, R17084, R17085, R17086, R17087, R17088, R17089, R17090, R17091, R17092, R17093, R17094, R17095, R17096, R17097, R17098, R17099, R17100, R17101, R17102, R17103, R17104: 6800R1%; R_0603_1608Metric; MPN CRCW06036K80FKEA
R17105, R17106, R17107, R17108, R17109, R17110, R17111: 100000R1%; R_0603_1608Metric; MPN CRCW0603100KFKEA
R17120, R17122, R17124, R17126, R17127, R17129, R17131, R17133, R17134, R17136, R17138, R17140, R17141, R17143, R17145, R17147, R17148, R17150, R17152, R17154, R17155, R17157, R17159, R17161, R17162, R17164, R17166, R17168: 680R1%; R_0603_1608Metric; MPN CRCW0603680RFKEA
U17001, U17003, U17005, U17007, U17009, U17011: SN74AHCT04PWR; PW14_TI; MPN SN74AHCT04PWR
U17002, U17004, U17006, U17008, U17010, U17012, U17015: 74LVC07APW,118; SOT402_Nexperia; MPN 74LVC07APW,118
U17013, U17014: SN74AHCT08PWR; PW14_TI; MPN SN74AHCT08PWR
U17016: TCA9517DGKR; DGK8_TI; MPN TCA9517DGKR
U17017, U17018: TLC59116FIPWR; PW28_TI; MPN TLC59116FIPWR
U17019: TMUX1121DGKR; DGK8_TI; MPN TMUX1121DGKR

Connections:
ALM0_FPGA: J17004.1, U17009.1 (1A)
ALM1_FPGA: J17004.2, U17009.3 (2A)
ALM2_FPGA: J17004.3, U17009.5 (3A)
ALM3_FPGA: J17004.4, U17009.9 (4A)
ALM4_FPGA: J17004.5, U17009.11 (5A)
ALM5_FPGA: J17004.6, U17009.13 (6A)
ALM6_FPGA: J17004.7, U17011.1 (1A)
ALM7_FPGA: J17004.8, U17011.3 (2A)
ALM8_FPGA: J17004.9, U17011.5 (3A)
ALM9_FPGA: J17004.10, U17011.9 (4A)
ALM10_FPGA: J17004.11, U17011.11 (5A)
ALM11_FPGA: J17004.12, U17011.13 (6A)
AO_I2C_SCL: J17008.1, R17116.2, U17016.2 (SCLA)
AO_I2C_SDA: J17008.2, R17117.2, U17016.3 (SDAA)
CORE_5V: C17001.1, C17002.1, C17003.1, C17004.1, C17005.1, C17006.1, C17007.1, C17008.1, C17009.1, C17010.1, C17011.1, C17012.1, C17013.1, C17014.1, C17015.1, C17017.1, C17018.1, C17019.1, C17020.1, D17070.4 (A_COMMON), D17072.4 (A_COMMON), D17074.4 (A_COMMON), D17076.4 (A_COMMON), D17078.4 (A_COMMON), D17080.4 (A_COMMON), D17082.4 (A_COMMON), J17001.1, R17001.1, R17003.1, R17005.1, R17007.1, R17009.1, R17011.1, R17013.1, R17015.1, R17017.1, R17019.1, R17021.1, R17023.1, R17025.1, R17027.1, R17029.1, R17031.1, R17033.1, R17035.1, R17037.1, R17039.1, R17041.1, R17043.1, R17045.1, R17047.1, R17049.1, R17051.1, R17053.1, R17055.1, R17057.1, R17059.1, R17061.1, R17063.1, R17065.1, R17067.1, R17069.1, R17071.1, R17114.1, R17118.1, R17119.1, R17121.1, R17123.1, R17125.1, R17128.1, R17130.1, R17132.1, R17135.1, R17137.1, R17139.1, R17142.1, R17144.1, R17146.1, R17149.1, R17151.1, R17153.1, R17156.1, R17158.1, R17160.1, R17163.1, R17165.1, R17167.1, U17001.14 (VCC), U17002.14 (VCC), U17003.14 (VCC), U17004.14 (VCC), U17005.14 (VCC), U17006.14 (VCC), U17007.14 (VCC), U17008.14 (VCC), U17009.14 (VCC), U17010.14 (VCC), U17011.14 (VCC), U17012.14 (VCC), U17013.14 (VCC), U17014.14 (VCC), U17015.9 (4A), U17015.11 (5A), U17015.13 (6A), U17015.14 (VCC), U17016.5 (EN), U17016.8 (VCCB), U17017.28 (VCC), U17018.2 (A0), U17018.28 (VCC), U17019.8 (VDD)
DI0_LOGIC: J17002.1, U17001.1 (1A)
DI1_LOGIC: J17002.2, U17001.3 (2A)
DI2_LOGIC: J17002.3, U17001.5 (3A)
DI3_LOGIC: J17002.4, U17001.9 (4A)
DI4_LOGIC: J17002.5, U17001.11 (5A)
DI5_LOGIC: J17002.6, U17001.13 (6A)
DI6_LOGIC: J17002.7, U17003.1 (1A)
DI7_LOGIC: J17002.8, U17003.3 (2A)
DI8_LOGIC: J17002.9, U17003.5 (3A)
DI9_LOGIC: J17002.10, U17003.9 (4A)
DI10_LOGIC: J17002.11, U17003.11 (5A)
DI11_LOGIC: J17002.12, U17003.13 (6A)
DI12_LOGIC: J17003.1, U17005.1 (1A)
DI13_LOGIC: J17003.2, U17005.3 (2A)
DI14_LOGIC: J17003.3, U17005.5 (3A)
DI15_LOGIC: J17003.4, U17005.9 (4A)
DI16_LOGIC: J17003.5, U17005.11 (5A)
DI17_LOGIC: J17003.6, U17005.13 (6A)
DI18_LOGIC: J17003.7, U17007.1 (1A)
DI19_LOGIC: J17003.8, U17007.3 (2A)
DI20_LOGIC: J17003.9, U17007.5 (3A)
DI21_LOGIC: J17003.10, U17007.9 (4A)
DI22_LOGIC: J17003.11, U17007.11 (5A)
DI23_LOGIC: J17003.12, U17007.13 (6A)
DO00: J17005.1, R17073.1
DO01: J17005.2, R17075.1
DO02: J17005.3, R17077.1
DO03: J17005.4, R17079.1
DO04: J17005.5, R17081.1
DO05: J17005.6, R17083.1
DO06: J17005.7, R17085.1
DO07: J17005.8, R17087.1
DO08: J17006.1, R17089.1
DO09: J17006.2, R17091.1
DO10: J17006.3, R17093.1
DO11: J17006.4, R17095.1
DO12: J17006.5, R17097.1
DO13: J17006.6, R17099.1
DO14: J17006.7, R17101.1
DO15: J17006.8, R17103.1
FIELD_A_0V: D17037.1 (K), D17038.1 (A), D17039.1 (K), D17040.1 (A), D17041.1 (K), D17042.1 (A), D17043.1 (K), D17044.1 (A), D17045.1 (K), D17046.1 (A), D17047.1 (K), D17048.1 (A), D17049.1 (K), D17050.1 (A), D17051.1 (K), D17052.1 (A), J17005.9
FIELD_B_0V: D17053.1 (K), D17054.1 (A), D17055.1 (K), D17056.1 (A), D17057.1 (K), D17058.1 (A), D17059.1 (K), D17060.1 (A), D17061.1 (K), D17062.1 (A), D17063.1 (K), D17064.1 (A), D17065.1 (K), D17066.1 (A), D17067.1 (K), D17068.1 (A), J17006.9
FPGA_USER_RESET_N: J17007.5, R17109.1, U17013.10 (3B)
IO_3V3: C17016.1, J17001.3, R17116.1, R17117.1, U17016.1 (VCCA)
LOGIC_GND: C17001.2, C17002.2, C17003.2, C17004.2, C17005.2, C17006.2, C17007.2, C17008.2, C17009.2, C17010.2, C17011.2, C17012.2, C17013.2, C17014.2, C17015.2, C17016.2, C17017.2, C17018.2, C17019.2, C17020.2, J17001.2, R17105.2, R17106.2, R17107.2, R17108.2, R17109.2, R17110.2, R17111.2, R17112.2, R17113.2, U17001.7 (GND), U17002.7 (GND), U17003.7 (GND), U17004.7 (GND), U17005.7 (GND), U17006.7 (GND), U17007.7 (GND), U17008.7 (GND), U17009.7 (GND), U17010.7 (GND), U17011.7 (GND), U17012.7 (GND), U17013.7 (GND), U17014.4 (2A), U17014.5 (2B), U17014.7 (GND), U17014.9 (3A), U17014.10 (3B), U17014.12 (4A), U17014.13 (4B), U17015.7 (GND), U17016.4 (GND), U17017.2 (A0), U17017.3 (A1), U17017.4 (A2), U17017.5 (A3), U17017.10 (GND), U17017.19 (GND), U17017.24 (GND), U17018.3 (A1), U17018.4 (A2), U17018.5 (A3), U17018.10 (GND), U17018.19 (GND), U17018.24 (GND), U17019.4 (GND)
MC_RAILS_OK_5V: J17007.1, R17105.1, U17013.4 (2A)
MOTOR_TX_GATE_A: J17007.6, R17110.1, U17013.12 (4A)
MOTOR_TX_GATE_B: J17007.7, R17111.1, U17013.13 (4B)
OBS0_A: D17001.2 (A), R17001.2, R17002.1
OBS0_INVERTED: U17001.2 (1Y), U17002.1 (1A)
OBS0_K: D17001.1 (K), R17002.2, U17002.2 (1Y)
OBS1_A: D17002.2 (A), R17003.2, R17004.1
OBS1_INVERTED: U17001.4 (2Y), U17002.3 (2A)
OBS1_K: D17002.1 (K), R17004.2, U17002.4 (2Y)
OBS2_A: D17003.2 (A), R17005.2, R17006.1
OBS2_INVERTED: U17001.6 (3Y), U17002.5 (3A)
OBS2_K: D17003.1 (K), R17006.2, U17002.6 (3Y)
OBS3_A: D17004.2 (A), R17007.2, R17008.1
OBS3_INVERTED: U17001.8 (4Y), U17002.9 (4A)
OBS3_K: D17004.1 (K), R17008.2, U17002.8 (4Y)
OBS4_A: D17005.2 (A), R17009.2, R17010.1
OBS4_INVERTED: U17001.10 (5Y), U17002.11 (5A)
OBS4_K: D17005.1 (K), R17010.2, U17002.10 (5Y)
OBS5_A: D17006.2 (A), R17011.2, R17012.1
OBS5_INVERTED: U17001.12 (6Y), U17002.13 (6A)
OBS5_K: D17006.1 (K), R17012.2, U17002.12 (6Y)
OBS6_A: D17007.2 (A), R17013.2, R17014.1
OBS6_INVERTED: U17003.2 (1Y), U17004.1 (1A)
OBS6_K: D17007.1 (K), R17014.2, U17004.2 (1Y)
OBS7_A: D17008.2 (A), R17015.2, R17016.1
OBS7_INVERTED: U17003.4 (2Y), U17004.3 (2A)
OBS7_K: D17008.1 (K), R17016.2, U17004.4 (2Y)
OBS8_A: D17009.2 (A), R17017.2, R17018.1
OBS8_INVERTED: U17003.6 (3Y), U17004.5 (3A)
OBS8_K: D17009.1 (K), R17018.2, U17004.6 (3Y)
OBS9_A: D17010.2 (A), R17019.2, R17020.1
OBS9_INVERTED: U17003.8 (4Y), U17004.9 (4A)
OBS9_K: D17010.1 (K), R17020.2, U17004.8 (4Y)
OBS10_A: D17011.2 (A), R17021.2, R17022.1
OBS10_INVERTED: U17003.10 (5Y), U17004.11 (5A)
OBS10_K: D17011.1 (K), R17022.2, U17004.10 (5Y)
OBS11_A: D17012.2 (A), R17023.2, R17024.1
OBS11_INVERTED: U17003.12 (6Y), U17004.13 (6A)
OBS11_K: D17012.1 (K), R17024.2, U17004.12 (6Y)
OBS12_A: D17013.2 (A), R17025.2, R17026.1
OBS12_INVERTED: U17005.2 (1Y), U17006.1 (1A)
OBS12_K: D17013.1 (K), R17026.2, U17006.2 (1Y)
OBS13_A: D17014.2 (A), R17027.2, R17028.1
OBS13_INVERTED: U17005.4 (2Y), U17006.3 (2A)
OBS13_K: D17014.1 (K), R17028.2, U17006.4 (2Y)
OBS14_A: D17015.2 (A), R17029.2, R17030.1
OBS14_INVERTED: U17005.6 (3Y), U17006.5 (3A)
OBS14_K: D17015.1 (K), R17030.2, U17006.6 (3Y)
OBS15_A: D17016.2 (A), R17031.2, R17032.1
OBS15_INVERTED: U17005.8 (4Y), U17006.9 (4A)
OBS15_K: D17016.1 (K), R17032.2, U17006.8 (4Y)
OBS16_A: D17017.2 (A), R17033.2, R17034.1
OBS16_INVERTED: U17005.10 (5Y), U17006.11 (5A)
OBS16_K: D17017.1 (K), R17034.2, U17006.10 (5Y)
OBS17_A: D17018.2 (A), R17035.2, R17036.1
OBS17_INVERTED: U17005.12 (6Y), U17006.13 (6A)
OBS17_K: D17018.1 (K), R17036.2, U17006.12 (6Y)
OBS18_A: D17019.2 (A), R17037.2, R17038.1
OBS18_INVERTED: U17007.2 (1Y), U17008.1 (1A)
OBS18_K: D17019.1 (K), R17038.2, U17008.2 (1Y)
OBS19_A: D17020.2 (A), R17039.2, R17040.1
OBS19_INVERTED: U17007.4 (2Y), U17008.3 (2A)
OBS19_K: D17020.1 (K), R17040.2, U17008.4 (2Y)
OBS20_A: D17021.2 (A), R17041.2, R17042.1
OBS20_INVERTED: U17007.6 (3Y), U17008.5 (3A)
OBS20_K: D17021.1 (K), R17042.2, U17008.6 (3Y)
OBS21_A: D17022.2 (A), R17043.2, R17044.1
OBS21_INVERTED: U17007.8 (4Y), U17008.9 (4A)
OBS21_K: D17022.1 (K), R17044.2, U17008.8 (4Y)
OBS22_A: D17023.2 (A), R17045.2, R17046.1
OBS22_INVERTED: U17007.10 (5Y), U17008.11 (5A)
OBS22_K: D17023.1 (K), R17046.2, U17008.10 (5Y)
OBS23_A: D17024.2 (A), R17047.2, R17048.1
OBS23_INVERTED: U17007.12 (6Y), U17008.13 (6A)
OBS23_K: D17024.1 (K), R17048.2, U17008.12 (6Y)
OBS24_A: D17025.2 (A), R17049.2, R17050.1
OBS24_INVERTED: U17009.2 (1Y), U17010.1 (1A)
OBS24_K: D17025.1 (K), R17050.2, U17010.2 (1Y)
OBS25_A: D17026.2 (A), R17051.2, R17052.1
OBS25_INVERTED: U17009.4 (2Y), U17010.3 (2A)
OBS25_K: D17026.1 (K), R17052.2, U17010.4 (2Y)
OBS26_A: D17027.2 (A), R17053.2, R17054.1
OBS26_INVERTED: U17009.6 (3Y), U17010.5 (3A)
OBS26_K: D17027.1 (K), R17054.2, U17010.6 (3Y)
OBS27_A: D17028.2 (A), R17055.2, R17056.1
OBS27_INVERTED: U17009.8 (4Y), U17010.9 (4A)
OBS27_K: D17028.1 (K), R17056.2, U17010.8 (4Y)
OBS28_A: D17029.2 (A), R17057.2, R17058.1
OBS28_INVERTED: U17009.10 (5Y), U17010.11 (5A)
OBS28_K: D17029.1 (K), R17058.2, U17010.10 (5Y)
OBS29_A: D17030.2 (A), R17059.2, R17060.1
OBS29_INVERTED: U17009.12 (6Y), U17010.13 (6A)
OBS29_K: D17030.1 (K), R17060.2, U17010.12 (6Y)
OBS30_A: D17031.2 (A), R17061.2, R17062.1
OBS30_INVERTED: U17011.2 (1Y), U17012.1 (1A)
OBS30_K: D17031.1 (K), R17062.2, U17012.2 (1Y)
OBS31_A: D17032.2 (A), R17063.2, R17064.1
OBS31_INVERTED: U17011.4 (2Y), U17012.3 (2A)
OBS31_K: D17032.1 (K), R17064.2, U17012.4 (2Y)
OBS32_A: D17033.2 (A), R17065.2, R17066.1
OBS32_INVERTED: U17011.6 (3Y), U17012.5 (3A)
OBS32_K: D17033.1 (K), R17066.2, U17012.6 (3Y)
OBS33_A: D17034.2 (A), R17067.2, R17068.1
OBS33_INVERTED: U17011.8 (4Y), U17012.9 (4A)
OBS33_K: D17034.1 (K), R17068.2, U17012.8 (4Y)
OBS34_A: D17035.2 (A), R17069.2, R17070.1
OBS34_INVERTED: U17011.10 (5Y), U17012.11 (5A)
OBS34_K: D17035.1 (K), R17070.2, U17012.10 (5Y)
OBS35_A: D17036.2 (A), R17071.2, R17072.1
OBS35_INVERTED: U17011.12 (6Y), U17012.13 (6A)
OBS35_K: D17036.1 (K), R17072.2, U17012.12 (6Y)
OUT0_A: D17037.2 (A), D17038.3 (K), R17074.2
OUT0_R_MID: R17073.2, R17074.1
OUT1_A: D17039.2 (A), D17040.3 (K), R17076.2
OUT1_R_MID: R17075.2, R17076.1
OUT2_A: D17041.2 (A), D17042.3 (K), R17078.2
OUT2_R_MID: R17077.2, R17078.1
OUT3_A: D17043.2 (A), D17044.3 (K), R17080.2
OUT3_R_MID: R17079.2, R17080.1
OUT4_A: D17045.2 (A), D17046.3 (K), R17082.2
OUT4_R_MID: R17081.2, R17082.1
OUT5_A: D17047.2 (A), D17048.3 (K), R17084.2
OUT5_R_MID: R17083.2, R17084.1
OUT6_A: D17049.2 (A), D17050.3 (K), R17086.2
OUT6_R_MID: R17085.2, R17086.1
OUT7_A: D17051.2 (A), D17052.3 (K), R17088.2
OUT7_R_MID: R17087.2, R17088.1
OUT8_A: D17053.2 (A), D17054.3 (K), R17090.2
OUT8_R_MID: R17089.2, R17090.1
OUT9_A: D17055.2 (A), D17056.3 (K), R17092.2
OUT9_R_MID: R17091.2, R17092.1
OUT10_A: D17057.2 (A), D17058.3 (K), R17094.2
OUT10_R_MID: R17093.2, R17094.1
OUT11_A: D17059.2 (A), D17060.3 (K), R17096.2
OUT11_R_MID: R17095.2, R17096.1
OUT12_A: D17061.2 (A), D17062.3 (K), R17098.2
OUT12_R_MID: R17097.2, R17098.1
OUT13_A: D17063.2 (A), D17064.3 (K), R17100.2
OUT13_R_MID: R17099.2, R17100.1
OUT14_A: D17065.2 (A), D17066.3 (K), R17102.2
OUT14_R_MID: R17101.2, R17102.1
OUT15_A: D17067.2 (A), D17068.3 (K), R17104.2
OUT15_R_MID: R17103.2, R17104.1
RGB_COMPUTE_B_K: D17072.3 (B_K), R17131.1, R17132.2
RGB_COMPUTE_G_K: D17072.2 (G_K), R17129.1, R17130.2
RGB_COMPUTE_HW_RED: D17073.1 (A), R17133.2
RGB_COMPUTE_R_K: D17072.1 (R_K), R17127.1, R17128.2, R17133.1
RGB_DRIVER_0: R17120.2, U17017.6 (OUT0)
RGB_DRIVER_1: R17122.2, U17017.7 (OUT1)
RGB_DRIVER_2: R17124.2, U17017.8 (OUT2)
RGB_DRIVER_3: R17127.2, U17017.9 (OUT3)
RGB_DRIVER_4: R17129.2, U17017.11 (OUT4)
RGB_DRIVER_5: R17131.2, U17017.12 (OUT5)
RGB_DRIVER_6: R17134.2, U17017.13 (OUT6)
RGB_DRIVER_7: R17136.2, U17017.14 (OUT7)
RGB_DRIVER_8: R17138.2, U17017.15 (OUT8)
RGB_DRIVER_9: R17141.2, U17017.16 (OUT9)
RGB_DRIVER_10: R17143.2, U17017.17 (OUT10)
RGB_DRIVER_11: R17145.2, U17017.18 (OUT11)
RGB_DRIVER_12: R17148.2, U17017.20 (OUT12)
RGB_DRIVER_13: U17017.21 (OUT13), U17019.2 (D1)
RGB_DRIVER_14: U17017.22 (OUT14), U17019.6 (D2)
RGB_DRIVER_15: R17155.2, U17017.23 (OUT15)
RGB_DRIVER_16: R17157.2, U17018.6 (OUT0)
RGB_DRIVER_17: R17159.2, U17018.7 (OUT1)
RGB_DRIVER_18: R17162.2, U17018.8 (OUT2)
RGB_DRIVER_19: R17164.2, U17018.9 (OUT3)
RGB_DRIVER_20: R17166.2, U17018.11 (OUT4)
RGB_ESP_B_K: D17076.3 (B_K), R17145.1, R17146.2
RGB_ESP_G_K: D17076.2 (G_K), R17143.1, R17144.2
RGB_ESP_HW_RED: D17077.1 (A), R17147.2
RGB_ESP_R_K: D17076.1 (R_K), R17141.1, R17142.2, R17147.1
RGB_EXPANSION_B_K: D17080.3 (B_K), R17159.1, R17160.2
RGB_EXPANSION_G_K: D17080.2 (G_K), R17157.1, R17158.2
RGB_EXPANSION_HW_RED: D17081.1 (A), R17161.2
RGB_EXPANSION_R_K: D17080.1 (R_K), R17155.1, R17156.2, R17161.1
RGB_FPGA_B_K: D17074.3 (B_K), R17138.1, R17139.2
RGB_FPGA_G_K: D17074.2 (G_K), R17136.1, R17137.2
RGB_FPGA_HW_RED: D17075.1 (A), R17140.2
RGB_FPGA_R_K: D17074.1 (R_K), R17134.1, R17135.2, R17140.1
RGB_MOTION_B_K: D17078.3 (B_K), R17152.1, R17153.2
RGB_MOTION_B_SWITCH_IN: R17152.2, U17019.5 (S2)
RGB_MOTION_G_K: D17078.2 (G_K), R17150.1, R17151.2
RGB_MOTION_G_SWITCH_IN: R17150.2, U17019.1 (S1)
RGB_MOTION_HW_RED: D17079.1 (A), R17154.2
RGB_MOTION_R_K: D17078.1 (R_K), R17148.1, R17149.2, R17154.1
RGB_NETWORK_B_K: D17082.3 (B_K), R17166.1, R17167.2
RGB_NETWORK_G_K: D17082.2 (G_K), R17164.1, R17165.2
RGB_NETWORK_HW_RED: D17083.1 (A), R17168.2
RGB_NETWORK_R_K: D17082.1 (R_K), R17162.1, R17163.2, R17168.1
RGB_SYSTEM_B_K: D17070.3 (B_K), R17124.1, R17125.2
RGB_SYSTEM_G_K: D17070.2 (G_K), R17122.1, R17123.2
RGB_SYSTEM_HW_RED: D17071.1 (A), R17126.2
RGB_SYSTEM_R_K: D17070.1 (R_K), R17120.1, R17121.2, R17126.1
STATUS_HW_GOOD: R17112.1, U17013.6 (2Y), U17015.1 (1A), U17015.3 (2A), U17017.25 (RESET_N), U17018.25 (RESET_N)
STATUS_I2C_SCL5: R17118.2, U17016.7 (SCLB), U17017.26 (SCL), U17018.26 (SCL)
STATUS_I2C_SDA5: R17119.2, U17016.6 (SDAB), U17017.27 (SDA), U17018.27 (SDA)
STATUS_MOTION_FEEDS_GOOD: U17013.11 (4Y), U17014.2 (1B)
STATUS_MOTION_REQUEST_GOOD: U17013.8 (3Y), U17014.1 (1A)
STATUS_MOTION_RGB_ENABLE: R17113.1, U17014.3 (1Y), U17019.3 (SEL2), U17019.7 (SEL1)
STATUS_NO_WDT_TRIP: U17013.3 (1Y), U17013.5 (2B), U17015.5 (3A)
STATUS_RED_BUS0: D17071.3 (K), D17073.3 (K), D17075.3 (K), D17077.3 (K), U17015.2 (1Y)
STATUS_RED_BUS1: D17079.3 (K), D17081.3 (K), D17083.3 (K), U17015.4 (2Y)
STATUS_WDT_A: D17069.2 (A), R17114.2, R17115.1
STATUS_WDT_K: D17069.1 (K), R17115.2, U17015.6 (3Y)
TX_PERMIT: J17007.4, R17108.1, U17013.9 (3A)
WD_M_TRIP_N: J17007.2, R17106.1, U17013.1 (1A)
WD_O_TRIP_N: J17007.3, R17107.1, U17013.2 (1B)

Notes on the sheet:
ACTUAL STATUS LED SOURCE / 7ordinary RGB,24DI,12motoralarms,16terminal-voltage indicators and independent WDT. Hardware reset/red priority uses actual rail/sticky-watchdog faults; motionpermissionLOW opens onlyMOTIONgreenblue. Source candidate: partial rails, loaded I2C/current/optical/thermal and 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
