DeadlySIn777/Controller/hardware/motherboard_terminals/motherboard_terminals.kicad_sch

## KiCad design hardware/motherboard_terminals/motherboard_terminals.kicad_sch (2026-10-18)

Schematic: motherboard_terminals.kicad_sch

Parts:
BT1950: PARENT: AI0_N
BT1951: PARENT: AI0_P
BT1952: PARENT: AI1_N
BT1953: PARENT: AI1_P
BT1954: PARENT: AI2_N
BT1955: PARENT: AI2_P
BT1956: PARENT: AI3_N
BT1957: PARENT: AI3_P
BT1958: PARENT: AI_AGND
BT1959: PARENT: AI_REF_10V
BT19510: PARENT: AI_SENS_24V
BT19511: PARENT: ALM0_FIELD
BT19512: PARENT: ALM10_FIELD
BT19513: PARENT: ALM11_FIELD
BT19514: PARENT: ALM1_FIELD
BT19515: PARENT: ALM2_FIELD
BT19516: PARENT: ALM3_FIELD
BT19517: PARENT: ALM4_FIELD
BT19518: PARENT: ALM5_FIELD
BT19519: PARENT: ALM6_FIELD
BT19520: PARENT: ALM7_FIELD
BT19521: PARENT: ALM8_FIELD
BT19522: PARENT: ALM9_FIELD
BT19523: PARENT: AO0_COM
BT19524: PARENT: AO0_OUT
BT19525: PARENT: AO1_COM
BT19526: PARENT: AO1_OUT
BT19527: PARENT: ARM_LAMP
BT19528: PARENT: AUX_24V_A
BT19529: PARENT: AUX_24V_B
BT19530: PARENT: AUX_5V_A
BT19531: PARENT: AUX_5V_B
BT19532: PARENT: CAN_GND
BT19533: PARENT: CAN_H
BT19534: PARENT: CAN_L
BT19535: PARENT: CAN_TERM
BT19536: PARENT: CHASSIS
BT19537: PARENT: CONTACTOR_FB_IN
BT19538: PARENT: DI0_FIELD
BT19539: PARENT: DI10_FIELD
BT19540: PARENT: DI11_FIELD
BT19541: PARENT: DI12_FIELD
BT19542: PARENT: DI13_FIELD
BT19543: PARENT: DI14_FIELD
BT19544: PARENT: DI15_FIELD
BT19545: PARENT: DI16_FIELD
BT19546: PARENT: DI17_FIELD
BT19547: PARENT: DI18_FIELD
BT19548: PARENT: DI19_FIELD
BT19549: PARENT: DI1_FIELD
BT19550: PARENT: DI20_FIELD
BT19551: PARENT: DI21_FIELD
BT19552: PARENT: DI22_FIELD
BT19553: PARENT: DI23_FIELD
BT19554: PARENT: DI2_FIELD
BT19555: PARENT: DI3_FIELD
BT19556: PARENT: DI4_FIELD
BT19557: PARENT: DI5_FIELD
BT19558: PARENT: DI6_FIELD
BT19559: PARENT: DI7_FIELD
BT19560: PARENT: DI8_FIELD
BT19561: PARENT: DI9_FIELD
BT19562: PARENT: DIR0_N
BT19563: PARENT: DIR0_P
BT19564: PARENT: DIR10_N
BT19565: PARENT: DIR10_P
BT19566: PARENT: DIR11_N
BT19567: PARENT: DIR11_P
BT19568: PARENT: DIR1_N
BT19569: PARENT: DIR1_P
BT19570: PARENT: DIR2_N
BT19571: PARENT: DIR2_P
BT19572: PARENT: DIR3_N
BT19573: PARENT: DIR3_P
BT19574: PARENT: DIR4_N
BT19575: PARENT: DIR4_P
BT19576: PARENT: DIR5_N
BT19577: PARENT: DIR5_P
BT19578: PARENT: DIR6_N
BT19579: PARENT: DIR6_P
BT19580: PARENT: DIR7_N
BT19581: PARENT: DIR7_P
BT19582: PARENT: DIR8_N
BT19583: PARENT: DIR8_P
BT19584: PARENT: DIR9_N
BT19585: PARENT: DIR9_P
BT19586: PARENT: DO00
BT19587: PARENT: DO01
BT19588: PARENT: DO02
BT19589: PARENT: DO03
BT19590: PARENT: DO04
BT19591: PARENT: DO05
BT19592: PARENT: DO06
BT19593: PARENT: DO07
BT19594: PARENT: DO08
BT19595: PARENT: DO09
BT19596: PARENT: DO10
BT19597: PARENT: DO11
BT19598: PARENT: DO12
BT19599: PARENT: DO13
BT195100: PARENT: DO14
BT195101: PARENT: DO15
BT195102: PARENT: EN0_COM
BT195103: PARENT: EN0_NC
BT195104: PARENT: EN0_NO
BT195105: PARENT: EN10_COM
BT195106: PARENT: EN10_NC
BT195107: PARENT: EN10_NO
BT195108: PARENT: EN11_COM
BT195109: PARENT: EN11_NC
BT195110: PARENT: EN11_NO
BT195111: PARENT: EN1_COM
BT195112: PARENT: EN1_NC
BT195113: PARENT: EN1_NO
BT195114: PARENT: EN2_COM
BT195115: PARENT: EN2_NC
BT195116: PARENT: EN2_NO
BT195117: PARENT: EN3_COM
BT195118: PARENT: EN3_NC
BT195119: PARENT: EN3_NO
BT195120: PARENT: EN4_COM
BT195121: PARENT: EN4_NC
BT195122: PARENT: EN4_NO
BT195123: PARENT: EN5_COM
BT195124: PARENT: EN5_NC
BT195125: PARENT: EN5_NO
BT195126: PARENT: EN6_COM
BT195127: PARENT: EN6_NC
BT195128: PARENT: EN6_NO
BT195129: PARENT: EN7_COM
BT195130: PARENT: EN7_NC
BT195131: PARENT: EN7_NO
BT195132: PARENT: EN8_COM
BT195133: PARENT: EN8_NC
BT195134: PARENT: EN8_NO
BT195135: PARENT: EN9_COM
BT195136: PARENT: EN9_NC
BT195137: PARENT: EN9_NO
BT195138: PARENT: ENC0_5V_LIMITED
BT195139: PARENT: ENC0_A_N
BT195140: PARENT: ENC0_A_P
BT195141: PARENT: ENC0_B_N
BT195142: PARENT: ENC0_B_P
BT195143: PARENT: ENC0_Z_N
BT195144: PARENT: ENC0_Z_P
BT195145: PARENT: ENC1_5V_LIMITED
BT195146: PARENT: ENC1_A_N
BT195147: PARENT: ENC1_A_P
BT195148: PARENT: ENC1_B_N
BT195149: PARENT: ENC1_B_P
BT195150: PARENT: ENC1_Z_N
BT195151: PARENT: ENC1_Z_P
BT195152: PARENT: ENC2_5V_LIMITED
BT195153: PARENT: ENC2_A_N
BT195154: PARENT: ENC2_A_P
BT195155: PARENT: ENC2_B_N
BT195156: PARENT: ENC2_B_P
BT195157: PARENT: ENC2_Z_N
BT195158: PARENT: ENC2_Z_P
BT195159: PARENT: ENC3_5V_LIMITED
BT195160: PARENT: ENC3_A_N
BT195161: PARENT: ENC3_A_P
BT195162: PARENT: ENC3_B_N
BT195163: PARENT: ENC3_B_P
BT195164: PARENT: ENC3_Z_N
BT195165: PARENT: ENC3_Z_P
BT195166: PARENT: EXT_PERMIT_IN
BT195167: PARENT: FIELD_A_0V
BT195168: PARENT: FIELD_B_0V
BT195169: PARENT: FIELD_GND
BT195170: PARENT: FREQ0_N
BT195171: PARENT: FREQ0_P
BT195172: PARENT: FREQ1_N
BT195173: PARENT: FREQ1_P
BT195174: PARENT: FREQ_5V_LIMITED
BT195175: PARENT: FREQ_MOD_ID_TO_FRONTEND
BT195176: PARENT: FREQ_MOD_PRESENT_TO_FRONTEND
BT195177: PARENT: LOGIC_GND
BT195178: PARENT: MPG_5V_LIMITED
BT195179: PARENT: MPG_A_N
BT195180: PARENT: MPG_A_P
BT195181: PARENT: MPG_B_N
BT195182: PARENT: MPG_B_P
BT195183: PARENT: MPG_ENABLE
BT195184: PARENT: MPG_MUL_X1
BT195185: PARENT: MPG_MUL_X10
BT195186: PARENT: MPG_MUL_X100
BT195187: PARENT: MPG_PEND_AUX
BT195188: PARENT: MPG_SEL_A
BT195189: PARENT: MPG_SEL_B
BT195190: PARENT: MPG_SEL_C
BT195191: PARENT: MPG_SEL_X
BT195192: PARENT: MPG_SEL_Y
BT195193: PARENT: MPG_SEL_Z
BT195194: PARENT: MPG_VREF_2V5
BT195195: PARENT: PEN0_1
BT195196: PARENT: PEN0_2
BT195197: PARENT: PEN1_1
BT195198: PARENT: PEN1_2
BT195199: PARENT: PERMIT_OUT_1
BT195200: PARENT: PERMIT_OUT_2
BT195201: PARENT: PRB0_24V
BT195202: PARENT: PRB0_IN
BT195203: PARENT: PRB1_24V
BT195204: PARENT: PRB1_IN
BT195205: PARENT: PROCESS_PERMIT_IN
BT195206: PARENT: PWM0
BT195207: PARENT: PWM1
BT195208: PARENT: PWM_5V_AUX
BT195209: PARENT: RESET_ARM_IN
BT195210: PARENT: RS485_A
BT195211: PARENT: RS485_B
BT195212: PARENT: RS485_COM
BT195213: PARENT: RS485_TERM
BT195214: PARENT: SAFETY_STATUS_IN
BT195215: PARENT: SAFE_24V
BT195216: PARENT: SENS24_G0
BT195217: PARENT: SENS24_G1
BT195218: PARENT: SENS24_G2
BT195219: PARENT: STEP0_N
BT195220: PARENT: STEP0_P
BT195221: PARENT: STEP10_N
BT195222: PARENT: STEP10_P
BT195223: PARENT: STEP11_N
BT195224: PARENT: STEP11_P
BT195225: PARENT: STEP1_N
BT195226: PARENT: STEP1_P
BT195227: PARENT: STEP2_N
BT195228: PARENT: STEP2_P
BT195229: PARENT: STEP3_N
BT195230: PARENT: STEP3_P
BT195231: PARENT: STEP4_N
BT195232: PARENT: STEP4_P
BT195233: PARENT: STEP5_N
BT195234: PARENT: STEP5_P
BT195235: PARENT: STEP6_N
BT195236: PARENT: STEP6_P
BT195237: PARENT: STEP7_N
BT195238: PARENT: STEP7_P
BT195239: PARENT: STEP8_N
BT195240: PARENT: STEP8_P
BT195241: PARENT: STEP9_N
BT195242: PARENT: STEP9_P
BT195243: PARENT: STO_FB_IN
C19501, C19502, C19503, C19504, C19505, C19506, C19507, C19508, C19509: 4.7nF 20% X1/Y2 HF coupling; C_Disc_D12.5mm_W5.0mm_P7.50mm; MPN VY2472M49Y5US63V7
H19501: XPE1 / M4 chassis bond; MountingHole_4.3mm_M4_Pad
J19501: XM0 / 1844333; PhoenixContact_MC_1,5_14-G-3.5_1x14_P3.50mm_Horizontal; MPN 1844333
J19502: XM1 / 1844333; PhoenixContact_MC_1,5_14-G-3.5_1x14_P3.50mm_Horizontal; MPN 1844333
J19503: XM2 / 1844333; PhoenixContact_MC_1,5_14-G-3.5_1x14_P3.50mm_Horizontal; MPN 1844333
J19504: XM3 / 1844333; PhoenixContact_MC_1,5_14-G-3.5_1x14_P3.50mm_Horizontal; MPN 1844333
J19505: XM4 / 1844333; PhoenixContact_MC_1,5_14-G-3.5_1x14_P3.50mm_Horizontal; MPN 1844333
J19506: XM5 / 1844333; PhoenixContact_MC_1,5_14-G-3.5_1x14_P3.50mm_Horizontal; MPN 1844333
J19507: XM6 / 1844333; PhoenixContact_MC_1,5_14-G-3.5_1x14_P3.50mm_Horizontal; MPN 1844333
J19508: XM7 / 1844333; PhoenixContact_MC_1,5_14-G-3.5_1x14_P3.50mm_Horizontal; MPN 1844333
J19509: XM8 / 1844333; PhoenixContact_MC_1,5_14-G-3.5_1x14_P3.50mm_Horizontal; MPN 1844333
J19510: XM9 / 1844333; PhoenixContact_MC_1,5_14-G-3.5_1x14_P3.50mm_Horizontal; MPN 1844333
J19511: XM10 / 1844333; PhoenixContact_MC_1,5_14-G-3.5_1x14_P3.50mm_Horizontal; MPN 1844333
J19512: XM11 / 1844333; PhoenixContact_MC_1,5_14-G-3.5_1x14_P3.50mm_Horizontal; MPN 1844333
J19513: XE0 / 1844294; PhoenixContact_MC_1,5_10-G-3.5_1x10_P3.50mm_Horizontal; MPN 1844294
J19514: XE1 / 1844294; PhoenixContact_MC_1,5_10-G-3.5_1x10_P3.50mm_Horizontal; MPN 1844294
J19515: XE2 / 1844294; PhoenixContact_MC_1,5_10-G-3.5_1x10_P3.50mm_Horizontal; MPN 1844294
J19516: XE3 / 1844294; PhoenixContact_MC_1,5_10-G-3.5_1x10_P3.50mm_Horizontal; MPN 1844294
J19517: XH1 / 1844294; PhoenixContact_MC_1,5_10-G-3.5_1x10_P3.50mm_Horizontal; MPN 1844294
J19518: XH2 / 1844317; PhoenixContact_MC_1,5_12-G-3.5_1x12_P3.50mm_Horizontal; MPN 1844317
J19519: XDI0 / 1844317; PhoenixContact_MC_1,5_12-G-3.5_1x12_P3.50mm_Horizontal; MPN 1844317
J19520: XDI1 / 1844317; PhoenixContact_MC_1,5_12-G-3.5_1x12_P3.50mm_Horizontal; MPN 1844317
J19521: XDI2 / 1844317; PhoenixContact_MC_1,5_12-G-3.5_1x12_P3.50mm_Horizontal; MPN 1844317
J19522: XDO0 / 1844317; PhoenixContact_MC_1,5_12-G-3.5_1x12_P3.50mm_Horizontal; MPN 1844317
J19523: XDO1 / 1844317; PhoenixContact_MC_1,5_12-G-3.5_1x12_P3.50mm_Horizontal; MPN 1844317
J19524: XPR / 1844252; PhoenixContact_MC_1,5_6-G-3.5_1x06_P3.50mm_Horizontal; MPN 1844252
J19525: XF / 1844294; PhoenixContact_MC_1,5_10-G-3.5_1x10_P3.50mm_Horizontal; MPN 1844294
J19526: XPW / 1844252; PhoenixContact_MC_1,5_6-G-3.5_1x06_P3.50mm_Horizontal; MPN 1844252
J19527: XPC0 / 1844210; PhoenixContact_MC_1,5_2-G-3.5_1x02_P3.50mm_Horizontal; MPN 1844210
J19528: XPC1 / 1844210; PhoenixContact_MC_1,5_2-G-3.5_1x02_P3.50mm_Horizontal; MPN 1844210
J19529, J19530: XAO / 1844223; PhoenixContact_MC_1,5_3-G-3.5_1x03_P3.50mm_Horizontal; MPN 1844223
J19531: XAI / 1844317; PhoenixContact_MC_1,5_12-G-3.5_1x12_P3.50mm_Horizontal; MPN 1844317
J19532: XB1 / 1844252; PhoenixContact_MC_1,5_6-G-3.5_1x06_P3.50mm_Horizontal; MPN 1844252
J19533: XB2 / 1844252; PhoenixContact_MC_1,5_6-G-3.5_1x06_P3.50mm_Horizontal; MPN 1844252
J19534: XS1 / 1844317; PhoenixContact_MC_1,5_12-G-3.5_1x12_P3.50mm_Horizontal; MPN 1844317

Connections:
AI0_N: BT1950.1, J19531.2
AI0_P: BT1951.1, J19531.1
AI1_N: BT1952.1, J19531.4
AI1_P: BT1953.1, J19531.3
AI2_N: BT1954.1, J19531.6
AI2_P: BT1955.1, J19531.5
AI3_N: BT1956.1, J19531.8
AI3_P: BT1957.1, J19531.7
AI_AGND: BT1958.1, C19507.1, J19531.11
AI_REF_10V: BT1959.1, J19531.9
AI_SENS_24V: BT19510.1, J19531.10
ALM0_FIELD: BT19511.1, J19501.14
ALM1_FIELD: BT19514.1, J19502.14
ALM2_FIELD: BT19515.1, J19503.14
ALM3_FIELD: BT19516.1, J19504.14
ALM4_FIELD: BT19517.1, J19505.14
ALM5_FIELD: BT19518.1, J19506.14
ALM6_FIELD: BT19519.1, J19507.14
ALM7_FIELD: BT19520.1, J19508.14
ALM8_FIELD: BT19521.1, J19509.14
ALM9_FIELD: BT19522.1, J19510.14
ALM10_FIELD: BT19512.1, J19511.14
ALM11_FIELD: BT19513.1, J19512.14
AO0_COM: BT19523.1, C19505.1, J19529.2
AO0_OUT: BT19524.1, J19529.1
AO1_COM: BT19525.1, C19506.1, J19530.2
AO1_OUT: BT19526.1, J19530.1
ARM_LAMP: BT19527.1, J19534.6
AUX_5V_A: BT19530.1, J19501.11, J19502.11, J19503.11, J19504.11, J19505.11, J19506.11, J19507.11, J19508.11
AUX_5V_B: BT19531.1, J19509.11, J19510.11, J19511.11, J19512.11
AUX_24V_A: BT19528.1, J19501.12, J19502.12, J19503.12, J19504.12, J19505.12, J19506.12, J19507.12, J19508.12
AUX_24V_B: BT19529.1, J19509.12, J19510.12, J19511.12, J19512.12
CAN_GND: BT19532.1, C19509.1, J19533.3, J19533.6
CAN_H: BT19533.1, J19533.1
CAN_L: BT19534.1, J19533.2
CAN_TERM: BT19535.1, J19533.4
CHASSIS: BT19536.1, C19501.2, C19502.2, C19503.2, C19504.2, C19505.2, C19506.2, C19507.2, C19508.2, C19509.2, H19501.1, J19501.6, J19502.6, J19503.6, J19504.6, J19505.6, J19506.6, J19507.6, J19508.6, J19509.6, J19510.6, J19511.6, J19512.6, J19513.10, J19514.10, J19515.10, J19516.10, J19517.10, J19518.12, J19525.10, J19526.6, J19529.3, J19530.3, J19531.12, J19532.5, J19533.5, J19534.12
CONTACTOR_FB_IN: BT19537.1, J19534.7
DI0_FIELD: BT19538.1, J19519.1
DI1_FIELD: BT19549.1, J19519.2
DI2_FIELD: BT19554.1, J19519.3
DI3_FIELD: BT19555.1, J19519.4
DI4_FIELD: BT19556.1, J19519.5
DI5_FIELD: BT19557.1, J19519.6
DI6_FIELD: BT19558.1, J19519.7
DI7_FIELD: BT19559.1, J19519.8
DI8_FIELD: BT19560.1, J19520.1
DI9_FIELD: BT19561.1, J19520.2
DI10_FIELD: BT19539.1, J19520.3
DI11_FIELD: BT19540.1, J19520.4
DI12_FIELD: BT19541.1, J19520.5
DI13_FIELD: BT19542.1, J19520.6
DI14_FIELD: BT19543.1, J19520.7
DI15_FIELD: BT19544.1, J19520.8
DI16_FIELD: BT19545.1, J19521.1
DI17_FIELD: BT19546.1, J19521.2
DI18_FIELD: BT19547.1, J19521.3
DI19_FIELD: BT19548.1, J19521.4
DI20_FIELD: BT19550.1, J19521.5
DI21_FIELD: BT19551.1, J19521.6
DI22_FIELD: BT19552.1, J19521.7
DI23_FIELD: BT19553.1, J19521.8
DIR0_N: BT19562.1, J19501.4
DIR0_P: BT19563.1, J19501.3
DIR1_N: BT19568.1, J19502.4
DIR1_P: BT19569.1, J19502.3
DIR2_N: BT19570.1, J19503.4
DIR2_P: BT19571.1, J19503.3
DIR3_N: BT19572.1, J19504.4
DIR3_P: BT19573.1, J19504.3
DIR4_N: BT19574.1, J19505.4
DIR4_P: BT19575.1, J19505.3
DIR5_N: BT19576.1, J19506.4
DIR5_P: BT19577.1, J19506.3
DIR6_N: BT19578.1, J19507.4
DIR6_P: BT19579.1, J19507.3
DIR7_N: BT19580.1, J19508.4
DIR7_P: BT19581.1, J19508.3
DIR8_N: BT19582.1, J19509.4
DIR8_P: BT19583.1, J19509.3
DIR9_N: BT19584.1, J19510.4
DIR9_P: BT19585.1, J19510.3
DIR10_N: BT19564.1, J19511.4
DIR10_P: BT19565.1, J19511.3
DIR11_N: BT19566.1, J19512.4
DIR11_P: BT19567.1, J19512.3
DO00: BT19586.1, J19522.1
DO01: BT19587.1, J19522.2
DO02: BT19588.1, J19522.3
DO03: BT19589.1, J19522.4
DO04: BT19590.1, J19522.5
DO05: BT19591.1, J19522.6
DO06: BT19592.1, J19522.7
DO07: BT19593.1, J19522.8
DO08: BT19594.1, J19523.1
DO09: BT19595.1, J19523.2
DO10: BT19596.1, J19523.3
DO11: BT19597.1, J19523.4
DO12: BT19598.1, J19523.5
DO13: BT19599.1, J19523.6
DO14: BT195100.1, J19523.7
DO15: BT195101.1, J19523.8
EN0_COM: BT195102.1, J19501.9
EN0_NC: BT195103.1, J19501.10
EN0_NO: BT195104.1, J19501.8
EN1_COM: BT195111.1, J19502.9
EN1_NC: BT195112.1, J19502.10
EN1_NO: BT195113.1, J19502.8
EN2_COM: BT195114.1, J19503.9
EN2_NC: BT195115.1, J19503.10
EN2_NO: BT195116.1, J19503.8
EN3_COM: BT195117.1, J19504.9
EN3_NC: BT195118.1, J19504.10
EN3_NO: BT195119.1, J19504.8
EN4_COM: BT195120.1, J19505.9
EN4_NC: BT195121.1, J19505.10
EN4_NO: BT195122.1, J19505.8
EN5_COM: BT195123.1, J19506.9
EN5_NC: BT195124.1, J19506.10
EN5_NO: BT195125.1, J19506.8
EN6_COM: BT195126.1, J19507.9
EN6_NC: BT195127.1, J19507.10
EN6_NO: BT195128.1, J19507.8
EN7_COM: BT195129.1, J19508.9
EN7_NC: BT195130.1, J19508.10
EN7_NO: BT195131.1, J19508.8
EN8_COM: BT195132.1, J19509.9
EN8_NC: BT195133.1, J19509.10
EN8_NO: BT195134.1, J19509.8
EN9_COM: BT195135.1, J19510.9
EN9_NC: BT195136.1, J19510.10
EN9_NO: BT195137.1, J19510.8
EN10_COM: BT195105.1, J19511.9
EN10_NC: BT195106.1, J19511.10
EN10_NO: BT195107.1, J19511.8
EN11_COM: BT195108.1, J19512.9
EN11_NC: BT195109.1, J19512.10
EN11_NO: BT195110.1, J19512.8
ENC0_5V_LIMITED: BT195138.1, J19513.1
ENC0_A_N: BT195139.1, J19513.4
ENC0_A_P: BT195140.1, J19513.3
ENC0_B_N: BT195141.1, J19513.6
ENC0_B_P: BT195142.1, J19513.5
ENC0_Z_N: BT195143.1, J19513.8
ENC0_Z_P: BT195144.1, J19513.7
ENC1_5V_LIMITED: BT195145.1, J19514.1
ENC1_A_N: BT195146.1, J19514.4
ENC1_A_P: BT195147.1, J19514.3
ENC1_B_N: BT195148.1, J19514.6
ENC1_B_P: BT195149.1, J19514.5
ENC1_Z_N: BT195150.1, J19514.8
ENC1_Z_P: BT195151.1, J19514.7
ENC2_5V_LIMITED: BT195152.1, J19515.1
ENC2_A_N: BT195153.1, J19515.4
ENC2_A_P: BT195154.1, J19515.3
ENC2_B_N: BT195155.1, J19515.6
ENC2_B_P: BT195156.1, J19515.5
ENC2_Z_N: BT195157.1, J19515.8
ENC2_Z_P: BT195158.1, J19515.7
ENC3_5V_LIMITED: BT195159.1, J19516.1
ENC3_A_N: BT195160.1, J19516.4
ENC3_A_P: BT195161.1, J19516.3
ENC3_B_N: BT195162.1, J19516.6
ENC3_B_P: BT195163.1, J19516.5
ENC3_Z_N: BT195164.1, J19516.8
ENC3_Z_P: BT195165.1, J19516.7
EXT_PERMIT_IN: BT195166.1, J19534.2
FIELD_A_0V: BT195167.1, J19522.9, J19522.10, J19522.11, J19522.12
FIELD_B_0V: BT195168.1, C19504.1, J19519.11, J19519.12, J19520.11, J19520.12, J19521.11, J19521.12, J19523.9, J19523.10, J19523.11, J19523.12, J19534.9
FIELD_GND: BT195169.1, C19503.1, J19501.13, J19502.13, J19503.13, J19504.13, J19505.13, J19506.13, J19507.13, J19508.13, J19509.13, J19510.13, J19511.13, J19512.13, J19524.3, J19524.6
FREQ0_N: BT195170.1, J19525.4
FREQ0_P: BT195171.1, J19525.3
FREQ1_N: BT195172.1, J19525.6
FREQ1_P: BT195173.1, J19525.5
FREQ_5V_LIMITED: BT195174.1, J19525.1
FREQ_MOD_ID_TO_FRONTEND: BT195175.1, J19525.7
FREQ_MOD_PRESENT_TO_FRONTEND: BT195176.1, J19525.8
LOGIC_GND: BT195177.1, C19501.1, C19502.1, J19501.5, J19502.5, J19503.5, J19504.5, J19505.5, J19506.5, J19507.5, J19508.5, J19509.5, J19510.5, J19511.5, J19512.5, J19513.2, J19513.9, J19514.2, J19514.9, J19515.2, J19515.9, J19516.2, J19516.9, J19517.2, J19517.9, J19518.11, J19525.2, J19525.9, J19526.2, J19526.4
MPG_5V_LIMITED: BT195178.1, J19517.1
MPG_A_N: BT195179.1, J19517.4
MPG_A_P: BT195180.1, J19517.3
MPG_B_N: BT195181.1, J19517.6
MPG_B_P: BT195182.1, J19517.5
MPG_ENABLE: BT195183.1, J19517.8
MPG_MUL_X1: BT195184.1, J19518.7
MPG_MUL_X10: BT195185.1, J19518.8
MPG_MUL_X100: BT195186.1, J19518.9
MPG_PEND_AUX: BT195187.1, J19518.10
MPG_SEL_A: BT195188.1, J19518.4
MPG_SEL_B: BT195189.1, J19518.5
MPG_SEL_C: BT195190.1, J19518.6
MPG_SEL_X: BT195191.1, J19518.1
MPG_SEL_Y: BT195192.1, J19518.2
MPG_SEL_Z: BT195193.1, J19518.3
MPG_VREF_2V5: BT195194.1, J19517.7
PEN0_1: BT195195.1, J19527.1
PEN0_2: BT195196.1, J19527.2
PEN1_1: BT195197.1, J19528.1
PEN1_2: BT195198.1, J19528.2
PERMIT_OUT_1: BT195199.1, J19534.10
PERMIT_OUT_2: BT195200.1, J19534.11
PRB0_24V: BT195201.1, J19524.2
PRB0_IN: BT195202.1, J19524.1
PRB1_24V: BT195203.1, J19524.5
PRB1_IN: BT195204.1, J19524.4
PROCESS_PERMIT_IN: BT195205.1, J19534.3
PWM0: BT195206.1, J19526.1
PWM1: BT195207.1, J19526.3
PWM_5V_AUX: BT195208.1, J19526.5
RESET_ARM_IN: BT195209.1, J19534.5
RS485_A: BT195210.1, J19532.2
RS485_B: BT195211.1, J19532.1
RS485_COM: BT195212.1, C19508.1, J19532.3, J19532.6
RS485_TERM: BT195213.1, J19532.4
SAFETY_STATUS_IN: BT195214.1, J19534.4
SAFE_24V: BT195215.1, J19534.1
SENS24_G0: BT195216.1, J19519.9, J19519.10
SENS24_G1: BT195217.1, J19520.9, J19520.10
SENS24_G2: BT195218.1, J19521.9, J19521.10
STEP0_N: BT195219.1, J19501.2
STEP0_P: BT195220.1, J19501.1
STEP1_N: BT195225.1, J19502.2
STEP1_P: BT195226.1, J19502.1
STEP2_N: BT195227.1, J19503.2
STEP2_P: BT195228.1, J19503.1
STEP3_N: BT195229.1, J19504.2
STEP3_P: BT195230.1, J19504.1
STEP4_N: BT195231.1, J19505.2
STEP4_P: BT195232.1, J19505.1
STEP5_N: BT195233.1, J19506.2
STEP5_P: BT195234.1, J19506.1
STEP6_N: BT195235.1, J19507.2
STEP6_P: BT195236.1, J19507.1
STEP7_N: BT195237.1, J19508.2
STEP7_P: BT195238.1, J19508.1
STEP8_N: BT195239.1, J19509.2
STEP8_P: BT195240.1, J19509.1
STEP9_N: BT195241.1, J19510.2
STEP9_P: BT195242.1, J19510.1
STEP10_N: BT195221.1, J19511.2
STEP10_P: BT195222.1, J19511.1
STEP11_N: BT195223.1, J19512.2
STEP11_P: BT195224.1, J19512.1
STO_FB_IN: BT195243.1, J19534.8
