DeadlySIn777/Controller/hardware/motion_card/fpga_core.kicad_sch

## KiCad design hardware/motion_card/fpga_core.kicad_sch (2026-10-18)

Schematic: fpga_core.kicad_sch

Parts:
C1001, C1002, C1003, C1004, C1005, C1006, C1007, C1008, C1009, C1010, C1011, C1012, C1013, C1014, C1015, C1016, C1017, C1018, C1019, C1020, C1021, C1022, C1023, C1035, C1038: 0.1uF 16V X7R; C_0603_1608Metric; MPN 885012206046
C1024, C1028, C1029, C1030, C1031, C1032, C1033, C1034: 4.7uF 16V X7R; C_0805_2012Metric; MPN 885012207053
C1025, C1026, C1027, C1036, C1039: 1uF 16V X7R; C_0603_1608Metric; MPN 885012206052
C1037: 0.01uF 16V X7R; C_0603_1608Metric; MPN 885012206040
J1001: POWER / QUALIFIED SEQUENCER
J1002: JTAG SERVICE / NO POWER INJECTION
J1003: HOST SPI / 3V3 ONLY
J1004: HW PERMISSION / NO ESP MOTION AUTHORITY
J1005: TWELVE MOTOR STEP / DIR
J1006: ENABLE RESERVES / CIRCUITS ABSENT
J1007: HOME / 0-5 PRESENT; 6-11 RESERVED
J1008: ALARM / 0-5 PRESENT; 6-11 RESERVED
J1009: ENCODERS / 0-1 PRESENT; 2-3 RESERVED
J1010: AUX / EXISTING ISOLATED INPUTS
R1001, R1002: 33R 1%; R_0603_1608Metric; MPN CRCW060333R0FKEA
R1003, R1004, R1005, R1006, R1007, R1008, R1009, R1010, R1011, R1012, R1013, R1014, R1015, R1016, R1017, R1018, R1019, R1022, R1023, R1024, R1025: 10000R 1%; R_0603_1608Metric; MPN CRCW060310K0FKEA
R1020: 47000R 1%; R_0603_1608Metric; MPN CRCW060347K0FKEA
R1021: 1000R 1%; R_0603_1608Metric; MPN CRCW06031K00FKEA
U1001: T20F256I4 / CANDIDATE PIN ALLOCATION; T20F256_Efinix_NSMD; MPN T20F256I4
U1002: W25Q32JVSSIQ / x1 SPI; SOIC-8_5.3x5.3mm_P1.27mm; MPN W25Q32JVSSIQ
U1003: SN74LVC1G08DCKR / RESET AND; SOT-353_SC-70-5; MPN SN74LVC1G08DCKR
U1004: 74LVC1G17GW / CDONE DELAY SCHMITT; SOT-353_SC-70-5; MPN 74LVC1G17GW
U1005: SN74LVC1G08DCKR / USER RESET AND; SOT-353_SC-70-5; MPN SN74LVC1G08DCKR
Y1001: ASE-50.000MHZ-L-C-T; Oscillator_SMD_Abracon_ASE-4Pin_3.2x2.5mm; MPN ASE-50.000MHZ-L-C-T

Connections:
ALM0_FPGA: J1008.1, U1001.B12 (GPIOR_93)
ALM1_FPGA: J1008.2, U1001.B13 (GPIOR_97)
ALM2_FPGA: J1008.3, U1001.B15 (GPIOR_98)
ALM3_FPGA: J1008.4, U1001.C13 (GPIOR_99)
ALM4_FPGA: J1008.5, U1001.C16 (GPIOR_108)
ALM5_FPGA: J1008.6, U1001.E14 (GPIOR_110)
ALM6_FPGA: J1008.7, U1001.F12 (GPIOR_111)
ALM7_FPGA: J1008.8, U1001.D16 (GPIOR_116_CTRL15)
ALM8_FPGA: J1008.9, U1001.G13 (GPIOR_117_CTRL14)
ALM9_FPGA: J1008.10, U1001.F14 (GPIOR_118_CTRL13)
ALM10_FPGA: J1008.11, U1001.E16 (GPIOR_119_CTRL12)
ALM11_FPGA: J1008.12, U1001.E15 (GPIOR_120_CLK15)
CORE_1V2: C1001.1, C1002.1, C1003.1, C1004.1, C1005.1, C1006.1, C1007.1, C1008.1, C1009.1, C1024.1, C1025.1, C1026.1, C1027.1, J1001.1, U1001.E9 (VCC), U1001.F7 (VCCA_TL), U1001.F8 (VCC), U1001.F9 (VCC), U1001.G11 (VCCA_TR), U1001.J6 (VCC), U1001.J7 (VCC), U1001.K9 (VCC), U1001.K11 (VCCA_BR)
CYCLE_START_FPGA: J1010.8, U1001.H16 (GPIOR_130_CTRL9)
DIR0_FPGA: J1005.2, U1001.J5 (GPIOL_11)
DIR1_FPGA: J1005.4, U1001.K3 (GPIOL_15)
DIR2_FPGA: J1005.6, U1001.K1 (GPIOL_18)
DIR3_FPGA: J1005.8, U1001.H1 (GPIOL_22_CTRL2)
DIR4_FPGA: J1005.10, U1001.H2 (GPIOL_25_CLK1)
DIR5_FPGA: J1005.12, U1001.G3 (GPIOL_27_CLK3)
DIR6_FPGA: J1005.14, U1001.G2 (GPIOL_29_CLK5)
DIR7_FPGA: J1005.16, U1001.C1 (GPIOL_33_CTRL5)
DIR8_FPGA: J1005.18, U1001.F3 (GPIOL_35_CTRL7)
DIR9_FPGA: J1005.20, U1001.E1 (GPIOL_37)
DIR10_FPGA: J1005.22, U1001.G4 (GPIOL_42)
DIR11_FPGA: J1005.24, U1001.B1 (GPIOL_44)
DOOR_STATUS_FPGA: J1010.3, U1001.H13 (GPIOR_125_CLK10)
EN0_N_FPGA: J1006.1, U1001.H12 (GPIOR_139)
EN1_N_FPGA: J1006.2, U1001.J12 (GPIOR_141)
EN2_N_FPGA: J1006.3, U1001.L16 (GPIOR_143)
EN3_N_FPGA: J1006.4, U1001.M15 (GPIOR_144)
EN4_N_FPGA: J1006.5, U1001.M16 (GPIOR_145)
EN5_N_FPGA: J1006.6, U1001.P16 (GPIOR_146)
EN6_N_FPGA: J1006.7, U1001.L15 (GPIOR_147)
EN7_N_FPGA: J1006.8, U1001.K12 (GPIOR_148)
EN8_N_FPGA: J1006.9, U1001.N14 (GPIOR_153)
EN9_N_FPGA: J1006.10, U1001.N16 (GPIOR_154)
EN10_N_FPGA: J1006.11, U1001.P15 (GPIOR_155)
EN11_N_FPGA: J1006.12, U1001.M14 (GPIOR_156)
ENC0_A_FPGA: J1009.1, U1001.B5 (GPIOL_61)
ENC0_B_FPGA: J1009.2, U1001.A7 (GPIOL_62)
ENC0_Z_FPGA: J1009.3, U1001.B7 (GPIOL_63)
ENC1_A_FPGA: J1009.4, U1001.B6 (GPIOL_64)
ENC1_B_FPGA: J1009.5, U1001.A6 (GPIOL_65)
ENC1_Z_FPGA: J1009.6, U1001.E7 (GPIOL_68)
ENC2_A_FPGA: J1009.7, U1001.D9 (GPIOL_74_PLLIN0)
ENC2_B_FPGA: J1009.8, U1001.E8 (GPIOL_75_PLLIN1)
ENC2_Z_FPGA: J1009.9, U1001.C9 (GPIOR_76_PLLIN0)
ENC3_A_FPGA: J1009.10, U1001.D10 (GPIOR_77_PLLIN1)
ENC3_B_FPGA: J1009.11, U1001.B9 (GPIOR_80)
ENC3_Z_FPGA: J1009.12, U1001.C10 (GPIOR_81_MREFCLK)
FEED_HOLD_FPGA: J1010.7, U1001.H15 (GPIOR_129_CTRL10)
FPGA_CDONE: J1001.6, J1002.8, R1003.2, R1022.1, U1001.R1 (CDONE)
FPGA_CFG_CBSEL0: R1018.1, U1001.C7 (GPIOL_70_CBSEL0)
FPGA_CFG_CBSEL1: R1019.1, U1001.D7 (GPIOL_69_CBSEL1)
FPGA_CFG_CBUS0: R1009.2, U1001.K13 (GPIOR_151_CBUS0)
FPGA_CFG_CBUS1: R1008.2, U1001.L14 (GPIOR_150_CBUS1)
FPGA_CFG_CBUS2: R1007.2, U1001.R16 (GPIOR_149_CBUS2)
FPGA_CFG_CSI: R1004.2, U1001.N3 (GPIOL_04_CSI)
FPGA_CFG_NSTATUS: J1001.7, R1017.2, U1001.B8 (GPIOL_71_NSTATUS)
FPGA_CFG_TEST_N: R1005.2, U1001.L12 (GPIOR_158_TEST_N)
FPGA_CLK_50M: R1001.2, U1001.H3 (GPIOL_24_CLK0)
FPGA_CLK_SOURCE: R1001.1, Y1001.3 (OUT)
FPGA_CRESET_N: J1001.4, U1003.1 (A)
FPGA_ENDPOINT_READY: J1004.2, R1023.1, U1001.C4 (GPIOL_51)
FPGA_FLASH_CCK: R1002.2, U1002.6 (CLK)
FPGA_FLASH_CCK_SOURCE: R1002.1, U1001.M3 (GPIOL_01_CCK)
FPGA_FLASH_CS_N: R1006.2, U1001.P3 (GPIOL_00_SS_N), U1002.1 (CS_N)
FPGA_FLASH_IO2: R1014.2, U1002.3 (WP_N / IO2)
FPGA_FLASH_IO3: R1015.2, U1002.7 (HOLD_N / IO3)
FPGA_FLASH_MISO: U1001.N1 (GPIOL_09_CDI1), U1002.2 (DO / IO1)
FPGA_FLASH_MOSI: U1001.L3 (GPIOL_08_CDI0), U1002.5 (DI / IO0)
FPGA_INHIBIT_FAULT: J1004.6, U1001.A4 (GPIOL_59)
FPGA_JTAG_TCK: J1002.3, R1010.2, U1001.M2 (TCK)
FPGA_JTAG_TDI: J1002.5, R1011.2, U1001.K5 (TDI)
FPGA_JTAG_TDO: J1002.6, R1013.2, U1001.L5 (TDO)
FPGA_JTAG_TMS: J1002.4, R1012.2, U1001.M1 (TMS)
FPGA_LINK_FAULT: J1003.6, U1001.A3 (GPIOL_57)
FPGA_LOCAL_RESET_N: J1001.5, J1004.7, R1020.2, R1021.1, U1001.P1 (CRESET_N), U1003.4 (Y)
FPGA_MOTION_REQUEST: J1004.3, R1024.1, U1001.B3 (GPIOL_52)
FPGA_PROGRESS_M: J1004.4, R1025.1, U1001.E4 (GPIOL_55)
FPGA_SERVICE_RUN_N: J1002.7, R1016.2, U1003.2 (B), U1005.2 (B)
FPGA_TIMING_FAULT: J1003.8, U1001.E5 (GPIOL_60)
FPGA_USER_RESET_DELAYED: U1004.4 (Y), U1005.1 (A)
FPGA_USER_RESET_N: U1001.D5 (GPIOL_49), U1005.4 (Y)
FPGA_USER_RESET_RC: C1039.1, R1022.2, U1004.2 (A)
FPGA_WATCHDOG_FAULT: J1003.7, U1001.C6 (GPIOL_58)
HOME0_FPGA: J1007.1, U1001.B10 (GPIOR_82)
HOME1_FPGA: J1007.2, U1001.B11 (GPIOR_83)
HOME2_FPGA: J1007.3, U1001.A11 (GPIOR_84)
HOME3_FPGA: J1007.4, U1001.C12 (GPIOR_85)
HOME4_FPGA: J1007.5, U1001.C11 (GPIOR_86)
HOME5_FPGA: J1007.6, U1001.D12 (GPIOR_89)
HOME6_FPGA: J1007.7, U1001.C14 (GPIOR_102)
HOME7_FPGA: J1007.8, U1001.D13 (GPIOR_103)
HOME8_FPGA: J1007.9, U1001.B16 (GPIOR_106)
HOME9_FPGA: J1007.10, U1001.A14 (GPIOR_90)
HOME10_FPGA: J1007.11, U1001.E12 (GPIOR_91)
HOME11_FPGA: J1007.12, U1001.B14 (GPIOR_92)
HOST_SPI_CS_N: J1003.1, U1001.B2 (GPIOL_45)
HOST_SPI_MISO: J1003.4, U1001.C3 (GPIOL_48)
HOST_SPI_MOSI: J1003.3, U1001.D4 (GPIOL_47)
HOST_SPI_SCLK: J1003.2, U1001.D3 (GPIOL_46)
IO_3V3: C1010.1, C1011.1, C1012.1, C1013.1, C1014.1, C1015.1, C1016.1, C1017.1, C1018.1, C1019.1, C1020.1, C1021.1, C1022.1, C1023.1, C1028.1, C1029.1, C1030.1, C1031.1, C1032.1, C1033.1, C1034.1, C1035.1, C1036.1, C1037.1, C1038.1, J1001.2, J1002.1, J1010.11, R1003.1, R1004.1, R1005.1, R1006.1, R1007.1, R1008.1, R1009.1, R1010.1, R1011.1, R1012.1, R1013.1, R1014.1, R1015.1, R1016.1, R1017.1, R1020.1, U1001.E10 (VCCIO3A_3B_3C), U1001.F6 (VCCIO1D_1E), U1001.F10 (VCCIO3A_3B_3C), U1001.F11 (VCCIO3A_3B_3C), U1001.G6 (VCCIO1D_1E), U1001.H6 (VCCIO1B_1C), U1001.H7 (VCCIO1B_1C), U1001.J10 (VCCIO3D_3E), U1001.J11 (VCCIO3D_3E), U1001.K6 (VCCIO1A), U1001.L6 (VCCIO4B), U1001.L7 (VCCIO4B), U1001.L10 (VCCIO4A), U1001.L11 (VCCIO4A), U1002.8 (VCC), U1003.5 (VCC), U1004.5 (VCC), U1005.5 (VCC), Y1001.1 (STBY_N), Y1001.4 (VDD)
LOGIC_GND: C1001.2, C1002.2, C1003.2, C1004.2, C1005.2, C1006.2, C1007.2, C1008.2, C1009.2, C1010.2, C1011.2, C1012.2, C1013.2, C1014.2, C1015.2, C1016.2, C1017.2, C1018.2, C1019.2, C1020.2, C1021.2, C1022.2, C1023.2, C1024.2, C1025.2, C1026.2, C1027.2, C1028.2, C1029.2, C1030.2, C1031.2, C1032.2, C1033.2, C1034.2, C1035.2, C1036.2, C1037.2, C1038.2, C1039.2, J1001.3, J1001.8, J1002.2, J1003.5, J1004.8, J1010.12, R1018.2, R1019.2, R1021.2, R1023.2, R1024.2, R1025.2, U1001.A1 (GND), U1001.A5 (GND), U1001.A12 (GND), U1001.A16 (GND), U1001.D2 (GND), U1001.D15 (GND), U1001.G7 (GND), U1001.G8 (GND), U1001.G9 (GND), U1001.G10 (GND), U1001.H8 (GND), U1001.H9 (GND), U1001.H10 (GND), U1001.H11 (GND), U1001.J1 (GND), U1001.J8 (GND), U1001.J9 (GND), U1001.J16 (GND), U1001.K7 (GND), U1001.K8 (GND), U1001.K10 (GND), U1001.L8 (GND), U1001.L9 (GND), U1001.N2 (GND), U1001.N15 (GND), U1001.R7 (GND), U1001.R10 (GND), U1001.T1 (GND), U1001.T4 (GND), U1001.T13 (GND), U1001.T16 (GND), U1002.4 (GND), U1003.3 (GND), U1004.3 (GND), U1005.3 (GND), Y1001.2 (GND)
LUBE_STATUS_FPGA: J1010.9, U1001.J15 (GPIOR_131_CTRL8)
PROBE_FPGA: J1010.1, U1001.G12 (GPIOR_121_CLK14)
PROTECTIVE_STATUS_FPGA: J1010.4, U1001.G16 (GPIOR_126_CLK9)
RAW_INHIBIT_N: J1004.1, U1001.A2 (GPIOL_50)
SPARE_FPGA: J1010.10, U1001.K14 (GPIOR_138)
SPINDLE_FAULT_FPGA: J1010.5, U1001.G14 (GPIOR_127_CLK8)
SPINDLE_READY_FPGA: J1010.6, U1001.H14 (GPIOR_128_CTRL11)
STEP0_FPGA: J1005.1, U1001.P2 (GPIOL_02)
STEP1_FPGA: J1005.3, U1001.J4 (GPIOL_14)
STEP2_FPGA: J1005.5, U1001.J3 (GPIOL_16)
STEP3_FPGA: J1005.7, U1001.K2 (GPIOL_19)
STEP4_FPGA: J1005.9, U1001.L1 (GPIOL_23_CTRL3)
STEP5_FPGA: J1005.11, U1001.H4 (GPIOL_26_CLK2)
STEP6_FPGA: J1005.13, U1001.G5 (GPIOL_28_CLK4)
STEP7_FPGA: J1005.15, U1001.F1 (GPIOL_30_CLK6)
STEP8_FPGA: J1005.17, U1001.E2 (GPIOL_34_CTRL6)
STEP9_FPGA: J1005.19, U1001.D1 (GPIOL_36)
STEP10_FPGA: J1005.21, U1001.E3 (GPIOL_39)
STEP11_FPGA: J1005.23, U1001.F4 (GPIOL_43)
TOOLSETTER_FPGA: J1010.2, U1001.G15 (GPIOR_124_CLK11)
TX_PERMIT: J1004.5, U1001.E6 (GPIOL_56)

Notes on the sheet:
T20F256 FPGA CORE / MINIMUM 8 MOTOR CHANNELS, 12-CHANNEL PIN CAPACITY CANDIDATE
Exact 256 balls: Efinix T20-PINOUT worksheet T20F256. Pin allocation is a board candidate, NOT vendor fit or routed timing. All VCCIO=3.3V. All VCC/VCCA=1.2V. No 5V-tolerant FPGA connection. No native LVDS: REF_RES intentionally NC.
One 100nF per supply ball; bulk per physical supply group. Decoupling is a layout-study allowance, not a PDN proof. Active SPI x1 straps111; CSI/TEST high. Flash bus reserved from user RTL. CCK damping33R is provisional. CDONE is open-drain with10k pullup; status does not grant motion permission. C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
RESET: U3 combines qualified upstream reset with service RUN for configuration reset only. U4/U5 make a separate CDONE-qualified user-logic reset; R22/C39 provide a candidate post-CDONE delay and service RUN can hold it low through a JTAG handoff. No programmer output fights the sequencer. User-log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
NC crosses are genuine unused GPIO/config outputs and REF_RES only; every supply/GND ball is connected. Boundary symbols are not released connectors. No footprint approval, PCB, DRC, bitstream, qualification or fabrication files.
J1-J10 ARE INTERNAL LOGIC BOUNDARIES, NOT FIELD TERMINALS. Enables and extra home/alarm/encoder channels are reserves only. CRESET47k/1k plus two internal pullups screened. The separate 10k/1uF CDONE reset delay is a candidate, not a guaranteed time or safety function; threshold/partial-power confi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
