DeadlySIn777/Controller/hardware/motion_card/watchdog_conditioning.kicad_sch

## KiCad design hardware/motion_card/watchdog_conditioning.kicad_sch (2026-10-18)

Schematic: watchdog_conditioning.kicad_sch

Parts:
B3001: INTERNAL REVIEW BOUNDARY
C3001, C3002: 3.3nF C0G 50V 5%; C_0603_1608Metric; MPN CL10C332JB8NNNC
C3003, C3004, C3005, C3006, C3007, C3008, C3009: 100nF X7R 100V 10%; C_0603_1608Metric; MPN GRM188R72A104KA35D
R3001, R3002: 10k 1%; R_0603_1608Metric; MPN CRCW060310K0FKEA
R3003, R3004, R3005, R3007, R3013: 4.7k 1%; R_0603_1608Metric; MPN CRCW06034K70FKEA
R3006, R3008, R3009, R3010, R3011, R3012: 100k 1%; R_0603_1608Metric; MPN CRCW0603100KFKEA
U3001, U3002: TPS3851G18SDRBT; TPS3851_DRB8; MPN TPS3851G18SDRBT
U3003, U3004: SN74LVC1G34DBVR; SOT-23-5; MPN SN74LVC1G34DBVR
U3005: SN74LVC2G17DBVR; SOT-23-6; MPN SN74LVC2G17DBVR
U3006, U3007: SN74LVC1G08DCKR; SOT-353_SC-70-5; MPN SN74LVC1G08DCKR

Connections:
FPGA_MOTION_REQUEST: B3001.3, R3003.1, U3006.1 (A)
FPGA_OUTPUT_REQUEST: B3001.4, R3004.1, U3007.1 (A)
FPGA_PROGRESS_M: B3001.5, R3005.1, U3003.2 (A)
FPGA_PROGRESS_O: B3001.6, R3007.1, U3004.2 (A)
FPGA_USER_RESET_N: B3001.9, R3013.1, U3006.2 (B), U3007.2 (B)
IO_3V3: B3001.1, C3003.1, C3004.1, C3005.1, C3006.1, C3007.1, C3008.1, C3009.1, R3001.1, R3002.1, U3001.1 (VDD), U3002.1 (VDD), U3003.5 (VCC), U3004.5 (VCC), U3005.5 (VCC), U3006.5 (VCC), U3007.5 (VCC)
LOGIC_GND: B3001.2, C3001.2, C3002.2, C3003.2, C3004.2, C3005.2, C3006.2, C3007.2, C3008.2, C3009.2, R3003.2, R3004.2, R3005.2, R3006.2, R3007.2, R3008.2, R3009.2, R3010.2, R3011.2, R3012.2, R3013.2, U3001.4 (GND), U3001.9 (EP), U3002.4 (GND), U3002.9 (EP), U3003.3 (GND), U3004.3 (GND), U3005.2 (GND), U3006.3 (GND), U3007.3 (GND)
WD_M_CWD: C3001.1, U3001.2 (CWD)
WD_M_HEALTH_RAW: R3001.2, U3001.7 (WDO_N), U3001.8 (RESET_N), U3005.1 (1A)
WD_M_OK: B3001.7, R3009.1, U3005.6 (1Y)
WD_M_SET1_BUF: R3011.1, U3001.5 (SET1), U3006.4 (Y)
WD_M_WDI_BUF: R3006.1, U3001.6 (WDI), U3003.4 (Y)
WD_O_CWD: C3002.1, U3002.2 (CWD)
WD_O_HEALTH_RAW: R3002.2, U3002.7 (WDO_N), U3002.8 (RESET_N), U3005.3 (2A)
WD_O_OK: B3001.8, R3010.1, U3005.4 (2Y)
WD_O_SET1_BUF: R3012.1, U3002.5 (SET1), U3007.4 (Y)
WD_O_WDI_BUF: R3008.1, U3002.6 (WDI), U3004.4 (Y)

Notes on the sheet:
IS-2 PROPOSAL: DUAL WATCHDOG STARTUP CONDITIONING - SEPARATE REVIEW CANDIDATE
NOT CONNECTED TO THE ASSEMBLY. No complete permission chain, latches, field outputs, PCB or physical qualification.
Separate timers / shared IO_3V3 and LOGIC_GND / G18 threshold is not a 3.3V power-good qualification / all inputs INTERNAL logic.
4.7k FPGA-facing pulls; SET1 = request AND FPGA_USER_RESET_N. Active-HIGH polarity / 1us pulse contract unchanged. MR open.
WDI: one 1us high pulse, idle LOW. FALLING edges feed timer. Old toggle-per-UPDATE gateware is INCOMPATIBLE. 3.3nF C0G: calculated timing, never a measured20ms proof.
Each RESET + WDO wired-AND with 10k pull-up. WD_M_OK / WD_O_OK have100k pulls; partial power UNQUALIFIED. No sticky permission latch in this block.
4.7k replaces four FPGA-facing100k pulls. Two SET1 AND gates add reset guard / LOW drive. Same request polarity; separate proposals only. SET1 pin leakage has NO published maximum. Loaded LOW, reset slew and partial power UNQUALIFIED.
DRB copper-pad candidate only: paste/stencil, thermal vias, CWD guarding/cleanliness/leakage, routing, partial power and brownout remain unqualified.
