DeadlySIn777/Controller/hardware/power_sequence/power_sequence.kicad_sch

## KiCad design hardware/power_sequence/power_sequence.kicad_sch (2026-10-18)

Schematic: power_sequence.kicad_sch

Parts:
C1, C2, C3, C4, C5, C6: 100nF 25V X7R 20%; C_0603_1608Metric
JCTRL1: INTEGRATION BOUNDARY
JRAIL1: INTEGRATION BOUNDARY
R1: 87.9k 0.01% 5ppm; R_0603_1608Metric; MPN PLT0603Z8792LST1
R7, R15, R47, R55, R67, R75: 10k 0.01% 5ppm; R_0603_1608Metric; MPN PLT0603Z1002LST1
R9: 92.1k 0.01% 5ppm; R_0603_1608Metric; MPN PLT0603Z9212LST1
R21: 1.10k 0.01% 5ppm; R_0603_1608Metric; MPN PLT0603Z1101LST1
R22: 255 0.01% 5ppm; R_0603_1608Metric; MPN PLT0603Z2550LST1
R27, R35: 1k 0.01% 5ppm; R_0603_1608Metric; MPN PLT0603Z1001LST1
R29: 1.15k 0.01% 5ppm; R_0603_1608Metric; MPN PLT0603Z1151LST1
R30: 294 0.01% 5ppm; R_0603_1608Metric; MPN PLT0603Z2940LST1
R31: 1 1% 100ppm; R_0603_1608Metric; MPN CRCW06031R00FKEA
R41, R61: 54.5k 0.01% 5ppm; R_0603_1608Metric; MPN PLT0603Z5452LST1
R49, R69: 57.5k 0.01% 5ppm; R_0603_1608Metric; MPN PLT0603Z5752LST1
R101, R102, R104: 3.3k 1%; R_0603_1608Metric; MPN CRCW06033K30FKEA
R103, R105, R107: 10k 1%; R_0603_1608Metric; MPN CRCW060310K0FKEA
R106: 6.8k 1%; R_0603_1608Metric; MPN CRCW06036K80FKEA
R108, R111, R113: 47k 1%; R_0603_1608Metric; MPN CRCW060347K0FKEA
R109, R112: 470k 1%; R_0603_1608Metric; MPN CRCW0603470KFKEA
R110: 4.7k 1%; R_0603_1608Metric; MPN CRCW06034K70FKEA
U1, U2, U3, U4: LTC2962HUD#TRPBF; LTC2962_UD16; MPN LTC2962HUD#TRPBF
U5, U6: SN74LVC1G17DBVR; SOT-23-5; MPN SN74LVC1G17DBVR

Connections:
CORE_1V2: JRAIL1.2, R21.1, R29.1
CORE_1V2_EN: JCTRL1.1, R102.2, R103.1
CORE_1V2_OV_SENSE: R31.2, R35.1, U2.15 (V2)
CORE_1V2_UV_SENSE: R22.2, R27.1, U2.16 (V1)
CORE_5V: C1.1, C2.1, C3.1, C4.1, JRAIL1.1, R1.1, R9.1, R101.1, R106.1, R108.1, R111.1, U1.1 (RDIS), U1.2 (MR), U1.4 (VCC), U1.10 (RT), U1.13 (V4), U1.14 (V3), U2.1 (RDIS), U2.4 (VCC), U2.10 (RT), U2.13 (V4), U2.14 (V3), U3.1 (RDIS), U3.4 (VCC), U3.10 (RT), U3.13 (V4), U3.14 (V3), U4.1 (RDIS), U4.4 (VCC), U4.10 (RT), U4.13 (V4), U4.14 (V3)
CORE_5V_OV_SENSE: R9.2, R15.1, U1.15 (V2)
CORE_5V_UV_SENSE: R1.2, R7.1, U1.16 (V1)
ESP_3V3: C6.1, JRAIL1.4, R61.1, R69.1, U6.5 (VCC)
ESP_3V3_EN: JCTRL1.3, R104.2, R105.1
ESP_3V3_OV_SENSE: R69.2, R75.1, U4.15 (V2)
ESP_3V3_UV_SENSE: R61.2, R67.1, U4.16 (V1)
ESP_CHIP_PU: JCTRL1.5, R113.1, U6.4 (Y)
FPGA_CRESET_N: JCTRL1.4, R110.1, U5.4 (Y)
IO_3V3: C5.1, JRAIL1.3, R41.1, R49.1, U5.5 (VCC)
IO_3V3_EN: JCTRL1.2, R106.2, R107.1, U2.12 (RST), U3.2 (MR)
IO_3V3_OV_SENSE: R49.2, R55.1, U3.15 (V2)
IO_3V3_UV_SENSE: R41.2, R47.1, U3.16 (V1)
LOGIC_GND: C1.2, C2.2, C3.2, C4.2, C5.2, C6.2, JCTRL1.7, JRAIL1.5, R7.2, R15.2, R27.2, R35.2, R47.2, R55.2, R67.2, R75.2, R103.2, R105.2, R107.2, R109.2, R110.2, R112.2, R113.2, U1.3 (DVCC), U1.7 (PG2), U1.11 (GND), U1.17 (EP), U2.3 (DVCC), U2.7 (PG2), U2.11 (GND), U2.17 (EP), U3.3 (DVCC), U3.7 (PG2), U3.11 (GND), U3.17 (EP), U4.3 (DVCC), U4.7 (PG2), U4.11 (GND), U4.17 (EP), U5.3 (GND), U6.3 (GND)
SEQ_5V_OK: JCTRL1.6, R101.2, R102.1, R104.1, U1.12 (RST), U2.2 (MR), U4.2 (MR)
SEQ_ESP_RESET_GOOD: R111.2, R112.1, U4.12 (RST), U6.2 (A)
SEQ_FPGA_RESET_GOOD: R108.2, R109.1, U3.12 (RST), U5.2 (A)
SEQ_OV2_1: R29.2, R30.1
SEQ_OV2_2: R30.2, R31.1
SEQ_REF1: U1.5 (REF), U1.6 (PG1), U1.8 (PG3), U1.9 (PG4)
SEQ_REF2: U2.5 (REF), U2.6 (PG1), U2.8 (PG3), U2.9 (PG4)
SEQ_REF3: U3.5 (REF), U3.6 (PG1), U3.8 (PG3), U3.9 (PG4)
SEQ_REF4: U4.5 (REF), U4.6 (PG1), U4.8 (PG3), U4.9 (PG4)
SEQ_UV2_1: R21.2, R22.1

Notes on the sheet:
1. CORE_5V window / autonomous release
PG1=REF: UV; PG2=GND: OV. Unused V3/V4=VCC, PG3/4=REF. RT=VCC: 160-240ms release. RDIS=VCC: margin override disabled.
2. CORE_1V2 window / autonomous release
3. IO_3V3 window / autonomous release
4. ESP_3V3 window / autonomous release
AUTONOMOUS POWER WINDOW / RESET CANDIDATE - NOT MACHINE PERMISSION
CORE5 -> core + ESP enables; valid core -> IO enable. IO qualifier -> FPGA reset. ESP qualifier -> ESP reset only: ESP fault does not reset FPGA through this circuit. Every EN also has the existing regulator10k pulldown. No active-high external driver allowed. 5V/internal pullups never directly dri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
Core threshold static margins are sub-mV at some corners. Aging, stress, ripple and transient response remain release blockers. Comparator40us maximum applies only at10% overdrive. No guaranteed brownout slew, powered-off regulator discharge, shutdown order or restart latch. FPGA package/PLL filter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
