DeadlySIn777/Controller/reports/motherboard-fpga-source-20260930/candidate/motherboard_fast_inputs.kicad_sch

## KiCad design reports/motherboard-fpga-source-20260930/candidate/motherboard_fast_inputs.kicad_sch (2026-10-18)

Schematic: motherboard_fast_inputs.kicad_sch

Parts:
B7001: XE0 FUNCTION / NONPHYSICAL
B7002: XE1 FUNCTION / NONPHYSICAL
B7003: XE2 FUNCTION / NONPHYSICAL
B7004: XE3 FUNCTION / NONPHYSICAL
B7005: XF FUNCTION / NONPHYSICAL
B7006: XH1 FUNCTION / NONPHYSICAL
B7007: EXTERNALLY PROTECTED FEEDS / NONPHYSICAL
B7008: FPGA LOGIC BOUNDARY / NONPHYSICAL
B7009: MISSING FRONTEND HANDOFF / NONPHYSICAL
C7001, C7003, C7005, C7007: 100nF 100V X7R; C_0603_1608Metric; MPN GRM188R72A104KA35D
C7002, C7004, C7006, C7008: 1uF 16V X7R; C_0603_1608Metric; MPN 885012206052
R7001, R7002, R7003, R7004, R7005, R7006, R7007, R7008, R7009, R7010, R7011, R7012, R7013, R7014: 120R 1% 0.5W / FIT; R_1210_3225Metric; MPN CRCW1210120RFKEA
R7015, R7016: 120R 1% 0.5W / DNP; R_1210_3225Metric; MPN CRCW1210120RFKEA; not fitted
U7001, U7002, U7003, U7004: AM26LV32EIPWR; TSSOP-16_4.4x5mm_P0.65mm; MPN AM26LV32EIPWR

Connections:
CHASSIS: B7001.10, B7002.10, B7003.10, B7004.10, B7005.10, B7006.10, B7007.9
ENC0_5V_LIMITED: B7001.1, B7007.1
ENC0_A_FPGA: B7008.3, U7001.3 (1Y)
ENC0_A_N: B7001.4, R7001.2, U7001.1 (1B)
ENC0_A_P: B7001.3, R7001.1, U7001.2 (1A)
ENC0_B_FPGA: B7008.4, U7001.5 (2Y)
ENC0_B_N: B7001.6, R7002.2, U7001.7 (2B)
ENC0_B_P: B7001.5, R7002.1, U7001.6 (2A)
ENC0_Z_FPGA: B7008.5, U7001.11 (3Y)
ENC0_Z_N: B7001.8, R7003.2, U7001.9 (3B)
ENC0_Z_P: B7001.7, R7003.1, U7001.10 (3A)
ENC1_5V_LIMITED: B7002.1, B7007.2
ENC1_A_FPGA: B7008.6, U7001.13 (4Y)
ENC1_A_N: B7002.4, R7004.2, U7001.15 (4B)
ENC1_A_P: B7002.3, R7004.1, U7001.14 (4A)
ENC1_B_FPGA: B7008.7, U7002.3 (1Y)
ENC1_B_N: B7002.6, R7005.2, U7002.1 (1B)
ENC1_B_P: B7002.5, R7005.1, U7002.2 (1A)
ENC1_Z_FPGA: B7008.8, U7002.5 (2Y)
ENC1_Z_N: B7002.8, R7006.2, U7002.7 (2B)
ENC1_Z_P: B7002.7, R7006.1, U7002.6 (2A)
ENC2_5V_LIMITED: B7003.1, B7007.3
ENC2_A_FPGA: B7008.9, U7002.11 (3Y)
ENC2_A_N: B7003.4, R7007.2, U7002.9 (3B)
ENC2_A_P: B7003.3, R7007.1, U7002.10 (3A)
ENC2_B_FPGA: B7008.10, U7002.13 (4Y)
ENC2_B_N: B7003.6, R7008.2, U7002.15 (4B)
ENC2_B_P: B7003.5, R7008.1, U7002.14 (4A)
ENC2_Z_FPGA: B7008.11, U7003.3 (1Y)
ENC2_Z_N: B7003.8, R7009.2, U7003.1 (1B)
ENC2_Z_P: B7003.7, R7009.1, U7003.2 (1A)
ENC3_5V_LIMITED: B7004.1, B7007.4
ENC3_A_FPGA: B7008.12, U7003.5 (2Y)
ENC3_A_N: B7004.4, R7010.2, U7003.7 (2B)
ENC3_A_P: B7004.3, R7010.1, U7003.6 (2A)
ENC3_B_FPGA: B7008.13, U7003.11 (3Y)
ENC3_B_N: B7004.6, R7011.2, U7003.9 (3B)
ENC3_B_P: B7004.5, R7011.1, U7003.10 (3A)
ENC3_Z_FPGA: B7008.14, U7003.13 (4Y)
ENC3_Z_N: B7004.8, R7012.2, U7003.15 (4B)
ENC3_Z_P: B7004.7, R7012.1, U7003.14 (4A)
FREQ0_FPGA: B7008.15, U7004.3 (1Y)
FREQ0_N: B7005.4, R7013.2, U7004.1 (1B)
FREQ0_P: B7005.3, R7013.1, U7004.2 (1A)
FREQ1_FPGA: B7008.16, U7004.5 (2Y)
FREQ1_N: B7005.6, R7014.2, U7004.7 (2B)
FREQ1_P: B7005.5, R7014.1, U7004.6 (2A)
FREQ_5V_LIMITED: B7005.1, B7007.5
FREQ_MOD_ID_TO_FRONTEND: B7005.7, B7009.1
FREQ_MOD_PRESENT_TO_FRONTEND: B7005.8, B7009.2
IO_3V3: B7008.1, C7001.1, C7002.1, C7003.1, C7004.1, C7005.1, C7006.1, C7007.1, C7008.1, U7001.4 (G), U7001.12 (~G), U7001.16 (VCC), U7002.4 (G), U7002.12 (~G), U7002.16 (VCC), U7003.4 (G), U7003.12 (~G), U7003.16 (VCC), U7004.4 (G), U7004.12 (~G), U7004.16 (VCC)
LOGIC_GND: B7001.2, B7001.9, B7002.2, B7002.9, B7003.2, B7003.9, B7004.2, B7004.9, B7005.2, B7005.9, B7006.2, B7006.9, B7007.8, B7008.2, C7001.2, C7002.2, C7003.2, C7004.2, C7005.2, C7006.2, C7007.2, C7008.2, U7001.8 (GND), U7002.8 (GND), U7003.8 (GND), U7004.8 (GND)
MPG_5V_LIMITED: B7006.1, B7007.6
MPG_A_FPGA: B7008.17, U7004.11 (3Y)
MPG_A_N: B7006.4, R7015.2, U7004.9 (3B)
MPG_A_P: B7006.3, R7015.1, U7004.10 (3A)
MPG_B_FPGA: B7008.18, U7004.13 (4Y)
MPG_B_N: B7006.6, R7016.2, U7004.15 (4B)
MPG_B_P: B7006.5, R7016.1, U7004.14 (4A)
MPG_ENABLE_TO_STATUS: B7006.8, B7009.3
MPG_VREF_2V5: B7006.7, B7007.7

Notes on the sheet:
U1: four used receiver paths, G and /G tied IO_3V3 3.0–3.6V supply; no motion-permission authority. 0.1uF bypass close to VCC/GND; 1uF local bulk.
U2: four used receiver paths, G and /G tied IO_3V3 3.0–3.6V supply; no motion-permission authority. 0.1uF bypass close to VCC/GND; 1uF local bulk.
U3: four used receiver paths, G and /G tied IO_3V3 3.0–3.6V supply; no motion-permission authority. 0.1uF bypass close to VCC/GND; 1uF local bulk.
U4: four used receiver paths, G and /G tied IO_3V3 3.0–3.6V supply; no motion-permission authority. 0.1uF bypass close to VCC/GND; 1uF local bulk.
IS-2 MOTHERBOARD: FOUR ABZ + TWO FREQUENCY + MPG A/B RECEIVER REGION r0.1
All 16 receiver channels used; no receiver output NC. No galvanic isolation or cable-line-fault detector here. 14 fitted 120R terminations; MPG R15/R16 DNP to avoid loading a 1mA TTL reference. Differential MPG needs a qualified termination variant. Terminated/disconnected or shorted pairs do not h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
BOUNDARIES ARE NONPHYSICAL: no unverified connector MPN/footprint. Preserve XE0–3 / XF / XH1 logical field ordering. 5V protected feeds and MPG_VREF enter from future parent regions; this block does not generate or protect them. Input bound: RS422 5.5V maximum differential for termination arithmeti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
