DeadlySIn777/Controller/reports/motherboard-integration-20260930/r18-2359-comms-staged-source/motherboard_comms.kicad_sch

## KiCad design reports/motherboard-integration-20260930/r18-2359-comms-staged-source/motherboard_comms.kicad_sch (2026-10-18)

Schematic: motherboard_comms.kicad_sch

Parts:
C14801, C14815, C14819, C14826, C14830: 1000nF50V; C_0603_1608Metric; MPN GRM188R71H105KA12D
C14802: 1nF50V; C_0603_1608Metric; MPN GRM1885C1H102JA01D
C14803, C14816, C14817, C14820, C14821, C14827, C14828, C14831, C14832: 22000nF10V; C_1206_3216Metric; MPN GCM31CR71A226KE02L
C14804, C14805, C14806, C14807, C14808, C14809, C14810, C14811, C14812, C14813, C14822, C14823, C14824, C14833, C14834, C14835, C14836, C14837, C14838, C14839: 100nF100V; C_0603_1608Metric; MPN GRM188R72A104KA35D
C14814, C14818, C14825, C14829: 10nF50V; C_0402_1005Metric; MPN GRM155R71H103KA88D
J14801: PARENT: actual parent powers and module-own super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
J14802: PARENT: exact qualified compute UART/SPI1; GPIO14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
J14803: PARENT: actual ACC PD0/PD1 observations, no ACC d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
J14804: PARENT: actual parent field terminals; parent own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
R14801, R14816, R14818: 4700R1%; R_0603_1608Metric; MPN CRCW06034K70FKEA
R14802: 100R1%; R_0603_1608Metric; MPN CRCW0603100RFKEA
R14803, R14807, R14808, R14809, R14810, R14811, R14813, R14814, R14815, R14817, R14819, R14820, R14825, R14826, R14831: 10000R1%; R_0603_1608Metric; MPN CRCW060310K0FKEA
R14804, R14805, R14806, R14812: 22R1%; R_0603_1608Metric; MPN CRCW060322R0FKEA
R14821: 68100R0.1%; R_0603_1608Metric; MPN TNPW060368K1BEEA
R14822, R14824, R14828, R14830: 10000R0.1%; R_0603_1608Metric; MPN TNPW060310K0BEEA
R14823: 78700R0.1%; R_0603_1608Metric; MPN TNPW060378K7BEEA
R14827: 107000R0.1%; R_0603_1608Metric; MPN TNPW0603107KBEEA
R14829: 123000R0.1%; R_0603_1608Metric; MPN TNPW0603123KBEEA
R14832, R14833: 120R1%; R_2512_6332Metric; MPN CRCW2512120RFKEG
U14801: TPS22918DBVR; SOT-23-6; MPN TPS22918DBVR
U14802: TPS3839K33DBZR; TPS3839_DBZ3_TI; MPN TPS3839K33DBZR
U14803, U14811, U14821, U14822: SN74LVC1G08DBVR; SOT-23-5; MPN SN74LVC1G08DBVR
U14804: SN74LVC1G14DBVR; SOT-23-5; MPN SN74LVC1G14DBVR
U14805: 74LVC125APW,118; TSSOP-14_4.4x5mm_P0.65mm; MPN 74LVC125APW,118
U14806: MCP2518FDT-E/SL; SOIC-14_3.9x8.7mm_P1.27mm; MPN MCP2518FDT-E/SL
U14807: ASV-40.000MHZ-LC-T; Oscillator_SMD_Abracon_ASV-4Pin_7.0x5.1mm; MPN ASV-40.000MHZ-LC-T
U14808, U14809: SN74LVC1G125DBVR; SOT-23-5; MPN SN74LVC1G125DBVR
U14810: SN74LVC1G32DBVR; SOT-23-5; MPN SN74LVC1G32DBVR
U14812: ISOW1432DFMR; ISOW_DFM20_TI; MPN ISOW1432DFMR
U14813: ISOW1044DFMR; ISOW_DFM20_TI; MPN ISOW1044DFMR
U14814, U14815, U14817, U14818: BLM15EX331SN1D; L_0402_1005Metric; MPN BLM15EX331SN1D
U14816, U14819: TPS3700DDCR; SOT-23-6; MPN TPS3700DDCR
U14820: ISO7720FDWR; ISO7720_DW16_TI_HV; MPN ISO7720FDWR
U14823: PESD2CANFD24V-T; SOT-23; MPN PESD2CANFD24V-T

Connections:
CAN_CONVERTER_GOOD_N: R14826.1, U14813.8 (EN_FLT_N_FAULT_MODE), U14822.2 (B)
CAN_CTRL_3V3: C14803.1, C14804.1, C14807.1, C14808.1, C14809.1, C14811.1, R14802.1, R14809.2, R14810.2, R14811.2, R14814.2, R14815.2, U14801.6 (VOUT), U14802.3 (VDD), U14805.13 (OE4_N), U14805.14 (VCC), U14806.14 (VDD), U14807.1 (OE), U14807.4 (VDD), U14809.5 (VCC)
CAN_CTRL_CLOCK_RAW: R14812.1, U14807.3 (OUT)
CAN_CTRL_CS_N: R14806.2, R14809.1, U14806.13 (CS_N)
CAN_CTRL_CS_RAW: R14806.1, U14805.8 (Y3)
CAN_CTRL_CT: C14802.1, U14801.4 (CT)
CAN_CTRL_LINK_READY: U14803.4 (Y), U14804.2 (A)
CAN_CTRL_MOSI: R14805.2, R14808.1, U14806.11 (SDI)
CAN_CTRL_MOSI_RAW: R14805.1, U14805.6 (Y2)
CAN_CTRL_OE_N: U14804.4 (Y), U14805.1 (OE1_N), U14805.4 (OE2_N), U14805.10 (OE3_N), U14808.1 (OE_N), U14809.1 (OE_N), U14810.2 (B)
CAN_CTRL_OSC: R14812.2, U14806.6 (OSC1)
CAN_CTRL_QOD: R14802.2, U14801.5 (QOD)
CAN_CTRL_READY: R14803.1, U14802.2 (RESET_N_PUSH_PULL), U14803.1 (A)
CAN_CTRL_RX: R14815.1, U14806.2 (RXCAN), U14809.4 (Y)
CAN_CTRL_SCLK: R14804.2, R14807.1, U14806.10 (SCK)
CAN_CTRL_SCLK_RAW: R14804.1, U14805.3 (Y1)
CAN_CTRL_TX: R14814.1, U14806.1 (TXCAN), U14808.2 (A)
CAN_CTRL_XSTBY: R14811.1, U14806.9 (GPIO0_XSTBY), U14810.1 (A)
CAN_FIELD_5V: C14834.1, C14835.1, C14836.1, R14827.1, R14829.1, R14831.2, U14813.20 (VISOIN), U14817.2, U14819.5 (VDD), U14820.3 (VCC1)
CAN_FIELD_GOOD_HOST: U14820.13 (OUTA), U14822.1 (A)
CAN_FIELD_OV: R14829.2, R14830.1, U14819.4 (INB-)
CAN_FIELD_UV: R14827.2, R14828.1, U14819.3 (INA+)
CAN_GND: C14834.2, C14835.2, C14836.2, J14804.7, R14828.2, R14830.2, U14813.15 (GISOIN), U14813.16 (GISOIN), U14813.17 (GISOIN), U14818.2, U14819.2 (GND), U14820.1 (GND1), U14820.5 (INB), U14820.7 (GND1), U14823.3 (CC)
CAN_H: J14804.5, U14813.19 (CANH), U14823.1 (K1)
CAN_INT_N_HOST: J14802.8, R14810.1, U14806.4 (INT_N_CONFIGURABLE_PUSH_PULL)
CAN_ISO_5V_RAW: C14829.1, C14830.1, C14831.1, C14832.1, U14813.12 (VISOOUT), U14813.13 (VSIN), U14817.1
CAN_ISO_RETURN_RAW: C14829.2, C14830.2, C14831.2, C14832.2, U14813.11 (GND2), U14818.1
CAN_L: J14804.6, R14833.1, U14813.18 (CANL), U14823.2 (K2)
CAN_POWER_GOOD_FIELD: R14831.1, U14819.1 (OUTA), U14819.6 (OUTB), U14820.4 (INA)
CAN_POWER_GOOD_HOST: J14803.2, U14822.4 (Y)
CAN_RXD: U14809.2 (A), U14813.5 (RXD)
CAN_SPI_CS_N_HOST: J14802.7, U14805.9 (A3)
CAN_SPI_MISO_HOST: J14802.6, U14806.12 (SDO)
CAN_SPI_MOSI_HOST: J14802.5, U14805.5 (A2)
CAN_SPI_SCLK_HOST: J14802.4, U14805.2 (A1)
CAN_STANDBY: R14816.1, U14810.4 (Y), U14813.4 (STB)
CAN_TERM: J14804.8, R14833.2
CAN_TXD: R14813.1, U14808.4 (Y), U14813.3 (TXD)
COMPUTE_3V3_GOOD: J14801.4, R14801.1, U14801.3 (ON), U14803.2 (B), U14811.2 (B)
CORE_5V: C14814.1, C14815.1, C14816.1, C14817.1, C14825.1, C14826.1, C14827.1, C14828.1, J14801.2, U14812.9 (VDD), U14813.9 (VDD)
IO_3V3: C14801.1, C14805.1, C14806.1, C14810.1, C14812.1, C14813.1, C14822.1, C14833.1, C14837.1, C14838.1, C14839.1, J14801.1, R14813.2, R14816.2, R14819.2, R14820.2, R14826.2, U14801.1 (VIN), U14803.5 (VCC), U14804.5 (VCC), U14808.5 (VCC), U14810.5 (VCC), U14811.5 (VCC), U14812.1 (VIO), U14813.1 (VIO), U14820.14 (VCC2), U14821.5 (VCC), U14822.5 (VCC)
LOGIC_GND: C14801.2, C14802.2, C14803.2, C14804.2, C14805.2, C14806.2, C14807.2, C14808.2, C14809.2, C14810.2, C14811.2, C14812.2, C14813.2, C14814.2, C14815.2, C14816.2, C14817.2, C14822.2, C14825.2, C14826.2, C14827.2, C14828.2, C14833.2, C14837.2, C14838.2, C14839.2, J14801.3, R14801.2, R14803.2, R14807.2, R14808.2, R14817.2, R14818.2, U14801.2 (GND), U14802.1 (GND), U14803.3 (GND), U14804.3 (GND), U14805.7 (GND), U14805.12 (A4), U14806.7 (VSS), U14807.2 (GND), U14808.3 (GND), U14809.3 (GND), U14810.3 (GND), U14811.3 (GND), U14812.5 (RE_N), U14812.6 (GNDIO), U14812.10 (GND1), U14813.2 (IN_GPIO), U14813.6 (GNDIO), U14813.10 (GND1), U14820.9 (GND2), U14820.16 (GND2), U14821.3 (GND), U14822.3 (GND)
RS485_A: J14804.2, R14832.1, U14812.18 (Z_INVERTING), U14812.19 (B_INVERTING)
RS485_B: J14804.1, U14812.17 (Y_NONINVERTING), U14812.20 (A_NONINVERTING)
RS485_COM: C14823.2, C14824.2, J14804.3, R14822.2, R14824.2, U14812.15 (GISOIN), U14815.2, U14816.2 (GND)
RS485_CONVERTER_GOOD_N: R14820.1, U14812.8 (EN_FLT_N_FAULT_MODE), U14821.2 (B)
RS485_DE_HOST: J14802.3, R14817.1, U14811.1 (A)
RS485_DE_QUALIFIED: R14818.1, U14811.4 (Y), U14812.3 (DE)
RS485_FIELD_3V3: C14823.1, C14824.1, R14821.1, R14823.1, R14825.2, U14812.16 (VISOIN), U14814.2, U14816.5 (VDD)
RS485_FIELD_GOOD_HOST: U14812.7 (OUT_FIELD_GPIO), U14821.1 (A)
RS485_FIELD_OV: R14823.2, R14824.1, U14816.4 (INB-)
RS485_FIELD_UV: R14821.2, R14822.1, U14816.3 (INA+)
RS485_ISO_3V3_RAW: C14818.1, C14819.1, C14820.1, C14821.1, U14812.12 (VISOOUT), U14814.1
RS485_ISO_RETURN_RAW: C14818.2, C14819.2, C14820.2, C14821.2, U14812.11 (GND2), U14812.13 (MODE), U14815.1
RS485_POWER_GOOD_FIELD: R14825.1, U14812.14 (IN_FIELD_GPIO), U14816.1 (OUTA), U14816.6 (OUTB)
RS485_POWER_GOOD_HOST: J14803.1, U14821.4 (Y)
RS485_TERM: J14804.4, R14832.2
RS485_UART_RX_HOST: J14802.2, U14812.4 (R)
RS485_UART_TX_HOST: J14802.1, R14819.1, U14812.2 (D)

Notes on the sheet:
ACTUAL ISOLATED RS485 AND CAN FD / actual UART, SPI controller, clock, power-cycle and hardware rail/fault observations. Native source only; target image/pinmux/failure/startup/EMC and loaded timing remain qualification.
