DeadlySIn777/Controller/reports/motherboard-integration-20260930/r19-2663-status-identity-staged-source/motherboard_identity_io.kicad_sch

## KiCad design reports/motherboard-integration-20260930/r19-2663-status-identity-staged-source/motherboard_identity_io.kicad_sch (2026-10-18)

Schematic: motherboard_identity_io.kicad_sch

Parts:
C21001, C21002, C21003: 100nF100V; C_0603_1608Metric; MPN GRM188R72A104KA35D
D21002: TPD1E10B06DPYR; TPD1E10B06_DPY2_TI; MPN TPD1E10B06DPYR
J21001: PARENT: actual parent protectedfrequency supply, 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
J21002: PARENT: ACC PD3 singleGPIO to existing XF.7 ident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
R21001, R21004: 10000R1%; R_0603_1608Metric; MPN CRCW060310K0FKEA
R21002: 4700R1%; R_0603_1608Metric; MPN CRCW06034K70FKEA
R21003: 330R1%; R_0603_1608Metric; MPN CRCW0603330RFKEA
R21005: 107000R0.1%; R_0603_1608Metric; MPN TNPW0603107KBEEA
R21006, R21008: 10000R0.1%; R_0603_1608Metric; MPN TNPW060310K0BEEA
R21007: 123000R0.1%; R_0603_1608Metric; MPN TNPW0603123KBEEA
U21001: TCA9517ADGKR; TCA9517A_DGK8_TI; MPN TCA9517ADGKR
U21003: TPS3700DDCR; SOT-23-6; MPN TPS3700DDCR

Connections:
FREQ_1WIRE_DATA_HOST: J21002.1, R21001.1, U21001.6 (SDAB)
FREQ_5V_LIMITED: C21001.1, J21001.3, R21002.2, R21005.1, R21007.1, U21001.1 (VCCA)
FREQ_ID_A_PROTECTED: R21003.2, U21001.3 (SDAA)
FREQ_ID_FIELD_OV: R21007.2, R21008.1, U21003.4 (INB-)
FREQ_ID_FIELD_UV: R21005.2, R21006.1, U21003.3 (INA+)
FREQ_ID_POWER_GOOD_LOCAL: R21004.1, U21001.5 (EN), U21003.1 (OUTA), U21003.6 (OUTB)
FREQ_MOD_ID_TO_FRONTEND: D21002.1, J21002.2, R21002.1, R21003.1
IO_3V3: C21002.1, C21003.1, J21001.1, R21001.2, R21004.2, U21001.8 (VCCB), U21003.5 (VDD)
LOGIC_GND: C21001.2, C21002.2, C21003.2, D21002.2, J21001.2, R21006.2, R21008.2, U21001.2 (SCLA_UNUSED), U21001.4 (GND), U21001.7 (SCLB_UNUSED), U21003.2 (GND)

Notes on the sheet:
ACTUAL PROTECTED ORDINARY 5V IDENTITY / actual one-GPIO 3.3V to5V open-drain path and rail-window enable. Native source only; target readonlyidentity, partialpower, noise, cable and loaded timing remain qualification.
