DeadlySIn777/Controller/reports/motherboard-integration-20260930/r21-2667-clock-taps-staged/motherboard_io_control.kicad_sch

## KiCad design reports/motherboard-integration-20260930/r21-2667-clock-taps-staged/motherboard_io_control.kicad_sch (2026-10-18)

Schematic: motherboard_io_control.kicad_sch

Parts:
C13001, C13002, C13004, C13006, C13007, C13008, C13009, C13011, C13012, C13013, C13014, C13015, C13017, C13018, C13019: 100nF100V; C_0603_1608Metric; MPN GRM188R72A104KA35D
C13003, C13010, C13016: 4700nF10V; C_0805_2012Metric; MPN GRM21BR71A475KE51K
C13005: 1000nF50V; C_0603_1608Metric; MPN GRM188R71H105KA12D
J13001, J13002, J13003: PARENT: FPGA host port with final packageball/loa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
J13004: PARENT: native24DI frontend acquisition nets
J13005: PARENT: actual protected supply monitors remain p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
J13006, J13007: PARENT: existing smart DO frontend control/reset 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
R13001, R13002, R13003, R13004, R13005, R13006, R13007, R13008, R13009, R13010, R13011, R13012, R13017, R13018, R13019, R13020, R13021, R13022, R13023, R13024, R13027, R13028, R13029, R13030, R13035, R13036, R13037, R13038, R13039, R13040, R13041, R13042, R13045, R13046, R13047, R13048, R13053, R13054, R13055, R13056: 10000R1%; R_0603_1608Metric; MPN CRCW060310K0FKEA
R13013, R13014, R13015, R13016, R13031, R13032, R13033, R13034, R13049, R13050, R13051, R13052: 22R1%; R_0603_1608Metric; MPN CRCW060322R0FKEA
R13057, R13058, R13059: 0R; R_0603_1608Metric; MPN CRCW06030000Z0EA
TP13001, TP13007, TP13013: IO_3V3; TestPoint_Pad_D1.0mm; MPN PCB_COPPER_TEST_PAD_D1.0
TP13002, TP13008, TP13014: LOGIC_GND; TestPoint_Pad_D1.0mm; MPN PCB_COPPER_TEST_PAD_D1.0
TP13003: DIC_SWDIO; TestPoint_Pad_D1.0mm; MPN PCB_COPPER_TEST_PAD_D1.0
TP13004: DIC_SWCLK_BOOT0; TestPoint_Pad_D1.0mm; MPN PCB_COPPER_TEST_PAD_D1.0
TP13005: DIC_NRST_N; TestPoint_Pad_D1.0mm; MPN PCB_COPPER_TEST_PAD_D1.0
TP13006: DIC_MR_N; TestPoint_Pad_D1.0mm; MPN PCB_COPPER_TEST_PAD_D1.0
TP13009: DOA_SWDIO; TestPoint_Pad_D1.0mm; MPN PCB_COPPER_TEST_PAD_D1.0
TP13010: DOA_SWCLK_BOOT0; TestPoint_Pad_D1.0mm; MPN PCB_COPPER_TEST_PAD_D1.0
TP13011: DOA_NRST_N; TestPoint_Pad_D1.0mm; MPN PCB_COPPER_TEST_PAD_D1.0
TP13012: DOA_MR_N; TestPoint_Pad_D1.0mm; MPN PCB_COPPER_TEST_PAD_D1.0
TP13015: DOB_SWDIO; TestPoint_Pad_D1.0mm; MPN PCB_COPPER_TEST_PAD_D1.0
TP13016: DOB_SWCLK_BOOT0; TestPoint_Pad_D1.0mm; MPN PCB_COPPER_TEST_PAD_D1.0
TP13017: DOB_NRST_N; TestPoint_Pad_D1.0mm; MPN PCB_COPPER_TEST_PAD_D1.0
TP13018: DOB_MR_N; TestPoint_Pad_D1.0mm; MPN PCB_COPPER_TEST_PAD_D1.0
U13001: STM32G031C8T6; LQFP-48_7x7mm_P0.5mm; MPN STM32G031C8T6
U13002, U13005, U13009: TPS3808G33DBVR; SOT-23-6; MPN TPS3808G33DBVR
U13003, U13006, U13010: 74LVC125APW,118; TSSOP-14_4.4x5mm_P0.65mm; MPN 74LVC125APW,118
U13004, U13008: STM32G031K8T6; LQFP-32_7x7mm_P0.8mm; MPN STM32G031K8T6
U13007, U13011: SN74LVC1G17DBVR; SOT-23-5; MPN SN74LVC1G17DBVR

Connections:
DI0_LOGIC: J13004.1, U13001.1 (PC13)
DI1_LOGIC: J13004.2, U13001.2 (PC14)
DI2_LOGIC: J13004.3, U13001.3 (PC15)
DI3_LOGIC: J13004.4, U13001.8 (PF0)
DI4_LOGIC: J13004.5, U13001.9 (PF1)
DI5_LOGIC: J13004.6, U13001.11 (PA0)
DI6_LOGIC: J13004.7, U13001.12 (PA1)
DI7_LOGIC: J13004.8, U13001.13 (PA2)
DI8_LOGIC: J13004.9, U13001.14 (PA3)
DI9_LOGIC: J13004.10, U13001.19 (PB0)
DI10_LOGIC: J13004.11, U13001.20 (PB1)
DI11_LOGIC: J13004.12, U13001.21 (PB2)
DI12_LOGIC: J13004.13, U13001.22 (PB10)
DI13_LOGIC: J13004.14, U13001.23 (PB11)
DI14_LOGIC: J13004.15, U13001.24 (PB12)
DI15_LOGIC: J13004.16, U13001.25 (PB13)
DI16_LOGIC: J13004.17, U13001.26 (PB14)
DI17_LOGIC: J13004.18, U13001.27 (PB15)
DI18_LOGIC: J13004.19, U13001.28 (PA8)
DI19_LOGIC: J13004.20, U13001.29 (PA9)
DI20_LOGIC: J13004.21, U13001.30 (PC6)
DI21_LOGIC: J13004.22, U13001.31 (PC7)
DI22_LOGIC: J13004.23, U13001.32 (PA10)
DI23_LOGIC: J13004.24, U13001.33 (PA11)
DIC_IOL1_CLK_BUFFER: R13014.1, U13003.6 (2Y)
DIC_IOL1_CLK_MCU: R13014.2, R13057.1, U13001.16 (PA5)
DIC_IOL1_CMD_BUFFER: R13015.1, U13003.8 (3Y)
DIC_IOL1_CMD_MCU: R13015.2, U13001.18 (PA7)
DIC_IOL1_CS_BUFFER: R13013.1, U13003.3 (1Y)
DIC_IOL1_CS_MCU: R13013.2, U13001.15 (PA4)
DIC_IOL1_RSP_BUFFER: R13016.1, U13003.11 (4Y)
DIC_IOL1_RSP_MCU: R13020.1, U13001.17 (PA6), U13003.12 (4A)
DIC_MR_N: R13011.1, TP13006.1, U13002.3 (MR_N)
DIC_NRST_N: C13001.1, R13010.1, TP13005.1, U13001.10 (PF2-NRST), U13002.1 (RESET_N)
DIC_SENSOR_SCL: U13001.42 (PB3)
DIC_SENSOR_SDA: U13001.43 (PB4)
DIC_SLOT0: R13001.1, U13001.45 (PB6)
DIC_SLOT1: R13002.1, U13001.46 (PB7)
DIC_SLOT2: R13003.1, U13001.47 (PB8)
DIC_SLOT3: R13004.1, U13001.48 (PB9)
DIC_SWCLK_BOOT0: R13012.1, TP13004.1, U13001.36 (PA14-BOOT0)
DIC_SWDIO: TP13003.1, U13001.35 (PA13)
DI_SAFETY_SECONDARY_FAULT: J13005.5, R13009.1, U13001.40 (PD2)
DI_SAFETY_SUPPLY_FAULT: J13005.4, R13008.1, U13001.39 (PD1)
DI_SENSOR_G0_FAULT: J13005.1, R13005.1, U13001.34 (PA12)
DI_SENSOR_G1_FAULT: J13005.2, R13006.1, U13001.37 (PA15)
DI_SENSOR_G2_FAULT: J13005.3, R13007.1, U13001.38 (PD0)
DOA_CARD_EN: J13006.6, U13004.8 (PA1)
DOA_CONTROLLER_RESET_N: J13006.11, U13007.4 (Y)
DOA_CS_N_HOST: J13006.4, U13004.1 (PB9)
DOA_DO_EN_LOGIC: J13006.10, U13004.20 (PC6)
DOA_FIELD_POWER_GOOD: J13005.6, R13027.1, U13004.16 (PB1)
DOA_FLT_N_HOST: J13006.9, U13004.15 (PB0)
DOA_IOL1_CLK_BUFFER: R13032.1, U13006.6 (2Y)
DOA_IOL1_CLK_MCU: R13032.2, R13058.1, U13004.12 (PA5)
DOA_IOL1_CMD_BUFFER: R13033.1, U13006.8 (3Y)
DOA_IOL1_CMD_MCU: R13033.2, U13004.14 (PA7)
DOA_IOL1_CS_BUFFER: R13031.1, U13006.3 (1Y)
DOA_IOL1_CS_MCU: R13031.2, U13004.11 (PA4)
DOA_IOL1_RSP_BUFFER: R13034.1, U13006.11 (4Y)
DOA_IOL1_RSP_MCU: R13038.1, U13004.13 (PA6), U13006.12 (4A)
DOA_IO_ENABLE_STROBE: J13006.5, U13004.7 (PA0)
DOA_MR_N: R13029.1, TP13012.1, U13005.3 (MR_N)
DOA_NRST_N: C13008.1, R13028.1, TP13011.1, U13004.6 (PF2-NRST), U13005.1 (RESET_N), U13007.2 (A)
DOA_OUT_EN_LATCH: J13006.7, U13004.9 (PA2)
DOA_SCLK_HOST: J13006.1, U13004.32 (PB8)
DOA_SDI_HOST: J13006.2, U13004.31 (PB7)
DOA_SDO_HOST: J13006.3, U13004.30 (PB6)
DOA_SLOT0: R13021.1, U13004.19 (PA9)
DOA_SLOT1: R13022.1, U13004.21 (PA10)
DOA_SLOT2: R13023.1, U13004.22 (PA11)
DOA_SLOT3: R13024.1, U13004.23 (PA12)
DOA_SWCLK_BOOT0: R13030.1, TP13010.1, U13004.25 (PA14-BOOT0)
DOA_SWDIO: TP13009.1, U13004.24 (PA13)
DOB_CARD_EN: J13007.6, U13008.8 (PA1)
DOB_CONTROLLER_RESET_N: J13007.11, U13011.4 (Y)
DOB_CS_N_HOST: J13007.4, U13008.1 (PB9)
DOB_DO_EN_LOGIC: J13007.10, U13008.20 (PC6)
DOB_FIELD_POWER_GOOD: J13005.7, R13045.1, U13008.16 (PB1)
DOB_FLT_N_HOST: J13007.9, U13008.15 (PB0)
DOB_IOL1_CLK_BUFFER: R13050.1, U13010.6 (2Y)
DOB_IOL1_CLK_MCU: R13050.2, R13059.1, U13008.12 (PA5)
DOB_IOL1_CMD_BUFFER: R13051.1, U13010.8 (3Y)
DOB_IOL1_CMD_MCU: R13051.2, U13008.14 (PA7)
DOB_IOL1_CS_BUFFER: R13049.1, U13010.3 (1Y)
DOB_IOL1_CS_MCU: R13049.2, U13008.11 (PA4)
DOB_IOL1_RSP_BUFFER: R13052.1, U13010.11 (4Y)
DOB_IOL1_RSP_MCU: R13056.1, U13008.13 (PA6), U13010.12 (4A)
DOB_IO_ENABLE_STROBE: J13007.5, U13008.7 (PA0)
DOB_MR_N: R13047.1, TP13018.1, U13009.3 (MR_N)
DOB_NRST_N: C13014.1, R13046.1, TP13017.1, U13008.6 (PF2-NRST), U13009.1 (RESET_N), U13011.2 (A)
DOB_OUT_EN_LATCH: J13007.7, U13008.9 (PA2)
DOB_SCLK_HOST: J13007.1, U13008.32 (PB8)
DOB_SDI_HOST: J13007.2, U13008.31 (PB7)
DOB_SDO_HOST: J13007.3, U13008.30 (PB6)
DOB_SLOT0: R13039.1, U13008.19 (PA9)
DOB_SLOT1: R13040.1, U13008.21 (PA10)
DOB_SLOT2: R13041.1, U13008.22 (PA11)
DOB_SLOT3: R13042.1, U13008.23 (PA12)
DOB_SWCLK_BOOT0: R13048.1, TP13016.1, U13008.25 (PA14-BOOT0)
DOB_SWDIO: TP13015.1, U13008.24 (PA13)
IOL1_L0_CS_N: J13001.3, R13017.1, U13003.2 (1A)
IOL1_L0_MISO: J13001.6, R13016.2
IOL1_L0_MOSI: J13001.5, R13019.1, U13003.9 (3A)
IOL1_L0_SCLK: J13001.4, R13018.1, U13003.5 (2A)
IOL1_L0_SCLK_COUNT: R13057.2, U13001.44 (PB5)
IOL1_L1_CS_N: J13002.3, R13035.1, U13006.2 (1A)
IOL1_L1_MISO: J13002.6, R13034.2
IOL1_L1_MOSI: J13002.5, R13037.1, U13006.9 (3A)
IOL1_L1_SCLK: J13002.4, R13036.1, U13006.5 (2A)
IOL1_L1_SCLK_COUNT: R13058.2, U13004.29 (PB5)
IOL1_L2_CS_N: J13003.3, R13053.1, U13010.2 (1A)
IOL1_L2_MISO: J13003.6, R13052.2
IOL1_L2_MOSI: J13003.5, R13055.1, U13010.9 (3A)
IOL1_L2_SCLK: J13003.4, R13054.1, U13010.5 (2A)
IOL1_L2_SCLK_COUNT: R13059.2, U13008.29 (PB5)
IO_3V3: C13002.1, C13003.1, C13004.1, C13005.1, C13006.1, C13007.1, C13009.1, C13010.1, C13011.1, C13012.1, C13013.1, C13015.1, C13016.1, C13017.1, C13018.1, C13019.1, J13001.1, J13002.1, J13003.1, R13005.2, R13006.2, R13007.2, R13008.2, R13009.2, R13010.2, R13011.2, R13017.2, R13021.2, R13028.2, R13029.2, R13035.2, R13040.2, R13046.2, R13047.2, R13053.2, TP13001.1, TP13007.1, TP13013.1, U13001.4 (VBAT), U13001.5 (VREF+), U13001.6 (VDD/VDDA), U13002.5 (SENSE), U13002.6 (VDD), U13003.14 (VCC), U13004.4 (VDD/VDDA), U13005.5 (SENSE), U13005.6 (VDD), U13006.14 (VCC), U13007.5 (VCC), U13008.4 (VDD/VDDA), U13009.5 (SENSE), U13009.6 (VDD), U13010.14 (VCC), U13011.5 (VCC)
LOGIC_GND: C13001.2, C13002.2, C13003.2, C13004.2, C13005.2, C13006.2, C13007.2, C13008.2, C13009.2, C13010.2, C13011.2, C13012.2, C13013.2, C13014.2, C13015.2, C13016.2, C13017.2, C13018.2, C13019.2, J13001.2, J13002.2, J13003.2, R13001.2, R13002.2, R13003.2, R13004.2, R13012.2, R13018.2, R13019.2, R13020.2, R13022.2, R13023.2, R13024.2, R13027.2, R13030.2, R13036.2, R13037.2, R13038.2, R13039.2, R13041.2, R13042.2, R13045.2, R13048.2, R13054.2, R13055.2, R13056.2, TP13002.1, TP13008.1, TP13014.1, U13001.7 (VSS/VSSA), U13002.2 (GND), U13003.1 (1OE_N), U13003.4 (2OE_N), U13003.7 (GND), U13003.10 (3OE_N), U13003.13 (4OE_N), U13004.5 (VSS/VSSA), U13005.2 (GND), U13006.1 (1OE_N), U13006.4 (2OE_N), U13006.7 (GND), U13006.10 (3OE_N), U13006.13 (4OE_N), U13007.3 (GND), U13008.5 (VSS/VSSA), U13009.2 (GND), U13010.1 (1OE_N), U13010.4 (2OE_N), U13010.7 (GND), U13010.10 (3OE_N), U13010.13 (4OE_N), U13011.3 (GND)
OUT_PERMIT_A: J13006.8, U13004.10 (PA3)
OUT_PERMIT_B: J13007.8, U13008.10 (PA3)

Notes on the sheet:
IOL1 ON-MOTHERBOARD CONTROL / L0:24DI / L1:DOA / L2:DOB Three real STM32G031 MCUs, SPI buffers, rail/reset supervisors and factory SWD pads. No custom cards. Target firmware/options/identity/calibration/field monitors and loaded timing remain unimplemented. Outputs default OFF.
