DeadlySIn777/Controller/reports/board-completion-20260930/mc-integrated-r01/source/mc_permission.kicad_sch

## KiCad design reports/board-completion-20260930/mc-integrated-r01/source/mc_permission.kicad_sch (2026-10-18)

Schematic: mc_permission.kicad_sch

Parts:
B4001, B4002: INTERNAL REVIEW BOUNDARY
C4001, C4002, C4003, C4004, C4005, C4006, C4007, C4008, C4009, C4010, C4011, C4012, C4013, C4014, C4015, C4016, C4017, C4018, C4019: 100nF X7R 25V 10%; C_0603_1608Metric; MPN GRM188R71E104KA01D
R4001, R4002, R4003, R4004, R4005, R4006, R4007: 4700R 1%; R_0603_1608Metric; MPN CRCW06034K70FKEA
R4008, R4009, R4010, R4011, R4012, R4013, R4014, R4015, R4016, R4017, R4018: 10000R 1%; R_0603_1608Metric; MPN CRCW060310K0FKEA
U4001, U4002, U4004, U4007, U4008, U4010: SN74LVC1G11DBVR; SOT-23-6; MPN SN74LVC1G11DBVR
U4003, U4009, U4019: SN74LVC2G08DCUR; VSSOP-8_2.3x2mm_P0.5mm; MPN SN74LVC2G08DCUR
U4005, U4006, U4011, U4012, U4013, U4014, U4015: SN74LVC2G74DCUR; VSSOP-8_2.3x2mm_P0.5mm; MPN SN74LVC2G74DCUR
U4016, U4018: SN74LVC2G04DBVR; SOT-23-6; MPN SN74LVC2G04DBVR
U4017: SN74LVC2G32DCUR; VSSOP-8_2.3x2mm_P0.5mm; MPN SN74LVC2G32DCUR

Connections:
ARM_M_Q: U4005.5 (Q), U4007.1 (A)
ARM_O_Q: U4006.5 (Q), U4008.1 (A)
BANK_B_BUFFER_ENABLE_QUALIFIED: B4001.15, R4014.1, U4013.6 (CLR_N)
BASE_FIRST: U4001.4 (Y), U4002.1 (A)
BASE_OK: U4002.4 (Y), U4003.1 (1A), U4004.1 (A), U4009.1 (1A)
DIC_OK_QUALIFIED: B4001.5, R4010.1, U4001.6 (C)
EXT_PERMIT_3V3: B4001.6, R4011.1, U4002.3 (B)
FPGA_CRESET_N: B4001.3, R4008.1, U4001.1 (A), U4019.1 (1A), U4019.5 (2A)
FPGA_ENDPOINT_READY: B4001.10, R4001.1, U4003.6 (2B), U4004.6 (C)
FPGA_MOTION_REQUEST: B4001.11, U4005.1 (CLK), U4007.3 (B)
FPGA_OUTPUT_REQUEST: B4001.12, U4006.1 (CLK), U4008.3 (B)
FPGA_USER_RESET_N: B4001.4, R4009.1, U4001.3 (B)
IO_3V3: B4001.1, C4001.1, C4002.1, C4003.1, C4004.1, C4005.1, C4006.1, C4007.1, C4008.1, C4009.1, C4010.1, C4011.1, C4012.1, C4013.1, C4014.1, C4015.1, C4016.1, C4017.1, C4018.1, C4019.1, U4001.5 (VCC), U4002.5 (VCC), U4003.8 (VCC), U4004.5 (VCC), U4005.2 (D), U4005.7 (PRE_N), U4005.8 (VCC), U4006.2 (D), U4006.7 (PRE_N), U4006.8 (VCC), U4007.5 (VCC), U4008.5 (VCC), U4009.8 (VCC), U4010.5 (VCC), U4011.2 (D), U4011.7 (PRE_N), U4011.8 (VCC), U4012.2 (D), U4012.7 (PRE_N), U4012.8 (VCC), U4013.2 (D), U4013.7 (PRE_N), U4013.8 (VCC), U4014.7 (PRE_N), U4014.8 (VCC), U4015.7 (PRE_N), U4015.8 (VCC), U4016.5 (VCC), U4017.8 (VCC), U4018.5 (VCC), U4019.8 (VCC)
LATCH_CLEAR_M_N: U4003.3 (2Y), U4005.6 (CLR_N)
LATCH_CLEAR_O_N: U4004.4 (Y), U4006.6 (CLR_N)
LOGIC_GND: B4001.2, C4001.2, C4002.2, C4003.2, C4004.2, C4005.2, C4006.2, C4007.2, C4008.2, C4009.2, C4010.2, C4011.2, C4012.2, C4013.2, C4014.2, C4015.2, C4016.2, C4017.2, C4018.2, C4019.2, R4001.2, R4002.2, R4003.2, R4004.2, R4005.2, R4006.2, R4007.2, R4008.2, R4009.2, R4010.2, R4011.2, R4012.2, R4013.2, R4014.2, R4015.2, R4016.2, R4017.2, R4018.2, U4001.2 (GND), U4002.2 (GND), U4003.4 (GND), U4004.2 (GND), U4005.4 (GND), U4006.4 (GND), U4007.2 (GND), U4008.2 (GND), U4009.4 (GND), U4010.2 (GND), U4011.4 (GND), U4012.4 (GND), U4013.4 (GND), U4014.4 (GND), U4015.4 (GND), U4016.2 (GND), U4017.4 (GND), U4018.2 (GND), U4019.4 (GND)
OPI_OK_BOE: B4002.8, U4013.5 (Q)
OPI_OK_OUT: B4002.7, U4012.5 (Q)
OPI_OK_TX: B4002.6, U4011.5 (Q)
OPI_REARM_BOE: B4001.18, R4004.1, U4013.1 (CLK)
OPI_REARM_OUT: B4001.17, R4003.1, U4012.1 (CLK)
OPI_REARM_TX: B4001.16, R4002.1, U4011.1 (CLK)
OUTPUT_RAW_OK: U4008.6 (C), U4009.7 (1Y)
OUT_PERMIT: B4002.3, R4016.1, U4008.4 (Y), U4010.3 (B), U4012.6 (CLR_N)
PERMIT_OUT_DRIVE: B4002.5, R4018.1, U4009.3 (2Y)
PERMIT_OUT_REQ: B4001.14, R4007.1, U4009.6 (2B)
PROCESS_PERMIT_EXT_3V3: B4001.13, R4013.1, U4010.6 (C)
PROC_PERMIT: B4002.4, R4017.1, U4010.4 (Y)
RAW_INHIBIT_N: B4002.1, U4003.5 (2A), U4003.7 (1Y), U4007.6 (C)
TAMPER_CLEAR_N: B4001.7, R4012.1, U4002.6 (C)
TX_PERMIT: B4002.2, R4015.1, U4007.4 (Y), U4009.5 (2A), U4010.1 (A), U4011.6 (CLR_N)
WD_M_FALL_CLK: U4014.1 (CLK), U4016.6 (1Y)
WD_M_OK: B4001.8, U4003.2 (1B), U4016.1 (1A)
WD_M_RECORD_CLEAR_N: U4018.6 (1Y), U4019.2 (1B)
WD_M_SET1_BUF: B4001.21, U4017.2 (1B)
WD_M_TRIP_CLEAR_N: U4014.6 (CLR_N), U4019.7 (1Y)
WD_M_TRIP_D: U4014.2 (D), U4017.7 (1Y)
WD_M_TRIP_N: B4002.9, U4014.3 (Q_N)
WD_M_TRIP_Q: U4014.5 (Q), U4017.1 (1A)
WD_O_FALL_CLK: U4015.1 (CLK), U4016.4 (2Y)
WD_O_OK: B4001.9, U4004.3 (B), U4009.2 (1B), U4016.3 (2A)
WD_O_RECORD_CLEAR_N: U4018.4 (2Y), U4019.6 (2B)
WD_O_SET1_BUF: B4001.22, U4017.6 (2B)
WD_O_TRIP_CLEAR_N: U4015.6 (CLR_N), U4019.3 (2Y)
WD_O_TRIP_D: U4015.2 (D), U4017.3 (2Y)
WD_O_TRIP_N: B4002.10, U4015.3 (Q_N)
WD_O_TRIP_Q: U4015.5 (Q), U4017.5 (2A)
WD_REARM_M: B4001.19, R4005.1, U4018.1 (1A)
WD_REARM_O: B4001.20, R4006.1, U4018.3 (2A)

Notes on the sheet:
MC PERMISSION / STICKY INTERRUPTION CORE - UPSTREAM QUALIFICATION AND FIELD DRIVERS REMAIN SEPARATE
No manufacture/physical timing claim. IS-1 arm/OPI equations; 4.7k GPIO startup pulls need proposed IS-2 reconciliation. WD_TRIP_N: a WD_OK FALL captures actual timer SET1; sticky Q feedback, power reset or explicit WD_REARM pulse clears the record. B1/B2 are logical boundaries, not connectors. Tri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
