DeadlySIn777/Controller/reports/motherboard-fpga-source-20260930/home-deallocation-r01/inputs/motherboard_di.kicad_sch

## KiCad design reports/motherboard-fpga-source-20260930/home-deallocation-r01/inputs/motherboard_di.kicad_sch (2026-10-18)

Schematic: motherboard_di.kicad_sch

Parts:
C8001, C8002, C8003, C8004, C8005, C8006, C8007, C8008, C8009, C8010, C8011, C8012, C8013, C8014, C8015, C8016, C8017, C8018, C8019, C8020, C8021, C8022, C8023, C8024: 10nF 100V C0G; C_0805_2012Metric; MPN C2012C0G2A103J125AA
C8101, C8102, C8103, C8104, C8105, C8106, C8107, C8108, C8109, C8110, C8111, C8112: 100nF 25V X7R; C_0603_1608Metric; MPN 06033C104JAT2A
J8001: XDI0 FIELD / SENSOR BOUNDARY
J8002: XDI1 FIELD / SENSOR BOUNDARY
J8003: XDI2 FIELD / SENSOR BOUNDARY
J8004: UNIMPLEMENTED ACQUISITION / LOGIC BOUNDARY
R8001, R8002, R8003, R8004, R8005, R8006, R8007, R8008, R8009, R8010, R8011, R8012, R8013, R8014, R8015, R8016, R8017, R8018, R8019, R8020, R8021, R8022, R8023, R8024: 1k MELF 1%; R_MiniMELF_MMA-0204; MPN SMM02040C1001FB300
R8101, R8102, R8103, R8104, R8105, R8106, R8107, R8108, R8109, R8110, R8111, R8112, R8113, R8114, R8115, R8116, R8117, R8118, R8119, R8120, R8121, R8122, R8123, R8124: 562R 1%; R_0603_1608Metric; MPN CRCW0603562RFKEA
R8201, R8202, R8203, R8204, R8205, R8206, R8207, R8208, R8209, R8210, R8211, R8212, R8213, R8214, R8215, R8216, R8217, R8218, R8219, R8220, R8221, R8222, R8223, R8224: 100k 1%; R_0603_1608Metric; MPN CRCW0603100KFKEA
U8001, U8002, U8003, U8004, U8005, U8006, U8007, U8008, U8009, U8010, U8011, U8012: ISO1212DBQR; ISO1212_DBQ16_TI; MPN ISO1212DBQR

Connections:
DI0_FIELD: J8001.1, R8001.1
DI0_IN: R8101.2, U8001.15 (IN1)
DI0_LOGIC: J8004.3, R8201.1, U8001.4 (OUT1)
DI0_SENSE: C8001.1, R8001.2, R8101.1, U8001.16 (SENSE1)
DI0_SUB_ISLAND: U8001.13 (SUB1)
DI1_FIELD: J8001.2, R8002.1
DI1_IN: R8102.2, U8001.10 (IN2)
DI1_LOGIC: J8004.4, R8202.1, U8001.5 (OUT2)
DI1_SENSE: C8002.1, R8002.2, R8102.1, U8001.11 (SENSE2)
DI1_SUB_ISLAND: U8001.12 (SUB2)
DI2_FIELD: J8001.3, R8003.1
DI2_IN: R8103.2, U8002.15 (IN1)
DI2_LOGIC: J8004.5, R8203.1, U8002.4 (OUT1)
DI2_SENSE: C8003.1, R8003.2, R8103.1, U8002.16 (SENSE1)
DI2_SUB_ISLAND: U8002.13 (SUB1)
DI3_FIELD: J8001.4, R8004.1
DI3_IN: R8104.2, U8002.10 (IN2)
DI3_LOGIC: J8004.6, R8204.1, U8002.5 (OUT2)
DI3_SENSE: C8004.1, R8004.2, R8104.1, U8002.11 (SENSE2)
DI3_SUB_ISLAND: U8002.12 (SUB2)
DI4_FIELD: J8001.5, R8005.1
DI4_IN: R8105.2, U8003.15 (IN1)
DI4_LOGIC: J8004.7, R8205.1, U8003.4 (OUT1)
DI4_SENSE: C8005.1, R8005.2, R8105.1, U8003.16 (SENSE1)
DI4_SUB_ISLAND: U8003.13 (SUB1)
DI5_FIELD: J8001.6, R8006.1
DI5_IN: R8106.2, U8003.10 (IN2)
DI5_LOGIC: J8004.8, R8206.1, U8003.5 (OUT2)
DI5_SENSE: C8006.1, R8006.2, R8106.1, U8003.11 (SENSE2)
DI5_SUB_ISLAND: U8003.12 (SUB2)
DI6_FIELD: J8001.7, R8007.1
DI6_IN: R8107.2, U8004.15 (IN1)
DI6_LOGIC: J8004.9, R8207.1, U8004.4 (OUT1)
DI6_SENSE: C8007.1, R8007.2, R8107.1, U8004.16 (SENSE1)
DI6_SUB_ISLAND: U8004.13 (SUB1)
DI7_FIELD: J8001.8, R8008.1
DI7_IN: R8108.2, U8004.10 (IN2)
DI7_LOGIC: J8004.10, R8208.1, U8004.5 (OUT2)
DI7_SENSE: C8008.1, R8008.2, R8108.1, U8004.11 (SENSE2)
DI7_SUB_ISLAND: U8004.12 (SUB2)
DI8_FIELD: J8002.1, R8009.1
DI8_IN: R8109.2, U8005.15 (IN1)
DI8_LOGIC: J8004.11, R8209.1, U8005.4 (OUT1)
DI8_SENSE: C8009.1, R8009.2, R8109.1, U8005.16 (SENSE1)
DI8_SUB_ISLAND: U8005.13 (SUB1)
DI9_FIELD: J8002.2, R8010.1
DI9_IN: R8110.2, U8005.10 (IN2)
DI9_LOGIC: J8004.12, R8210.1, U8005.5 (OUT2)
DI9_SENSE: C8010.1, R8010.2, R8110.1, U8005.11 (SENSE2)
DI9_SUB_ISLAND: U8005.12 (SUB2)
DI10_FIELD: J8002.3, R8011.1
DI10_IN: R8111.2, U8006.15 (IN1)
DI10_LOGIC: J8004.13, R8211.1, U8006.4 (OUT1)
DI10_SENSE: C8011.1, R8011.2, R8111.1, U8006.16 (SENSE1)
DI10_SUB_ISLAND: U8006.13 (SUB1)
DI11_FIELD: J8002.4, R8012.1
DI11_IN: R8112.2, U8006.10 (IN2)
DI11_LOGIC: J8004.14, R8212.1, U8006.5 (OUT2)
DI11_SENSE: C8012.1, R8012.2, R8112.1, U8006.11 (SENSE2)
DI11_SUB_ISLAND: U8006.12 (SUB2)
DI12_FIELD: J8002.5, R8013.1
DI12_IN: R8113.2, U8007.15 (IN1)
DI12_LOGIC: J8004.15, R8213.1, U8007.4 (OUT1)
DI12_SENSE: C8013.1, R8013.2, R8113.1, U8007.16 (SENSE1)
DI12_SUB_ISLAND: U8007.13 (SUB1)
DI13_FIELD: J8002.6, R8014.1
DI13_IN: R8114.2, U8007.10 (IN2)
DI13_LOGIC: J8004.16, R8214.1, U8007.5 (OUT2)
DI13_SENSE: C8014.1, R8014.2, R8114.1, U8007.11 (SENSE2)
DI13_SUB_ISLAND: U8007.12 (SUB2)
DI14_FIELD: J8002.7, R8015.1
DI14_IN: R8115.2, U8008.15 (IN1)
DI14_LOGIC: J8004.17, R8215.1, U8008.4 (OUT1)
DI14_SENSE: C8015.1, R8015.2, R8115.1, U8008.16 (SENSE1)
DI14_SUB_ISLAND: U8008.13 (SUB1)
DI15_FIELD: J8002.8, R8016.1
DI15_IN: R8116.2, U8008.10 (IN2)
DI15_LOGIC: J8004.18, R8216.1, U8008.5 (OUT2)
DI15_SENSE: C8016.1, R8016.2, R8116.1, U8008.11 (SENSE2)
DI15_SUB_ISLAND: U8008.12 (SUB2)
DI16_FIELD: J8003.1, R8017.1
DI16_IN: R8117.2, U8009.15 (IN1)
DI16_LOGIC: J8004.19, R8217.1, U8009.4 (OUT1)
DI16_SENSE: C8017.1, R8017.2, R8117.1, U8009.16 (SENSE1)
DI16_SUB_ISLAND: U8009.13 (SUB1)
DI17_FIELD: J8003.2, R8018.1
DI17_IN: R8118.2, U8009.10 (IN2)
DI17_LOGIC: J8004.20, R8218.1, U8009.5 (OUT2)
DI17_SENSE: C8018.1, R8018.2, R8118.1, U8009.11 (SENSE2)
DI17_SUB_ISLAND: U8009.12 (SUB2)
DI18_FIELD: J8003.3, R8019.1
DI18_IN: R8119.2, U8010.15 (IN1)
DI18_LOGIC: J8004.21, R8219.1, U8010.4 (OUT1)
DI18_SENSE: C8019.1, R8019.2, R8119.1, U8010.16 (SENSE1)
DI18_SUB_ISLAND: U8010.13 (SUB1)
DI19_FIELD: J8003.4, R8020.1
DI19_IN: R8120.2, U8010.10 (IN2)
DI19_LOGIC: J8004.22, R8220.1, U8010.5 (OUT2)
DI19_SENSE: C8020.1, R8020.2, R8120.1, U8010.11 (SENSE2)
DI19_SUB_ISLAND: U8010.12 (SUB2)
DI20_FIELD: J8003.5, R8021.1
DI20_IN: R8121.2, U8011.15 (IN1)
DI20_LOGIC: J8004.23, R8221.1, U8011.4 (OUT1)
DI20_SENSE: C8021.1, R8021.2, R8121.1, U8011.16 (SENSE1)
DI20_SUB_ISLAND: U8011.13 (SUB1)
DI21_FIELD: J8003.6, R8022.1
DI21_IN: R8122.2, U8011.10 (IN2)
DI21_LOGIC: J8004.24, R8222.1, U8011.5 (OUT2)
DI21_SENSE: C8022.1, R8022.2, R8122.1, U8011.11 (SENSE2)
DI21_SUB_ISLAND: U8011.12 (SUB2)
DI22_FIELD: J8003.7, R8023.1
DI22_IN: R8123.2, U8012.15 (IN1)
DI22_LOGIC: J8004.25, R8223.1, U8012.4 (OUT1)
DI22_SENSE: C8023.1, R8023.2, R8123.1, U8012.16 (SENSE1)
DI22_SUB_ISLAND: U8012.13 (SUB1)
DI23_FIELD: J8003.8, R8024.1
DI23_IN: R8124.2, U8012.10 (IN2)
DI23_LOGIC: J8004.26, R8224.1, U8012.5 (OUT2)
DI23_SENSE: C8024.1, R8024.2, R8124.1, U8012.11 (SENSE2)
DI23_SUB_ISLAND: U8012.12 (SUB2)
FIELD_B_0V: C8001.2, C8002.2, C8003.2, C8004.2, C8005.2, C8006.2, C8007.2, C8008.2, C8009.2, C8010.2, C8011.2, C8012.2, C8013.2, C8014.2, C8015.2, C8016.2, C8017.2, C8018.2, C8019.2, C8020.2, C8021.2, C8022.2, C8023.2, C8024.2, J8001.11, J8001.12, J8002.11, J8002.12, J8003.11, J8003.12, U8001.9 (FGND2), U8001.14 (FGND1), U8002.9 (FGND2), U8002.14 (FGND1), U8003.9 (FGND2), U8003.14 (FGND1), U8004.9 (FGND2), U8004.14 (FGND1), U8005.9 (FGND2), U8005.14 (FGND1), U8006.9 (FGND2), U8006.14 (FGND1), U8007.9 (FGND2), U8007.14 (FGND1), U8008.9 (FGND2), U8008.14 (FGND1), U8009.9 (FGND2), U8009.14 (FGND1), U8010.9 (FGND2), U8010.14 (FGND1), U8011.9 (FGND2), U8011.14 (FGND1), U8012.9 (FGND2), U8012.14 (FGND1)
IO_3V3: C8101.1, C8102.1, C8103.1, C8104.1, C8105.1, C8106.1, C8107.1, C8108.1, C8109.1, C8110.1, C8111.1, C8112.1, J8004.1, U8001.2 (VCC1), U8001.3 (EN), U8002.2 (VCC1), U8002.3 (EN), U8003.2 (VCC1), U8003.3 (EN), U8004.2 (VCC1), U8004.3 (EN), U8005.2 (VCC1), U8005.3 (EN), U8006.2 (VCC1), U8006.3 (EN), U8007.2 (VCC1), U8007.3 (EN), U8008.2 (VCC1), U8008.3 (EN), U8009.2 (VCC1), U8009.3 (EN), U8010.2 (VCC1), U8010.3 (EN), U8011.2 (VCC1), U8011.3 (EN), U8012.2 (VCC1), U8012.3 (EN)
LOGIC_GND: C8101.2, C8102.2, C8103.2, C8104.2, C8105.2, C8106.2, C8107.2, C8108.2, C8109.2, C8110.2, C8111.2, C8112.2, J8004.2, R8201.2, R8202.2, R8203.2, R8204.2, R8205.2, R8206.2, R8207.2, R8208.2, R8209.2, R8210.2, R8211.2, R8212.2, R8213.2, R8214.2, R8215.2, R8216.2, R8217.2, R8218.2, R8219.2, R8220.2, R8221.2, R8222.2, R8223.2, R8224.2, U8001.1 (GND1), U8001.8 (GND1), U8002.1 (GND1), U8002.8 (GND1), U8003.1 (GND1), U8003.8 (GND1), U8004.1 (GND1), U8004.8 (GND1), U8005.1 (GND1), U8005.8 (GND1), U8006.1 (GND1), U8006.8 (GND1), U8007.1 (GND1), U8007.8 (GND1), U8008.1 (GND1), U8008.8 (GND1), U8009.1 (GND1), U8009.8 (GND1), U8010.1 (GND1), U8010.8 (GND1), U8011.1 (GND1), U8011.8 (GND1), U8012.1 (GND1), U8012.8 (GND1)
SENS24_G0: J8001.9, J8001.10
SENS24_G1: J8002.9, J8002.10
SENS24_G2: J8003.9, J8003.10

Notes on the sheet:
GENERAL DI0 / DI1 - FIELD_B to LOGIC
GENERAL DI2 / DI3 - FIELD_B to LOGIC
GENERAL DI4 / DI5 - FIELD_B to LOGIC
GENERAL DI6 / DI7 - FIELD_B to LOGIC
GENERAL DI8 / DI9 - FIELD_B to LOGIC
GENERAL DI10 / DI11 - FIELD_B to LOGIC
GENERAL DI12 / DI13 - FIELD_B to LOGIC
GENERAL DI14 / DI15 - FIELD_B to LOGIC
GENERAL DI16 / DI17 - FIELD_B to LOGIC
GENERAL DI18 / DI19 - FIELD_B to LOGIC
GENERAL DI20 / DI21 - FIELD_B to LOGIC
GENERAL DI22 / DI23 - FIELD_B to LOGIC
MOTHERBOARD: 24 GENERAL DI - 12 ISO1212 - NEW SOURCE r0.1 / NOT A PCB RELEASE
Fixed sinking inputs: PNP or contact to qualified sensor positive. 0-30V, LOW<=5V / HIGH>=15V targets. NPN/12V/AUTO mode not implemented. FIELD_B_0V never joins LOGIC_GND here. Each SUB pin needs a separate floating 2x2mm copper island; no ground or inter-island connection.
All 24 DI are general channels, independent of 12 motor alarms and 2 fast probes. No PROBE/HOME/ALM assignment is consumed here. EN tied to IO_3V3. Powered open reads LOW. Unpowered/brownout is UNDETERMINED; bias is not guaranteed fail-safe. Acquisition, rail/freshness/CRC validity, sensor-power li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
XDI9/10 supply contacts are one shared 0.20A group, not 0.20A each. Three groups reserve 0.60A total under frozen IS-1. Sensor supply is an UNIMPLEMENTED boundary: no source/current limiter/telemetry is fitted by this sheet. All boundary symbols excluded from PCB/BOM. RTHR*C is a screen, not comple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
