DeadlySIn777/Controller/reports/connected-hardware-20260928/source/hardware/controller_assembly/digital_inputs.kicad_sch

## KiCad design reports/connected-hardware-20260928/source/hardware/controller_assembly/digital_inputs.kicad_sch (2026-10-18)

Schematic: digital_inputs.kicad_sch

Parts:
C10001, C10002, C10003, C10004, C10005, C10006, C10007, C10008, C10009, C10010, C10011, C10012, C10013, C10014, C10015, C10016, C10017, C10018, C10019, C10020, C10021, C10022: 10nF 100V C0G; C_0805_2012Metric; MPN C2012C0G2A103J125AA
C10101, C10102, C10103, C10104, C10105, C10106, C10107, C10108, C10109, C10110, C10111: 100nF 25V X7R; C_0603_1608Metric; MPN 06033C104JAT2A
JDI10000: JDI0 / LEDGER
JDI10001: JDI1 / LEDGER
JDI10002: JDI2 / LEDGER
JLOG10001, JLOG10002: INTERNAL LOGIC BOUNDARY
R10001, R10002, R10003, R10004, R10005, R10006, R10007, R10008, R10009, R10010, R10011, R10012, R10013, R10014, R10015, R10016, R10017, R10018, R10019, R10020, R10021, R10022: 1k MELF 1%; R_MiniMELF_MMA-0204; MPN SMM02040C1001FB300
R10101, R10102, R10103, R10104, R10105, R10106, R10107, R10108, R10109, R10110, R10111, R10112, R10113, R10114, R10115, R10116, R10117, R10118, R10119, R10120, R10121, R10122: 562R 1%; R_0603_1608Metric; MPN CRCW0603562RFKEA
R10201, R10202, R10203, R10204, R10205, R10206, R10207, R10208, R10209, R10210, R10211, R10212, R10213, R10214, R10215, R10216, R10217, R10218, R10219, R10220, R10221, R10222: 100k 1%; R_0603_1608Metric; MPN CRCW0603100KFKEA
U10001, U10002, U10003, U10004, U10005, U10006, U10007, U10008, U10009, U10010, U10011: ISO1212DBQR; SSOP-16_3.9x4.9mm_P0.635mm; MPN ISO1212DBQR

Connections:
ALM0_FPGA: JLOG10002.7, R10217.1, U10009.4 (OUT1)
ALM1_FPGA: JLOG10002.8, R10218.1, U10009.5 (OUT2)
ALM2_FPGA: JLOG10002.9, R10219.1, U10010.4 (OUT1)
ALM3_FPGA: JLOG10002.10, R10220.1, U10010.5 (OUT2)
ALM4_FPGA: JLOG10002.11, R10221.1, U10011.4 (OUT1)
ALM5_FPGA: JLOG10002.12, R10222.1, U10011.5 (OUT2)
CYCLE_START_FPGA: JLOG10002.4, R10214.1, U10007.5 (OUT2)
DI00_FIELD: JDI10000.1, R10001.1
DI00_IN: R10101.2, U10001.15 (IN1)
DI00_SENSE: C10001.1, R10001.2, R10101.1, U10001.16 (SENSE1)
DI00_SUB_ISLAND: U10001.13 (SUB1)
DI01_FIELD: JDI10000.2, R10002.1
DI01_IN: R10102.2, U10001.10 (IN2)
DI01_SENSE: C10002.1, R10002.2, R10102.1, U10001.11 (SENSE2)
DI01_SUB_ISLAND: U10001.12 (SUB2)
DI02_FIELD: JDI10000.3, R10003.1
DI02_IN: R10103.2, U10002.15 (IN1)
DI02_SENSE: C10003.1, R10003.2, R10103.1, U10002.16 (SENSE1)
DI02_SUB_ISLAND: U10002.13 (SUB1)
DI03_FIELD: JDI10000.4, R10004.1
DI03_IN: R10104.2, U10002.10 (IN2)
DI03_SENSE: C10004.1, R10004.2, R10104.1, U10002.11 (SENSE2)
DI03_SUB_ISLAND: U10002.12 (SUB2)
DI04_FIELD: JDI10000.5, R10005.1
DI04_IN: R10105.2, U10003.15 (IN1)
DI04_SENSE: C10005.1, R10005.2, R10105.1, U10003.16 (SENSE1)
DI04_SUB_ISLAND: U10003.13 (SUB1)
DI05_FIELD: JDI10000.6, R10006.1
DI05_IN: R10106.2, U10003.10 (IN2)
DI05_SENSE: C10006.1, R10006.2, R10106.1, U10003.11 (SENSE2)
DI05_SUB_ISLAND: U10003.12 (SUB2)
DI06_FIELD: JDI10000.7, R10007.1
DI06_IN: R10107.2, U10004.15 (IN1)
DI06_SENSE: C10007.1, R10007.2, R10107.1, U10004.16 (SENSE1)
DI06_SUB_ISLAND: U10004.13 (SUB1)
DI07_FIELD: JDI10000.8, R10008.1
DI07_IN: R10108.2, U10004.10 (IN2)
DI07_SENSE: C10008.1, R10008.2, R10108.1, U10004.11 (SENSE2)
DI07_SUB_ISLAND: U10004.12 (SUB2)
DI08_FIELD: JDI10001.1, R10009.1
DI08_IN: R10109.2, U10005.15 (IN1)
DI08_SENSE: C10009.1, R10009.2, R10109.1, U10005.16 (SENSE1)
DI08_SUB_ISLAND: U10005.13 (SUB1)
DI09_FIELD: JDI10001.2, R10010.1
DI09_IN: R10110.2, U10005.10 (IN2)
DI09_SENSE: C10010.1, R10010.2, R10110.1, U10005.11 (SENSE2)
DI09_SUB_ISLAND: U10005.12 (SUB2)
DI10_FIELD: JDI10001.3, R10011.1
DI10_IN: R10111.2, U10006.15 (IN1)
DI10_SENSE: C10011.1, R10011.2, R10111.1, U10006.16 (SENSE1)
DI10_SUB_ISLAND: U10006.13 (SUB1)
DI11_FIELD: JDI10001.4, R10012.1
DI11_IN: R10112.2, U10006.10 (IN2)
DI11_SENSE: C10012.1, R10012.2, R10112.1, U10006.11 (SENSE2)
DI11_SUB_ISLAND: U10006.12 (SUB2)
DI12_FIELD: JDI10001.5, R10013.1
DI12_IN: R10113.2, U10007.15 (IN1)
DI12_SENSE: C10013.1, R10013.2, R10113.1, U10007.16 (SENSE1)
DI12_SUB_ISLAND: U10007.13 (SUB1)
DI13_FIELD: JDI10001.6, R10014.1
DI13_IN: R10114.2, U10007.10 (IN2)
DI13_SENSE: C10014.1, R10014.2, R10114.1, U10007.11 (SENSE2)
DI13_SUB_ISLAND: U10007.12 (SUB2)
DI14_FIELD: JDI10001.7, R10015.1
DI14_IN: R10115.2, U10008.15 (IN1)
DI14_SENSE: C10015.1, R10015.2, R10115.1, U10008.16 (SENSE1)
DI14_SUB_ISLAND: U10008.13 (SUB1)
DI15_FIELD: JDI10001.8, R10016.1
DI15_IN: R10116.2, U10008.10 (IN2)
DI15_SENSE: C10016.1, R10016.2, R10116.1, U10008.11 (SENSE2)
DI15_SUB_ISLAND: U10008.12 (SUB2)
DI16_FIELD: JDI10002.1, R10017.1
DI16_IN: R10117.2, U10009.15 (IN1)
DI16_SENSE: C10017.1, R10017.2, R10117.1, U10009.16 (SENSE1)
DI16_SUB_ISLAND: U10009.13 (SUB1)
DI17_FIELD: JDI10002.2, R10018.1
DI17_IN: R10118.2, U10009.10 (IN2)
DI17_SENSE: C10018.1, R10018.2, R10118.1, U10009.11 (SENSE2)
DI17_SUB_ISLAND: U10009.12 (SUB2)
DI18_FIELD: JDI10002.3, R10019.1
DI18_IN: R10119.2, U10010.15 (IN1)
DI18_SENSE: C10019.1, R10019.2, R10119.1, U10010.16 (SENSE1)
DI18_SUB_ISLAND: U10010.13 (SUB1)
DI19_FIELD: JDI10002.4, R10020.1
DI19_IN: R10120.2, U10010.10 (IN2)
DI19_SENSE: C10020.1, R10020.2, R10120.1, U10010.11 (SENSE2)
DI19_SUB_ISLAND: U10010.12 (SUB2)
DI20_FIELD: JDI10002.5, R10021.1
DI20_IN: R10121.2, U10011.15 (IN1)
DI20_SENSE: C10021.1, R10021.2, R10121.1, U10011.16 (SENSE1)
DI20_SUB_ISLAND: U10011.13 (SUB1)
DI21_FIELD: JDI10002.6, R10022.1
DI21_IN: R10122.2, U10011.10 (IN2)
DI21_SENSE: C10022.1, R10022.2, R10122.1, U10011.11 (SENSE2)
DI21_SUB_ISLAND: U10011.12 (SUB2)
DOOR_STATUS_FPGA: JLOG10001.11, R10209.1, U10005.4 (OUT1)
FEED_HOLD_FPGA: JLOG10002.3, R10213.1, U10007.4 (OUT1)
FIELD_GND: C10001.2, C10002.2, C10003.2, C10004.2, C10005.2, C10006.2, C10007.2, C10008.2, C10009.2, C10010.2, C10011.2, C10012.2, C10013.2, C10014.2, C10015.2, C10016.2, C10017.2, C10018.2, C10019.2, C10020.2, C10021.2, C10022.2, JDI10002.7, JDI10002.8, U10001.9 (FGND2), U10001.14 (FGND1), U10002.9 (FGND2), U10002.14 (FGND1), U10003.9 (FGND2), U10003.14 (FGND1), U10004.9 (FGND2), U10004.14 (FGND1), U10005.9 (FGND2), U10005.14 (FGND1), U10006.9 (FGND2), U10006.14 (FGND1), U10007.9 (FGND2), U10007.14 (FGND1), U10008.9 (FGND2), U10008.14 (FGND1), U10009.9 (FGND2), U10009.14 (FGND1), U10010.9 (FGND2), U10010.14 (FGND1), U10011.9 (FGND2), U10011.14 (FGND1)
HOME0_FPGA: JLOG10001.3, R10201.1, U10001.4 (OUT1)
HOME1_FPGA: JLOG10001.4, R10202.1, U10001.5 (OUT2)
HOME2_FPGA: JLOG10001.5, R10203.1, U10002.4 (OUT1)
HOME3_FPGA: JLOG10001.6, R10204.1, U10002.5 (OUT2)
HOME4_FPGA: JLOG10001.7, R10205.1, U10003.4 (OUT1)
HOME5_FPGA: JLOG10001.8, R10206.1, U10003.5 (OUT2)
IO_3V3: C10101.1, C10102.1, C10103.1, C10104.1, C10105.1, C10106.1, C10107.1, C10108.1, C10109.1, C10110.1, C10111.1, JLOG10001.1, JLOG10002.1, U10001.2 (VCC1), U10001.3 (EN), U10002.2 (VCC1), U10002.3 (EN), U10003.2 (VCC1), U10003.3 (EN), U10004.2 (VCC1), U10004.3 (EN), U10005.2 (VCC1), U10005.3 (EN), U10006.2 (VCC1), U10006.3 (EN), U10007.2 (VCC1), U10007.3 (EN), U10008.2 (VCC1), U10008.3 (EN), U10009.2 (VCC1), U10009.3 (EN), U10010.2 (VCC1), U10010.3 (EN), U10011.2 (VCC1), U10011.3 (EN)
LOGIC_GND: C10101.2, C10102.2, C10103.2, C10104.2, C10105.2, C10106.2, C10107.2, C10108.2, C10109.2, C10110.2, C10111.2, JLOG10001.2, JLOG10002.2, R10201.2, R10202.2, R10203.2, R10204.2, R10205.2, R10206.2, R10207.2, R10208.2, R10209.2, R10210.2, R10211.2, R10212.2, R10213.2, R10214.2, R10215.2, R10216.2, R10217.2, R10218.2, R10219.2, R10220.2, R10221.2, R10222.2, U10001.1 (GND1), U10001.8 (GND1), U10002.1 (GND1), U10002.8 (GND1), U10003.1 (GND1), U10003.8 (GND1), U10004.1 (GND1), U10004.8 (GND1), U10005.1 (GND1), U10005.8 (GND1), U10006.1 (GND1), U10006.8 (GND1), U10007.1 (GND1), U10007.8 (GND1), U10008.1 (GND1), U10008.8 (GND1), U10009.1 (GND1), U10009.8 (GND1), U10010.1 (GND1), U10010.8 (GND1), U10011.1 (GND1), U10011.8 (GND1)
LUBE_STATUS_FPGA: JLOG10002.5, R10215.1, U10008.4 (OUT1)
PROBE_FPGA: JLOG10001.9, R10207.1, U10004.4 (OUT1)
PROTECTIVE_STATUS_FPGA: JLOG10001.12, R10210.1, U10005.5 (OUT2)
SPARE_FPGA: JLOG10002.6, R10216.1, U10008.5 (OUT2)
SPINDLE_FAULT_FPGA: JLOG10001.13, R10211.1, U10006.4 (OUT1)
SPINDLE_READY_FPGA: JLOG10001.14, R10212.1, U10006.5 (OUT2)
TOOLSETTER_FPGA: JLOG10001.10, R10208.1, U10004.5 (OUT2)

Notes on the sheet:
DI0: DI00 / DI01 - FIELD inputs -> LOGIC
DI1: DI02 / DI03 - FIELD inputs -> LOGIC
DI2: DI04 / DI05 - FIELD inputs -> LOGIC
DI3: DI06 / DI07 - FIELD inputs -> LOGIC
DI4: DI08 / DI09 - FIELD inputs -> LOGIC
DI5: DI10 / DI11 - FIELD inputs -> LOGIC
DI6: DI12 / DI13 - FIELD inputs -> LOGIC
DI7: DI14 / DI15 - FIELD inputs -> LOGIC
DI8: DI16 / DI17 - FIELD inputs -> LOGIC
DI9: DI18 / DI19 - FIELD inputs -> LOGIC
DI10: DI20 / DI21 - FIELD inputs -> LOGIC
BASELINE 22 ISOLATED SINKING DIGITAL INPUTS - 6 HOME + 16 AUXILIARY - REVIEW r0.1
0-30V input study; low<=5V / high>=15V targets. PNP source or dry contact to field positive. Common FIELD_GND; no per-channel isolation. 11 ISO1212 devices require IO_3V3 only. Do not join FIELD_GND to LOGIC_GND. SUB pins get separate floating copper islands; never ground or join them.
All JDI names/positions match frozen ledger. JDI0/1 have no local common terminal: use JDI2.7/.8. No sensor positive supply is provided by this sheet. Boundary symbols are not approved connector MPNs. No PE capacitor fitted: whole-system coupling/EMC is open.
EN is tied to IO_3V3. Powered open input reads LOW. Unpowered/brownout output is UNDETERMINED; pull-down is bias, not a fail-safe guarantee. Mask all inputs until qualified rail/FPGA readiness. PROBE/TOOLSETTER filters need latency qualification. No safety input certification, physical EMC result o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
