DeadlySIn777/Controller/reports/connected-hardware-20260928/source/hardware/controller_assembly/rx_abz.kicad_sch

## KiCad design reports/connected-hardware-20260928/source/hardware/controller_assembly/rx_abz.kicad_sch (2026-10-18)

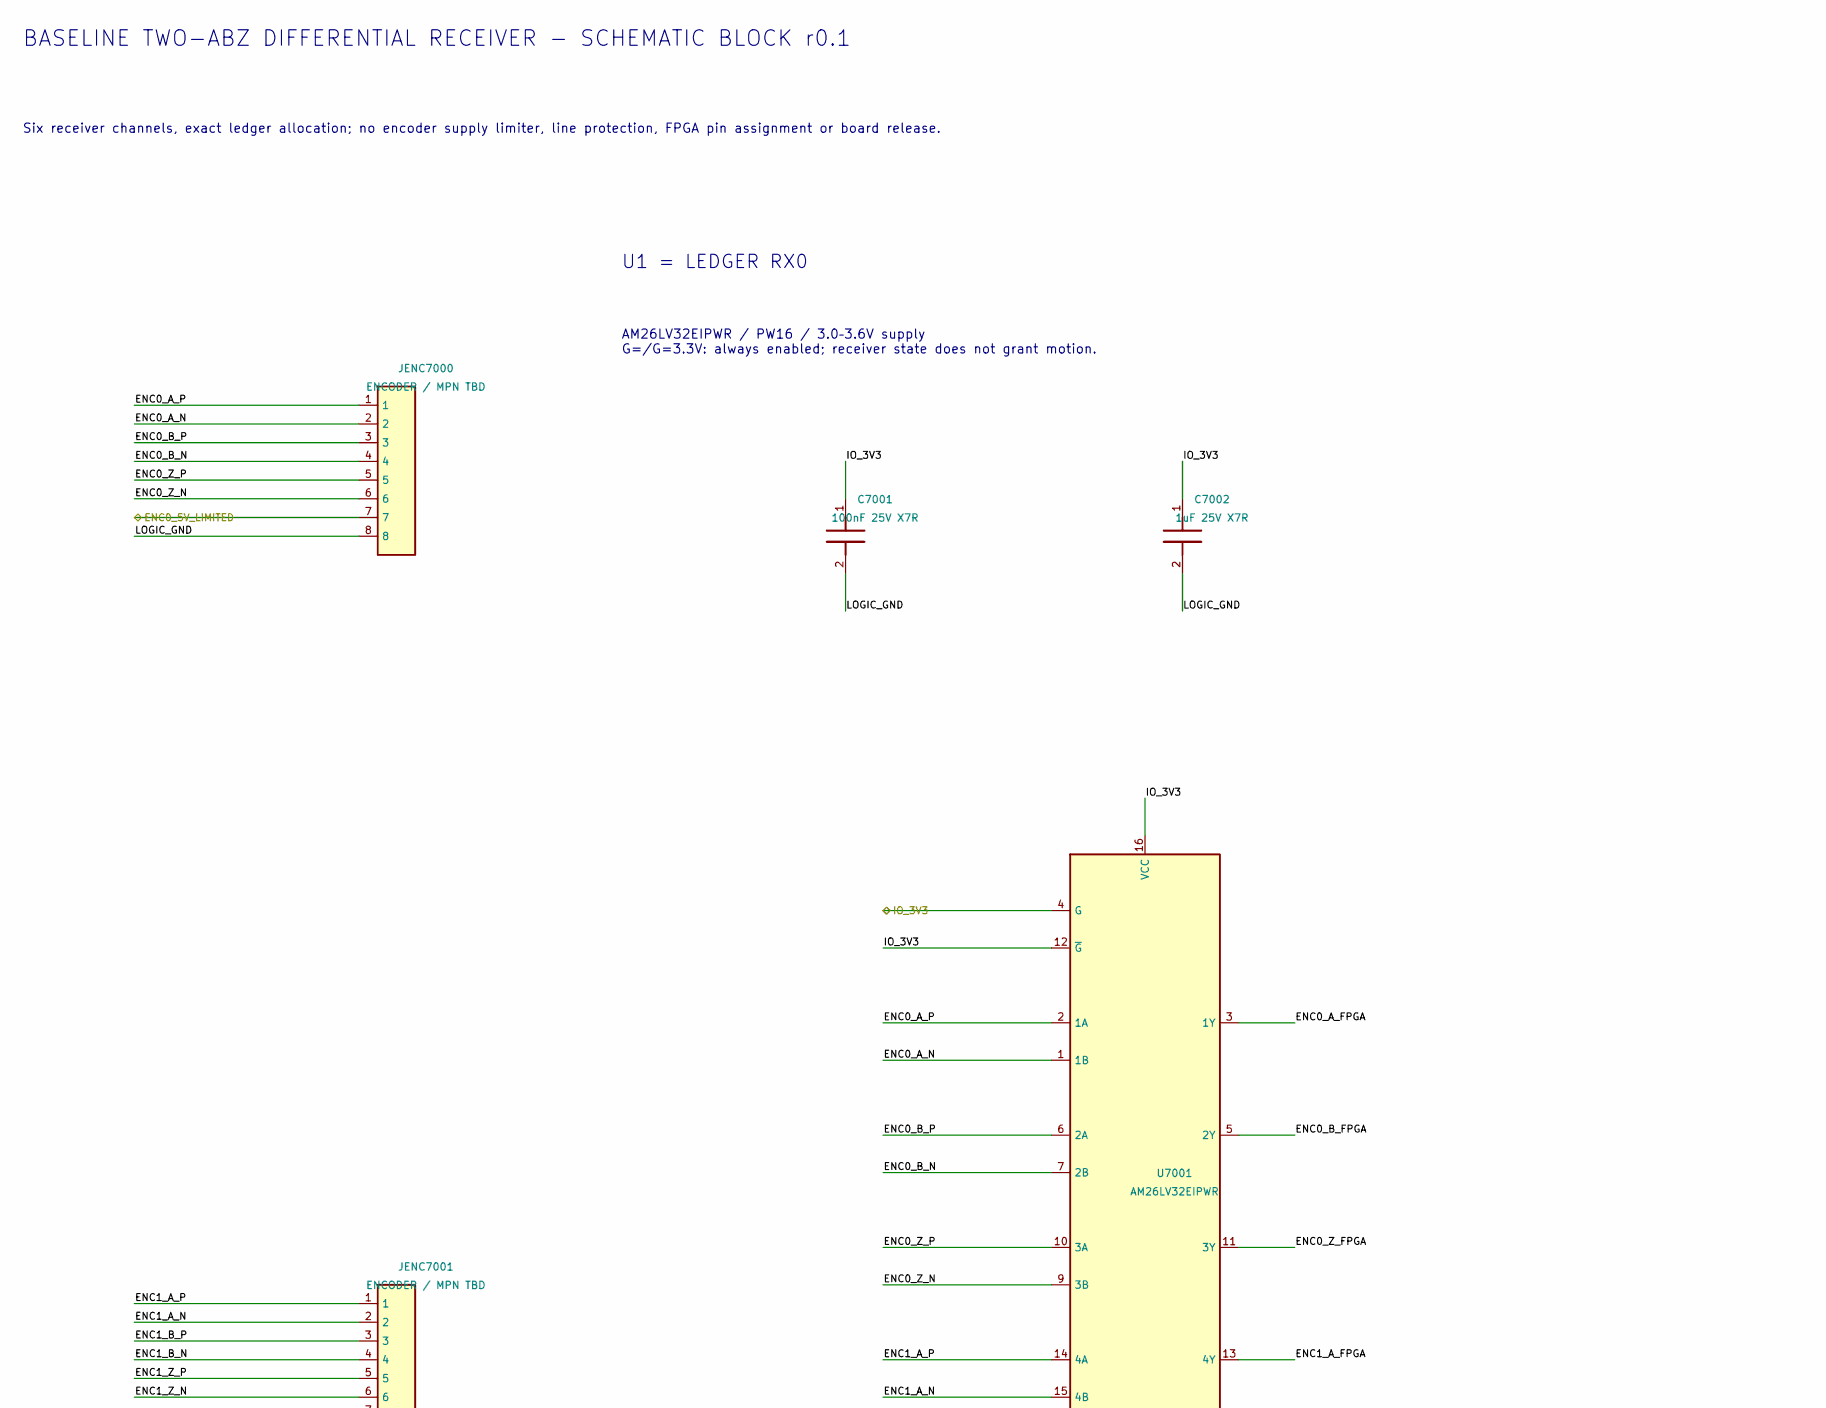
[picture p86: schematic rx_abz.kicad_sch, part in row 1, column 1]

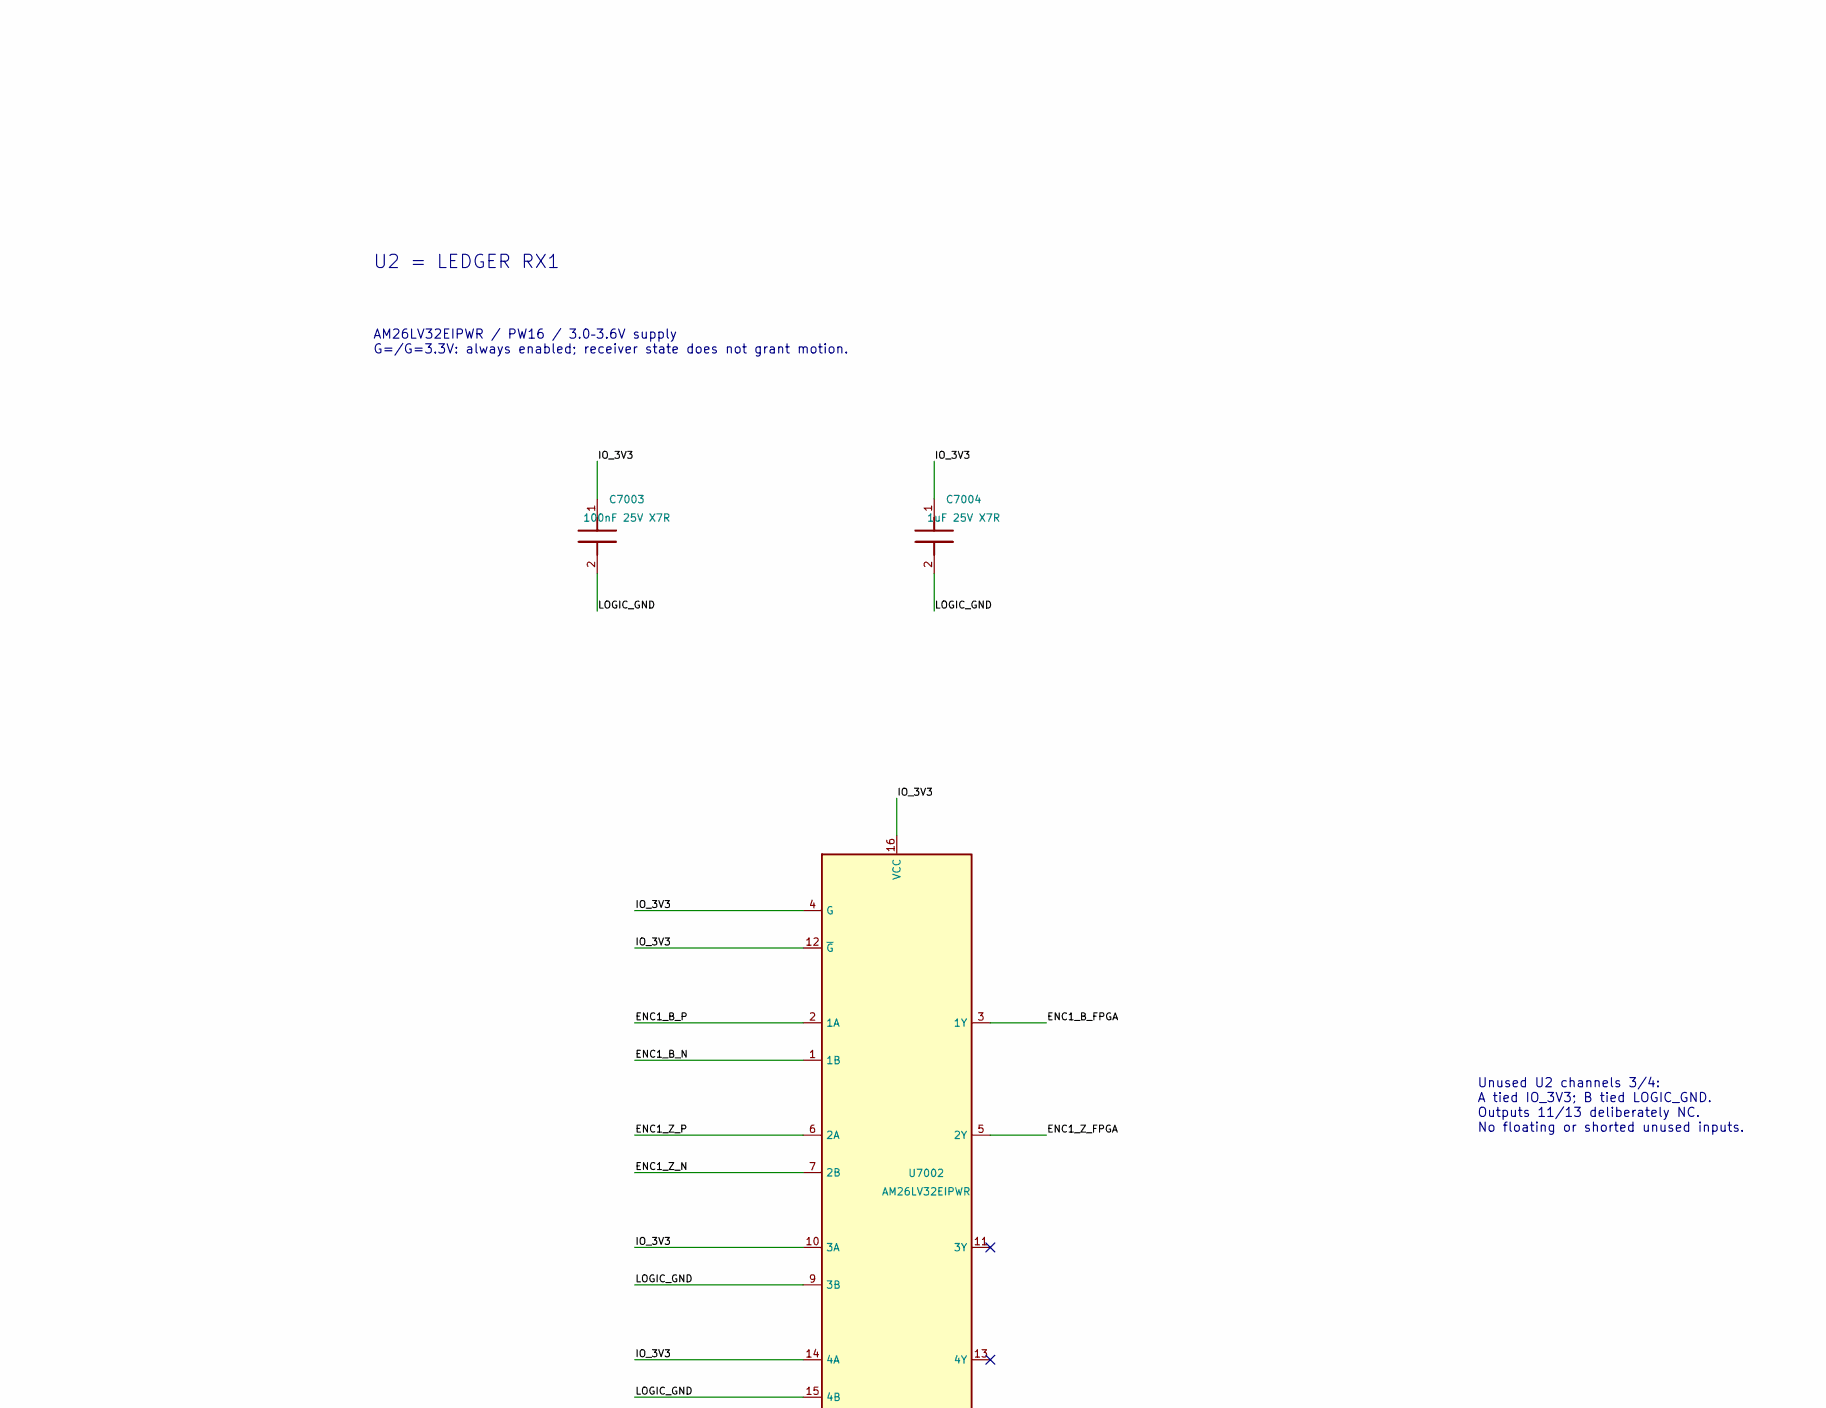
[picture p87: schematic rx_abz.kicad_sch, part in row 1, column 2]

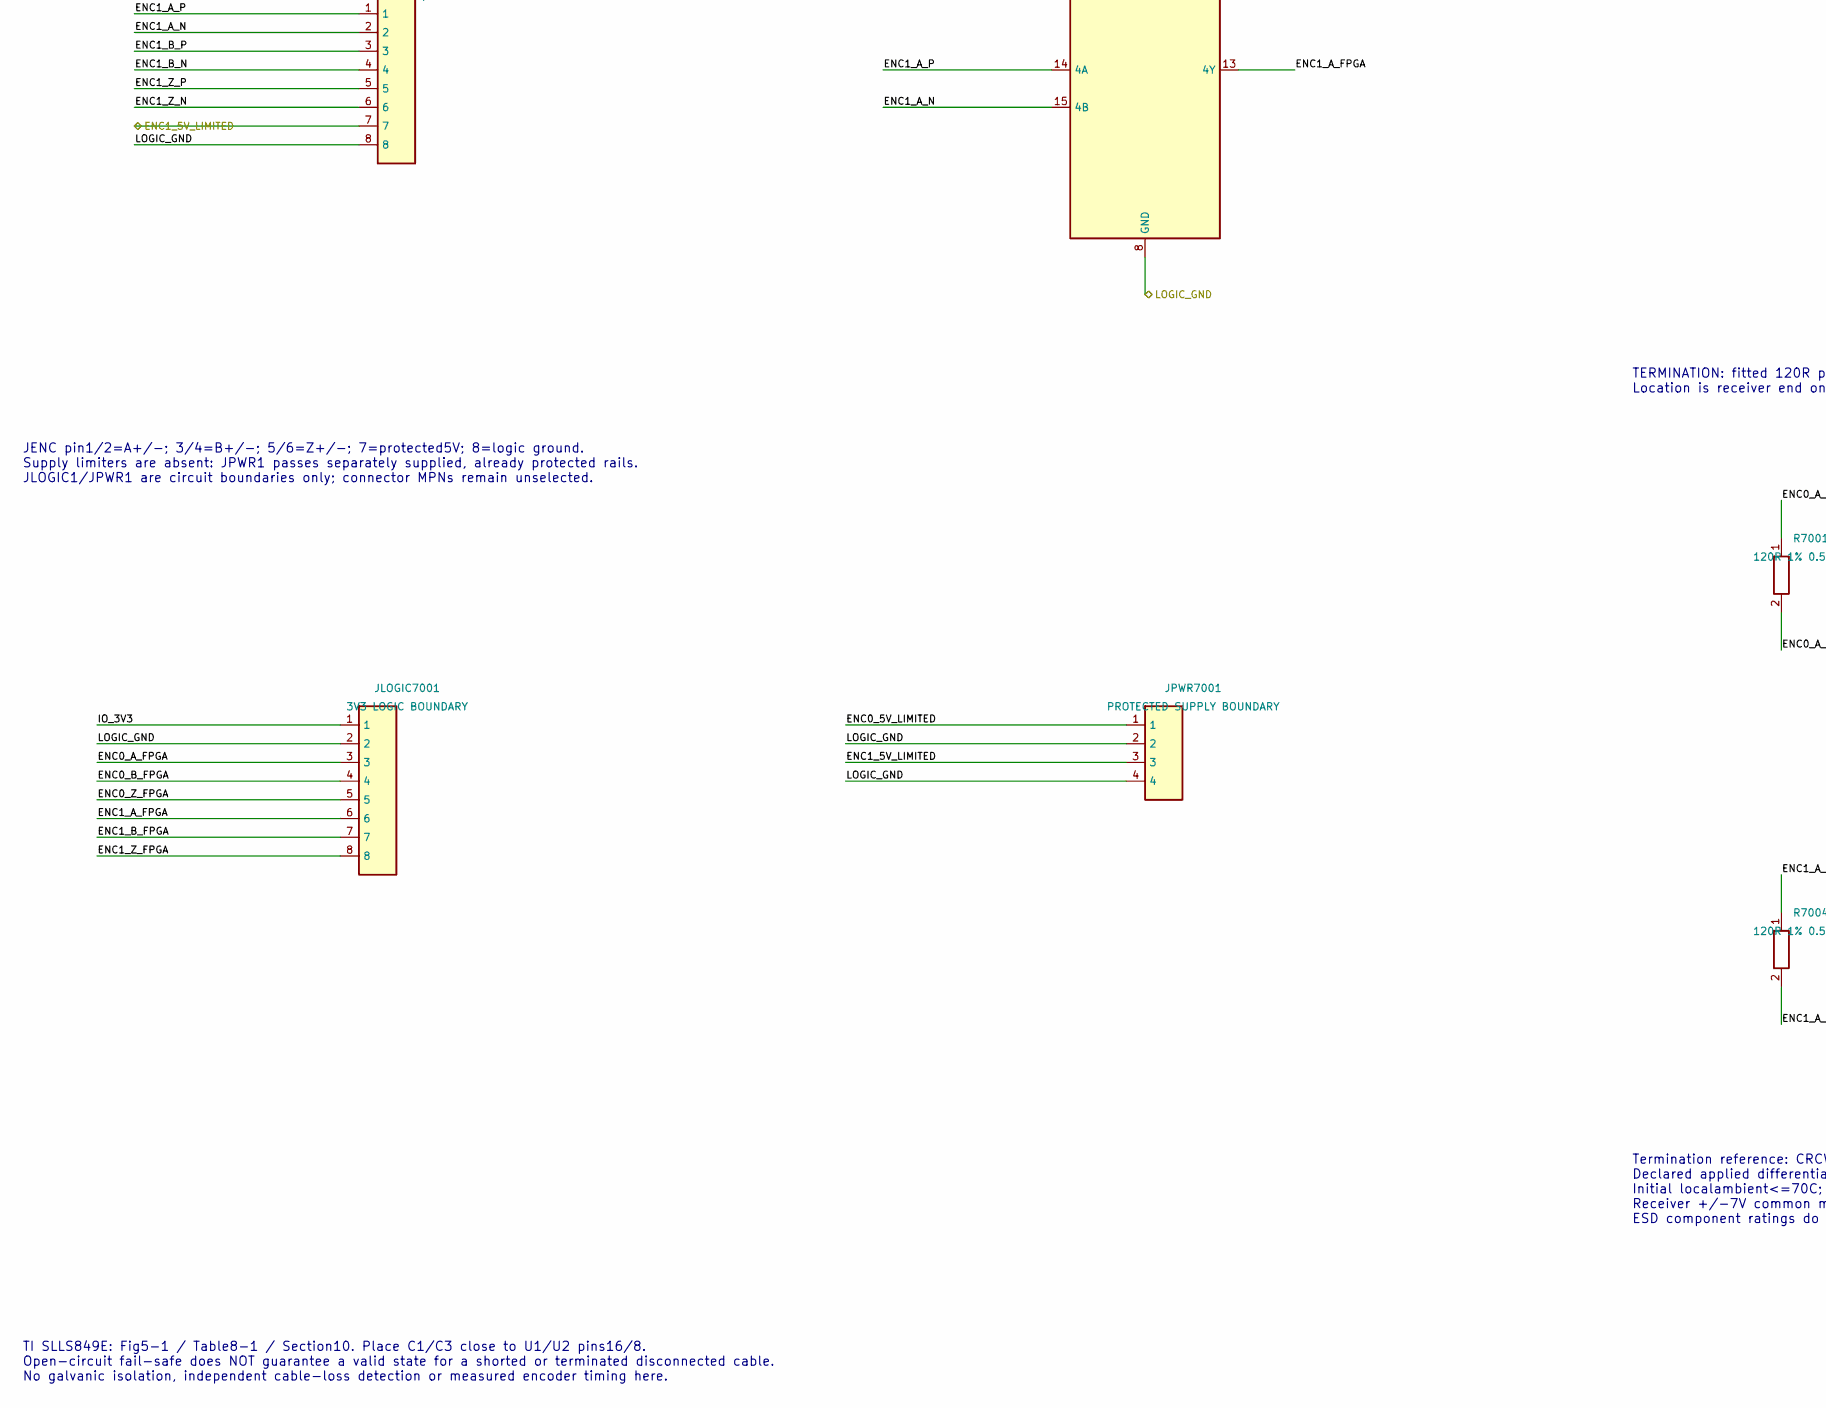
[picture p88: schematic rx_abz.kicad_sch, part in row 2, column 1]

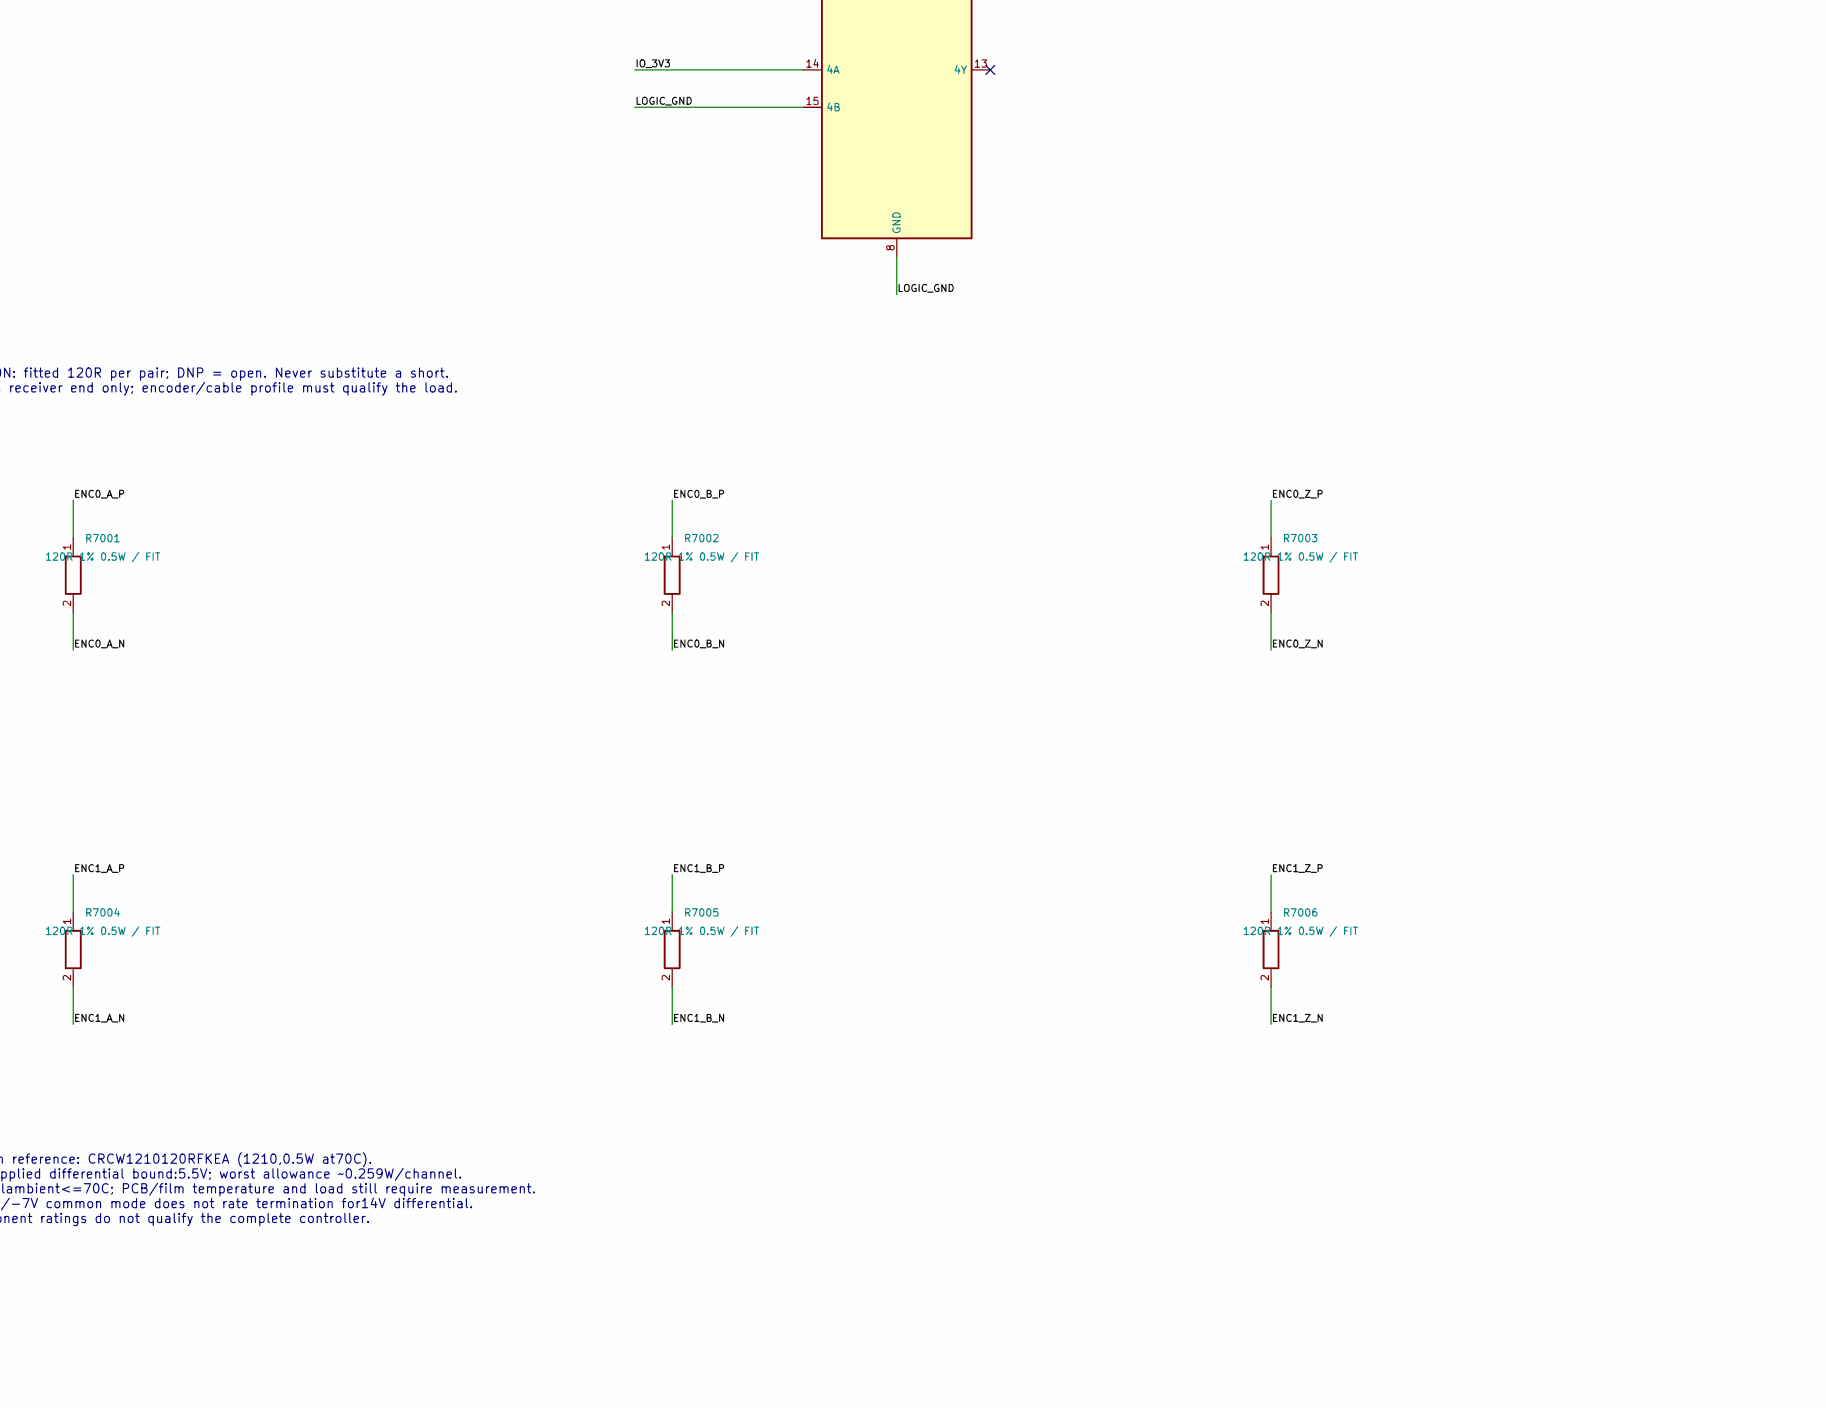
[picture p89: schematic rx_abz.kicad_sch, part in row 2, column 2]

Parts:
C7001, C7003: 100nF 25V X7R; C_0603_1608Metric
C7002, C7004: 1uF 25V X7R; C_0603_1608Metric
JENC7000, JENC7001: ENCODER / MPN TBD
JLOGIC7001: 3V3 LOGIC BOUNDARY
JPWR7001: PROTECTED SUPPLY BOUNDARY
R7001, R7002, R7003, R7004, R7005, R7006: 120R 1% 0.5W / FIT; R_1210_3225Metric; MPN CRCW1210120RFKEA
U7001, U7002: AM26LV32EIPWR; TSSOP-16_4.4x5mm_P0.65mm; MPN AM26LV32EIPWR

Connections:
ENC0_5V_LIMITED: JENC7000.7, JPWR7001.1
ENC0_A_FPGA: JLOGIC7001.3, U7001.3 (1Y)
ENC0_A_N: JENC7000.2, R7001.2, U7001.1 (1B)
ENC0_A_P: JENC7000.1, R7001.1, U7001.2 (1A)
ENC0_B_FPGA: JLOGIC7001.4, U7001.5 (2Y)
ENC0_B_N: JENC7000.4, R7002.2, U7001.7 (2B)
ENC0_B_P: JENC7000.3, R7002.1, U7001.6 (2A)
ENC0_Z_FPGA: JLOGIC7001.5, U7001.11 (3Y)
ENC0_Z_N: JENC7000.6, R7003.2, U7001.9 (3B)
ENC0_Z_P: JENC7000.5, R7003.1, U7001.10 (3A)
ENC1_5V_LIMITED: JENC7001.7, JPWR7001.3
ENC1_A_FPGA: JLOGIC7001.6, U7001.13 (4Y)
ENC1_A_N: JENC7001.2, R7004.2, U7001.15 (4B)
ENC1_A_P: JENC7001.1, R7004.1, U7001.14 (4A)
ENC1_B_FPGA: JLOGIC7001.7, U7002.3 (1Y)
ENC1_B_N: JENC7001.4, R7005.2, U7002.1 (1B)
ENC1_B_P: JENC7001.3, R7005.1, U7002.2 (1A)
ENC1_Z_FPGA: JLOGIC7001.8, U7002.5 (2Y)
ENC1_Z_N: JENC7001.6, R7006.2, U7002.7 (2B)
ENC1_Z_P: JENC7001.5, R7006.1, U7002.6 (2A)
IO_3V3: C7001.1, C7002.1, C7003.1, C7004.1, JLOGIC7001.1, U7001.4 (G), U7001.12 (~G), U7001.16 (VCC), U7002.4 (G), U7002.10 (3A), U7002.12 (~G), U7002.14 (4A), U7002.16 (VCC)
LOGIC_GND: C7001.2, C7002.2, C7003.2, C7004.2, JENC7000.8, JENC7001.8, JLOGIC7001.2, JPWR7001.2, JPWR7001.4, U7001.8 (GND), U7002.8 (GND), U7002.9 (3B), U7002.15 (4B)

Notes on the sheet:
U1 = LEDGER RX0
AM26LV32EIPWR / PW16 / 3.0–3.6V supply G=/G=3.3V: always enabled; receiver state does not grant motion.
U2 = LEDGER RX1
BASELINE TWO-ABZ DIFFERENTIAL RECEIVER - SCHEMATIC BLOCK r0.1
Six receiver channels, exact ledger allocation; no encoder supply limiter, line protection, FPGA pin assignment or board release.
Unused U2 channels 3/4: A tied IO_3V3; B tied LOGIC_GND. Outputs 11/13 deliberately NC. No floating or shorted unused inputs.
JENC pin1/2=A+/−; 3/4=B+/−; 5/6=Z+/−; 7=protected5V; 8=logic ground. Supply limiters are absent: JPWR1 passes separately supplied, already protected rails. JLOGIC1/JPWR1 are circuit boundaries only; connector MPNs remain unselected.
TERMINATION: fitted 120R per pair; DNP = open. Never substitute a short. Location is receiver end only; encoder/cable profile must qualify the load.
TI SLLS849E: Fig5-1 / Table8-1 / Section10. Place C1/C3 close to U1/U2 pins16/8. Open-circuit fail-safe does NOT guarantee a valid state for a shorted or terminated disconnected cable. No galvanic isolation, independent cable-loss detection or measured encoder timing here.
Termination reference: CRCW1210120RFKEA (1210,0.5W at70C). Declared applied differential bound:5.5V; worst allowance ~0.259W/channel. Initial localambient<=70C; PCB/film temperature and load still require measurement. Receiver +/-7V common mode does not rate termination for14V differential. ESD com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
