DeadlySIn777/Controller/reports/connected-reset-repair-20260930/source/hardware/esp_service/esp_service.kicad_sch

## KiCad design reports/connected-reset-repair-20260930/source/hardware/esp_service/esp_service.kicad_sch (2026-10-18)

Schematic: esp_service.kicad_sch

Parts:
C1: 22uF16V X7R10%
C2, C3, C4, C5, C6, C7, C8: 100nF16V X7R20%
D1: TPD2EUSB30DRTR; MPN TPD2EUSB30DRTR
D2, D3, D4: TPD1E10B06DPYR; MPN TPD1E10B06DPYR
JBOOT1: BOOT BOUNDARY
JHOST1: HOST BOUNDARY
JRAIL1: RAIL BOUNDARY
JRES1: RES BOUNDARY
JRESET1: RESET BOUNDARY
JSERIAL1: SERIAL BOUNDARY
JUSB1: USB-C ELECTRICAL BOUNDARY
R1, R2, R3, R4, R5, R14, R15: 10k1%
R6: 47k1%
R7, R9: 1k1%
R8, R10, R16: 100k1%
R11: 100R1%
R12, R13: 22R1%
R17, R18: 5.1k1%
R19: 0R
U1: ESP32-S3-WROOM-1-N8; MPN ESP32-S3-WROOM-1-N8
U2, U6: SN74LVC1G97DBVR; MPN SN74LVC1G97DBVR
U3: SN74LVC2G17DBVR; MPN SN74LVC2G17DBVR
U4: SN74LVC1G17DBVR; MPN SN74LVC1G17DBVR
U5: TS3USB221ARSER; MPN TS3USB221ARSER

Connections:
ESP_3V3: C1.1, C2.1, C3.1, C5.1, C6.1, C8.1, JRAIL1.1, R1.1, R5.1, R14.1, U1.2 (3V3), U2.5 (VCC), U3.5 (VCC), U5.10 (VCC), U6.1 (IN1), U6.5 (VCC)
ESP_BOOT_N: JBOOT1.1, R1.2, U1.27 (IO0)
ESP_CHIP_PU: JRAIL1.3, U2.6 (IN2)
ESP_HOST_RX: U1.4 (IO4), U3.6 (1Y)
ESP_MANUAL_RESET_N: C7.1, JRESET1.1, R5.2, U2.3 (IN0)
ESP_MODULE_EN: R6.1, U1.3 (EN), U2.4 (Y)
ESP_RESERVED_GPIO5: JRES1.1, U1.5 (IO5)
ESP_RESERVED_GPIO6: JRES1.2, U1.6 (IO6)
ESP_RESERVED_GPIO7: JRES1.3, U1.7 (IO7)
ESP_RESERVED_GPIO8: JRES1.4, U1.12 (IO8)
ESP_RESERVED_GPIO9: JRES1.5, U1.17 (IO9)
ESP_RESERVED_GPIO10: JRES1.6, U1.18 (IO10)
ESP_RESERVED_GPIO11: JRES1.7, U1.19 (IO11)
ESP_RESERVED_GPIO12: JRES1.8, U1.20 (IO12)
ESP_STRAP3: R4.1, U1.15 (IO3)
ESP_STRAP45: R2.1, U1.26 (IO45)
ESP_STRAP46: R3.1, U1.16 (IO46)
ESP_UART0_RX: U1.36 (RXD0_IO44), U3.4 (2Y)
ESP_UART0_TX: U1.37 (TXD0_IO43), U4.2 (A)
ESP_USB_DM: R13.1, U1.13 (IO19_USB_DM)
ESP_USB_DM_SWITCH: R13.2, U5.2 (1D_MINUS)
ESP_USB_DP: R12.1, U1.14 (IO20_USB_DP)
ESP_USB_DP_SWITCH: R12.2, U5.1 (1D_PLUS)
ESP_USB_OE_N: R14.2, U5.6 (OE_N), U6.4 (Y)
HOST_HEALTH_RX_FILTERED: R7.2, R8.1, U3.1 (1A)
HOST_HEALTH_TX_3V3: JHOST1.1, R7.1
LOGIC_GND: C1.2, C2.2, C3.2, C4.2, C5.2, C6.2, C7.2, C8.2, D1.3 (GND), D2.2, D3.2, D4.2, JBOOT1.2, JHOST1.2, JRAIL1.2, JRES1.9, JRESET1.2, JSERIAL1.4, JUSB1.A1, JUSB1.A12, JUSB1.B1, JUSB1.B12, R2.2, R3.2, R4.2, R6.2, R8.2, R10.2, R16.2, R17.2, R18.2, R19.2, U1.1 (GND), U1.40 (GND), U1.41 (GND_PAD), U2.1 (IN1), U2.2 (GND), U3.2 (GND), U4.3 (GND), U5.5 (GND), U5.9 (S), U6.2 (GND), U6.3 (IN0)
SERVICE_ADAPTER_RX_3V3: JSERIAL1.3, R11.2
SERVICE_ADAPTER_TX_3V3: JSERIAL1.2, R9.1
SERVICE_UART_RX_FILTERED: R9.2, R10.1, U3.3 (2A)
SERVICE_UART_TX_BUFFERED: R11.1, U4.4 (Y)
SERVICE_VREF_3V3: C4.1, JSERIAL1.1, U4.5 (VCC)
USB_CC1: D3.1, JUSB1.A5, R17.1
USB_CC2: D4.1, JUSB1.B5, R18.1
USB_DM_CONNECTOR: D1.2 (D_MINUS), JUSB1.A7, JUSB1.B7, U5.7 (D_MINUS)
USB_DP_CONNECTOR: D1.1 (D_PLUS), JUSB1.A6, JUSB1.B6, U5.8 (D_PLUS)
USB_SHIELD: JUSB1.S1, R19.1
USB_VBUS: D2.1, JUSB1.A4, JUSB1.A9, JUSB1.B4, JUSB1.B9, R15.1
USB_VBUS_SENSE: R15.2, R16.1, U6.6 (IN2)

Notes on the sheet:
ESP32-S3 SERVICE / RECOVERY CANDIDATE - NO MOTION OR ACCESSORY OUTPUT AUTHORITY
Self-powered USB2 device; USB VBUS never powers controller. USB connector is an electrical boundary pending exact pad mapping. U2 is Schmitt AND: module EN = sequencer ESP_CHIP_PU AND manual-reset release. Never ground sequencer output. Host RX is GPIO4 via powered-off buffer; default firmware leav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
All footprints unassigned: no board layout or manufacture claim. USB switch D pins face connector; 1D pins face ESP; port2NC andSground. Two independent5.1k CC resistors. SBU pins NC. NoPD/high-voltage mode. Local USB shield bond toLOGIC_GND is provisional; assess enclosure/EMC. JRESET/JBOOT: norma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
