DeadlySIn777/Controller/reports/connected-reset-repair-20260930/source/hardware/machine_permission/machine_permission.kicad_sch

## KiCad design reports/connected-reset-repair-20260930/source/hardware/machine_permission/machine_permission.kicad_sch (2026-10-18)

Schematic: machine_permission.kicad_sch

Parts:
C1: 120pF C0G 50V 5%; C_0603_1608Metric; MPN GRM1885C1H121JA01D
C2, C3, C4, C5, C6, C7, C8: 100nF X7R 25V 20%; C_0603_1608Metric
JCTRL1: INTERNAL BOUNDARY
JOUT1: INTERNAL BOUNDARY
R1, R3, R4, R5, R6, R7, R8, R9, R10, R11: 10k 1%; R_0603_1608Metric; MPN CRCW060310K0FKEA
R2: 100k 1%; R_0603_1608Metric; MPN CRCW0603100KFKEA
U1: TPS3431SDRBR; TPS3431_DRB8; MPN TPS3431SDRBR
U2: SN74LVC2G17DBVR; SOT-23-6; MPN SN74LVC2G17DBVR
U3: SN74LVC1G34DBVR; SOT-23-5; MPN SN74LVC1G34DBVR
U4, U7: SN74LVC1G11DBVR; SOT-23-6; MPN SN74LVC1G11DBVR
U5: SN74LVC2G08DCUR; VSSOP-8_2.3x2mm_P0.5mm; MPN SN74LVC2G08DCUR
U6: SN74LVC2G74DCUR; VSSOP-8_2.3x2mm_P0.5mm; MPN SN74LVC2G74DCUR

Connections:
BASE_INTERLOCK_OK: U4.4 (Y), U5.1 (1A)
CDONE_BUF: U2.4 (2Y), U4.3 (B)
EXT_PERMIT_3V3: JCTRL1.5, R5.1, U4.6 (C)
FPGA_CDONE: JCTRL1.4, U2.3 (2A)
FPGA_ENDPOINT_READY: JCTRL1.6, R6.1, U5.6 (2B)
FPGA_LOCAL_RESET_N: JCTRL1.3, R4.1, U4.1 (A)
FPGA_MOTION_REQUEST: JCTRL1.7, R7.1, U6.1 (CLK), U7.3 (B)
FPGA_PROGRESS_WDI: JCTRL1.8, R3.1, U3.2 (A)
HW_PERMISSION_LATCHED: JOUT1.3, R9.1, U6.5 (Q), U7.1 (A)
HW_WATCHDOG_OK_N: JOUT1.2, R11.1, U5.5 (2A), U5.7 (1Y), U7.6 (C)
IO_3V3: C2.1, C3.1, C4.1, C5.1, C6.1, C7.1, C8.1, JCTRL1.1, R1.1, U1.1 (VDD), U1.3 (EN), U1.5 (SET1), U2.5 (VCC), U3.5 (VCC), U4.5 (VCC), U5.8 (VCC), U6.2 (D), U6.7 (PRE_N), U6.8 (VCC), U7.5 (VCC)
LATCH_CLEAR_N: R8.1, U5.3 (2Y), U6.6 (CLR_N)
LOGIC_GND: C1.2, C2.2, C3.2, C4.2, C5.2, C6.2, C7.2, C8.2, JCTRL1.2, JOUT1.5, R2.2, R3.2, R4.2, R5.2, R6.2, R7.2, R8.2, R9.2, R10.2, R11.2, U1.4 (GND), U1.9 (EP), U2.2 (GND), U3.3 (GND), U4.2 (GND), U5.4 (GND), U6.4 (GND), U7.2 (GND)
TX_PERMIT: JOUT1.1, R10.1, U7.4 (Y)
WD_CWD: C1.1, U1.2 (CWD)
WD_HEALTH_BUF: U2.6 (1Y), U5.2 (1B)
WD_HEALTH_RAW_N: JOUT1.4, R1.2, U1.7 (WDO_N), U1.8 (ENOUT), U2.1 (1A)
WD_INPUT_BUF: R2.1, U1.6 (WDI), U3.4 (Y)

Notes on the sheet:
INDEPENDENT WATCHDOG AND EDGE-ARMED GLOBAL PERMISSION - ENGINEERING CANDIDATE
Seven ICs; no firmware timer owns the external watchdog. IO_3V3=3.2-3.4V, common LOGIC_GND. Eight motors minimum / twelve expansion requirement.
1. Always-enabled watchdog; WDO + ENOUT wired together
2. Schmitt inputs for open-drain watchdog and CDONE
3. Rail-to-rail WDI buffer; FALLING edges feed timer
4. Raw interlock
5. Raw return and latch clear
6. Accepted ARM edge; async clear
7. Final physical permit
120pF:64.288ms nominal watchdog. NOT20ms. 100pF nominal would violate tested minimum at -tolerance. Falling progress edge occurs every TWO accepted UPDATEs. WDO auto-releases after170-230ms; heartbeat alone cannot set the arm latch. SYNC + deliberate ARM required. CDONE pullup belongs to FPGA block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
HW_WATCHDOG_OK_N -> RTL inhibit_n. Never return TX_PERMIT there. Raw interlock has no endpoint_ready / motion_request / latch dependency. D is permanently HIGH; clock is FPGA_MOTION_REQUEST rising edge. Asynchronous clear is raw interlock AND endpoint_ready. TX_PERMIT = latched_arm AND motion_reque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
TX_PERMIT drives six AM26C31 G inputs + six10k pulldowns; /G fixedHIGH. DefaultLOW disables transmitters. Per-drive active-low enables are separate. EXT_PERMIT_3V3 is protected internal logic, never raw24V or certified E-stop. Single-channel candidate: no safety certification, fault tolerance or co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
