DeadlySIn777/Controller/reports/is1-watchdog-independent-review-final-20260930/source/hardware/is1_watchdogs/is1_watchdogs.kicad_sch

## KiCad design reports/is1-watchdog-independent-review-final-20260930/source/hardware/is1_watchdogs/is1_watchdogs.kicad_sch (2026-10-18)

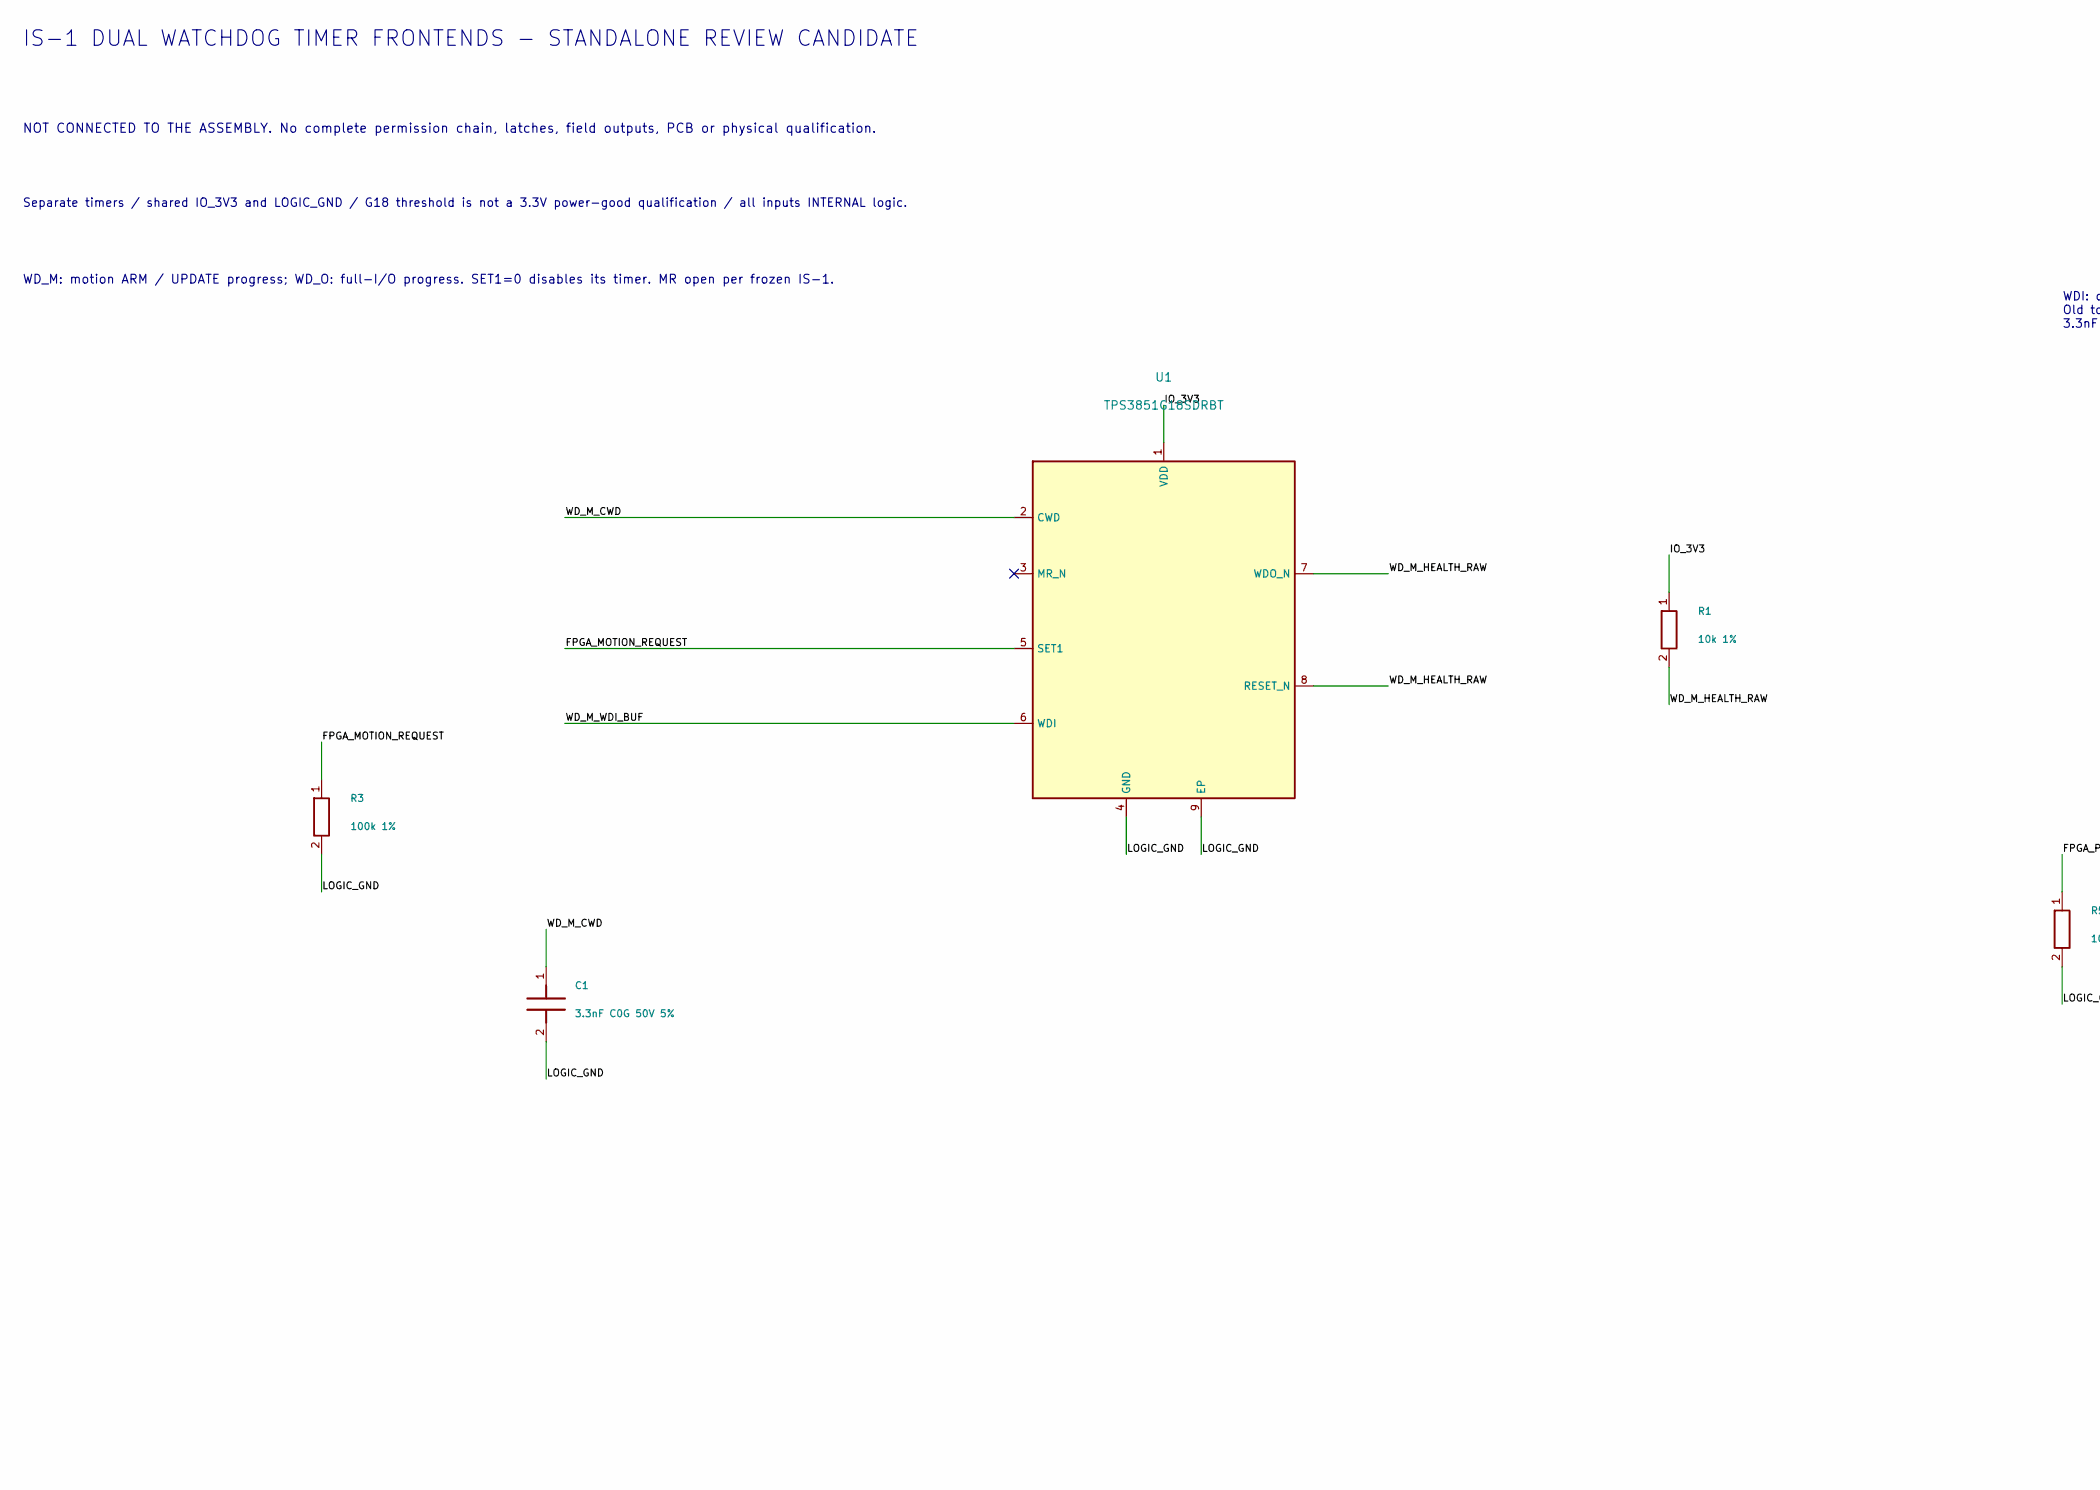
[picture p90: schematic is1_watchdogs.kicad_sch, part in row 1, column 1]

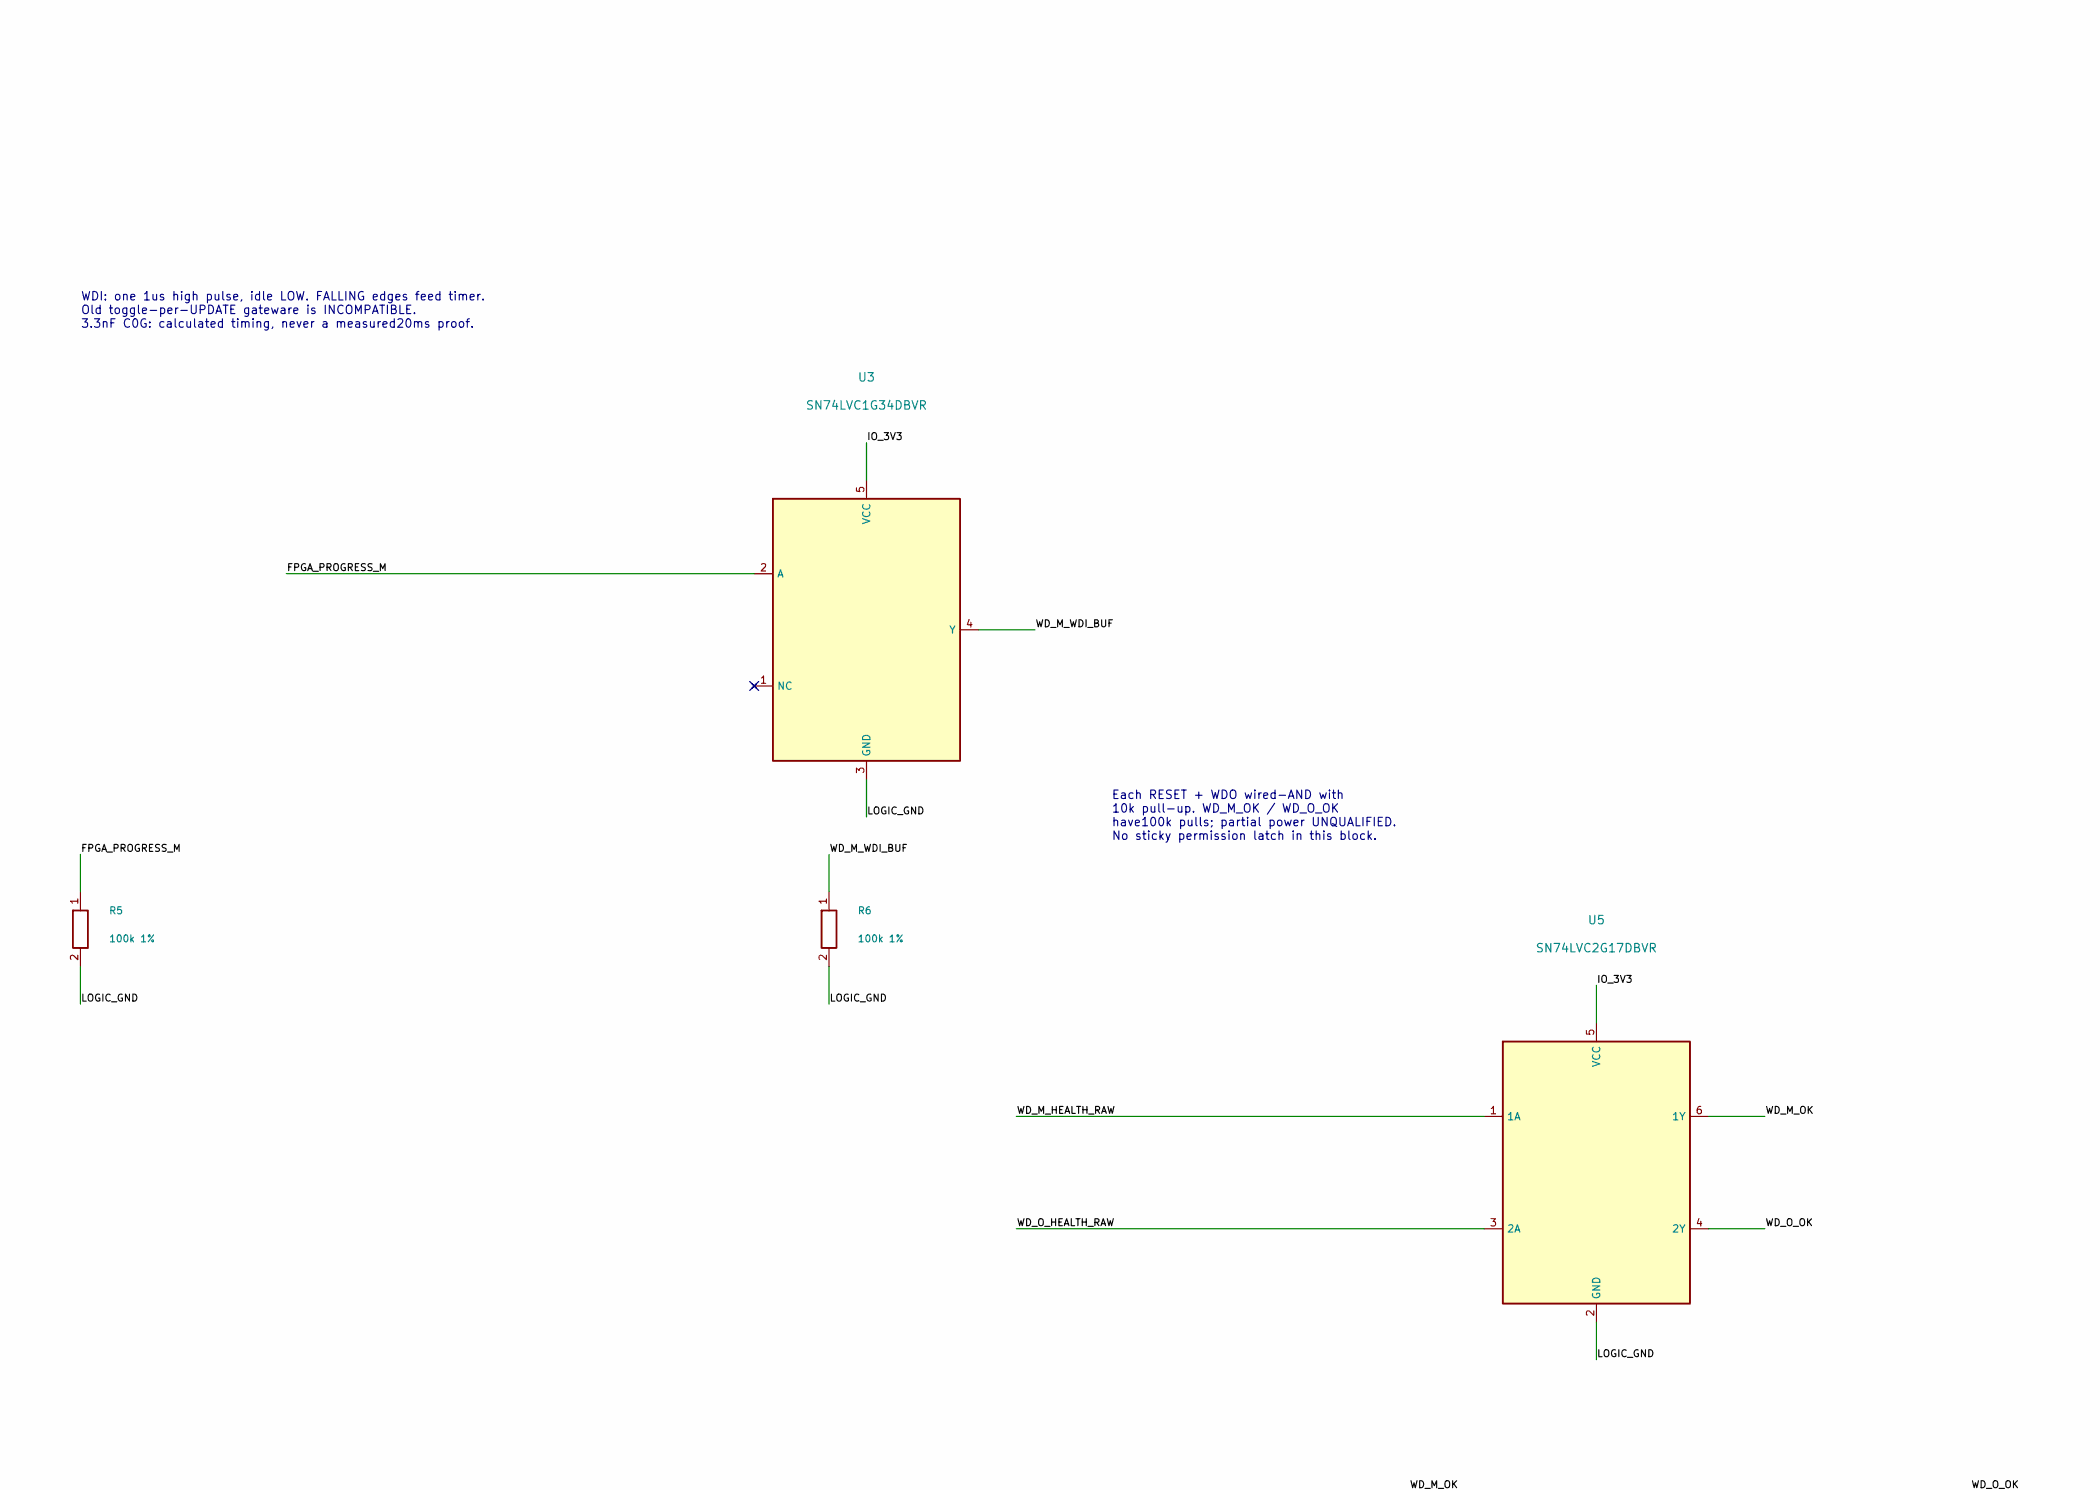
[picture p91: schematic is1_watchdogs.kicad_sch, part in row 1, column 2]

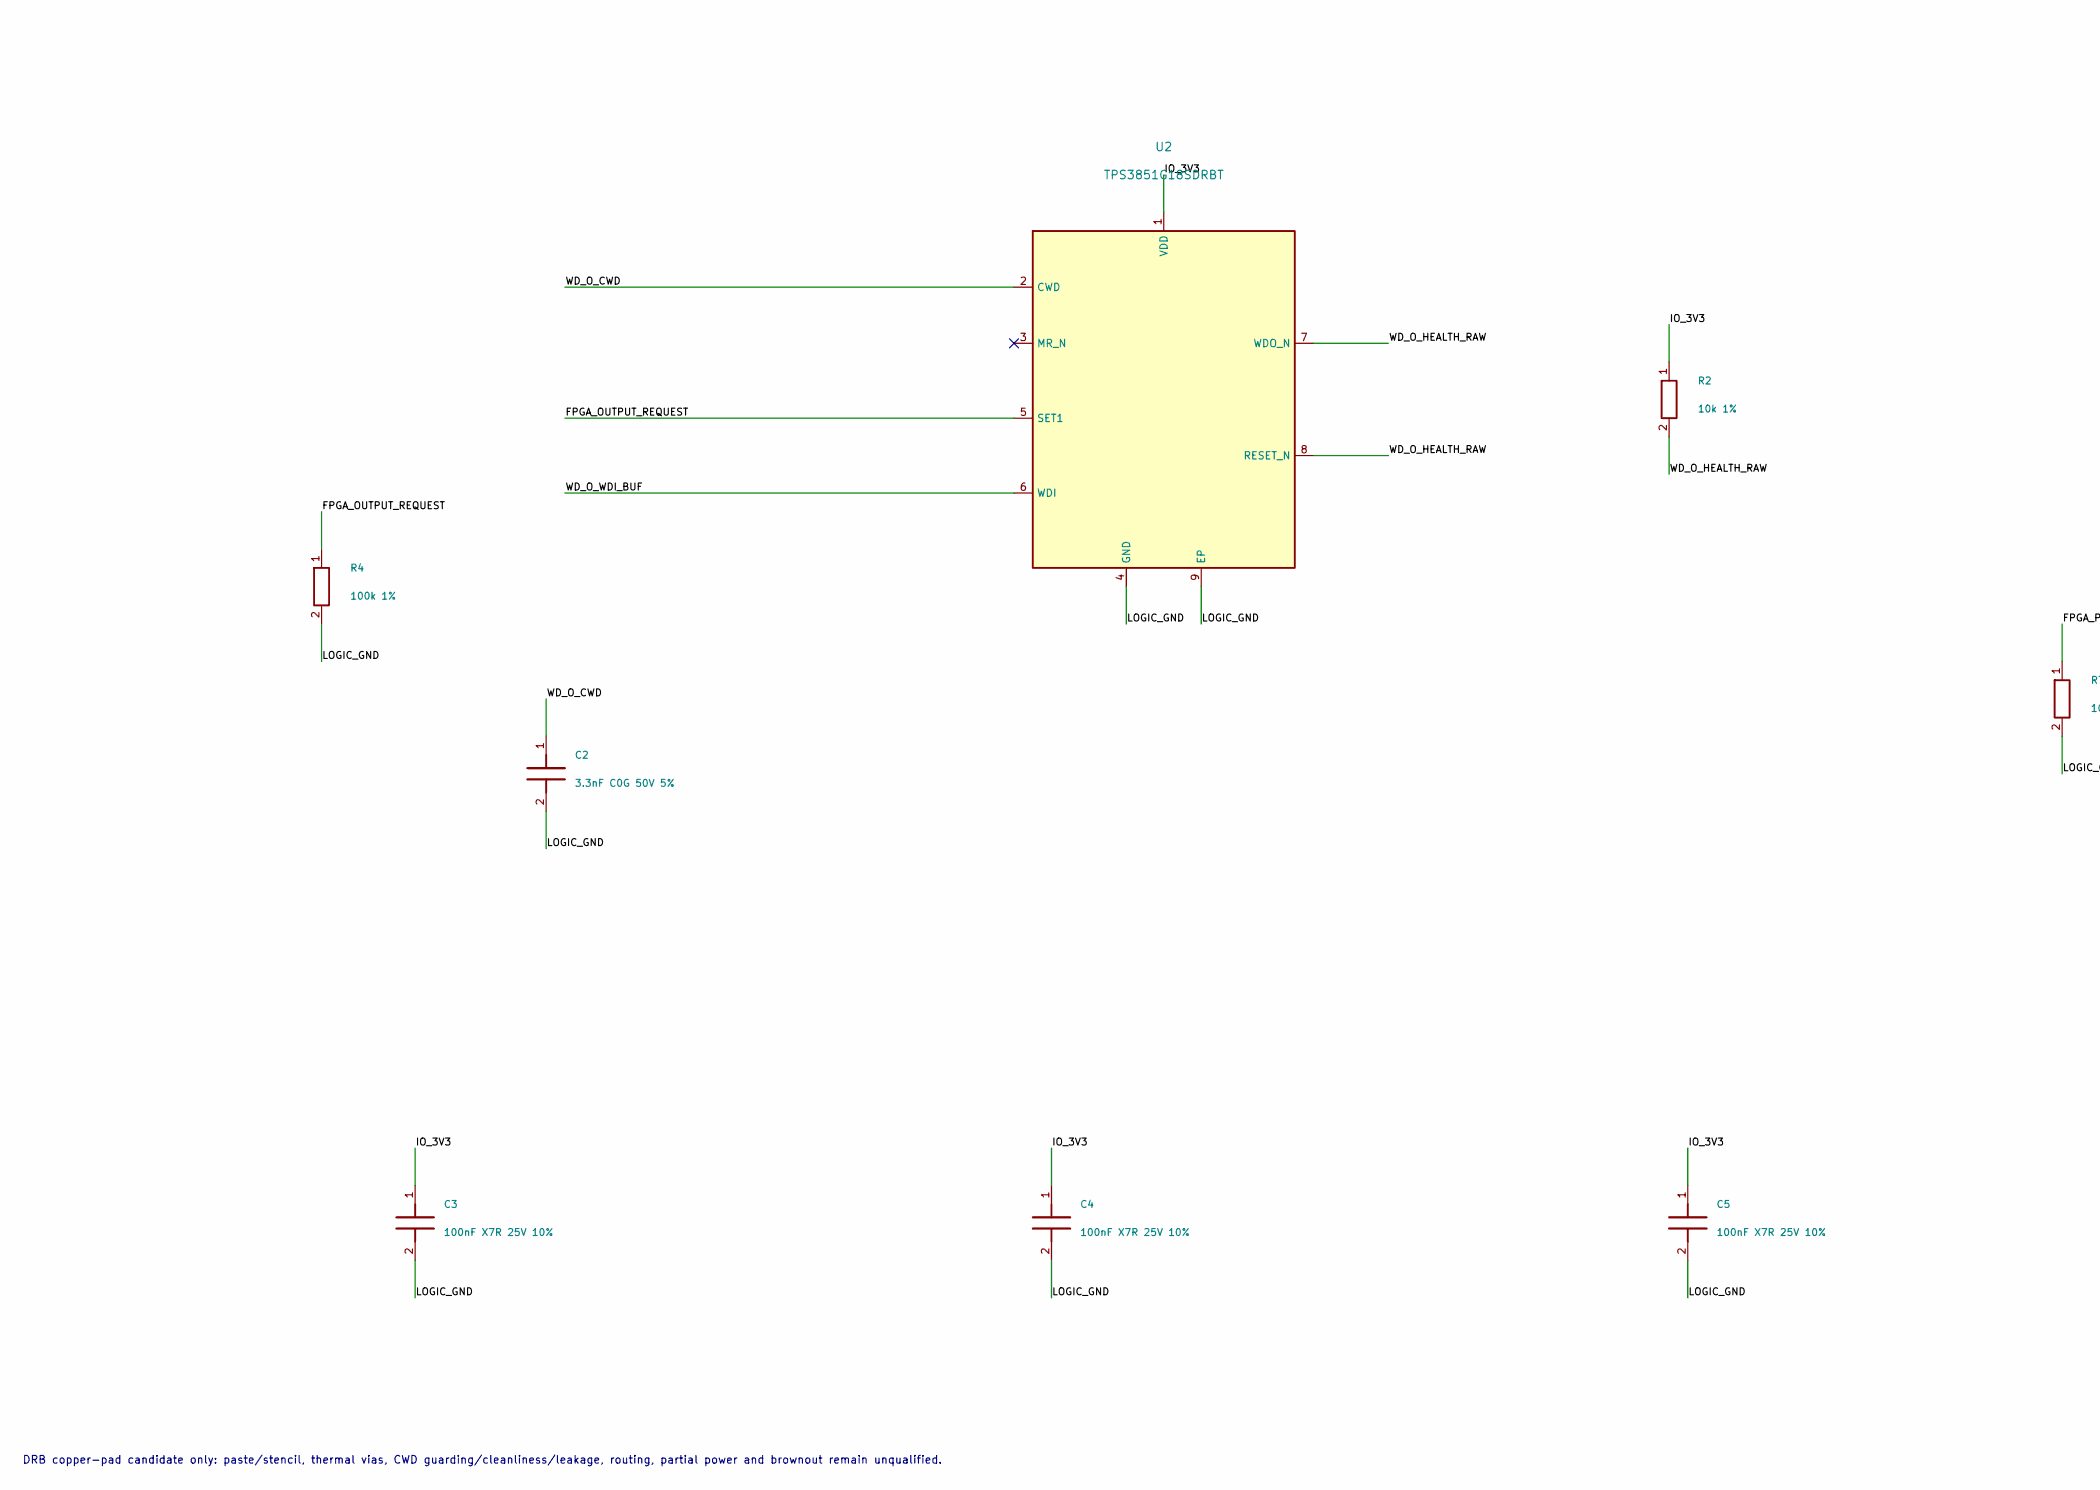
[picture p92: schematic is1_watchdogs.kicad_sch, part in row 2, column 1]

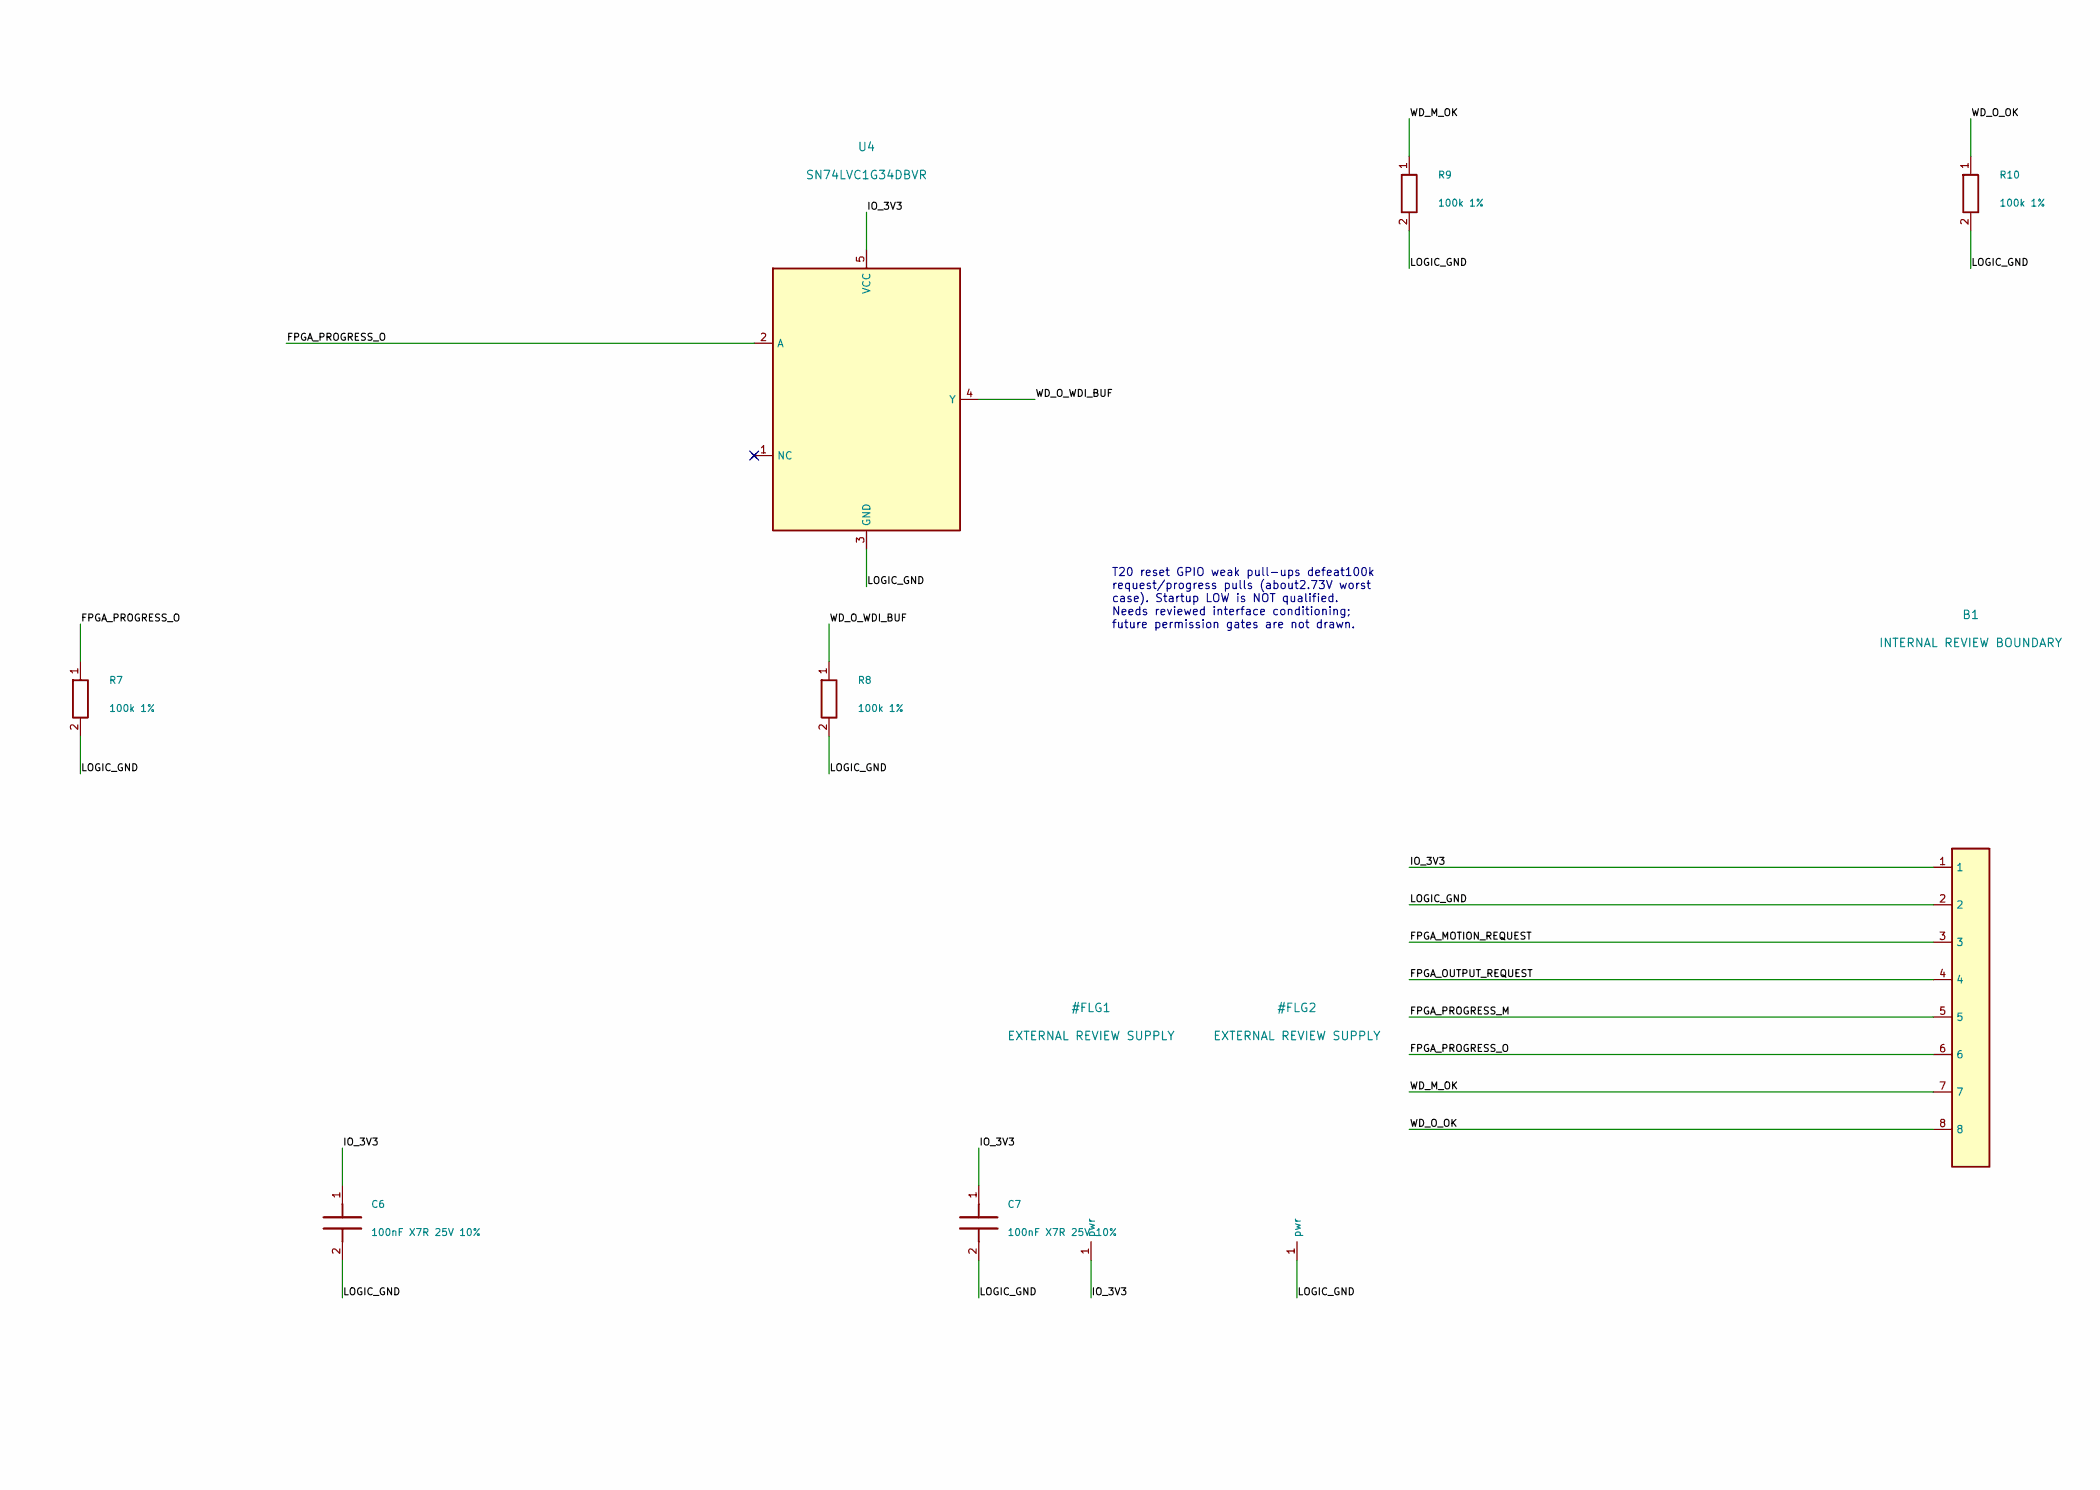
[picture p93: schematic is1_watchdogs.kicad_sch, part in row 2, column 2]

Parts:
B1: INTERNAL REVIEW BOUNDARY
C1, C2: 3.3nF C0G 50V 5%; C_0603_1608Metric; MPN CL10C332JB8NNNC
C3, C4, C5, C6, C7: 100nF X7R 25V 10%; C_0603_1608Metric; MPN GRM188R71E104KA01D
R1, R2: 10k 1%; R_0603_1608Metric; MPN CRCW060310K0FKEA
R3, R4, R5, R6, R7, R8, R9, R10: 100k 1%; R_0603_1608Metric; MPN CRCW0603100KFKEA
U1, U2: TPS3851G18SDRBT; TPS3851_DRB8; MPN TPS3851G18SDRBT
U3, U4: SN74LVC1G34DBVR; SOT-23-5; MPN SN74LVC1G34DBVR
U5: SN74LVC2G17DBVR; SOT-23-6; MPN SN74LVC2G17DBVR

Connections:
FPGA_MOTION_REQUEST: B1.3, R3.1, U1.5 (SET1)
FPGA_OUTPUT_REQUEST: B1.4, R4.1, U2.5 (SET1)
FPGA_PROGRESS_M: B1.5, R5.1, U3.2 (A)
FPGA_PROGRESS_O: B1.6, R7.1, U4.2 (A)
IO_3V3: B1.1, C3.1, C4.1, C5.1, C6.1, C7.1, R1.1, R2.1, U1.1 (VDD), U2.1 (VDD), U3.5 (VCC), U4.5 (VCC), U5.5 (VCC)
LOGIC_GND: B1.2, C1.2, C2.2, C3.2, C4.2, C5.2, C6.2, C7.2, R3.2, R4.2, R5.2, R6.2, R7.2, R8.2, R9.2, R10.2, U1.4 (GND), U1.9 (EP), U2.4 (GND), U2.9 (EP), U3.3 (GND), U4.3 (GND), U5.2 (GND)
WD_M_CWD: C1.1, U1.2 (CWD)
WD_M_HEALTH_RAW: R1.2, U1.7 (WDO_N), U1.8 (RESET_N), U5.1 (1A)
WD_M_OK: B1.7, R9.1, U5.6 (1Y)
WD_M_WDI_BUF: R6.1, U1.6 (WDI), U3.4 (Y)
WD_O_CWD: C2.1, U2.2 (CWD)
WD_O_HEALTH_RAW: R2.2, U2.7 (WDO_N), U2.8 (RESET_N), U5.3 (2A)
WD_O_OK: B1.8, R10.1, U5.4 (2Y)
WD_O_WDI_BUF: R8.1, U2.6 (WDI), U4.4 (Y)

Notes on the sheet:
IS-1 DUAL WATCHDOG TIMER FRONTENDS - STANDALONE REVIEW CANDIDATE
NOT CONNECTED TO THE ASSEMBLY. No complete permission chain, latches, field outputs, PCB or physical qualification.
Separate timers / shared IO_3V3 and LOGIC_GND / G18 threshold is not a 3.3V power-good qualification / all inputs INTERNAL logic.
WD_M: motion ARM / UPDATE progress; WD_O: full-I/O progress. SET1=0 disables its timer. MR open per frozen IS-1.
WDI: one 1us high pulse, idle LOW. FALLING edges feed timer. Old toggle-per-UPDATE gateware is INCOMPATIBLE. 3.3nF C0G: calculated timing, never a measured20ms proof.
Each RESET + WDO wired-AND with 10k pull-up. WD_M_OK / WD_O_OK have100k pulls; partial power UNQUALIFIED. No sticky permission latch in this block.
T20 reset GPIO weak pull-ups defeat100k request/progress pulls (about2.73V worst case). Startup LOW is NOT qualified. Needs reviewed interface conditioning; future permission gates are not drawn.
DRB copper-pad candidate only: paste/stencil, thermal vias, CWD guarding/cleanliness/leakage, routing, partial power and brownout remain unqualified.
