DeadlySIn777/Controller/reports/motherboard-power-entry-20261001/health-source-correction-r01/candidate-r02/motherboard/motherboard_control_bridges.kicad_sch

## KiCad design reports/motherboard-power-entry-20261001/health-source-correction-r01/candidate-r02/motherboard/motherboard_control_bridges.kicad_sch (2026-10-18)

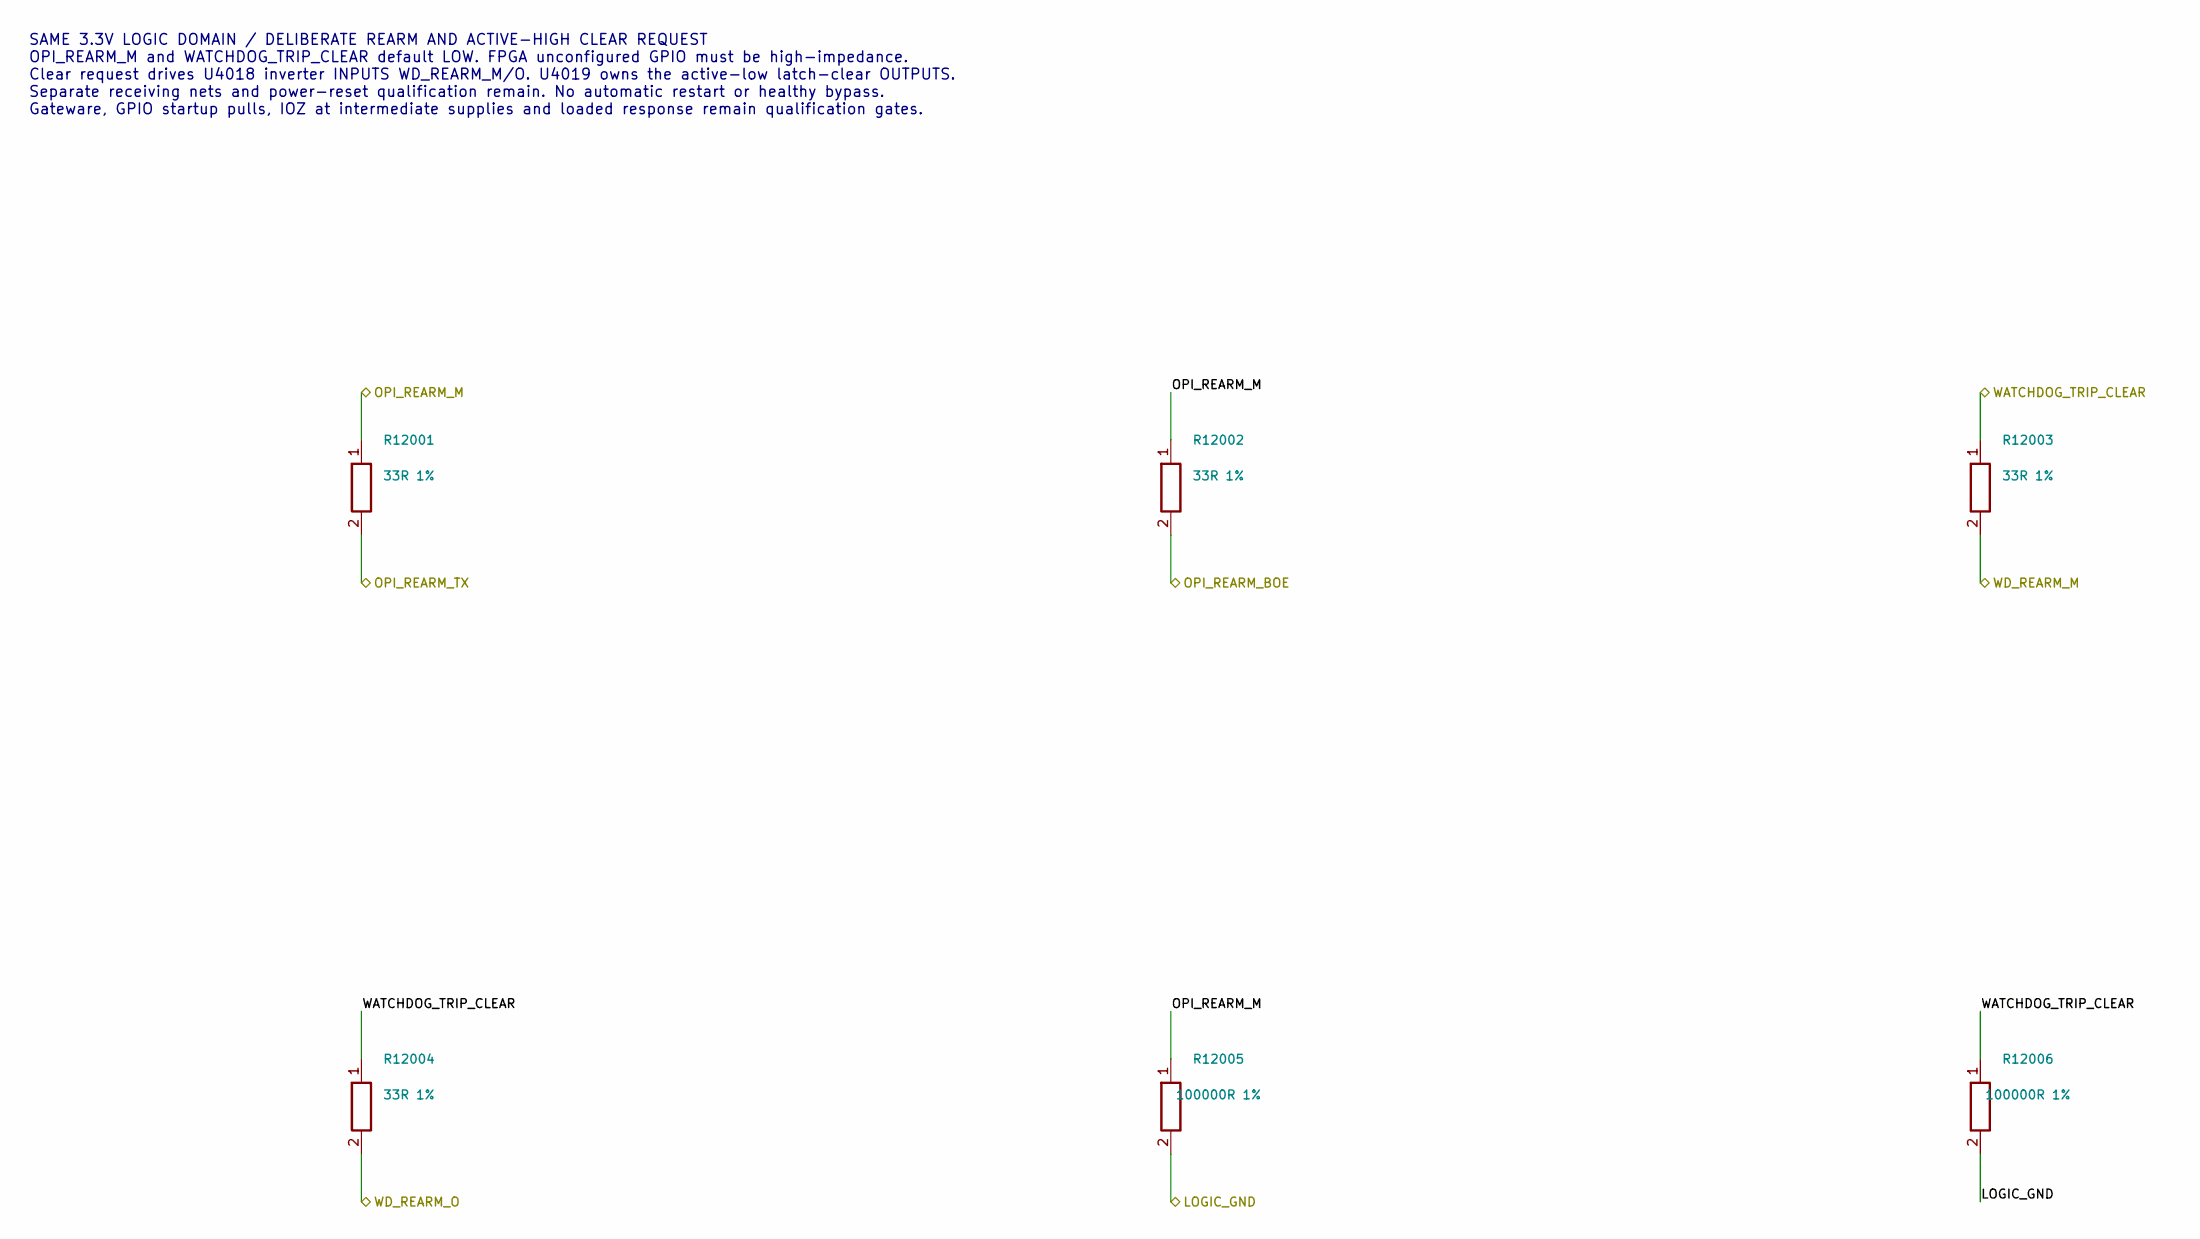
[picture p94: schematic motherboard_control_bridges.kicad_sch]

Parts:
R12001, R12002, R12003, R12004: 33R 1%; R_0603_1608Metric; MPN CRCW060333R0FKEA
R12005, R12006: 100000R 1%; R_0603_1608Metric; MPN CRCW0603100KFKEA

Connections:
LOGIC_GND: R12005.2, R12006.2
OPI_REARM_BOE: R12002.2
OPI_REARM_M: R12001.1, R12002.1, R12005.1
OPI_REARM_TX: R12001.2
WATCHDOG_TRIP_CLEAR: R12003.1, R12004.1, R12006.1
WD_REARM_M: R12003.2
WD_REARM_O: R12004.2

Notes on the sheet:
SAME 3.3V LOGIC DOMAIN / DELIBERATE REARM AND ACTIVE-HIGH CLEAR REQUEST OPI_REARM_M and WATCHDOG_TRIP_CLEAR default LOW. FPGA unconfigured GPIO must be high-impedance. Clear request drives U4018 inverter INPUTS WD_REARM_M/O. U4019 owns the active-low latch-clear OUTPUTS. Separate receiving nets and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
