DeadlySIn777/Controller/reports/root-verification-20260928/source/hardware/tx_bank/tx_bank.kicad_sch

## KiCad design reports/root-verification-20260928/source/hardware/tx_bank/tx_bank.kicad_sch (2026-10-18)

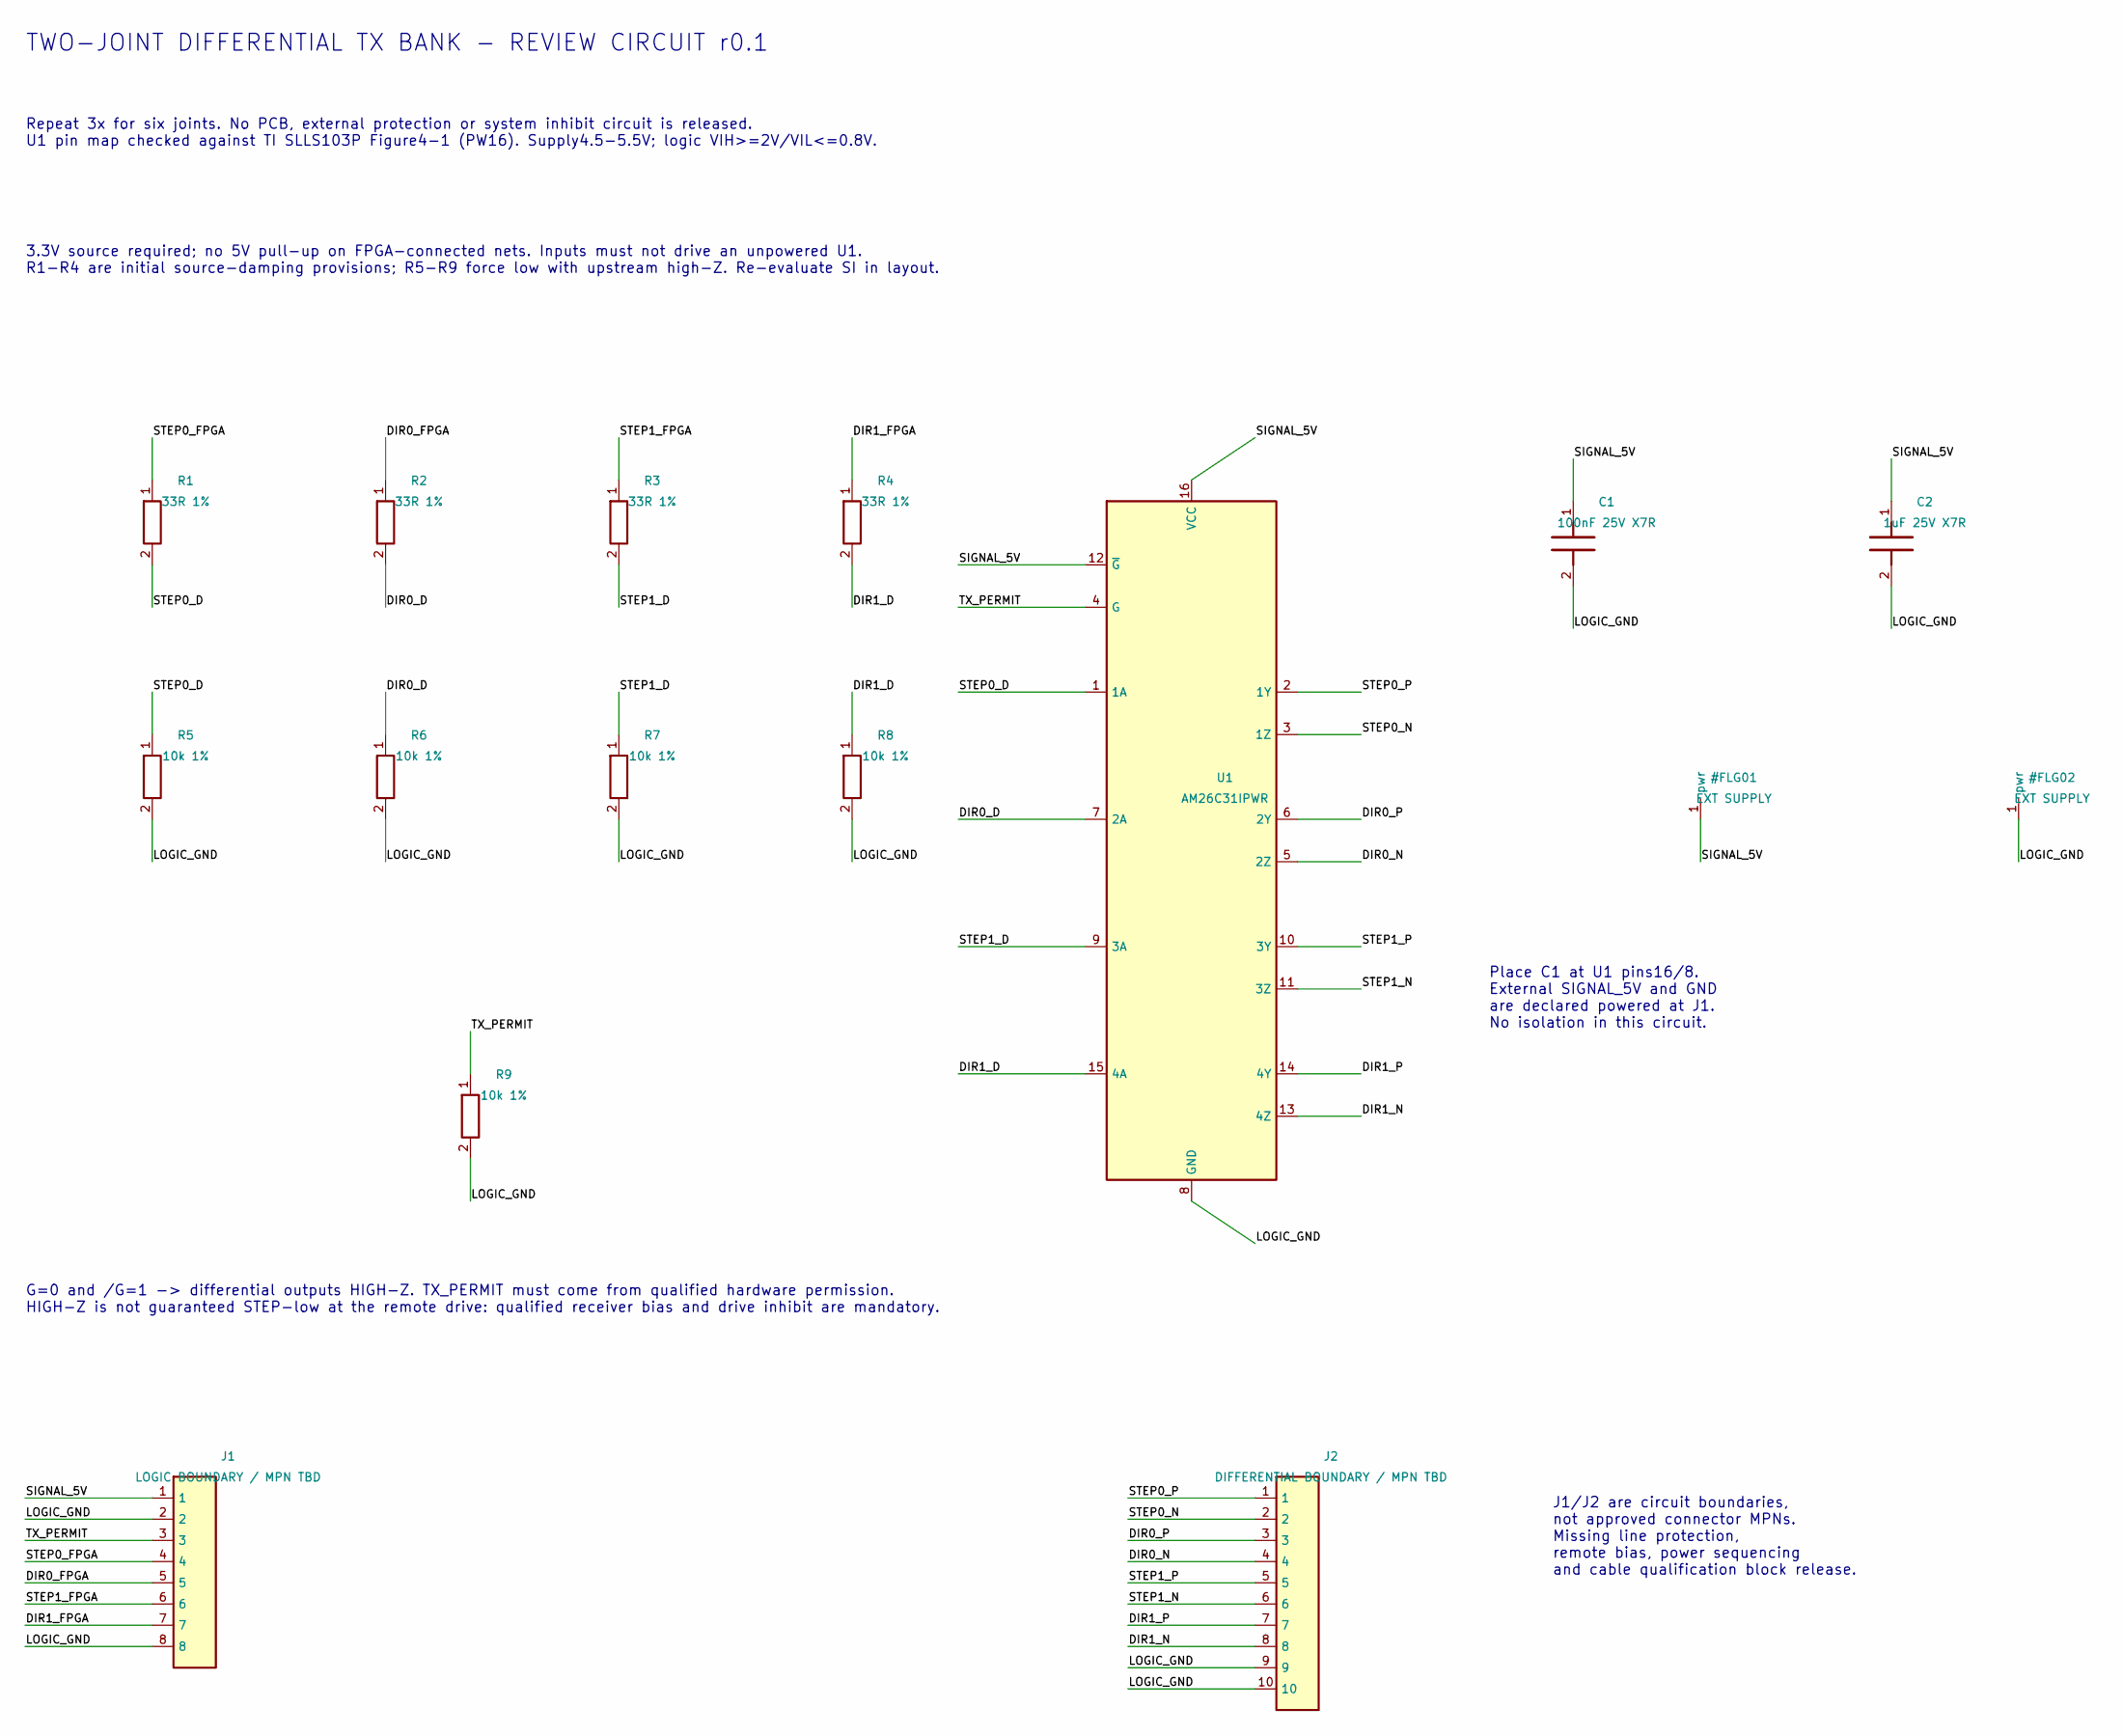
[picture p95: schematic tx_bank.kicad_sch]

Parts:
C1: 100nF 25V X7R; C_0603_1608Metric
C2: 1uF 25V X7R; C_0603_1608Metric
J1: LOGIC BOUNDARY / MPN TBD
J2: DIFFERENTIAL BOUNDARY / MPN TBD
R1, R2, R3, R4: 33R 1%; R_0603_1608Metric
R5, R6, R7, R8, R9: 10k 1%; R_0603_1608Metric
U1: AM26C31IPWR; TSSOP-16_4.4x5mm_P0.65mm; MPN AM26C31IPWR

Connections:
DIR0_D: R2.2, R6.1, U1.7 (2A)
DIR0_FPGA: J1.5, R2.1
DIR0_N: J2.4, U1.5 (2Z)
DIR0_P: J2.3, U1.6 (2Y)
DIR1_D: R4.2, R8.1, U1.15 (4A)
DIR1_FPGA: J1.7, R4.1
DIR1_N: J2.8, U1.13 (4Z)
DIR1_P: J2.7, U1.14 (4Y)
LOGIC_GND: C1.2, C2.2, J1.2, J1.8, J2.9, J2.10, R5.2, R6.2, R7.2, R8.2, R9.2, U1.8 (GND)
SIGNAL_5V: C1.1, C2.1, J1.1, U1.12 (~G), U1.16 (VCC)
STEP0_D: R1.2, R5.1, U1.1 (1A)
STEP0_FPGA: J1.4, R1.1
STEP0_N: J2.2, U1.3 (1Z)
STEP0_P: J2.1, U1.2 (1Y)
STEP1_D: R3.2, R7.1, U1.9 (3A)
STEP1_FPGA: J1.6, R3.1
STEP1_N: J2.6, U1.11 (3Z)
STEP1_P: J2.5, U1.10 (3Y)
TX_PERMIT: J1.3, R9.1, U1.4 (G)

Notes on the sheet:
TWO-JOINT DIFFERENTIAL TX BANK - REVIEW CIRCUIT r0.1
Repeat 3x for six joints. No PCB, external protection or system inhibit circuit is released. U1 pin map checked against TI SLLS103P Figure4-1 (PW16). Supply4.5-5.5V; logic VIH>=2V/VIL<=0.8V.
3.3V source required; no 5V pull-up on FPGA-connected nets. Inputs must not drive an unpowered U1. R1-R4 are initial source-damping provisions; R5-R9 force low with upstream high-Z. Re-evaluate SI in layout.
Place C1 at U1 pins16/8. External SIGNAL_5V and GND are declared powered at J1. No isolation in this circuit.
G=0 and /G=1 -> differential outputs HIGH-Z. TX_PERMIT must come from qualified hardware permission. HIGH-Z is not guaranteed STEP-low at the remote drive: qualified receiver bias and drive inhibit are mandatory.
J1/J2 are circuit boundaries, not approved connector MPNs. Missing line protection, remote bias, power sequencing and cable qualification block release.
