DeadlySIn777/Controller/reports/audit-2026-09-30/native-exports/workspace/hardware/digital_inputs/digital_inputs.kicad_sch

## KiCad design reports/audit-2026-09-30/native-exports/workspace/hardware/digital_inputs/digital_inputs.kicad_sch (2026-10-18)

Schematic: digital_inputs.kicad_sch

Parts:
C1, C2, C3, C4, C5, C6, C7, C8, C9, C10, C11, C12, C13, C14, C15, C16, C17, C18, C19, C20, C21, C22: 10nF 100V C0G; C_0805_2012Metric; MPN C2012C0G2A103J125AA
C101, C102, C103, C104, C105, C106, C107, C108, C109, C110, C111: 100nF 25V X7R; C_0603_1608Metric; MPN 06033C104JAT2A
JDI0: JDI0 / LEDGER
JDI1: JDI1 / LEDGER
JDI2: JDI2 / LEDGER
JLOG1, JLOG2: INTERNAL LOGIC BOUNDARY
R1, R2, R3, R4, R5, R6, R7, R8, R9, R10, R11, R12, R13, R14, R15, R16, R17, R18, R19, R20, R21, R22: 1k MELF 1%; R_MiniMELF_MMA-0204; MPN SMM02040C1001FB300
R101, R102, R103, R104, R105, R106, R107, R108, R109, R110, R111, R112, R113, R114, R115, R116, R117, R118, R119, R120, R121, R122: 562R 1%; R_0603_1608Metric; MPN CRCW0603562RFKEA
R201, R202, R203, R204, R205, R206, R207, R208, R209, R210, R211, R212, R213, R214, R215, R216, R217, R218, R219, R220, R221, R222: 100k 1%; R_0603_1608Metric; MPN CRCW0603100KFKEA
U1, U2, U3, U4, U5, U6, U7, U8, U9, U10, U11: ISO1212DBQR; SSOP-16_3.9x4.9mm_P0.635mm; MPN ISO1212DBQR

Connections:
ALM0_FPGA: JLOG2.7, R217.1, U9.4 (OUT1)
ALM1_FPGA: JLOG2.8, R218.1, U9.5 (OUT2)
ALM2_FPGA: JLOG2.9, R219.1, U10.4 (OUT1)
ALM3_FPGA: JLOG2.10, R220.1, U10.5 (OUT2)
ALM4_FPGA: JLOG2.11, R221.1, U11.4 (OUT1)
ALM5_FPGA: JLOG2.12, R222.1, U11.5 (OUT2)
CYCLE_START_FPGA: JLOG2.4, R214.1, U7.5 (OUT2)
DI00_FIELD: JDI0.1, R1.1
DI00_IN: R101.2, U1.15 (IN1)
DI00_SENSE: C1.1, R1.2, R101.1, U1.16 (SENSE1)
DI00_SUB_ISLAND: U1.13 (SUB1)
DI01_FIELD: JDI0.2, R2.1
DI01_IN: R102.2, U1.10 (IN2)
DI01_SENSE: C2.1, R2.2, R102.1, U1.11 (SENSE2)
DI01_SUB_ISLAND: U1.12 (SUB2)
DI02_FIELD: JDI0.3, R3.1
DI02_IN: R103.2, U2.15 (IN1)
DI02_SENSE: C3.1, R3.2, R103.1, U2.16 (SENSE1)
DI02_SUB_ISLAND: U2.13 (SUB1)
DI03_FIELD: JDI0.4, R4.1
DI03_IN: R104.2, U2.10 (IN2)
DI03_SENSE: C4.1, R4.2, R104.1, U2.11 (SENSE2)
DI03_SUB_ISLAND: U2.12 (SUB2)
DI04_FIELD: JDI0.5, R5.1
DI04_IN: R105.2, U3.15 (IN1)
DI04_SENSE: C5.1, R5.2, R105.1, U3.16 (SENSE1)
DI04_SUB_ISLAND: U3.13 (SUB1)
DI05_FIELD: JDI0.6, R6.1
DI05_IN: R106.2, U3.10 (IN2)
DI05_SENSE: C6.1, R6.2, R106.1, U3.11 (SENSE2)
DI05_SUB_ISLAND: U3.12 (SUB2)
DI06_FIELD: JDI0.7, R7.1
DI06_IN: R107.2, U4.15 (IN1)
DI06_SENSE: C7.1, R7.2, R107.1, U4.16 (SENSE1)
DI06_SUB_ISLAND: U4.13 (SUB1)
DI07_FIELD: JDI0.8, R8.1
DI07_IN: R108.2, U4.10 (IN2)
DI07_SENSE: C8.1, R8.2, R108.1, U4.11 (SENSE2)
DI07_SUB_ISLAND: U4.12 (SUB2)
DI08_FIELD: JDI1.1, R9.1
DI08_IN: R109.2, U5.15 (IN1)
DI08_SENSE: C9.1, R9.2, R109.1, U5.16 (SENSE1)
DI08_SUB_ISLAND: U5.13 (SUB1)
DI09_FIELD: JDI1.2, R10.1
DI09_IN: R110.2, U5.10 (IN2)
DI09_SENSE: C10.1, R10.2, R110.1, U5.11 (SENSE2)
DI09_SUB_ISLAND: U5.12 (SUB2)
DI10_FIELD: JDI1.3, R11.1
DI10_IN: R111.2, U6.15 (IN1)
DI10_SENSE: C11.1, R11.2, R111.1, U6.16 (SENSE1)
DI10_SUB_ISLAND: U6.13 (SUB1)
DI11_FIELD: JDI1.4, R12.1
DI11_IN: R112.2, U6.10 (IN2)
DI11_SENSE: C12.1, R12.2, R112.1, U6.11 (SENSE2)
DI11_SUB_ISLAND: U6.12 (SUB2)
DI12_FIELD: JDI1.5, R13.1
DI12_IN: R113.2, U7.15 (IN1)
DI12_SENSE: C13.1, R13.2, R113.1, U7.16 (SENSE1)
DI12_SUB_ISLAND: U7.13 (SUB1)
DI13_FIELD: JDI1.6, R14.1
DI13_IN: R114.2, U7.10 (IN2)
DI13_SENSE: C14.1, R14.2, R114.1, U7.11 (SENSE2)
DI13_SUB_ISLAND: U7.12 (SUB2)
DI14_FIELD: JDI1.7, R15.1
DI14_IN: R115.2, U8.15 (IN1)
DI14_SENSE: C15.1, R15.2, R115.1, U8.16 (SENSE1)
DI14_SUB_ISLAND: U8.13 (SUB1)
DI15_FIELD: JDI1.8, R16.1
DI15_IN: R116.2, U8.10 (IN2)
DI15_SENSE: C16.1, R16.2, R116.1, U8.11 (SENSE2)
DI15_SUB_ISLAND: U8.12 (SUB2)
DI16_FIELD: JDI2.1, R17.1
DI16_IN: R117.2, U9.15 (IN1)
DI16_SENSE: C17.1, R17.2, R117.1, U9.16 (SENSE1)
DI16_SUB_ISLAND: U9.13 (SUB1)
DI17_FIELD: JDI2.2, R18.1
DI17_IN: R118.2, U9.10 (IN2)
DI17_SENSE: C18.1, R18.2, R118.1, U9.11 (SENSE2)
DI17_SUB_ISLAND: U9.12 (SUB2)
DI18_FIELD: JDI2.3, R19.1
DI18_IN: R119.2, U10.15 (IN1)
DI18_SENSE: C19.1, R19.2, R119.1, U10.16 (SENSE1)
DI18_SUB_ISLAND: U10.13 (SUB1)
DI19_FIELD: JDI2.4, R20.1
DI19_IN: R120.2, U10.10 (IN2)
DI19_SENSE: C20.1, R20.2, R120.1, U10.11 (SENSE2)
DI19_SUB_ISLAND: U10.12 (SUB2)
DI20_FIELD: JDI2.5, R21.1
DI20_IN: R121.2, U11.15 (IN1)
DI20_SENSE: C21.1, R21.2, R121.1, U11.16 (SENSE1)
DI20_SUB_ISLAND: U11.13 (SUB1)
DI21_FIELD: JDI2.6, R22.1
DI21_IN: R122.2, U11.10 (IN2)
DI21_SENSE: C22.1, R22.2, R122.1, U11.11 (SENSE2)
DI21_SUB_ISLAND: U11.12 (SUB2)
DOOR_STATUS_FPGA: JLOG1.11, R209.1, U5.4 (OUT1)
FEED_HOLD_FPGA: JLOG2.3, R213.1, U7.4 (OUT1)
FIELD_GND: C1.2, C2.2, C3.2, C4.2, C5.2, C6.2, C7.2, C8.2, C9.2, C10.2, C11.2, C12.2, C13.2, C14.2, C15.2, C16.2, C17.2, C18.2, C19.2, C20.2, C21.2, C22.2, JDI2.7, JDI2.8, U1.9 (FGND2), U1.14 (FGND1), U2.9 (FGND2), U2.14 (FGND1), U3.9 (FGND2), U3.14 (FGND1), U4.9 (FGND2), U4.14 (FGND1), U5.9 (FGND2), U5.14 (FGND1), U6.9 (FGND2), U6.14 (FGND1), U7.9 (FGND2), U7.14 (FGND1), U8.9 (FGND2), U8.14 (FGND1), U9.9 (FGND2), U9.14 (FGND1), U10.9 (FGND2), U10.14 (FGND1), U11.9 (FGND2), U11.14 (FGND1)
HOME0_FPGA: JLOG1.3, R201.1, U1.4 (OUT1)
HOME1_FPGA: JLOG1.4, R202.1, U1.5 (OUT2)
HOME2_FPGA: JLOG1.5, R203.1, U2.4 (OUT1)
HOME3_FPGA: JLOG1.6, R204.1, U2.5 (OUT2)
HOME4_FPGA: JLOG1.7, R205.1, U3.4 (OUT1)
HOME5_FPGA: JLOG1.8, R206.1, U3.5 (OUT2)
IO_3V3: C101.1, C102.1, C103.1, C104.1, C105.1, C106.1, C107.1, C108.1, C109.1, C110.1, C111.1, JLOG1.1, JLOG2.1, U1.2 (VCC1), U1.3 (EN), U2.2 (VCC1), U2.3 (EN), U3.2 (VCC1), U3.3 (EN), U4.2 (VCC1), U4.3 (EN), U5.2 (VCC1), U5.3 (EN), U6.2 (VCC1), U6.3 (EN), U7.2 (VCC1), U7.3 (EN), U8.2 (VCC1), U8.3 (EN), U9.2 (VCC1), U9.3 (EN), U10.2 (VCC1), U10.3 (EN), U11.2 (VCC1), U11.3 (EN)
LOGIC_GND: C101.2, C102.2, C103.2, C104.2, C105.2, C106.2, C107.2, C108.2, C109.2, C110.2, C111.2, JLOG1.2, JLOG2.2, R201.2, R202.2, R203.2, R204.2, R205.2, R206.2, R207.2, R208.2, R209.2, R210.2, R211.2, R212.2, R213.2, R214.2, R215.2, R216.2, R217.2, R218.2, R219.2, R220.2, R221.2, R222.2, U1.1 (GND1), U1.8 (GND1), U2.1 (GND1), U2.8 (GND1), U3.1 (GND1), U3.8 (GND1), U4.1 (GND1), U4.8 (GND1), U5.1 (GND1), U5.8 (GND1), U6.1 (GND1), U6.8 (GND1), U7.1 (GND1), U7.8 (GND1), U8.1 (GND1), U8.8 (GND1), U9.1 (GND1), U9.8 (GND1), U10.1 (GND1), U10.8 (GND1), U11.1 (GND1), U11.8 (GND1)
LUBE_STATUS_FPGA: JLOG2.5, R215.1, U8.4 (OUT1)
PROBE_FPGA: JLOG1.9, R207.1, U4.4 (OUT1)
PROTECTIVE_STATUS_FPGA: JLOG1.12, R210.1, U5.5 (OUT2)
SPARE_FPGA: JLOG2.6, R216.1, U8.5 (OUT2)
SPINDLE_FAULT_FPGA: JLOG1.13, R211.1, U6.4 (OUT1)
SPINDLE_READY_FPGA: JLOG1.14, R212.1, U6.5 (OUT2)
TOOLSETTER_FPGA: JLOG1.10, R208.1, U4.5 (OUT2)

Notes on the sheet:
DI0: DI00 / DI01 - FIELD inputs -> LOGIC
DI1: DI02 / DI03 - FIELD inputs -> LOGIC
DI2: DI04 / DI05 - FIELD inputs -> LOGIC
DI3: DI06 / DI07 - FIELD inputs -> LOGIC
DI4: DI08 / DI09 - FIELD inputs -> LOGIC
DI5: DI10 / DI11 - FIELD inputs -> LOGIC
DI6: DI12 / DI13 - FIELD inputs -> LOGIC
DI7: DI14 / DI15 - FIELD inputs -> LOGIC
DI8: DI16 / DI17 - FIELD inputs -> LOGIC
DI9: DI18 / DI19 - FIELD inputs -> LOGIC
DI10: DI20 / DI21 - FIELD inputs -> LOGIC
BASELINE 22 ISOLATED SINKING DIGITAL INPUTS - 6 HOME + 16 AUXILIARY - REVIEW r0.1
0-30V input study; low<=5V / high>=15V targets. PNP source or dry contact to field positive. Common FIELD_GND; no per-channel isolation. 11 ISO1212 devices require IO_3V3 only. Do not join FIELD_GND to LOGIC_GND. SUB pins get separate floating copper islands; never ground or join them.
All JDI names/positions match frozen ledger. JDI0/1 have no local common terminal: use JDI2.7/.8. No sensor positive supply is provided by this sheet. Boundary symbols are not approved connector MPNs. No PE capacitor fitted: whole-system coupling/EMC is open.
EN is tied to IO_3V3. Powered open input reads LOW. Unpowered/brownout output is UNDETERMINED; pull-down is bias, not a fail-safe guarantee. Mask all inputs until qualified rail/FPGA readiness. PROBE/TOOLSETTER filters need latency qualification. No safety input certification, physical EMC result o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
