DeadlySIn777/Controller/reports/board-completion-20260930/mc-permission-r01-before-trip-fix/source/hardware/mc_permission/mc_permission.kicad_sch

## KiCad design reports/board-completion-20260930/mc-permission-r01-before-trip-fix/source/hardware/mc_permission/mc_permission.kicad_sch (2026-10-18)

Schematic: mc_permission.kicad_sch

Parts:
B1, B2: INTERNAL REVIEW BOUNDARY
C1, C2, C3, C4, C5, C6, C7, C8, C9, C10, C11, C12, C13, C14, C15: 100nF X7R 25V 10%; C_0603_1608Metric; MPN GRM188R71E104KA01D
R1, R2, R3, R4, R5, R6, R7: 4700R 1%; R_0603_1608Metric; MPN CRCW06034K70FKEA
R8, R9, R10, R11, R12, R13, R14, R15, R16, R17, R18: 10000R 1%; R_0603_1608Metric; MPN CRCW060310K0FKEA
U1, U2, U4, U7, U8, U10: SN74LVC1G11DBVR; SOT-23-6; MPN SN74LVC1G11DBVR
U3, U9: SN74LVC2G08DCUR; VSSOP-8_2.3x2mm_P0.5mm; MPN SN74LVC2G08DCUR
U5, U6, U11, U12, U13, U14, U15: SN74LVC2G74DCUR; VSSOP-8_2.3x2mm_P0.5mm; MPN SN74LVC2G74DCUR

Connections:
ARM_M_Q: U5.5 (Q), U7.1 (A)
ARM_O_Q: U6.5 (Q), U8.1 (A)
BANK_B_BUFFER_ENABLE_QUALIFIED: B1.15, R14.1, U13.6 (CLR_N)
BASE_FIRST: U1.4 (Y), U2.1 (A)
BASE_OK: U2.4 (Y), U3.1 (1A), U4.1 (A), U9.1 (1A)
CDONE_QUALIFIED: B1.4, R9.1, U1.3 (B)
DIC_OK_QUALIFIED: B1.5, R10.1, U1.6 (C)
EXT_PERMIT_3V3: B1.6, R11.1, U2.3 (B)
FPGA_ENDPOINT_READY: B1.10, R1.1, U3.6 (2B), U4.6 (C)
FPGA_MOTION_REQUEST: B1.11, U5.1 (CLK), U7.3 (B)
FPGA_OUTPUT_REQUEST: B1.12, U6.1 (CLK), U8.3 (B)
IO_3V3: B1.1, C1.1, C2.1, C3.1, C4.1, C5.1, C6.1, C7.1, C8.1, C9.1, C10.1, C11.1, C12.1, C13.1, C14.1, C15.1, U1.5 (VCC), U2.5 (VCC), U3.8 (VCC), U4.5 (VCC), U5.2 (D), U5.7 (PRE_N), U5.8 (VCC), U6.2 (D), U6.7 (PRE_N), U6.8 (VCC), U7.5 (VCC), U8.5 (VCC), U9.8 (VCC), U10.5 (VCC), U11.2 (D), U11.7 (PRE_N), U11.8 (VCC), U12.2 (D), U12.7 (PRE_N), U12.8 (VCC), U13.2 (D), U13.7 (PRE_N), U13.8 (VCC), U14.2 (D), U14.7 (PRE_N), U14.8 (VCC), U15.2 (D), U15.7 (PRE_N), U15.8 (VCC)
LATCH_CLEAR_M_N: U3.3 (2Y), U5.6 (CLR_N)
LATCH_CLEAR_O_N: U4.4 (Y), U6.6 (CLR_N)
LOGIC_GND: B1.2, C1.2, C2.2, C3.2, C4.2, C5.2, C6.2, C7.2, C8.2, C9.2, C10.2, C11.2, C12.2, C13.2, C14.2, C15.2, R1.2, R2.2, R3.2, R4.2, R5.2, R6.2, R7.2, R8.2, R9.2, R10.2, R11.2, R12.2, R13.2, R14.2, R15.2, R16.2, R17.2, R18.2, U1.2 (GND), U2.2 (GND), U3.4 (GND), U4.2 (GND), U5.4 (GND), U6.4 (GND), U7.2 (GND), U8.2 (GND), U9.4 (GND), U10.2 (GND), U11.4 (GND), U12.4 (GND), U13.4 (GND), U14.4 (GND), U15.4 (GND)
MC_RAILS_OK: B1.3, R8.1, U1.1 (A)
OPI_OK_BOE: B2.8, U13.5 (Q)
OPI_OK_OUT: B2.7, U12.5 (Q)
OPI_OK_TX: B2.6, U11.5 (Q)
OPI_REARM_BOE: B1.18, R4.1, U13.1 (CLK)
OPI_REARM_OUT: B1.17, R3.1, U12.1 (CLK)
OPI_REARM_TX: B1.16, R2.1, U11.1 (CLK)
OUTPUT_RAW_OK: U8.6 (C), U9.7 (1Y)
OUT_PERMIT: B2.3, R16.1, U8.4 (Y), U10.3 (B), U12.6 (CLR_N)
PERMIT_OUT_DRIVE: B2.5, R18.1, U9.3 (2Y)
PERMIT_OUT_REQ: B1.14, R7.1, U9.6 (2B)
PROCESS_PERMIT_EXT_3V3: B1.13, R13.1, U10.6 (C)
PROC_PERMIT: B2.4, R17.1, U10.4 (Y)
RAW_INHIBIT_N: B2.1, U3.5 (2A), U3.7 (1Y), U7.6 (C)
TAMPER_CLEAR_N: B1.7, R12.1, U2.6 (C)
TX_PERMIT: B2.2, R15.1, U7.4 (Y), U9.5 (2A), U10.1 (A), U11.6 (CLR_N)
WD_M_OK: B1.8, U3.2 (1B), U14.6 (CLR_N)
WD_M_TRIP_N: B2.9, U14.5 (Q)
WD_O_OK: B1.9, U4.3 (B), U9.2 (1B), U15.6 (CLR_N)
WD_O_TRIP_N: B2.10, U15.5 (Q)
WD_REARM_M: B1.19, R5.1, U14.1 (CLK)
WD_REARM_O: B1.20, R6.1, U15.1 (CLK)

Notes on the sheet:
MC PERMISSION / STICKY INTERRUPTION CORE - UPSTREAM QUALIFICATION AND FIELD DRIVERS REMAIN SEPARATE
No manufacture/physical timing claim. IS-1 equations; 4.7k GPIO startup pulls are a proposed IS-2 conditioning change. Trip/OPI outputs are active-low healthy-state latches; high requires deliberate compatible rearm strobes. B1/B2 are logical boundaries, not physical connectors. Qualified terms mus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
