DeadlySIn777/Controller/reports/connected-hardware-20260928/native-exports/workspace/hardware/controller_assembly/power_sequence.kicad_sch

## KiCad design reports/connected-hardware-20260928/native-exports/workspace/hardware/controller_assembly/power_sequence.kicad_sch (2026-10-18)

Schematic: power_sequence.kicad_sch

Parts:
C9001, C9002, C9003, C9004, C9005, C9006: 100nF 25V X7R 20%; C_0603_1608Metric
JCTRL9001: INTEGRATION BOUNDARY
JRAIL9001: INTEGRATION BOUNDARY
R9001: 87.9k 0.01% 5ppm; R_0603_1608Metric; MPN PLT0603Z8792LST1
R9007, R9015, R9047, R9055, R9067, R9075: 10k 0.01% 5ppm; R_0603_1608Metric; MPN PLT0603Z1002LST1
R9009: 92.1k 0.01% 5ppm; R_0603_1608Metric; MPN PLT0603Z9212LST1
R9021: 1.10k 0.01% 5ppm; R_0603_1608Metric; MPN PLT0603Z1101LST1
R9022: 255 0.01% 5ppm; R_0603_1608Metric; MPN PLT0603Z2550LST1
R9027, R9035: 1k 0.01% 5ppm; R_0603_1608Metric; MPN PLT0603Z1001LST1
R9029: 1.15k 0.01% 5ppm; R_0603_1608Metric; MPN PLT0603Z1151LST1
R9030: 294 0.01% 5ppm; R_0603_1608Metric; MPN PLT0603Z2940LST1
R9031: 1 1% 100ppm; R_0603_1608Metric; MPN CRCW06031R00FKEA
R9041, R9061: 54.5k 0.01% 5ppm; R_0603_1608Metric; MPN PLT0603Z5452LST1
R9049, R9069: 57.5k 0.01% 5ppm; R_0603_1608Metric; MPN PLT0603Z5752LST1
R9101, R9102, R9104: 3.3k 1%; R_0603_1608Metric; MPN CRCW06033K30FKEA
R9103, R9105, R9107: 10k 1%; R_0603_1608Metric; MPN CRCW060310K0FKEA
R9106: 6.8k 1%; R_0603_1608Metric; MPN CRCW06036K80FKEA
R9108, R9111, R9113: 47k 1%; R_0603_1608Metric; MPN CRCW060347K0FKEA
R9109, R9112: 470k 1%; R_0603_1608Metric; MPN CRCW0603470KFKEA
R9110: 4.7k 1%; R_0603_1608Metric; MPN CRCW06034K70FKEA
U9001, U9002, U9003, U9004: LTC2962HUD#TRPBF; LTC2962_UD16; MPN LTC2962HUD#TRPBF
U9005, U9006: SN74LVC1G17DBVR; SOT-23-5; MPN SN74LVC1G17DBVR

Connections:
CORE_1V2: JRAIL9001.2, R9021.1, R9029.1
CORE_1V2_EN: JCTRL9001.1, R9102.2, R9103.1
CORE_1V2_OV_SENSE: R9031.2, R9035.1, U9002.15 (V2)
CORE_1V2_UV_SENSE: R9022.2, R9027.1, U9002.16 (V1)
CORE_5V: C9001.1, C9002.1, C9003.1, C9004.1, JRAIL9001.1, R9001.1, R9009.1, R9101.1, R9106.1, R9108.1, R9111.1, U9001.1 (RDIS), U9001.2 (MR), U9001.4 (VCC), U9001.10 (RT), U9001.13 (V4), U9001.14 (V3), U9002.1 (RDIS), U9002.4 (VCC), U9002.10 (RT), U9002.13 (V4), U9002.14 (V3), U9003.1 (RDIS), U9003.4 (VCC), U9003.10 (RT), U9003.13 (V4), U9003.14 (V3), U9004.1 (RDIS), U9004.4 (VCC), U9004.10 (RT), U9004.13 (V4), U9004.14 (V3)
CORE_5V_OV_SENSE: R9009.2, R9015.1, U9001.15 (V2)
CORE_5V_UV_SENSE: R9001.2, R9007.1, U9001.16 (V1)
ESP_3V3: C9006.1, JRAIL9001.4, R9061.1, R9069.1, U9006.5 (VCC)
ESP_3V3_EN: JCTRL9001.3, R9104.2, R9105.1
ESP_3V3_OV_SENSE: R9069.2, R9075.1, U9004.15 (V2)
ESP_3V3_UV_SENSE: R9061.2, R9067.1, U9004.16 (V1)
ESP_CHIP_PU: JCTRL9001.5, R9113.1, U9006.4 (Y)
FPGA_CRESET_N: JCTRL9001.4, R9110.1, U9005.4 (Y)
IO_3V3: C9005.1, JRAIL9001.3, R9041.1, R9049.1, U9005.5 (VCC)
IO_3V3_EN: JCTRL9001.2, R9106.2, R9107.1, U9002.12 (RST), U9003.2 (MR)
IO_3V3_OV_SENSE: R9049.2, R9055.1, U9003.15 (V2)
IO_3V3_UV_SENSE: R9041.2, R9047.1, U9003.16 (V1)
LOGIC_GND: C9001.2, C9002.2, C9003.2, C9004.2, C9005.2, C9006.2, JCTRL9001.7, JRAIL9001.5, R9007.2, R9015.2, R9027.2, R9035.2, R9047.2, R9055.2, R9067.2, R9075.2, R9103.2, R9105.2, R9107.2, R9109.2, R9110.2, R9112.2, R9113.2, U9001.3 (DVCC), U9001.7 (PG2), U9001.11 (GND), U9001.17 (EP), U9002.3 (DVCC), U9002.7 (PG2), U9002.11 (GND), U9002.17 (EP), U9003.3 (DVCC), U9003.7 (PG2), U9003.11 (GND), U9003.17 (EP), U9004.3 (DVCC), U9004.7 (PG2), U9004.11 (GND), U9004.17 (EP), U9005.3 (GND), U9006.3 (GND)
SEQ_5V_OK: JCTRL9001.6, R9101.2, R9102.1, R9104.1, U9001.12 (RST), U9002.2 (MR), U9004.2 (MR)
SEQ_ESP_RESET_GOOD: R9111.2, R9112.1, U9004.12 (RST), U9006.2 (A)
SEQ_FPGA_RESET_GOOD: R9108.2, R9109.1, U9003.12 (RST), U9005.2 (A)
SEQ_OV2_1: R9029.2, R9030.1
SEQ_OV2_2: R9030.2, R9031.1
SEQ_REF1: U9001.5 (REF), U9001.6 (PG1), U9001.8 (PG3), U9001.9 (PG4)
SEQ_REF2: U9002.5 (REF), U9002.6 (PG1), U9002.8 (PG3), U9002.9 (PG4)
SEQ_REF3: U9003.5 (REF), U9003.6 (PG1), U9003.8 (PG3), U9003.9 (PG4)
SEQ_REF4: U9004.5 (REF), U9004.6 (PG1), U9004.8 (PG3), U9004.9 (PG4)
SEQ_UV2_1: R9021.2, R9022.1

Notes on the sheet:
1. CORE_5V window / autonomous release
PG1=REF: UV; PG2=GND: OV. Unused V3/V4=VCC, PG3/4=REF. RT=VCC: 160-240ms release. RDIS=VCC: margin override disabled.
2. CORE_1V2 window / autonomous release
3. IO_3V3 window / autonomous release
4. ESP_3V3 window / autonomous release
AUTONOMOUS POWER WINDOW / RESET CANDIDATE - NOT MACHINE PERMISSION
CORE5 -> core + ESP enables; valid core -> IO enable. IO qualifier -> FPGA reset. ESP qualifier -> ESP reset only: ESP fault does not reset FPGA through this circuit. Every EN also has the existing regulator10k pulldown. No active-high external driver allowed. 5V/internal pullups never directly dri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
Core threshold static margins are sub-mV at some corners. Aging, stress, ripple and transient response remain release blockers. Comparator40us maximum applies only at10% overdrive. No guaranteed brownout slew, powered-off regulator discharge, shutdown order or restart latch. FPGA package/PLL filter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
