DeadlySIn777/Controller/reports/connected-hardware-20260928/native-exports/workspace/hardware/power_entry/power_entry.kicad_sch

## KiCad design reports/connected-hardware-20260928/native-exports/workspace/hardware/power_entry/power_entry.kicad_sch (2026-10-18)

Schematic: power_entry.kicad_sch

Parts:
C1, C5: 2.2uF 100V X7R / CANDIDATE; C_1210_3225Metric
C2, C6: 100nF 5% C0G / dVdT; C_1206_3216Metric
C3, C4, C7, C8: 1uF 100V X7R; C_1206_3216Metric
D1, D3: SMCJ30CA / CANDIDATE; D_SMC; MPN SMCJ30CA
D2, D4: OUTPUT CLAMP / MPN TBD
F1, F2: DC FUSE / RATING TBD
JIN1, JIN2: DC INPUT BOUNDARY
JOUT1, JOUT2: TO CONVERTER / LOADS
JRESET1, JRESET2: DRY CONTACT: SHUTDOWN/CLEAR
JSTAT1, JSTAT2: LOCAL STATUS + EN CONTROL
Q1, Q3: CSD19537Q3; VSON-8_3.3x3.3mm_P0.65mm_NexFET; MPN CSD19537Q3
Q2, Q4: BSS138P,215; SOT-23; MPN BSS138P,215
R1, R21: 887k 0.1%; R_0603_1608Metric
R2, R22: 29.4k 0.1%; R_0603_1608Metric
R3, R23: 34.0k 0.1%; R_0603_1608Metric
R4: 7.50k 0.1%; R_0603_1608Metric
R5, R25: 140k 0.1%; R_0603_1608Metric
R6, R7, R26, R27: 10.0k 0.1%; R_0603_1608Metric
R8, R28: 10k 1%; R_0603_1608Metric
R24: 3.65k 0.1%; R_0603_1608Metric
U1, U2: TPS26630RGER; Texas_RGE0024H_VQFN-24-1EP_4x4mm_P0.5mm_EP2.7x2.7mm; MPN TPS26630RGER

Connections:
CORE_24V_PROTECTED: C4.1, D2.1 (K), JOUT1.1, R5.1, U1.17 (OUT), U1.18 (OUT)
C_BG: Q1.4 (G), Q2.3 (D), U1.3 (B_GATE)
C_DRV: Q2.1 (G), U1.4 (DRV)
C_DVDT: C2.1, U1.9 (dVdT)
C_FAULT_N: JSTAT1.4, R8.2, U1.14 (~FLT)
C_ILIM: R4.1, U1.10 (ILIM)
C_IMON: JSTAT1.5, R7.1, U1.13 (IMON)
C_IN: C3.1, Q1.5 (D5-8/land), U1.1 (IN), U1.2 (IN)
C_INPUT: F1.1, JIN1.1
C_OV: R2.2, R3.1, U1.7 (OVP)
C_PGOOD: JSTAT1.3, U1.16 (PGOOD)
C_PGTH: R5.2, R6.1, U1.15 (PGTH)
C_RAW: C1.1, D1.1, F1.2, Q1.1 (S1), Q1.2 (S2), Q1.3 (S3), Q2.2 (S), R1.1, U1.5 (IN_SYS)
C_SHDN: JRESET1.1, U1.12 (SHDN)
C_UV: R1.2, R2.1, U1.6 (UVLO)
FIELD_5V: JSTAT2.1, R28.1
FIELD_24V_PROTECTED: C8.1, D4.1 (K), JOUT2.1, R25.1, U2.17 (OUT), U2.18 (OUT)
FIELD_GND: C5.2, C6.2, C7.2, C8.2, D3.2, D4.2 (A), JIN2.2, JOUT2.2, JRESET2.2, JSTAT2.2, R23.2, R24.2, R26.2, R27.2, U2.8 (GND), U2.25 (EP_GND)
F_BG: Q3.4 (G), Q4.3 (D), U2.3 (B_GATE)
F_DRV: Q4.1 (G), U2.4 (DRV)
F_DVDT: C6.1, U2.9 (dVdT)
F_FAULT_N: JSTAT2.4, R28.2, U2.14 (~FLT)
F_ILIM: R24.1, U2.10 (ILIM)
F_IMON: JSTAT2.5, R27.1, U2.13 (IMON)
F_IN: C7.1, Q3.5 (D5-8/land), U2.1 (IN), U2.2 (IN)
F_INPUT: F2.1, JIN2.1
F_OV: R22.2, R23.1, U2.7 (OVP)
F_PGOOD: JSTAT2.3, U2.16 (PGOOD)
F_PGTH: R25.2, R26.1, U2.15 (PGTH)
F_RAW: C5.1, D3.1, F2.2, Q3.1 (S1), Q3.2 (S2), Q3.3 (S3), Q4.2 (S), R21.1, U2.5 (IN_SYS)
F_SHDN: JRESET2.1, U2.12 (SHDN)
F_UV: R21.2, R22.1, U2.6 (UVLO)
IO_3V3: JSTAT1.1, R8.1
LOGIC_GND: C1.2, C2.2, C3.2, C4.2, D1.2, D2.2 (A), JIN1.2, JOUT1.2, JRESET1.2, JSTAT1.2, R3.2, R4.2, R6.2, R7.2, U1.8 (GND), U1.25 (EP_GND)

Notes on the sheet:
CORE / LOGIC DOMAIN
Draft19-30V entry; normal load 1.81A; input path target>=3A. Display/AI/motor power excluded. Fuse and wiring selection remains open.
Q1 source faces input; Q2 source also references RAW, not GND. MODE intentionally open: overcurrent latch-off. Voltage faults can recover. SHDN floats high internally; dry contact low shuts down/resets the latch. Power restoration is NOT machine rearm. Permission circuit is separate.
PGOOD pullup removed. C/F_PGOOD connects to the downstream buck EN divider from protected input. Do not connect directly to host GPIO.
Fault pullups only use downstream diagnostic supply; PGOOD uses converter EN bias. Effective RAW bypass >=1uF; IN/OUT >=0.1uF. Candidate MPN/bias curves unresolved. Total downstream capacitance <=1000uF; field loads require independent inhibit. TVS/clamp/fuse/thermal qualification open. Power flags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
FIELD DOMAIN - KEEP ISOLATED
Draft19-30V entry; normal load 4.36A; input path target>=6A. Display/AI/motor power excluded. Fuse and wiring selection remains open.
DUAL DC POWER ENTRY - PARTIAL ENGINEERING CIRCUIT r0.2
TPS26630 + reverse-blocking FETs; separate LOGIC/FIELD grounds. No PCB or manufacturing release. Exact ratings require the companion review.
