DeadlySIn777/Controller/reports/connected-hardware-20260928/native-exports/workspace/hardware/rx_abz/rx_abz.kicad_sch

## KiCad design reports/connected-hardware-20260928/native-exports/workspace/hardware/rx_abz/rx_abz.kicad_sch (2026-10-18)

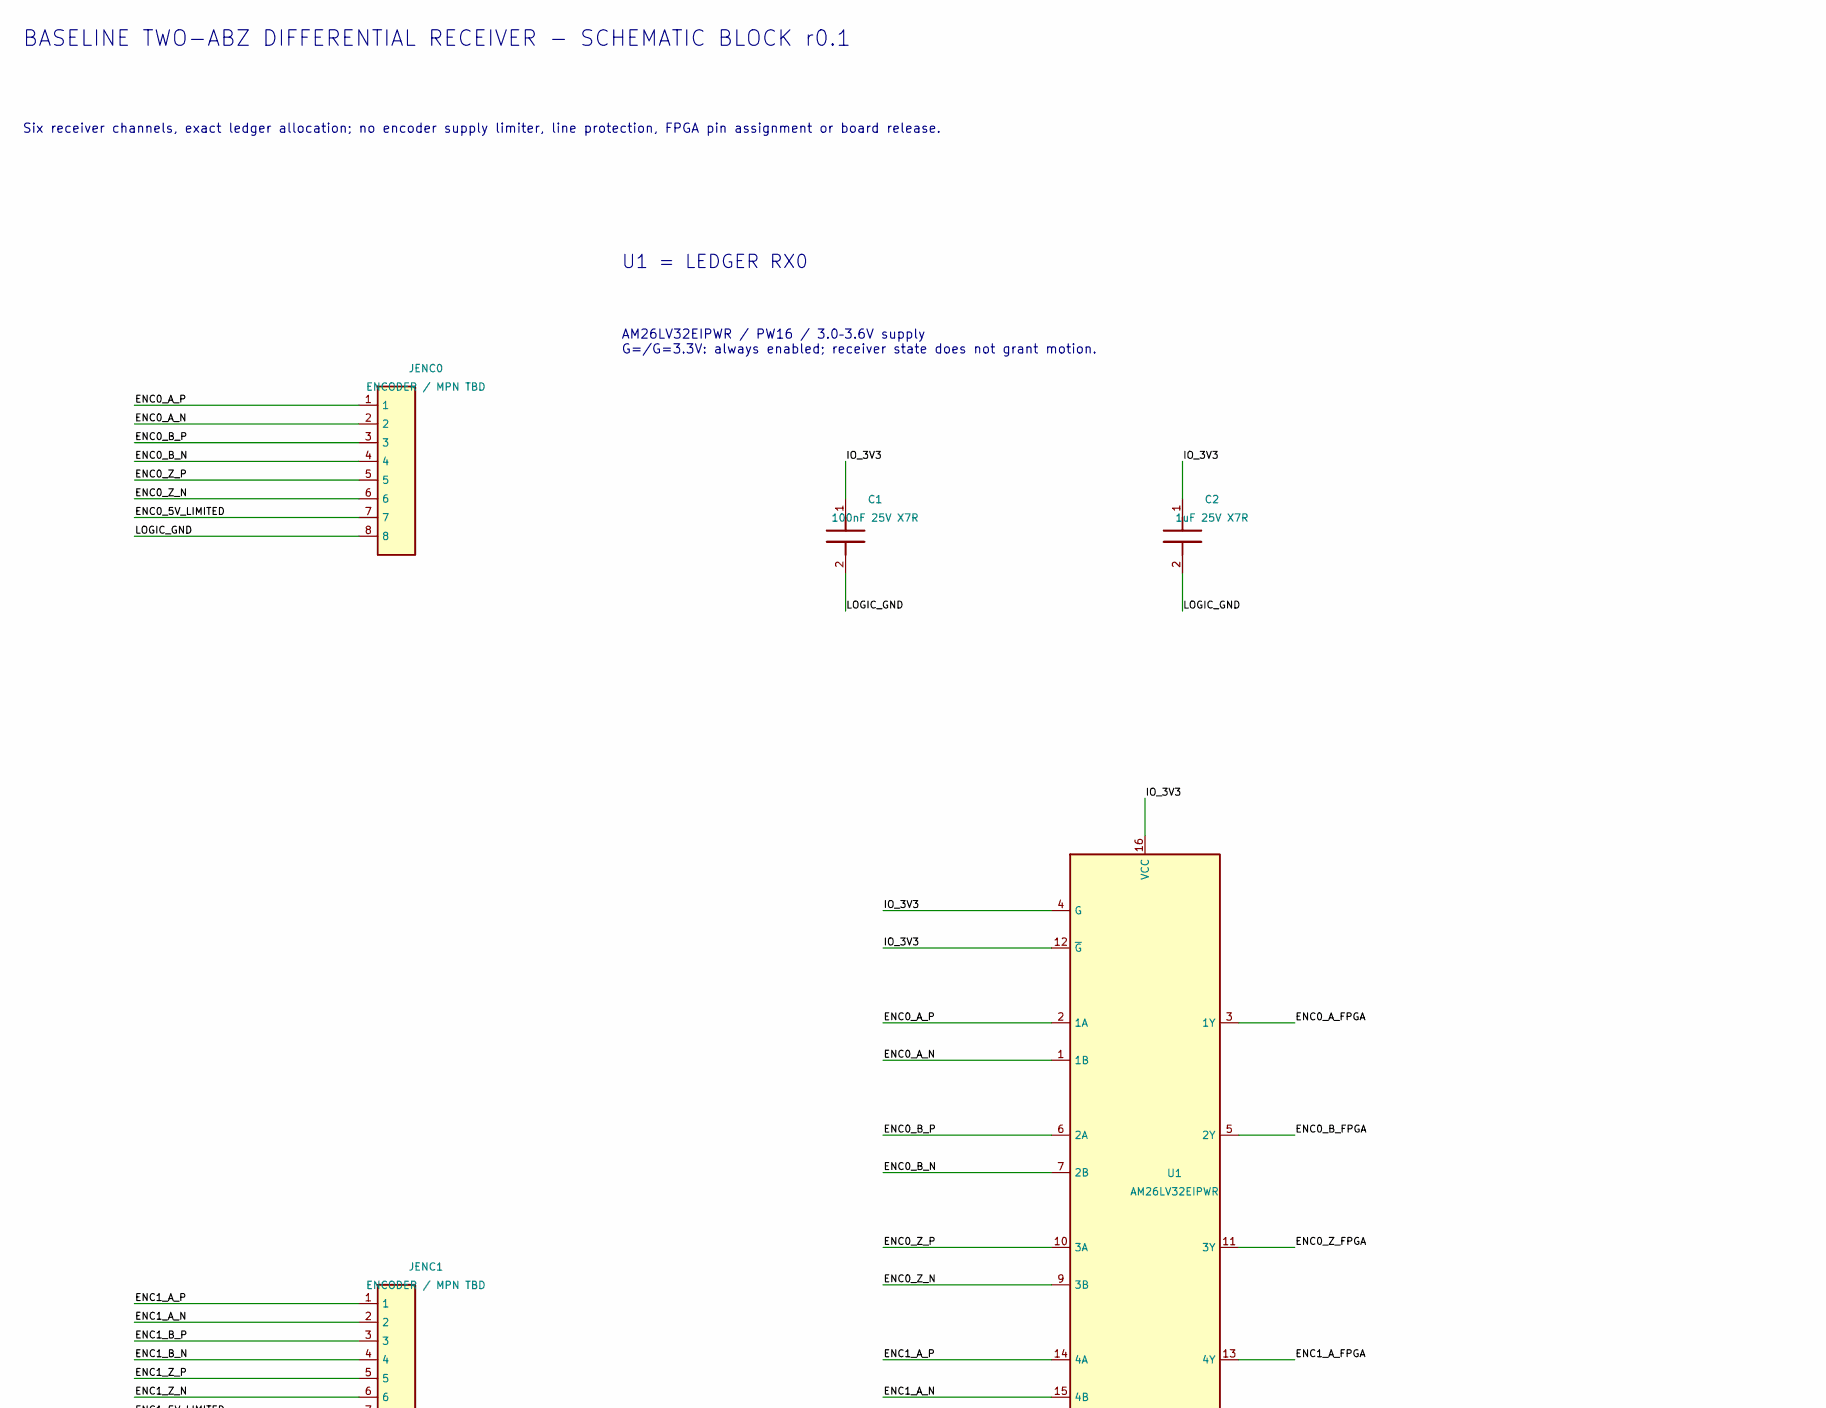
[picture p96: schematic rx_abz.kicad_sch, part in row 1, column 1]

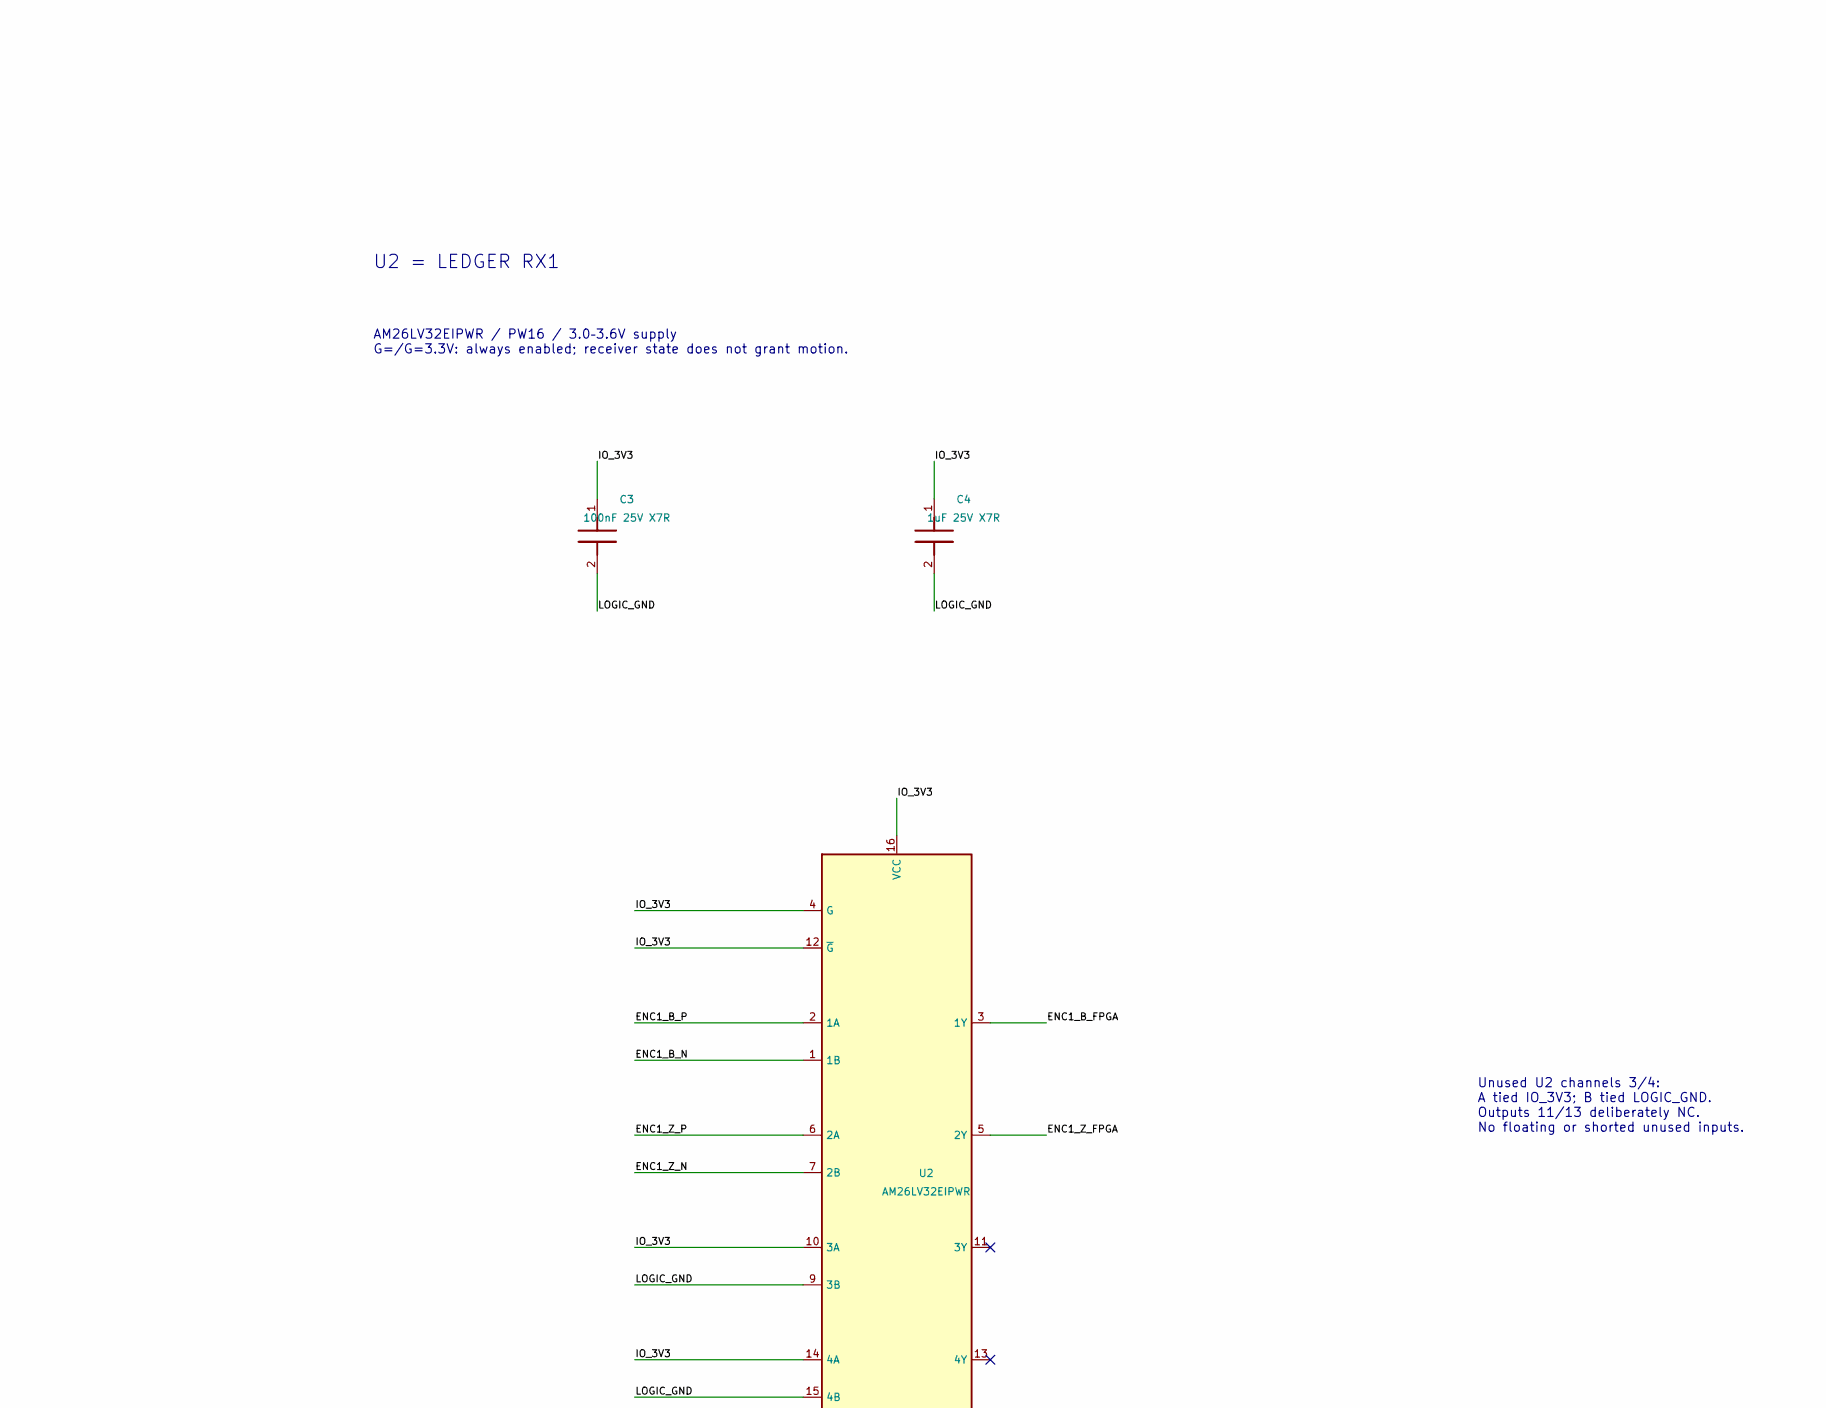
[picture p97: schematic rx_abz.kicad_sch, part in row 1, column 2]

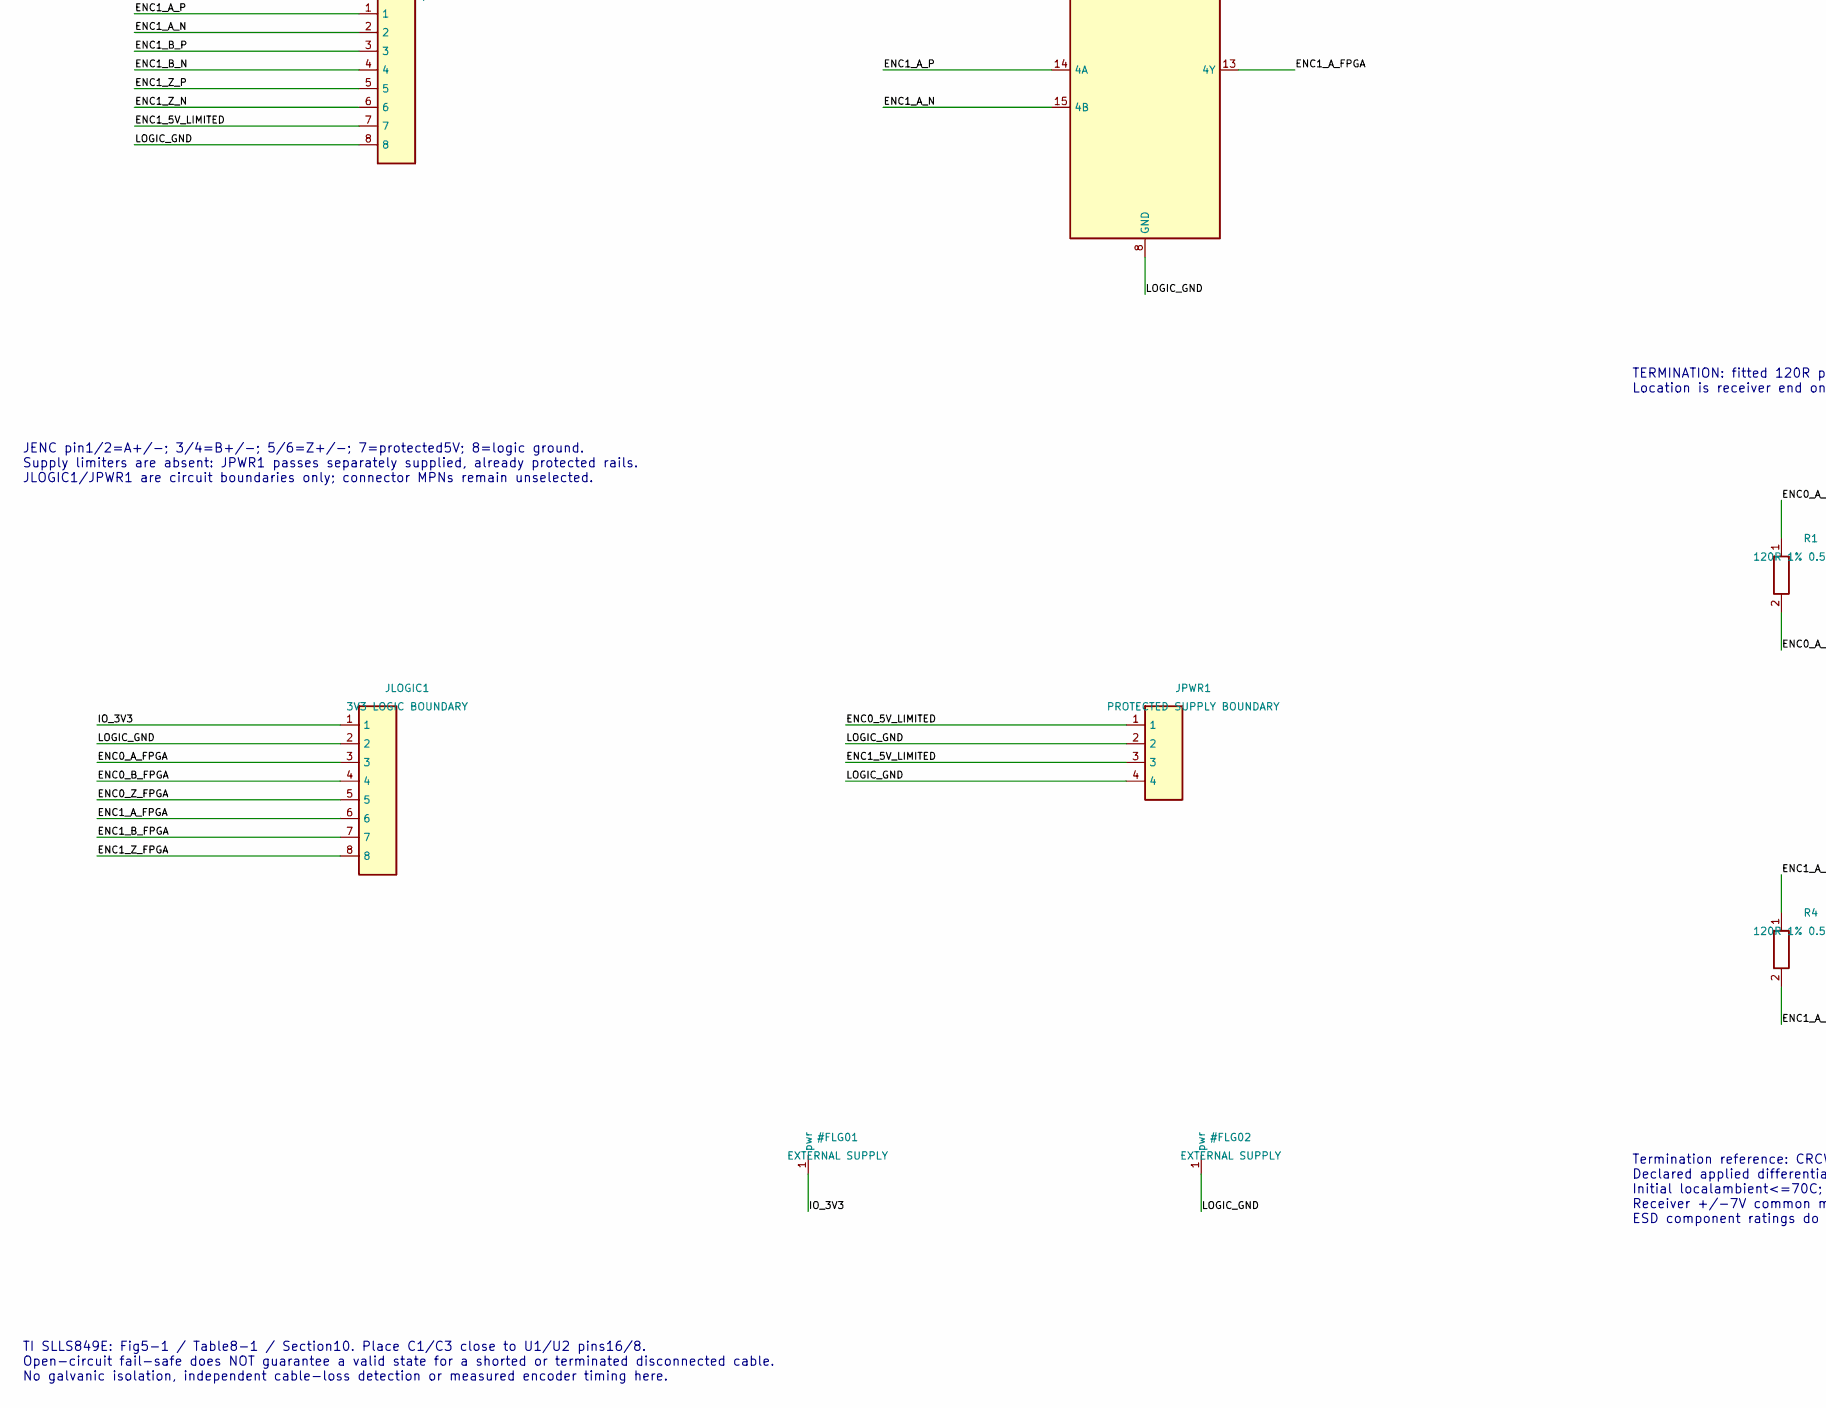
[picture p98: schematic rx_abz.kicad_sch, part in row 2, column 1]

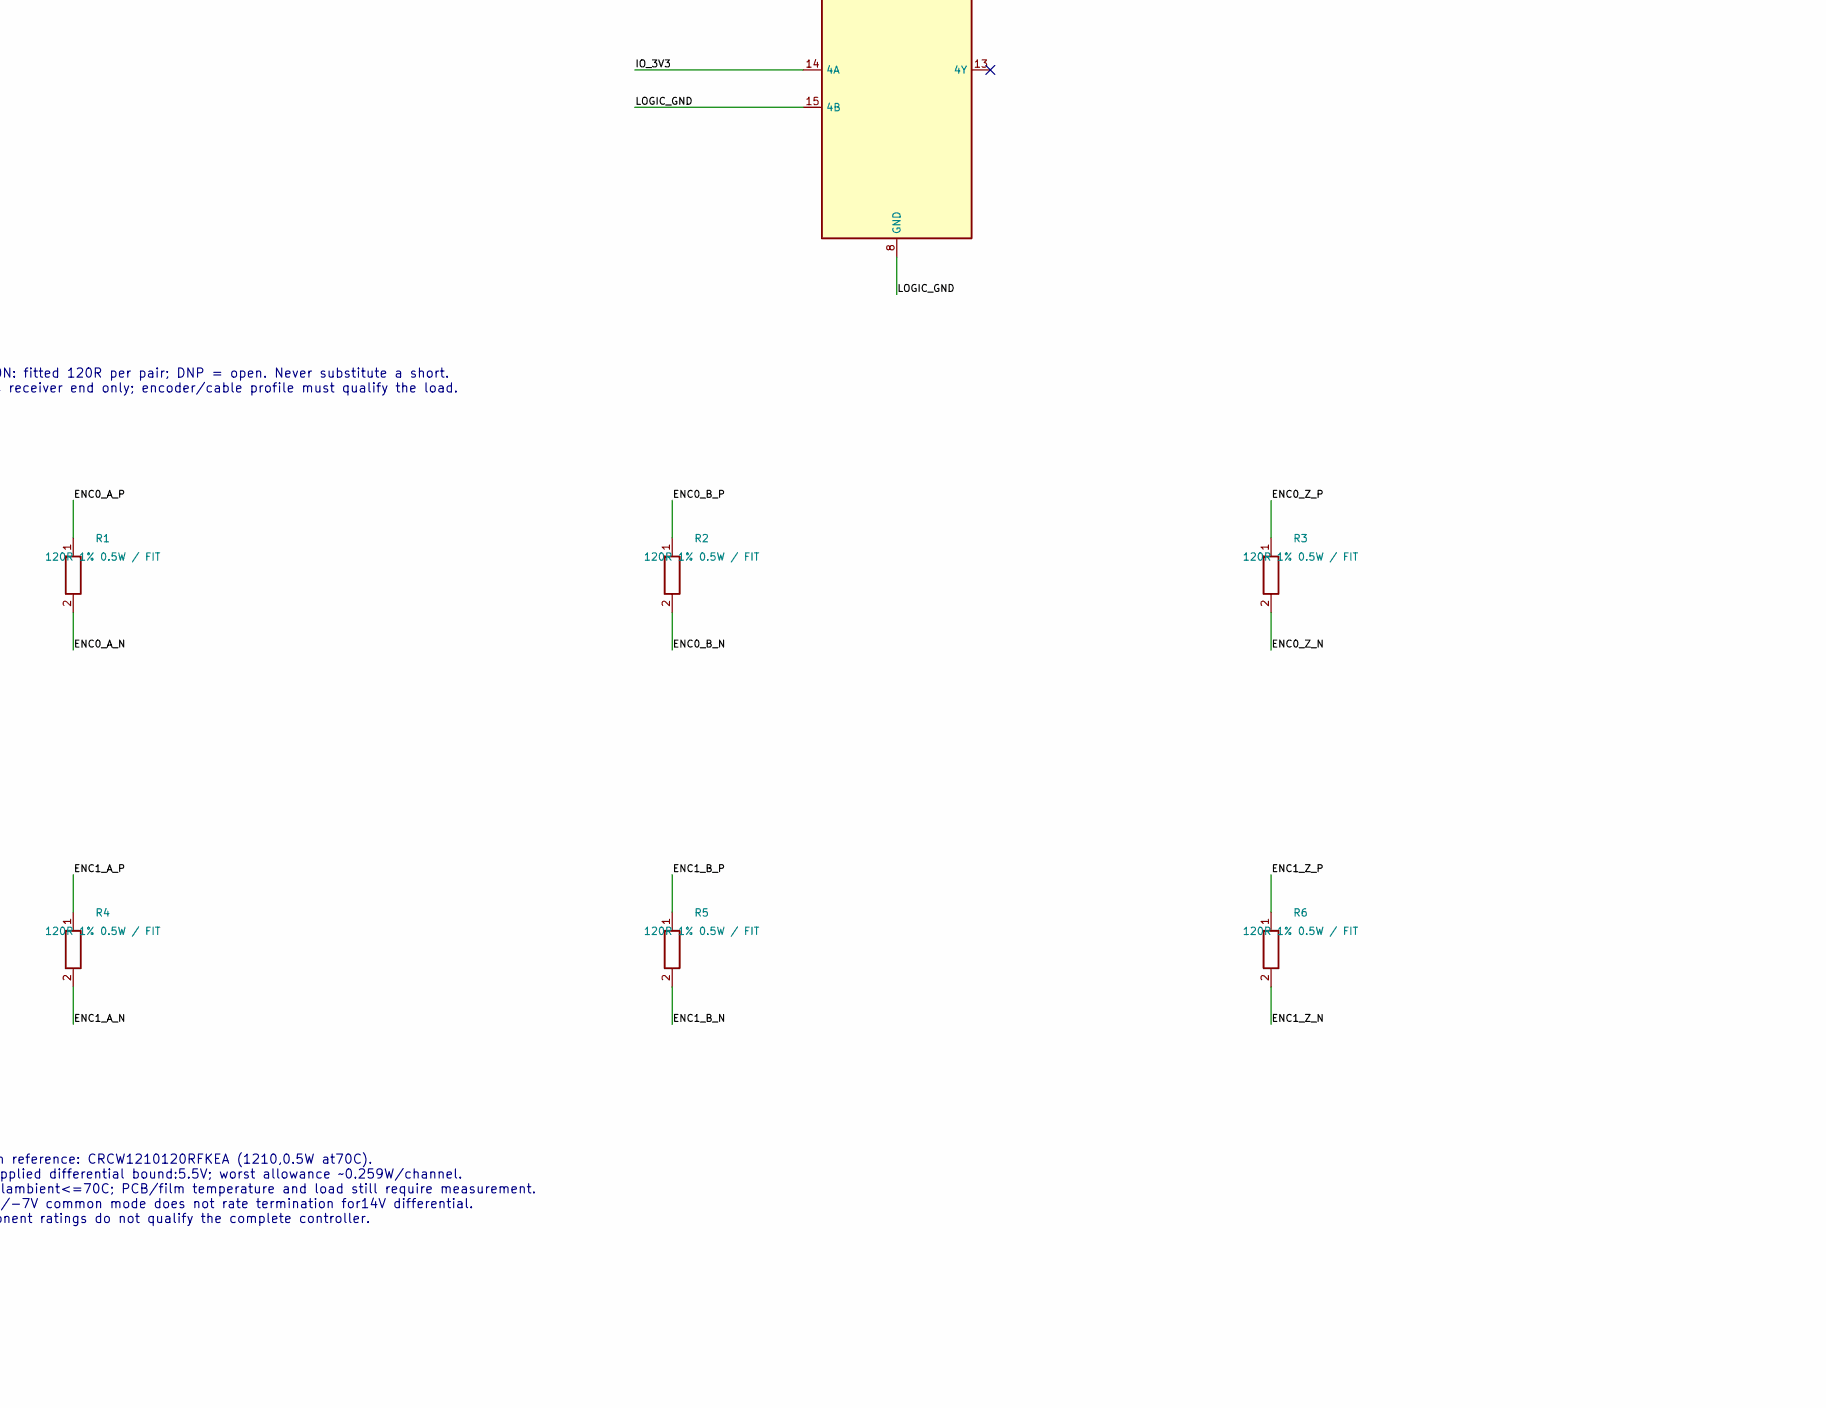
[picture p99: schematic rx_abz.kicad_sch, part in row 2, column 2]

Parts:
C1, C3: 100nF 25V X7R; C_0603_1608Metric
C2, C4: 1uF 25V X7R; C_0603_1608Metric
JENC0, JENC1: ENCODER / MPN TBD
JLOGIC1: 3V3 LOGIC BOUNDARY
JPWR1: PROTECTED SUPPLY BOUNDARY
R1, R2, R3, R4, R5, R6: 120R 1% 0.5W / FIT; R_1210_3225Metric; MPN CRCW1210120RFKEA
U1, U2: AM26LV32EIPWR; TSSOP-16_4.4x5mm_P0.65mm; MPN AM26LV32EIPWR

Connections:
ENC0_5V_LIMITED: JENC0.7, JPWR1.1
ENC0_A_FPGA: JLOGIC1.3, U1.3 (1Y)
ENC0_A_N: JENC0.2, R1.2, U1.1 (1B)
ENC0_A_P: JENC0.1, R1.1, U1.2 (1A)
ENC0_B_FPGA: JLOGIC1.4, U1.5 (2Y)
ENC0_B_N: JENC0.4, R2.2, U1.7 (2B)
ENC0_B_P: JENC0.3, R2.1, U1.6 (2A)
ENC0_Z_FPGA: JLOGIC1.5, U1.11 (3Y)
ENC0_Z_N: JENC0.6, R3.2, U1.9 (3B)
ENC0_Z_P: JENC0.5, R3.1, U1.10 (3A)
ENC1_5V_LIMITED: JENC1.7, JPWR1.3
ENC1_A_FPGA: JLOGIC1.6, U1.13 (4Y)
ENC1_A_N: JENC1.2, R4.2, U1.15 (4B)
ENC1_A_P: JENC1.1, R4.1, U1.14 (4A)
ENC1_B_FPGA: JLOGIC1.7, U2.3 (1Y)
ENC1_B_N: JENC1.4, R5.2, U2.1 (1B)
ENC1_B_P: JENC1.3, R5.1, U2.2 (1A)
ENC1_Z_FPGA: JLOGIC1.8, U2.5 (2Y)
ENC1_Z_N: JENC1.6, R6.2, U2.7 (2B)
ENC1_Z_P: JENC1.5, R6.1, U2.6 (2A)
IO_3V3: C1.1, C2.1, C3.1, C4.1, JLOGIC1.1, U1.4 (G), U1.12 (~G), U1.16 (VCC), U2.4 (G), U2.10 (3A), U2.12 (~G), U2.14 (4A), U2.16 (VCC)
LOGIC_GND: C1.2, C2.2, C3.2, C4.2, JENC0.8, JENC1.8, JLOGIC1.2, JPWR1.2, JPWR1.4, U1.8 (GND), U2.8 (GND), U2.9 (3B), U2.15 (4B)

Notes on the sheet:
U1 = LEDGER RX0
AM26LV32EIPWR / PW16 / 3.0–3.6V supply G=/G=3.3V: always enabled; receiver state does not grant motion.
U2 = LEDGER RX1
BASELINE TWO-ABZ DIFFERENTIAL RECEIVER - SCHEMATIC BLOCK r0.1
Six receiver channels, exact ledger allocation; no encoder supply limiter, line protection, FPGA pin assignment or board release.
Unused U2 channels 3/4: A tied IO_3V3; B tied LOGIC_GND. Outputs 11/13 deliberately NC. No floating or shorted unused inputs.
JENC pin1/2=A+/−; 3/4=B+/−; 5/6=Z+/−; 7=protected5V; 8=logic ground. Supply limiters are absent: JPWR1 passes separately supplied, already protected rails. JLOGIC1/JPWR1 are circuit boundaries only; connector MPNs remain unselected.
TERMINATION: fitted 120R per pair; DNP = open. Never substitute a short. Location is receiver end only; encoder/cable profile must qualify the load.
TI SLLS849E: Fig5-1 / Table8-1 / Section10. Place C1/C3 close to U1/U2 pins16/8. Open-circuit fail-safe does NOT guarantee a valid state for a shorted or terminated disconnected cable. No galvanic isolation, independent cable-loss detection or measured encoder timing here.
Termination reference: CRCW1210120RFKEA (1210,0.5W at70C). Declared applied differential bound:5.5V; worst allowance ~0.259W/channel. Initial localambient<=70C; PCB/film temperature and load still require measurement. Receiver +/-7V common mode does not rate termination for14V differential. ESD com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
