DeadlySIn777/Controller/reports/motherboard-acc-control-20260930/r02-ao-spi-correction/prior48-inputs/hardware/motherboard_acc_control/motherboard_acc_control.kicad_sch

## KiCad design reports/motherboard-acc-control-20260930/r02-ao-spi-correction/prior48-inputs/hardware/motherboard_acc_control/motherboard_acc_control.kicad_sch (2026-10-18)

Schematic: motherboard_acc_control.kicad_sch

Parts:
C14501, C14502, C14504, C14506, C14507, C14508: 100nF100V; C_0603_1608Metric; MPN GRM188R72A104KA35D
C14503: 4700nF10V; C_0805_2012Metric; MPN GRM21BR71A475KE51K
C14505: 1000nF50V; C_0603_1608Metric; MPN GRM188R71H105KA12D
J14501: PARENT: allocated fourth host endpoint
J14502: PARENT: actual frozen144xx process frontend
J14503: PARENT: isolated analog frontend still required; 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
J14504: PARENT: real isolated supply/clamp/fault monitor 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
R14501, R14502, R14503, R14504, R14505, R14506, R14507, R14508, R14509, R14510, R14511, R14512, R14513, R14514, R14515, R14516, R14517, R14520, R14521, R14522, R14527, R14528, R14529, R14530: 10000R1%; R_0603_1608Metric; MPN CRCW060310K0FKEA
R14518, R14519: 3300R1%; R_0603_1608Metric; MPN CRCW06033K30FKEA
R14523, R14524, R14525, R14526: 22R1%; R_0603_1608Metric; MPN CRCW060322R0FKEA
TP14501: IO_3V3; TestPoint_Pad_D1.0mm; MPN PCB_COPPER_TEST_PAD_D1.0
TP14502: LOGIC_GND; TestPoint_Pad_D1.0mm; MPN PCB_COPPER_TEST_PAD_D1.0
TP14503: ACC_SWDIO; TestPoint_Pad_D1.0mm; MPN PCB_COPPER_TEST_PAD_D1.0
TP14504: ACC_SWCLK_BOOT0; TestPoint_Pad_D1.0mm; MPN PCB_COPPER_TEST_PAD_D1.0
TP14505: ACC_NRST_N; TestPoint_Pad_D1.0mm; MPN PCB_COPPER_TEST_PAD_D1.0
TP14506: ACC_MR_N; TestPoint_Pad_D1.0mm; MPN PCB_COPPER_TEST_PAD_D1.0
U14501: STM32G031C8T6; LQFP-48_7x7mm_P0.5mm; MPN STM32G031C8T6
U14502: TPS3808G33DBVR; SOT-23-6; MPN TPS3808G33DBVR
U14503: 74LVC125APW,118; TSSOP-14_4.4x5mm_P0.65mm; MPN 74LVC125APW,118
U14504: SN74LVC1G17DBVR; SOT-23-5; MPN SN74LVC1G17DBVR

Connections:
ACC_CARD_EN: J14502.3, U14501.12 (PA1)
ACC_CONTROLLER_RESET_N: J14502.1, U14504.4 (Y)
ACC_IOL1_CLK_BUFFER: R14524.1, U14503.6 (2Y)
ACC_IOL1_CLK_MCU: R14524.2, U14501.16 (PA5)
ACC_IOL1_CMD_BUFFER: R14525.1, U14503.8 (3Y)
ACC_IOL1_CMD_MCU: R14525.2, U14501.18 (PA7)
ACC_IOL1_CS_BUFFER: R14523.1, U14503.3 (1Y)
ACC_IOL1_CS_MCU: R14523.2, U14501.15 (PA4)
ACC_IOL1_RSP_BUFFER: R14526.1, U14503.11 (4Y)
ACC_IOL1_RSP_MCU: R14530.1, U14501.17 (PA6), U14503.12 (4A)
ACC_IO_ENABLE_STROBE: J14502.2, U14501.11 (PA0)
ACC_MR_N: R14521.1, TP14506.1, U14502.3 (MR_N)
ACC_NRST_N: C14501.1, R14520.1, TP14505.1, U14501.10 (PF2-NRST), U14502.1 (RESET_N), U14504.2 (A)
ACC_OUT_EN_LATCH: J14502.4, U14501.13 (PA2)
ACC_SLOT0: R14501.1, U14501.2 (PC14)
ACC_SLOT1: R14502.1, U14501.3 (PC15)
ACC_SLOT2: R14503.1, U14501.8 (PF0)
ACC_SLOT3: R14504.1, U14501.9 (PF1)
ACC_SWCLK_BOOT0: R14522.1, TP14504.1, U14501.36 (PA14-BOOT0)
ACC_SWDIO: TP14503.1, U14501.35 (PA13)
AI_CS_N_HOST: J14503.1, R14515.1, U14501.24 (PB12)
AI_POWER_GOOD_HOST: J14504.1, R14505.1, U14501.32 (PA10)
AI_SCLK_HOST: J14503.2, R14516.1, U14501.25 (PB13)
AI_SDI_HOST: J14503.3, R14517.1, U14501.27 (PB15)
AI_SDO_HOST: J14503.4, U14501.26 (PB14)
AI_SENSOR_FAULT_HOST: J14504.6, R14510.1, U14501.40 (PD2)
AO0_CLAMP_ACTIVE: J14503.9, J14504.7, R14511.1, U14501.30 (PC6)
AO0_ENABLE_REQUEST: J14503.7, R14513.1, U14501.28 (PA8)
AO0_POWER_GOOD_HOST: J14504.2, R14506.1, U14501.33 (PA11)
AO1_CLAMP_ACTIVE: J14503.10, J14504.8, R14512.1, U14501.31 (PC7)
AO1_ENABLE_REQUEST: J14503.8, R14514.1, U14501.29 (PA9)
AO1_POWER_GOOD_HOST: J14504.3, R14507.1, U14501.34 (PA12)
AO_I2C_SCL_HOST: J14503.5, R14518.1, U14501.47 (PB8)
AO_I2C_SDA_HOST: J14503.6, R14519.1, U14501.48 (PB9)
CAN_POWER_GOOD_HOST: J14504.5, R14509.1, U14501.39 (PD1)
IOL1_L3_CS_N: J14501.3, R14527.1, U14503.2 (1A)
IOL1_L3_MISO: J14501.6, R14526.2
IOL1_L3_MOSI: J14501.5, R14529.1, U14503.9 (3A)
IOL1_L3_SCLK: J14501.4, R14528.1, U14503.5 (2A)
IO_3V3: C14502.1, C14503.1, C14504.1, C14505.1, C14506.1, C14507.1, C14508.1, J14501.1, R14501.2, R14502.2, R14510.2, R14511.2, R14512.2, R14515.2, R14518.2, R14519.2, R14520.2, R14521.2, R14527.2, TP14501.1, U14501.4 (VBAT), U14501.5 (VREF+), U14501.6 (VDD/VDDA), U14502.5 (SENSE), U14502.6 (VDD), U14503.14 (VCC), U14504.5 (VCC)
LOGIC_GND: C14501.2, C14502.2, C14503.2, C14504.2, C14505.2, C14506.2, C14507.2, C14508.2, J14501.2, R14503.2, R14504.2, R14505.2, R14506.2, R14507.2, R14508.2, R14509.2, R14513.2, R14514.2, R14516.2, R14517.2, R14522.2, R14528.2, R14529.2, R14530.2, TP14502.1, U14501.7 (VSS/VSSA), U14502.2 (GND), U14503.1 (1OE_N), U14503.4 (2OE_N), U14503.7 (GND), U14503.10 (3OE_N), U14503.13 (4OE_N), U14504.3 (GND)
OUT_PERMIT_ACC: J14502.6, U14501.19 (PB0)
PEN_ENABLE_LOGIC: J14502.9, U14501.22 (PB10)
PEN_OUT_EN_LATCH: J14502.5, U14501.14 (PA3)
PROC_PERMIT: J14502.7, U14501.20 (PB1)
PWM_AUX_FAULT_N: J14502.10, U14501.23 (PB11)
PWM_ENABLE_LOGIC: J14502.8, U14501.21 (PB2)
RS485_POWER_GOOD_HOST: J14504.4, R14508.1, U14501.38 (PD0)

Notes on the sheet:
IOL1 FOURTH ON-MOTHERBOARD CONTROL / L3:ACC One real STM32G031C MCU, SPI buffers, rail/reset supervisors and factory SWD pads. No custom cards. Target firmware/options/identity/calibration/field monitors and loaded timing remain unimplemented. Outputs default OFF.
