DeadlySIn777/Controller/reports/motherboard-pcb-integration-20260930/frozen-source-r02/motherboard/source-blocks/motherboard_fast_inputs/motherboard_fast_inputs.kicad_sch

## KiCad design reports/motherboard-pcb-integration-20260930/frozen-source-r02/motherboard/source-blocks/motherboard_fast_inputs/motherboard_fast_inputs.kicad_sch (2026-10-18)

Schematic: motherboard_fast_inputs.kicad_sch

Parts:
B1: XE0 FUNCTION / NONPHYSICAL
B2: XE1 FUNCTION / NONPHYSICAL
B3: XE2 FUNCTION / NONPHYSICAL
B4: XE3 FUNCTION / NONPHYSICAL
B5: XF FUNCTION / NONPHYSICAL
B6: XH1 FUNCTION / NONPHYSICAL
B7: EXTERNALLY PROTECTED FEEDS / NONPHYSICAL
B8: FPGA LOGIC BOUNDARY / NONPHYSICAL
B9: MISSING FRONTEND HANDOFF / NONPHYSICAL
C1, C3, C5, C7: 100nF 100V X7R; C_0603_1608Metric; MPN GRM188R72A104KA35D
C2, C4, C6, C8: 1uF 16V X7R; C_0603_1608Metric; MPN 885012206052
R1, R2, R3, R4, R5, R6, R7, R8, R9, R10, R11, R12, R13, R14: 120R 1% 0.5W / FIT; R_1210_3225Metric; MPN CRCW1210120RFKEA
R15, R16: 120R 1% 0.5W / DNP; R_1210_3225Metric; MPN CRCW1210120RFKEA; not fitted
U1, U2, U3, U4: AM26LV32EIPWR; TSSOP-16_4.4x5mm_P0.65mm; MPN AM26LV32EIPWR

Connections:
CHASSIS: B1.10, B2.10, B3.10, B4.10, B5.10, B6.10, B7.9
ENC0_5V_LIMITED: B1.1, B7.1
ENC0_A_FPGA: B8.3, U1.3 (1Y)
ENC0_A_N: B1.4, R1.2, U1.1 (1B)
ENC0_A_P: B1.3, R1.1, U1.2 (1A)
ENC0_B_FPGA: B8.4, U1.5 (2Y)
ENC0_B_N: B1.6, R2.2, U1.7 (2B)
ENC0_B_P: B1.5, R2.1, U1.6 (2A)
ENC0_Z_FPGA: B8.5, U1.11 (3Y)
ENC0_Z_N: B1.8, R3.2, U1.9 (3B)
ENC0_Z_P: B1.7, R3.1, U1.10 (3A)
ENC1_5V_LIMITED: B2.1, B7.2
ENC1_A_FPGA: B8.6, U1.13 (4Y)
ENC1_A_N: B2.4, R4.2, U1.15 (4B)
ENC1_A_P: B2.3, R4.1, U1.14 (4A)
ENC1_B_FPGA: B8.7, U2.3 (1Y)
ENC1_B_N: B2.6, R5.2, U2.1 (1B)
ENC1_B_P: B2.5, R5.1, U2.2 (1A)
ENC1_Z_FPGA: B8.8, U2.5 (2Y)
ENC1_Z_N: B2.8, R6.2, U2.7 (2B)
ENC1_Z_P: B2.7, R6.1, U2.6 (2A)
ENC2_5V_LIMITED: B3.1, B7.3
ENC2_A_FPGA: B8.9, U2.11 (3Y)
ENC2_A_N: B3.4, R7.2, U2.9 (3B)
ENC2_A_P: B3.3, R7.1, U2.10 (3A)
ENC2_B_FPGA: B8.10, U2.13 (4Y)
ENC2_B_N: B3.6, R8.2, U2.15 (4B)
ENC2_B_P: B3.5, R8.1, U2.14 (4A)
ENC2_Z_FPGA: B8.11, U3.3 (1Y)
ENC2_Z_N: B3.8, R9.2, U3.1 (1B)
ENC2_Z_P: B3.7, R9.1, U3.2 (1A)
ENC3_5V_LIMITED: B4.1, B7.4
ENC3_A_FPGA: B8.12, U3.5 (2Y)
ENC3_A_N: B4.4, R10.2, U3.7 (2B)
ENC3_A_P: B4.3, R10.1, U3.6 (2A)
ENC3_B_FPGA: B8.13, U3.11 (3Y)
ENC3_B_N: B4.6, R11.2, U3.9 (3B)
ENC3_B_P: B4.5, R11.1, U3.10 (3A)
ENC3_Z_FPGA: B8.14, U3.13 (4Y)
ENC3_Z_N: B4.8, R12.2, U3.15 (4B)
ENC3_Z_P: B4.7, R12.1, U3.14 (4A)
FREQ0_FPGA: B8.15, U4.3 (1Y)
FREQ0_N: B5.4, R13.2, U4.1 (1B)
FREQ0_P: B5.3, R13.1, U4.2 (1A)
FREQ1_FPGA: B8.16, U4.5 (2Y)
FREQ1_N: B5.6, R14.2, U4.7 (2B)
FREQ1_P: B5.5, R14.1, U4.6 (2A)
FREQ_5V_LIMITED: B5.1, B7.5
FREQ_MOD_ID_TO_FRONTEND: B5.7, B9.1
FREQ_MOD_PRESENT_TO_FRONTEND: B5.8, B9.2
IO_3V3: B8.1, C1.1, C2.1, C3.1, C4.1, C5.1, C6.1, C7.1, C8.1, U1.4 (G), U1.12 (~G), U1.16 (VCC), U2.4 (G), U2.12 (~G), U2.16 (VCC), U3.4 (G), U3.12 (~G), U3.16 (VCC), U4.4 (G), U4.12 (~G), U4.16 (VCC)
LOGIC_GND: B1.2, B1.9, B2.2, B2.9, B3.2, B3.9, B4.2, B4.9, B5.2, B5.9, B6.2, B6.9, B7.8, B8.2, C1.2, C2.2, C3.2, C4.2, C5.2, C6.2, C7.2, C8.2, U1.8 (GND), U2.8 (GND), U3.8 (GND), U4.8 (GND)
MPG_5V_LIMITED: B6.1, B7.6
MPG_A_FPGA: B8.17, U4.11 (3Y)
MPG_A_N: B6.4, R15.2, U4.9 (3B)
MPG_A_P: B6.3, R15.1, U4.10 (3A)
MPG_B_FPGA: B8.18, U4.13 (4Y)
MPG_B_N: B6.6, R16.2, U4.15 (4B)
MPG_B_P: B6.5, R16.1, U4.14 (4A)
MPG_ENABLE_TO_STATUS: B6.8, B9.3
MPG_VREF_2V5: B6.7, B7.7

Notes on the sheet:
U1: four used receiver paths, G and /G tied IO_3V3 3.0–3.6V supply; no motion-permission authority. 0.1uF bypass close to VCC/GND; 1uF local bulk.
U2: four used receiver paths, G and /G tied IO_3V3 3.0–3.6V supply; no motion-permission authority. 0.1uF bypass close to VCC/GND; 1uF local bulk.
U3: four used receiver paths, G and /G tied IO_3V3 3.0–3.6V supply; no motion-permission authority. 0.1uF bypass close to VCC/GND; 1uF local bulk.
U4: four used receiver paths, G and /G tied IO_3V3 3.0–3.6V supply; no motion-permission authority. 0.1uF bypass close to VCC/GND; 1uF local bulk.
IS-2 MOTHERBOARD: FOUR ABZ + TWO FREQUENCY + MPG A/B RECEIVER REGION r0.1
All 16 receiver channels used; no receiver output NC. No galvanic isolation or cable-line-fault detector here. 14 fitted 120R terminations; MPG R15/R16 DNP to avoid loading a 1mA TTL reference. Differential MPG needs a qualified termination variant. Terminated/disconnected or shorted pairs do not h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
BOUNDARIES ARE NONPHYSICAL: no unverified connector MPN/footprint. Preserve XE0–3 / XF / XH1 logical field ordering. 5V protected feeds and MPG_VREF enter from future parent regions; this block does not generate or protect them. Input bound: RS422 5.5V maximum differential for termination arithmeti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
