DeadlySIn777/Controller/reports/processor-hardware-20260929/native-exports/workspace/hardware/fpga_core/fpga_core.kicad_sch

## KiCad design reports/processor-hardware-20260929/native-exports/workspace/hardware/fpga_core/fpga_core.kicad_sch (2026-10-18)

Schematic: fpga_core.kicad_sch

Parts:
C1, C2, C3, C4, C5, C6, C7, C8, C9, C10, C11, C12, C13, C14, C15, C16, C17, C18, C19, C20, C21, C22, C23, C35, C38: 0.1uF 16V X7R; C_0603_1608Metric; MPN 885012206046
C24, C28, C29, C30, C31, C32, C33, C34: 4.7uF 16V X7R; C_0805_2012Metric; MPN 885012207053
C25, C26, C27, C36, C39: 1uF 16V X7R; C_0603_1608Metric; MPN 885012206052
C37: 0.01uF 16V X7R; C_0603_1608Metric; MPN 885012206040
J1: POWER / QUALIFIED SEQUENCER
J2: JTAG SERVICE / NO POWER INJECTION
J3: HOST SPI / 3V3 ONLY
J4: HW PERMISSION / NO ESP MOTION AUTHORITY
J5: TWELVE MOTOR STEP / DIR
J6: ENABLE RESERVES / CIRCUITS ABSENT
J7: HOME / 0-5 PRESENT; 6-11 RESERVED
J8: ALARM / 0-5 PRESENT; 6-11 RESERVED
J9: ENCODERS / 0-1 PRESENT; 2-3 RESERVED
J10: AUX / EXISTING ISOLATED INPUTS
R1, R2: 33R 1%; R_0603_1608Metric; MPN CRCW060333R0FKEA
R3, R4, R5, R6, R7, R8, R9, R10, R11, R12, R13, R14, R15, R16, R17, R18, R19, R22, R23, R24, R25: 10000R 1%; R_0603_1608Metric; MPN CRCW060310K0FKEA
R20: 47000R 1%; R_0603_1608Metric; MPN CRCW060347K0FKEA
R21: 1000R 1%; R_0603_1608Metric; MPN CRCW06031K00FKEA
U1: T20F256I4 / CANDIDATE PIN ALLOCATION; MPN T20F256I4
U2: W25Q32JVSSIQ / x1 SPI; SOIC-8_5.3x5.3mm_P1.27mm; MPN W25Q32JVSSIQ
U3: SN74LVC1G08DCKR / RESET AND; SOT-353_SC-70-5; MPN SN74LVC1G08DCKR
U4: 74LVC1G17GW / CDONE DELAY SCHMITT; SOT-353_SC-70-5; MPN 74LVC1G17GW
U5: SN74LVC1G08DCKR / USER RESET AND; SOT-353_SC-70-5; MPN SN74LVC1G08DCKR
Y1: ASE-50.000MHZ-L-C-T; MPN ASE-50.000MHZ-L-C-T

Connections:
ALM0_FPGA: J8.1, U1.B12 (GPIOR_93)
ALM1_FPGA: J8.2, U1.B13 (GPIOR_97)
ALM2_FPGA: J8.3, U1.B15 (GPIOR_98)
ALM3_FPGA: J8.4, U1.C13 (GPIOR_99)
ALM4_FPGA: J8.5, U1.C16 (GPIOR_108)
ALM5_FPGA: J8.6, U1.E14 (GPIOR_110)
ALM6_FPGA: J8.7, U1.F12 (GPIOR_111)
ALM7_FPGA: J8.8, U1.D16 (GPIOR_116_CTRL15)
ALM8_FPGA: J8.9, U1.G13 (GPIOR_117_CTRL14)
ALM9_FPGA: J8.10, U1.F14 (GPIOR_118_CTRL13)
ALM10_FPGA: J8.11, U1.E16 (GPIOR_119_CTRL12)
ALM11_FPGA: J8.12, U1.E15 (GPIOR_120_CLK15)
CORE_1V2: C1.1, C2.1, C3.1, C4.1, C5.1, C6.1, C7.1, C8.1, C9.1, C24.1, C25.1, C26.1, C27.1, J1.1, U1.E9 (VCC), U1.F7 (VCCA_TL), U1.F8 (VCC), U1.F9 (VCC), U1.G11 (VCCA_TR), U1.J6 (VCC), U1.J7 (VCC), U1.K9 (VCC), U1.K11 (VCCA_BR)
CYCLE_START_FPGA: J10.8, U1.H16 (GPIOR_130_CTRL9)
DIR0_FPGA: J5.2, U1.J5 (GPIOL_11)
DIR1_FPGA: J5.4, U1.K3 (GPIOL_15)
DIR2_FPGA: J5.6, U1.K1 (GPIOL_18)
DIR3_FPGA: J5.8, U1.H1 (GPIOL_22_CTRL2)
DIR4_FPGA: J5.10, U1.H2 (GPIOL_25_CLK1)
DIR5_FPGA: J5.12, U1.G3 (GPIOL_27_CLK3)
DIR6_FPGA: J5.14, U1.G2 (GPIOL_29_CLK5)
DIR7_FPGA: J5.16, U1.C1 (GPIOL_33_CTRL5)
DIR8_FPGA: J5.18, U1.F3 (GPIOL_35_CTRL7)
DIR9_FPGA: J5.20, U1.E1 (GPIOL_37)
DIR10_FPGA: J5.22, U1.G4 (GPIOL_42)
DIR11_FPGA: J5.24, U1.B1 (GPIOL_44)
DOOR_STATUS_FPGA: J10.3, U1.H13 (GPIOR_125_CLK10)
DRIVE_ENABLE0_FPGA_RESERVED: J6.1, U1.H12 (GPIOR_139)
DRIVE_ENABLE1_FPGA_RESERVED: J6.2, U1.J12 (GPIOR_141)
DRIVE_ENABLE2_FPGA_RESERVED: J6.3, U1.L16 (GPIOR_143)
DRIVE_ENABLE3_FPGA_RESERVED: J6.4, U1.M15 (GPIOR_144)
DRIVE_ENABLE4_FPGA_RESERVED: J6.5, U1.M16 (GPIOR_145)
DRIVE_ENABLE5_FPGA_RESERVED: J6.6, U1.P16 (GPIOR_146)
DRIVE_ENABLE6_FPGA_RESERVED: J6.7, U1.L15 (GPIOR_147)
DRIVE_ENABLE7_FPGA_RESERVED: J6.8, U1.K12 (GPIOR_148)
DRIVE_ENABLE8_FPGA_RESERVED: J6.9, U1.N14 (GPIOR_153)
DRIVE_ENABLE9_FPGA_RESERVED: J6.10, U1.N16 (GPIOR_154)
DRIVE_ENABLE10_FPGA_RESERVED: J6.11, U1.P15 (GPIOR_155)
DRIVE_ENABLE11_FPGA_RESERVED: J6.12, U1.M14 (GPIOR_156)
ENC0_A_FPGA: J9.1, U1.B5 (GPIOL_61)
ENC0_B_FPGA: J9.2, U1.A7 (GPIOL_62)
ENC0_Z_FPGA: J9.3, U1.B7 (GPIOL_63)
ENC1_A_FPGA: J9.4, U1.B6 (GPIOL_64)
ENC1_B_FPGA: J9.5, U1.A6 (GPIOL_65)
ENC1_Z_FPGA: J9.6, U1.E7 (GPIOL_68)
ENC2_A_FPGA: J9.7, U1.D9 (GPIOL_74_PLLIN0)
ENC2_B_FPGA: J9.8, U1.E8 (GPIOL_75_PLLIN1)
ENC2_Z_FPGA: J9.9, U1.C9 (GPIOR_76_PLLIN0)
ENC3_A_FPGA: J9.10, U1.D10 (GPIOR_77_PLLIN1)
ENC3_B_FPGA: J9.11, U1.B9 (GPIOR_80)
ENC3_Z_FPGA: J9.12, U1.C10 (GPIOR_81_MREFCLK)
FEED_HOLD_FPGA: J10.7, U1.H15 (GPIOR_129_CTRL10)
FPGA_CDONE: J1.6, J2.8, R3.2, R22.1, U1.R1 (CDONE)
FPGA_CFG_CBSEL0: R18.1, U1.C7 (GPIOL_70_CBSEL0)
FPGA_CFG_CBSEL1: R19.1, U1.D7 (GPIOL_69_CBSEL1)
FPGA_CFG_CBUS0: R9.2, U1.K13 (GPIOR_151_CBUS0)
FPGA_CFG_CBUS1: R8.2, U1.L14 (GPIOR_150_CBUS1)
FPGA_CFG_CBUS2: R7.2, U1.R16 (GPIOR_149_CBUS2)
FPGA_CFG_CSI: R4.2, U1.N3 (GPIOL_04_CSI)
FPGA_CFG_NSTATUS: J1.7, R17.2, U1.B8 (GPIOL_71_NSTATUS)
FPGA_CFG_TEST_N: R5.2, U1.L12 (GPIOR_158_TEST_N)
FPGA_CLK_50M: R1.2, U1.H3 (GPIOL_24_CLK0)
FPGA_CLK_SOURCE: R1.1, Y1.3 (OUT)
FPGA_CRESET_N: J1.4, U3.1 (A)
FPGA_ENDPOINT_READY: J4.2, R23.1, U1.C4 (GPIOL_51)
FPGA_FLASH_CCK: R2.2, U2.6 (CLK)
FPGA_FLASH_CCK_SOURCE: R2.1, U1.M3 (GPIOL_01_CCK)
FPGA_FLASH_CS_N: R6.2, U1.P3 (GPIOL_00_SS_N), U2.1 (CS_N)
FPGA_FLASH_IO2: R14.2, U2.3 (WP_N / IO2)
FPGA_FLASH_IO3: R15.2, U2.7 (HOLD_N / IO3)
FPGA_FLASH_MISO: U1.N1 (GPIOL_09_CDI1), U2.2 (DO / IO1)
FPGA_FLASH_MOSI: U1.L3 (GPIOL_08_CDI0), U2.5 (DI / IO0)
FPGA_INHIBIT_FAULT: J4.6, U1.A4 (GPIOL_59)
FPGA_JTAG_TCK: J2.3, R10.2, U1.M2 (TCK)
FPGA_JTAG_TDI: J2.5, R11.2, U1.K5 (TDI)
FPGA_JTAG_TDO: J2.6, R13.2, U1.L5 (TDO)
FPGA_JTAG_TMS: J2.4, R12.2, U1.M1 (TMS)
FPGA_LINK_FAULT: J3.6, U1.A3 (GPIOL_57)
FPGA_LOCAL_RESET_N: J1.5, J4.7, R20.2, R21.1, U1.P1 (CRESET_N), U3.4 (Y)
FPGA_MOTION_REQUEST: J4.3, R24.1, U1.B3 (GPIOL_52)
FPGA_PROGRESS_WDI: J4.4, R25.1, U1.E4 (GPIOL_55)
FPGA_SERVICE_RUN_N: J2.7, R16.2, U3.2 (B), U5.2 (B)
FPGA_TIMING_FAULT: J3.8, U1.E5 (GPIOL_60)
FPGA_USER_RESET_DELAYED: U4.4 (Y), U5.1 (A)
FPGA_USER_RESET_N: U1.D5 (GPIOL_49), U5.4 (Y)
FPGA_USER_RESET_RC: C39.1, R22.2, U4.1 (A)
FPGA_WATCHDOG_FAULT: J3.7, U1.C6 (GPIOL_58)
HOME0_FPGA: J7.1, U1.B10 (GPIOR_82)
HOME1_FPGA: J7.2, U1.B11 (GPIOR_83)
HOME2_FPGA: J7.3, U1.A11 (GPIOR_84)
HOME3_FPGA: J7.4, U1.C12 (GPIOR_85)
HOME4_FPGA: J7.5, U1.C11 (GPIOR_86)
HOME5_FPGA: J7.6, U1.D12 (GPIOR_89)
HOME6_FPGA: J7.7, U1.C14 (GPIOR_102)
HOME7_FPGA: J7.8, U1.D13 (GPIOR_103)
HOME8_FPGA: J7.9, U1.B16 (GPIOR_106)
HOME9_FPGA: J7.10, U1.A14 (GPIOR_90)
HOME10_FPGA: J7.11, U1.E12 (GPIOR_91)
HOME11_FPGA: J7.12, U1.B14 (GPIOR_92)
HOST_SPI_CS_N: J3.1, U1.B2 (GPIOL_45)
HOST_SPI_MISO: J3.4, U1.C3 (GPIOL_48)
HOST_SPI_MOSI: J3.3, U1.D4 (GPIOL_47)
HOST_SPI_SCLK: J3.2, U1.D3 (GPIOL_46)
HW_WATCHDOG_OK_N: J4.1, U1.A2 (GPIOL_50)
IO_3V3: C10.1, C11.1, C12.1, C13.1, C14.1, C15.1, C16.1, C17.1, C18.1, C19.1, C20.1, C21.1, C22.1, C23.1, C28.1, C29.1, C30.1, C31.1, C32.1, C33.1, C34.1, C35.1, C36.1, C37.1, C38.1, J1.2, J2.1, J10.11, R3.1, R4.1, R5.1, R6.1, R7.1, R8.1, R9.1, R10.1, R11.1, R12.1, R13.1, R14.1, R15.1, R16.1, R17.1, R20.1, U1.E10 (VCCIO3A_3B_3C), U1.F6 (VCCIO1D_1E), U1.F10 (VCCIO3A_3B_3C), U1.F11 (VCCIO3A_3B_3C), U1.G6 (VCCIO1D_1E), U1.H6 (VCCIO1B_1C), U1.H7 (VCCIO1B_1C), U1.J10 (VCCIO3D_3E), U1.J11 (VCCIO3D_3E), U1.K6 (VCCIO1A), U1.L6 (VCCIO4B), U1.L7 (VCCIO4B), U1.L10 (VCCIO4A), U1.L11 (VCCIO4A), U2.8 (VCC), U3.5 (VCC), U4.5 (VCC), U5.5 (VCC), Y1.1 (STBY_N), Y1.4 (VDD)
LOGIC_GND: C1.2, C2.2, C3.2, C4.2, C5.2, C6.2, C7.2, C8.2, C9.2, C10.2, C11.2, C12.2, C13.2, C14.2, C15.2, C16.2, C17.2, C18.2, C19.2, C20.2, C21.2, C22.2, C23.2, C24.2, C25.2, C26.2, C27.2, C28.2, C29.2, C30.2, C31.2, C32.2, C33.2, C34.2, C35.2, C36.2, C37.2, C38.2, C39.2, J1.3, J1.8, J2.2, J3.5, J4.8, J10.12, R18.2, R19.2, R21.2, R23.2, R24.2, R25.2, U1.A1 (GND), U1.A5 (GND), U1.A12 (GND), U1.A16 (GND), U1.D2 (GND), U1.D15 (GND), U1.G7 (GND), U1.G8 (GND), U1.G9 (GND), U1.G10 (GND), U1.H8 (GND), U1.H9 (GND), U1.H10 (GND), U1.H11 (GND), U1.J1 (GND), U1.J8 (GND), U1.J9 (GND), U1.J16 (GND), U1.K7 (GND), U1.K8 (GND), U1.K10 (GND), U1.L8 (GND), U1.L9 (GND), U1.N2 (GND), U1.N15 (GND), U1.R7 (GND), U1.R10 (GND), U1.T1 (GND), U1.T4 (GND), U1.T13 (GND), U1.T16 (GND), U2.4 (GND), U3.3 (GND), U4.2 (GND), U5.3 (GND), Y1.2 (GND)
LUBE_STATUS_FPGA: J10.9, U1.J15 (GPIOR_131_CTRL8)
PROBE_FPGA: J10.1, U1.G12 (GPIOR_121_CLK14)
PROTECTIVE_STATUS_FPGA: J10.4, U1.G16 (GPIOR_126_CLK9)
SPARE_FPGA: J10.10, U1.K14 (GPIOR_138)
SPINDLE_FAULT_FPGA: J10.5, U1.G14 (GPIOR_127_CLK8)
SPINDLE_READY_FPGA: J10.6, U1.H14 (GPIOR_128_CTRL11)
STEP0_FPGA: J5.1, U1.P2 (GPIOL_02)
STEP1_FPGA: J5.3, U1.J4 (GPIOL_14)
STEP2_FPGA: J5.5, U1.J3 (GPIOL_16)
STEP3_FPGA: J5.7, U1.K2 (GPIOL_19)
STEP4_FPGA: J5.9, U1.L1 (GPIOL_23_CTRL3)
STEP5_FPGA: J5.11, U1.H4 (GPIOL_26_CLK2)
STEP6_FPGA: J5.13, U1.G5 (GPIOL_28_CLK4)
STEP7_FPGA: J5.15, U1.F1 (GPIOL_30_CLK6)
STEP8_FPGA: J5.17, U1.E2 (GPIOL_34_CTRL6)
STEP9_FPGA: J5.19, U1.D1 (GPIOL_36)
STEP10_FPGA: J5.21, U1.E3 (GPIOL_39)
STEP11_FPGA: J5.23, U1.F4 (GPIOL_43)
TOOLSETTER_FPGA: J10.2, U1.G15 (GPIOR_124_CLK11)
TX_PERMIT: J4.5, U1.E6 (GPIOL_56)

Notes on the sheet:
T20F256 FPGA CORE / MINIMUM 8 MOTOR CHANNELS, 12-CHANNEL PIN CAPACITY CANDIDATE
Exact 256 balls: Efinix T20-PINOUT worksheet T20F256. Pin allocation is a board candidate, NOT vendor fit or routed timing. All VCCIO=3.3V. All VCC/VCCA=1.2V. No 5V-tolerant FPGA connection. No native LVDS: REF_RES intentionally NC.
One 100nF per supply ball; bulk per physical supply group. Decoupling is a layout-study allowance, not a PDN proof. Active SPI x1 straps111; CSI/TEST high. Flash bus reserved from user RTL. CCK damping33R is provisional. CDONE is open-drain with10k pullup; status does not grant motion permission. C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
RESET: U3 combines qualified upstream reset with service RUN for configuration reset only. U4/U5 make a separate CDONE-qualified user-logic reset; R25/C39 provide a bounded post-CDONE delay and service RUN can hold it low through a JTAG handoff. No programmer output fights the sequencer. User-logic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
NC crosses are genuine unused GPIO/config outputs and REF_RES only; every supply/GND ball is connected. Boundary symbols are not released connectors. No footprint approval, PCB, DRC, bitstream, qualification or fabrication files.
J1-J10 ARE INTERNAL LOGIC BOUNDARIES, NOT FIELD TERMINALS. Enables and extra home/alarm/encoder channels are reserves only. CRESET47k/1k plus two internal pullups screened. The separate 10k/1uF CDONE reset delay is a candidate, not a guaranteed time or safety function; threshold/partial-power confi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
