DeadlySIn777/Controller/reports/motherboard-compute-20260930/staging-r05/hardware_validate_motherboard_compute.py

"""Independent native pin/domain and primary socket-land checks for15xxx."""
from __future__ import annotations
from collections import Counter,defaultdict
import hashlib,json,math
from pathlib import Path
import sys
import xml.etree.ElementTree as ET
sys.path.insert(0,str(Path.cwd()/"tools"))
from hardware_build_assembly import parse,children,child,value

ROOT=Path.cwd()
OUT=ROOT/'reports/motherboard-compute-20260930/staging-r05/source'
REPORT=ROOT/'reports/motherboard-compute-20260930'
AUDIT=ROOT/'reports/board-completion-20260930/compute-bay-pin-audit'
SOCKET_MPN='10164227-1001A1RLF'

def native_nodes(tree):
 nodes={};errors=[]
 for net in tree.findall('./nets/net'):
  name=net.attrib['name'].removeprefix('/')
  for node in net.findall('node'):
   key=(node.attrib['ref'],node.attrib['pin'])
   if key in nodes:errors.append('Duplicate native pin '+str(key))
   nodes[key]=name
 return nodes,errors


def validate(tree,model,source_dir=OUT):
 nodes,errors=native_nodes(tree);parts={c.attrib['ref']:c for c in tree.findall('./components/comp')}
 components=model.get('components',{})
 if set(parts)!=set(components):errors.append('Native/model component inventory differs')
 for ref,c in parts.items():
  p=components.get(ref,{})
  native=(c.findtext('value'),c.findtext('footprint',''),c.findtext("./fields/field[@name='MPN']",''))
  if native!=(p.get('value'),p.get('footprint'),p.get('mpn')):errors.append('Native/model MPN/value/footprint differs '+ref)
  prop={x.attrib['name'] for x in c.findall('property')};physical=p.get('physical')
  if physical and {'exclude_from_bom','exclude_from_board'}&prop:errors.append('Physical component excluded '+ref)
  if not physical and (native[1] or native[2] or not {'exclude_from_bom','exclude_from_board'}<=prop):errors.append('Nonphysical boundary became an invented connector '+ref)
  expected=p.get('pins',{});actual={pin:net for (nref,pin),net in nodes.items() if nref==ref}
  if set(expected)!=set(actual):errors.append('Native/model complete pin set differs '+ref)
  for pin,net in expected.items():
   got=actual.get(pin)
   if net is None:
    if not got or not got.startswith('unconnected-'):errors.append('Exact declared NC is actually connected '+ref+'.'+pin)
   elif net!=got:errors.append('Native/model pin net differs '+ref+'.'+pin)
  if physical and (p.get('dnp') or 'dnp' in prop):errors.append('This base compute region has no approved DNP '+ref)
  if physical:
   if ':' not in p.get('footprint',''):errors.append('Physical footprint lacks library '+ref)
   else:
    lib,name=p['footprint'].split(':',1)
    fp=Path(source_dir)/(lib+'.pretty')/(name+'.kicad_mod') if lib=='CNC_COMPUTE' else Path('C:/Program Files/KiCad/10.0/share/kicad/footprints')/(lib+'.pretty')/(name+'.kicad_mod')
    if not fp.exists():errors.append('Exact footprint file unavailable '+ref)
    else:
     fpt=parse(fp.read_text(encoding='utf8'));numbered={value(pad[1]) for pad in children(fpt,'pad') if value(pad[1]) and any(value(layer).endswith('.Cu') for layer in child(pad,'layers')[1:])}
     if numbered!=set(expected):errors.append('Exact footprint numbered copper differs from source pins '+ref)
 if model.get('manufacturing_ready') or model.get('physical_qualification'):errors.append('Unproved manufacturing/physical evidence claimed')
 if model.get('compute_som_fitted_on_carrier_bom') or not model.get('module_parts_separate'):errors.append('Commodity compute module duplicated on carrierBOM')
 sockets=[ref for ref,c in components.items() if c.get('mpn')==SOCKET_MPN]
 if sorted(sockets)!=['J15001','J15002']:errors.append('Exactly two physical100-contact sockets required')
 for ref in sockets:
  if not components[ref]['physical'] or len(components[ref]['pins'])!=100:errors.append('Incorrect actual socket count/contact count '+ref)
 matrix=json.loads((AUDIT/'pin-matrix.json').read_text(encoding='utf8'))['pins']
 def contact(pin):return ('J15001',str(pin)) if pin<=100 else ('J15002',str(pin-100))
 for row in matrix:
  if row['cm4_signal']=='GND' and row['cm5_signal']=='GND' and nodes.get(contact(row['global_pin']))!='LOGIC_GND':errors.append('Primary common return not actually connected '+str(row['global_pin']))
 for pin in [77,79,81,83,85,87]:
  if nodes.get(contact(pin))!='SBC_5V':errors.append('Main5V socket contact wrong '+str(pin))
 for pin in [78,84,86]:
  if nodes.get(contact(pin))!='CM_AUX_3V3':errors.append('Pi module-own AUX/VREF contact wrong '+str(pin))
 for pin in [88,90,92,94,96]:
  if not nodes.get(contact(pin),'').startswith('unconnected-'):errors.append('Restricted/unneeded module contact wired without reviewed profile '+str(pin))
 for pin,net in {38:'CM_HOST_SPI_SCLK',40:'CM_HOST_SPI_MISO',44:'CM_HOST_SPI_MOSI',47:'CM_HOST_SPI_CS_CMD_N',54:'CM_HOST_SPI_CS_FB_N',55:'COMPUTE_SERVICE_TX',93:'CM_nRPIBOOT',101:'CM_USB_OTG_ID',103:'CM_USB2_N',105:'CM_USB2_P'}.items():
  if nodes.get(contact(pin))!=net:errors.append('Exact primary common host contact wrong '+str(pin))
 # Hardcoded independently from TI DBV pin tables, not the source generator.
 # Supervisor threshold/open-drain observed rail is not an OS identity signal.
 normative={
  'U15001':('TPS3808G33DBVR',{1:'CM_AUX_RESET_N',2:'LOGIC_GND',3:'CM_AUX_MR_N',4:None,5:'CM_AUX_3V3',6:'CM_AUX_3V3'}),
  'U15002':('SN74LVC1G17DBVR',{1:None,2:'CM_AUX_RESET_N',3:'LOGIC_GND',4:'COMPUTE_3V3_GOOD',5:'IO_3V3'}),
  'U15003':('SN74LVC1G17DBVR',{1:None,2:'FPGA_CRESET_N',3:'LOGIC_GND',4:'CM_FPGA_RAILS_QUALIFIED',5:'IO_3V3'}),
  'U15004':('SN74LVC1G17DBVR',{1:None,2:'FPGA_CDONE',3:'LOGIC_GND',4:'CM_FPGA_CONFIGURED',5:'IO_3V3'}),
  'U15005':('SN74LVC1G10DBVR',{1:'COMPUTE_3V3_GOOD',2:'LOGIC_GND',3:'CM_FPGA_RAILS_QUALIFIED',4:'CM_HOST_OE_N',5:'IO_3V3',6:'CM_FPGA_CONFIGURED'}),
  'U15006':('SN74LVC1G125DBVR',{1:'CM_HOST_OE_N',2:'CM_HOST_SPI_SCLK',3:'LOGIC_GND',4:'CM_FWD_SCLK',5:'IO_3V3'}),
  'U15007':('SN74LVC1G125DBVR',{1:'CM_HOST_OE_N',2:'CM_HOST_SPI_MOSI',3:'LOGIC_GND',4:'CM_FWD_MOSI',5:'IO_3V3'}),
  'U15008':('SN74LVC1G125DBVR',{1:'CM_HOST_OE_N',2:'CM_HOST_SPI_CS_FB_N',3:'LOGIC_GND',4:'CM_FWD_CS_FB_N',5:'IO_3V3'}),
  'U15009':('SN74LVC1G125DBVR',{1:'CM_HOST_OE_N',2:'CM_HOST_SPI_CS_CMD_N',3:'LOGIC_GND',4:'CM_FWD_CS_CMD_N',5:'IO_3V3'}),
  'U15010':('SN74LVC1G125DBVR',{1:'CM_HOST_OE_N',2:'HOST_SPI_MISO',3:'LOGIC_GND',4:'CM_RET_MISO',5:'CM_AUX_3V3'}),
  'U15011':('219-3MSTRF',{1:'COMPUTE_PROFILE0',2:'COMPUTE_PROFILE1',3:'COMPUTE_PROFILE2',4:'IO_3V3',5:'IO_3V3',6:'IO_3V3'})}
 for ref,(mpn,mapping) in normative.items():
  if components.get(ref,{}).get('mpn')!=mpn:errors.append('Unreviewed critical MPN '+ref)
  for pin,net in mapping.items():
   got=nodes.get((ref,str(pin)))
   if net is None:
    if not got or not got.startswith('unconnected-'):errors.append('Critical unusedpin not NC '+ref+'.'+str(pin))
   elif got!=net:errors.append('Independent critical native pin/domain mismatch '+ref+'.'+str(pin))
 pairs=defaultdict(list)
 for ref,p in components.items():
  if p.get('kind')=='R' and p.get('physical'):pairs[frozenset(p['pins'].values())].append((ref,p.get('resistance_ohm')))
 required=[('CM_AUX_RESET_N','CM_AUX_3V3',10000),('CM_AUX_MR_N','CM_AUX_3V3',10000),('CM_AUX_3V3','LOGIC_GND',1000),('CM_HOST_OE_N','IO_3V3',10000),('FPGA_CRESET_N','LOGIC_GND',10000),('FPGA_CDONE','LOGIC_GND',47000)]
 for raw,suffix,default in [('CM_HOST_SPI_SCLK','SCLK','LOW'),('CM_HOST_SPI_MOSI','MOSI','LOW'),('CM_HOST_SPI_CS_FB_N','CS_FB_N','HIGH'),('CM_HOST_SPI_CS_CMD_N','CS_CMD_N','HIGH')]:
  required.extend([(raw,'CM_AUX_3V3' if default=='HIGH' else 'LOGIC_GND',10000),('HOST_SPI_'+suffix,'IO_3V3' if default=='HIGH' else 'LOGIC_GND',10000),('CM_FWD_'+suffix,'HOST_SPI_'+suffix,33)])
 required.extend([('CM_RET_MISO','CM_HOST_SPI_MISO',33),('HOST_SPI_MISO','LOGIC_GND',10000),('CM_HOST_SPI_MISO','LOGIC_GND',10000)])
 required.extend([(f'COMPUTE_PROFILE{i}','LOGIC_GND',10000) for i in range(3)])
 for a,b,ohm in required:
  if not any(v==ohm for _,v in pairs.get(frozenset([a,b]),[])):errors.append('Actual default/series resistor absent '+a+'/'+b)
 for pin,net in nodes.items():
  if pin[0].startswith('U') and components.get(pin[0],{}).get('kind')=='BUF' and nodes.get((pin[0],'5'))=='IO_3V3':
   pass
 # Protect against exact former reset-output-contention class: parent reset/
 # configuration observations are input-only in this carrier, never driven.
 for ref,c in parts.items():
  for net in tree.findall('./nets/net'):
   if net.attrib['name'].removeprefix('/') in ['FPGA_CRESET_N','FPGA_CDONE','COMPUTE_SERVICE_TX','CM_nRPIBOOT']:
    for n in net.findall('node'):
     if n.attrib['ref'].startswith('U') and n.attrib.get('pintype') in ['output','tri_state','open_collector','power_out']:
      errors.append('Carrier drives an observation/read-only/recovery endpoint '+n.attrib['ref']+'.'+n.attrib['pin'])
 selector=model.get('selector',{})
 if selector.get('DIP_controls_electrical_power_or_permission') or selector.get('automatic_hardware_ID_implemented') or selector.get('software_profile_implemented'):errors.append('Selector grants unimplemented authority/identity')
 for profile in model.get('profiles',{}).values():
  if profile.get('target_image_and_pinmux_qualified') or profile.get('full_electrical_qualification') or profile.get('machine_use_enabled'):errors.append('Unproved module profile qualified')
 pwr=model.get('module_power',{})
 for k,want in [('input','SBC_5V'),('ground','LOGIC_GND'),('aux3v3_max_total_a',.6),('aux3v3_max_per_contact_a',.3),('full_capacity_qualified',False)]:
  if pwr.get(k)!=want:errors.append('Modulepower contract changed '+k)
 rating=model.get('socket_rating',{})
 if (rating.get('all_contacts_simultaneous_a'),rating.get('blanket_rating_total_a'),rating.get('planned_2p5A_selective_contact_rating_or_temperature_qualification'))!=(.3,1.8,False):errors.append('Socket blanketrating/qualification boundary changed')
 sd_errors=validate_sd(tree,model,source_dir);errors.extend(sd_errors)
 land_errors=validate_lands(source_dir);errors.extend(land_errors)
 hdmi_errors=validate_hdmi(tree,model,source_dir);errors.extend(hdmi_errors)
 usb_errors=validate_usb(tree,model,source_dir);errors.extend(usb_errors)
 errors.extend(validate_ethernet_comms(tree,model,source_dir))
 hashes=model.get('input_hashes',{})
 for name,want in hashes.items():
  p=ROOT/name
  if not p.exists() or hashlib.sha256(p.read_bytes()).hexdigest()!=want:errors.append('Primary/source input changed '+name)
 return dict(ok=not errors,errors=sorted(set(errors)),physical_count=sum(p.get('physical',False) for p in components.values()),purchased_count=sum(p.get('physical',False) and p.get('kind')!='TP' for p in components.values()),bare_test_pad_count=sum(p.get('kind')=='TP' for p in components.values()),socket_count=len(sockets),native_pin_count=len(nodes),native_net_count=len(tree.findall('./nets/net')),NC_count=sum(v.startswith('unconnected-') for v in nodes.values()),raw_external_interfaces_unimplemented=1,source_scope_only=True,physical_validation=False,manufacturing_ready=False)


def validate_sd(tree,model,source_dir):
 nodes,errors=native_nodes(tree);parts=model['components']
 normative={
 'J15003':('503398-1892',{1:'SD_PORT_DAT2',2:'SD_PORT_DAT3',3:'SD_PORT_CMD',4:'SD_PORT_3V3',5:'SD_PORT_CLK',6:'LOGIC_GND',7:'SD_PORT_DAT0',8:'SD_PORT_DAT1',9:'LOGIC_GND',10:'SD_CARD_PRESENT_N',11:'LOGIC_GND'}),
 'U15012':('TPS2553DBVR',{1:'CM_AUX_3V3',2:'LOGIC_GND',3:'CM_SD_PWR_ON',4:'SD_POWER_FAULT_N',5:'SD_ILIM',6:'SD_PORT_3V3'}),
 'U15013':('TPS3808G30DBVR',{1:'SD_PORT_POWER_GOOD',2:'LOGIC_GND',3:'SD_PORT_MR_N',4:'SD_PORT_CT',5:'SD_PORT_3V3',6:'CM_AUX_3V3'}),
 'U15014':('SN74LVC1G00DBVR',{1:'CM_SD_PWR_ON',2:'SD_PORT_POWER_GOOD',3:'LOGIC_GND',4:'SD_BUS_OE_N',5:'CM_AUX_3V3'}),
 'U15015':('TS3A27518EPWR',{1:'SD_PORT_CMD',2:'SD_PORT_CLK',3:None,4:'SD_CLK_DAMPED',5:'LOGIC_GND',6:'CM_SD_CMD',7:'CM_SD_DAT0',8:'CM_AUX_3V3',9:'CM_SD_DAT1',10:'CM_SD_DAT2',11:'SD_UNUSED_NO1',12:'CM_SD_DAT3',13:'SD_UNUSED_NO2',14:'LOGIC_GND',15:'SD_UNUSED_NO3',16:'SD_UNUSED_NO6',17:'SD_UNUSED_NO4',18:'SD_UNUSED_NO5',19:'SD_PORT_DAT2',20:'SD_BUS_OE_N',21:'SD_PORT_DAT1',22:'SD_PORT_DAT3',23:'SD_PORT_DAT0',24:'LOGIC_GND'}),
 'U15016':('TPD4E05U06DQAR',{1:'SD_PORT_CLK',2:'SD_PORT_CMD',3:'LOGIC_GND',4:'SD_PORT_DAT0',5:'SD_PORT_DAT1',6:None,7:None,8:'LOGIC_GND',9:None,10:None}),
 'U15017':('TPD4E05U06DQAR',{1:'SD_PORT_DAT2',2:'SD_PORT_DAT3',3:'LOGIC_GND',4:None,5:None,6:None,7:None,8:'LOGIC_GND',9:None,10:None})}
 for ref,(mpn,pins) in normative.items():
  if parts.get(ref,{}).get('mpn')!=mpn:errors.append('Independent SD criticalMPN '+ref)
  for pin,net in pins.items():
   actual=nodes.get((ref,str(pin)))
   if net is None:
    if not actual or not actual.startswith('unconnected-'):errors.append('SD genuineunusedpinnotNC '+ref+'.'+str(pin))
   elif actual!=net:errors.append('IndependentSD mfrpin/domain mismatch '+ref+'.'+str(pin))
 pairs=defaultdict(list)
 for ref,c in parts.items():
  if c.get('kind')=='R':pairs[frozenset(c['pins'].values())].append((ref,c.get('resistance_ohm'),c.get('tolerance')))
 required=[('SD_ILIM','LOGIC_GND',76800),('CM_SD_PWR_ON','CM_AUX_3V3',10000),('SD_PORT_3V3','LOGIC_GND',1000),('SD_PORT_POWER_GOOD','CM_AUX_3V3',10000),('SD_PORT_MR_N','CM_AUX_3V3',10000),('SD_BUS_OE_N','CM_AUX_3V3',10000),('CM_SD_CLK','SD_CLK_DAMPED',33),('SD_CARD_PRESENT_N','CM_AUX_3V3',10000)]
 required.extend(('SD_UNUSED_NO'+str(i),'LOGIC_GND',49.9) for i in range(1,7))
 required.extend(('SD_PORT_'+x,'SD_PORT_3V3',10000) for x in ['CMD','DAT0','DAT1','DAT2','DAT3'])
 for a,b,r in required:
  if not any(ohm==r and tol==.01 for ref,ohm,tol in pairs.get(frozenset([a,b]),[])):errors.append('SD actualdefault/currentlimit/termination absent '+a+'/'+b)
 ct=[c for c in parts.values() if c.get('kind')=='C' and set(c['pins'].values())=={'SD_PORT_CT','LOGIC_GND'}]
 if len(ct)!=1 or not math.isclose(ct[0].get('capacitance_f',0),130e-12,rel_tol=1e-9):errors.append('SD actual130pF CT missing')
 sd=model.get('sd_port',{});imin=25230/(76.8*1.01)**1.016/1000;imax=22980/(76.8*.99)**.94/1000
 if not math.isclose(sd.get('current_limit_min_a',0),imin,rel_tol=1e-12) or not math.isclose(sd.get('current_limit_max_a',0),imax,rel_tol=1e-12) or not .3<imin<imax<.4:errors.append('SD worstcasecurrentcap equations/tolerance notclosed')
 if sd.get('qualified_cards') or sd.get('boot_image_verified') or sd.get('physical_qualification') or sd.get('hot_swap_qualified') or sd.get('diagnostics_allocated') or sd.get('external_injection_or_ideal_reverse_blocking_claim'):errors.append('SD unprovedboot/hotswap/profile/power claim')
 if not sd.get('cardpoweroff_signal_isolation_implemented'):errors.append('SD off-power signal isolation omitted')
 for suffix in ['CLK','CMD','DAT0','DAT1','DAT2','DAT3']:
  host='CM_SD_'+suffix;card='SD_PORT_'+suffix
  if host==card:errors.append('SD host/card nets notisolated')
  for ref,c in parts.items():
   if c.get('physical') and c.get('kind')!='SD_MUX' and {host,card}<=set(c['pins'].values()) and c.get('kind') not in ['R']:
    errors.append('SD bypasses actualbusisolation '+ref)
 # Every signal path is checked in nativeXML, not model-only metadata.
 source=REPORT/'sources/cm5io-rev2-official/CM5IO.pretty/SDCARD_MOLEX_503398-1892.kicad_mod'
 official=parse(source.read_text(encoding='utf8'));actual=parse((Path(source_dir)/'CNC_COMPUTE.pretty/Molex_503398-1892_SD.kicad_mod').read_text(encoding='utf8'))
 def geometry(t):return sorted((value(p[1]),tuple(child(p,'at')[1:]),tuple(child(p,'size')[1:])) for p in children(t,'pad') if value(p[1]))
 if geometry(official)!=geometry(actual):errors.append('Molex sourcebackedland/pin orientation differs')
 e=parse((Path(source_dir)/'CNC_COMPUTE.pretty/TI_DQA0010A_TPD4E05U06.kicad_mod').read_text(encoding='utf8'))
 for p in children(e,'pad'):
  n=int(value(p[1]));x,y=map(float,child(p,'at')[1:3]);sx,sy=map(float,child(p,'size')[1:3]);expectedx=-.4175 if n<=5 else .4175;expectedy=(-1+(n-1)*.5) if n<=5 else (1-(n-6)*.5)
  if not all(math.isclose(a,b,abs_tol=1e-9) for a,b in [(x,expectedx),(y,expectedy),(sx,.565),(sy,.4 if n in [3,8] else .2)]):errors.append('TI primary DQA ground/pitch/land mismatch')
 return errors



def validate_hdmi(tree,model,source_dir):
 """Primary PW drawing polarity and EDAC issue5 lands; independent of builder."""
 nodes,errors=native_nodes(tree);parts=model['components']
 # TI SLLSE96F p4 PW graphic is normative for polarity; p4 grouped table
 # lists CLK+/-15,16 without ordering. Figure says15negative/16positive.
 normative={
 'J15004':('690-019-298-412',{1:'CM_HDMI0_TX2_P',2:'LOGIC_GND',3:'CM_HDMI0_TX2_N',4:'CM_HDMI0_TX1_P',5:'LOGIC_GND',6:'CM_HDMI0_TX1_N',7:'CM_HDMI0_TX0_P',8:'LOGIC_GND',9:'CM_HDMI0_TX0_N',10:'CM_HDMI0_CLK_P',11:'LOGIC_GND',12:'CM_HDMI0_CLK_N',13:'HDMI_PORT_CEC',14:None,15:'HDMI_PORT_SCL',16:'HDMI_PORT_SDA',17:'LOGIC_GND',18:'HDMI_PORT_5V',19:'HDMI_PORT_HPD','SH1':'CHASSIS','SH2':'CHASSIS','SH3':'CHASSIS','SH4':'CHASSIS'}),
 'U15018':('TPD12S016PWR',{1:'CM_HDMI0_CEC',2:'CM_HDMI0_SCL',3:'CM_HDMI0_SDA',4:'CM_HDMI0_HOTPLUG',5:'HDMI_ENABLE',6:'LOGIC_GND',7:'HDMI_PORT_CEC',8:'HDMI_PORT_SCL',9:'HDMI_PORT_SDA',10:'HDMI_PORT_HPD',11:'SBC_5V',12:'HDMI_ENABLE',13:'HDMI_PORT_5V',14:'LOGIC_GND',15:'CM_HDMI0_CLK_N',16:'CM_HDMI0_CLK_P',17:'CM_HDMI0_TX0_N',18:'CM_HDMI0_TX0_P',19:'LOGIC_GND',20:'CM_HDMI0_TX1_N',21:'CM_HDMI0_TX1_P',22:'CM_HDMI0_TX2_N',23:'CM_HDMI0_TX2_P',24:'CM_AUX_3V3'}),
 'U15019':('SN74LVC1G17DBVR',{1:None,2:'CM_AUX_RESET_N',3:'LOGIC_GND',4:'HDMI_ENABLE',5:'CM_AUX_3V3'})}
 for ref,(mpn,pins) in normative.items():
  if parts.get(ref,{}).get('mpn')!=mpn:errors.append('Independent HDMI exactMPN '+ref)
  for pin,net in pins.items():
   got=nodes.get((ref,str(pin)))
   if net is None:
    if not got or not got.startswith('unconnected-'):errors.append('HDMI genuineunusedpin notNC '+ref+'.'+str(pin))
   elif got!=net:errors.append('Independent HDMI PW/port pinpolarity/domain '+ref+'.'+str(pin))
 for g,net in {151:'CM_HDMI0_CEC',153:'CM_HDMI0_HOTPLUG',170:'CM_HDMI0_TX2_P',172:'CM_HDMI0_TX2_N',176:'CM_HDMI0_TX1_P',178:'CM_HDMI0_TX1_N',182:'CM_HDMI0_TX0_P',184:'CM_HDMI0_TX0_N',188:'CM_HDMI0_CLK_P',190:'CM_HDMI0_CLK_N',199:'CM_HDMI0_SDA',200:'CM_HDMI0_SCL'}.items():
  if nodes.get(('J15002',str(g-100)))!=net:errors.append('Independent exactmodule HDMI contact '+str(g))
 defaults=[c for c in parts.values() if c.get('kind')=='R' and set(c['pins'].values())=={'HDMI_ENABLE','LOGIC_GND'}]
 if len(defaults)!=1 or defaults[0].get('resistance_ohm')!=4700:errors.append('HDMI actual4.7k independentLOW default absent')
 for ref,rail in [('C15022','SBC_5V'),('C15023','CM_AUX_3V3'),('C15024','HDMI_PORT_5V'),('C15025','CM_AUX_3V3')]:
  c=parts.get(ref,{})
  if c.get('kind')!='C' or set(c.get('pins',{}).values())!={rail,'LOGIC_GND'} or not math.isclose(c.get('capacitance_f',0),100e-9,rel_tol=1e-9):errors.append('HDMI actuallocal100nF bypass missing '+ref)
 h=model.get('hdmi_port',{})
 if not h.get('implemented_in_source') or h.get('physical_qualified') or h.get('partial_power_qualified') or h.get('max_mode_qualified') is not None or h.get('local_logic_chassis_ESD_return_coupling_implemented'):errors.append('HDMI source/qualification/chassis boundary inaccurate')
 if (h.get('connector_normal_5v_load_max_a'),h.get('companion_5v_fault_short_min_a'),h.get('companion_5v_fault_short_max_a'))!=(.055,.100,.200):errors.append('HDMI normaloutput versusactualshortcurrent boundary inaccurate')
 # A compound chip must retain its manufacturer logic reference; metalSHpads
 # use CHASSIS. Parent must fit a genuine localESD return/coupling, not a name.
 if (h.get('controller_ground'),h.get('shell_ground'))!=('LOGIC_GND','CHASSIS'):errors.append('HDMI ESD/metalreference policy wrong')
 f=Path(source_dir)/'CNC_COMPUTE.pretty/EDAC_690-019-298-412_HDMI.kicad_mod'
 if not f.exists():return errors+['Actual HDMI manufacturerland missing']
 fp=parse(f.read_text(encoding='utf8'));pads={value(x[1]):x for x in children(fp,'pad')}
 if set(pads)!={str(i) for i in range(1,20)}|{'SH1','SH2','SH3','SH4'}:errors.append('HDMI physical19+4land inventory wrong')
 def exact(nums,want):return len(nums)==len(want) and all(math.isclose(float(a),b,abs_tol=1e-9) for a,b in zip(nums,want))
 for i in range(1,20):
  p=pads.get(str(i))
  if p is None or not exact(child(p,'at')[1:],(5-i*.5,-.76,90)) or not exact(child(p,'size')[1:],(2.6,.28)):errors.append('HDMI EDACsignal primaryland/pinorientation '+str(i))
 for pin,xy,hole,land in [('SH1',(7.25,0),(0.9,2.7),(1.5,3.3)),('SH2',(-7.25,0),(0.9,2.7),(1.5,3.3)),('SH3',(-7.25,5.96),(0.9,2.1),(1.5,2.7)),('SH4',(7.25,5.96),(0.9,2.1),(1.5,2.7))]:
  p=pads.get(pin)
  if p is None or p[2:4]!=['thru_hole','oval'] or not exact(child(p,'at')[1:],xy) or child(p,'drill')[1]!='oval' or not exact(child(p,'drill')[2:],hole) or not exact(child(p,'size')[1:],land):errors.append('HDMI EDACissue5 shellhole/land '+pin)
 return errors


def validate_lands(source_dir=OUT):
 errors=[];source=REPORT/'sources/cm5io-rev2-official/CM5IO.pretty/Raspberry-Pi-5-Compute-Module.kicad_mod';original=parse(source.read_text(encoding='utf8'));op={int(value(p[1])):p for p in children(original,'pad') if value(p[1])}
 for idx,name,cx in [(0,'Amphenol_10164227_1001_CM_A',-.5),(1,'Amphenol_10164227_1001_CM_B',33.5)]:
  fp=Path(source_dir)/'CNC_COMPUTE.pretty'/(name+'.kicad_mod')
  if not fp.exists():errors.append('Socket derivedland file missing '+name);continue
  t=parse(fp.read_text(encoding='utf8'));pads={int(value(p[1])):p for p in children(t,'pad') if value(p[1])}
  if set(pads)!=set(range(1,101)):errors.append('Socket exact100land set wrong '+name);continue
  for i,p in pads.items():
   primary=op[i+idx*100];at=child(p,'at');oa=child(primary,'at');want=(float(oa[1])-cx,float(oa[2])+21.5,float(oa[3]))
   if any(abs(float(v)-w)>1e-8 for v,w in zip(at[1:],want)) or child(p,'size')!=child(primary,'size') or child(p,'layers')!=child(primary,'layers'):errors.append('Socket land mirror/pitch/size/orientation changed '+name+'.'+str(i))
  holes=[p for p in children(t,'pad') if not value(p[1])]
  if len(holes)!=2 or any(p[2]!='np_thru_hole' or child(p,'drill')[1]!='2.7' for p in holes):errors.append('Socket module mountingholes wrong '+name)
 dip=Path(source_dir)/'CNC_COMPUTE.pretty/CTS_219-3M_GullWing.kicad_mod'
 if not dip.exists():errors.append('Exact CTSland file missing')
 else:
  t=parse(dip.read_text(encoding='utf8'));pads={int(value(p[1])):p for p in children(t,'pad')}
  expected={1:(-2.54,4.3),2:(0,4.3),3:(2.54,4.3),4:(2.54,-4.3),5:(0,-4.3),6:(-2.54,-4.3)}
  if set(pads)!=set(expected):errors.append('CTS sixland set changed')
  for i,xy in expected.items():
   if i in pads and (tuple(map(float,child(pads[i],'at')[1:3]))!=xy or tuple(map(float,child(pads[i],'size')[1:3]))!=(1.13,2.44)):errors.append('CTS primary land dimensions changed '+str(i))
 for f in (Path(source_dir)/'CNC_COMPUTE.pretty').glob('*.kicad_mod'):
  t=parse(f.read_text(encoding='utf8'))
  for text in children(t,'fp_text')+children(t,'property'):
   layer=child(text,'layer')
   if layer is not None and value(layer[1]) in ['F.SilkS','B.SilkS']:
    font=child(child(text,'effects'),'font');size=child(font,'size')
    if size is not None and min(map(float,size[1:]))<.8-1e-9:errors.append('Board silkscreentext below0.8mm '+f.name)
  if f.stem=='CTS_219-3M_GullWing':
   for text in children(t,'fp_text'):
    if value(text[2])=='1   2   3' and value(child(text,'layer')[1])!='F.Fab':errors.append('CTS factorynumbers overlapSMDlands onSilkscreen')
 return errors


def validate_usb(tree,model,source_dir):
 """Independent primary MSOP/SOIC, safe role and actual bank-limit checks."""
 nodes,errors=native_nodes(tree);parts=model['components']
 normative={
  'J15005':('614004134726',{1:'USB_PORT_5V',2:'USB_HOST_N',3:'USB_HOST_P',4:'LOGIC_GND','SH':'CHASSIS'}),
  'J15006':('USB4105-GF-A',{'A1':'LOGIC_GND','A4':'USB_RECOVERY_VBUS','A5':'USB_CC1','A6':'USB_RECOVERY_P','A7':'USB_RECOVERY_N','A8':None,'A9':'USB_RECOVERY_VBUS','A12':'LOGIC_GND','B1':'LOGIC_GND','B4':'USB_RECOVERY_VBUS','B5':'USB_CC2','B6':'USB_RECOVERY_P','B7':'USB_RECOVERY_N','B8':None,'B9':'USB_RECOVERY_VBUS','B12':'LOGIC_GND','SH':'CHASSIS'}),
  'U15020':('219-3MSTRF',{1:'USB_RECOVERY_MODE',2:'USB_SWITCH_ON',3:'CM_nRPIBOOT',4:'LOGIC_GND',5:'CM_AUX_3V3',6:'CM_AUX_3V3'}),
  'U15021':('FSUSB42MUX',{1:'CM_AUX_3V3',2:'USB_RECOVERY_MODE',3:'CM_USB2_P',4:'CM_USB2_N',5:'LOGIC_GND',6:'USB_HOST_N',7:'USB_HOST_P',8:'USB_RECOVERY_N',9:'USB_RECOVERY_P',10:'USB_BUS_OE_N'}),
  'U15022':('SN74LVC1G04DBVR',{1:None,2:'USB_RECOVERY_MODE',3:'LOGIC_GND',4:'USB_HOST_MODE',5:'CM_AUX_3V3'}),
  'U15023':('SN74LVC1G10DBVR',{1:'HDMI_ENABLE',2:'LOGIC_GND',3:'USB_SWITCH_ON',4:'USB_HOST_READY_N',5:'CM_AUX_3V3',6:'USB_HOST_MODE'}),
  'U15024':('SN74LVC1G04DBVR',{1:None,2:'USB_HOST_READY_N',3:'LOGIC_GND',4:'USB_HOST_READY',5:'CM_AUX_3V3'}),
  'U15025':('SN74LVC1G00DBVR',{1:'HDMI_ENABLE',2:'USB_SWITCH_ON',3:'LOGIC_GND',4:'USB_BUS_OE_N',5:'CM_AUX_3V3'}),
  'U15026':('TPS2553DBVR',{1:'SBC_5V',2:'LOGIC_GND',3:'USB_HOST_READY',4:'USB_POWER_FAULT_N',5:'USB_ILIM',6:'USB_SWITCHED_5V'}),
  'U15027':('INA219AIDR',{1:'LOGIC_GND',2:'LOGIC_GND',3:'COMPUTE_I2C_SDA',4:'COMPUTE_I2C_SCL',5:'CM_AUX_3V3',6:'LOGIC_GND',7:'USB_PORT_5V',8:'USB_SWITCHED_5V'}),
  'U15028':('SN74LVC1G125DBVR',{1:'LOGIC_GND',2:'USB_RECOVERY_MODE',3:'LOGIC_GND',4:'USB_ID_BUFFERED',5:'CM_AUX_3V3'}),
  'U15029':('TPD4E05U06DQAR',{1:'USB_HOST_P',2:'USB_HOST_N',3:'LOGIC_GND',4:'USB_PORT_5V',5:None,6:None,7:None,8:'LOGIC_GND',9:None,10:None}),
  'U15030':('TPD4E05U06DQAR',{1:'USB_RECOVERY_P',2:'USB_RECOVERY_N',3:'LOGIC_GND',4:'USB_CC1',5:'USB_CC2',6:None,7:None,8:'LOGIC_GND',9:None,10:None}),
  'U15031':('TPD4E05U06DQAR',{1:'USB_RECOVERY_VBUS',2:None,3:'LOGIC_GND',4:None,5:None,6:None,7:None,8:'LOGIC_GND',9:None,10:None})}
 for ref,(mpn,mapping) in normative.items():
  if parts.get(ref,{}).get('mpn')!=mpn:errors.append('USB independent critical MPN '+ref)
  for pin,net in mapping.items():
   got=nodes.get((ref,str(pin)))
   if (net is None and (not got or not got.startswith('unconnected-'))) or (net is not None and got!=net):errors.append('USB independent package/role/power/ESD pin '+ref+'.'+str(pin))
 for pin,net in [('34','USB_POWER_FAULT_N'),('56','COMPUTE_I2C_SCL'),('58','COMPUTE_I2C_SDA')]:
  if nodes.get(('J15001',pin))!=net:errors.append('USB exact Pi GPIO2/3 diagnostic contact '+pin)
 pairs=defaultdict(list)
 for ref,c in parts.items():
  if c.get('kind')=='R':pairs[frozenset(c['pins'].values())].append((ref,c.get('resistance_ohm'),c.get('tolerance')))
 required=[('USB_RECOVERY_MODE','LOGIC_GND',10000),('USB_SWITCH_ON','LOGIC_GND',10000),('USB_HOST_READY_N','CM_AUX_3V3',10000),('USB_HOST_READY','LOGIC_GND',4700),('USB_BUS_OE_N','CM_AUX_3V3',10000),('USB_ILIM','LOGIC_GND',60400),('USB_POWER_FAULT_N','CM_AUX_3V3',10000),('USB_SWITCHED_5V','USB_PORT_5V',.1),('USB_PORT_5V','LOGIC_GND',1000),('COMPUTE_I2C_SDA','CM_AUX_3V3',2200),('COMPUTE_I2C_SCL','CM_AUX_3V3',2200),('USB_ID_BUFFERED','CM_USB_OTG_ID',33),('USB_CC1','LOGIC_GND',5100),('USB_CC2','LOGIC_GND',5100),('USB_RECOVERY_VBUS','LOGIC_GND',100000)]
 for a,b,r in required:
  if not any(ohm==r and tol==.01 for ref,ohm,tol in pairs.get(frozenset([a,b]),[])):errors.append('USB actual default/CC/current/measurement resistor '+a+'/'+b)
 expected_fp={'U15021':'Package_SO:MSOP-10_3x3mm_P0.5mm','U15027':'Package_SO:SOIC-8_3.9x4.9mm_P1.27mm','R15053':'CNC_COMPUTE:Vishay_WSL0805_Kelvin_Recommended','C15034':'CNC_COMPUTE:Panasonic_FK_F_8x10p2'}
 for ref,fp in expected_fp.items():
  if parts.get(ref,{}).get('footprint')!=fp:errors.append('USB reviewed exact physical package '+ref)
 cap=parts.get('C15034',{})
 if cap.get('mpn')!='EEEFK1A331P' or cap.get('pins')!={'1':'USB_PORT_5V','2':'LOGIC_GND'} or cap.get('capacitance_f')!=330e-6 or cap.get('voltage_rating_v')!=10 or not cap.get('polarized'):errors.append('USB actual polarized F-case330uF10V bulk')
 u=model.get('usb_port',{});imin=25230/(60.4*1.01)**1.016/1000;imax=22980/(60.4*.99)**.94/1000
 if not math.isclose(u.get('hardware_limit_min_a',0),imin,rel_tol=1e-12) or not math.isclose(u.get('hardware_limit_max_a',0),imax,rel_tol=1e-12) or not .35<imin<imax<.5:errors.append('USB actual tolerance current limit is not below0.5A')
 if u.get('normal_total_usb5v_allocation_a')!=.350 or u.get('normal_external_load_after5mAbleed_a')!=.345 or u.get('host_ports')!=1 or u.get('recovery_ports')!=1 or not u.get('implemented_in_source'):errors.append('USB bounded one-host/recovery/load source contract')
 for k in ['upstream_power_from_recovery_VBUS','USB_PD_implemented','role_switching_live_qualified','target_host_and_recovery_driver_qualified','USB_IF_compliance_claim','current_monitor_calibration_firmware_implemented','BTT_I2C_transport_or_aux_current_qualified','local_chassis_ESD_return_implemented','physical_qualification']:
  if u.get(k):errors.append('USB unproved role/current/driver/qualification claim '+k)
 if u.get('qualified_devices'):errors.append('USB unproved qualified devices')
 if u.get('current_monitor_address')!='0x40' or u.get('shunt')!='R15053' or u.get('bulk')!='C15034':errors.append('USB real monitor/shunt/bulk contract')
 # Externally powered recovery VBUS has no conductive connection to a local
 # rail. This is a bounded net/part audit, not proof of silicon powered-off leakage.
 for ref,c in parts.items():
  nets=set(c['pins'].values())
  if c.get('physical') and 'USB_RECOVERY_VBUS' in nets and nets&{'SBC_5V','CORE_5V','IO_3V3','CM_AUX_3V3','USB_PORT_5V','USB_SWITCHED_5V'}:errors.append('USB recovery VBUS backfeeds a local rail '+ref)
 a=model.get('aux_load_budget',{})
 if a.get('reserved_module_aux3v3_a')!=.447 or a.get('USB_monitor_and_logic_additional_planning_a')!=.010 or a.get('USB_hub_implemented') or a.get('BTT_aux_current_guarantee_qualified') or a.get('SBC_3A_compute2p5_USB0p5_simultaneous_profile_closed'):errors.append('USB full auxiliary and5V allocation boundary inaccurate')
 # Bound exactly the three genuine previously NC physical socket contacts.
 old=json.loads((REPORT/'source-r03/design.json').read_text(encoding='utf8'))
 for ref,c in old['components'].items():
  if not c.get('physical'):continue
  new=parts.get(ref,{})
  if any(c.get(k)!=new.get(k) for k in ['mpn','footprint','value']):errors.append('USB changed retained physical component '+ref)
  for pin,net in c['pins'].items():
   want={'25':'CM_CAN_SPI_SCLK','26':'CM_CAN_SPI_MISO','27':'CM_CAN_SPI_MOSI','28':'CM_RS485_RX','29':'CM_CAN_SPI_CS_N','31':'CM_RS485_TX','50':'CM_CAN_INT_N','51':'CM_RS485_DE','34':'USB_POWER_FAULT_N','56':'COMPUTE_I2C_SCL','58':'COMPUTE_I2C_SDA'}.get(pin) if ref=='J15001' and pin in ['25','26','27','28','29','31','50','51','34','56','58'] else net
   if ref=='J15001' and pin in ['25','26','27','28','29','31','50','51','34','56','58'] and net is not None:errors.append('USB promoted a socket pin that was not genuinelyNC '+pin)
   if new.get('pins',{}).get(pin)!=want:errors.append('USB unbounded retained physical pin change '+ref+'.'+pin)
 errors.extend(validate_usb_lands(source_dir))
 return errors


def validate_usb_lands(source_dir):
 errors=[];base=Path(source_dir)/'CNC_COMPUTE.pretty'
 def load(name):
  f=base/(name+'.kicad_mod')
  if not f.exists():errors.append('USB exact manufacturer land missing '+name);return []
  return children(parse(f.read_text(encoding='utf8')),'pad')
 def exact(x,want):return len(x)==len(want) and all(math.isclose(float(a),b,abs_tol=1e-9) for a,b in zip(x,want))
 wa=load('Wurth_614004134726_USB_A');sig=[p for p in wa if value(p[1]) in ['1','2','3','4']];sh=[p for p in wa if value(p[1])=='SH']
 if len(sig)!=4 or len(sh)!=4:errors.append('USB-A actual4contacts/4stakes')
 for p in sig:
  if not exact(child(p,'at')[1:3],[(int(value(p[1]))-1)*2,0]) or not exact(child(p,'size')[1:3],[1.6,1.6]) or not exact(child(p,'drill')[1:],[.92]):errors.append('USB-A Wurth primary pin/orientation/land')
 if sorted(tuple(map(float,child(p,'at')[1:3])) for p in sh)!=[(-.73,-2.71),(-.73,2.71),(6.27,-2.71),(6.27,2.71)] or any(not exact(child(p,'drill')[1:],[1.5]) for p in sh):errors.append('USB-A Wurth5.42mm shell pitch/drills')
 gc=load('GCT_USB4105_GF_A_USB_C');gc_expected={'A1':(-3.2,-3.68,.6,1.15),'B12':(-3.2,-3.68,.6,1.15),'A4':(-2.4,-3.68,.6,1.15),'B9':(-2.4,-3.68,.6,1.15),'A5':(-1.25,-3.68,.3,1.15),'B7':(-.75,-3.68,.3,1.15),'A6':(-.25,-3.68,.3,1.15),'A7':(.25,-3.68,.3,1.15),'B6':(.75,-3.68,.3,1.15),'A8':(1.25,-3.68,.3,1.15),'B5':(1.75,-3.68,.3,1.15),'B8':(-1.75,-3.68,.3,1.15),'A9':(2.4,-3.68,.6,1.15),'B4':(2.4,-3.68,.6,1.15),'A12':(3.2,-3.68,.6,1.15),'B1':(3.2,-3.68,.6,1.15)}
 gp={value(p[1]):p for p in gc if value(p[1]) and value(p[1])!='SH'}
 if set(gp)!=set(gc_expected):errors.append('USB-C GCT exact16contacts')
 for pin,want in gc_expected.items():
  if pin not in gp or not exact(child(gp[pin],'at')[1:3]+child(gp[pin],'size')[1:3],want):errors.append('USB-C GCT primary pin/orientation/land '+pin)
 gs=[p for p in gc if value(p[1])=='SH'];holes=[p for p in gc if not value(p[1])]
 if len(gs)!=4 or len(holes)!=2 or sorted(tuple(map(float,child(p,'at')[1:3])) for p in gs)!=[(-4.32,-3.105),(-4.32,1.075),(4.32,-3.105),(4.32,1.075)]:errors.append('USB-C GCT mechanical stakes/anchors')
 for p in gs:
  front=float(child(p,'at')[2])<0
  if not exact(child(p,'drill')[2:],[.6,1.7 if front else 1.4]) or not exact(child(p,'size')[1:3],[1,2.1 if front else 1.8]):errors.append('USB-C GCT manufacturerstake slots/lands')
 for name,expected in [('Vishay_WSL0805_Kelvin_Recommended',{'1':(-.76,0,1.02,1.27),'2':(.76,0,1.02,1.27)}),('Panasonic_FK_F_8x10p2',{'1':(-3.55,0,4,2),'2':(3.55,0,4,2)})]:
  pp={value(p[1]):p for p in load(name)}
  if set(pp)!=set(expected):errors.append('USB manufacturer powerland set '+name)
  for pin,want in expected.items():
   if pin not in pp or not exact(child(pp[pin],'at')[1:3]+child(pp[pin],'size')[1:3],want):errors.append('USB manufacturer powerland/case/polarity '+name+'.'+pin)
 return errors



def validate_ethernet_comms(tree,model,source_dir):
 nodes,errors=native_nodes(tree);parts=model['components']
 contacts={25:'CM_CAN_SPI_SCLK',26:'CM_CAN_SPI_MISO',27:'CM_CAN_SPI_MOSI',28:'CM_RS485_RX',29:'CM_CAN_SPI_CS_N',31:'CM_RS485_TX',50:'CM_CAN_INT_N',51:'CM_RS485_DE'}
 for pin,net in contacts.items():
  if nodes.get(('J15001',str(pin)))!=net:errors.append('Comms exact Pi physical contact differs '+str(pin))
 if nodes.get(('J15001','55'))!='COMPUTE_SERVICE_TX':errors.append('Comms claims preserved GPIO14 service TX')
 normative={'U15032':('SN74LVC1G04DBVR',{1:None,2:'COMPUTE_3V3_GOOD',3:'LOGIC_GND',4:'CM_COMMS_OE_N',5:'IO_3V3'}),
 'J15007':('7499111446',{1:'ETH_PHY_CT',2:'CM_Ethernet_Pair0_P',3:'CM_Ethernet_Pair0_N',4:'CM_Ethernet_Pair1_P',5:'CM_Ethernet_Pair1_N',6:'CM_Ethernet_Pair2_P',7:'CM_Ethernet_Pair2_N',8:'CM_Ethernet_Pair3_P',9:'CM_Ethernet_Pair3_N',10:'CHASSIS',11:'CM_AUX_3V3',12:'ETH_LINK_LED_K',13:'CM_AUX_3V3',14:'ETH_SPEED_LED_K','SH':'CHASSIS'})}
 forwards=[('U15033','CM_RS485_TX','RS485_UART_TX_HOST','HIGH'),('U15034','CM_RS485_DE','RS485_DE_HOST','LOW'),('U15035','CM_CAN_SPI_SCLK','CAN_SPI_SCLK_HOST','LOW'),('U15036','CM_CAN_SPI_MOSI','CAN_SPI_MOSI_HOST','LOW'),('U15037','CM_CAN_SPI_CS_N','CAN_SPI_CS_N_HOST','HIGH')]
 returns=[('U15038','CM_RS485_RX','RS485_UART_RX_HOST','HIGH'),('U15039','CM_CAN_SPI_MISO','CAN_SPI_MISO_HOST','LOW'),('U15040','CM_CAN_INT_N','CAN_INT_N_HOST','HIGH')]
 required=[('CM_COMMS_OE_N','IO_3V3',10000),('ETH_LINK_LED_K','CM_Ethernet_nLED3',470),('ETH_SPEED_LED_K','CM_Ethernet_nLED2',470)]
 for ref,raw,host,default in forwards:
  bf='CM_COMMS_FWD_'+raw.removeprefix('CM_');normative[ref]=('SN74LVC1G125DBVR',{1:'CM_COMMS_OE_N',2:raw,3:'LOGIC_GND',4:bf,5:'IO_3V3'})
  required.extend([(raw,'CM_AUX_3V3' if default=='HIGH' else 'LOGIC_GND',10000),(host,'IO_3V3' if default=='HIGH' else 'LOGIC_GND',10000),(bf,host,33)])
 for ref,raw,host,default in returns:
  bf='CM_COMMS_RET_'+raw.removeprefix('CM_');normative[ref]=('SN74LVC1G125DBVR',{1:'CM_COMMS_OE_N',2:host,3:'LOGIC_GND',4:bf,5:'CM_AUX_3V3'})
  required.extend([(raw,'CM_AUX_3V3' if default=='HIGH' else 'LOGIC_GND',10000),(host,'IO_3V3' if default=='HIGH' else 'LOGIC_GND',10000),(bf,raw,33)])
 for ref,a,b in [('U15041',0,1),('U15042',2,3)]:normative[ref]=('TPD4EUSB30DQAR',{1:f'CM_Ethernet_Pair{a}_P',2:f'CM_Ethernet_Pair{a}_N',3:'LOGIC_GND',4:f'CM_Ethernet_Pair{b}_P',5:f'CM_Ethernet_Pair{b}_N',6:None,7:None,8:'LOGIC_GND',9:None,10:None})
 for ref,(mpn,pins) in normative.items():
  if parts.get(ref,{}).get('mpn')!=mpn:errors.append('Ethernet/comms independently reviewed MPN differs '+ref)
  for pin,net in pins.items():
   got=nodes.get((ref,str(pin)))
   if (net is None and (not got or not got.startswith('unconnected-'))) or (net is not None and net!=got):errors.append('Ethernet/comms independent native pin/domain differs '+ref+'.'+str(pin))
 pairs=defaultdict(list)
 for ref,c in parts.items():
  if c.get('kind')=='R':pairs[frozenset(c['pins'].values())].append(c.get('resistance_ohm'))
 for a,b,ohm in required:
  if ohm not in pairs.get(frozenset([a,b]),[]):errors.append('Ethernet/comms actual default/damping absent '+a+'/'+b)
 ct=parts.get('C15047',{})
 if ct.get('pins')!={'1':'ETH_PHY_CT','2':'LOGIC_GND'} or not math.isclose(ct.get('capacitance_f',0),100e-9,rel_tol=1e-12):errors.append('Ethernet centre tap actual100nF AC return missing')
 for ref,p in parts.items():
  if ref=='C15047' or ref=='J15007':continue
  if p.get('physical') and 'ETH_PHY_CT' in p['pins'].values():errors.append('Ethernet centre tap unexpectedly DC biased '+ref)
 for group,keys in [('ethernet_port',['duplicate_PHY','PoE_power_implemented','carrier_impedance_ESD_link_or_temperature_qualified','BTT_MDI_bias_and_mapping_qualified','physical_qualification']),('compute_comms',['depends_on_FPGA_configuration','target_baud_pinmux_or_image_qualified','BTT_transport_qualified','physical_qualification'])]:
  data=model.get(group,{})
  if not data.get('implemented_in_source'):errors.append('Actual Ethernet/comms source omitted '+group)
  for k in keys:
   if data.get(k):errors.append('Ethernet/comms unproved/incorrect capability '+group+'.'+k)
 if model.get('module_power',{}).get('full_capacity_qualified') or model.get('module_power',{}).get('SBC_branch_capacity_qualified'):errors.append('Unproved SBC capacity claimed')
 f=Path(source_dir)/'CNC_COMPUTE.pretty/Wurth_7499111446_Gigabit.kicad_mod'
 if not f.exists():errors.append('Ethernet exact purchased MagJack lands missing');return errors
 pads=children(parse(f.read_text(encoding='utf8')),'pad');pp={value(p[1]):p for p in pads if value(p[1])!='SH' and value(p[1])}
 expected={str(i):(1.27*(i-1),0 if i%2 else 2.54,.9) for i in range(1,11)};expected.update({'11':(-.915,12.97,1.03),'12':(1.625,12.97,1.03),'13':(9.805,12.97,1.03),'14':(12.345,12.97,1.03)})
 if set(pp)!=set(expected):errors.append('Ethernet manufacturer14 contact numbering differs')
 for pin,(x,y,drill) in expected.items():
  if pin not in pp or any(not math.isclose(float(a),b,abs_tol=1e-9) for a,b in zip(child(pp[pin],'at')[1:3],[x,y])) or not math.isclose(float(child(pp[pin],'drill')[1]),drill,abs_tol=1e-9):errors.append('Ethernet manufacturer pin/hole/orientation differs '+pin)
 sh=[p for p in pads if value(p[1])=='SH'];nh=[p for p in pads if not value(p[1])]
 if sorted(tuple(map(float,child(p,'at')[1:3])) for p in sh)!=[(-2.03,5.84),(13.46,5.84)] or len(sh)!=2 or any(float(child(p,'drill')[1])!=1.6 for p in sh):errors.append('Ethernet manufacturer shell tabs differ')
 if sorted(tuple(map(float,child(p,'at')[1:3])) for p in nh)!=[(0,8.89),(11.43,8.89)] or len(nh)!=2 or any(float(child(p,'drill')[1])!=3.25 for p in nh):errors.append('Ethernet manufacturer mounting posts differ')
 f=Path(source_dir)/'CNC_COMPUTE.pretty/TI_DQA0010A_TPD4EUSB30.kicad_mod'
 if not f.exists():errors.append('Ethernet TI exact DQA landset missing')
 else:
  pads=children(parse(f.read_text(encoding='utf8')),'pad');numbered={value(p[1]):p for p in pads}
  for pin in range(1,11):
   p=numbered.get(str(pin));wantx=-.4175 if pin<=5 else .4175;wanty=(pin-3)*.5 if pin<=5 else (8-pin)*.5
   if p is None or not all(math.isclose(float(a),b,abs_tol=1e-9) for a,b in zip(child(p,'at')[1:3],[wantx,wanty])):errors.append('Ethernet TI primary DQA pin position differs '+str(pin))
 return errors


def main():
 model=json.loads((OUT/'design.json').read_text(encoding='utf8'));report=validate(ET.parse(OUT/'netlist.xml'),model)
 (REPORT/'validation-r05.json').write_text(json.dumps(report,indent=2)+'\n',encoding='utf8');print(json.dumps(report,indent=2));return 0 if report['ok'] else 1
if __name__=='__main__':sys.exit(main())
