DeadlySIn777/Controller/reports/root-verification-20260928/source/controller_backend/profiles/sim/simulation.hal

# SOFTWARE ONLY: no I/O driver, network, SPI, serial, GPIO, or physical outputs.
loadrt [KINS]KINEMATICS
loadrt [EMCMOT]EMCMOT servo_period_nsec=[EMCMOT]SERVO_PERIOD num_joints=[KINS]JOINTS
addf motion-command-handler servo-thread
addf motion-controller servo-thread
# Ideal position feedback loopback; no motor/encoder plant is claimed.
net simulated-x joint.0.motor-pos-cmd => joint.0.motor-pos-fb
net simulated-y joint.1.motor-pos-cmd => joint.1.motor-pos-fb
net simulated-z joint.2.motor-pos-cmd => joint.2.motor-pos-fb
net simulated-estop iocontrol.0.user-enable-out => iocontrol.0.emc-enable-in
net simulated-tool-prepare iocontrol.0.tool-prepare => iocontrol.0.tool-prepared
net simulated-tool-change iocontrol.0.tool-change => iocontrol.0.tool-changed
