DeadlySIn777/Controller/(commit log)

2026-10-18 Bind board-review manifest to preserved project Git policies
2026-10-18 Clarify audit classifications and supplement retained assembly/linker source
    Preserve newer routing publications and historical evidence records. Add 178 exact small-source files and a versioned publication-scope addendum. No engineering test or qualification claim.
2026-10-18 Publish exact joint candidate and live global routing input
2026-10-18 Include current global experiment DSN rules and evidence
2026-10-18 Add current native layer views with explicit power reservations
2026-10-18 Publish source-bound native drill models for bulk routing review
2026-10-18 Publish coherent three-clamp source and native root checks
2026-10-18 Identify bare PCB features in source BOM
2026-10-18 Publish exact literal LED net source correction
2026-10-18 Publish current board setup and exact routing inputs
2026-10-18 Publish latest measured KiCad candidate and complete project files
2026-10-18 Publish KiCad-measured routing progress with all previous gains retained
2026-10-18 Publish fourteen-join KiCad routing progress and complete native project
2026-10-18 Publish nineteen-join KiCad progress with conflicting incoming net excluded
2026-10-18 Route sixteen more joins and publish the 45-join KiCad checkpoint
